bnepethomas/bne-arduino-flight-simulator-interfaces/ProSim_Pi_UDP_Receiver_Stickshaker/Read Me.txt

Copied from Huey Caution Panel  20170828 - full details on supporting infrastructure found there
