bnepethomas/bne-arduino-flight-simulator-interfaces/Hornet Altimeter/Hornet_Altimeter_With_OLED/readme.txt

This Arduino code is functional but not finished, found that under high update rates, the pi struggled
to keep up, so moved it to the Raspberry pi.
