bnepethomas/bne-arduino-flight-simulator-interfaces/Jet Ranger/Jet Ranger Arduino Sketches/JET_RANGER_RADIO_CONTROLLER/PROGRAM_SUMMARY.md

# JET_RANGER_RADIO_CONTROLLER — Program Summary

Arduino Mega 2560 + W5500 Ethernet shield. Drives the two COM/NAV OLED
frequency displays, reads 8 rotary encoders (COM1/COM2/NAV1/NAV2 major &
minor) and a 4x4 button matrix, and keeps the radio panel in sync with the
flight sim over Ethernet.

## Program flow

1. **Setup**
   - Resets the W5500 shield via `ES1_RESET_PIN` (53), then `Ethernet.begin(mac, ip)`.
   - Opens the four UDP sockets listed below, flashes the red status LED while
     it waits `delayBeforeSendingPacket` (3s) for the link to settle, then
     sends a debug "Ethernet Started" message.
   - Initialises the two character OLEDs (via the TCA9548 I2C mux) and the
     8 rotary encoders (acceleration enabled, start positions set).
   - Initialises the 4x4 keypad matrix scanner.
2. **Main loop** (`loop()`)
   - Toggles the green/red status LEDs every `FLASH_TIME` (200ms) as a
     heartbeat indicator.
   - Every 10s sends a `"COMM_NAV"` keepalive UDP packet to the reflector
     (health monitor).
   - Polls all 8 encoders; any change recalculates the relevant standby
     frequency, sends it to the reflector, and refreshes the OLEDs.
   - Scans the 4x4 matrix; key presses on row 0–3 col 0 trigger COM1/COM2
     swap, master battery on/off and alternator on/off commands sent to the
     reflector on port 27001. Other keys are only logged via `SendDebug`.
   - Reads any pending UDP packet on the MSFS port and passes it to
     `ProcessReceivedMSFSString()`, which parses a CSV-style payload
     (`D,C1A:119.500,C1S:120.000,...` for data, `C,B:5` for control/
     brightness) and updates the active/standby frequencies, main bus
     voltage and NAVCOM1 power state, then refreshes the OLEDs if anything
     changed.

## Swap switches, key matrix, start-up quiet period

The four frequency-swap switches are on the **Jet Ranger COM and NAV** PCB, in a
diode matrix that all shares column 0 (D26); rows 0-3 are D22-D25. Matrix
position -> action in `handleKeyPress()`:

| Switch (COM and NAV PCB) | Matrix (row, col) | Action |
|---|---|---|
| NAV1 FREQ SWITCH (`SW6`) | 0, 0 | **NAV1 swap**: swaps `Nav1ActiveFrequency`/`Nav1StandbyFrequency` on the NAV OLED immediately (the bridges send the NAV active frequencies back as `N1A` and `N2A`; the standby frequencies stay local to the Radio) and sends `NAV1_RADIO_SWAP` to 172.16.1.10:27001 |
| NAV2 FREQ SWITCH (`SW7`) | 1, 0 | **NAV2 swap**: same with NAV2, sends `NAV2_RADIO_SWAP` |
| COMM1 Freq Switch (`SW4`) | 2, 0 | COM1 swap: sends `COM1_RADIO_SWAP` (the display changes when the sim sends the swapped frequencies back) |
| COMM2 FREQ SWITCH (`SW5`) | 3, 0 | COM2 swap: sends `COM2_RADIO_SWAP`, then `AVIONICS_MASTER_SET` |

(The earlier mapping had battery on/off and alternator on/off on (0,0)/(1,0);
it was removed.) Both bridges (`FSUIPCWinformsAutoCS` and `MSFSWinformsAutoCS`)
handle `NAV1_RADIO_SWAP` and `NAV2_RADIO_SWAP`, and any command a bridge does not
recognise falls into its COM1 standby-frequency parser (resets COM1 standby to 121.50).

**Bench-verified 2026-10-15** (Mega on COM20, through the reflector's forwarded
copy): each of the four switches pressed twice logged `Key Pressed`, the matching
`COM1 Swap`/`COM2 Swap`/`NAV1 Swap`/`NAV2 Swap` line and `Key Released`.

- **Phantom key presses fixed:** a floating column used to read LOW as soon as
  scanning started, so every boot reported key presses and sent their commands
  to the PC. For `matrixQuietMs` (1500 ms) after `initMatrixScanner()` the scanner
  now only records the state and raises no press or release events
  (`matrixQuietUntil`).
- **Matrix diagnostic:** UDP control packet `C,MATRIX:1` sends the raw readings
  (`H`/`L` per column, bypassing debounce and the quiet period) as
  `Matrix raw idle ...` and `Matrix raw row N LOW ...` lines. It showed column 0
  stuck LOW on the original Mega even with the ribbon unplugged (a faulty or badly
  seated Mega/pin D26 - all four swap switches use column 0, so none could register);
  on the replacement Mega all four columns read `H`. A badly seated Mega also made
  the board drop off USB and the network after flashing.
- Encoder knobs now name their radio when they send a standby frequency to the PC
  (`sendStandbyToPC()`, port 27001): COM1 stays the bare number
  (`118.295`, which every bridge understands); COM2, NAV1 and NAV2 are sent as
  `COM2_STANDBY:118.295`, `NAV1_STANDBY:108.000`, `NAV2_STANDBY:108.000`, which
  `FSUIPCWinformsAutoCS` routes to the matching radio. Previously every knob sent a
  bare number, the PC took anything outside 118-136.975 as COM1 standby 121.50, so
  NAV and COM2 knobs retuned COM1. Nothing is sent during the start-up quiet period,
  so the encoders' power-up positions are no longer pushed to the simulator. Each send
  is logged as `To PC: ...`. Both bridges handle these labelled forms.
- Display column fix (2026-10-16): the bridges send COM frequencies with 2 decimals
  (`128.30`, `127.80`), and the display line joined COM1 and COM2 with two spaces, so a
  short COM1 pulled COM2 one column left and its hundreds digit went behind the
  faceplate. `padFrequency()` now pads every frequency to `xxx.xxx` (7 characters)
  before `updateCOMM()` / `updateNAV()` build their lines (7 + 2 + 7 = 16 columns).
  Confirmed by eye on the bench.
- Standard channel spacing (2026-10-16): the minor knobs used to step 5 kHz on all four
  radios and the COM major knob stopped at 135. Now COM runs 118.000-136.975 MHz in
  25 kHz channels (`COM_MINOR_STEP_KHZ`, major 118..136) and NAV runs 108.00-117.95 MHz
  in 50 kHz steps (`NAV_MINOR_STEP_KHZ`, major 108..117). `CommMinorEncoderMaxValue` and
  `NavMinorEncoderMaxValue` are derived from the step sizes, so changing a constant also
  moves the wrap-around limits. 8.33 kHz channels are not offered. Flight sims store COM
  frequencies in FSUIPC's 10 kHz BCD form, so a 25 kHz channel such as 118.025 may show as
  118.02 or 118.03 in the sim.
- Compiled at 25,774 bytes flash (10%) / 3,323 bytes RAM (40%), flashed on COM20.

## No-data timeout (30 s)

If no UDP packet - data `D,...` or control `C,...` - arrives on the MSFS port
(13136) for `noDataTimeoutMs` (30 s), the COM and NAV character OLEDs are
blanked once: the loop sets `powerAvailable = false` (the state the displays
already treat as "no power", where `updateCOMM()`/`updateNAV()` clear the
screen) and logs `no UDP data for 30s, displays blanked`. The timer starts at
the end of `setup()` (`lastMSFSDataMillis = millis()`). When a packet arrives
again the previous power state is restored, both displays are redrawn and
`UDP data resumed - displays restored` is logged. **Local input also counts:**
any encoder movement or key press calls `wakeDisplays()`, which restarts the 30 s
and, if the displays are blanked, restores them (`Local input - displays
restored`); they blank again (`no UDP data or local input for 30s, displays
blanked`) only after 30 s with neither UDP data nor local input. Bench-verified:
the first key press after a blank restored the displays. Control packets such as
`C,KEEPALIVE:1` also count as data. Bench-tested on the Radio (COM19) through
the UDP reflector's forwarded copy: blanked about 30 s after boot, restored on
the next `D,C1A:...` packet. Compiled at 24,440 bytes flash (9%) / 3,141 bytes
RAM (38%).

## I2C scan, DME display and matrix debounce

- **I2C scan:** `scanI2C()` runs at start-up (after `Wire.begin()`) and on `C,I2CSCAN:1`. It scans 0x08-0x77 on the main bus with every TCA9548A channel off, then each channel 0-7 (the mux itself is
  skipped) and sends the results to the debug stream (`I2C main bus: ...`, `I2C TCA port n: 0x3C (OLED)`, `I2C TCA ports with nothing connected: ...`, `I2C scan done, N device(s) answered`). It sets
  `Wire.setWireTimeout(5000, true)` so a stuck bus reports `bus timeout` instead of hanging. A scan takes a second or two.
- **DME display:** the Audio panel's OLED, mux channel 3 (`DME_OLED_Port`). `initCharOLED(DME_OLED_Port)` then `showDme()` with the no-data text (`DME --- NM` and `--- KT -- MIN`, build 13; it was `10M` and `0M` before) at start-up (each line padded to 16 characters).
- **Matrix debounce:** `scanMatrix()` samples each key once per millisecond with two readings 3 us apart (a disagreement skips the sample) and debounces by integration (`keyIntegrator[][]`, 0 = down to
  `MATRIX_INTEGRATOR_MAX` = 12 = up; a key changes state at either end), replacing the 50 ms timer that restarted on every differing reading and could hold a release back. Compiled at 34,518 bytes flash (13%) /
  4,979 bytes RAM (60%).

## Backlight (D5)

Mega pin D5 (`BACKLIGHT_PWM`, 330 ohm to an IRF540N with a 10 kohm gate pull-down) switches the Audio, Auto Pilot and COM and NAV panel backlights, with the same rules as the Servo, Stepper
and Dual Stepper boards. `applyBacklight()` writes PWM 0 unless `backlightPowered` (`BPWR:1`, main bus 20 V or more, assumed 1 until the first `BPWR`) is true and the displays are not blanked by
the no-data timeout (30 s with no UDP packet and no knob or key use; local input restores it); otherwise it writes the last `C,B:0-15` level mapped to PWM 0 to 255, or `BacklightDefaultPwm`
(65) until one has been received. `BPWR` is handled in `HandleOutputValuePair()` before the per-pair debug line, the radio packet from both bridges now carries it, and `C,B` also sets the
MAX7219 intensity. Compiled at 31,046 bytes flash (12%) / 4,851 bytes RAM (59%); not flashed or tested on the board yet.

## Auto Pilot and Audio panel switches and knobs

The matrix is now 4 rows (D22-D25) by 5 columns (D26, D27, D28, D29 and **D48**): `COL0` is the COM and NAV swap switches, `COL1`/`COL2` the Auto Pilot panel and
`COL3`/`COL4` the Audio panel (one switch per row on each column, diode to the column). The five Auto Pilot knobs are polling encoders on CRS D11/D12, ALT A4/A5, VS D46/D47,
IAS D7/D6 and HDG D8/D9, read like the ADF knobs (centred, recentred after each read, three counts per click, acceleration on). Every switch and click goes out twice:
a joystick button to the USB HID board (172.16.1.11:4210, `index,state`; Joystick 3 = indexes 64-81 for the Auto Pilot panel, Joystick 4 = 96-103 for the Audio panel; a knob
click is a 40 ms press released from `serviceHidPulses()`), and a simulator control name to the bridge on UDP 27001 (switch: on press; knob: one per click with a `:N` repeat
count). Nothing is sent during the 1.5 s quiet period. `panelSwitches[]` and `panelEncoders[]` hold the tables; each press is logged (`AP HDG pressed (joystick button index 65)`).
Compiled at 30,108 bytes flash (11%) / 4,823 bytes RAM (58%); not flashed or tested on the board yet.

| Switch / knob | Row, col or pins | Index | Command |
|---|---|---|---|
| AP ENGAGE, HDG, CRS, ALT | (0,1) (1,1) (2,1) (3,1) | 64 to 67 | `AP_MASTER`, `AP_HDG_HOLD`, `AP_NAV1_HOLD`, `AP_ALT_HOLD` |
| AP APPR, FD, BC, IAS | (0,2) (1,2) (2,2) (3,2) | 68 to 71 | `AP_APR_HOLD`, `TOGGLE_FLIGHT_DIRECTOR`, `AP_BC_HOLD`, `AP_PANEL_SPEED_HOLD` |
| CRS, ALT, VS, IAS, HDG knobs (cw, ccw) | D11/12, A4/A5, D46/47, D7/6, D8/9 | 72 to 81 | `VOR1_OBI_INC/DEC`, `AP_ALT_VAR_INC/DEC`, `AP_VS_VAR_INC/DEC`, `AP_SPD_VAR_INC/DEC`, `HEADING_BUG_INC/DEC` |
| Audio COM1, BOTH, NAV2, DME | (0,3) (1,3) (2,3) (3,3) | 96 to 99 | `COM1_TRANSMIT_SELECT`, `COM_RECEIVE_ALL_TOGGLE`, `RADIO_VOR2_IDENT_TOGGLE`, `RADIO_DME1_IDENT_TOGGLE` |
| Audio COM2, NAV1, MKR, ADF | (0,4) (1,4) (2,4) (3,4) | 100 to 103 | `COM2_TRANSMIT_SELECT`, `RADIO_VOR1_IDENT_TOGGLE`, `MARKER_SOUND_TOGGLE`, `RADIO_ADF_IDENT_TOGGLE` |

## Auto Pilot and Audio panel LEDs (MAX7219)

One MAX7219 on the Radio Auto Pilot PCB drives 39 LEDs (19 on the Auto Pilot and Audio panels, 20 on the Huey Warning Panel): DIN = A15, CLK = A14, LOAD = A13 (LedControl library, one device, scan limit 7 since the Huey panel was added (it was 3), intensity 8 until a `C,B`
arrives; with eight digits scanned each LED is lit half as long, so the Auto Pilot and Audio LEDs are dimmer than before). Segments A to G and DP are `ANNODE_00` to `ANNODE_07`, digits 0 to 7 are `CATHODE_00` to `CATHODE_07`; a panel LED sits between one segment and one
digit. LedControl `setLed(0, digit, column)` uses column 0 for DP and 1 to 7 for A to G.

| LED | Token | Digit | Segment | | LED | Token | Digit | Segment |
|---|---|---|---|---|---|---|---|---|
| CRS | `LED_CRS` | 0 | A | | COM1 | `LED_COM1` | 2 | A |
| HDG | `LED_HDG` | 0 | B | | BOTH | `LED_BOTH` | 2 | B |
| IAS | `LED_IAS` | 0 | C | | NAV2 | `LED_NAV2` | 2 | C |
| ALT | `LED_ALT` | 0 | D | | DME | `LED_DME` | 2 | D |
| APPR | `LED_APPR` | 1 | A | | OUTER | `LED_OUTER` | 2 | E |
| FD | `LED_FD` | 1 | B | | INNER | `LED_INNER` | 2 | F |
| BC | `LED_BC` | 1 | C | | COM2 | `LED_COM2` | 3 | A |
| AP ENGAGE | `LED_APENG` | 1 | D | | NAV1 | `LED_NAV1` | 3 | B |
| | | | | | MKR | `LED_MKR` | 3 | C |
| | | | | | ADF | `LED_ADF` | 3 | D |
| | | | | | MIDDLE | `LED_MID` | 3 | E |

The first two columns are the Auto Pilot panel (digits 0 and 1), the others the Audio panel (digits 2 and 3). The bridges send each LED as `LED_xxx:0/1` in the radio
data packet (see the FSUIPC and MSFS bridges). `HandleOutputValuePair()` handles them before its per-pair debug line. The LEDs are lit only while `powerAvailable`
is true (NAVCOM1:1 and not blanked by the no-data timeout), and `applyPanelLeds()` writes only the LEDs that changed. `C,LEDTEST:1` lights all 39, `C,LEDTEST:0`
returns them to the simulator state. **`C,B:0-15`** sets the MAX7219 intensity (0 shuts the display down, 1 to 15 set the intensity). Compiled at 27,610 bytes
flash (10%) / 3,724 bytes RAM (45%); not flashed or tested on the board yet.

## Huey Warning Panel switches and LEDs (31 October 2026)

The Huey Warning Panel is **hand wired** to the Radio controller at the moment (there is no PCB for it in the documentation). The sketch supports it:

- **LEDs:** 20 more rows in `panelLedTable[]` (`LED_H_xxx` tokens, `HUEY_LED_COUNT`, `hueyLedFirst`) on MAX7219 digits 4 to 7, handled exactly like the other panel LEDs. LedControl column 0 is DP and 1 to 7 are A to G.

| LED | Token | Digit | Segment | | LED | Token | Digit | Segment |
|---|---|---|---|---|---|---|---|---|
| ENG OIL | `LED_H_ENG_OIL` | 4 | A | | AUX FUEL LOW | `LED_H_AUX_FUEL_LOW` | 5 | A |
| ENG ICE | `LED_H_ENG_ICE` | 4 | B | | XMSN OIL PRESS | `LED_H_XMSN_OIL_PRESS` | 5 | B |
| ENG ICE DETECT | `LED_H_ENG_ICE_DETECT` | 4 | C | | XMSN OIL HOT | `LED_H_XMSN_OIL_HOT` | 5 | C |
| ENG CHIP | `LED_H_ENG_CHIP` | 4 | D | | HYD PRESS | `LED_H_HYD_PRESS` | 5 | D |
| LEFT FUEL BOOST | `LED_H_LEFT_FUEL_BOOST` | 4 | E | | ENG INLET AIR | `LED_H_ENG_INLET_AIR` | 5 | E |
| ENG FUEL PUMP | `LED_H_ENG_FUEL_PUMP` | 4 | F | | INST INVERTER | `LED_H_INST_INVERTER` | 5 | F |
| RIGHT FUEL BOOST | `LED_H_RIGHT_FUEL_BOOST` | 4 | G | | DC GENERATOR | `LED_H_DC_GENERATOR` | 5 | G |
| 20 MINUTE FUEL | `LED_H_20_MINUTE_FUEL` | 4 | DP | | EXT POWER | `LED_H_EXT_POWER` | 5 | DP |
| FUEL FILTER | `LED_H_FUEL_FILTER` | 6 | G | | CHIP DETECTOR | `LED_H_CHIP_DETECTOR` | 7 | G |
| GOV EMER | `LED_H_GOV_EMER` | 6 | DP | | IFF | `LED_H_IFF` | 7 | DP |

- **Switches:** `hueySwitches[]`: TEST on A9 (Joystick 4 button 20, index 115), RESET on A10 (116) and BRT / DIM on A8 (117), to ground when on, `INPUT_PULLUP`, 30 ms debounce, `initHueySwitches()` and `pollHueySwitches()` (called after `scanMatrix()` in the loop). TEST and RESET are the two positions of one switch. Each is a joystick button on the USB HID board, held while closed; nothing is sent during the quiet period and the buttons are resent when the HID board answers again (`resyncHidButtons()`).
- **Lamp test:** while TEST is closed (`hueyTestHeld`) all 20 Huey LEDs light, only while the radio has power (`applyPanelLeds()`).
- **Bridges:** neither bridge sends `LED_H_xxx` yet. The BenchTester has a toggle for each (and All ON/OFF, Chase, board test).
- Compiled at 40,552 bytes flash (16%) / 5,949 bytes RAM (72%). Flashed on COM20 on 31 October 2026; the switches and LEDs have not been checked on the panel yet.

## Remote reset over UDP

UDP control packet `C,RESET:1` (value ignored) to port 13136 reboots this
board with a **software reset**: `RebootBoard()` sends a debug line (`RESET
command received - rebooting`), waits 100ms, disables interrupts, switches off
the peripherals that would survive a jump (external/pin-change interrupts, all
timer interrupts, TWI, SPI, ADC, UARTs) and jumps to the reset vector
(`jmp 0`); `setup()` then runs again and resets the Ethernet module through
`ES1_RESET_PIN`. It does not use the AVR watchdog (used on the Servo, Stepper
and Dual Stepper boards) because that **hung the Radio Controller**: after a
watchdog reset the chip's watchdog restarts at its shortest timeout and the
board's bootloader does not switch it off, so it reset over and over and never
reached the sketch until it was reflashed. A `.init3` function
(`DisableWatchdogAtStartup()`) still clears `MCUSR`/the watchdog first thing
after every reset. Handled in `HandleControlString()` (the existing `C,...` control-packet handler, port 13136). **Bench-tested (2026-10-14, COM19):** acknowledgement, then "Ethernet Started" about 3.9s later and "Setup Complete" about 5s after the command, with no loop. Compiled at 23,944 bytes flash (9%) / 3,060 bytes RAM (37%).

## Pin usage

| Pin(s) | Function |
|---|---|
| 14 | Green status LED |
| 15 | Red status LED (flashes while Ethernet link comes up) |
| 53 | W5500 Ethernet shield manual reset (`ES1_RESET_PIN`) |
| 50–52 (+10) | SPI bus to W5500 shield (Mega ICSP header, reserved) |
| I2C (SDA/SCL) | TCA9548 I2C multiplexer (addr `0x70`), driving two OLEDs (addr `0x3C`) — mux port 0 = NAV OLED, port 1 = COMM OLED |
| 31, 30 | Comm1 Major rotary encoder (A, B) |
| 33, 32 | Comm1 Minor rotary encoder (A, B) |
| 34, 35 | Comm2 Major rotary encoder (A, B) |
| 37, 36 | Comm2 Minor rotary encoder (A, B) |
| 38, 39 | Nav1 Major rotary encoder (A, B) |
| 41, 40 | Nav1 Minor rotary encoder (A, B) |
| 42, 43 | Nav2 Major rotary encoder (A, B) |
| 45, 44 | Nav2 Minor rotary encoder (A, B) |
| 22–25 | 4x4 keypad matrix rows |
| 26–29 | 4x4 keypad matrix columns |

## Ethernet retransmission timeout

`Ethernet.setRetransmissionTimeout(10)` is called right after `Ethernet.begin()`
(same as the Stepper and Dual Stepper sketches). The W5500's default is 200ms x
8 retries - up to 1600ms blocked inside a UDP send that gets no ARP reply (for
example when the reflector PC is off) - so one dead destination could stall
the encoder and button-matrix scanning. With 10ms per retry the worst case is about 80ms. Compiled at 24,472 bytes flash (9%);
not yet flashed.

## Local network configuration

| Setting | Value |
|---|---|
| Static IP | `172.16.1.101` |
| MAC | `A8:61:0A:9E:83:01` |
| Subnet role | Fixed on the `172.16.1.0/24` avionics LAN |
| Local port `localport` | 7788 (bound, used as the source socket for outbound debug/command packets) |
| Local port `localdebugport` | 7789 (bound, currently unused for send/receive) |
| Local port `MSFSport` | 13136 (listens for sim data packets) |
| Local port `aliveport` | 13137 (bound, used to send keepalives) |

> **Fixed:** `JET_RANGER_UPPER_CONTROLLER` previously hard-coded this same
> IP (`172.16.1.101`) and MAC. It was renumbered to `172.16.1.103` /
> MAC `...83:03`, so this address is unique to the Radio Controller. (That
> sketch has since been merged into `JET_RANGER_ADF_CONTROLLER`, 172.16.1.107.)

## Remote endpoints this sketch talks to

| Target | Port | Purpose |
|---|---|---|
| `172.16.1.10` (reflector host) | 27000 | Debug/log messages (`SendDebug`) |
| `172.16.1.10` (reflector host) | 13137 | 10s keepalive `"COMM_NAV"` |
| `172.16.1.10` (reflector host) | 27001 | Standby-frequency updates and radio/battery/alternator control commands (`COM1_RADIO_SWAP`, `COM2_RADIO_SWAP`, `MASTER_BATTERY_ON/OFF`, `ALTERNATOR_ON/OFF`) |

## C# programs this sketch communicates with

- **FSUIPCWinformsAutoCS** / **MSFSWinformsAutoCS** — the bridge apps
  (one at a time), normally run on the PC at `172.16.1.10`. They listen on
  UDP **27001** for the control commands this sketch sends (radio swap,
  standby tuning, battery, alternator) and translate them into simulator
  events, and they send the `D,C1A:...` frequency/status packets this
  sketch listens for on port **13136**.
- **JetRangerHealthMonitor** — listens on UDP **13137** on the same PC and
  turns the "CommNav" indicator green when this sketch's keepalive arrives
  (red/orange if it's been 15–30s+ since the last one).
- No C# project in this repository currently listens on `172.16.1.10:27000`
  — the debug log stream (`SendDebug`) has no in-repo consumer; it would
  need to be watched with a generic UDP listener/packet capture.

## Auto Pilot display, USB HID board missing, heartbeat voltage (2026-10-25)

- **Auto Pilot display:** the Auto Pilot panel's OLED (TCA9548A channel 2, `AP_OLED_Port`) sits behind a mask, so `showAutoPilot(hdg, crs, ias, vs, alt)` puts HDG at the left end and VS at the right end of the top
  row, CRS at the left end, IAS centred (ending at column 8) and ALT at the right end of the bottom row (`placeLeft()` / `placeRight()`, 16 columns). Start-up values 090, 110, 80, 0 and 3200
  (`090            0` / `110    80   3200`). The bridges send `APHDG`, `APCRS`, `APIAS`, `APVS`, `APALT` (at most 5 characters) in the radio data packet; `setAutoPilotValueFromToken()` stores them,
  `updateAP()` redraws on a change and blanks the display with the radio power (`apDrawnPower`), like the COM and NAV displays.
- **USB HID board missing:** a failed `udp.endPacket()` to 172.16.1.11 pauses `sendButtonToHid()` for `HID_RETRY_MS` (30 s) and logs `USB HID board ... not answering (send gave up after N ms)`, so only one press or
  release in 30 s pays the ARP timeout (N shows whether the 10 ms retransmission timeout is effective: about 80, not 1600). When the board answers again `hidNeedsResync` sends the held switches again
  (`resyncHidButtons()`). `SendDebug()` pauses 10 s after a failed send in the same way (`DEBUG_RETRY_MS`).
- **Heartbeat voltage:** `COMM_NAV V5:5.02` (see the other boards' summaries). Compiled at 38,592 bytes flash (15%) / 5,222 bytes RAM (63%).

## DME display blanking and the ADF display message (2026-10-25)

- **DME display:** `updateDme()` (with `dmeTopText` / `dmeBottomText`, dashes until DME values arrive, and `dmeDrawnPower`) blanks the Audio panel's OLED while the radio has no power or the no-data timeout has fired and redraws it when they come back; it is called wherever `updateAP()` is.
- **ADF controller display:** `updateDme()` calls `sendAdfDisplay(on)`, which sends `C,DISPLAY:1` or `C,DISPLAY:0` to 172.16.1.107:13136 on every change and again every 10 s (`ADF_DISPLAY_RESEND_MS`) so the ADF controller blanks its OLED and landing gear lamps with the Radio's displays. A failed send pauses these sends for 30 s (`ADF_RETRY_MS`) and logs `ADF controller 172.16.1.107 not answering`, like the HID board.
- Compiled at 39,422 bytes flash (15%) / 5,395 bytes RAM (65%). Flashed to COM20; not bench-tested.

## Firmware version

`FIRMWARE_NAME`, `FIRMWARE_VERSION` and `FIRMWARE_BUILD` are defined above `SendDebug()`. The board reports them, with the compile date and time, on the debug stream straight after *Ethernet Started*,
and on `C,VERSION:1`. **Raise `FIRMWARE_BUILD` by one every time this sketch is changed** (and `FIRMWARE_VERSION` for a larger change). Version 1.0, build 1 was added on 1 November 2026; **build 2 (1 November 2026) added the version to the heartbeat**; **build 3 (6 November 2026) added the start-up backlight hold**. The heartbeat to the Health Monitor also carries it as ` FW:1.0.<build>` (for example `SERVO V5:5.02 FW:1.0.2`), which the Health Monitor shows in its voltage table.

## Start-up backlight (6 November 2026)

From reset the controller keeps its backlight **on** (at the commanded brightness, or the default level), ignoring the 30 second no-data watchdog and the bridge's `BPWR`, until the
**13 Stepper controller**, the last controller to finish its start-up, announces that start-up is complete. This controller listens on port 13138 for the announcement and ends its hold when it arrives (the Stepper controller repeats it every 10 seconds for three minutes, so a controller that was not listening yet, or was reset, still hears it). When the hold ends the backlight goes off and the controller treats the
main bus as down until the bridge's `BPWR:1` arrives, so from then on the bridge controls the backlight as before (with no bridge it stays off). If the announcement never comes (the Stepper
controller is off or missing) the hold ends by itself after `STARTUP_BACKLIGHT_MAX_MS` (180 seconds from reset). The announcement is the text `STARTUPDONE` on **UDP port 13138**, a port of its
own so that it never counts as data for the no-data watchdog. Code: `backlightStartupHold`, `endBacklightStartupHold()`, `serviceStartupSync()` (called at the top of `loop()`) and the
`startupSyncUdp` socket. Compiled but not yet flashed or tested on the bench: check the debug stream for `Start-up backlight off (...)` and watch the backlights stay on until the Stepper finishes.

### OLEDs and indicators during the start-up hold (6 November 2026)

While the start-up hold is on the **OLEDs stay on** (the COM, NAV, Auto Pilot and DME displays show their start-up or live content, and are not blanked by `NAVCOM1:0` or the 30 second no-data timeout) and **every panel LED is lit** (Auto Pilot, Audio and Huey: `applyPanelLeds()` treats the hold like `C,LEDTEST:1`, and `initPanelLeds()` now applies it at start-up). The ADF controller is told the displays are on (`C,DISPLAY:1`). All display and LED code reads `radioPowered()` (`backlightStartupHold || powerAvailable`) instead of `powerAvailable`. When the hold ends `refreshAfterStartupHold()` redraws the displays and the LEDs, which then follow the radio power and the data as before. Build 4. Compiled, not yet flashed.

**Build 5 (6 November 2026): the OLEDs now blank with the backlight when the hold ends and no bridge is feeding the board.** Each board's own 30 second no-data timeout counts from the end of *its* start-up, so a board that finished its start-up well before the Stepper controller still had part of that 30 seconds left when the announcement arrived, and its OLEDs lingered until it ran out (about 5 seconds on the Dual Stepper). `refreshAfterStartupHold()` now expires that timeout straight away when no data or input has arrived for more than 2 seconds (`lastMSFSDataMillis` / `lastLocalActivityMillis` / `lastActivityMillis` set to `millis() - timeout`), so the OLEDs blank on the next pass. With a bridge feeding the board nothing changes. The indicator lamps already went out at once (their wanted states are all off without data). Compiled, not yet flashed.

**Build 6 (7 November 2026): the DME display now stays on during the start-up hold.** `updateDme()` still tested `powerAvailable` instead of `radioPowered()`, so when this board's own 30 second no-data timeout ran out during the hold (the Stepper controller takes longer than that to finish its start-up) it set `powerAvailable` to false, and the DME display (the Audio panel OLED) was cleared while the COM, NAV and Auto Pilot displays, which already used `radioPowered()`, stayed lit. It now tests `radioPowered()` like the others, so the DME display blanks only when the hold ends (`refreshAfterStartupHold()` calls `updateDme()`).

## Panel LED brightness, C,LEDB (7 November 2026)

**`C,LEDB:0-15`** sets the MAX7219 brightness on its own (0 shuts the display down, 1 to 15 set the intensity, kept by the chip). The first `C,LEDB` after a reset takes the LEDs away from `C,B`: from then on `C,B` sets only the backlight PWM, and the LEDs keep the `C,LEDB` level until the board is reset (until then `C,B` still sets both, as before). The level at start-up is `MAX7219_INTENSITY` 15 (maximum; it was 8 until build 9). Debug line: `Panel LED brightness 5 (MAX7219 intensity, C,LEDB)`. The BenchTester's **Panel LEDs** group has a **Brightness (0-15)** slider for it. Build 7: compiled at 42,148 bytes flash (16%) and 6,077 bytes RAM (74%); not flashed or tested on the board yet.

## Start-up backlight level: 100 percent, then 70 percent (7 November 2026)

While the start-up hold is on the backlight is **100 percent** (`STARTUP_BACKLIGHT_PWM` 255), whatever brightness was commanded or is the default, and a `C,B` command received during the hold does not change it. When the hold ends (the Stepper controller's `STARTUPDONE`, or the 180 second failsafe) the commanded level becomes **70 percent** (`AFTER_STARTUP_BACKLIGHT_PWM` 179) and the backlight goes **off**; it comes back at 70 percent when the bridge sends `BPWR:1`, unless a `C,B` command has set another level. This replaces the earlier hold level (the commanded or default level) described above. Build 8: compiled at 42,164 bytes flash (16%), 6,077 bytes RAM (74%); not flashed or tested on the board yet.

**Build 9 (7 November 2026): the MAX7219 starts at maximum brightness.** `MAX7219_INTENSITY` is now 15 instead of 8, so the panel LEDs (Auto Pilot, Audio and Huey) are at full intensity from power-up, including during the start-up hold, until a `C,LEDB` or `C,B` command changes it. Compiled at 42,164 bytes flash (16%) and 6,077 bytes RAM (74%); not flashed yet.

**Build 10 (8 November 2026): no more "Handling ..." debug lines.** `HandleOutputValuePair()` used to send `Handling <token>:<value>` to the debug stream for every token it handled (`NAVCOM1:n` and the other values arrive in every radio packet, about ten a second); the line is commented out for all tokens. The other debug lines are unchanged. Compiled at 42,092 bytes flash (16%) and 6,067 bytes RAM (74%); not flashed yet.

**Build 11 (8 November 2026): no more "Received NAVCOM1" and "Received MAINBUS" debug lines.** `HandleOutputValuePair()` sent `Received NAVCOM1: <value>` for every radio packet (about ten a second); that line and the `Received MAINBUS` line next to it (its token name is `NOTMAINBUS`, so it never matched) are commented out. `NAVCOM1 Status Changed` is still sent, once, when the power flag changes, and `RESET command received - rebooting` is unchanged. Compiled at 41,930 bytes flash (16%) and 6,029 bytes RAM (73%); not flashed yet.

## DME display readout (8 November 2026, build 12)

The DME display (the Audio panel OLED) now shows a live readout once the bridge sends it (and the no-data dashes until then). Two new data tokens in the radio packet: **`DMEDIST`** (nautical miles to one decimal; -1 = no DME) and **`DMESPD`** (knots; -1 = none). `setDmeFromToken()` stores them (distance in tenths, so the display is only redrawn when the shown value changes), `buildDmeText()` builds the two 16 character lines and the loop redraws when `dmeValuesChanged` is set; the power and start-up hold rules are unchanged (it is lit during the hold, blank when the radio has no power).

- Top line: `DME 12.3 NM` (one decimal below 100 nm, none above; `DME --- NM` with no DME).
- Bottom line: `120 KT 6 MIN`, the speed and the time to the station (distance / speed x 60, at most 99; `-- MIN` when the speed is 0 or unknown; `--- KT` with no DME).

The MSFS bridge sends the tokens (see its summary) and the BenchTester has a DME display group. The FSUIPC, DCS and X-Plane bridges do not send them yet, so with those the display keeps the start-up text. Compiled at 44,204 bytes flash (17%) and 6,114 bytes RAM (74%); not flashed yet.

**Build 13 (8 November 2026): the DME display starts with dashes.** The start-up text of the DME OLED is now `DME --- NM` over `--- KT -- MIN`, the text for no DME data, instead of `10M` over `0M`. It stays until the first DME values arrive from the bridge (`DMEDIST` and `DMESPD`; the MSFS bridge sends them, the other bridges do not yet). Compiled at 44,204 bytes flash (17%) and 6,114 bytes RAM (74%); not flashed yet.

**Build 14 (8 November 2026): the DME station identifier.** A third DME token, **`DMEID`** (the station identifier, letters and digits, up to 4 characters; `-` = none), is stored by `setDmeFromToken()` (capitals only, anything else dropped) and shown on the top line of the DME display: `DME IBN 12.3NM` (the distance has no space before `NM` when an identifier is shown; with no identifier the line is `DME 12.3 NM` as before, and `DME --- NM` with no DME). Compiled at 44,450 bytes flash (17%) and 6,137 bytes RAM (74%); not flashed yet.

## Live NAV active frequencies (8 November 2026, build 15)

Two new data tokens, **`N1A`** (NAV1 active) and **`N2A`** (NAV2 active), set `Nav1ActiveFrequency` and `Nav2ActiveFrequency` and redraw the NAV display (`navFrequencyChanged`, handled in the loop next to the COM redraw). The standby frequencies stay local (the knobs and the swap switches); the live active values are not applied within 500 ms of a knob or switch (`lastEncoderUpdate`), the same rule as the COM2 values, and arrive again with the next packet. Until the first packet the NAV display shows the start-up values (109.000 and 110.000). The MSFS and FSUIPC bridges send the tokens. Compiled at 44,656 bytes flash (17%) and 6,146 bytes RAM (75%); not flashed yet.
