bnepethomas/bne-arduino-flight-simulator-interfaces/Jet Ranger/ C# Code/MSFSWinformsAutoCS/PROGRAM_SUMMARY.md

# MSFSWinformsAutoCS — Program Summary

WinForms bridge for **Microsoft Flight Simulator (2020 / 2024)**. It is the SimConnect
counterpart of `FSUIPCWinformsAutoCS`: same window, same timers, same UDP endpoints and the
same real-unit packet per board, with the data read through SimConnect instead of FSUIPC
offsets. Written 2026-10-17 and since run against MSFS 2024.

## Files

| File | Role |
|---|---|
| `Form1.cs` | SimConnect connection, 100 ms main timer, on-screen readout, lamp list, UDP listener and the command handler |
| `Payloads.cs` | `SimSnapshot` (one sample of real-unit values) and `Payloads` (builds the packet for each board, the lamp rules and the power thresholds). No SimConnect or UI dependency, so it can be tested on its own |
| `Form1.Designer.cs`, `Program.cs` | Window layout (identical to the FSUIPC bridge) and entry point |
| `lib\Microsoft.FlightSimulator.SimConnect.dll`, `lib\SimConnect.dll` | Managed wrapper and native library copied from the MSFS 2024 SDK (`SimConnect SDK\lib`) so the project builds without the SDK path; `SimConnect.dll` is copied next to the exe |
| `MSFSWinformsAutoCS.csproj`, `.slnx` | `net10.0-windows10.0.19041.0`, WinForms, nullable enabled |

## Program flow

1. **Constructor** connects five UDP clients (port 13136) to the boards, builds the lamp
   list, starts the 1 s `timerConnection` and the UDP listener on 27001.
2. **`timerConnection_Tick`** tries `new SimConnect("MSFS Winforms Bridge", Handle, WM_USER_SIMCONNECT, ...)`.
   While MSFS is not running this throws and the timer simply tries again. On success it
   registers the data definition (`PanelVars` + the `PanelData` struct), requests it every
   2nd sim frame, maps the client events, then starts `timerMain` and stops itself.
3. **`DefWndProc`** passes `WM_USER_SIMCONNECT` to `simconnect.ReceiveMessage()`; the data
   callback only stores the newest `PanelData` sample. If MSFS quits (`OnRecvQuit`) or the
   connection throws, the app closes SimConnect, stops `timerMain` and goes back to step 2.
4. **`timerMain_Tick`** (100 ms) converts the newest sample to a `SimSnapshot`, updates the
   readout, lamp list and Avionics Master box, then sends:
   - the **Radio** packet when a frequency, the main bus voltage or the radio power flag
     changed (at most every 200 ms), or every 500 ms regardless (twice a second; `RadioRefreshMs`);
   - one packet each to the **Servo, Stepper and Dual Stepper** boards about every
     100 ms (about 10 per second per board).
   If no new data has arrived for 3 s (simulator paused or loading) it stops sending, so
   the boards' 30 s no-data watchdogs return the gauges to zero; the status bar says so.
5. **`UpdateRadios`** (UDP 27001, from the Radio / Upper controller) is the same command set
   as the FSUIPC bridge, sent as SimConnect client events.

## Packets (`Payloads.cs`)

| Board | Packet |
|---|---|
| Servo `.102` | `PITCH` (degrees, one decimal, negated: the sim reports nose-down positive), `BANK`, and the 15 lamp codes as `:1`/`:0` (all `0` while the main bus is below 20 V) |
| Stepper `.105` | `IAS` (knots, one decimal), `VSI` (fpm), `AGL` (feet, `0` below 20 V), `FUEL` (US gal), `TQ` (%), `ITT` (deg C), `N1` (%) |
| Dual Stepper `.106` | `PWR` (`1`, or `0` while the main bus is below 24 V: blanks that board's four OLEDs), `ALT`, `RPMR`, `RPME`, `ZULU` (HHMM), `OILT`, `OILP`, `XMSNT`, `XMSNP`, `FUELLOAD` (fuel pressure, psi), `ELECTRICALLOAD` (percent: the magnitude of `ELECTRICAL TOTAL LOAD AMPS` / 300 A - the sign goes negative while the battery supplies the bus, e.g. with the engine stopped - `ElectricalLoadFullScaleAmps`; a guess from one reading, the FlyInside B206's 143 A with its cockpit LOAD gauge at about 50 %), `TEMP` (outside air, e.g. `21C`) |
| Radio `.101` | `C1A`, `C1S`, `C2A`, `C2S` (MHz, three decimals), `MAINBUS` (volts), `NAVCOM1` (`1` when the **avionics bus is 24 V or more**, else `0`: below that the Radio blanks its COM/NAV displays; if the aircraft reports the avionics bus as exactly 0, as the FlyInside B206 does, the **main bus** is used instead) |

## SimVars requested

`PLANE ALTITUDE`, `AIRSPEED INDICATED`, `VERTICAL SPEED`, `PLANE ALT ABOVE GROUND`,
`ATTITUDE INDICATOR PITCH/BANK DEGREES`, `ROTOR RPM PCT:1`, `GENERAL ENG PCT MAX RPM:1`,
`ENG TORQUE PERCENT:1`, `ELECTRICAL TOTAL LOAD AMPS`, `TURB ENG ITT:1`,
`ENG OIL TEMPERATURE:1`, `FUEL TOTAL QUANTITY`, `TURB ENG CORRECTED N1:1`,
`ENG OIL PRESSURE:1`, `ENG TRANSMISSION PRESSURE:1`, `ENG TRANSMISSION TEMPERATURE:1`,
`GENERAL ENG FUEL PRESSURE:1`, `ELECTRICAL MAIN BUS VOLTAGE`, `ELECTRICAL AVIONICS BUS VOLTAGE`,
`AVIONICS MASTER SWITCH`, `AMBIENT TEMPERATURE`, `KOHLSMAN SETTING MB`, `ZULU TIME`, and the
COM 1/2 and NAV 1/2 active and standby frequencies. `PanelVars` and the `PanelData` struct
must list them in the same order; `CheckDefinitionMatchesStruct()` checks the count at connect.

## Panel LEDs and panel controls

- **LEDs:** the 19 Auto Pilot and Audio panel LEDs are read through two extra SimConnect requests (`PanelAp`, `PanelAudio`, every 6th frame) so an unknown SimVar cannot take the gauge data down.
  `PanelAp`: `AUTOPILOT MASTER`, `NAV1 LOCK`, `HEADING LOCK`, `ALTITUDE LOCK`, `AIRSPEED HOLD`, `APPROACH HOLD`, `BACKCOURSE HOLD`, `FLIGHT DIRECTOR ACTIVE`. `PanelAudio`: `COM TRANSMIT:1/2`,
  `COM RECEIVE ALL`, `NAV SOUND:1/2`, `DME SOUND`, `ADF SOUND`, `MARKER SOUND`, `OUTER / MIDDLE / INNER MARKER`. They become the `LED_xxx` tokens of the radio packet (`Payloads.LedTokens()`, all 0 while
  the radio bus is below 24 V). `ADF SOUND` could not be confirmed to exist in MSFS (if it does not, only the audio LEDs stay off).
- **Backlight:** `Payloads.Radio()` also carries `BPWR` (1 while the main bus is 20 V or more) for the Radio controller's panel backlight, like the Servo, Stepper and Dual Stepper packets.
- **Controls:** `TryPanelCommand()` (first in `UpdateRadios()`) sends the control names from UDP 27001 as the SimConnect event of the same name, mapped once at connect time from `PanelEventNames`
  (event numbers from 1000): the same list as the FSUIPC bridge, with an optional `:N` repeat count. Built clean; not run against MSFS.

## Commands from the panel (UDP 27001)

`COM1_RADIO_SWAP`, `COM2_RADIO_SWAP`, `NAV1_RADIO_SWAP`, `NAV2_RADIO_SWAP`;
`COM2_STANDBY:`, `NAV1_STANDBY:`, `NAV2_STANDBY:` plus a frequency (range-checked, sent as
`COM2_STBY_RADIO_SET_HZ` / `NAV1_STBY_SET_HZ` / `NAV2_STBY_SET_HZ`); a bare number is the
COM1 standby frequency (`COM_STBY_RADIO_SET_HZ`; out-of-range or unreadable becomes 121.50);
`AVIONICS_MASTER_SET`, `MASTER_BATTERY_ON/OFF` (`MASTER_BATTERY_SET` 1/0) and
`ALTERNATOR_ON/OFF` (`ALTERNATOR_SET` 1/0). Unlike FSUIPC, SimConnect has direct set events
for battery and alternator, so there is no voltage guard or blind toggle.

## Aircraft-specific L:vars

The FlyInside B206 does not feed the standard rotor / engine speed SimVars (they read 0 and a
slowly decaying idle while the cockpit shows 100 %). Found with Developer Mode > Tools >
Behaviors > Variables (Global tab, filter `Aircraft.`), the cockpit uses
`L:Aircraft.Rotor.RPM.Percent` (rotor, percent) and `L:Aircraft.Engine.1.Turbine.N2.Smooth`
(turbine, percent). The aircraft is recognised by the turbine L:var being above zero, or by `FlyInside` in the aircraft title (so
it is still recognised with the engine stopped). The bridge reads both L:vars and uses them when they are above zero, otherwise
`ROTOR RPM PCT:1` and `GENERAL ENG PCT MAX RPM:1`, so other aircraft are unaffected. They feed
`RPMR` / `RPME` and the `RLOW` / `EOUT` lamps. No gas producer variable could be found
(the standard N1 reads about 52 % while the cockpit shows 92 %), so while the turbine L:var is
available `N1` is that value x 0.92 (`FlyInsideGasProducerScale`, from one reading: N2 100 gives
92; not checked at other powers). The turbine out temperature (`ITT`) is estimated too: the standard `TURB ENG ITT:1` reads about 540 C while
the cockpit dial shows 600 at idle, and the dial rises with power (about 650-660 at torque 74 %, about 700 at
115 %, read from screenshots). So `ITT` is turbine N2 x 6 plus 1.05 C per torque percent above the idle torque
of 21 (`FlyInsideTurbineOutTemp()`); three rough readings only.
Fuel load (`FUELLOAD`, sent as psi from the fuel pressure): the cockpit FUEL dial is a 0-3 scale marked x10 with
the needle at about 1.7-2 while `GENERAL ENG FUEL PRESSURE:1` reads 1.7, so the SimVar is in dial units and
`FUELLOAD` is 10 x it (`FlyInsideFuelPressureScale`; the Dual Stepper's table runs to 30 psi). One dial reading.

Transmission oil (`XMSNP`, `XMSNT`): no variable exists (the standard SimVars read 0; the XMSN OIL dial
showed about 35 psi and about 10-20 C), so both are estimates. Pressure is 35 psi x the rotor speed fraction
(`FlyInsideTransmissionPressure`). Temperature starts at the outside air temperature and moves slowly (5 min warming,
10 min cooling time constants) toward ambient + 0.8 C per torque percent while the rotor is above 50 % (about 33 C at
idle, 75 at 74 % torque; `UpdateTransmissionTemp`); it restarts from ambient when the bridge restarts. Neither is
read from the aircraft: replace them if an L:var is found (search the Behaviors Global tab for `xmsn`, `trans`, `gear`).

Torque (`TQ`): `ENG TORQUE PERCENT:1` reads 0. The cockpit dial follows the collective immediately, while
the sim's torque variables lag it by several seconds, and `COLLECTIVE POSITION` reads 0 too. With the
turbine L:var at 95 or more (rotor at normal speed) `TQ` is `21 + 0.72 x` `GENERAL ENG THROTTLE LEVER
POSITION:1` (on the test setup the collective axis arrives as that variable; dial about 21 % at 0 and about 74 %
steady at 73.6) up to lever 73.6, then a steeper line (about 1.74 per lever percent) to 120 % at lever 100
(`FlyInsideTorqueLeverKnee`; the dial read about 100 % at lever 89; clamped to 0-120, `FlyInsideTorqueMax`). Below that speed it is estimated from `TURB ENG MAX TORQUE PERCENT:1`
through two readings (raw 5 gives 20, raw 27.5 gives 70; `FlyInsideTorque()`). Full collective for more than
about 2 s over-torques and breaks the engine in this aircraft (the dial swung to about 115 %). The lever
mapping depends on the controller; only two steady readings back the 0.72 slope.
Transmission and the other lamp variables have not been found yet.

## CowaSim Jet Ranger estimates (2026-10-18)

The CowaSim Jet Ranger (aircraft title `206B3 ...`) reports the standard SimVars, but three of its cockpit dials
do not read them, so the bridge applies these estimates to it (`cowaSim` in `ToSnapshot`). They were fitted to dial
readings taken from screenshots during a fast collective sweep (the aircraft then crashed), so they are rough:

- **Torque (`TQ`):** the dial is a smoothed copy of `ENG TORQUE PERCENT:1`: about 0.42 x the SimVar (dial about 38 at the
  steady idle value of 83, about 120 at a peak of about 260; 0.48 from the sweep fit, lowered to 0.42 after a flight check
  read about 15 % high) with a smoothing time constant of about 2.5 s (`CowaSimTorqueScale`,
  `CowaSimTorqueSmoothSeconds`, `SmoothCowaSimTorque()`); RMS error about 18 points on a signal swinging between 0 and 120.
- **Turbine out temperature (`ITT`):** the dial follows `ENG EXHAUST GAS TEMPERATURE:1`, not ITT (which reads over 2,000):
  EGT - 200 C (`CowaSimTurbineOutTempOffset`), within about 30 C over nine readings.
- **Electrical load (`ELECTRICALLOAD`):** the LOAD dial sat at about 50 % while the total load was 69.5 A, so 139 A is
  100 % for this aircraft (`CowaSimElectricalLoadFullScaleAmps`; 300 A for others). One reading.
- **Transmission oil:** no variable; pressure is 48 psi x the rotor speed fraction (the dial read about 45-50 psi,
  `CowaSimTransmissionPressureNormal`) and the temperature is 0.92 x the engine oil temperature (`CowaSimTransmissionTempOfOilTemp`): the dial read about
  55 C with the engine oil at 60 C shortly after start and did not follow a slow warm-up. One reading.
- Gas producer, engine oil, fuel pressure, rotor and engine speed matched the dials without any change.

The warning lamp for transmission oil pressure uses the estimate for this aircraft as for the FlyInside.

## Warning lamps

Five are implemented. Three can be derived from standard SimVars, with these thresholds: `EOUT` (turbine speed below 60 %), `RLOW` (rotor at or below
95 %) and `LOWF` (fuel 17 US gal or less). `TOPW` (transmission oil pressure) comes on below 40 psi
(`TransmissionPressureWarningPsi`), only when a pressure is available: the FlyInside B206's estimate (35 psi at
normal rotor speed, so the lamp is on all the time with the current estimate, and when the rotor stops) or an
aircraft whose SimVar reads above 0 (most read 0, which would keep it on). `GENF` (generator fail) comes on when the
engine speed is below 10 % (`GeneratorFailEngineRpmPct`). The other ten are aircraft specific
(`DodoSim` supplies them through an FSUIPC offset, which MSFS aircraft do not have) and
stay off; add rules to `Payloads.LampState()` once the aircraft's variables are known.

## Known gaps / to check against MSFS

- Run against MSFS 2024 with the FlyInside B206 and the CowaSim Jet Ranger; the estimates
  above come from those sessions and have not been checked at other power settings.
- Several MSFS Jet Ranger add-ons do not report every SimVar (transmission pressure / temperature read 0 on
  two of them; one reports a fixed rotor speed). A missing `ELECTRICAL AVIONICS BUS VOLTAGE` (reads 0) falls back
  to the main bus for the Radio power rule.
- Pitch sign, and the 24 V thresholds are carried over from the FSUIPC
  bridge and are not verified for MSFS aircraft.
- No hysteresis on the 20 V / 24 V thresholds.
- The FSUIPC bridge also listens on 27001; run only one of the two bridges at a time.

## Aircraft information for the GPS interface (2026-10-18)

Every 500 ms the main timer sends `D,LAT:..,LON:..,ALT:..,IAS:..,HDG:..` (`Payloads.Gps()`) to **`LowranceAirMapGps`** (UDP
`127.0.0.1:27002`; change `GpsHost` / `GpsPort` in `Form1.cs` if it runs on another PC). Three SimVars were added to the data
definition and the `PanelData` struct (at the end, in the same order): `PLANE LATITUDE` and `PLANE LONGITUDE` (degrees) and
`PLANE HEADING DEGREES TRUE`; altitude (`PLANE ALTITUDE`, feet MSL) and airspeed (`AIRSPEED INDICATED`) were already read. The packet also carries `UTC:yyyyMMddHHmmss.fff`, the simulator's UTC date and time, built from the already-read `ZULU TIME`
(seconds since midnight) and three more SimVars, `ZULU YEAR`, `ZULU MONTH OF YEAR` and `ZULU DAY OF MONTH` (left out if the date is
invalid). The
readout shows the position and heading. Like the board packets, nothing is sent while the data is stale, so the GPS interface
falls back to Brisbane Airport after 30 seconds. Built clean and the packet builder checked with sample values (the GPS interface's
parser reads it back correctly); **not yet run against MSFS**.

## Backlight power (2026-10-18)

`Payloads.Servo()`, `Payloads.Stepper()` and `Payloads.DualStepper()` add `BPWR:1` / `BPWR:0` (1 while the main bus is 20 V or more, the same test as
`GaugesPowered()`): first in the Stepper packet and after `PWR` in the Dual Stepper packet. The boards switch their backlight off when
it is 0 (see their summaries).

## Auto Pilot display values and position commands (2026-10-25)

- **Auto Pilot display:** a third extra request (`PanelApValues`, every 6th frame) reads `AUTOPILOT HEADING LOCK DIR`, `NAV OBS:1`, `AUTOPILOT AIRSPEED HOLD VAR`, `AUTOPILOT VERTICAL HOLD VAR` and `AUTOPILOT ALTITUDE LOCK VAR`; they become
  `APHDG`, `APCRS` (three digits, north is 360), `APIAS`, `APVS` and `APALT` in the radio packet (`Payloads.ApValueTokens()`).
- **Toggle switch positions:** `TryPositionCommand()` sends `GEAR_SET:1/0`, `FLAPS_SET:1/0` and `SPOILERS_SET:1/0` from the ADF controller as the SimConnect events `GEAR_SET` (0 or 1), `FLAPS_SET` and `SPOILERS_SET`
  (0 or 16383), event numbers from 2000 (`PositionEventNames`). Built clean; not run against MSFS.

## Anti-ice position and ADF / Upper backlight power (2026-10-25)

- **`ANTI_ICE_SET:1/0`:** `PositionEventNames` / `PositionOnValues` gain `ANTI_ICE_SET` (value 1 or 0), mapped to the SimConnect event of the same name (event numbers from 2000).
- **ADF and Upper boards:** (the Upper board was merged into the ADF board on 31 October 2026, so `upperClient` now sends to a retired address and should be removed) new `adfClient` (172.16.1.107) and `upperClient` (172.16.1.103) are sent `Payloads.Adf()` (`D,BPWR:1/0`) with the other boards' packets every 90 ms. Built clean; not run against MSFS.

## Panel emulators (added 1 November 2026)

The window has two check boxes under the Avionics Master box, **Send to the boards** (on) and **Send to the emulators** (off). Ticked, every board packet is also sent to `JetRangerPanelEmulator`
(UDP 13136 on 127.0.0.<the board's last number>, for example 127.0.0.105 for the Stepper); with **Send to the boards** unticked the emulators get them alone and no packet goes to
a board. Command line: `--emulators` (emulators as well as the boards), `--emulators-only`, `--emulator-net <a.b.c>` (the first three numbers of the emulators' addresses, default
127.0.0). `BoardTargets.cs` holds a second UDP client for each board client and sends to the board and/or the emulator; the GPS interface is not a board and is unaffected.
The `SendPacket` helper sends the board clients' packets through `BoardTargets` (the retired Upper .103 is a board with no emulator). Built and the window checked; no simulator data has been sent through it to the emulators yet.

## Packet monitor (added 1 November 2026)

**Show packets...** (a button under the Avionics Master box, beside the two Send check boxes) opens a window that lists every payload as it is sent: one line per packet with the time, the target board (Radio .101, Servo .102, Stepper .105,
Dual Stepper .106, ADF and Upper .107, the retired Upper .103 (this bridge still sends it the backlight packet), and the GPS interface) and where it went (*board*, *emulator*, *board + emulator*, or *local* for the GPS interface), then
the payload text, for example `15:15:00.234  Stepper .105  board  D,BPWR:1,IAS:82,AGL:450,...`. The **Target board** box filters the list to one board (or *All boards*); **Pause** stops
adding lines (the packets in between are dropped), **Clear** empties the list, and the window counts the lines shown and the packets sent since it opened. Command line: `--show-packets` opens
the window at start and `--packet-board <radio, servo, stepper, dual, adf, gps, or a last number such as 105>` opens it filtered to that board. `BoardTargets` (in `BoardTargets.cs`) raises a
`PacketSent` event for every send (the board packets through `Send`, the GPS packets through `SendDirect`) and `PacketMonitorForm` (`PacketMonitor.cs`) queues them and shows them ten times a
second, keeping the last 6,000 for re-filtering, so a busy bridge is not slowed. Only packets that are really sent are shown: nothing appears while both the boards and the emulators boxes are
unticked, or (DCS and X-Plane bridges) while no data is arriving. Tested with the DCS bridge and its synthetic stream (all boards, the `--packet-board stepper` filter, and the filter box changed
while open); the MSFS and FSUIPC windows were checked (button, `--show-packets`) but no simulator data has gone through their monitor.

## DME readout (8 November 2026)

A fifth SimConnect request (`PanelDme`, about 5 times a second, in its own request like the autopilot and audio ones) reads NAV1's DME: `NAV HAS DME:1`, `NAV DME:1` (nautical miles) and `NAV DMESPEED:1` (knots). `Payloads.DmeTokens()` adds `,DMEDIST:12.3,DMESPD:120` to the Radio packet (distance to one decimal, speed in whole knots, a negative speed sent as 0); with no DME in range it sends `DMEDIST:-1,DMESPD:-1`. The values go out with the other radio data: on change (at most every 200 ms) or every 5 seconds. The Radio controller (build 12 or later) shows them on its DME display. The bridge builds clean; it has not been run against MSFS with a tuned DME station, so check that `NAV DME:1` and `NAV DMESPEED:1` read as expected for the aircraft you fly (some aircraft model DME on NAV2 only).

## About window, version and build number (8 November 2026)

The **About...** button (under Show packets...) opens it. The **data out** text box (the readout) now grows and shrinks with the window, the lamp list stays against the right edge, and a **Pause data out** check box freezes the text box while the data keeps going to the boards (the readout is only redrawn when the box is unticked). Checked by resizing the running window (the box went from 281 x 441 to 798 x 702 pixels at a 1300 x 900 window). **Raise `<BuildNumber>` in the project file by one every time this program is changed** (and `<Version>` for a larger change); the build date and time are stamped in automatically at every build, so they are always the time of the last build. `AboutForm.cs` reads them from the program (assembly metadata `BuildNumber` and `BuildDateTime`, and the assembly version) and shows the program name, version, build number and build date and time. The version is 1.0.0 and the build number started at 1 on 8 November 2026.

## DME on the data out box, and the station identifier (8 November 2026, build 2)

The data out text box now has a line `DME (NAV 1): IBN  1.0 NM  0 KT` (`none` with no DME), so the DME values being sent can be seen. The DME request also reads `NAV IDENT:1` (a string, so it is the last field of `PanelDmeData`), and `Payloads.DmeTokens()` adds `,DMEID:IBN` (capitals, letters and digits only, at most 4 characters; `-` when there is none) to the Radio packet. Checked against the running MSFS (the CowaSim 206B3 at Brisbane): the text box showed the identifier and distance. The Radio shows the identifier from build 14.

## Radio packet twice a second (8 November 2026, build 3)

The radio packet (frequencies, bus, power, LEDs, Auto Pilot values and DME) now goes out at least every 500 ms (`RadioRefreshMs`), instead of every 5 seconds when nothing changed; a change is still sent at once (at most every 200 ms). Checked with the bridge on `--emulators-only` and a UDP listener on 127.0.0.101: 18 packets in 14 seconds, 0.53 to 0.56 s apart (the 100 ms timer rounds the interval up to the next tick), each 353 bytes with the DME tokens.

## Scroll bar on the data out box (8 November 2026, build 4)

The data out text box has a vertical scroll bar. Because setting its text sends the view back to the top, the readout is now written through `ShowReadout()`, which only rewrites the box when the text changed and puts the scroll position back afterwards, so the box can be scrolled while the data keeps updating (Pause data out still freezes it completely). Checked on the running MSFS bridge: with 6 lines of scrolling requested the box stayed at the end of its range (line 4) over 3 seconds of updates.

## Autopilot and audio status on the data out box (8 November 2026, build 5)

The data out text box now shows what the simulator reports for the Radio panel's LEDs and Auto Pilot display, so a LED that does not light can be traced: `Auto Pilot LEDs lit: none` (or a list such as `AP ENGAGE, HDG, ALT`), `Auto Pilot display: HDG 360  CRS 196  IAS 0  VS 0  ALT 0` and `Audio LEDs lit: COM1, NAV2, DME, NAV1, MKR`. These are the states before the radio power rule (the Radio turns the LEDs off when the avionics bus is below 24 V). Checked against the running MSFS (the CowaSim 206B3): `Auto Pilot LEDs lit: none` and `Auto Pilot display: HDG 360  CRS 196  IAS 0  VS 0  ALT 0`, so the simulator reports no autopilot for that aircraft, while `Audio LEDs lit: COM1, NAV2, DME, NAV1, MKR` matched the Audio LED tokens in the radio packet.

## CowanSim HeloSAS autopilot on the Auto Pilot LEDs (8 November 2026, build 6)

The CowanSim 206B3's autopilot (HeloSAS) does not set the standard `AUTOPILOT …` SimVars, so the Auto Pilot LEDs stayed dark. Its annunciator lights are two bit-field local variables, found in the aircraft's model XML (`HeliSAS_Lights` in `206B3_INT.xml`): `L:CS_HeliSAS_Lights_Green` (engaged) and `L:CS_HeliSAS_Lights_White` (standby), with bits 1 SAS master, 2 HDG, 4 NAV, 8 SPD, 16 ALT and 32 VRT. They are read in the Auto Pilot request (other aircraft read 0) and OR-ed into the LED states: **AP ENGAGE** = SAS (1), **HDG** = HDG (2), **CRS** = NAV (4), **IAS** = SPD (8), **ALT** = ALT (16). VRT (32) has no LED on the panel, and the panel's APPR, FD and BC LEDs have no HeloSAS equivalent. The data out box shows `CowanSim HeloSAS lights: green 19  white 1` for the CowanSim. Checked against the running MSFS with the autopilot engaged in HDG and ALT: `Auto Pilot LEDs lit: AP ENGAGE, HDG, ALT`.

**The Auto Pilot OLED values are still the standard SimVars** (heading bug, NAV1 OBS, airspeed, vertical speed and altitude targets), which the HeloSAS does not use. The module (`Cowan_HeliSAS.wasm`) names `L:CS_AP_Alt_Hold_Target`, `L:CS_AP_IAS_Hold_Target`, `L:CS_AP_VS_Hold_Target`, `L:CS_AP_Alt_Hold`, `L:CS_AP_IAS_Hold`, `L:CS_AP_VS_Hold` and `L:CS_AP_HDG_Hold`, but all read 0 with HDG and ALT engaged, so the references appear to be kept internally; they were not added.

## HeloSAS references on the Auto Pilot display (8 November 2026, build 7)

The HeloSAS takes its altitude, airspeed and vertical speed references at the moment the mode is engaged and keeps them internally (the target variables read 0), so `ApplyHeloSasReferences()` does the same: when the ALT, SPD or VRT light (green bits 16, 8 and 32) comes on, the current altitude (to 10 feet), airspeed (to the knot) or vertical speed (to 10 feet per minute) is remembered and shown as ALT, IAS or VS on the Auto Pilot display until that mode is switched off. If the bridge starts with a mode already on, the values at that moment are used. With no mode on the display shows the standard SimVars as before. HDG shows the heading bug (a standard SimVar, which the HeloSAS does use). Checked against the running MSFS with ALT engaged at about 238 ft: the display showed `ALT 240` and held it while the altitude moved by a foot or two.

## Live NAV active frequencies (8 November 2026, build 8)

The radio packet now has `N1A` and `N2A`, the NAV1 and NAV2 active frequencies (`Nav1Active`, `Nav2Active`, in MHz to three decimals), so the Radio's NAV display follows the simulator. The standby frequencies are not sent (they stay local to the Radio). A change goes out like a COM frequency change (at most every 200 ms), and in any case twice a second. The Radio shows them from build 15. Builds clean; not run live (MSFS was not running).

## ADF frequency to the ADF controller (8 November 2026, build 9)

The packet to the ADF controller (.107) now carries the simulator's active ADF frequency as well as the backlight power: `D,BPWR:1,ADF:284` (`ADF ACTIVE FREQUENCY:1`, in kilohertz, rounded; left out when the simulator reports none or a value outside 190 to 1799). The ADF controller shows it from build 11. The SimVar travels in the DME request. Builds clean; not run against MSFS (it was not running).

## Bridge icon (8 November 2026, build 10)

The program icon is a suspension bridge (`bridge.ico` in the project folder: 256, 64, 48, 32, 24 and 16 pixel images, drawn with GDI+, orange cables and towers over blue water). It is set as the application icon in the project file (`<ApplicationIcon>bridge.ico</ApplicationIcon>`, so it is the icon of the exe) and, from the exe, as the icon of the main window and the About window (`Icon.ExtractAssociatedIcon`). The same icon is used by all four bridges.

## ADF knob frequency to the simulator (8 November 2026, build 11)

The bridge listens on UDP port 27003 (`StartAdfEventListener()`) for `ADF_FREQ:<kHz>`, which the ADF controller sends a moment after its knobs stop turning, and sets the simulator's ADF frequency with the SimConnect event `ADF_COMPLETE_SET` (190 to 1799 kHz; anything else is ignored). The event's parameter is BCD digits, but the unit is not documented clearly and differs between simulators (Prepar3D takes kHz x 10000), so `SetAdfFromController()` tries three encodings in turn (kHz x 10000, Hz, kHz), checks each against the ADF frequency MSFS reports about 1.2 seconds later (`ADF ACTIVE FREQUENCY:1`, already read for the ADF controller's display) and keeps the one that works. The data out box has a line `Last ADF knob frequency from the ADF controller: …` (`set (encoding 1)`, `NOT set (the simulator shows …)` and so on). **Not tested against MSFS** (it was not running): only that the bridge builds, starts and listens on 27003. Until the right encoding has been found, a first frequency may briefly show wrongly while the other encodings are tried; fly with it once and check the line.
