bnepethomas/bne-arduino-flight-simulator-interfaces/Jet Ranger/Jet Ranger Arduino Sketches/JET_RANGER_ADF_CONTROLLER/PROGRAM_SUMMARY.md

# JET_RANGER_ADF_CONTROLLER - Program Summary

Sketch for the **Jet Ranger Upper ADF Controller** PCB (rev 1.0, 26 October 2026, the combined ADF and Upper board and the reference PCB for this sketch): an Arduino Mega 2560 shield with a W5500 Ethernet module
(USR-ES1). Built from `JET_RANGER_RADIO_CONTROLLER` (same Ethernet start-up, debug stream, heartbeat, polling encoder
library, matrix scanner, character OLED start-up and remote reset). Address **172.16.1.107**, MAC `A8:61:0A:67:83:6B`.
On 31 October 2026 the former `JET_RANGER_UPPER_CONTROLLER` sketch (172.16.1.103) was **merged into this one**: the overhead switch matrix and the Upper numeric keypad are scanned here too (see "Upper panel" below), and the old Upper sketch is retired (its DCS-BIOS stubs, every case empty, were not carried over).
It compiles for `arduino:avr:mega` (29,296 bytes flash, 2,557 bytes RAM) and is flashed on COM26. Bench-checked: the 12 V reading (A8), the landing gear lamps (from the BenchTester) and the ADF keypad on the combined board. Not bench-tested on the combined board: the Upper matrix and keypad, the switches at their new pins (D31 to D37) and the blanking and backlight rules (below).

## What it does

| Function | Pins | Behaviour |
|---|---|---|
| ADF tuning | D6/D7 major, D8/D9 minor | Major knob 100 kHz per click, minor knob 1 kHz per click (accelerates when spun). Range 190 to 1799 kHz, starts at 340. The frequency is sent 250 ms after the knobs stop |
| Aircraft ID keypad | A7, A6, A5, A4 rows, A3, A2, A1 columns | 4 x 3 keypad (J41). The keypad lines arrive in reverse order on this PCB, so the rows are A7 to A4 and the columns A3 to A1 (the old ADF board used D22 to D25 and D26 to D28). Digits build an ID (up to 8), `#` sends it, `*` deletes a digit, `*` on an empty entry stops following. An unfinished entry is dropped after 20 s. `keyMap[][]` holds {6,4,5}, {9,7,8}, {#,*,0}, {3,1,2}: the labels moved to where each key was actually reported on the old board, and confirmed correct on the combined board (31 October 2026) |
| Upper switch matrix | D22 to D30 rows (`ROW0` to `ROW8`), D38 to D45 columns (`COL0` to `COL7`) | 9 x 8 diode-isolated matrix (J30, J31, 10 k column pull-ups). One row is scanned per pass of the main loop (80 us settle, 20 ms lockout after each change). A change is sent to the USB HID board as `index,state` with `index = row x 11 + column` (0 to 95: the old 11 column numbering is kept so the joystick buttons and bindings do not change). The Warning Mute (J17) and TOT Test (J18) switches are indexes 88 and 89. Switches closed at power-up are reported straight away |
| Upper keypad | A10, A12, A14, A15 rows, A9, A11, A13 columns | 4 x 3 keypad (J32), keys `2 1 3 / 0 * # / 8 7 9 / 5 4 6`. A press and release are sent to the HID board as `KEY,<key>,1` and `KEY,<key>,0` (non-blocking: the old sketch waited in a loop for the release) |
| Panel brightness | A0 pot, D5 backlight | **Switched off for the moment** (`USE_BRIGHTNESS_POT` 0): the pot is not read, no `C,B` is sent to the other panels and this board's backlight stays at level 4 (PWM 68) until a `C,B` command sets it. Set it to 1 and reflash to bring the pot back (level 0 to 15 from the smoothed pot, sent to the Radio .101, Servo .102, Stepper .105 and Dual Stepper .106) |
| 12 V monitor | A8 | 47k / 10k divider with 0.1 uF, so volts = pin volts x 5.7, scaled by the measured 5 V. On the combined board the divider is on **A8** (the old ADF board used A15, now an Upper keypad line: the sketch reported 5.33 V with 12.3 V on the board until it was changed; 2.12 V measured on A8 matched the divider) |
| 5 V monitor | AREF / AVcc | The ADC reference (AVcc, the 5 V rail the AREF pin follows) is measured against the internal 1.1 V band-gap. The sketch never calls `analogReference()` |
| Power status | | Every 30 s (and 5 s after start-up, or on `C,POWER:1`), see below |
| Display | I2C 0x3C | Character OLED, 2 lines of 16: `ADF  340 kHz` and `ID: 1234_` / `FOLLOW 1234` / `FOLLOW OFF`. Written directly on the Mega's I2C bus (no TCA9548A) |

The landing gear lamps (D2 to D4) are lit by data packets: `D,LDGN:1,LDGL:1,LDGR:0` (1 = lit); the BenchTester has a toggle for each. The landing gear, flaps, speed brake and brake switches
(D31 to D34, to ground when on, 30 ms debounce) are sent as joystick buttons to the USB HID board (172.16.1.11:4210, Joystick 4, indexes 104 to 107, `index,state`). The gear, flaps and speed brake are
**toggle switches, so their position is sent as a value** to the bridge on UDP 27001: `GEAR_SET:1` (down) / `GEAR_SET:0` (up), `FLAPS_SET:1/0` and `SPOILERS_SET:1/0` on every change and again every
5 s (`POSITION_RESEND_MS`), so the simulator follows the switches, including their position at power-up (the aircraft moves about 5 s after the panel is switched on). The brakes push button sends
`PARKING_BRAKES` when pressed. For 1.5 s after start-up the switches are only read. If a switch works the wrong way round, swap its 1 and 0. Each ADF knob click is also a 40 ms press of Joystick 4 buttons
(major clockwise / anticlockwise 108 / 109, minor 110 / 111). The heartbeat is `ADF_PANEL V5:5.03 V12:12.41` (5 V and 12 V rails) for the Health Monitor, followed by the same readings as `UPPER_INPUT V5:5.03 V12:12.41` (the old Upper board's name, so the monitor's Upper light stays green).

## Network

| Direction | Port | Contents |
|---|---|---|
| In, UDP 13136 | control and data | `C,RESET:1` reboot, `C,MATRIX:1` raw keypad dump to the debug stream, `C,POWER:1` send a power status now, `C,B:0-15` backlight brightness, `C,KEEPALIVE:1`, `C,DISPLAY:0/1` (from the Radio). Data packets: `LDGN`, `LDGL`, `LDGR` (lamps) and `BPWR` (backlight power) |
| Out to 172.16.1.10:27000 | debug | Text, prefixed `Jet Ranger ADF:` |
| Out to 172.16.1.10:13137 | heartbeat | `ADF_PANEL` and `UPPER_INPUT` every 10 s |
| Out to 172.16.1.11:4210 | USB HID board | ADF switches and knobs (indexes 104 to 114), the Upper matrix (`index,state`, 0 to 95) and the Upper keypad (`KEY,key,state`) |
| Out to 172.16.1.10:27003 | PC events | `ADF_FREQ:830`, `RADAR_FOLLOW_ID:4521` (`RADAR_FOLLOW_ID:0` = stop), `POWER,V12:12.41,V5:5.02,STATUS:OK` |

The events use port 27003, not 27001, because the FSUIPC and MSFS bridges treat any unrecognised string on 27001 as a COM1 standby
frequency. **The bridges do not read port 27003 yet**, so nothing reaches the simulator until they are extended.

`STATUS` is `OK`, or the rails out of range joined with `+` (`5V_LOW`, `5V_HIGH`, `12V_LOW`, `12V_HIGH`). Limits: 5 V 4.75 to 5.25, 12 V 10.8 to 15.0
(`V5_LOW`, `V5_HIGH`, `V12_LOW`, `V12_HIGH`). `V12_CAL` and `V5_CAL` trim the readings against a meter.

## Things to check on the bench

- **ADF keypad rows and columns.** Checked on the combined board: the keypad lines are reversed (rows A7 to A4, columns A3 to A1). `C,MATRIX:1` prints the raw readings if the keys ever need checking again.
- **Upper matrix and keypad.** Operate each switch and key and watch the debug stream for `Front Input - <index>:<state>` and `Upper key pressed: <key>`; indexes 66 to 95 share Joystick 3 with the Auto Pilot panel's buttons (64 to 81), so do not fit switches at 66 to 73 or 77 to 81.
- **Retired address.** Nothing answers at 172.16.1.103 any more; the bridges and the BenchTester still send to it (harmless, to be removed).
- **Encoder direction.** If a knob turns the frequency the wrong way, swap its A and B pins in the `RotaryEncoder` lines.
- **OLED type.** The display code is the Radio controller's character OLED (SSD/US2066 style, address 0x3C). If the ADF panel uses a graphics SSD1306 it needs different code.
- **Rail readings.** Compare the readings (the Health Monitor's voltage table, or the `POWER` line on port 27003) with a meter and trim `V12_CAL` and `V5_CAL`. The power status is **not** sent to the debug reflector (changed in firmware 1.0 build 2, 1 November 2026); it goes to the PC on port 27003 and, as `V5` and `V12`, in the heartbeat.

## New switches, blanking and backlight (2026-10-25, pins updated 2026-10-31)

- **New switches:** anti-ice (D36, connector J20, Joystick 4 button 17 / index 112), hyd boost (D35, J20, button 18 / 113) and caution dim (D37, J20, button 19 / 114) are in `adfSwitches[]`, to ground when on. Anti-ice also sends `ANTI_ICE_SET:1` / `ANTI_ICE_SET:0` to the bridge on UDP 27001 (on every change and every 5 s, like the other toggle switches); the other two are joystick buttons only. For the DodoSim 206 V2, bind the joystick buttons in FSUIPC to `ANTI_ICE_SWITCH_SET`, `HYDRAULICS_SWITCH_SET` and `CAUTION_LIGHT_SWITCH_SET` (1 on press, 0 on release) and use either that or the bridge's `ANTI_ICE_SET` for anti-ice, not both.
- **Keypad connector:** the ADF keypad lines are on pins 18 to 24 of the 26-pin ADF connector J5 and reach the Mega on A1 to A7 (J41); the ADF panel connectors J5 and J20 keep their pin-outs on the combined board.
- **Panel blanking:** `panelBlank()` is true while the Radio has told the board `C,DISPLAY:0` (`displayOn` false) or the no-data timeout has fired (`noDataBlanked`: 30 s, `NO_DATA_TIMEOUT_MS`, with no data packet, `C,B` or `C,KEEPALIVE` and no local input: a knob click, a key or a switch change, `noteActivity()`). It clears the OLED and puts the landing gear lamps out (`lampWanted[]` remembers what they should show).
- **Backlight:** `applyOwnBacklight()` is off while `BPWR:0` was received (`backlightPowered`) or the no-data timeout has fired; otherwise the level is `brightnessLevel` (level 4 by default, then `C,B:0-15` while `USE_BRIGHTNESS_POT` is 0). The bridges send `D,BPWR:x` to this board, and the BenchTester's brightness, backlight power and keep-alive include it.
- Compiled at 29,296 bytes flash (11%) / 2,557 bytes RAM (31%) with the Upper code merged in.

## Firmware version

`FIRMWARE_NAME`, `FIRMWARE_VERSION` and `FIRMWARE_BUILD` are defined above `SendDebug()`. The board reports them, with the compile date and time, on the debug stream straight after *Ethernet Started*,
and on `C,VERSION:1`. **Raise `FIRMWARE_BUILD` by one every time this sketch is changed** (and `FIRMWARE_VERSION` for a larger change). Version 1.0, build 1 was added on 1 November 2026; **build 2** (1 November 2026) stopped sending the power status to the debug reflector; **build 3** (1 November 2026) added the version to the heartbeat; **build 4 (6 November 2026) added the start-up backlight hold**. The heartbeat to the Health Monitor also carries it as ` FW:1.0.<build>` (for example `ADF_PANEL V5:5.03 V12:12.41 FW:1.0.3`, and the same on `UPPER_INPUT`), which the Health Monitor shows in its voltage table.

## Start-up backlight (6 November 2026)

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

### OLEDs and indicators during the start-up hold (6 November 2026)

While the start-up hold is on the **OLED stays on** and **all three landing gear lamps are lit**: `panelBlank()` returns false and `applyLandingGearLamps()` lights every lamp, whatever the Radio's `C,DISPLAY` message, the no-data timeout or the bridge say. When the hold ends `refreshAfterStartupHold()` redraws the OLED and puts the lamps back to what the bridge asked for. Build 5. Compiled, not yet flashed.

**Build 6 (6 November 2026): the OLEDs now blank with the backlight when the hold ends and no bridge is feeding the board.** Each board's own 30 second no-data timeout counts from the end of *its* start-up, so a board that finished its start-up well before the Stepper controller still had part of that 30 seconds left when the announcement arrived, and its OLEDs lingered until it ran out (about 5 seconds on the Dual Stepper). `refreshAfterStartupHold()` now expires that timeout straight away when no data or input has arrived for more than 2 seconds (`lastMSFSDataMillis` / `lastLocalActivityMillis` / `lastActivityMillis` set to `millis() - timeout`), so the OLEDs blank on the next pass. With a bridge feeding the board nothing changes. The indicator lamps already went out at once (their wanted states are all off without data). Compiled, not yet flashed.

## Landing gear lamp brightness, C,GEARB (7 November 2026)

**`C,GEARB:0-15`** sets the brightness of the three landing gear lamps (0 = never lit, 15 = full, the default and the level at start-up). The lamp pins D2, D3 and D4 are PWM pins, so `applyLandingGearLamps()` now uses `analogWrite(pin, map(gearLampLevel, 0, 15, 0, 255))` for a lit lamp (255 is a steady HIGH) and 0 for an unlit one; the start-up hold lights the lamps at the same level. It is separate from the backlight (`C,B`, from the pot or the BenchTester), which does not change the lamps. A `C,GEARB` also counts as activity for the no-data timeout. Debug line: `Landing gear lamp brightness 6`. The BenchTester's **ADF panel landing gear lamps** group has a **Brightness (0-15)** slider for it. Build 7: compiled at 30,842 bytes flash (12%) and 2,732 bytes RAM (33%); not flashed or tested on the board yet.

## Start-up backlight level: 100 percent, then 70 percent (7 November 2026)

While the start-up hold is on the backlight is **100 percent** (`STARTUP_BACKLIGHT_PWM` 255), whatever brightness was commanded or is the default, and a `C,B` command received during the hold does not change it. When the hold ends (the Stepper controller's `STARTUPDONE`, or the 180 second failsafe) the commanded level becomes **70 percent** (`AFTER_STARTUP_BACKLIGHT_PWM` 179) and the backlight goes **off**; it comes back at 70 percent when the bridge sends `BPWR:1`, unless a `C,B` command has set another level. This replaces the earlier hold level (the commanded or default level) described above. Here the 70 percent is `backlightPwmAfterStartup`, used by `applyOwnBacklight()` instead of the 0 to 15 level until the pot or a `C,B` command sets a level of its own (the level steps would give 67 or 73 percent). Build 8: compiled at 30,884 bytes flash (12%), 2,734 bytes RAM (33%); not flashed or tested on the board yet.

**Build 9 (7 November 2026): comments only.** The three source comments that named the SwingTester now say BenchTester (the bench tool was renamed on 7 November 2026). No behaviour change; compiled at 30,884 bytes flash (12%) and 2,734 bytes RAM (33%), the same as build 8.

## Upper keypad presses to the PC (8 November 2026, build 10)

Each press on the Upper numeric keypad (not the release) now also sends `UPPER_KEY:<key>` (for example `UPPER_KEY:*`) to the PC on UDP port 27003, the ADF events port, in addition to typing the key through the USB HID board as before (`sendToPc()` in `scanUpperKeypad()`). A bridge can act on it: the FSUIPC bridge toggles the ATC menu on `*`. Port 27003 is read by no other program yet, so nothing else changes. Compiled at 30,954 bytes flash (12%) and 2,746 bytes RAM (33%); not flashed yet.

## The simulator's ADF frequency on the display (8 November 2026, build 11)

The bridges now send the simulator's active ADF frequency to this board in the data packet, `D,BPWR:1,ADF:284` (kHz). `setAdfFromBridge()` puts it on the display (`adfKhz`, limited to 190 to 1799), so the display follows the simulator; before this the board's data packets from the bridges held only `BPWR`, and the display showed the frequency set with its own knobs, starting at 340 kHz. The knobs still tune the simulator through the joystick buttons (Joystick 4 buttons 13 to 16) and change the display at once; a frequency from the bridge is not applied for a second after a knob turn, or while the new knob frequency is still waiting to be sent to the PC (`ADF_FREQ` on port 27003), because the simulator has not caught up yet. Compiled at 31,096 bytes flash (12%) and 2,750 bytes RAM (33%); not flashed yet.

## Keys left to the bridge (8 November 2026, build 12)

A bridge can say which Upper keypad keys it handles itself: the data token **`BRIDGEKEYS`**, for example `D,BPWR:1,ADF:284,BRIDGEKEYS:*`. For 5 seconds after the last one (`BRIDGE_KEYS_HOLD_MS`; a bridge sends it with every packet) those keys are **not typed** through the USB HID board, neither the press nor the release (`upperKeyHandled[][]`), but they still go to the PC as `UPPER_KEY:<key>`. The FSUIPC bridge (Prepar3D / FSX) says `*`, because it toggles the ATC menu on `*`, so `*` no longer types an asterisk while that bridge runs. With no bridge running, or with the MSFS, DCS and X-Plane bridges (which do not send `BRIDGEKEYS`), every key is typed as before. The debug line for a key left to the bridge reads `Upper key pressed: * (left to the bridge, not typed)`. Compiled at 31,456 bytes flash (12%) and 2,818 bytes RAM (34%); not flashed yet.

## ADF keypad enters the squawk code (8 November 2026, build 13)

When the FSUIPC bridge says so (`D,ADFKEYPAD:SQUAWK` with every packet, held for 5 seconds, `squawkMode()`), the ADF keypad enters the **transponder (squawk) code** instead of the radar follow ID: four digits, 0 to 7 only (8 and 9 are ignored, as on a real transponder), `#` sends `SQUAWK_SET:<code>` to the PC on port 27003 (an incomplete entry is dropped with a debug line), `*` deletes the last digit (on an empty entry it just cancels). The radar follow ID is not touched in this mode. The second line of the display shows `SQUAWK: 12_` while typing and `SQUAWK 3374` otherwise, the code the bridge reports (`SQK:3374` in the data packet); a report is ignored for 1.5 seconds after a code is entered (the simulator has not caught up). Without the bridge, or with the other bridges, the keypad is the radar follow ID keypad as before (`ID: 12_`, `FOLLOW 12`). Compiled at 32,180 bytes flash (12%) and 2,929 bytes RAM (35%); not flashed yet.
