bnepethomas/bne-arduino-flight-simulator-interfaces/Jet Ranger/Jet Ranger Arduino Sketches/JET_RANGER_SERVO_CONTROLLER/PROGRAM_SUMMARY.md

# JET_RANGER_SERVO_CONTROLLER — Program Summary

Arduino Mega 2560 + W5500 Ethernet shield. Drives 15 warning lamps and 2
analogue-gauge servos (Attitude Indicator pitch/bank) from flight-sim data
received over Ethernet.

> **Out-of-band change (not made in this doc pass):** this sketch used to
> drive 15 servos - airspeed, VSI, engine torque, oil pressure/temp,
> transmission pressure/temp, EGT, rotor/engine RPM, N1, fuel, and
> fuel/electrical load, alongside pitch/bank. All 15 were removed from the
> `Servos` enum, the position arrays, `UpdateServoPos()`,
> `HandleOutputValuePair()`, `ResetGaugesToZero()`, `CheckServoIdleTime()`,
> and the setup-time self-test sweep - cleanly, with nothing left
> referencing a removed enum member. Only pitch/bank remain servo-driven on
> this board; those other gauges are now driven by
> [`JET_RANGER_STEPPER_CONTROLLER.ino`](../JET_RANGER_STEPPER_CONTROLLER/PROGRAM_SUMMARY.md)/
> [`JET_RANGER_OLED_DUAL_STEPPER_CONTROLLER.ino`](../JET_RANGER_OLED_DUAL_STEPPER_CONTROLLER/PROGRAM_SUMMARY.md)
> instead. Confirmed still compiling clean after the change (20,218 bytes,
> before this pass's Pitch calibration addition below).

## Program flow

1. **Setup**
   - Sets status LED pins, then calls `InitialiseWarningLights()` which sets
     all 15 warning-lamp pins to `OUTPUT` and turns them all on (lamp test).
   - Resets the W5500 shield, brings up Ethernet on the static IP, opens the
     UDP sockets below, and flashes the red LED for 3s while the link
     settles.
   - Runs a self-test/zero sequence: every servo is driven to its zero
     position, then swept from its minimum to maximum position and back
     (visible "wiggle test"). At the end both servos are parked fully at
     their calibrated zero: `aServoPosition[]` and `aTargetServoPosition[]`
     are set to `aServZeroPosition[]` (previously they were left at 0 and
     the placeholder `{444, 555}`, so `UpdateServoPos()` would have eased
     the servos towards those the moment `loop()` started), followed by a
     500ms settle delay. All 15 warning lamps are then switched off with
     `setWarningLightAll(false)` - the old hand-written list left the Rotor
     RPM Low lamp on after setup.
2. **Main loop** (`loop()`)
   - Toggles the status LEDs every 200ms (heartbeat).
   - Sends a `"SERVO"` keepalive to the reflector every 10s.
   - Every 5ms (`incomingcheckinterval`), checks for an incoming UDP packet
     on the MSFS port and, if present, passes it to
     `ProcessReceivedMSFSString()`, which parses the CSV payload
     (`D,TQ:120,IAS:80,...` / `C,B:5`) and updates:
     - 2 servo **target** positions (see `HandleOutputValuePair`) - `PITCH`
       and `BANK` (Attitude Indicator pitch/roll), the only two servos
       left on this board (see the out-of-band-change note above). Both
       are parsed as `float` (not `toInt()`), matching RPME/RPMR's own
       one-decimal wire format (e.g. `"82.4"`), and both now have real
       bench-measured calibration tables converting real attitude degrees
       into a servo position - reusing one shared `DegToServoPosEntry`
       struct + clamp + linear-interpolation pattern (same approach the
       stepper sketches use for their own calibration tables):
       - `PITCH_DEG_TABLE` (3 points: -30°→179, 0°→113, +30°→70) via
         `pitchDegToServoPos()`.
       - `BANK_DEG_TABLE` (3 points: -90°→5, 0°→93, +90°→179) via
         `bankDegToServoPos()` - endpoints match `aServMinPosition[]`/
         `aServMaxPosition[]` for this servo exactly. `aServZeroPosition[]`'s
         Bank entry was also updated (91 → 93) to match this table's
         bench-measured 0° point, so the setup-time self-test sweep and
         the no-data-watchdog's `ResetGaugesToZero()` both now return this
         servo to the same position `bankDegToServoPos(0)` does.
       Neither is a raw servo-position pass-through any more - the wire
       value for both codes is real attitude degrees now, not a
       pre-converted servo position the sender used to compute itself.
       `PITCHRAW`/`BANKRAW` were added alongside as the raw-position
       bypass siblings (bare `toInt()` straight into
       `aTargetServoPosition[]`, skipping the table) - same `"<CODE>RAW"`
       pattern the stepper sketches use for their own calibrated gauges.
     - 15 boolean warning-light states, each driving its lamp pin directly.
   - Every 5ms (`servoCheckInterval`), `UpdateServoPos()` nudges each servo
     one step at a time from its current position towards its target
     (smooth, non-blocking motion), attaching each servo on first use.
     `CheckServoIdleTime()` then detaches any servo that hasn't moved for
     1s (`ServoIdleTime`) to reduce jitter/power draw.
   - **No-data watchdog (new):** if no UDP packet is received for 30s
     (`noDataTimeoutMs`), `ResetGaugesToZero()` sets every servo's
     **target** position back to its calibrated zero
     (`aServZeroPosition[]`, the same array the setup-time self-test
     sweep and a real `"<CODE>:0"` packet's `map(0, ...)` both resolve
     to) and turns off all warning lights (`setWarningLightAll(false)`).
     It also resets the remembered per-lamp state strings to `"0"`:
     `HandleOutputValuePair()` only drives a lamp when the incoming value
     differs from them, so a stale `"1"` would have kept a lamp dark after
     a timeout when the sim next sent `"1"`.
     `UpdateServoPos()` then eases every servo there the normal way -
     this deliberately does **not** write the servos directly the way an
     earlier, incomplete draft of this feature (found commented out,
     using a 5s threshold) used to; that draft wrote the physical
     position immediately but never updated `aServoPosition[]`/
     `aTargetServoPosition[]`, so the next real UDP value would have made
     `UpdateServoPos()` ease from a stale remembered position instead of
     the just-zeroed one. `lastincomingpacketcheck` doubles as "last data
     received" here, armed at the **end of `setup()`**
     (`lastincomingpacketcheck = millis()`) so the self-test sweep can't use
     up the 30s (it's only advanced inside the packet-received
     branch, not on every poll tick) and the existing `servosZeroed` flag
     latches the reset so it only fires once per outage, clearing again
     the moment real data resumes.

## On-demand swing commands

The Pitch and Bank self-test sweeps are now functions, `swingPitch()` and
`swingBank()` (min → max → min, then parked at the calibrated zero with
`aServoPosition[]`/`aTargetServoPosition[]` synced to it). `setup()` calls
them as before; they are also run on demand by UDP **control** packets
`C,SWINGPITCH:1` and `C,SWINGBANK:1` (value ignored), handled in
`HandleControlString()`. Each sweep takes about 2s and blocks the loop; the
servo rests at zero until the next data packet. Compiled but not yet
bench-tested via UDP.

## Debounced inputs

Three front-panel push switches, each wired between its pin and GND on the
Jet Ranger Front Panel Servo PCB, are read with the internal pull-up (closed
= pin LOW) and debounced (a new reading must stay unchanged for
`InputDebounceMs` = 30ms) in `ServiceInputs()`, called every `loop()`:

| Pin | Switch | PCB net | Joystick 1 button (UDP_TO_HID) |
|---|---|---|---|
| D43 | TOT CLEAR (`SW1`) | `/SW_TOT_CLEAR` | 8 |
| D47 | WARNING MUTE (`SW3`) | `/SW_WARNING_MUTE` | 7 |
| D48 | FUEL VALVE (`SW2`) | `/SW_FUEL_VALVE` | 9 |

Every accepted transition (1) sends a debug message to the reflector
(`172.16.1.10:27000`): `<NAME> CLOSED -> HID button <n>` or
`<NAME> OPEN -> HID button <n>`, e.g.
`Jet Ranger Servo: WARNING MUTE CLOSED -> HID button 7`, and (2) is forwarded
to the **UDP_TO_HID** board (`172.16.1.11:4210`) by `SendButtonToHid()` as
`"<idx>,<state>"` - closed = `1` (pressed), open = `0` - the same format
`JET_RANGER_UPPER_CONTROLLER` uses. The HID board maps idx 0-31 to Joystick 1
buttons 0-31 (its log says `Joystick1 button N`), so the three inputs are
Joystick 1 buttons 7 (WARNING MUTE), 8 (TOT CLEAR / TOT light test) and 9
(FUEL VALVE) in that zero-based numbering; Windows' game-controller panel
numbers buttons from 1, so they appear there as buttons 8, 9 and 10. If 7/8/9
were meant as Windows numbers, change the three `HID_BUTTON_*` defines to
6/7/8. `setup()` also sends each input's
starting state to the HID board so its virtual joystick matches the switches
(matters for the FUEL VALVE toggle, which can rest closed); there is no
periodic refresh, so a HID board that boots after this one stays out of step
until the switch next changes. `InitialiseInputs()` takes the
power-up reading as the starting state (no spurious message at boot) and
`setup()` reports each input's starting state as `<NAME> initial CLOSED/OPEN`
just before "Setup Complete". Nothing is sent to the PC itself - adding more inputs is one more row in
`debouncedInputs[]`. Compiled; the HID forwarding is not yet flashed or
bench-tested for button presses (the debug-message part was bench-tested earlier); the boot-time starting states were confirmed on the HID board's own log on 2026-10-13 (`Joystick1 button 7 set to 0`, `button 8 set to 0`, `button 9 set to 1`).

## Remote reset over UDP

UDP control packet `C,RESET:1` (value ignored) to port 13136 reboots this
board: `RebootBoard()` sends a debug line (`RESET command received - rebooting
in 2s`), waits 100ms, arms the AVR watchdog for 2s (`wdt_enable(WDTO_2S)`) and
spins until it fires, which resets the whole chip. The 2s timeout is
deliberate: the Mega's bootloader may not switch the watchdog off, so a short
timeout could loop. A `.init3` function, `DisableWatchdogAtStartup()`, clears
`MCUSR` and disables the watchdog first thing after every reset (standard
avr-libc pattern), so the sketch never runs with it armed. **Bench-tested on
this board (2026-10-13):** after `C,RESET:1` the debug stream showed the acknowledgement, then "Ethernet Started" 6.9s later, the Pitch/Bank sweeps, the switch starting states and "Setup Complete" about 12.8s after the command, with no reboot loop. If a board ever reboot-loops after a reset
packet, power-cycle it (that clears the watchdog) and reflash.

## Build verification

Compiled with `arduino-cli` (target `arduino:avr:mega:cpu=atmega2560`),
**0 errors**: 23,312 bytes flash (9%), 2,377 bytes RAM (29%). (Dropped
from 27,646/2,925 after the out-of-band 15-servo removal - see the note
at the top of this file.)

## Pin usage

| Pin(s) | Function |
|---|---|
| 43 | TOT CLEAR switch input (`INPUT_PULLUP`, closed = LOW) |
| 47 | WARNING MUTE switch input (`INPUT_PULLUP`, closed = LOW) |
| 48 | FUEL VALVE switch input (`INPUT_PULLUP`, closed = LOW) |
| 14 | Green status LED |
| 15 | Red status LED (flashes while Ethernet link comes up) |
| 53 | W5500 Ethernet shield manual reset (`ES1_RESET_PIN`) |
| 26 | Attitude Pitch servo (`PITCH_PORT` - its `#define` comment still says "Using Gas Producer Port for the moment", a leftover from before that servo was removed) |
| 27 | Attitude Bank/Roll servo (`ROLL_PORT` - same leftover-comment situation, "Using Radar Alt Port for the moment") |
| A1 | Engine Out warning lamp |
| A2 | Rotor RPM Low warning lamp |
| A3 | Transmission Oil Pressure warning lamp |
| A4 | Transmission Oil Temp warning lamp |
| A5 | Battery Hot warning lamp |
| A6 | Battery Temp warning lamp |
| A7 | Engine Chip warning lamp |
| A8 | Tail Rotor Chip warning lamp |
| A9 | Transmission Chip warning lamp |
| A10 | Baggage Door warning lamp |
| A11 | Aft Fuel Filter warning lamp |
| A12 | Fuel Pump warning lamp |
| A13 | Generator Fail warning lamp |
| A14 | Low Fuel warning lamp |
| A15 | Standby Compass (SC) Fail warning lamp |

## Ethernet retransmission timeout

`Ethernet.setRetransmissionTimeout(10)` is called right after `Ethernet.begin()`
(same as the Stepper and Dual Stepper sketches). The W5500's default is 200ms x
8 retries - up to 1600ms blocked inside a UDP send that gets no ARP reply (for
example when the reflector PC or the HID board is off) - so one dead destination could stall
the servo easing in `loop()`. With 10ms per retry the worst case is about 80ms. Compiled at 23,344 bytes flash (9%);
not yet flashed.

## Local network configuration

| Setting | Value |
|---|---|
| Static IP | `172.16.1.102` |
| MAC | `A8:61:0A:9E:83:02` |
| Local port `localport` | 7788 (bound, source socket for outbound debug packets) |
| Local port `localdebugport` | 7795 (bound, currently unused for send/receive) |
| Local port `MSFSport` | 13136 (listens for sim data packets) |
| Local port `aliveport` | 13137 (bound, used to send keepalives) |

> **Fixed:** the `byte mac[]` array in this sketch previously read
> `{0xA8,0x61,0x0A,0x9E,0x83,0x01}` — byte-for-byte identical to
> `JET_RANGER_RADIO_CONTROLLER`'s MAC, even though the human-readable
> `sMac` string already said `...:02`. The byte array now matches the
> label, so all three network boards (Radio, Servo, Upper) have unique
> MACs.

## Remote endpoints this sketch talks to

| Target | Port | Purpose |
|---|---|---|
| `172.16.1.10` (reflector host) | 27000 | Debug/log messages (`SendDebug`) |
| `172.16.1.10` (reflector host) | 13137 | 10s keepalive `"SERVO"` |
| `172.16.1.11` (`UDP_TO_HID` board) | 4210 | Button events `"<idx>,<state>"` for the TOT CLEAR / WARNING MUTE / FUEL VALVE switches (Joystick 1 buttons 8 / 7 / 9) |

## C# programs this sketch communicates with

- **FSUIPCWinformsAutoCS** / **MSFSWinformsAutoCS** — the bridge apps. Each one
  connects a UDP client to `172.16.1.102:13136` (this board) and streams the
  `D,PITCH:...,BANK:...,<lamp>:1/0` packets this sketch parses.
- **StepperVSITester** (new) — primarily a stepper-board bench tool, but
  also connects a third UDP client (`servoClient`) to `172.16.1.102:13136`
  for two rows only: `PITCH`/`BANK`, sent one-decimal-place to match this
  sketch's new `toFloat()`/`round()` parsing.
- **JetRangerHealthMonitor** — listens on UDP **13137** and lights the
  "Servo" indicator green on receipt of this sketch's keepalive.
- No C# project in this repository listens on `172.16.1.10:27000`
  (the debug log stream has no in-repo consumer).

## Backlight: UDP brightness and main bus power (2026-10-18)

The backlight output on pin 5 (`BACK_LIGHTS`, the PCB's `BACKLIGHT_PWM`) is now driven, by `applyBacklight()`, exactly as on the
Stepper and Dual Stepper boards:

- **Main bus:** the bridge sends `BPWR:1` while the main bus is 20 V or more and `BPWR:0` below that (first in the Servo packet). `BPWR:0`
  turns the backlight off, `BPWR:1` turns it on. Until a `BPWR` packet arrives the backlight is on.
- **Brightness:** control packet `C,B:<0-15>` (0 off, 15 full, mapped to PWM 0-255, clamped) is remembered. With no brightness command
  received the backlight uses the default PWM 65 (`BacklightDefaultPwm`); once one has been received, every time power is applied the
  backlight returns to the **last commanded level**. A command received while the bus is down is applied when power returns.
- `setup()` sets pin 5 as an output and applies the default level. **No-data watchdog:** when no UDP packet (data or control) has arrived for 30 s - including after power-up with no PC feed - the watchdog turns the backlight off along with the lamps (`backlightNoData`); the next packet restores it to the commanded (or default) level, provided the main bus is up. Logged as `Backlight restored - UDP data resumed`. Each change is
  logged (`Brightness <n> -> PWM <pwm>`, `Backlight power on/off`).

Compiled at 24,468 bytes flash (9%) / 2,530 bytes RAM (30%); the watchdog change is **not yet flashed or bench-tested**. This replaces the earlier note that
`C,B:n` was accepted but did nothing.

## Heartbeat voltage (2026-10-25)

The heartbeat now carries the board's 5 V rail after its name, for example `SERVO V5:5.02`: `vccHeartbeatText()` measures the ADC reference (AVcc) against the chip's internal 1.1 V
band-gap (`ADMUX` selection `11110`, `MUX5` 0; `AVcc mV = 1125300 / reading`, about 2 ms every 10 s) and the JetRangerHealthMonitor shows the last reading from each board in its voltage table.
The monitor matches the first word of the heartbeat, so the indicator behaves as before.

## Fuel pump and aft fuel filter pins swapped (2026-10-25)

`D_Fuel_Pump` (lamp code `FPMP`) is now on A11 and `D_AFT_Fuel_Filter` (`FFLTR`) on A12 (they were A12 and A11). Compiled at 26,348 bytes flash (10%) / 2,536 bytes RAM (30%) and flashed to COM16; the two lamp outputs have not been checked on the bench since the swap.

## Firmware version

`FIRMWARE_NAME`, `FIRMWARE_VERSION` and `FIRMWARE_BUILD` are defined above `SendDebug()`. The board reports them, with the compile date and time, on the debug stream straight after *Ethernet Started*,
and on `C,VERSION:1`. **Raise `FIRMWARE_BUILD` by one every time this sketch is changed** (and `FIRMWARE_VERSION` for a larger change). Version 1.0, build 1 was added on 1 November 2026; **build 2 (1 November 2026) added the version to the heartbeat**; **build 3 (6 November 2026) added the start-up backlight hold**. The heartbeat to the Health Monitor also carries it as ` FW:1.0.<build>` (for example `SERVO V5:5.02 FW:1.0.2`), which the Health Monitor shows in its voltage table.

## Start-up backlight (6 November 2026)

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

### OLEDs and indicators during the start-up hold (6 November 2026)

While the start-up hold is on **all 15 warning lamps stay lit**: every lamp write goes through `lampWrite()`, which forces the lamp on during the hold (this includes the end of the start-up lamp test and the no-data timeout). The lamps' remembered states keep following the packets underneath, and when the hold ends `refreshAfterStartupHold()` puts each lamp back to its remembered state. Build 4. Compiled, not yet flashed.

## Start-up backlight level: 100 percent, then 70 percent (7 November 2026)

While the start-up hold is on the backlight is **100 percent** (`STARTUP_BACKLIGHT_PWM` 255), whatever brightness was commanded or is the default, and a `C,B` command received during the hold does not change it. When the hold ends (the Stepper controller's `STARTUPDONE`, or the 180 second failsafe) the commanded level becomes **70 percent** (`AFTER_STARTUP_BACKLIGHT_PWM` 179) and the backlight goes **off**; it comes back at 70 percent when the bridge sends `BPWR:1`, unless a `C,B` command has set another level. This replaces the earlier hold level (the commanded or default level) described above. Build 5: compiled at 27,886 bytes flash (10%), 2,673 bytes RAM (32%); not flashed or tested on the board yet.

**Build 6 (8 November 2026): no more "Received a MSFS Packet" debug line.** The board no longer sends `Received a MSFS Packet` to the debug stream for every UDP data packet (about ten a second); the line is commented out, as it already is on the Radio controller. Nothing else changes. Compiled at 27,834 bytes flash (10%) and 2,649 bytes RAM (32%); not flashed yet.
