bnepethomas/bne-arduino-flight-simulator-interfaces/Jet Ranger/Jet Ranger Arduino Sketches/JET_RANGER_OLED_DUAL_STEPPER_CONTROLLER/PROGRAM_SUMMARY.md

# JET_RANGER_OLED_DUAL_STEPPER_CONTROLLER — Program Summary

> **Origin:** this sketch started as a straight copy of
> [`JET_RANGER_STEPPER_CONTROLLER.ino`](../JET_RANGER_STEPPER_CONTROLLER/PROGRAM_SUMMARY.md)
> for a new PCB revision ("Jet Ranger OLED Dual Stepper" under `PCBs/`), and
> gained an OLED subsystem later. Despite the "Dual" name, no second/doubled
> *stepper* gauge exists - this is still a 13-gauge stepper roster, with two
> steppers (previously Radar Alt and Torque) repurposed for new gauges, its own
> separately hand-measured RPME/RPMR calibration, a revived Altimeter (reachable
> via DCS-BIOS, UDP, *and* driving a live OLED readout), and Gas Producer (N1)
> traded away to make room for it. The piece that earns the "OLED" in the name:
> I2C OLED displays (Baro, Altimeter, Clock, Temperature) switched through a
> TCA9548A multiplexer.

## What's different from `JET_RANGER_STEPPER_CONTROLLER.ino`

1. **Board identity and network address changed** so this board can
   coexist on the network alongside the original:
   - `BoardName`: `"Jet Ranger Steppers"` → `"Jet Ranger OLED Dual Steppers"`
   - Header comment: `JET_RANGER_STEPPERS` → `JET_RANGER_OLED_DUAL_STEPPERS`
   - MAC: `A8:61:0A:67:83:69` → `A8:61:0A:67:83:6A` (last byte only)
   - Static IP: `172.16.1.105` → `172.16.1.106`
2. **The stepper on pins 32-35 was Radar Alt; it's now Fuel Load.**
   `RadarAltStepper` → `FuelLoadStepper` throughout (declaration,
   `setMaxSpeed`/`setAcceleration`, startup swing, `.run()` call). The
   pins themselves are unchanged — a new `STEPPER_FL_COIL_A..D` define
   set was added pointing at the same 32/33/34/35 as the now-orphaned
   `RADAR_ALT_COIL_A..D` (left declared but unused).
   - `AGL_FT_TABLE`/`aglFtToSteps()`/`setAGL()` were removed entirely —
     that was a real, hand-measured radar-altitude calibration table,
     not something that could be relabeled for fuel load.
   - The `AGL`/`AGLRAW` UDP codes are gone. In their place: **`FUELLOAD`**
     — raw steps only, since no real fuel-load calibration table exists
     yet. Behaves the way `AGL` did before it had real calibration.
   - The startup swing block (still `if (false)`-disabled, matching the
     original's current state) was relabeled "Fuel Load" but is
     otherwise byte-for-byte the same X27-style wind/zero/swing-loop
     sequence.
3. **The stepper on pins 36-39 was Torque; it's now Electrical Load.**
   Same pattern as the Fuel Load conversion above: `ETstepper` →
   `ElectricalLoadStepper` throughout (declaration, `setMaxSpeed`/
   `setAcceleration`, `.run()` call). Pins unchanged — `EL_COIL_A..D`
   points at the same 36/37/38/39 the old `ET_COIL_A..D` used (that
   define name no longer exists, cleanly renamed rather than left
   orphaned this time).
   - The `TQ` UDP code is gone. In its place: **`ELECTRICALLOAD`** — raw
     steps only, since (like Fuel Load) no real calibration table exists
     yet for this gauge.
4. **`TS_PCT_TABLE`/`RS_PCT_TABLE` (RPME/RPMR) now use this board's own,
   separately hand-measured calibration** - no longer identical to
   `JET_RANGER_STEPPER_CONTROLLER.ino`'s tables. Only 4 points given
   (vs. the original's 13), and the 0-point is *assumed* here (not
   directly measured), same convention as `IAS_KT_TABLE`'s assumed 0kt
   row:

   | pct | step |
   |---|---|
   | 0 (assumed) | 0 |
   | 55 | 300 |
   | 100 | 535 |
   | 110 | 600 |

   Range is also now `0..110`, not `0..117` - values above 110% clamp to
   600 steps rather than extrapolating. `tsPctToSteps()`/`rsPctToSteps()`
   (the interpolation functions) now take a `float` `pct`, not `long` -
   `RPME`/`RPMR` are parsed with `ParameterValue.toFloat()` (was
   `.toInt()`) so the one-decimal-place precision
   `FSUIPCWinformsAutoCS` now sends (e.g. `"82.4"`, was truncated to
   `"82"`) actually reaches the interpolation instead of being rounded
   away first; `setTS()`/`setRS()` are `float`-parametered to match. The
   table data itself (0/55/100/110 → 0/300/535/600) is unchanged.
   **New: `TSoffset`/`RSoffset`** - fine-trim step offsets
   added in `setTS()`/`setRS()` to the table's computed target, so the
   real needles' true mechanical zero can be dialled in without touching
   the calibration tables themselves - same pattern as `VSIoffset` (used
   in VSI's startup-swing zero move). `TSoffset` has since been given a
   real value (`20`); `RSoffset` is still an unmeasured `0`. Both
   `#define`s live up near `VSIoffset` (not next to `setTS()`/`setRS()`
   where they're mainly used) since the Turbine/Rotor Speed startup
   swings' "return to zero" step (below) also needs them, and that runs
   inside `setup()`, earlier in the file than `setTS()`/`setRS()` -
   `#define`s have to appear before first use.
   - **Also new: the Turbine Speed and Rotor Speed startup swings are no
     longer gated by a bare `if (false)` - they're now behind a shared
     `SwingRPM` boolean define, currently `true`, so both swings run
     every boot** (alongside `SwingALT`, the only other active swing -
     `SwingVSI`/`SwingIAS` remain `false`). Each swing's per-loop
     "return to zero" (`TSstepper.runToNewPosition(...)`/
     `RSstepper.runToNewPosition(...)`, previously a literal `0`) now
     targets `TSoffset`/`RSoffset` instead - the calibrated 0% position
     (matching what `setTS(0)`/`setRS(0)` would target), not the
     stepper's raw internal 0. The swing's *initial* homing move (wind
     to `X27_FULLWIRE_HOMING_STEPS`, return to `0`, then
     `setCurrentPosition(0)`) is unchanged and still uses literal `0` -
     that step establishes the physical/internal zero reference itself,
     which is a different concept from the calibrated-zero position the
     swing loop returns to afterward.
5. **`ALTstepper` (Altimeter) has been revived, given its own startup
   swing, and is now the one gauge on this board driving a live OLED
   readout.** On the original sketch (and on this fork, until this
   change) `ALTstepper` was fully commented out. Here it's real again:
   - New pins: `STEPPER_ALT_A..D` = 40/41/42/43 (FULL4WIRE), plus
     `ALTzeroSensePin` = `A15`. **These reuse `GPstepper`'s old pins
     (40-43)** - see point 6 below, GP was fully disabled to make room.
   - New speed constants: `ALT_STEPPER_MAX_SPEED` (600),
     `ALT_STEPPER_ACCELERATION` (600) - both much slower than every
     other stepper's shared `STEPPER_MAX_SPEED`/`STEPPER_ACCELERATION`
     (9000/1000). A third, `ALT_STEPPER_ZERO_SEEK_SPEED` (100), is
     declared but never referenced anywhere - dead constant.
   - **The ad-hoc `if (false)` gates on VSI's and IAS's startup swings
     were replaced with named boolean defines**: `SwingVSI`, `SwingIAS`,
     `SwingALT` (new, ALT never had a swing gate before), plus a shared
     `SwingLoops` loop count replacing several previously-hardcoded
     literals (was `3` for VSI, and a short-lived `No_Of_Altimeter_Startup_Loops`
     = `10` for ALT that has since been consolidated into `SwingLoops`
     too). **Current values: `SwingLoops` = 1, `SwingVSI` = false,
     `SwingIAS` = false, `SwingALT` = true** - so ALT is now the *only*
     stepper on this board whose startup swing actually runs at boot
     (VSI and IAS remain disabled; Fuel Load/Turbine Speed/Rotor Speed
     are still gated by their own separate, unnamed `if (false)`s,
     untouched by this refactor).
   - With `SwingALT` = true, the ALT startup block runs: seeks
     `ALTzeroSensePin` LOW by moving `-STEPS * 2` (`STEPS` = `315 * 16` =
     5040, an old geared-DRIVER-era constant - `-STEPS*2` = **-10080
     steps**; not bench-confirmed as intentional - it's ~14x a single
     720-step revolution, see below). On finding zero it sets
     `setCurrentPosition(-25)` (not `0` - unexplained). It then does a
     round trip of `Z27_360_FULLWIRE_STEPS * SwingLoops` = `720 * 1` =
     **720 steps** and back - with `SwingLoops` now at 1 (down from the
     `10` it briefly was), this is a single clean full-revolution sweep,
     not the ~10-revolution version reviewed previously.
   - `ALTstepper` is driven by DCS-BIOS (`onAltMslFtChange()` /
     `DcsBios::IntegerBuffer altMslFtBuffer`, `CommonData_ALT_MSL_FT`).
     **Its conversion factor has also been changed: `feet * 5.76` →
     `feet * 0.72`** ("5760 Steps per 1000 feet" → "720 Steps per 1000
     feet") - matching `Z27_360_FULLWIRE_STEPS` (720): one full 1000ft
     dial sweep is one full stepper revolution.
     `JET_RANGER_STEPPER_CONTROLLER.ino`'s own (still fully
     commented-out) ALT handling remains at the old `5.76` factor - a
     genuine, deliberate divergence between the two sketches.
   - **`onAltMslFtChange()` now also calls `UpdateAltimeterDigits(newValue)`**
     - the Altimeter OLED display (see point 9 below) is live-wired to
       real DCS-BIOS altitude data, unlike the Baro display, which is
       still boot-splash-only. **Gated on change AND throttled**:
       `UpdateAltimeterDigits()` is only called if `newValue` differs
       from `iLastAltitudeValue` (a variable that existed but was never
       read/written before this) **and** at least `minAltOledUpdateIntervalMs`
       (300ms, new) has elapsed since the last OLED update
       (`lastAltOledUpdateMillis`, new). `ALTstepper.moveTo()` still runs
       unconditionally every callback - only the OLED update is
       skipped/throttled. A value change that arrives inside the 300ms
       window isn't lost: `iLastAltitudeValue` only advances when an
       update actually happens, so the next eligible callback still
       picks up the change rather than it being silently dropped. This
       is on top of (not instead of) the per-digit-group comparison
       already inside `UpdateAltimeterDigits()` itself (which still only
       redraws the specific digits/offsets that changed within a call) -
       the outer gate now also skips calling that function at all, and
       its digit-math work, both when nothing changed and when the last
       redraw was too recent.
   - Additionally, unlike the original sketch, this board's UDP
     `"ALT"`/`"ALTRAW"` cases have been enabled (still commented out on
     `JET_RANGER_STEPPER_CONTROLLER.ino`) - `ALT` calls
     `onAltMslFtChange()` directly with the UDP feet value (so it also
     updates the OLED), `ALTRAW` bypasses the conversion (and the OLED
     update) entirely. `StepperVSITester`'s ALT trackbar now broadcasts
     to both boards and can drive this one too.
6. **`GPstepper` (N1/Gas Producer) has been fully disabled** to free its
   pins (40-43) for `ALTstepper` above: `GP_COIL_A..D` defines,
   the `GPstepper` construct, its `setMaxSpeed`/`setAcceleration`/
   `.run()` calls, and `gpPctToSteps()`/`setGP()` are all now commented
   out. The `N1`/`N1RAW` UDP cases are gone entirely (not just
   commented - removed from the `HandleOutputValuePair()` chain), so
   sending either from `StepperVSITester` is now a silent no-op on this
   board, same as `FLAPS`/`AOA`/`GFORCE`/`SPDMAX` already are.
7. **`X27_FULLWIRE_STEPS` changed from 635 to 630**, now derived from a
   new `FULL4WIRE_STEPS` (315) base constant rather than a bare literal.
   `FULL4WIRE_HOMING_STEPS` is redefined too: was `315 + 5` (320), now
   `FULL4WIRE_STEPS + 1` (316). `X27_FULLWIRE_HOMING_STEPS`'s formula is
   unchanged (`X27_FULLWIRE_STEPS + 1`) but now evaluates to 631, not
   636, since its base moved. This shifts every X27-style stepper's
   full-scale/homing range slightly (VSI, IAS, Fuel Load, Turbine Speed,
   Rotor Speed all reference these constants).
8. **Turbine Speed's and Rotor Speed's startup swings have moved through
   several states across this review sequence** - briefly `if (false)`
   -disabled, then (see point 4) folded into the `SwingRPM` boolean
   define alongside `SwingVSI`/`SwingIAS`/`SwingALT`, currently `true` -
   so both are active again, running every boot alongside `SwingALT`.
   Both swings' internal sequence also changed along the way: the second
   `runToNewPosition()` call in the initial homing move is now `0`
   instead of `-X27_FULLWIRE_STEPS`, and the per-loop "return to zero"
   now targets `TSoffset`/`RSoffset` instead of a literal `0` (see point
   4). IAS's startup swing (still disabled, `SwingIAS` = false) got the
   same `0`-instead-of-`-X27_FULLWIRE_STEPS` homing-move change, but was
   not given an offset-aware zero return since it isn't gauge-calibrated
   the same way.
9. **A substantial new subsystem: two I2C OLED displays (Barometer +
   Altimeter digit readout), switched through a TCA9548A I2C
   multiplexer.** This is the first code on this board that actually
   touches the "Dual"/"OLED" in the PCB's and sketch's names ("Jet
   Ranger X Dual Stepper" has a TCA9548A footprint) - previously nothing
   in this sketch used I2C at all. New includes: `U8g2lib.h`, `Wire.h`,
   `utility/twi.h` (for I2C bus scanning). Added ~510 lines and ~12KB
   flash / ~1.2KB RAM in the pass that introduced it.
   - Hardware: two `U8G2_SSD1306_128X32_UNIVISION_F_HW_I2C` displays
     (`u8g2_BARO`, `u8g2_ALT`), both hardware-I2C (Mega's pins 20/21,
     SDA/SCL - no dedicated pin `#define`s needed), reached through a
     TCA9548A mux at I2C address `0x70` (`TCAADDR`) via `tcaselect(i)`.
     `BARO_OLED_Port` = channel 1, `ALT_OLED_Port` = channel 2.
   - `setup()` scans all 8 TCA9548A channels for I2C devices (logs each
     found address via `SendDebug()`), then initialises both displays,
     picks fonts (`u8g2_font_logisoso16_tf` for BARO,
     `u8g2_font_logisoso32_tn` for ALT), and renders one-time default
     values: `updateBARO("2992")` and `updateALT("0", "0")`.
   - `UpdateAltimeterDigits()` (a ~130-line function with bitmap glyph
     data, e.g. a `hash_bits[]` array - a digit-drum-style rolling
     altitude counter similar to `JET_RANGER_OLED_CONTROLLER`'s
     approach) sprinkles `updateSteppers()` calls between its drawing
     operations, presumably so the (potentially slow) I2C/OLED writes
     don't stall the other steppers' `AccelStepper` servicing. **It is
     now called live from `onAltMslFtChange()`** (see point 5) - the
     Altimeter OLED tracks real altitude. One simplification along the
     way: the line adding barometric offset to the displayed height
     (`height = height + iAltitudeDelta;`) has been commented out with
     a note "Currnetly [sic] ignoring Baro Offset" - the digit display
     currently shows raw MSL altitude, not baro-corrected altitude.
   - `updateBARO()`/`buildBAROString()` remain **uncalled past `setup()`'s
     one-time `"2992"` default** - the Baro display never updates after
     boot. `BaroUpdated`/`AltCounterUpdated`/`CurrentDisplay` are all set
     but never read anywhere - dead state flags.
10. **A third I2C OLED display added: a Clock, showing Zulu time as
    "HH:MM".** Same hardware class as `u8g2_BARO`/`u8g2_ALT` (a third
    `U8G2_SSD1306_128X32_UNIVISION_F_HW_I2C` object, `u8g2_CLOCK`) on its
    own TCA9548A mux channel (`CLOCK_OLED_Port` = channel 3, "SD3/SC3" on
    mux breakout boards that label each channel's I2C pair that way) -
    its own physical unit, not a second use of the Altimeter's display.
    - `updateClock(int hours, int minutes)` formats `"HH:MM"` (via
      `sprintf("%02d:%02d", ...)`) and redraws it with a single
      `drawStr()`/`sendBuffer()` pair - modeled on `updateBARO()`'s
      simple single-string redraw, not `UpdateAltimeterDigits()`'s
      digit-drum bitmap approach (a clock face doesn't need per-digit
      partial redraws). Font is `u8g2_font_logisoso32_tf` (double the
      original `logisoso16_tf`, and the same family/size as `u8g2_ALT`'s
      `u8g2_font_logisoso32_tn` - already proven to fit this exact
      128x32 hardware; `_tf`, not `_tn`, so the `:` glyph is available).
      **Not** the bundled 7-segment font (`u8g2_font_7Segments_26x42_mn`,
      the only one in this U8g2 install) - at 42px tall it doesn't fit a
      32px-tall display without clipping, so `logisoso32_tf` was used
      instead as the largest size that fits cleanly. `drawStr()`'s x
      position is computed at runtime via `getStrWidth()` to
      horizontally center the string rather than a fixed offset.
    - `onZuluTimeChange(int hhmm)` wraps it with the same gate-on-change
      + throttle pattern as `onAltMslFtChange()`/`UpdateAltimeterDigits()`
      (point 5 above): only redraws if `hhmm` differs from
      `iLastZuluTimeValue` (new) **and** at least
      `minClockOledUpdateIntervalMs` (300ms, new) has elapsed since
      `lastClockOledUpdateMillis` (new). `hhmm` is HH*100+MM (e.g. `1430`
      for 14:30).
    - New UDP code **`ZULU`** (HHMM-encoded int) calls
      `onZuluTimeChange()` directly - no DCS-BIOS callback exists for
      this one, `FSUIPCWinformsAutoCS` is the only data source (FSUIPC's
      own Zulu-time offsets, `0x0238`/`0x0239`, have no DCS-BIOS
      equivalent on this board).
    - `setup()`'s OLED-setup block now also initialises `u8g2_CLOCK`
      (`u8g2_font_logisoso32_tf`) and renders a `updateClock(0, 0)`
      default, alongside the existing BARO/ALT init calls.
11. **No-data watchdog: every gauge on this board is driven back to its
    calibrated zero, and all three OLEDs are blanked, if no UDP packet
    arrives on `MSFSudp` for 30 seconds** (`noDataTimeoutMs`).
    `lastMSFSDataMillis` is stamped on every packet actually received
    (separate from `lastincomingpacketcheck`, which just throttles how
    often the socket is polled, unchanged); a `gaugesResetForNoData`
    flag latches so the reset only fires once per outage rather than
    every `loop()` while still timed out, clearing again the moment real
    data resumes. This is deliberately scoped to `MSFSudp` traffic only
    - DCS-BIOS input (serial, a separate path) does not reset the timer.
    New `ResetGaugesToZero()` calls `setIAS(0)`/`setVSI(0)`/`setEGT(0)`/
    `setEOT(0)`/`setEOP(0)`/`setXOT(0)`/`setXOP(0)`/`setTS(0)`/
    `setRS(0)`/`setFA(0)` (each the same calibrated-zero target a real
    `"<CODE>:0"` packet would produce - offset-aware for `TS`/`RS`),
    plus a direct `ALTstepper.moveTo(0)` and
    `FuelLoadStepper.moveTo(0)`/`ElectricalLoadStepper.moveTo(0)` (no
    calibration table exists for either, so `0` raw steps is their only
    "zero"). New `BlankAllOleds()` clears and pushes an empty buffer to
    `u8g2_BARO`/`u8g2_ALT`/`u8g2_CLOCK` (selecting each mux channel
    first) so the panel doesn't keep showing a frozen Baro setting,
    altitude readout, or clock time once the feed behind it has gone
    quiet - deliberately used instead of `onAltMslFtChange(0)` (which
    would've redrawn the Altimeter OLED's digits to `"0"` rather than
    blanking it). `iLastAltitudeValue`/`iLastZuluTimeValue` are also
    reset to an impossible sentinel (`-1`) as part of the same call, so
    once real data resumes, the very next altitude/time update is
    guaranteed to redraw its OLED even if the resumed value happens to
    exactly match whatever was showing before the outage - otherwise
    `onAltMslFtChange()`'s/`onZuluTimeChange()`'s own change-gate would
    see "no change" and leave the display blank.

Everything else — the 8 remaining
gauges (`EOTstepper`/`XOTstepper`/`XOPstepper`/`EGTstepper`/`TSstepper`/
`RSstepper`/`FAstepper`/`EOPstepper`), SARI, and the health keepalive —
is currently identical to the original sketch. See that sketch's own
summary for the full program flow, roster, cautions, and pin/network
tables; only the deltas above and the roster/UDP table changes below are
called out here.

## Zero-offset trims

Beyond the original `TSoffset`/`RSoffset` (Turbine/Rotor Speed) and the
unrelated homing-scale `VSIoffset`, six more fine-trim step offsets were
added, same purpose/pattern as `TSoffset`/`RSoffset` and as the per-gauge
`<CODE>ZeroOffset` set in `JET_RANGER_STEPPER_CONTROLLER.ino`: dial in each
needle's true mechanical zero without touching its calibration table.

`EOTZeroOffset`, `EOPZeroOffset`, `XOTZeroOffset`, `XOPZeroOffset`,
`FuelLoadZeroOffset`, `ElectricalLoadZeroOffset` - all `#define`d near
`TSoffset`/`RSoffset` (before `setup()`, since the boot swings use them),
all default `0` (unmeasured, safe no-op). Each is added inside its gauge's
real-value setter (`setEOT()`/`setEOP()`/`setXOT()`/`setXOP()`/
`setFuelLoad()`/`setElectricalLoad()`), so `"<CODE>:0"` packets and the
no-data-watchdog reset (`ResetGaugesToZero()`, which routes through those
setters) pick them up automatically. The `*RAW` UDP codes deliberately
bypass them. Each gauge's boot swing "return to zero" step now targets its
offset too; `Electrical Load`'s swing targets
`electricalLoadPctToSteps(0) + ElectricalLoadZeroOffset` (its table's 0%
row is 22 steps, not raw 0 - previously the swing returned to raw 0, short
of the real zero). The other five tables' 0 rows are already 0 steps, so
their offset alone is the correct target. ALT has no offset (not part of
this change).

## Startup swing order

`setup()` runs the boot swings in this order (each only if its `SwingXXX`
gate is `true`): Engine Oil Pressure → Engine Oil Temp → Transmission Oil
Pressure → Transmission Oil Temp → Electrical Load → Fuel Load → Turbine
Speed → Rotor Speed → ALT. (ALT was previously after VSI and before IAS;
it was not named in the requested order, so it now runs last. The swing
logic itself is unchanged - only the block order moved.)

The three OLEDs (Baro, Altimeter, Clock) are now initialised **before**
these swings run - the I2C scan and `begin()`/default-text block was moved
from after the swings to just before `"STEPPER INITIALISATION STARTED"`, so
the displays are already up while the needles swing. It is now the function
`initOLEDs()`, which also fixes a hang found on the bench when the order was
first swapped: nothing called `Wire.begin()` before the first
`tcaselect()`, and the AVR TWI code has no timeout by default, so setup()
stalled for tens of seconds (or indefinitely) before the first swing.
`initOLEDs()` now calls `Wire.begin()`, sets a 25ms `Wire.setWireTimeout()`,
and probes the TCA9548A mux once; if it doesn't answer it logs
`TCA mux NOT found - OLED init skipped` and returns `false` so the swings
start immediately. `setup()` retries `initOLEDs()` once after the swings, so
OLEDs that power up late still come up. The root cause of the mux not answering was that nothing drove the TCA9548A's
active-low RESET pin (`TCA_RESET_PIN` = Arduino pin 16); `initOLEDs()` now
pulses it low (10ms) then high before `Wire.begin()`, after which the mux
answers and the Baro/Altimeter OLEDs initialise. Verified on the bench via
the UDP debug stream: OLEDs initialise at ~6s, then all swings run in order
and setup completes at ~65s. The 8-channel diagnostic I2C scan is back inside `initOLEDs()` (behind
`OLED_I2C_SCAN`, default `1`) and sends its results over the UDP debug
stream (reflector 172.16.1.10:27000) as one line per mux channel, e.g.
`I2C scan ch1: 0x3c` / `I2C scan ch3: none` / `bus timeout`, bracketed by
`I2C scan start`/`I2C scan complete`. A channel that times out 3 probes in a
row is abandoned, so the whole scan takes ~0.25s. Bench result: 0x3C on
channels 1 and 2 only, nothing on channel 3 where the Clock OLED is
configured (`CLOCK_OLED_Port`).

## VSI and IAS removed

All Vertical Speed (`VSIstepper`) and Indicated Airspeed (`IASstepper`) code
was removed from this sketch (those gauges live on
`JET_RANGER_STEPPER_CONTROLLER.ino`, 172.16.1.105): the steppers and their
coil pin defines (`COIL_VSI_*`, `STEPPER_SPD_*`), `VSIoffset`,
`SwingVSI`/`SwingIAS`, both boot swing blocks, the DCS-BIOS callbacks
(`onAirspeedNeedleChange`/`onVviChange`) and buffers, `IAS_KT_TABLE`/
`VSI_FPM_TABLE` with their structs and `setIAS()`/`setVSI()`/
`setCurrentAirspeed()`, the `IAS`/`IASRAW`/`VSI`/`VSIRAW` UDP cases, and the
`.run()`, speed/acceleration setup and `ResetGaugesToZero()` entries. Those
four UDP codes are now silently ignored on this board. Statements elsewhere
in this file that mention VSI/IAS describe earlier states of the sketch.

## No-data timeout start

The 30s no-data watchdog timer is armed at the **end of `setup()`**
(`lastMSFSDataMillis = millis()`; `gaugesResetForNoData = false`), not from
reset. It previously started at 0, so after the ~60s boot (OLED init plus
swings) the watchdog was already expired when `loop()` began and reset the
gauges (and blanked the OLEDs) within a fraction of a second - seen in the
bench debug log as "no UDP data for 30s" 0.3s after "Setup Complete".

## On-demand swing commands

Each gauge's boot swing is now its own function (`swingEOP()`, `swingEOT()`,
`swingXOP()`, `swingXOT()`, `swingElectricalLoad()`, `swingFuelLoad()`,
`swingTS()`, `swingRS()`, `swingALT()`), called from `setup()` when its
`SwingXXX` gate is true (boot behaviour and order unchanged) and, **ungated**,
by a UDP **control** packet `C,<COMMAND>:1` (the value is ignored; a
`Swing command: <name>` line goes to the debug stream):

| Command | Swing |
|---|---|
| `SWINGOILP` | Engine Oil Pressure |
| `SWINGOILT` | Engine Oil Temp |
| `SWINGXMSNP` | Transmission Oil Pressure |
| `SWINGXMSNT` | Transmission Oil Temp |
| `SWINGELECTRICALLOAD` | Electrical Load |
| `SWINGFUELLOAD` | Fuel Load |
| `SWINGRPME` | Turbine Speed |
| `SWINGRPMR` | Rotor Speed |
| `SWINGALT` | Altimeter (re-finds the zero sensor) |

The command runs the same code as boot, including the initial
wind-to-the-stop re-home (`setCurrentPosition(0)`), so the needle ends at its
calibrated zero and stays there until the next data packet. Each swing blocks
the main loop (about 5-7s), so other gauges don't move meanwhile. Compiled
but not yet bench-tested via UDP.

**OLED lamp test:** `C,OLEDTEST:1` fills the Baro, Altimeter and Clock OLEDs
solid white (`oledTest(true)`); `C,OLEDTEST:0` redraws their default boot
content (2992 / 0 / 00:00) and resets `iLastAltitudeValue`/
`iLastZuluTimeValue` so live data repaints them. Ignored (with a debug line)
if `oledsInitialised` is false, i.e. the TCA mux wasn't found. Used by the
`BenchTester` app during its Swing ALL sequence.

## Fuel Load / Electrical Load swing change

`swingFuelLoad()` and `swingElectricalLoad()` now use the same homing and
range as the engine / transmission oil swings: wind up to
`FULL4WIRE_HOMING_STEPS` (316), back to `-FULL4WIRE_STEPS` (315 steps past
zero, against the stop), `setCurrentPosition(0)`, then swing to
`FULL4WIRE_STEPS` (315) and return to the zero offset. Before, they used the
X27 range (631/630 steps) and wound up then to `0`. Electrical Load still
returns to `electricalLoadPctToSteps(0) + ElectricalLoadZeroOffset` (its
table's 0% row is 22 steps) rather than the bare offset. Because the range
is halved the two swings should be shorter than the earlier 6.4-6.5s; not yet
re-timed, flashed or bench-tested. Statements elsewhere in this file that
say the loads use the X27 constants describe the earlier behaviour.

## Temperature OLED (mux channel 4)

A fourth OLED, `u8g2_TEMP`, on TCA9548A channel 4 (`TEMP_OLED_Port`; the
breakout's SD4/SC4 pair), same display class and font as the Clock OLED
(`u8g2_font_logisoso32_tf`). `initOLEDs()` starts it and draws `21C`
(`TEMP_DEFAULT_TEXT`) centred. UDP code **`TEMP:<text>`** shows the value as a
string exactly as received (e.g. `TEMP:25C`), handled by `onTempChange()`
(ignored if empty or longer than 8 characters; redrawn only on change and
throttled to 300ms like the Clock) → `updateTemp()`. It is also covered by the
OLED lamp test (`OLEDTEST`), by `BlankAllOleds()` and by the no-data watchdog
(`sLastTempText` is cleared so the next `TEMP` repaints it; the watchdog
blanks it like the other OLEDs). The I2C scan already covers channel 4.
Compiled; not yet flashed or bench-tested. **RAM is now 75% (1,973 bytes
free) and the compiler warns "Low memory available"** - keep an eye on
stability, and avoid adding more `String`-heavy code or OLEDs here.

## Remote reset over UDP

UDP control packet `C,RESET:1` (value ignored) to port 13136 reboots this
board: `RebootBoard()` sends a debug line (`RESET command received - rebooting
in 2s`), waits 100ms, arms the AVR watchdog for 2s (`wdt_enable(WDTO_2S)`) and
spins until it fires, which resets the whole chip. The 2s timeout is
deliberate: the Mega's bootloader may not switch the watchdog off, so a short
timeout could loop. A `.init3` function, `DisableWatchdogAtStartup()`, clears
`MCUSR` and disables the watchdog first thing after every reset (standard
avr-libc pattern), so the sketch never runs with it armed. **Bench-tested on
this board (2026-10-13):** after `C,RESET:1` the debug stream showed the acknowledgement, then "Ethernet Started" 6.7s later and a normal full boot (OLED start-up, all swings, "Setup Complete. 56196mS since reset"), with no reboot loop. If a board ever reboot-loops after a reset
packet, power-cycle it (that clears the watchdog) and reflash.

## Build verification

Compiled with `arduino-cli` (target `arduino:avr:mega:cpu=atmega2560`),
**0 errors**:

| Sketch | Flash | RAM |
|---|---|---|
| `JET_RANGER_OLED_DUAL_STEPPER_CONTROLLER.ino` | 57,156 bytes (22%) | 6,265 bytes (76%) |

Flashed to a Mega on **COM4** (also previously flashed to COM13 - this
board has moved between physical Megas/ports across bench sessions;
confirm which one is actually wired to the panel before trusting either
port number).

## Current stepper roster (deltas only)

| Stepper | Interface/pins | Status |
|---|---|---|
| `FuelLoadStepper` (was `RadarAltStepper`) | FULL4WIRE, `STEPPER_FL_COIL_A..D` (32/33/34/35, wired C,D,A,B — same physical pins the original sketch used for Radar Alt) | Real PSI now via `setFuelLoad()`/`FUEL_LOAD_PSI_TABLE` (`FUELLOAD` code) — 2-point bench-measured table so far (0 PSI→0 steps, 30 PSI→160 steps), linear interpolation between them, clamped (not extrapolated) above 30 PSI until a higher point is measured. `FUELLOADRAW` added as the raw-step bypass, matching every other calibrated gauge. Boot startup swing active (`SwingFUELLOAD` = true) — still sweeps the full `X27_FULLWIRE_STEPS` range for a self-test, not clamped to the calibrated 0-160 range |
| `ElectricalLoadStepper` (was `ETstepper`) | FULL4WIRE, `EL_COIL_A..D` (36/37/38/39 — same physical pins the original sketch used for Torque) | Real percent now via `setElectricalLoad()`/`ELECTRICAL_LOAD_PCT_TABLE` (`ELECTRICALLOAD` code) — 2-point bench-measured table (0%→22 steps, 100%→200 steps; unlike every other table here, 0% is NOT the stepper's raw zero). `ELECTRICALLOADRAW` added as the raw-step bypass. Boot startup swing active, gated by `SwingELECTRICALLOAD` (`true`) — that define existed already but had no matching startup block until now; still sweeps the full `X27_FULLWIRE_STEPS` range for a self-test, not clamped to the calibrated 22-200 range |
| `TSstepper` (`RPME`, Turbine/Engine Speed) | Unchanged pins/interface | Real calibration, but via **this board's own** 4-point `TS_PCT_TABLE` (0/55/100/110% → 0/300/535/600 steps) plus `TSoffset` (20) - diverges from the original sketch's 13-point table (no offset). Startup swing **active** (`SwingRPM` = true) - returns to `TSoffset`, not raw 0, after each loop |
| `RSstepper` (`RPMR`, Rotor Speed) | Unchanged pins/interface | Same divergence - this board's own 4-point `RS_PCT_TABLE`, identical values to this board's `TS_PCT_TABLE`, plus `RSoffset` (0, unmeasured). Startup swing **active** (`SwingRPM` = true) - returns to `RSoffset` after each loop |
| `ALTstepper` (Altimeter) | FULL4WIRE, `STEPPER_ALT_A..D` (40/41/42/43) + `ALTzeroSensePin` (A15) - **revived**, was fully commented out on both this board and the original | Active - DCS-BIOS (`onAltMslFtChange()`, `feet * 0.72`, also drives the Altimeter OLED) AND UDP `ALT`/`ALTRAW` (enabled here only). Startup swing **active** (`SwingALT` = true, `SwingLoops` = 1 → 720-step round trip) - see zero-seek caution below |
| `GPstepper` (`N1`, Gas Producer) | — | **Disabled.** Fully commented out to free pins 40-43 for `ALTstepper` above. `N1`/`N1RAW` UDP cases removed - silent no-op if sent |
| `EOTstepper` (`OILT`, Engine Oil Temp) | Unchanged pins/interface | Real degrees C now via `setEOT()`/`EOT_C_TABLE` (4-point bench-measured table: 0C→0, 50C→79, 100C→156, 150C→231 steps; replaces the old placeholder linear scale it shared with EGT/XOT/XOP/N1/FUEL). Boot startup swing active (`SwingEOT` = true) - uses `FULL4WIRE_STEPS`/`FULL4WIRE_HOMING_STEPS` (315/316), not the X27 constants Fuel Load/Electrical Load/TS/RS use; overshoots the real 231-step calibrated max for a fuller self-test, same as Fuel Load's swing does. Returns to raw 0 (`EOT_C_TABLE`'s 0C row is already 0 steps, no fine-trim offset needed) |
| `EOPstepper` (`OILP`, Engine Oil Pressure) | Unchanged pins/interface | Real PSI now via `setEOP()`/`EOP_PSI_TABLE` (4-point bench-measured table: 0→0, 50→74, 100→148, 150→220 steps; replaces the old placeholder linear scale, reuses the `PsiToStepEntry` struct `FUEL_LOAD_PSI_TABLE` also uses). Boot startup swing active (`SwingEOP` = true) - same `FULL4WIRE_STEPS`/`FULL4WIRE_HOMING_STEPS` range as `EOTstepper` above, overshoots the real 220-step calibrated max for a fuller self-test. Returns to raw 0 |
| `XOTstepper` (`XMSNT`, Transmission Oil Temp) | Unchanged pins/interface | Real degrees C now via `setXOT()`/`XOT_C_TABLE` (4-point bench-measured table: 0C→0, 50C→75, 100C→150, 150C→225 steps; replaces the old placeholder linear scale, reuses the `CToStepEntry` struct `EOT_C_TABLE` also uses). Boot startup swing active (`SwingXOT` = true) - same `FULL4WIRE_STEPS`/`FULL4WIRE_HOMING_STEPS` range as `EOTstepper` above, overshoots the real 225-step calibrated max for a fuller self-test. Returns to raw 0 |
| `XOPstepper` (`XMSNP`, Transmission Oil Pressure) | Unchanged pins/interface | Real PSI now via `setXOP()`/`XOP_PSI_TABLE` (5-point bench-measured table: 0→0, 50→74, 70→104, 100→149, 150→220 steps - one more point than the other `PsiToStepEntry` tables; replaces the old placeholder linear scale, reuses the `PsiToStepEntry` struct `FUEL_LOAD_PSI_TABLE`/`EOP_PSI_TABLE` also use). Boot startup swing active (`SwingXOP` = true) - same `FULL4WIRE_STEPS`/`FULL4WIRE_HOMING_STEPS` range, overshoots the real 220-step calibrated max for a fuller self-test. Returns to raw 0 |

All other steppers (`EOTstepper`,
`XOTstepper`, `XOPstepper`, `EGTstepper`, `FAstepper`, `EOPstepper`,
`SARIstepperRoll`, `saiPitch`) are unchanged from the original sketch —
see its summary for their status.

## UDP codes (deltas only)

| Code | Real value | Board behaviour |
|---|---|---|
| `FUELLOAD` | raw steps | `FuelLoadStepper.moveTo()` directly — no calibration table |
| `ELECTRICALLOAD` | raw steps | `ElectricalLoadStepper.moveTo()` directly — no calibration table |
| `RPME` | %, 0-110 (was 0-117), one decimal place (e.g. `82.4`) | `setTS()` via this board's own `TS_PCT_TABLE` (4 points, not 13); parsed with `toFloat()`, not `toInt()` |
| `RPMR` | %, 0-110 (was 0-117), one decimal place (e.g. `82.4`) | `setRS()` via this board's own `RS_PCT_TABLE` (4 points, not 13); parsed with `toFloat()`, not `toInt()` |
| `ALT` | feet | `onAltMslFtChange()` via `feet * 0.72` (was `5.76`) - **enabled here**, unlike the original sketch (still `5.76`, still commented out). Also updates the Altimeter OLED |
| `ALTRAW` | raw steps | `ALTstepper.moveTo()` directly, bypassing the conversion (and the OLED update) - also enabled here only |
| `ZULU` | HHMM int (e.g. `1430`) | `onZuluTimeChange()` → gate-on-change + 300ms-throttled `updateClock()` on the Clock OLED. No stepper involved, no DCS-BIOS equivalent - FSUIPC-only |

`AGL`/`AGLRAW`, `TQ`, and now `N1`/`N1RAW` no longer exist on this board
(see above - `N1`/`N1RAW` were removed when `GPstepper` was disabled).
`VSI`/`VSIRAW` and `IAS`/`IASRAW` were removed (see above). Every other code (`OILT`/`OILP`/`XMSNT`/
`XMSNP`/`ITT`/`FUEL` and their `*RAW` siblings) is unchanged from the
original sketch. `RPMERAW`/`RPMRRAW` (raw-step bypass) also unchanged.

## Local network configuration

| Setting | Value |
|---|---|
| Static IP | `172.16.1.106` (was `.105` on the original sketch — deliberately different so both boards can be on the network at once) |
| MAC | `A8:61:0A:67:83:6A` (was `...69`) |
| Local port `localport`/`keyboardport` | 7788 |
| Local port `localdebugport` | 7795 (declared, not bound) |
| Local port `MSFSport` | 13136 |
| Local port `aliveport` | 13137 (health keepalive — see below) |

## Remote endpoints this sketch talks to

Same as the original sketch, including the health keepalive added there
this session:

| Target | Port | Purpose |
|---|---|---|
| `172.16.1.10` (reflector host) | 27000 | Debug/log messages via `SendDebug()`, including the boot-time TCA9548A I2C channel scan |
| `172.16.1.110` (`targetIP`) | 7788 / 7789 | `SendIPString()`/`SendLedString()` — declared, no callers |
| `172.16.1.10` (`MSFSIP`) | 7791 | `SendMSFSMessage()` — declared, no callers |
| `reflectorIP` (172.16.1.10, `JetRangerHealthMonitor`'s host) | 13137 | Health keepalive — bare `"DUAL_STEPPER"` string sent every 10s. Deliberately distinct from the original sketch's `"STEPPER"` prefix, so `JetRangerHealthMonitor` (which matches by message prefix only, not sender IP) can tell the two boards apart — see that app's own summary, which has a dedicated "Dual Stepper" indicator for this. |

## Outstanding / not yet done

- No real calibration table for `FUELLOAD` or `ELECTRICALLOAD` — both
  currently raw steps only.
- `RADAR_ALT_COIL_A..D` defines are still present but unused (dead code,
  left behind by the `FuelLoadStepper` pin-define rename). `ET_COIL_A..D`
  was cleanly renamed rather than left orphaned, so no equivalent dead
  code exists for the Electrical Load conversion.
- `TS_PCT_TABLE`/`RS_PCT_TABLE`'s 0-point is assumed, not directly
  measured - not yet confirmed on the bench that RPME/RPMR actually read
  0% at rest rather than clamping to the 55% row.
- `RSoffset` (new fine-trim step offset, see above) is still `0` -
  unmeasured, same as `VSIoffset`'s own unverified-estimate caveat.
  `TSoffset` has since been set to `20`, but it isn't documented
  anywhere whether that came from an actual bench measurement or is
  itself still a placeholder guess.
- `ALTstepper`'s zero-seek move still uses `-STEPS * 2` (-10080 steps,
  `STEPS` = the old `315 * 16` geared-driver constant) - not
  bench-confirmed as intentional, since it's ~14x a single 720-step
  revolution (`Z27_360_FULLWIRE_STEPS`, confirmed as "one full
  1000ft-dial rotation" via the `feet * 0.72` conversion factor). Now
  that `SwingALT` is active, this move runs every boot.
- `N1`/`N1RAW` (Gas Producer) no longer reach any stepper on this board -
  traded away for `ALTstepper`'s pins. `StepperVSITester`'s Raw Step Test
  dropdown still lists `N1RAW` and broadcasts it to both boards; it's now
  a silent no-op on `172.16.1.106`.
- No second/doubled *stepper* gauge added - the "Dual" PCB concept still
  isn't reflected in the stepper roster, only in the OLED subsystem.
- The Baro OLED display is initialised but never updated after boot -
  `buildBAROString()` is defined but never called past `setup()`'s
  one-time `"2992"` default, and `BaroUpdated`/`CurrentDisplay` are set
  but never read anywhere. Nothing (DCS-BIOS callback, UDP code, or
  `loop()` polling) currently feeds it real baro-setting data.
- The Altimeter digit display ignores barometric offset
  (`iAltitudeDelta`) - the line applying it was commented out with a
  "Currnetly ignoring Baro Offset" note, so the digits currently show
  raw MSL altitude rather than a baro-corrected reading.
- OLED I2C wiring hasn't been bench-verified in this repo - the boot-time
  8-channel TCA9548A scan logs found addresses via `SendDebug()`, but
  nothing in this codebase parses that debug output to confirm the mux
  and all three displays (now including the Clock) are actually detected
  and responding.
- Clock OLED (`u8g2_CLOCK`, `ZULU` code): confirmed working on the real
  display (user, 7 November 2026). Not separately checked that
  `FSUIPCWinformsAutoCS`'s `zuluHours`/`zuluMinutes` offsets
  (`0x0238`/`0x0239`) report the expected values in the sim.
- The no-data watchdog (30s, see above) is new and untested on real
  hardware - not yet bench-confirmed that pulling the network cable or
  killing the sim-bridge app actually drives every gauge back to zero
  and blanks all three OLEDs after 30s without side effects (e.g.
  fighting with a startup swing still in progress, or spamming
  `SendDebug()` if `gaugesResetForNoData` somehow fails to latch).

## OLED power (`PWR`, 2026-10-17)

UDP data code `PWR:1` / `PWR:0` (sent first in the bridge's packet) switches all four
OLEDs - Baro, Altimeter, Clock, Temperature - on and off. `PWR:0` calls
`setOledsPower(false)`, which blanks them with `BlankAllOleds()` and sets
`oledsPowered = false`; while it is false `onZuluTimeChange()`, `onTempChange()`,
`buildBAROString()` and the OLED part of `onAltMslFtChange()` draw nothing (the altimeter
stepper still follows `ALT`). `PWR:1` clears every last-drawn cache, including the
altimeter's per-digit ones, redraws the Baro setting and lets the next `ALT` / `ZULU` /
`TEMP` packet repaint the rest. `FSUIPCWinformsAutoCS` sends `PWR:0` while the main bus
voltage is below 24 V. Compiled at 57,540 bytes flash (22%) / 6,323 bytes RAM (77%);
not yet flashed.

## Backlight: UDP brightness and main bus power (2026-10-18)

The backlight on pin 5 (`BACK_LIGHTS`) is now controlled by `applyBacklight()`:

- **Main bus:** the bridge sends `BPWR:1` while the main bus is 20 V or more and `BPWR:0` below that. `BPWR:0` turns the backlight
  off; `BPWR:1` turns it on. Until a `BPWR` packet arrives the backlight is on (the board has no way to know the bus is down).
- **Brightness:** control packet `C,B:<0-15>` (0 off, 15 full, mapped to PWM 0-255, out-of-range values clamped) is remembered.
  If no brightness command has been received the backlight uses the default PWM 65 (`BacklightDefaultPwm`, the old post-setup
  level). Once one has been received, every time power is applied the backlight returns to the **last commanded level**, not the
  default. A command received while the main bus is down is remembered and applied when power returns.
- The backlight still starts at 128 during setup. **No-data watchdog:** when no UDP packet has arrived for 30 s - including after power-up with no PC feed - the watchdog turns the backlight off along with the gauges (`backlightNoData`); the next packet restores it to the commanded (or default) level, provided the main bus is up (`Backlight restored - UDP data resumed`). The DCS-BIOS brightness handlers
  still call `analogWrite()` directly but are never run (`DcsBios::loop()` is commented out).
- Each change is logged (`Brightness <n> -> PWM <pwm>`, `Backlight power on/off`). The bridges (FSUIPCWinformsAutoCS, MSFSWinformsAutoCS)
  send `BPWR` first in the Stepper packet and after `PWR` in the Dual Stepper packet.

Compiled at 58,312 bytes flash (22%) / 6,472 bytes RAM (79%, 1,720 bytes free, the compiler's low-memory warning still applies). The version flashed to COM5 earlier does not have the no-data backlight change; **not yet flashed or bench-tested**.

## Heartbeat voltage (2026-10-25)

The heartbeat now carries the board's 5 V rail after its name, for example `DUAL_STEPPER V5:5.02`: `vccHeartbeatText()` measures the ADC reference (AVcc) against the chip's internal 1.1 V
band-gap (`ADMUX` selection `11110`, `MUX5` 0; `AVcc mV = 1125300 / reading`, about 2 ms every 10 s) and the JetRangerHealthMonitor shows the last reading from each board in its voltage table.
The monitor matches the first word of the heartbeat, so the indicator behaves as before.

## Firmware version

`FIRMWARE_NAME`, `FIRMWARE_VERSION` and `FIRMWARE_BUILD` are defined above `SendDebug()`. The board reports them, with the compile date and time, on the debug stream straight after *Ethernet Started*,
and on `C,VERSION:1`. **Raise `FIRMWARE_BUILD` by one every time this sketch is changed** (and `FIRMWARE_VERSION` for a larger change). Version 1.0, build 1 was added on 1 November 2026; **build 2 (1 November 2026) added the version to the heartbeat**; **build 3 (6 November 2026) added the start-up backlight hold**. The heartbeat to the Health Monitor also carries it as ` FW:1.0.<build>` (for example `SERVO V5:5.02 FW:1.0.2`), which the Health Monitor shows in its voltage table.

## Start-up backlight (6 November 2026)

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

### OLEDs and indicators during the start-up hold (6 November 2026)

While the start-up hold is on the **four OLEDs stay on**: `PWR:0` is remembered (`oledsPowerWanted`) but not acted on, and the no-data timeout does not blank them. When the hold ends `refreshAfterStartupHold()` applies the remembered `PWR` and blanks them if the no-data timeout has fired. The board has no indicator lamps. Build 4 (RAM 80 percent, 1,577 bytes free). Compiled, not yet flashed.

**Build 5 (6 November 2026): the OLEDs now blank with the backlight when the hold ends and no bridge is feeding the board.** Each board's own 30 second no-data timeout counts from the end of *its* start-up, so a board that finished its start-up well before the Stepper controller still had part of that 30 seconds left when the announcement arrived, and its OLEDs lingered until it ran out (about 5 seconds on the Dual Stepper). `refreshAfterStartupHold()` now expires that timeout straight away when no data or input has arrived for more than 2 seconds (`lastMSFSDataMillis` / `lastLocalActivityMillis` / `lastActivityMillis` set to `millis() - timeout`), so the OLEDs blank on the next pass. With a bridge feeding the board nothing changes. The indicator lamps already went out at once (their wanted states are all off without data). Compiled, not yet flashed.

## SSD1306 OLED brightness, C,OLEDB (7 November 2026)

**`C,OLEDB:0-15`** sets the contrast of the four SSD1306 OLEDs (barometer, altitude, clock and temperature) with `u8g2.setContrast()`, mapped 0 to 15 onto 0 to 255 (0 = dimmest, not off; 15 = full contrast). It is separate from the backlight (`C,B`) and from `PWR`, which blanks the OLEDs. Until a command arrives the displays keep the library's default contrast (`oledContrastLevel` -1). `applyOledContrast()` switches the multiplexer to each OLED's channel in turn and is called when the command arrives and after the OLEDs are initialised (a level received before that is applied then). Debug line: `OLED brightness 7`. The BenchTester has an **OLED brightness (0-15)** slider for it. Build 6: compiled at 61,962 bytes flash (24%) and 6,621 bytes RAM (80%, 6 bytes more than build 5, which already gave the compiler's low-memory warning); not flashed or tested on the board yet.

## Start-up backlight level: 100 percent, then 70 percent (7 November 2026)

While the start-up hold is on the backlight is **100 percent** (`STARTUP_BACKLIGHT_PWM` 255), whatever brightness was commanded or is the default, and a `C,B` command received during the hold does not change it. When the hold ends (the Stepper controller's `STARTUPDONE`, or the 180 second failsafe) the commanded level becomes **70 percent** (`AFTER_STARTUP_BACKLIGHT_PWM` 179) and the backlight goes **off**; it comes back at 70 percent when the bridge sends `BPWR:1`, unless a `C,B` command has set another level. This replaces the earlier hold level (the commanded or default level) described above. The setup-time `BrightnessWhileRunningSetup` is now `STARTUP_BACKLIGHT_PWM` (it was 128), and the two DCS-BIOS A-10C lighting callbacks do not write the backlight while the hold is on. Build 7: compiled at 61,998 bytes flash (24%), 6,621 bytes RAM (80%); not flashed or tested on the board yet.
