bnepethomas/bne-arduino-flight-simulator-interfaces/Jet Ranger/Jet Ranger Arduino Sketches/JET_RANGER_UPPER_CONTROLLER/PROGRAM_SUMMARY.md

# JET_RANGER_UPPER_CONTROLLER - Program Summary

> **Retired (31 October 2026).** This sketch (172.16.1.103, the Jet Ranger Upper Controller PCB) was merged into `JET_RANGER_ADF_CONTROLLER`, which now runs on the combined Jet Ranger Upper ADF Controller PCB at 172.16.1.107 and scans the overhead switch matrix (now 9 rows by 8 columns, indexes 0 to 95) and the Upper keypad as well as the ADF panel. This summary describes the old board and is kept for reference; see `JET_RANGER_ADF_CONTROLLER/PROGRAM_SUMMARY.md`.

Arduino Mega 2560 + W5500 Ethernet shield. Scans the large overhead/upper
panel switch matrix (up to 256 inputs, 176 used) plus a small numeric
keypad, and fans the results out two ways: to DCS-BIOS (serial, for DCS
World) and, over UDP, to a separate USB-HID board (`UDP_TO_HID`) that
presents the buttons to Windows/MSFS as joystick buttons and keystrokes.

## Program flow

1. **Setup**
   - Sets status LED pins, resets the W5500 shield, brings up Ethernet on
     the static IP, opens the UDP sockets below, flashes the red LED for 3s
     while the link settles.
   - Configures digital pins 22–37 as outputs (matrix row drivers) and
     38–49 as inputs with pull-ups (matrix column readers).
   - Clears the button-state and debounce arrays, initialises the keypad.
2. **Main loop** (`loop()`)
   - Toggles the status LEDs every 200ms (heartbeat).
   - Sends a `"UPPER_INPUT"` keepalive to the reflector every 10s.
   - `ScanInputs()`: drives each of the 16 rows low in turn (direct
     `PORTA`/`PORTC` register writes) and reads the corresponding column
     inputs (direct `PIND`/`PING`/`PINL` register reads) to build a
     176-button state array, then calls `FindInputChanges()`.
   - `FindInputChanges()`: for each button whose state changed (and is past
     its debounce window), calls `CreateDcsBiosMessage(index, state)` (a
     per-button DCS-BIOS switch mapping — currently a stub with no bodies
     filled in) and `SendButtonToHid(index, state)`, which forwards the
     press/release over UDP to the `UDP_TO_HID` board.
   - `scanMatrix()`: separately scans the small 4x3 numeric keypad; on a
     key press it calls `SendKeyToHid(key, 1)` then, after the key is
     released, `SendKeyToHid(key, 0)` — forwarding to `UDP_TO_HID` as a
     keyboard press/release.

## Remote reset over UDP

UDP control packet `C,RESET:1` (value ignored) to port 13136 reboots this
board with a **software reset**: `RebootBoard()` sends a debug line (`RESET
command received - rebooting`), waits 100ms, disables interrupts, switches off
the peripherals that would survive a jump (external/pin-change interrupts, all
timer interrupts, TWI, SPI, ADC, UARTs) and jumps to the reset vector
(`jmp 0`); `setup()` then runs again and resets the Ethernet module through
`ES1_RESET_PIN`. It does not use the AVR watchdog (used on the Servo, Stepper
and Dual Stepper boards) because that **hung the Radio Controller**: after a
watchdog reset the chip's watchdog restarts at its shortest timeout and the
board's bootloader does not switch it off, so it reset over and over and never
reached the sketch until it was reflashed. A `.init3` function
(`DisableWatchdogAtStartup()`) still clears `MCUSR`/the watchdog first thing
after every reset. This board previously had no receiving socket at all; a new `controlUDP` socket on port 13136 is polled every 20ms by `ServiceControlPackets()` (so the extra W5500 access does not slow the matrix scan) and acts **only** on `C,RESET:1` - every other packet is ignored. Same software reset as the Radio Controller, chosen because the watchdog reset hung that board. Compiled at 16,482 bytes flash (6%) / 2,867 bytes RAM (34%); not yet flashed or bench-tested (the board was not connected).

## Pin usage

| Pin(s) | Function |
|---|---|
| 14 | Green status LED |
| 15 | Red status LED (flashes while Ethernet link comes up) |
| 53 | W5500 Ethernet shield manual reset (`ES1_RESET_PIN`) |
| 22–37 | 16 button-matrix row drivers (direct `PORTA`/`PORTC` writes; up to 176 of 256 possible positions wired) |
| 38–49 | 16 button-matrix column inputs (direct `PIND`/`PING`/`PINL` reads); pins 50–53 reserved for the Ethernet SPI bus so the last 4 "columns" are hard-wired to `1` (unused) |
| A10, A12, A14, A15 | 4x3 numeric keypad rows |
| A9, A11, A13 | 4x3 numeric keypad columns |
| Serial (USB) | DCS-BIOS `DCSBIOS_IRQ_SERIAL` link to the DCS World PC (separate from the Ethernet/UDP path below) |

## Ethernet retransmission timeout

`Ethernet.setRetransmissionTimeout(10)` is called right after `Ethernet.begin()`
(same as the Stepper and Dual Stepper sketches). The W5500's default is 200ms x
8 retries - up to 1600ms blocked inside a UDP send that gets no ARP reply (for
example when the reflector PC or the HID board is off) - so one dead destination could stall
the switch-matrix scan. With 10ms per retry the worst case is about 80ms. Compiled at 16,514 bytes flash (6%);
not yet flashed.

## Local network configuration

| Setting | Value |
|---|---|
| Static IP | `172.16.1.103` |
| MAC | `A8:61:0A:9E:83:03` |
| Local port `localport` | 7788 (bound, source socket for outbound debug packets) |
| Local port `aliveport` | 13137 (bound, used to send keepalives) |

> **Fixed:** this sketch previously hard-coded the same IP (`172.16.1.101`)
> and MAC as `JET_RANGER_RADIO_CONTROLLER`. It has been renumbered to
> `172.16.1.103` / MAC `...83:03`, which is safe because this board never
> listens for MSFS data on the `MSFSport` (unlike Radio/Servo) — nothing on
> the C# side targets its IP directly, so no other project needed updating.

## Remote endpoints this sketch talks to

| Target | Port | Purpose |
|---|---|---|
| `172.16.1.10` (reflector host) | 27000 | Debug/log messages (`SendDebug`) |
| `172.16.1.10` (reflector host) | 13137 | 10s keepalive `"UPPER_INPUT"` |
| `172.16.1.11` (`UDP_TO_HID` board, `hidIP`) | 4210 (`hidPort`) | Button events (`"<idx>,<state>"`) and key events (`"KEY,<key>,<state>"`) |

## C# programs this sketch communicates with

- None directly over IP for the main data path — this board's Ethernet
  traffic is only debug logging and health-monitor keepalives, both to
  `172.16.1.10`.
- **JetRangerHealthMonitor** — listens on UDP **13137** and lights the
  "Upper Input" indicator green on receipt of this sketch's keepalive.
- No C# project in this repository listens on `172.16.1.10:27000` (the
  debug log stream has no in-repo consumer).
- The DCS-BIOS serial link is consumed by whatever DCS-BIOS export/hub
  software runs on the DCS World PC — that bridge isn't a C# project in
  this repository.
- Its actual button/keyboard output is consumed by the **UDP_TO_HID**
  Arduino sketch (not a C# program), at `172.16.1.11:4210`.

## Heartbeat voltage (2026-10-25)

The heartbeat now carries the board's 5 V rail after its name, for example `UPPER_INPUT V5:5.02`: `vccHeartbeatText()` measures the ADC reference (AVcc) against the chip's internal 1.1 V
band-gap (`ADMUX` selection `11110`, `MUX5` 0; `AVcc mV = 1125300 / reading`, about 2 ms every 10 s) and the JetRangerHealthMonitor shows the last reading from each board in its voltage table.
The monitor matches the first word of the heartbeat, so the indicator behaves as before.

## Backlight and no-data timeout (2026-10-25)

The PCB's backlight MOSFET (D5, `BACKLIGHT_PWM`) is now driven (`BACKLIGHT_PIN`, `applyBacklight()`), with the same rules as the Servo, Stepper, Dual Stepper, Radio and ADF boards: `D,BPWR:1/0` from the bridge (assumed 1 until the first arrives), `C,B:0-15` brightness (default PWM 65 until one has been received, then the last commanded level), and a 30 s no-data timeout (`NO_DATA_TIMEOUT_MS`: no data packet, `C,B` or `C,KEEPALIVE`, and no switch or key change, `noteActivity()` called from `SendButtonToHid()` and `SendKeyToHid()`) that puts it out until something arrives. `ServiceControlPackets()` now tokenises the packet: `C,RESET:1` still reboots the board; `C,B`, `C,KEEPALIVE` and `D,BPWR` are new, and every data packet restarts the timeout. The bridges send `D,BPWR:x` to 172.16.1.103 and the BenchTester includes this board in its brightness, backlight power and keep-alive. The brightness pot (A0) is not read. Compiled at 20,696 bytes flash (8%) / 3,110 bytes RAM (37%); **not flashed** (the board was not connected) and not bench-tested. There is still no pause for a missing USB HID board, so each switch change can stall the matrix scan for up to about 80 ms with the HID board unplugged.
