bnepethomas/bne-arduino-flight-simulator-interfaces/Jet Ranger/Jet Ranger Arduino Sketches/UDP_TO_HID/PROGRAM_SUMMARY.md

# UDP_TO_HID — Program Summary

Arduino board with native USB HID support (e.g. Leonardo/Micro-class, using
`Joystick.h`/`Keyboard.h`) + W5500 Ethernet shield. Acts as a network-to-USB
bridge: it receives button/key commands over UDP from
`JET_RANGER_ADF_CONTROLLER` (the combined ADF and Upper board, which took over the old `JET_RANGER_UPPER_CONTROLLER`'s overhead switch matrix and keypad on 31 October 2026), the Servo and the Radio controllers and re-emits them to Windows as four virtual
32-button joysticks (128 buttons total) plus standard keyboard key
presses, so DCS-BIOS/MSFS/DCS World see ordinary USB game controllers and a
keyboard.

## Program flow

1. **Setup**
   - Starts all 4 virtual joysticks and the virtual keyboard (`Joystick.begin()`
     x4, `Keyboard.begin()`).
   - Brings up Ethernet on the static IP, opens the command-listener, log,
     and keepalive UDP sockets, and logs a boot message.
2. **Main loop** (`loop()`)
   - Sends a `"JOYSTICK"` keepalive every 10s.
   - Reads the single local physical button (pin 5) and reflects its state
     onto virtual Joystick 1, button 0.
   - Checks for an incoming UDP command packet; if present, logs the sender
     and payload, then calls `processCommand()`.
   - `processCommand()` recognises two payload formats:
     - `"<idx>,<state>"` — sets button `idx % 32` on virtual joystick
       `idx / 32` (0–31 → Joystick 1, 32–63 → Joystick 2, 64–95 → Joystick 3,
       96–127 → Joystick 4) to pressed/released.
     - `"KEY,<key>,<state>"` — presses/releases a keyboard key. A single
       character is sent as its ASCII value; longer names (e.g. `ENTER`,
       `F5`, `LCTRL`) are mapped to `Keyboard.h` key codes via
       `resolveKeyCode()`.

## Remote reset over UDP

A UDP packet `C,RESET:1` (or plain `RESET`) to port **4210** reboots this board
(`processCommand()` checks for it before the `idx,state` / `KEY,...` formats):
`RebootBoard()` logs `RESET command received - rebooting in 2s`, waits 100ms,
arms the AVR watchdog for 2s and spins until it fires. The Leonardo's Caterina
bootloader starts the sketch straight away after a watchdog reset, and a
`.init3` function (`DisableWatchdogAtStartup()`) clears `MCUSR` and disables the
watchdog first thing after every reset. The USB connection drops while the board
restarts, so Windows briefly loses the four joysticks and the keyboard and then
re-detects them. **Bench-tested (2026-10-13)** from the BenchTester app: the
log showed the acknowledgement, then "Joystick controller booted" about 4s
later, with no reboot loop. Compiled at 21,466 bytes flash (74%) / 1,674 bytes
RAM (65%) for `arduino:avr:leonardo`, flashed on COM8.

## Ethernet retransmission timeout

`Ethernet.setRetransmissionTimeout(10)` is called right after `Ethernet.begin()`
(same as the Stepper and Dual Stepper sketches). The W5500's default is 200ms x
8 retries - up to 1600ms blocked inside a UDP send that gets no ARP reply (for
example when the reflector PC is off) - so one dead destination could stall
button presses and releases. With 10ms per retry the worst case is about 80ms. Compiled at 21,498 bytes flash (74%, Leonardo);
not yet flashed.

## Pin usage

| Pin(s) | Function |
|---|---|
| 5 | Local physical pushbutton → Joystick 1, button 0 |

(This board has no other physical panel wiring of its own — its purpose is
purely to translate network commands into USB HID output.)

## Local network configuration

| Setting | Value |
|---|---|
| Static IP | `172.16.1.11` |
| MAC | `DE:AD:BE:EF:FE:ED` |
| Local port `localPort` | 4210 (listens for button/key commands) |

## Remote endpoints this sketch talks to

| Target | Port | Purpose |
|---|---|---|
| `172.16.1.10` (`logHost`) | 27000 (`logPort`) | Log messages (boot, button/key events, malformed-command warnings) |
| `172.16.1.10` (`logHost`) | 13137 (`aliveport`) | 10s keepalive `"JOYSTICK"` |

## C# programs this sketch communicates with

- None directly — its IP peers in the current fleet are the Arduino boards
  `JET_RANGER_ADF_CONTROLLER` (ADF and Upper panels: matrix indexes 0 to 95,
  ADF switches and knobs 104 to 114, Upper keypad keys), the Servo and the
  Radio controllers (Auto Pilot 64 to 81, Audio 96 to 103, Huey Warning Panel
  switches 115 to 117), which send it button/key commands on port 4210.
- **JetRangerHealthMonitor** — listens on UDP **13137** and lights the
  "JoyStick" indicator green on receipt of this sketch's keepalive.
- No C# project in this repository listens on `172.16.1.10:27000` (the log
  stream has no in-repo consumer).
- Once this board presents its virtual joysticks/keyboard to Windows, any
  DCS-BIOS/DCS World or MSFS control-binding software on that PC can pick
  up the button presses like any other USB game controller — that's an OS
  HID interaction, not an IP one.

## Heartbeat voltage (2026-10-25)

The heartbeat now carries the board's 5 V rail after its name, for example `JOYSTICK V5:5.02`: `vccHeartbeatText()` measures the ADC reference (AVcc) against the chip's internal 1.1 V
band-gap (`ADMUX` selection `11110`, `MUX5` 0; `AVcc mV = 1125300 / reading`, about 2 ms every 10 s) and the JetRangerHealthMonitor shows the last reading from each board in its voltage table.
The monitor matches the first word of the heartbeat, so the indicator behaves as before.

## Firmware version

`FIRMWARE_NAME`, `FIRMWARE_VERSION` and `FIRMWARE_BUILD` are defined above `logMsg()`. The board reports them, with the compile date and time, on the debug stream (its logging port) at the end of start-up,
and on `C,VERSION:1`. **Raise `FIRMWARE_BUILD` by one every time this sketch is changed** (and `FIRMWARE_VERSION` for a larger change). Version 1.0, build 1 was added on 1 November 2026; **build 2 (1 November 2026) added the version to the heartbeat**. The heartbeat to the Health Monitor also carries it as ` FW:1.0.<build>` (for example `JOYSTICK V5:5.02 FW:1.0.2`), which the Health Monitor shows in its voltage table.
