bnepethomas/bne-arduino-flight-simulator-interfaces/Jet Ranger/ C# Code/StepperVSITester/PROGRAM_SUMMARY.md

# StepperVSITester — Program Summary

Standalone WinForms tool that lets an operator scrub or type real-unit values (VSI fpm,
ALT feet, Radar ALT feet, IAS knots, EGT/ITT degrees, RPME/RPMR percent, and 6 more via
compact rows) or raw step counts, jog the Altimeter by a raw step count at a fixed
interval, and send it all straight to the Stepper Controller's UDP handlers
(`172.16.1.105:13136`, running `JET_RANGER_STEPPER_CONTROLLER.ino`) without needing FSUIPC
or a flight sim running. It also reaches the Dual Stepper (`.106`) and the Servo
Controller (`.102`). (The name predates the ALT / Radar ALT / jog / Raw Step Test sections
being added; kept as-is rather than renaming mid-project.)

Built because `FSUIPCWinformsAutoCS` sends the Stepper Controller raw fpm for `VSI` and raw
feet for `ALT` - this tool sends exactly what that board's stepper-specific payload sends
for both fields, so VSI/ALT stepper behaviour can be exercised and tuned in isolation. The
Radar ALT, jog, EGT/IAS/RPME/RPMR/real-value-row, and Raw Step Test sections were added
later for bench-testing features that did not have a real flight-sim data source yet or
had not been calibrated at the time.

> **`AGL` (Radar Alt)** is calibrated feet on `JET_RANGER_STEPPER_CONTROLLER.ino`
> (`AGL_FT_TABLE`, 0-2500 ft); the Radar ALT slider is unit-labelled "ft".
>
> **`FLAPS`/`AOA`/`GFORCE`/`SPDMAX` (still in the Raw Step Test dropdown)** are no-ops on
> the current Stepper board: the steppers those codes used to reach have been removed
> from that sketch entirely.

## Program flow

The VSI/ALT/Radar ALT sections work identically, just with different
ranges/units/UDP codes; `Send()`/`SendManualValue()`/`UpdateValueLabel()`
are shared helpers parameterised by which trackbar/textbox/label/code/
unit to use.

1. **Constructor**: connects `stepperClient` to the Stepper Controller,
   sets all three trackbars/labels/textboxes to `0`.
2. **VSI trackbar (`trkVsi_Scroll`)**: range `-1750..1750` fpm, sends
   `"D,VSI:<value>"` immediately on every scroll, and mirrors the value
   into `txtRawInput`.
3. **VSI "Send" (`butSendRaw_Click`)/Enter key in `txtRawInput`**: parses
   the textbox, checks it's within `trkVsi`'s `Minimum`/`Maximum`
   (`-1750..1750`, read from the control rather than hard-coded), updates
   the trackbar to match, and sends the same way as the trackbar.
4. **VSI "Zero" (`butZero_Click`)**: resets `trkVsi`/`txtRawInput` to `0`
   and sends it — quick way back to level flight without dragging.
5. **ALT trackbar (`trkAlt_Scroll`)**: range `0..20000` ft (no firmware-side
   clamp exists for ALT to match against — `onAltMslFtChange()`'s
   `feet * 5.76` conversion accepts anything — so this is just a
   generously-sized test range, not a hard limit from the hardware),
   sends `"D,ALT:<value>"` to **both** `stepperClient` (`172.16.1.105`)
   and `dualStepperClient` (`172.16.1.106`) immediately on every scroll,
   mirrors into `txtAltInput`. Broadcasts because
   `JET_RANGER_OLED_DUAL_STEPPER_CONTROLLER.ino`'s `ALTstepper` was revived
   and its `"ALT"`/`"ALTRAW"` UDP cases enabled specifically so this
   board could be driven the same way as the single-board sketch
   (previously it was DCS-BIOS-only, unreachable over UDP at all).
6. **ALT "Send" (`butSendAlt_Click`)/Enter key in `txtAltInput`**: same
   pattern as VSI's, validated against `trkAlt`'s `Minimum`/`Maximum`,
   via `SendManualValueBroadcast()` (also broadcast).
7. **ALT "Zero" (`butAltZero_Click`)**: resets `trkAlt`/`txtAltInput` to
   `0` and sends it (also broadcast).
8. **Radar ALT trackbar (`trkRadarAlt_Scroll`)**: range `0..2500` ft,
   matching the board's `RADAR_ALT_FT_TABLE` calibration range exactly
   (values outside it clamp on the board side rather than erroring
   here). Sends `"D,AGL:<value>"` (renamed from `RALT` — see the caution
   above), mirrors into `txtRadarAltInput`.
9. **Radar ALT "Send" (`butSendRadarAlt_Click`)/Enter key/"Zero"
   (`butRadarAltZero_Click`)**: same pattern as ALT's.
10. **ALT Direct Step Jog (`butJogSend_Click`)**: reads a signed
    step count from `txtJogSteps` and a positive interval (ms) from
    `txtJogInterval`, validates both, and calls `SendAltJog()`, which
    packs them as `"D,ASTEP:<steps>/<intervalMs>"` — a single UDP code
    carrying two numbers, since the board's `"D,CODE:value"` packet
    parser only reads one value per code. Enter in either textbox
    triggers the same send. This drives `jogAltimeterSteps()` on the
    board, which bit-bangs the ALT step/dir pins directly at a literal
    fixed interval, bypassing `AccelStepper`'s acceleration ramp — for
    finding exact step timing, not normal use.
11. **EGT/ITT trackbar (`trkEgt_Scroll`) + Send/Zero**: range `0..900` °C,
    sends `"D,ITT:<value>"` (wire code is `ITT`, matching
    `JET_RANGER_SERVO_CONTROLLER.ino`; control/field names in code are
    still `Egt*` — the first gauge in this tool to graduate from the Raw
    Step Test dropdown to a dedicated real-unit control once its
    calibration became known).
12. **IAS trackbar (`trkIas_Scroll`) + Send/Zero**: range `0..140` kt,
    sends `"D,IAS:<value>"`. On the board this goes through a real
    hand-measured `IAS_KT_TABLE` (9 points), not a placeholder scale.
13. **RPME trackbar (`trkRpme_Scroll`) + Send/Zero**: range `0..117` %,
    sends `"D,RPME:<value>.0"` (Turbine/Engine Speed) to **both**
    `stepperClient` (`172.16.1.105`) and `dualStepperClient`
    (`172.16.1.106`) via `SendPercentManualValueBroadcast()` (Send
    button/Enter) or the double-typed `Send()`/`SendDual()` overloads
    directly (trackbar scroll/Zero) - `JET_RANGER_STEPPER_CONTROLLER.ino`
    and `JET_RANGER_OLED_DUAL_STEPPER_CONTROLLER.ino` both drive this gauge
    identically (same `TS_PCT_TABLE`, since Turbine Speed wasn't one of
    the Dual Stepper board's repurposed gauges), so one trackbar drives
    both boards' Turbine Speed steppers together. Graduated here from a
    compact value-box row (see #15 below) once the calibration table
    existed, same as EGT/IAS did earlier. **RPME/RPMR are the only two
    codes in this tool sent with one decimal place** (e.g. `"82.0"`,
    matching `FSUIPCWinformsAutoCS`'s own one-decimal RPMR/RPME wire
    format) - the trackbar itself still only offers whole-percent
    granularity (`TrackBar` has no fractional steps), so this only
    changes what's put on the wire, not what the operator can dial in
    here. Every other code in this tool remains a bare integer via the
    original `long`-typed `Send()`/`SendDual()`/`SendManualValue()`/
    `SendManualValueBroadcast()` (still used unchanged by ALT and
    everything else).
14. **RPMR trackbar (`trkRpmr_Scroll`) + Send/Zero**: range `0..117` %,
    sends `"D,RPMR:<value>.0"` (Rotor Speed) to **both** boards, same
    broadcast pattern and one-decimal wire format as RPME above
    (`RS_PCT_TABLE`, same values as `TS_PCT_TABLE`, unchanged on the
    Dual Stepper board too).
15. **Real-Value Gauges compact rows** (`butSendEot`/`butSendEop`/
    `butSendXot`/`butSendXop`/`butSendGp`/`butSendFa`, each with a matching
    `txt*`/Enter handler): six more gauges with known real-world units but
    no dedicated trackbar (would have made the form impractically tall) —
    `OILT` (°C), `OILP` (PSI), `XMSNT` (°C), `XMSNP` (PSI), `N1` (%), `FUEL`
    (US gal). `N1`/`FUEL` are still on the "uncalibrated linear scale"
    placeholder. `OILT`/`OILP`/`XMSNT`/`XMSNP` all graduated to real
    calibration once `JET_RANGER_OLED_DUAL_STEPPER_CONTROLLER.ino`'s
    `EOT_C_TABLE`/`EOP_PSI_TABLE`/`XOT_C_TABLE`/`XOP_PSI_TABLE` existed,
    and are the only four of these six sent via `SendRealValueBroadcast()`
    (both `stepperClient`/`172.16.1.105` and `dualStepperClient`/
    `172.16.1.106`) rather than `SendRealValue()` (`172.16.1.105` only) —
    `N1`/`FUEL` have no calibration on `172.16.1.106` worth reaching, so
    stay single-board. Each control's C# name is the pre-rename short code
    (`Eot`/`Eop`/etc.) but sends the servo-controller-aligned wire code
    (`OILT`/`OILP`/etc.) — same "control name unchanged, wire code
    renamed" pattern as EGT/IAS/AGL above. (`TS`/`RS` used to be here too,
    as `RPME`/`RPMR` — see #13/#14 above.)
16. **Raw Step Test panel** (`cboNewGauge` dropdown + `txtNewGaugeSteps` +
    `butNewGaugeSend`/`butNewGaugeZero`, renamed from "New Gauges"): one
    shared raw-step control covering two groups of codes - `FLAPS`/`AOA`/
    `GFORCE`/`SPDMAX` (no real calibration at all, and no longer exist on
    the board either - see the caution above), and the distinct `*RAW`
    siblings of every calibrated gauge (`IASRAW`/`ALTRAW`/`VSIRAW`/
    `OILTRAW`/`OILPRAW`/`XMSNTRAW`/`XMSNPRAW`/`ITTRAW`/`RPMERAW`/
    `RPMRRAW`/`N1RAW`/`FUELRAW`/`TQRAW`/`FUELLOADRAW`/
    `ELECTRICALLOADRAW`), letting the operator bypass a gauge's unit
    conversion for bench testing without losing its real-value control.
    `TQRAW` was added once `TQ` (Torque) graduated to real percent (see
    #20 below); `FUELLOADRAW`/`ELECTRICALLOADRAW` were added once #18
    below graduated those two codes to real units. Every send from this
    panel goes to **both** `stepperClient` (`172.16.1.105`) and
    `dualStepperClient` (`172.16.1.106`) -
    `JET_RANGER_OLED_DUAL_STEPPER_CONTROLLER.ino` accepts all of these
    except `AGLRAW`/`TQRAW` (that board's Radar Alt/Torque steppers were
    repurposed - see #18 below), which are silent no-ops on it, same as
    `FLAPS`/`AOA`/`GFORCE`/`SPDMAX` already are on both boards.
    `FUELLOADRAW`/`ELECTRICALLOADRAW` are the mirror image - they only
    exist on `172.16.1.106` (`FuelLoadStepper`/`ElectricalLoadStepper`
    aren't declared on the single-board sketch), so they're silent no-ops
    on `172.16.1.105`. `SelectedNewGaugeCode()` centralises the
    dropdown-selection fallback - now correctly `"AGLRAW"`, matching the
    dropdown's actual first item (it was stale `"TQ"` before, which is
    unreachable in practice since the constructor always sets
    `cboNewGauge.SelectedIndex = 0`, but became a real latent bug once
    `TQ` stopped meaning raw steps).
17. **-1 Step / +1 Step buttons** (`butNewGaugeStepBack_Click`/
    `butNewGaugeStepFwd_Click`): nudge `txtNewGaugeSteps`'s value by ±1
    and resend via the same `SelectedNewGaugeCode()` (also broadcast to
    both boards) - since every code in this panel is an absolute
    `.moveTo()` target on the board (not a relative move), "one step"
    only means one physical step if the stepper actually reached the
    previous target before the next click (`AccelStepper`'s acceleration
    ramp takes a moment).
18. **Dual Stepper Test rows** (`butSendFuelLoad`/`butSendElectricalLoad`,
    each with a matching `txt*`/Enter handler): sends `FUELLOAD` (PSI) and
    `ELECTRICALLOAD` (%) real values **exclusively** to `dualStepperClient`
    (`172.16.1.106:13136`) via `SendDual()`/`SendDualValue()` (renamed from
    `SendDualRawValue()` - the method itself never did any unit conversion,
    only the meaning of the value on the board side changed) - unlike
    #16/#17 and RPME/RPMR above, these two are never sent to
    `172.16.1.105`, since they have no equivalent there. These two codes
    only exist on
    [`JET_RANGER_OLED_DUAL_STEPPER_CONTROLLER.ino`](../../Jet%20Ranger%20Arduino%20Sketches/JET_RANGER_OLED_DUAL_STEPPER_CONTROLLER/PROGRAM_SUMMARY.md)
    (a fork of the production sketch, its own board, its own IP) - that
    sketch repurposed its Radar Alt and Torque steppers as Fuel Load and
    Electrical Load respectively. Both now have a real bench-measured
    calibration table (`FUEL_LOAD_PSI_TABLE`: 0 PSI→0 steps, 30 PSI→160
    steps; `ELECTRICAL_LOAD_PCT_TABLE`: 0%→22 steps, 100%→200 steps) - raw
    steps are still reachable via the `FUELLOADRAW`/`ELECTRICALLOADRAW`
    entries in the Raw Step Test dropdown (#16 above).
19. **Clock row** (`txtClockHour`/`txtClockMinute` + `butSendClock`, each
    with a matching Enter handler on both textboxes): two small textboxes
    (hour 0-23, minute 0-59, each validated separately) combined into the
    HHMM-encoded `ZULU` wire value (e.g. `1430` for 14:30) and sent
    **exclusively** to `dualStepperClient` (`172.16.1.106:13136`) via
    `SendClockValue()`/`SendDual()` - same "exclusive to this board"
    pattern as the Dual Stepper Test rows above (#18), since `ZULU`
    only exists on
    [`JET_RANGER_OLED_DUAL_STEPPER_CONTROLLER.ino`](../../Jet%20Ranger%20Arduino%20Sketches/JET_RANGER_OLED_DUAL_STEPPER_CONTROLLER/PROGRAM_SUMMARY.md)
    (drives its Clock OLED, `u8g2_CLOCK`) - there's no equivalent gauge or
    code on `172.16.1.105`.
20. **Single Stepper (172.16.1.105 only) Test section - TQ row**
    (`butSendTq`/`txtTq`, matching Enter handler): sends `TQ` (Torque, %,
    0-120) via `SendRealValue()` **exclusively** to `stepperClient`
    (`172.16.1.105:13136`) - not broadcast, since `TQ` has no equivalent
    on `172.16.1.106` (that board's Torque stepper was repurposed as
    Electrical Load, see #18 above, and has no `TQ` UDP case at all).
    Graduated from the Raw Step Test panel's raw-only `TQ` entry (#16
    above) once `JET_RANGER_STEPPER_CONTROLLER.ino`'s `TQ_PCT_TABLE`
    existed (`TQRAW` now covers the raw-step case instead). Placed in its
    own new header/row at the bottom of the form (below the Clock row)
    rather than inserted into the compact-rows group near FA/GP (#15
    above), purely to avoid re-numbering every control's Y coordinate
    below it in the Designer file.
21. **Servo Controller (172.16.1.102) Test section - PITCH/BANK rows**
    (`butSendPitch`/`txtPitch`, `butSendBank`/`txtBank`, each with a
    matching Enter handler): the only rows in this tool that talk to a
    third board, `servoClient` (`172.16.1.102`,
    [`JET_RANGER_SERVO_CONTROLLER.ino`](../../Jet%20Ranger%20Arduino%20Sketches/JET_RANGER_SERVO_CONTROLLER/PROGRAM_SUMMARY.md))
    - every other control in this tool targets `stepperClient`/
    `dualStepperClient` only. Sent one-decimal-place via
    `SendServoValue()`/`SendServo()` (parses `double`, formats `"F1"`),
    matching RPME/RPMR's own one-decimal wire format. Real attitude
    degrees now (`PITCH`: -30..30, `BANK`: -90..90), not a raw servo
    position - `JET_RANGER_SERVO_CONTROLLER.ino`'s `"PITCH"`/`"BANK"` UDP
    handlers convert them through its own bench-measured
    `PITCH_DEG_TABLE`/`BANK_DEG_TABLE` (interpolated, then rounded to a
    servo position). This tool still does no conversion of its own - it
    forwards whatever degrees the operator types. `PITCHRAW`/`BANKRAW`
    (`butSendPitchRaw`/`txtPitchRaw`, `butSendBankRaw`/`txtBankRaw`, new)
    are the raw-position bypass siblings, via new
    `SendServoRawValue()`/`SendServoRaw()` (parses `long`, bare integer -
    same `"<CODE>RAW"` pattern every other calibrated gauge in this tool
    has). Placed in their own new header/rows below the `TQ` row (#20
    above), same "append at the bottom" reasoning.
22. **Temperature OLED row** (`lblTemp`/`txtTemp`/`butTempSend`, Enter
    handler `txtTemp_KeyDown`), at the very bottom of the window: sends
    `D,TEMP:<text>` (a string, default `21C`, 1-8 characters) to
    `dualStepperClient` (`172.16.1.106`) only. Shown as-is on the Dual
    Stepper's new Temperature OLED (mux channel 4); no number parsing or
    conversion happens here.

No unit conversion happens in this tool for VSI/ALT/Radar ALT/EGT/IAS/
RPME/RPMR/FUELLOAD/ELECTRICALLOAD — whatever value is shown is sent as-is
(RPME/RPMR get a trailing `.0` appended per the one-decimal wire format
above; every other code here is a bare integer). On the Arduino side
(`JET_RANGER_OLED_DUAL_STEPPER_CONTROLLER.ino`), `VSI`, `AGL` (bench-test
sketch only), `IAS`, `RPME`, `RPMR`, `FUELLOAD`, and `ELECTRICALLOAD` each
go through their own real calibration (`VSI_FPM_TABLE`/`vsiFpmToSteps()`,
`RADAR_ALT_FT_TABLE`/`radarAltFtToSteps()` on the bench-test sketch,
`IAS_KT_TABLE`/`iasKtToSteps()`, `TS_PCT_TABLE`/`tsPctToSteps()`,
`RS_PCT_TABLE`/`rsPctToSteps()`, `FUEL_LOAD_PSI_TABLE`/
`fuelLoadPsiToSteps()`, `ELECTRICAL_LOAD_PCT_TABLE`/
`electricalLoadPctToSteps()`), and a placeholder linear scale for
`ITT`/the 6 remaining compact-row gauges pending real calibration, while
`ALT` needs no such table — `onAltMslFtChange()`'s simple linear
`feet * 5.76` conversion already produces a correct step count directly
from raw feet.

## Local network configuration / IP addresses

None locally bound — this tool only sends, it doesn't listen for anything.

## Remote endpoints this app talks to

| Target | Port | Purpose |
|---|---|---|
| `172.16.1.105` (Stepper Controller, via `stepperClient`) | 13136 | `"D,VSI:<fpm>"`, `"D,ALT:<feet>"`, `"D,AGL:<feet or steps>"`, `"D,ITT:<C>"`, `"D,IAS:<kt>"`, `"D,RPME:<pct>.0"`, `"D,RPMR:<pct>.0"`, `"D,ASTEP:<steps>/<intervalMs>"`, `"D,<OILT\|OILP\|XMSNT\|XMSNP\|N1\|FUEL>:<value>"` (`OILT`/`OILP`/`XMSNT`/`XMSNP` also broadcast to `172.16.1.106`, see below), `"D,TQ:<pct>"` (Torque, exclusive to this board - no `172.16.1.106` equivalent), and `"D,<FLAPS\|AOA\|GFORCE\|SPDMAX\|IASRAW\|ALTRAW\|VSIRAW\|OILTRAW\|OILPRAW\|XMSNTRAW\|XMSNPRAW\|ITTRAW\|RPMERAW\|RPMRRAW\|N1RAW\|FUELRAW\|TQRAW\|FUELLOADRAW\|ELECTRICALLOADRAW>:<steps>"` test packets (`FUELLOADRAW`/`ELECTRICALLOADRAW` are silent no-ops here - see #16 above) |
| `172.16.1.106` (Dual Stepper Controller, via `dualStepperClient`) | 13136 | `"D,FUELLOAD:<psi>"`, `"D,ELECTRICALLOAD:<pct>"`, `"D,ZULU:<HHMM>"` (all exclusive to this board); `"D,ALT:<feet>"`/`"D,RPME:<pct>.0"`/`"D,RPMR:<pct>.0"`/`"D,OILT:<C>"`/`"D,OILP:<psi>"`/`"D,XMSNT:<C>"`/`"D,XMSNP:<psi>"` (broadcast alongside `172.16.1.105` - `RPME`/`RPMR` via `SendPercentManualValueBroadcast()`/the double `Send()`/`SendDual()` overloads, `ALT` via the original `long`-typed `SendManualValueBroadcast()`, `OILT`/`OILP`/`XMSNT`/`XMSNP` via `SendRealValueBroadcast()` now that this board's `EOT_C_TABLE`/`EOP_PSI_TABLE`/`XOT_C_TABLE`/`XOP_PSI_TABLE` give them real calibration; `ALT` works here since this board's `ALTstepper`/`ALT` UDP case were re-enabled specifically for it); and every Raw Step Test panel code (`"D,<FLAPS\|AOA\|GFORCE\|SPDMAX\|IASRAW\|ALTRAW\|VSIRAW\|OILTRAW\|OILPRAW\|XMSNTRAW\|XMSNPRAW\|ITTRAW\|RPMERAW\|RPMRRAW\|N1RAW\|FUELRAW\|TQRAW\|FUELLOADRAW\|ELECTRICALLOADRAW>:<steps>"`, also broadcast alongside `172.16.1.105` - `AGLRAW`/`TQRAW` are no-ops on this board, `ALTRAW` now works, `FUELLOADRAW`/`ELECTRICALLOADRAW` are new and only work here) |
| `172.16.1.102` (Servo Controller, via `servoClient`) | 13136 | `"D,PITCH:<deg>.0"`, `"D,BANK:<deg>.0"` (one-decimal-place real degrees), `"D,PITCHRAW:<pos>"`, `"D,BANKRAW:<pos>"` (bare-integer raw servo position bypass) - exclusive to this board, no other code from this tool reaches `172.16.1.102` |

## Programs this communicates with

- **[JET_RANGER_STEPPER_CONTROLLER](../../Jet%20Ranger%20Arduino%20Sketches/JET_RANGER_STEPPER_CONTROLLER/PROGRAM_SUMMARY.md)**
  (`172.16.1.105:13136`) - the main target. Run this tool *instead of* a bridge
  while testing or tuning, since both would otherwise fight over what drives the steppers.
- **[JET_RANGER_OLED_DUAL_STEPPER_CONTROLLER](../../Jet%20Ranger%20Arduino%20Sketches/JET_RANGER_OLED_DUAL_STEPPER_CONTROLLER/PROGRAM_SUMMARY.md)**
  (`172.16.1.106:13136` — a distinct board/address, not mutually exclusive
  with the two above) — the Dual Stepper Raw Test rows (`FUELLOAD`/
  `ELECTRICALLOAD`) and the Clock row (`ZULU`) talk to this board
  exclusively; the ALT and RPME/RPMR trackbars and the entire Raw Step
  Test panel broadcast to it alongside `172.16.1.105` (this sketch's
  `ALTstepper` was revived and its `ALT`/`ALTRAW` UDP cases enabled
  specifically to receive the ALT trackbar's broadcasts). Only the
  VSI/Radar ALT/EGT/IAS trackbars, the six remaining real-value compact
  rows (`OILT`/`OILP`/`XMSNT`/`XMSNP`/`N1`/`FUEL`), and the ALT jog still
  target `172.16.1.105` only.
- **[JET_RANGER_SERVO_CONTROLLER](../../Jet%20Ranger%20Arduino%20Sketches/JET_RANGER_SERVO_CONTROLLER/PROGRAM_SUMMARY.md)**
  (`172.16.1.102:13136` — a third, distinct board, new) — the PITCH/BANK
  rows talk to this board exclusively; no other control in this tool
  reaches it.
