bnepethomas/bne-arduino-flight-simulator-interfaces/Jet Ranger/Jet Ranger Dodo/dodo_hardware_switch.docx

1) Create a text file in notepad within the 'Flight Simulator X/Modules/' folder alongside the FSUIPC4.dll called 'DodoSim206FSX.evt'

2) Put the following text within the file:

Code Sample

[Events]
1=DODOSIM206FSX.ELECT_FUEL_PUMP1_SET
2=DODOSIM206FSX.ELECT_FUEL_PUMP2_SET
3=DODOSIM206FSX.WARNING_HORN_CB_SET
4=DODOSIM206FSX.NAV_LIGHTS_SET
5=DODOSIM206FSX.DIFFICULTY_LEVEL_SET
6=DODOSIM206FSX.DIFFICULTY_LEVEL_INC
7=DODOSIM206FSX.DIFFICULTY_LEVEL_DEC
8=DODOSIM206FSX.HEAT_VENT_SET
9=DODOSIM206FSX.GENERATOR_FIELD_CB_SET
10=DODOSIM206FSX.GENERATOR_RESET_CB_SET
11=DODOSIM206FSX.DIR_GYRO_SET
12=DODOSIM206FSX.MASTER_BATTERY_SET
13=DODOSIM206FSX.GENERATOR_SWITCH_SET
14=DODOSIM206FSX.ANNUNCIATOR_TEST_SET
15=DODOSIM206FSX.WARNING_MUTE_SET
16=DODOSIM206FSX.TURBINE_OVER_TEMP_TEST_SET
17=DODOSIM206FSX.GPS_DRIVES_NAV1_SET
18=DODOSIM206FSX.FUEL_VALVE_SET
19=DODOSIM206FSX.CAUTION_LIGHT_SWITCH_SET
20=DODOSIM206FSX.ANTI_ICE_SWITCH_SET
21=DODOSIM206FSX.HYDRAULICS_SWITCH_SET
22=DODOSIM206FSX.IDLE_RELEASE_SET
23=DODOSIM206FSX.TAXI_LIGHT_SWITCH_SET
24=DODOSIM206FSX.TAXI_LIGHT_SWITCH_OFF
25=DODOSIM206FSX.TAXI_LIGHT_SWITCH_ON

3) Open the FSUIPC.ini configuration file and look for a section called [Events]. If it isn't there, create one and enter the following data:

Code Sample

[EventFiles]
0=DodoSim206FSX

4) Restart FSX and open the FSUIPC dialog. Press a button to set an event assignment as normal, and look at the event selection list. You'll notice a new set of bindings at the top, preceded by a : character, i.e.:

Code Sample

:DODOSIM206FSX.ELECT_FUEL_PUMP1_SET
:DODOSIM206FSX.ELECT_FUEL_PUMP2_SET
:DODOSIM206FSX.WARNING_HORN_CB_SET
:DODOSIM206FSX.NAV_LIGHTS_SET
..etc..

5) When mapping a button to these functions, they require a parameter value. As a rule, to set a switch off, use parameter 0, to set it on use 1. Multi-position switches, such as the five position difficulty switch use parameters in the range 0-4, etc.

It is probably advisable to use these settings where provided rather than default FS events because they will get trapped first by the Dodo and ensure correct behaviour.
