bnepethomas/bne-arduino-flight-simulator-interfaces/737/737 Startup.odt

737 Startup

Power on Instructor monitor by window

Check Fuel cutoff switches are not turned off

Power on cabin

- Check Breaker ok
- Turn on power switch for displays PC
- Turn on Front and Rear PSUs
- Turn on Dome Light

Power on Projectors – start projectors with remote. Ensure all projectors have started

Power on CDU PC

Power on Primary PC – SIM16 – Windows startup sound should play

Check iPhone able to play through speakers

Start Trueview

- Enable Desktop warping
- Start P3D
- If no sound once started – resolve

Pause until P3D is fully loaded, Mouse to Center of Sim16 view

On CDU PC – bring CDU displays to front using mouse if needed

Start Sim5 Displays and Sim15.

Swap inputs Sim16 to Sim15 using input on monitor. On Sim 15

- Wide Client – connected
- Start SOIC – there should be two entries – stop if not present and resolve
- Start Prosim – usually will have error for upper devices, use step ladder, unplug USB and Power for the USB Hub. Connect power, and then USB, should have passenger chime fire
- start Prosim MCP – MCP should update
- Prosim Splitter – check landing gear green and flaps gauge 0
- TQ – connected

Check controls movement reflect in MCP system and Flaps respond

Fault Finding

No Sound – often after 8 minutes

- Full power down
- Windows Control Panel
- Manage Audio Devices
- Speakers Realtek High Def Audio
- Configure – click on Speakers to test
- Restart Prosim as well as loss of flaps control likely

Single or No devices in SOIC

- Leave SOIC running
- Unplug and plug USB to Gauges on FO side. Do not confuse with Leo Bodnar input card
- Once both devices have appeared shutdown SOIC
- Shutdown wide client
- Restart wide client
- Restart SOIC

Displays missing from MIP

- Unplug individual monitors on Display PC
