bnepethomas/bne-arduino-flight-simulator-interfaces/F16/Petes F16 Pit 2023.odt

Pete’s F16 Pit

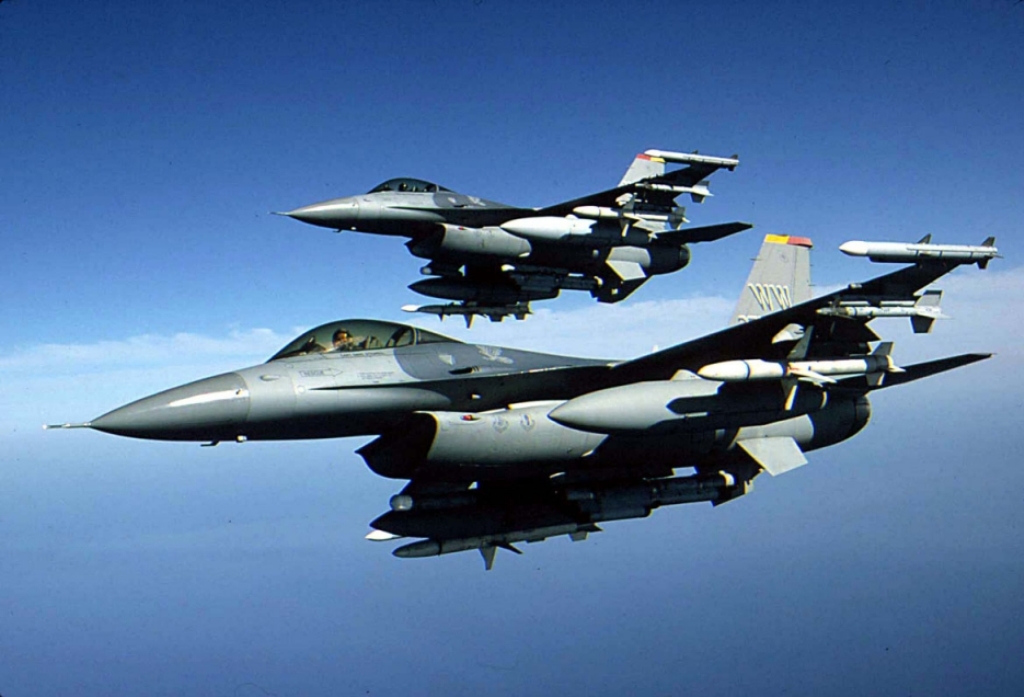
[picture p2: figure]
peter

## Test

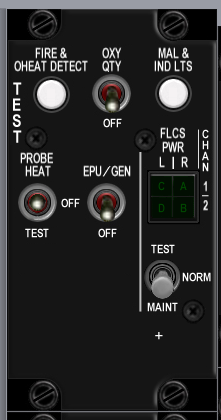
[picture p3: figure]

Build Status
Panel Purchased
Back Panel Purchased
Mounted in Pit
Backlighting | Ordered
Wired
Knobs mounted
Inputs Tested
Outputs Tested
Protective Coat Applied

| Poles | Switch type | Positions
EPU GEN | 2 | toggle | off-on
PROBE HEAT | 3 | toggle | on-off-on
FIRE & OHEAT DETECT | 2 | push | off-(on)
OXY | 2 | toggle | off-on
MAL & IND LTS | 2
A B C D | 0 | indicator light | none
TEST MAINT | 3 | locking toggle | on-off-on

Notes:

Consider hard wiring indicators to on when power is available.

## Anti-G

Build Status
Panel Purchased
Back Panel Purchased
Mounted in Pit
Wired
Knobs mounted
Inputs Tested
Outputs Tested

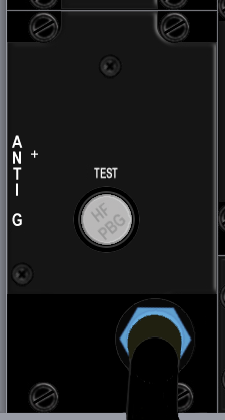
[picture p4: figure]

Switch Name | Poles | Switch type | Positions | Postion names | Notes | Callback
test | 2 | push | off-(on) | Test

## Flt control

Build Status
Panel Purchased
Back Panel Purchased
Mounted in Pit
Wired
Knobs mounted
Inputs Tested
Outputs Tested

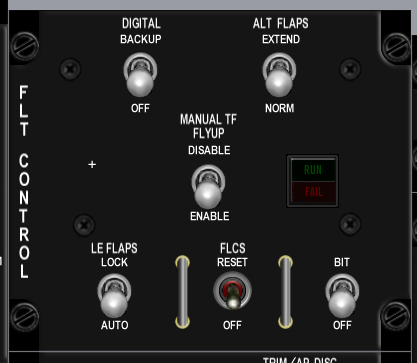
[picture p5: figure]

Switch Name | Poles | Switch type | Positions
DIGITAL | 2 | locking toggle | [off]-[on]
ALT FALPS | 2 | locking toggle | [off]-[on]
MANUAL TF FLYUP | 2 | locking toggle | [off]-[on]
LE FLAPS | 2 | locking toggle | [off]-[on]
FLCS | 2 | momentary toggle | (on)-off
BIT / OFF | 2 | locking toggle | [off]-[on]
RUN FAIL | 0 | indicator light | none

| J4
1 | BKLGT-V
2 | BKLGT+V
3 | +12V LEFT
4 | +28V LEFT
5 | GND LEFT
6 | L_FLT
7 | FLP_EXT
8 | LEF_LCK
9 | 9 OPEN
10 | 10 OPEN

## Manual Trim

Build Status
Panel Purchased
Back Panel Purchased
Mounted in Pit
Wired
Knobs mounted
Inputs Tested
Outputs Tested

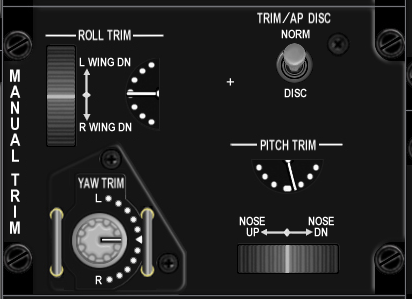
[picture p6: figure]

Switch Name | Poles | Call Back | Pole Totals | Switch type | Positions | Position names | Notes | Callback
| | | 1
Pitch Trim | 1 | 0 | 0 | encoder with center detent | thumbwheel | | light stripe showing position | BMS analog axis or SimTrimNoseUp, SimTrimNoseDown
Roll Trim | 1 | 0 | 0 | encoder with center detent | thumbwheel | | light stripe showing position | BMS analog axis or SimTrimRollLeft, SimTrimRollRight
Yaw Trim | 1 | 0 | 0 | encoder with center detent | thumbwheel | | light stripe showing position | BMS analog axis or SimTrimYawLeft, SimTrimYawRight
Trim /AP DISC | 2 | 1 | 1 | locking toggle | [off]-[on] | norm, disc | | SimTrimAPNORM, SimTrimAPDISC

| J30
1 | BKLGT-V
2 | BKLGT+V
3 | +12V LEFT
4 | +28V LEFT
5 | GND LEFT
6 | ROLL
7 | PITCH
8 | 8 OPEN,
9 | ANA_PWR
10 | ANA_GND
11 | APITCH
12 | AROLL
13 | AYAW
14 | YLEFT
15 | YRGHT
16 | RLEFT
17 | RRIGHT
18 | NSEUP
19 | NSEDWN
20 | AP_DISC

## Fuel

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

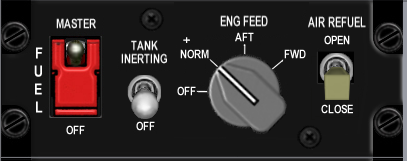
[picture p7: figure]

Switch Name | Poles | Switch type | Positions | Position names | Notes | Callback
MASTER | 2 | guarded toggle | off-on | OFF, MASTER | Guarded in MASTER | SimMasterFuelOff, SimMasterFuelOn
TANK INERTING | 2 | toggle | off-on | OFF-TANK INERTING ??????
ENG FEED | 4 | rotary knob | on-on-on-on | OFF, NORM, AFT, FWD | (4x45 deg) | SimFuelPumpOff, SimFuelPumpNorm, SimFuelPumpAft, SimFuelPumpFwd
AIR REFUEL | 2 | toggle | off-on | CLOSE, OPEN | | SimFuelDoorOpen, SimFuelDoorClose?

| J6
1 | BKLGT-V
2 | BKLGT+V
3 | +12V LEFT
4 | +28V LEFT
5 | GND LEFT
6 | FUEL_ON
7 | PMP_OFF
8 | PMP_NRM
9 | PMP_AFT
10 | PMP_FWD
11 | FUL_DOR
12 | 12 OPEN,
13 | 13 OPEN,
14 | 14 OPEN,
15 | 15 OPEN,
16 | 16 OPEN

## Aux Comm

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

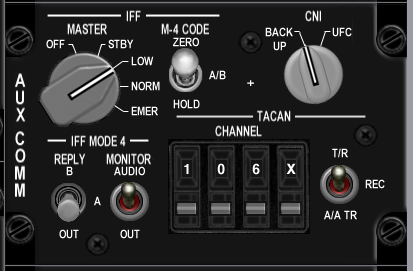
[picture p8: figure]

Switch Name | Poles | Switch type | Positions | Position names | Notes | Callback
MASTER | 5 | Rotary knob | on-on-on-on-on | off, STBY, LOW, NORM, EMER | (5x36 deg) | SimToggleAuxComMaster
M-4 CODE | 3 | locking toggle | [on]-[off]-[on] | hold, a/b, zero
CNI | 2 | Rotary knob | on-off | BACK UP, UFC | (2x36 deg) | SimAuxComBackup, SimAuxComUFC
REPLY | 3 | locking toggle | [off]-[on]-[on] | OUT, A, B
MONITOR | 2 | toggle | off-on | OUT, AUDIO
TACAN | 3 | toggle | on-off-on | A/A TR-REC-T/R | | SimTACANAATR, SimTACANTR
CHANNEL 100's | 10 | encoder | cw/ccw | 0-9 inclusive | | SimCycleLeftAuxComDigit, SimDecLeftAuxComDigit
CHANNEL 10's | 10 | encoder | cw/ccw | 0-9 inclusive | | SimCycleCenterAuxComDigit, SimDecCenterAuxComDigit
CHANNEL 1's | 10 | encoder | cw/ccw | 0-9 inclusive | | SimCycleRightAuxComDigit, SimDecRightAuxComDigit
channel x/y | 2 | encoder | cw/ccw | x, y | | SimCycleBandAuxComDigit

| J7
1 | BKLGT-V
2 | BKLGT+V
3 | +12V LEFT
4 | +28V LEFT
5 | GND LEFT
6 | COM_OFF
7 | COM_STB
8 | COM_LOW
9 | COM_NO
10 | COM_BCK
11 | COM_UFC
12 | TCN_ATR
13 | TCN_NTR
14 | 14 OPEN,
15 | 15 OPEN,
16 | 16 OPEN

| J8
1 | BKLGT-V
2 | BKLGT+V
3 | +12V LEFT
4 | +28V LEFT
5 | GND LEFT
6 | R_GND
7 | INC_LFT
8 | DEC_LFT
9 | INC_CEN
10 | DEC_CEN
11 | INC_RGHT
12 | DEC_RGHT
13 | INC_BND
14 | DEC_BND
15 | 15 OPEN,
16 | 16 OPEN

## Ext Lighting

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

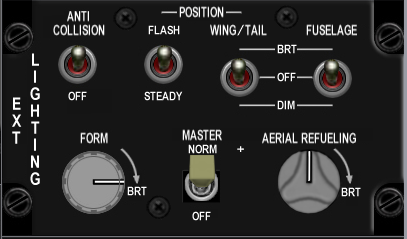
[picture p9: figure]

Switch Name | Poles | Switch type | Positions | Position names | Notes
Form | 0 | potentiometer | increase clockwise
Master | 2 | toggle | [off]-[on] | off, norm | SimExtlMasterOff, SimExtlMasterNorm
Aerial Refueling | 0 | potentiometer | increase clockwise
Anti Collision | 2 | toggle | off-on | off, anti collision | SimAntiCollOff, SimAntiCollOn
Flash Steady | 2 | toggle | on-off | flash, steady | SimLightsFlash, SimLightsSteady
Wing Trail | 3 | toggle | on-off-on | dim, off, brt | SimWingLightOff, SimWingLightBrt
Fuselage | 3 | toggle | on-off-on | dim, off, brt

| J9
1 | BKLGT-V
2 | BKLGT+V
3 | +12V LEFT
4 | +28V LEFT
5 | GND LEFT
6 | EXTM_ON
7 | ACOL_ON
8 | FLSH_ON
9 | WNG_DM
10 | WNG_BRT
11 | P_MSTR
12 | P_DIM
13 | P_CMN
14 | 14 OPEN,
15 | 15 OPEN,
16 | 16 OPEN

## EPU

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

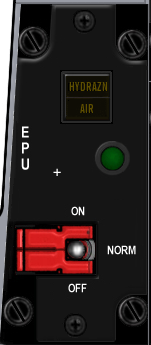
[picture p10: figure]

Switch Name | Poles | Switch type | Positions | Position names | Notes | Callback | Lightbits1 | Lightbits2
EPU | 3 | guarded toggle | off-on-on | OFF-NORMAL-ON | Center guard on NORMAL | SimEpuOff,SimEpuAuto,SimEpuOn
RUN light | 0 | indicator light | none | green light | | | | EPUOn = $100000
HYDRAZN-AIR | 0 | indicator light | none | HYDRAZN-AIR | | | | Hydrazine = $100,Air = $200

| J10
1 | BKLGT-V
2 | BKLGT+V
3 | +12V LEFT
4 | +28V LEFT
5 | GND LEFT
6 | EPU_ON
7 | HYDRA
8 | AIR
9 | EPU_OF
10 | EPU_ON

## Elect

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

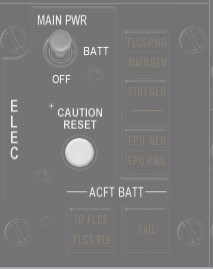
[picture p11: figure]

Switch Name | Poles | Switch type | Positions | Position names | Notes | Callback | Lightbits1 | Lightbits2
MAIN PWR | 3 | Locking toggle | [off]-[on]-[on] | OFF, BAT, MAIN PWR | | SimMainPowerOff,SimMainPowerBatt,SimMainPowerMain
CAUTION RESET | 2 | push | off-(on) | | | SimWarnReset?
FLCS PMG-MAIN GEN | 0 | indicator light | none | FLCS PMG-MAIN GEN | | | | FlcsPmg = $1,MainGen = $2
STBY GEN | 0 | indicator light | none | STBY GEN | | | | StbyGen = $4
EPU GEN-EPU / PMG | 0 | indicator light | none | EPU GEN-EPU / PMG | | | | EpuGen = $8,EpuPmg = $10
FAIL | 0 | indicator light | none | FAIL | | | | BatFail = $80
TO FLCS-FLCS RLY | 0 | indicator light | none | TO FLCS-FLCS RLY | | | | ToFlcs = $20,FlcsRly = $40

| J17
1 | BKLGT-V
2 | BKLGT+V
3 | +12V LEFT
4 | +28V LEFT
5 | GND LEFT
6 | FLCSPMG
7 | MAINGEN
8 | STBYGEN
9 | EPUGEN
10 | EPUPMG
11 | BATFAIL
12 | TOFLCS
13 | FLCSRLY
14 | PWR_OFF
15 | PWRMAIN
16 | WRN_RST

## AVTR

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

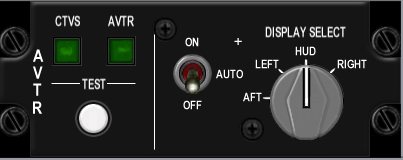
[picture p12: figure]

Switch Name | Poles | Switch type | Positions | Position names | Notes | Callback | Lightbits1 | Lightbits2 | Lightbits3 | HSIbits
AVTR | 3 | toggle | on-off-on | on, auto, off | | SimAVTRSwitchOff, SimAVTRSwitchAuto, SimAVTRSwitchOn
| | | | | (4x45 deg) | | | | | AVTR = $2000

| J16
1 | BKLGT-V
2 | BKLGT+V
3 | +12V LEFT
4 | +28V LEFT
5 | GND LEFT
6 | AVTR
7 | AVT_OFF
8 | AVT_ON
9 | 9 OPEN
10 | 10 OPEN

## ECM

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

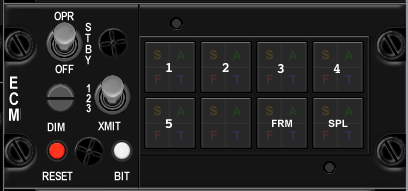
[picture p13: figure]

Switch Name | Poles | Switch type | Positions | Position names
OPR | 3 | toggle | off-on-on | OFF-STBY-OPR
DIM | 3 | rotary | on-on-on | 1, 2, 3
XMIT | 2 | locking toggle | [on]-[off] | xmit, blank
RESET | 2 | toggle | (on)-off | reset, blank
BIT | 2 | toggle | (on)-off | bit, blank
1 | 0 | indicator light | none | S, A, F, T light in corners
2 | 0 | indicator light | none | S, A, F, T light in corners
3 | 0 | indicator light | none | S, A, F, T light in corners
4 | 0 | indicator light | none | S, A, F, T light in corners
5 | 0 | indicator light | none | S, A, F, T light in corners
ALT | 0 | indicator light | none | S, A, F, T light in corners
FRM | 0 | indicator light | none | S, A, F, T light in corners
SPL | 0 | indicator light | none | S, A, F, T light in corners

## Jet Start

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

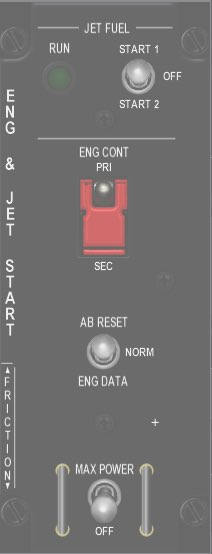
[picture p14: figure]

Switch Name | Poles | Switch type | Positions | Position names | Callback | Notes | Lightbits2
JET FUEL | 3 | locking toggle | [on]-[off]-[on] | START2-OFF-START1 | SimJFSStart | solenoid pulls to center after start ??
ENG CONT | 2 | guarded toggle | off-on | SEC-PRI | | guarded up to PRI
AB RESET | 3 | toggle | (on)-off-(on) | ENG DATA-NORM-AB DATA
MAX POWER | 2 | locking toggle | [off]-(on) | OFF-MAX POWER
RUN | 0 | indicator light | none | green light | | | JFSOn = $200000

| J13
1 | BKLGT-V
2 | BKLGT+V
3 | +12V LEFT
4 | +28V LEFT
5 | GND LEFT
6 | JFS_ON_LGHT
7 | JFS_ON_SOL
8 | JFS_ST
9 | 9 OPEN,
10 | 10 OPEN

## Audio2

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

Switch Name | Poles | Switch type | Positions | Position names | Notes
INTERCOM | 0 | potentiometer | increase clockwise
TACAN | 2 | potentiometer 10k log | [off]-increase clockwise | | rotary pot with off switch
ILS | 2 | potentiometer 10k log | [off]-increase clockwise | | rotary pot with off switch
HOT MIC | 3 | toggle | on-off-on | CIPHER, OFF, HOT MIC

## Audio

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

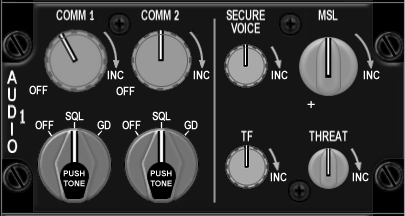
[picture p15: figure]

Switch Name | Poles | Switch type | Positions | Position names | Notes | Callback
COMM 1 volume | 2 | potetiometer | off-increase clockwise | | rotary pot with off switch | BMS analog axis or SimStepComm1VolumeDown, SimStepComm1VolumeUp
COMM 1 selector | 3 | rotary knob | on-on-on | OFF-SQL-GD | PUSH FOR TONE,(3x45 deg)
COMM 2 volume | 2 | potetiometer | off-increase clockwise | | rotary pot with off switch | BMS analog axis or SimStepComm2VolumeDown, SimStepComm2VolumeUp
COMM 2 selector | 3 | rotary knob | on-on-on | OFF-SQL-GD | PUSH FOR TONE,(3x45 deg)
SECURE VOICE | 0 | potetiometer | increase clockwise
TF | 0 | potetiometer | increase clockwise
MSL | 0 | potetiometer | increase clockwise | | | BMS analog axis or SimStepMissileVolumeDown, SimStepMissileVolumeUp
THREAT | 0 | potetiometer | increase clockwise | | | BMS analog axis or SimStepThreatVolumeDown, SimStepThreatVolumeUp

| J31
1 | BKLGT-V
2 | BKLGT+V
3 | +12V LEFT
4 | +28V LEFT
5 | GND LEFT
6 | ANA_PWR
7 | ANA_GND
8 | ACM1_V
9 | ACM2_V
0 | AMSL_V
1 | ATHRT_V
2 | CM1_UP
3 | CM1_DWN
4 | CM2_UP
5 | CM2_DWN
6 | MSL_UP
7 | MSL_DWN
8 | THRT_UP
9 | THRT_DWN
20 | R_GND

## UHF

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

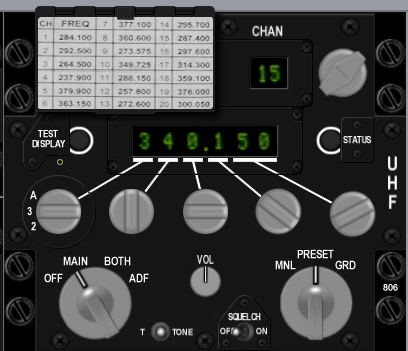
[picture p16: figure]

Switch Name | Poles | Switch type | Positions | Position names | Notes | Callback
UHF | 4 | rotary | on-on-on-on | OFF-MAIN-BOTH-ADF
TONE | 2 | push | off-(on) | tone
VOL | 0 | potentiometer | clockwise to increase
SQUELCH | 2 | toggle | off-on | OFF-ON
MANUAL | 3 | rotary | on-on-on | MANUAL-PRESET-GUARD
Freq 100's | 4 | encoder | cw-ccw | A, 3, 2, T
Freq 10's | 10 | encoder | cw-ccw | 0-9 inclusive
Freq 1's | 10 | encoder | cw-ccw | 0-9 inclusive
Freq 1/10's | 10 | encoder | cw-ccw | 0-9 inclusive
Freq 1/1000's | 4 | encoder | cw-ccw | 00, 25, 50, 75
CHAN | 20 | encoder | cw-ccw | 1-19 inclusive | | SimCycleRadioChannel, SimDecRadioChannel
EMB | 2 | push | off-(on) | ??

## Manual Pitch

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

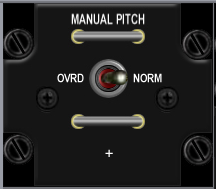
[picture p17: figure]

Switch Name | Poles | Switch type | Positions | Position names | Notes | Callback
MANUAL PITCH | 2 | toggle | off-on | OVRD-NORM | Horizontal wire guard loops above and below toggle | SimMPO

| J3
1 | BKLGT-V
2 | BKLGT+V
3 | +12V LEFT
4 | +28V LEFT,
5 | GND LEFT
6 | MPTCHO NET49_1,
7 | 7 OPEN,
8 | 8 OPEN,
9 | 9 OPEN,
10 | 10 OPEN

## Threat Warn Aux

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

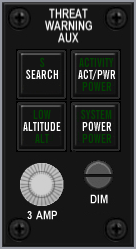
[picture p18: figure]

Switch Name | Poles | Switch type | Positions | Position names | Notes | Callback | Lightbits1 | Lightbits2
Search | 2 | on/off lighted push | off-on | search | | SimRWRSetSearch | | AuxSrch = $1000
activity power | 2 | on/off lighted push | off-on | activity power | | | | AuxAct = $2000
Low priority | 2 | on/off lighted push | off-on | low | | SimRWRSetGroundPriority? | | AuxLow = $4000
system power | 2 | on/off lighted push | off-on | power | | SimRwrPower | | AuxPwr = $8000
fuse | 0 | fuse holder | none | n/a
Dimmer | 0 | potentiometer | rotary | n/a | no EPIC connection

| J22
1 | BKLGT-V
2 | BKLGT+V
3 | +12V LEFT
4 | +28V LEFT
5 | GND LEFT
6 | AXSCH
7 | AXACT
8 | AXLOW
9 | AXPWR
10 | R_SRCH
11 | R_GND
12 | R_PWR
13 | 13 OPEN,
14 | 14 OPEN,
15 | 15 OPEN,
16 | 16 OPEN

## CMDS

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

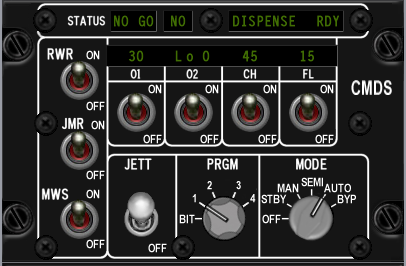
[picture p19: figure]

Switch Name | Poles | Switch type | Positions | Position names | Notes | Callback
RWR | 2 | toggle | off-on | off, on | | SimEWSRWROn, SimEWSRWROff
JMR | 2 | toggle | off-on | off, on | | SimEWSJammerOn, SimEWSJammerOff
MWS | 2 | toggle | off-on | off, on
01 | 2 | toggle | off-on | off, on
02 | 2 | toggle | off-on | off, on
CH | 2 | toggle | off-on | off, on | | SimEWSChaffOff, SimEWSChaffOn
FL | 2 | toggle | off-on | off, on | | SimEWSFlareOff, SimEWSFlareOn
JETT | 2 | locking toggle | off-on | off, JETT
PRGM | 5 | rotary | on-on-on-on-on | bit, 1, 2, 3, 4, 5 | (5x36 deg) | SimEWSProgOne, SimEWSProgTwo, SimEWSProgThree, SimEWSProgFour
MODE | 6 | rotary | on-on-on-on-on-on | off, stby, man, semi, auto, byp | (6x30 deg) | SimEWSModeOff, SimEWSModeStby, SimEWSModeMan, SimEWSModeSemi, SimEWSModeAuto,
STATUS NO GO | 0 | green indicator light | n/a | NO GO (green lit legend)
STATUS GO | 0 | green indicator light | n/a | GO (green lit legend)
STATUS READY | 0 | green indicator light | n/a | READY TO DISPENSE (green lit legend)

| J21
1 | BKLGT-V
2 | BKLGT+V
3 | +12V LEFT
4 | +28V LEFT
5 | GND LEFT
6 | GO NET5_2,
7 | NO_GO
8 | RDY_DISP
9 | CHAFF_LO
10 | FLARE_LO

| J23
1 | BKLGT-V
2 | BKLGT+V
3 | +12V LEFT
4 | +28V LEFT
5 | GND LEFT
6 | RWR_ON
7 | JMR_ON
8 | CHF_ON
9 | FLR_ON
10 | PRG_BIT
11 | PRG_1
12 | PRG_2
13 | PRG_3
14 | PRG_4
15 | MDEOFF
16 | MDESTBY
17 | MDEMAN
18 | MDESEMI
19 | MDEAUTO
20 | MDEBYP

## Gear Panel

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

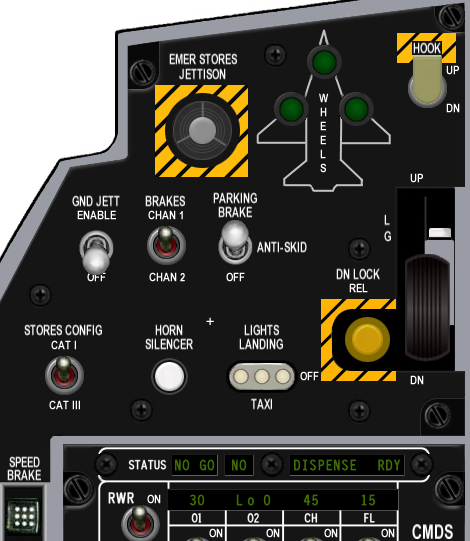
[picture p20: figure]

Switch Name | Poles | Switch type | Positions | Position names | Notes | Callback | Lightbits1 | Lightbits2 | Lightbits3
Emergency jettison | 2 | guarded push | off-(on) | n/a | breakable cover over | SimEmergencyJettison
wheel lights | 0 | 3 x green lights | none | n/a | | | | | NoseGearDown = $10000,LeftGearDown = $20000,RightGearDown = $40000
Hook | 2 | lever locking toggle | [off]-[on] | dn, up | | SimHookUp,SimHookDown
Ground jettison | 2 | locking toggle | [off]-[on] | off, enable | | SimGndJettOn, SimGndJettOff
Brakes | 2 | toggle | off-on | chan 2, chan 1
Parking brake | 3 | locking toggle | [off]-[on]-[on] | off, anti skid, brake | | SimParkingBrakeOff, ,SimParkingBrakeOn
Stores | 2 | toggle | off-on | cat III, cat I | | SimCATIII,SimCATI
Horn silencer | 2 | push | off-(on) | n/a | | SimSilenceHorn
Landing lights | 3 | locking t handle toggle | [on]-[off]-[on] | taxi, off, landing | | SimLandingLightOn, SimLandingLightOff
Down lock release | 2 | push | off-(on) | n/a
Gear down enable | 2 | push | off-(on) | n/a | mounted on the arm of the gear handle
Gear handle | 2 | lollipop lever | off-on | (down and up) | | AFGeapUp, AFGearDown
Gear warning light | 0 | yellow light | none | n/a | mounted in lollipop end of the gear handle | | | GEARHANDLE = $40000000

| J29
1 | BKLGT-V
2 | BKLGT+V
3 | +12V LEFT
4 | +28V LEFT
5 | GND LEFT
6 | N_GEAR
7 | L_GEAR
8 | R_GEAR
9 | G_HNDLE
10 | PK_SOLND
11 | HOOK
12 | GNDJETT
13 | PARKBRK
14 | EMG_JET
15 | CAT_III
16 | L_TAXI
17 | L_LAND
18 | L_GEAR
19 | HRN_SIL
20 | 20 OPEN

## MISC

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

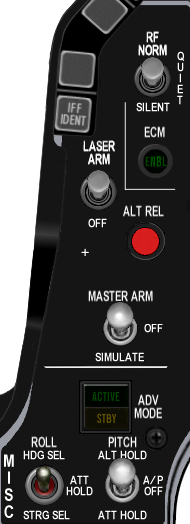
[picture p21: figure]

Switch Name | Poles | Switch type | Positions | Position names | Notes | Callback | Lightbits1 | Lightbits2
RF quiet | 3 | locking toggle | [on[-[off]-[on] | silent, rf norm | | SimRFNorm, SimRFQuiet, SimRFSilent
ECM light | 0 | green light | none | n/a | | | | EcmPwr = $10000?
Laser arm | 2 | locking toggle | [off]-[on] | off, arm | | SimLaserArmOn, SimLaserArmOff
Alternate release | 2 | push | off-(on) | n/a | | SimPickle
Master arm | 3 | locking toggle | [on]-[off]-[on] | simulate, off, arm | | SimSimMasterArm, SimSafeMasterArm, SimArmMasterArm
ADV mode | 0 | indicator light tile | none | active/standby
Autopilot pitch | 3 | locking toggle | [on]-[off]-[on] | att hold, a-p off, alt hold | | SimRightAPDown, SimRightAPMid, SimRightAPUp
Autopilot roll | 3 | toggle | on-off-on | strg sel, att hold, hdg sel | | SimLeftAPDown, SimLeftAPMid, SimLeftAPUp

| J17
1 | BKLGT-V
2 | BKLGT+V
3 | +12V
4 | +28V
5 | GND ,
6 | ECM_PWR
7 | AP_ON
8 | TFR_STDBY
9 | ECM_PWR
0 | TFR_ENGAGED
1 | RF_NRM
2 | RF_SILNT
3 | LSR_ON
4 | S_PICKLE
5 | MST_ARM
6 | MST_SIM
7 | RAP_DWN
8 | RAP_UP
9 | LAP_DWN
10 | LAP_UP

## Threat Warn Prim

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

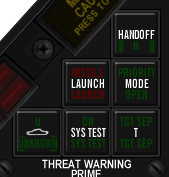
[picture p22: figure]

Switch Name | Poles | Switch type | Positions | Notes | Callback | Lightbits1 | Lightbits2
Handoff | 2 | push | off-(on) | Green illumination on push to select handoff mode | SimRWRHandoff | | HandOff = $1
Priority | 2 | push | off-(on) | Green illumination on push to select priority threat mode | SimRWRSetPriority | | PriMode = $4
Target separate | 2 | push | off-(on) | Green illumination on push to separate target symbols | SimRWRSetTargetSep | | TgtSep = $20
Missile Launch | 0 | indicator light tile | none | Red light | | | Launch = $2
system test | 2 | push | off-(on) | Green light on push
Unknown/naval | 2 | push | off-(on) | Green light on push | SimRWRSetNaval, SimRWRSetUnknowns | | Naval = $8,Unk = $10

| 19
1 | BKLGT-V
2 | BKLGT+V
3 | +12V
4 | +28V
5 | GND ,
6 | HANDOFF
7 | PRIMODE
8 | TGTSEP
9 | LAUNCH
10 | NAVAL
11 | UKNOWN
12 | RHANDOFF
13 | RSETPRI
14 | RSETTGT
15 | RSETNVL
16 | RSETUN

## Eyebrow Lights L

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

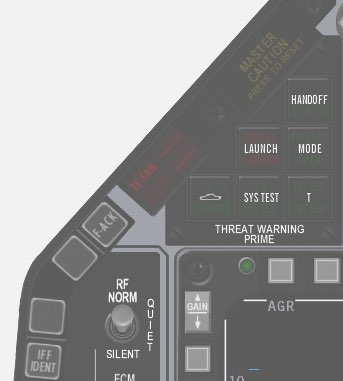
[picture p23: figure]

Switch Name | Poles | Switch type | Positions | Position names | Notes | Callback | Lightbits1
Left
IFF | 2 | push | off-(on) | IFF IDENT
Blank 1 | 2 | push | off-(on) | (directly above IFF button)
Blank 2 | 2 | push | off-(on) | (directly below TF-FAIL button)
TF fail | 0 | red indicator light | none | TF-FAIL | Red illumination, normally off | | TF = $2
F-ACK | 2 | push | off-(on) | F-ACK | | SimICPFAck
Master Caution | 2 | push | off-(on) | Master Caution push to reset | | ExtinguishMasterCaution | MasterCaution = $1

| J16
1 | BKLGT-V
2 | BKLGT+V
3 | +12V
4 | +28V
5 | GND ,
6 | TFF
7 | M_CAUT
8 | F_ACK
9 | EXT_CTN
10 | 10 OPEN
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
