bnepethomas/bne-arduino-flight-simulator-interfaces/Jet Ranger/Jet Ranger Diagramsv1c.pptx

Dodosim
fsxexportipc

SOIC-SERVER

SOIC-CONV

TCP

fFSX

UDP

FSX Extractor

UDP

Arduino-cli-sender

COM4

ardunio

## Slide 2

Spot/Flood Light

Intercom

Back white light

28V inverter

Light
Select

AUD Switch

Dimmer

Mid white light

7805

Mid Red light

12V Power Supply

Center 12V
Dist

GPS

Cockpit Light Switch

Headset Lights

Center Back-Light
Dist

OC USB
Outputs

Front Panel

Panel Lights

## Slide 3

Flight
Controls

Cambridge Speakers

PC

SB USB

Bodnar
Joystick

Output
Select

Top Back Speakers

USB HUB

ArduinoJoystick

USB Serial

Arduino
I2c

GPS

OC USB
Outputs

Intercom

## Slide 4

Jaycar Keypad
3+2 | 1+2 | 5+2
1 | 2 | 3
3+7 | 1+7 | 5+7
4 | 5 | 6
3+6 | 1+6 | 5+6
7 | 8 | 9
3+4 | 1+4 | 5+4
* | 0 | #

## Slide 5

OLED ARDUINO LAYOUT

OLED PORTS
1 | COM 1&2
2 | NAV 1&2
3 | DME
4 | AUTOPILOT
5 | IDENT

6

4

5

3

2

1
