bnepethomas/bne-arduino-flight-simulator-interfaces/Jet Ranger/Petes Platform 003b.docx

# Input Electronics

Gammatron with 64 expansion port.

Due to the large number of inputs (150+) that the Gammatron provides PPJoy is needed to virtualise the Gammatron. If this is not done then FSUIPC and other DX games won’t recognise the higher numbered inputs.

Need both ppjoy and joymapper.

PPJoy from Deon van der Westhuysen

Currently have the 64bit enabled version 8.4.5

http://rs118cg.rapidshare.com/files/303690305/164291/PPJoySetup-0.8.4.5-early-release.exe

JoyMapper from lightning JoyMapper_v0_4_1_0__x86_Setup.zip

https://brightshadow.assembla.com/wiki/show/lightningstools

# Integrating Dodo in to the pit

Struggled with getting Dodo to match up with FSUIPC command options available. The commands match up well with Key Commands available, but what this does me, that if the PC is rebuilt the commands will have to be manually re-entered as opposed to simply copying a FSUIPC file.

Current thought is assign unused stroked to the commands and then have FSUIPC match Joystick inputs and send keystrokes as required. Unfortunately it looks like a number of the actions are toggle only, so switches will need to be correctly positioned before launching Dodo. Because of this it is best to make the commands aircraft specific, and probably unique to the platform.

Function FSX Key Binding

Switch | Start-up Position | Recommended Function | Used Function (1st parameter to top
Engine Starter | | Button Starter 1 (on/off) | Toggle starter 1 (repeat)
Idle Release Latch | | Smoke system (on/off) | Toggle smoke system
Aft Fuel Pump Circuit Breaker | Out | Concorde nose visor (increase angle) | Increase concorde node visor
Fore fuel Pump Circuit Breaker | Out | Concorde nose visor (decrease angle) | Decrease concorde nose visor
Master Battery | Off | Master battery (on/off) | Offset Byte x281C 0/1
Generator Switch | Off | Generator/Alternator (on/off) | Toggle Master Alternator
Generator Field Circuit Breaker | In | APU/Generator (toggle) | APU generator switch toggle
Generator Reset Circuit Breaker | In | APU (off)
Avionics Switch | Off | Avionics (on/off) | Offset setbyte x2E80 1/0
Anti-Collision Lights | Off | Switch Strobe Lights (on/off) | Strobes On/Off
Position Lights Switch | Off | APU Start | Offset setbit x0D0C 1, clearbit 1
Instrument Lights Switch | N/A | Panel lights (on/off)
Pitot Heat Switch | Off | Pitot heat (on/off) | Offset setbyte x029C 1/0
Fuel Valve | Up | Engine 1 fuel valves (open/close) | Offset setbyte x3590 1/0
Hydraulics Switch | Down | Concorde nose & visor (retract) | Decrease concorde nose visor fully
Caution Lights Bright/Dim | | Concorde nose & visor (extend)
Anti-Ice Switch | Off | Carb heat/eng anti-ice (on/off) | Offset setbyte x08B2 1/0
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
