bnepethomas/bne-arduino-flight-simulator-interfaces/Jet Ranger/Jet Ranger Documentation/DocBuild/diagrams/png/system_overview.png

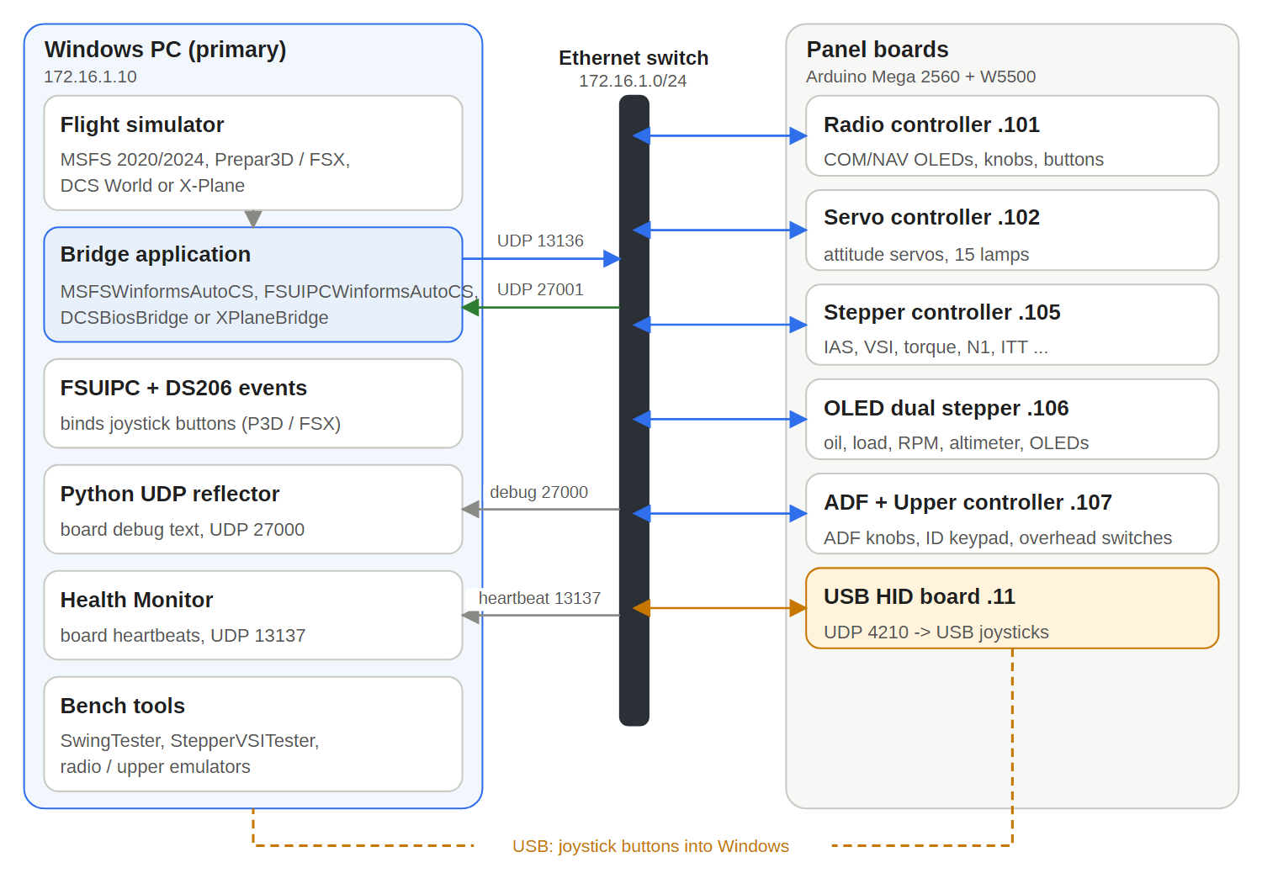
Jet Ranger/Jet Ranger Documentation/DocBuild/diagrams/png/system_overview.png
