bnepethomas/bne-arduino-flight-simulator-interfaces/Jet Ranger/PCBs/Hornet_Dual_Gauge/JLCPCB/production_files/BOM_TOP-GAUGE_Dual Needle Instruments.csv

Comment | Designator | Footprint | LCSC
WS2812B-2020 | D1,D10,D11,D12,D13,D14,D15,D16,D17,D18,D19,D2,D20,D21,D22,D23,D24,D25,D26,D27,D28,D29,D3,D30,D31,D32,D33,D34,D35,D36,D37,D38,D39,D4,D40,D41,D42,D5,D6,D7,D8,D9 | WS2812-2020 | C965555
X40_8798 | M1 | x40_8798
