bnepethomas/bne-arduino-flight-simulator-interfaces/Hornet/Hornet PCBs/Active/OZ-WING_FOLD/production/bom.csv

Designator | Footprint | Quantity | Value | LCSC Part #
D1, D2, D4, D5, D7, D8 | LED_D3.0mm_FlatTop | 6 | LED
D10, D3, D6, D9 | 0805 | 4 | D
D12 | JST_XH_B2B-XH-A_1x02_P2.50mm_Vertical | 1 | HOOK LED 1
J2 | IDC-Header_2x05_P2.54mm_Vertical | 1 | Conn_02x05_Top_Bottom
R1, R2, R3 | 0805 | 3 | R
SW1 | JST_XH_B2B-XH-A_1x02_P2.50mm_Vertical | 1 | HOOK
SW2 | JST_XH_B2B-XH-A_1x02_P2.50mm_Vertical | 1 | WF FOLD
SW3 | JST_XH_B2B-XH-A_1x02_P2.50mm_Vertical | 1 | WF PULL
SW4 | JST_XH_B2B-XH-A_1x02_P2.50mm_Vertical | 1 | WF UNFOLD
