bnepethomas/bne-arduino-flight-simulator-interfaces/Hornet/Hornet PCBs/Active/AV COOL PANEL/Power DB/production/bom.csv

Designator | Footprint | Quantity | Value | LCSC Part #
D1, D2 | 0805 | 2 | LED
J1, J10 | Molex_Mini-Fit_Jr_5566-04A_2x02_P4.20mm_Vertical | 2 | Mini-Fit Jr. 2x02 | C293502
J11, J12, J13, J14, J2, J3, J4, J5, J6, J7, J8, J9 | BarrelJack_Horizontal | 12 | Conn_01x02_Socket
R1, R2 | 0805 | 2 | R
