bnepethomas/bne-arduino-flight-simulator-interfaces/Hornet/Hornet PCBs/Active/Left Console/ANT SEL/production/bom.csv

Designator | Footprint | Quantity | Value | LCSC Part #
D10, D3, D4, D6, D7, D9 | LED_D3.0mm_FlatTop | 6 | LED
D5, D8 | D_DO-35_SOD27_P7.62mm_Horizontal | 2 | D
J1 | IDC-Header_2x05_P2.54mm_Vertical | 1 | Conn_02x05_Top_Bottom
R2, R3 | R_Axial_DIN0204_L3.6mm_D1.6mm_P7.62mm_Horizontal | 2 | R
SW3 | Molex_KK-254_AE-6410-03A_1x03_P2.54mm_Vertical | 1 | COMM 1
SW4 | Molex_KK-254_AE-6410-03A_1x03_P2.54mm_Vertical | 1 | IFF
