bnepethomas/bne-arduino-flight-simulator-interfaces/Hornet/Hornet PCBs/Active/Left Console/OBOGS/production/bom.csv

Designator | Footprint | Quantity | Value | LCSC Part #
D10, D9 | D_A-405_P7.62mm_Horizontal-SIGNAL | 2 | D
D3, D4, D5, D6, D7, D8 | LED_D3.0mm_FlatTop | 6 | LED
J1 | JST_XH_B3B-XH-A_1x03_P2.50mm_Vertical | 1 | OBOGS OXY FLOW
J2 | IDC-Header_2x05_P2.54mm_Vertical | 1 | Conn_02x05_Top_Bottom
R1, R2 | R_Axial_DIN0204_L3.6mm_D1.6mm_P7.62mm_Horizontal | 2 | R
SW3 | JST_XH_B2B-XH-A_1x02_P2.50mm_Vertical | 1 | OBOGS_SW
SW4 | JST_XH_B2B-XH-A_1x02_P2.50mm_Vertical | 1 | OBOGS_FLOW
