bnepethomas/bne-arduino-flight-simulator-interfaces/Hornet/Hornet PCBs/Active/Left Console/COMPASS/compass-STEPPER/production/bom.csv

Designator | Footprint | Quantity | Value | LCSC Part #
J2 | PinHeader_2x02_P2.54mm_Vertical | 1 | Conn_02x02_Odd_Even
M1 | X27-168 | 1 | X27 168
