bnepethomas/bne-arduino-flight-simulator-interfaces/Hornet/Hornet PCBs/Active/Left Console/FIRE/JLCPCB/production_files/BOM-HYD ISO PANEL.csv

Comment | Designator | Footprint | LCSC
0.1uF | C10,C11,C12,C13,C14,C2,C3,C4,C5,C6,C7,C8,C9 | C_0603_1608Metric | C14663
470 | R1 | R_0603_1608Metric | C23179
WS2812B | D10,D11,D12,D13,D14,D15,D16,D17,D18,D19,D2,D20,D21,D22,D23,D24,D25,D3,D4,D5,D6,D7,D8,D9 | LED_WS2812B_PLCC4_5.0x5.0mm_P3.2mm | C2761795
Mini-Fit Jr. 2x02 | J1,J2 | Molex_Mini-Fit_Jr_5566-04A_2x02_P4.20mm_Vertical | C293502
1000uF | C1 | CP_Elec_8x10 | C445083
Green | D1 | LED_D3.0mm
