bnepethomas/bne-arduino-flight-simulator-interfaces/F16 Documentation/F16_Switch_Led_Mappings.ods

Sheet: test front
 | 0 | 1 | 2 | 3 | 4 | 5 | 6 | 7 | 8 | 9 | 10 | Analog Inputs
0 | 0 | 1 | 2 | 3 | 4 | 5 | 6 | 7 | 8 | 9 | 10
1 | 11 | 12 | 13 | 14 | 15 | 16 | 17 | 18 | 19 | 20 | 21 | UFC Connected to A7-11
2 | 22 | 23 | 24 | 25 | 26 | 27 | 28 | 29 | 30 | 31 | 32 | 7
3 | 33 | 34 | 35 | 36 | 37 | 38 | 39 | 40 | 41 | 42 | 43 | 8 | Com1 Vol
4 | 44 | 45 | 46 | 47 | 48 | 49 | 50 | 51 | 52 | 53 | 54 | 9 | Com2 Vol (J9)
5 | 55 | 56 | 57 | 58 | 59 | 60 | 61 | 62 | 63 | 64 | 65 | 10 | Brightness (J10)
6 | 66 | 67 | 68 | 69 | 70 | 71 | 72 | 73 | 74 | 75 | 76 | 11
7 | 77 | 78 | 79 | 80 | 81 | 82 | 83 | 84 | 85 | 86 | 87
8 | 88 | 89 | 90 | 91 | 92 | 93 | 94 | 95 | 96 | 97 | 98 | Left DDI * 2
9 | 99 | 100 | 101 | 102 | 103 | 104 | 105 | 106 | 107 | 108 | 109 | Right DDI * 2
10 | 110 | 111 | 112 | 113 | 114 | 115 | 116 | 117 | 118 | 119 | 120 | Spin * 1
11 | 121 | 122 | 123 | 124 | 125 | 126 | 127 | 128 | 129 | 130 | 131 | Hud Control * 4
12 | 132 | 133 | 134 | 135 | 136 | 137 | 138 | 139 | 140 | 141 | 142 | Standby Instruments * 1
13 | 143 | 144 | 145 | 146 | 147 | 148 | 149 | 150 | 151 | 152 | 153 | RWR * 2
14 | 154 | 155 | 156 | 157 | 158 | 159 | 160 | 161 | 162 | 163 | 164 | IFEI - * 1 which goes direct to Nextron – how is it cabled?
15 | 165 | 166 | 167 | 168 | 169 | 170 | 171 | 172 | 173 | 174 | 175
 |  |  |  |  |  |  |  |  |  |  |  | Encoders
 |  |  |  |  |  |  |  |  |  |  |  | UFC * 2
 | 0 | 1 | 2 | 3 | 4 | 5 | 6 | 7 | 8 | 9 | 10 | Standby Instruments * 2
0 |  |  |  |  |  |  |  |  |  |  | AMPCD-HDG
1 | LEFT DDI |  |  |  |  | RIGHT DDI
2 |  |  |  |  |  |  |  |  |  |  | AP |  | Columns | Rows
3 |  |  |  |  | LEFT UFC ENC |  |  |  |  | LEFT EWI |  | Inputs
4 |  |  |  |  | RIGHT UFC ENC |  |  |  |  | RIGHT EWI | 11 | Left EWI | 2 | 1 | 2 * 2 way connectors
5 |  |  |  |  |  |  |  |  | AP | 64 | 65 | Right EWI | 2 | 1 | 2 * 2 way connectors
6 |  |  |  |  |  |  |  |  | 74 | 75 | 76 | Master Arm |  |  | Single Connector 6 Way Col First
7 |  |  |  |  | UFC |  |  |  |  |  |  | Bit Test | 1 | 1 | TBA possible diode in hud
8 | AMPCD |  |  |  |  |  |  |  |  |  |  | Spin | 2 | 2 | Single Connector 4 Way Col First
9 |  |  |  |  |  |  |  |  | ECM |  | 109 | RWR (V1 NOT V2) | 2 | 5 | Single Connector 8 Way Col First
10 |  |  |  |  |  | BIT TEST |  |  |  |  | 120 | Jet Station Select | 3 | 2
11 |  |  |  |  |  |  | MASTER ARM |  |  |  | 131 | Hud Control | 3 | 3 | Single Connector 6 Way Col First
12 |  |  |  |  | RWR |  |  |  |  |  |  | IFEI AND VID RECORD | 4 | 3 | Single Connector 8 Way Col First
13 |  |  |  |  |  |  | SPIN |  | HUD |  |  | ECM | 2 | 5 | Single Connector 8 Way Col First
14 | IFEI |  |  |  |  |  |  |  |  |  |  | Standby Instruments via ECM
15 |  |  | AMPCD-CRS |  |  |  | JET STATION SELECT |  |  |  |  | ECM Jet PCB has pass through from push button
 | 0 | 1 | 2 | 3 | 4 | 5 | 6 | 7 | 8 | 9 | 10
0 | 0 | 1 | 2 | 3 | 4 | 5 | 6 | 7 | 8 | 9 | 10
1 | 11 | 12 | 13 | 14 | 15 | 16 | 17 | 18 | 19 | 20 | 21
2 | 22 | 23 | 24 | 25 | 26 | 27 | 28 | 29 | 30 | 31 | 32
3 | 33 | 34 | 35 | 36 | 37 | 38 | 39 | 40 | 41 | 42 | 43
4 | 44 | 45 | 46 | 47 | 48 | 49 | 50 | 51 | 52 | 53 | 54
5 | 55 | 56 | 57 | 58 | 59 | 60 | 61 | 62 | 63 | 64 | 65
6 | 66 | 67 | 68 | 69 | 70 | 71 | 72 | 73 | 74 | 75 | 76
7 | 77 | 78 | 79 | 80 | 81 | 82 | 83 | 84 | 85 | 86 | 87
8 | 88 | 89 | 90 | 91 | 92 | 93 | 94 | 95 | 96 | 97 | 98
9 | 99 | 100 | 101 | 102 | 103 | 104 | 105 | 106 | 107 | 108 | 109
10 | 110 | 111 | 112 | 113 | 114 | 115 | 116 | 117 | 118 | 119 | 120
11 | 121 | 122 | 123 | 124 | 125 | 126 | 127 | 128 | 129 | 130 | 131
12 | 132 | 133 | 134 | 135 | 136 | 137 | 138 | 139 | 140 | 141 | 142
13 | 143 | 144 | 145 | 146 | 147 | 148 | 149 | 150 | 151 | 152 | 153
14 | 154 | 155 | 156 | 157 | 158 | 159 | 160 | 161 | 162 | 163 | 164
15 | 165 | 166 | 167 | 168 | 169 | 170 | 171 | 172 | 173 | 174 | 175
Analog Inputs
0 | HUD VID SIM BALANCE
1 | HUD AOA BRIGHT
2 | HUB BLACKLEVEL
3 | HUD BRIGHTNESS
4 | RWR AUDIO
5 | RWR DIMMER
6 | UNUSED
7 | UNUSED
8 | HMD BRIGHTNESS (SPIN PANEL)
9 | IFEI BRIGHTNESS
10 | STANDBY ANALOG
11 | LEFT DDI CONTRAST
12 | LEFT DDI BRIGHT
13 | RIGHT DDI CONTRAST
14 | RIGHT DDI BRIGHT
15 | AMPCD BRIGHT
Encoders | Int
14
15
16
17
18 | 5
19 | 4
20 | 3
21 | 2
Front Test Results
 | 0 | 1 | 2 | 3 | 4 | 5 | 6 | 7 | 8 | 9 | 10
0 | 0 | 1 | 2 | 3 | 4 | 5 | 6 | 7 | 8 | 9 | 10
1 | 11 | 12 | 13 | 14 | 15 | 16 | 17 | 18 | 19 | 20 | 21
2 | 22 | 23 | 24 | 25 | 26 | 27 | 28 | 29 | 30 | 31 | 32
3 | 33 | 34 | 35 | 36 | 37 | 38 | 39 | 40 | 41 | 42 | 43
4 | 44 | 45 | 46 | 47 | 48 | 49 | 50 | 51 | 52 | 53 | 54
5 | 55 | 56 | 57 | 58 | 59 | 60 | 61 | 62 | 63 | 64 | 65
6 | 66 | 67 | 68 | 69 | 70 | 71 | 72 | 73 | 74 | 75 | 76
7 | 77 | 78 | 79 | 80 | 81 | 82 | 83 | 84 | 85 | 86 | 87
8 | 88 | 89 | 90 | 91 | 92 | 93 | 94 | 95 | 96 | 97 | 98
9 | 99 | 100 | 101 | 102 | 103 | 104 | 105 | 106 | 107 | 108 | 109
10 | 110 | 111 | 112 | 113 | 114 | 115 | 116 | 117 | 118 | 119 | 120
11 | 121 | 122 | 123 | 124 | 125 | 126 | 127 | 128 | 129 | 130 | 131
12 | 132 | 133 | 134 | 135 | 136 | 137 | 138 | 139 | 140 | 141 | 142
13 | 143 | 144 | 145 | 146 | 147 | 148 | 149 | 150 | 151 | 152 | 153
14 | 154 | 155 | 156 | 157 | 158 | 159 | 160 | 161 | 162 | 163 | 164
15 | 165 | 166 | 167 | 168 | 169 | 170 | 171 | 172 | 173 | 174 | 175

Sheet: test Front Inputs_2
 | 0 | 1 | 2 | 3 | 4 | 5 | 6 | 7 | 8 | 9 | 10 | Analog Inputs
0 | 0 | 1 | 2 | 3 | 4 | 5 | 6 | 7 | 8 | 9 | 10
1 | 11 | 12 | 13 | 14 | 15 | 16 | 17 | 18 | 19 | 20 | 21 | UFC Connected to A7-11
2 | 22 | 23 | 24 | 25 | 26 | 27 | 28 | 29 | 30 | 31 | 32 | 7
3 | 33 | 34 | 35 | 36 | 37 | 38 | 39 | 40 | 41 | 42 | 43 | 8 | Com1 Vol
4 | 44 | 45 | 46 | 47 | 48 | 49 | 50 | 51 | 52 | 53 | 54 | 9 | Com2 Vol (J9)
5 | 55 | 56 | 57 | 58 | 59 | 60 | 61 | 62 | 63 | 64 | 65 | 10 | Brightness (J10)
6 | 66 | 67 | 68 | 69 | 70 | 71 | 72 | 73 | 74 | 75 | 76 | 11
7 | 77 | 78 | 79 | 80 | 81 | 82 | 83 | 84 | 85 | 86 | 87
8 | 88 | 89 | 90 | 91 | 92 | 93 | 94 | 95 | 96 | 97 | 98 | Left DDI * 2
9 | 99 | 100 | 101 | 102 | 103 | 104 | 105 | 106 | 107 | 108 | 109 | Right DDI * 2
10 | 110 | 111 | 112 | 113 | 114 | 115 | 116 | 117 | 118 | 119 | 120 | Spin * 1
11 | 121 | 122 | 123 | 124 | 125 | 126 | 127 | 128 | 129 | 130 | 131 | Hud Control * 4
12 | 132 | 133 | 134 | 135 | 136 | 137 | 138 | 139 | 140 | 141 | 142 | Standby Instruments * 1
13 | 143 | 144 | 145 | 146 | 147 | 148 | 149 | 150 | 151 | 152 | 153 | RWR * 2
14 | 154 | 155 | 156 | 157 | 158 | 159 | 160 | 161 | 162 | 163 | 164 | IFEI - * 1 which goes direct to Nextron – how is it cabled?
15 | 165 | 166 | 167 | 168 | 169 | 170 | 171 | 172 | 173 | 174 | 175
 |  |  |  |  |  |  |  |  |  |  |  | Encoders
 |  |  |  |  |  |  |  |  |  |  |  | UFC * 2
 | 0 | 1 | 2 | 3 | 4 | 5 | 6 | 7 | 8 | 9 | 10 | Standby Instruments * 2
0 |  |  |  |  |  |  |  |  |  |  | AMPCD-HDG
1 | LEFT DDI |  |  |  |  | RIGHT DDI
2 |  |  |  |  |  |  |  |  |  |  | 32 |  | Columns | Rows
3 |  |  |  |  | LEFT UFC ENC |  |  |  |  | LEFT EWI |  | Inputs
4 |  |  |  |  | RIGHT UFC ENC |  |  |  |  | RIGHT EWI | 11 | Left EWI | 2 | 1 | 2 * 2 way connectors
5 |  |  |  |  |  |  |  |  | JET STATION SELECT |  |  | Right EWI | 2 | 1 | 2 * 2 way connectors
6 |  |  |  |  |  |  |  |  |  |  |  | Master Arm |  |  | Single Connector 6 Way Col First
7 |  |  |  |  | UFC |  |  |  |  |  | AMPCD-CRS | Bit Test | 1 | 1 | TBA possible diode in hud
8 | AMPCD |  |  |  |  |  |  |  |  |  |  | Spin | 2 | 2 | Single Connector 4 Way Col First
9 |  |  |  |  |  |  |  |  | ECM |  | 109 | RWR (V1 NOT V2) | 2 | 5 | Single Connector 8 Way Col First
10 |  |  |  |  |  | BIT TEST |  |  |  |  | 120 | Jet Station Select | 3 | 2
11 |  |  |  |  |  |  | MASTER ARM |  |  |  | 131 | Hud Control | 3 | 3 | Single Connector 6 Way Col First
12 |  |  |  |  | RWR |  |  |  |  |  |  | IFEI AND VID RECORD | 4 | 3 | Single Connector 8 Way Col First
13 |  |  |  |  |  |  | SPIN |  | HUD |  |  | ECM | 2 | 5 | Single Connector 8 Way Col First
14 | IFEI |  |  |  |  |  |  |  |  |  |  | Standby Instruments via ECM
15 |  |  |  |  |  |  | JET STATION SELECT |  |  |  |  | ECM Jet PCB has pass through from push button
 | 0 | 1 | 2 | 3 | 4 | 5 | 6 | 7 | 8 | 9 | 10
0 | 0 | 1 | 2 | 3 | 4 | 5 | 6 | 7 | 8 | 9 | 10
1 | 11 | 12 | 13 | 14 | 15 | 16 | 17 | 18 | 19 | 20 | 21
2 | 22 | 23 | 24 | 25 | 26 | 27 | 28 | 29 | 30 | 31 | 32
3 | 33 | 34 | 35 | 36 | 37 | 38 | 39 | 40 | 41 | 42 | 43
4 | 44 | 45 | 46 | 47 | 48 | 49 | 50 | 51 | 52 | 53 | 54
5 | 55 | 56 | 57 | 58 | 59 | 60 | 61 | 62 | 63 | 64 | 65
6 | 66 | 67 | 68 | 69 | 70 | 71 | 72 | 73 | 74 | 75 | 76
7 | 77 | 78 | 79 | 80 | 81 | 82 | 83 | 84 | 85 | 86 | 87
8 | 88 | 89 | 90 | 91 | 92 | 93 | 94 | 95 | 96 | 97 | 98
9 | 99 | 100 | 101 | 102 | 103 | 104 | 105 | 106 | 107 | 108 | 109
10 | 110 | 111 | 112 | 113 | 114 | 115 | 116 | 117 | 118 | 119 | 120
11 | 121 | 122 | 123 | 124 | 125 | 126 | 127 | 128 | 129 | 130 | 131
12 | 132 | 133 | 134 | 135 | 136 | 137 | 138 | 139 | 140 | 141 | 142
13 | 143 | 144 | 145 | 146 | 147 | 148 | 149 | 150 | 151 | 152 | 153
14 | 154 | 155 | 156 | 157 | 158 | 159 | 160 | 161 | 162 | 163 | 164
15 | 165 | 166 | 167 | 168 | 169 | 170 | 171 | 172 | 173 | 174 | 175
 |  |  |  | if moving ampcb crs – and changing from vertical to horizontal – invert diode

Sheet: Instructions
NOTE ALL ROWS AND COLUMNS START AT 0
Leds
Copy the an 8*8 template cell block from the Led Template to Columns A-I on the appropriate sheet. Update the panel name.
Start with panel pcb by itself. Connect it starting at Col 0 and Row 0. Using the Max7219_Test_Harness sketch step through the 64 positions filling in the colours on the standalone block. If the bezel name is known, assign it to the cell.
The order displayed by the Max7219_Test_Harness makes it easier to copy and the references into the led driver for DCSBIOS code (eg DCSBIOS_Max7219)
Once all of the individual led pcbs have been mapped out, merge them into a block in columns K-S, assign a name for each block. Draw a border around each pcb
Place pcb connectors in final position and validate row column outputs are as expected.
Inputs
Connect the pcb to expected row column location using the non-polarised headers on the input pcb. Remembering some of the pcbs use only 5 of the 6, or 7 of the 8, connectors
Colour a block of the expected inputs used, remembering there are 11 inputs per row.
As each button is pressed, change the text colour of the number in the upper block from Black to Red
There are likely to be gaps in inputs used, when completed, remove the fill from unused cells are the can be used for smaller panels.

Sheet: Outputs
Steppers |  | Servos | Stepper | Standard | Max 7219 | RS232 Nextron
Servos |  | 6 | 3 | 10 | 1
Led
Left Distribution
Servos | Trim | 1
Steppers | Brake Pressure |  | 1
Standard | LG |  |  | 1
 | LB |  |  | 1
 | Hook |  |  | 1
 | FD |  |  | 1
 | APU |  |  | 1
 | ENG |  |  | 1
Right Distribution
Servos | Radar Alt Flag | 1
 | Batt E | 1
 | Batt L | 1
 | PRS1 | 1
 | PRS2 | 1
Steppers | Radar Alt |  | 1
Standard | Bleed Air |  |  | 1
 | Pitot |  |  | 1
 | Laser |  |  | 1
 | Canopy |  |  | 1
LIP
Steppers | Cabin Altitude |  | 1
IFEI (need analog input as well) |  |  |  |  |  | 1

Sheet: Leds
Mapping of Led Outs for individual PCBS |  |  |  |  |  |  |  |  | Marker Beacon |  | Fire Handle Left (relay) |  | APU FIRE (relay) |  | Ready | AOA High | TACAN TEST
Connect PCB under test starting at Row 0 and Col 0 |  |  |  |  |  |  |  |  | Canopy Unlocked |  | Fire Handle Right (relay) |  |  |  | Latched | AOA On
Then Combined Results – for initial sweep just colour Cell |  |  |  |  |  |  |  |  |  |  |  |  |  |  | Disconnect | AOA Low
ROWS ARE ANODES
Look at separate Boards for LIP and UIP – side consoles can come to LIP
Left Eyebrow (UIP) |  |  |  |  |  |  |  |  |  | Left Eyebrow
 | Col |  |  |  |  |  |  |  |  |  | Col
Row | 0 | 1 | 2 | 3 | 4 | 5 | 6 | 7 |  | Row | 0 | 1 | 2 | 3 | 4 | 5 | 6 | 7
0 | NO GO | R BLEED | STBY | REC | XMIT | ASPJ OH |  |  |  | 0 | NO GO | R BLEED | STBY | REC | XMIT | ASPJ OH
1 | NO GO | R BLEED | STBY | REC | XMIT | ASPJ OH |  |  |  | 1 | NO GO | R BLEED | STBY | REC | XMIT | ASPJ OH
2 | GO | L BLEED | SPD BRK | L BAR | L BAR |  |  |  |  | 2 | GO | L BLEED | SPD BRK | L BAR | L BAR | APU
3 | GO | L BLEED | SPD BRK | L BAR | L BAR |  |  |  |  | 3 | GO | L BLEED | SPD BRK | L BAR | L BAR | Landing Gear
4 |  | MSTR CAUT | MSTR CAUT |  |  |  |  |  |  | 4 |  | MSTR CAUT | MSTR CAUT | OPT 1 | OPT 1 | OPT 5
5 |  | MSTR CAUT | MSTR CAUT |  |  |  |  |  |  | 5 |  | MSTR CAUT | MSTR CAUT | OPT 2 | OPT 2 | BIT GREEN | BIT WHITE
6 |  | LEFT FIRE | LEFT FIRE |  |  |  |  |  |  | 6 |  | LEFT FIRE | LEFT FIRE | OPT 3 | OPT 3
7 |  | LEFT FIRE | LEFT FIRE |  |  |  |  |  |  | 7 |  | LEFT FIRE | LEFT FIRE | OPT 4 | OPT 4
Right Eyebrow (UIP) |  |  |  |  |  |  |  |  |  | Right Eyebrow
 | Col |  |  |  |  |  |  |  |  |  | Col
Row | 0 | 1 | 2 | 3 | 4 | 5 | 6 | 7 |  | Row | 0 | 1 | 2 | 3 | 4 | 5 | 6 | 7
0 | RCDR ON | Spare 1 | Spare 3 | Spare 5 | AI | CW |  |  |  | 0 | RCDR ON | Spare 1 | Spare 3 | Spare 5 | AI | CW
1 | RCDR ON | Spare 1 | Spare 3 | Spare 5 | AI | CW |  |  |  | 1 | RCDR ON | Spare 1 | Spare 3 | Spare 5 | AI | CW
2 | DISP | Spare 2 | Spare 4 | SAM | AAA |  |  |  |  | 2 | DISP | Spare 2 | Spare 4 | SAM | AAA
3 | DISP | Spare 2 | Spare 4 | SAM | AAA |  |  |  |  | 3 | DISP | Spare 2 | Spare 4 | SAM | AAA
4 |  | APU FIRE | APU FIRE |  |  |  |  |  |  | 4 |  | APU FIRE | APU FIRE
5 |  | APU FIRE | APU FIRE |  |  |  |  |  |  | 5 |  | APU FIRE | APU FIRE
6 |  | RGHT FIRE | RGHT FIRE |  |  |  |  |  |  | 6 |  | RGHT FIRE | RGHT FIRE
7 |  | RGHT FIRE | RGHT FIRE |  |  |  |  |  |  | 7 |  | RGHT FIRE | RGHT FIRE
Caution (LIP) |  |  |  |  |  |  |  |  |  | Caution
 | Col |  |  |  |  |  |  |  |  |  | Col
Row | 0 | 1 | 2 | 3 | 4 | 5 | 6 | 7 |  | Row | 0 | 1 | 2 | 3 | 4 | 5 | 6 | 7
0 | CHK SEAT | FCS HOT | FUEL LO | L GEN |  |  |  |  |  | 0 | CHK SEAT | FCS HOT | FUEL LO | L GEN |  | R_ALT(R) | R_ALT(G)
1 | CHK SEAT | FCS HOT | FUEL LO | L GEN |  |  |  |  |  | 1 | CHK SEAT | FCS HOT | FUEL LO | L GEN |  | HOOK1 | HOOK2
2 | APU ACC | GEN TIE | FCES | R GEN |  |  |  |  |  | 2 | APU ACC | GEN TIE | FCES | R GEN |  | LOCK | LOCK
3 | APU ACC | GEN TIE | FCES | R GEN |  |  |  |  |  | 3 | APU ACC | GEN TIE | FCES | R GEN |  | SHOOT | SHOOT
4 | BATT SW | Spare 1 | Spare 2 | Spare 3 |  |  |  |  |  | 4 | BATT SW | Spare 1 | Spare 2 | Spare 3 |  | SHOOOT | SHOOOT
5 | BATT SW | Spare 1 | Spare 2 | Spare 3 |  |  |  |  |  | 5 | BATT SW | Spare 1 | Spare 2 | Spare 3
6 |  |  |  |  |  |  |  |  |  | 6
7 |  |  |  |  |  |  |  |  |  | 7
UFC (UIP)
 | Col
Row | 0 | 1 | 2 | 3 | 4 | 5 | 6 | 7 |  | Flaps Gear
0 | OPT 1 | OPT 1 | OPT 5 |  |  |  |  |  |  |  | Col
1 | OPT 2 | OPT 2 |  |  |  |  |  |  |  | Row | 0 | 1 | 2 | 3 | 4 | 5 | 6 | 7
2 | OPT 3 | OPT 3 |  |  |  |  |  |  |  | 0 | Centre | Left Inner | Left Outer | Nose Gear | Left Gear | Flaps Half
3 | OPT 4 | OPT 4 |  |  |  |  |  |  |  | 1 | Right Inner | Right Outer | Right Gear | Nose Gear | Left Gear | Flaps Half
4 |  |  |  |  |  |  |  |  |  | 2 | Flaps Full | Right Gear | Flaps Full | Flaps Amber | Flaps Amber
5 |  |  |  |  |  |  |  |  |  | 3 | ON | ABOVE
6 |  |  |  |  |  |  |  |  |  | 4 | BELOW
7 |  |  |  |  |  |  |  |  |  | 5 | MASTER ARM
 |  |  |  |  |  |  |  |  |  | 6
Flaps Gear (LIP) |  |  |  |  |  |  |  |  |  | 7
 | Col
Row | 0 | 1 | 2 | 3 | 4 | 5 | 6 | 7
0 | Centre | Left Inner | Left Outer | Nose Gear | Left Gear | Flaps Half |  |  |  | RWR | Separate Dimming
1 | Right Inner | Right Outer | Right Gear | Nose Gear | Left Gear | Flaps Half |  |  |  |  | Col
2 | Flaps Full | Right Gear | Flaps Full | Flaps Amber | Flaps Amber |  |  |  |  | Row | 0 | 1
3 |  |  |  |  |  |  |  |  |  | 0
4 |  |  |  |  |  |  |  |  |  | 1
5 |  |  |  |  |  |  |  |  |  | 2
6 |  |  |  |  |  |  |  |  |  | 4
7
Right Distribution
 | Col
Row | 0 | 1 | 2 | 3 | 4 | 5 | 6 | 7
0 | R_ALT(R) | R_ALT(G)
1 | HOOK1 | HOOK2
2
3
4
5
6
7
LEFT DISTRIBUTION
 | Col
Row | 0 | 1 | 2 | 3 | 4 | 5 | 6 | 7
0 | APU
1 | Landing Gear
2
3
4
5
6
7
Lock Shoot (LIP) (as it connected to the canopy bow)
 | 0 | 1
0 | LOCK | LOCK
1 | SHOOT | SHOOT
2 | SHOOOT | SHOOOT
AOA (UIP) | BRIGHTNESS COULD BE SET BY HUD CONTROL
 | 0 | 1
0 | ON | ABOVE
1 | BELOW
MASTER ARM
 | AA
 | AG
 | FIRE EXT
BIT (UIP)
 | Col
Row | 0 | 1
0 | BIT GREEN | BIT WHITE
RWR
 | Col
Row | 0 | 1
0
1
2
4

Sheet: Led Template
Panel Name
 | Col
Row | 0 | 1 | 2 | 3 | 4 | 5 | 6 | 7
0
1
2
3
4
5
6
7

Sheet: Left Inputs
 | 0 | 1 | 2 | 3 | 4 | 5 | 6 | 7 | 8 | 9 | 10
0 | TEST |  | FLIGHT CONTROL |  |  | 5 | 6 | 7 | 8 | 9 | 10
1 |  |  |  |  |  | 16 | 17 | 18 | 19 | 20 | 21
2 |  |  | 24 | 25 | 26 | 27 | 28 | 29 | 30 | 31 | 32
3 |  |  | 35 | 36 | 37 | 38 | 39 | 40 | 41 | 42 | 43
4 | 44 | 45 | 46 | 47 | 48 | 49 | 50 | 51 | 52 | 53 | 54
5 | 55 | 56 | 57 | 58 | 59 | 60 | 61 | 62 | 63 | 64 | 65
6 | 66 | 67 | 68 | 69 | 70 | 71 | 72 | 73 | 74 | 75 | 76
7 | 77 | 78 | 79 | 80 | 81 | 82 | 83 | 84 | 85 | 86 | 87
8 | 88 | 89 | 90 | 91 | 92 | 93 | 94 | 95 | 96 | 97 | 98
9 | 99 | 100 | 101 | 102 | 103 | 104 | 105 | 106 | 107 | 108 | 109
10 | 110 | 111 | 112 | 113 | 114 | 115 | 116 | 117 | 118 | 119 | 120
11 | 121 | 122 | 123 | 124 | 125 | 126 | 127 | 128 | 129 | 130 | 131
12 | 132 | 133 | 134 | 135 | 136 | 137 | 138 | 139 | 140 | 141 | 142
13 | 143 | 144 | 145 | 146 | 147 | 148 | 149 | 150 | 151 | 152 | 153
14 | 154 | 155 | 156 | 157 | 158 | 159 | 160 | 161 | 162 | 163 | 164
15 | 165 | 166 | 167 | 168 | 169 | 170 | 171 | 172 | 173 | 174 | 175
Press | 0 | 1 | 2 | 3 | 4 | 5 | 6 | 7 | 8 | 9 | 10
0 | 0 | 1 | 2 | 3 | 4 | 5 | 6 | 7 | 8 | 9 | 10 |  | 0 | 1 | 2 | 3 | 4 | 5 | 6 | 7 | 8 | 9 | 10
1 | 11 | 12 | 13 | 14 | 15 | 16 | 17 | 18 | 19 | 20 | 21 | 0 | 0 | 1 | 2 | 3 | 4 | 5 | 6 | 7 | 8 | 9 | 10
2 | 22 | 23 | 24 | 25 | 26 | 27 | 28 | 29 | 30 | 31 | 32 | 1 | 11 | 12 | 13 | 14 | 15 | 16 | 17 | 18 | 19 | 20 | 21
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
5
6
7
8
9
10
11
12
13
14
15
 |  | COL | ROW | ANALOG
 | ELEC | 2 | 2 | 0
 | ECS | 4 | 4 | 2
 | INTR LT | 3 | 2 | 6
 | SNSR | 3 | 8 | 0
 | SIM CNTL | 4 | 8 | 0
 | KY58 | 2 | 8 | 1
 | RIGHT ESS BREAKERS | 3 | 3 | 0 | May need to add an intermediary board for Mag Switch
 | RIGHT FWD AUX | 2 | 3 | 0

Sheet: Right Inputs
 | 0 | 1 | 2 | 3 | 4 | 5 | 6 | 7 | 8 | 9 | 10
0 | AIR COND | ANTIICE |  |  | 4 | 5 | 6 | 7 | 8 | 9 | 10
1 |  |  |  |  | 15 | 16 | 17 | 18 | 19 | 20 | 21
2 |  | SENSOR POWER |  | AVIONICS POWER |  | 27 | 28 | 29 | 30 | 31 | 32
3 |  |  |  |  |  | 38 | 39 | 40 | 41 | 42 | 43
4 | ZEROIZE |  |  |  |  | 49 | 50 | 51 | 52 | 53 | 54
5 |  | LIGHTING | NUCLEAR |  |  | 60 | 61 | 62 | 63 | 64 | 65
6 |  | 67 |  |  |  | 71 | 72 | 73 | 74 | 75 | 76
7 | 77 | 78 |  |  |  | 82 | 83 | 84 | 85 | 86 | 87
8 | HUD |  |  | 91 | 92 | 93 | 94 | 95 | 96 | 97 | 98
9 |  |  |  | 102 | 103 | 104 | 105 | 106 | 107 | 108 | 109
10 |  |  |  | 113 | 114 | 115 | 116 | 117 | 118 | 119 | 120
11 |  |  |  | 124 | 125 | 126 | 127 | 128 | 129 | 130 | 131
12 |  |  |  | 135 | 136 | 137 | 138 | 139 | 140 | 141 | 142
13 |  |  |  | 146 | 147 | 148 | 149 | 150 | 151 | 152 | 153
14 | 154 | 155 | 156 | 157 | 158 | 159 | 160 | 161 | 162 | 163 | 164
15 | 165 | 166 | 167 | 168 | 169 | 170 | 171 | 172 | 173 | 174 | 175
 | 0 | 1 | 2 | 3 | 4 | 5 | 6 | 7 | 8 | 9 | 10
0 | 0 | 1 | 2 | 3 | 4 | 5 | 6 | 7 | 8 | 9 | 10
1 | 11 | 12 | 13 | 14 | 15 | 16 | 17 | 18 | 19 | 20 | 21
2 | 22 | 23 | 24 | 25 | 26 | 27 | 28 | 29 | 30 | 31 | 32
3 | 33 | 34 | 35 | 36 | 37 | 38 | 39 | 40 | 41 | 42 | 43
4 | 44 | 45 | 46 | 47 | 48 | 49 | 50 | 51 | 52 | 53 | 54
5 | 55 | 56 | 57 | 58 | 59 | 60 | 61 | 62 | 63 | 64 | 65
6 | 66 | 67 | 68 | 69 | 70 | 71 | 72 | 73 | 74 | 75 | 76
7 | 77 | 78 | 79 | 80 | 81 | 82 | 83 | 84 | 85 | 86 | 87
8 | 88 | 89 | 90 | 91 | 92 | 93 | 94 | 95 | 96 | 97 | 98
9 | 99 | 100 | 101 | 102 | 103 | 104 | 105 | 106 | 107 | 108 | 109
10 | 110 | 111 | 112 | 113 | 114 | 115 | 116 | 117 | 118 | 119 | 120
11 | 121 | 122 | 123 | 124 | 125 | 126 | 127 | 128 | 129 | 130 | 131
12 | 132 | 133 | 134 | 135 | 136 | 137 | 138 | 139 | 140 | 141 | 142
13 | 143 | 144 | 145 | 146 | 147 | 148 | 149 | 150 | 151 | 152 | 153
14 | 154 | 155 | 156 | 157 | 158 | 159 | 160 | 161 | 162 | 163 | 164
15 | 165 | 166 | 167 | 168 | 169 | 170 | 171 | 172 | 173 | 174 | 175
 |  |  | Have a duplicate on ILS 1 and 11 both reporting a position of 1 – there is a spare slot for 100 which is 21 existed
Press
 | 0 | 1 | 2 | 3 | 4 | 5 | 6 | 7 | 8 | 9 | 10
0 | 0 | 1 - ILS Pos 11 | 2 – RLY Plain | 3 | 4 | 5 | 6 | 7 | 8 | 9 – Ext Lights – Strobe Brt | 10 – Ext Lights – Intr Wing – Norm
1 | 11 – ILS Pos 11 | 12 - ILS Pos 13 | 13 – RLY Cipher | 14 | 15 | 16 | 17 | 18 | 19 | 20 – Ext Lights – Strobe Dim | 21 – Ext Lights – Gen Tie Reset
2 | 22 - ILS Pos 14 | 23 - ILS Pos 3 | 24 – IFF Crypto Zero | 25 Jett Button Push | 26 – Land/Taxi Light Off | 27 | 28 – Dispensor – Press | 29 – Ess Breaker – FCS Chan 2 Press | 30 – Ess Breaker – L Bar Press | 31- FCS Reset | 32
3 | 33 - ILS Pos 4 | 34 - ILS Pos 15 | 35 – IFF Crypto Hold | 36 – Launch Bar Extend | 37 Emergency Park Pull | 38 – RACK LCHR | 39 – Ess Breaker – CB FCS Chan 1 Press | 40 – Ess Breaker Spd Brk – Press | 41 | 42 – FCS – Gain Overide | 43
4 | 44 - ILS Pos 16 | 45 - ILS Pos 5 | 46 – G XMT COMM 1 | 47 – Park Pull | 48 – Hook Bypass Field | 49 – R Fus Msl | 50 - APU – ENG CRANK Left | 51 – APU – APU On | 52 – MC 1 Off | 53 – Nuclear On | 54 – LOX – OXY Flow ON
5 | 55 - ILS Pos 6 | 56 - ILS Pos 17 | 57 -G XMT COM 2 | 58 – Sel Jet – Flaps – Auto | 59 Emergency Rotate | 60 – Lfus Msl | 61 - APU – ENG Crank Right | 62 | 63 – MC 2 Off | 64 – HYD ISO ORIDE | 65 – LOX – OBOGS ON
6 | 66 - ILS Pos 18 | 67 - ILS Pos 7 | 68 – IFF Master Norm | 69 – Sel Jet – Flaps Full | 70 Antiskid on | 71 – Safe | 72 | 73 | 74 | 75 | 76
7 | 77 - ILS Pos 8 | 78 - ILS Pos 19 | 79 – IFF Mode 4 Dis/AUD | 80 | 81 | 82 – FireTest A | 83 | 84 | 85 | 86 | 87
8 | 88 - ILS Pos 20 | 89 - ILS Pos 9 | 90 – ILS UFC | 91 | 92 | 93 – FireTest B | 94 | 95 | 96 | 97 | 98
9 | 99 - ILS Pos 10 | 100 - ILS Pos XX | 101 – IFF Mode 4 Dis | 102 | 103 | 104 | 105 | 106 | 107 | 108 | 109
10 | 110 – Fuel – Probe Extend | 111 - Fuel – Wing Oride | 112 – Fuel – CTR Oride | 113 – Fuel – Dump On | 114- Landing Gear Down | 125 – Emergency Gear Down Pull | 116 | 117 | 118 | 119 | 120
11 | 121 – Fuel – Probe Emer Ext | 122 - Fuel – Wing Stop | 123 - Fuel – CTR Stop | 124 | 115 – Warn Tone Sil | 126 – Down Lock Overide | 127 | 128 | 129 | 130 | 131
12 | 132 - Ant Sel Comm 1 Upper | 133 – Ant Sel IFF Upper | 134 | 135 | 136 | 137 | 138 | 139 | 140 | 141 | 142
13 | 143 – Ant Sel Comm 1 Lower | 144 – Ant Sel IFF Lower | 145 | 146 | 147 | 148 | 149 | 150 | 151 | 152 | 153
14 | 154 | 155 | 156 | 157 | 158 | 159 | 160 | 161 | 162 | 163 | 164
15 | 165 | 166 | 167 | 168 | 169 | 170 | 171 | 172 | 173 | 174 | 175
Release
 | 0 | 1 | 2 | 3 | 4 | 5 | 6 | 7 | 8 | 9 | 10
0 | 0 | 1 | 2 – RLY Off | 3 | 4 | 5 | 6 | 7 | 8 | 9 – Ext Lights – Strobe Norm | 10 – Ext Lights – Intr Wing – Inhibit
1 | 11 | 12 | 13 - RLY Off | 14 | 15 | 16 | 17 | 18 | 19 | 20 – Ext Lights – Strobe Norm | 21 – Ext Lights – Gen Tie Norm
2 | 22 | 23 | 24 – IFF Crypto Norm | 25 – Sel Jet – Landing Light On | 26 – Land/Taxi Light On | 27 | 28 – Dispensor – Release | 29 – Ess Breaker – FCS Chan 2 Release | 30 – Ess Breaker – L Bar Release | 31 – FCS – Reset | 32
3 | 33 | 34 | 35 – IFF Crypto Norm | 36 – Launch Bar Retract | 37 – Sel Jet – Anti skid on | 38 | 39 – Ess Breaker – CB FCS Chan 1 release | 40 – Ess Breaker Spd Brk – Release | 41 | 42 – FCS Gain Norm | 43
4 | 44 | 45 | 46 – G XMT – Off |  | 48 – Hook Bypass Carrier | 49 | 50 – APU - Eng Crank Off | 51 – APU – APU Off | 52 – MC Norm | 53 – Nuclear Off | 54 – LOX – OXY Flow Off
5 | 55 | 56 | 57 – G XMT – Off | 58 – Sel Jet Flaps Half |  | 60 | 61 – APU - Eng Crank Off | 62 | 63 – MC Norm | 64 – HYD ISO L NORM | 65 – LOX – OBOGS Off
6 | 66 | 67 | 68 – IFF Master Emerg | 69 – Sel Jet – Flaps Half | 70 – Sel Jet – Antiskid off | 71 | 72 | 73 | 74 | 75 | 76
7 | 77 | 78 | 79 – IFF Mode 4 Off | 80 | 81 | 82 – Fire Test A | 83 | 84 | 85 | 86 | 87
8 | 88 | 89 | 90 – ILS MAN | 91 | 92 | 93 – Fire test B | 94 | 95 | 96 | 97 | 98
9 | 99 | 100 | 101 – IFF Mode 4 Dis | 102 | 103 | 104 | 105 | 106 | 107 | 108 | 109
10 | 110 - Fuel – Probe Retract | 111 – Fuel – Wing Norm | 112 – Fuel – CTR Norm | 113 – Fuel – Dump Off | 114- Landing Gear Up Push | 125 – Emergency Gear Down Push | 116 | 117 | 118 | 119 | 120
11 | 121 – Fuel – Probe Retract | 122 – Fuel – Wing Norm | 123 – Fuel – CTR Norm | 124 | 115 – Warn Tone Sil Release | 126 – Down Lock Overide | 127 | 128 | 129 | 130 | 131
12 | 132 – Ant Sel Comm 1 Auto | 133 – Ant Sel IFF Auto | 134 | 135 | 136 | 137 | 138 | 139 | 140 | 141 | 142
13 | 143 – Ant Sel Comm 1 Auto | 144 – Ant Sel IFF Auto | 145 | 146 | 147 | 148 | 149 | 150 | 151 | 152 | 153
14 | 154 | 155 | 156 | 157 | 158 | 159 | 160 | 161 | 162 | 163 | 164
15 | 165 | 166 | 167 | 168 | 169 | 170 | 171 | 172 | 173 | 174 | 175
Analog Inputs
0 | CONSOLES_BRT
1 | INST_PNL_BRT
2 | NAV_FREQ_BRT
3 | CONSOLE_FLOOD
4 | INST_FLOOD
5
6
7
8
9
10
11
12
13
14
15

Sheet: Front Inputs
 | 0 | 1 | 2 | 3 | 4 | 5 | 6 | 7 | 8 | 9 | 10
0 | 0 | 1 | 2 | 3 | 4 | 5 | 6 | 7 | 8 | 9 | 10
1 | 11 | 12 | 13 | 14 | 15 | 16 | 17 | 18 | 19 | 20 | 21
2 | 22 | 23 | 24 | 25 | 26 | 27 | 28 | 29 | 30 | 31 | 32
3 | 33 | 34 | 35 | 36 | 37 | 38 | 39 | 40 | 41 | 42 | 43
4 | 44 | 45 | 46 | 47 | 48 | 49 | 50 | 51 | 52 | 53 | 54
5 | 55 | 56 | 57 | 58 | 59 | 60 | 61 | 62 | 63 | 64 | 65
6 | 66 | 67 | 68 | 69 | 70 | 71 | 72 | 73 | 74 | 75 | 76
7 | 77 | 78 | 79 | 80 | 81 | 82 | 83 | 84 | 85 | 86 | 87
8 | 88 | 89 | 90 | 91 | 92 | 93 | 94 | 95 | 96 | 97 | 98
9 | 99 | 100 | 101 | 102 | 103 | 104 | 105 | 106 | 107 | 108 | 109
10 | 110 | 111 | 112 | 113 | 114 | 115 | 116 | 117 | 118 | 119 | 120
11 | 121 | 122 | 123 | 124 | 125 | 126 | 127 | 128 | 129 | 130 | 131
12 | 132 | 133 | 134 | 135 | 136 | 137 | 138 | 139 | 140 | 141 | 142
13 | 143 | 144 | 145 | 146 | 147 | 148 | 149 | 150 | 151 | 152 | 153
14 | 154 | 155 | 156 | 157 | 158 | 159 | 160 | 161 | 162 | 163 | 164
15 | 165 | 166 | 167 | 168 | 169 | 170 | 171 | 172 | 173 | 174 | 175
 | 0 | 1 | 2 | 3 | 4 | 5 | 6 | 7 | 8 | 9 | 10
0 | 0 | 1 | 2 | 3 | 4 | 5 | 6 | 7 | 8 | 9 | 10
1 | 11 | 12 | 13 | 14 | 15 | 16 | 17 | 18 | 19 | 20 | 21
2 | 22 | 23 | 24 | 25 | 26 | 27 | 28 | 29 | 30 | 31 | 32
3 | 33 | 34 | 35 | 36 | 37 | 38 | 39 | 40 | 41 | 42 | 43
4 | 44 | 45 | 46 | 47 | 48 | 49 | 50 | 51 | 52 | 53 | 54
5 | 55 | 56 | 57 | 58 | 59 | 60 | 61 | 62 | 63 | 64 | 65
6 | 66 | 67 | 68 | 69 | 70 | 71 | 72 | 73 | 74 | 75 | 76
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
12 | 132 | 133 | 134 | 135 | 136 | 137 | 138 | 139 | 140 | 141 | 142
13 | 143 | 144 | 145 | 146 | 147 | 148 | 149 | 150 | 151 | 152 | 153
14 | 154 | 155 | 156 | 157 | 158 | 159 | 160 | 161 | 162 | 163 | 164
15 | 165 | 166 | 167 | 168 | 169 | 170 | 171 | 172 | 173 | 174 | 175

Sheet: PCB Check before ordering
PCB Check before ordering
Left Console | Check ECAD Block Diagram | Electrical Check | PCB Bug Check | Mounting Holes | PCB and Component Labels on Silkscreen | Col Row Connector Check | Col/Rows in Spreadsheet | View in 3d viewer, Export JPG | Print PCB and Schematic | Combined Col/Rows in Distribution | Analog inputs in Distribution | Mag Coils | DXF | Laser Board for Mount testing | Exported | Ordered | Quantity
Antenna Select |  |  |  |  |  |  |  |  |  |  |  |  |  |  |  |  | 1
Oxygen |  |  |  |  |  |  |  |  |  |  |  |  |  |  |  |  | 1
Mission Computer |  |  |  |  |  |  | 8-9,4-5 |  |  |  |  |  |  |  |  |  | 1
Comm |  |  |  |  |  |  | 0-2,0-9 |  |  |  |  |  |  |  |  |  | 1
Left Circuit Breakers |  |  |  |  |  |  | 6-8,2-3 |  |  |  |  |  |  |  |  |  | 1
APU |  |  |  |  |  |  | 6-8,3-4 |  |  |  |  |  |  |  |  |  | 1
FCS |  |  |  |  |  |  | 9-10,2-3 |  |  |  |  |  |  |  |  |  | 1
Fuel |  |  |  |  |  |  | 0-3,10-11 |  |  |  |  |  |  |  |  |  | 1
Formation Lights |  |  |  |  |  |  | 9-10,0-1 |  |  |  |  |  |  |  |  |  | 1
Fire Test |  |  |  |  |  |  | 5,7-8 |  |  |  |  |  |  |  |  |  | 1
Select Jet |  |  |  |  |  |  | 3-5,2-6 |  |  |  |  |  |  |  |  |  | 1
Landing Gear |  |  |  |  |  |  | 4-5,10-11 |  |  |  |  |  |  |  |  |  | 1
Ejection Seat
Distribution PCB |  |  |  |  |  |  |  |  |  |  |  |  |  |  |  |  | 1
Flood Lights |  |  |  |  |  |  |  |  |  |  |  |  |  |  |  |  | 13
OH General Purpose Smal
Right Console | Check ECAD Block Diagram Visual MCAD | Electrical Check | Export DXF for backlight and flip | PCB Bug Check | Mounting Holes | PCB and Component Labels on Silkscreen | Col Row Connector Check | Col/Rows in Spreadsheet | View in 3d viewer, Export JPG | Print PCB and Schematic | Combined Col/Rows in Distribution | Analog inputs in Distribution | Mag Coils | DXF | Laser Board for Mount testing | Exported | Ordered | Quantity
Electrical |  |  |  |  |  |  | 9-10, 3-4 |  |  |  |  |  |  |  |  |  |  | 5
Environmental Control |  |  |  |  |  |  | 3-6, 8-11 |  |  |  |  |  |  |  |  |  |  | 5
Internal Lights and Defog |  |  |  |  |  |  | 0-2, 8-9 |  |  |  |  |  |  |  | N/A |  |  | 5
Sensor |  |  |  |  |  |  | 0-2, 0-7 |  |  |  |  |  |  |  |  |  |  | 5
Right Essential Breakers |  |  |  |  |  |  | 0-2, 10-12 |  |  |  |  |  |  |  |  |  |  | 5
Sim Control |  |  |  |  |  |  | 3-6, 0-7 |  |  |  |  |  |  |  |  |  |  | 5
KY 58 |  |  |  |  |  |  | 7-8, 0-7 |  |  |  |  |  |  |  |  |  |  | 5
Right Fwd Aux |  |  |  |  |  |  | 9-10, 0-2 |  |  |  |  |  |  |  |  |  |  | 5
Radar Alt |  |  |  |  |  |  | 7,8
LEFT COM PANEL |  |  |  |  |  |  |  |  |  |  |  |  |  |  |  |  |  | 5
LEFT DIST PANEL |  |  |  |  |  |  |  |  |  |  |  |  |  |  |  |  |  | 5
LEFT FCS PANEL |  |  |  |  |  |  |  |  |  |  |  |  |  |  |  |  |  | 5
Misc Lights |  |  |  |  |  |  |  |  |  |  |  |  |  |  |  |  |  | 10
Left Output Distribution |  |  |  |  |  |  |  |  |  |  |  |  |  |  |  |  |  | 5
Right Output Distribution |  |  |  |  |  |  |  |  |  |  |  |  |  |  |  |  |  | 5
Right Input Distribution |  |  |  |  |  |  |  |  |  |  |  |  |  |  |  |  |  | 5
Front Console
New Selective Jet
New Left Input distribution to support additional row on Select Jet
New Right Dist board to support 10 pins with Sim Control
ELEC incorrect switch wiring
New PCB for backlight light distribution and breakout on each panel with resistor
October 2021 Order
Select Jet |  |  |  |  |  |  |  |  |  |  |  |  |  |  |  |  |  | 5
HUD BIT |  |  |  |  |  |  |  |  |  |  |  |  |  |  |  |  |  | 5
IFEI |  |  |  |  |  |  |  |  |  |  |  |  |  |  |  |  |  | 5
Master ARM/Extinguish |  |  |  |  |  |  |  |  |  |  |  |  |  |  |  |  |  | 5
ECM |  |  |  |  |  |  |  |  |  |  |  |  |  |  |  |  |  | 5
LUKES RWR |  |  |  |  |  |  |  |  |  |  |  |  |  |  |  |  |  | 5
LUKES POWER DIST |  |  |  |  |  |  |  |  |  |  |  |  |  |  |  |  |  | 5
Left Distribution with correct LEDs |  |  |  |  |  |  |  |  |  |  |  |  |  |  |  |  |  | 5
Right Distribution with correct leds |  |  |  |  |  |  |  |  |  |  |  |  |  |  |  |  |  | 5
UIP Led distribution | LEDs |  |  |  |  |  |  |  |  |  |  |  |  |  |  |  |  | 5
COMBINED OUTPUT |  |  |  |  |  |  |  |  |  |  |  |  |  |  |  |  |  | 5
INPUT SHIELD |  |  |  |  |  |  |  |  |  |  |  |  |  |  |  |  |  | 10
OUTPUT SHIELD |  |  |  |  |  |  |  |  |  |  |  |  |  |  |  |  |  | 10
BACKLIGHT AND POWER DIST |  |  |  |  |  |  |  |  |  |  |  |  |  |  |  |  |  | 10
PEDAL ADJUST |  |  |  |  |  |  |  |  |  |  |  |  |  |  |  |  |  | 5
SPIN |  |  |  |  |  |  |  |  |  |  |  |  |  |  |  |  |  | 5
FWD INPUT DISTRIBUTION |  |  |  |  |  |  |  |  |  |  |  |  |  |  |  |  |  | 5
BATTERY PANEL |  |  |  |  |  |  |  |  |  |  |  |  |  |  |  |  |  | 5
EJECTION SEAT |  |  |  |  |  |  |  |  |  |  |  |  |  |  |  |  |  | 5
HUD CONTROL |  |  |  |  |  |  |  |  |  |  |  |  |  |  |  |  |  | 5
01/11/21
Auto Pilot V2 |  |  |  |  |  |  |  |  |  |  |  |  |  |  |  |  |  | 5
Right Output distribution v3 |  |  |  |  |  |  |  |  |  |  |  |  |  |  |  |  |  | 5
Left Output distribution v3 | Order |  |  |  |  |  |  |  |  |  |  |  |  |  |  |  |  | 5
Input Shields – with pieces removed for NW sheild |  |  |  |  |  |  |  |  |  |  |  |  |  |  |  |  |  | 20 | Could add another 10 as 15 jumps the price
Output Shields with pieces removed for NW shield |  |  |  |  |  |  |  |  |  |  |  |  |  |  |  |  |  | 20 | Could add another 10 as 15 jumps the price
Updated DDIs |  |  |  |  |  |  |  |  |  |  |  |  |  |  |  |  |  | 10
Forward input distribution |  |  |  |  |  |  |  |  |  |  |  |  |  |  |  |  |  | 5
Jet Station Select |  |  |  |  |  |  |  |  |  |  |  |  |  |  |  |  |  | 5
UFC Connection |  |  |  |  |  |  |  |  |  |  |  |  |  |  |  |  |  | 10
Upper Mixed PCBs |  |  |  |  |  |  |  |  |  |  |  |  |  |  |  |  |  | 5
UIP Connection PCB |  |  |  |  |  |  |  |  |  |  |  |  |  |  |  |  |  | 5
 | 16 Way IC Sockets
 | 2003
 | 2 way pcb headers
 | 3 way pcb headers

Sheet: PCB Version Numbers
FORWARD |  | Final DCS BIOS Check
AMPCD | 001
AMPCD DDI CONNECTION | 001
AP | 002
DDI | 003
FORWARD INPUT DISTRIBUTION | 002
HORNET FORWARD OUTPUT | 002
HORNET FORWARD INPUT | 002
IFEI VIDEO RECORD | 001
RWR (LUKE) | 2.0
UFC | 002
UIP LED DISTRIBUTION | 001
LEFT
ANTENNA SEL | 001
APU | ???
COMM | 002
EXTERIOR LIGHTS | 001
FCS | 002
FUEL PANEL | 001
HYD ISO | 001
LEFT EYEBROW | 001
LEFT INPUT DIST | 002
LEFT OUTPUT DIST | 003
JET STATION SELECT | 002
KY58 | 001
LEFT CIRCUIT BREAKER | ???
LOX | 001
LANDING GEAR | 001
RIGHT EYEBROW | 001
SIM CONTROL | 001
RIGHT
CAUTION | 1
ELEC | 003
R ESS BRKRS | ???
ECS | 001
INT LIGHTS | 001
RISHGT DIST | 001
RIGHT FWD AUX | 001
RIGHT OUTPUT DIST | 003
SNSR | 001
KY58 | 001 |  | Right hand rotary intermittent and not all rows firing TD reversed
MISC
ETHERNET SHIELD I2C (UFC) | 002
GENERAL PURPOSE | 002
MISC LIGHTS | 001
PC POWER DIST (LUKE) | 002
POWER DISTRIBUTION | 002
UFC CONNECTION / PIXEL LED | 001
LEFT
Landing Gear | 001
Sel Jett | 003
 | land

Sheet: Offsets for Lukes Boards
Remember Led Array starts at 0
Name | Version | Total Leds | Non Backlighting Positions
Jett Station Select | 2 | 8
Master Arm | TBA | 29
 |  |  | 0 | READY – LEFT
 |  |  | 1 | DISCH – LEFT
 |  |  | 2 | READY – RIGHT
 |  |  | 3 | DISCH – RIGHT
 |  |  | 25 | A/A – LEFT
 |  |  | 26 | A/A – RIGHT
 |  |  | 27 | A/G – LEFT
 |  |  | 28 | A/G – RIGHT
ECM Jett | TBA | 78
 |  |  | 74 | JETT
 |  |  | 75 | READY – RIGHT
 |  |  | 76 | READY – CENTER
 |  |  | 77 | READY – LEFT
SPIN | TBA
 | NOTE THE DATA LINE |  | 29 | SPIN – UPPER
 | DOES NOT PASS THRU |  | 36 | SPIN – LOWER
 | MUST BE END OF LINE
AV COOL | 2 | 13
HUD CONTROL | TBA | 56
 | DIDN’T TEST PASS THRU
LDG WING FOLD | NONE | 24
VID RECORD | 2 | 16
KY58 | 2 | 79
SIM CTL | 2 | 61
SNSR | 2 | 58
INTR LT | 2 | 65
ECS | 2 | 63
ELEC | TBA | 63
SELECT JET | TBA | 81
LANDING GEAR | TBA | 21
UIP LED DISTRIBUTION | 1

Sheet: Input Template
 | 0 | 1 | 2 | 3 | 4 | 5 | 6 | 7 | 8 | 9 | 10 | 16
0 | 0 | 1 | 2 | 3 | 4 | 5 | 6 | 7 | 8 | 9 | 10 | 15
1 | 11 | 12 | 13 | 14 | 15 | 16 | 17 | 18 | 19 | 20 | 21 | 31
2 | 22 | 23 | 24 | 25 | 26 | 27 | 28 | 29 | 30 | 31 | 32 | 47
3 | 33 | 34 | 35 | 36 | 37 | 38 | 39 | 40 | 41 | 42 | 43 | 63
4 | 44 | 45 | 46 | 47 | 48 | 49 | 50 | 51 | 52 | 53 | 54 | 79
5 | 55 | 56 | 57 | 58 | 59 | 60 | 61 | 62 | 63 | 64 | 65 | 95
6 | 66 | 67 | 68 | 69 | 70 | 71 | 72 | 73 | 74 | 75 | 76 | 111
7 | 77 | 78 | 79 | 80 | 81 | 82 | 83 | 84 | 85 | 86 | 87 | 127
8 | 88 | 89 | 90 | 91 | 92 | 93 | 94 | 95 | 96 | 97 | 98 | 143
9 | 99 | 100 | 101 | 102 | 103 | 104 | 105 | 106 | 107 | 108 | 109 | 159
10 | 110 | 111 | 112 | 113 | 114 | 115 | 116 | 117 | 118 | 119 | 120 | 175
11 | 121 | 122 | 123 | 124 | 125 | 126 | 127 | 128 | 129 | 130 | 131
12 | 132 | 133 | 134 | 135 | 136 | 137 | 138 | 139 | 140 | 141 | 142
13 | 143 | 144 | 145 | 146 | 147 | 148 | 149 | 150 | 151 | 152 | 153
14 | 154 | 155 | 156 | 157 | 158 | 159 | 160 | 161 | 162 | 163 | 164
15 | 165 | 166 | 167 | 168 | 169 | 170 | 171 | 172 | 173 | 174 | 175
 | 0 | 1 | 2 | 3 | 4 | 5 | 6 | 7 | 8 | 9 | 10
0 | 0 | 1 | 2 | 3 | 4 | 5 | 6 | 7 | 8 | 9 | 10
1 | 11 | 12 | 13 | 14 | 15 | 16 | 17 | 18 | 19 | 20 | 21
2 | 22 | 23 | 24 | 25 | 26 | 27 | 28 | 29 | 30 | 31 | 32
3 | 33 | 34 | 35 | 36 | 37 | 38 | 39 | 40 | 41 | 42 | 43
4 | 44 | 45 | 46 | 47 | 48 | 49 | 50 | 51 | 52 | 53 | 54
5 | 55 | 56 | 57 | 58 | 59 | 60 | 61 | 62 | 63 | 64 | 65
6 | 66 | 67 | 68 | 69 | 70 | 71 | 72 | 73 | 74 | 75 | 76
7 | 77 | 78 | 79 | 80 | 81 | 82 | 83 | 84 | 85 | 86 | 87
8 | 88 | 89 | 90 | 91 | 92 | 93 | 94 | 95 | 96 | 97 | 98
9 | 99 | 100 | 101 | 102 | 103 | 104 | 105 | 106 | 107 | 108 | 109
10 | 110 | 111 | 112 | 113 | 114 | 115 | 116 | 117 | 118 | 119 | 120
11 | 121 | 122 | 123 | 124 | 125 | 126 | 127 | 128 | 129 | 130 | 131
12 | 132 | 133 | 134 | 135 | 136 | 137 | 138 | 139 | 140 | 141 | 142
13 | 143 | 144 | 145 | 146 | 147 | 148 | 149 | 150 | 151 | 152 | 153
14 | 154 | 155 | 156 | 157 | 158 | 159 | 160 | 161 | 162 | 163 | 164
15 | 165 | 166 | 167 | 168 | 169 | 170 | 171 | 172 | 173 | 174 | 175
 | 0 | 1 | 2 | 3 | 4 | 5 | 6 | 7 | 8 | 9 | 10
0 | 0 | 1 | 2 | 3 | 4 | 5 | 6 | 7 | 8 | 9 | 10
1 | 11 | 12 | 13 | 14 | 15 | 16 | 17 | 18 | 19 | 20 | 21
2 | 22 | 23 | 24 | 25 | 26 | 27 | 28 | 29 | 30 | 31 | 32
3 | 33 | 34 | 35 | 36 | 37 | 38 | 39 | 40 | 41 | 42 | 43
4 | 44 | 45 | 46 | 47 | 48 | 49 | 50 | 51 | 52 | 53 | 54
5 | 55 | 56 | 57 | 58 | 59 | 60 | 61 | 62 | 63 | 64 | 65
6 | 66 | 67 | 68 | 69 | 70 | 71 | 72 | 73 | 74 | 75 | 76
7 | 77 | 78 | 79 | 80 | 81 | 82 | 83 | 84 | 85 | 86 | 87
8 | 88 | 89 | 90 | 91 | 92 | 93 | 94 | 95 | 96 | 97 | 98
9 | 99 | 100 | 101 | 102 | 103 | 104 | 105 | 106 | 107 | 108 | 109
10 | 110 | 111 | 112 | 113 | 114 | 115 | 116 | 117 | 118 | 119 | 120
11 | 121 | 122 | 123 | 124 | 125 | 126 | 127 | 128 | 129 | 130 | 131
12 | 132 | 133 | 134 | 135 | 136 | 137 | 138 | 139 | 140 | 141 | 142
13 | 143 | 144 | 145 | 146 | 147 | 148 | 149 | 150 | 151 | 152 | 153
14 | 154 | 155 | 156 | 157 | 158 | 159 | 160 | 161 | 162 | 163 | 164
15 | 165 | 166 | 167 | 168 | 169 | 170 | 171 | 172 | 173 | 174 | 175
