bnepethomas/bne-arduino-flight-simulator-interfaces/F16/PTs_F_16SwitchMappings_Callbacks.xls

Sheet: Notes & Legend
F-16 Cockpit Panel Switch Mappings
This spreadsheet contains switch and indicator information presented by individual panel for the F-16 block 50. The particular configuration
of panels is intended to match that being implemented by the USAF under the Common Configutation Implementation Program (see
further information on CCIP at: http://www.lmtas.com/news/press/f16/f16pr990908.html)
The information presented here is gathered from public sources.
Those sources include publicly available documentation, commercial and game software, information provided without non-disclosure
requirements, public bulletin boards and some guesswork based on line art and photographic dipictions of the F-16 cockpit.
Information on switches and buttons is presented on a single tab per physical separate panel
Panels are listed roughly in left to right order starting at the aft end of the left rear console and working forward and around to the right rear console
Legend and key
Switch name | Describes the intended purpose for the switch
Number of poitions | Number of distinct physical switch positions that are required
Switch type | Push button, toggle, guarded toggle, locking toggle, lighted button, potentiometer, etc. (toggles are "bats" unless noted)
Switch Positions | describes on and off states that the switch can support, listed bottom to top relative to engraved legend orientation
(on) | parenthesis denote a switch Positions position that is momentary
[off] | Brackets denote a switch Positions position that locks mechanically in place
{on} | Curly brackets denote a switch Positions position that is mechanically actuated or solenoid actuated
Position names | Legends engraved on the panel surface
Notes | additional explanatory information
NB: Potentiometers are 10k linear unless otherwise noted.
NB: copy the sheet labeled "Panel template" to start a new panel description
NB: in many cases it is assumed that a two position switch can be mechanized and wired as an on (connected) and off (no connect)
this presumes the use of EPIC (or similar device) to connect the switch wires to that does not require both switch positions to each generate a
connected signal. Avoiding the need for two pole, on-on switches will reduce BoM cost for the switch package.
Similar logic is applied to three position switches.
Questions, corrections, additions or comments welcome! Please send those to: Mark Doran, boxer@simhq.com
Special thanks to Ido Dekkers for help filling in the left aux panels
Aditions by Nikolas Anastassopoulos: Added MFD's, ACES II, Caution Panel. Added callbacks and Lightbit values.

Sheet: Summary
Panel Name | No Of Leds | Switch Poles | Lights | Guage | LightsPoles |  |  |  | Backlit |  | Backlit Totals
 | 539 | 195 | 43 |  | inc 2 for Leds
Test | 26 | 0 |  |  | 5 | 10 |  |  | 1
Anti-G | 3 | 0 |  |  | 5 | 10 |  |  | 1
Flt control | 17 | 2 | 2 |  | 9 | 10 |  |  | 1
Manual Trim | 20 | 1 |  | 2 | 6 | 10 |  |  | 1
Fuel |  | 6 |  |  | 11 | 16 |  |  | 1
Aux Comm | 18 | 7 |  |  | 12 | 16 |  |  | 1
Ext Lighting | 31 | 5 |  |  | 10 | 10 |  |  | 1
EPU | 11 | 2 | 3 |  | 10 | 10 |  |  | 1
Elect | 9 | 3 | 8 |  | 16 | 16 |  |  | 1
AVTR | 22 | 2 | 1 |  | 8 | 10 |  |  | 1
ECM | 8 | 0 |  |  | 5 | 10 |  |  | 1
Jet Start |  | 2 | 1 |  | 8 | 10 |  |  | 1
Audio2 | 13 | 0 |  |  | 5 | 10 |  |  | 1
Audio | 35 | 0 |  |  | 5 | 10 |  |  | 1
UHF | 48 | 0 |  |  | 5 | 10 |  |  | 1
Manual Pitch |  | 1 |  |  | 6 | 10 |  |  | 1
Threat Warn Aux |  | 3 | 4 |  | 12 | 16 |  |  | 1
CMDS | 47 | 15 |  |  | 20 | 20 |  |  | 1
Gear Panel | 15 | 10 | 4 |  | 19 | 20 |  |  | 1
MISC | 28 | 10 | 1 |  | 16 | 16 | 69 | 24 | 1 |  | 20
Threat Warn Prim |  | 5 | 6 |  | 16 | 16 |  |  | 0 | 5.28
Eyebrow Lights L |  | 2 | 2 |  | 9 | 10 |  |  | 0
Eyebrow Lights R |  | 0 | 5 |  | 10 | 10 |  |  | 0 | 7.48
Indexer L |  | 0 | 3 |  | 8 | 10 |  |  | 0
Indexer R |  | 0 | 3 |  | 8 | 10 |  |  | 0
ICP |  | 25 |  |  | 30 | 28 |  |  | 0 | 39.4944
INSTR | 13 | 4 |  |  | 9 | 10 | 43 | 19 | 0
HIS |  | 0 |  |  | 5 | 10 |  |  | 0
Fuel Qty Select | 7 | 7 |  |  | 12 | 16 |  |  | 0
Caution Panel |  |  |  |  |  |  |  |  | 0
Sensor Power | 14 | 5 |  |  | 10 | 10 | 83 | 0 | 1 |  | 11
HUD Control | 18 | 14 |  |  | 19 | 20 |  |  | 1
Nuclear consent |  | 0 |  |  | 5 | 10 |  |  | 1
Lighting | 23 | 0 |  |  | 5 | 10 |  |  | 1
Master Zeroize |  | 1 |  |  | 6 | 10 |  |  | 1
Air Cond | 20 | 4 |  |  | 9 | 10 |  |  | 1
Oxy Reg | 18 | 0 |  |  | 5 | 10 |  |  | 1
KY-58 | 27 | 0 |  |  | 5 | 10 |  |  | 1
Avionics Power | 32 | 13 |  |  | 18 | 20 |  |  | 1
Anti-Ice | 16 | 0 |  |  | 5 | 10 |  |  | 1
DTU |  | 0 |  |  | 5 | 10 |  |  | 1
OBOGS Monitor |  | 0 |  |  | 5 | 10 |  |  | 0
Left MFd |  | 22 |  |  | 27 | 28 |  |  | 0
Right MFD |  | 22 |  |  | 27 | 28 |  |  | 0
Other |  | 2 |  |  | 7 | 10 |  |  | 0
ACES-II
Additional Pins needed per panel
Backlighting Gnd
Backlighting +Vcc
Switch Common
Indicaticator +28V
Indicator +12V
Ground
32 Inputs per Input, 1 is ground, 34 +Vcc

Sheet: Panel Template
Switch Name | # of poles | Switch type | Positions | Postion names | Notes | Callback | Lightbits1 | Lightbits2 | Lightbits3 | HSIbits
<<< Use edit->move or copy sheet… to make a new panel template >>>

Sheet: Test
Switch Name | # of poles | Call Back | Pole Totals | Switch type | Positions | Postion names | Notes | Callback | Lightbits1 | Lightbits2 | Lightbits3 | HSIbits
 |  |  | 0
EPU gen | 2 | 0 | 0 | toggle | off-on | off-epu gen
PROBE HEAT | 3 | 0 | 0 | toggle | on-off-on | test-off-probe heat
FIRE & OHEAT DETECT | 2 | 0 | 0 | push | off-(on) | n/a
OXY | 2 | 0 | 0 | toggle | off-on | off-QTY
MAL & IND LTS | 2 | 0 | 0 |  |  | n/a
A B C D | 0 | 0 | 0 | indicator light | none | C A D B quartered markings on legend tile
test maint | 3 | 0 | 0 | locking toggle | on-off-on | Maint, norm, test
16
25
Have 20 Switches

Sheet: Anti-G
Switch Name | # of poles | Call Back | Pole Totals | Switch type | Positions | Postion names | Notes | Callback | Lightbits1 | Lightbits2 | Lightbits3 | HSIbits
 |  |  | 0
test | 2 | 0 | 0 | push | off-(on) | Test
4
9

Sheet: Flt Control
Switch Name | # of poles | Call Back | Pole Totals | Switch type | Positions | Postion names | Notes | Callback | Lightbits1 | Lightbits2 | Lightbits3 | HSIbits
 |  |  | 2
DIGITAL | 2 | 0 | 0 | locking toggle | [off]-[on] | off-backup
ALT FALPS | 2 | 0 | 1 | locking toggle | [off]-[on] | norm-extend |  | SimAltFlapsNorm,SimAltFlapsExtend
MANUAL TF FLYUP | 2 | 0 | 0 | locking toggle | [off]-[on] | disable-enable
LE FLAPS | 2 | 0 | 1 | locking toggle | [off]-[on] | auto-lock |  | SimLEFAuto?,SimLEFLock
FLCS | 2 | 0 | 0 | momentary toggle | (on)-off | reset-off
BIT / OFF | 2 | 0 | 0 | locking toggle | [off]-[on] | OFF, BIT
RUN FAIL | 0 | 0 | 0 | indicator light | none | n/a, RUN FAIL legend lights when pressed |  |  |  |  | Lef_Fault = $800
11
15

Sheet: Manual Trim
Switch Name | # of poles | Call Back | Pole Totals | Switch type | Positions | Postion names | Notes | Callback | Lightbits1 | Lightbits2 | Lightbits3 | HSIbits
 |  |  | 1
Pitch Trim | 1 | 0 | 0 | encoder with center detent | thumbwheel |  | light stripe showing position | BMS analog axis or SimTrimNoseUp,SimTrimNoseDown
Roll Trim | 1 | 0 | 0 | encoder with center detent | thumbwheel |  | light stripe showing position | BMS analog axis or SimTrimRollLeft,SimTrimRollRight
Yaw Trim | 1 | 0 | 0 | encoder with center detent | thumbwheel |  | light stripe showing position | BMS analog axis or SimTrimYawLeft,SimTrimYawRight
Trim /AP DISC | 2 | 1 | 1 | locking toggle | [off]-[on] | norm, disc |  | SimTrimAPNORM,SimTrimAPDISC
13
15

Sheet: Fuel
Switch Name | # of poles | Call Back | Pole Totals | Switch type | Positions | Postion names | Notes | Callback | Lightbits1 | Lightbits2 | Lightbits3 | HSIbits
 |  |  | 6
MASTER | 2 | 1 | 1 | guarded toggle | off-on | OFF, MASTER | Guarded in MASTER | SimMasterFuelOff,SimMasterFuelOn |  |  |  |  | KEY_FUEL_SELECTOR_OFF
TANK INERTING | 2 | 0 | 0 | toggle | off-on | OFF-TANK INERTING ??????
ENG FEED | 4 | 1 | 4 | rotary knob | on-on-on-on | OFF, NORM, AFT, FWD | (4x45 deg) | SimFuelPumpOff,SimFuelPumpNorm,SimFuelPumpAft,SimFuelPumpFwd
AIR REFUEL | 2 | 1 | 1 | toggle | off-on | CLOSE, OPEN |  | SimFuelDoorOpen,SimFuelDoorClose?
9
15

Sheet: Aux Comm
Switch Name | # of poles | Call Back | Pole Totals | Switch type | Positions | Postion names | Notes | Callback | Lightbits1 | Lightbits2 | Lightbits3 | HSIbits
 |  |  | 7
MASTER | 5 | 1 | 4 | Rotary knob | on-on-on-on-on | off, STBY, LOW, NORM, EMER | (5x36 deg) | SimToggleAuxComMaster
M-4 CODE | 3 | 0 | 0 | locking toggle | [on]-[off]-[on] | hold, a/b, zero
CNI | 2 | 1 | 1 | Rotary knob | on-off | BACK UP, UFC | (2x36 deg) | SimAuxComBackup,SimAuxComUFC
REPLY | 3 | 0 | 0 | locking toggle | [off]-[on]-[on] | OUT, A, B
MONITOR | 2 | 0 | 0 | toggle | off-on | OUT, AUDIO
TACAN | 3 | 1 | 2 | toggle | on-off-on | A/A TR-REC-T/R |  | SimTACANAATR,,SimTACANTR
CHANNEL 100's | 10 | 0 | 0 | encoder | cw/ccw | 0-9 inclusive |  | SimCycleLeftAuxComDigit,SimDecLeftAuxComDigit
CHANNEL 10's | 10 | 0 | 0 | encoder | cw/ccw | 0-9 inclusive |  | SimCycleCenterAuxComDigit,SimDecCenterAuxComDigit
CHANNEL 1's | 10 | 0 | 0 | encoder | cw/ccw | 0-9 inclusive |  | SimCycleRightAuxComDigit,SimDecRightAuxComDigit
channel x/y | 2 | 0 | 0 | encoder | cw/ccw | x, y |  | SimCycleBandAuxComDigit
27
37

Sheet: Ext Lighting
Switch Name | # of poles | Call Back | Pole Totals | Switch type | Positions | Postion names | Notes | Callback | Lightbits1 | Lightbits2 | Lightbits3 | HSIbits
 |  |  | 5
Form | 0 | 0 | 0 | potentiometer | increase clockwise
Master | 2 | 1 | 1 | toggle | [off]-[on] | off, norm | SimExtlMasterOff, SimExtlMasterNorm |  |  |  |  |  | KEY_ALL_LIGHTS_TOGGLE
Aerial Refuling | 0 | 0 | 0 | potentiometer | increase clockwise
Anti Collision | 2 | 1 | 1 | toggle | off-on | off, anti collision | SimAntiCollOff, SimAntiCollOn |  |  |  |  |  | KEY_STROBES_ON,KEY_STROBES_OFF
Flash Steady | 2 | 1 | 1 | toggle | on-off | flash, steady | SimLightsFlash, SimLightsSteady |  |  |  |  |  | KEY_TOGGLE_WING_LIGHTS
Wing Trail | 3 | 1 | 2 | toggle | on-off-on | dim, off, brt | ,SimWingLightOff,SimWingLightBrt |  |  |  |  |  | KEY_TOGGLE_NAV_LIGHTS
Fuselage | 3 | 0 | 0 | toggle | on-off-on | dim, off, brt
16
25

Sheet: EPU
Switch Name | # of poles | Call Back | Pole Totals | Switch type | Positions | Postion names | Notes | Callback | Lightbits1 | Lightbits2 | Lightbits3 | HSIbits
 |  |  | 2
EPU | 3 | 1 | 2 | guarded toggle | off-on-on | OFF-NORMAL-ON | Center guard on NORMAL | SimEpuOff,SimEpuAuto,SimEpuOn
RUN light | 0 | 0 | 0 | indicator light | none | green light |  |  |  | EPUOn = $100000
HYDRAZN-AIR | 0 | 0 | 0 | indicator light | none | HYDRAZN-AIR |  |  |  | Hydrazine = $100,Air = $200
8
9

Sheet: ELEC
Switch Name | # of poles | Call Back | Pole Totals | Switch type | Positions | Postion names | Notes | Callback | Lightbits1 | Lightbits2 | Lightbits3 | HSIbits
 |  |  | 3
MAIN PWR | 3 | 1 | 2 | Locking toggle | [off]-[on]-[on] | OFF, BAT, MAIN PWR |  | SimMainPowerOff,SimMainPowerBatt,SimMainPowerMain
CAUTION RESET | 2 | 1 | 1 | push | off-(on) |  |  | SimWarnReset?
FLCS PMG-MAIN GEN | 0 | 0 | 0 | indicator light | none | FLCS PMG-MAIN GEN |  |  |  | FlcsPmg = $1,MainGen = $2
STBY GEN | 0 | 0 | 0 | indicator light | none | STBY GEN |  |  |  | StbyGen = $4
EPU GEN-EPU / PMG | 0 | 0 | 0 | indicator light | none | EPU GEN-EPU / PMG |  |  |  | EpuGen = $8,EpuPmg = $10
FAIL | 0 | 0 | 0 | indicator light | none | FAIL |  |  |  | BatFail = $80
TO FLCS-FLCS RLY | 0 | 0 | 0 | indicator light | none | TO FLCS-FLCS RLY |  |  |  | ToFlcs = $20,FlcsRly = $40
12
15

Sheet: AVTR
Switch Name | # of poles | Call Back | Pole Totals | Switch type | Positions | Postion names | Notes | Callback | Lightbits1 | Lightbits2 | Lightbits3 | HSIbits
 |  |  | 2
AVTR | 3 | 1 | 2 | toggle | on-off-on | on, auto, off |  | SimAVTRSwitchOff,SimAVTRSwitchAuto,SimAVTRSwitchOn
 |  |  |  |  |  |  | (4x45 deg) |  |  |  |  | AVTR = $2000
5
9

Sheet: ECM
Switch Name | # of poles | Call Back | Pole Totals | Switch type | Positions | Postion names | Notes | Callback | Lightbits1 | Lightbits2 | Lightbits3 | HSIbits
 |  |  | 0
OPR | 3 | 0 | 0 | toggle | off-on-on | OFF-STBY-OPR
DIM | 3 | 0 | 0 | rotary | on-on-on | 1, 2, 3
XMIT | 2 | 0 | 0 | locking toggle | [on]-[off] | xmit, blank
RESET | 2 | 0 | 0 | toggle | (on)-off | reset, blank
BIT | 2 | 0 | 0 | toggle | (on)-off | bit, blank
1 | 0 | 0 | 0 | indicator light | none | S, A, F, T light in corners
2 | 0 | 0 | 0 | indicator light | none | S, A, F, T light in corners
3 | 0 | 0 | 0 | indicator light | none | S, A, F, T light in corners
4 | 0 | 0 | 0 | indicator light | none | S, A, F, T light in corners
5 | 0 | 0 | 0 | indicator light | none | S, A, F, T light in corners
ALT | 0 | 0 | 0 | indicator light | none | S, A, F, T light in corners
FRM | 0 | 0 | 0 | indicator light | none | S, A, F, T light in corners
SPL | 0 | 0 | 0 | indicator light | none | S, A, F, T light in corners
19
25

Sheet: JET START
Switch Name | # of poles | Call Back | Pole Totals | Switch type | Positions | Postion names | Notes | Callback | Lightbits1 | Lightbits2 | Lightbits3 | HSIbits
 |  |  | 2
JET FUEL | 3 | 1 | 2 | locking toggle | [on]-[off]-[on] | START2-OFF-START1 | solenoid pulls to center after start ?? | SimJfsStart |  |  |  |  | KEY_TOGGLE_STARTER1,KEY_TOGGLE_MASTER_IGNITION_SWITCH
ENG CONT | 2 | 0 | 0 | guarded toggle | off-on | SEC-PRI | guarded up to PRI
AB RESET | 3 | 0 | 0 | toggle | (on)-off-(on) | ENG DATA-NORM-AB DATA
MAX POWER | 2 | 0 | 0 | locking toggle | [off]-(on) | OFF-MAX POWER | wire loop guards to left and right
RUN | 0 | 0 | 0 | indicator light | none | green light |  |  |  | JFSOn = $200000
 |  |  |  | 11
 |  |  |  | 15

Sheet: AUDIO2
Switch Name | # of poles | Call Back | Pole Totals | Switch type | Positions | Postion names | Notes | Callback | Lightbits1 | Lightbits2 | Lightbits3 | HSIbits
 |  |  | 0
INTERCOM | 0 | 0 | 0 | potentiometer | increase clockwise
TACAN | 2 | 0 | 0 | potentiometer 10k log | [off]-increase clockwise |  | rotary pot with off switch
ILS | 2 | 0 | 0 | potentiometer 10k log | [off]-increase clockwise |  | rotary pot with off switch
HOT MIC | 3 | 0 | 0 | toggle | on-off-on | CIPHER, OFF, HOT MIC
14
15

Sheet: AUDIO
Switch Name | # of poles | Call Back | Pole Totals | Switch type | Positions | Postion names | Notes | Callback | Lightbits1 | Lightbits2 | Lightbits3 | HSIbits
 |  |  | 0
COMM 1 volume | 2 | 0 | 0 | potetiometer | off-increase clockwise |  | rotary pot with off switch | BMS analog axis or SimStepComm1VolumeDown,SimStepComm1VolumeUp
COMM 1 selector | 3 | 0 | 0 | rotary knob | on-on-on | OFF-SQL-GD | PUSH FOR TONE,(3x45 deg)
COMM 2 volume | 2 | 0 | 0 | potetiometer | off-increase clockwise |  | rotary pot with off switch | BMS analog axis or SimStepComm2VolumeDown,SimStepComm2VolumeUp
COMM 2 selector | 3 | 0 | 0 | rotary knob | on-on-on | OFF-SQL-GD | PUSH FOR TONE,(3x45 deg)
SECURE VOICE | 0 | 0 | 0 | potetiometer | increase clockwise
TF | 0 | 0 | 0 | potetiometer | increase clockwise
MSL | 0 | 0 | 0 | potetiometer | increase clockwise |  |  | BMS analog axis or SimStepMissileVolumeDown,SimStepMissileVolumeUp
THREAT | 0 | 0 | 0 | potetiometer | increase clockwise |  |  | BMS analog axis or SimStepThreatVolumeDown,SimStepThreatVolumeUp
26
37

Sheet: UHF
Switch Name | # of poles | Call Back | Pole Totals | Switch type | Positions | Postion names | Notes | Callback | Lightbits1 | Lightbits2 | Lightbits3 | HSIbits
 |  |  | 0
UHF | 4 | 0 | 0 | rotary | on-on-on-on | OFF-MAIN-BOTH-ADF
TONE | 2 | 0 | 0 | push | off-(on) | tone
VOL | 0 | 0 | 0 | potentiometer | clockwise to increase
SQUELCH | 2 | 0 | 0 | toggle | off-on | OFF-ON
MANUAL | 3 | 0 | 0 | rotary | on-on-on | MANUAL-PRESET-GUARD
Freq 100's | 4 | 0 | 0 | encoder | cw-ccw | A, 3, 2, T
Freq 10's | 10 | 0 | 0 | encoder | cw-ccw | 0-9 inclusive
Freq 1's | 10 | 0 | 0 | encoder | cw-ccw | 0-9 inclusive
Freq 1/10's | 10 | 0 | 0 | encoder | cw-ccw | 0-9 inclusive
Freq 1/1000's | 4 | 0 | 0 | encoder | cw-ccw | 00, 25, 50, 75
CHAN | 20 | 0 | 0 | encoder | cw-ccw | 1-19 inclusive |  | SimCycleRadioChannel,SimDecRadioChannel
EMB | 2 | 0 | 0 | push | off-(on) | ??

Sheet: MANUAL PITCH
Switch Name | # of poles | Call Back | Pole Totals | Switch type | Positions | Postion names | Notes | Callback | Lightbits1 | Lightbits2 | Lightbits3 | HSIbits
 |  |  | 1
MANUAL PITCH | 2 | 1 | 1 | toggle | off-on | OVRD-NORM | Horizontal wire guard loops above and below toggle | SimMPO
4
9

Sheet: Threat warn aux
Switch Name | # of poles | Call Back | Pole Totals | Switch type | Positions | Postion names | Notes | Callback | Lightbits1 | Lightbits2 | Lightbits3 | HSIbits
 |  |  | 3
Search | 2 | 1 | 1 | on/off lighted push | off-on | search |  | SimRWRSetSearch |  | AuxSrch = $1000
activity power | 2 | 0 | 0 | on/off lighted push | off-on | activity power |  |  |  | AuxAct = $2000
Low priority | 2 | 1 | 1 | on/off lighted push | off-on | low |  | SimRWRSetGroundPriority? |  | AuxLow = $4000
system power | 2 | 1 | 1 | on/off lighted push | off-on | power |  | SimRwrPower |  | AuxPwr = $8000
fuse | 0 | 0 | 0 | fuse holder | none | n/a
Dimmer | 0 | 0 | 0 | potentiometer | rotary | n/a | no EPIC connection
15
25

Sheet: CMDS
Switch Name | # of poles | Call Back | Pole Totals | Switch type | Positions | Postion names | Notes | Callback | Lightbits1 | Lightbits2 | Lightbits3 | HSIbits
 |  |  | 15
RWR | 2 | 1 | 1 | toggle | off-on | off, on |  | SimEWSRWROn ,SimEWSRWROff
JMR | 2 | 1 | 1 | toggle | off-on | off, on |  | SimEWSJammerOn ,SimEWSJammerOff
MWS | 2 | 0 | 0 | toggle | off-on | off, on
01 | 2 | 0 | 0 | toggle | off-on | off, on
02 | 2 | 0 | 0 | toggle | off-on | off, on
CH | 2 | 1 | 1 | toggle | off-on | off, on |  | SimEWSChaffOff,SimEWSChaffOn
FL | 2 | 1 | 1 | toggle | off-on | off, on |  | SimEWSFlareOff,SimEWSFlareOn
JETT | 2 | 0 | 0 | locking toggle | off-on | off, JETT
PRGM | 5 | 1 | 5 | rotary | on-on-on-on-on | bit, 1, 2, 3, 4, 5 | (5x36 deg) | SimEWSProgOne,SimEWSProgTwo,SimEWSProgThree,SimEWSProgFour
MODE | 6 | 1 | 6 | rotary | on-on-on-on-on-on | off, stby, man, semi, auto, byp | (6x30 deg) | SimEWSModeOff,SimEWSModeStby,SimEWSModeMan,SimEWSModeSemi,SimEWSModeAuto,
STATUS NO GO | 0 | 0 | 0 | green indicator light | n/a | NO GO (green lit legend)
STATUS GO | 0 | 0 | 0 | green indicator light | n/a | GO (green lit legend)
STATUS READY | 0 | 0 | 0 | green indicator light | n/a | READY TO DISPENSE (green lit legend)
NB: This panel replaces the CHAFF/FLARE panel that was fitted in the earlier block 50/52's
See: http://www.189th-vfs.com/XIS/Blk50ColorMFDv3.jpg &
http://www.189th-vfs.com/Sixshooters/Images/BLK60ckpit.jpg
NB: Panel also includes a 1 line alphanumeric display for counts of consumables (appears below the no-go/go/ready lights)
This panel may be best implemented with 4 sets of three figure seven segment displays. Need more info on mechanization
of messages that appear in the windows to be sure on the approach here.

Sheet: Gear panel
Switch Name | # of poles | Call Back | Pole Totals | Switch type | Positions | Postion names | Notes | Callback | Lightbits1 | Lightbits2 | Lightbits3 | HSIbits
 |  |  | 10
Emergency jettison | 2 | 1 | 1 | guarded push | off-(on) | n/a | breakable cover over recessed pushbutton | SimEmergencyJettison
wheel lights | 0 | 0 | 0 | 3 x green lights | none | n/a |  |  |  |  | NoseGearDown = $10000,LeftGearDown = $20000,RightGearDown = $40000
Hook | 2 | 1 | 1 | lever locking toggle | [off]-[on] | dn, up |  | SimHookUp,SimHookDown |  |  |  |  | KEY_TOGGLE_TAIL_HOOK_HANDLE
Ground jettison | 2 | 1 | 1 | locking toggle | [off]-[on] | off, enable |  | SimGndJettOn, SimGndJettOff
Brakes | 2 | 0 | 0 | toggle | off-on | chan 2, chan 1
Parking brake | 3 | 1 | 2 | locking toggle | [off]-[on]-[on] | off, anti skid, brake |  | SimParkingBrakeOff, ,SimParkingBrakeOn |  |  |  |  | KEY_PARKING_BRAKES
Stores | 2 | 1 | 1 | toggle | off-on | cat III, cat I |  | SimCATIII,SimCATI
Horn silencer | 2 | 1 | 1 | push | off-(on) | n/a |  | SimSilenceHorn
Landing lights | 3 | 1 | 2 | locking t handle toggle | [on]-[off]-[on] | taxi, off, landing |  | ,SimLandingLightOn, SimLandingLightOff |  |  |  |  | KEY_TOGGLE_TAXI_LIGHTS,KEY_LANDING_LIGHTS_ON
Down lock release | 2 | 0 | 0 | push | off-(on) | n/a
Gear down enable | 2 | 0 | 0 | push | off-(on) | n/a | mounted on the arm of the gear handle
Gear handle | 2 | 1 | 1 | lollipop lever | off-on | (down and up) |  | AFGeapUp,AFGearDown |  |  |  |  | KEY_GEAR_UP,KEY_GEAR_DOWN
Gear warning light | 0 | 0 | 0 | yellow light | none | n/a | mounted in lollipop end of the gear handle |  |  | GEARHANDLE = $40000000
21
25

Sheet: MISC
Switch Name | # of poles | Call Back | Pole Totals | Switch type | Positions | Postion names | Notes | Callback | Lightbits1 | Lightbits2 | Lightbits3 | HSIbits
 |  |  | 10
RF quiet | 2 | 1 | 2 | locking toggle | [off]-[on] | silent, rf norm |  | SimRFNorm,SimRFQuiet,SimRFSilent
ECM light | 0 | 0 | 0 | green light | none | n/a |  |  |  | EcmPwr = $10000?
Laser arm | 2 | 1 | 1 | locking toggle | [off]-[on] | off, arm |  | SimLaserArmOn, SimLaserArmOff
Alternate release | 2 | 1 | 1 | push | off-(on) | n/a |  | SimPickle
Master arm | 3 | 1 | 2 | locking toggle | [on]-[off]-[on] | simulate, off, arm |  | SimSimMasterArm,SimSafeMasterArm,SimArmMasterArm
ADV mode | 0 | 0 | 0 | indicator light tile | none | active/standby
Autopilot pitch | 3 | 1 | 2 | locking toggle | [on]-[off]-[on] | att hold, a-p off, alt hold |  | SimRightAPDown,SimRightAPMid,SimRightAPUp |  |  |  |  | KEY_AP_ATT_HOLD_ON, ,KEY_AP_ALT_HOLD_ON
Autopilot roll | 3 | 1 | 2 | toggle | on-off-on | strg sel, att hold, hdg sel |  | SimLeftAPDown,SimLeftAPMid,SimLeftAPUp |  |  |  |  | KEY_AP_HDG_HOLD_ON
 |  |  |  | 15
 |  |  |  | 25

Sheet: Threat warn prime
Switch Name | # of poles | Call Back | Pole Totals | Switch type | Positions | Postion names | Notes | Callback | Lightbits1 | Lightbits2 | Lightbits3 | HSIbits
 |  |  | 5
Handoff | 2 | 1 | 1 | push | off-(on) | n/a | Green illumination on push to select handoff mode | SimRWRHandoff |  | HandOff = $1
Priority | 2 | 1 | 1 | push | off-(on) | n/a | Green illumination on push to select priority threat mode | SimRWRSetPriority |  | PriMode = $4
Target separate | 2 | 1 | 1 | push | off-(on) | n/a | Green illuminaiton on push to separate target symbols | SimRWRSetTargetSep |  | TgtSep = $20
Missile Launch | 0 | 0 | 0 | indicator light tile | none | n/a | Red light |  |  | Launch = $2
system test | 2 | 0 | 0 | push | off-(on) | n/a | Green light on push
Unknown/naval | 2 | 1 | 2 | push | off-(on) | n/a | Green light on push | SimRWRSetNaval,SimRWRSetUnknowns |  | Naval = $8,Unk = $10
15
25
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
