bnepethomas/bne-arduino-flight-simulator-interfaces/A10/A10 Documentation/A10_Switch_Led_Mappings.ods

Sheet: Instructions
NOTE ALL ROWS AND COLUMNS START AT 0
Leds
Copy the an 8*8 template cell block from the Led Template to Columns A-I on the appropriate sheet. Update the panel name.
Start with panel pcb by itself. Connect it starting at Col 0 and Row 0. Using the Max7219_Test_Harness sketch step through the 64 positions filling in the colours on the standalone block. If the bezel name is known, assign it to the cell.
The order displayed by the Max7219_Test_Harness makes it easier to copy and the references into the led driver for DCSBIOS code (eg DCSBIOS_Max7219)
Once all of the individual led pcbs have been mapped out, merge them into a block in columns K-S, assign a name for each block. Draw a border around each pcb
Place pcb connectors in final position and validate row column outputs are as expected.
Inputs
Connect the pcb to expected row column location using the non-polarised headers on the input pcb. Remembering some of the pcbs use only 5 of the 6, or 7 of the 8, connectors
Colour a block of the expected inputs used, remembering there are 11 inputs per row.
As each button is pressed, change the text colour of the number in the upper block from Black to Red
There are likely to be gaps in inputs used, when completed, remove the fill from unused cells are the can be used for smaller panels.

Sheet: Outputs
 |  | OLEDS | Stepper | Zero Sense | Standard | Max 7219 | Servos
 |  | 8 | 13 |  | 0 | 0 | 1
Forward Console
Altimeter |  | 2 | 1 | 1
Clock |  | 1 | 1
CMSP |  | 1
ILS |  | 1
MWS |  | 1
TACAN |  | 1
SARI |  |  | 1 | 1 |  |  | 1
VSI |  |  | 1
AOA |  |  | 1
Speed Current |  |  | 1
Speed Max |  |  | 1
G-Force |  |  | 1
Flaps
Right Distribution
Fuel Panel |  | 1 | 4
Compass |  |  | 1 | 1
Standard
Left Distribution
Servos | Radar Alt Flag
 | Batt E
 | Batt L
 | PRS1
 | PRS2
Steppers | Radar Alt
Standard | Bleed Air
 | Pitot
 | Laser
 | Canopy
LIP
Steppers | Cabin Altitude
IFEI (need analog input as well)

Sheet: Leds
Mapping of Led Outs for individual PCBS
Connect PCB under test starting at Row 0 and Col 0
Then Combined Results – for initial sweep just colour Cell
ROWS ARE ANODES
Look at separate Boards for LIP and UIP – side consoles can come to LIP
Left Console
 | Col
Row | 0 | 1 | 2 | 3 | 4 | 5 | 6 | 7
0 | NO GO | R BLEED | STBY | REC | XMIT | ASPJ OH
1 | NO GO | R BLEED | STBY | REC | XMIT | ASPJ OH
2 | GO | L BLEED | SPD BRK | L BAR | L BAR
3 | GO | L BLEED | SPD BRK | L BAR | L BAR
4 |  | MSTR CAUT | MSTR CAUT
5 |  | MSTR CAUT | MSTR CAUT
6 |  | LEFT FIRE | LEFT FIRE
7 |  | LEFT FIRE | LEFT FIRE
Fwd Combined IO | D4 | Ready |  | A_10C:defineIndicatorLight("AIR_REFUEL_READY", 730, "HUD", "Air Refuel READY Light (green)")
Fwd Combined IO | D5 | Latched |  | A_10C:defineIndicatorLight("AIR_REFUEL_LATCHED", 731, "HUD", "Air Refuel LATCHED Light (green)")
Fwd Combined IO | D6 | Disconnect |  | A_10C:defineIndicatorLight("AIR_REFUEL_DISCONNECT", 732, "HUD", "Air Refuel DISCONNECT Light (green)")
Fwd Combined IO | D7 | Steer |  | A_10C:defineIndicatorLight("NOSEWHEEL_STEERING", 663, "Front Dash", "Nosewheel Steering Indicator (green)")
Fwd Combined IO | D8 | Gun Ready |  | A_10C:defineIndicatorLight("GUN_READY", 662, "Front Dash", "GUN READY Indicator (green)")
Fwd Combined IO | D9 | Marker Beacon |  | A_10C:defineIndicatorLight("MARKER_BEACON", 664, "Front Dash", "MARKER BEACON Indicator (green)")
Fwd Combined IO | D11 | Canopy Unlocked |  | A_10C:defineIndicatorLight("CANOPY_UNLOCKED", 665, "Front Dash", "CANOPY UNLOCKED Indicator (green)")
Fwd Combined IO | D54 | Fire Handle Left |  | A_10C:defineIndicatorLight("L_ENG_FIRE", 215, "Glare Shield", "Left Engine Fire Indicator (yellow)")
Fwd Combined IO | D55 | Fire Handle Right |  | A_10C:defineIndicatorLight("R_ENG_FIRE", 217, "Glare Shield", "Right Engine Fire Indicator (yellow)")
Fwd Combined IO | D56 | APU Fire |  | A_10C:defineIndicatorLight("APU_FIRE", 216, "Glare Shield", "APU Fire Indicator (yellow)")
Fwd Combined IO | D57 | Gear Handle |  | A_10C:defineIndicatorLight("HANDLE_GEAR_WARNING", 737, "Landing Gear and Flap Control Panel", "Handle Gear Warning Light (red)")
Fwd Combined IO | D58 | Caution Lamp |  | A_10C:defineIndicatorLight("MASTER_CAUTION", 404, "UFC", "Master Caution Light (yellow)")
Fwd Combined IO | D59 | PRI Lamp |  | A_10C:defineIndicatorLight("CMSC_PRIO", 373, "CMSC", "Priority Status Indicator (green)")
Fwd Combined IO | D60 | SEP Lamp |  | A_10C:defineIndicatorLight("CMSC_UNKN", 374, "CMSC", "Unknown Status Indicator (green)")
Fwd Combined IO | D61 | Missile Lamp |  | A_10C:defineIndicatorLight("CMSC_LAUNCH", 372, "CMSC", "Missile Launch Indicator (red)")
Fwd Combined IO | D62 | HARS Lamp |  | A_10C:defineIndicatorLight("NMSP_HARS_LED", 606, "NMSP", "HARS Button LED (green)")
Fwd Combined IO | D63 | EGI Lamp |  | A_10C:defineIndicatorLight("NMSP_EGI_LED", 608, "NMSP", "EGI Button LED (green)")
Fwd Combined IO | D64 | TISL Lamp |  | A_10C:defineIndicatorLight("NMSP_TISL_LED", 610, "NMSP", "TISL Button LED (green)")
Fwd Combined IO | D65 | STR PT Lamp |  | A_10C:definePushButton("NMSP_STEERPT_BTN", 46, 3004, 611, "NMSP", "STEERPT Button")
Fwd Combined IO | D66 | ANCHR Lamp |  | A_10C:defineIndicatorLight("NMSP_ANCHR_LED", 614, "NMSP", "ANCHR Button LED (green)")
Fwd Combined IO | D67 | TCN Lamp |  | A_10C:defineIndicatorLight("NMSP_TCN_LED", 616, "NMSP", "TCN Button LED (green)")
Fwd Combined IO | D68 | ILS Lamp |  | A_10C:defineIndicatorLight("NMSP_ILS_LED", 618, "NMSP", "ILS Button LED (green)")
Fwd Combined IO | D69 | Anti Skid Coil |  | A_10C:defineElectricallyHeldSwitch("ANTI_SKID_SWITCH", 38, 3028, 3029, 654, "Landing Gear and Flap Control Panel", "Anti-Skid Switch")
NEED TO EITHER |  | AOA High |  | A_10C:defineIndicatorLight("AOA_INDEXER_HIGH", 540, "HUD", "AOA Indexer High (green)")
PATCH OR ADD TO |  | AOA On |  | A_10C:defineIndicatorLight("AOA_INDEXER_NORMAL", 541, "HUD", "AOA Indexer Normal (green)")
RIGHT CONSOLE |  | AOA Low |  | A_10C:defineIndicatorLight("AOA_INDEXER_LOW", 542, "HUD", "AOA Indexer Low (green)")
Right Console |  | TACAN TEST |  | A_10C:defineIndicatorLight("TACAN_TEST", 260, "TACAN Panel", "TACAN Test Indicator Light (green)")
Fwd OLED | D4 | GEAR – NOSE |  | A_10C:defineIndicatorLight("GEAR_N_SAFE", 659, "Landing Gear and Flap Control Panel", "Nose Gear Safe (green)")
Fwd OLED | D3 | GEAR – LEFT |  | A_10C:defineIndicatorLight("GEAR_L_SAFE", 660, "Landing Gear and Flap Control Panel", "Left Gear Safe (green)")
Fwd OLED | D2 | GEAR – RIGHT |  | A_10C:defineIndicatorLight("GEAR_R_SAFE", 661, "Landing Gear and Flap Control Panel", "Right Gear Safe (green)")
Left Console I/O Rotary | D5 | YAW LEFT |  | A_10C:defineElectricallyHeldSwitch("SASP_YAW_SAS_L", 38, 3003, 3004, 185, "SAS Panel", "Yaw SAS Left OFF - ENGAGE")
Left Console I/O Rotary | D4 | YAW RIGHT |  | A_10C:defineElectricallyHeldSwitch("SASP_YAW_SAS_R", 38, 3005, 3006, 186, "SAS Panel", "Yaw SAS Right OFF - ENGAGE")
Left Console I/O Rotary | D3 | PITCH LEFT |  | A_10C:defineElectricallyHeldSwitch("SASP_PITCH_SAS_L", 38, 3007, 3008, 187, "SAS Panel", "Pitch SAS Left OFF - ENGAGE")
Left Console I/O Rotary | D2 | PITCH RIGHT |  | A_10C:defineElectricallyHeldSwitch("SASP_PITCH_SAS_R", 38, 3009, 3010, 188, "SAS Panel", "Pitch SAS Right OFF - ENGAGE")
Left Console I/O Rotary | D0 D1 | T/O Trim |  | A_10C:defineIndicatorLight("TAKE_OFF_TRIM", 191, "SAS Panel", "TAKEOFF TRIM Indicator Light (green)")
Right Console |  | OXY Flow |  | A_10C:defineIndicatorLight("OXY_FLOW", 600, "Oxygen Regulator Panel", "Flow Indicator (on/off) (white)")
MISSING FORMATION |  |  |  | A_10C:defineFloatFromDrawArgument("EXT_FORMATION_LIGHTS", 200, "External Aircraft Model", "Formation Lights (light green)")
Left Console I/O Rotary | D7 |  |  | A_10C:defineBitFromDrawArgument("EXT_POSITION_LIGHT_LEFT", 190, "External Aircraft Model", "Left Position Light (red)")
 |  |  |  | A_10C:defineBitFromDrawArgument("EXT_POSITION_LIGHT_RIGHT", 191, "External Aircraft Model", "Right Position Light (green)")
 |  |  |  | A_10C:defineBitFromDrawArgument("EXT_STROBE_TAIL", 192, "External Aircraft Model", "Tail Strobe Light (white)")
Left Console I/O Rotary | D8 |  |  | A_10C:defineBitFromDrawArgument("EXT_STROBE_LEFT", 195, "External Aircraft Model", "Left Strobe Light (white)")
 |  |  |  | A_10C:defineBitFromDrawArgument("EXT_STROBE_RIGHT", 196, "External Aircraft Model", "Right Strobe Light (white)")
Left Console I/O Rotary | D9 |  |  | A_10C:defineFloat("INT_FLOOD_L_BRIGHT", 806, { 0, 1 }, "Light System Control Panel", "Flood Light Brightness")
Left Console I/O Rotary | D11 |  |  | A_10C:defineFloat("INT_CONSOLE_L_BRIGHT", 800, { 0, 1 }, "Light System Control Panel", "Console Light Brightness")
 |  |  |  | A_10C:defineIndicatorLight("CL_A1", 480, "Caution Lights Panel", "ENG START CYCLE Light (green)")
 |  |  |  | A_10C:defineIndicatorLight("CL_A2", 481, "Caution Lights Panel", "L-HYD PRESS Light (green)")
 |  |  |  | A_10C:defineIndicatorLight("CL_A3", 482, "Caution Lights Panel", "R-HYD PRESS Light (green)")
 |  |  |  | A_10C:defineIndicatorLight("CL_A4", 483, "Caution Lights Panel", "GUN UNSAFE Light (green)")
 |  |  |  | A_10C:defineIndicatorLight("CL_B1", 484, "Caution Lights Panel", "ANTI-SKID Light (green)")
 |  |  |  | A_10C:defineIndicatorLight("CL_B2", 485, "Caution Lights Panel", "L-HYD RES Light (green)")
 |  |  |  | A_10C:defineIndicatorLight("CL_B3", 486, "Caution Lights Panel", "R-HYD RES Light (green)")
 |  |  |  | A_10C:defineIndicatorLight("CL_B4", 487, "Caution Lights Panel", "OXY LOW Light (green)")
 |  |  |  | A_10C:defineIndicatorLight("CL_C1", 488, "Caution Lights Panel", "ELEV DISENG Light (green)")
 |  |  |  | A_10C:defineIndicatorLight("CL_C2", 489, "Caution Lights Panel", "VOID1 Light (green)")
 |  |  |  | A_10C:defineIndicatorLight("CL_C3", 490, "Caution Lights Panel", "SEAT NOT ARMED Light (green)")
 |  |  |  | A_10C:defineIndicatorLight("CL_C4", 491, "Caution Lights Panel", "BLEED AIR LEAK Light (green)")
 |  |  |  | A_10C:defineIndicatorLight("CL_D1", 492, "Caution Lights Panel", "AIL DISENG Light (green)")
 |  |  |  | A_10C:defineIndicatorLight("CL_D2", 493, "Caution Lights Panel", "L-AIL TAB Light (green)")
 |  |  |  | A_10C:defineIndicatorLight("CL_D3", 494, "Caution Lights Panel", "R-AIL TAB Light (green)")
 |  |  |  | A_10C:defineIndicatorLight("CL_D4", 495, "Caution Lights Panel", "SERVICE AIR HOT Light (green)")
 |  |  |  | A_10C:defineIndicatorLight("CL_E1", 496, "Caution Lights Panel", "PITCH SAS Light (green)")
 |  |  |  | A_10C:defineIndicatorLight("CL_E2", 497, "Caution Lights Panel", "L-ENG HOT Light (green)")
 |  |  |  | A_10C:defineIndicatorLight("CL_E3", 498, "Caution Lights Panel", "R-ENG HOT Light (green)")
 |  |  |  | A_10C:defineIndicatorLight("CL_E4", 499, "Caution Lights Panel", "WINDSHIELD HOT Light (green)")
 |  |  |  | A_10C:defineIndicatorLight("CL_F1", 500, "Caution Lights Panel", "YAW SAS Light (green)")
 |  |  |  | A_10C:defineIndicatorLight("CL_F2", 501, "Caution Lights Panel", "L-ENG OIL PRESS Light (green)")
 |  |  |  | A_10C:defineIndicatorLight("CL_F3", 502, "Caution Lights Panel", "R-ENG OIL PRESS Light (green)")
 |  |  |  | A_10C:defineIndicatorLight("CL_F4", 503, "Caution Lights Panel", "CICU Light (green)")
 |  |  |  | A_10C:defineIndicatorLight("CL_G1", 504, "Caution Lights Panel", "GCAS Light (green)")
 |  |  |  | A_10C:defineIndicatorLight("CL_G2", 505, "Caution Lights Panel", "L-MAIN PUMP Light (green)")
 |  |  |  | A_10C:defineIndicatorLight("CL_G3", 506, "Caution Lights Panel", "R-MAIN PUMP Light (green)")
 |  |  |  | A_10C:defineIndicatorLight("CL_G4", 507, "Caution Lights Panel", "VOID2 Light (green)")
 |  |  |  | A_10C:defineIndicatorLight("CL_H1", 508, "Caution Lights Panel", "LASTE Light (green)")
 |  |  |  | A_10C:defineIndicatorLight("CL_H2", 509, "Caution Lights Panel", "L-WING PUMP Light (green)")
 |  |  |  | A_10C:defineIndicatorLight("CL_H3", 510, "Caution Lights Panel", "R-WING PUMP Light (green)")
 |  |  |  | A_10C:defineIndicatorLight("CL_H4", 511, "Caution Lights Panel", "HARS Light (green)")
 |  |  |  | A_10C:defineIndicatorLight("CL_I1", 512, "Caution Lights Panel", "IFF MODE-4 Light (green)")
 |  |  |  | A_10C:defineIndicatorLight("CL_I2", 513, "Caution Lights Panel", "L-MAIN FUEL LOW Light (green)")
 |  |  |  | A_10C:defineIndicatorLight("CL_I3", 514, "Caution Lights Panel", "R-MAIN FUEL LOW Light (green)")
 |  |  |  | A_10C:defineIndicatorLight("CL_I4", 515, "Caution Lights Panel", "L-R TKS UNEQUAL Light (green)")
 |  |  |  | A_10C:defineIndicatorLight("CL_J1", 516, "Caution Lights Panel", "EAC Light (green)")
 |  |  |  | A_10C:defineIndicatorLight("CL_J2", 517, "Caution Lights Panel", "L-FUEL PRESS Light (green)")
 |  |  |  | A_10C:defineIndicatorLight("CL_J3", 518, "Caution Lights Panel", "R-FUEL PRESS Light (green)")
 |  |  |  | A_10C:defineIndicatorLight("CL_J4", 519, "Caution Lights Panel", "NAV Light (green)")
 |  |  |  | A_10C:defineIndicatorLight("CL_K1", 520, "Caution Lights Panel", "STALL SYS Light (green)")
 |  |  |  | A_10C:defineIndicatorLight("CL_K2", 521, "Caution Lights Panel", "L-CONV Light (green)")
 |  |  |  | A_10C:defineIndicatorLight("CL_K3", 522, "Caution Lights Panel", "R-CONV Light (green)")
 |  |  |  | A_10C:defineIndicatorLight("CL_K4", 523, "Caution Lights Panel", "CADC Light (green)")
 |  |  |  | A_10C:defineIndicatorLight("CL_L1", 524, "Caution Lights Panel", "APU GEN Light (green)")
 |  |  |  | A_10C:defineIndicatorLight("CL_L2", 525, "Caution Lights Panel", "L-GEN Light (green)")
 |  |  |  | A_10C:defineIndicatorLight("CL_L3", 526, "Caution Lights Panel", "R-GEN Light (green)")
 |  |  |  | A_10C:defineIndicatorLight("CL_L4", 527, "Caution Lights Panel", "INST INV Light (green)")

Sheet: PCB Version Numbers
FORWARD |  | Ordered | Final DCS BIOS Check
Forward 7 Stepper Driver | 1.2
Forward Console Combined Input and Output | 1.0
Forward Console OLED | 1.0
LEFT
Left Console Combined I/O | 0.9
RIGHT
CAUTION | 1
MISC
A10 Power Distro PCB v1 | 001

Sheet: Led Template
Panel Name
 | Col
Row | 0 | 1 | 2 | 3 | 4 | 5 | 6 | 7
0
1
2
3
4
5
6
7

Sheet: Left Inputs
 | 0 | 1 | 2 | 3 | 4 | 5 | 6 | 7 | 8 | 9 | 10
0 | AUDIO CONTROL |  |  |  | VHF AM |  | VHF FM |  | EAC | SAS
1
2
3 |  |  |  |  |  |  |  |  | 41
4 | 44 | 45 | 46 | 47 |  |  |  |  | AUX LIGHT
5 | FUEL
6 |  |  |  |  |  |  |  |  | 74 | 75 | 76
7 | INTERCOMM |  |  |  | 81 | 82 | 83 | 84 | 85 | 86 | 87
8 |  |  |  |  | 92 | 93 | 94 | 95 | 96 | 97 | 98
9 |  |  |  |  | 103 | 104 | 105 | 106 | 107 | 108 | 109
10 |  |  |  |  | 114 | 115 | 116 | 117 | 118 | 119 | 120
11 | 121 | 122 | 123 | 124 | 125 | 126 | 127 | 128 | 129 | 130 | 131
12 | 132 | 133 | 134 | 135 | 136 | 137 | 138 | 139 | 140 | 141 | 142
13 | 143 | 144 | 145 | 146 | 147 | 148 | 149 | 150 | 151 | 152 | 153
14 | 154 | 155 | 156 | 157 | 158 | 159 | 160 | 161 | 162 | 163 | 164
15 | 165 | 166 | 167 | 168 | 169 | 170 | 171 | 172 | 173 | 174 | 175
 | 0 | 1 | 2 | 3 | 4 | 5 | 6 | 7 | 8 | 9 | 10
0 | 0 | 1 | 2 | 3 | 4 | 5 | 6 | 7 | 8 | 9 | 10
1 | 11 | 12 | 13 | 14 | 15 | 16 | 17 | 18 | 19 | 20 | 21
2 | 22 | 23 | 24 | 25 | 26 | 27 | 28 | 29 | 30 | 31 | 32
3 | 33 | 34 | 35 | 36 | 37 | 38 | 39 | 40 | 41 | 42 | 43
4 | 44 | 45 | 46 | 47 | 48 | 49 | 50 | 51 | 52 | 53 | 54
5 | 55 | 56 | 57 | 58 | 59 | 60 | 61 | 62 | 63 | 64 | 65
6 | 66 | 67 | 68 | 69 | 70 | 71 | 72 | 73 | 74 | 75 | 76
7 | 77 | 78 | 79 | 80 | 81 | 82 | 83 | 84 | 85 | 86 | 87
8 | 88 | 89 | 90 | 91 | 92 | 93 | 94 | 95 | 96 | 97 | 98
9 | 99 | 100 | 101 | 102 | 103 | 104 | 105 | 106 | 107 | 108 | 109
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
15 | 165 | 166 | 167 | 168 | 169 | 170 | 171 | 172 | 173 | 174 | 175
Analog Inputs
0 | Comm – Vox
1 | Comm – ICS
2 | Comm – RWR
3 | Comm – MIDS A
4 | Comm – MIDS B
5 | Comm – TCN
6
7
8 | Ext Lights – Formation
9
10
11
12 | Comm – Aux
13 | Comm – WPN
14
15 | Ext Lights - Position

Sheet: Left Composite Input
 | 0 | 1 | 2 | 3 | 4 | 5 | 6 | 7 | 8 | 9 | 10 | 11 | 16
0 | VHF AM |  |  |  | VHF FM |  |  | UHF |  |  |  | VHF AM | 15
1 |  |  |  |  |  |  |  |  |  |  |  |  | 31
2 |  |  |  |  |  |  |  |  |  |  |  |  | 47
3 |  |  |  |  |  |  |  |  |  |  |  |  | 63
4 |  |  |  |  |  |  |  |  |  |  |  |  | 79
5 |  |  |  |  |  |  |  |  |  |  |  |  | 95
6 |  |  |  |  |  |  |  |  |  |  |  | 83 | 111
7 |  |  |  |  |  |  |  |  |  |  |  | 95 | 127
8 |  |  |  |  |  |  |  |  |  |  |  | 107 | 143
9 |  |  |  |  |  |  |  |  |  |  |  | 119 | 159
10 |  |  |  |  |  |  |  |  |  |  |  | 131 | 175
11 |  |  |  |  |  |  |  |  |  |  |  | 143
12 |  |  |  |  |  |  |  |  |  |  |  | 155
13 |  |  |  |  |  |  |  |  |  |  |  | 167
14 |  |  |  |  |  |  |  |  |  |  |  | 179
15 |  |  |  |  |  |  |  |  |  |  |  | 191
 | 0 | 1 | 2 | 3 | 4 | 5 | 6 | 7 | 8 | 9 | 10 | 11
0 | 0 | 1 | 2 | 3 | 4 | 5 | 6 | 7 | 8 | 9 | 10 | 11
1 | 12 | 13 | 14 | 15 | 16 | 17 | 18 | 19 | 20 | 21 | 22 | 23
2 | 24 | 25 | 26 | 27 | 28 | 29 | 30 | 31 | 32 | 33 | 34 | 35
3 | 36 | 37 | 38 | 39 | 40 | 41 | 42 | 43 | 44 | 45 | 46 | 47
4 | 48 | 49 | 50 | 51 | 52 | 53 | 54 | 55 | 56 | 57 | 58 | 59
5 | 60 | 61 | 62 | 63 | 64 | 65 | 66 | 67 | 68 | 69 | 70 | 71
6 | 72 | 73 | 74 | 75 | 76 | 77 | 78 | 79 | 80 | 81 | 82 | 83
7 | 84 | 85 | 86 | 87 | 88 | 89 | 90 | 91 | 92 | 93 | 94 | 95
8 | 96 | 97 | 98 | 99 | 100 | 101 | 102 | 103 | 104 | 105 | 106 | 107
9 | 108 | 109 | 110 | 111 | 112 | 113 | 114 | 115 | 116 | 117 | 118 | 119
10 | 120 | 121 | 122 | 123 | 124 | 125 | 126 | 127 | 128 | 129 | 130 | 131
11 | 132 | 133 | 134 | 135 | 136 | 137 | 138 | 139 | 140 | 141 | 142 | 143
12 | 144 | 145 | 146 | 147 | 148 | 149 | 150 | 151 | 152 | 153 | 154 | 155
13 | 156 | 157 | 158 | 159 | 160 | 161 | 162 | 163 | 164 | 165 | 166 | 167
14 | 168 | 169 | 170 | 171 | 172 | 173 | 174 | 175 | 176 | 177 | 178 | 179
15 | 180 | 181 | 182 | 183 | 184 | 185 | 186 | 187 | 188 | 189 | 190 | 191
 | 0 | 1 | 2 | 3 | 4 | 5 | 6 | 7 | 8 | 9 | 10
0 | 0 | 1 | 2 | 3 | 4 | 5 | 6 | 7 | 8 | 9 | 10 | 11
1 | 12 | 13 | 14 | 15 | 16 | 17 | 18 | 19 | 20 | 21 | 22 | 23
2 | 24 | 25 | 26 | 27 | 28 | 29 | 30 | 31 | 32 | 33 | 34 | 35
3 | 36 | 37 | 38 | 39 | 40 | 41 | 42 | 43 | 44 | 45 | 46 | 47
4 | 48 | 49 | 50 | 51 | 52 | 53 | 54 | 55 | 56 | 57 | 58 | 59
5 | 60 | 61 | 62 | 63 | 64 | 65 | 66 | 67 | 68 | 69 | 70 | 71
6 | 72 | 73 | 74 | 75 | 76 | 77 | 78 | 79 | 80 | 81 | 82 | 83
7 | 84 | 85 | 86 | 87 | 88 | 89 | 90 | 91 | 92 | 93 | 94 | 95
8 | 96 | 97 | 98 | 99 | 100 | 101 | 102 | 103 | 104 | 105 | 106 | 107
9 | 108 | 109 | 110 | 111 | 112 | 113 | 114 | 115 | 116 | 117 | 118 | 119
10 | 120 | 121 | 122 | 123 | 124 | 125 | 126 | 127 | 128 | 129 | 130 | 131
11 | 132 | 133 | 134 | 135 | 136 | 137 | 138 | 139 | 140 | 141 | 142 | 143
12 | 144 | 145 | 146 | 147 | 148 | 149 | 150 | 151 | 152 | 153 | 154 | 155
13 | 156 | 157 | 158 | 159 | 160 | 161 | 162 | 163 | 164 | 165 | 166 | 167
14 | 168 | 169 | 170 | 171 | 172 | 173 | 174 | 175 | 176 | 177 | 178 | 179
15 | 180 | 181 | 182 | 183 | 184 | 185 | 186 | 187 | 188 | 189 | 190 | 191

Sheet: Right Inputs
 | 0 | 1 | 2 | 3 | 4 | 5 | 6 | 7 | 8 | 9 | 10
0 | TACAN |  | ENVIRONMENT |  | FUEL | EW |  |  | ELECTRICAL |  | 10
1 |  |  |  |  |  |  |  |  |  |  | 21
2 |  |  |  |  |  |  |  |  |  |  | 32
3 |  |  |  |  |  |  |  |  |  |  | 43
4 |  |  |  |  |  |  |  |  | CDU BRIGHT |  | 54
5 | ILS | 56 | 57 | 58 |  |  |  |  | 63 | 64 | 65
6 | AAP |  | 68 | CANOPY |  |  |  |  | 74 | 75 | 76
7 |  |  | 79 |  |  |  |  |  | 85 | 86 | 87
8 |  |  | CDU
9
10
11
12 | LIGHTS
13
14
15
Press | 0 | 1 | 2 | 3 | 4 | 5 | 6 | 7 | 8 | 9 | 10
0 | 0 | 1 | 2 | 3 | 4 | 5 | 6 | 7 | 8 | 9 | 10 |  | 0 | 1 | 2 | 3 | 4 | 5 | 6 | 7 | 8 | 9 | 10
1 | 11 | 12 | 13 | 14 | 15 | 16 | 17 | 18 | 19 | 20 | 21 | 0 | 0 | 1 | 2 | 3 | 4 | 5 | 6 | 7 | 8 | 9 | 10
2 | 22 | 23 | 24 | 25 | 26 | 27 | 28 | 29 | 30 | 31 | 32 | 1 | 11 | 12 | 13 | 14 | 15 | 16 | 17 | 18 | 19 | 20 | 21
3 | 33 | 34 | 35 | 36 | 37 | 38 | 39 | 40 | 41 | 42 | 43 | 2 | 22 | 23 | 24 | 25 | 26 | 27 | 28 | 29 | 30 | 31 | 32
4 | 44 | 45 | 46 | 47 | 48 | 49 | 50 | 51 | 52 | 53 | 54 | 3 | 33 | 34 | 35 | 36 | 37 | 38 | 39 | 40 | 41 | 42 | 43
5 | 55 | 56 | 57 | 58 | 59 | 60 | 61 | 62 | 63 | 64 | 65 | 4 | 44 | 45 | 46 | 47 | 48 | 49 | 50 | 51 | 52 | 53 | 54
6 | 66 | 67 | 68 | 69 | 70 | 71 | 72 | 73 | 74 | 75 | 76 | 5 | 55 | 56 | 57 | 58 | 59 | 60 | 61 | 62 | 63 | 64 | 65
7 | 77 | 78 | 79 | 80 | 81 | 82 | 83 | 84 | 85 | 86 | 87 | 6 | 66 | 67 | 68 | 69 | 70 | 71 | 72 | 73 | 74 | 75 | 76
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
5
6
7
8
9
10
11
12
13
14
15
 |  | COL | ROW | ANALOG
 | ELEC | 2 | 2 | 0
 | ECS | 4 | 4 | 2
 | INTR LT | 3 | 2 | 6
 | SNSR | 3 | 8 | 0
 | SIM CNTL | 4 | 8 | 0
 | KY58 | 2 | 8 | 1
 | RIGHT ESS BREAKERS | 3 | 3 | 0 | May need to add an intermediary board for Mag Switch
 | RIGHT FWD AUX | 2 | 3 | 0

Sheet: Front Inputs
 | 0 | 1 | 2 | 3 | 4 | 5 | 6 | 7 | 8 | 9 | 10 | 11
0 | UFC |  |  |  |  |  | 6 | 7 | 8 | 9 | 10 | 11
1 |  |  |  |  |  |  | 18 | 19 | 20 | 21 | 22 | 23
2 |  |  |  |  |  |  | 30 | 31 | 32 | 33 | 34 | 35
3 |  |  |  |  |  |  | 42 | 43 | 44 | 45 | 46 | 47
4 |  |  |  |  |  |  | 54 | 55 | 56 | 57 | 58 | 59
5 |  |  |  |  |  |  | 66 | 67 | 68 | 69 | 70 | 71
6 | MASTER ARM |  |  |  | NMSP CMSP |  | 78 | 79 | 80 | 81 | 82 | 83
7 |  |  |  |  |  |  | 90 | 91 | 92 | 93 | 94 | 95
8 |  |  |  |  |  |  | 102 | 103 | 104 | 105 | 106 | 107
9 |  |  |  |  |  |  | 114 | 115 | 116 | 117 | 118 | 119
10 | LANDING GEAR |  | FIRE HANDLES | EXTNG |  |  | 126 | 127 | 128 | 129 | 130 | 131
11 |  |  |  |  |  |  | 138 | 139 | 140 | 141 | 142 | 143
12 |  |  |  | SARI | 148 | 149 | 150 | 151 | 152 | 153 | 154 | 155
13 |  |  | JETTISON | ALT | 160 | 161 | 162 | 163 | 164 | 165 | 166 | 167
14 |  |  | JAMMER | 171 | 172 | 173 | 174 | 175 | 176 | 177 | 178 | 179
15 |  |  |  | 182 | 184 | 185 | 186 | 187 | 188 | 189 | 190 | 191
 | 0 | 1 | 2 | 3 | 4 | 5 | 6 | 7 | 8 | 9 | 10 | 11
0 | 0 | 1 | 2 | 3 | 4 | 5 | 6 | 7 | 8 | 9 | 10 | 11
1 | 12 | 13 | 14 | 15 | 16 | 17 | 18 | 19 | 20 | 21 | 22 | 23
2 | 24 | 25 | 26 | 27 | 28 | 29 | 30 | 31 | 32 | 33 | 34 | 35
3 | 36 | 37 | 38 | 39 | 40 | 41 | 42 | 43 | 44 | 45 | 46 | 47
4 | 48 | 49 | 50 | 51 | 52 | 53 | 54 | 55 | 56 | 57 | 58 | 59
5 | 60 | 61 | 62 | 63 | 64 | 65 | 66 | 67 | 68 | 69 | 70 | 71
6 | 72 | 73 | 74 | 75 | 76 | 77 | 78 | 79 | 80 | 81 | 82 | 83
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
12 | 132 | 133 | 134 | 135 | 136 | 137 | 138 | 139 | 140 | 141 | 142
13 | 143 | 144 | 145 | 146 | 147 | 148 | 149 | 150 | 151 | 152 | 153
14 | 154 | 155 | 156 | 157 | 158 | 159 | 160 | 161 | 162 | 163 | 164
15 | 165 | 166 | 167 | 168 | 169 | 170 | 171 | 172 | 173 | 174 | 175

Sheet: PCB Check before ordering
PCB Check before ordering
Left Console | Check ECAD Block Diagram | Electrical Check | PCB Bug Check | Mounting Holes | PCB and Component Labels on Silkscreen | Col Row Connector Check | Col/Rows in Spreadsheet | View in 3d viewer, Export JPG | Print PCB and Schematic | Combined Col/Rows in Distribution | Analog inputs in Distribution | Mag Coils | DXF | Laser Board for Mount testing | Exported | Ordered | Quantity
Antenna Select |  |  |  |  |  |  |  |  |  |  |  |  |  |  |  |  | 1
Right Console | Check ECAD Block Diagram Visual MCAD | Electrical Check | Export DXF for backlight and flip | PCB Bug Check | Mounting Holes | PCB and Component Labels on Silkscreen | Col Row Connector Check | Col/Rows in Spreadsheet | View in 3d viewer, Export JPG | Print PCB and Schematic | Combined Col/Rows in Distribution | Analog inputs in Distribution | Mag Coils | DXF | Laser Board for Mount testing | Exported | Ordered | Quantity
Electrical |  |  |  |  |  |  | 9-10, 3-4 |  |  |  |  |  |  |  |  |  |  | 5

Sheet: Input Template
 | 0 | 1 | 2 | 3 | 4 | 5 | 6 | 7 | 8 | 9 | 10 | 11
0 | 0 | 1 | 2 | 3 | 4 | 5 | 6 | 7 | 8 | 9 | 10 | 11
1 | 12 | 13 | 14 | 15 | 16 | 17 | 18 | 19 | 20 | 21 | 22 | 23
2 | 24 | 25 | 26 | 27 | 28 | 29 | 30 | 31 | 32 | 33 | 34 | 35
3 | 36 | 37 | 38 | 39 | 40 | 41 | 42 | 43 | 44 | 45 | 46 | 47
4 | 48 | 49 | 50 | 51 | 52 | 53 | 54 | 55 | 56 | 57 | 58 | 59
5 | 60 | 61 | 62 | 63 | 64 | 65 | 66 | 67 | 68 | 69 | 70 | 71
6 | 72 | 73 | 74 | 75 | 76 | 77 | 78 | 79 | 80 | 81 | 82 | 83
7 | 84 | 85 | 86 | 87 | 88 | 89 | 90 | 91 | 92 | 93 | 94 | 95
8 | 96 | 97 | 98 | 99 | 100 | 101 | 102 | 103 | 104 | 105 | 106 | 107
9 | 108 | 109 | 110 | 111 | 112 | 113 | 114 | 115 | 116 | 117 | 118 | 119
10 | 120 | 121 | 122 | 123 | 124 | 125 | 126 | 127 | 128 | 129 | 130 | 131
11 | 132 | 133 | 134 | 135 | 136 | 137 | 138 | 139 | 140 | 141 | 142 | 143
12 | 144 | 145 | 146 | 147 | 148 | 149 | 150 | 151 | 152 | 153 | 154 | 155
13 | 156 | 157 | 158 | 159 | 160 | 161 | 162 | 163 | 164 | 165 | 166 | 167
14 | 168 | 169 | 170 | 171 | 172 | 173 | 174 | 175 | 176 | 177 | 178 | 179
15 | 180 | 181 | 182 | 183 | 184 | 185 | 186 | 187 | 188 | 189 | 190 | 191
 | 0 | 1 | 2 | 3 | 4 | 5 | 6 | 7 | 8 | 9 | 10
0 | 0 | 1 | 2 | 3 | 4 | 5 | 6 | 7 | 8 | 9 | 10 | 11
1 | 12 | 13 | 14 | 15 | 16 | 17 | 18 | 19 | 20 | 21 | 22 | 23
2 | 24 | 25 | 26 | 27 | 28 | 29 | 30 | 31 | 32 | 33 | 34 | 35
3 | 36 | 37 | 38 | 39 | 40 | 41 | 42 | 43 | 44 | 45 | 46 | 47
4 | 48 | 49 | 50 | 51 | 52 | 53 | 54 | 55 | 56 | 57 | 58 | 59
5 | 60 | 61 | 62 | 63 | 64 | 65 | 66 | 67 | 68 | 69 | 70 | 71
6 | 72 | 73 | 74 | 75 | 76 | 77 | 78 | 79 | 80 | 81 | 82 | 83
7 | 84 | 85 | 86 | 87 | 88 | 89 | 90 | 91 | 92 | 93 | 94 | 95
8 | 96 | 97 | 98 | 99 | 100 | 101 | 102 | 103 | 104 | 105 | 106 | 107
9 | 108 | 109 | 110 | 111 | 112 | 113 | 114 | 115 | 116 | 117 | 118 | 119
10 | 120 | 121 | 122 | 123 | 124 | 125 | 126 | 127 | 128 | 129 | 130 | 131
11 | 132 | 133 | 134 | 135 | 136 | 137 | 138 | 139 | 140 | 141 | 142 | 143
12 | 144 | 145 | 146 | 147 | 148 | 149 | 150 | 151 | 152 | 153 | 154 | 155
13 | 156 | 157 | 158 | 159 | 160 | 161 | 162 | 163 | 164 | 165 | 166 | 167
14 | 168 | 169 | 170 | 171 | 172 | 173 | 174 | 175 | 176 | 177 | 178 | 179
15 | 180 | 181 | 182 | 183 | 184 | 185 | 186 | 187 | 188 | 189 | 190 | 191
 | 0 | 1 | 2 | 3 | 4 | 5 | 6 | 7 | 8 | 9 | 10
0 | 0 | 1 | 2 | 3 | 4 | 5 | 6 | 7 | 8 | 9 | 10
1 | 11 | 12 | 13 | 14 | 15 | 16 | 17 | 18 | 19 | 20 | 21
2 | 22 | 23 | 24 | 25 | 26 | 27 | 28 | 29 | 30 | 31 | 32
3 | 33 | 34 | 35 | 36 | 37 | 38 | 39 | 40 | 41 | 42 | 43
4 | 44 | 45 | 46 | 47 | 48 | 49 | 50 | 51 | 52 | 53 | 54
5 | 55 | 56 | 57 | 58 | 59 | 60 | 61 | 62 | 63 | 64 | 65
6 | 66 | 67 | 68 | 69 | 70 | 71 | 72 | 73 | 74 | 75 | 76
7 | 77 | 78 | 79 | 80 | 81 | 82 | 83 | 84 | 85 | 86 | 87
8 | 88 | 89 | 90 | 91 | 92 | 93 | 94 | 95 | 96 | 97 | 98
9 | 99 | 100 | 101 | 102 | 103 | 104 | 105 | 106 | 107 | 108 | 109
10 | 110 | 111 | 112 | 113 | 114 | 115 | 116 | 117 | 118 | 119 | 120
11 | 121 | 122 | 123 | 124 | 125 | 126 | 127 | 128 | 129 | 130 | 131
12 | 132 | 133 | 134 | 135 | 136 | 137 | 138 | 139 | 140 | 141 | 142
13 | 143 | 144 | 145 | 146 | 147 | 148 | 149 | 150 | 151 | 152 | 153
14 | 154 | 155 | 156 | 157 | 158 | 159 | 160 | 161 | 162 | 163 | 164
15 | 165 | 166 | 167 | 168 | 169 | 170 | 171 | 172 | 173 | 174 | 175
