bnepethomas/bne-arduino-flight-simulator-interfaces/A10/A10 Documentation/Diptrace/pcb_order_3.jpg

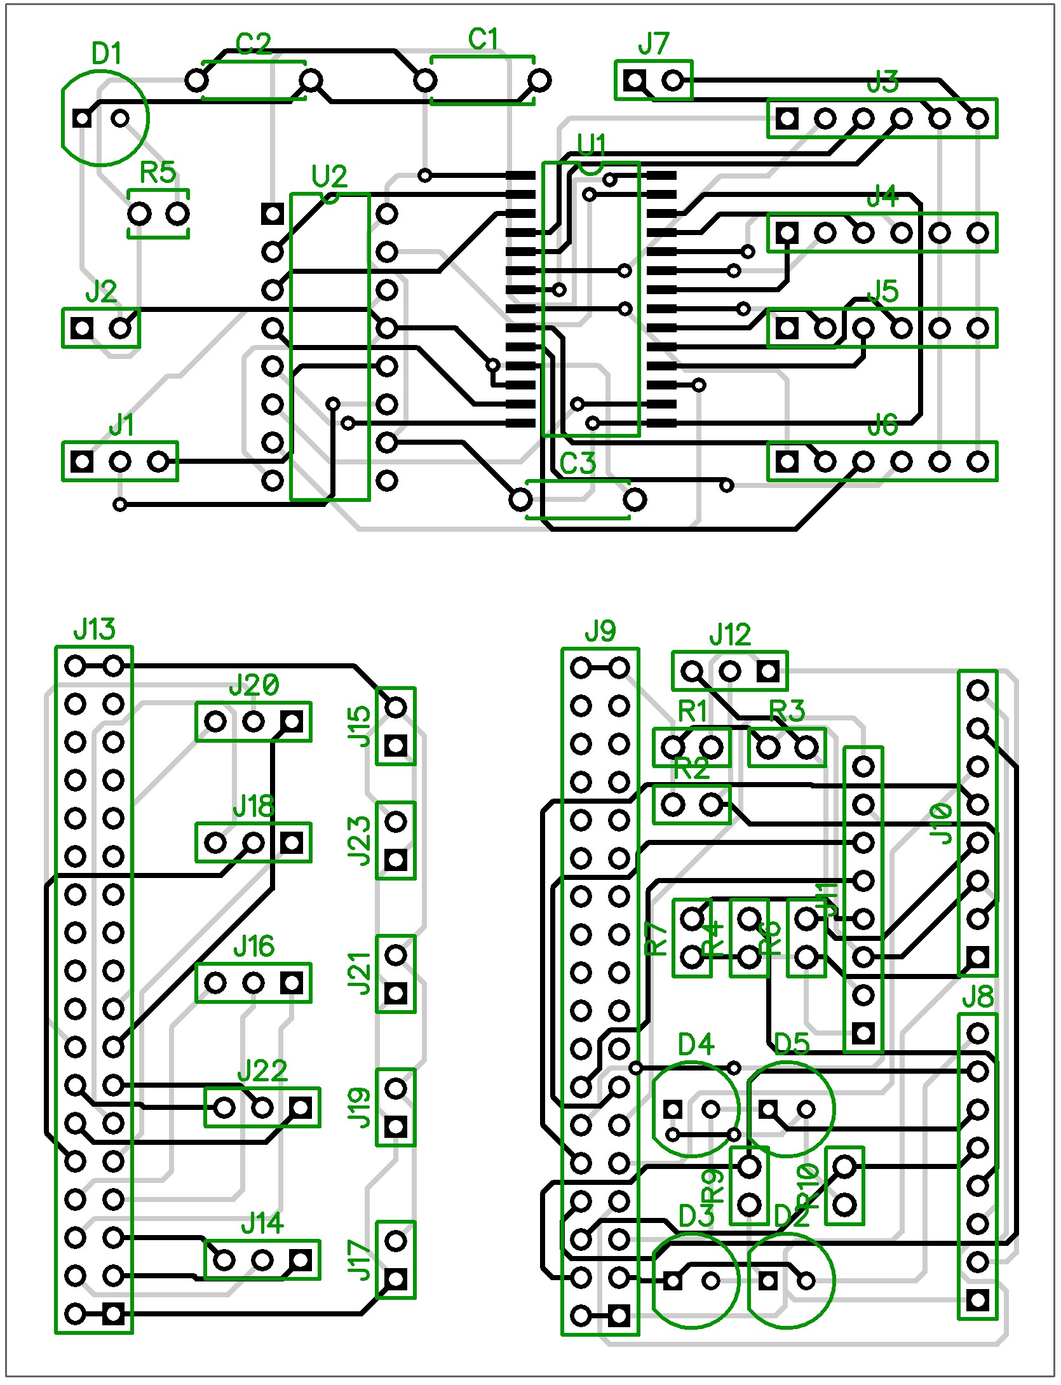
A10/A10 Documentation/Diptrace/pcb_order_3.jpg
