bnepethomas/bne-arduino-flight-simulator-interfaces/Hornet/Hornet OH 3d Mods/Flood Lights/Right Circuit Breaker/Right Circuit Braker Rear Assembly.stl

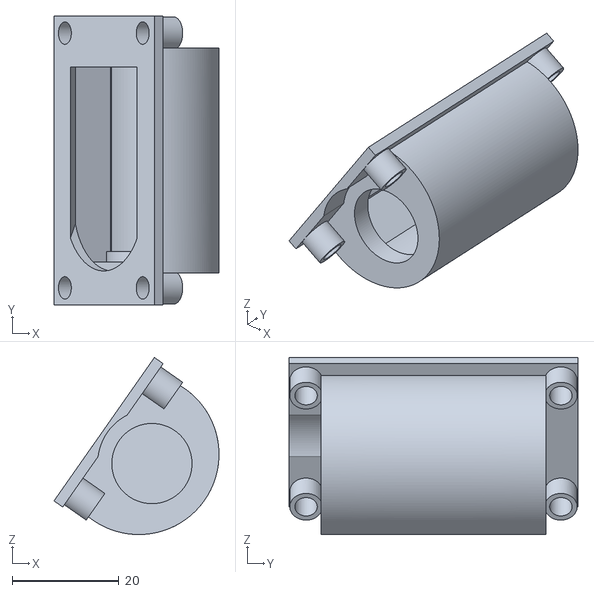
[picture p27: CAD file, 2025-11-29]
Hornet/Hornet OH 3d Mods/Flood Lights/Right Circuit Breaker/Right Circuit Braker Rear Assembly.stl
30.9 x 54.0 x 33.1
