bnepethomas/bne-arduino-flight-simulator-interfaces/Hornet/Hornet PCBs/Active/Left Console/COMPASS/COMPASS-CONTROL/compas-stepper-full.dxf

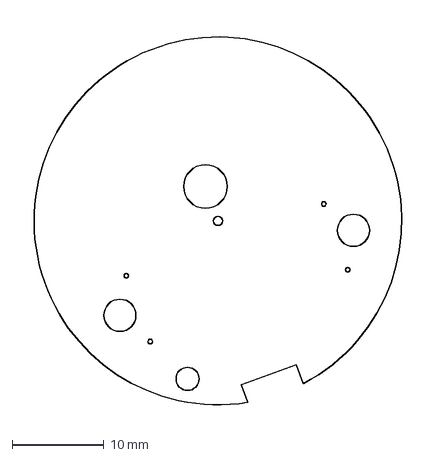
[picture p28: CAD file, 2025-11-29]
Hornet/Hornet PCBs/Active/Left Console/COMPASS/COMPASS-CONTROL/compas-stepper-full.dxf
44.4 x 43.7 mm
