bnepethomas/bne-arduino-flight-simulator-interfaces/A10/A10 Hardware Models/Compass/Standby Compass- IR Mount.stl

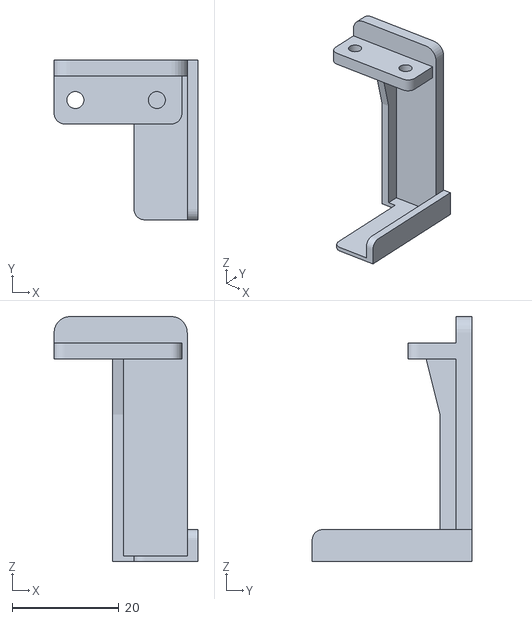
[picture p29: CAD file, 2025-11-29]
A10/A10 Hardware Models/Compass/Standby Compass- IR Mount.stl
27.0 x 30.0 x 46.0
