bnepethomas/bne-arduino-flight-simulator-interfaces/A10/A10 PCBs/A10 Power Distro PCB v1/a10 Power Distro PCB v1.step

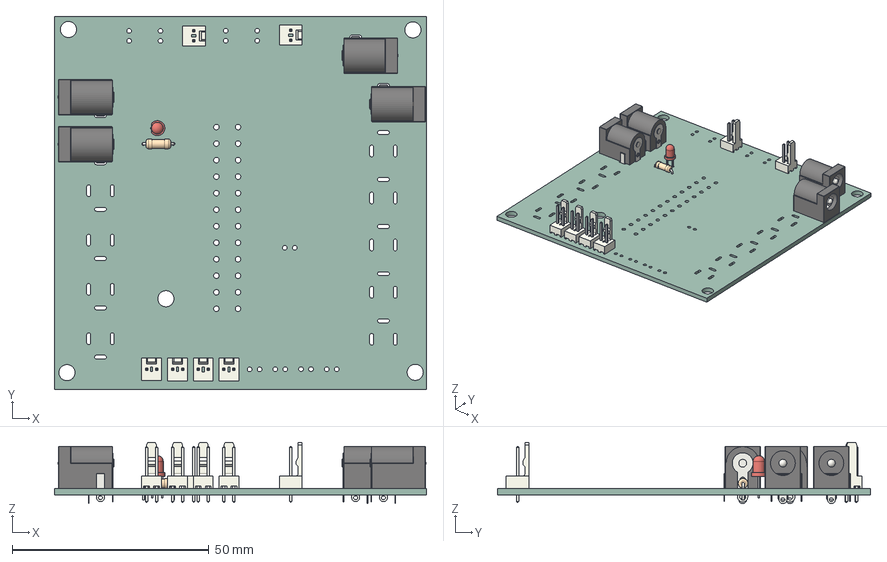
[picture p30: CAD file, 2025-11-29]
A10/A10 PCBs/A10 Power Distro PCB v1/a10 Power Distro PCB v1.step
94.7 x 94.9 x 15.6 mm
LED_D3.0mm
R_Axial_DIN0207_L63mm_D25mm_P762mm_Horizontal
Molex_AE_6410_02A x 6
BarrelJack_Horizontal x 4
a10 Power Distro PCB v1_PCB
