bnepethomas/bne-arduino-flight-simulator-interfaces/A10/A10 PCBs/A10 Power Distro PCB v1/Manufacturing/a10 Power Distro PCB v1-NPTH-drl_map.dxf

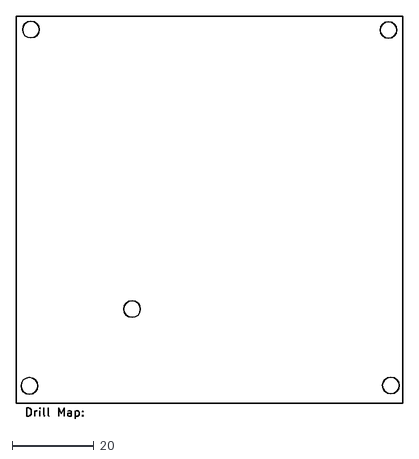
[picture p31: CAD file, 2025-11-29]
A10/A10 PCBs/A10 Power Distro PCB v1/Manufacturing/a10 Power Distro PCB v1-NPTH-drl_map.dxf
94.7 x 98.7
