bnepethomas/bne-arduino-flight-simulator-interfaces/A10/A10 PCBs/Cable Tester/Manufacturing/Cable Tester-NPTH-drl_map.dxf

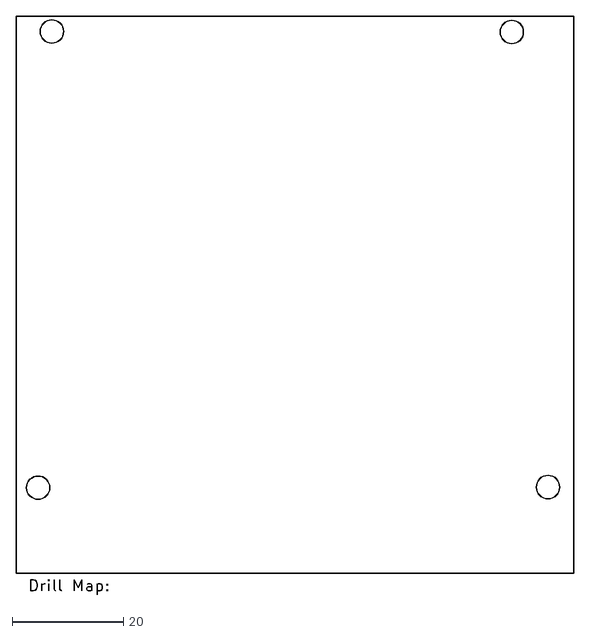
[picture p32: CAD file, 2025-11-29]
A10/A10 PCBs/Cable Tester/Manufacturing/Cable Tester-NPTH-drl_map.dxf
100.0 x 103.8
