bnepethomas/bne-arduino-flight-simulator-interfaces/A10/A10 PCBs/Forward Console 7 Stepper Driver/MANUFACTURING/FORWARD 7 STEPPER DRIVER-NPTH-drl_map.dxf

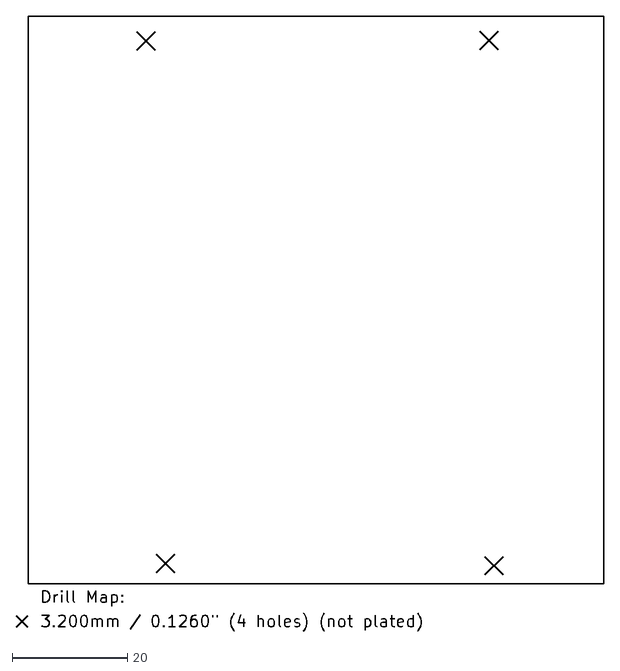
[picture p33: CAD file, 2025-11-29]
A10/A10 PCBs/Forward Console 7 Stepper Driver/MANUFACTURING/FORWARD 7 STEPPER DRIVER-NPTH-drl_map.dxf
101.8 x 106.6
