bnepethomas/bne-arduino-flight-simulator-interfaces/A10/A10 PCBs/Forward Console Combined Input and Output/MANFACTURING/Forward Console Combined Input and Output-NPTH-drl_map.dxf

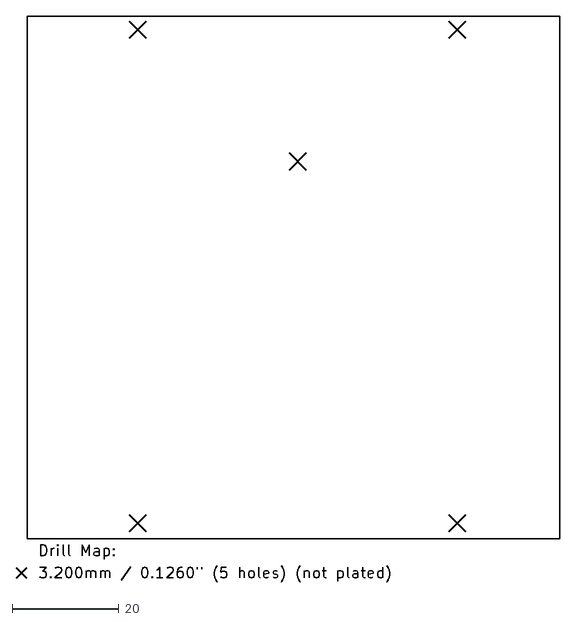
[picture p34: CAD file, 2025-11-29]
A10/A10 PCBs/Forward Console Combined Input and Output/MANFACTURING/Forward Console Combined Input and Output-NPTH-drl_map.dxf
102.1 x 106.3
