bnepethomas/bne-arduino-flight-simulator-interfaces/A10/A10 PCBs/Forward Console Inidividual PCBS/CMSP NMSP/MANUFACTURING/CMSP NMSP-NPTH-drl_map.dxf

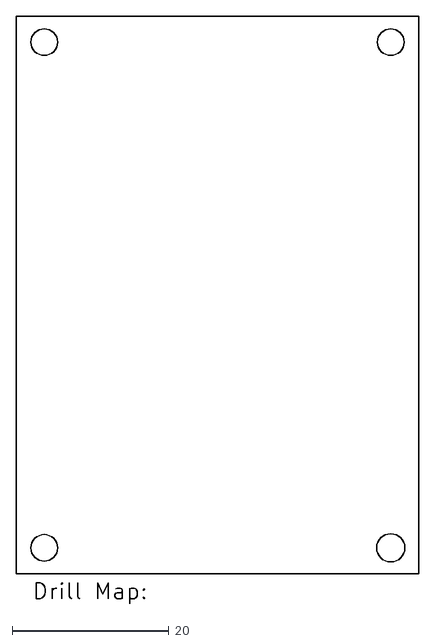
[picture p35: CAD file, 2025-11-29]
A10/A10 PCBs/Forward Console Inidividual PCBS/CMSP NMSP/MANUFACTURING/CMSP NMSP-NPTH-drl_map.dxf
51.3 x 75.0
