bnepethomas/bne-arduino-flight-simulator-interfaces/A10/A10 PCBs/Forward Console Inidividual PCBS/FORWARD LED DISTRIBUTION/MANUFACTURING/CMSP NMSP-PTH-drl_map.dxf

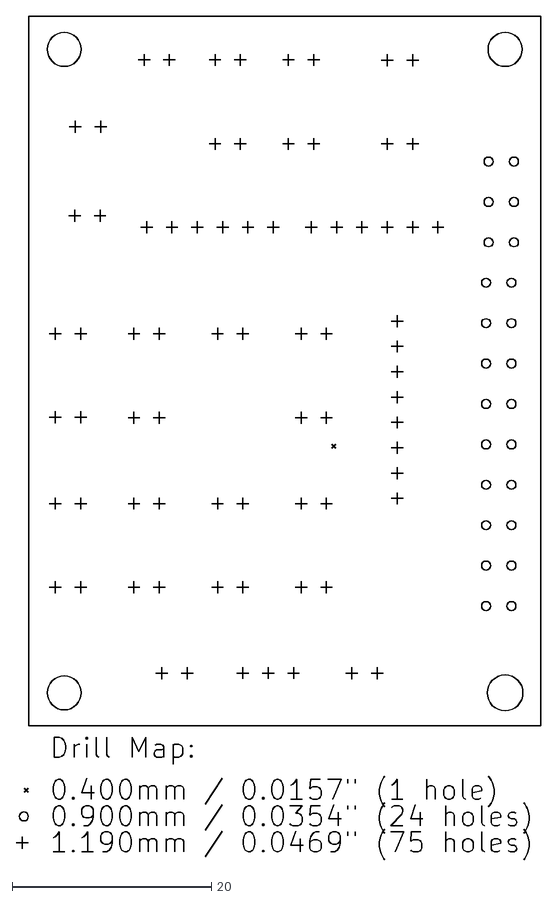
[picture p36: CAD file, 2025-11-29]
A10/A10 PCBs/Forward Console Inidividual PCBS/FORWARD LED DISTRIBUTION/MANUFACTURING/CMSP NMSP-PTH-drl_map.dxf
52.5 x 84.5
