bnepethomas/bne-arduino-flight-simulator-interfaces/A10/A10 PCBs/Forward Console Inidividual PCBS/LANDING GEAR/MANUFACTURING/LANDING GEAR-NPTH-drl_map.dxf

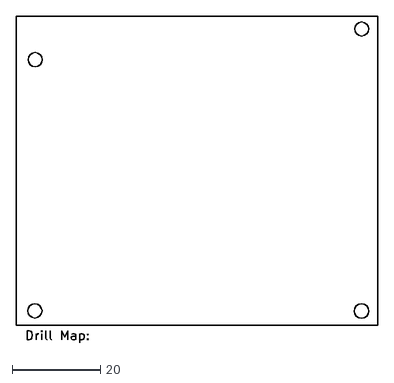
[picture p37: CAD file, 2025-11-29]
A10/A10 PCBs/Forward Console Inidividual PCBS/LANDING GEAR/MANUFACTURING/LANDING GEAR-NPTH-drl_map.dxf
82.0 x 74.0
