bnepethomas/bne-arduino-flight-simulator-interfaces/A10/A10 PCBs/Forward Console Inidividual PCBS/UFC/MANUFACTURING/UFC-Edge_Cuts.dxf

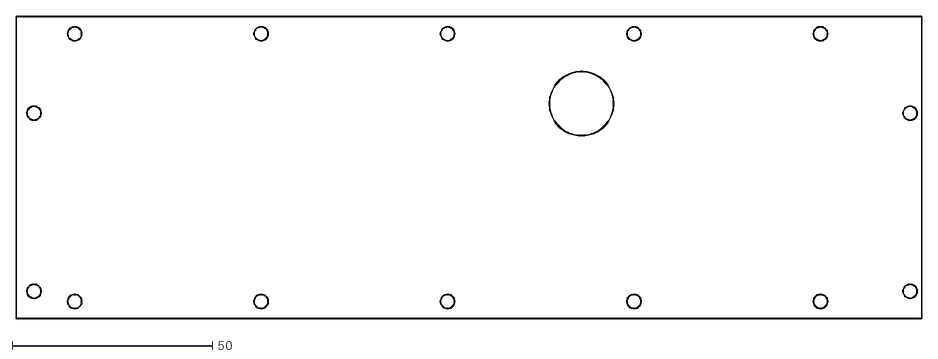
[picture p38: CAD file, 2025-11-29]
A10/A10 PCBs/Forward Console Inidividual PCBS/UFC/MANUFACTURING/UFC-Edge_Cuts.dxf
226.2 x 75.6
