bnepethomas/bne-arduino-flight-simulator-interfaces/A10/A10 PCBs/General Use/Gauges/Analog Instruments Small Engine/MANUFACTURING/GAUGE_Analog Instruments-PTH-drl_map.dxf

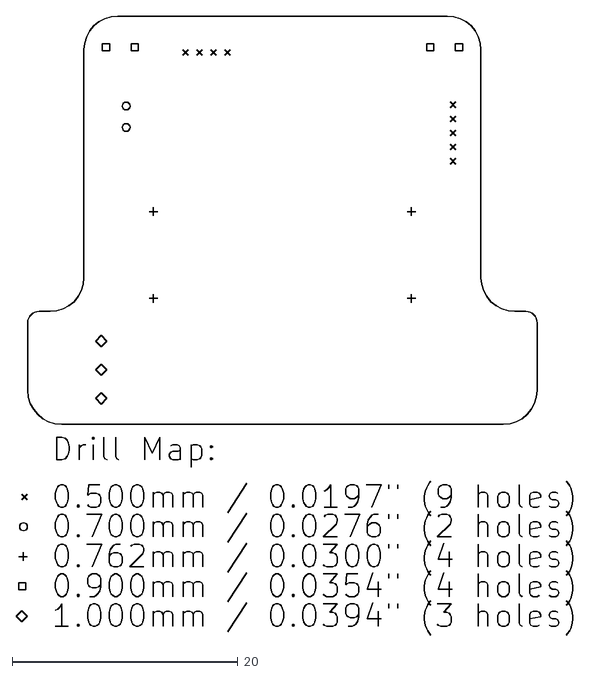
[picture p40: CAD file, 2025-11-29]
A10/A10 PCBs/General Use/Gauges/Analog Instruments Small Engine/MANUFACTURING/GAUGE_Analog Instruments-PTH-drl_map.dxf
49.3 x 54.8
