bnepethomas/bne-arduino-flight-simulator-interfaces/A10/A10 PCBs/General Use/Gauges/GAUGE_Analog Instruments/MANUFACTURING/GAUGE_Analog Instruments-NPTH-drl_map.dxf

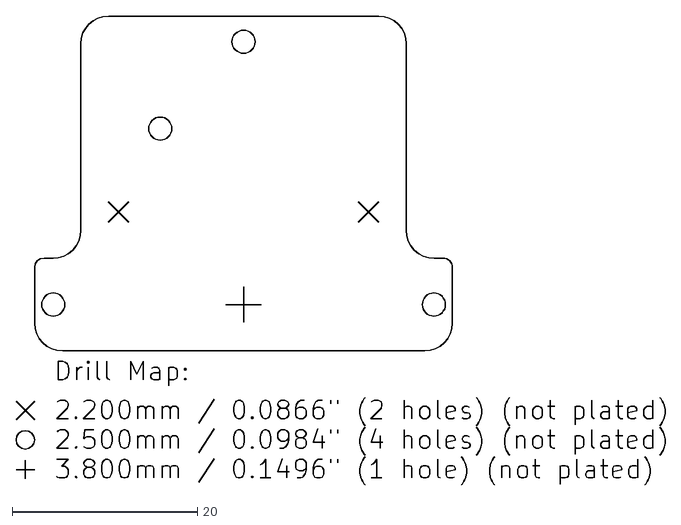
[picture p41: CAD file, 2025-11-29]
A10/A10 PCBs/General Use/Gauges/GAUGE_Analog Instruments/MANUFACTURING/GAUGE_Analog Instruments-NPTH-drl_map.dxf
70.1 x 50.7
