bnepethomas/bne-arduino-flight-simulator-interfaces/A10/A10 PCBs/General Use/Gauges/Simmeters Small Engine Replacement/MANUFACTURING/Simmeters Small Engine Replacement-NPTH-drl_map.dxf

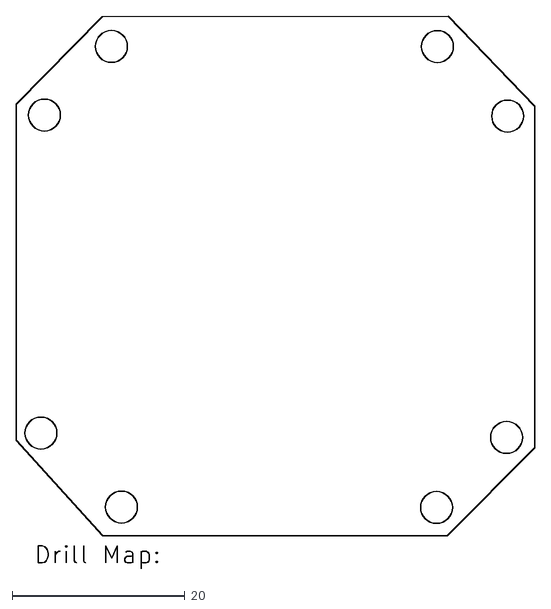
[picture p42: CAD file, 2025-11-29]
A10/A10 PCBs/General Use/Gauges/Simmeters Small Engine Replacement/MANUFACTURING/Simmeters Small Engine Replacement-NPTH-drl_map.dxf
60.0 x 63.9
