bnepethomas/bne-arduino-flight-simulator-interfaces/A10/A10 PCBs/General Use/Potentiometer Mount/MANUFACTURING/Potentiometer Mount-PTH-drl_map.dxf

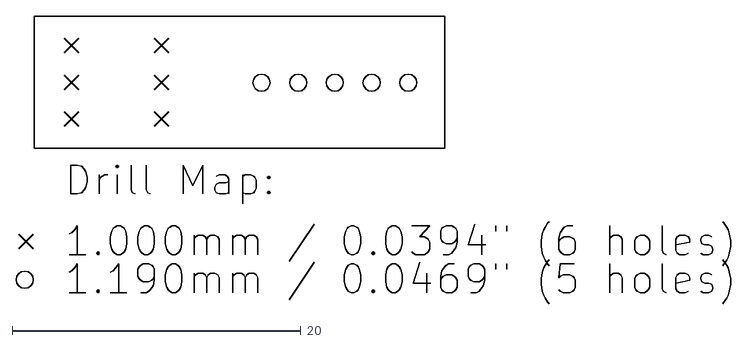
[picture p43: CAD file, 2025-11-29]
A10/A10 PCBs/General Use/Potentiometer Mount/MANUFACTURING/Potentiometer Mount-PTH-drl_map.dxf
49.5 x 19.9
