bnepethomas/bne-arduino-flight-simulator-interfaces/A10/A10 PCBs/Left Console Individual PCBs/AUDIO-KEYPAD/MANUFACTURING/AUDIO-KEYPAD-PTH-drl_map.dxf

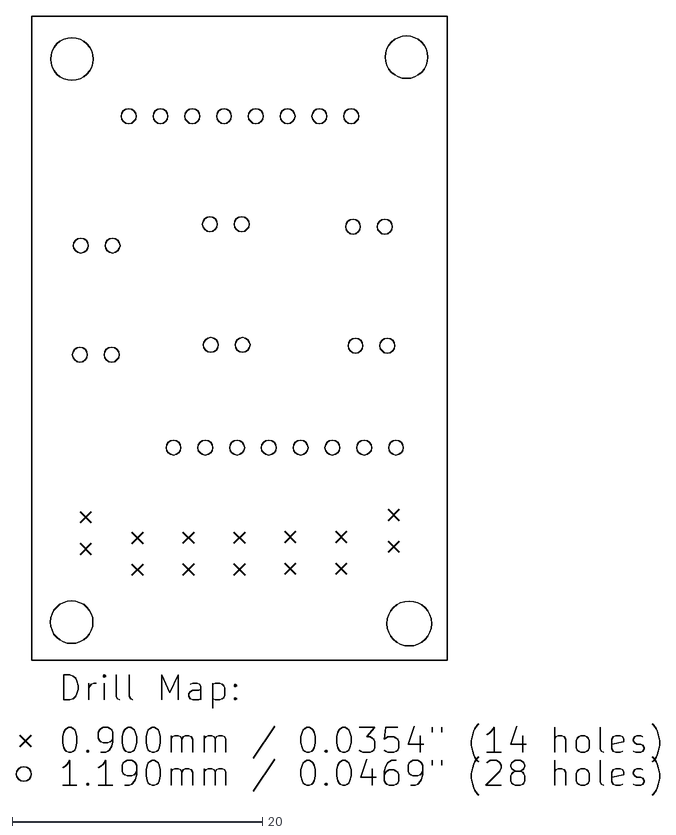
[picture p44: CAD file, 2025-11-29]
A10/A10 PCBs/Left Console Individual PCBs/AUDIO-KEYPAD/MANUFACTURING/AUDIO-KEYPAD-PTH-drl_map.dxf
51.4 x 62.3
