bnepethomas/bne-arduino-flight-simulator-interfaces/A10/A10 PCBs/Left Console Individual PCBs/INTERCOMM BACKLIGHT VALIDATION/MANUFACTURING/INTERCOMM BACKLIGHT VALIDATION-NPTH-drl_map.dxf

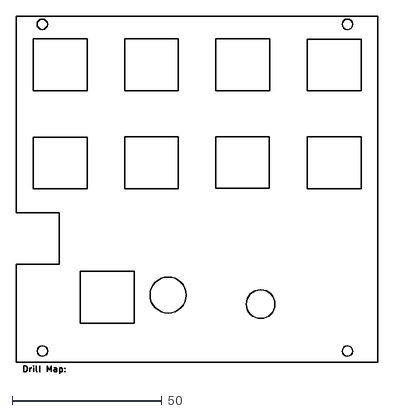
[picture p45: CAD file, 2025-11-29]
A10/A10 PCBs/Left Console Individual PCBs/INTERCOMM BACKLIGHT VALIDATION/MANUFACTURING/INTERCOMM BACKLIGHT VALIDATION-NPTH-drl_map.dxf
120.8 x 119.5
