bnepethomas/bne-arduino-flight-simulator-interfaces/A10/A10 PCBs/Left Console Individual PCBs/INTERCOMM/MANUFACTURING/INTERCOMM-PTH-drl_map.dxf

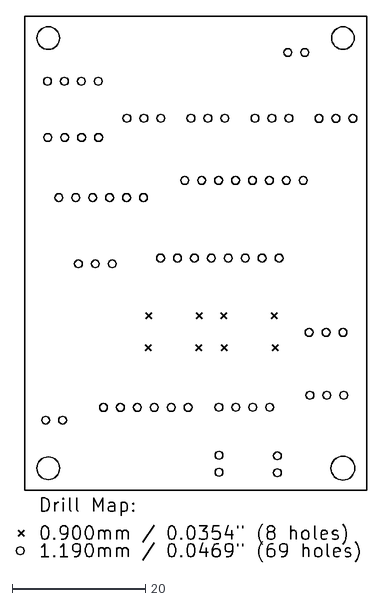
[picture p46: CAD file, 2025-11-29]
A10/A10 PCBs/Left Console Individual PCBs/INTERCOMM/MANUFACTURING/INTERCOMM-PTH-drl_map.dxf
52.5 x 81.9
