bnepethomas/bne-arduino-flight-simulator-interfaces/A10/A10 PCBs/Left Console Individual PCBs/UHF-ROTARIES/MANUFACTURING/UHF-ROTARIES-NPTH-drl_map.dxf

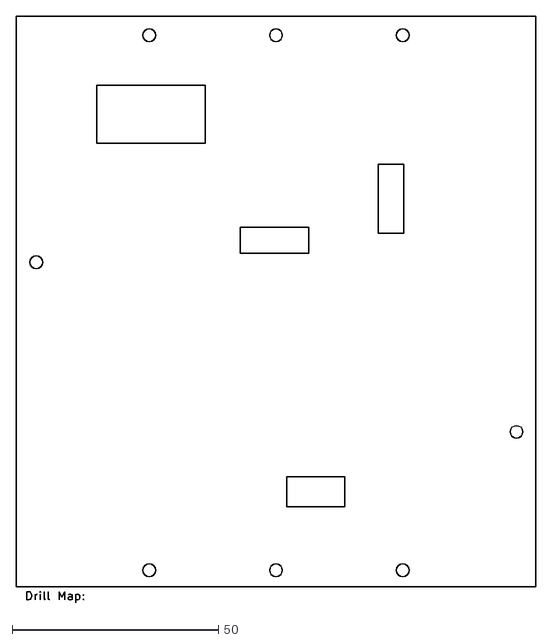
[picture p47: CAD file, 2025-11-29]
A10/A10 PCBs/Left Console Individual PCBs/UHF-ROTARIES/MANUFACTURING/UHF-ROTARIES-NPTH-drl_map.dxf
126.0 x 142.2
