bnepethomas/bne-arduino-flight-simulator-interfaces/A10/A10 PCBs/Left Console Individual PCBs/VHF-AM-ROTARIES/MANUFACTURING/VHF-AM-ROTARIES-PTH-drl_map.dxf

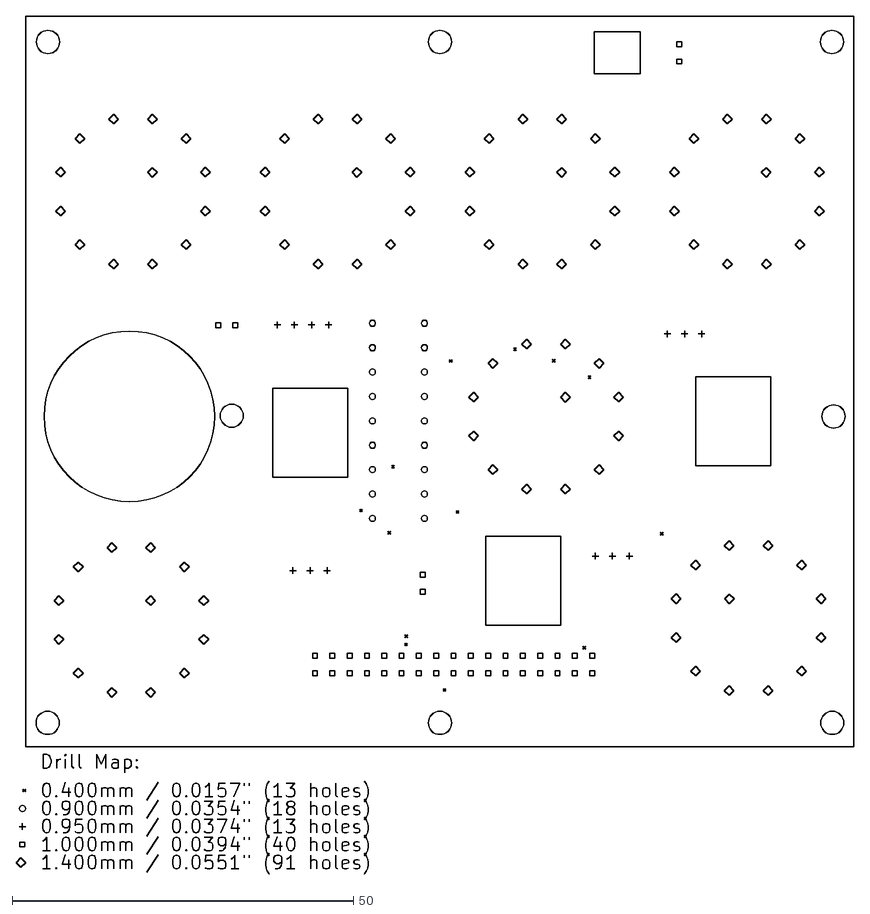
[picture p48: CAD file, 2025-11-29]
A10/A10 PCBs/Left Console Individual PCBs/VHF-AM-ROTARIES/MANUFACTURING/VHF-AM-ROTARIES-PTH-drl_map.dxf
122.8 x 125.8
