bnepethomas/bne-arduino-flight-simulator-interfaces/A10/A10 PCBs/Left Console Individual PCBs/VHF-AM-ROTARIES/VHF-AM-ROTARIES.step

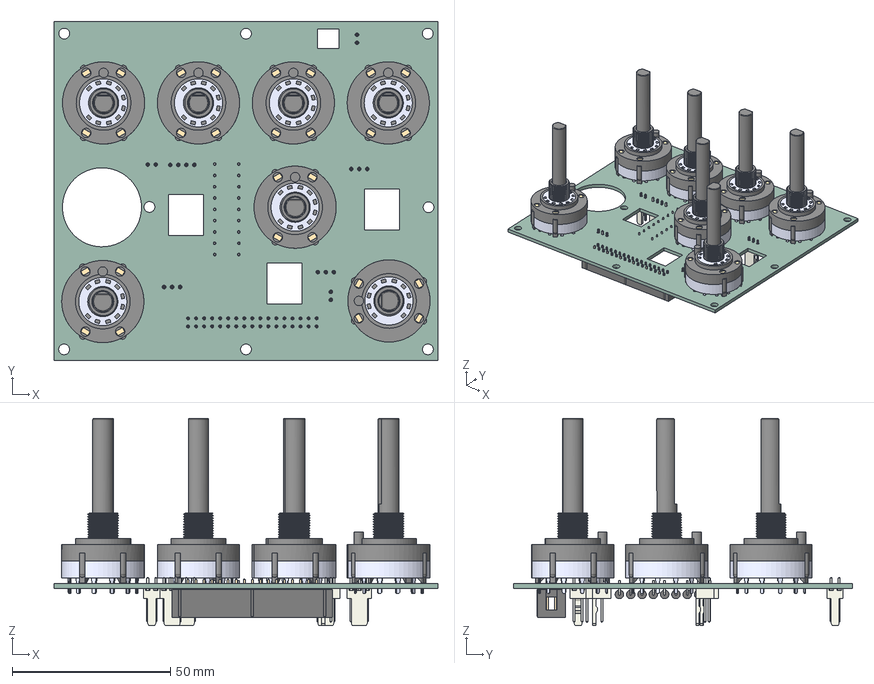
[picture p49: CAD file, 2025-11-29]
A10/A10 PCBs/Left Console Individual PCBs/VHF-AM-ROTARIES/VHF-AM-ROTARIES.step
121.4 x 107.1 x 65.5 mm
SR2612F-0112-21R0B-D8-N v2 x 7
D_A-405_P7.62mm_Horizontal x 9
Molex_AE_6410_02A x 3
Molex_AE_6410_03A x 3
Molex_AE_6410_04A
IDC_Header_2x17_P254mm_Vertical
VHF-AM-ROTARIES_PCB
