bnepethomas/bne-arduino-flight-simulator-interfaces/A10/A10 PCBs/Left Console Individual PCBs/VHF-FM-Lightbar/Manufacturing/VHF-FM-Lightbar-NPTH-drl_map.dxf

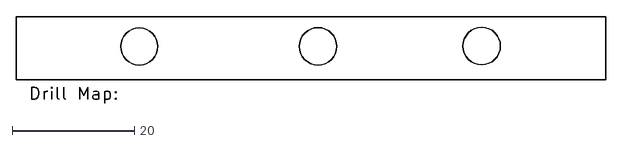
[picture p50: CAD file, 2025-11-29]
A10/A10 PCBs/Left Console Individual PCBs/VHF-FM-Lightbar/Manufacturing/VHF-FM-Lightbar-NPTH-drl_map.dxf
96.6 x 14.2
