bnepethomas/bne-arduino-flight-simulator-interfaces/A10/A10 PCBs/Left Console Individual PCBs/VHF-FM-Lightbar/VHF-FM-Lightbar.step

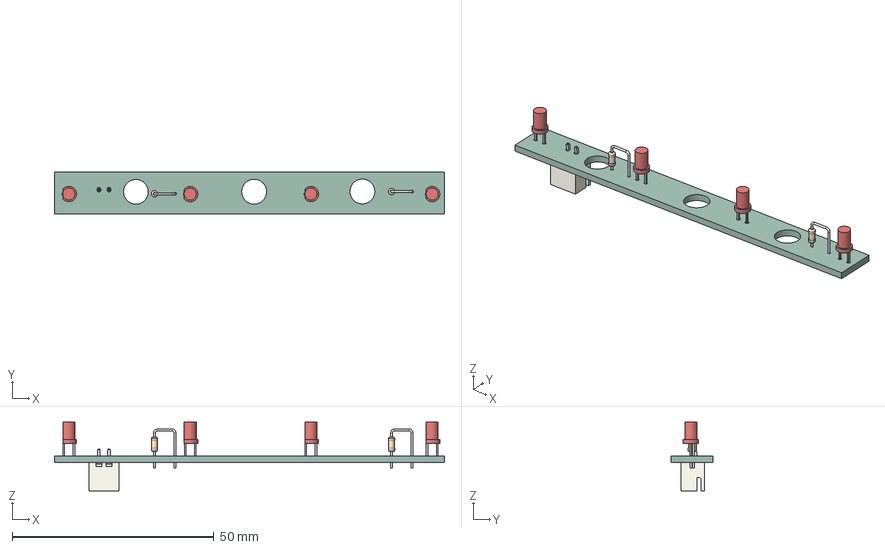
[picture p51: CAD file, 2025-11-29]
A10/A10 PCBs/Left Console Individual PCBs/VHF-FM-Lightbar/VHF-FM-Lightbar.step
96.5 x 10.3 x 17.0 mm
R_Axial_DIN0204_L36mm_D16mm_P508mm_Vertical x 2
LED_D3.0mm_FlatTop x 4
JST_B2B_XH_A
_autosave-VHF-FM-Lightbar_PCB
