bnepethomas/bne-arduino-flight-simulator-interfaces/A10/A10 PCBs/Left Console Input and Output with Rotary/MANUFACTURING/Left Console Input and Output with Rotary-NPTH-drl_map.dxf

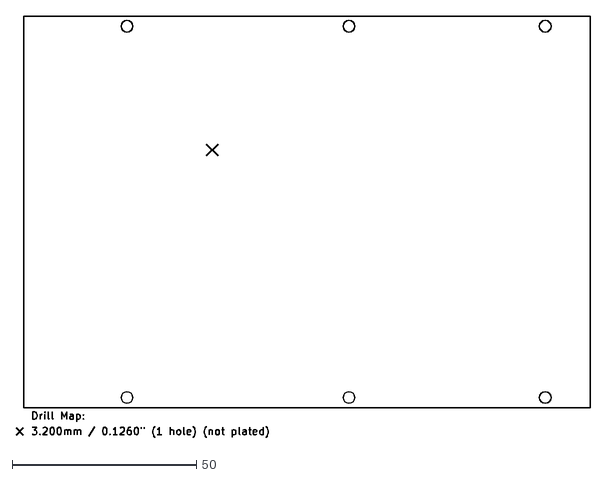
[picture p53: CAD file, 2025-11-29]
A10/A10 PCBs/Left Console Input and Output with Rotary/MANUFACTURING/Left Console Input and Output with Rotary-NPTH-drl_map.dxf
156.0 x 114.4
