bnepethomas/bne-arduino-flight-simulator-interfaces/A10/A10 PCBs/Left Console Input/MANUFACTURING/Left Console Input-NPTH-drl_map.dxf

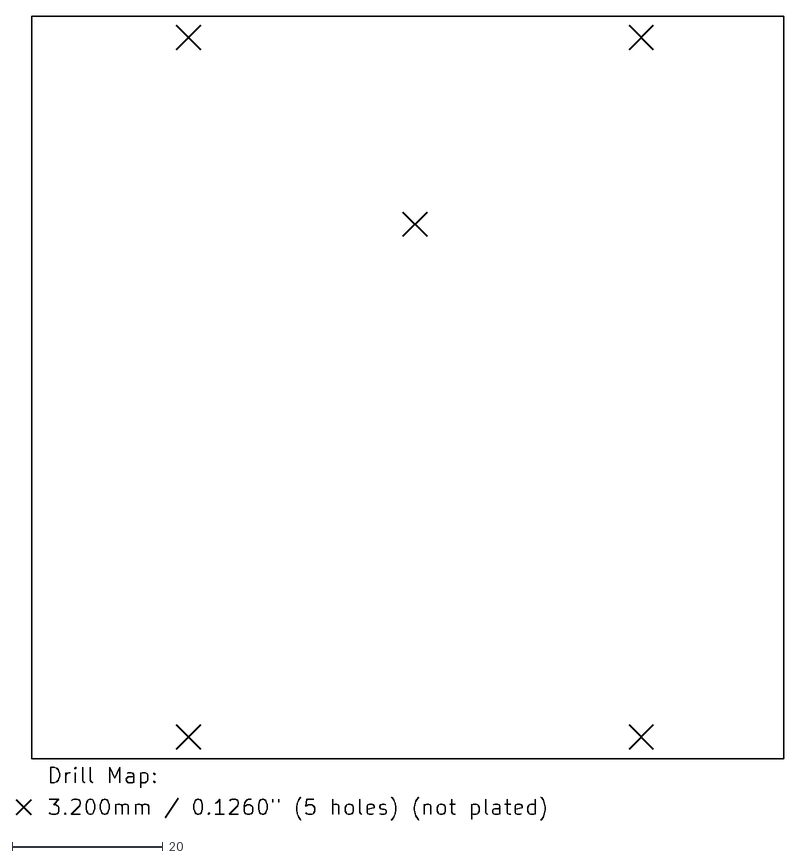
[picture p54: CAD file, 2025-11-29]
A10/A10 PCBs/Left Console Input/MANUFACTURING/Left Console Input-NPTH-drl_map.dxf
101.8 x 106.6
