bnepethomas/bne-arduino-flight-simulator-interfaces/A10/A10 PCBs/Right Console Individual PCBs/Caution Panel/MANUFACTURING/Caution Panel-PTH-drl_map.dxf

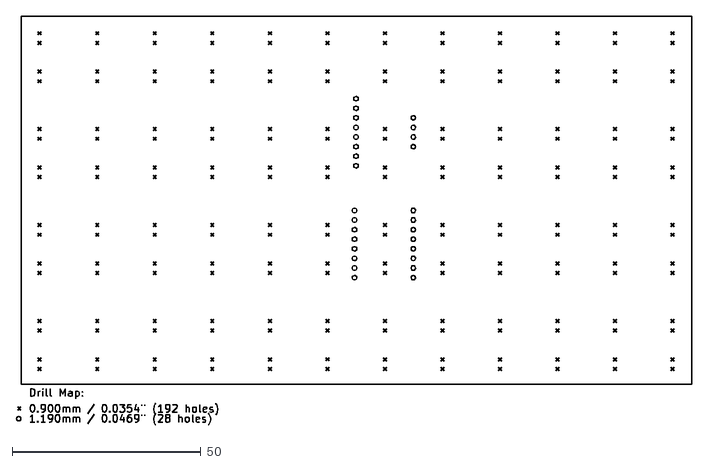
[picture p55: CAD file, 2025-11-29]
A10/A10 PCBs/Right Console Individual PCBs/Caution Panel/MANUFACTURING/Caution Panel-PTH-drl_map.dxf
178.7 x 108.3
