bnepethomas/bne-arduino-flight-simulator-interfaces/A10/A10 PCBs/Right Console Individual PCBs/EWS/MANUFACTURING/EWS-PTH-drl_map.dxf

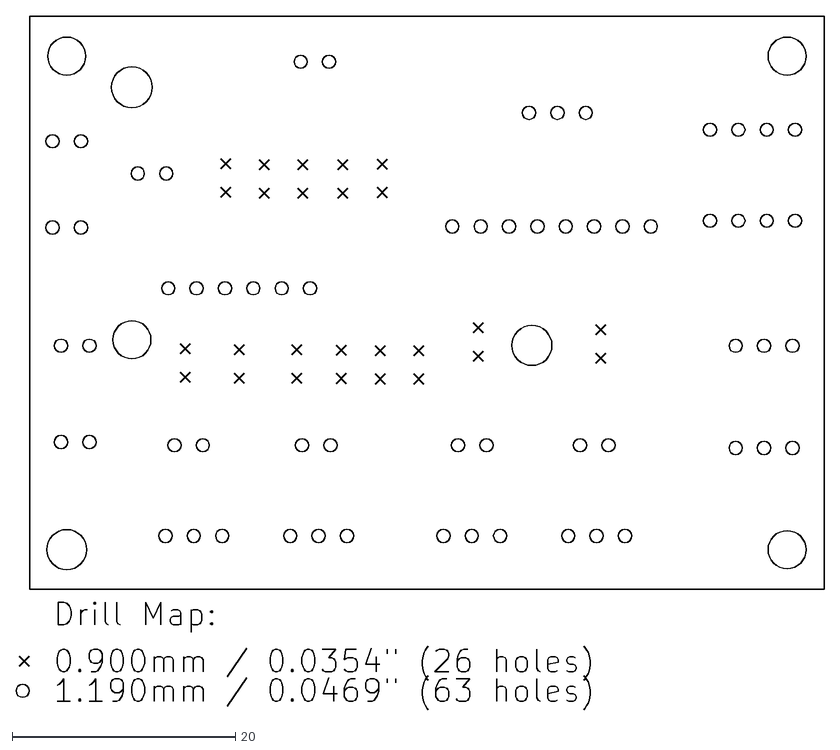
[picture p56: CAD file, 2025-11-29]
A10/A10 PCBs/Right Console Individual PCBs/EWS/MANUFACTURING/EWS-PTH-drl_map.dxf
72.4 x 62.1
