bnepethomas/bne-arduino-flight-simulator-interfaces/A10/A10 PCBs/Right Console Input/MANUFACTURING/Right Console Input-PTH-drl_map.dxf

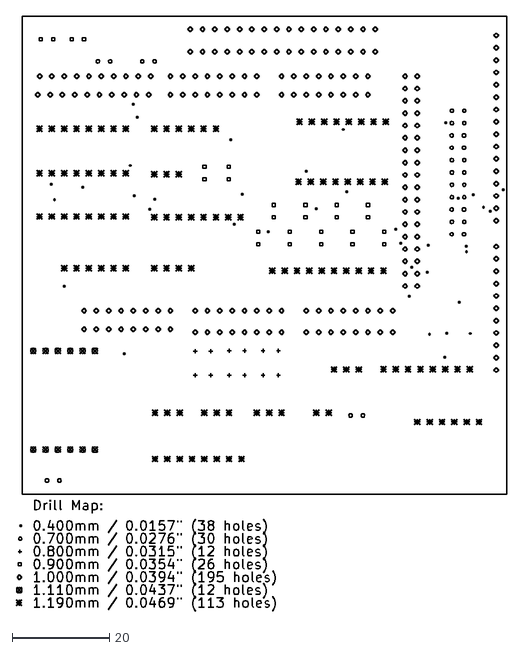
[picture p57: CAD file, 2025-11-29]
A10/A10 PCBs/Right Console Input/MANUFACTURING/Right Console Input-PTH-drl_map.dxf
101.0 x 122.4
