bnepethomas/bne-arduino-flight-simulator-interfaces/Hornet/Hornet Documentation/Power Support Drawing v4 Sheet1.dxf

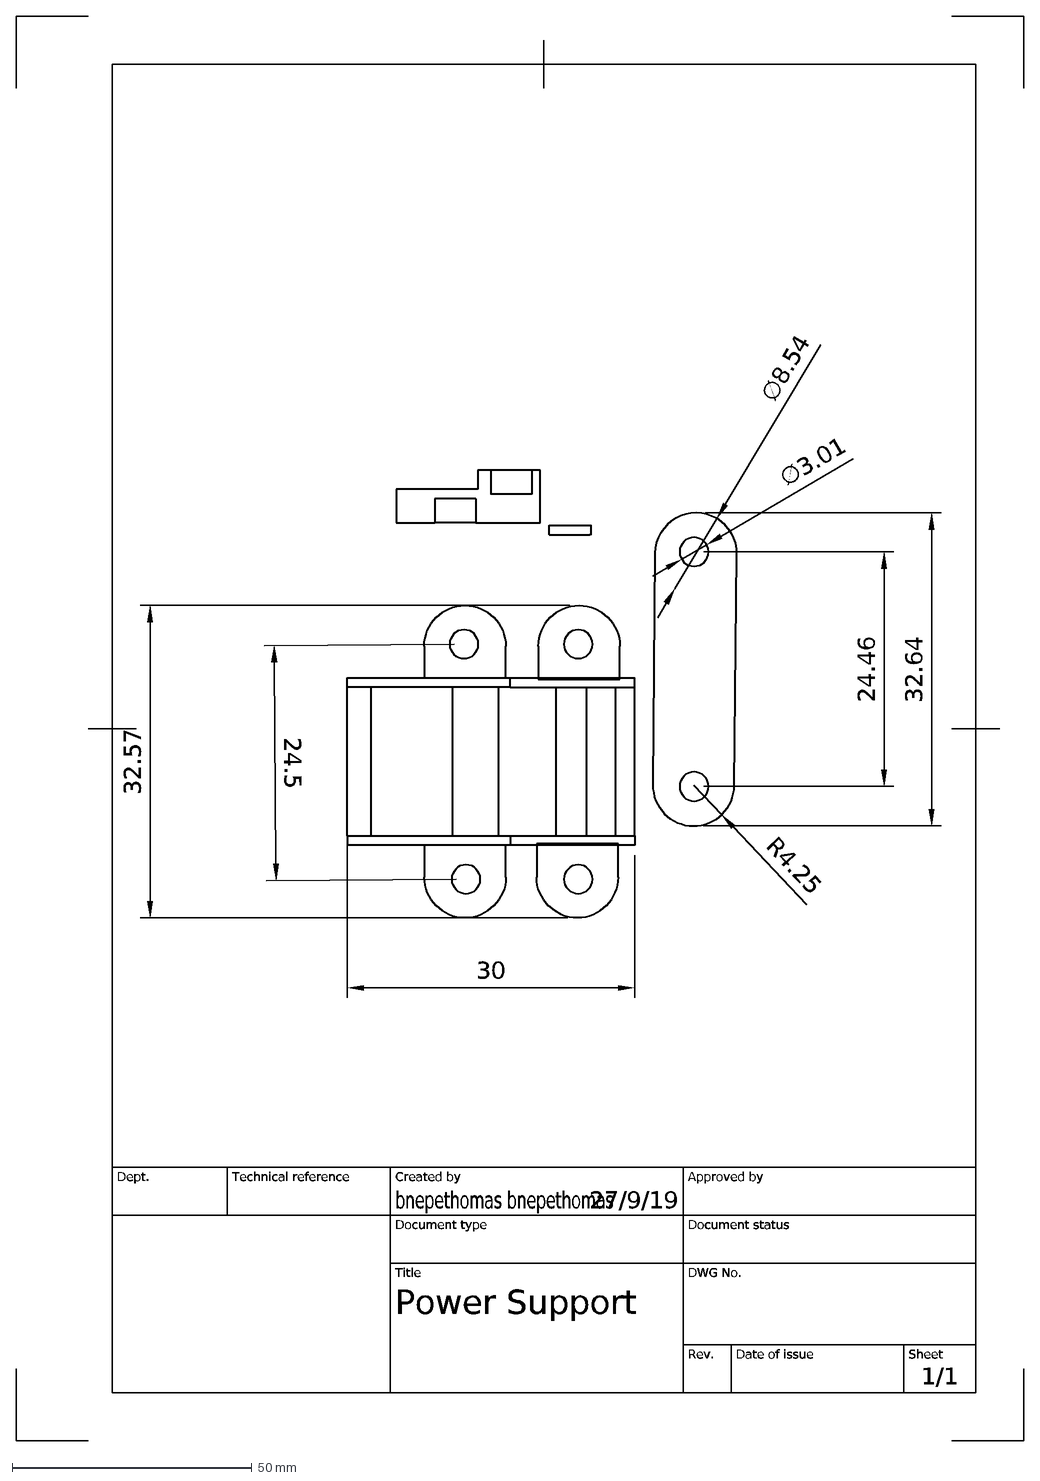
[picture p58: CAD file, 2025-11-29]
Hornet/Hornet Documentation/Power Support Drawing v4 Sheet1.dxf
27/9/19
1/1
Power Support
bnepethomas bnepethomas
Dept.
Technical reference
Created by
Approved by
Document type
Document status
Title
DWG No.
Rev.
Date of issue
Sheet
24.46
∅8.54
R4.25
∅3.01
24.5
30
32.64
32.57
