bnepethomas/bne-arduino-flight-simulator-interfaces/Hornet/Hornet OH 3d Mods/AOA/Combined AOA 5mm LED v13.step

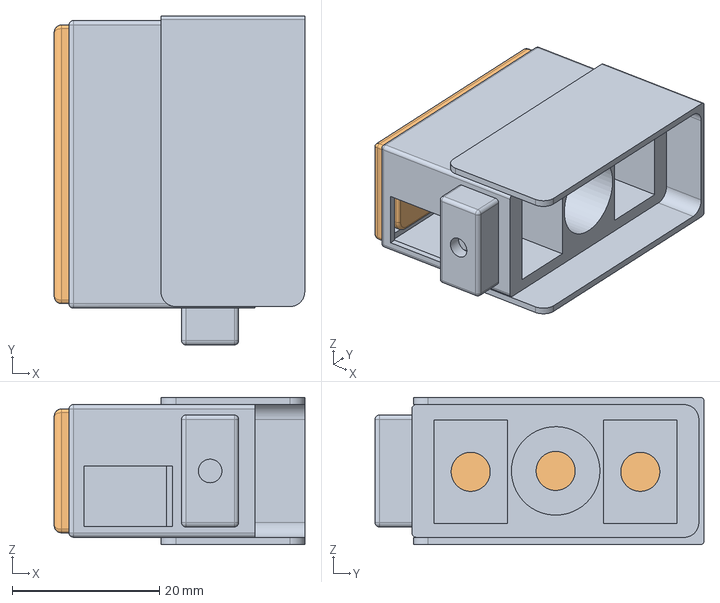
[picture p59: CAD file, 2025-11-29]
Hornet/Hornet OH 3d Mods/AOA/Combined AOA 5mm LED v13.step
34.0 x 44.6 x 20.0 mm
AOA Front Assembly
Rear Cover
