bnepethomas/bne-arduino-flight-simulator-interfaces/Hornet/Hornet OH 3d Mods/ATX Power Supply Mount/ATX Power Supply Mount v5.step

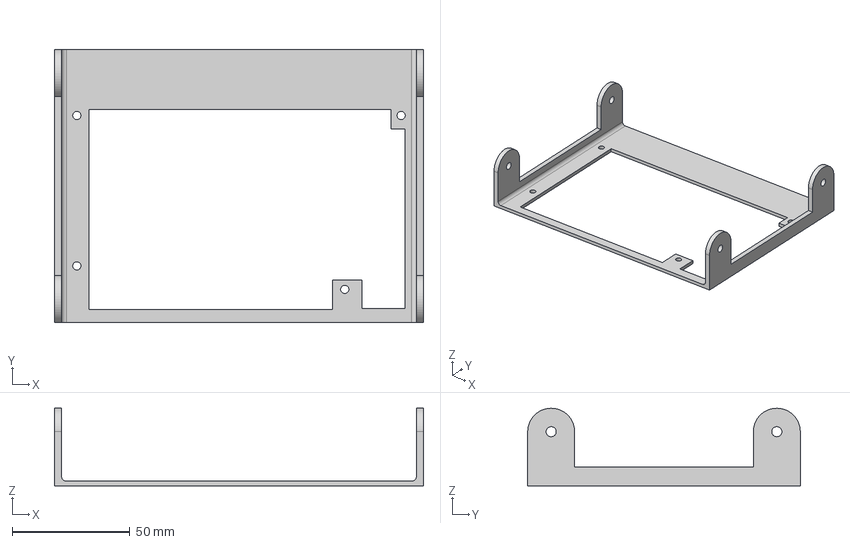
[picture p60: CAD file, 2025-11-29]
Hornet/Hornet OH 3d Mods/ATX Power Supply Mount/ATX Power Supply Mount v5.step
157.0 x 116.0 x 33.0 mm
