bnepethomas/bne-arduino-flight-simulator-interfaces/Hornet/Hornet OH 3d Mods/Canopy Bow Mounts/Canopy Bow Mount v4.step

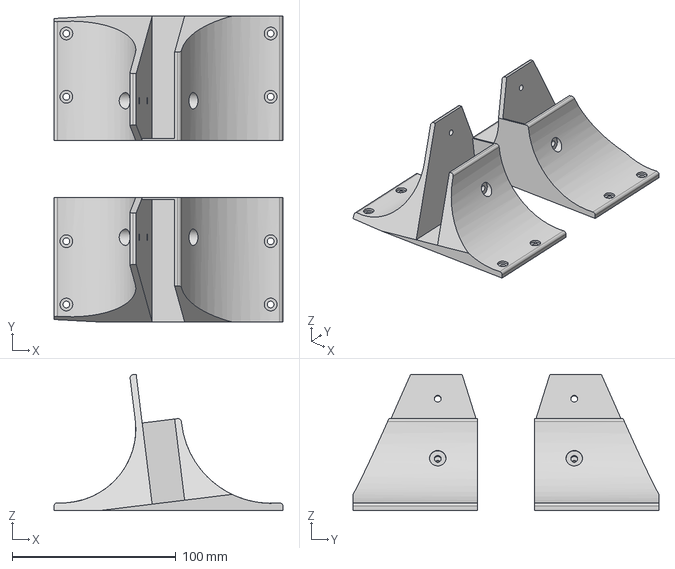
[picture p61: CAD file, 2025-11-29]
Hornet/Hornet OH 3d Mods/Canopy Bow Mounts/Canopy Bow Mount v4.step
140.0 x 187.0 x 83.4 mm
