bnepethomas/bne-arduino-flight-simulator-interfaces/Hornet/Hornet OH 3d Mods/Chart Light/Hornet Chart Light v3.step

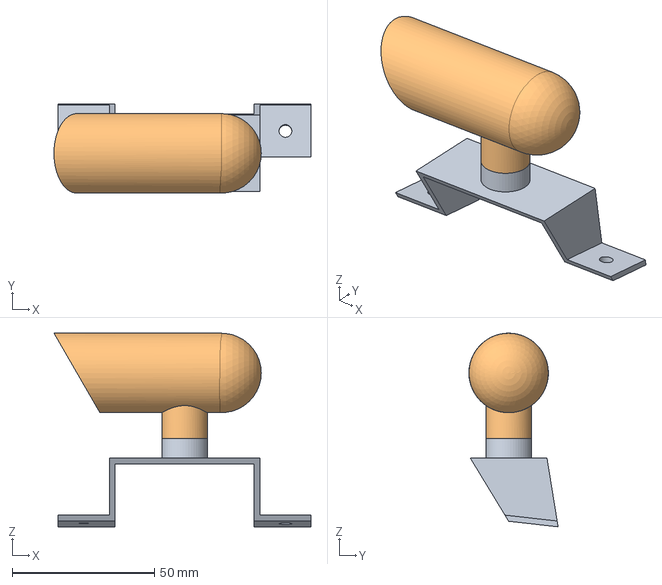
[picture p62: CAD file, 2025-11-29]
Hornet/Hornet OH 3d Mods/Chart Light/Hornet Chart Light v3.step
90.5 x 31.4 x 68.2 mm
Mount Base
Lamp
