bnepethomas/bne-arduino-flight-simulator-interfaces/Hornet/Hornet OH 3d Mods/Cockpit HandHeld Light Bracket/COCKPIT HANDHELD LIGHT BRACKET v3.step

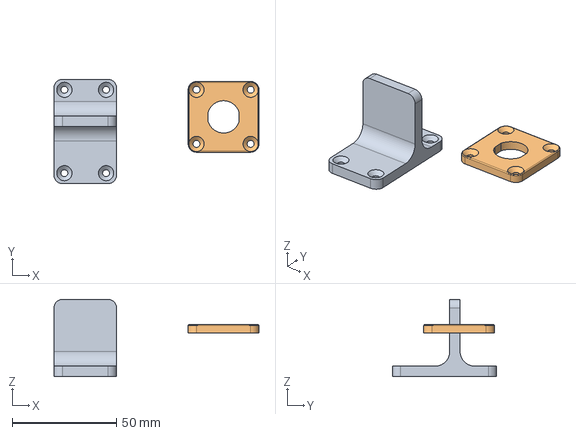
[picture p63: CAD file, 2025-11-29]
Hornet/Hornet OH 3d Mods/Cockpit HandHeld Light Bracket/COCKPIT HANDHELD LIGHT BRACKET v3.step
98.4 x 50.0 x 37.0 mm
