bnepethomas/bne-arduino-flight-simulator-interfaces/Hornet/Hornet OH 3d Mods/DDI/ufc comknob v1.stl

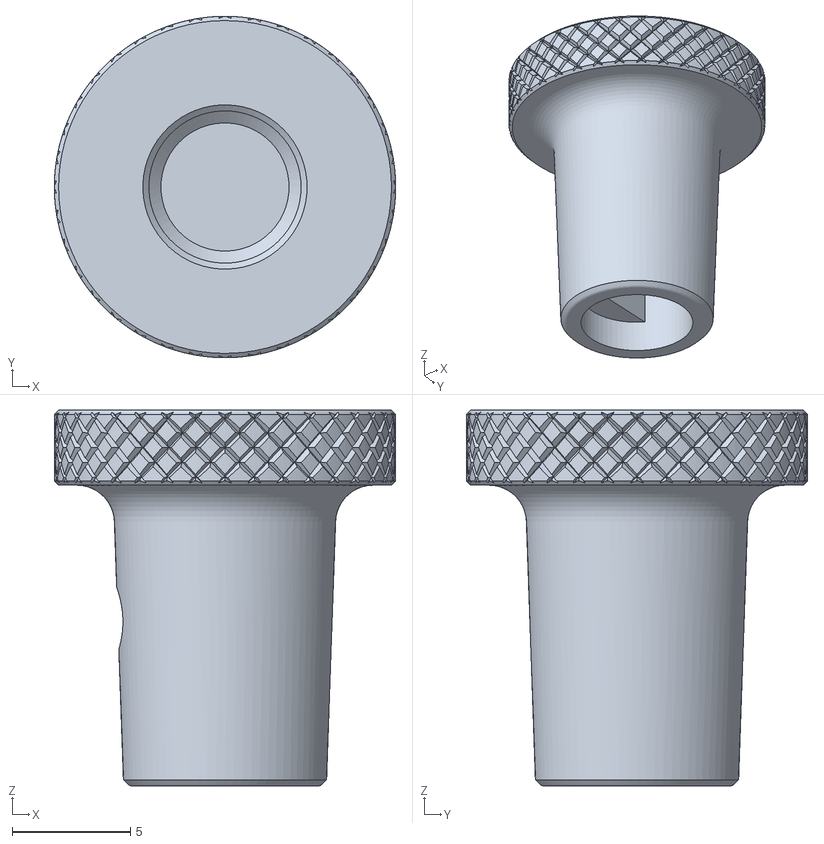
[picture p64: CAD file, 2025-11-29]
Hornet/Hornet OH 3d Mods/DDI/ufc comknob v1.stl
14.4 x 14.4 x 15.9
