bnepethomas/bne-arduino-flight-simulator-interfaces/Hornet/Hornet OH 3d Mods/ECM Button/ECM Button Angle Supports v4.step

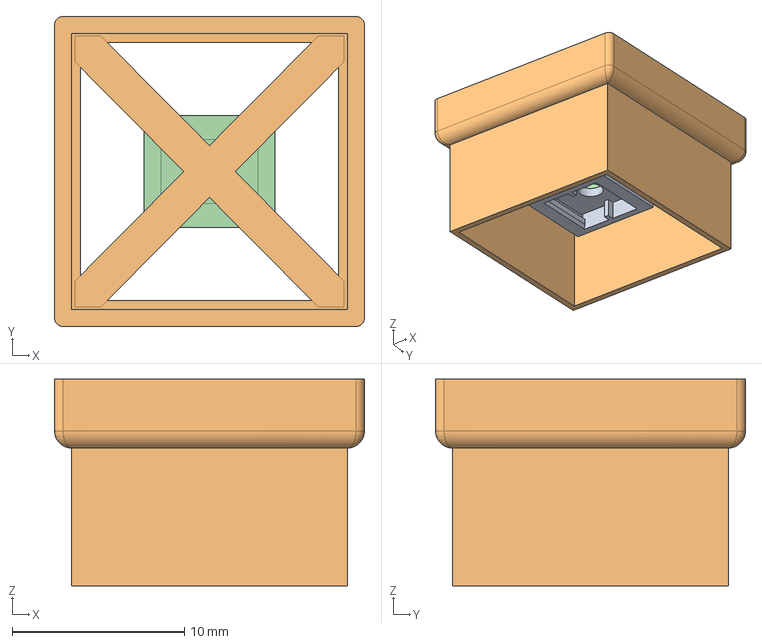
[picture p65: CAD file, 2025-11-29]
Hornet/Hornet OH 3d Mods/ECM Button/ECM Button Angle Supports v4.step
18.0 x 18.0 x 12.0 mm
