bnepethomas/bne-arduino-flight-simulator-interfaces/Hornet/Hornet OH 3d Mods/ECS Bleed Air/Bleed Air Mount v5.step

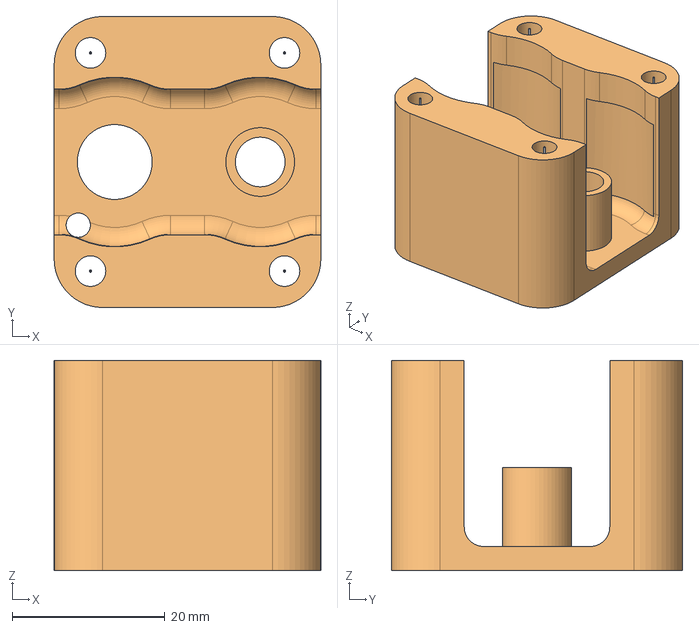
[picture p66: CAD file, 2025-11-29]
Hornet/Hornet OH 3d Mods/ECS Bleed Air/Bleed Air Mount v5.step
34.9 x 38.1 x 27.5 mm
