bnepethomas/bne-arduino-flight-simulator-interfaces/Hornet/Hornet OH 3d Mods/EWI/EWI_Warning_Cover_v1.stl

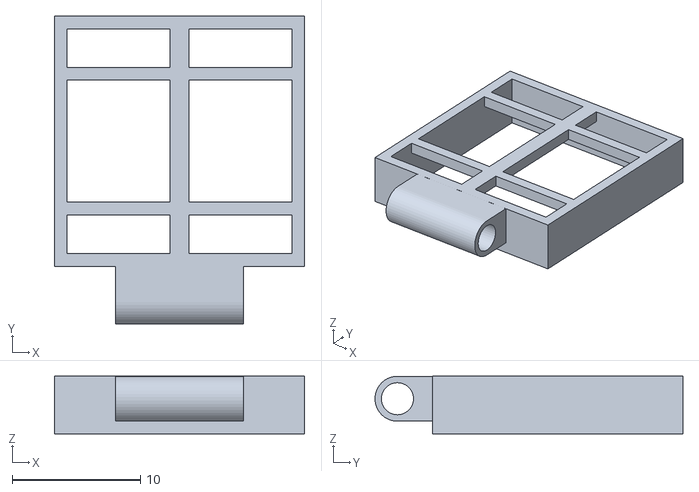
[picture p67: CAD file, 2025-11-29]
Hornet/Hornet OH 3d Mods/EWI/EWI_Warning_Cover_v1.stl
19.5 x 24.0 x 4.50
