bnepethomas/bne-arduino-flight-simulator-interfaces/Hornet/Hornet OH 3d Mods/Flood Lights/Forward Flood Lights/Rear Mount.stl

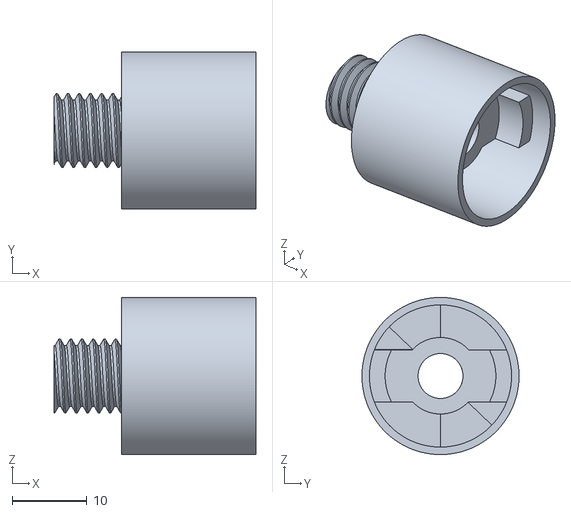
[picture p68: CAD file, 2025-11-29]
Hornet/Hornet OH 3d Mods/Flood Lights/Forward Flood Lights/Rear Mount.stl
27.0 x 21.0 x 21.0
