bnepethomas/bne-arduino-flight-simulator-interfaces/Hornet/Hornet OH 3d Mods/Flood Lights/Left Circuit Breaker/Bulb Support Rear Mount.stl

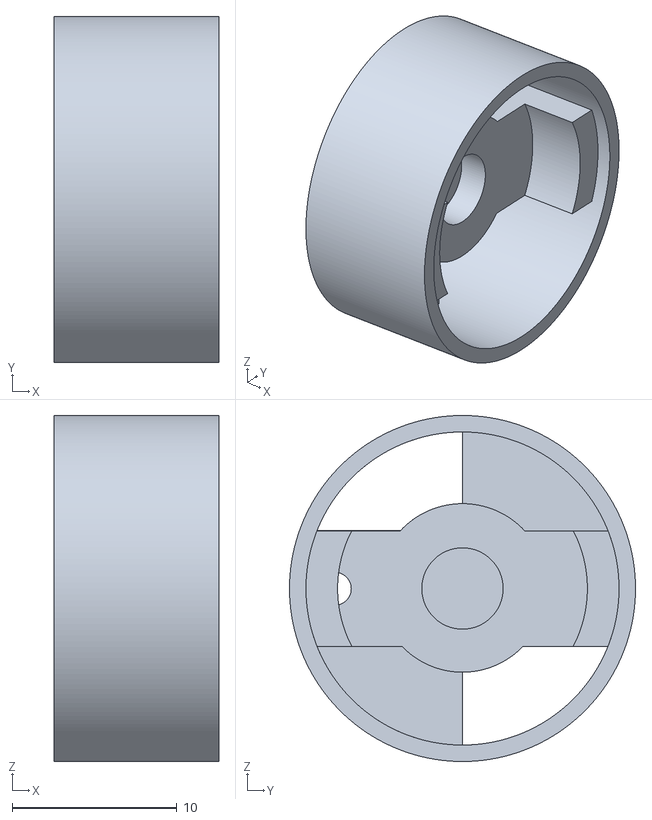
[picture p69: CAD file, 2025-11-29]
Hornet/Hornet OH 3d Mods/Flood Lights/Left Circuit Breaker/Bulb Support Rear Mount.stl
10.0 x 21.0 x 21.0
