bnepethomas/bne-arduino-flight-simulator-interfaces/Hornet/Hornet OH 3d Mods/Flood Lights/Mid Flood Lights/Flood Light Bracket Right v3.step

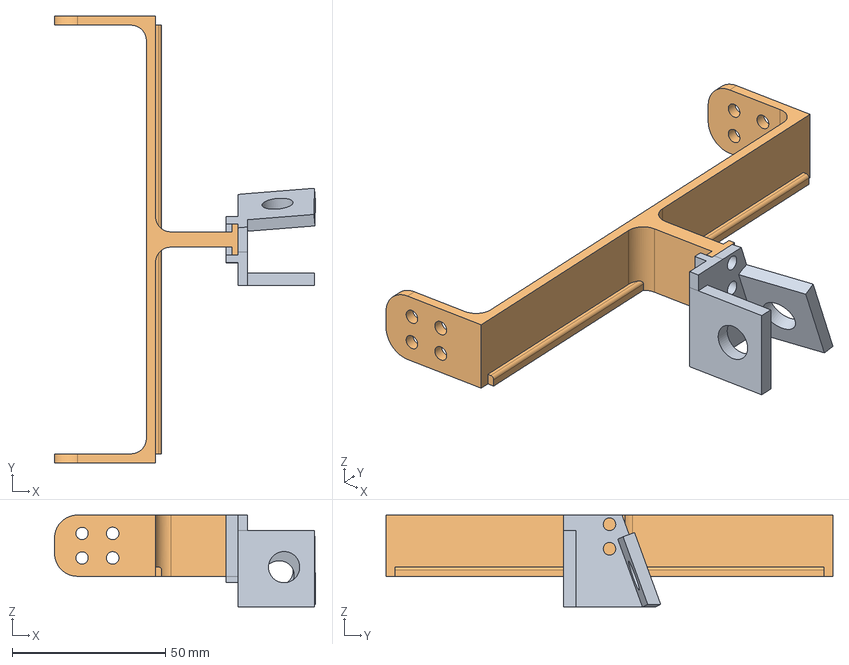
[picture p70: CAD file, 2025-11-29]
Hornet/Hornet OH 3d Mods/Flood Lights/Mid Flood Lights/Flood Light Bracket Right v3.step
85.3 x 146.0 x 30.0 mm
Primary Mount
