bnepethomas/bne-arduino-flight-simulator-interfaces/Hornet/Hornet OH 3d Mods/Flood Lights/Right Circuit Breaker/Right Circuit Breaker Front Plate.3mf

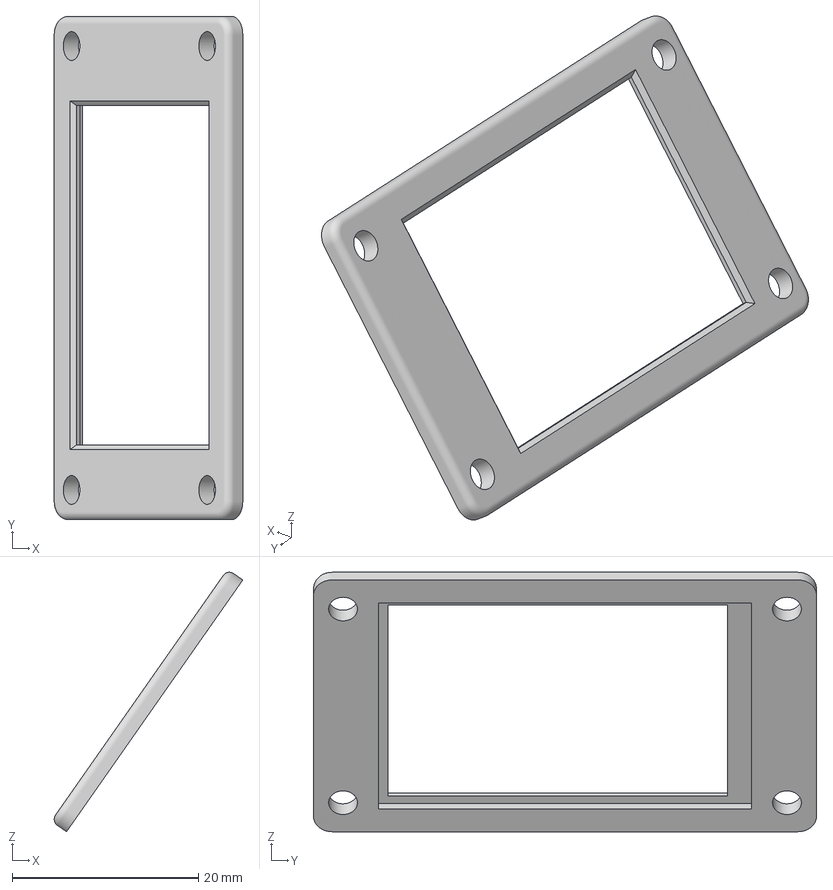
[picture p71: CAD file, 2025-11-29]
Hornet/Hornet OH 3d Mods/Flood Lights/Right Circuit Breaker/Right Circuit Breaker Front Plate.3mf
20.2 x 54.0 x 27.9 mm
