bnepethomas/bne-arduino-flight-simulator-interfaces/Hornet/Hornet OH 3d Mods/G- H Outboard Spacer with Cable Hole/G-H Outboard Spacer with Cable Hole.stl

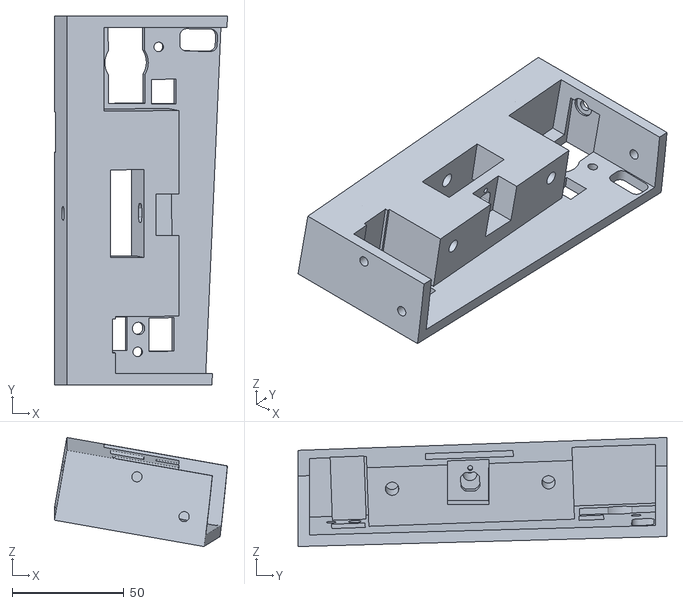
[picture p72: CAD file, 2025-11-29]
Hornet/Hornet OH 3d Mods/G- H Outboard Spacer with Cable Hole/G-H Outboard Spacer with Cable Hole.stl
77.4 x 165.1 x 48.8
