bnepethomas/bne-arduino-flight-simulator-interfaces/Hornet/Hornet OH 3d Mods/Jet Select/Selective Jet Bezels.stl

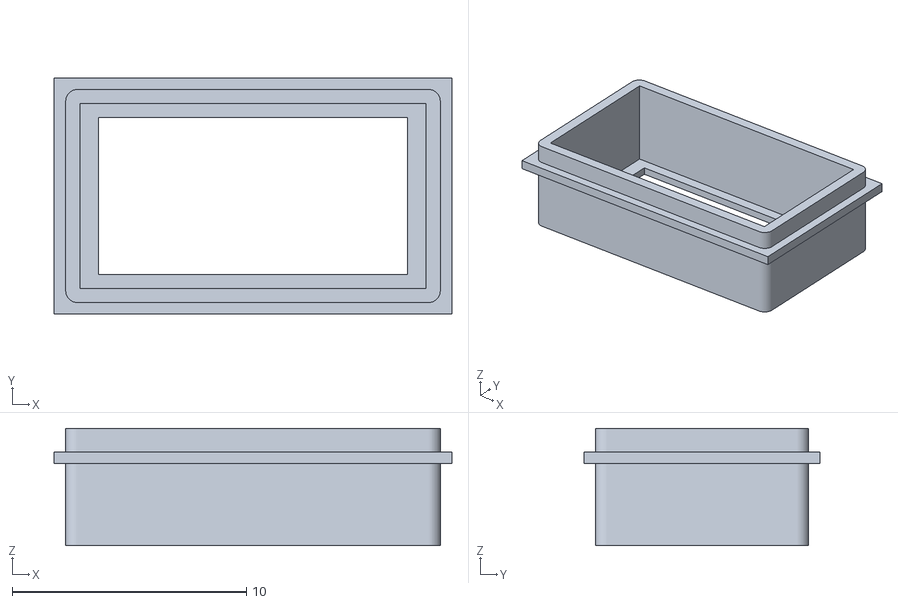
[picture p73: CAD file, 2025-11-29]
Hornet/Hornet OH 3d Mods/Jet Select/Selective Jet Bezels.stl
17.0 x 10.1 x 5.00
