bnepethomas/bne-arduino-flight-simulator-interfaces/Hornet/Hornet OH 3d Mods/Lock Shoot/Lock Shoot v26.step

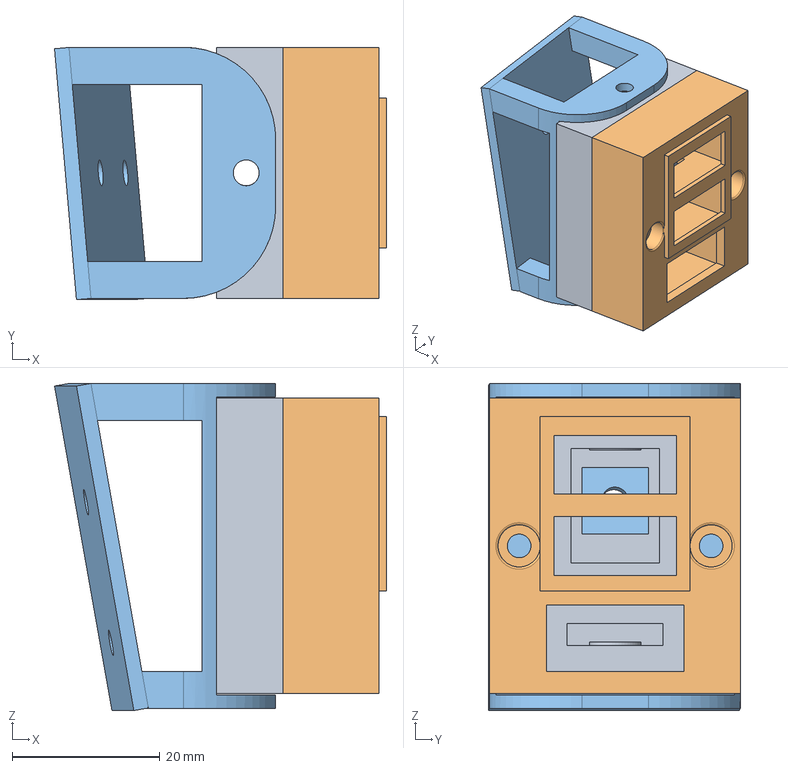
[picture p74: CAD file, 2025-11-29]
Hornet/Hornet OH 3d Mods/Lock Shoot/Lock Shoot v26.step
45.0 x 34.2 x 44.3 mm
Rear
Front
Mount
