bnepethomas/bne-arduino-flight-simulator-interfaces/Hornet/Hornet OH 3d Mods/Master Arm/AG AA Recess v9.stl

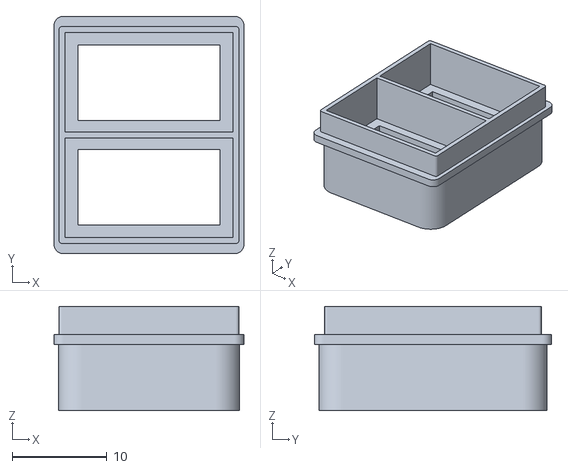
[picture p75: CAD file, 2025-11-29]
Hornet/Hornet OH 3d Mods/Master Arm/AG AA Recess v9.stl
20.0 x 25.0 x 11.0
