bnepethomas/bne-arduino-flight-simulator-interfaces/Hornet/Hornet OH 3d Mods/Mirror Mounts for Canopy Bow/Mirror LCD v9.step

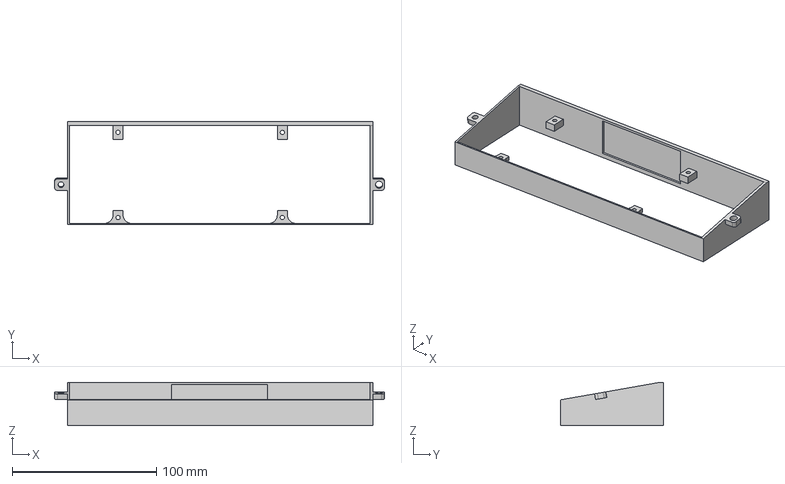
[picture p76: CAD file, 2025-11-29]
Hornet/Hornet OH 3d Mods/Mirror Mounts for Canopy Bow/Mirror LCD v9.step
229.0 x 71.8 x 30.0 mm
