bnepethomas/bne-arduino-flight-simulator-interfaces/Hornet/Hornet OH 3d Mods/Motorised Pedals/Motor Adapter.stl

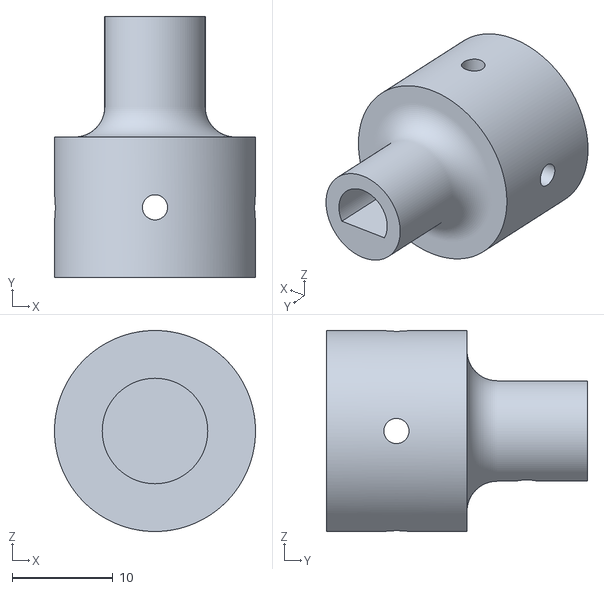
[picture p77: CAD file, 2025-11-29]
Hornet/Hornet OH 3d Mods/Motorised Pedals/Motor Adapter.stl
20.0 x 26.0 x 20.0
