bnepethomas/bne-arduino-flight-simulator-interfaces/Hornet/Hornet OH 3d Mods/PCB Mounting Brackets/MOUNT 1.stl

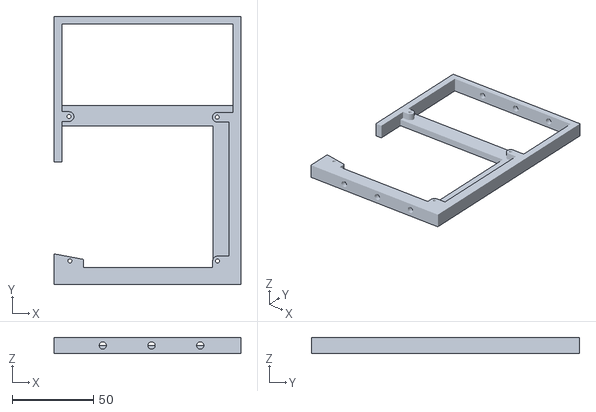
[picture p78: CAD file, 2025-11-29]
Hornet/Hornet OH 3d Mods/PCB Mounting Brackets/MOUNT 1.stl
115.0 x 165.0 x 10.0
