bnepethomas/bne-arduino-flight-simulator-interfaces/Hornet/Hornet OH 3d Mods/Right Aux Panel/Right Aux Panel.dxf

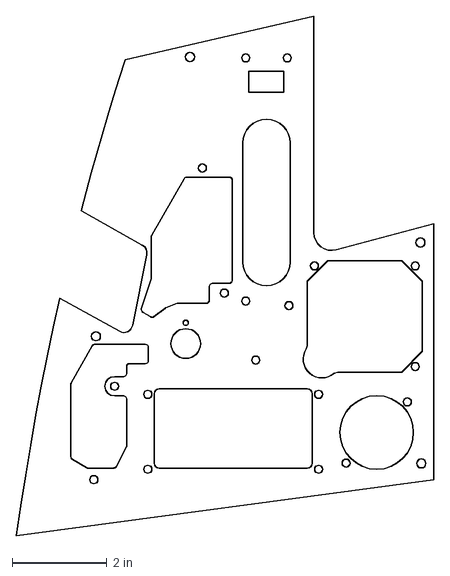
[picture p79: CAD file, 2025-11-29]
Hornet/Hornet OH 3d Mods/Right Aux Panel/Right Aux Panel.dxf
8.80 x 11.0 in
