bnepethomas/bne-arduino-flight-simulator-interfaces/Hornet/Hornet OH 3d Mods/Right Aux Support Bracket Lower Right/Right_AUX_Support_Bracket_Lower_Outboard_v2 v5.step

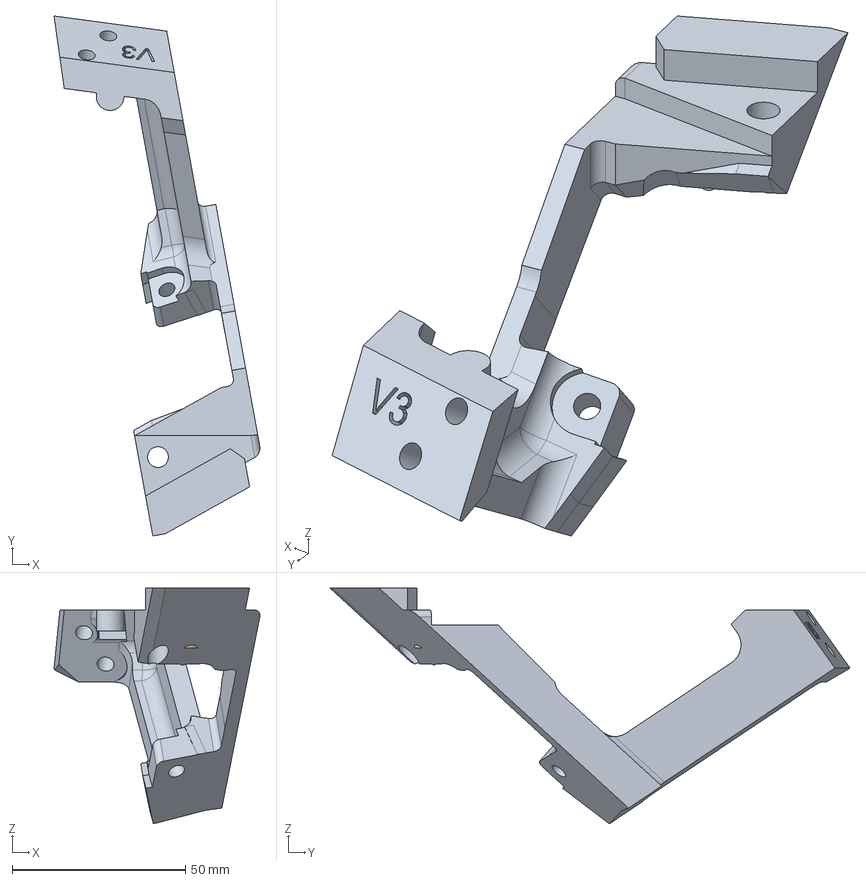
[picture p80: CAD file, 2025-11-29]
Hornet/Hornet OH 3d Mods/Right Aux Support Bracket Lower Right/Right_AUX_Support_Bracket_Lower_Outboard_v2 v5.step
59.5 x 150.2 x 68.1 mm
