bnepethomas/bne-arduino-flight-simulator-interfaces/Hornet/Hornet OH 3d Mods/Standby Offset Shim/Standby Instrument Lower Support v1.stl

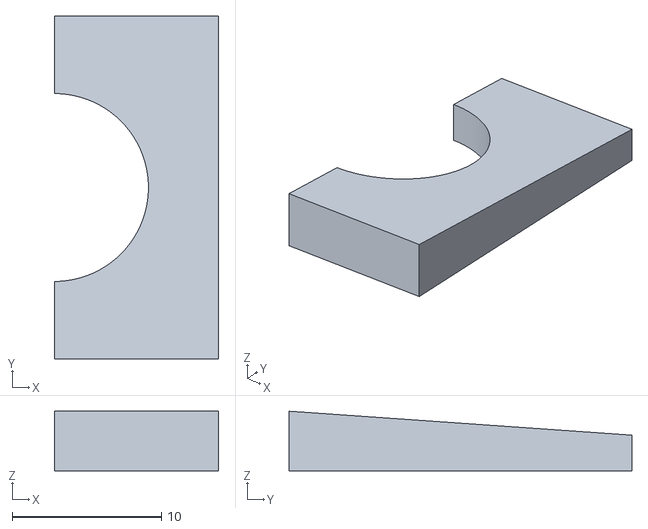
[picture p81: CAD file, 2025-11-29]
Hornet/Hornet OH 3d Mods/Standby Offset Shim/Standby Instrument Lower Support v1.stl
11.0 x 23.0 x 4.00
