bnepethomas/bne-arduino-flight-simulator-interfaces/Hornet/Hornet PCBs/Active/55_SQ_Indicator/docs/.55_SQ_Indicator_PCB.DXF

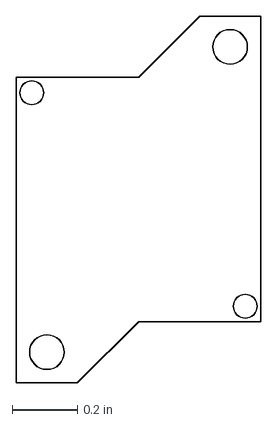
[picture p82: CAD file, 2025-11-29]
Hornet/Hornet PCBs/Active/55_SQ_Indicator/docs/.55_SQ_Indicator_PCB.DXF
0.75 x 1.12 in
