bnepethomas/bne-arduino-flight-simulator-interfaces/Hornet/Hornet PCBs/Active/55_SQ_Indicator/sq_indicator.step

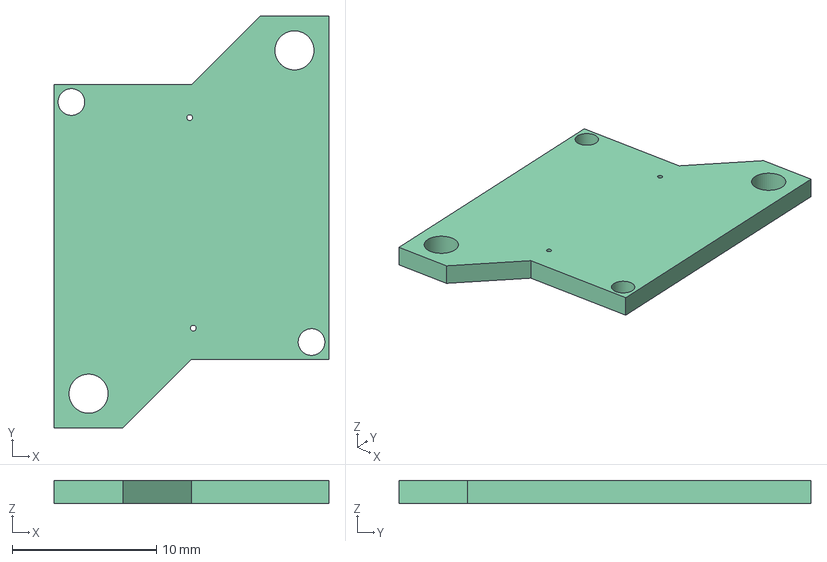
[picture p83: CAD file, 2025-11-29]
Hornet/Hornet PCBs/Active/55_SQ_Indicator/sq_indicator.step
19.1 x 28.6 x 1.60 mm
Local_CS
Step_Models
