bnepethomas/bne-arduino-flight-simulator-interfaces/Hornet/Hornet PCBs/Active/AMPCD_button_board/Buttons_AMPCD.step

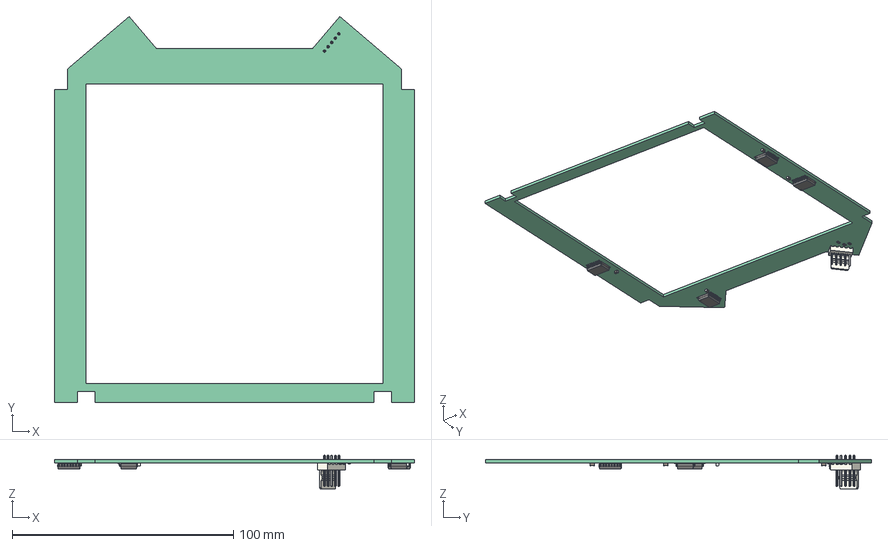
[picture p84: CAD file, 2025-11-29]
Hornet/Hornet PCBs/Active/AMPCD_button_board/Buttons_AMPCD.step
162.8 x 174.4 x 15.3 mm
Local_CS
Pcb
J1_Molex_AE_6410_05A_5BFE15CE
R1_R_0805_2012Metric_5BFE15DF
R2_R_0805_2012Metric_5BFE15F0
U1_SOIC_16W_75x103mm_P127mm_5BFE1615
U2_SOIC_16W_75x103mm_P127mm_5BFE163A
U3_SOIC_16W_75x103mm_P127mm_5BFE165F
U4_SOIC_16W_75x103mm_P127mm_5BFE1684
R3_R_0805_2012Metric_5DB178B5
C1_C_0805_2012Metric_5DB179A6
C2_C_0805_2012Metric_5DB17F12
C3_C_0805_2012Metric_5DB179C8
C4_C_0805_2012Metric_5DB179D9
