bnepethomas/bne-arduino-flight-simulator-interfaces/Hornet/Hornet PCBs/Active/AMPCD_button_board/docs/AMPCD_PCB.DXF

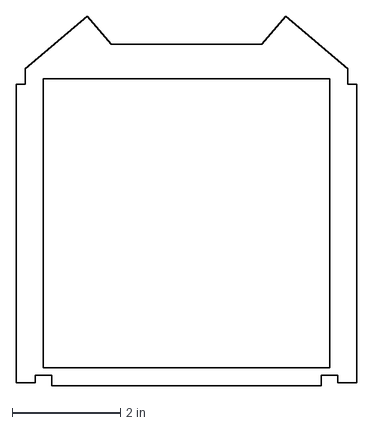
[picture p85: CAD file, 2025-11-29]
Hornet/Hornet PCBs/Active/AMPCD_button_board/docs/AMPCD_PCB.DXF
6.29 x 6.82 in
