bnepethomas/bne-arduino-flight-simulator-interfaces/Hornet/Hornet PCBs/Active/AMPCD_button_board/manufacturing/Buttons_AMPCD-NPTH-drl_map.dxf

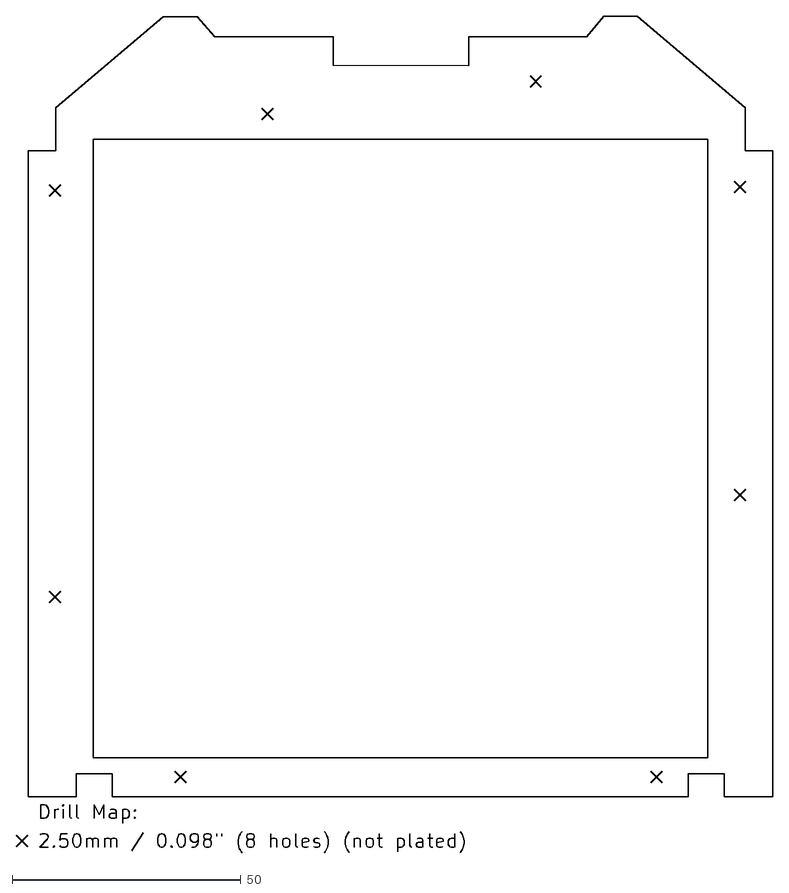
[picture p86: CAD file, 2025-11-29]
Hornet/Hornet PCBs/Active/AMPCD_button_board/manufacturing/Buttons_AMPCD-NPTH-drl_map.dxf
165.4 x 182.9
