bnepethomas/bne-arduino-flight-simulator-interfaces/Hornet/Hornet PCBs/Active/AP/AP.step

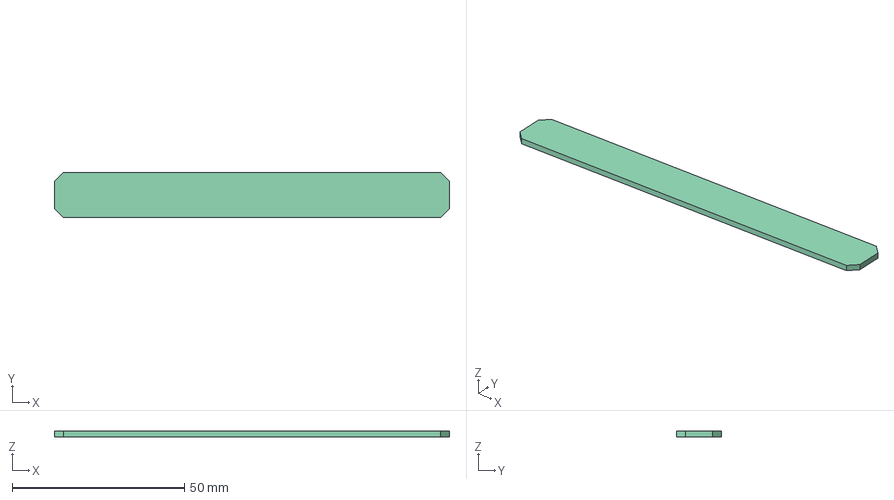
[picture p87: CAD file, 2025-11-29]
Hornet/Hornet PCBs/Active/AP/AP.step
114.6 x 13.0 x 1.60 mm
Local_CS
Pcb
Step_Models
