bnepethomas/bne-arduino-flight-simulator-interfaces/Hornet/Hornet PCBs/Active/AP/docs/AP_PCB.DXF

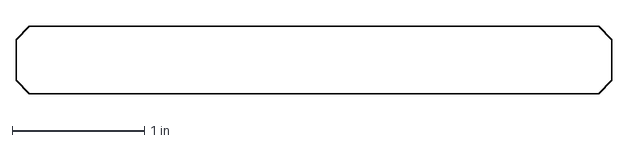
[picture p88: CAD file, 2025-11-29]
Hornet/Hornet PCBs/Active/AP/docs/AP_PCB.DXF
4.51 x 0.51 in
