bnepethomas/bne-arduino-flight-simulator-interfaces/Hornet/Hornet PCBs/Active/AP/manufacturing/AP-PTH-drl_map.dxf

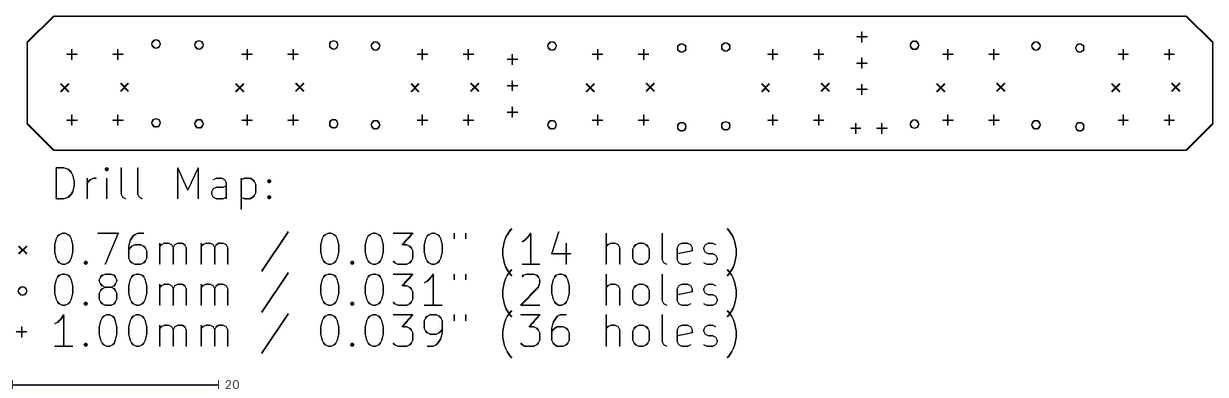
[picture p89: CAD file, 2025-11-29]
Hornet/Hornet PCBs/Active/AP/manufacturing/AP-PTH-drl_map.dxf
115.6 x 33.0
