bnepethomas/bne-arduino-flight-simulator-interfaces/Hornet/Hornet PCBs/Active/Arduino to Dual Serial/MANUFACTURING/Arduino to Dual Serial-PTH-drl_map.dxf

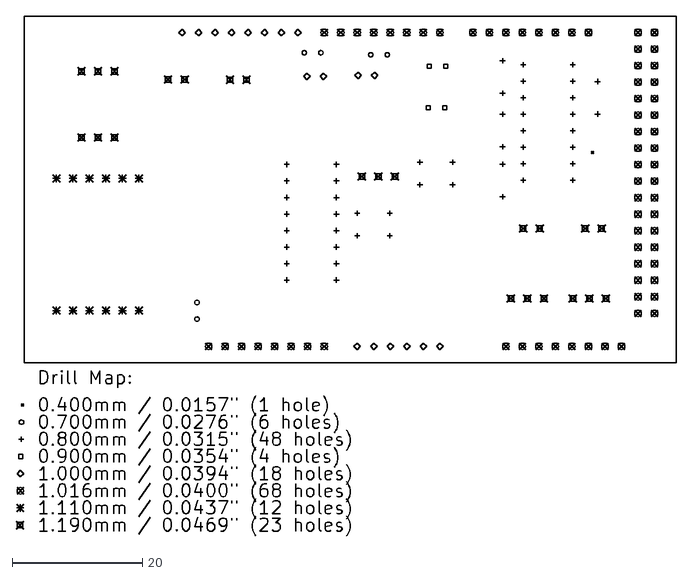
[picture p90: CAD file, 2025-11-29]
Hornet/Hornet PCBs/Active/Arduino to Dual Serial/MANUFACTURING/Arduino to Dual Serial-PTH-drl_map.dxf
101.5 x 80.0
