bnepethomas/bne-arduino-flight-simulator-interfaces/Hornet/Hornet PCBs/Active/AV COOL PANEL/MCAD/AV COOL PANEL.step

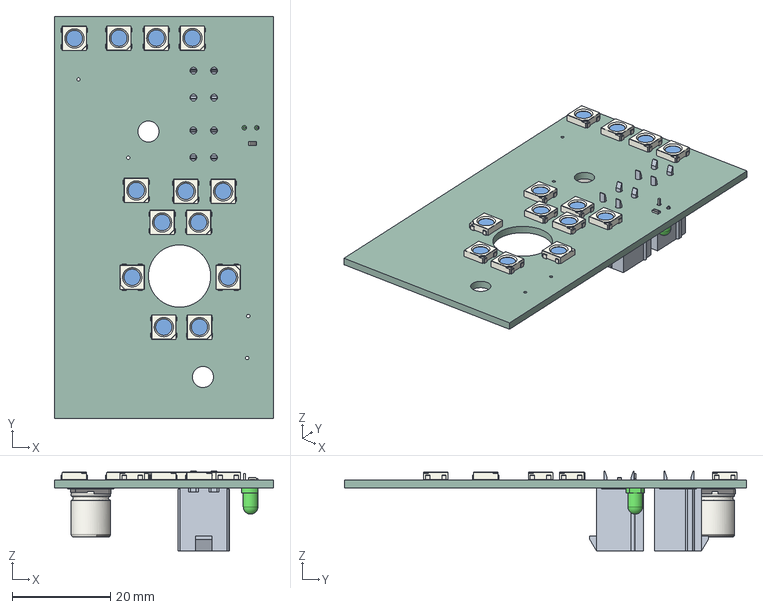
[picture p91: CAD file, 2025-11-29]
Hornet/Hornet PCBs/Active/AV COOL PANEL/MCAD/AV COOL PANEL.step
44.7 x 82.0 x 16.3 mm
AV COOL PANEL PCB
