bnepethomas/bne-arduino-flight-simulator-interfaces/Hornet/Hornet PCBs/Active/Backlighting V2/HYD_ISO_Panel_PCB_V2/MANUFACTURING/HYD ISO Panel PCB V2-NPTH-drl_map.dxf

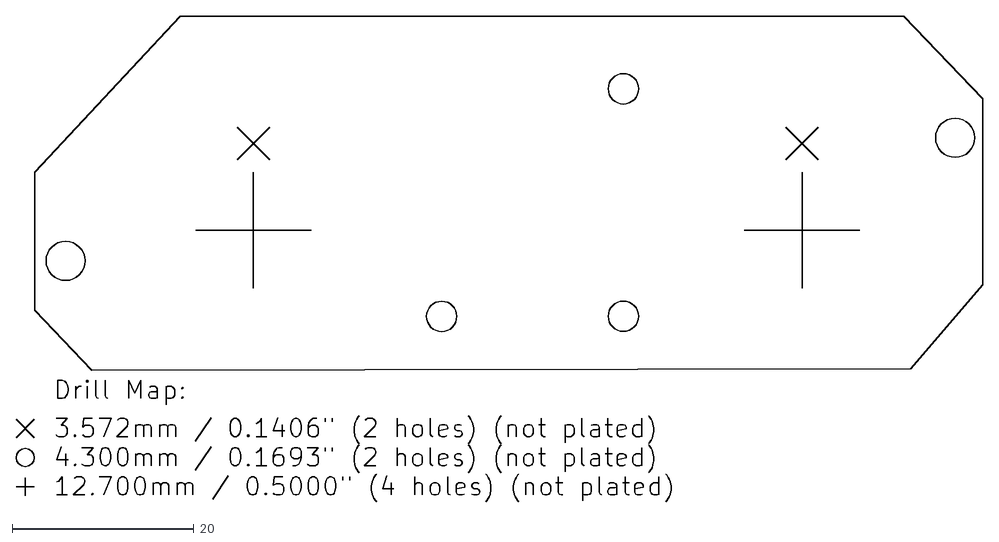
[picture p92: CAD file, 2025-11-29]
Hornet/Hornet PCBs/Active/Backlighting V2/HYD_ISO_Panel_PCB_V2/MANUFACTURING/HYD ISO Panel PCB V2-NPTH-drl_map.dxf
106.3 x 53.4
