bnepethomas/bne-arduino-flight-simulator-interfaces/Hornet/Hornet PCBs/Active/Backlighting V2/HYD_ISO_Panel_PCB_V2/MC HYD ISOL Backplate.DXF

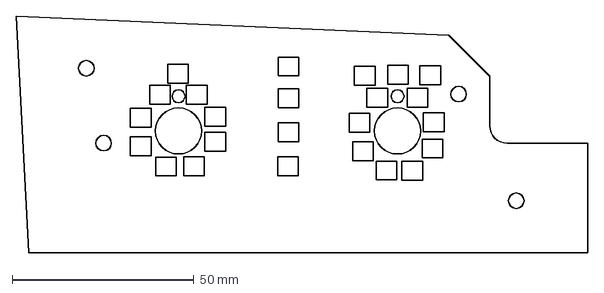
[picture p93: CAD file, 2025-11-29]
Hornet/Hornet PCBs/Active/Backlighting V2/HYD_ISO_Panel_PCB_V2/MC HYD ISOL Backplate.DXF
157.4 x 65.1 mm
