bnepethomas/bne-arduino-flight-simulator-interfaces/Hornet/Hornet PCBs/Active/Backlighting V2/INT-LT-F18/Manufacturing/INT-LT-F18-NPTH-drl_map.dxf

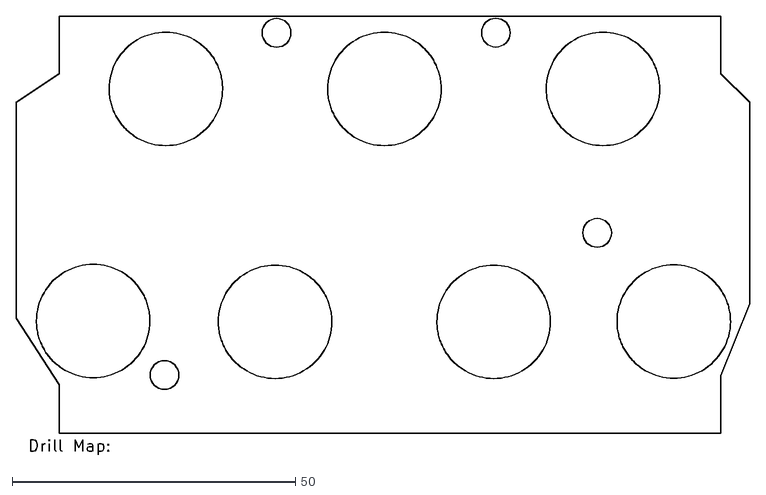
[picture p94: CAD file, 2025-11-29]
Hornet/Hornet PCBs/Active/Backlighting V2/INT-LT-F18/Manufacturing/INT-LT-F18-NPTH-drl_map.dxf
129.5 x 77.5
