bnepethomas/bne-arduino-flight-simulator-interfaces/Hornet/Hornet PCBs/Active/Backlighting V2/Landing_Gear_Panel_PCB_LED-V1.0/Landing Gear Panel Backplate.DXF

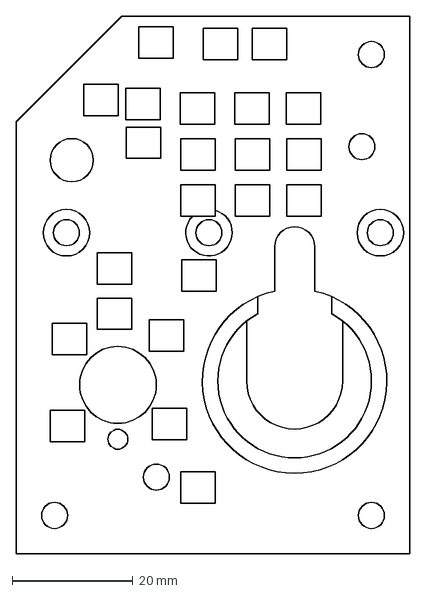
[picture p95: CAD file, 2025-11-29]
Hornet/Hornet PCBs/Active/Backlighting V2/Landing_Gear_Panel_PCB_LED-V1.0/Landing Gear Panel Backplate.DXF
65.1 x 88.9 mm
