bnepethomas/bne-arduino-flight-simulator-interfaces/Hornet/Hornet PCBs/Active/Backlighting V2/Landing_Gear_Panel_PCB_LED-V1.0/Manufacturing/Landing Gear Panel PCB V2-PTH-drl_map.dxf

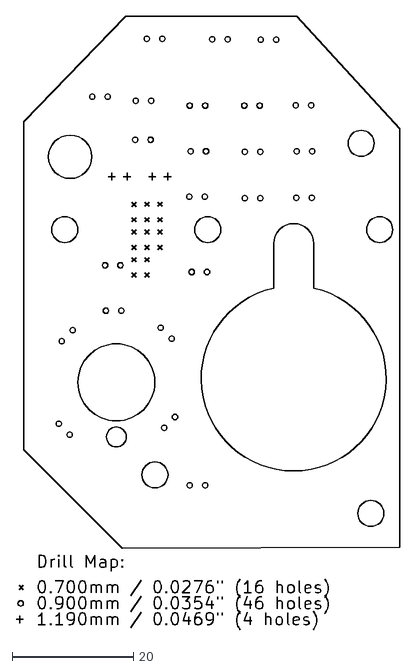
[picture p96: CAD file, 2025-11-29]
Hornet/Hornet PCBs/Active/Backlighting V2/Landing_Gear_Panel_PCB_LED-V1.0/Manufacturing/Landing Gear Panel PCB V2-PTH-drl_map.dxf
63.2 x 101.0
