bnepethomas/bne-arduino-flight-simulator-interfaces/Hornet/Hornet PCBs/Active/BRAKE-PRES-V01/BRAKE-PRES-V01.step

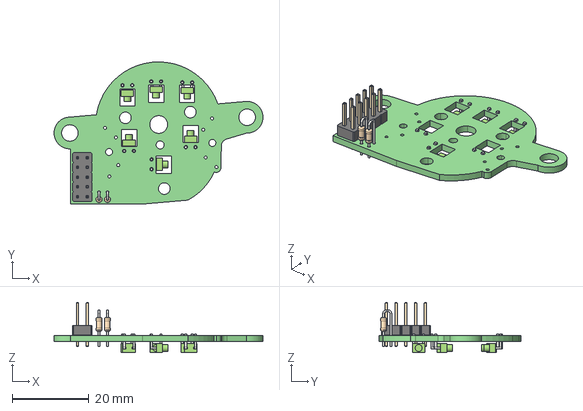
[picture p97: CAD file, 2025-11-29]
Hornet/Hornet PCBs/Active/BRAKE-PRES-V01/BRAKE-PRES-V01.step
54.4 x 37.0 x 13.1 mm
_autosave-BATT-PCB PCB
