bnepethomas/bne-arduino-flight-simulator-interfaces/Hornet/Hornet PCBs/Active/BRAKE-PRES-V01/MANUFACTURING/BRAKE-PRES-V01-PTH-drl_map.dxf

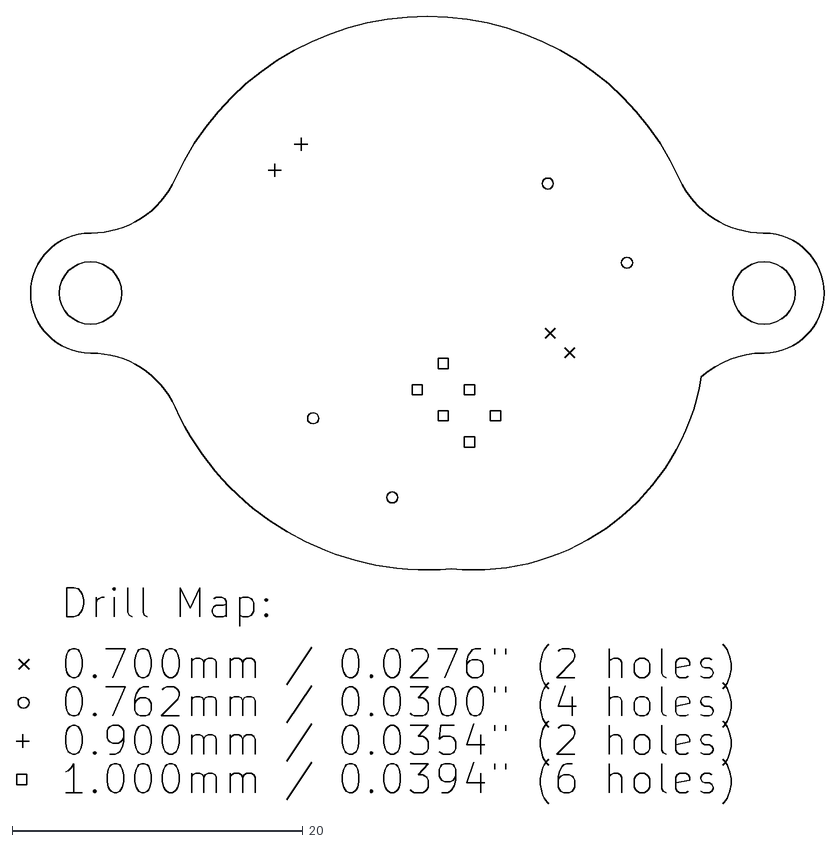
[picture p98: CAD file, 2025-11-29]
Hornet/Hornet PCBs/Active/BRAKE-PRES-V01/MANUFACTURING/BRAKE-PRES-V01-PTH-drl_map.dxf
55.6 x 54.2
