bnepethomas/bne-arduino-flight-simulator-interfaces/Hornet/Hornet PCBs/Active/Caution_lights_panel/Caution_Light_Panel.step

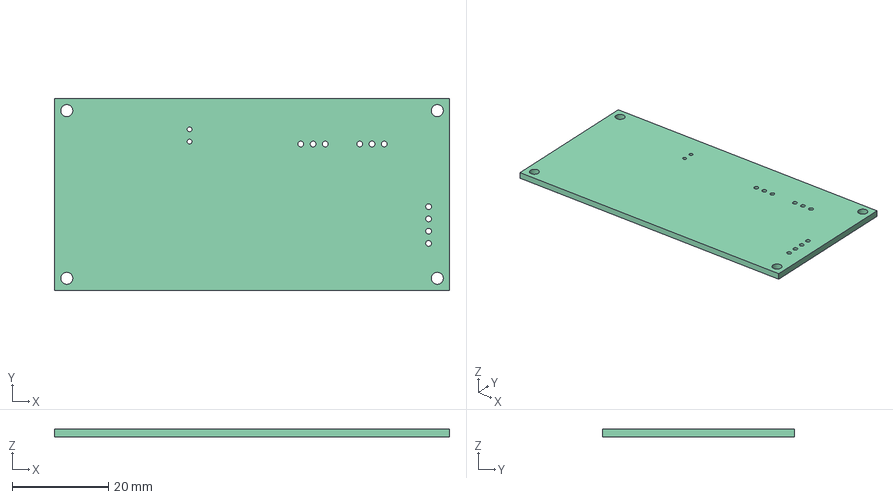
[picture p99: CAD file, 2025-11-29]
Hornet/Hornet PCBs/Active/Caution_lights_panel/Caution_Light_Panel.step
81.9 x 39.8 x 1.60 mm
Local_CS
Step_Models
