bnepethomas/bne-arduino-flight-simulator-interfaces/Hornet/Hornet PCBs/Active/Caution_lights_panel/docs/Caution_Lights_Panel_PCB.DXF

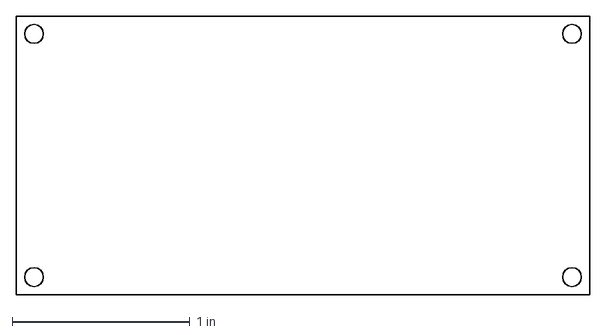
[picture p100: CAD file, 2025-11-29]
Hornet/Hornet PCBs/Active/Caution_lights_panel/docs/Caution_Lights_Panel_PCB.DXF
3.22 x 1.57 in
