bnepethomas/bne-arduino-flight-simulator-interfaces/Hornet/Hornet PCBs/Active/CONTROLLER_Radar Altimeter-V02/MANUFACTURING/CONTROLLER_Radar Altimeter-V02-NPTH-drl_map.dxf

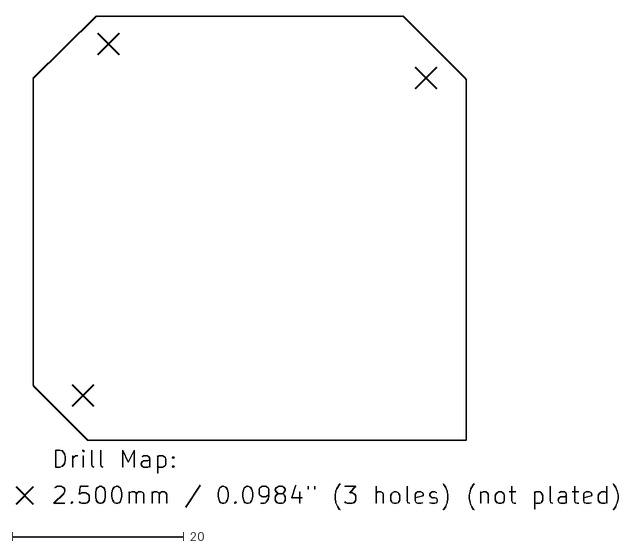
[picture p101: CAD file, 2025-11-29]
Hornet/Hornet PCBs/Active/CONTROLLER_Radar Altimeter-V02/MANUFACTURING/CONTROLLER_Radar Altimeter-V02-NPTH-drl_map.dxf
70.1 x 57.5
