bnepethomas/bne-arduino-flight-simulator-interfaces/Hornet/Hornet PCBs/Active/CONTROLLER_Radar Altimeter-V02/MCAD/CONTROLLER_Radar Altimeter-V02.step

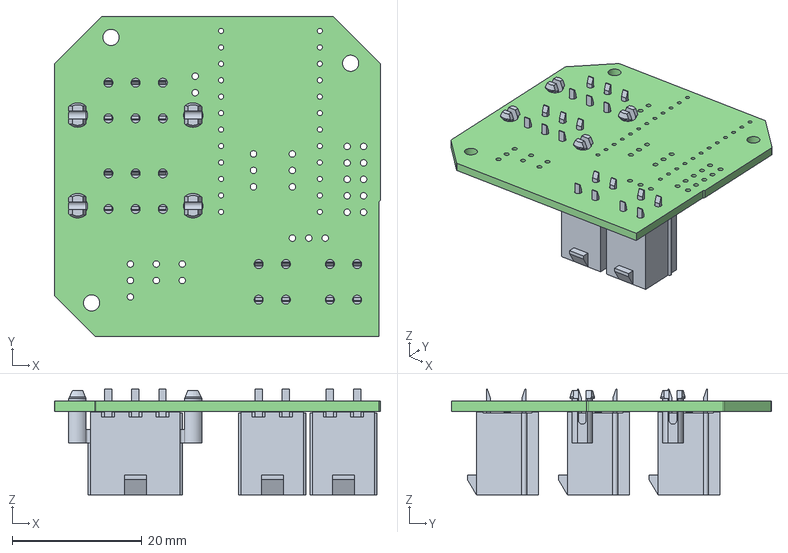
[picture p102: CAD file, 2025-11-29]
Hornet/Hornet PCBs/Active/CONTROLLER_Radar Altimeter-V02/MCAD/CONTROLLER_Radar Altimeter-V02.step
50.4 x 49.4 x 16.3 mm
CONTROLLER_Radar Altimeter PCB
