bnepethomas/bne-arduino-flight-simulator-interfaces/Hornet/Hornet PCBs/Active/ddi_button_board/Buttons_DDI.step

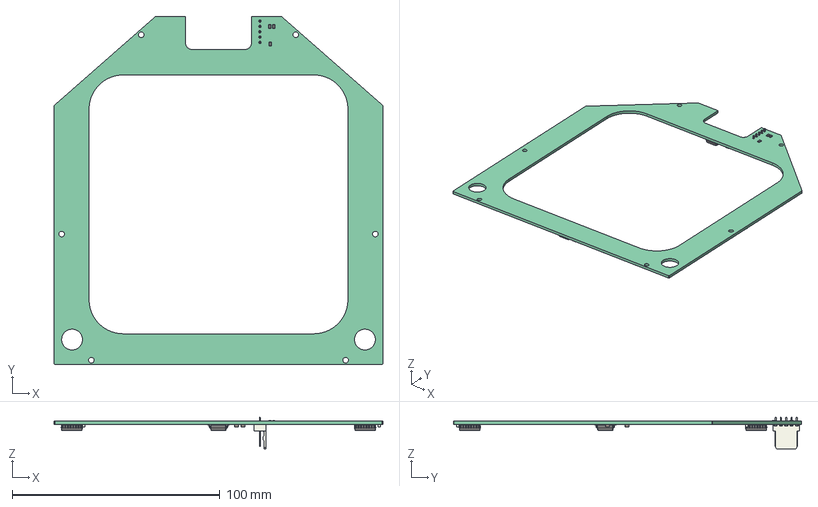
[picture p103: CAD file, 2025-11-29]
Hornet/Hornet PCBs/Active/ddi_button_board/Buttons_DDI.step
158.2 x 167.4 x 15.3 mm
Local_CS
Pcb
R1_R_0805_2012Metric_5BF1EFD9
R2_R_0805_2012Metric_5BF1F12B
R3_R_0805_2012Metric_5DB19099
J1_Molex_AE_6410_05A_5BE28C23
U2_SOIC_16W_75x103mm_P127mm_5BE28CE8
U3_SOIC_16W_75x103mm_P127mm_5BE28D0D
U4_SOIC_16W_75x103mm_P127mm_5BE28D32
U5_SOIC_16W_75x103mm_P127mm_5BE29E62
C1_C_0805_2012Metric_5DB19055
C2_C_0805_2012Metric_5DB19066
C3_C_0805_2012Metric_5DB19077
C4_C_0805_2012Metric_5DB19088
