bnepethomas/bne-arduino-flight-simulator-interfaces/Hornet/Hornet PCBs/Active/ddi_button_board/docs/DDI_PCB.DXF

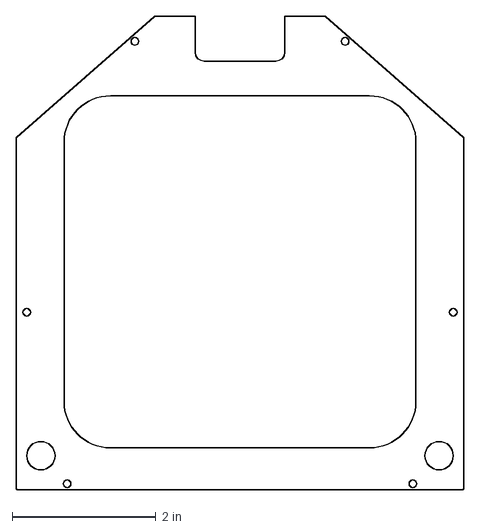
[picture p104: CAD file, 2025-11-29]
Hornet/Hornet PCBs/Active/ddi_button_board/docs/DDI_PCB.DXF
6.23 x 6.59 in
