bnepethomas/bne-arduino-flight-simulator-interfaces/Hornet/Hornet PCBs/Active/ddi_button_board/manufacturing/Buttons_DDI-PTH-drl_map.dxf

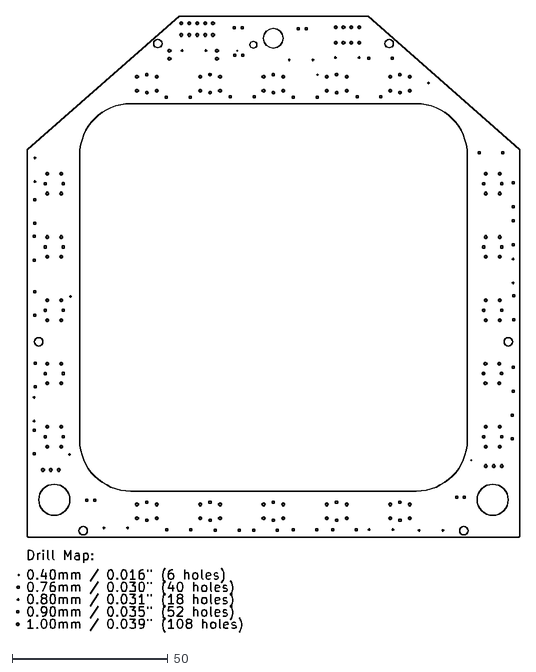
[picture p105: CAD file, 2025-11-29]
Hornet/Hornet PCBs/Active/ddi_button_board/manufacturing/Buttons_DDI-PTH-drl_map.dxf
161.7 x 197.8
