bnepethomas/bne-arduino-flight-simulator-interfaces/Hornet/Hornet PCBs/Active/DUAL NEEDLE-V03/MANUFACTURING/DUAL NEEDLE-V03-PTH-drl_map.dxf

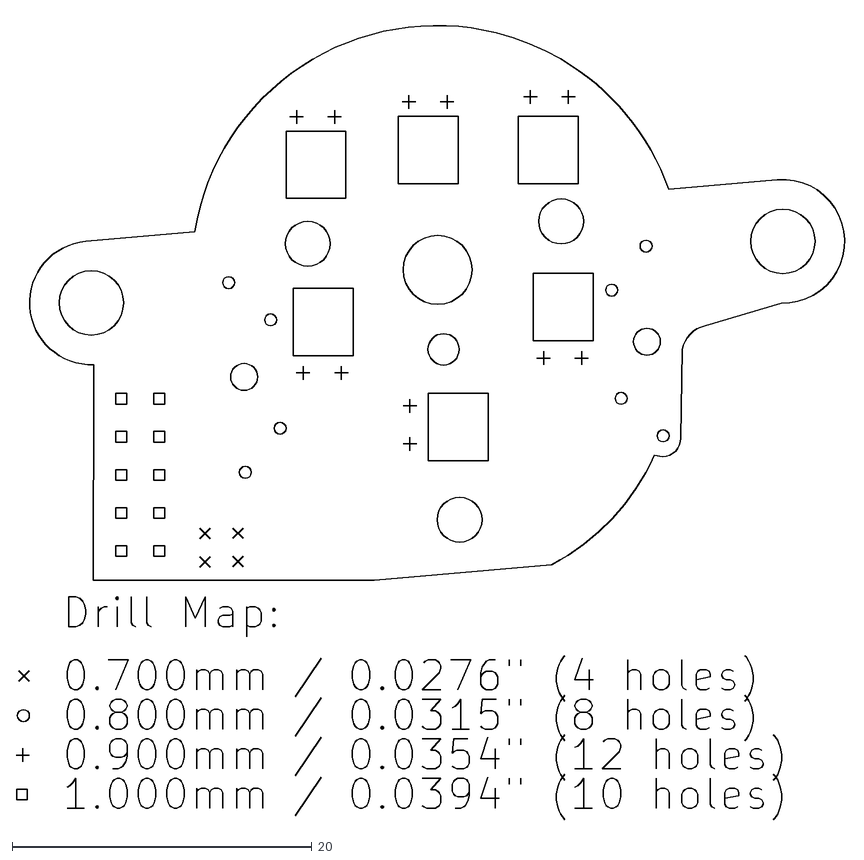
[picture p106: CAD file, 2025-11-29]
Hornet/Hornet PCBs/Active/DUAL NEEDLE-V03/MANUFACTURING/DUAL NEEDLE-V03-PTH-drl_map.dxf
55.5 x 53.7
