bnepethomas/bne-arduino-flight-simulator-interfaces/Hornet/Hornet PCBs/Active/DUAL NEEDLE-V03/PCB.dxf

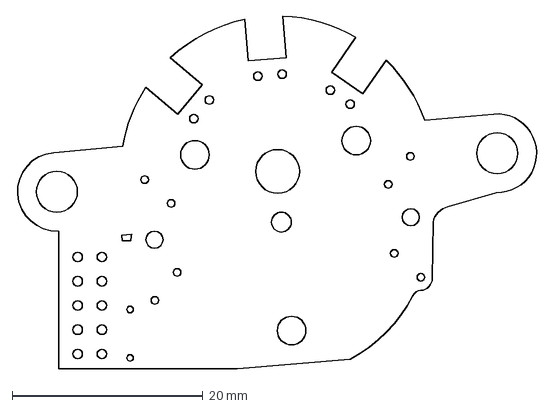
[picture p107: CAD file, 2025-11-29]
Hornet/Hornet PCBs/Active/DUAL NEEDLE-V03/PCB.dxf
54.8 x 37.0 mm
