bnepethomas/bne-arduino-flight-simulator-interfaces/Hornet/Hornet PCBs/Active/Eyebrow_warning_indicators/docs/EWI_PCB_-_Right.DXF

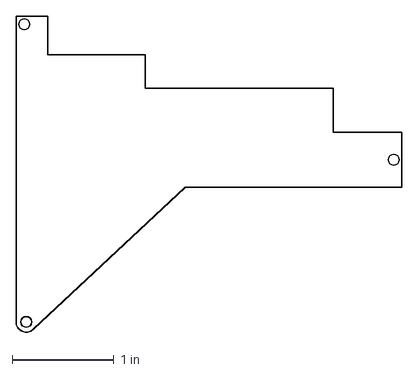
[picture p108: CAD file, 2025-11-29]
Hornet/Hornet PCBs/Active/Eyebrow_warning_indicators/docs/EWI_PCB_-_Right.DXF
3.79 x 3.11 in
