bnepethomas/bne-arduino-flight-simulator-interfaces/Hornet/Hornet PCBs/Active/Eyebrow_warning_indicators/Left/EWI_Left.step

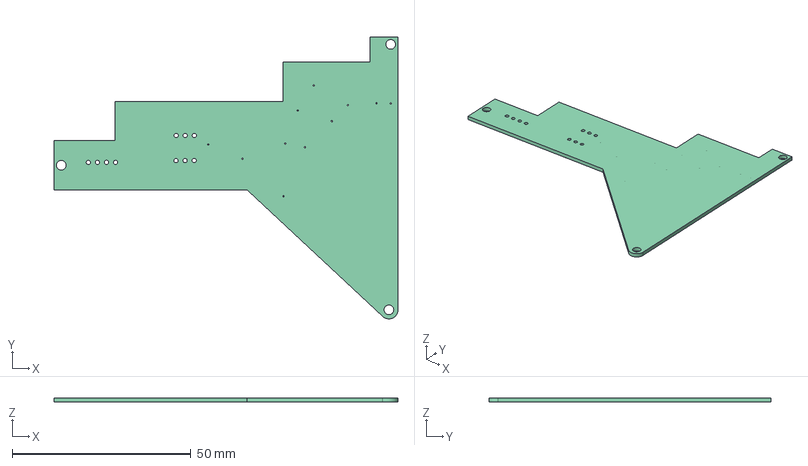
[picture p109: CAD file, 2025-11-29]
Hornet/Hornet PCBs/Active/Eyebrow_warning_indicators/Left/EWI_Left.step
96.1 x 78.8 x 1.20 mm
Local_CS
Step_Models
