bnepethomas/bne-arduino-flight-simulator-interfaces/Hornet/Hornet PCBs/Active/GAUGE_Analog Instruments/MANUFACTURING/GAUGE_Analog Instruments-12v-NPTH-drl_map.dxf

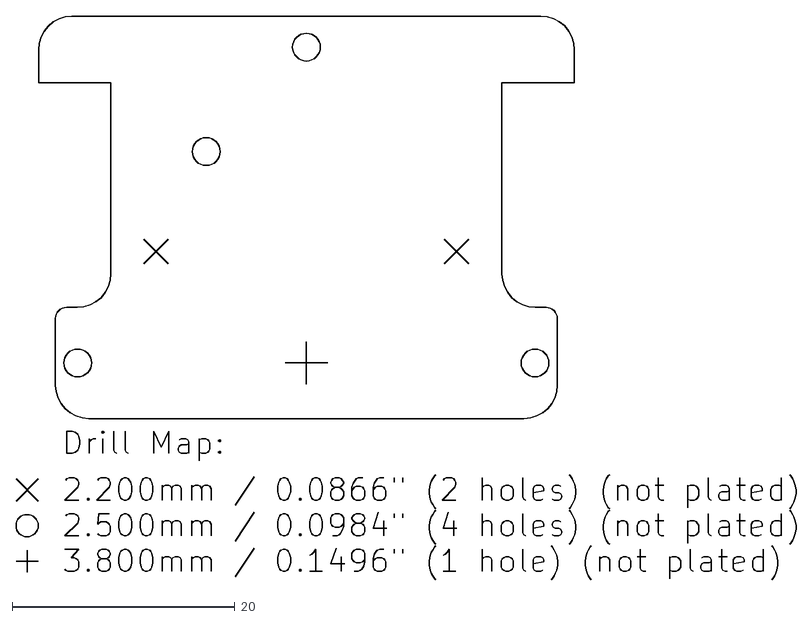
[picture p110: CAD file, 2025-11-29]
Hornet/Hornet PCBs/Active/GAUGE_Analog Instruments/MANUFACTURING/GAUGE_Analog Instruments-12v-NPTH-drl_map.dxf
70.1 x 50.7
