bnepethomas/bne-arduino-flight-simulator-interfaces/Hornet/Hornet PCBs/Active/IFEI/docs/IFEI_PCB.DXF

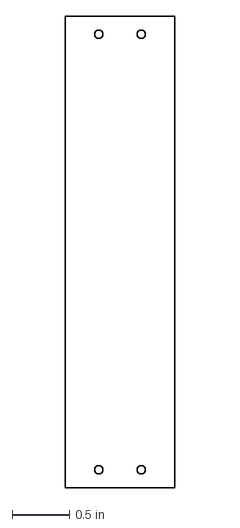
[picture p111: CAD file, 2025-11-29]
Hornet/Hornet PCBs/Active/IFEI/docs/IFEI_PCB.DXF
0.957 x 4.11 in
