bnepethomas/bne-arduino-flight-simulator-interfaces/Hornet/Hornet PCBs/Active/IFEI/IFEI.step

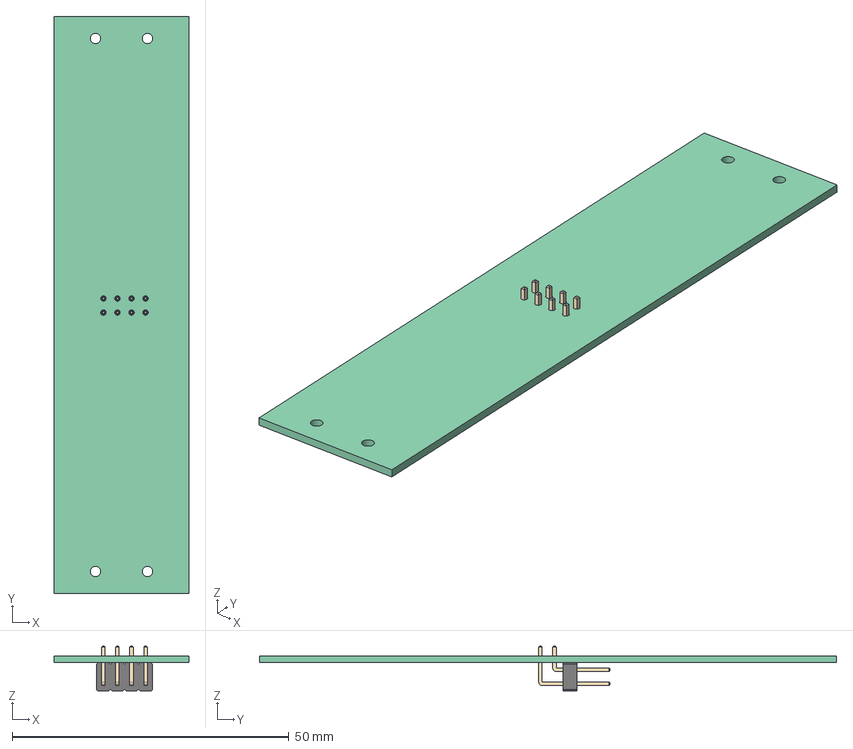
[picture p112: CAD file, 2025-11-29]
Hornet/Hornet PCBs/Active/IFEI/IFEI.step
24.3 x 104.3 x 8.08 mm
Local_CS
J1_PinHeader_2x04_P254mm_Horizontal_5DBCFCC3
