bnepethomas/bne-arduino-flight-simulator-interfaces/Hornet/Hornet PCBs/Active/JETT_SELECT_Panel/docs/JETT_Select_PCB.DXF

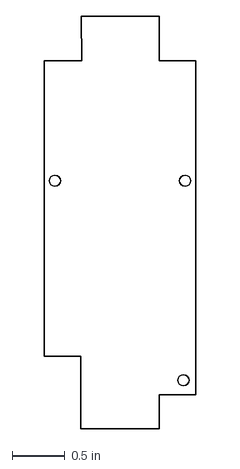
[picture p113: CAD file, 2025-11-29]
Hornet/Hornet PCBs/Active/JETT_SELECT_Panel/docs/JETT_Select_PCB.DXF
1.43 x 3.90 in
