bnepethomas/bne-arduino-flight-simulator-interfaces/Hornet/Hornet PCBs/Active/JETT_SELECT_Panel/manufacturing/JETT_SELECT_Panel-NPTH-drl_map.dxf

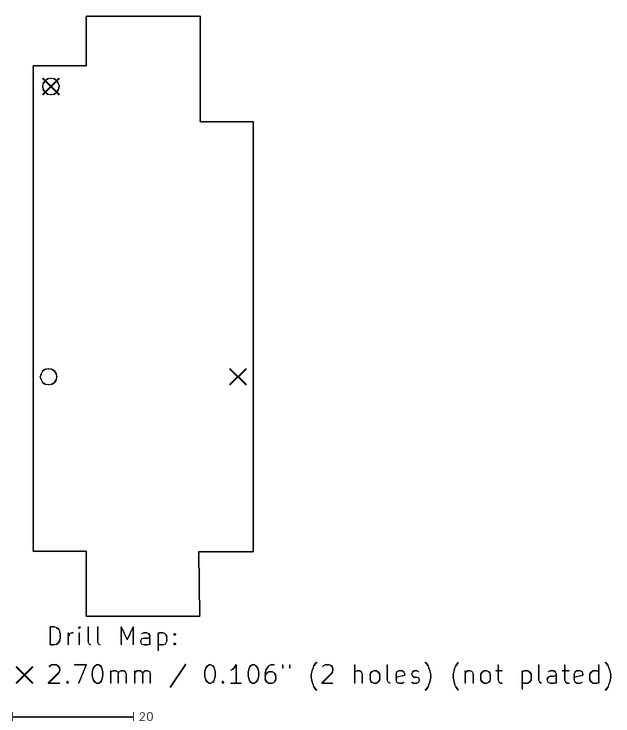
[picture p114: CAD file, 2025-11-29]
Hornet/Hornet PCBs/Active/JETT_SELECT_Panel/manufacturing/JETT_SELECT_Panel-NPTH-drl_map.dxf
98.1 x 111.3
