bnepethomas/bne-arduino-flight-simulator-interfaces/Hornet/Hornet PCBs/Active/Left Console/ANT SEL/ANT SEL.step

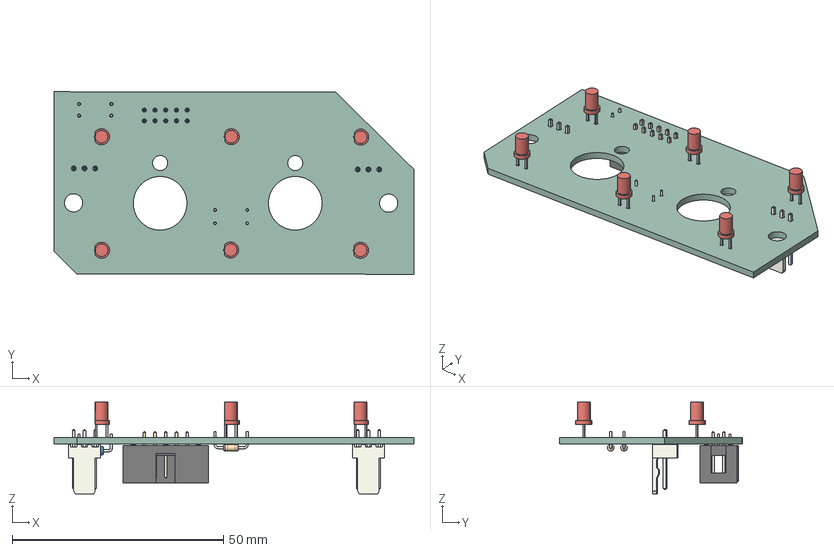
[picture p115: CAD file, 2025-11-29]
Hornet/Hornet PCBs/Active/Left Console/ANT SEL/ANT SEL.step
85.3 x 43.2 x 21.7 mm
LED_D3.0mm_FlatTop x 6
R_Axial_DIN0204_L36mm_D16mm_P762mm_Horizontal x 2
Molex_AE_6410_03A x 2
D_DO-35_SOD27_P7.62mm_Horizontal x 2
IDC_Header_2x05_P254mm_Vertical
ANT SEL_PCB
