bnepethomas/bne-arduino-flight-simulator-interfaces/Hornet/Hornet PCBs/Active/Left Console/ANT SEL/Working/ANT-SEL.dxf

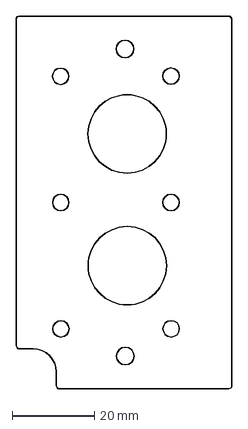
[picture p116: CAD file, 2025-11-29]
Hornet/Hornet PCBs/Active/Left Console/ANT SEL/Working/ANT-SEL.dxf
52.5 x 90.5 mm
