bnepethomas/bne-arduino-flight-simulator-interfaces/Hornet/Hornet PCBs/Active/Left Console/APU/apu-v3-backplate.dxf

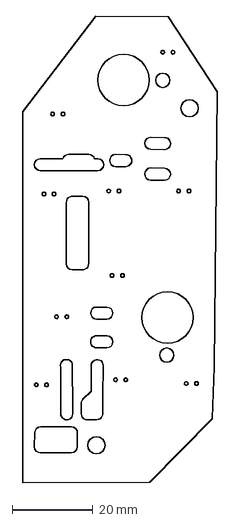
[picture p117: CAD file, 2025-11-29]
Hornet/Hornet PCBs/Active/Left Console/APU/apu-v3-backplate.dxf
48.1 x 115.6 mm
