bnepethomas/bne-arduino-flight-simulator-interfaces/Hornet/Hornet PCBs/Active/Left Console/COMMS/fcs.stl

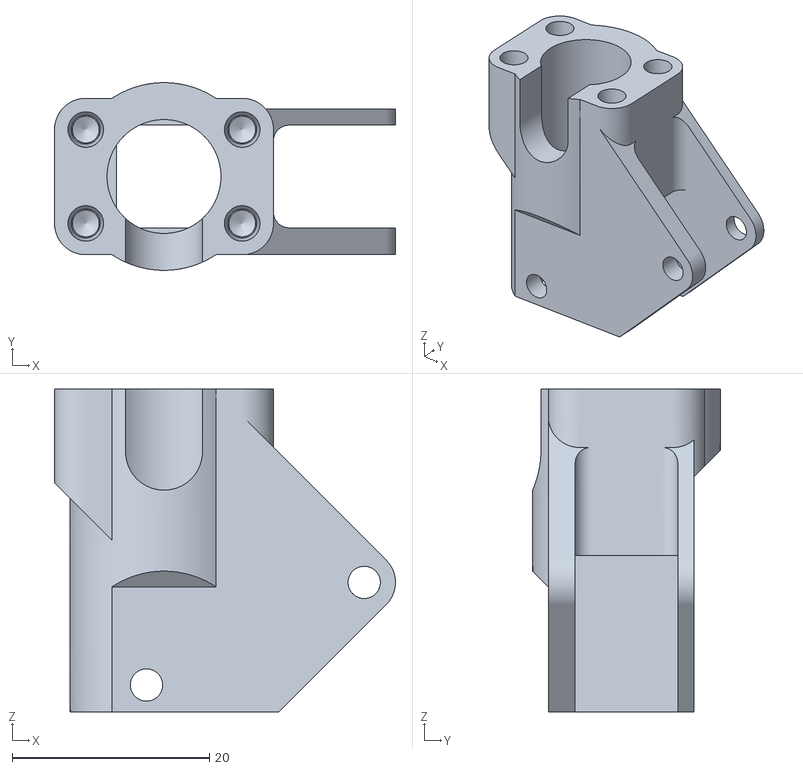
[picture p118: CAD file, 2025-11-29]
Hornet/Hornet PCBs/Active/Left Console/COMMS/fcs.stl
34.6 x 19.0 x 32.8
