bnepethomas/bne-arduino-flight-simulator-interfaces/Hornet/Hornet PCBs/Active/Left Console/COMPASS/COMPASS-CONTROL/COMPASS-CONTROL.step

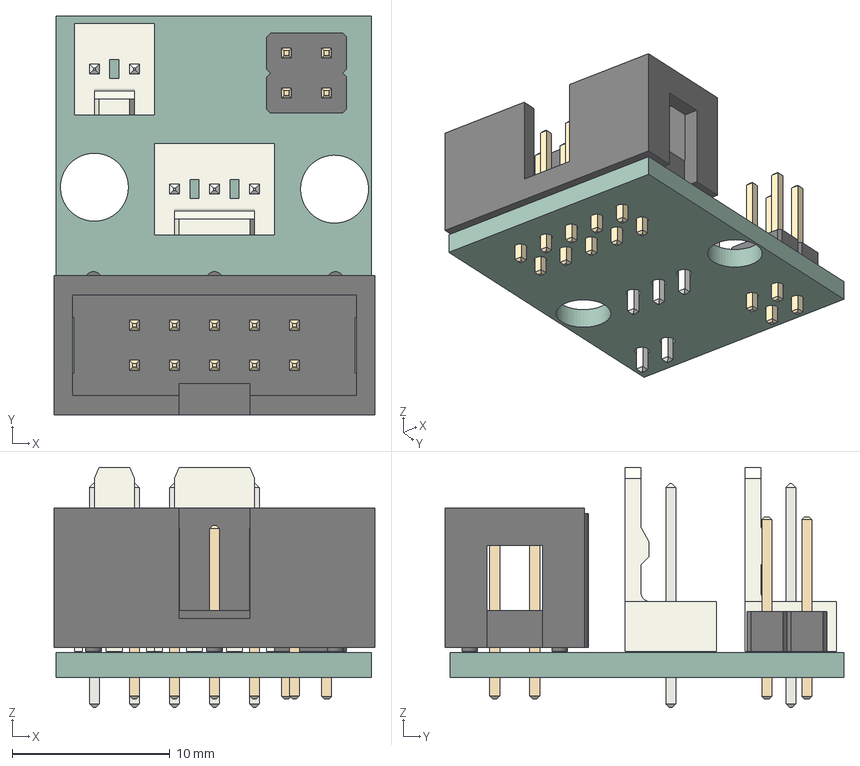
[picture p119: CAD file, 2025-11-29]
Hornet/Hornet PCBs/Active/Left Console/COMPASS/COMPASS-CONTROL/COMPASS-CONTROL.step
20.4 x 25.3 x 15.3 mm
Molex_AE_6410_03A
PinHeader_2x02_P254mm_Vertical
IDC_Header_2x05_P254mm_Vertical
Molex_AE_6410_02A
COMPASS-CONTROL_PCB
