bnepethomas/bne-arduino-flight-simulator-interfaces/Hornet/Hornet PCBs/Active/Left Console/COMPASS/compass.step

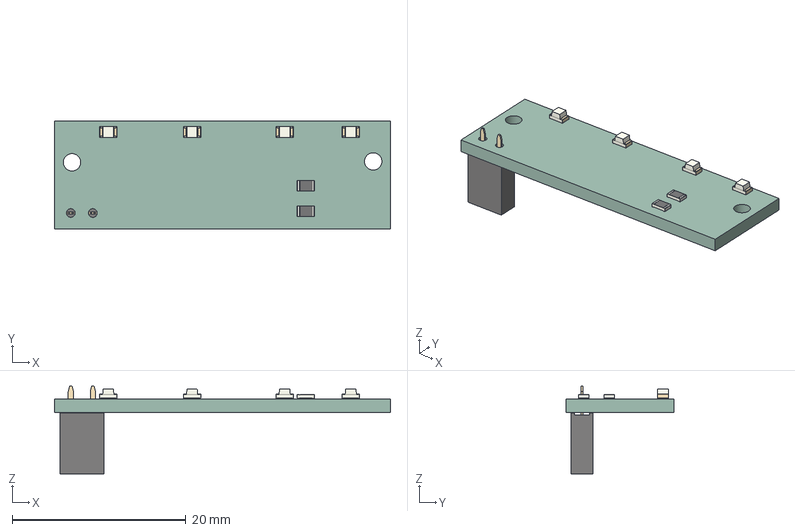
[picture p120: CAD file, 2025-11-29]
Hornet/Hornet PCBs/Active/Left Console/COMPASS/compass.step
38.7 x 12.4 x 10.1 mm
LED_0805_2012Metric x 4
R_0805_2012Metric x 2
PinSocket_1x02_P254mm_Vertical
compass_PCB
