bnepethomas/bne-arduino-flight-simulator-interfaces/Hornet/Hornet PCBs/Active/Left Console/EXT LTS/EXT_LTS_V001.step

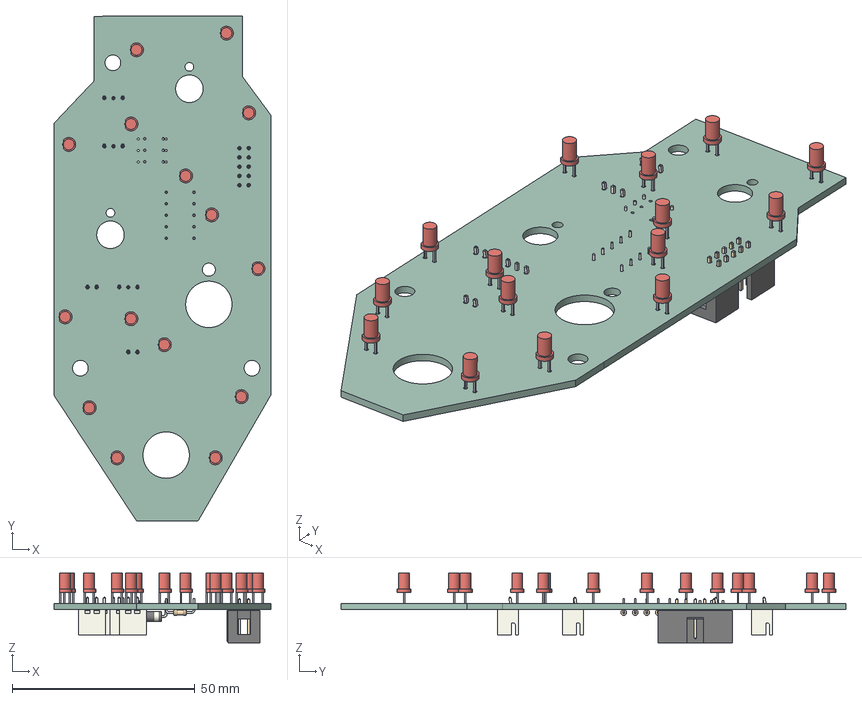
[picture p121: CAD file, 2025-11-29]
Hornet/Hornet PCBs/Active/Left Console/EXT LTS/EXT_LTS_V001.step
59.4 x 138.3 x 19.1 mm
LED_D3.0mm_FlatTop x 15
JST_B2B_XH_A x 2
R_Axial_DIN0204_L36mm_D16mm_P762mm_Horizontal x 5
JST_B3B_XH_A x 3
D_A-405_P7.62mm_Horizontal x 3
IDC_Header_2x05_P254mm_Vertical
EXT_LTS_V001_PCB
