bnepethomas/bne-arduino-flight-simulator-interfaces/Hornet/Hornet PCBs/Active/Left Console/FCS/fcs-backplate.dxf

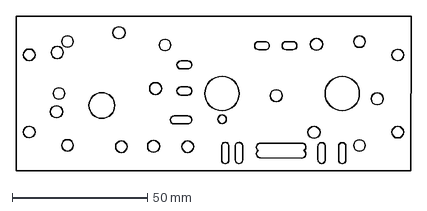
[picture p122: CAD file, 2025-11-29]
Hornet/Hornet PCBs/Active/Left Console/FCS/fcs-backplate.dxf
146.1 x 57.2 mm
