bnepethomas/bne-arduino-flight-simulator-interfaces/Hornet/Hornet PCBs/Active/Left Console/FIRE/fireback.dxf

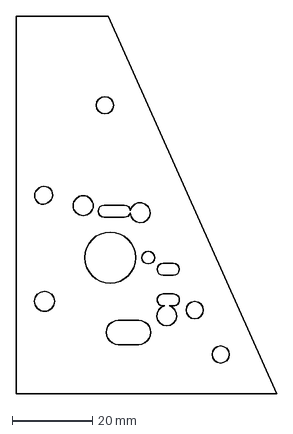
[picture p123: CAD file, 2025-11-29]
Hornet/Hornet PCBs/Active/Left Console/FIRE/fireback.dxf
65.0 x 94.1 mm
