bnepethomas/bne-arduino-flight-simulator-interfaces/Hornet/Hornet PCBs/Active/Left Console/FIRE/MCAD/fire.step

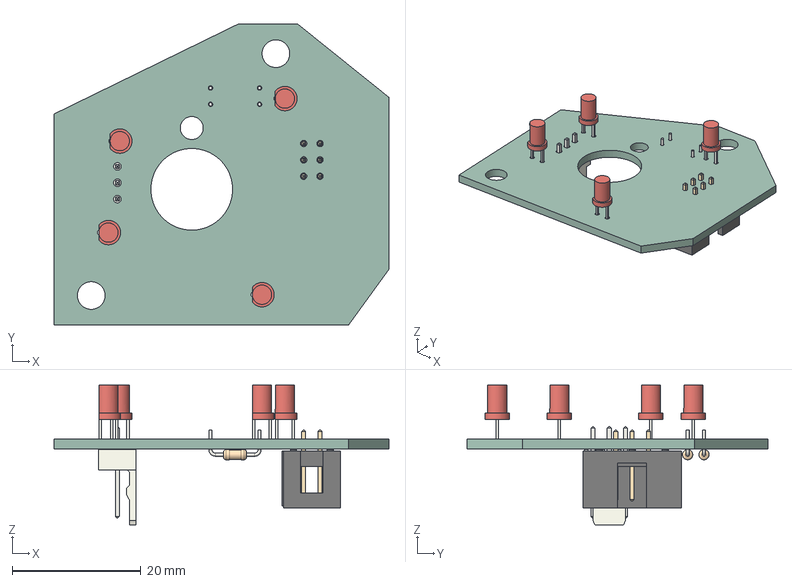
[picture p124: CAD file, 2025-11-29]
Hornet/Hornet PCBs/Active/Left Console/FIRE/MCAD/fire.step
52.1 x 46.8 x 21.7 mm
LED_D3.0mm_FlatTop x 4
R_Axial_DIN0204_L36mm_D16mm_P762mm_Horizontal x 2
IDC_Header_2x03_P254mm_Vertical
Molex_AE_6410_03A
FIRE-V002_PCB
