bnepethomas/bne-arduino-flight-simulator-interfaces/Hornet/Hornet PCBs/Active/Left Console/FUEL/FUEL-V001.step

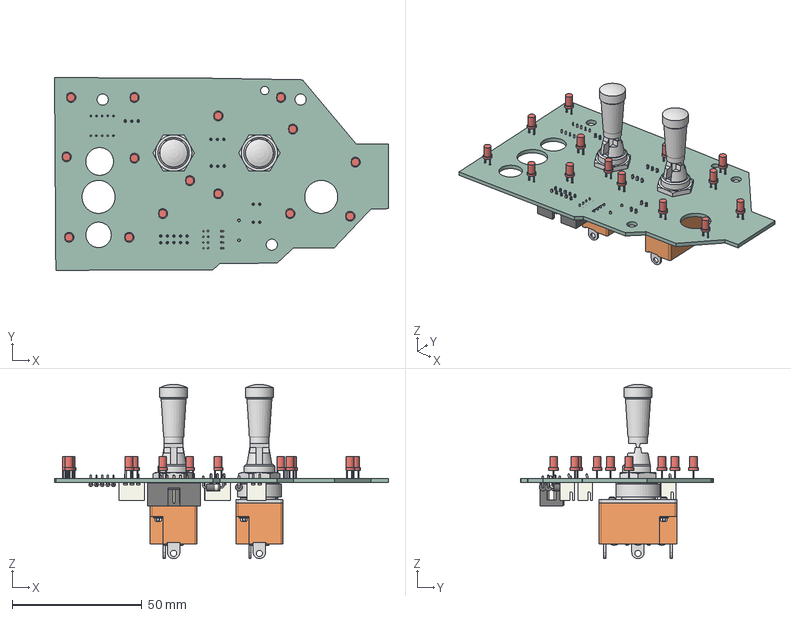
[picture p125: CAD file, 2025-11-29]
Hornet/Hornet PCBs/Active/Left Console/FUEL/FUEL-V001.step
128.6 x 74.2 x 67.1 mm
S2AL x 2
LED_D3.0mm_FlatTop x 15
R_Axial_DIN0204_L36mm_D16mm_P762mm_Horizontal x 5
IDC_Header_2x05_P254mm_Vertical
D_A-405_P7.62mm_Horizontal x 4
D_DO-41_SOD81_P7.62mm_Horizontal
JST_B3B_XH_A x 3
JST_B2B_XH_A x 2
FUEL-V001_PCB
