bnepethomas/bne-arduino-flight-simulator-interfaces/Hornet/Hornet PCBs/Active/Left Console/GEN-TIE/GEN-TIE-2.dxf

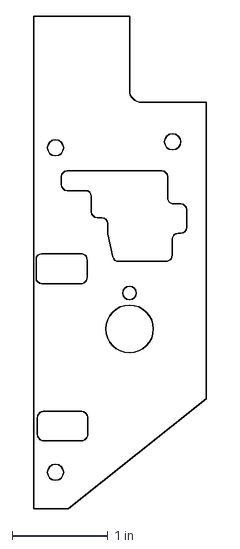
[picture p126: CAD file, 2025-11-29]
Hornet/Hornet PCBs/Active/Left Console/GEN-TIE/GEN-TIE-2.dxf
1.80 x 5.15 in
