bnepethomas/bne-arduino-flight-simulator-interfaces/Hornet/Hornet PCBs/Active/Left Console/HYD ISO/HYD_ISO - v002/MCAD/HYD ISO PANEL.step

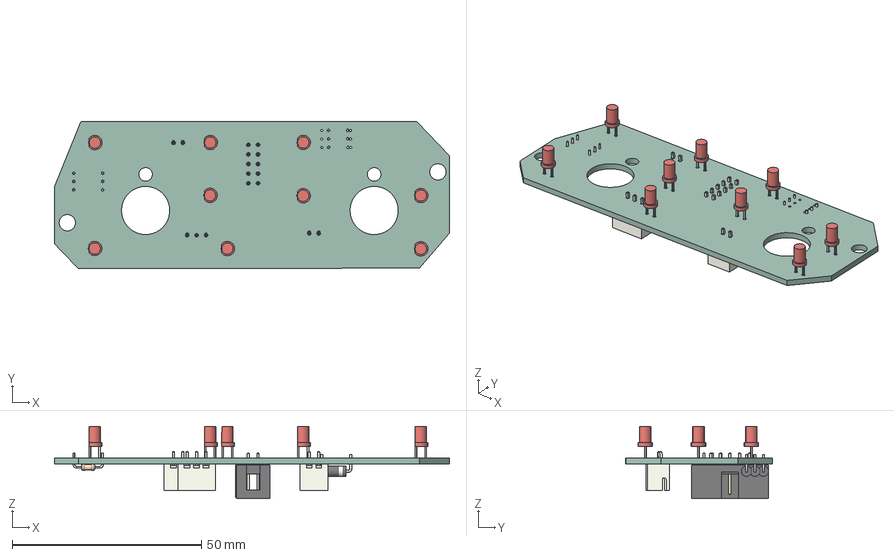
[picture p127: CAD file, 2025-11-29]
Hornet/Hornet PCBs/Active/Left Console/HYD ISO/HYD_ISO - v002/MCAD/HYD ISO PANEL.step
104.3 x 38.9 x 19.1 mm
LED_D3.0mm_FlatTop x 9
R_Axial_DIN0204_L36mm_D16mm_P762mm_Horizontal x 3
D_A-405_P7.62mm_Horizontal x 3
IDC_Header_2x05_P254mm_Vertical
JST_B3B_XH_A
JST_B2B_XH_A x 2
HYD_ISO_PCB
