bnepethomas/bne-arduino-flight-simulator-interfaces/Hornet/Hornet PCBs/Active/Left Console/LANDING/LANDING-V002.step

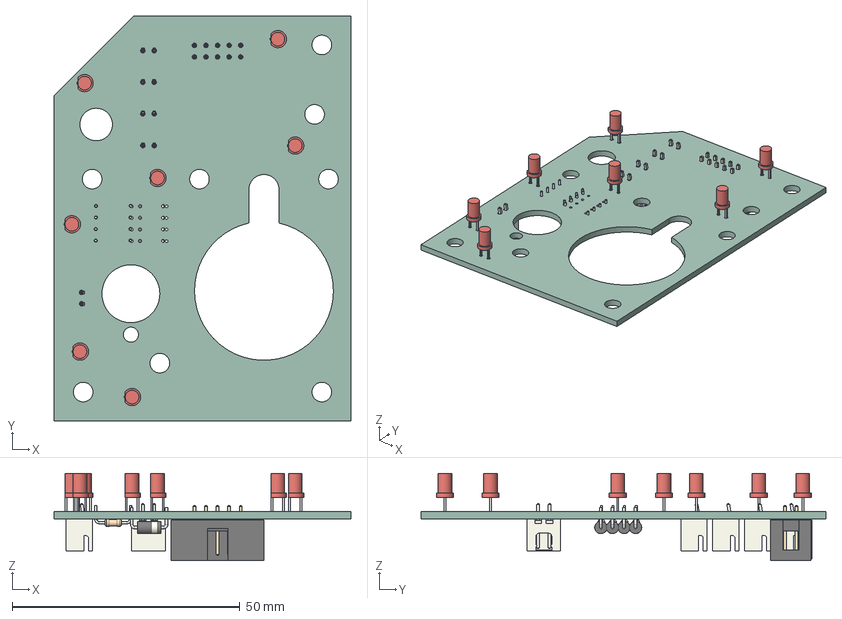
[picture p128: CAD file, 2025-11-29]
Hornet/Hornet PCBs/Active/Left Console/LANDING/LANDING-V002.step
65.1 x 88.9 x 19.1 mm
LED_D3.0mm_FlatTop x 7
D_A-405_P7.62mm_Horizontal x 4
R_Axial_DIN0204_L36mm_D16mm_P762mm_Horizontal x 4
IDC_Header_2x05_P254mm_Vertical
JST_B2B_XH_A x 5
_autosave-LANDING-V001_PCB
