bnepethomas/bne-arduino-flight-simulator-interfaces/Hornet/Hornet PCBs/Active/Left Console/LEFT_CONTROLLER-v005 June 2025/controller mount.stl

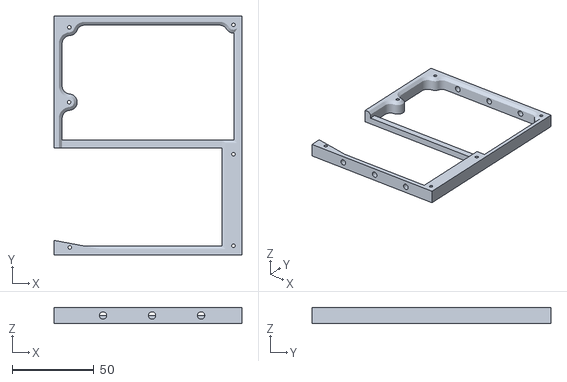
[picture p129: CAD file, 2025-11-29]
Hornet/Hornet PCBs/Active/Left Console/LEFT_CONTROLLER-v005 June 2025/controller mount.stl
115.0 x 146.0 x 10.0
