bnepethomas/bne-arduino-flight-simulator-interfaces/Hornet/Hornet PCBs/Active/Left Console/LEFT_CONTROLLER-v005 June 2025/manufacturing/OH - Left Console - Input Distribution-NPTH-drl_map.dxf

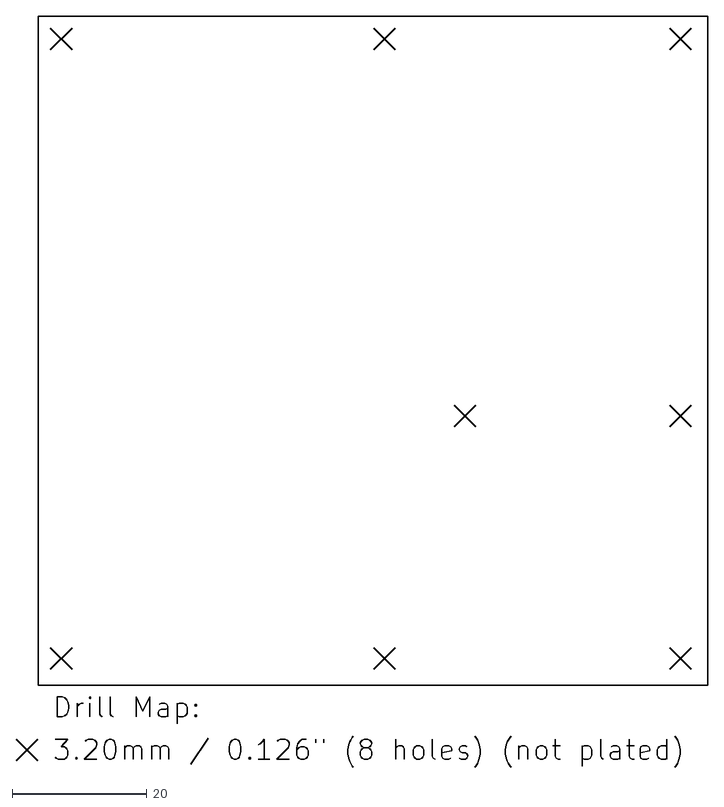
[picture p130: CAD file, 2025-11-29]
Hornet/Hornet PCBs/Active/Left Console/LEFT_CONTROLLER-v005 June 2025/manufacturing/OH - Left Console - Input Distribution-NPTH-drl_map.dxf
102.7 x 111.6
