bnepethomas/bne-arduino-flight-simulator-interfaces/Hornet/Hornet PCBs/Active/Left Console/OBOGS/OBOGS-BACKPLAEV2.dxf

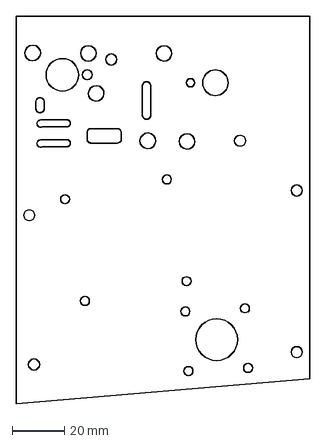
[picture p131: CAD file, 2025-11-29]
Hornet/Hornet PCBs/Active/Left Console/OBOGS/OBOGS-BACKPLAEV2.dxf
112.3 x 148.3 mm
