bnepethomas/bne-arduino-flight-simulator-interfaces/Hornet/Hornet PCBs/Active/Left Console/SELECT JETT/SELECT JETT-V002.step

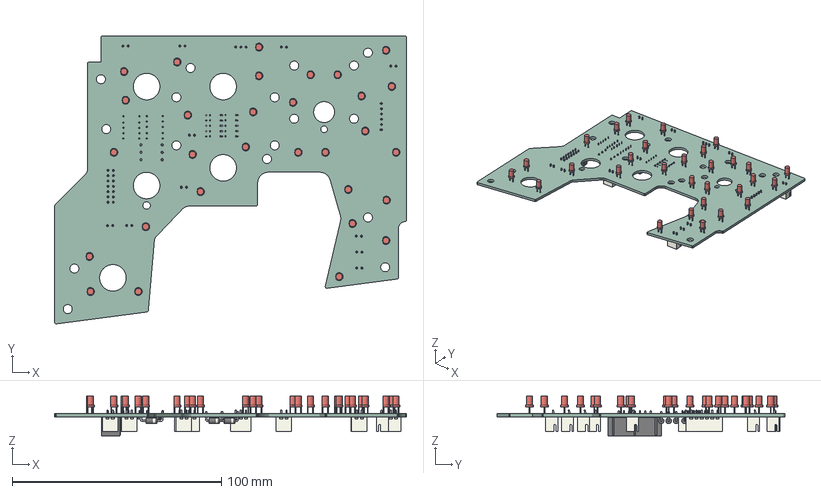
[picture p132: CAD file, 2025-11-29]
Hornet/Hornet PCBs/Active/Left Console/SELECT JETT/SELECT JETT-V002.step
168.3 x 137.6 x 19.1 mm
LED_D3.0mm_FlatTop x 30
JST_B2B_XH_A x 11
D_A-405_P7.62mm_Horizontal x 10
R_Axial_DIN0204_L36mm_D16mm_P762mm_Horizontal x 10
D_DO-41_SOD81_P10.16mm_Horizontal x 3
IDC_Header_2x07_P254mm_Vertical
JST_B3B_XH_A
JST_B6B_XH_A
SELECT JETT-V002_PCB
