bnepethomas/bne-arduino-flight-simulator-interfaces/Hornet/Hornet PCBs/Active/LIP CONTROLLER V004/Body1.stl

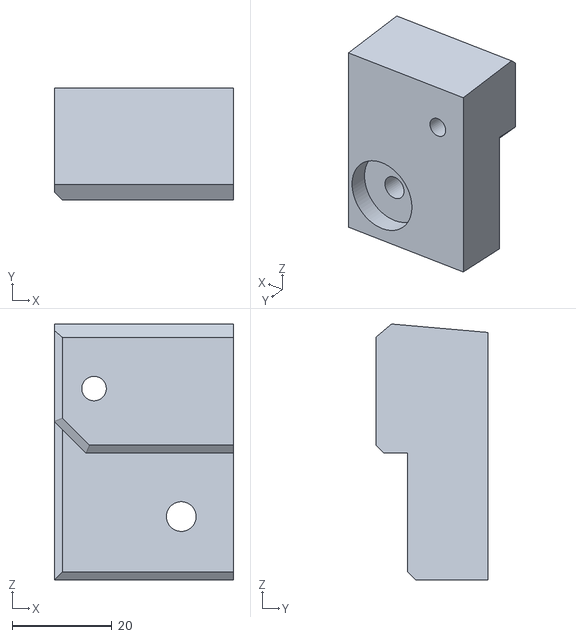
[picture p133: CAD file, 2025-11-29]
Hornet/Hornet PCBs/Active/LIP CONTROLLER V004/Body1.stl
35.9 x 22.5 x 51.3
