bnepethomas/bne-arduino-flight-simulator-interfaces/Hornet/Hornet PCBs/Active/Master_Mode_Pushbutton/docs/Master_Mode_Pushbutton_PCB.DXF

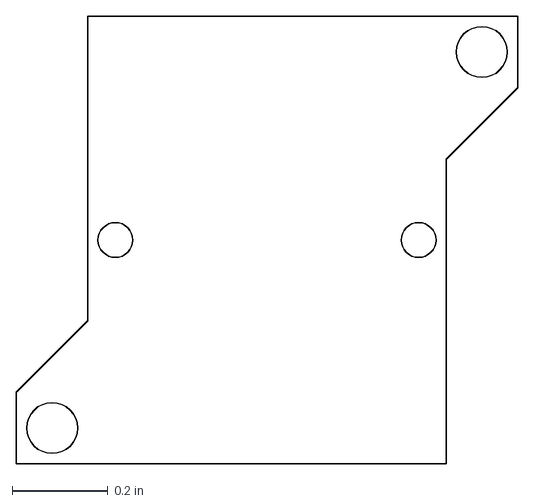
[picture p134: CAD file, 2025-11-29]
Hornet/Hornet PCBs/Active/Master_Mode_Pushbutton/docs/Master_Mode_Pushbutton_PCB.DXF
1.05 x 0.938 in
