bnepethomas/bne-arduino-flight-simulator-interfaces/Hornet/Hornet PCBs/Active/Master_Mode_Pushbutton/MasterModePushbutton.step

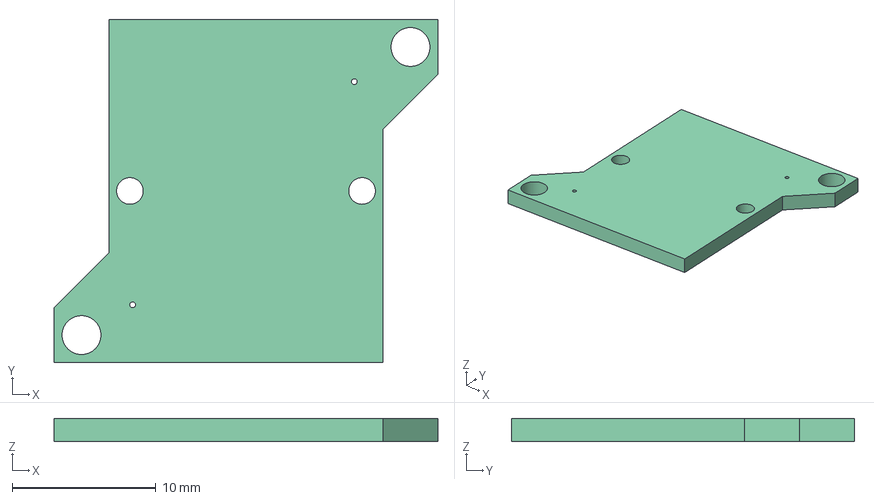
[picture p135: CAD file, 2025-11-29]
Hornet/Hornet PCBs/Active/Master_Mode_Pushbutton/MasterModePushbutton.step
26.7 x 23.8 x 1.60 mm
Local_CS
Step_Models
