bnepethomas/bne-arduino-flight-simulator-interfaces/Hornet/Hornet PCBs/Active/Max7219/Max7219-Edge_Cuts.dxf

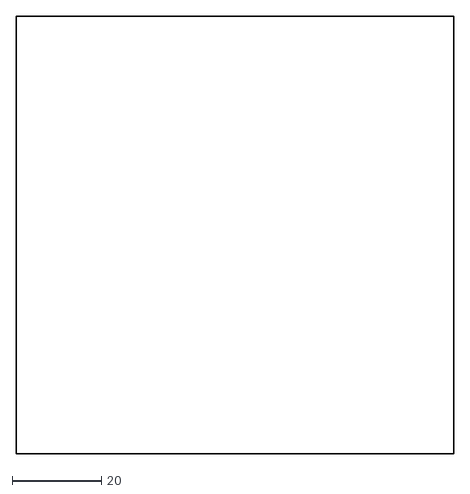
[picture p136: CAD file, 2025-11-29]
Hornet/Hornet PCBs/Active/Max7219/Max7219-Edge_Cuts.dxf
97.8 x 97.8
