bnepethomas/bne-arduino-flight-simulator-interfaces/Hornet/Hornet PCBs/Active/OH - General Purpose Small PCB/manufacturing/OH - General Purpose Small PCB-NPTH-drl_map.dxf

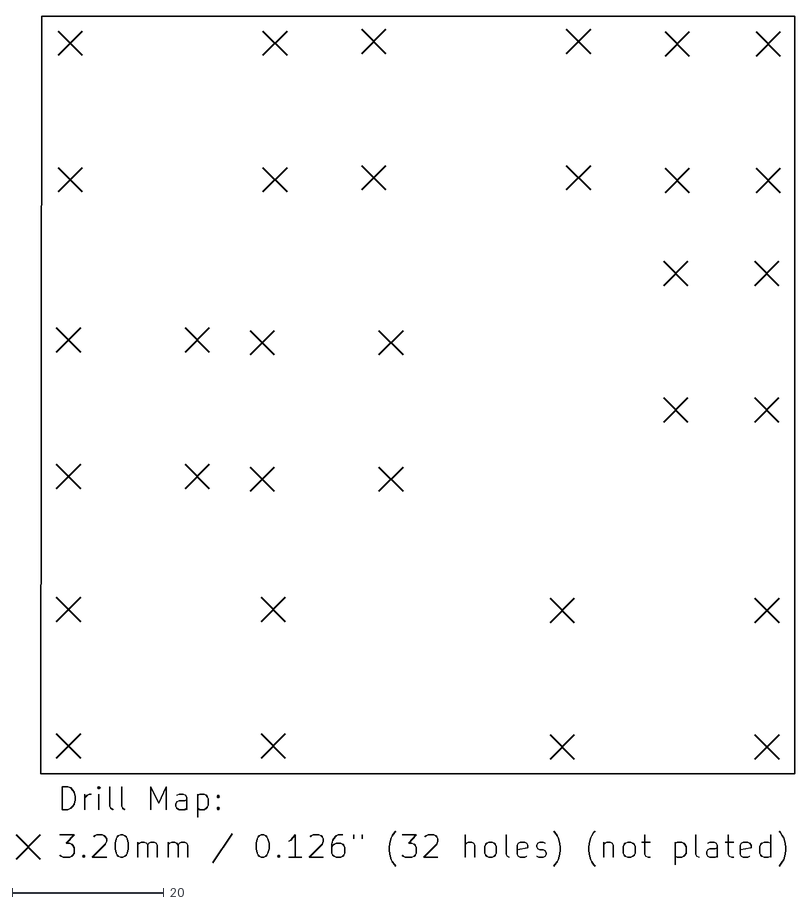
[picture p137: CAD file, 2025-11-29]
Hornet/Hornet PCBs/Active/OH - General Purpose Small PCB/manufacturing/OH - General Purpose Small PCB-NPTH-drl_map.dxf
102.7 x 112.1
