bnepethomas/bne-arduino-flight-simulator-interfaces/Hornet/Hornet PCBs/Active/OH - Hornet Forward Input Shield/MANUFACTURING/Hornet Forward Input Shield-NPTH-drl_map.dxf

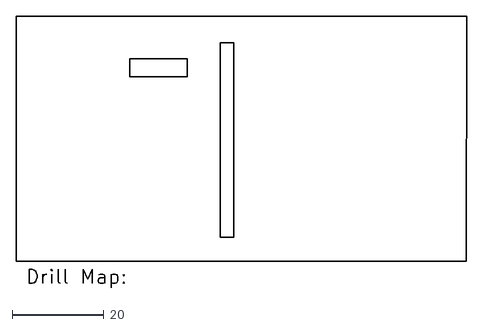
[picture p138: CAD file, 2025-11-29]
Hornet/Hornet PCBs/Active/OH - Hornet Forward Input Shield/MANUFACTURING/Hornet Forward Input Shield-NPTH-drl_map.dxf
97.9 x 59.1
