bnepethomas/bne-arduino-flight-simulator-interfaces/Hornet/Hornet PCBs/Active/OH - Hornet Forward Output Shield/MANUFACTURING/Hornet Forward Output Shield-NPTH-drl_map.dxf

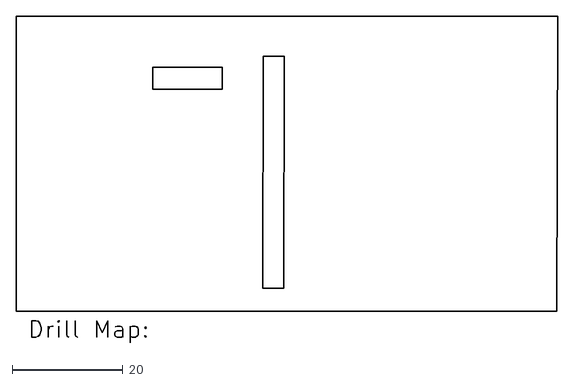
[picture p139: CAD file, 2025-11-29]
Hornet/Hornet PCBs/Active/OH - Hornet Forward Output Shield/MANUFACTURING/Hornet Forward Output Shield-NPTH-drl_map.dxf
97.9 x 59.1
