bnepethomas/bne-arduino-flight-simulator-interfaces/Hornet/Hornet PCBs/Active/OH - Hornet Forward Upper Output Shield/MANUFACTURING/Hornet Forward Output Upper Shield-NPTH-drl_map.dxf

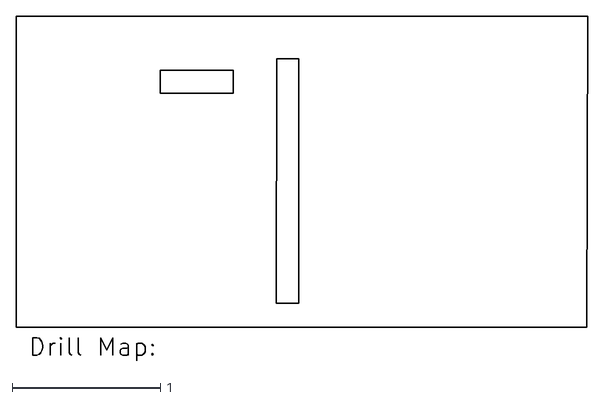
[picture p140: CAD file, 2025-11-29]
Hornet/Hornet PCBs/Active/OH - Hornet Forward Upper Output Shield/MANUFACTURING/Hornet Forward Output Upper Shield-NPTH-drl_map.dxf
3.85 x 2.33
