bnepethomas/bne-arduino-flight-simulator-interfaces/Hornet/Hornet PCBs/Active/OH - Left Console - 12 - Mission Compand Hydraulic Iso/manufacturing/OH - Left Console - 12 - Mission Computer and Hydraulic Isolate Panel-PTH-drl_map.dxf

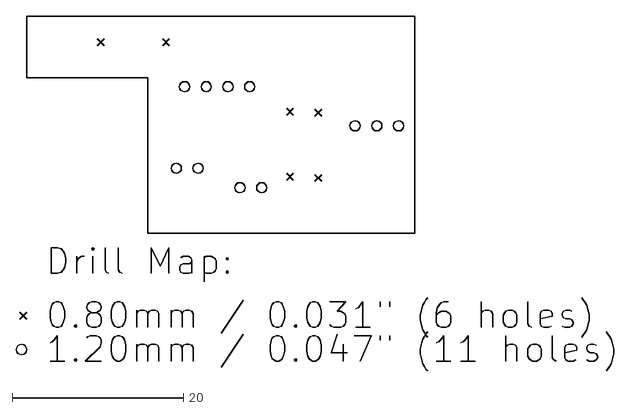
[picture p141: CAD file, 2025-11-29]
Hornet/Hornet PCBs/Active/OH - Left Console - 12 - Mission Compand Hydraulic Iso/manufacturing/OH - Left Console - 12 - Mission Computer and Hydraulic Isolate Panel-PTH-drl_map.dxf
69.8 x 41.5
