bnepethomas/bne-arduino-flight-simulator-interfaces/Hornet/Hornet PCBs/Active/OH - Left Console - 13 Antenna Select Panel/manufacturing/OH - Left Console - 13 Antenna Select Panel-PTH-drl_map.dxf

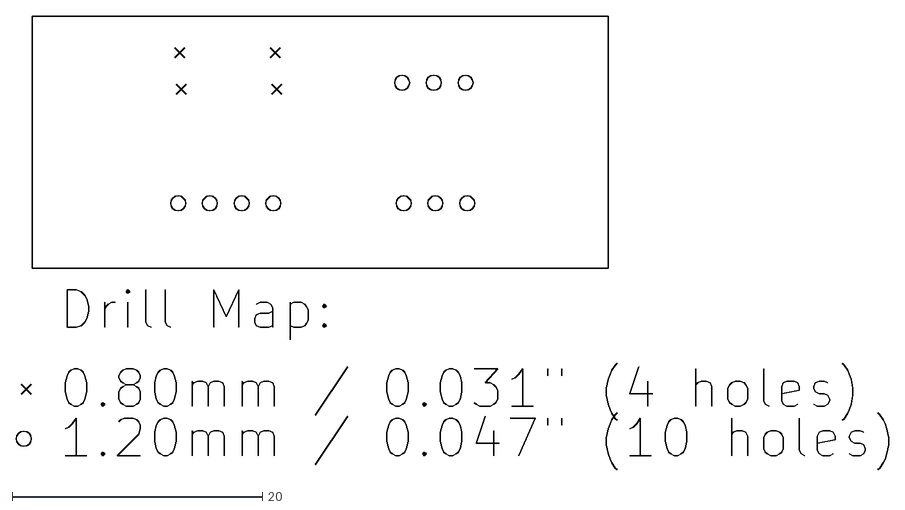
[picture p142: CAD file, 2025-11-29]
Hornet/Hornet PCBs/Active/OH - Left Console - 13 Antenna Select Panel/manufacturing/OH - Left Console - 13 Antenna Select Panel-PTH-drl_map.dxf
69.8 x 36.3
