bnepethomas/bne-arduino-flight-simulator-interfaces/Hornet/Hornet PCBs/Active/OH - Left Console - 13 Antenna Select Panel/OH - Left Console - 13 Antenna Select Panel-NPTH-drl_map.dxf

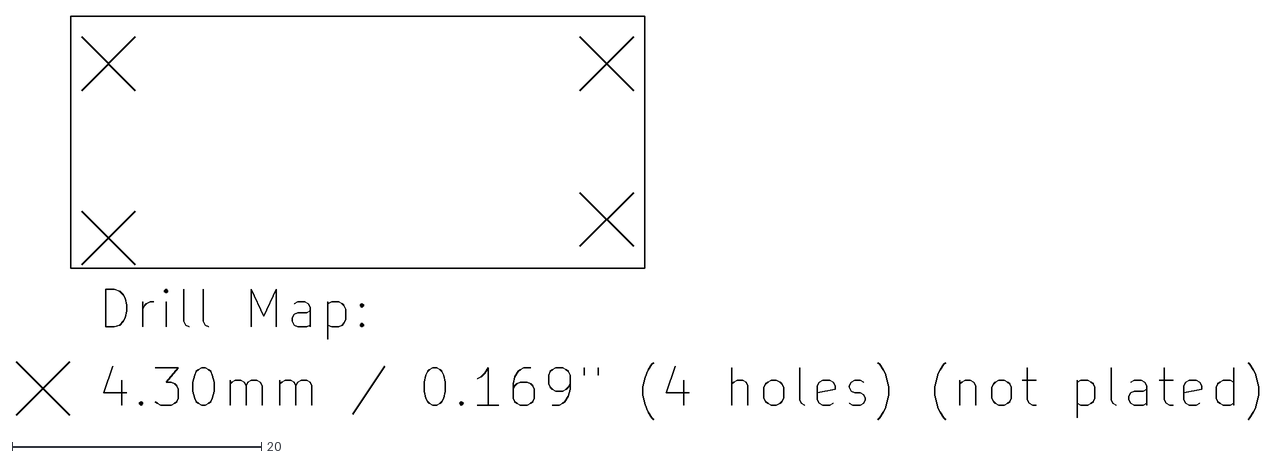
[picture p143: CAD file, 2025-11-29]
Hornet/Hornet PCBs/Active/OH - Left Console - 13 Antenna Select Panel/OH - Left Console - 13 Antenna Select Panel-NPTH-drl_map.dxf
99.7 x 32.4
