bnepethomas/bne-arduino-flight-simulator-interfaces/Hornet/Hornet PCBs/Active/OH - Left Console - 14 - Auxiliary Power Unit Panel/manufacturing/OH - Left Console - 14 - Auxiliary Power Unit Panel-PTH-drl_map.dxf

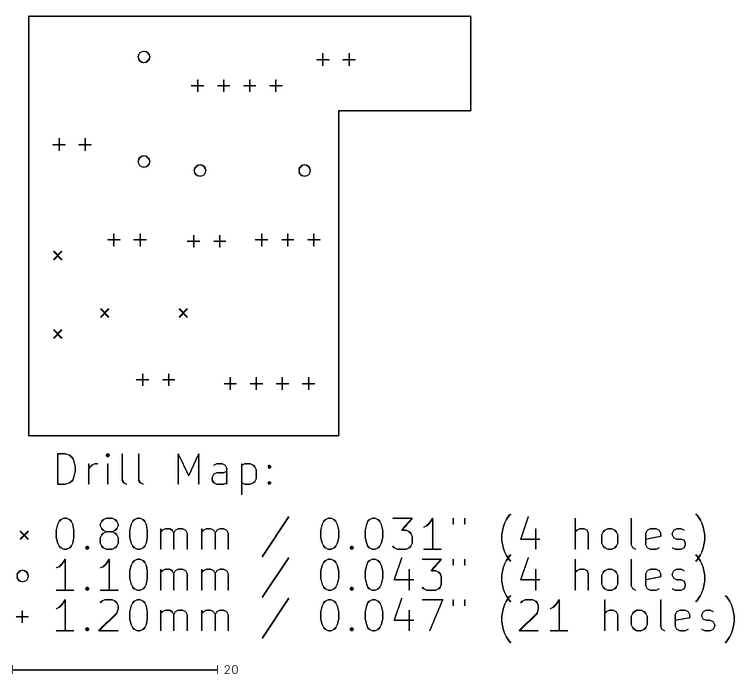
[picture p144: CAD file, 2025-11-29]
Hornet/Hornet PCBs/Active/OH - Left Console - 14 - Auxiliary Power Unit Panel/manufacturing/OH - Left Console - 14 - Auxiliary Power Unit Panel-PTH-drl_map.dxf
69.8 x 60.8
