bnepethomas/bne-arduino-flight-simulator-interfaces/Hornet/Hornet PCBs/Active/OH - Left Console - 14 - Auxiliary Power Unit Panel/OH - Left Console - 14 - Auxiliary Power Unit Panel-NPTH-drl_map.dxf

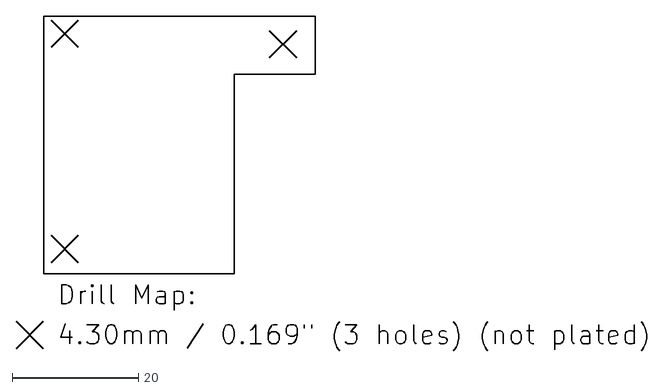
[picture p145: CAD file, 2025-11-29]
Hornet/Hornet PCBs/Active/OH - Left Console - 14 - Auxiliary Power Unit Panel/OH - Left Console - 14 - Auxiliary Power Unit Panel-NPTH-drl_map.dxf
99.7 x 52.9
