bnepethomas/bne-arduino-flight-simulator-interfaces/Hornet/Hornet PCBs/Active/OH - Left Console - 18 - Left Essential Circuit Breakers/manufacturing/OH - Left Console - 18 - Left Essential Circuit Breakers-PTH-drl_map.dxf

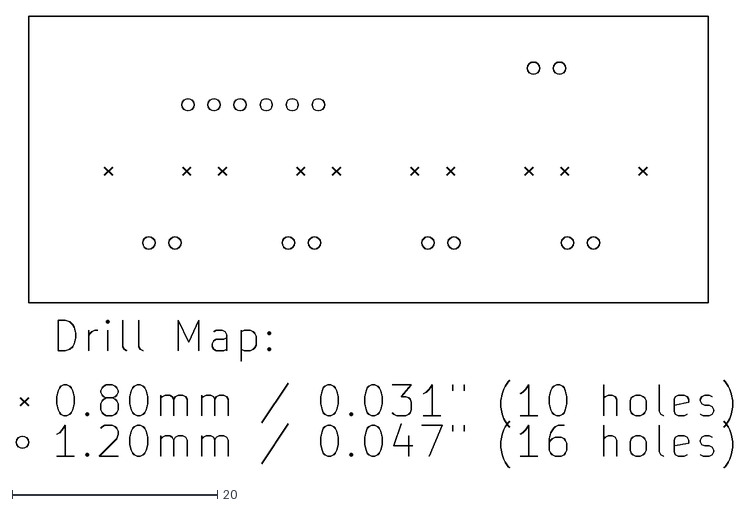
[picture p146: CAD file, 2025-11-29]
Hornet/Hornet PCBs/Active/OH - Left Console - 18 - Left Essential Circuit Breakers/manufacturing/OH - Left Console - 18 - Left Essential Circuit Breakers-PTH-drl_map.dxf
69.8 x 44.0
