bnepethomas/bne-arduino-flight-simulator-interfaces/Hornet/Hornet PCBs/Active/OH - Left Console - 31 - Landing Gear/manufacturing/OH - Left Console - 31 - Landing Gear-PTH-drl_map.dxf

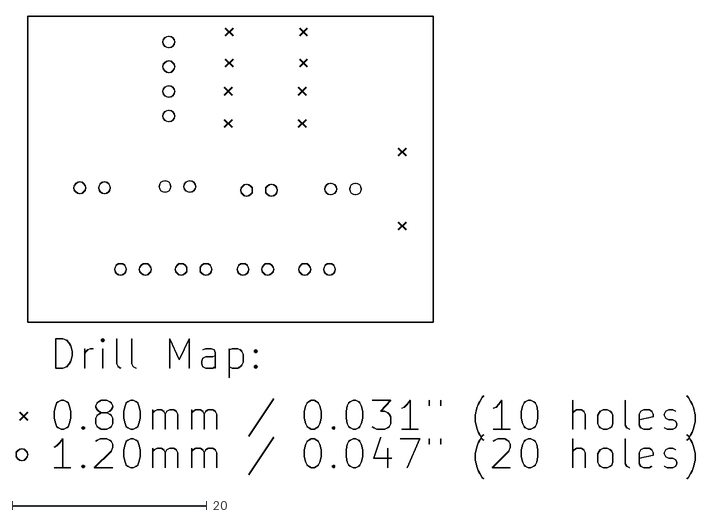
[picture p147: CAD file, 2025-11-29]
Hornet/Hornet PCBs/Active/OH - Left Console - 31 - Landing Gear/manufacturing/OH - Left Console - 31 - Landing Gear-PTH-drl_map.dxf
69.8 x 47.6
