bnepethomas/bne-arduino-flight-simulator-interfaces/Hornet/Hornet PCBs/Active/OH - Left Console - 32 - Selective Jettison/manufacturing/OH - Left Console - 32 - Selective Jettison-NPTH-drl_map.dxf

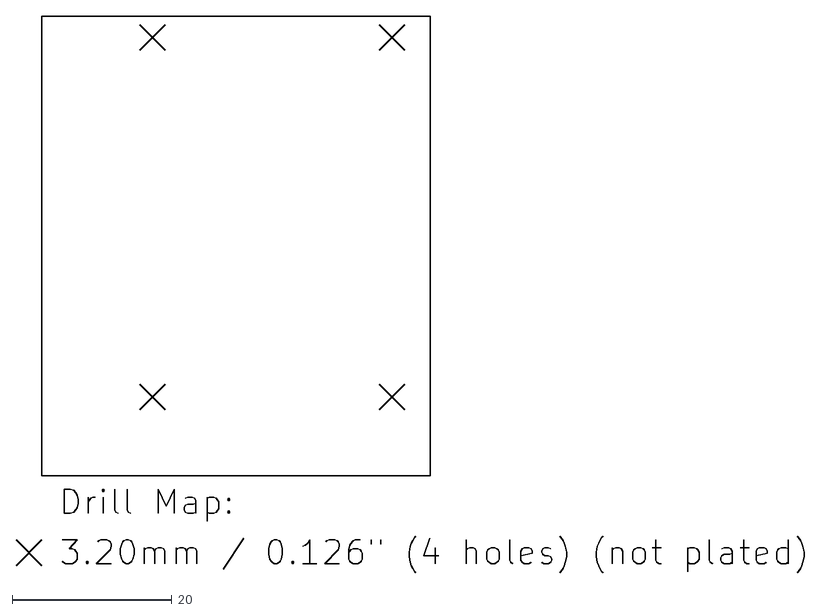
[picture p148: CAD file, 2025-11-29]
Hornet/Hornet PCBs/Active/OH - Left Console - 32 - Selective Jettison/manufacturing/OH - Left Console - 32 - Selective Jettison-NPTH-drl_map.dxf
98.6 x 69.7
