bnepethomas/bne-arduino-flight-simulator-interfaces/Hornet/Hornet PCBs/Active/OH - Left Console - 4 - Exterior Lights Panel/manufacturing/OH - Left Console - 4 - Exterior Lights Panel-NPTH-drl_map.dxf

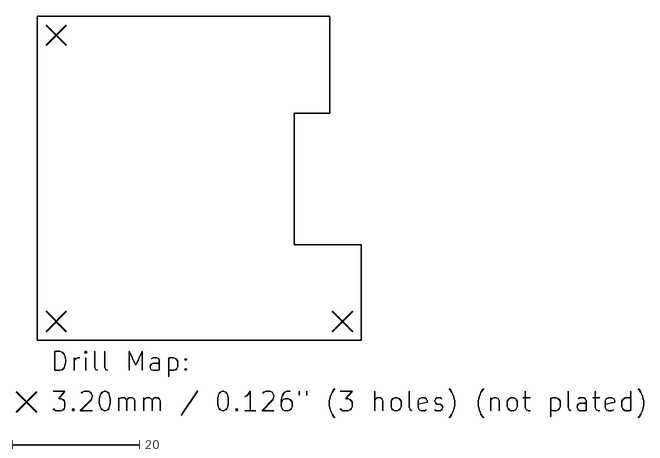
[picture p149: CAD file, 2025-11-29]
Hornet/Hornet PCBs/Active/OH - Left Console - 4 - Exterior Lights Panel/manufacturing/OH - Left Console - 4 - Exterior Lights Panel-NPTH-drl_map.dxf
98.6 x 63.2
