bnepethomas/bne-arduino-flight-simulator-interfaces/Hornet/Hornet PCBs/Active/OH - Left Console - 5 - Fuel Panel/manufacturing/OH - Left Console 5 - Fuel Panel-PTH-drl_map.dxf

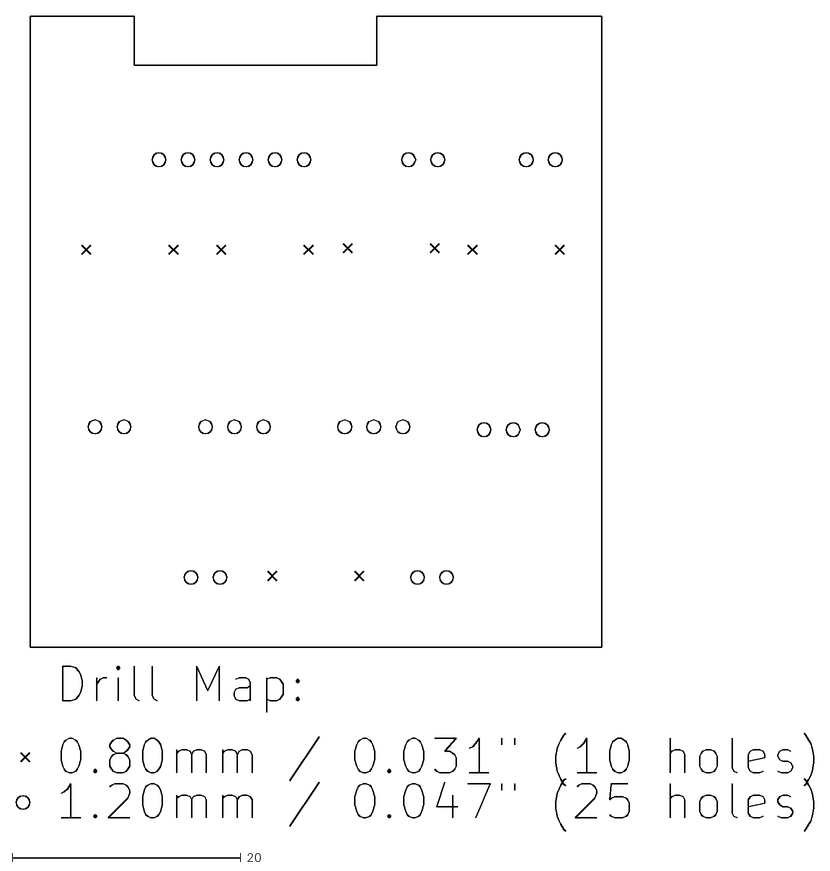
[picture p150: CAD file, 2025-11-29]
Hornet/Hornet PCBs/Active/OH - Left Console - 5 - Fuel Panel/manufacturing/OH - Left Console 5 - Fuel Panel-PTH-drl_map.dxf
69.8 x 71.3
