bnepethomas/bne-arduino-flight-simulator-interfaces/Hornet/Hornet PCBs/Active/OH - Left Console - 6 - Flight Control Systems Panel/manufacturing/OH - Left Console - 6 - Flight Control Systems Panel -NPTH-drl_map.dxf

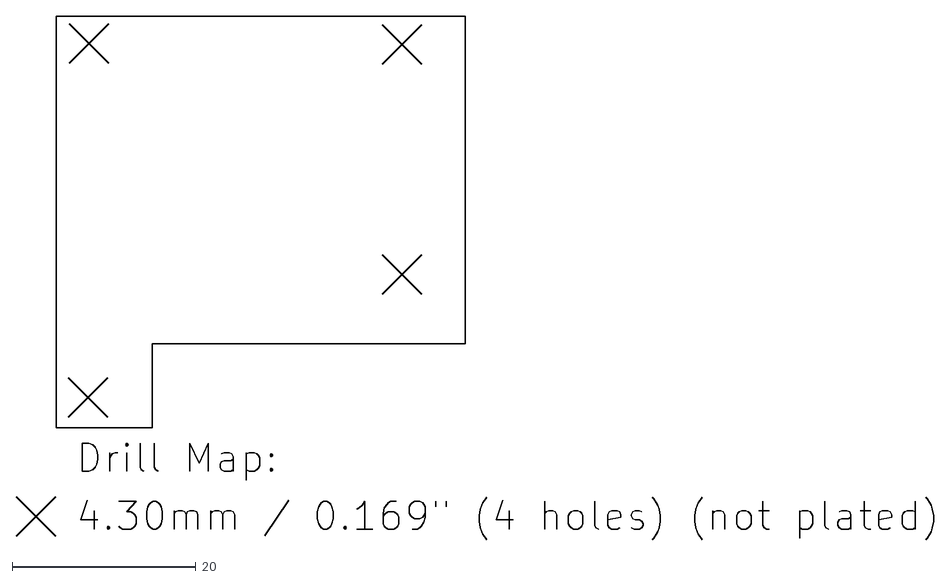
[picture p151: CAD file, 2025-11-29]
Hornet/Hornet PCBs/Active/OH - Left Console - 6 - Flight Control Systems Panel/manufacturing/OH - Left Console - 6 - Flight Control Systems Panel -NPTH-drl_map.dxf
99.7 x 56.9
