bnepethomas/bne-arduino-flight-simulator-interfaces/Hornet/Hornet PCBs/Active/OH - Left Console - 7 - Communication Panel/manufacturing/OH - Left Console - 7 - Communication Panel-NPTH-drl_map.dxf

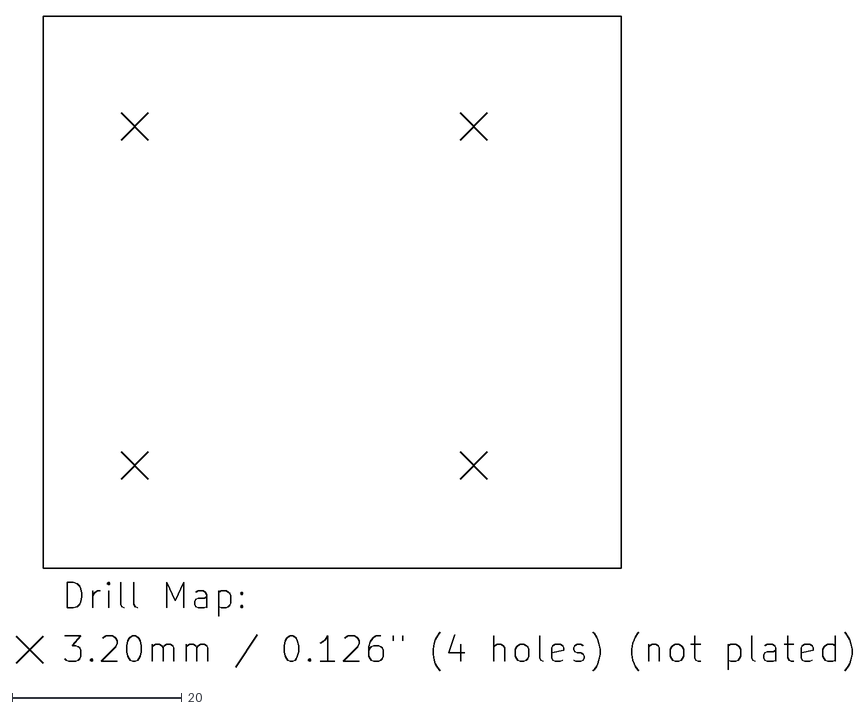
[picture p152: CAD file, 2025-11-29]
Hornet/Hornet PCBs/Active/OH - Left Console - 7 - Communication Panel/manufacturing/OH - Left Console - 7 - Communication Panel-NPTH-drl_map.dxf
98.6 x 77.3
