bnepethomas/bne-arduino-flight-simulator-interfaces/Hornet/Hornet PCBs/Active/OH - Left Console - 8 - LOX Indicator/manufacturing/OH - Left Console - 8 - LOX Indicator-NPTH-drl_map.dxf

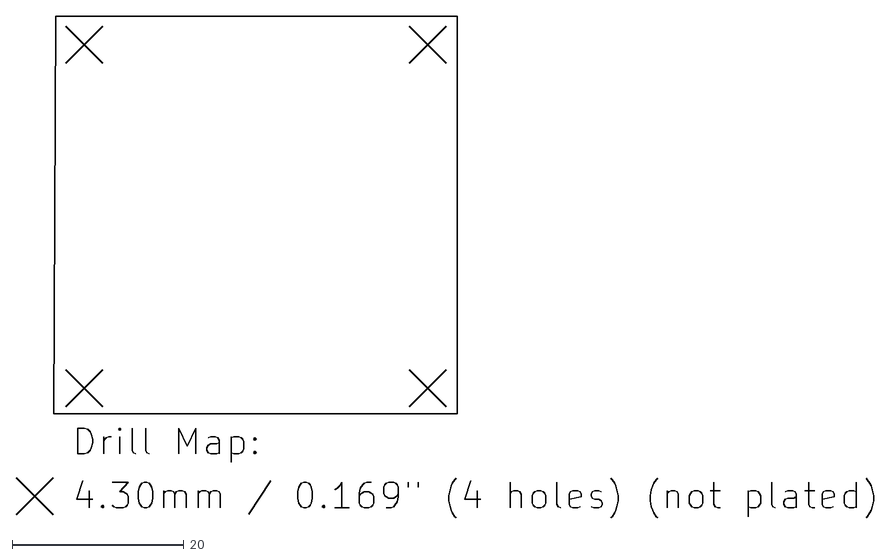
[picture p153: CAD file, 2025-11-29]
Hornet/Hornet PCBs/Active/OH - Left Console - 8 - LOX Indicator/manufacturing/OH - Left Console - 8 - LOX Indicator-NPTH-drl_map.dxf
99.7 x 58.4
