bnepethomas/bne-arduino-flight-simulator-interfaces/Hornet/Hornet PCBs/Active/OH - Left Console - Ejection Seat/MANUFACTURING/OH - Left Console - Ejection Seat-PTH-drl_map.dxf

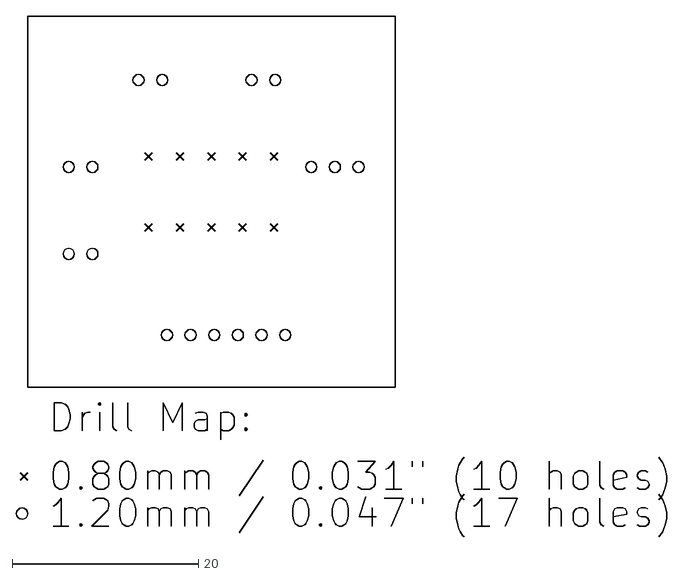
[picture p154: CAD file, 2025-11-29]
Hornet/Hornet PCBs/Active/OH - Left Console - Ejection Seat/MANUFACTURING/OH - Left Console - Ejection Seat-PTH-drl_map.dxf
69.8 x 55.9
