bnepethomas/bne-arduino-flight-simulator-interfaces/Hornet/Hornet PCBs/Active/OH - LEFT CONSOLE - OUTPUT DISTRIBUTION/Manufacturing/OH - Left Console - Output Distribution-PTH-drl_map.dxf

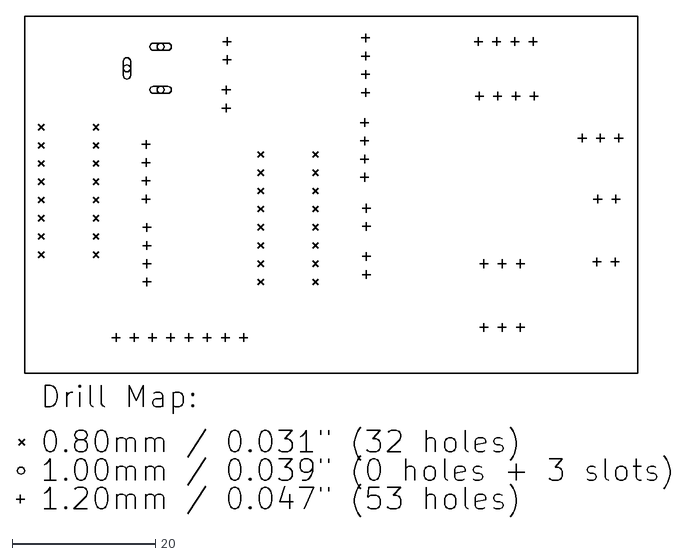
[picture p155: CAD file, 2025-11-29]
Hornet/Hornet PCBs/Active/OH - LEFT CONSOLE - OUTPUT DISTRIBUTION/Manufacturing/OH - Left Console - Output Distribution-PTH-drl_map.dxf
91.2 x 69.9
