bnepethomas/bne-arduino-flight-simulator-interfaces/Hornet/Hornet PCBs/Active/OH - Misc Lights/OH -  Lock Shoot.dxf

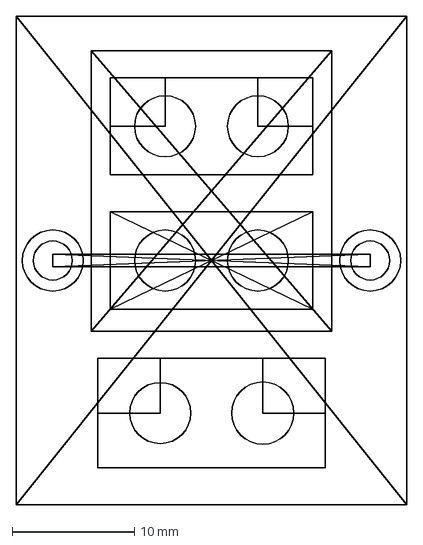
[picture p156: CAD file, 2025-11-29]
Hornet/Hornet PCBs/Active/OH - Misc Lights/OH - Lock Shoot.dxf
32.0 x 40.0 mm
