bnepethomas/bne-arduino-flight-simulator-interfaces/Hornet/Hornet PCBs/Active/OH - Power_Distro_PCB_V2/Manufacturing/Power Distro PCB V2-PTH-drl_map.dxf

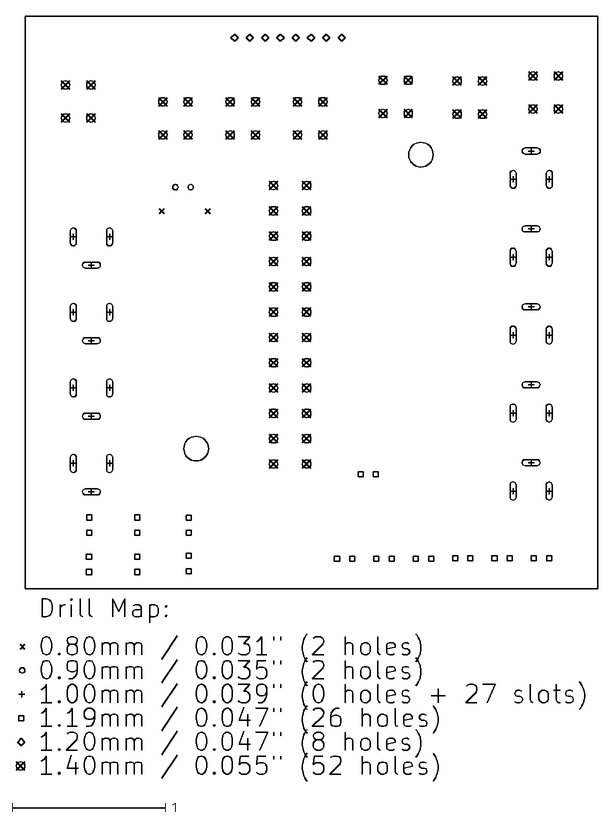
[picture p157: CAD file, 2025-11-29]
Hornet/Hornet PCBs/Active/OH - Power_Distro_PCB_V2/Manufacturing/Power Distro PCB V2-PTH-drl_map.dxf
3.80 x 5.00
