bnepethomas/bne-arduino-flight-simulator-interfaces/Hornet/Hornet PCBs/Active/OH - PowerDistribution/MANUFACTURING/PowerDistribution-PTH-drl_map.dxf

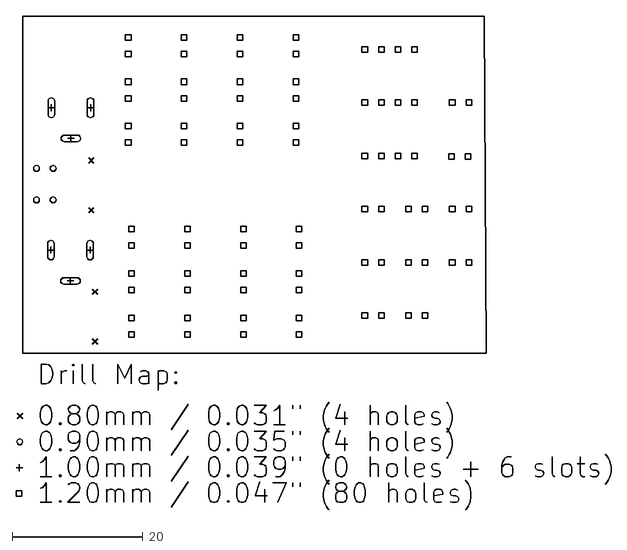
[picture p158: CAD file, 2025-11-29]
Hornet/Hornet PCBs/Active/OH - PowerDistribution/MANUFACTURING/PowerDistribution-PTH-drl_map.dxf
91.0 x 75.6
