bnepethomas/bne-arduino-flight-simulator-interfaces/Hornet/Hornet PCBs/Active/OH - Relay and Backlight Distribution/MANUFACTURING/OH - Relay and Backlight Distribution-PTH-drl_map.dxf

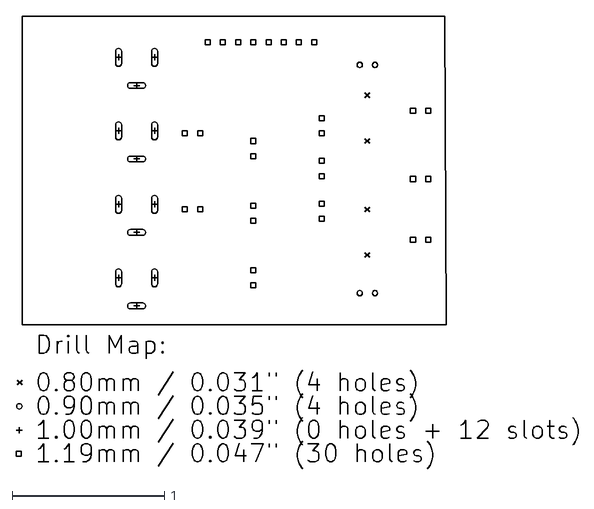
[picture p159: CAD file, 2025-11-29]
Hornet/Hornet PCBs/Active/OH - Relay and Backlight Distribution/MANUFACTURING/OH - Relay and Backlight Distribution-PTH-drl_map.dxf
3.70 x 2.98
