bnepethomas/bne-arduino-flight-simulator-interfaces/(list of files, cad)

Other CAD files:
Hornet/Hornet OH 3d Mods/Flood Lights/Right Circuit Breaker/Right Circuit Breaker Rear Assembly.3mf
737/737_Drawings_045.dwg
Hornet/Hornet OH 3d Mods/Defog/fog handle supportv2.dwg
Hornet/Hornet OH 3d Mods/Head Rest Side Panel/Head Rest Side Panel.dwg
Hornet/Hornet OH 3d Mods/Hornet_v049.dwg
Hornet/Hornet OH 3d Mods/UFC/Hornet_v049.dwg
Hornet/Hornet PCBs/Active/Eyebrow_warning_indicators/Right/EWI-Right.step
737/737_Stick_shaker.dwg
737/737_Stick_shaker.dxf
A10/A10 Hardware Models/Compass/Compass Front Panel.dxf
A10/A10 Hardware Models/Compass/FrontV2.stl
A10/A10 Hardware Models/Compass/Standby Compass- Body.stl
A10/A10 Hardware Models/Compass/Standby Compass- LED Mount.stl
A10/A10 Hardware Models/Compass/Standby Compass- Motor Base.stl
A10/A10 Hardware Models/Compass/Standby Compass- Rear.stl
A10/A10 Hardware Models/Compass/Standby Compass- Wheelv2 top.stl
A10/A10 Hardware Models/Compass/Standby Compass- Wheelv2.f3d
A10/A10 Hardware Models/Compass/Standby Compass- Wheelv2.stl
A10/A10 Hardware Models/Compass/Standby Compass- Wheelv3.stl
A10/A10 Hardware Models/Compass/Standby Compass- Wheelv4.stl
A10/A10 Hardware Models/Compass/bow mount.stl
A10/A10 Hardware Models/UHF Radio/UHF-ROTARIES.f3z
A10/A10 PCBs/A10 Power Distro PCB v1/Manufacturing/a10 Power Distro PCB v1-PTH-drl_map.dxf
A10/A10 PCBs/Cable Tester/Manufacturing/Cable Tester-PTH-drl_map.dxf
A10/A10 PCBs/Forward Console 7 Stepper Driver/MANUFACTURING/FORWARD 7 STEPPER DRIVER-PTH-drl_map.dxf
A10/A10 PCBs/Forward Console Combined Input and Output/MANFACTURING/Forward Console Combined Input and Output-PTH-drl_map.dxf
A10/A10 PCBs/Forward Console Inidividual PCBS/LANDING GEAR/MANUFACTURING/LANDING GEAR-PTH-drl_map.dxf
A10/A10 PCBs/Forward Console Inidividual PCBS/MASTER ARM/MANUFACTURING/MASTER ARM-PTH-drl_map.dxf
A10/A10 PCBs/Forward Console Inidividual PCBS/UFC/MANUFACTURING/UFC-F_Silkscreen.dxf
A10/A10 PCBs/Forward Console OLED/MANFACTURING/Forward OLED-PTH-drl_map.dxf
A10/A10 PCBs/General Use/Gauges/Simmeters Small Engine Replacement/MANUFACTURING/Simmeters Small Engine Replacement-PTH-drl_map.dxf
A10/A10 PCBs/General Use/Potentiometer Mount/MANUFACTURING/Potentiometer Mount-NPTH-drl_map.dxf
A10/A10 PCBs/Left Console Individual PCBs/AUDIO-KEYPAD/MANUFACTURING/AUDIO-KEYPAD-NPTH-drl_map.dxf
A10/A10 PCBs/Left Console Individual PCBs/FUEL/MANUFACTURING/FUEL-PTH-drl_map.dxf
A10/A10 PCBs/Left Console Individual PCBs/INTERCOMM BACKLIGHT VALIDATION/MANUFACTURING/INTERCOMM BACKLIGHT VALIDATION-PTH-drl_map.dxf
A10/A10 PCBs/Left Console Individual PCBs/SAS/MANUFACTURING/SAS-PTH-drl_map.dxf
A10/A10 PCBs/Left Console Individual PCBs/UHF-ROTARIES/MANUFACTURING/UHF-ROTARIES-PTH-drl_map.dxf
A10/A10 PCBs/Left Console Individual PCBs/VHF-AM-ROTARIES/MANUFACTURING/VHF-AM-ROTARIES-NPTH-drl_map.dxf
A10/A10 PCBs/Left Console Individual PCBs/VHF-FM-Lightbar/Manufacturing/VHF-FM-Lightbar-PTH-drl_map.dxf
A10/A10 PCBs/Left Console Input and Output with Rotary/MANUFACTURING/Left Console Input and Output with Rotary-PTH-drl_map.dxf
A10/A10 PCBs/Left Console Input/MANUFACTURING/Left Console Input-PTH-drl_map.dxf
A10/A10 PCBs/Right Console Individual PCBs/Caution Panel/MANUFACTURING/Caution Panel-NPTH-drl_map.dxf
A10/A10 PCBs/Right Console Individual PCBs/EWS/MANUFACTURING/EWS-NPTH-drl_map.dxf
A10/A10 PCBs/Z- A10 Retired PCBs/Forward Console Input/MANUFACTURING/Forward Console Input-PTH-drl_map.dxf
Hornet/Hornet OH 3d Mods/AMPCD/AMPCD Bezel v15.f3z
Hornet/Hornet OH 3d Mods/AMPCD/HDG-CRS Set Spacer v9.f3z
Hornet/Hornet OH 3d Mods/AOA/AOA Front.stl
Hornet/Hornet OH 3d Mods/AOA/AOA Rear Cover.stl
Hornet/Hornet OH 3d Mods/AOA/Combined AOA 5mm LED v12.f3d
Hornet/Hornet OH 3d Mods/AOA/Combined AOA 5mm LED v13.f3d
Hornet/Hornet OH 3d Mods/AP/AP Module Mounting Plate v7.f3z
Hornet/Hornet OH 3d Mods/ATX Power Supply Mount/ATX Power Supply Mount v5.f3d
Hornet/Hornet OH 3d Mods/ATX Power Supply Mount/ATX Power Supply Mount v5.stl
Hornet/Hornet OH 3d Mods/Canopy Bow Mounts/Canopy Bow Mount v4.f3d
Hornet/Hornet OH 3d Mods/Cap Head Bolts/Cap Head Bolt 4mm v1.f3d
Hornet/Hornet OH 3d Mods/Cap Head Bolts/Cap Head Bolt 4mm v1.step
Hornet/Hornet OH 3d Mods/Cap Head Bolts/Cap Head Bolt 4mm v1.stl
Hornet/Hornet OH 3d Mods/Cap Head Bolts/Cap Heat Bolt 6mm v2.f3d
Hornet/Hornet OH 3d Mods/Cap Head Bolts/Cap Heat Bolt 6mm v2.step
Hornet/Hornet OH 3d Mods/Cap Head Bolts/Cap Heat Bolt 6mm v2.stl
Hornet/Hornet OH 3d Mods/Caution Panel/Caution Lights Panel Chassis-bottom v1 v2.f3d
Hornet/Hornet OH 3d Mods/Caution Panel/Caution Lights Panel Chassis-mid v1 v1.f3d
Hornet/Hornet OH 3d Mods/Caution Panel/Caution Lights Panel Chassis-top v2 v2.f3d
Hornet/Hornet OH 3d Mods/Caution Panel/Caution Lights Panel Top Light Channel v2.f3d
Hornet/Hornet OH 3d Mods/Chart Light/Hornet Chart Light v3.f3d
Hornet/Hornet OH 3d Mods/Cockpit HandHeld Light Bracket/COCKPIT HANDHELD LIGHT BRACKET v3.f3d
Hornet/Hornet OH 3d Mods/DDI/DDI_Mounting_Spacer_v5_v2.f3d
Hornet/Hornet OH 3d Mods/DDI/DDI_Mounting_Spacer_v5_v2.stl
Hornet/Hornet OH 3d Mods/DDI/ddi ms21382-oxbx v1.stl
Hornet/Hornet OH 3d Mods/DDI/ufc comknob v1.f3z
Hornet/Hornet OH 3d Mods/Defog/Defog Lever v6.f3z
Hornet/Hornet OH 3d Mods/Defog/Defog Lever v6.stl
Hornet/Hornet OH 3d Mods/Defog/G-H Outboard v2.f3z
Hornet/Hornet OH 3d Mods/Defog/G-H Outboard v2.stl
Hornet/Hornet OH 3d Mods/ECM Button/ECM Button Angle Supports v4.f3z
Hornet/Hornet OH 3d Mods/ECM Button/ECM Button Angle Supports v4.stl
Hornet/Hornet OH 3d Mods/ECM Button/ECM Button Outer v2.f3d
Hornet/Hornet OH 3d Mods/ECM Button/ECM Button Outer v2.step
Hornet/Hornet OH 3d Mods/ECM Button/ECM Button Outer v2.stl
Hornet/Hornet OH 3d Mods/ECS Bleed Air/Bleed Air Mount v5.f3z
Hornet/Hornet OH 3d Mods/ECS Bleed Air/Bleed Air Mount v5.stl
Hornet/Hornet OH 3d Mods/ECS Bleed Air/ECS Bleed Air Shaft Spacer v2.f3d
Hornet/Hornet OH 3d Mods/ECS Bleed Air/ECS Bleed Air Shaft Spacer v2.step
Hornet/Hornet OH 3d Mods/ECS Bleed Air/ECS Bleed Air Shaft Spacer v2.stl
Hornet/Hornet OH 3d Mods/EWI/EWI Left Light Channel v2.f3z
Hornet/Hornet OH 3d Mods/EWI/EWI Right Light Channel v2.f3z
Hornet/Hornet OH 3d Mods/EWI/EWI_Chassis_-_Left_v2.f3d
Hornet/Hornet OH 3d Mods/EWI/EWI_Chassis_-_Right_v2.f3d
Hornet/Hornet OH 3d Mods/EWI/EWI_HANDLE_v1.stl
Hornet/Hornet OH 3d Mods/EWI/Eyebrow Warning Buttons v9.f3d
Hornet/Hornet OH 3d Mods/EWI/Left EWI with Bumps v5.f3z
Hornet/Hornet OH 3d Mods/EWI/Right EWI with Bumps v6.f3z
Hornet/Hornet OH 3d Mods/Flood Lights/Flood Light Bracket Left v7.f3d
Hornet/Hornet OH 3d Mods/Flood Lights/Flood Light Bracket Right v3.f3d
Hornet/Hornet OH 3d Mods/Flood Lights/Forward Flood Lights/Cable Clamp.stl
Hornet/Hornet OH 3d Mods/Flood Lights/Forward Flood Lights/Component6.stl
Hornet/Hornet OH 3d Mods/Flood Lights/Forward Flood Lights/Forward Flood Light Bracket v3.f3d
Hornet/Hornet OH 3d Mods/Flood Lights/Forward Flood Lights/Forward Flood Light Bracket v3.step
Hornet/Hornet OH 3d Mods/Flood Lights/Forward Flood Lights/Forward Flood Light Primary Mount.stl
Hornet/Hornet OH 3d Mods/Flood Lights/Forward Flood Lights/Nut.stl
Hornet/Hornet OH 3d Mods/Flood Lights/Forward Flood Lights/Petes Forward LIght v28.f3d
Hornet/Hornet OH 3d Mods/Flood Lights/Forward Flood Lights/Petes Forward LIght v28.step
Hornet/Hornet OH 3d Mods/Flood Lights/Left Circuit Breaker/Bulb Support - Cable Clamp.stl
Hornet/Hornet OH 3d Mods/Flood Lights/Left Circuit Breaker/Bulb Support for Circuit Breaker Light v9.f3d
Hornet/Hornet OH 3d Mods/Flood Lights/Left Circuit Breaker/Bulb Support for Circuit Breaker Light v9.step
Hornet/Hornet OH 3d Mods/Flood Lights/Left Circuit Breaker/Left Circit Breaker Front Plate.stl
Hornet/Hornet OH 3d Mods/Flood Lights/Left Circuit Breaker/Left Circuit Breaker Bracket with Light v8.f3z
Hornet/Hornet OH 3d Mods/Flood Lights/Left Circuit Breaker/Left Circuit Breaker Bracket with Light v8.step
Hornet/Hornet OH 3d Mods/Flood Lights/Mid Flood Lights/Flood Light Bracket Left v7.f3d
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
