bnepethomas/bne-arduino-flight-simulator-interfaces/Jet Ranger/Jet Ranger Documentation/DocBuild/src/guide/01c_programs.md

# Program windows

This chapter shows every window of the Windows programs in `Jet Ranger/ C# Code/`. The screenshots were taken from the current builds. The two bridges were captured with no simulator running, so they show their disconnected state; with a simulator connected the left box fills with the values being sent and the list shows the lamps lighting.

| Program | Used for | Section |
|---|---|---|
| FSUIPCWinformsAutoCS | Bridge for Prepar3D and FSX | Bridges |
| MSFSWinformsAutoCS | Bridge for MSFS 2020 and 2024 | Bridges |
| DCSBiosBridge | Bridge for DCS World (through DCS-BIOS) | Bridges |
| XPlaneBridge | Bridge for X-Plane (through UDP datarefs) | Bridges |
| JetRangerHealthMonitor | Shows which boards are alive and the last voltage reading from each | Health Monitor |
| BenchTester | Swings every gauge, lamps, OLEDs, tests the Auto Pilot, Audio and Huey panel LEDs, resets boards, sets brightness | BenchTester |
| StepperVSITester | Sends real and raw values to the stepper boards and the servo | StepperVSITester |
| JetRangerRadioControllerEmulator, JetRangerUpperControllerEmulator | Stand in for the radio and upper boards' knobs and keys | Emulators |
| JetRangerPanelEmulator | Shows what each controller board would show: gauges, lamps, LEDs and OLEDs | Panel emulators |
| LowranceAirMapGps | Feeds the Lowrance AirMap 2000C | GPS interface |
| LowranceAirMapGpsBenchTester | Sends aircraft data to the GPS interface for testing | GPS bench tester |

> **Careful:** the BenchTester, StepperVSITester and the two emulators send packets to the real boards (the addresses are in the boxes) as soon as you use their controls. Close them, or point them at the right addresses, before you press anything while the cockpit is powered.

## Bridges

FSUIPCWinformsAutoCS (Prepar3D and FSX)

MSFSWinformsAutoCS (MSFS 2020 and 2024)

Both bridges have one window with the same layout.

- **Show packets...** button (under the Avionics Master box): opens the packet monitor (see Packet monitor below).
- **Send to the boards** and **Send to the emulators** check boxes (under the Avionics Master box): the bridge sends to the real boards, to the panel emulators (see Panel emulators), or to both. The boards box is on and the emulators box off unless you start the bridge with `--emulators` or `--emulators-only`.
- **Avionics Master** check box: follows the simulator's avionics master switch and can also be used to switch it.
- **Readout box** (left): the values being sent to the boards, one per line (airspeed, altitude, bus voltages, engine and transmission values, radio frequencies and, in the MSFS bridge, the GPS position and heading). It is empty until the simulator is connected.
- **Annunciator list** (right): every warning lamp with its state, ON or OFF. The FSUIPC bridge lists the 21 lamp bits of the DodoSim aircraft; the MSFS bridge lists the 15 lamps of the panel.
- **Status bar** (bottom): *Disconnected. Looking for Flight Simulator...* in red until the simulator is found, then the connection and (MSFS) the aircraft name in green, or orange when the simulator is paused or loading and no data arrives.
- **Pause data out** check box and **About...** button (under the Show packets button, in the MSFS and FSUIPC bridges): *Pause data out* freezes the readout box while the data keeps going to the boards; *About...* shows the version, build number and build date and time. The readout box grows with the window and has a scroll bar. Besides the values it shows the DME (`DME (NAV 1): IBN  12.3 NM  120 KT`), the Auto Pilot and Audio LEDs the simulator reports and the last keypad and ADF knob events, which is the place to look when a panel LED or display does not follow the simulator.

Run only one bridge at a time. All four bridges have an **About...** button (the DCS and X-Plane bridges on their toolbar) that shows the program's version, **build number** and the **date and time it was built**, and a bridge icon.

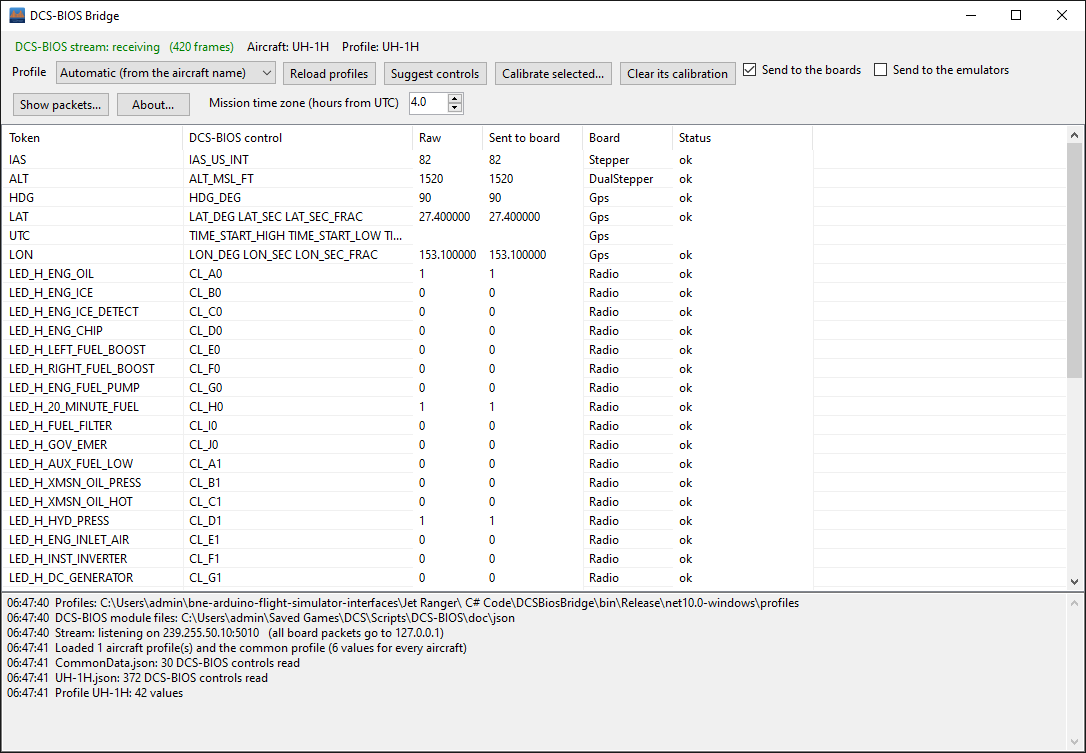
[picture p160: Jet Ranger/Jet Ranger Documentation/DocBuild/screenshots/dcs_bridge.png]
DCSBiosBridge (DCS World) with a synthetic UH-1H stream: three caution lights on, the common values, the mission clock with its time zone box and the Huey LED rows (scroll for the gauges)


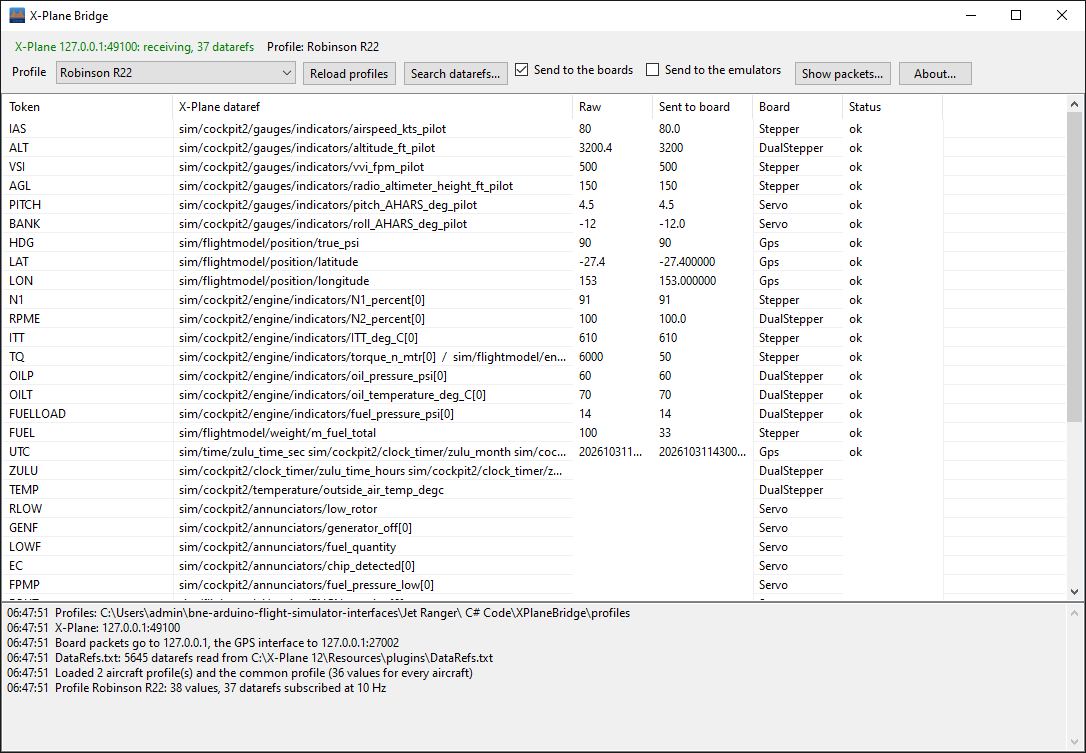
[picture p161: Jet Ranger/Jet Ranger Documentation/DocBuild/screenshots/xplane_bridge.png]
XPlaneBridge (X-Plane) against a fake X-Plane with the Robinson R22 profile (scroll for the Huey LEDs, rotor speed and bus voltage)


**DCSBiosBridge** and **XPlaneBridge** have a different window (with the same **Send to the boards** and **Send to the emulators** check boxes and a **Show packets...** button): a status line (the DCS-BIOS stream and aircraft, or the X-Plane address and whether data is arriving), a **Profile** box (Automatic, or an aircraft chosen by hand), **Reload profiles**, a **Send to the boards** check box, a table of every token with its source control or dataref, the raw value, the value sent and the board, and a log at the bottom. The DCS bridge also has **Suggest controls** (finds controls for a new profile), **Calibrate selected...** and **Clear its calibration** for the Huey needle gauges; the X-Plane bridge has **Search datarefs...**. See Running the DCS bridge and Running the X-Plane bridge.

## Packet monitor

Every bridge can show the packets it sends. Press **Show packets...** (or start the bridge with `--show-packets`) to open the **Packets sent to the boards** window:

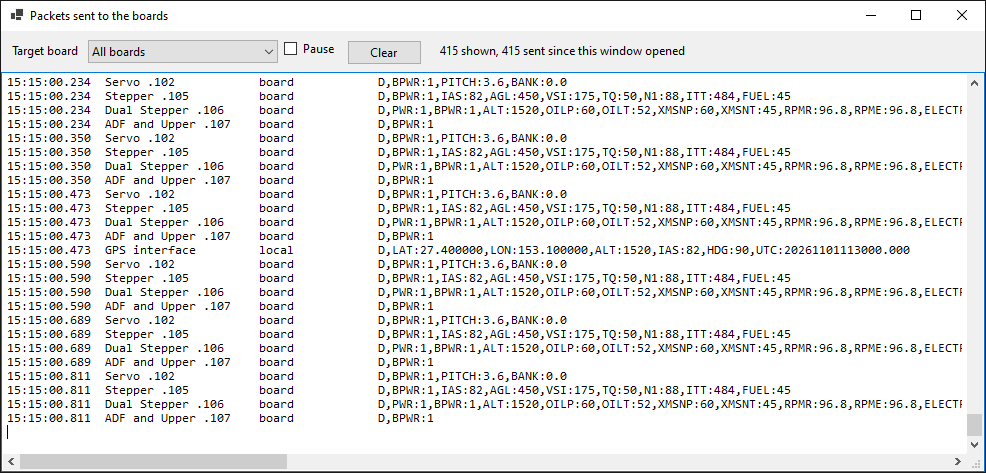
[picture p162: Jet Ranger/Jet Ranger Documentation/DocBuild/screenshots/packet_monitor.png]
Packet monitor


Each line is one packet: the time, the **target board** (Radio .101, Servo .102, Stepper .105, Dual Stepper .106, ADF and Upper .107, the retired Upper .103 in the FSUIPC and MSFS bridges, or the GPS interface), where it went (*board*, *emulator*, *board + emulator* or *local* for the GPS interface) and the payload text the board receives. The Radio's packet goes out only when something changes and at least every 5 seconds, the other boards' about ten times a second.

The **Target board** box filters the list to one board. Start with `--packet-board <radio, servo, stepper, dual, adf, gps or a number such as 105>` to open the window already filtered.

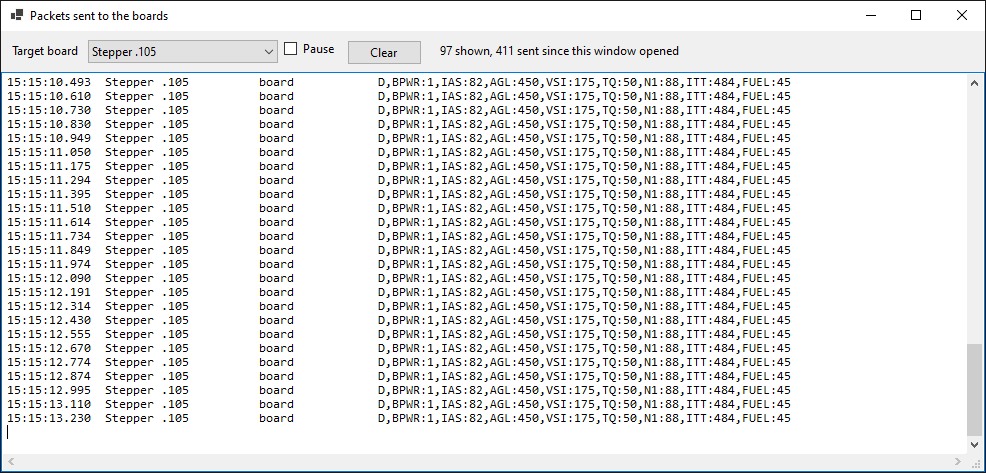
[picture p163: Jet Ranger/Jet Ranger Documentation/DocBuild/screenshots/packet_monitor_filtered.png]
Packet monitor filtered to the Stepper controller


**Pause** stops adding lines (the packets sent while paused are not kept) and **Clear** empties the list. Only packets that are really sent are shown: with both **Send** boxes unticked, or (DCS and X-Plane bridges) while no data is arriving from the simulator, the list stays empty. The window keeps the most recent lines and the last 6,000 packets for re-filtering.

## Health Monitor

JetRangerHealthMonitor: all seven boards heard

One coloured label per board: Comm Nav, Servo, Joystick, Upper Input, Stepper, Dual Stepper and ADF (the combined ADF and Upper board lights both the Upper Input and ADF labels). Each turns green when that board's 10 second heartbeat arrives on UDP 13137. The **Hide Logs** button hides the list of received heartbeats (the sender address and time of each one) and shrinks the window; it then reads **Show Logs**.

The **Show Voltages** button opens a table with one row per board:

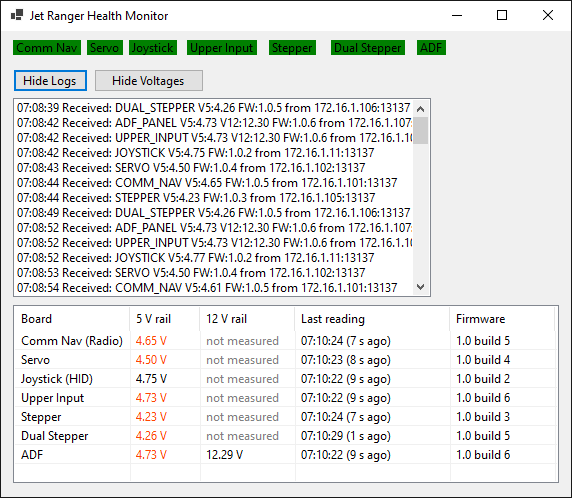
[picture p164: Jet Ranger/Jet Ranger Documentation/DocBuild/screenshots/health_monitor_voltages.png]
Voltage table


Each board adds its 5 V rail and its firmware version to its heartbeat, and the ADF also adds its 12 V rail, so the table shows the last 5 V reading from every board, the **12 V** reading for the ADF only (the other rows say "not measured"), when the reading arrived and the **Firmware** version and build the board is running (for example *1.0 build 5*). A board with older firmware shows *not reported*. A reading outside its limits (5 V outside 4.75 to 5.25, 12 V outside 10.8 to 15.0) is orange, and a reading that is more than 35 seconds old, or that has not arrived yet, is grey. A board that has not been reflashed since the voltages were added shows "no reading" but still lights green. *Hide Voltages* closes the table.

Logs hidden

A board that goes quiet turns orange after 15 seconds and red after 30 seconds.

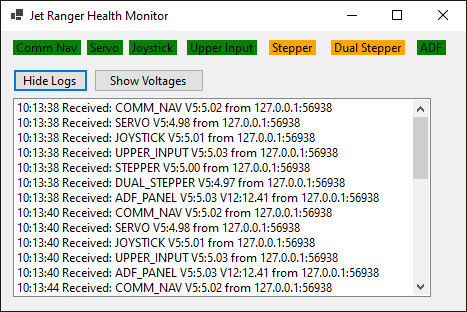
[picture p165: Jet Ranger/Jet Ranger Documentation/DocBuild/screenshots/health_monitor_warning.png]
Stepper and Dual Stepper quiet for 15 seconds: orange


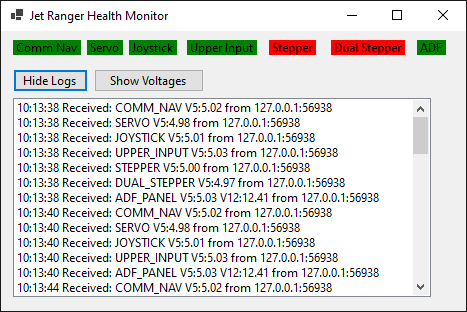
[picture p166: Jet Ranger/Jet Ranger Documentation/DocBuild/screenshots/health_monitor_lost.png]
Stepper and Dual Stepper quiet for 30 seconds: red


## BenchTester

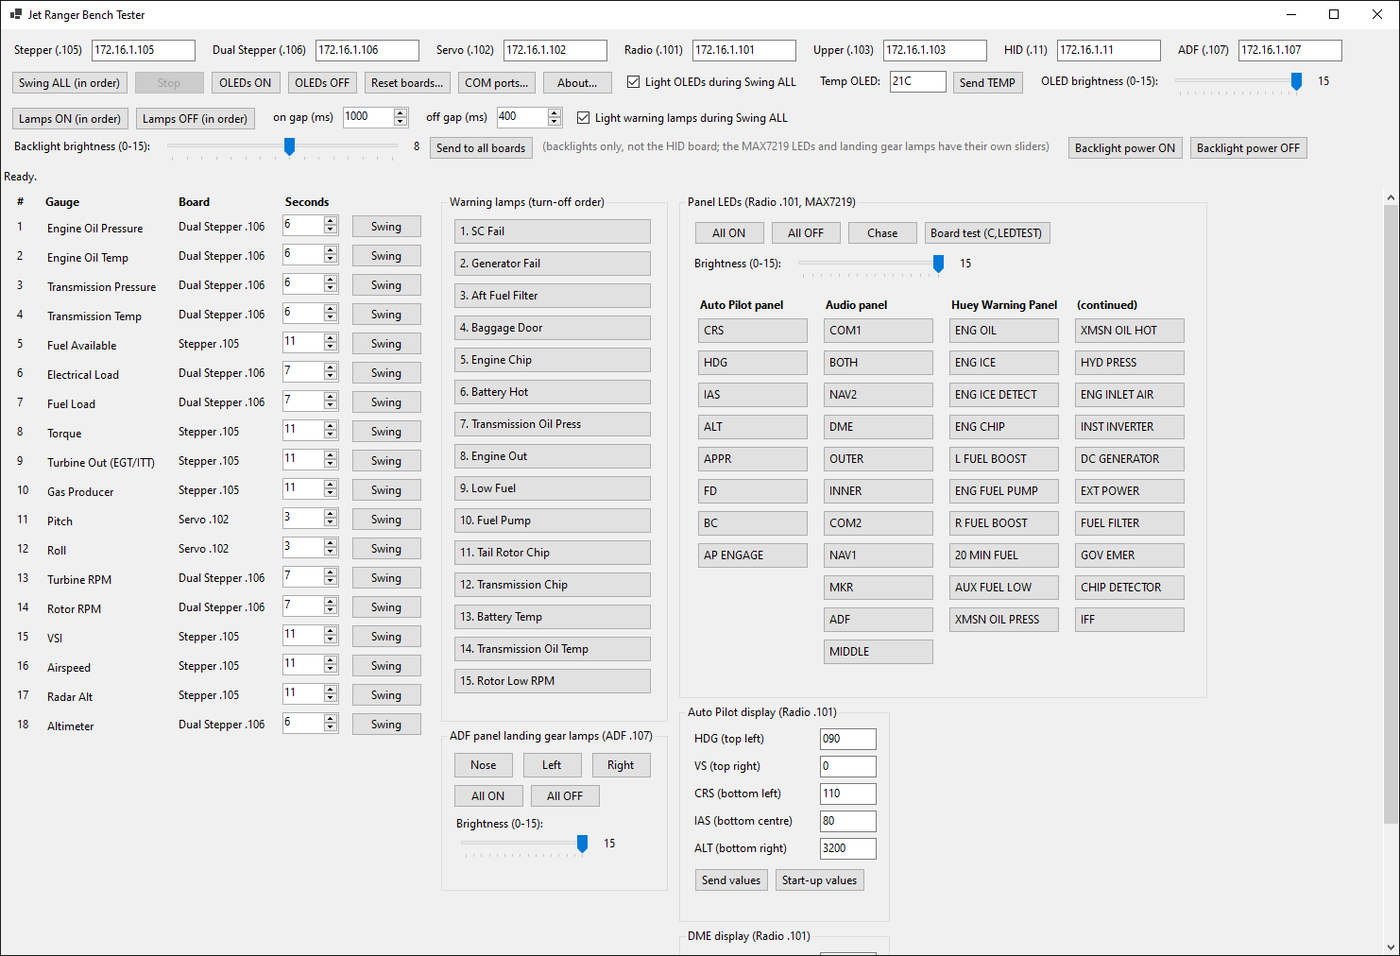
[picture p167: Jet Ranger/Jet Ranger Documentation/DocBuild/screenshots/swing_tester.png]
BenchTester main window


The BenchTester was called SwingTester until 7 November 2026; it was renamed because it does more than swing the gauges.

- **Top row:** the IP addresses of the boards (Stepper, Dual Stepper, Servo, Radio, Upper, ADF and HID; the Upper address .103 is the retired board, the ADF and Upper board is .107).
- **Swing ALL (in order)** runs the 18 gauge swings in the fixed order, **Stop** cancels the remaining waits, **OLEDs ON / OFF** fill or restore the Dual Stepper's four OLEDs, **Reset boards...** opens the reset dialog, and **Light OLEDs during Swing ALL** controls the OLEDs. **Temp OLED** with **Send TEMP** sends text to the Dual Stepper's temperature display.
- **Lamps ON (in order)** and **Lamps OFF (in order)** with the **on gap** and **off gap** times, and **Light warning lamps during Swing ALL**.
- **Backlight brightness (0-15)** slider with **Send to all boards** sends the backlight brightness to every board except the USB HID board (the Radio, Servo, Stepper, Dual Stepper and ADF and Upper, and the retired Upper address); **Backlight power ON / OFF** send `BPWR` to those boards to test the main bus rule. The slider changes the backlights only. Three more sliders have levels of their own: **OLED brightness (0-15)** (top button row, the Dual Stepper's four SSD1306 OLEDs), **Brightness (0-15)** in the Panel LEDs group (the Radio's MAX7219 LEDs, starting at 15) and **Brightness (0-15)** in the ADF panel landing gear lamps group (the lamps, starting at 15).
- **Status line:** what was last sent and to which boards.
- **Panel LEDs group** (far right): one toggle for each of the 39 Auto Pilot, Audio and Huey Warning Panel LEDs (gold when on; the Huey LEDs are in two columns, *Huey Warning Panel* and *(continued)*), which lights that LED on its own through the Radio controller (`D,NAVCOM1:1,LED_xxx:1/0` or `LED_H_xxx`). **All ON** and **All OFF** do all 39, **Chase** lights them one at a time for the *on gap* time (click again to stop; a full chase of 39 takes about 39 seconds at the default), and **Board test (C,LEDTEST)** lights all 39 with the Radio's own test. The Radio on COM20 was flashed with the Huey build on 31 October 2026; the LEDs have not been checked on the panel yet.
- **Auto Pilot display group** (far right, below the panel LEDs): five boxes for HDG, VS, CRS, IAS and ALT (start-up values 090, 0, 110, 80 and 3200). **Send values** sends them to the Radio for the Auto Pilot panel's OLED and **Start-up values** puts the start-up values back.
- **ADF panel landing gear lamps** (under the warning lamps): **Nose**, **Left** and **Right** toggles (gold when on) light the three lamps on the ADF panel through the ADF controller (172.16.1.107, set in the `ADF (.107)` box at the top), with **All ON** and **All OFF**.
- **DME display** group (under the Auto Pilot display): **Distance (nm)**, **Speed (knots)** and **Station ident** boxes with **Send DME** and **No DME**, to try the Radio's DME display without a simulator. **About...** shows the BenchTester's version, build number and build date and time.
- **COM ports...** opens a window that lists the PC's COM ports with the board type, the USB serial number and whether another program has the port open, and can restart a USB device (see COM ports window below).
- **Gauge rows** (left): the 18 gauges with the board each is on, the wait in seconds and a **Swing** button for each. The row being swung is highlighted gold.
- **Warning lamps** (right): one button for each of the 15 lamps, in turn-off order. A lamp that is on is gold.

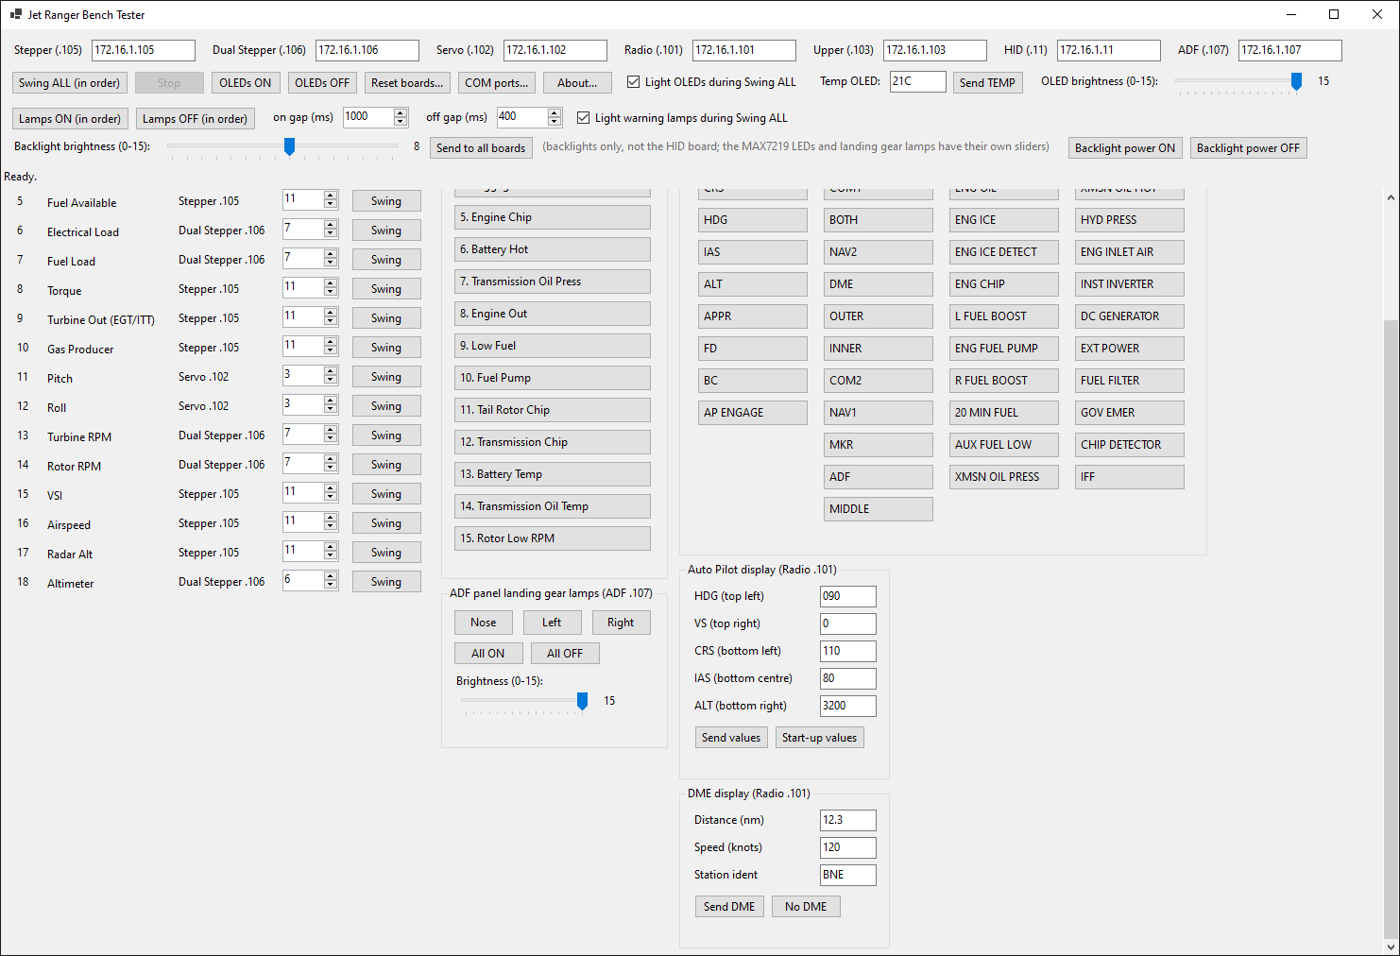
[picture p168: Jet Ranger/Jet Ranger Documentation/DocBuild/screenshots/swing_tester_bottom.png]
BenchTester scrolled to the end of the form: the Auto Pilot display and DME display groups


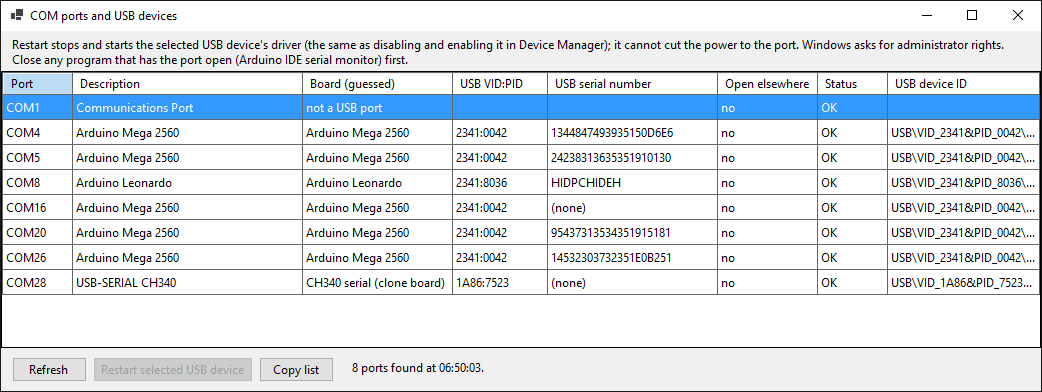
[picture p169: Jet Ranger/Jet Ranger Documentation/DocBuild/screenshots/swing_tester_ports.png]
The COM ports window


**COM ports...** lists every COM port Windows knows: the port, Windows' description, the board type (guessed from the USB vendor and product ids), the USB serial number (genuine Arduino boards have one; most clones do not), whether another program has the port open (for example the Arduino IDE serial monitor, which blocks flashing), the status and the USB device id. It refreshes by itself when a device is plugged in or removed. **Copy list** puts the table on the clipboard. **Restart selected USB device** stops and starts the selected board's USB device with `pnputil` (the same as disabling and enabling it in Device Manager, so the port reappears; it cannot cut the power): Windows asks for administrator rights, and the port must not be open in another program.

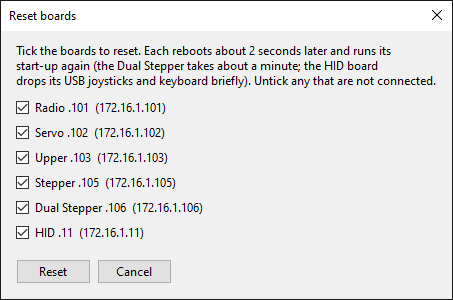
[picture p170: Jet Ranger/Jet Ranger Documentation/DocBuild/screenshots/swing_tester_reset.png]
The Reset boards dialog


The **Reset boards...** dialog has a tick box for each board (all ticked; untick any that are not connected). **Reset** sends `C,RESET:1` to each ticked board and **Cancel** closes the dialog without sending anything.

## StepperVSITester

The window scrolls; both halves are shown.

StepperVSITester, top half

StepperVSITester, bottom half

The target is shown at the top (the Stepper board, 172.16.1.105 port 13136). Each gauge has a slider, a text box, **Send** and **Zero**:

- **VSI (fpm)**, **ALT (ft)**, **Radar ALT (ft)**: real values for the vertical speed, altimeter and radar altimeter.
- **ALT Direct Step Jog** sends a signed step count at a fixed interval, bypassing the acceleration ramp.
- **Raw Step Test** sends raw steps to the chosen gauge code (with **-1 Step** and **+1 Step** nudge buttons).
- **Temperature OLED** sends text to the Dual Stepper's temperature display, and the **ITT / EGT** slider below it sends turbine out temperature.
- **Real-Value Gauges** rows for engine oil temperature and pressure, transmission oil temperature and pressure, gas producer and fuel.
- **IAS**, **RPME** and **RPMR** sliders for airspeed, engine speed and rotor speed.
- **Dual Stepper test** rows (fuel load, electrical load, the clock), **Single Stepper test** (torque) and **Servo Controller test** (pitch and bank, in degrees or as raw servo positions).

## Emulators

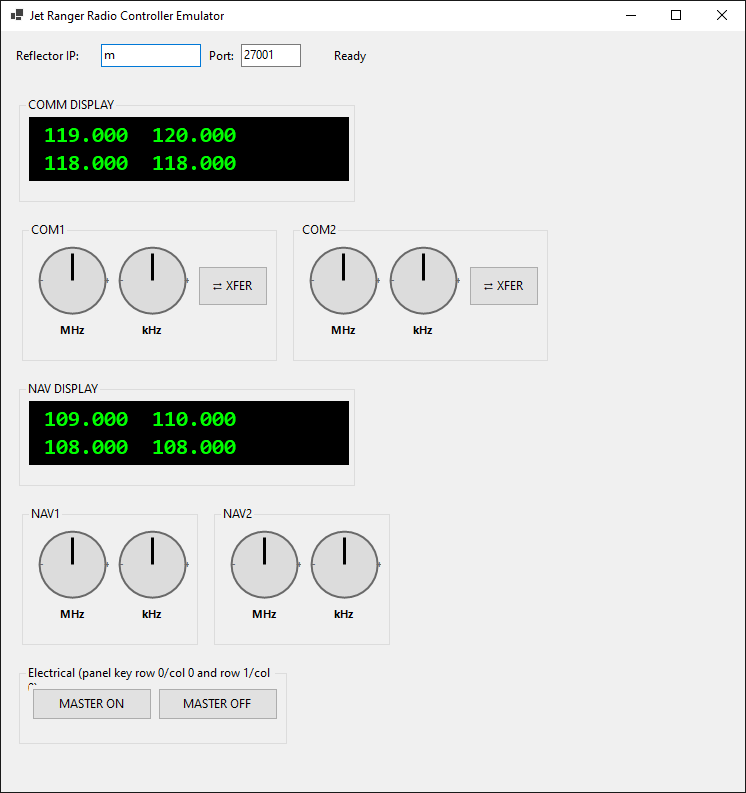
[picture p171: Jet Ranger/Jet Ranger Documentation/DocBuild/screenshots/radio_emulator.png]
JetRangerRadioControllerEmulator


The **Radio controller emulator** stands in for the radio board. Set the reflector (bridge) address and port at the top. The COMM and NAV displays show the active and standby frequencies; each radio has a **MHz** and a **kHz** knob (click the right half to turn it up one detent, the left half to turn it down) and the COM radios have an **XFER** swap button. **MASTER ON** and **MASTER OFF** send the battery and alternator commands. Every control sends its packet to the bridge on UDP 27001 at once.

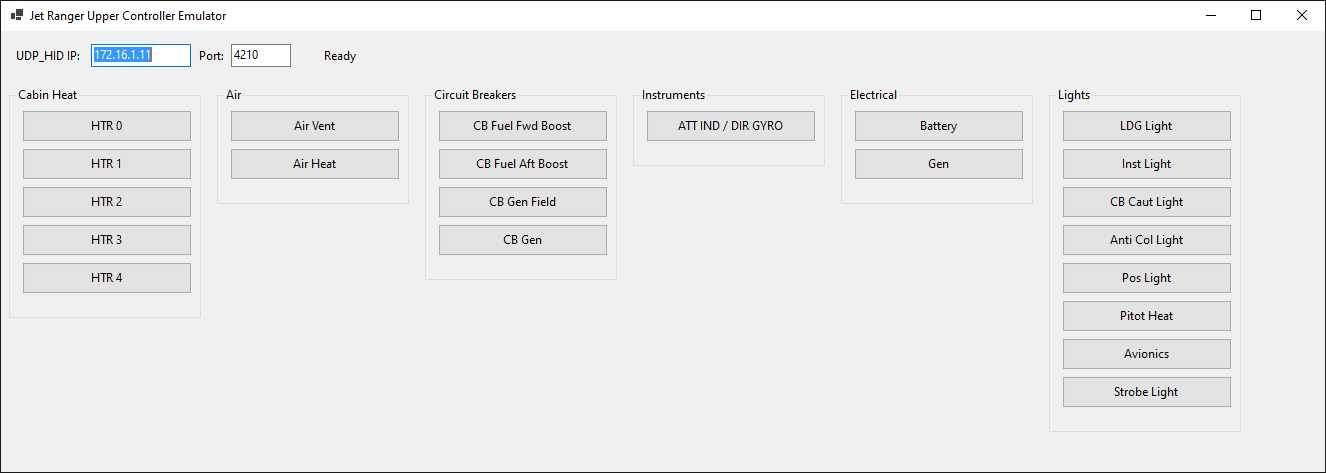
[picture p172: Jet Ranger/Jet Ranger Documentation/DocBuild/screenshots/upper_emulator.png]
JetRangerUpperControllerEmulator


The **Upper controller emulator** stands in for the upper panel (now on the combined ADF and Upper board; the switch numbers are unchanged). Set the USB HID board's address and port at the top (172.16.1.11, 4210). There is one toggle button per switch the firmware uses, in groups: Cabin Heat, Air, Circuit Breakers, Instruments, Electrical and Lights. A button turns green when its switch is on, and each press sends the switch change to the USB HID board.

## Panel emulators

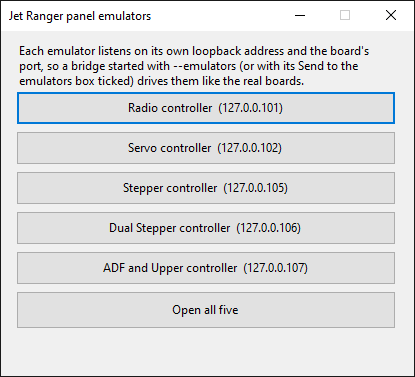
[picture p173: Jet Ranger/Jet Ranger Documentation/DocBuild/screenshots/emulator_launcher.png]
The launcher


`JetRangerPanelEmulator` shows what each controller board would show, so you can try a bridge with no cockpit connected. Start it (or run the start-up script with `-Emulators`), press **Open all five** (or one button) and start a bridge with **Send to the emulators** ticked, or with `--emulators` or `--emulators-only`. The emulators listen on the same port as the boards, at 127.0.0.101 (Radio), .102 (Servo), .105 (Stepper), .106 (Dual Stepper) and .107 (ADF and Upper), on the PC the bridge runs on. Nothing is sent to them by anything else.

Every emulator window has a status bar with its address, the number of packets received and the last packet, and *live* or *no data for n s - blank*. The backlight goes dark with `BPWR:0` and after 30 seconds with no data, as on the real boards; after 30 seconds without data the needles also return to zero.

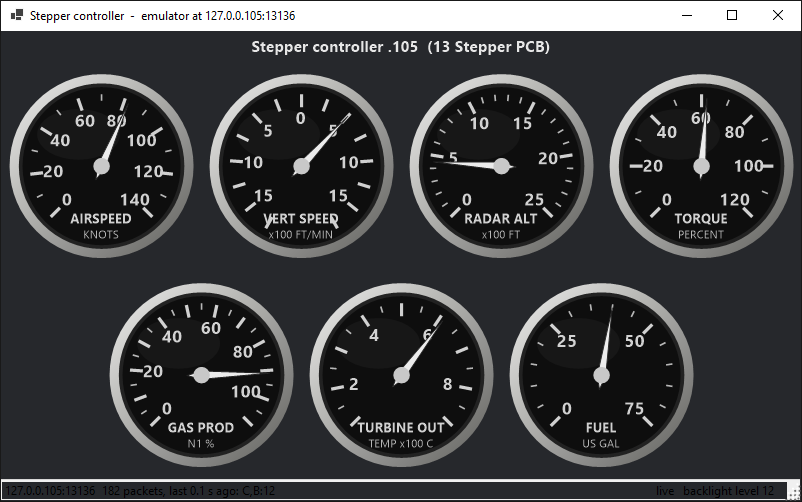
[picture p174: Jet Ranger/Jet Ranger Documentation/DocBuild/screenshots/emulator_stepper.png]
Stepper controller emulator


**Stepper controller:** airspeed, vertical speed, radar altitude, torque, gas producer, turbine out temperature and fuel quantity.

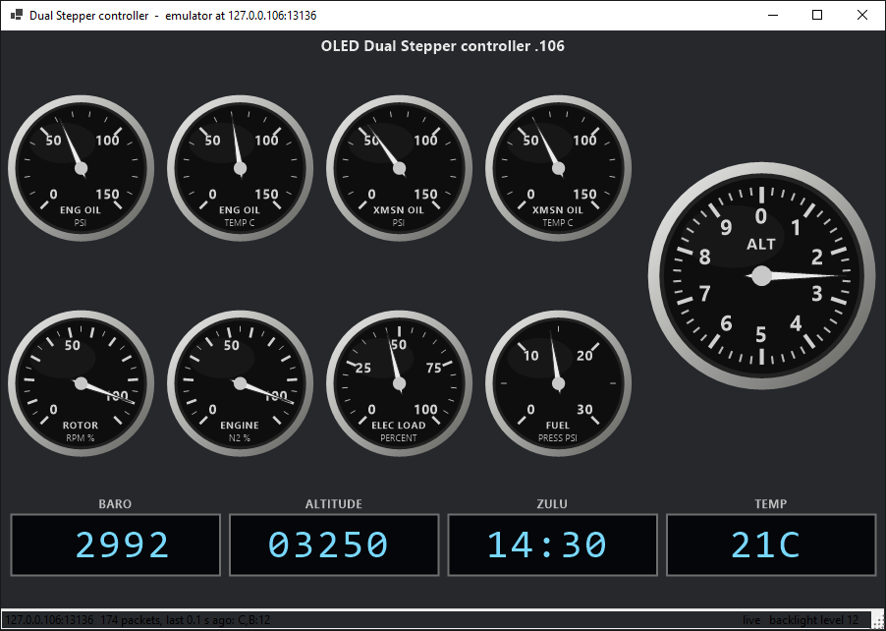
[picture p175: Jet Ranger/Jet Ranger Documentation/DocBuild/screenshots/emulator_dual_stepper.png]
Dual Stepper controller emulator


**Dual Stepper controller:** the oil, transmission, rotor, engine, electrical load and fuel pressure gauges, the altimeter and the four OLEDs (barometer, altitude, zulu clock, temperature).

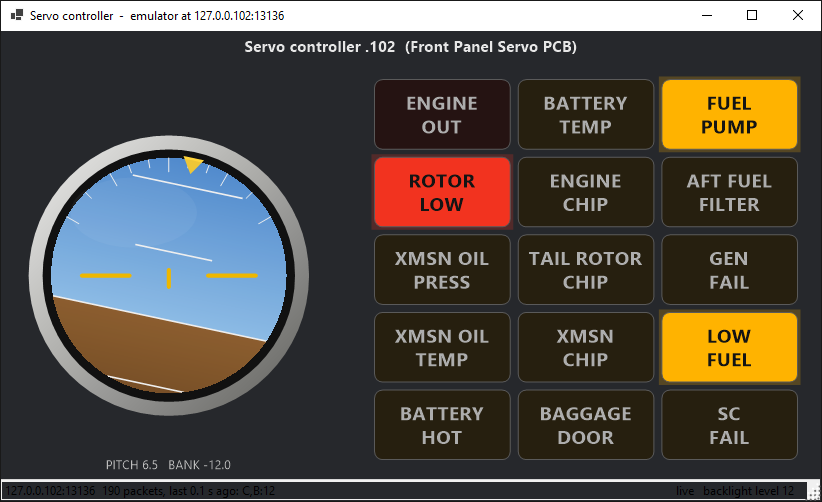
[picture p176: Jet Ranger/Jet Ranger Documentation/DocBuild/screenshots/emulator_servo.png]
Servo controller emulator


**Servo controller:** the attitude indicator and the 15 warning lamps.

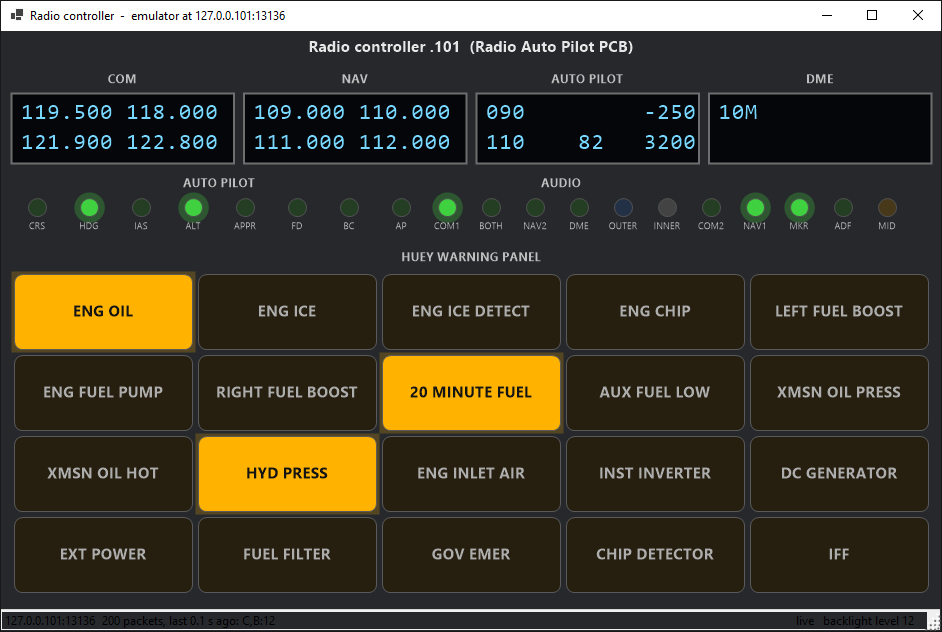
[picture p177: Jet Ranger/Jet Ranger Documentation/DocBuild/screenshots/emulator_radio.png]
Radio controller emulator


**Radio controller:** the COM, NAV, Auto Pilot and DME displays, the 19 panel LEDs and the 20 Huey Warning Panel lamps. The NAV displays keep the sketch's start-up values (NAV1 109.000 and 111.000, NAV2 110.000 and 112.000), because the PC sends only the COM frequencies.

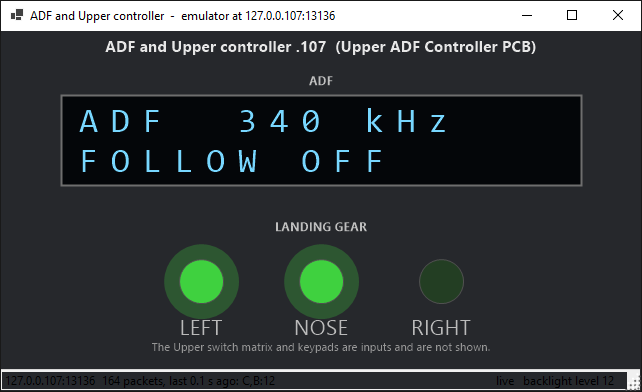
[picture p178: Jet Ranger/Jet Ranger Documentation/DocBuild/screenshots/emulator_adf.png]
ADF and Upper controller emulator


**ADF and Upper controller:** the landing gear lamps and the ADF display. The Upper switches and keypads are inputs and are not shown; use the Radio and Upper controller emulators above for knobs and keys. The panel emulators do not appear in the Health Monitor.

## GPS interface

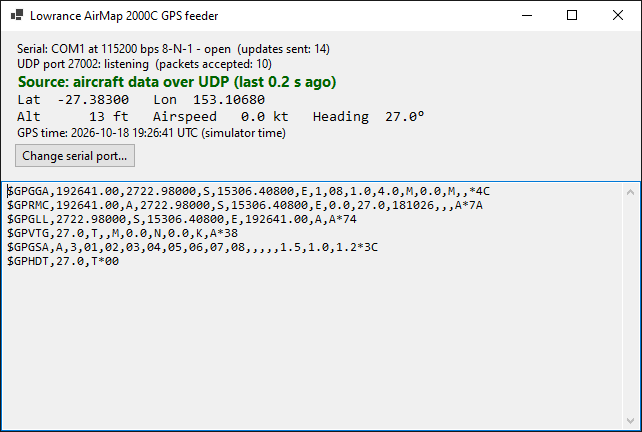
[picture p179: Jet Ranger/Jet Ranger Documentation/DocBuild/screenshots/gps_interface.png]
LowranceAirMapGps


The window shows, from the top: the serial port, its speed and state and how many updates have been sent; the UDP port and the number of packets accepted; the **source** of the position (green *aircraft data over UDP*, orange *default - Brisbane Airport*); the latitude, longitude, altitude, airspeed and heading being sent; the **GPS time** and whether it comes from the simulator or the PC clock; the **Change serial port...** button; and the sentences being sent to the GPS.

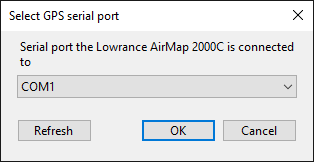
[picture p180: Jet Ranger/Jet Ranger Documentation/DocBuild/screenshots/gps_serial_dialog.png]
The serial port dialog


The first time the program runs, or when the saved port is no longer present, this dialog asks which port the GPS is connected to. **Refresh** rereads the list of ports, **OK** saves the choice and **Cancel** leaves the port unselected (the program still runs, without sending to a GPS). **Change serial port...** opens the same dialog later.

## GPS bench tester

LowranceAirMapGpsBenchTester

- **Send to UDP:** the address and port of the GPS interface (the same PC and port 27002 by default) and a check box to turn the sending on and off.
- **Country, City and Airport:** choose an airport to put the aircraft on the ground there.
- **Latitude, Longitude, Altitude, Speed and Heading:** type a value and press Enter (a value that cannot be read turns the box pink).
- **Date / time (UTC):** the date and time the GPS should show, **PC clock** to use the PC's, and **Send date/time** to include it.
- **Back to the selected airport** returns to the airport chosen above.
- **Eight-way cursor** (right): moves the position by the **Cursor step** in metres; the arrow keys work too. **Point heading in direction of travel** sets the heading to the direction moved.
- **Fly** moves the aircraft along its heading at its speed; **Time x** speeds it up.
- **Bottom:** the number of packets sent and the packet being sent.
