bnepethomas/bne-arduino-flight-simulator-interfaces/Jet Ranger/Jet Ranger Documentation/DocBuild/src/guide/02_network_boards.md

# Network

All devices sit on one wired `172.16.1.x` subnet with fixed addresses; there is no DHCP on the boards.

Who talks to whom

| Device | IP address | MAC | Keep-alive text |
|---|---|---|---|
| Primary PC (simulator, bridge, debug listener, Health Monitor) | 172.16.1.10 | | |
| USB HID board | 172.16.1.11 | DE:AD:BE:EF:FE:ED | `JOYSTICK` |
| Radio controller | 172.16.1.101 | A8:61:0A:9E:83:01 | `COMM_NAV` |
| Servo board | 172.16.1.102 | A8:61:0A:9E:83:02 | `SERVO` |
| Stepper board | 172.16.1.105 | A8:61:0A:67:83:69 | `STEPPER` |
| Dual stepper board | 172.16.1.106 | A8:61:0A:67:83:6A | `DUAL_STEPPER` |
| ADF and Upper controller | 172.16.1.107 | A8:61:0A:67:83:6B | `ADF_PANEL` and `UPPER_INPUT` |

Every live board has its own IP and MAC address. The old Upper controller (172.16.1.103) was merged into the ADF controller on 31 October 2026 and no longer exists; the merged board sends both heartbeat names so the Health Monitor still shows an Upper light. The bridges and the BenchTester still send some packets to .103, which go nowhere. The firmware sends its debug and keep-alive traffic to `172.16.1.10` (`reflectorIP`), so the primary PC must hold that address, or `reflectorIP` must be changed and the sketch uploaded again.

| UDP port | Direction | Purpose |
|---|---|---|
| 13136 | PC to boards | Gauge, lamp and radio data (`D,`) and control (`C,`) packets |
| 27001 | Radio and ADF controllers to PC bridge (FSUIPC and MSFS bridges only) | Standby frequencies, radio swaps, and the Auto Pilot, Audio and ADF panel controls (for example `AP_MASTER`, `GEAR_DOWN`) |
| 27002 | Bridge to the GPS interface (same PC) | Aircraft position, altitude, airspeed, heading and simulator time, every 500 ms |
| 27003 | ADF controller to the PC | ADF knob frequency, radar follow ID, power status, each Upper keypad press and each squawk entered on the ADF keypad (the FSUIPC bridge reads them all, the MSFS bridge reads the ADF frequency) |
| 5010 | DCS to the DCS bridge | The DCS-BIOS export stream (multicast 239.255.50.10, on the PC) |
| 49000 | X-Plane and the X-Plane bridge | Dataref requests to X-Plane and its answers (X-Plane's beacon is multicast 239.255.1.1 port 49707) |
| 4210 | Servo, Radio and ADF and Upper controllers to USB HID board | Switch changes (`index,state`) and keypad keys (`KEY,key,state`) |
| 13137 | Boards to Health Monitor | Keep-alive text every 10 seconds |
| 13138 | Stepper controller to the other controllers | `STARTUPDONE`: tells the Radio, Servo, Dual Stepper and ADF and Upper controllers that start-up is complete, so they end their start-up hold (sent twice, 2 seconds apart) |
| 27000 | Boards to debug listener | Debug messages, each prefixed with the board name |

## Packet format

Data and control packets

A packet can carry any number of pairs, in any order, up to 1000 bytes. Unknown tokens are ignored, so the PC can send only the values that changed. For example `D,PITCH:5,BANK:-10,LOWF:0` sent to the servo board sets 5 degrees pitch, minus 10 degrees bank and turns off Low Fuel.

To test without the simulator, send a packet from a PC on the subnet, for example with PowerShell:

```
$u = New-Object System.Net.Sockets.UdpClient
$b = [Text.Encoding]::ASCII.GetBytes('D,PITCH:5,RLOW:1')
$u.Send($b, $b.Length, '172.16.1.102', 13136)
```

## What a board does

Board life cycle

After start-up and its self-test a gauge board checks UDP 13136 every 5 ms and moves each needle smoothly towards its target. It sends its keep-alive every 10 seconds, with its 5 V rail after the board name (and the ADF controller its 12 V rail as well) for the Health Monitor. If no packet arrives for **30 seconds** every needle returns to zero (the Servo board also switches its lamps off, the Dual Stepper blanks its OLEDs and the Radio blanks its displays); the next packet brings everything back.

Remote reset

The control packet `C,RESET:1` reboots a board about 2 seconds later. The BenchTester's *Reset boards...* button sends it to the boards you tick.

## Unreachable hosts and the fast Ethernet timeout

Every sketch (Radio, Servo, Stepper, Dual Stepper, ADF and Upper and the USB HID board) sends UDP packets to other devices: debug text and keep-alives to the PC, commands from the Radio to the bridge, switch changes from the ADF and Upper controller to the USB HID board, and brightness from the ADF controller to the other panels. Before the Ethernet module can send to an address on the network it has to learn that address's MAC address by an ARP request. If the destination is switched off, unplugged or not yet running (the PC, or another board that is still starting), nobody answers.

The W5500 Ethernet chip then waits and asks again. Its default is a 200 ms timeout with 8 attempts, so one send to a missing device can hold the sketch up for about **1.6 seconds**. The sketch cannot do anything else while it waits: encoders and switches are not scanned, needles do not move, and every debug line sent to a PC that is off would cost another 1.6 seconds.

To stop that, each sketch calls `Ethernet.setRetransmissionTimeout(10)` straight after `Ethernet.begin()`. The timeout becomes **10 ms** and the number of attempts stays at 8, so the worst case for one send to a missing device is about **80 ms**. The panel keeps responding when the PC is off, a bridge is not running, or a board is unplugged, and the boards that are present are not slowed in any way you would notice.

- A missing device is not free: each send to it still costs up to 80 ms, so a sketch that sends many packets to a dead address (for example heavy debug traffic with the PC off) will run a little slower than normal. Switch the PC on, or turn debug traffic down, if a board feels sluggish with no PC.
- 10 ms is far longer than a real device on the cockpit network needs to answer an ARP request, so working devices are not affected. If you ever add a device on a slow or long network link, and packets to it are lost at first, raise the value in that sketch.
- The ADF controller sends its brightness to one board per pass through its loop for the same reason: a switched-off board never holds up the knobs and keypad for more than that one send.

## When the panel loses power

Bus voltage rules

The bridge turns parts of the panel off when the simulated electrics drop: lamps, radar altitude and the backlights below 20 V on the main bus, the Dual Stepper's four OLEDs below 24 V on the main bus, and the Radio's COM and NAV displays below 24 V on the avionics bus (the main bus is used if the aircraft reports the avionics bus as 0).

## Backlight

How the backlight level is decided

The Radio, Servo, Stepper, Dual Stepper and ADF and Upper boards drive their panel backlights from Mega pin D5 through a MOSFET on the PCB (on the Radio these are the Audio, Auto Pilot and COM and NAV panels; its "no data" rule is the same 30 seconds that blanks its displays, restarted by any knob or key; on the ADF and Upper board a switch, key or knob restarts it). Three things decide the level:

- **Main bus power (`BPWR`).** The bridge sends `BPWR:1` while the main bus is 20 V or more and `BPWR:0` below that, which switches the backlight off. Until the first `BPWR` arrives the board leaves the backlight on.
- **Brightness (`C,B:0` to `C,B:15`).** 0 is off and 15 is full. The board remembers the last level. If no brightness command has been sent the backlight uses a default level (PWM 65); once one has been sent, every time power returns the backlight comes back at the **last level you set**, not the default. A level sent while the bus is down is applied when power returns. The start-up hold overrides it: full brightness while the hold lasts, 70 percent when it ends.
- **No data.** After 30 seconds with no UDP packet, including after the board is powered up with no PC sending, the backlight goes off along with the gauges. The next packet turns it back on.

The **BenchTester** has a brightness slider that sends the level to every board except the USB HID board, and *Backlight power ON / OFF* buttons for testing the main bus rule (including the ADF and Upper board). The **ADF controller** can send the level from its brightness pot to the other boards, but the pot is switched off for the moment. The Radio also uses the level for its panel LEDs until it receives a `C,LEDB`, which sets them on their own. The ADF controller also blanks its display and lamps with the Radio's displays.

### Start-up hold

From power-up every controller keeps its backlight **on at full brightness (100 percent)**, and also its displays (OLEDs) and indicator lamps (all lit), until the **13 Stepper controller**, which is the last to finish starting up, tells the others it is done. The Stepper controller sends `STARTUPDONE` to UDP port 13138 of the Radio, Servo, Dual Stepper and ADF and Upper controllers, and sends it a second time 2 seconds later. The hold then ends: the backlights drop to **70 percent and go off**, the displays and lamps follow the normal rules, and the backlight comes back at 70 percent when the bridge reports the main bus is up (`BPWR:1`). If a board misses both announcements (the Stepper controller is off, or the board was reset or powered up later), it ends the hold by itself 180 seconds after its reset. So after power-up the whole cockpit stays lit at full brightness for a short time, and then goes dark until a bridge is running.

# Arduino servo controller

The servo board is an Arduino Mega 2560 with an Ethernet module, on the Jet Ranger Front Panel Servo PCB at 172.16.1.102. It drives the attitude indicator's two servos, switches the 15 caution and warning lamps and reads three front-panel switches. It runs `JET_RANGER_SERVO_CONTROLLER.ino`. The other gauges that were once servo-driven now run on the two stepper boards.

Servo board

## Physical connections

The Servo controller drives the attitude indicator servos, the annunciator lamps and the panel backlights, and reads three front panel switches. Only two of the board's servo headers are used.

Servo controller connections

## Uploading the firmware

1. Open the sketch in the Arduino IDE and select *Board: Arduino Mega or Mega 2560* (or use `arduino-cli`, see Flashing a board).
2. Install the libraries it uses: Ethernet (with SPI), Servo, Ewma (jonnieZG) and DCS-BIOS.
3. Upload, then watch the start-up self-test: both servos sweep and all 15 lamps light.

## Servos

| Instrument | Mega pin | UDP token | Range |
|---|---|---|---|
| Attitude bank (roll) | 27 | `BANK` | -90 to +90 degrees |
| Attitude pitch | 26 | `PITCH` | -30 to +30 degrees |

Both tokens take attitude in degrees, with one decimal place allowed (`D,PITCH:4.5,BANK:-12`). The board turns degrees into a servo position with the tables in Calibration. `BANKRAW` and `PITCHRAW` take a raw servo position (0 to 180) and skip the tables. The PCB still has 16 servo headers from the earlier design; only pins 26 and 27 are used.

## Other pins

| Function | Pin | Behaviour |
|---|---|---|
| Green status LED | 14 | Flashes alternately with red every 200 ms while running |
| Red status LED | 15 | Fast flash during the 3 second Ethernet start-up, then alternates with green |
| Ethernet module reset | 53 | Pulsed low for 2 ms at power-up |
| Backlight | 5 | PWM to the backlight MOSFET (`BACKLIGHT_PWM`); see Backlight |
| Lamps | A1 to A15 | Digital outputs, HIGH = lit (see Reference) |
| TOT clear switch | 43 | Switch to GND, debounced 30 ms; each change goes to the USB HID board as Joystick 1 button 9 (index 8) |
| Warning mute switch | 47 | The same, Joystick 1 button 8 (index 7) |
| Fuel valve switch | 48 | The same, Joystick 1 button 10 (index 9) |

The 15 lamps and their pins

## What happens at power-up

1. All 15 lamps switch on as a lamp test.
2. The Ethernet module is reset and starts at 172.16.1.102; the red LED flashes for 3 seconds.
3. *Ethernet Started* goes to the debug listener.
4. Pitch, then bank, sweeps from minimum to maximum and back (about 2 seconds each) and parks at its calibrated level position.
5. All lamps switch off.
6. The starting state of the three switches is sent to the USB HID board, *Setup Complete* is logged and the 30 second watchdog starts.

## Normal running

- Every 5 ms the board checks UDP 13136 and stores each value as a new target; each servo steps one position towards its target, so the attitude indicator moves smoothly.
- A servo that has not moved for 1 second is detached to stop buzz; the next movement re-attaches it.
- Lamps change as soon as a 0 or 1 arrives.
- `C,SWINGPITCH:1` or `C,SWINGBANK:1` re-runs one sweep on demand (the board pauses for about 2 seconds).

# Stepper controller (13 Stepper board)

A second Arduino Mega 2560, on the Jet Ranger 13 Stepper PCB at 172.16.1.105, drives X27-style stepper gauges directly from its pins. Unlike the servo board it takes real units and converts them to needle steps with calibration tables in `JET_RANGER_STEPPER_CONTROLLER.ino`.

Stepper board

| Gauge | Token | Mega pins | Units | Calibration |
|---|---|---|---|---|
| Airspeed | `IAS` | 12, 13, 22, 23 | knots 0 to 140 | 10-point table |
| Vertical speed | `VSI` | 7, 8, 9, 11 | ft/min, plus and minus 1750 | 11-point table |
| Radar altitude | `AGL` | 32 to 35 | feet 0 to 2500 | 11-point table |
| Torque | `TQ` | 36 to 39 | percent 0 to 120 | 2-point table |
| Gas producer | `N1` | 40 to 43 | percent 0 to 103 | 3-point table |
| Turbine out temperature | `ITT` | A11 to A14 | degrees C 100 to 900 | 7-point table |
| Fuel quantity | `FUEL` | 2, 3, 4, 6 | US gallons 0 to 75 | 2-point table |

Every token has a raw twin with `RAW` on the end (for example `IASRAW:300`). It moves the needle by raw steps and skips the table, which is how new calibration points are measured on the bench. The board also has four oil and transmission steppers with placeholder scales; those gauges are driven from the Dual Stepper, so wire each physical gauge to one board only. Pins 24 to 31 are free.

## Physical connections

Each gauge has its own six-pin cable from the Stepper board to the gauge's X27 stepper. The coil pins are the Mega pins the sketch drives.

Stepper controller connections

## Behaviour

- **Power-up:** status LEDs flash, Ethernet starts, backlighting ramps up, then each gauge does a self-test sweep in turn: fuel, torque, turbine out, gas producer, VSI, airspeed, radar altitude. Each sweep has its own on/off switch (`SwingFA`, `SwingTQ` and so on) near the top of the sketch.
- **Running:** every 5 ms the board checks UDP 13136 and moves each needle towards its target with smooth acceleration.
- **No-data watchdog:** after 30 seconds without a packet every needle returns to its zero.
- **Zero trims:** each gauge has a `...ZeroOffset` value to nudge its true zero without touching the table.
- **Keep-alive:** `STEPPER` to the Health Monitor every 10 seconds; debug text goes to UDP 27000.

## Testing a gauge on demand

Send a control packet to re-run one gauge's sweep without rebooting, for example `C,SWINGTQ:1`.

| Command | Gauge |
|---|---|
| `SWINGFUEL` | Fuel quantity |
| `SWINGTQ` | Torque |
| `SWINGITT` | Turbine out temperature |
| `SWINGN1` | Gas producer |
| `SWINGVSI` | Vertical speed |
| `SWINGIAS` | Airspeed |
| `SWINGAGL` | Radar altitude |

The **StepperVSITester** app can send every token and raw token to this board without the simulator. The **BenchTester** app sends these commands, and the Dual Stepper and servo sweeps, one at a time or all in a fixed order:

Swing ALL sequence

It lights the OLEDs and the lamps during the run and sends a keep-alive so the boards' 30 second watchdogs do not fire. *Reset boards...* reboots the boards you tick (Radio, Servo, Upper (the retired .103 address), Stepper, Dual Stepper, USB HID) by sending each one `C,RESET:1` (the ADF and Upper board .107 is not in the list yet); each restarts about 2 seconds later and repeats its power-up test.

## Known issues

- The backlight PWM was once on pin 8, which the PCB routes to VSI coil B. It is now pin 5, matching the PCB's `BACKLIGHT_PWM` net, in both stepper sketches, and it follows `BPWR`, `C,B:n` and the 30 second no-data watchdog (see Backlight).
- Pin 32 is also claimed by an unused roll stepper in the code.
- The oil, transmission and placeholder gauges use a shared linear scale, not bench-measured tables.

# OLED dual stepper controller

A third Mega, on the Jet Ranger OLED Dual Stepper PCB at 172.16.1.106, drives stepper gauges plus four small OLED displays. It runs `JET_RANGER_OLED_DUAL_STEPPER_CONTROLLER.ino` and, like the 13 Stepper board, takes real units.

Dual stepper board

| Gauge | Token | Mega pins | Units | Calibration |
|---|---|---|---|---|
| Engine speed (N2) | `RPME` | 24 to 27 | percent, one decimal | 4-point table |
| Rotor speed | `RPMR` | 28 to 31 | percent, one decimal | 4-point table |
| Altimeter | `ALT` | 40 to 43, zero sensor A15 | feet | 720 steps per 1000 ft |
| Fuel load | `FUELLOAD` | 32 to 35 | psi | 2-point table (0 to 30 psi) |
| Electrical load | `ELECTRICALLOAD` | 36 to 39 | percent | 2-point table |
| Engine oil temperature | `OILT` | 48, A0 to A2 | degrees C | 4-point table |
| Engine oil pressure | `OILP` | 44 to 47 | psi | 4-point table |
| Transmission oil temperature | `XMSNT` | A3 to A6 | degrees C | 4-point table |
| Transmission oil pressure | `XMSNP` | A7 to A10 | psi | 5-point table |

Turbine out temperature (`ITT`) and fuel quantity (`FUEL`) are also accepted, as on the 13 Stepper board. Wire each physical gauge to one board only; the matching channel on the other board then simply has nothing connected. Each token also has a `RAW` twin for bench work. `IAS` is not handled here; the FSUIPC and MSFS bridges send airspeed to the 13 Stepper board with one decimal place so the needle moves smoothly.

## Physical connections

The Dual Stepper board drives four dual instruments and the altimeter, and four OLEDs on its I2C multiplexer. Which dual instrument uses which socket follows the names printed on the PCB.

Dual Stepper controller connections

## OLED displays

The four 128 by 32 SSD1306 OLEDs share the Mega's I2C pins (20 SDA, 21 SCL) through a TCA9548A multiplexer at address 0x70. The firmware pulses the mux reset on pin 16 at start-up.

| Display | Mux channel | UDP token | Shows |
|---|---|---|---|
| Barometric setting | 1 | none yet | `2992` at boot; not updated |
| Altimeter digits | 2 | `ALT` | Rolling-drum altitude, raw MSL (barometric correction off) |
| Clock | 3 | `ZULU` | Zulu time from HHMM, for example `ZULU:1430` |
| Temperature | 4 | `TEMP` | Text as sent, for example `TEMP:25C` |

Send `C,OLEDTEST:1` to light all four displays solid and `C,OLEDTEST:0` to restore them. When the main bus is below 24 V the bridge sends `PWR:0` and all four displays go blank; `PWR:1` turns them back on and they repaint within about a second. The altimeter needle keeps following altitude. The lamp test still lights all four displays whatever `PWR` says. `C,OLEDB:0` to `C,OLEDB:15` sets the brightness of the four displays on their own (0 dimmest, 15 full), without changing the backlight; the BenchTester has an *OLED brightness* slider for it.

## Behaviour

- **Power-up:** OLEDs start first, then each gauge sweeps in turn: engine oil pressure, engine oil temperature, transmission pressure, transmission temperature, electrical load, fuel load, engine RPM, rotor RPM, altimeter. The altimeter seeks its zero sensor before sweeping. Start-up takes about 65 seconds.
- **No-data watchdog:** after 30 seconds without a packet the needles return to zero and all OLEDs blank.
- **On-demand sweeps:** `C,SWINGOILP:1`, `SWINGOILT`, `SWINGXMSNP`, `SWINGXMSNT`, `SWINGELECTRICALLOAD`, `SWINGFUELLOAD`, `SWINGRPME`, `SWINGRPMR`, `SWINGALT`. Each blocks the board for 5 to 7 seconds.
- **Keep-alive:** `DUAL_STEPPER` to the Health Monitor every 10 seconds, so it shows separately from the 13 Stepper board.

## Known issues

- RAM use is 75 percent or more; avoid adding more OLEDs or string-heavy code.
- Engine and rotor RPM tables assume 0 percent is 0 steps; `RSoffset` is not yet measured.
- The altimeter zero seek travels up to 10,080 steps (about 14 turns) before giving up.
