bnepethomas/bne-arduino-flight-simulator-interfaces/Jet Ranger/Jet Ranger Documentation/DocBuild/src/guide/03b_adf.md

# ADF and Upper controller

The ADF panel is another Mega, at 172.16.1.107, running `JET_RANGER_ADF_CONTROLLER.ino` on the Jet Ranger Upper ADF Controller PCB (revision 1.0), the combined ADF and Upper board. Since 31 October 2026 it also does the job of the old Upper controller (172.16.1.103): it scans the **overhead switch matrix** and the **Upper keypad** and sends them to the USB HID board (see Upper panel switches and keypad below), so there is no separate Upper board any more. It tunes the ADF with two knobs, takes the ID of an aircraft to follow on the radar from a keypad, sends its landing gear, flaps, speed brakes, brakes, anti-ice, hyd boost and caution dim switches to the simulator, lights the three landing gear lamps, blanks its display, lamps and backlight with the other panels, and watches the 12 V and 5 V supplies. The PCB has a brightness pot, but it is **switched off for the moment**. The sketch is flashed (COM26); the 12 V reading, the landing gear lamps and the ADF keypad have been checked on the bench, but the Upper matrix and keypad, the switches at their new pins and the blanking and backlight rules have not.

ADF panel

## Physical connections

The combined board connects to the ADF panel, the lower panel switches, the Upper panel (matrix rows, matrix columns, keypad and brightness pot) and the two front switches.

ADF and Upper controller connections

## Using the panel

| Control | What it does |
|---|---|
| Major knob | Changes the ADF frequency by 100 kHz per click |
| Minor knob | Changes it by 1 kHz per click (faster when you turn it quickly). The range is 190 to 1799 kHz |
| Keypad 0 to 9 | Types the ID of the aircraft to follow (up to 8 digits) |
| Keypad `#` | Sends the ID |
| Keypad `*` | Deletes the last digit; on an empty entry it stops following |
| Landing gear, flaps and speed brakes switches | Set the simulator to match the switch position (see Panel switches) |
| Brakes button | Toggles the parking brake |
| Anti-ice, hyd boost and caution dim switches | Joystick 4 buttons 17 to 19; anti-ice also sets the simulator's anti-ice (see Panel switches) |
| Brightness pot | Not used for the moment: the panel backlight stays at its default and no brightness is sent to the other panels |

The OLED shows the frequency on the first line (`ADF  340 kHz`) and the ID on the second: `ID: 1234_` while you type, `FOLLOW 1234` once it is sent, or `FOLLOW OFF`. An entry you leave unfinished for 20 seconds is dropped.

**Brightness pot.** The pot on the PCB (A0) can set the backlight of this panel and of the Radio, Servo, Stepper and Dual Stepper panels, but `USE_BRIGHTNESS_POT` in the sketch is 0, so it does nothing: this panel's backlight stays at its default (level 4) until a `C,B` command sets it, and the other panels follow the BenchTester slider or their own defaults. Set it to 1 and reflash to bring the pot back.

## Inputs and outputs

| Function | Mega pins | Notes |
|---|---|---|
| ADF major knob | D6, D7 | Encoder A, B |
| ADF minor knob | D8, D9 | Encoder A, B |
| ADF keypad | scan rows A7, A6, A5, A4, scan columns A3, A2, A1 | 4 by 3; the lines arrive in reverse order on this PCB; see the key table below |
| Upper switch matrix | rows D22 to D30, columns D38 to D45 | 9 by 8, 72 switches (see Upper panel switches and keypad) |
| Upper keypad | rows A10, A12, A14, A15, columns A9, A11, A13 | 4 by 3 |
| Panel brightness pot | A0 | Wiper, 5 V to ground; not read while the pot is switched off |
| 12 V monitor | A8 | 47 k and 10 k divider with 0.1 uF |
| 5 V monitor | AREF / AVcc | Measured against the internal 1.1 V reference; the AREF pin is left at its default |
| Backlight | D5 | IRF540N MOSFET: full brightness during the start-up hold, then 70 percent, then `C,B`; off with `BPWR:0`, the no-data timeout or no data (see Panel blanking and backlight) |
| OLED | I2C D20, D21 (0x3C) | 2 lines of 16 characters |
| Status LEDs | D14 green, D15 red | Red flashes while Ethernet starts |
| Landing gear lamps | D2, D3, D4 | Nose, left, right: lit by data packets (see below) |
| Landing gear, flaps, speed brakes and brakes switches | D31 to D34 | Switches to ground; see Panel switches |
| Hyd boost, anti-ice and caution dim switches | D35, D36, D37 | Switches to ground (connector J20); see Panel switches |
| Ethernet module | SPI 50 to 52, reset 53 | |

**Keypad keys.** The ADF keypad's seven lines come out of pins 18 to 24 of the ADF panel connector (J5) to A1 to A7 (connector J41). On this PCB they arrive in reverse order, so the sketch scans A7, A6, A5 and A4 as the rows and A3, A2 and A1 as the columns (the old ADF board used D22 to D28). With the first guess at the pins keys 1, 2 and 3 did nothing and most others reported as the wrong key; after the swap every key reports correctly. The key labels in the sketch were set by pressing every key and moving each label to where it was reported:

| Scan row | Column 0 (A3) | Column 1 (A2) | Column 2 (A1) |
|---|---|---|---|
| 0 (A7) | 6 | 4 | 5 |
| 1 (A6) | 9 | 7 | 8 |
| 2 (A5) | # | * | 0 |
| 3 (A4) | 3 | 1 | 2 |

If the keys ever need checking again, send `C,MATRIX:1` while holding a key: the debug listener shows which row and column changes.

## Panel switches and joystick buttons

The seven switches are read when they change (30 ms debounce, to ground when on). Each change is sent two ways, like the Auto Pilot and Audio panels:

| Switch | Joystick button (index) | What goes to the bridge (UDP 27001) |
|---|---|---|
| Landing gear (toggle) | Joystick 4, button 9 (104) | The position: `GEAR_SET:1` when closed (gear down), `GEAR_SET:0` when open |
| Flaps (toggle) | Joystick 4, button 10 (105) | `FLAPS_SET:1` (flaps fully down) or `FLAPS_SET:0` |
| Speed brakes (toggle) | Joystick 4, button 11 (106) | `SPOILERS_SET:1` (fully out) or `SPOILERS_SET:0` |
| Brakes (push button) | Joystick 4, button 12 (107) | `PARKING_BRAKES` when pressed |
| Anti-ice (toggle) | Joystick 4, button 17 (112) | `ANTI_ICE_SET:1` or `ANTI_ICE_SET:0` |
| Hyd boost (toggle) | Joystick 4, button 18 (113) | none |
| Caution dim (toggle) | Joystick 4, button 19 (114) | none |
| ADF major knob (clockwise, anticlockwise) | Joystick 4, buttons 13, 14 (108, 109) | none: the knob tunes the ADF frequency |
| ADF minor knob (clockwise, anticlockwise) | Joystick 4, buttons 15, 16 (110, 111) | none |

The gear, flaps, speed brakes and anti-ice toggle switches send their **position as a value** (not an event the simulator could toggle), every time they change and again **every 5 seconds**, so the simulator always follows the switches. That includes the position they were in at power-up: about 5 seconds after the panel is switched on, the aircraft's gear, flaps and speed brakes move to match the switches. For 1.5 seconds after power-up the switches are only read. If a switch works the wrong way round in the simulator, swap its 1 and 0 in the sketch (`adfSwitches[]`). A knob click is a short joystick press.

**Anti-ice, hyd boost and caution dim on the Dodo.** The Dodo Jet Ranger has its own events for these switches: `ANTI_ICE_SWITCH_SET`, `HYDRAULICS_SWITCH_SET` (hyd boost) and `CAUTION_LIGHT_SWITCH_SET` (caution lights bright or dim), each taking 1 or 0. In FSUIPC's Buttons + Switches page, bind Joystick 4 buttons 17, 18 and 19 to them (the switch pins are D36 anti-ice, D35 hyd boost and D37 caution dim), with 1 on press and 0 on release (and turn on the Dodo's "Sync controls on load" option). The simulator's own controls for these are toggles, so the bridges have no reliable command for hyd boost and caution dim, and the Dodo may ignore the bridge's `ANTI_ICE_SET`: use the FSUIPC binding **or** the bridge command for anti-ice, not both.

## Upper panel switches and keypad

The overhead switch matrix and the numeric keypad of the old Upper controller are scanned by this board. Each of the 72 matrix switches (9 rows by 8 columns) is sent to the USB HID board as a joystick button, numbered `row x 11 + column` (0 to 95) as before, so the FSUIPC and MSFS button assignments and the switch table in the Joystick section do not change. The matrix is smaller than the old board's 16 by 11 (176 positions). The Upper keypad types keys 0 to 9, `*` and `#` on the HID board's keyboard. The Warning Mute and TOT Test connectors on the PCB are part of the matrix (indexes 88 and 89), nothing is assigned to them yet. A switch that is closed when the board starts is reported straight away. Everything on the panel counts as input for the 30 second no-data timeout. The old Upper board's backlight is this board's backlight.

## Landing gear lamps

The three lamps on the ADF panel (nose, left and right) are lit by a data packet to the ADF controller on UDP 13136: `D,LDGN:1,LDGL:1,LDGR:0` (1 = lit, 0 = off). The **BenchTester** has a toggle for each lamp and *All ON* and *All OFF* buttons (see Program windows). The simulator bridges do not send them yet, so for now they are a bench test. They go out with the rest of the panel and come back as last set. Their brightness is set by `C,GEARB:0` to `C,GEARB:15` (0 never lit, 15 full, the default), separate from the backlight; the BenchTester's landing gear group has a slider for it.

## Power status

Five seconds after start-up, and then every **30 seconds**, the board sends the two rail voltages to the PC (UDP 27003). They are not sent to the debug listener (UDP 27000):

`POWER,V12:12.41,V5:5.02,STATUS:OK`

`STATUS` is `OK`, or the rails that are out of range: `5V_LOW` (below 4.75 V), `5V_HIGH` (above 5.25 V), `12V_LOW` (below 10.8 V) or `12V_HIGH` (above 15.0 V). Send `C,POWER:1` to get a reading at once. The first time you run the board, compare the readings with a meter and trim `V12_CAL` and `V5_CAL` at the top of the sketch. The same two readings are in the heartbeat the board sends every 10 seconds (`ADF_PANEL V5:5.03 V12:12.41 FW:1.0.3`, and again as `UPPER_INPUT` so the Health Monitor's Upper light stays green), and the **Health Monitor** shows them in its voltage table: this board is the only one with a 12 V reading. The 12 V divider is on A8 on this PCB (it was on A15 on the old ADF board, and a sketch reading A15 reported 5.33 V with 12.3 V on the board).

## Messages to the PC (UDP 27003)

| Message | Meaning |
|---|---|
| `ADF_FREQ:830` | The ADF frequency in kHz, sent 250 ms after the knobs stop |
| `RADAR_FOLLOW_ID:4521` | The aircraft ID typed on the keypad; `RADAR_FOLLOW_ID:0` means stop following |
| `POWER,V12:12.41,V5:5.02,STATUS:OK` | Power status, every 30 seconds |

These use port 27003, not 27001, because the FSUIPC and MSFS bridges treat anything they do not recognise on 27001 as a COM1 standby frequency. (The panel switch commands above do go to 27001: the bridges recognise those names.) The FSUIPC bridge reads port 27003 (the knob frequency, the Upper keypad and the squawk) and the MSFS bridge reads the knob frequency (see With the bridges); no bridge uses the radar follow ID yet.

## Control packets

The board acts on control packets on UDP 13136: `C,RESET:1` reboots it, `C,MATRIX:1` prints the raw ADF keypad readings to the debug listener, `C,POWER:1` sends a power status, `C,B:0` to `C,B:15` sets the backlight brightness (while the pot is switched off), `C,KEEPALIVE:1` counts as data and `C,DISPLAY:0` / `C,DISPLAY:1` (sent by the Radio controller) blank and restore the panel. Of the data packets it uses the three landing gear lamp tokens and `BPWR`.

## With the bridges

When the **FSUIPC bridge** (Prepar3D and FSX) or the **MSFS bridge** is running:

- **The ADF frequency follows the simulator.** The display shows the simulator's ADF frequency. Turning the knobs changes the display at once, and a moment after you stop the bridge sets that frequency in the simulator. (The MSFS bridge's version of this has not been tested yet: check the line *Last ADF knob frequency* in its window.)
- **The Upper keypad.** In Prepar3D, **`*` toggles the ATC menu** (and no longer types an asterisk). Every other key is typed as before.
- **The ADF keypad sets the squawk** (Prepar3D and FSX, with the FSUIPC bridge): type four digits from 0 to 7 and press `#`; `*` deletes a digit. The display's second line shows `SQUAWK: 12_` while you type and then `SQUAWK 3374`. The radar follow ID is not used then.

Without a bridge the ADF keypad is the radar follow ID keypad and the Upper keypad types its keys, as described above.

## Start-up hold

From power-up the backlight (full brightness), the OLED and the three landing gear lamps stay on until the Stepper controller announces that start-up is complete (see the Start-up hold in the Network chapter), or 180 seconds after reset. Then the backlight drops to 70 percent and goes off, and the rest follow the normal rules below.

## Panel blanking and backlight

The panel follows the other boards' rules:

- **With the Radio.** When the Radio controller blanks its displays (no avionics power, or no data or input for 30 seconds) it tells the ADF controller, which clears its OLED and puts the landing gear lamps out. They come back when the Radio's displays do.
- **Main bus.** The bridges send `BPWR` to the ADF controller like the other boards; `BPWR:0` switches the backlight off and `BPWR:1` brings it back.
- **Brightness.** `C,B:0` to `C,B:15` sets the backlight (the BenchTester's backlight slider sends it); after the start-up hold the level is 70 percent until a `C,B` sets another.
- **No data.** 30 seconds with no data packet from the bridge and no knob, key or switch use blanks the OLED, the lamps and the backlight until something arrives, so the panel goes dark if the PC is not feeding it.

## Checking the panel for the first time

1. Flash the board (see COM ports and flashing), then watch the debug listener for `Jet Ranger ADF: Setup Complete`.
2. Press each ADF keypad key and check the OLED shows the key you pressed (`C,MATRIX:1` shows the raw readings if not). Operate a few Upper switches and keys and watch the debug listener for `Front Input - <index>:<state>` and `Upper key pressed: <key>`.
3. Turn each knob. If it tunes the wrong way, swap its two pins in the `RotaryEncoder` lines.
4. Light the three landing gear lamps from the BenchTester.
5. Check the OLED. The sketch drives the same kind of character OLED as the Radio controller; a graphics SSD1306 needs different code.
6. Compare the readings with a meter (the Health Monitor's voltage table shows them, or watch port 27003) and trim `V12_CAL` and `V5_CAL`.
