bnepethomas/bne-arduino-flight-simulator-interfaces/Jet Ranger/Jet Ranger Documentation/DocBuild/src/master/03_radio.md

# Radio controller (172.16.1.101)

`JET_RANGER_RADIO_CONTROLLER` runs on an Arduino Mega 2560 with a W5500 Ethernet module. It shows the COM and NAV frequencies on two character OLEDs, reads eight rotary encoders (COM1, COM2, NAV1 and NAV2, each with a major and a minor knob) and a 4 by 5 button matrix, and keeps the radio panel in step with the simulator. It also serves the **Auto Pilot and Audio panels**: it reads their switches and the Auto Pilot's five knobs (sent as joystick buttons and as simulator controls) and drives their 19 LEDs through a MAX7219. The same MAX7219 also drives the 20 caution LEDs of the **Huey Warning Panel**, whose three switches the sketch reads too (that panel is wired by hand at the moment; see Huey Warning Panel switches and LEDs).

Radio controller blocks

## Physical connections

The Radio controller board connects to its panels through four panel cables, and to the network, the USB hub and the power supplies. Each connector reference is the one printed on the Jet Ranger Radio Auto Pilot PCB.

Radio controller connections

## Program flow

1. **Setup:** reset the W5500 through pin 53, bring up Ethernet and open the UDP sockets, flash the red LED for 3 seconds while the link settles, send an "Ethernet Started" debug line, scan the I2C bus (results to the debug monitor, see Diagnostics), start the COM and NAV OLEDs through the TCA9548A I2C multiplexer, start the DME display (the Audio panel's OLED) with the no-data text `DME --- NM` and `--- KT -- MIN`, start the eight COM and NAV encoders (with acceleration), the five Auto Pilot knobs and the matrix scanner.
2. **Main loop:**
   - toggle the green and red status LEDs every 200 ms;
   - every 10 seconds send the `COMM_NAV` heartbeat;
   - poll the eight encoders; a change recalculates the standby frequency, sends it to the PC and redraws the OLEDs;
   - scan the matrix and act on key presses (below);
   - read any packet on port 13136 and update the active and standby frequencies, the main bus voltage and the power state.

Where each input and output goes

## Pin usage

| Pin | Function |
|---|---|
| 5 | `BACKLIGHT_PWM`: the AUDIO, AUTOPILOT and COMM_NAV panel backlights (IRF540N MOSFET) |
| 14 | Green status LED |
| 15 | Red status LED (flashes while the Ethernet link comes up) |
| 53 | W5500 manual reset |
| 50 to 52 (and 10) | SPI to the W5500 |
| SDA, SCL | TCA9548A mux (0x70): port 0 NAV OLED, port 1 COM OLED, both at 0x3C |
| 31, 30 | COM1 major encoder (A, B) |
| 33, 32 | COM1 minor encoder |
| 34, 35 | COM2 major encoder |
| 37, 36 | COM2 minor encoder |
| 38, 39 | NAV1 major encoder |
| 41, 40 | NAV1 minor encoder |
| 42, 43 | NAV2 major encoder |
| 45, 44 | NAV2 minor encoder |
| 22 to 25 | Matrix rows (`ROW0` to `ROW3`) |
| 26, 27, 28, 29, 48 | Matrix columns (`COL0` COM and NAV panel, `COL1` and `COL2` Auto Pilot panel, `COL3` and `COL4` Audio panel) |
| 11, 12 | Auto Pilot CRS knob (`CRS_A`, `CRS_B`) |
| A4, A5 | Auto Pilot ALT knob (`ALT_A`, `ALT_B`) |
| 46, 47 | Auto Pilot VS knob (`VS_A`, `VS_B`) |
| 7, 6 | Auto Pilot IAS knob (`IAS_A`, `IAS_B`) |
| 8, 9 | Auto Pilot HDG knob (`HDG_A`, `HDG_B`) |
| A15, A14, A13 | MAX7219 `DIN`, `CLK` and `LOAD` (the panel LEDs) |
| A8, A9, A10 | Huey Warning Panel switches: brightness / dim, test and reset (to ground when on) |

## Data from the PC (UDP 13136)

| Token | Meaning | Example |
|---|---|---|
| `C1A`, `C1S` | COM1 active and standby frequency | `C1A:119.500` |
| `C2A`, `C2S` | COM2 active and standby frequency | `C2S:121.900` |
| `MAINBUS` | Main bus voltage | `MAINBUS:27.8` |
| `NAVCOM1` | Radio power: 1 = on, 0 = COM and NAV displays blank and the panel LEDs off | `NAVCOM1:1` |
| `BPWR` | Backlight power: 1 = main bus 20 V or more, 0 = backlight off (the radio assumes 1 until the first one arrives) | `BPWR:1` |
| `LED_xxx` | One of the 19 Auto Pilot and Audio panel LEDs (see below): 1 = on, 0 = off | `LED_HDG:1` |
| `LED_H_xxx` | One of the 20 Huey Warning Panel LEDs (see below): 1 = on, 0 = off. Sent by the DCS and X-Plane bridges, not by the FSUIPC and MSFS bridges | `LED_H_ENG_OIL:1` |
| `APHDG`, `APCRS`, `APIAS`, `APVS`, `APALT` | The five values on the Auto Pilot display (see below), up to 5 characters each | `APHDG:090` |
| `N1A`, `N2A` | The NAV1 and NAV2 **active** frequencies, MHz (the standby frequencies stay local to the radio); not applied for 500 ms after a knob or switch | `N1A:113.70` |
| `DMEDIST`, `DMESPD`, `DMEID` | The DME readout (NAV1) for the DME display: distance in nautical miles (-1 = no DME), speed in knots (-1 = none) and the station identifier (up to 4 letters or digits, `-` = none) | `DMEDIST:12.3` |
| `C,B:n` | Brightness 0 to 15 (control packet): the panel backlight level (0 off, 15 full) and the MAX7219 intensity of the panel LEDs | `C,B:5` |
| `C,LEDTEST:n` | Control packet: 1 lights all 39 panel LEDs (Auto Pilot, Audio and Huey), 0 returns them to the simulator's state | `C,LEDTEST:1` |
| `C,LEDB:n` | Control packet: the MAX7219 brightness (the Auto Pilot, Audio and Huey LEDs) on its own, 0 off, 1 to 15; after the first one `C,B` sets only the backlight until the board is reset | `C,LEDB:8` |

The bridges send COM frequencies with two decimals; the radio pads every frequency to `xxx.xxx` (7 characters) so that the 16-column line (7 + 2 + 7) never slides COM2 or NAV2 behind the faceplate. The PC does not send NAV frequencies back.

## Commands to the PC (UDP 27001)

Turning a knob changes the standby frequency on the OLED and sends it to the PC. COM1 is sent as the bare number (for example `118.295`); the others carry the radio's name: `COM2_STANDBY:118.295`, `NAV1_STANDBY:108.000`, `NAV2_STANDBY:108.000`. Nothing is sent during the first 1.5 seconds after power-up, so the knobs' start positions do not change the simulator.

The four frequency-swap switches are on the Jet Ranger COM and NAV PCB in a diode matrix that shares column 0 (D26); the rows are D22 to D25.

| Switch | Matrix (row, col) | Action |
|---|---|---|
| NAV1 FREQ (SW6) | 0, 0 | Swaps NAV1 active and standby on the NAV OLED at once (the PC sends no NAV frequencies back) and sends `NAV1_RADIO_SWAP` |
| NAV2 FREQ (SW7) | 1, 0 | The same for NAV2, sends `NAV2_RADIO_SWAP` |
| COMM1 (SW4) | 2, 0 | Sends `COM1_RADIO_SWAP`; the display changes when the simulator returns the swapped frequencies |
| COMM2 (SW5) | 3, 0 | Sends `COM2_RADIO_SWAP`, then `AVIONICS_MASTER_SET` |

Keys in columns 1 to 4 are the Auto Pilot and Audio panel switches (next section); any other key is only logged to the debug listener.

## Auto Pilot and Audio panel switches and knobs

The Jet Ranger Auto Pilot Panel and Audio Panel PCBs plug into the Radio Auto Pilot controller. Each has eight switches in a diode matrix (row to the switch, diode to the column), and the Auto Pilot panel also has five rotary encoders wired straight to the Mega. Every switch and knob is sent **two ways**:

1. as a **joystick button** on the USB HID board (UDP `172.16.1.11:4210`, `index,state`), in the buttons nothing else uses: **Joystick 3** (indexes 64 to 95) for the Auto Pilot panel and **Joystick 4** (96 to 127) for the Audio and ADF panels. A switch holds its button down while it is pressed. A knob click is sent as a 40 ms press (the `HID_PULSE_MS` release goes out from the main loop), clockwise on one button and anticlockwise on the next;
2. as a **command to the PC bridge** (UDP 27001), the name of the simulator control, which the FSUIPC and MSFS bridges recognise (see their chapters). A switch sends its command when pressed; a knob sends one command for each click, with a `:N` repeat count when it is turned quickly (`HEADING_BUG_INC:5`).

Nothing is sent during the first 1.5 seconds after power-up (the quiet period). Windows numbers joystick buttons from 1, so index 64 is Joystick 3 button 1. These indexes correspond to Upper matrix positions (now on the ADF and Upper controller) that are wired but have no switch on them (the Upper's assigned switches are all below index 40).

| Panel | Control | Matrix or pin | Joystick button (index) | Command to the bridge (UDP 27001) |
|---|---|---|---|---|
| Auto Pilot | AP ENGAGE | row 0, col 1 | Joystick 3, button 1 (64) | `AP_MASTER` |
| Auto Pilot | HDG | row 1, col 1 | Joystick 3, button 2 (65) | `AP_HDG_HOLD` |
| Auto Pilot | CRS | row 2, col 1 | Joystick 3, button 3 (66) | `AP_NAV1_HOLD` |
| Auto Pilot | ALT | row 3, col 1 | Joystick 3, button 4 (67) | `AP_ALT_HOLD` |
| Auto Pilot | APPR | row 0, col 2 | Joystick 3, button 5 (68) | `AP_APR_HOLD` |
| Auto Pilot | FD | row 1, col 2 | Joystick 3, button 6 (69) | `TOGGLE_FLIGHT_DIRECTOR` |
| Auto Pilot | BC | row 2, col 2 | Joystick 3, button 7 (70) | `AP_BC_HOLD` |
| Auto Pilot | IAS | row 3, col 2 | Joystick 3, button 8 (71) | `AP_PANEL_SPEED_HOLD` |
| Auto Pilot | CRS knob clockwise, anticlockwise | D11, D12 | Joystick 3, buttons 9, 10 (72, 73) | `VOR1_OBI_INC`, `VOR1_OBI_DEC` |
| Auto Pilot | ALT knob | A4, A5 | Joystick 3, buttons 11, 12 (74, 75) | `AP_ALT_VAR_INC`, `AP_ALT_VAR_DEC` |
| Auto Pilot | VS knob | D46, D47 | Joystick 3, buttons 13, 14 (76, 77) | `AP_VS_VAR_INC`, `AP_VS_VAR_DEC` |
| Auto Pilot | IAS knob | D7, D6 | Joystick 3, buttons 15, 16 (78, 79) | `AP_SPD_VAR_INC`, `AP_SPD_VAR_DEC` |
| Auto Pilot | HDG knob | D8, D9 | Joystick 3, buttons 17, 18 (80, 81) | `HEADING_BUG_INC`, `HEADING_BUG_DEC` |
| Audio | COM1 | row 0, col 3 | Joystick 4, button 1 (96) | `COM1_TRANSMIT_SELECT` |
| Audio | BOTH | row 1, col 3 | Joystick 4, button 2 (97) | `COM_RECEIVE_ALL_TOGGLE` |
| Audio | NAV2 | row 2, col 3 | Joystick 4, button 3 (98) | `RADIO_VOR2_IDENT_TOGGLE` |
| Audio | DME | row 3, col 3 | Joystick 4, button 4 (99) | `RADIO_DME1_IDENT_TOGGLE` |
| Audio | COM2 | row 0, col 4 | Joystick 4, button 5 (100) | `COM2_TRANSMIT_SELECT` |
| Audio | NAV1 | row 1, col 4 | Joystick 4, button 6 (101) | `RADIO_VOR1_IDENT_TOGGLE` |
| Audio | MKR | row 2, col 4 | Joystick 4, button 7 (102) | `MARKER_SOUND_TOGGLE` |
| Audio | ADF | row 3, col 4 | Joystick 4, button 8 (103) | `RADIO_ADF_IDENT_TOGGLE` |
| ADF | Landing gear switch | ADF controller D31 | Joystick 4, button 9 (104) | `GEAR_SET:1` when closed, `GEAR_SET:0` when open |
| ADF | Flaps switch | ADF controller D32 | Joystick 4, button 10 (105) | `FLAPS_SET:1` when closed, `FLAPS_SET:0` when open |
| ADF | Speed brakes switch | ADF controller D33 | Joystick 4, button 11 (106) | `SPOILERS_SET:1` when closed, `SPOILERS_SET:0` when open |
| ADF | Brakes button | ADF controller D34 | Joystick 4, button 12 (107) | `PARKING_BRAKES` when pressed |
| ADF | ADF major knob clockwise, anticlockwise | ADF controller D6, D7 | Joystick 4, buttons 13, 14 (108, 109) | none (the knob tunes the ADF frequency, `ADF_FREQ`) |
| ADF | ADF minor knob clockwise, anticlockwise | ADF controller D8, D9 | Joystick 4, buttons 15, 16 (110, 111) | none |
| ADF | Anti-ice switch | ADF controller D36 | Joystick 4, button 17 (112) | `ANTI_ICE_SET:1` when closed, `ANTI_ICE_SET:0` when open |
| ADF | Hyd boost switch | ADF controller D35 | Joystick 4, button 18 (113) | none (bind the joystick button in FSUIPC for the Dodo) |
| ADF | Caution dim switch | ADF controller D37 | Joystick 4, button 19 (114) | none (bind the joystick button in FSUIPC for the Dodo) |
| Huey | TEST switch | A9 | Joystick 4, button 20 (115) | none (bind the joystick button in the simulator) |
| Huey | RESET switch | A10 | Joystick 4, button 21 (116) | none |
| Huey | BRT / DIM switch | A8 | Joystick 4, button 22 (117) | none |

The Radio controller sends the first 18 Auto Pilot rows, the 8 Audio rows and the 3 Huey rows; the ADF rows come from the ADF and Upper controller (see its chapter). If a knob turns the wrong way, swap its A and B pins in the `RotaryEncoder` lines for the five Auto Pilot knobs. Which row and column each switch is on comes from the panel schematics: the matrix columns are the Radio Auto Pilot PCB nets `COL1` to `COL4`, and `COL0` is the COM and NAV panel's four swap switches. Each key is sampled once per millisecond and debounced by integration: a counter steps towards down or up with every sample and the key changes state only when it reaches an end (about 12 ms), and each sample takes two readings a few microseconds apart so a noise spike is skipped. This replaced a 50 ms timer that restarted on every reading that differed from the last, which let noise on a column line hold a release back (the MAX7219 LED digit lines run beside the column lines in the panel cables). The knobs use the same polling encoder library, with acceleration, as the COM and NAV knobs.

## Auto Pilot and Audio panel LEDs (MAX7219)

One MAX7219 on the Radio Auto Pilot PCB (U2, `DOUT` unconnected, ISET resistor 10 kohm) drives 39 LEDs: DIN on A15, CLK on A14, LOAD on A13 (LedControl library, scan limit 7 since the Huey panel was added, intensity 15 (maximum) from power-up until a `C,LEDB` or `C,B` arrives; the scan limit was 3 before, and with all eight digits scanned each LED is lit for half as long, so the Auto Pilot and Audio LEDs are dimmer than they were). Its segment pins A to G and DP are the PCB nets `ANNODE_00` to `ANNODE_07` and its digit pins 0 to 7 are `CATHODE_00` to `CATHODE_07`; each panel LED sits between one segment (anode) and one digit (cathode). The Auto Pilot panel uses digits 0 and 1 (connector `AUTOPILOT`) and the Audio panel digits 2 and 3 (connector `AUDIO`). LedControl's `setLed(0, digit, column)` uses column 0 for DP and 1 to 7 for A to G; in the chip's own digit registers (address = digit + 1) bit 7 is DP, bit 6 is A and bit 0 is G.

| LED | Token | MAX7219 digit | Segment | | LED | Token | MAX7219 digit | Segment |
|---|---|---|---|---|---|---|---|---|
| CRS | `LED_CRS` | 0 | A | | COM1 | `LED_COM1` | 2 | A |
| HDG | `LED_HDG` | 0 | B | | BOTH | `LED_BOTH` | 2 | B |
| IAS | `LED_IAS` | 0 | C | | NAV2 | `LED_NAV2` | 2 | C |
| ALT | `LED_ALT` | 0 | D | | DME | `LED_DME` | 2 | D |
| APPR | `LED_APPR` | 1 | A | | OUTER | `LED_OUTER` | 2 | E |
| FD | `LED_FD` | 1 | B | | INNER | `LED_INNER` | 2 | F |
| BC | `LED_BC` | 1 | C | | COM2 | `LED_COM2` | 3 | A |
| AP ENGAGE | `LED_APENG` | 1 | D | | NAV1 | `LED_NAV1` | 3 | B |
| | | | | | MKR | `LED_MKR` | 3 | C |
| | | | | | ADF | `LED_ADF` | 3 | D |
| | | | | | MIDDLE | `LED_MID` | 3 | E |

The first two columns are the Auto Pilot panel and the others the Audio panel. The bridges send each LED as a `LED_xxx:0/1` token in the radio data packet. `HandleOutputValuePair()` handles these before its per-pair debug line (19 extra debug packets per radio packet would flood the debug stream), `applyPanelLeds()` writes only the LEDs that changed, and the LEDs follow the radio power: they are lit only while `NAVCOM1` is 1 and the no-data timeout has not blanked the displays. `C,LEDTEST:1` lights all 39 for checking the wiring, and `C,B:0-15` (for example from the ADF controller's pot or the BenchTester slider) sets the intensity: 0 shuts the MAX7219 down, 1 to 15 set the intensity. The BenchTester has a toggle for each LED, an All ON / OFF, a chase and the board test.

**Autopilot LEDs by simulator.** The bridges light the Auto Pilot LEDs from the simulator's standard autopilot variables (SimVars, FSUIPC offsets). Aircraft with an autopilot of their own need their own mapping. The MSFS bridge maps the CowanSim 206B3's HeloSAS: its annunciator lights are the local variable `L:CS_HeliSAS_Lights_Green` (bit 1 SAS, 2 HDG, 4 NAV, 8 SPD, 16 ALT, 32 VRT), which light AP ENGAGE, HDG, CRS, IAS and ALT, and the altitude, airspeed and vertical speed the HeloSAS captured when the mode was engaged are shown on the Auto Pilot display. The FSUIPC bridge maps the DodoSim 206's SAS: its annunciator variables `DodoSim_SasSasLed`, `DodoSim_SasHdgLed`, `DodoSim_SasNavLed`, `DodoSim_SasSpdLed` and `DodoSim_SasAltLed` (bit 1 = yellow, standby; bit 2 = green, engaged) light the same five LEDs. The panel's APPR, FD and BC LEDs have no equivalent in either autopilot, and the SAS's VRT mode has no LED on the panel.

## Huey Warning Panel switches and LEDs

The Huey Warning Panel (20 caution LEDs, three switches) connects to the Radio controller through four connectors added in PCB revision 1.4 (31 October 2026): **J20** the three switches (A8 to A10), **J21** the panel backlight, **J22** the LED anodes (`HUEY_ANODES`) and **J23** the LED cathodes (`HUEY_CATHODES`). The panel itself is hand wired and its PCB is not part of this documentation. The sketch supports it as follows (the Radio on COM20 was flashed with this build on 31 October 2026, 40,552 bytes of flash and 5,949 bytes of RAM, 72 percent; it has not been checked on the panel yet):

- **LEDs:** the 20 LEDs are on the same MAX7219 as the other panels, on its digits 4 to 7 and the same segment lines. They are the tokens `LED_H_xxx` in `panelLedTable[]`, handled exactly like the Auto Pilot and Audio LEDs (`applyPanelLeds()`, the radio-power rule, the `C,B` intensity and `C,LEDTEST`).
- **Switches:** TEST (A9), RESET (A10) and BRT / DIM (A8) are read with the internal pull-ups (a closed switch is on) and a 30 ms debounce. TEST and RESET are the two positions of one switch, so one of them is always closed. Each is a joystick button on the USB HID board, held while closed: Joystick 4 buttons 20 to 22 (indexes 115 to 117). Nothing is sent during the start-up quiet period, and afterwards the buttons are brought into line with the switches. They are resent when the HID board comes back.
- **Lamp test:** while TEST is closed all 20 Huey LEDs are lit (only while the radio has power), without any command from the PC.
- **Bridges:** the FSUIPC and MSFS bridges do not send `LED_H_xxx`; the DCS bridge sends all 20 from the UH-1H caution panel (tested live) and the X-Plane bridge sends ten approximations from generic annunciators, otherwise the LEDs only light from the BenchTester, the lamp test or a test packet. For the FSUIPC and MSFS bridges, which simulator state drives each lamp is not decided.

| LED | Token | MAX7219 digit | Segment | | LED | Token | MAX7219 digit | Segment |
|---|---|---|---|---|---|---|---|---|
| ENG OIL | `LED_H_ENG_OIL` | 4 | A | | AUX FUEL LOW | `LED_H_AUX_FUEL_LOW` | 5 | A |
| ENG ICE | `LED_H_ENG_ICE` | 4 | B | | XMSN OIL PRESS | `LED_H_XMSN_OIL_PRESS` | 5 | B |
| ENG ICE DETECT | `LED_H_ENG_ICE_DETECT` | 4 | C | | XMSN OIL HOT | `LED_H_XMSN_OIL_HOT` | 5 | C |
| ENG CHIP | `LED_H_ENG_CHIP` | 4 | D | | HYD PRESS | `LED_H_HYD_PRESS` | 5 | D |
| LEFT FUEL BOOST | `LED_H_LEFT_FUEL_BOOST` | 4 | E | | ENG INLET AIR | `LED_H_ENG_INLET_AIR` | 5 | E |
| ENG FUEL PUMP | `LED_H_ENG_FUEL_PUMP` | 4 | F | | INST INVERTER | `LED_H_INST_INVERTER` | 5 | F |
| RIGHT FUEL BOOST | `LED_H_RIGHT_FUEL_BOOST` | 4 | G | | DC GENERATOR | `LED_H_DC_GENERATOR` | 5 | G |
| 20 MINUTE FUEL | `LED_H_20_MINUTE_FUEL` | 4 | DP | | EXT POWER | `LED_H_EXT_POWER` | 5 | DP |
| FUEL FILTER | `LED_H_FUEL_FILTER` | 6 | G | | CHIP DETECTOR | `LED_H_CHIP_DETECTOR` | 7 | G |
| GOV EMER | `LED_H_GOV_EMER` | 6 | DP | | IFF | `LED_H_IFF` | 7 | DP |

## Auto Pilot display

The Auto Pilot panel's character OLED (the PCB net `AP_OLED`, TCA9548A channel 2; `AP_OLED_Port`) sits behind a mask, so each of the five autopilot values has its own window on the 16-column, two-row display:

| | Left hand end | Centre | Right hand end |
|---|---|---|---|
| Top row | HDG | | VS |
| Bottom row | CRS | IAS | ALT |

HDG and CRS start at column 0, IAS ends at column 8 so it is centred, and VS and ALT end at column 15. At start-up the display shows heading `090`, course `110`, airspeed `80`, vertical speed `0` and altitude `3200`:

```
090            0
110    80   3200
```

(`showAutoPilot()` builds the two lines and `placeLeft()` and `placeRight()` position each value.) The bridges then send the real values as the tokens `APHDG`, `APCRS`, `APIAS`, `APVS` and `APALT` in the radio data packet: heading and course as three digits (north is 360), airspeed in knots, vertical speed in feet per minute (signed) and altitude in feet, each at most 5 characters. `setAutoPilotValueFromToken()` stores them (handled before the per-pair debug line, like the LED tokens) and `updateAP()` redraws the display when one changes; like the COM and NAV displays it goes blank while the radio has no power (`NAVCOM1:0`, or the no-data timeout) and returns with it. The FSUIPC bridge reads the autopilot heading (`0x07CC`), altitude (`0x07D4`), airspeed (`0x07E2`) and vertical speed (`0x07F2`) values and the NAV1 OBS (`0x0C4E`) for the course; the MSFS bridge reads `AUTOPILOT HEADING LOCK DIR`, `NAV OBS:1`, `AUTOPILOT AIRSPEED HOLD VAR`, `AUTOPILOT VERTICAL HOLD VAR` and `AUTOPILOT ALTITUDE LOCK VAR`. The BenchTester's **Auto Pilot display** group sends test values.

## When the USB HID board is missing

Every Audio and Auto Pilot switch and knob click is sent to the USB HID board (172.16.1.11). If the board is switched off or unplugged, the send fails after the W5500's ARP timeout (about 80 ms with the fast retransmission timeout, 1.6 seconds with the chip's default), and that wait used to be paid on every press and release, so the panel felt slow. Now a failed send to the HID board pauses joystick-button sends for **30 seconds** (`HID_RETRY_MS`), so only one press or release in that time pays the wait. The monitor shows `USB HID board 172.16.1.11 not answering (send gave up after N ms)` with the real wait, which also shows whether the fast timeout is working (N should be about 80), and `USB HID board is answering again` on recovery, when the switches that are held down are sent again. Debug sends to a host that does not answer are paused for 10 seconds in the same way (`DEBUG_RETRY_MS`).

## DME display

The Audio panel's character OLED (the PCB net `AUDIO_OLED`, TCA9548A channel 3; the Auto Pilot panel's OLED is channel 2) is the DME display. `DME_OLED_Port` selects the channel. At start-up the sketch starts it with the same OLED sequence as the COM and NAV displays and writes the no-data text, `DME --- NM` on the top line and `--- KT -- MIN` on the bottom line (`showDme()` pads each line to 16 characters; it was `10M` and `0M` before build 13). From build 12 the bridges send the DME readout as three tokens, `DMEDIST`, `DMESPD` and `DMEID`; `setDmeFromToken()` stores them (capitals only, letters and digits, 4 characters) and the loop redraws the display when one changed (`dmeValuesChanged`, `buildDmeText()`). The top line is `DME IBN 12.3NM`: the station identifier (build 14) and the distance, with one decimal below 100 nm (`DME 12.3 NM` with no identifier, `DME --- NM` with no DME). The bottom line is `120 KT 6 MIN`: the speed and the time to the station (distance / speed x 60, at most 99; `-- MIN` when the speed is 0). It blanks and returns with the COM, NAV and Auto Pilot displays: `updateDme()` clears it while the radio has no power (the avionics bus is below 24 V) or the no-data timeout has fired, and redraws the text when they come back; it stays lit during the start-up hold.

## ADF controller display

The radio also tells the ADF controller (172.16.1.107, port 13136) when its displays blank, so the ADF panel's OLED and landing gear lamps go dark and come back with them. `updateDme()` calls `sendAdfDisplay()`, which sends `C,DISPLAY:0` or `C,DISPLAY:1` on every change and again every 10 seconds (`ADF_DISPLAY_RESEND_MS`, so a restarted ADF controller catches up). The ADF controller may be missing: a failed send pauses these sends for 30 seconds (`ADF_RETRY_MS`) and the monitor shows `ADF controller 172.16.1.107 not answering (send gave up after N ms)` and `ADF controller is answering again`, the same way as the USB HID board, so at most one send in 30 seconds pays the ARP wait.

## Backlight

Mega pin D5 (`BACKLIGHT_PWM`) drives an IRF540N through 330 ohm (10 kohm gate pull-down), which switches the backlights of the **AUDIO, AUTOPILOT and COMM_NAV** panels, using the same rules as the Servo, Stepper and Dual Stepper boards (see the network chapter): the backlight is on only while `BPWR` is 1 (main bus 20 V or more; the radio assumes 1 until the first `BPWR` arrives), at the last brightness commanded with `C,B:0-15` (0 off, 15 full, mapped to PWM 0 to 255) or the default PWM 65 until one has been received. `applyBacklight()` also keeps it off while the displays are blanked by the no-data timeout, which is the same 30 seconds with no UDP packet **and no knob or key use** (a knob or key restarts it, so the radio can be used with no PC), and brings it back at the same level when data or local input resumes. The same `C,B` also sets the panel LEDs' intensity until a `C,LEDB` arrives (the LEDs start at full intensity). The bridges send `BPWR` in the radio packet, and the BenchTester's *Backlight power* buttons and brightness slider test it from the bench. The ADF controller's pot sends `C,B` to the radio like any other board. **`C,LEDB:0-15`** sets the MAX7219 brightness of the panel LEDs on its own (0 shuts the display down); the first `C,LEDB` after a reset takes the LEDs away from `C,B`, which then sets only the backlight.

## Start-up hold

From reset the Radio keeps the backlight (at 100 percent), the four OLED displays and every panel LED **on** until the 13 Stepper controller announces that start-up is complete on UDP port 13138 (or 180 seconds after reset); see the network chapter. `radioPowered()` returns true while the hold is on, so the displays and `applyPanelLeds()` treat the radio as powered. When the hold ends `refreshAfterStartupHold()` redraws the displays and the LEDs to their normal state, and the backlight goes off until `BPWR:1`, then coming on at 70 percent. The DME display (the Audio panel OLED) is part of the hold: `updateDme()` uses `radioPowered()` like the other displays, so it no longer blanks when the Radio's own 30 second no-data timer runs out during a long start-up (build 6).

## Tuning steps

The knobs follow standard channel spacing. COM runs 118.000 to 136.975 MHz in 25 kHz channels (major knob 118 to 136; minor knob 000, 025, 050, 075). NAV runs 108.00 to 117.95 MHz in 50 kHz steps (major 108 to 117). Each minor knob wraps round at its ends. The constants `COM_MINOR_STEP_KHZ` and `NAV_MINOR_STEP_KHZ` set the steps, and the wrap-around limits follow from them. 8.33 kHz channels are not offered. FSUIPC holds COM frequencies to 10 kHz, so in the simulator a channel such as 118.025 may appear as 118.02 or 118.03.

## Power and blanking

- **Avionics power:** when the avionics bus is below 24 V the bridge sends `NAVCOM1:0` and the COM and NAV displays blank together; they light together again when the bus rises.
- **No data for 30 seconds:** if no packet arrives and no knob or key is used, the COM, NAV, Auto Pilot and DME displays blank once, and the ADF controller is told to blank too. A packet, a knob movement or a key press restores them, and they blank again after another 30 seconds of silence.
- **Quiet period:** for 1.5 seconds (`matrixQuietMs`) after the matrix scanner starts it records state but raises no events, so a floating input cannot send false button presses at boot.

## Diagnostics

- **I2C scan:** at start-up, and whenever the control packet `C,I2CSCAN:1` arrives, the radio scans the Mega's own I2C bus and then each of the eight TCA9548A channels and sends every address that answers to the debug stream: `I2C main bus: 0x70 (TCA9548A)`, `I2C TCA port 0: 0x3C (OLED)`, one line for each channel with a device, `I2C TCA ports with nothing connected: ...` and `I2C scan done, N device(s) answered`. The scan uses a 5 ms I2C timeout so a stuck bus (SDA or SCL held low) is reported as `bus timeout` instead of hanging the board, and it takes a second or two, during which the knobs and keys are not read. It shows at once whether an OLED is missing or wired to the wrong mux channel.
- The control packet `C,MATRIX:1` prints the raw matrix (H or L for each of the five columns, with all rows high and then each row driven low) to the debug stream, bypassing debounce and the quiet period. A column that reads L with nothing pressed is a hardware fault on that Mega pin or board. A faulty or badly seated Mega did exactly this on the bench: all four swap switches share column 0, so none could register, and the board also dropped off USB and the network after flashing.
- Remote reset is a software reset (see the network chapter). Bench-tested: "Ethernet Started" about 4 seconds after the command and "Setup Complete" about 5 seconds.

## PCB features the sketch does not use yet

The Jet Ranger Radio Auto Pilot PCB (v1.4) carries more than the sketch handles. What is still unused:

| Mega pins | PCB net | Status in the sketch |
|---|---|---|
| A0 to A3 | `COMM1_VOL`, `COMM2_VOL`, `NAV1_VOL`, `NAV2_VOL` (volume pots) | Not read |
| D2 to D4 | `I2C_SEL_A2`, `A1`, `A0` (mux address) | Not driven |

On the same PCB the COM1 major, COM1 minor, COM2 minor and NAV1 minor encoders have their A and B pins the other way round from the sketch (the sketch uses 31, 30 and 33, 32 for COM1, 37, 36 for COM2 minor and 41, 40 for NAV1 minor, where the PCB labels A as 30, 32, 36 and 40). It only matters if one of those knobs tunes backwards.

## Known issues

- The Radio controller emulator sends a bare frequency for every radio (see the emulator chapter).
- The mux address pins (D2 to D4) are not driven by the sketch; the mux module's own pull-downs set address 0x70.
