bnepethomas/bne-arduino-flight-simulator-interfaces/Jet Ranger/Jet Ranger Documentation/DocBuild/src/guide/05_trouble_ref.md

# Troubleshooting

Debug and test tools

| Symptom | Likely cause | What to check |
|---|---|---|
| Red LED keeps fast-flashing, no gauge sweep | Board stuck in Ethernet start-up | Ethernet module seated; reset line on pin 53; module powered |
| Sweep runs but gauges never move in flight | Packets not reaching UDP 13136 | PC on 172.16.1.x; Windows firewall allows outbound UDP; the bridge sends to the right boards (servo .102, steppers .105 and .106); only one bridge running |
| No debug messages, or the Health Monitor shows a board as down | Listener or Health Monitor not running, or PC address wrong | PC at 172.16.1.10; listener bound to UDP 27000, Health Monitor to UDP 13137; firewall allows inbound UDP on both |
| One gauge pinned at an end stop | Value outside the calibration table, or table points wrong | Send the `RAW` token to find the true limits, then re-measure the table (see Calibration) |
| The DCS bridge says no stream | DCS not running, or DCS-BIOS not installed or its `Export.lua` line missing | Start DCS with an aircraft loaded; check `Saved Games\DCS\Scripts\Export.lua` has the DCS-BIOS line; no other program should block multicast 239.255.50.10 port 5010 |
| A Huey gauge reads wrong or sits against a stop | The needle-position scale is a first guess (*uncalibrated*) | Calibrate it in the DCS bridge (select the row, Calibrate selected...) at two or more readings |
| The X-Plane bridge says no data yet | X-Plane not running, UDP receive off, or the wrong host or port | Allow incoming UDP in X-Plane's network settings; use `--xplane-host` and `--xplane-port`; check the Windows firewall |
| One gauge stays at zero with the X-Plane bridge | The aircraft does not fill in that dataref | Use Search datarefs... and add the right one to a profile file |
| An emulator window stays blank or says *waiting for packets* | The bridge's **Send to the emulators** box is not ticked (start it with `--emulators` or `--emulators-only`), the emulator is not open for that board, or another program holds that emulator address |
| An emulator says *cannot listen on 127.0.0.nnn* | The same emulator is already open (one program can listen on an address at a time): close the other copy |
| You want to see what the bridge is sending to a board | Press **Show packets...** in the bridge and choose the board in **Target board** (see Packet monitor). If the board's lines are missing, the bridge is not sending (check the **Send** boxes and that the simulator data is arriving) |
| All gauges drop to zero after 30 seconds | No packets arriving (watchdog) | Bridge running and connected; simulator not paused; network link |
| A board feels slower, or its knobs and needles stutter, while the PC (or another board) is off | Each packet sent to a missing device waits up to 80 ms for an ARP answer (the fast Ethernet timeout) | Switch the missing device on, or reduce debug traffic; see *Unreachable hosts and the fast Ethernet timeout* in the Network chapter |
| Attitude indicator lags fast changes | 1 degree per 5 ms step limit | Expected; reduce `servoCheckInterval` to speed up |
| Pressing an Audio or Auto Pilot switch is slow, or a joystick button seems delayed | The USB HID board is switched off or unplugged: each send to it waits for an answer that never comes | The radio now pauses joystick sends for 30 seconds after one fails and says so in the monitor (`USB HID board ... not answering`); connect the HID board and the buttons return |
| Servo buzzes or jitters | Weak servo supply | Separate 5 to 6 V supply for servos, common ground with the Mega |
| A backlight is off | Main bus below 20 V (`BPWR:0`), no packets for 30 seconds, or brightness set to 0 | Check the main bus voltage in the bridge window; check the bridge is running; send a brightness with the BenchTester slider |
| A backlight stays on at power-up with no PC | The start-up hold: every board keeps its backlight at full brightness, and its OLEDs and lamps on, until the Stepper controller announces start-up is complete, or for 180 seconds after reset. Otherwise an old firmware without the no-data rule | Wait for the hold to end (the Stepper controller finishes starting up, or 3 minutes). It then drops to 70 percent and goes off. If it stays on longer, flash the current sketches |
| The backlight is always on or flickers | MOSFET pinned wrongly on a board from an earlier revision (source and drain swapped) | Check the transistor against the revision notes (PCBs and wiring) |
| The GPS shows Brisbane Airport | No aircraft data for 30 seconds | Check a bridge or the bench tester is running on the same PC and sending to UDP 27002; check no other program owns the port |
| The GPS time is hours out with DCS | The DCS mission clock is the theatre's local time and the bridge's **Mission time zone** box is still 0 | Set the box to the theatre's hours from UTC (for example 4 for the Caucasus); the GPS date is the PC's |
| The GPS shows the PC time, not the simulator time | The packets carry no `UTC:` (for example the FSUIPC time read failed) | The window says *PC clock*; check the bridge version |
| The GPS interface cannot open its port | Wrong COM port, or another program holds it | Use *Change serial port...*; close other serial programs |
| A lamp never lights | Wiring or the lamp's driver | It should light at the power-up lamp test; if not, check the A pin and its driver |
| A radio knob tunes the wrong radio | Bare frequency sent instead of a labelled one | Use the real board (it labels COM2, NAV1 and NAV2); the Radio emulator sends bare numbers, so only COM1 tunes |
| COM and NAV displays blank | Avionics bus below 24 V, or no data and no knob use for 30 seconds | Switch avionics on; turn a knob to wake them |
| Dual stepper OLEDs blank | Main bus below 24 V (`PWR:0`) | Switch the battery on; check the main bus voltage in the bridge window |
| Radio swap switches do nothing | Column 0 of the matrix stuck | Send `C,MATRIX:1` and read the debug listener (see Radio controller) |
| FSUIPC binding fires the wrong event | EVT re-indexed after an update | Re-map the binding in FSUIPC |
| Joystick buttons vanish after a reset | USB HID board rebooted | Windows re-detects them within seconds; re-check games that had them open |
| Upload fails with *Access is denied* | Another program holds the COM port | Close the serial monitor and the Arduino IDE port; check the port with `arduino-cli board list` |
| Upload goes to the wrong board | COM port moved | Re-check Device Manager; see COM ports and flashing |
| Data reaches the boards only in bursts, with gaps of several seconds | The PC's Ethernet link to the board switch is dropping in and out | In Windows, check the network adapter stays connected; check the 5 V supply of the network switch stays above 4.75 V (it once dipped below and the switch dropped its ports), then the cable and switch port |

## Known issues in the code

**Servo firmware (`JET_RANGER_SERVO_CONTROLLER.ino`)**

- `powerAvailable` is set from `NAVCOM1` but nothing uses it, so the attitude indicator stays live when the simulator's power is off (the bridge sends all lamps off below 20 V).
- Several lamps log *Transmission Temperature changed* to the debug listener, whichever lamp changed.
- The PCB labels 10 of the 15 lamp outputs on different pins from the sketch (A1/A2, A5/A6, A7 to A10, A11/A12). Test each lamp on its own, for example `D,RLOW:1`, and correct whichever side is wrong.

**FSUIPC event file (`DODSIM206V2.EVT`)**

- The line before event 133 is missing its `//`, so FSUIPC may reject or mis-read it.
- Events 189 and 190 are named the wrong way round: 189 is called `_SET` but toggles, 190 is called `_TOGGLE` but takes 1 or 2.
- Events 69 to 71 mix up the instrument and cockpit light breakers: 69 is named `COCKPIT_LT_CB_TOGGLE`, and `INST_LT_CB_SET` appears twice.

## Open questions

- Power supply rating for the servo rail and the 12 V lamp supply.
- Whether the estimates for the FlyInside and CowaSim aircraft hold at other power settings.

# Reference: UDP tokens

From the current sketches. Gauge tokens take real units; lamp tokens take 0 (off) or 1 (on). `UDP_Interface_Values.xlsx` still lists the old 16-servo pin plan, so use these tables instead.

## Gauge tokens

| Token | Gauge | Board | Units |
|---|---|---|---|
| `BANK` | Attitude bank | Servo (.102) | degrees, plus and minus 90 |
| `PITCH` | Attitude pitch | Servo (.102) | degrees, plus and minus 30 |
| `IAS` | Airspeed | Stepper (.105) | knots, one decimal allowed |
| `VSI` | Vertical speed | Stepper (.105) | ft/min |
| `AGL` | Radar altitude | Stepper (.105) | feet |
| `TQ` | Engine torque | Stepper (.105) | % |
| `N1` | Gas producer | Stepper (.105) | % |
| `ITT` | Turbine out temperature | Stepper (.105) or Dual (.106) | degrees C |
| `FUEL` | Fuel quantity | Stepper (.105) or Dual (.106) | US gal |
| `OILT` | Engine oil temperature | Dual (.106) or Stepper | degrees C |
| `OILP` | Engine oil pressure | Dual (.106) or Stepper | psi |
| `XMSNT` | Transmission oil temperature | Dual (.106) or Stepper | degrees C |
| `XMSNP` | Transmission oil pressure | Dual (.106) or Stepper | psi |
| `RPME` | Engine RPM (N2) | Dual (.106) | %, one decimal |
| `RPMR` | Rotor RPM | Dual (.106) | %, one decimal |
| `ALT` | Altimeter | Dual (.106) | feet |
| `FUELLOAD` | Fuel load | Dual (.106) | psi |
| `ELECTRICALLOAD` | Electrical load | Dual (.106) | % |

Every gauge token also has a `RAW` twin (for example `PITCHRAW`, `IASRAW`) that takes a raw servo position or stepper step count and skips the calibration table.

## Lamp tokens (servo board)

| Token | Lamp | Pin |
|---|---|---|
| `EOUT` | Engine out | A1 |
| `RLOW` | Rotor RPM low | A2 |
| `TOPW` | Transmission oil pressure | A3 |
| `TOTW` | Transmission oil temperature | A4 |
| `BHOT` | Battery hot | A5 |
| `BTMP` | Battery temperature | A6 |
| `EC` | Engine chip | A7 |
| `TRC` | Tail rotor chip | A8 |
| `TC` | Transmission chip | A9 |
| `BD` | Baggage door | A10 |
| `FFLTR` | Aft fuel filter | A12 |
| `FPMP` | Fuel pump | A11 |
| `GENF` | Generator fail | A13 |
| `LOWF` | Low fuel | A14 |
| `SCF` | SC fail (standby compass) | A15 |

## Aircraft information to the GPS interface (UDP 27002)

`D,LAT:<deg>,LON:<deg>,ALT:<feet>,IAS:<knots>,HDG:<degrees true>,UTC:<yyyyMMddHHmmss[.fff]>`, sent every 500 ms by a bridge or the bench tester. Any subset of keys works, and the CSV form `lat,lon,altitude_ft,airspeed_kt,heading_deg[,utc]` is accepted too. South and west are negative.

## Status and control tokens

| Token | Packet | Meaning |
|---|---|---|
| `NAVCOM1` | D | 0 = avionics bus below 24 V (radio COM and NAV displays blank, panel LEDs off), 1 = on |
| `LED_CRS`, `LED_HDG`, `LED_IAS`, `LED_ALT`, `LED_APPR`, `LED_FD`, `LED_BC`, `LED_APENG` | D | Auto Pilot panel LEDs on the radio controller (1 = on) |
| `LED_COM1`, `LED_BOTH`, `LED_NAV2`, `LED_DME`, `LED_OUTER`, `LED_INNER`, `LED_COM2`, `LED_NAV1`, `LED_MKR`, `LED_ADF`, `LED_MID` | D | Audio panel LEDs on the radio controller (1 = on) |
| `APHDG`, `APCRS`, `APIAS`, `APVS`, `APALT` | D | The values on the Auto Pilot panel's OLED (radio controller): heading and course as three digits (north is 360), airspeed in knots, vertical speed in feet per minute and altitude in feet |
| `N1A`, `N2A` | D | NAV1 and NAV2 active frequency in MHz, for the radio controller's NAV display (the standby frequencies are local) |
| `DMEDIST`, `DMESPD`, `DMEID` | D | The radio controller's DME display: distance in nautical miles (-1 = no DME), speed in knots (-1 = none), station identifier (`-` = none) |
| `ADF`, `SQK` | D | To the ADF and Upper controller: the simulator's ADF frequency in kHz and transponder code, for its display |
| `BRIDGEKEYS`, `ADFKEYPAD` | D | To the ADF and Upper controller: `BRIDGEKEYS:*` = the bridge handles `*` on the Upper keypad (not typed); `ADFKEYPAD:SQUAWK` = the ADF keypad enters the squawk code |
| `LDGN`, `LDGL`, `LDGR` | D | The landing gear lamps on the ADF panel (nose, left, right): 1 = lit |
| `BPWR` | D | Backlight power for the Radio, Servo, Stepper, Dual Stepper and ADF and Upper controllers: 1 = main bus 20 V or more, 0 = backlight off. Sent first in the Servo and Stepper packets, after `PWR` in the Dual Stepper packet, after `NAVCOM1` in the Radio packet and on its own to the ADF and Upper board |
| `PWR` | D | Dual stepper board: 1 = all four OLEDs on, 0 = blank them (main bus below 24 V). Sent first in the packet |
| `ZULU` | D | Zulu time as HHMM, for example 1430 (dual stepper clock OLED) |
| `TEMP` | D | Temperature text for the dual stepper's temperature OLED, for example 25C |
| `B` | C | Backlight brightness 0 to 15 (0 off, 15 full). Radio, Servo, Stepper, Dual Stepper and ADF and Upper (the Radio also sets the brightness of its Auto Pilot, Audio and Huey panel LEDs from it). The ADF controller can send it from its brightness pot, which is switched off for the moment |
| `SWING<CODE>` | C | Runs one gauge's start-up sweep on demand, for example `C,SWINGTQ:1` (stepper boards) or `C,SWINGPITCH:1` (servo board); the value is ignored |
| `OLEDTEST` | C | 1 fills the four OLEDs solid white, 0 restores them (dual stepper board) |
| `KEEPALIVE` | C | Ignored command that still counts as received data and restarts the 30 second no-data timer (BenchTester sends it during a run) |
| `RESET` | C | Reboots the board about 2 seconds later (servo, stepper, dual stepper, radio and ADF and Upper controllers on port 13136; USB HID board on port 4210). The radio and ADF and Upper controllers use a software reset because a watchdog reset hung the radio's bootloader; the upper controller's reset has not been bench-tested |
| `MATRIX` | C | Radio and ADF controllers: print the raw button matrix to the debug listener |
| `POWER` | C | ADF controller: send a power status (12 V and 5 V rails) now |
| `LEDTEST` | C | Radio controller: 1 lights all 19 Auto Pilot and Audio panel LEDs, 0 returns them to the simulator's state |
| `LEDB` | C | Radio controller: MAX7219 panel LED brightness 0 to 15 (0 off), on its own; after the first one `C,B` sets only the backlight |
| `GEARB` | C | ADF and Upper controller: landing gear lamp brightness 0 to 15 (0 never lit, 15 full) |
| `OLEDB` | C | Dual Stepper controller: SSD1306 OLED brightness 0 to 15 |
