bnepethomas/bne-arduino-flight-simulator-interfaces/Jet Ranger/Jet Ranger Documentation/DocBuild/src/master/02_network.md

# Network and communication

## Devices and addresses

All devices sit on one wired `172.16.1.0/24` network with fixed addresses; there is no DHCP. The firmware sends its debug and heartbeat traffic to `172.16.1.10`, so the primary PC must hold that address (or `reflectorIP` must be changed in each sketch and the sketch uploaded again).

Who talks to whom

| Device | IP | MAC | Heartbeat text |
|---|---|---|---|
| Primary PC (simulator, bridge, listeners) | 172.16.1.10 | | |
| USB HID board | 172.16.1.11 | DE:AD:BE:EF:FE:ED | `JOYSTICK` |
| Radio controller | 172.16.1.101 | A8:61:0A:9E:83:01 | `COMM_NAV` |
| Servo controller | 172.16.1.102 | A8:61:0A:9E:83:02 | `SERVO` |
| Stepper controller | 172.16.1.105 | A8:61:0A:67:83:69 | `STEPPER` |
| Dual stepper controller | 172.16.1.106 | A8:61:0A:67:83:6A | `DUAL_STEPPER` |
| ADF and Upper controller | 172.16.1.107 | A8:61:0A:67:83:6B | `ADF_PANEL` and `UPPER_INPUT` |

Every live board has its own IP and MAC address. The old Upper controller (172.16.1.103, MAC A8:61:0A:9E:83:03) was merged into the ADF controller on 31 October 2026 and no longer exists; the merged board sends both heartbeat names so the Health Monitor still shows an Upper light. The bridges and the BenchTester still send some packets to .103, which go nowhere.

## UDP ports

| Port | Direction | Purpose |
|---|---|---|
| 13136 | PC to boards | Data (`D,`) and control (`C,`) packets |
| 27001 | Radio and ADF controllers to PC bridge (FSUIPC and MSFS bridges only) | Standby frequencies, radio swaps, and the Auto Pilot, Audio and ADF panel controls (`AP_MASTER`, `HEADING_BUG_INC:5`, `GEAR_DOWN`, ...) |
| 27002 | Bridge (or bench tester) to the GPS interface | Aircraft position, altitude, airspeed, heading and simulator UTC time, every 500 ms (both on the PC) |
| 27003 | ADF controller to the PC | ADF knob frequency (`ADF_FREQ`), radar follow ID and power status every 30 seconds, each Upper keypad press (`UPPER_KEY:<key>`) and each squawk entered on the ADF keypad (`SQUAWK_SET:<code>`). The FSUIPC bridge reads all of them (the MSFS bridge reads `ADF_FREQ`; the DCS and X-Plane bridges do not read this port). Not 27001, where an unknown string is taken as a COM1 standby frequency |
| 4210 | Servo, Radio and ADF and Upper controllers to USB HID board | Button changes (`index,state`), keys (`KEY,key,state`), reset |
| 5010 | DCS (DCS-BIOS) to the DCS bridge | The DCS-BIOS export stream, multicast 239.255.50.10, on the PC |
| 49000 | X-Plane and the X-Plane bridge | The bridge sends dataref requests to X-Plane's receive port and X-Plane answers to the bridge's own port; X-Plane's beacon is multicast 239.255.1.1 port 49707 |
| 13136 on 127.0.0.101 to .107 | Bridge to the panel emulators | The same board packets, to the emulators on the PC (see the Panel emulators chapter) |
| 13137 | Boards to Health Monitor | Heartbeat text every 10 seconds |
| 13138 | Stepper controller to the other controllers | The text `STARTUPDONE`, sent to the Radio, Servo, Dual Stepper and ADF and Upper controllers when the Stepper controller has finished starting up (sent twice, 2 seconds apart); ends their start-up hold |
| 27000 | Boards to debug listener | Debug text, each line prefixed with the board name |
| 7788 | Local on the boards | Source port opened at start-up for outgoing packets |

## Packet format

Data and control packets

A packet is plain ASCII text, up to 1000 bytes.

- `D,CODE:value,CODE:value,...` is a **data** packet. It can carry any number of pairs, in any order. Unknown codes are ignored, so the PC can send only the values that changed.
- `C,COMMAND:value` is a **control** packet (swing tests, lamp test, keep-alive, reset). The value is usually ignored.
- Gauge codes take **real units**: degrees, knots, feet per minute, psi, percent, degrees C, US gallons. The board converts them with its own calibration table.
- A calibrated code usually has a raw twin with `RAW` on the end (for example `IASRAW:300`). It moves the needle to a raw step or servo position and skips the table, which is how new calibration points are measured.
- Lamp codes take `0` (off) or `1` (on).

Example sent to the servo board: `D,PITCH:5,BANK:-10,LOWF:0` sets 5 degrees pitch, minus 10 degrees bank and switches the Low Fuel lamp off.

To test without the simulator, send a packet from any PC on the subnet:

```
$u = New-Object System.Net.Sockets.UdpClient
$b = [Text.Encoding]::ASCII.GetBytes('D,PITCH:5,RLOW:1')
$u.Send($b, $b.Length, '172.16.1.102', 13136)
```

## Board life cycle

What every gauge board does from power-up to shutdown

1. **Start-up:** status LEDs flash, the Ethernet module is reset, the board gets its static address and opens its sockets; the red LED flashes for a few seconds while the link settles.
2. **Self-test:** the gauge boards sweep each gauge (the Servo board also lights all lamps) and park at the calibrated zero.
3. **Running:** every 5 ms the board checks UDP 13136, stores each value as a new target and moves the needle towards it with smooth acceleration.
4. **Heartbeat:** every 10 seconds the board sends its heartbeat text to the Health Monitor, followed by its 5 V rail and its firmware version (`SERVO V5:5.02 FW:1.0.2`, where `FW:1.0.2` is version 1.0, build 2; the ADF controller also adds its 12 V rail, `ADF_PANEL V5:5.03 V12:12.41 FW:1.0.3`). The Health Monitor matches the first word and shows the voltages and the firmware version in its voltage table. The 5 V rail is the ADC reference (AVcc) measured against the chip's 1.1 V band-gap.
5. **No-data watchdog:** if no packet (data or control) arrives for 30 seconds, every gauge returns to its calibrated zero. The Servo board also switches its lamps off, the Dual Stepper blanks its OLEDs and the Radio blanks its displays. The timer starts at the end of `setup()` so that a long self-test cannot use it up. Normal operation resumes with the next packet.

All sketches call `Ethernet.setRetransmissionTimeout(10)` after `Ethernet.begin()`. The W5500 default of 200 ms times 8 retries can block a UDP send for 1.6 seconds if the destination does not answer ARP (for example the PC is off); with 10 ms the worst case is about 80 ms, so one dead destination cannot stall gauge movement or button scanning.

## Power rules in the bridges

How bus voltages switch the panel

- **Main bus below 20 V:** the Servo board's lamps are sent as off, the Stepper's radar altitude (`AGL`) is sent as zero and `BPWR:0` switches the Radio, Servo, Stepper, Dual Stepper and ADF and Upper backlights off.
- **Main bus below 24 V:** the bridge sends `PWR:0` to the Dual Stepper, which blanks its four OLEDs; `PWR:1` turns them back on.
- **Avionics bus below 24 V:** the bridge sends `NAVCOM1:0` to the Radio, which blanks its COM and NAV displays together. If the aircraft reports the avionics bus as exactly 0 (the FlyInside B206 does) the main bus is used instead.

There is no hysteresis on these thresholds. The 24 V figure is carried over from the FSUIPC bridge and has not been verified for every MSFS aircraft.

## Backlight

How the backlight level is decided

The Radio, Servo, Stepper, Dual Stepper and ADF and Upper boards drive their panel backlights from Mega pin D5 (PWM). On the Radio the no-data rule is the same 30 second timeout that blanks its displays, which a knob or key press also restarts; on the ADF and Upper board a switch, key or knob also restarts it (the Upper panel's switch matrix and keypad count too). Three things decide the level:

- **`BPWR`** (from the bridges, first in the Servo and Stepper packets, after `PWR` in the Dual Stepper packet, and on its own to the ADF and Upper board): 1 while the main bus is 20 V or more, 0 below that. At 0 the backlight is off. Until the first `BPWR` arrives the board assumes 1.
- **`C,B:<0-15>`** sets the brightness (0 off, 15 full, mapped to PWM 0 to 255; larger values are clamped). It is remembered. With no brightness command received the default level, PWM 65, is used; once one has been received every return of power restores the **last commanded level**. A command sent while the bus is down is applied when power returns. The start-up hold overrides it: the backlight is 100 percent while the hold lasts and the commanded level is 70 percent (PWM 179) when it ends, so the PWM 65 default is only a fallback in the code.
- **The no-data watchdog:** after 30 seconds with no UDP packet, including after power-up with no PC feed, the backlight goes off along with the gauges. The next packet turns it back on at the commanded (or default) level, provided the main bus is up.

The BenchTester's brightness slider sends `C,B` to every board except the USB HID board, and its *Backlight power* buttons send `BPWR` to the Radio, Servo, Stepper, Dual Stepper and ADF controllers (and still to the retired Upper address .103). The ADF controller can send `C,B` from its brightness pot to the other boards, but the pot is switched off for the moment (see the ADF controller chapter). The Radio also uses `C,B` for the intensity of its panel LEDs until it receives a `C,LEDB`, which sets them on their own. The ADF controller also blanks its OLED and lamps together with the Radio's displays (the Radio sends it `C,DISPLAY:0/1`), see the ADF controller chapter.

### Start-up hold

**Start-up hold.** From reset every controller keeps its backlight **on at 100 percent** (PWM 255, whatever level was commanded), and keeps its OLEDs and indicator lamps on, whatever the no-data watchdog or `BPWR` says. A `C,B` command received during the hold does not change the level. The hold ends when the 13 Stepper controller, which is the last to finish its start-up, announces that start-up is complete: it sends the text `STARTUPDONE` to UDP port 13138 of the Radio, Servo, Dual Stepper and ADF and Upper controllers, and sends it a second time 2 seconds later. When the hold ends the commanded backlight level becomes **70 percent** (PWM 179) and the backlight goes **off**; it comes on at 70 percent when the bridge reports the main bus is up (`BPWR:1`), unless a `C,B` command has set another level. If the announcement never reaches a board (the Stepper controller is off, or the board was reset or powered up more than 2 seconds after the second send) the board ends the hold by itself 180 seconds after its reset. Port 13138 is separate from the data port, so the announcement never counts as data for the 30 second watchdog.

What stays on during the hold:

| Controller | Stays on until the hold ends |
|---|---|
| Radio | Backlight (100 percent), the four OLED displays (COM, NAV, Auto Pilot, DME) and all panel LEDs (lit) |
| Servo | Backlight (100 percent) and all 15 caution and warning lamps (lit) |
| Stepper | Backlight (100 percent) only (it ends its own hold at the end of its start-up and sends the announcement) |
| Dual Stepper | Backlight (100 percent) and the four OLEDs |
| ADF and Upper | Backlight (100 percent), the OLED and the three landing gear lamps (lit) |

When the hold ends the OLEDs and lamps go back to their normal rules (PWR, `NAVCOM1`, `C,DISPLAY` and the data). A board that has had no data or input for more than 2 seconds then also expires its own 30 second no-data timer, so its OLEDs go out together with the backlight instead of lingering. The USB HID board has no backlight and is not part of this.

## Remote reset

C,RESET:1 on each board

The control packet `C,RESET:1` reboots a board about two seconds later.

- **Servo, Stepper, Dual Stepper and USB HID boards** arm the AVR watchdog for two seconds and spin until it fires. A short `.init3` function clears the watchdog first thing after every reset. The HID board listens on port 4210 (it also accepts the plain text `RESET`); its USB connection drops while it restarts, so Windows briefly loses the four joysticks and the keyboard.
- **Radio and ADF and Upper controllers** use a software reset (a jump to the reset vector after switching off interrupts and peripherals). A watchdog reset hung the Radio's bootloader, which restarts the watchdog at its shortest timeout and never reaches the sketch until it is reflashed.

If a board ever reboot-loops after a reset packet, power-cycle it and reflash. The BenchTester's *Reset boards...* button sends the command to the boards you tick.

> **Network note:** data that arrives in bursts with gaps of several seconds meant the PC's link to the board switch was dropping in and out. The cause on this cockpit was the 5 V rail feeding the network switch dipping below 4.75 V; the switch then dropped its ports. Check that supply first, then the cable and the switch port.

## Debug and monitoring

Debug and test tools

Boards send debug text to `172.16.1.10:27000`. Only one program can own a UDP port, so if the reflector is running do not start a second listener on 27000; use the reflector's forwarding instead. The Health Monitor owns 13137 and each bridge owns 27001.
