bnepethomas/bne-arduino-flight-simulator-interfaces/Jet Ranger/Jet Ranger Documentation/DocBuild/src/master/13_appendices.md

# Appendix A: UDP token reference {-}

From the current sketches. Gauge tokens take real units; lamp tokens take 0 (off) or 1 (on). `UDP_Interface_Values.xlsx` still lists the old 16-servo plan, so use these tables instead. Every gauge token also has a `RAW` twin (`PITCHRAW`, `IASRAW`) that takes a raw servo position or step count and skips the calibration table.

## Gauge tokens

| Token | Gauge | Board | Unit |
|---|---|---|---|
| `PITCH` | Attitude pitch | Servo .102 | degrees, -30 to +30 |
| `BANK` | Attitude bank | Servo .102 | degrees, -90 to +90 |
| `IAS` | Airspeed | Stepper .105 | knots, one decimal allowed |
| `VSI` | Vertical speed | Stepper .105 | ft/min |
| `AGL` | Radar altitude | Stepper .105 | feet, 0 to 2500 |
| `TQ` | Engine torque | Stepper .105 | percent, 0 to 120 |
| `N1` | Gas producer | Stepper .105 | percent, 0 to 103 |
| `ITT` | Turbine out temperature | Stepper .105 or Dual .106 | degrees C |
| `FUEL` | Fuel quantity | Stepper .105 or Dual .106 | US gallons |
| `OILT` | Engine oil temperature | Dual .106 (or Stepper) | degrees C |
| `OILP` | Engine oil pressure | Dual .106 (or Stepper) | psi |
| `XMSNT` | Transmission oil temperature | Dual .106 (or Stepper) | degrees C |
| `XMSNP` | Transmission oil pressure | Dual .106 (or Stepper) | psi |
| `RPME` | Engine speed (N2) | Dual .106 | percent, one decimal |
| `RPMR` | Rotor speed | Dual .106 | percent, one decimal |
| `ALT` | Altimeter | Dual .106 | feet |
| `FUELLOAD` | Fuel load | Dual .106 | psi |
| `ELECTRICALLOAD` | Electrical load | Dual .106 | percent |

## Display and status tokens

| Token | Board | Meaning |
|---|---|---|
| `ZULU` | Dual .106 | Zulu time as HHMM, for example `1430` |
| `TEMP` | Dual .106 | Temperature text up to 8 characters, for example `25C` |
| `PWR` | Dual .106 | 1 = all four OLEDs on, 0 = blank (main bus below 24 V). Sent first in the packet |
| `APHDG`, `APCRS`, `APIAS`, `APVS`, `APALT` | Radio .101 | The values on the Auto Pilot panel's OLED: heading and course (three digits, north is 360), airspeed (knots), vertical speed (feet per minute, signed) and altitude (feet), up to 5 characters each |
| `LDGN`, `LDGL`, `LDGR` | ADF and Upper .107 | The landing gear lamps (nose, left, right): 1 = lit |
| `C1A`, `C1S`, `C2A`, `C2S` | Radio .101 | COM1 and COM2 active and standby frequency, MHz |
| `N1A`, `N2A` | Radio .101 | NAV1 and NAV2 **active** frequency, MHz (the standby frequencies are local) |
| `DMEDIST`, `DMESPD`, `DMEID` | Radio .101 | The DME display: distance in nautical miles (-1 = no DME), speed in knots (-1 = none), station identifier (up to 4 characters, `-` = none) |
| `ADF`, `SQK` | ADF and Upper .107 | The simulator's ADF frequency in kHz (190 to 1799) and transponder code (four digits), for the ADF controller's display |
| `BRIDGEKEYS`, `ADFKEYPAD` | ADF and Upper .107 | `BRIDGEKEYS:*`: the bridge handles `*` on the Upper keypad itself, so the board does not type it (held 5 seconds). `ADFKEYPAD:SQUAWK`: the ADF keypad enters the squawk code (held 5 seconds) |
| `MAINBUS` | Radio .101 | Main bus voltage |
| `NAVCOM1` | Radio .101 | 0 = avionics bus below 24 V (COM and NAV displays blank, panel LEDs off), 1 = on |
| `LED_CRS`, `LED_HDG`, `LED_IAS`, `LED_ALT`, `LED_APPR`, `LED_FD`, `LED_BC`, `LED_APENG` | Radio .101 | Auto Pilot panel LEDs (CRS, HDG, IAS, ALT, APPR, FD, BC, AP ENGAGE): 1 = on |
| `LED_COM1`, `LED_BOTH`, `LED_NAV2`, `LED_DME`, `LED_OUTER`, `LED_INNER`, `LED_COM2`, `LED_NAV1`, `LED_MKR`, `LED_ADF`, `LED_MID` | Radio .101 | Audio panel LEDs: 1 = on |
| `LED_H_ENG_OIL`, `LED_H_ENG_ICE`, `LED_H_ENG_ICE_DETECT`, `LED_H_ENG_CHIP`, `LED_H_LEFT_FUEL_BOOST`, `LED_H_ENG_FUEL_PUMP`, `LED_H_RIGHT_FUEL_BOOST`, `LED_H_20_MINUTE_FUEL`, `LED_H_AUX_FUEL_LOW`, `LED_H_XMSN_OIL_PRESS`, `LED_H_XMSN_OIL_HOT`, `LED_H_HYD_PRESS`, `LED_H_ENG_INLET_AIR`, `LED_H_INST_INVERTER`, `LED_H_DC_GENERATOR`, `LED_H_EXT_POWER`, `LED_H_FUEL_FILTER`, `LED_H_GOV_EMER`, `LED_H_CHIP_DETECTOR`, `LED_H_IFF` | Radio .101 | Huey Warning Panel LEDs: 1 = on (sent by the DCS bridge from the UH-1H caution panel, and ten of them approximately by the X-Plane bridge; not by the FSUIPC and MSFS bridges) |
| `BPWR` | Radio .101, Servo .102, Stepper .105, Dual .106, ADF and Upper .107 (the bridges still also send it to the retired Upper .103) | Backlight power: 1 = main bus 20 V or more, 0 = backlight off |

## Lamp tokens (Servo .102)

`EOUT`, `RLOW`, `TOPW`, `TOTW`, `BHOT`, `BTMP`, `EC`, `TRC`, `TC`, `BD`, `FPMP`, `FFLTR`, `GENF`, `LOWF`, `SCF` on pins A1 to A15 in that order (the fuel pump and aft fuel filter pins were swapped on 25 October 2026: `FPMP` is A11 and `FFLTR` is A12) (see the Servo controller chapter).

## Control tokens (`C,<COMMAND>:<value>`)

| Command | Meaning |
|---|---|
| `SWING<CODE>` | Run one gauge's start-up swing on demand, for example `C,SWINGTQ:1`; the value is ignored |
| `OLEDTEST` | 1 fills the four Dual Stepper OLEDs solid white, 0 restores them |
| `KEEPALIVE` | Ignored command that still counts as received data and restarts the 30 second no-data timer |
| `VERSION` | Send the firmware version, build number and compile date and time to the debug stream now (see Firmware versions in Appendix B; the USB HID board answers on its logging port) |
| `RESET` | Reboot the board about 2 seconds later (port 13136; USB HID board on 4210) |
| `MATRIX` | Radio and ADF controllers: print the raw matrix or ADF keypad readings to the debug stream |
| `LEDTEST` | Radio controller: 1 lights all 39 Auto Pilot, Audio and Huey panel LEDs, 0 returns them to the simulator's state |
| `LEDB` | Radio controller: MAX7219 brightness 0 to 15 (0 off), on its own; after the first one `C,B` sets only the backlight |
| `GEARB` | ADF and Upper controller: landing gear lamp brightness 0 to 15 (0 never lit, 15 full) |
| `OLEDB` | Dual Stepper controller: SSD1306 OLED brightness (contrast) 0 to 15 |
| `POWER` | ADF controller: send a power status (12 V and 5 V rails) now |
| `DISPLAY` | ADF and Upper controller: 0 blanks its OLED and landing gear lamps, 1 restores them (sent by the Radio controller with its own displays) |
| `B` | Backlight brightness 0 to 15 (0 off, 15 full): Radio, Servo, Stepper, Dual Stepper and ADF and Upper; the Radio also sets the intensity of its Auto Pilot and Audio panel LEDs from it (0 = LEDs off). The ADF controller can send it from its brightness pot, which is switched off for the moment |

## Messages from the ADF controller to the PC (UDP 27003)

`ADF_FREQ:<kHz>` (190 to 1799, sent 250 ms after the knobs stop), `RADAR_FOLLOW_ID:<digits>` (`RADAR_FOLLOW_ID:0` = stop following) and `POWER,V12:<volts>,V5:<volts>,STATUS:<OK, or 5V_LOW, 5V_HIGH, 12V_LOW, 12V_HIGH joined with +>` every 30 seconds. Also `UPPER_KEY:<key>` for each press on the Upper keypad and `SQUAWK_SET:<4 digits>` when a squawk is entered on the ADF keypad. The FSUIPC bridge reads all of them (`ADF_FREQ` sets the ADF, `UPPER_KEY:*` toggles the ATC menu, `SQUAWK_SET` sets the transponder); the MSFS bridge reads `ADF_FREQ`; the DCS and X-Plane bridges do not read the port.

## Aircraft information to the GPS interface (UDP 27002)

`D,LAT:<deg>,LON:<deg>,ALT:<feet>,IAS:<knots>,HDG:<degrees true>,UTC:<yyyyMMddHHmmss[.fff]>`, every 500 ms from a bridge or the bench tester. Any subset of keys is accepted; a CSV form `lat,lon,altitude_ft,airspeed_kt,heading_deg[,utc]` also works. South and west are negative.

## Messages from the Radio controller to the bridge (UDP 27001)

`COM1_RADIO_SWAP`, `COM2_RADIO_SWAP`, `NAV1_RADIO_SWAP`, `NAV2_RADIO_SWAP`, `AVIONICS_MASTER_SET`, `MASTER_BATTERY_ON`, `MASTER_BATTERY_OFF`, `ALTERNATOR_ON`, `ALTERNATOR_OFF`, `COM2_STANDBY:<MHz>`, `NAV1_STANDBY:<MHz>`, `NAV2_STANDBY:<MHz>` and a bare number for the COM1 standby frequency. The ADF controller also sends the positions of its toggle switches as values: `GEAR_SET:1/0` (gear down / up), `FLAPS_SET:1/0` (flaps fully down / up) and `SPOILERS_SET:1/0` (speed brakes fully out / in), on every change and every 5 seconds. The Radio controller also sends the Auto Pilot and Audio panel controls and the ADF controller the gear, flaps, speed brake and brake controls, each as the name of the simulator control with an optional `:N` repeat count: `AP_MASTER`, `AP_HDG_HOLD`, `AP_NAV1_HOLD`, `AP_ALT_HOLD`, `AP_APR_HOLD`, `TOGGLE_FLIGHT_DIRECTOR`, `AP_BC_HOLD`, `AP_PANEL_SPEED_HOLD`, `VOR1_OBI_INC`, `VOR1_OBI_DEC`, `AP_ALT_VAR_INC`, `AP_ALT_VAR_DEC`, `AP_VS_VAR_INC`, `AP_VS_VAR_DEC`, `AP_SPD_VAR_INC`, `AP_SPD_VAR_DEC`, `HEADING_BUG_INC`, `HEADING_BUG_DEC`, `COM1_TRANSMIT_SELECT`, `COM2_TRANSMIT_SELECT`, `COM_RECEIVE_ALL_TOGGLE`, `RADIO_VOR1_IDENT_TOGGLE`, `RADIO_VOR2_IDENT_TOGGLE`, `RADIO_DME1_IDENT_TOGGLE`, `RADIO_ADF_IDENT_TOGGLE`, `MARKER_SOUND_TOGGLE`, `GEAR_UP`, `GEAR_DOWN`, `FLAPS_UP`, `FLAPS_DOWN`, `SPOILERS_ON`, `SPOILERS_OFF` and `PARKING_BRAKES`.

# Appendix B: Building and flashing {-}

## Libraries

Ethernet 2.0.2 with SPI, AccelStepper 1.64.0 (steppers), Servo and Ewma (Servo controller), U8g2 and Wire (OLEDs), DCS-BIOS 0.3.13 (sketches that still carry DCS-BIOS code), and the Joystick and Keyboard libraries for the HID board. Install them from the Arduino Library Manager.

## Compile and upload

Flashing a board

```
arduino-cli compile --fqbn arduino:avr:mega "Jet Ranger Arduino Sketches\JET_RANGER_STEPPER_CONTROLLER"
arduino-cli upload -p COM4 --fqbn arduino:avr:mega "Jet Ranger Arduino Sketches\JET_RANGER_STEPPER_CONTROLLER"
```

Use `--fqbn arduino:avr:leonardo` for the USB HID board. Close the Arduino IDE serial monitor first: it holds the port ("Access is denied"). Check the port with Device Manager or `arduino-cli board list`.

## Firmware versions

Every controller sketch has a firmware version, a build number and the compile date and time. The three constants are at the top of the sketch, next to its debug function:

```
#define FIRMWARE_NAME "Radio Controller"
#define FIRMWARE_VERSION "1.0"
#define FIRMWARE_BUILD 2
```

**The rule: raise `FIRMWARE_BUILD` by one every time a sketch is changed** (and `FIRMWARE_VERSION` for a larger change), before it is compiled and flashed. The compile date and time (`__DATE__` and `__TIME__`) change on every compile by themselves, so a board that reports an older date than the compile you just made has old code on it.

The board sends one line to the debug stream (UDP 27000) straight after *Ethernet Started* in its start-up sequence, and again whenever it receives the control packet `C,VERSION:1`, so the version can be checked without resetting it (the USB HID board sends it to its logging port):

```
Radio Controller firmware 1.0 build 15 compiled Nov  8 2026 09:50:00
```

(each board's debug function puts its own name in front of the line). The start-up line is only seen if the debug listener is already running when the board starts; otherwise send `C,VERSION:1` to the board. The version is also in every heartbeat to the Health Monitor, as ` FW:1.0.2` (version 1.0, build 2), and the Health Monitor shows it in the **Firmware** column of its voltage table, so the code on every board can be checked at a glance.

| Controller | Sketch | `FIRMWARE_NAME` | Version and build now (all but the USB HID board flashed 7 and 8 November 2026) |
|---|---|---|---|
| Radio controller .101 | `JET_RANGER_RADIO_CONTROLLER` | Radio Controller | 1.0 build 15 |
| Servo controller .102 | `JET_RANGER_SERVO_CONTROLLER` | Servo Controller | 1.0 build 6 |
| Stepper controller .105 | `JET_RANGER_STEPPER_CONTROLLER` | Stepper Controller | 1.0 build 5 |
| Dual Stepper controller .106 | `JET_RANGER_OLED_DUAL_STEPPER_CONTROLLER` | OLED Dual Stepper Controller | 1.0 build 7 |
| ADF and Upper controller .107 | `JET_RANGER_ADF_CONTROLLER` | ADF and Upper Controller | 1.0 build 13 |
| USB HID board .11 | `UDP_TO_HID` | USB HID Board | 1.0 build 2 |

## COM port to board mapping

Which board is on which COM port

| Board | IP | Hardware | COM port |
|---|---|---|---|
| Radio controller | .101 | Mega 2560 (replacement board) | COM20 |
| Servo controller | .102 | Mega 2560 clone | COM16 |
| Stepper controller | .105 | Mega 2560 | COM4 |
| Dual stepper controller | .106 | Mega 2560 | COM5 |
| ADF and Upper controller (combined) | .107 | Mega 2560 | COM26 |
| USB HID board | .11 | Arduino Leonardo | COM8 |

The Lowrance GPS cable is not one of these boards: the GPS interface asks for its serial port the first time it runs and remembers it. These are the ports used at the last flash of each board. They follow the USB socket and the board: the Servo clone has no USB serial number, so its COM number is tied to the socket it is plugged into, and a replaced Mega gets a new number. Check before every upload.

## Sketch settings to know about

- Per-gauge `SwingXXX` gates and `SwingLoops` near the top of the Stepper and Dual Stepper sketches control which swings run at boot.
- Zero trims (`<CODE>ZeroOffset`, `TSoffset`, `RSoffset`) are set near the top of the same sketches.
- Every sketch has `reflectorIP` (172.16.1.10) for debug and heartbeat traffic.

# Appendix C: Calibration {-}

The calibration loop

Between table points the boards interpolate in a straight line and hold the end value beyond the ends.

1. Send a **raw** value (`D,TQRAW:300`) to move the needle to a raw step or servo position.
2. Read the dial against its printed scale.
3. Repeat at three or more points (zero, mid scale, full scale).
4. Edit the calibration table in the sketch.
5. Compile and upload.
6. Send **real** values (`D,TQ:60`) and confirm the dial.

The StepperVSITester sends every raw and real token without a simulator. Do not drive a gauge hard against its stop: a stalled stepper or servo draws high current and gets hot. After any mechanical change to a gauge, recheck its table and zero trim.

# Appendix D: How this document is built {-}

This document and the User Guide are generated, not typeset by hand. The sources are Markdown files and vector diagrams in `Jet Ranger Documentation/DocBuild`:

| Item | Purpose |
|---|---|
| `src/master/*.md`, `src/guide/*.md` | Text of this document and the User Guide |
| `diagrams_a.py` to `diagrams_e.py`, `svgdraw.py`, `make_diagrams.py` | The 35 diagrams, written as Python functions that draw SVG; `python make_diagrams.py` regenerates them |
| `build_docs.py`, `run_lo.ps1` | Builds the `.odt` and `.pdf` through LibreOffice's Python interface (`run_lo.ps1 build_docs.py master`) |
| `export_pcb_images.py`, `pcb_to_jpg.ps1` | The schematic and layout pictures of Appendix E, drawn from the KiCad files |
| `export_install_views.py`, `trim_to_jpg.ps1` | The installation views of Appendix F (top side, external connectors labelled) and the text of that appendix, drawn from the KiCad layout files |
| `make_instrument_map.py` | The instrument map of Appendix G (the A3 drawing as SVG, PDF and PNG, the readable crops used in the document, and the text of the appendix) |
| `pdf2png.ps1`, `montage.ps1`, `svg2png.py` | Helpers for checking pages and diagrams visually |

To change a diagram edit its function and rebuild; to change text edit the Markdown and rebuild. Keep `PROGRAM_SUMMARY.md` files and these sources in step after a code change.
