bnepethomas/bne-arduino-flight-simulator-interfaces/Jet Ranger/Jet Ranger Documentation/DocBuild/src/guide/06_pcb_drawings.md

# PCB schematics and layouts

The schematic (the top sheet of each project) and the board layout of every PCB project in `Jet Ranger/PCBs/`, exported from KiCad 9. The layout shows the front and back copper (red and blue), the silkscreen (yellow) and the board outline, viewed from the front. The images are bitmaps: zoom in on the PDF or the document to read the labels, or open the KiCad project for the full detail. The schematic and layout images are regenerated from the KiCad files, so they show the boards as they were on the day the document was built, including any changes not yet committed.

<!-- pagebreak -->

## Jet Ranger Radio Auto Pilot

Revision 1.4 (31 October 2026; the title block shows 1.4, 2026-10-31). Mega shield for the Radio controller (172.16.1.101). Revision 1.4 added the Huey Warning Panel connectors J20 (switches), J21 (backlight), J22 (LED anodes) and J23 (LED cathodes). Carries the USR-ES1 Ethernet module, the TCA9548A I2C multiplexer for the OLEDs, the MAX7219 that lights the 19 Auto Pilot and Audio panel LEDs, the backlight MOSFET (D5), the COM and NAV panel connector (`COMM_NAV`), the `AUTOPILOT` and `AUDIO` panel connectors, five matrix columns and the Auto Pilot knob inputs.

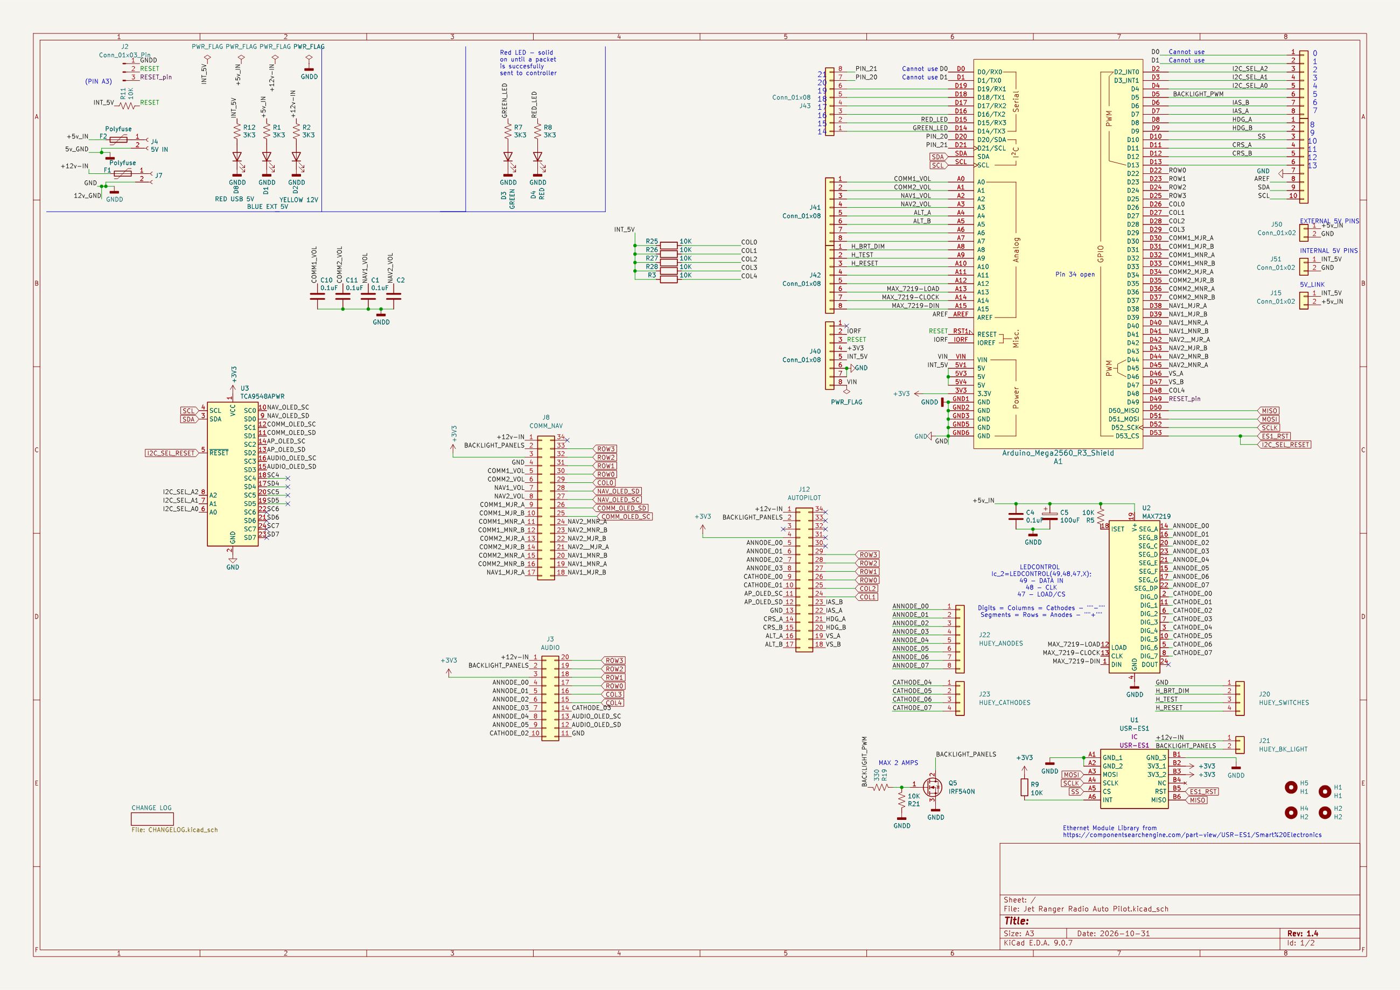
[picture p188: Jet Ranger/Jet Ranger Documentation/DocBuild/pcb/radio_auto_pilot_sch.jpg]
Jet Ranger Radio Auto Pilot schematic


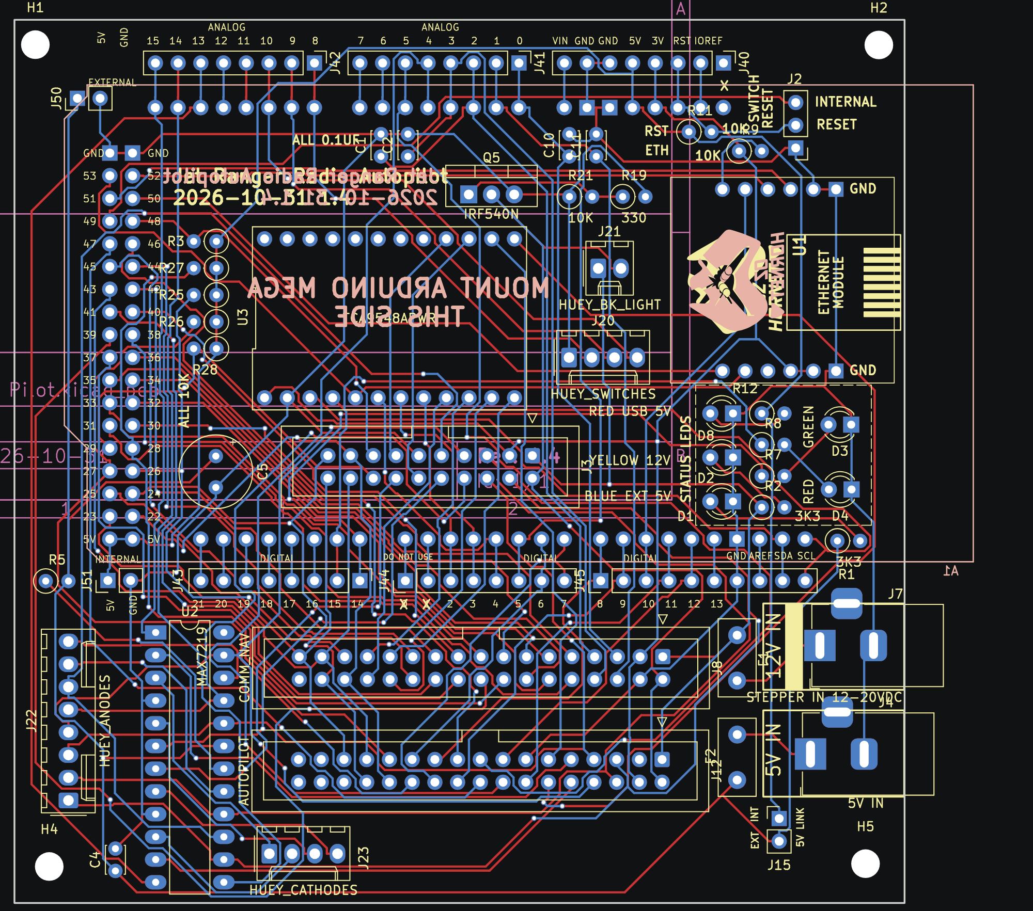
[picture p189: Jet Ranger/Jet Ranger Documentation/DocBuild/pcb/radio_auto_pilot_pcb.jpg]
Jet Ranger Radio Auto Pilot board layout


<!-- pagebreak -->

## Jet Ranger COM and NAV

No revision set (title block dated 2024-08-10). Radio panel board behind the COM and NAV faceplate. Eight rotary encoders (a major and a minor knob for COM1, COM2, NAV1 and NAV2), the four frequency-swap switches in a diode matrix on column 0, four volume pots, and sockets for the two character OLEDs.

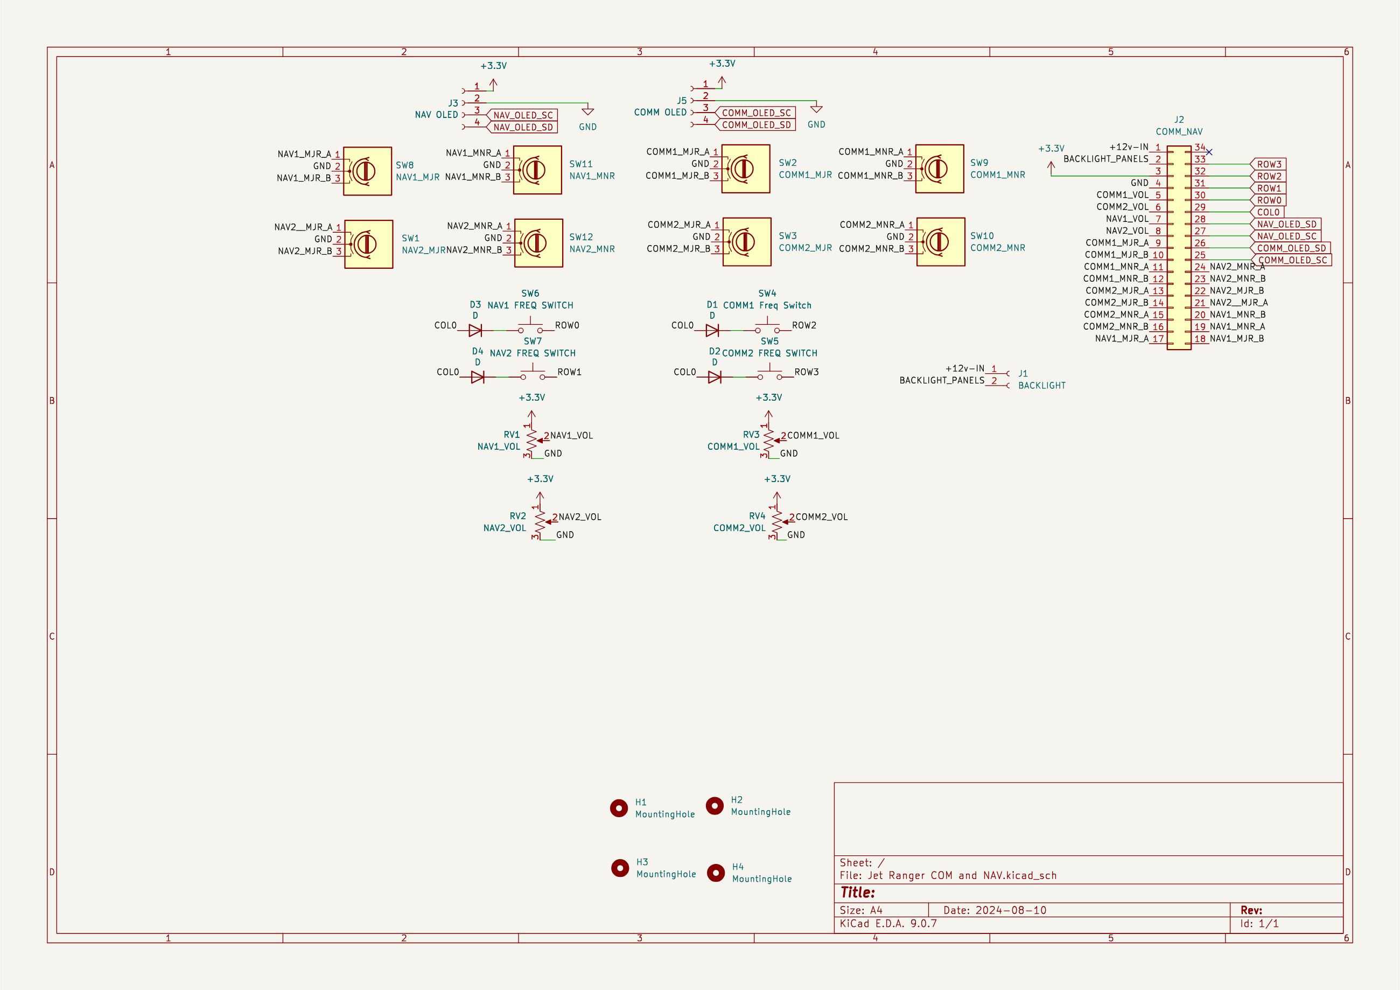
[picture p190: Jet Ranger/Jet Ranger Documentation/DocBuild/pcb/com_and_nav_sch.jpg]
Jet Ranger COM and NAV schematic


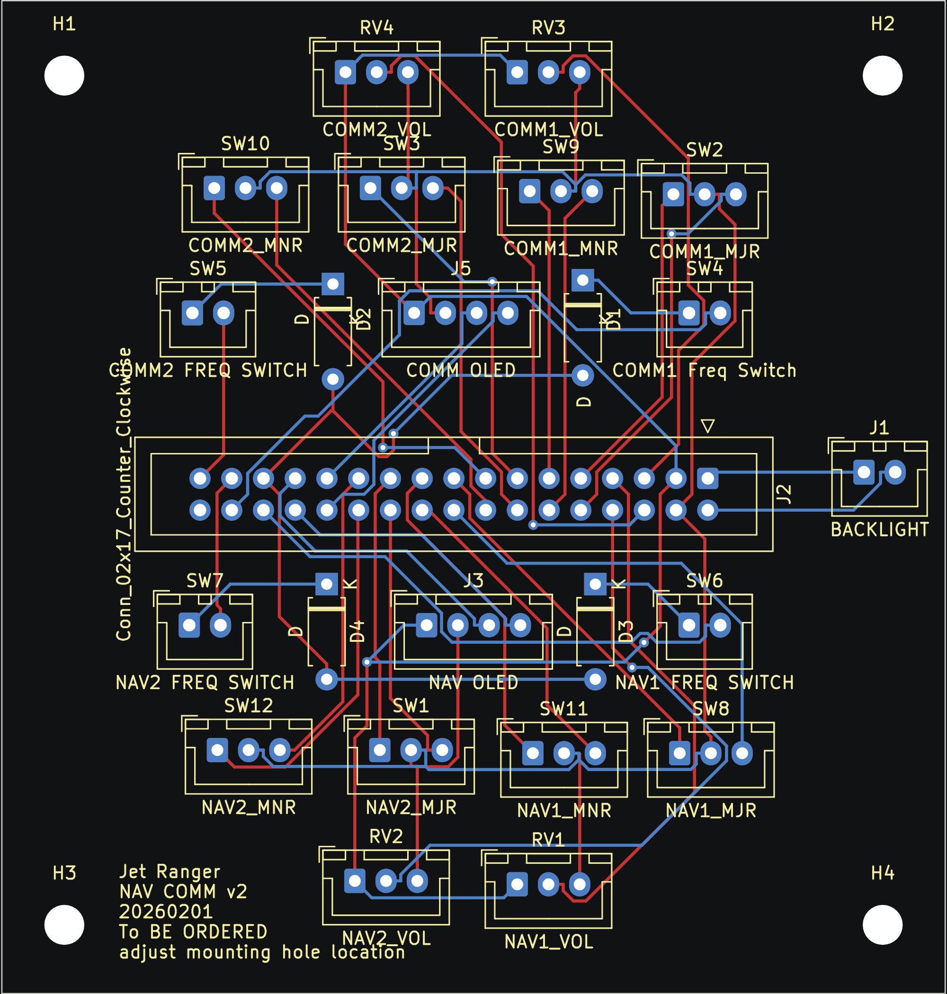
[picture p191: Jet Ranger/Jet Ranger Documentation/DocBuild/pcb/com_and_nav_pcb.jpg]
Jet Ranger COM and NAV board layout


<!-- pagebreak -->

## Jet Ranger Front Panel Servo

Revision 1.4 (2026-10-18). Mega shield for the Servo controller (172.16.1.102). ULN2803A lamp drivers for the 15 warning lamps, headers for the pitch and bank servos, three front-panel switch inputs, the USR-ES1 Ethernet module and the backlight MOSFET. Version 1.4 corrected the MOSFET pin-out.

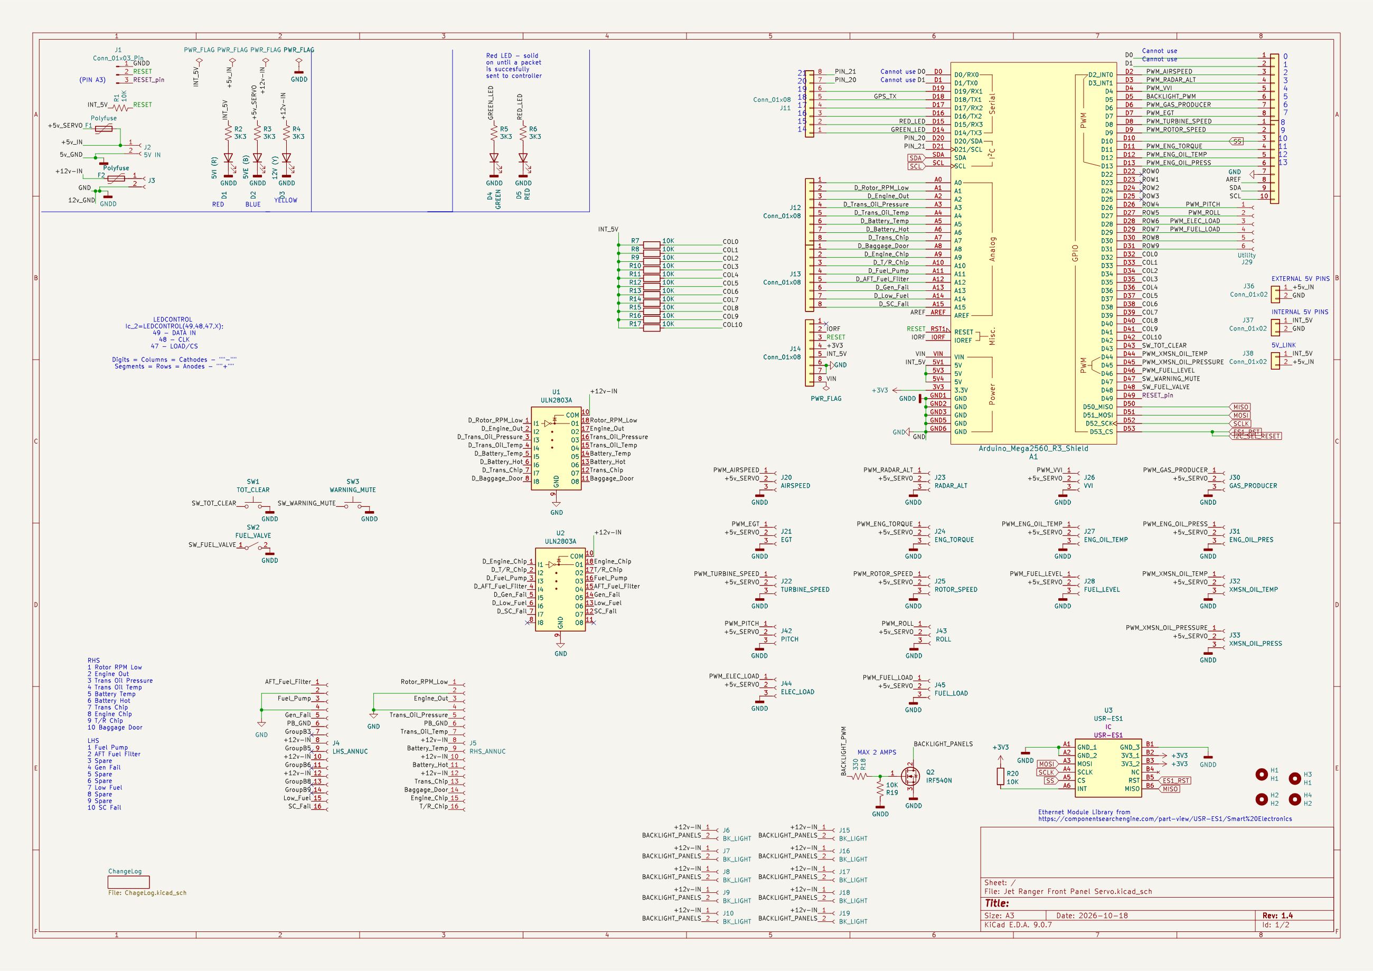
[picture p192: Jet Ranger/Jet Ranger Documentation/DocBuild/pcb/front_panel_servo_sch.jpg]
Jet Ranger Front Panel Servo schematic


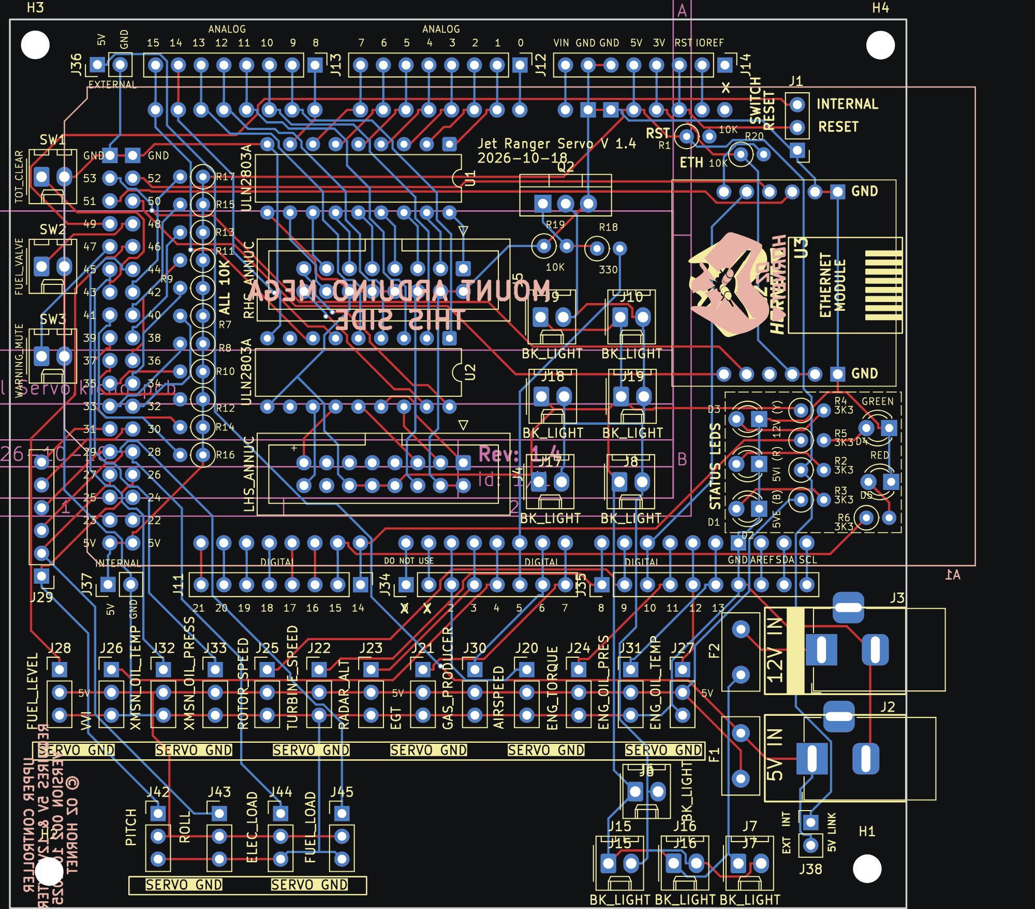
[picture p193: Jet Ranger/Jet Ranger Documentation/DocBuild/pcb/front_panel_servo_pcb.jpg]
Jet Ranger Front Panel Servo board layout


<!-- pagebreak -->

## Jet Ranger 13 Stepper

Title block revision 1.6 (2026-10-18); the change log lists changes up to 1.5. Mega shield for the Stepper controller (172.16.1.105). Fourteen six-pin gauge sockets for the X27 steppers, a 12 V lamp supply with polyfuses, the USR-ES1 Ethernet module and the backlight MOSFET. 1.4 moved the LEDs away from the USB connectors and 1.5 selected the IRF540N.

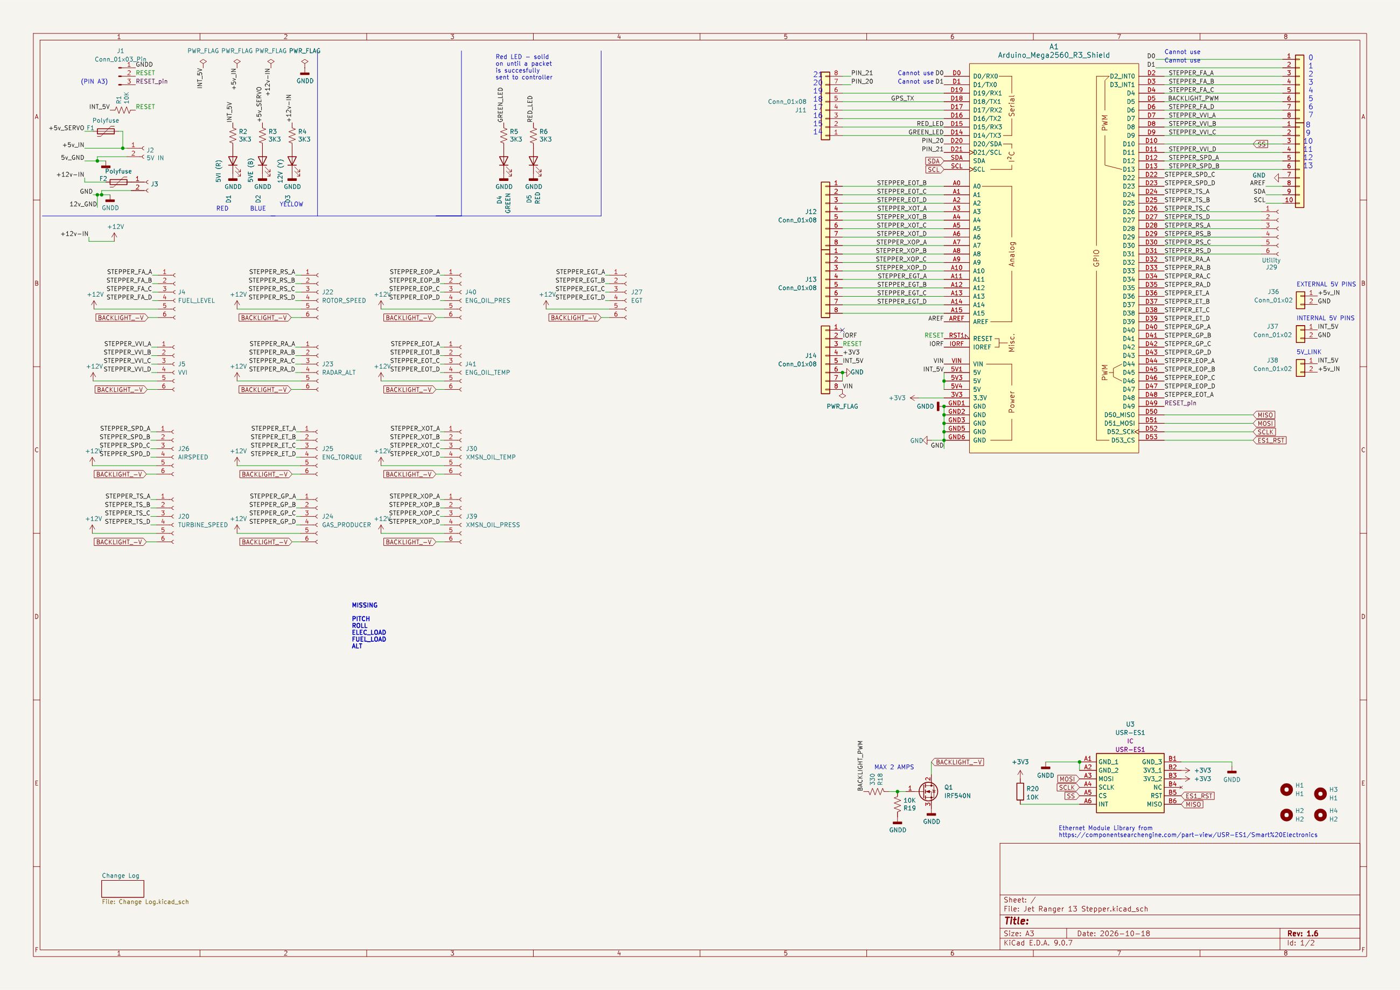
[picture p194: Jet Ranger/Jet Ranger Documentation/DocBuild/pcb/stepper_13_sch.jpg]
Jet Ranger 13 Stepper schematic


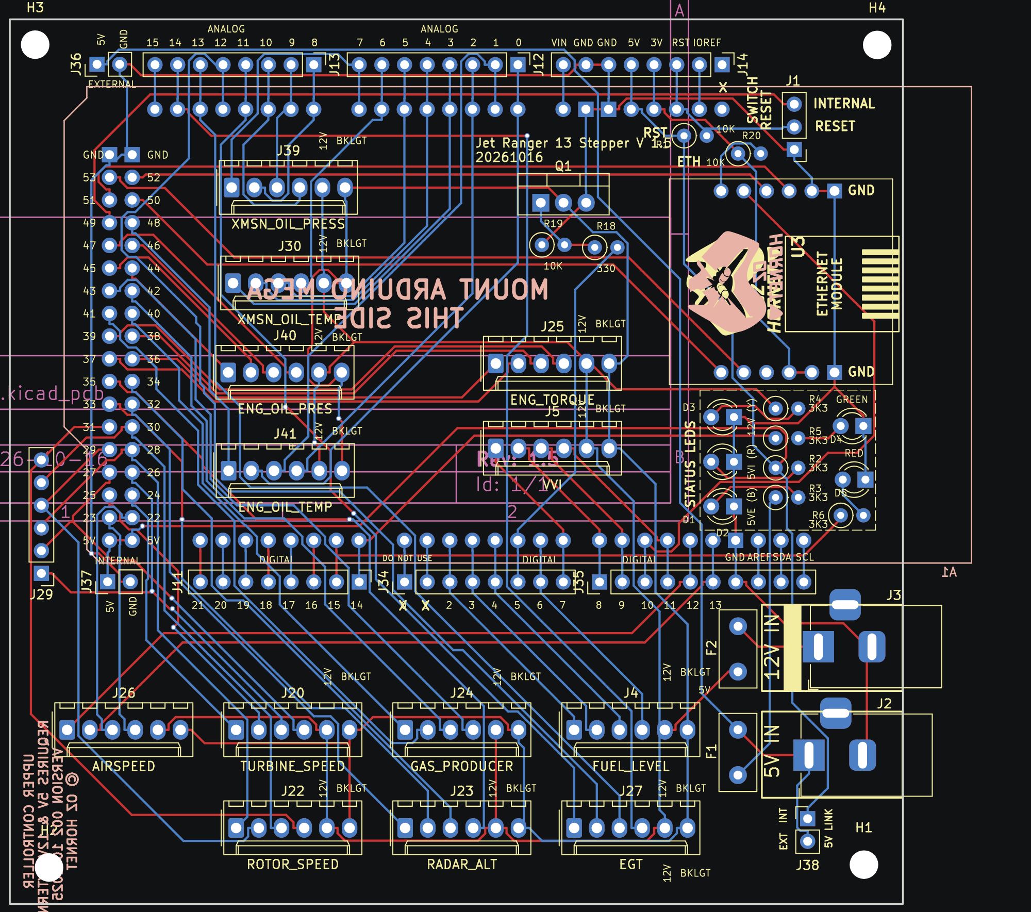
[picture p195: Jet Ranger/Jet Ranger Documentation/DocBuild/pcb/stepper_13_pcb.jpg]
Jet Ranger 13 Stepper board layout


<!-- pagebreak -->

## Jet Ranger OLED Dual Stepper

Revision 1.5 (2026-10-18). Mega shield for the Dual Stepper controller (172.16.1.106). Six-pin gauge sockets for the oil, load, RPM and altimeter gauges, TCA9548A sockets for the four OLEDs (barometer, altimeter, clock, temperature), the USR-ES1 Ethernet module and the backlight MOSFET. 1.3 swapped power and ground on the four-pin OLED connections, 1.4 removed the short between Mega pins 2 and 32 and 1.5 corrected the MOSFET.

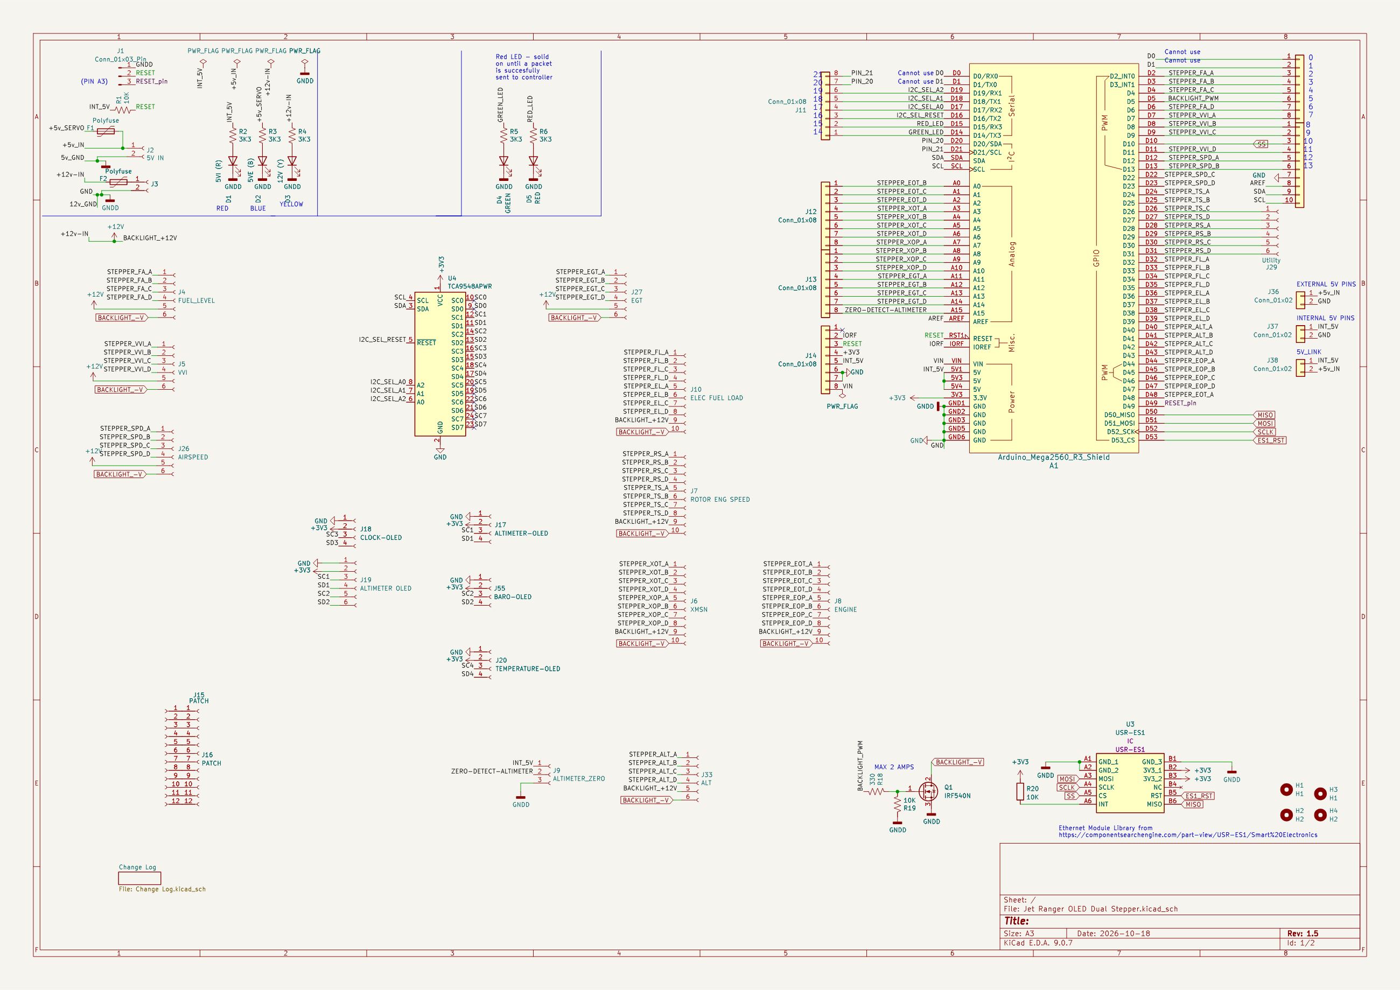
[picture p196: Jet Ranger/Jet Ranger Documentation/DocBuild/pcb/oled_dual_stepper_sch.jpg]
Jet Ranger OLED Dual Stepper schematic


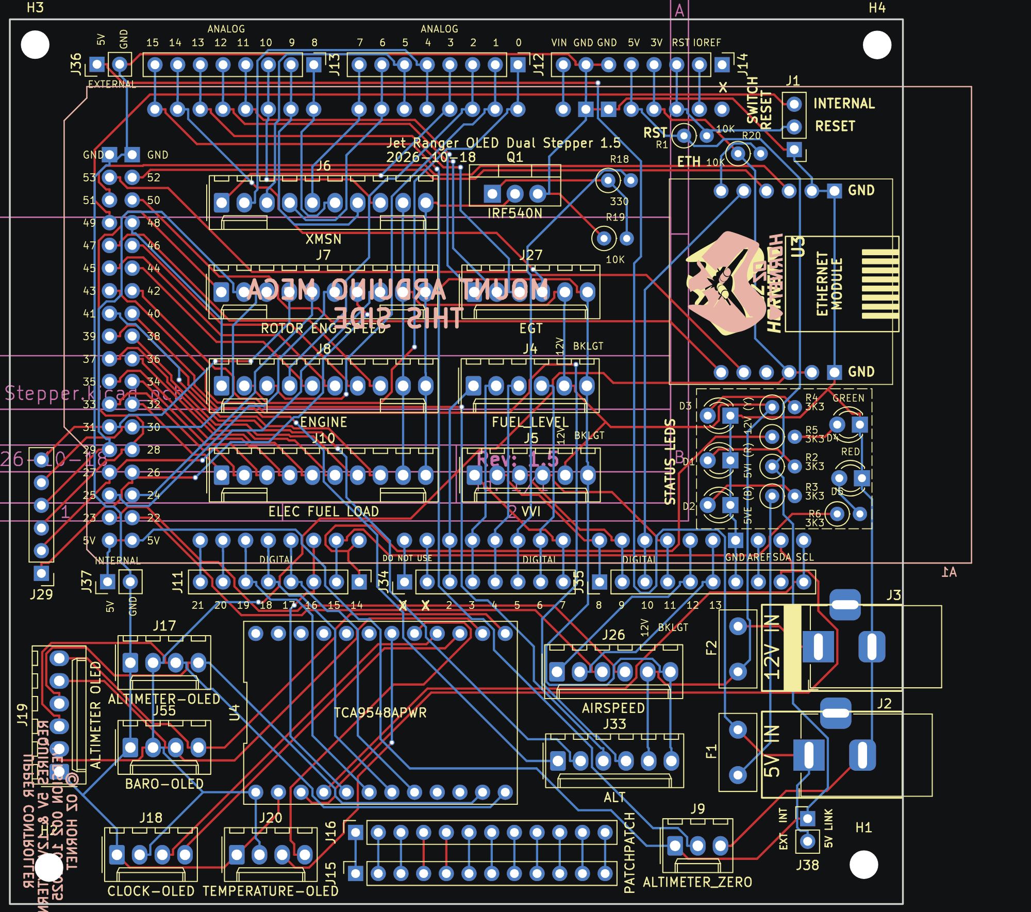
[picture p197: Jet Ranger/Jet Ranger Documentation/DocBuild/pcb/oled_dual_stepper_pcb.jpg]
Jet Ranger OLED Dual Stepper board layout


<!-- pagebreak -->

## Jet Ranger X27 Small Stepper

Title block revision 2 (2022-08-04). One board for each stepper gauge. One X27 or VID29 stepper motor, two backlight LEDs with a 470 ohm resistor (the schematic value, see the backlight resistor table) and the six-pin connector to the controller.

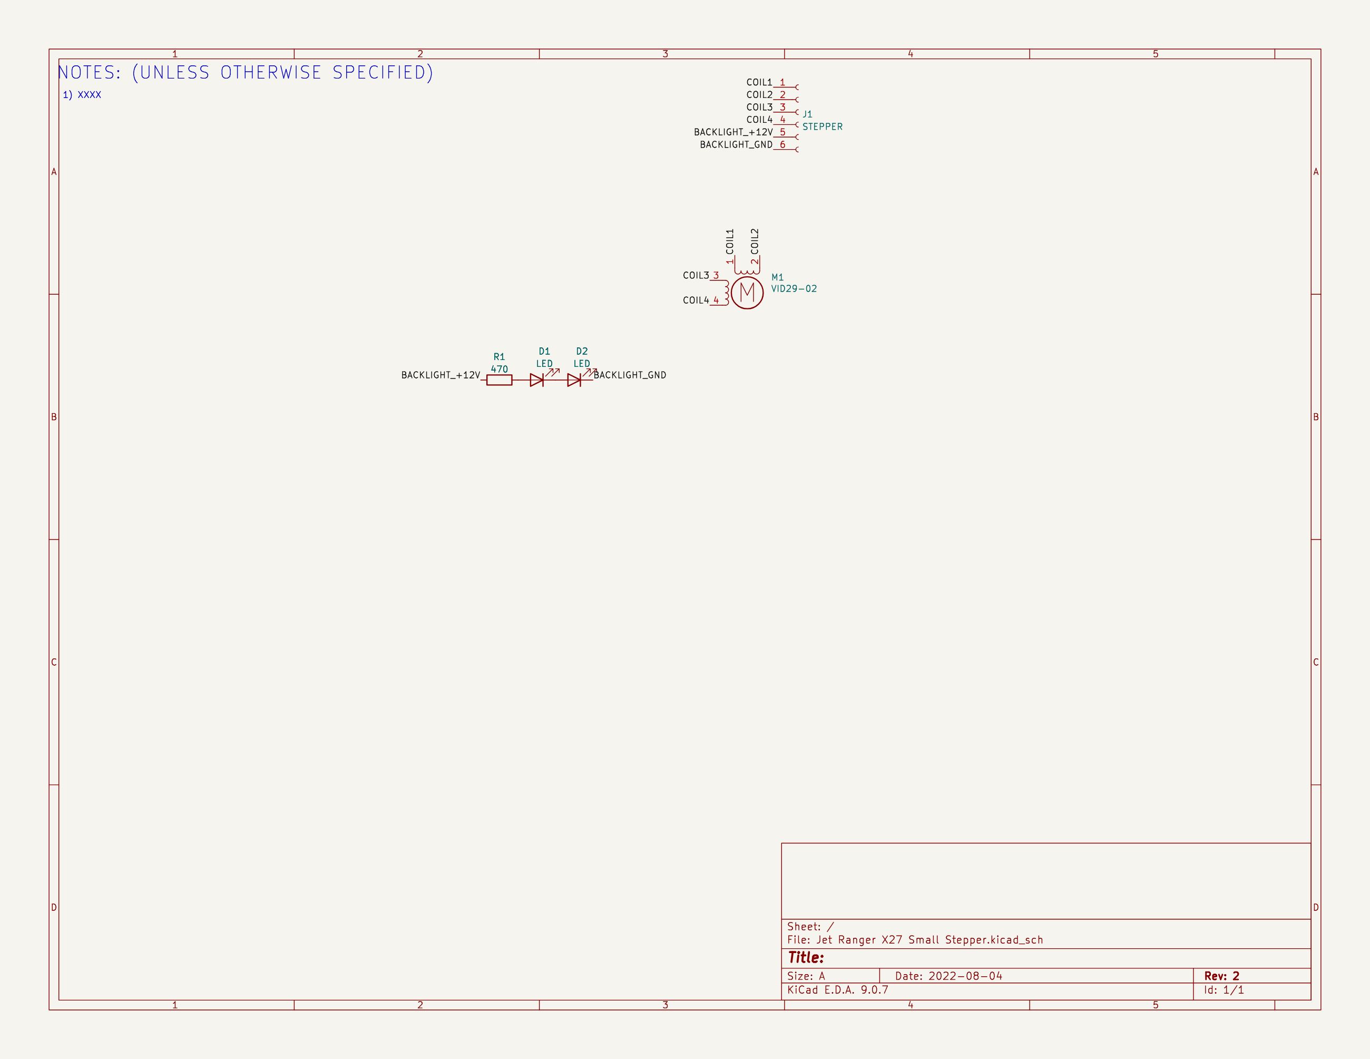
[picture p198: Jet Ranger/Jet Ranger Documentation/DocBuild/pcb/x27_small_stepper_sch.jpg]
Jet Ranger X27 Small Stepper schematic


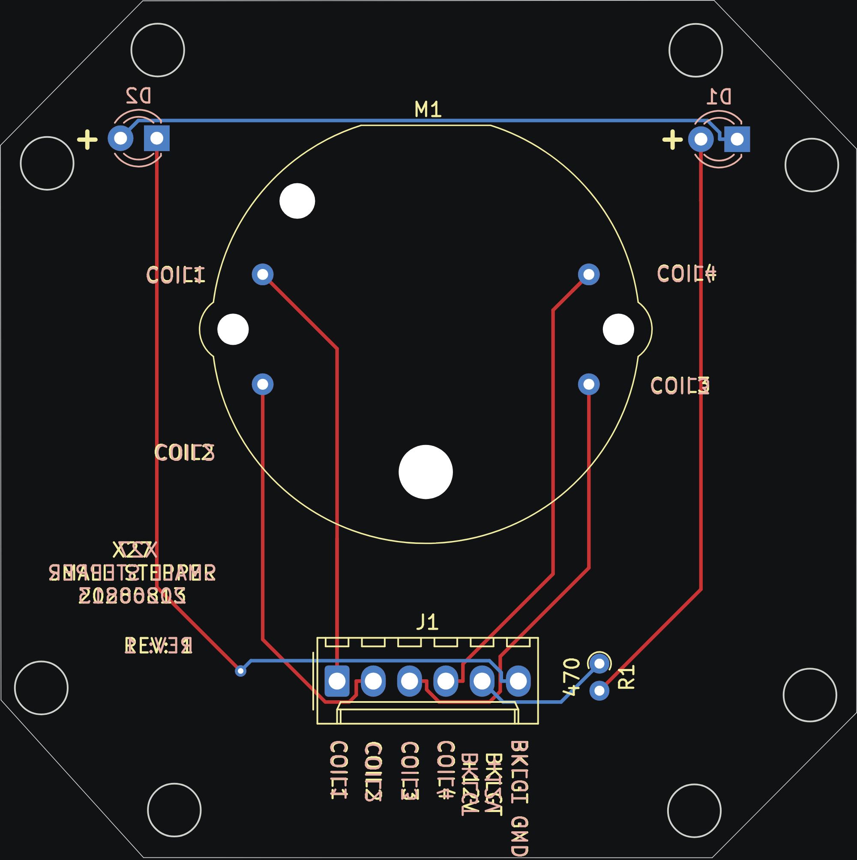
[picture p199: Jet Ranger/Jet Ranger Documentation/DocBuild/pcb/x27_small_stepper_pcb.jpg]
Jet Ranger X27 Small Stepper board layout


<!-- pagebreak -->

## Jet Ranger Upper ADF Controller

Revision 1.0 (2026-10-26). The combined ADF and Upper controller (172.16.1.107), the reference PCB for the ADF controller. It merges the Jet Ranger Upper Controller (1.4) and the Jet Ranger ADF Controller (1.6) onto one Mega, started from the ADF Controller. The ADF major and minor knobs (D6 to D9), the ADF keypad (A1 to A7, connector J41), the landing gear, flaps, speed brake and brake inputs (D31 to D34), the hyd boost, anti-ice and caution dim inputs (D35 to D37, J20), three landing gear lamps (D2 to D4), the I2C OLED, the Upper switch matrix (rows D22 to D30 on J30, columns D38 to D45 on J31 with 10 k pull-ups), the Upper keypad (A9 to A15, J32), the Warning Mute (J17) and TOT Test (J18) switches, the backlight MOSFET (D5, panel backlight on J33), a panel brightness pot on A0 and a 12 V monitor on A8 (47 k and 10 k divider). The 1x16 breakout headers J9 to J14 were removed to make room. The layout is routed (no unconnected items in KiCad's design rule check).

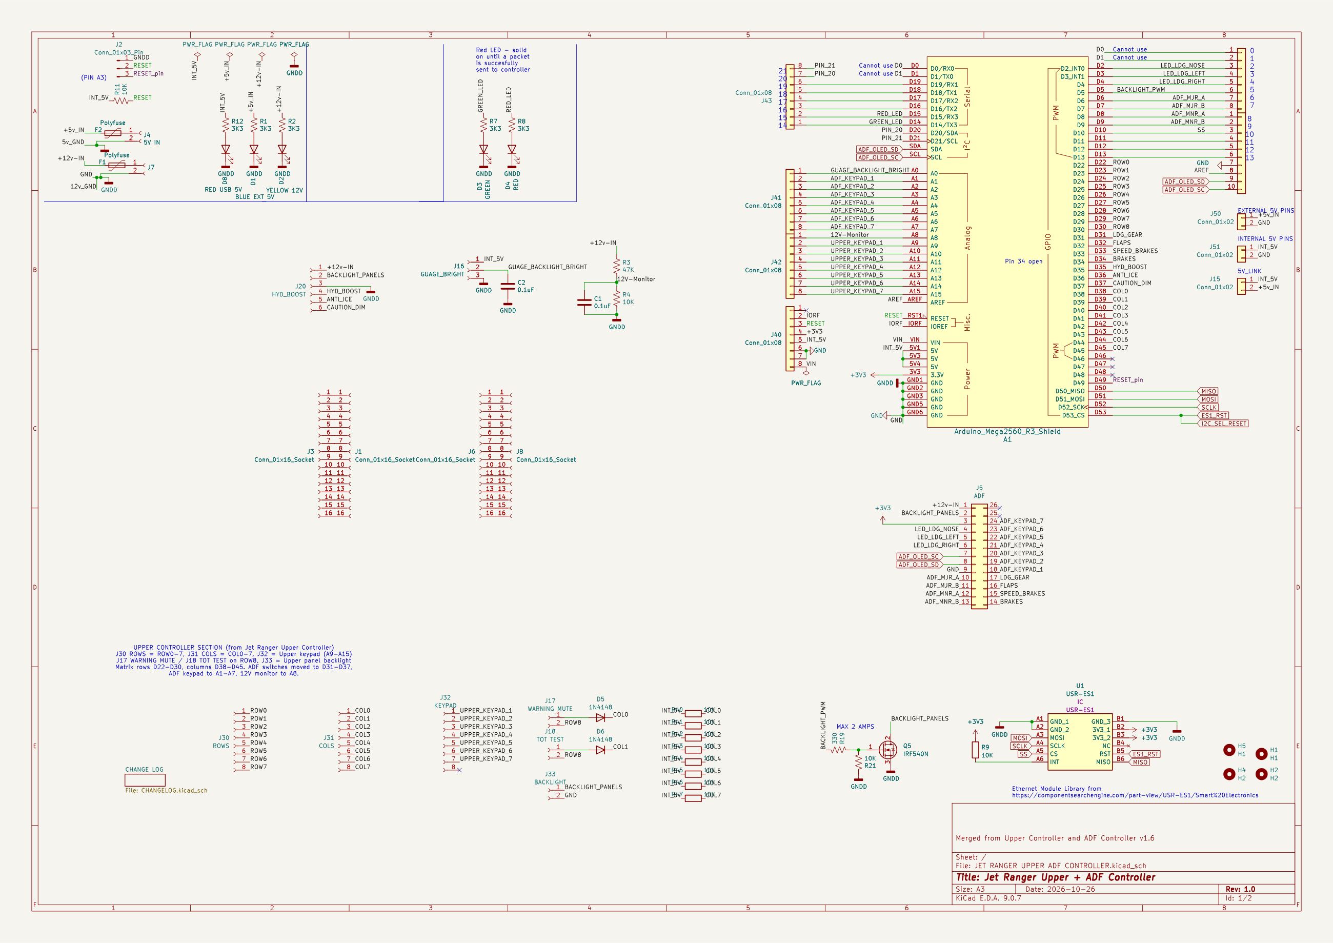
[picture p200: Jet Ranger/Jet Ranger Documentation/DocBuild/pcb/upper_adf_controller_sch.jpg]
Jet Ranger Upper ADF Controller schematic


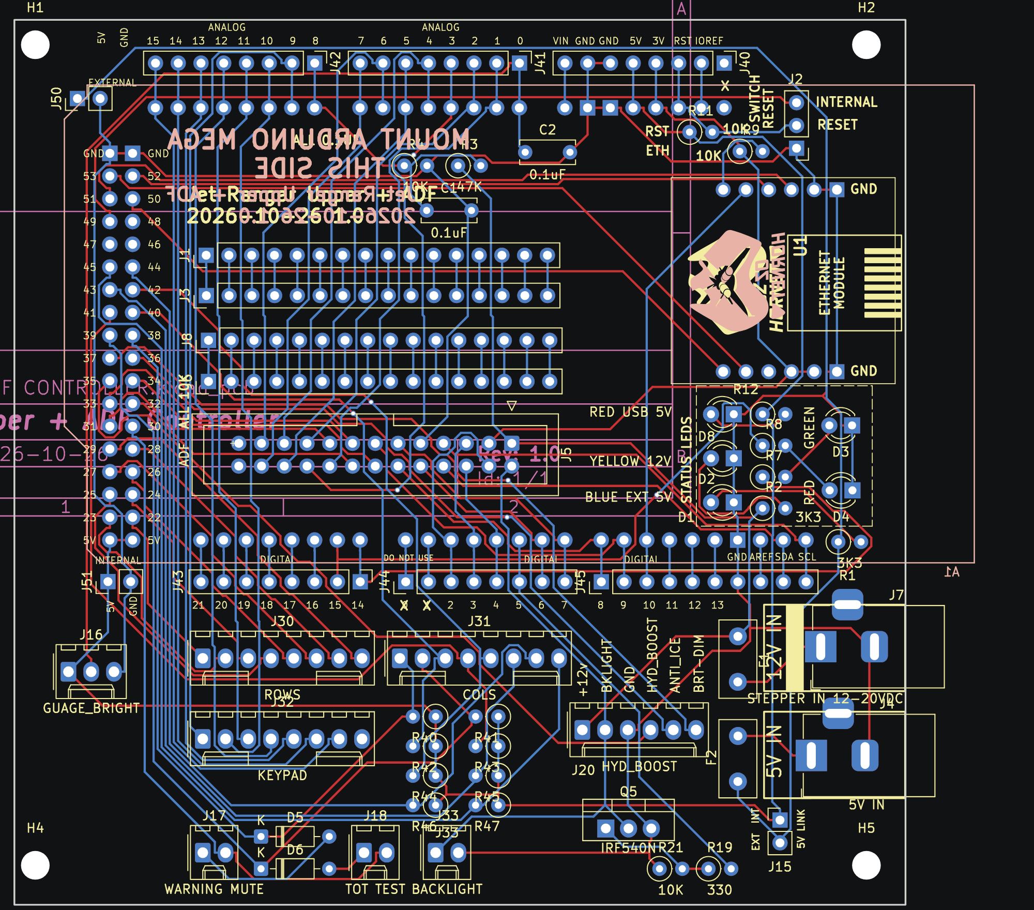
[picture p201: Jet Ranger/Jet Ranger Documentation/DocBuild/pcb/upper_adf_controller_pcb.jpg]
Jet Ranger Upper ADF Controller board layout


<!-- pagebreak -->

## Jet Ranger Audio Panel

Revision 1.1 (2026-10-17). Switch panel for the Radio Auto Pilot controller's `AUDIO` connector. Eight switches in a diode matrix on columns 3 and 4 (COM1, BOTH, NAV2, DME, COM2, NAV1, MKR, ADF), eleven LEDs on the MAX7219 digits 2 and 3, a connector for the Audio panel OLED and the backlight connector.

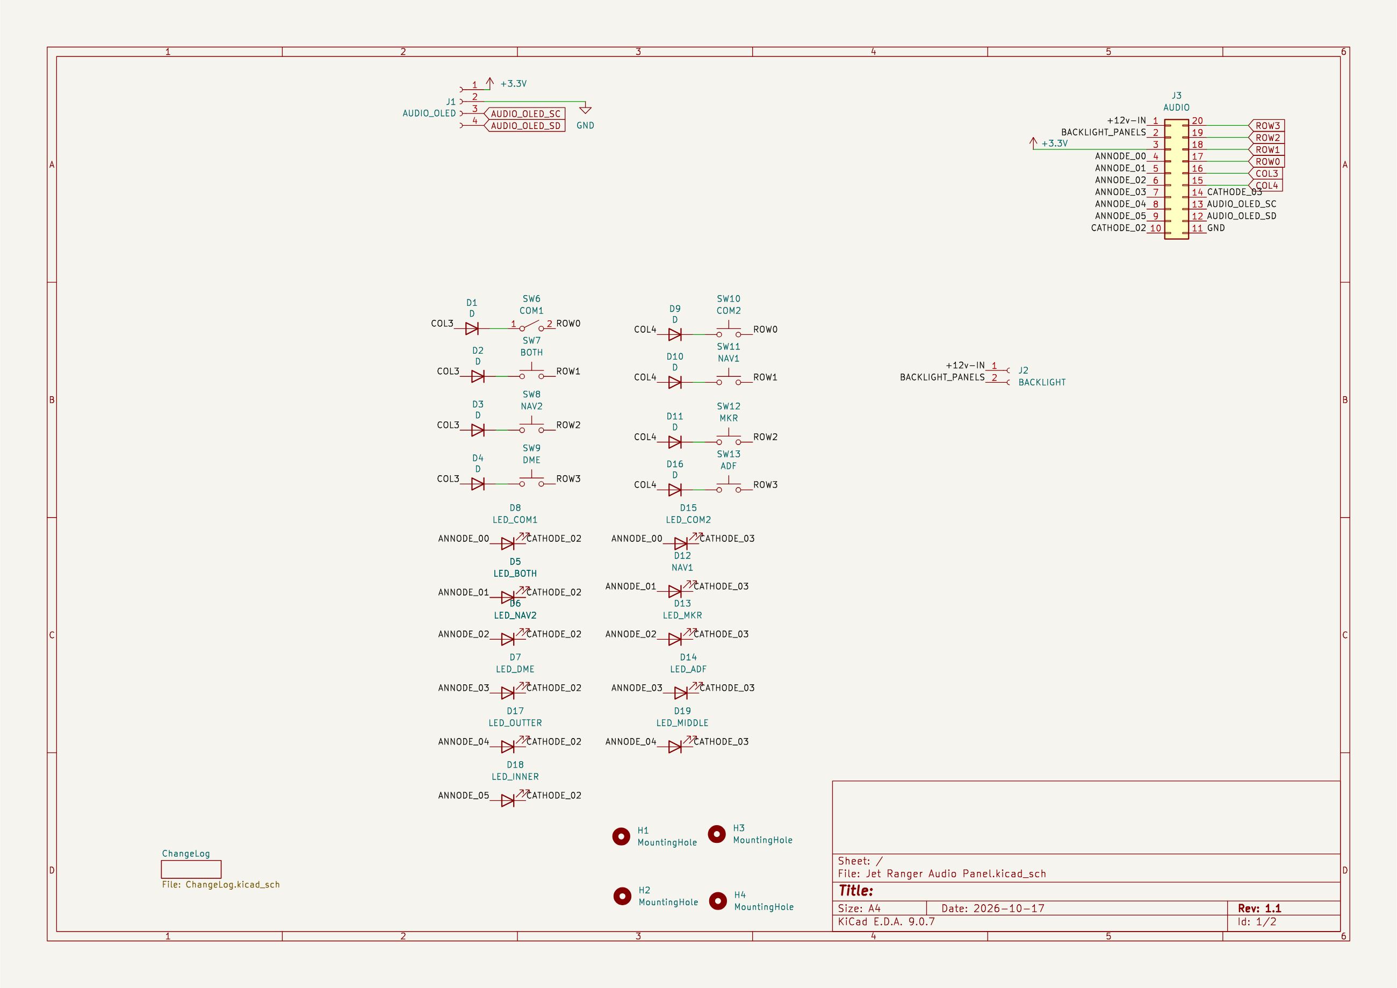
[picture p202: Jet Ranger/Jet Ranger Documentation/DocBuild/pcb/audio_panel_sch.jpg]
Jet Ranger Audio Panel schematic


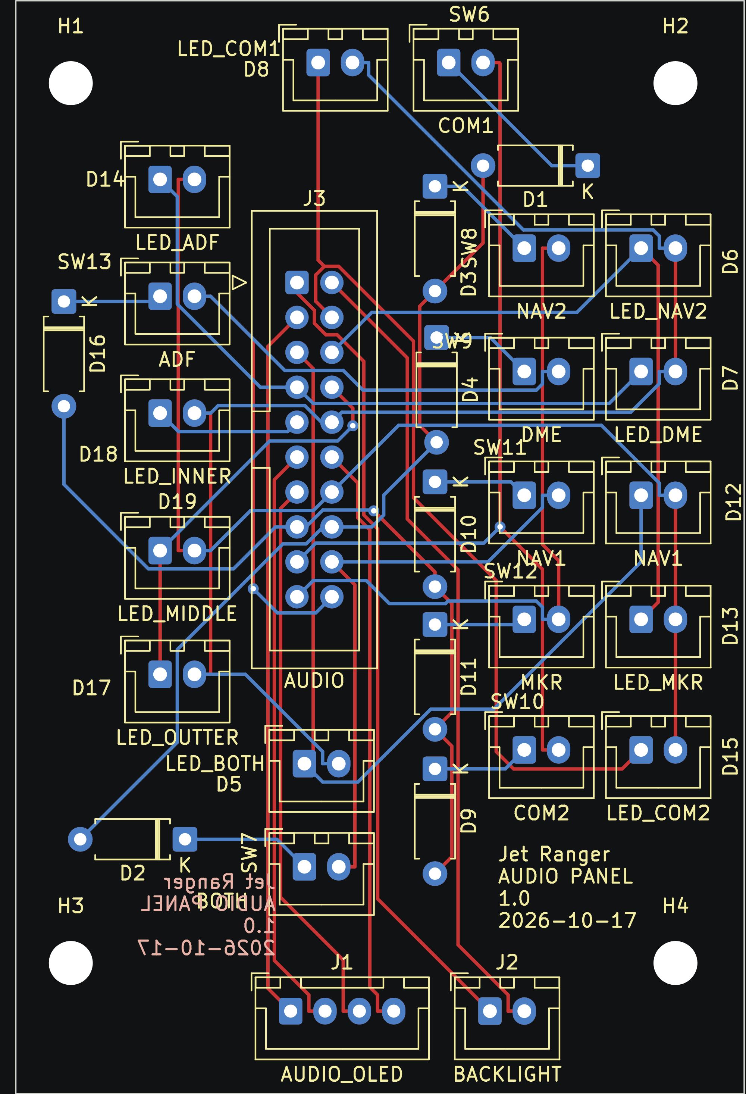
[picture p203: Jet Ranger/Jet Ranger Documentation/DocBuild/pcb/audio_panel_pcb.jpg]
Jet Ranger Audio Panel board layout


<!-- pagebreak -->

## Jet Ranger Auto Pilot Panel

Revision 1.1 (2026-10-17). Switch panel for the Radio Auto Pilot controller's `AUTOPILOT` connector. Eight switches in a diode matrix on columns 1 and 2 (AP ENGAGE, HDG, CRS, ALT, APPR, FD, BC, IAS), five rotary encoders (CRS, ALT, VS, IAS, HDG), eight LEDs on the MAX7219 digits 0 and 1, the AP OLED connector, the autopilot magnet coil connection and the backlight connector.

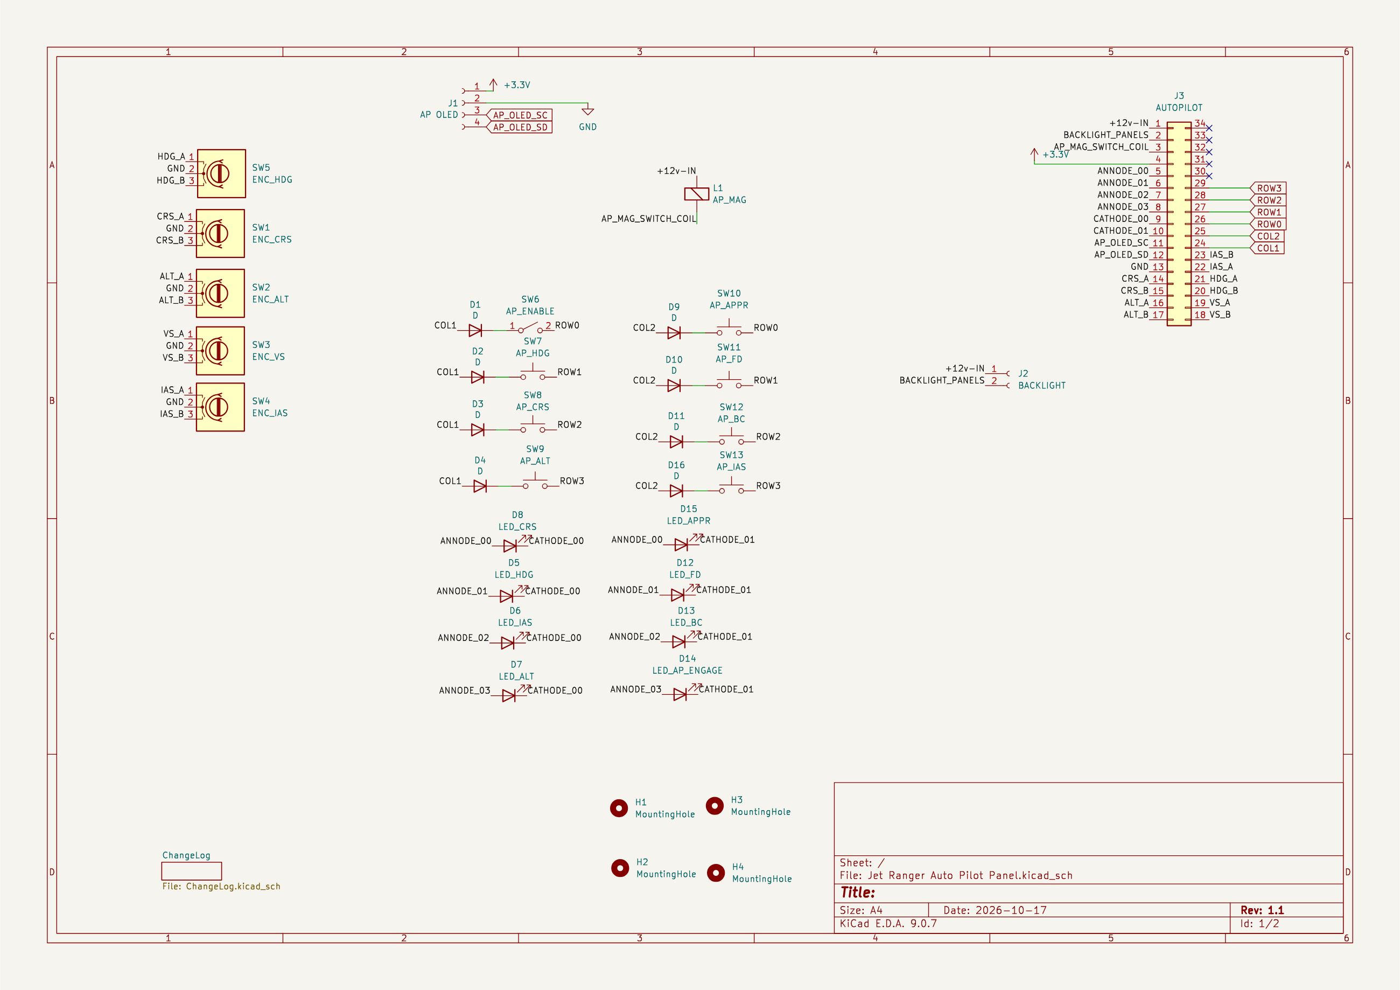
[picture p204: Jet Ranger/Jet Ranger Documentation/DocBuild/pcb/auto_pilot_panel_sch.jpg]
Jet Ranger Auto Pilot Panel schematic


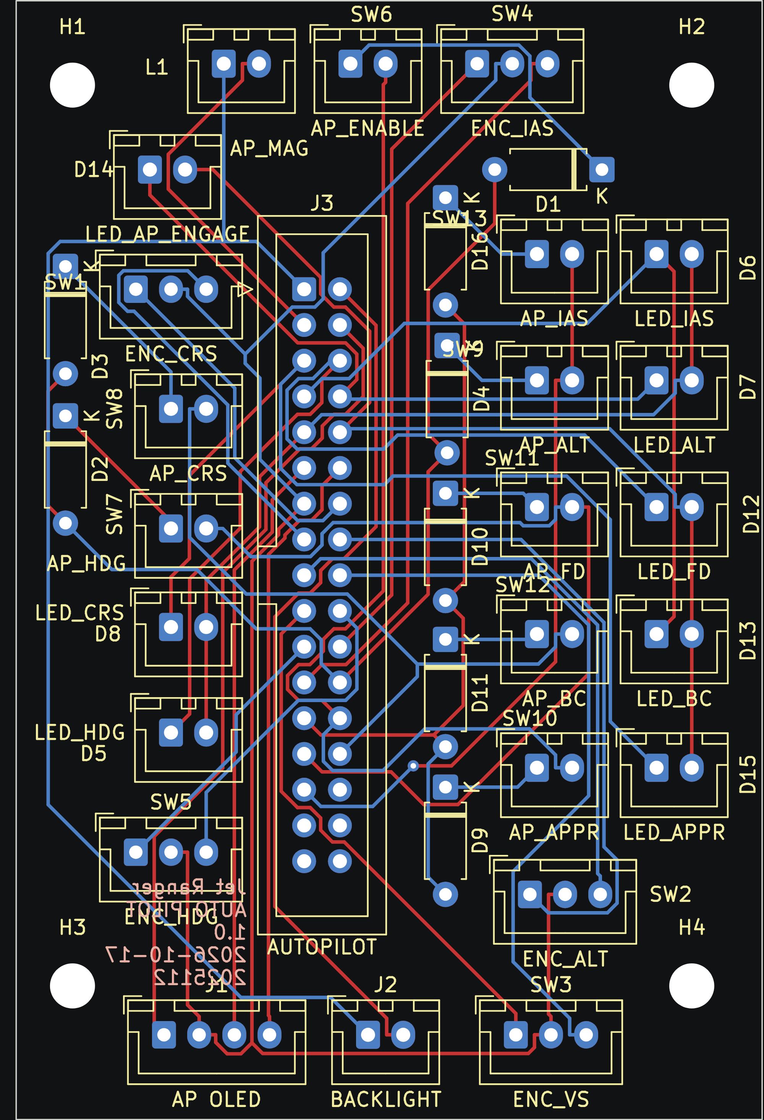
[picture p205: Jet Ranger/Jet Ranger Documentation/DocBuild/pcb/auto_pilot_panel_pcb.jpg]
Jet Ranger Auto Pilot Panel board layout


<!-- pagebreak -->

## Jet Ranger ADF Panel

Revision 1.1 (2026-10-17). Panel for the ADF controller's `ADF` connector. The ADF major and minor encoders, the landing gear, flaps, speed brake and brakes switches, three landing gear lamps with 330 ohm resistors, the keypad connector, the ADF OLED connector and the backlight connector.

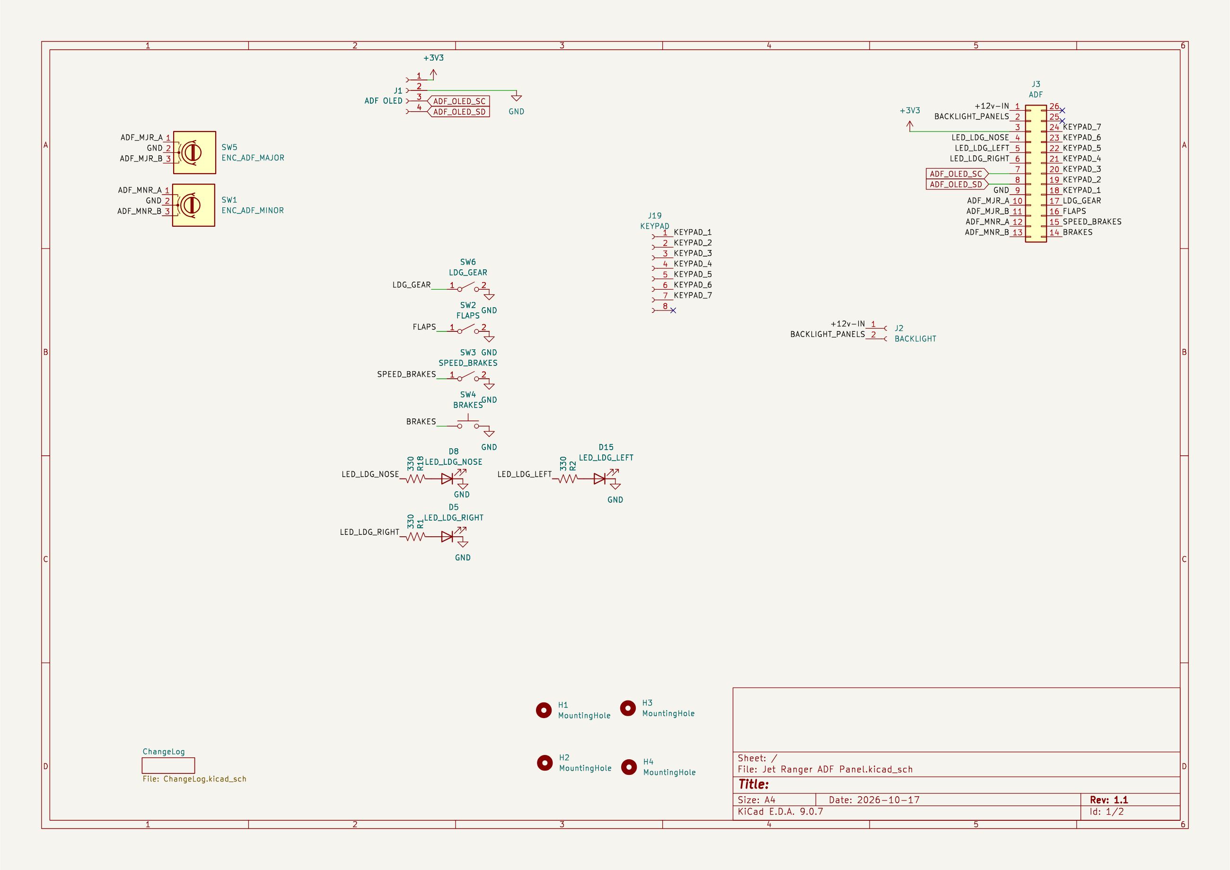
[picture p206: Jet Ranger/Jet Ranger Documentation/DocBuild/pcb/adf_panel_sch.jpg]
Jet Ranger ADF Panel schematic


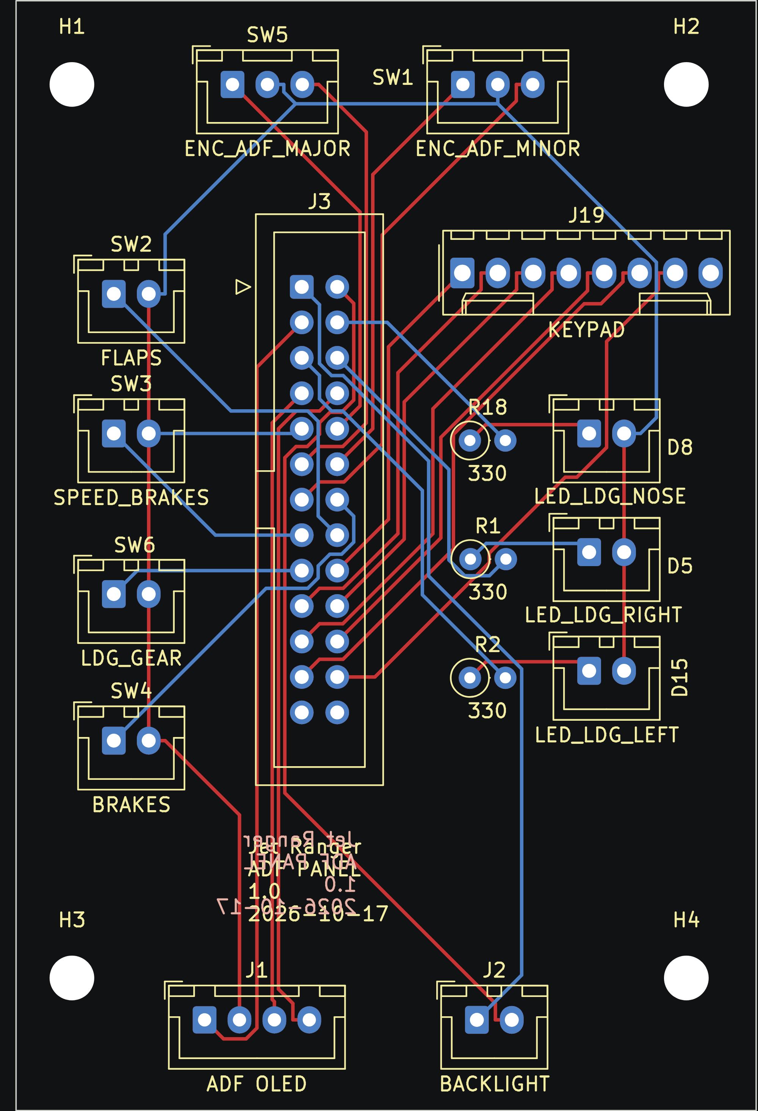
[picture p207: Jet Ranger/Jet Ranger Documentation/DocBuild/pcb/adf_panel_pcb.jpg]
Jet Ranger ADF Panel board layout


<!-- pagebreak -->

## Annunciator

Schematic sheet only: the project has no board layout. The same sheet is used inside the Servo, 13 Stepper and Dual Stepper schematics. Warning lamp annunciator circuit.

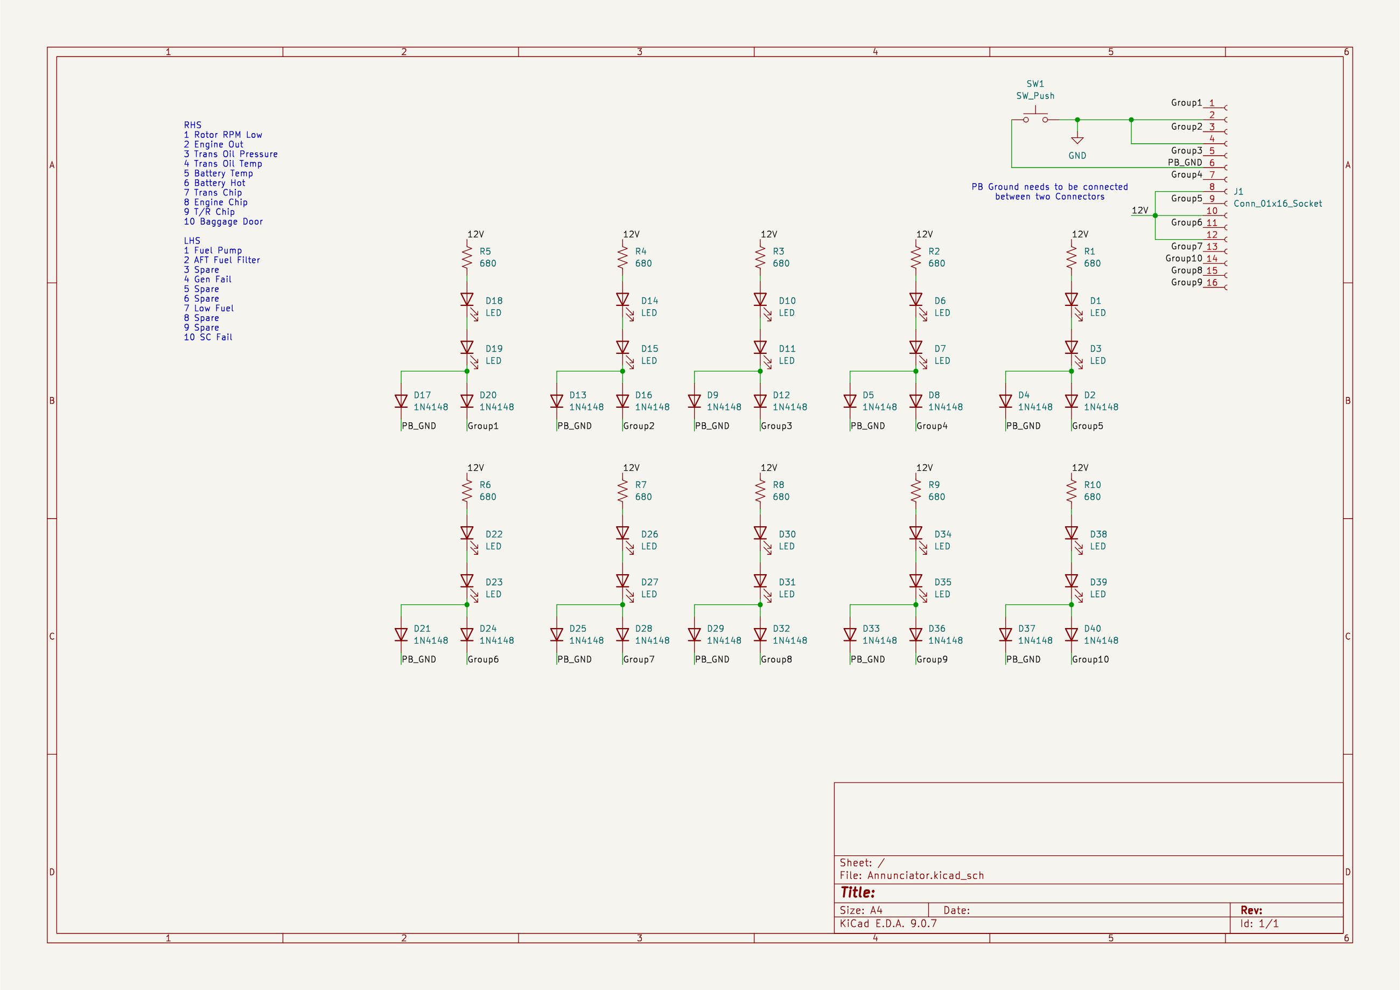
[picture p208: Jet Ranger/Jet Ranger Documentation/DocBuild/pcb/annunciator_sch.jpg]
Annunciator schematic


<!-- pagebreak -->

## Jet Ranger Altimeter

Title block revision 2 (2022-08-04). Not covered by the sketches. Altimeter gauge board.

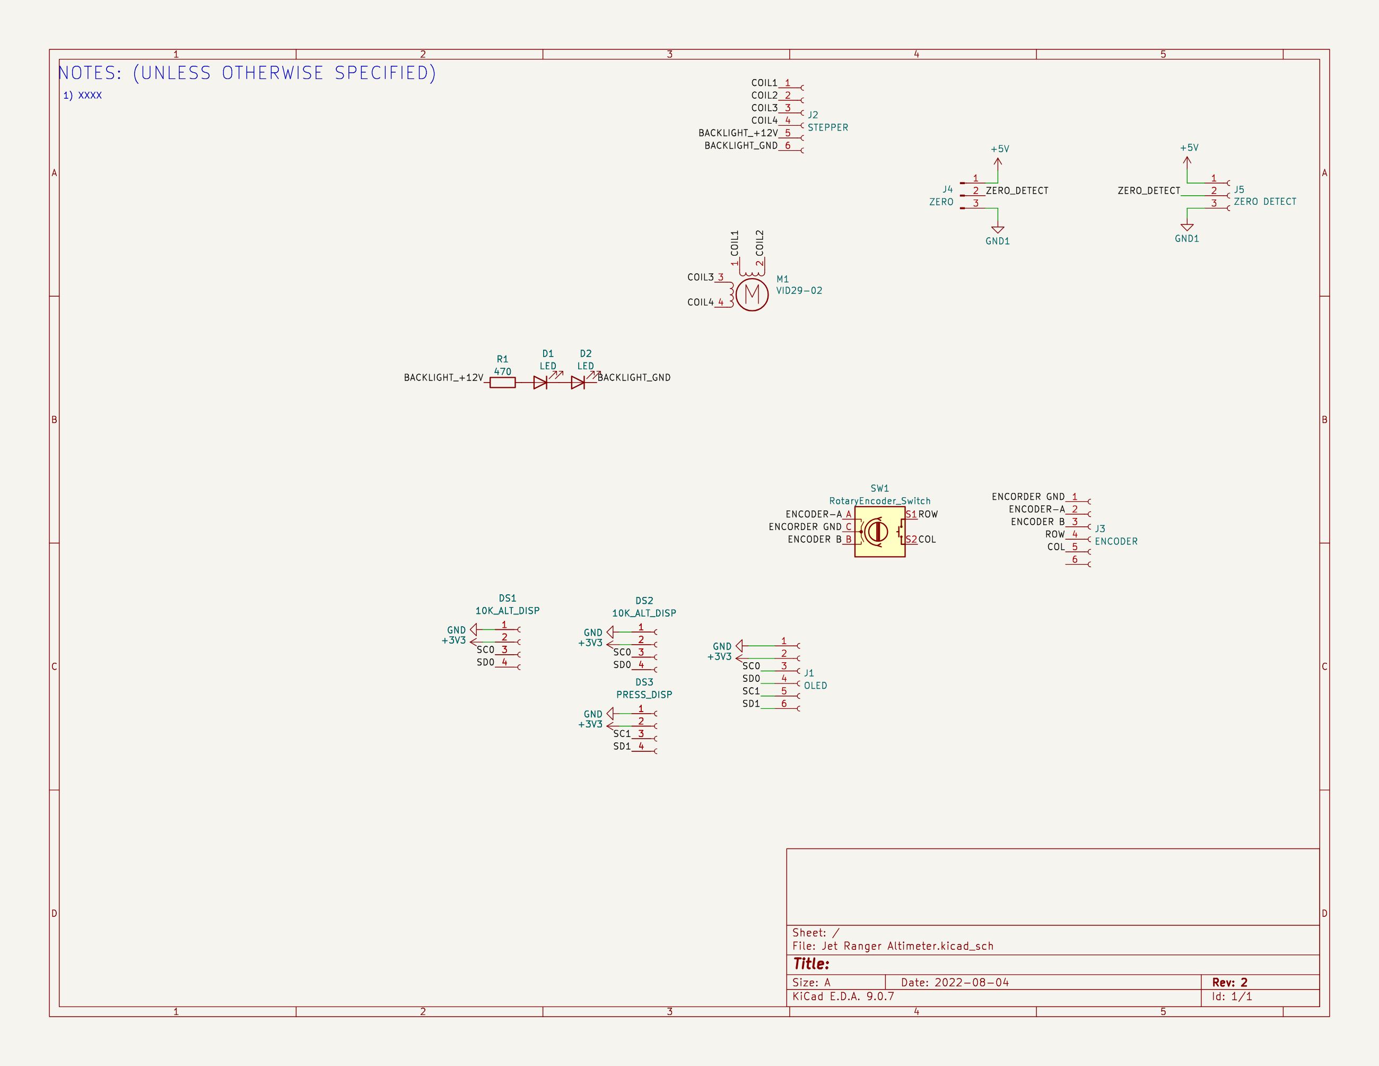
[picture p209: Jet Ranger/Jet Ranger Documentation/DocBuild/pcb/altimeter_sch.jpg]
Jet Ranger Altimeter schematic


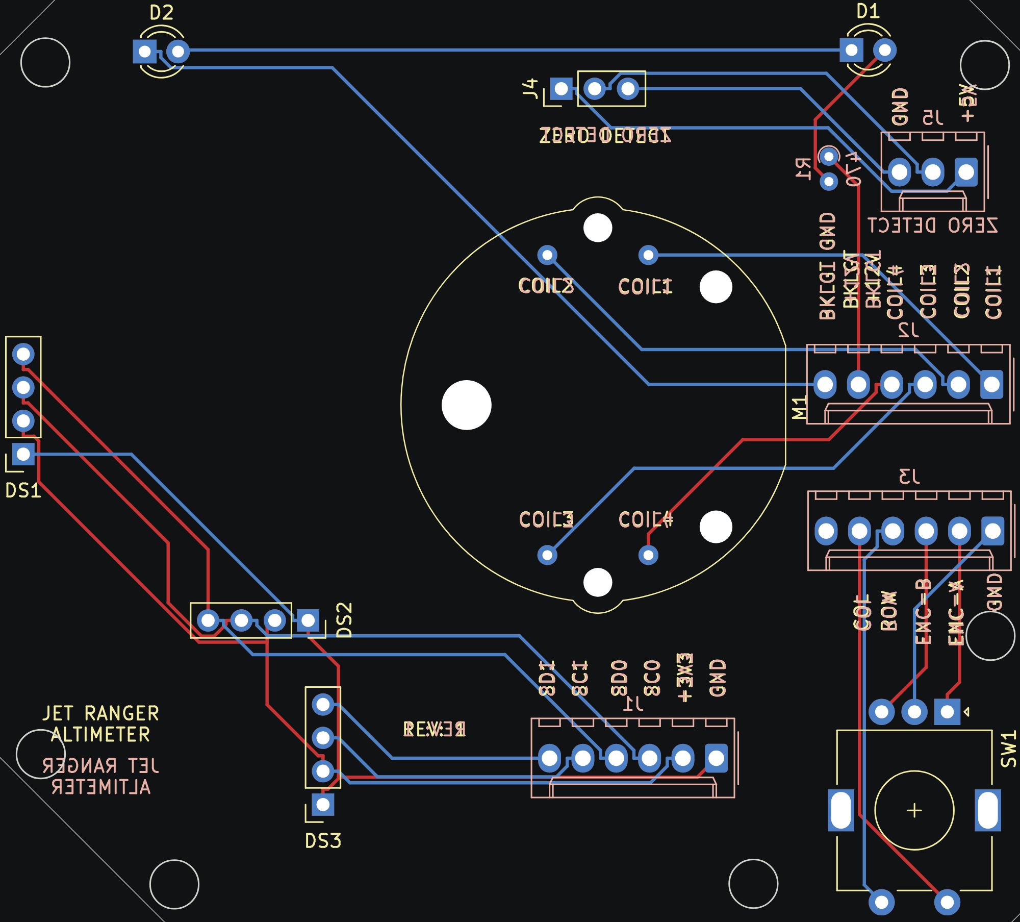
[picture p210: Jet Ranger/Jet Ranger Documentation/DocBuild/pcb/altimeter_pcb.jpg]
Jet Ranger Altimeter board layout


<!-- pagebreak -->

## Large Guage (Simmeters Large Guage Replacement)

Title block revision 2 (2022-08-04). Not covered by the sketches. Replacement board for a large Simmeters gauge.

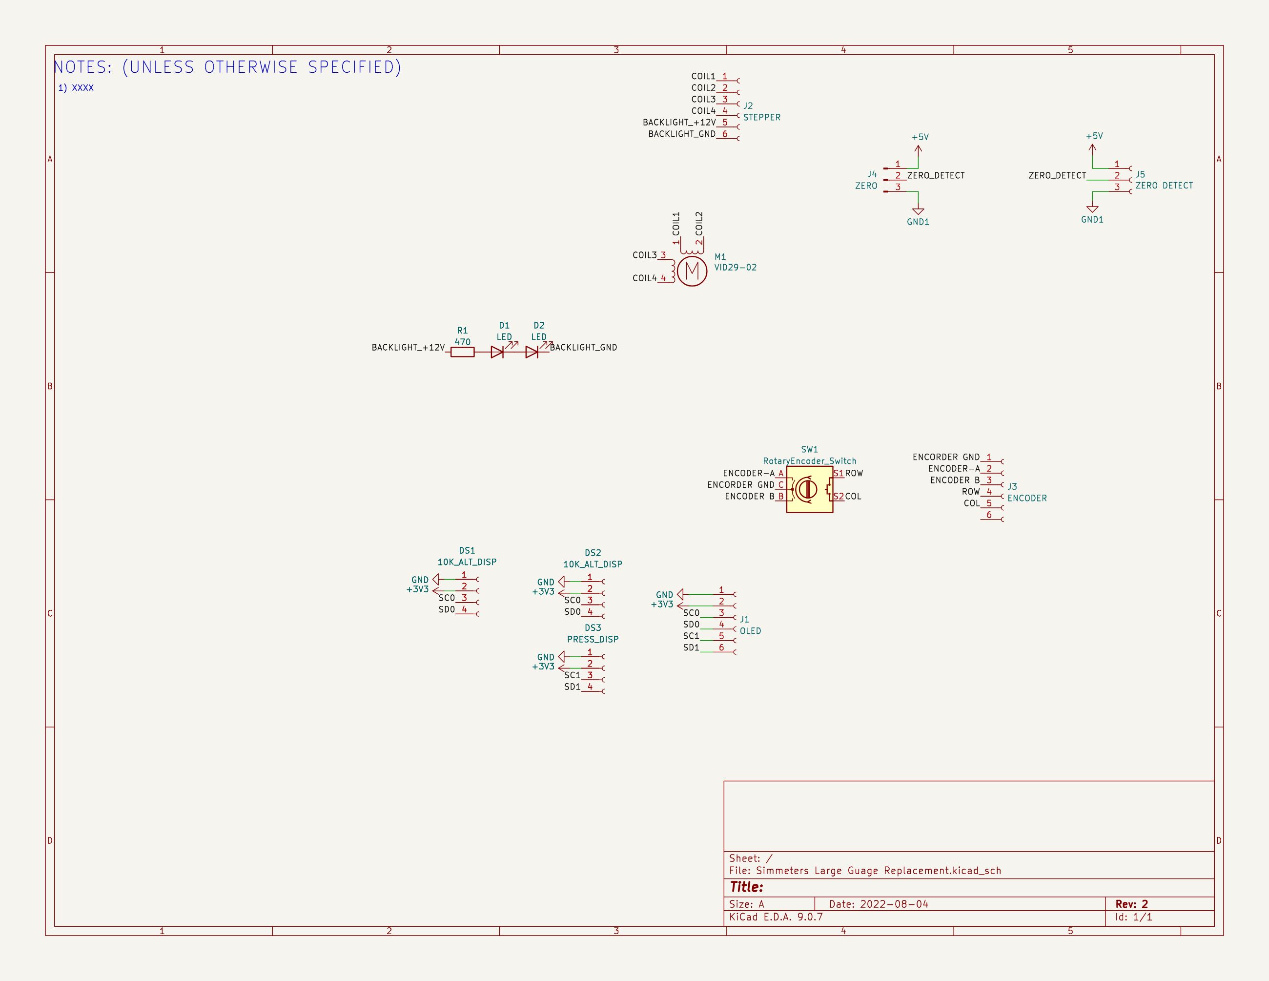
[picture p211: Jet Ranger/Jet Ranger Documentation/DocBuild/pcb/large_gauge_sch.jpg]
Large Guage (Simmeters Large Guage Replacement) schematic


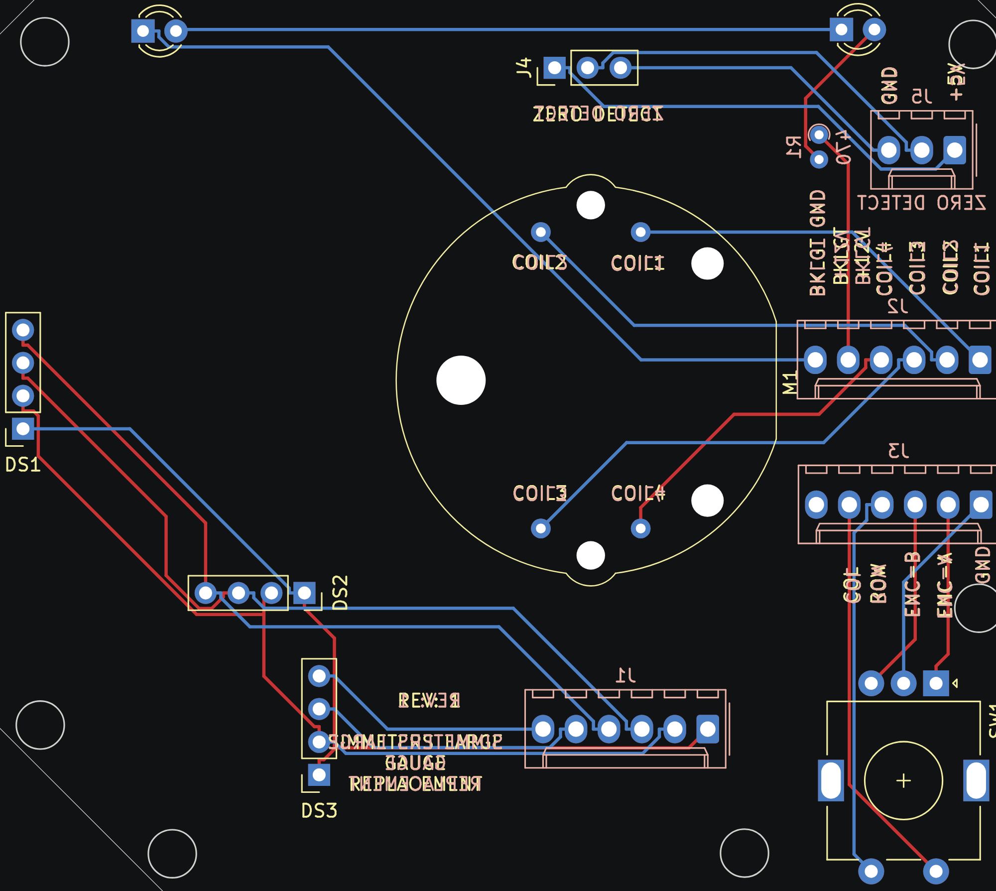
[picture p212: Jet Ranger/Jet Ranger Documentation/DocBuild/pcb/large_gauge_pcb.jpg]
Large Guage (Simmeters Large Guage Replacement) board layout


<!-- pagebreak -->

## Simkits Large Dual Gauge

Title block revision 2 (2022-08-04). Not covered by the sketches. Replacement board for a large dual Simkits gauge.

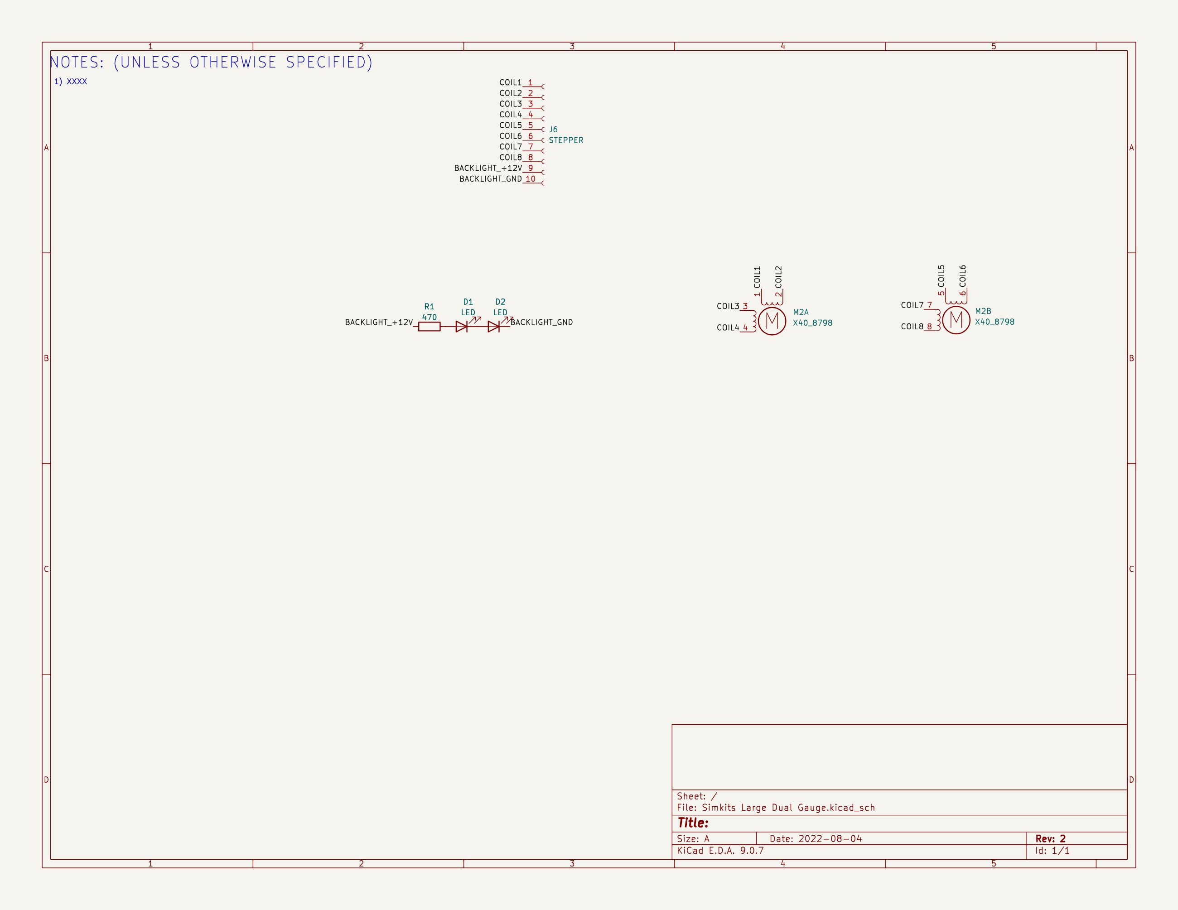
[picture p213: Jet Ranger/Jet Ranger Documentation/DocBuild/pcb/simkits_large_dual_sch.jpg]
Simkits Large Dual Gauge schematic


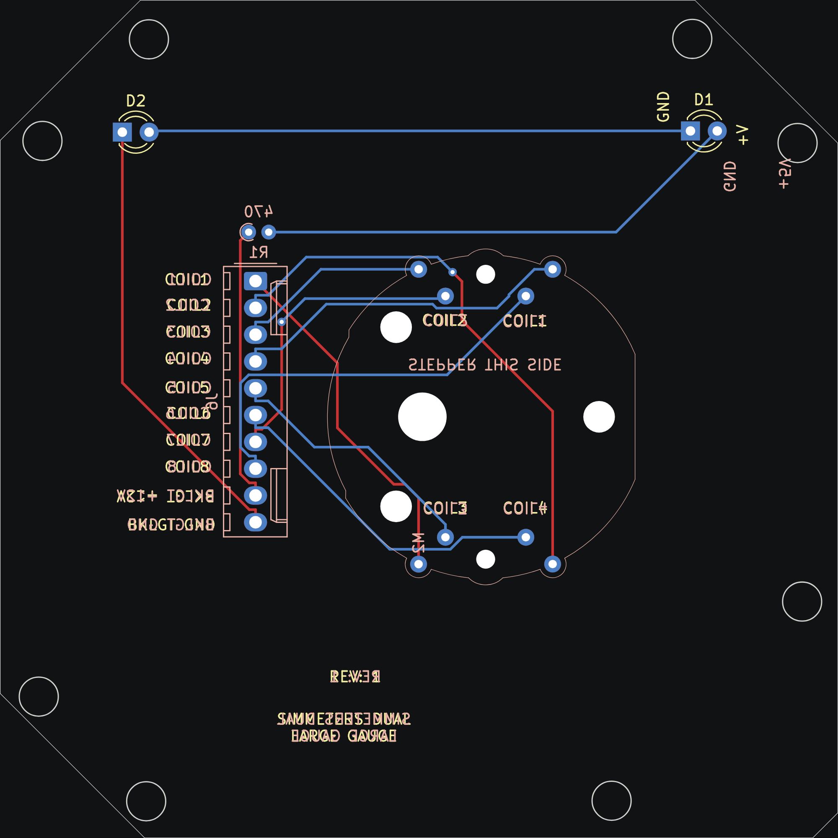
[picture p214: Jet Ranger/Jet Ranger Documentation/DocBuild/pcb/simkits_large_dual_pcb.jpg]
Simkits Large Dual Gauge board layout


<!-- pagebreak -->

## Simkits Large Guage

Title block revision 2 (2022-08-04). Not covered by the sketches. Replacement board for a large Simkits gauge.

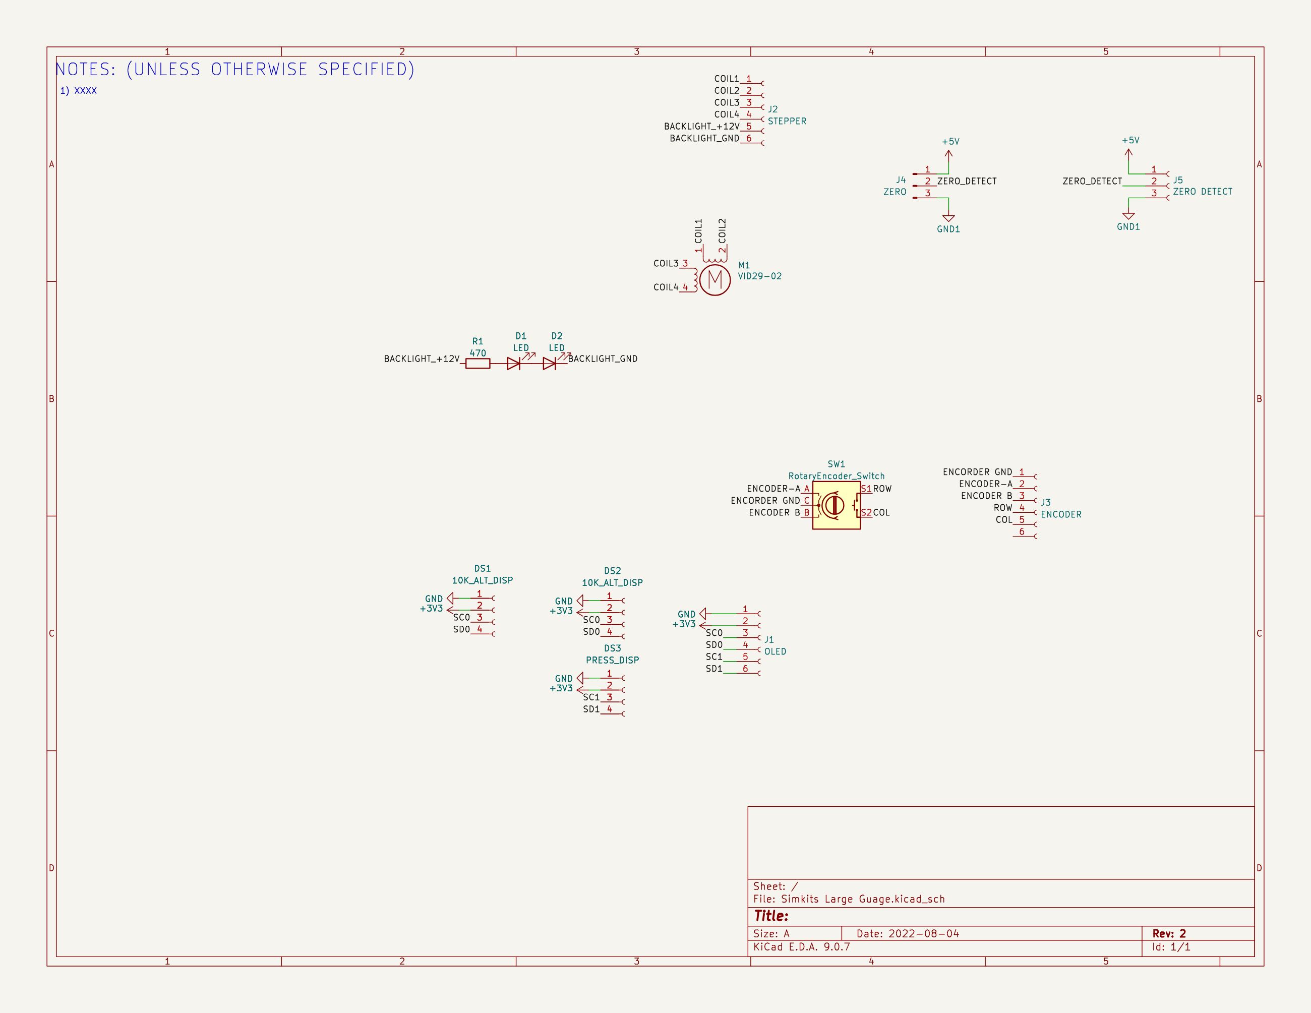
[picture p215: Jet Ranger/Jet Ranger Documentation/DocBuild/pcb/simkits_large_sch.jpg]
Simkits Large Guage schematic


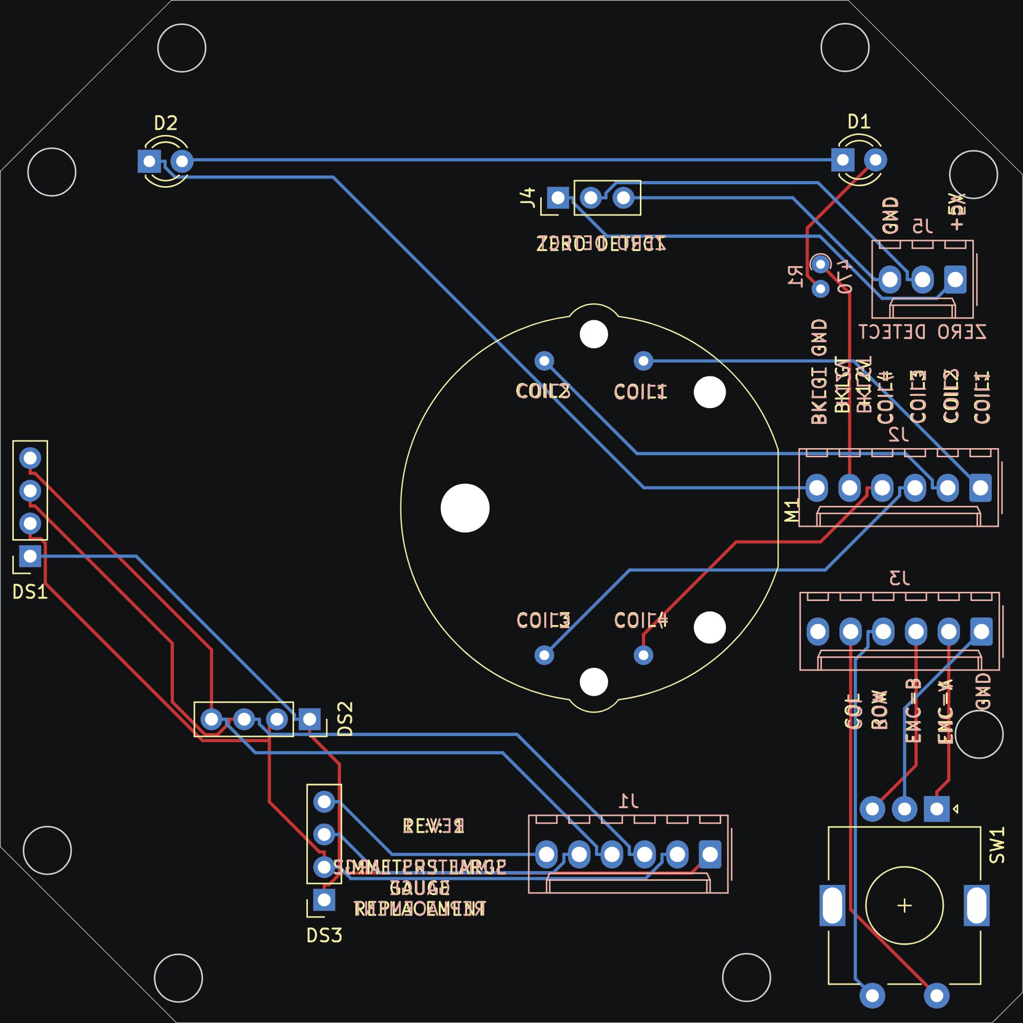
[picture p216: Jet Ranger/Jet Ranger Documentation/DocBuild/pcb/simkits_large_pcb.jpg]
Simkits Large Guage board layout


<!-- pagebreak -->

## Simkits Small Dual Gauge

Title block revision 2 (2022-08-04). Not covered by the sketches. Replacement board for a small dual Simkits gauge.

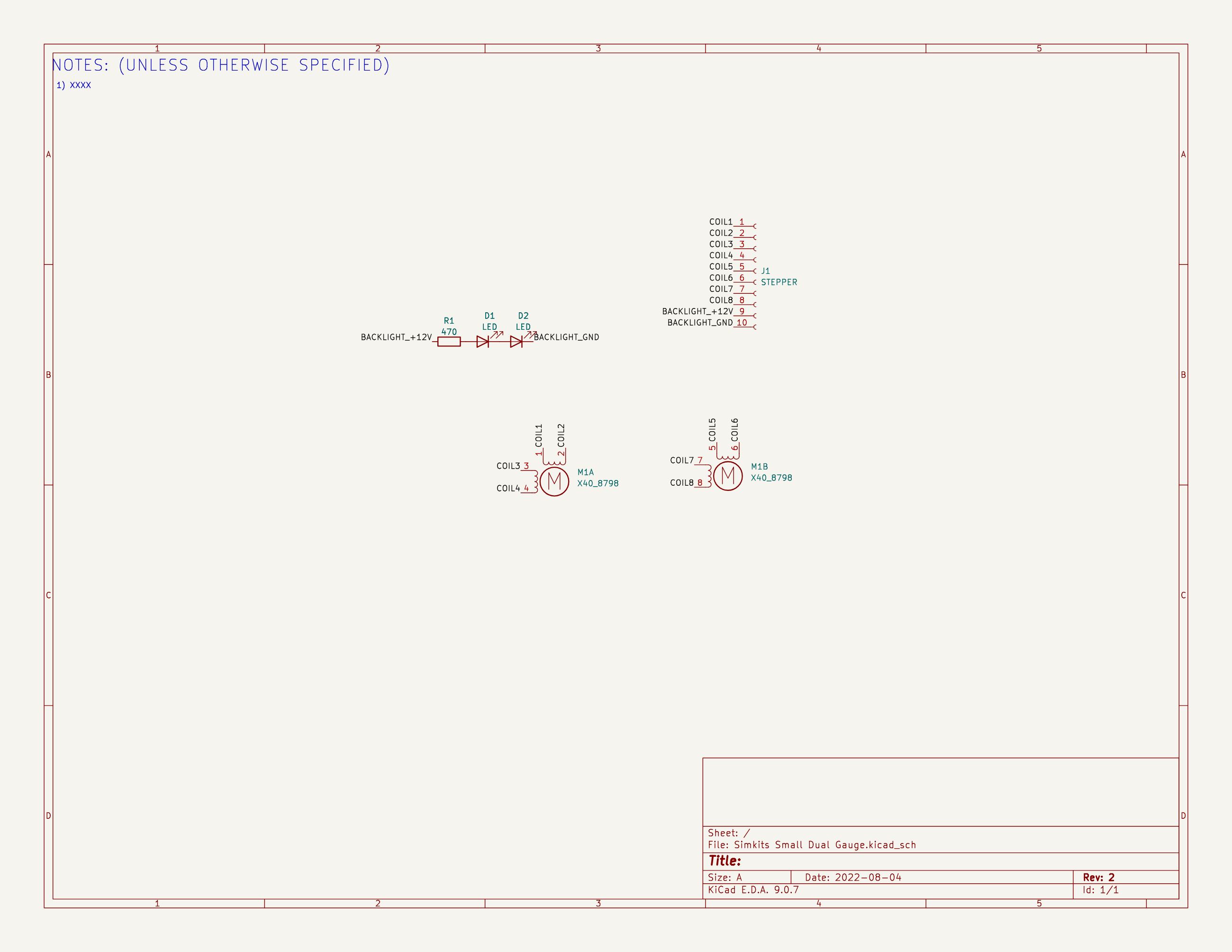
[picture p217: Jet Ranger/Jet Ranger Documentation/DocBuild/pcb/simkits_small_dual_sch.jpg]
Simkits Small Dual Gauge schematic


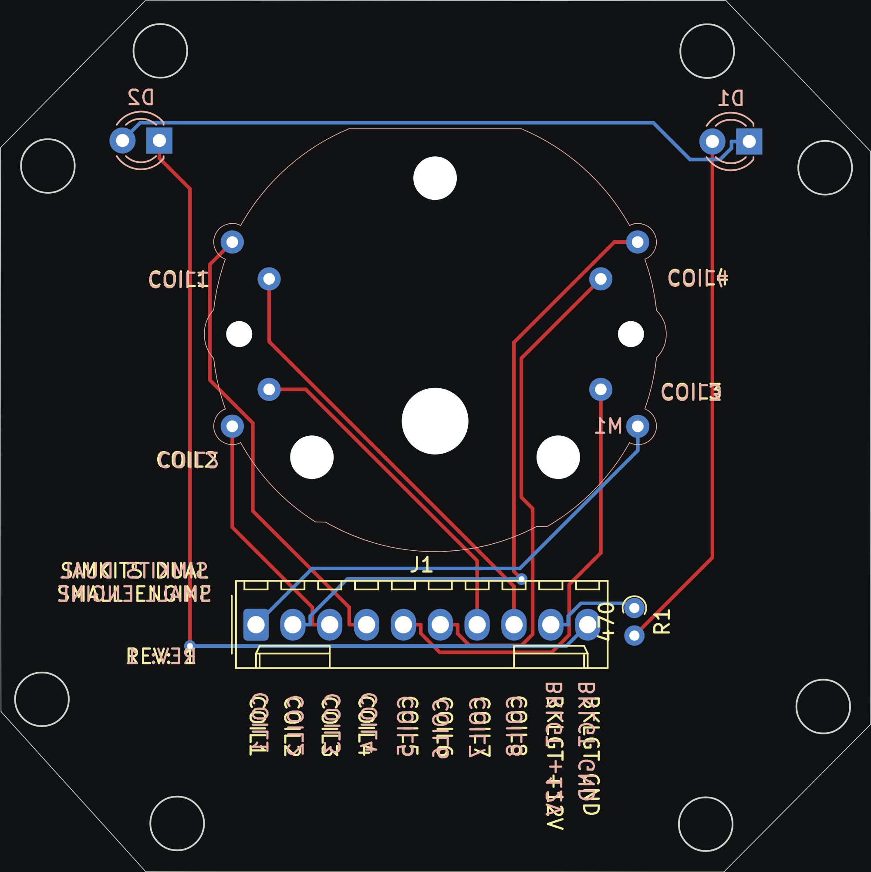
[picture p218: Jet Ranger/Jet Ranger Documentation/DocBuild/pcb/simkits_small_dual_pcb.jpg]
Simkits Small Dual Gauge board layout


<!-- pagebreak -->

## Simkits Small Guage

Title block revision 2 (2022-08-04). Not covered by the sketches. Replacement board for a small Simkits gauge.

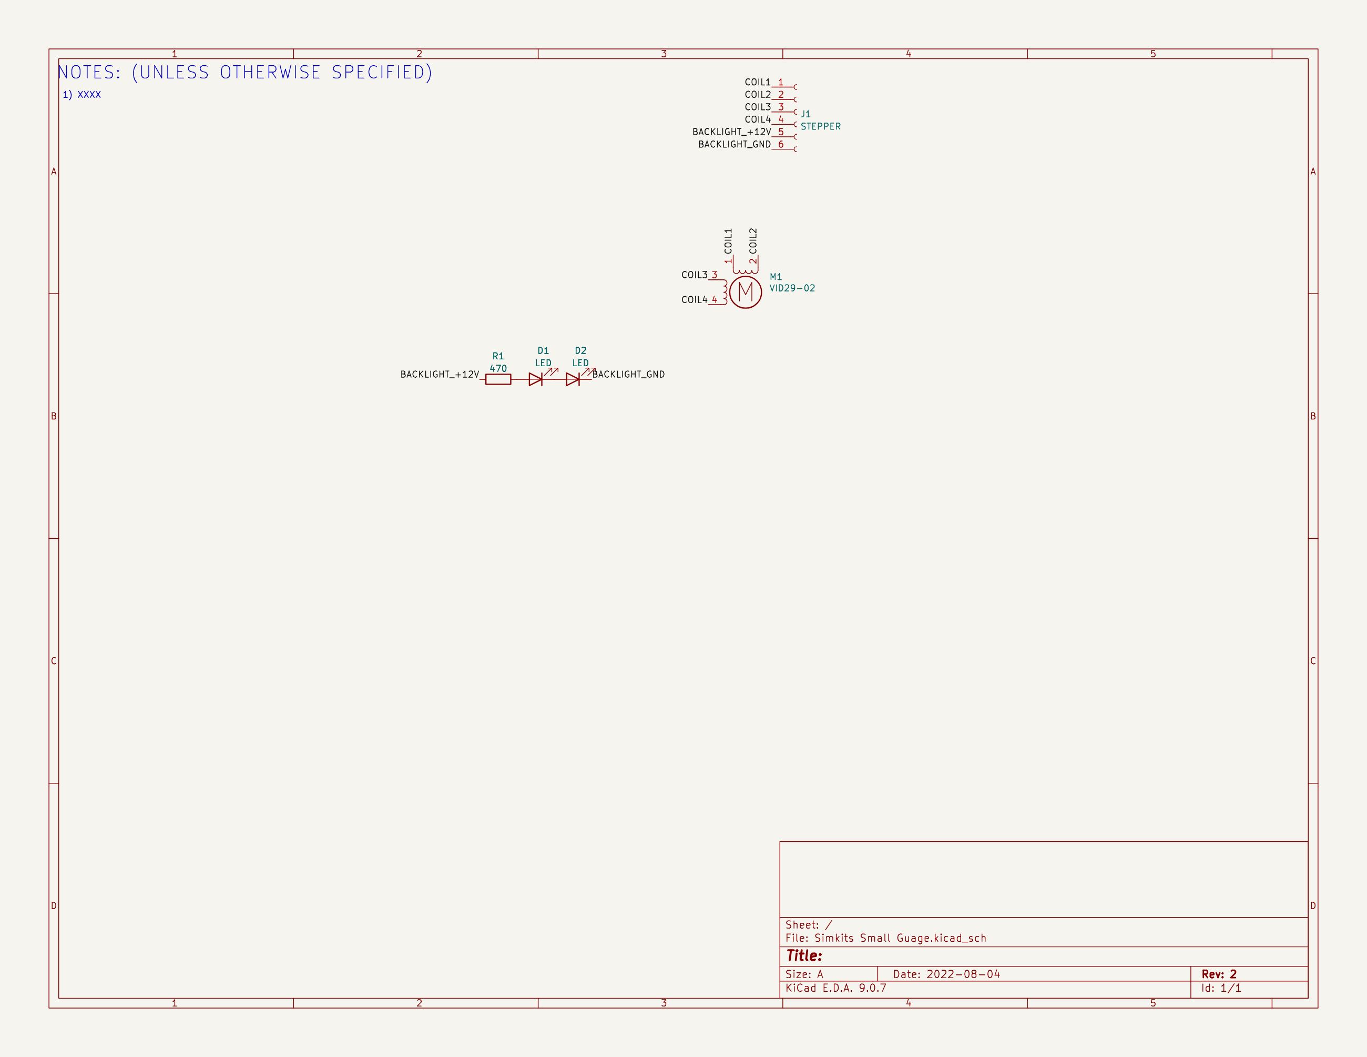
[picture p219: Jet Ranger/Jet Ranger Documentation/DocBuild/pcb/simkits_small_sch.jpg]
Simkits Small Guage schematic


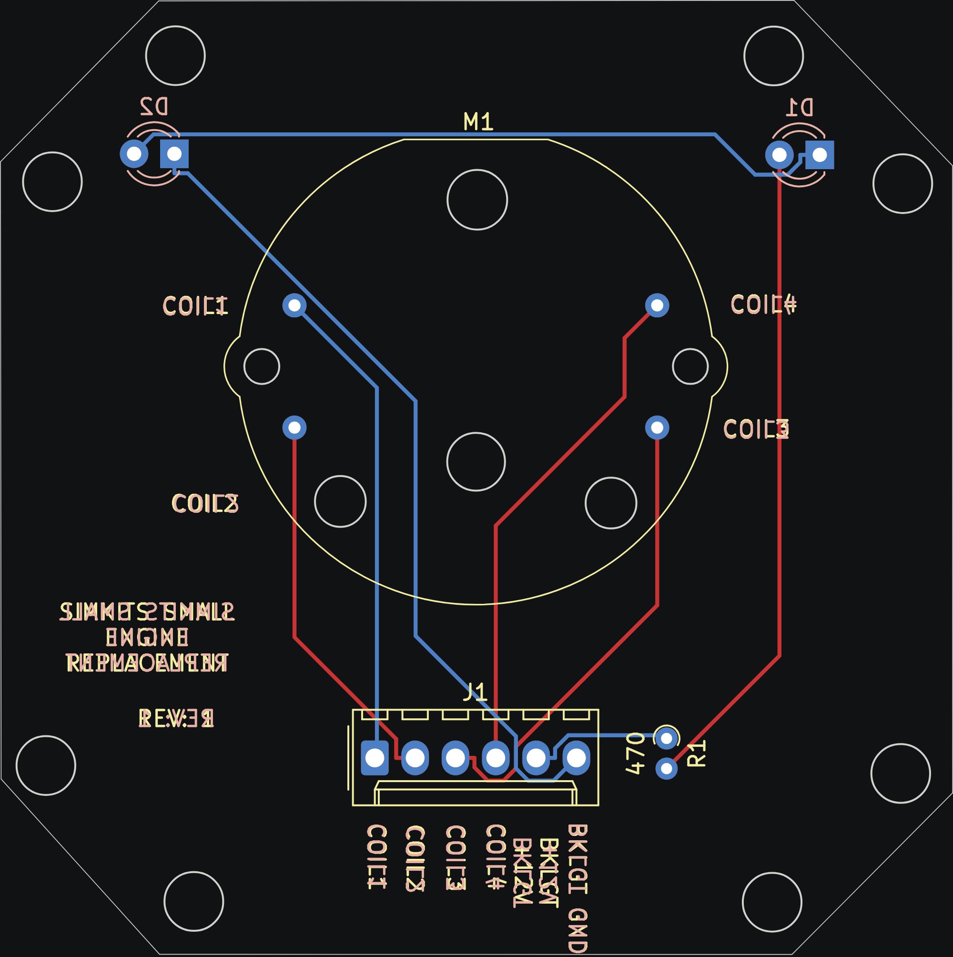
[picture p220: Jet Ranger/Jet Ranger Documentation/DocBuild/pcb/simkits_small_pcb.jpg]
Simkits Small Guage board layout
