bnepethomas/bne-arduino-flight-simulator-interfaces/737/737-Overhead-wiring-011.docx

B737NG SYS BOARD OVERHEAD WIRING CHART

SWITCH INPUTS

| BAT TEST
| STANDBY POWER
| DISCONNECT 1
| DISCONNECT 2
25 | GRD PWR
| BUS TRANSFER
18 | EMER EXIT LIGHTS
29 | ALT HORN CUTOUT
63 | AFT 1
64 | FWD 1
58 | FWD 2
62 | AFT 2
61 | FUEL CENTER L
59 | FUEL CENTER R
17 | NO SMOKING ON
23 | NO SMOKING OFF
21 | SEATBELT ON
24 | SEATBELT OFF
35 | APU GEN 2 ON
34 | APU GEN 2 OFF
40 | APU GEN 1 ON
36 | APU GEN 1 OFF
26 | GEN BUS AUTO
33 | GEN 2 ON
37 | GEN 2 OFF
39 | GEN 1 ON
38 | GEN 1 OFF
49 | APU START
56 | APU OFF
102 | WING ANTI-ICE
97 | ENG ANTI-ICE 1
103 | ENG ANTI-ICE 2
99 | HYD PUMPS B ENG 2
98 | HYD PUMPS B ELEC 1
101 | HYD PUMPS A ELEC 2
104 | HYD PUMPS A ENG 1
27 | ATTEND
28 | GROUND CALL
67 | WINDOW HEAT L SIDE
66 | WINDOW HEAT L FWD
71 | WINDOW HEAT OVHT
65 | WINDOW HEAT POWER TEST
68 | WINDOW HEAT R FWD
72 | WINDOW HEAT R SIDE
69 | PROBE B
70 | PROBE A
| L RECIRC FAN – NOT INSTALLED
100 | R RECIRC FAN AUTO
42 | PACK 2 OFF
45 | PACK 2 HIGH
48 | PNEUMATIC ISOLATION VALVE CLOSE
41 | PNEUMATIC ISOLATION VALVE OPEN
43 | PACK 1 OFF
44 | PACK 1 HIGH
112 | BLEED 1 ON
109 | BLEED APU
105 | BLEED 2
| MANUAL VALVE
46 | OVHT TEST
32 | CVR TEST
110 | WHEEL WELL | LIGHTS
125 | WING | LIGHTS
124 | ANTI COLLISION | LIGHTS
126 | POSITION STROBE AND STEADY | LIGHTS
127 | POSITION STEADY | LIGHTS
128 | LOGO | LIGHTS
121 | ENGINE START L | LIGHTS
122 | ENGINE START R | LIGHTS
| SOCKET
50 | RETRACTABLE L | LIGHTS
52 | RETRACTABLE R | LIGHTS
53 | FIXED L | LIGHTS
55 | FIXED R | LIGHTS
51 | RUNWAY TURNOFF L | LIGHTS
54 | RUNWAY TURNOFF R | LIGHTS
123 | TAXI | LIGHTS
115 | ENGINE START GRD (1) | LIGHTS
114 | ENGINE START OFF (1) | LIGHTS
116 | ENGINE START CONT (1) | LIGHTS
119 | ENGINE START FLT (1) | LIGHTS
118 | ENGINE START GRD (2) | LIGHTS
120 | ENGINE START OFF (2) | LIGHTS
113 | ENGINE START CONT (2) | LIGHTS
117 | ENGINE START FLT (2) | LIGHTS
60 | CROSS FEED ON
111 | PRESSURIZATION AUTO
107 | PRESSURIZATION ALTN
106 | PRESSURIZATION MAN
6 | ELEC PANEL DC STBY PWR
7 | ELEC PANEL DC BAT BUS
8 | ELEC PANEL DC BAT
4 | ELEC PANEL DC TR1
1 | ELEC PANEL DC TR2
5 | ELEC PANEL DC TR3
2 | ELEC PANEL DC TEST
95 | BAT (Master)
91 | DISCONNECT 1 NORMAL
89 | DISCONNECT 2 NORMAL
96 | ELECT MAINT
82 | ELEC PANEL AC STBY PWR
84 | ELEC PANEL AC GRD PWR
81 | ELEC PANEL AC GEN 1
86 | ELEC PANEL AC APU GEN
88 | ELEC PANEL AC GEN 2
85 | ELEC PANEL AC INV
87 | ELEC PANEL AC TEST
94 | GALLEY
| Flight Control Switches
77 | Stby Rud A | Flight Control Switches
76 | Stby Rud B | Flight Control Switches
75 | Alt Flaps ARM (covered) | Flight Control Switches
| Alt Flaps Up NOT CONNECTED | Flight Control Switches
75 | Alt Flaps Down | Flight Control Switches
79 | Spoiler A | Flight Control Switches
80 | Spoiler B | Flight Control Switches
9 | Yaw Damper | Flight Control Switches
| Navigation
74 | VHF Nav Both on 1 | Navigation
73 | VHF Nav Both on 2 | Navigation
14 | IRIS L | Navigation
16 | IRIS R | Navigation
15 | FMC L | Navigation
11 | FMC R | Navigation
22 | CONTROL BOTH 1 | Navigation
21 | CONTROL BOTH 2 | Navigation
10 | SOURCE ALL ON 2 | Navigation
12 | SOURCE ALL ON 1 | Navigation
13 | SOURCE AUTO | Navigation

B737NG SYS BOARD OVERHEAD WIRING CHART

LED OUTPUTS

The LED placement is designed for maximum brightness and allows you to isolate different LED types to their own pin numbers.

| | Legend Text | Led Colour | Bright
53 | APU FAULT | FAULT | Orange
23 | APU GEN OFF BUS (Left) | APU GEN OFF BUS | Blue
19 | APU GEN OFF BUS (Right/Bright) | APU GEN OFF BUS | Blue
49 | APU LOW OIL PRESSURE | | Orange
50 | APU MAINT | MAINT | Blue
51 | APU OVER SPEED | OVERSPEED | Orange
10 | AUTO SLAT FAIL | | Orange
194 | AUX PITOT | | Orange
12 | BAT DISCHARGE | | Orange
209 | BLEED TRIP OFF 1 | | Orange
212 | BLEED TRIP OFF 2 | | Orange
22 | CALL | CALL | Blue
193 | CAPT PITOT | | Orange
9 | COWL ANTI-ICE (ENG 1) | | Orange
16 | COWL ANTI-ICE (ENG 2) | | Orange
133 | COWL VALVE OPEN (ENG 1) ANTI –ICE (LEFT) | COWL VALVE OPEN | Blue
136 | COWL VALVE OPEN (ENG 1) ANTI –ICE (RIGHT/BRIGHT) | COWL VALVE OPEN | Blue
135 | COWL VALVE OPEN (ENG 2) | COWL VALVE OPEN | Blue
129 | COWL VALVE OPEN (ENG 2) (RIGHT/BRIGHT) | COWL VALVE OPEN | Blue
158 | DOOR FWD SERVICE | | Orange
157 | DOOR AFT CARGO | AFT CARGO | Orange
153 | DOOR AFT ENTRY | AFT ENTRY | Orange
154 | DOOR AFT SERVICE | AFT SERVICE | Orange
159 | DOOR EQUIP | EQUIP | Orange
160 | DOOR FWD CARGO | | Orange
222 | DOOR FWD ENTRY | | Orange
218 | DOOR LEFT FWD OVERWING | | Orange
156 | DOOR RIGHT AFT OVERWING | | Orange
72 | DRIVE (1) | | Orange
67 | DRIVE (2) | | Orange
138 | DUAL BLEED | | Orange
13 | ELEC | | Orange
200 | ELEV PITOT HEAT LEFT PITOT | L ELEV PITOT | Orange
198 | ELEV PITOT HEAT R | R ELEV PITOT | Orange
68 | EMERGENCY LIGHTS NOT ARMED | NOT ARMED
30 | ENG VALVE CLOSED 1(RIGHT/BRIGHT) | ENG VALVE CLOSED | Blue
27 | ENG VALVE CLOSED 2 (LEFT) | ENG VALVE CLOSED | Blue | Yes
29 | ENG VALVE CLOSED 1 (LEFT) | ENG VALVE CLOSED | Blue | Yes
28 | ENG VALVE CLOSED 2 (RIGHT/BRIGHT) | ENG VALVE CLOSED | Blue
65 | EQUIP COOLING EXHAUST | | Orange
69 | EQUIP COOLING SUPPLY | | Orange
196 | F/O PITOT | | Orange
5 | FEEL DIFF PRESS | | Orange
33 | FILTER BY PASS (L) | | Orange
36 | FILTER BY PASS (R) | | Orange
15 | FLIGHT RECORDER OFF (CVR STATUS) UNSUURE | | Red
56 | FUEL CENTER LOW PRESSURE (L) 1 | | Orange
54 | FUEL CENTRE LOW PRESSURE (R) 2 | | Orange
40 | FUEL LOW PRESSURE (L AFT) FUEL | | Orange
39 | FUEL LOW PRESSURE (L FWD) FUEL | | Orange
37 | FUEL LOW PRESSURE (R AFT) FUEL | | Orange
38 | FUEL LOW PRESSURE (R FWD) | | Orange
55 | GEN OFF BUS (GEN 1) (LEFT) | GEN OFF BUS | Blue
52 | GEN OFF BUS (GEN 1) (RIGHT/BRIGHT) | GEN OFF BUS | Blue
24 | GEN OFF BUS (GEN 2) (Left) | GEN OFF BUS | Blue
20 | GEN OFF BUS (GEN 2) (Right/Bright) | GEN OFF BUS | Blue
71 | GRD POWER AVAILABLE | | Blue
221 | HYD ELEC 1 LOW PRESSURE (ELEC 1) HYD | | Orange
219 | HYD ELEC 2 LOW PRESSURE (ELEC 2) HYD | | Orange
224 | HYD ENG 1 LOW PRESSURE (ENG 1) HYD | | Orange
217 | HYD ENG 2 LOW PRESSURE (ENG 2) HYD | | Orange
7 | HYD STDBY LOW PRESSURE (HYD) | | Orange
8 | HYD STDBY LOW QUANTITY (HYD) | | Orange
197 | L ALPHA VANE | | Orange
| LEFT AFT OVERWING (NOT ON PANEL) | | Orange
2 | LOW OIL PRESSURE A FLT CONTROL | | Orange
1 | LOW OIL PRESSURE B FLT CONTROL | NOT LIGHTING | Orange
3 | MACH TRIM FAIL | | Orange
69 | OFF (L) EQUIP SUPPLY
210 | OFF SCHED DESCENT | | Orange
207 | WINDOW HEAT FWD L- (ON) | | GREEN
208 | WINDOW HEAT L SIDE ON () | | GREEN
206 | WINDOW HEAT FWD R ON | | GREEN
203 | WINDOW HEAT L SIDE ON | | GREEN
223 | OVERHEAT (ELEC 1) HYD | | Orange
220 | OVERHEAT (ELEC 2) HYD | | Orange
205 | WINDOW HEAT FWD (L)- OVERHEAT | | Orange
204 | WINDOW HEAT L SIDE OVERHEAT | | Orange
201 | WINDOW HEAT FWD R OVERHEAT | | Orange
202 | WINDOW HEAT L SIDE OVERHEAT | | Orange
| PA IN USE (NOT ON PANEL) | | Blue
215 | PACK 1 | | Orange
211 | PACK 2 | | Orange
137 | PRESSURESATION MANUAL | | GREEN
142 | PRESSURESATION ALTN | | GREEN
216 | PRESSURESATION AUTO FAIL | | Orange
195 | R ALPHA VANE | | Orange
141 | RAM DOOR FULL OPEN (L) | RAM DOOR FULL OPEN | Blue
144 | RAM DOOR FULL OPEN (R) | RAM DOOR FULL OPEN | Blue
155 | RIGHT FWD OVERWING | | Orange
21 | SOURCE OFF (GEN 1) | | Orange
18 | SOURCE OFF (GEN 2) | | Orange
32 | SPAR VALVE CLOSED 1 (RIGHT/BRIGHT) | SPAR VALVE CLOSED | Blue
31 | SPAR VALVE CLOSED 1 (LEFT) | SPAR VALVE CLOSED | Blue | Yes
25 | SPAR VALVE CLOSED 2 (LEFT) | SPAR VALVE CLOSED | Blue | Yes
26 | SPAR VALVE CLOSED 2 (RIGHT/BRIGHT) | SPAR VALVE CLOSED | Blue
4 | SPEED TRIM FAIL | | Orange
70 | STANDBY PWR OFF | | Orange
6 | STBY RUD ON | | Orange
199 | TEMP PROBE | | Orange
14 | TR UNIT | | Orange
66 | TRANSFER BUS OFF (GEN 1) | | Orange
17 | TRANSFER BUS OFF (GEN 2) | | Orange
34 | CROSSFEED VALVE OPEN (LEFT) | VALVE OPEN | Blue | Yes
35 | CROSSFEED VALVE OPEN (RIGHT/BRIGHT) | VALVE OPEN | Blue
134 | WING ANTI ICE L VALVE OPEN (LEFT) | L VALVE OPEN | Blue
132 | WING ANTI ICE L VALVE OPEN (RIGHT/BRIGHT) ANTI-ICE | L VALVE OPEN | Blue
131 | WING ANTI ICE R VALVE OPEN | R VALVE OPEN | Blue
130 | WING ANTI ICE R VALVE OPEN (RIGHT/BRIGHT) ANTI ICE | R VALVE OPEN | Blue
214 | WING-BODY OVERHEAT 1 | | Orange
213 | WING-BODY OVERHEAT 2 | | Orange
11 | YAW DAMPER | | Orange
140 | ZONE TEMP (C) FWD | | Orange
143 | ZONE TEMP (L) CONT | | Orange
139 | ZONE TEMP (R) AFT | | Orange
