bnepethomas/bne-arduino-flight-simulator-interfaces/Python HW Link/CKAS Motion platform operation.odt

CKAS Motion Platform

The Jet Ranger is a Generation 2 platform which uses a different set of drivers to the King Air platform which is a Gen3 6Dof.

As of Sept 2025 the Gen 2 installer is Generic.zip and the Gen 3 is SimCorDX

The Gen 3 install is an all in one – with support for both DCS and MSFS2024.

The Gen 2 installer two part, SimCor which is the lower level interface to the platform and then a different SimCoreDX that provides the interface to DCS and MSFS. Currently the SomCor executable crashes when MSFS2024 is started.

The order of startup of the Gen 2 is important otherwise an error about a port already in use occurs.

SimCorDX does you request to select the platform before it becomes active. The input is select to external and need to also press the stop button.

The input text box will update when data is being sent, the DCS driver will send park within a second of data not being sent.

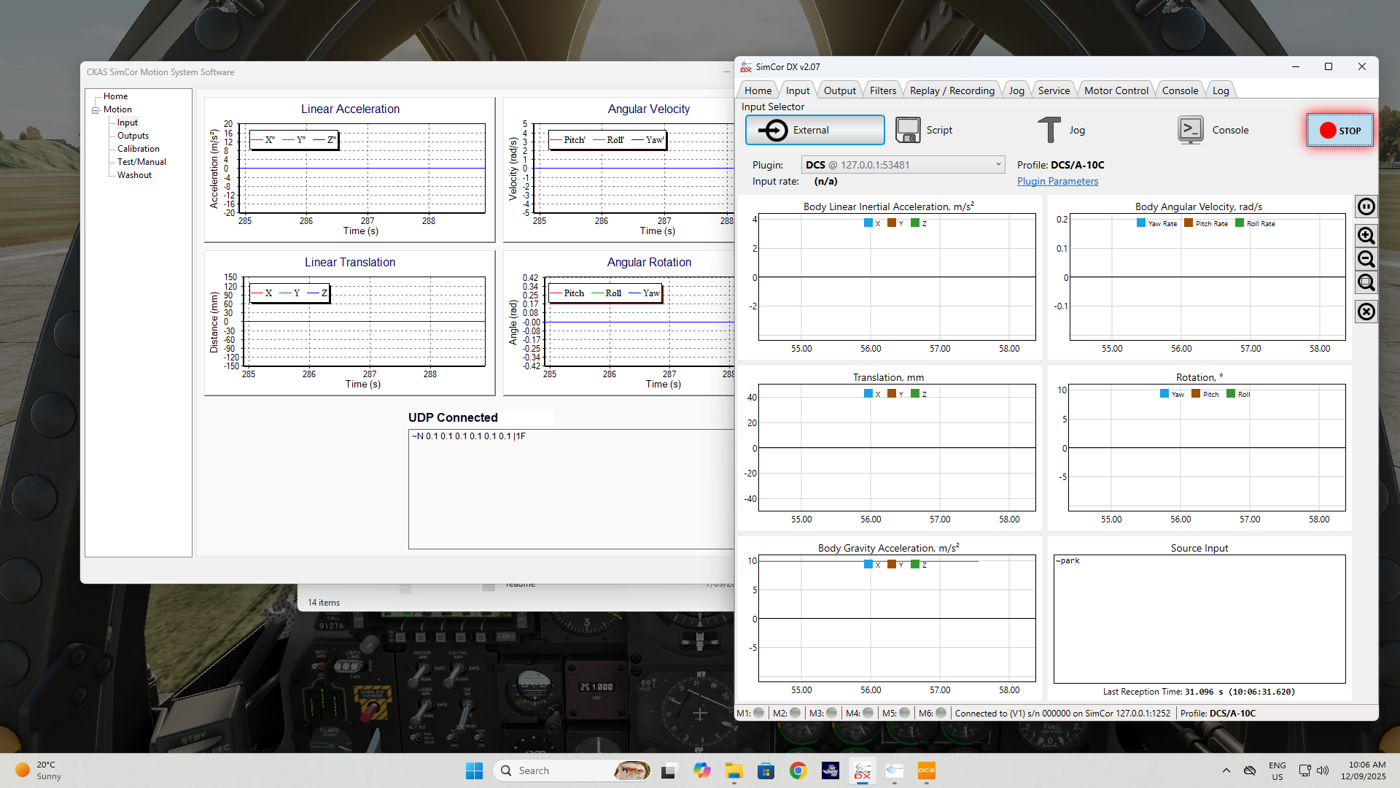
[picture p232: figure]
