bnepethomas/bne-arduino-flight-simulator-interfaces/Jet Ranger/Jet Ranger Documentation/Jet Ranger Physical Assembly and Disassembly.odt

The Jet Ranger Build

# Overview

This document describes how to take the Jet Ranger cockpit apart and put it back together. Disassembly comes first, in the order the work is done; each section starts with a Needs first line linking the jobs that must be finished before it. Reassembly follows as the exact inverse, then the checks to make afterwards.

Read the removal order before starting. The main dependencies are: the centre pedestal comes out before anything else. After that there are three independent tracks: the co-pilot seat, the cyclic controls (before the pilot seat), the pilot seat, the collective control and then the seat base (the bench); the pedals, then the chin screen, then the front screen; and the front panels and then the roof.

Abbreviations: SB is the USB Sound Blaster. All bolts quoted in inches are 1/4 inch.

# Disassembly

## Overall removal order

1. Centre pedestal: first, before anything else.
2. Co-pilot seat.
3. Cyclic controls: the cyclic weight first, then the cyclic.
4. Pilot seat.
5. Collective control.
6. Seat base: the stop panel, the cables, the Sound Blaster, the Cambridge amplifier and the PC, then the base itself.
7. Pedals.
8. Chin screen.
9. Front screen.
10. Front panels.
11. Roof and top maintenance.

After the Centre pedestal the work splits into three tracks that do not depend on each other, so they can be done in any order or in parallel: (1) Co-pilot seat, Cyclic controls, Pilot seat, Collective control, then Seat base; (2) Pedals, then Chin screen, then Front screen; (3) Front panels, then Roof and top maintenance. The front screen needs the chin screen out first, and the chin screen needs the pedals out first.

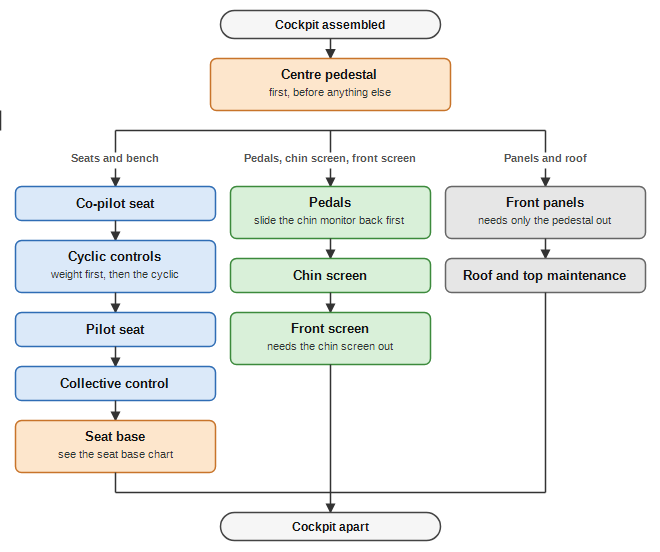
[picture p233: figure]

Figure 1: Disassembly order.

## Centre pedestal

Needs first: nothing. The centre pedestal comes out before anything else.

The centre pedestal must be removed with great care so that the front screen is not damaged. It is the first job, so remove it before anything else, including the seats. It must be out before anything is attempted on the Front screen or the Pedals.

1. Disconnect the cables.
2. Roll the pedestal towards the rear of the cabin.

[Photo: centre pedestal removed]

## Co-pilot seat

Needs first: the Centre pedestal removed.

1. Take care not to touch the grease on the rails.
2. Remove the 5 screws holding the black blanking flute.
3. Keep the position of the rails synchronised during the process.
4. Slide the seat forward and remove the rear bolts. The two rear bolts should stay attached to the rail. The bolts remain 1/4 inch.
5. Slide the seat to the rear and remove the front bolts.
6. Lift the seat lever on the upper side of the seat to collapse the seat.
7. Lift and roll the seat towards the centre of the cabin to give clearance while the seat is lifted out of the cabin.

[Photo: co-pilot seat rails and bolts]

## Cyclic controls

Needs first: the Co-pilot seat removed. The Cyclic controls come out after the Co-pilot seat and before the Pilot seat, and must be out before the Seat base (the bench).

1. Remove the cyclic weight first, then the cyclic. The clearance is tight for the console.
2. The pilot forward bolt is inserted from the top. The rear bolt is permanently installed because it conflicts with the platform collar. These bolts remain 1/4 inch.
3. The co-pilot bolts also remain 1/4 inch and are inserted from underneath.
4. Remove the Leo Bodnar controller at the same time, as the cables are currently not clearly labelled (see Leo Bodnar controllers).

## Pilot seat

Needs first: the Cyclic controls removed (which needs the Co-pilot seat removed).

1. Take care not to touch the grease on the rails.
2. Remove the screws holding the black blanking flute.
3. It is easiest to use a spanner to undo the nuts.
4. The bolts remain 1/4 inch.
5. Roll the seat towards the centre of the cabin to remove it.

## Collective control

Needs first: both the Pilot seat and the Co-pilot seat removed.

1. Disconnect the electronics from the Leo Bodnar board: collective digital, analog throttle and analog collective (see Leo Bodnar controllers).
2. Remove the collective assembly as a whole. There are two bolts on the co-pilot side and 4 in the centre (the top one is painted black). The long bolts are forward.

## Seat base

Needs first: the Co-pilot seat, Pilot seat, Collective control and Cyclic controls removed.

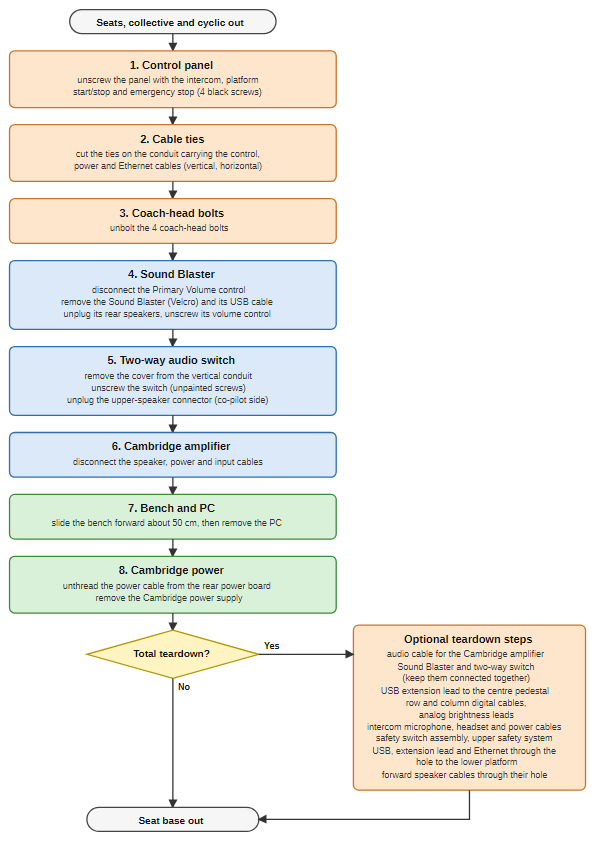
[picture p234: figure]

Figure 2: Seat base disassembly.

### Main steps

1. Unscrew the panel holding the intercom, the platform start/stop and the emergency stop controls. There are 4 black head screws.
2. Cut the cable ties holding the conduit that carries the control, power and Ethernet cables coming up from underneath. There is a vertical and a horizontal cable.
3. Unbolt the 4 coach-head bolts.
4. Disconnect the Primary Volume control from the bench-measured [text incomplete in the notes].
5. Remove the USB Sound Blaster. It is held in place with Velcro and must be gently shuffled straight out. Remove its USB cable from the cable holder.
6. Unplug the Sound Blaster rear speakers and unscrew the Sound Blaster volume control.
7. Remove the cover from the vertical conduit going to the two-way audio switch.
8. Unscrew the two-way audio switch. These screws are unpainted.
9. Unplug the connector on the co-pilot side that goes to the upper speakers.
10. Disconnect the speaker, power and input cables from the Cambridge amplifier.
11. Slide the bench forward approximately 50 cm.
12. Remove the PC.
13. Unthread the Cambridge power cable from the power board at the rear of the platform. It is threaded from the right to the back of the bench.
14. Remove the Cambridge power supply.

### Optional steps for a total teardown

1. Remove the audio cable for the Cambridge amplifier.
2. Remove the USB Sound Blaster and the two-way audio switch (keep them connected together).
3. Remove the USB extension lead to the Centre pedestal (centre console).
4. Remove the row and column digital cables and the analog brightness leads.
5. Remove the microphone and headset cables for the intercom.
6. Remove the power cable for the intercom.
7. Remove the safety switch assembly from the board holding the safety switch and intercom.
8. Disconnect the upper safety system at the emergency stop switch-off.
9. Slide the USB from the platform, the extension lead and the Ethernet cable through the hole to the lower platform. Leave the safety switch assembly in the cabin.
10. Slide the forward speaker cables through their through hole.

## Pedals

Needs first: the Centre pedestal removed.

1. Slide the chin monitor back to prevent a swinging pedal hitting it (see Chin screen).
2. Unplug the pedal from its USB controller (see Leo Bodnar controllers).
3. Each pedal is attached using 4 screws. Remove them.

## Chin screen

Needs first: the Pedals removed.

The chin monitor is a 24 inch Acer mounted on a VESA mount from Officeworks.

1. Pull the monitor forward on the VESA mount.
2. Unplug the 240 V and HDMI cables.
3. Remove the 4 bolts holding the monitor to the mount.
4. Remove the two bolts holding the mount.

[Photo: chin screen VESA mount]

## Front screen

Needs first: the Chin screen removed (which needs the Pedals removed). Removing the Cyclic controls first makes the screen considerably easier to work with.

The front screen is a Hisense screen. It is heavy and is mounted with two bolts at the top on a support rail. The legs that extend the past the base of the supporting frame assist in providing clearance to move the screen about the floor rails.

1. It is easier to move around the pit if the forward upper cover is removed
2. The power cable is at the lower centre of the screen. The HDMI lead is at mid left-hand side.
3. Support the screen, then remove the two bolts at the top.
4. Bring the screen to the it floor
5. Slide towards the pilot’s door and then allow screen to lean against the front while you exit the pit.
6. If the screen it to removed from its supporting rail lean the screen again a way.
7. While supporting the left hand base remove the left bolts top first. Then remove the lower right bolt.
8. The screen will then drop to the left hand side.
9. While supporting the right hand base remove the upper right bolt.

[Photo: front screen mounting rail]

## Front panels

Needs first: the Centre pedestal removed.

- Remove the GPS support.
- Remove the radio panels.
- The covers on the front panels are held by screws at the base and bolts at the top.

If removing the front facia:

1. Remove the bolt at the bottom right.
2. Remove the six bolts at the top.

## Roof and top maintenance

- Slide the left and right panels straight back and up to extract them. They catch on the bolt at the front otherwise.
- The side ceilings can be removed independently.

Installing the roof switch panel:

1. The starboard side is accessed with the port side.
2. Slide the port panel in from the inside, up, back and forward.
3. Position the port panel with its bolt.
4. Use a mirror to locate the screw hole.

[Photo: roof panels]

# Reference

## Leo Bodnar controllers

Used by the Collective control, Cyclic controls and Pedals. The analog inputs, from the centre working out, are:

1. Rudder
2. Throttle
3. Collective
4. Elevator
5. Aileron

# Reassembly

Reassembly is the exact inverse of the disassembly: the last thing removed goes back first, and each step inside a section is the disassembly step undone, in reverse order. Each section names the section to finish before it and links to the matching disassembly section for the detail.

## Overall refit order

1. Refit roof and top panels.
2. Refit front panels.
3. Refit front screen.
4. Refit chin screen.
5. Refit pedals.
6. Refit seat base.
7. Refit collective control.
8. Refit pilot seat.
9. Refit cyclic controls.
10. Refit co-pilot seat.
11. Refit centre pedestal: last, once the seats are back.
12. Carry out the Post reassembly checks.

As in the disassembly, the work is three independent tracks: (1) Refit seat base, Refit collective control, Refit pilot seat, Refit cyclic controls, Refit co-pilot seat; (2) Refit front screen, then Refit chin screen, then Refit pedals; (3) Refit roof and top panels, then Refit front panels. Finish all three, then refit the Refit centre pedestal. The pedals go in before the pedestal because they provide the centring information for it, and the front screen and front panels go in before it because the pedestal has to be out of the way while they are fitted.

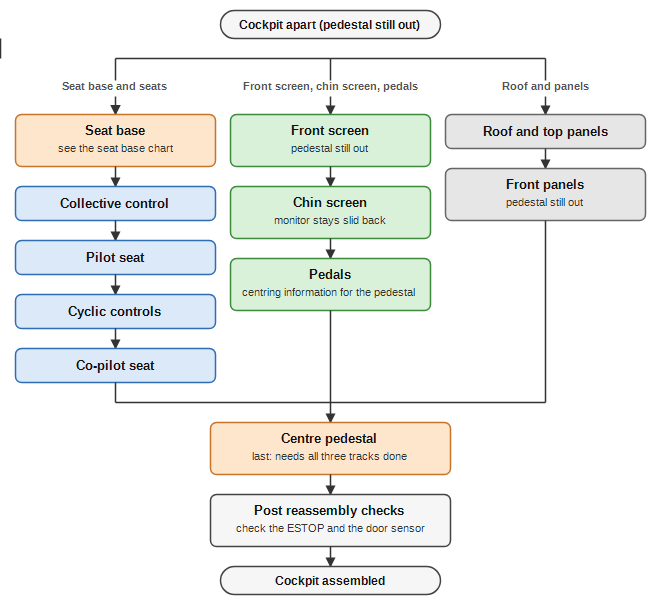
[picture p235: figure]

Figure 3: Reassembly order.

## Refit roof and top panels

Inverse of Roof and top maintenance.

1. Fit the roof switch panel: use a mirror to locate the screw hole, position the port panel with its bolt, then slide the port panel in from the inside, up, back and forward. The starboard side is accessed with the port side.
2. Refit the side ceilings (they can be done independently).
3. Slide the left and right panels forward and down into place. They catch on the bolt at the front, so keep them straight.

## Refit front panels

Needs first: Refit roof and top panels done. Inverse of Front panels.

1. If the front facia was removed: refit the six bolts at the top, then the bolt at the bottom right.
2. Refit the covers on the front panels with the screws at the base and the bolts at the top.
3. Refit the radio panels.
4. Refit the GPS support.

## Refit front screen

Needs first: nothing, the Centre pedestal is still out. Inverse of Front screen.

1. Connect the HDMI cable before mounting the screen. HDMI-1 is the upper HDMI connector on the left hand side (mid left-hand side of the screen).
2. Connect the power cable at the lower centre of the screen.
3. Route both the power and HDMI cables under the pedal, which makes installing and removing the centre pedestal much easier.
4. Lift the screen onto the support rail (it is heavy, so support it) and fit the two bolts at the top.
5. The screen defaulted to a scale of 150% and had to be set manually to 100%. Check the scale.

## Refit chin screen

Needs first: Refit front screen done. Inverse of Chin screen.

1. Fit the two bolts holding the VESA mount.
2. Fit the 4 bolts holding the monitor to the mount.
3. Plug in the 240 V and HDMI cables.
4. Push the monitor back on the VESA mount. Keep it back until the pedals are in.

## Refit pedals

Needs first: Refit chin screen done (with the chin monitor slid back). Inverse of Pedals.

1. Fit each pedal with its 4 screws. The pedals provide the centring information for the pedestal, so fit them first.
2. Plug each pedal into its USB controller (see Leo Bodnar controllers).
3. Slide the chin monitor back into its normal position.

## Refit seat base

Needs first: nothing, the Centre pedestal is still out. Inverse of Seat base.

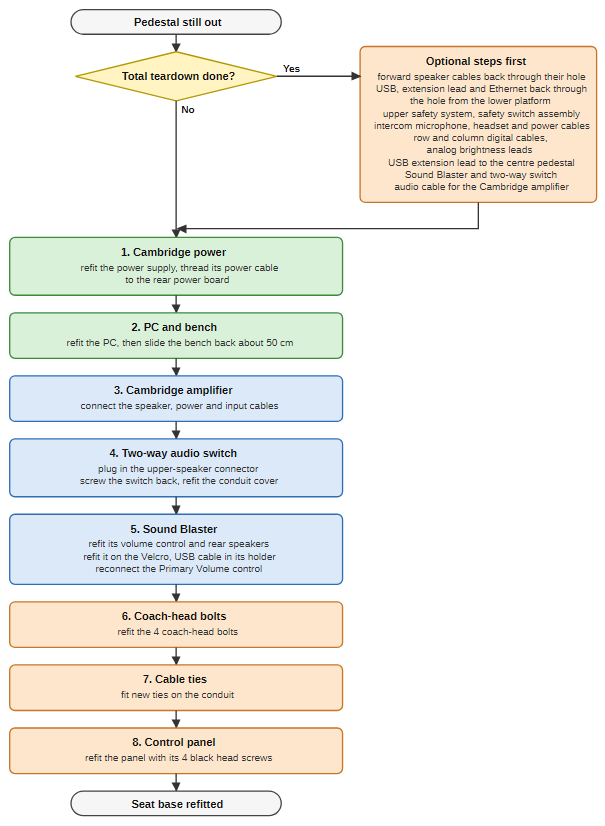
[picture p236: figure]

Figure 4: Seat base reassembly.

### Optional steps, only if a total teardown was done

1. Slide the forward speaker cables back through their through hole.
2. Slide the USB from the platform, the extension lead and the Ethernet cable back through the hole from the lower platform. Leave the safety switch assembly in the cabin.
3. Reconnect the upper safety system at the emergency stop switch-off.
4. Refit the safety switch assembly on the board holding the safety switch and intercom.
5. Refit the power cable for the intercom.
6. Refit the microphone and headset cables for the intercom.
7. Refit the row and column digital cables and the analog brightness leads.
8. Refit the USB extension lead to the centre console.
9. Refit the USB Sound Blaster and the two-way audio switch (kept connected together).
10. Refit the audio cable for the Cambridge amplifier.

### Main steps

1. Refit the Cambridge power supply.
2. Thread the Cambridge power cable to the power board at the rear of the platform, from the back of the bench to the right.
3. Refit the PC.
4. Slide the bench back approximately 50 cm into place.
5. Connect the speaker, power and input cables to the Cambridge amplifier.
6. Plug in the connector on the co-pilot side that goes to the upper speakers.
7. Screw the two-way audio switch back (these screws are unpainted) and refit the cover on the vertical conduit.
8. Refit the Sound Blaster volume control and plug in its rear speakers.
9. Refit the USB Sound Blaster on its Velcro, and put its USB cable back in the cable holder.
10. Reconnect the Primary Volume control to the bench-measured [text incomplete in the notes].
11. Refit the 4 coach-head bolts.
12. Fit new cable ties on the conduit carrying the control, power and Ethernet cables (a vertical and a horizontal cable).
13. Refit the panel holding the intercom, the platform start/stop and the emergency stop controls with its 4 black head screws.

## Refit collective control

Needs first: Refit seat base done. Inverse of Collective control.

1. Refit the collective assembly as a whole: two bolts on the co-pilot side and 4 in the centre (the top one painted black). The long bolts are forward.
2. Reconnect the electronics to the Leo Bodnar board: collective digital, analog throttle and analog collective (see Leo Bodnar controllers).

## Refit pilot seat

Needs first: Refit collective control done. Inverse of Pilot seat.

1. Roll the seat in from the centre of the cabin.
2. Fit the bolts and tighten the nuts (easiest with a spanner). The bolts are 1/4 inch.
3. Refit the screws holding the black blanking flute.
4. Take care not to touch the grease on the rails.

## Refit cyclic controls

Needs first: Refit pilot seat done. Inverse of Cyclic controls.

1. Refit the Leo Bodnar controller with the cyclic (see Leo Bodnar controllers).
2. Co-pilot bolts: insert them from underneath (1/4 inch).
3. Pilot bolts: the forward bolt is inserted from the top; the rear bolt stays permanently installed (1/4 inch).
4. Refit the cyclic, then the cyclic weight. The clearance is tight for the console.

## Refit co-pilot seat

Needs first: Refit cyclic controls done. Inverse of Co-pilot seat.

1. Lift the seat into the cabin and roll it from the centre of the cabin into position, keeping the rails synchronised.
2. Use the seat lever on the upper side to raise the seat from its collapsed position.
3. Slide the seat to the rear and fit the front bolts.
4. Slide the seat forward and fit the rear bolts (1/4 inch; the two rear bolts stay attached to the rail).
5. Refit the 5 screws holding the black blanking flute.
6. Take care not to touch the grease on the rails.

## Refit centre pedestal

Needs first: Refit co-pilot seat, Refit pedals and Refit front panels all done (the front screen and chin screen are done by then). Inverse of Centre pedestal.

1. Roll the pedestal forward from the rear of the cabin, with great care so that the front screen is not damaged.
2. Reconnect the cables.
3. If the centre console was drilled out: the heads of the bolts attaching it to the floor must be below the top face so that the electronics will fit.

# Post reassembly checks

1. Check the ESTOP.
2. Check the door sensor.
