bnepethomas/bne-arduino-flight-simulator-interfaces/Jet Ranger/Jet Ranger Documentation/206 Build 2025.odt

The Jet Ranger Build

# 2026 Rebuild Notes

Dev Machine installed COWAN and Flyinside for MSFS2024 and Dodo for P3dv6

Now using MSFS2024 with Air Manager v5 to display 2d panels.

With the FlyInside 206 whilst chunks of the default 206 instruments work on the Air Manager 206 panel, the following gauges are not displaying correctly

- Engine Rotor RPM
- Engine Torque

Testing Cowan Sim 206

Installing COWAN Simulator

To install the CowanSim 206 for Microsoft Flight Simulator, first, ensure you can see hidden files on your computer by selecting "Hidden items" in the File Explorer's "View" tab. Then, extract the downloaded aircraft files and move them directly into the "Community" folder of your MSFS 2020 installation.

C:\Users\beeper\AppData\Local\Packages\Microsoft.Limitless_8wekyb3d8bbwe\LocalCache\Packages\Community

for msfs20204

C:\Users\beeper\AppData\Local\Packages\Microsoft.Limitless_8wekyb3d8bbwe\LocalCache\Packages\Community2024

Cowan Sim panels not displaying correctly

- VSI
- Torque measures too higher-level
  - 72 →32
  - 90 → 42
  - 100 → 44
- No Transmission Oil Temperature and Pressure
- No Turbine Out Temperature

Gauges that are ok

- Eng Oil
- Fuel
- Load
- Gas Producer
- Airspeed
- Rotor and Turbine
- Radar Altimeter
- Attitude Indicators
- Altimeter
- Slip

msfs_variable_subscribe("ELECTRICAL MAIN BUS VOLTAGE", "Volts",

"CIRCUIT PITOT HEAT ON", "Pitot", -- Pitot

"FUEL TOTAL QUANTITY", "Gallons", -- Fuel < 17?

"FUELSYSTEM ENGINE PRESSURE:1", "PSI", -- Fuel pressure

"ROTOR CHIP DETECTED:1", "Bool", -- Main chip

"ROTOR CHIP DETECTED:2", "Bool", -- Tail chip

"A:ENG OIL PRESSURE:1", "PSI", -- XMSN press < 15?

"ENG OIL TEMPERATURE:1", "Celsius", -- XMSN temp > 115?

"ELECTRICAL BATTERY LOAD:1", "Amperes", -- Battery temp > 87 -- Battery hot > 130

"ENG N1 RPM:1", "Percent", -- N1 < 55

"ENG COMBUSTION:1", "Bool", -- False

"GENERAL ENG MASTER ALTERNATOR:1", "Bool", -- False

"FUELSYSTEM PUMP ACTIVE:1", "Bool", -- Fuel pump

"FUELSYSTEM PUMP ACTIVE:2", "Bool", -- Fuel pump

"ROTOR RPM PCT:1", "Percent", -- <= 95

"L:buttonAnnTest", "Double", new_warnings_fs)

function new_warnings_fs(volts, pitot, fuelq, fuelp, xmsn_chip, tr_chip, xmsn_press, xmsn_temp, bat_load, n1, combustion, alternator, pump_1, pump_2, rotor_rpm, test)

power = volts > 10

-- No function

visible(img_mask[1], false)

-- No function

visible(img_mask[2], false)

-- Pitot heat

visible(img_mask[3], pitot and power)

-- Fuel low

visible(img_mask[4], fuelq <= 17 and power)

-- AF fuel filter

visible(img_mask[5], fuelp == 0 and power)

-- Fuel filter

visible(img_mask[6], false)

-- Engine chip

visible(img_mask[7], false)

-- Battery hot

visible(img_mask[8], bat_load >= 130 and power)

-- Trans oil press

visible(img_mask[9], xmsn_press <= 15 and power)

-- Engine out

visible(img_mask[10], (n1 <= 55 or not combustion) and power)

-- No function

visible(img_mask[11], false)

-- No function

visible(img_mask[12], false)

-- No function

visible(img_mask[13], false)

-- No function

visible(img_mask[14], false)

-- No function

visible(img_mask[15], false)

-- Gen fail

visible(img_mask[16], not alternator and power)

-- Fuel pump

visible(img_mask[17], (not pump_1 or not pump_2) and power)

-- T/R chip

visible(img_mask[18], tr_chip and power)

-- Trans chip

visible(img_mask[19], xmsn_chip and power)

-- Battery temp

visible(img_mask[20], bat_load >= 87 and bat_load < 130 and power)

-- Trans oil temp

visible(img_mask[21], xmsn_temp >= 115 and power)

-- Low rotor RPM

visible(img_mask[22], rotor_rpm <= 95 and power)

-- Annunciator test

visible(testfg, test == 1 and power)

end

# Todo’s

- Add 8*8 input for upper panel – Mega
- Validate python to SimCOnnect and FSUIPC offsets for Dodo.
- Routed power and HMDI leads from front screen underneath the platform.
- Add USB hub powered by External PC PSU. Look at using existing power distribution panels.
  - Connect Sound Blaster external Sound Card.
- ADF needs a 3rd rotary, in the mean time map the RH rotary, clockwise to increment 0.1’s, counter clockwise to increment 1s. LH rotary, clockwise to increment 10s, counter clockwise to increment 100s.
- Valid VOR tones are coming through headsets.
- Draw out audio system structure
- Remove hum from overhead speakers, suggest grounding both (Left and right) inputs to amp to ground. Should be able to do this as rotary switch has 4 poles.

# Simulator Startup

- Ensure Access Point is Active
- Power on Left and Right Projectors using remote. Powering up all screens is important to ensure screen layout is unchanged.
- Power on Front Screen using remote
- Turn on External PC Power Supply
- Power on PC using PC power button

# Simulator Shutdown

- Shutdown PC
- Shutdown Projectors using remote
- Shutdown Front Screen using remote

# Troubleshooting

## Inoperative modules of launch of P3D

As its takes some times for P3D to start, some of the auto-launched applications may timeout after starting, most notably the C# code. Alt-Tab, clear the dialog warning box, and click connect.

## Sound

In additional to P3D as a sound source, Dodo Sim also generates cockpit clicks, Engine Out and Low Rotor RPM sounds. As Dodo Sim does have the option to select the output device, ensure the RealTek onboard Audio Card is selected as the default Audio Device. This issue is typically encountered if a new HDMI device is added which Windows then assumes is the default audio device.

## Misaligned Views

If views are misaligned first attempt to shutdown the computer and then repower up. Do not simply restart the computer. If the views are permanently misaligned then prepare for pain. P3D tends to explode when shifting views around. So it is worth doing one step at a time and then exit P3D to allow the settings to persist.

First turn on the menu bar, and exit full screen mode. One this is done exit. Then relaunch P3D and move windows to correct position, the main screen will be put back into full screen mode go get it in place, exit, relaunch and the reposition instrument panel and knee monitor. Generally it seems more reliable to do this as P3D is loading the scenario.

# The Build Process

FSX installed

Dodo, ran up no gauges displayed

Installed FSX Acceleration, Dodo gauges now displaying correctly

Installed DoDo SP2

Re-asked about trusting the Dodo plugin

Installed FSUIPV

Pasted panel.cfg into the low skid

Panel undocked

On the Russ Cool Panel, the difficulty setting knob is located underneath the Temperate Display.

# CKAS Platform

As September 2025 two drivers are needed to interface the CKAS v4 6dof to MSFS2024. The drivers are bundled in GENERIC.ZIP found at:

https://www.dropbox.com/scl/fo/8yi65aqoaf3mk41u2tdv7/ABmutMLNO-6xkF-Fy05Db7w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

Install SimCor (Setup CKAS SimCor.exe) and then SimDX (SimCorDX_207_Setup.exe).

Once installed rename simConnectShim.dll to not_used_simConnectShim.dll, this is needed to be done otherwise SimCor exits when MSFS2024 starts.

The COM port of the platform should be set to COM19.

To start the platform:

- Apply power to the Platform
- Apply power and turn on the external 12V PSU. This is needed to arm the safety interlocks.
- Start SimCor – if the platform is correctly armed (including the safety switch inside the cabin), the platform will rise to a mid position. If the external 12V PSU is powered off the platform will return a the low park position.

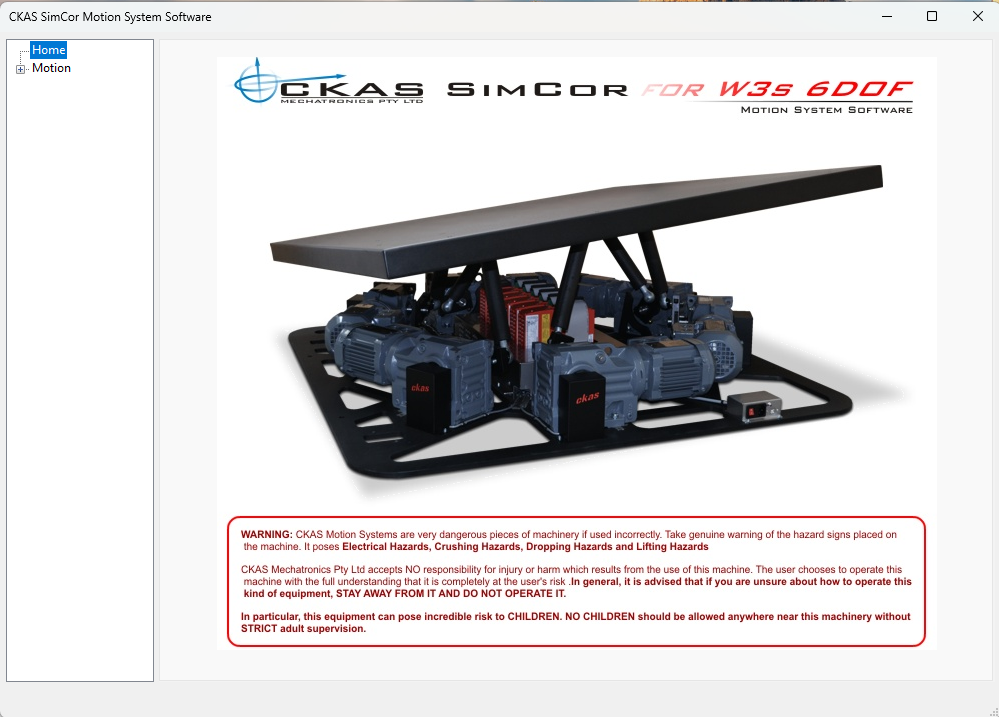
[picture p285: figure]

- If so desired platform movement can be tested using the jog function. Note the vertical action appears inversed, i.e. if Z is dragged to the lower position, the platform rises. If you have tested the jog function – remember to return the input back to model

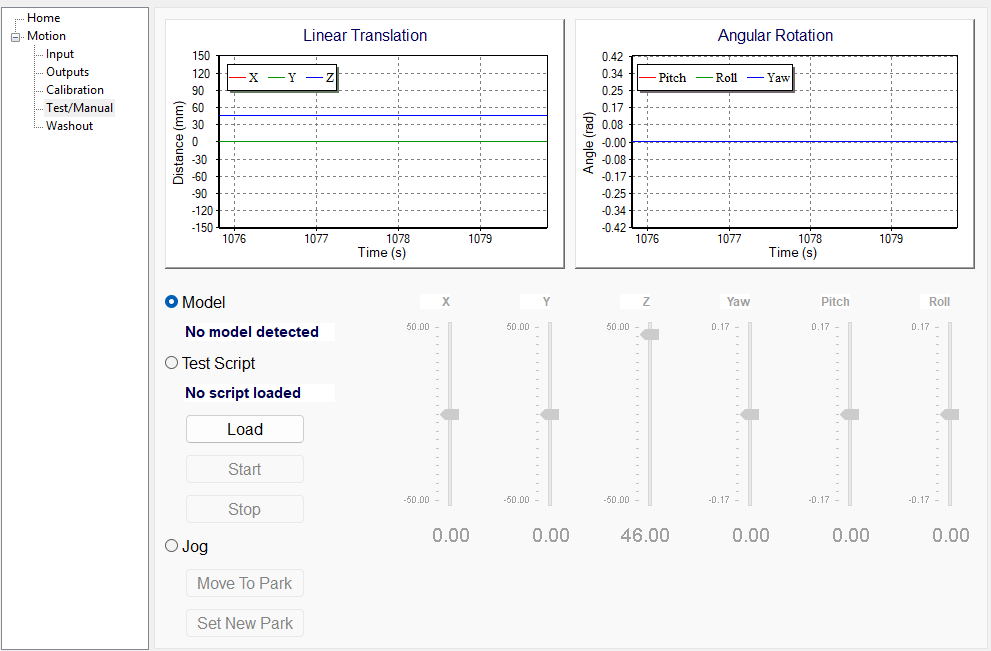
[picture p286: figure]

- Start SimCor DX, you may get a warning re the platform not responding if you have not returned the input on SimCor from Jog to Model , check the lower panels for status.

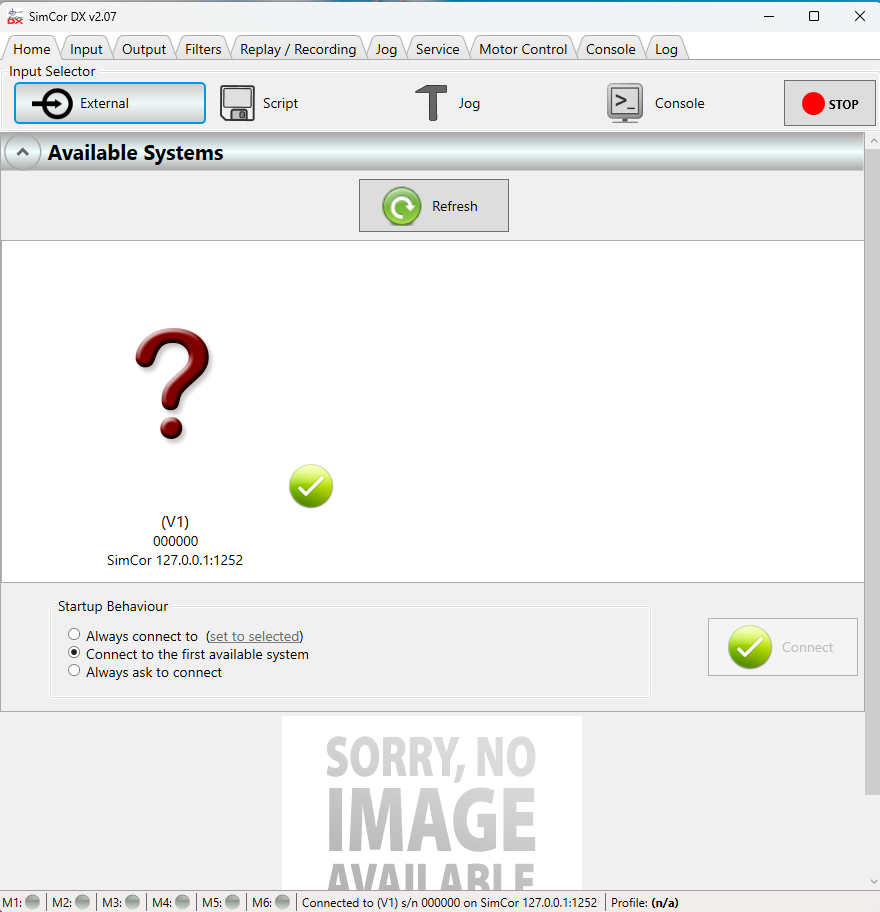
[picture p287: figure]
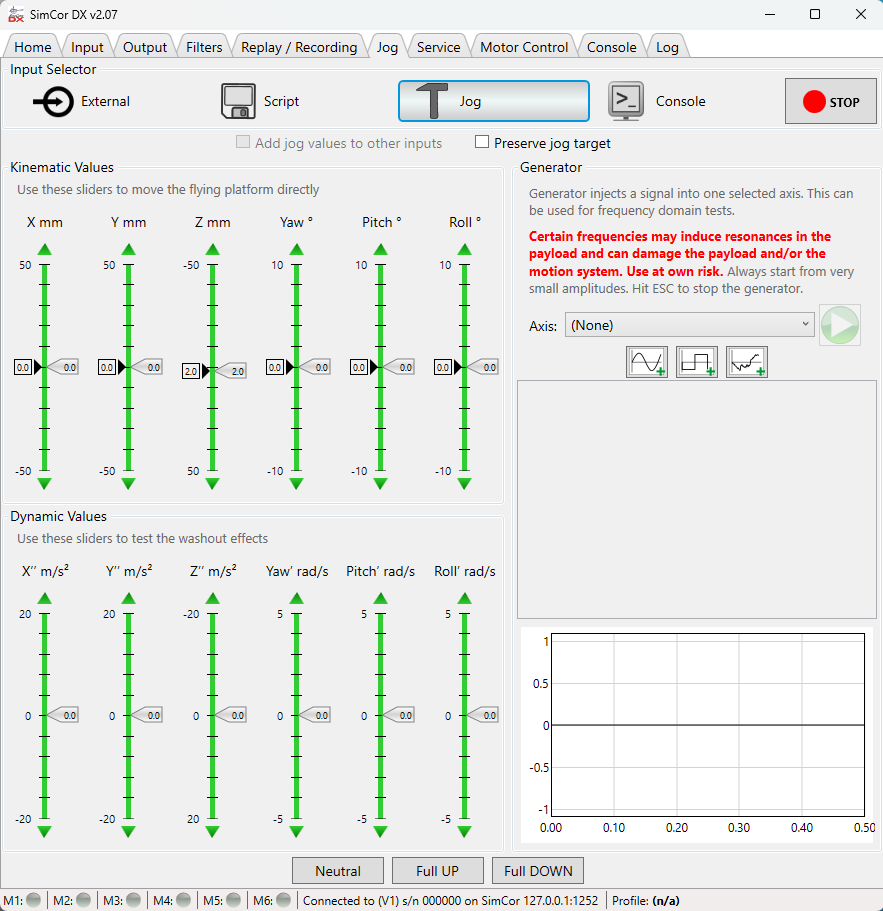
[picture p288: figure]

## CKAS Failure mode

In very rare occasions the platform has had a motor move out of step – in Sept Motor 4 moved to incorrect position. Cycling the power for the platform may help, but ultimately identified the positioning sensing belt must have slipped as the indexing marks were no longer aligned. Held the belt against the pot and adjust the belt and potentiometer to align. As part of troubleshooting noted the led at the top of the 4th motor controller was flashing red which suggests some form of over current protection was being applied. The motor controller leds all started green, and then once motors tried to move the motor controller led changed from green to red.

## Platform Safety Features

The platform uses a combination of an in-cabin center mounted Safety Push button (twist to release), and a magnetic reed switch on both doors. Both doors have to be closed and the safety switch released before the platform will move.

If a safety event is triggered the platform will return to a rest position. The status of the door sensors is reflected at the top rear of the cabin.

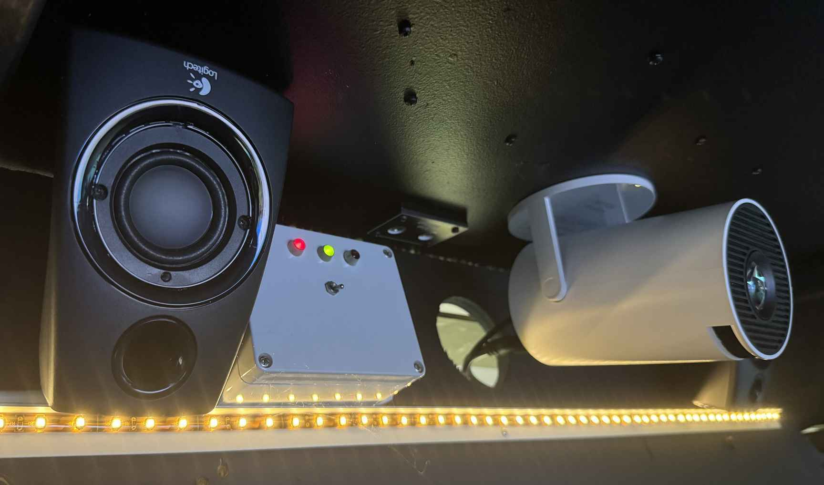
[picture p289: figure]

Figure 1: Safety Sensor Monitor

Chris’s Notes

Please make sure to read how to do this correctly in the Legacy Mode section of the SimCorDX manual – you must ALWAYS run SimCor first! Then run SimCorDX afterwards.

Initially had an older CKAS driver, which exploded when running P3D.

The Drivers can be found at www.ckas.com.au/downloads/Setup%20CKAS%20SimCor.exe (https://mail.cisco.com/owa/redir.aspx)

As of Oct 2014 the file version is 1.0.0.21

# Building the Computer

### Install Operating System

- Turn on visibility of hidden files and file extensions in explorer
- If using Samsung SSDs optionally install the Samsung Drive Monitoring Software
  - http://samsung.com/magician

#### Assign Static IP Address to Ethernet Connecting to Pit

Control Panel → Network and Internet → Network Connections. As the simple interface demands a default gateway and DNS be set, which is not used for this interface.

A static address (172.16.1.10/24) is used to receive switch events for MSFS 20202 as well as monitoring updates from the Arduino environment. If this address is not defined DCS interfaces will operate but updates may be slow due to the Arduino waiting for a timeout in resolving the ARP for the reflector. If it is not planned to use this link then is it recommended the following values be set to 0 in the Arduino code.

#define Reflector_In_Use 1

#define MSFS_In_Use 1

### Install Documentation Tools

- These tools were chosen as they are cross-platform and lightweight
- LibreOffice - https://www.libreoffice.org/
- Draw.io – Offline installer – https://get.diagrams.net/.
  - Primary site - https://www.diagrams.net/

### Install Development Environment

- Install Github –
  - http://desktop.github.com/
  - add primary repository -
    - https://github.com/bnepethomas/bne-arduino-flight-simulator-interfaces
- Instal Notepad++ https://notepad-plus-plus.org/downloads/
- Install Arduino IDE – including libraries used (built-in if author is not listed)
  - https://www.arduino.cc/en/software
  - Ethernet – 2.0.2
  - Keyboard – 1.0.6
  - Mouse – 1.0.1
  - Servo 1.2,2 – Michael Margolis
  - Stepper 1.1.3
  - AccelStepper – 1.64.0 – Mike McCauley
  - Adafruit GFX Library – 1.12.2
  - Adafruit SSD1306 – 2.5.15
  - LedControl – 1.0.6 – Eberhard Fahle
  - U8g2 – 2.35.2 – oliver
  - U8g2_for_Adafruit_GFX – 1.8.0 – oliver
  - DCS-BIOS 0.3.1 - Puma
- Install Python – minimum release 3.10 (for Case Statement support)
  - Add python.exe to PATH
  - Install python modules
    - pythonping (used in pyHWLink_System_Check.py)
    - SimConnect. Originally I had to use a fork on SimConnect, but the original project https://github.com/odwdinc/Python-SimConnect has now fixed the error, so using it.
      - Pip install SimConnect (0.4.26)
      - The module will be validated once MSFS 2000 has been installed.

### Install Utilities

- Sim21 uses a Gigabyte Motherboard with AM CPU. Use the Gigabyte Control Center to install additional drivers as the no ability to setup 4 way speakers before adding Realtek audio driver through the control center
  - Once the audio driver is installed the speakers needed to be disconnected and reconnected, and that then gives opens for front and rear speakers. The settings are found in System → Sound → More Sound Settings. This then brings up the Sound panel that enables you to set the configuration of the Speakers, I.e.e Speakers Configure → Quadraphonic. Ensure the Speakers are set to default device.
  - The wireless driver is Wifi 6E compatible and achieves performance of north of 650Mbps with SpeedTest, DCS updates currently top out at 250MBps irrespective of whether the connection is wired or wireless.
- Turn off Power Save Modes. In order to prevent unwanted impacts during software updates, set Turn my Screen Off, Make my Device sleep, and Make my device hibernate to Never under System → Power.
- Nirsoft Multi Monitor Tool
  - https://www.nirsoft.net/utils/multi_monitor_tool.html
- Nirsoft Device Viewer
  - https://www.nirsoft.net/utils/device_manager_view.html
- USB Tree View
  - https://www.uwe-sieber.de/usbtreeview_e.html#download
  - To test restart USB by command line
  - https://www.uwe-sieber.de/misc_tools_e.html#restartusbport
- Wireshark
  - https://www.wireshark.org/download.html
- Auto Logon from Sys Internals
  - https://learn.microsoft.com/en-us/sysinternals/downloads/autologon
  - Run autologon so login occurs automatically – may want to create a local account.

### Install Backup/Imaging Software

- Currently use Acronis True Image – but the perpetual licenses are no longer available – so may need to look for alternatives.

### Install DCS

### Install MSFS 2020

- Start MSFS 2020 and sign in
- Run ‘Python HW Link\pyHWLink_SimConnect_Transmitter.py’

### Install Visual Studio

Install MSFS 2024 SDK

### Install Fly Elise

- Play the USB dongle in a port
- Install Fly Elise Display Pro (https://fly.elise-ng.net/immersive-display-pro/) Version 4.5.3
- Start Fly Elise Display Pro and Validate correct details are displayed in the license screen
- Install Fly Elise Calibration Pro Version 5.0.2. Download Zip, extract and then copy to a folder.
- Refer to “Building and Deploying A Curved Screen” for further details. Of note is the importance of allocating keystrokes to:
  - Start Warp
  - Stop Warp
  - Enable 2D Warping
  - Enable 3D Warping
- Start MSFS 2020 and validate screen is correctly displayed. MSFS SU10 enabled Surround and multiscreen support which improves the curved screen experience. Largely it reduces the distortion encountered ad the edges of the screen, ideally meaning lampposts are no longer leaning over. The Fly Elise team have noted that the surround view support still has room for improvement (as of Oct 2022).

### Install Orbx Central

- Note different pits may operate under different accounts
- Download scenery of interest

### Configure DCS

- Start DCS and load desired modules (eg Syria, Hornet)

### Install and Configure Flight Panels DCS-BIOS

- Clone in GitHub Desktop https://github.com/DCS-Skunkworks/dcs-bios
- Should have already install Arduino DCS-BIOS library.
- Connect the pits USB port
- Statically assign COM Port numbers for the Arduino’s using the noting the Arduino Serial Numbers
- Ben’s document provides a useful guide to setting up Flight Panels DCS-BIOS fork (DCS-BIOS-FLIGHTPANELS.pdf (https://github.com/DCSFlightpanels/dcs-bios/blob/master/Scripts/DCS-BIOS/doc/DCS-BIOS-FLIGHTPANELS_Install%20Guide.pdf))
  - THE FOLLOWING STEPS NEED TO BE VALIDATED!
  - Extract and copy the SOCAT.EXE to the programs directory within the git Repo
  - Edit the batch file to reflect the serial ports in use.
  - Add a taskbar shortcut to the CMD file – Error: Reference source not found

# Screen Layout

All screens are 1920*1080. The Left and Right Screens use small projectors, the primary screen is an old 70” Hisense TV. The Chin screen is a 24” screen.

Left (3) | Front - Primary (2) | Right (1)
| Chin (4)

DCS Screen Size 5760*2160

-1920,0 | | | 0,0 | | | 1920,0 | | 3840,0
-1920,0,1079 | | | | | 1919,1080 | 1920,0,1079 | | 3840,0,1079
| | | 0,2159 | | 1919l,2159

Using Top left monitor as reference point

0,0 | | | 1920,0 | | | 8400,0 | | 5760,0
0,0,1079 | | | | | 3839,1080 | 3840,0,1079 | | 5760,0,1079
| | | 1920,1080
| | | 1920,2159 | | 3839,2159

The Video card is a Nvidia 5090

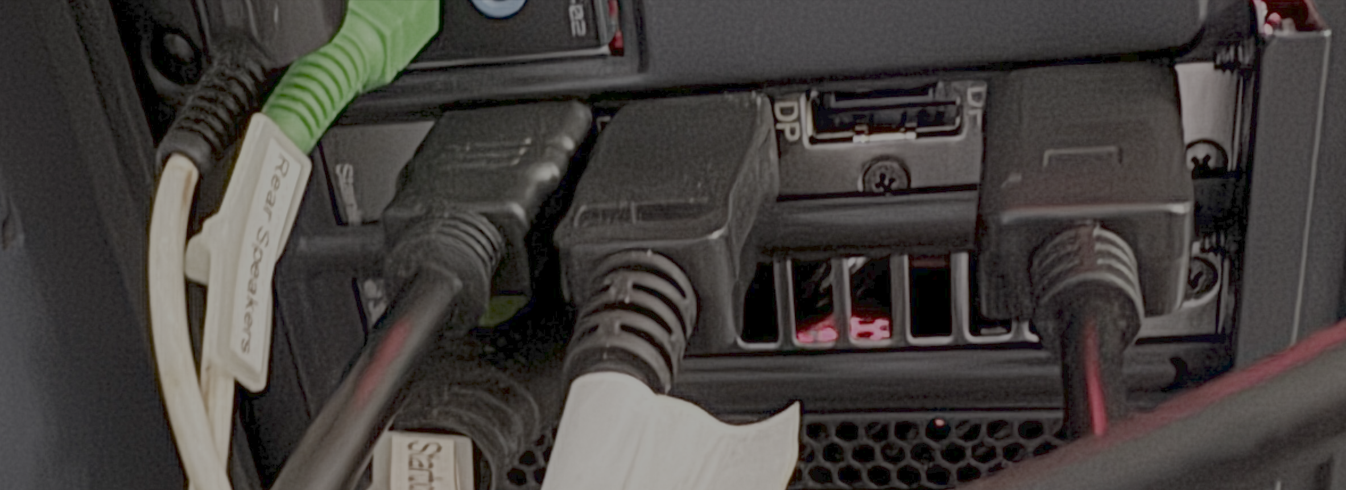
[picture p290: figure]

Figure 2: 5090 Connections

Front | Left | Not Used | Chin
Right

The Left screen is connected through a display port to DVI cable, which then has a DVI to HMDI adapter. The Chin screen is a Display Port to HDMI cable.

# MSFS2024 Configuration

MSFS2024 does support multiple views, although they views still lack flexibility in the UI for Zoom. Whilst initial setup may be done in windowed mode, operating mode should be in full screen. Earlier learnings with MSFS2020 and multiple screens can be found in the following link on GitHub - https://github.com/bnepethomas/bne-arduino-flight-simulator-interfaces/blob/master/Hornet/Hornet Documentation/Building and Deploying A Curved Screen.odt.

Three additional views can be troubling to configure as MSFS does not freeze the view while windows are being configured. When adding a new view it typically appears somewhere need an edge on the primary view.

View | Lateral rotation offset | Vertical rotation offset | Roll rotation offset | Windowed
Window 1 | 90.6 | 0 | -11.1 | Full screen
Window 2 | -90-6 | 0 | 11.6 | Full screen
Window 3 | 24.6 | -33.5 | 0 | Full screen

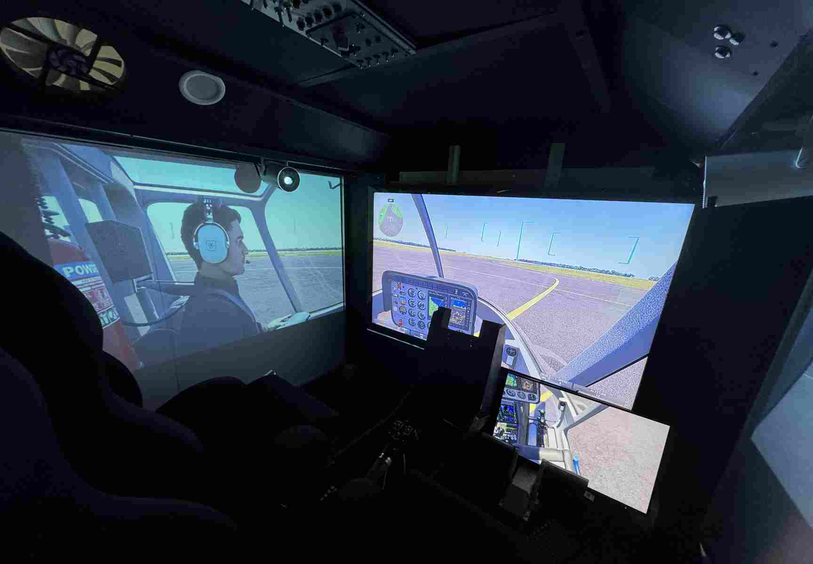
[picture p291: figure]

Figure 3: Camera Views

Left =

{

x = 0;

y = 0;

width = 1920;

height = 1080;

viewDx = -0.785; -- 45 degrees left

viewDy = 0;

useAbsoluteAnglesShift = true;

},

If a configuration error is made in monitor.lua then the entire screen is filled with the main GUI

## ✅ useAbsoluteFOV = true

When set to true, the FOV value you specify becomes an absolute FOV, measured in radians, defining exactly how wide the camera view is for that viewport.

- Your FOV is not influenced by the game’s zoom system
- If you set FOV to 1.0, that’s 1 radian (~57.3°)
- Each viewport gets its own fixed, literal FOV
- Useful for multi-projector or multi-monitor curved screen setups where you want geometric correctness

This makes DCS use the viewport as a true camera frustum.

Noted that loading times are negatively impacted if DCS update is being downloaded in the background, Been stuck at 25% for a number of minutes,

# Duplicating the Drive

A test was run using a 2TB Samsung drive. The Samsung Data Migration tool is now part of the Samsung Magician. A USB to Drive adapter was tried but the new disk was not recognised by either Samsung Magician or Acronis. Had to connect the drive to the internal drive cables for it to be recognised.

# Controlling the Computer using USB

Despite a computer providing power to all USB ports as soon as power is applied, there is no mechanism to use a USB interface to trigger a computer to power up. However, a Wake-On-Lan packet can be sent from both wired and wireless devices on the same VLAN. Using Nico-HID library a Leonardo can concurrently appear as a keyboard and joystick. The Keyboard emulation can be used to trigger a power down and adjust volume.

Full code is in Jet Ranger\Arduino Sketches\Joystick_Volume_Power_Down

Testing of the HID device can be done using either the windows Game Controllers panel or Gamepad Tester - Check Controllers and Joysticks Online (https://hardwaretester.com/gamepad) (https://hardwaretester.com/gamepad)

# Wake On Lan

As there is no USB based mechanism to power on a PC, Wake on Lan is used. ChatGPT provided the following working example. Full code is in Jet Ranger\Python Code\send_wol.py.

def make_magic_packet(mac_bytes: bytes) -> bytes:

"""Construct the 6 x 0xFF header + 16 repetitions of MAC."""

return b'\xff' * 6 + mac_bytes * 16

def send_magic_packet(mac: str, ip: str = '255.255.255.255', port: int = 9, repeat: int = 3, timeout: float = 1.0):

mac_bytes = normalize_mac(mac)

packet = make_magic_packet(mac_bytes)

# UDP broadcast socket

with socket.socket(socket.AF_INET, socket.SOCK_DGRAM) as sock:

sock.setsockopt(socket.SOL_SOCKET, socket.SO_BROADCAST, 1)

sock.settimeout(timeout)

for i in range(max(1, int(repeat))):

try:

sock.sendto(packet, (ip, int(port)))

except Exception as e:

raise RuntimeError(f"Failed to send magic packet (attempt {i+1}): {e}")

The output is as follows (Mac Address is Sim21 motherboard NIC):

python3 send_wol.py 10:ff:e0:b5:b4:bd

Magic packet sent to 10:ff:e0:b5:b4:bd via 255.255.255.255:9 (x3)

# PCB Design Notes

Later Builds of the Hornet Controller PCBs added a Polyfuse and LEDs for monitoring the power rails.

Rail | Colour | Resistor Value
USB 5V | Red | 5K
External 5[^1] | Blue | 5K
12V | Yellow | 10K
Red Status | Red | 5K
Green Status | Green | 5K

# Differences between the Arduino Mega and Due

Whilst the pin layout is similar between the Arduino Mega and the Due there are some differences in pin usage and library capabilities.

## Behaviour and Library differences

There was some instability when programming the Due which has still not been root caused when using the Mac (PC to be tested). When programming using the USB PROG port (nearest the power input), the sketch upload would fail repeatedly unless the USB port was moved to the USB NATIVE port, an up load would fail, move the port back to the USB PROG port and then the upload would succed.

Interesting observation from the Arduino forums[^2]:

The programming port can be temperamental, it disconnects just before programming, and reconnects as a different device.... bosa/bossac? port (something like that) , so you likely see 2 different devices for the programming port.

BUT the native port, there is a fairly well documented 'trick'..... when the sketch compiles, and you see the size of the sketch in white.... press the reset button...... try this several times..... you will get the hang of it eventually.

Another notable difference was the Wire library for the Due does not include Utility TWI (#include "utility/twi.h") which meant code block used to discover I2C devices no longer compiles.

if (!twi_writeTo(addr, &data, 0, 1, 1)) {

SendDebug("Found I2C " + String(addr));

}

## Electrical Differences

| Arduino Mega | Arduino Due
Operating Voltage | 5V | 3V3
CPU | 8-bit AVR ATmega2560 | 32-bit ARM Core Atmel SAM3X8E
CPU Clock | 16 MHz | 84 MHz
Flash Memory | 256 KB | 512 KB
SRAM | 8 KB | 96KB
Analog Inputs | 16 | 12
Analog Resolution | 10 bits (1024) | 12 bits (4096)
DAC | 0 | 2
PWM | 14-15 | 12
Pin Change Interrupt | 0-1,10-15,50-53
Interrupt | 0-1,18-21

The Due runs on 3V3 which means PCB design, especially analog inputs must only reference 3V3, so potentiometers should not be connected to 5V rail.

The Mega presents the SPI interface on both the central 6 Pin Header and Pins 50 to 53, whereas the Mega only presents the SPI interface on the Central pins, freeing up pins 50 to 53 for other purposes.

The Mega presents SDA and SCL on pins 20 and 21 at both ends of the PCB (second set is near the AREF pin). The Due presents SDA and SCL on 20 and 21 (with a 1K5 pull up) and a separate SDA1 and SCL1 near the AREF pin. These pins do not have an inbuilt pull up resistor and are referenced as WIRE1 in the TWI (Two Wire Interface) library.

The Due repurposes A12 to A15 for two DAC outputs and a CAN bus, note these still can be used for digital I/O. The Due presents PWM to pins D2 to D13

# Front Panel Layout

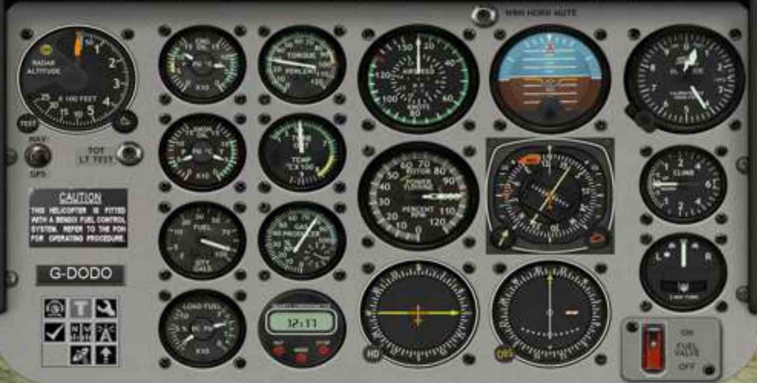
[picture p292: figure]
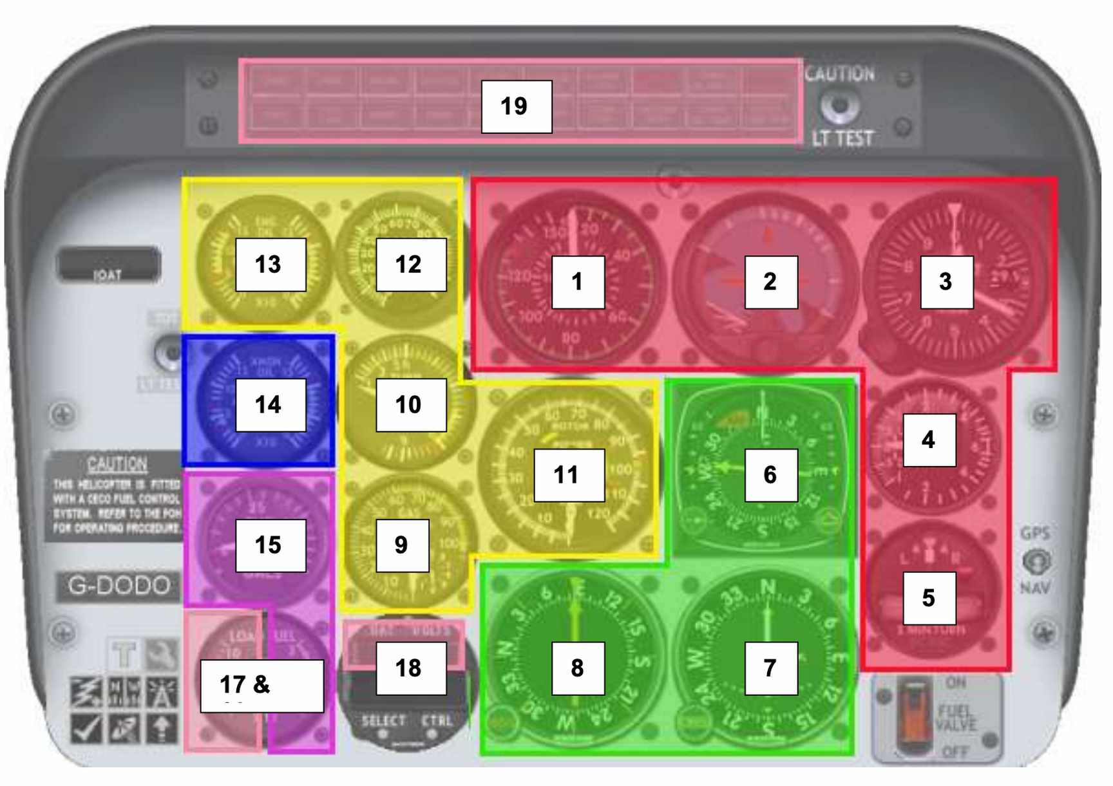
[picture p293: figure]

Flight Instruments

- Airspeed Indicator
- Attitude Indicator
- Altimeter
- Vertical Velocity Indicator
- Turn / Slip Indicator
- Horizontal Situation Indicator (HSI)
- ADF Indicator

Engine Instruments

- Gas Producer (N1) speed
- Exhaust Gas Temperature (EGT) - Also sometimes called TOT, (Turbine Output Temperature)
- Power Turbine (N2) and Rotor (NR) speeds
- Torque meter
- Engine Oil Temperature & Pressure

Transmission Instruments

- Transmission Oil Temperature & Pressure
- Fuel Level
- Fuel Pressure meter

Electrical System Instruments

- Electrical Load meter
- Volt Meter
- Cockpit Clock
- Annunciator Lights

Build and Code Approach

For each guage

- Assembly guage
- Use sweep code to find zero point, set needle just below zero point
- Build out interface code (can we use decimals for fine tuning?)
- Use Analog sweep to find max and points where non linear graduation

The Mega has PWM outputs on 2 - 13, 44 - 46[^3] giving a total 15 pins, however pin D10 is reserved for the Ethernet Module and Pin D5 is usually used for backlighting, so 13 Pins are available

Instrument | Simkits[^4] | Servos | Quick Build | Pin
| | 22 | 13
Airspeed Indicator | | 1 | 1 | D2
Attitude Indicator | L | 2
Altimeter | L
Radar Altimeter | L | 1 | 1 | D3
Vertical Velocity Indicator | S | 1 | 1 | D4
Turn / Slip Indicator | L | 2
Horizontal Situation Indicator (HSI) | L | 1
ADF Indicator | L | 3
Gas Producer (N1) speed | S | 1 | 1 | D6
Exhaust Gas Temperature (EGT) | S | 1 | 1 | D7
Power Turbine (N2) and Rotor (NR) speeds | L | 2 | 2 | D8,D9
Engine Torque | S | 1 | 1 | D11
Engine Oil Temperature & Pressure | S | 2 | 2 | D12, D13
Transmission Oil Temperature & Pressure | S | 2 | 2 | D44,D45
Fuel Level | S | 1 | 1 | D46
Fuel Pressure & Electrical Load | S | 2
Volt Meter
Cockpit Clock | S
Annunciator Lights

# Annunciator

As the annunciator has a built in test button, the ‘Spare’ annunciators do not need to be driven.

Group No | Indicator | Non-Spare
| | 15
RHS
1 | Rotor RPM Low | 1
2 | Engine Out | 1
3 | Trans Oil Pressure | 1
4 | Trans Oil Temp | 1
5 | Battery Temp | 1
6 | Battery Hot | 1
7 | Trans Chip | 1
8 | Engine Chip | 1
9 | T/R Chip | 1
10 | Baggage Door | 1
LHS
1 | Fuel Pump | 1
2 | AFT Fuel Filter | 1
3 | Spare
4 | Gen Fail | 1
5 | Spare
6 | Spare
7 | Low Fuel | 1
8 | Spare
9 | Spare
10 | SC Fail | 1
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
