bnepethomas/bne-arduino-flight-simulator-interfaces/Hornet/Hornet Documentation/Hornet Indicators Instruction Manual.docx

# Hornet Indicators

Last Update 1 Jan 2019

The Hornet Indicators provides an interface between VRS Simulations Superbug and physical display panels.

The Arduino code is owned by Glenn Weston and interfaces closely with Glenn’s Superscript. It is hosted on http://hornetpits.org/index.php?topic=501.0.

The solution has been engineered to use Network connectivity which provides a level of isolation from the Computers USB bus. This does require an additional network card[^1] and some configuration on the PC running Superscript. Data is delivered on a UDP transport, which provides a high level of isolation, enabling the Hornet Indicators solution to be restarted or
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
