bnepethomas/bne-arduino-flight-simulator-interfaces/A10/A10 Documentation/Diptrace/Play_build.jpg

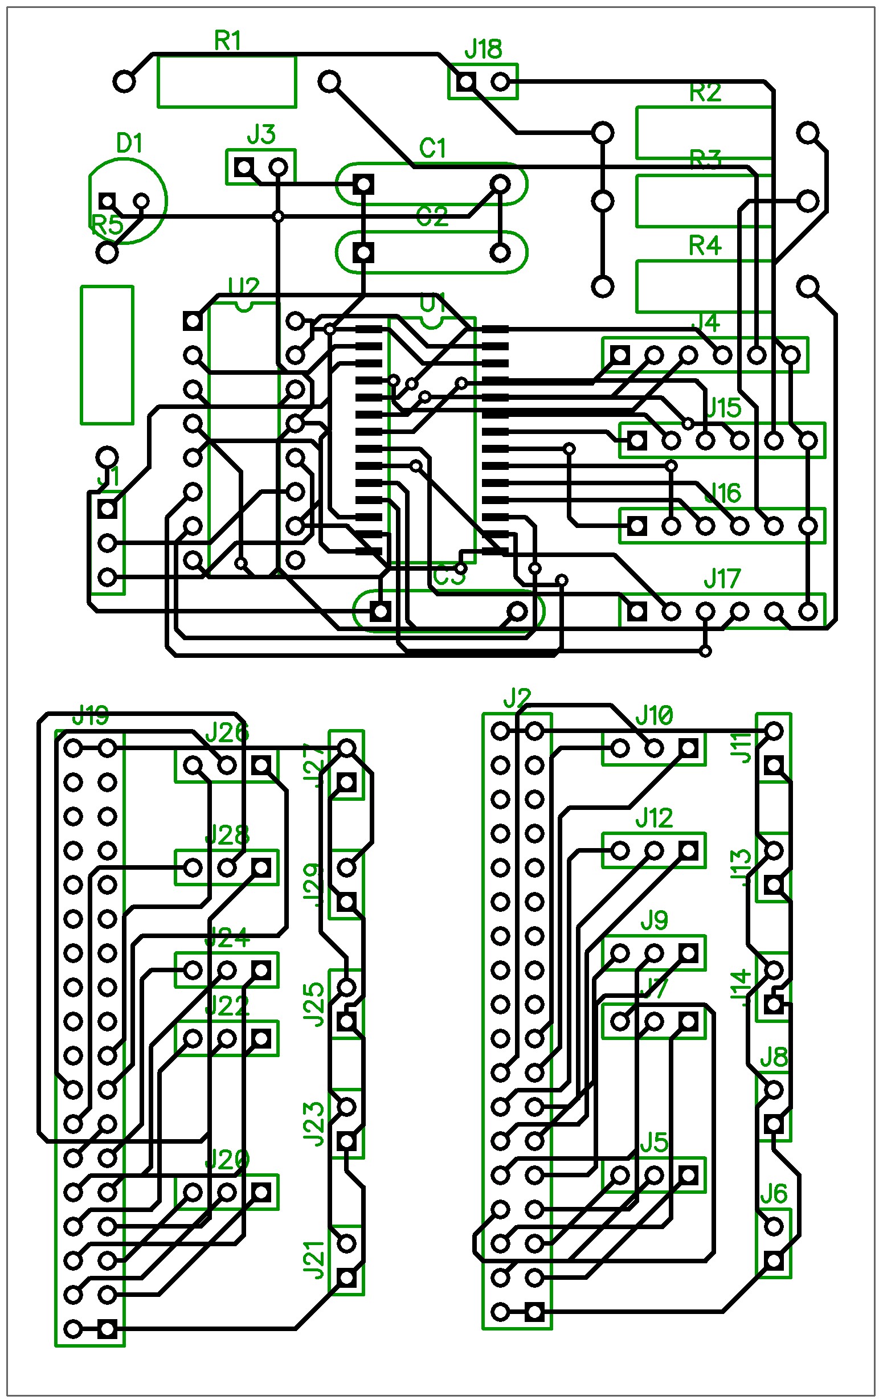
A10/A10 Documentation/Diptrace/Play_build.jpg
