bnepethomas/bne-arduino-flight-simulator-interfaces/Jet Ranger/Jet Ranger Documentation/DocBuild/diagrams/gg17.png

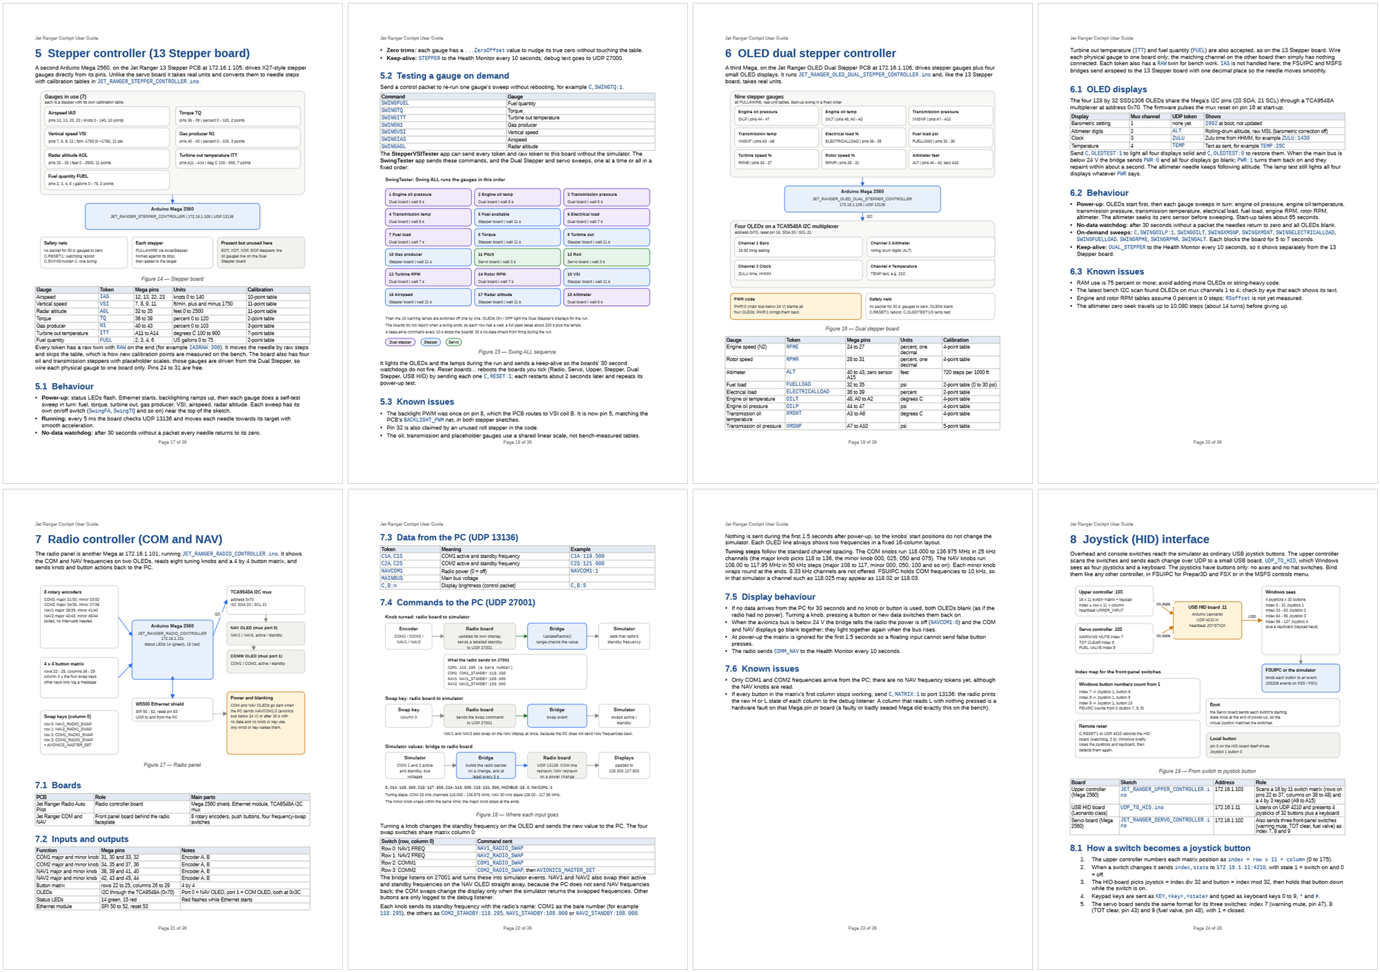
Jet Ranger/Jet Ranger Documentation/DocBuild/diagrams/gg17.png
