bnepethomas/bne-arduino-flight-simulator-interfaces/Jet Ranger/Jet Ranger Documentation/DocBuild/diagrams/gh25.png

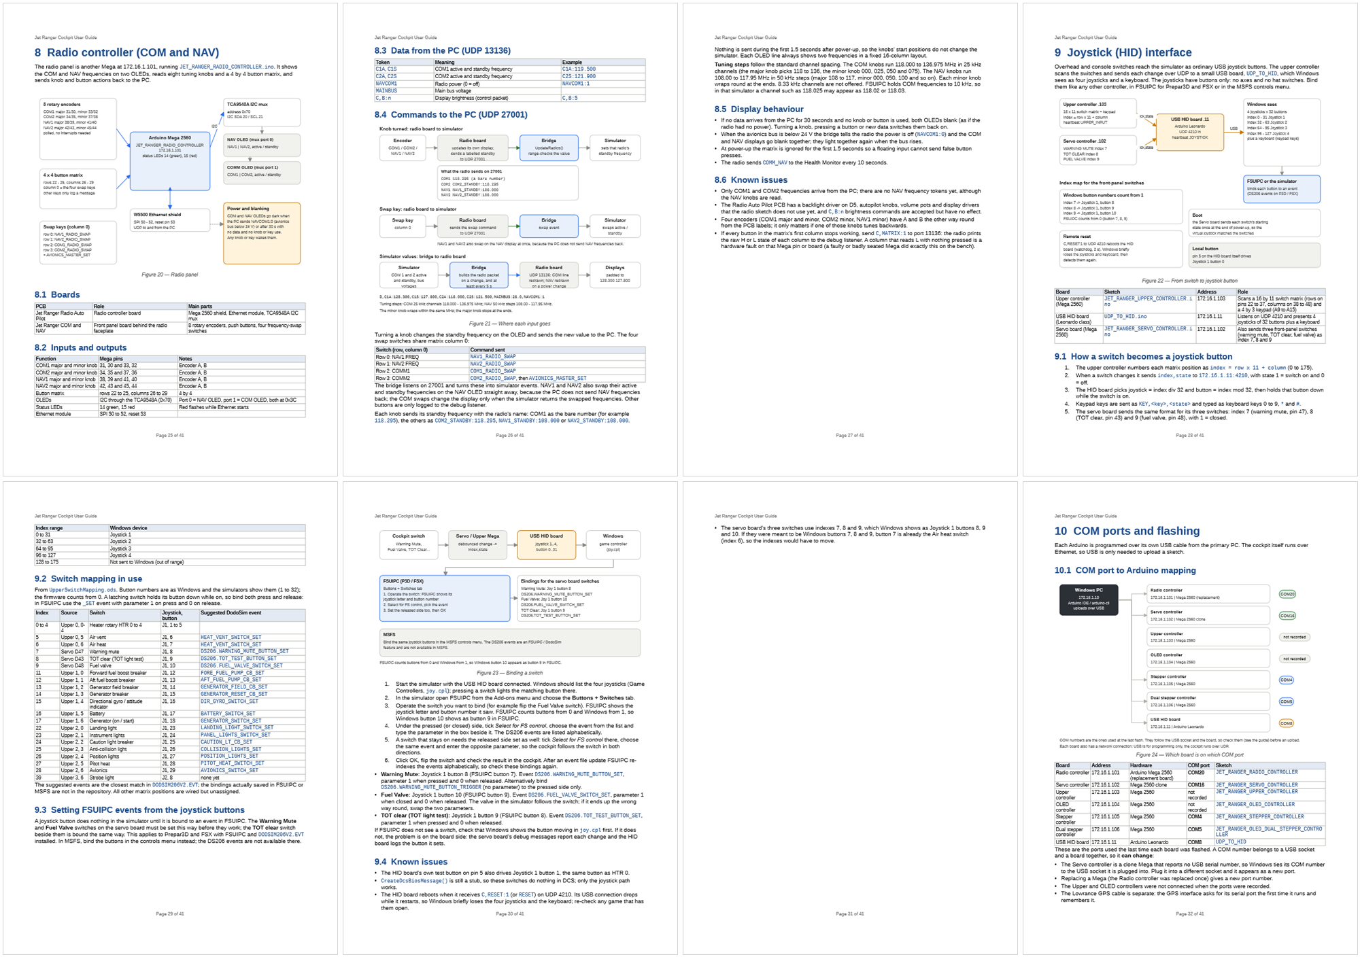
Jet Ranger/Jet Ranger Documentation/DocBuild/diagrams/gh25.png
