bnepethomas/bne-arduino-flight-simulator-interfaces/Jet Ranger/Jet Ranger Documentation/DocBuild/diagrams/gh33.png

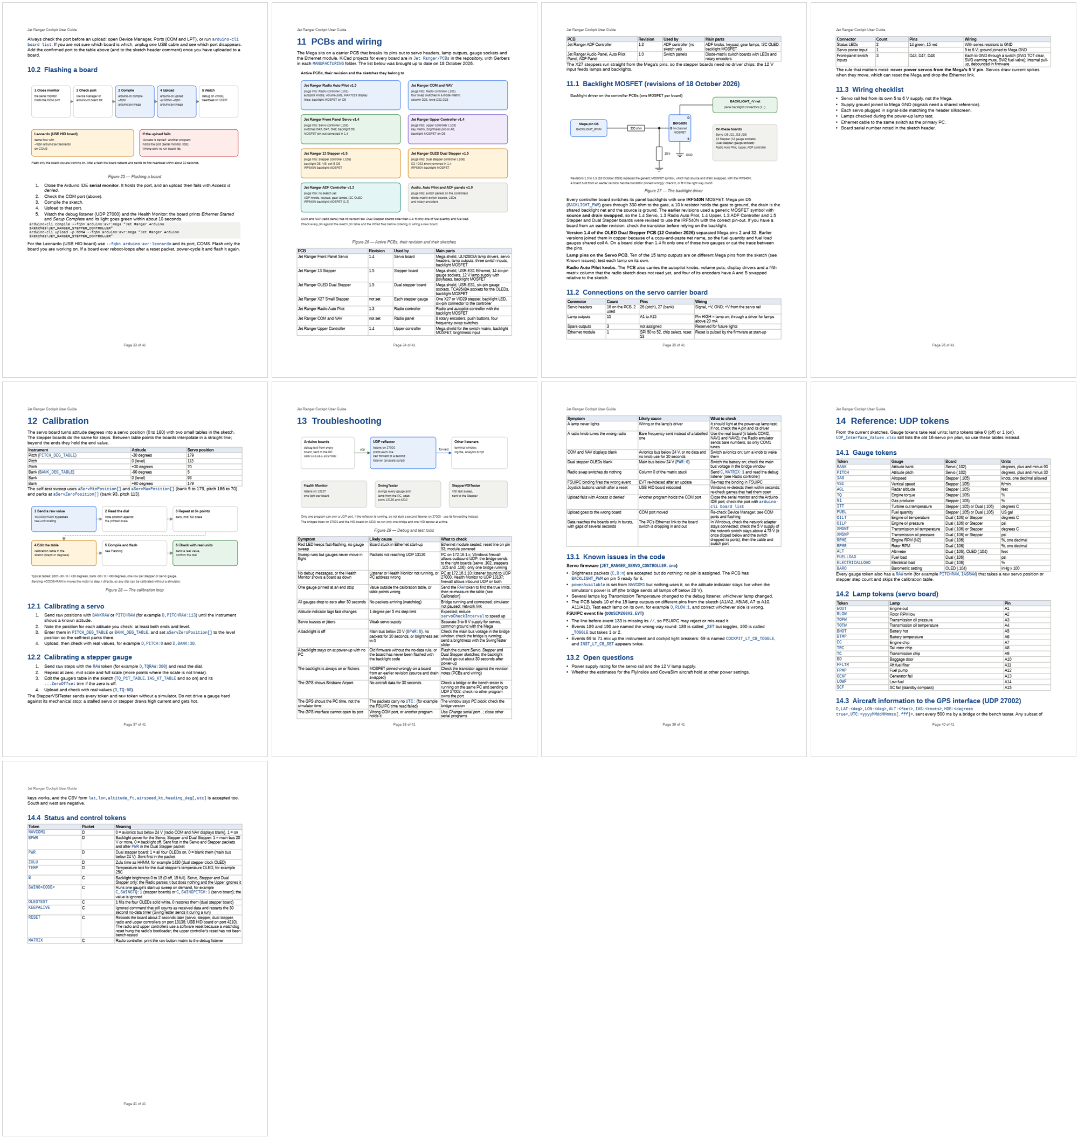
Jet Ranger/Jet Ranger Documentation/DocBuild/diagrams/gh33.png
