bnepethomas/bne-arduino-flight-simulator-interfaces/Jet Ranger/Jet Ranger Documentation/DocBuild/diagrams/m1.png

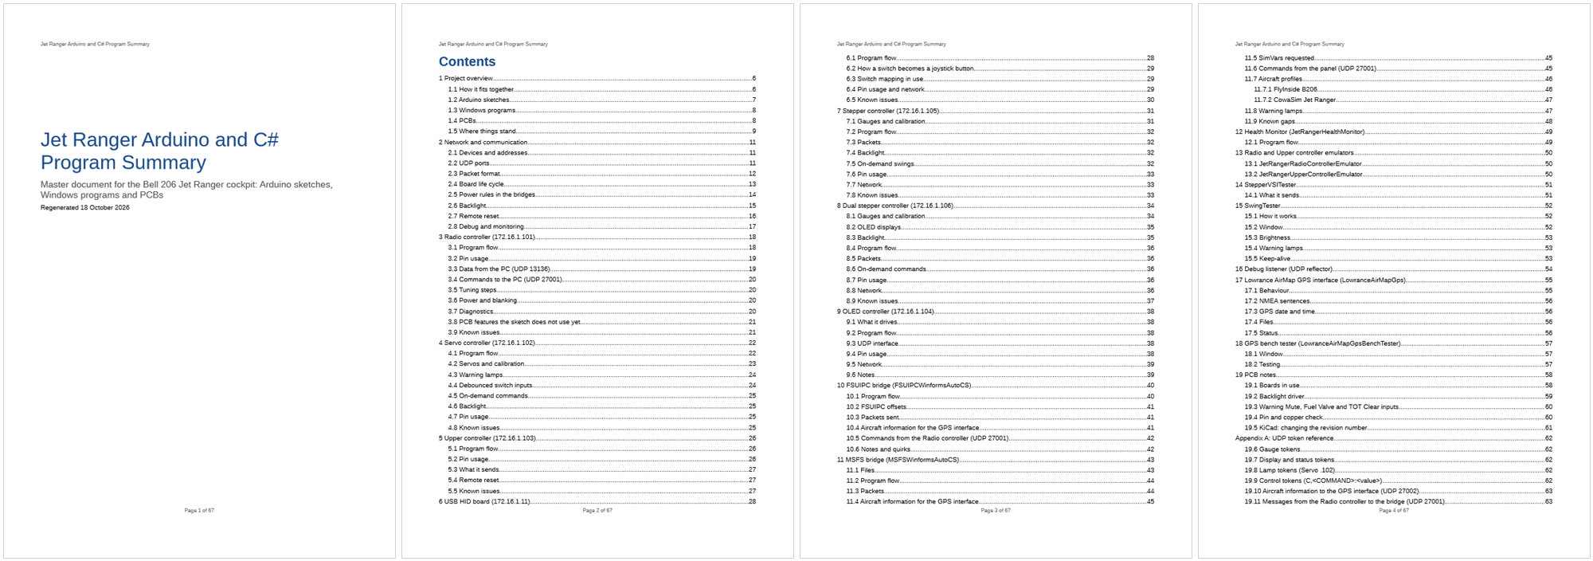
Jet Ranger/Jet Ranger Documentation/DocBuild/diagrams/m1.png
