bnepethomas/bne-arduino-flight-simulator-interfaces/Jet Ranger/Jet Ranger Documentation/DocBuild/diagrams/m41.png

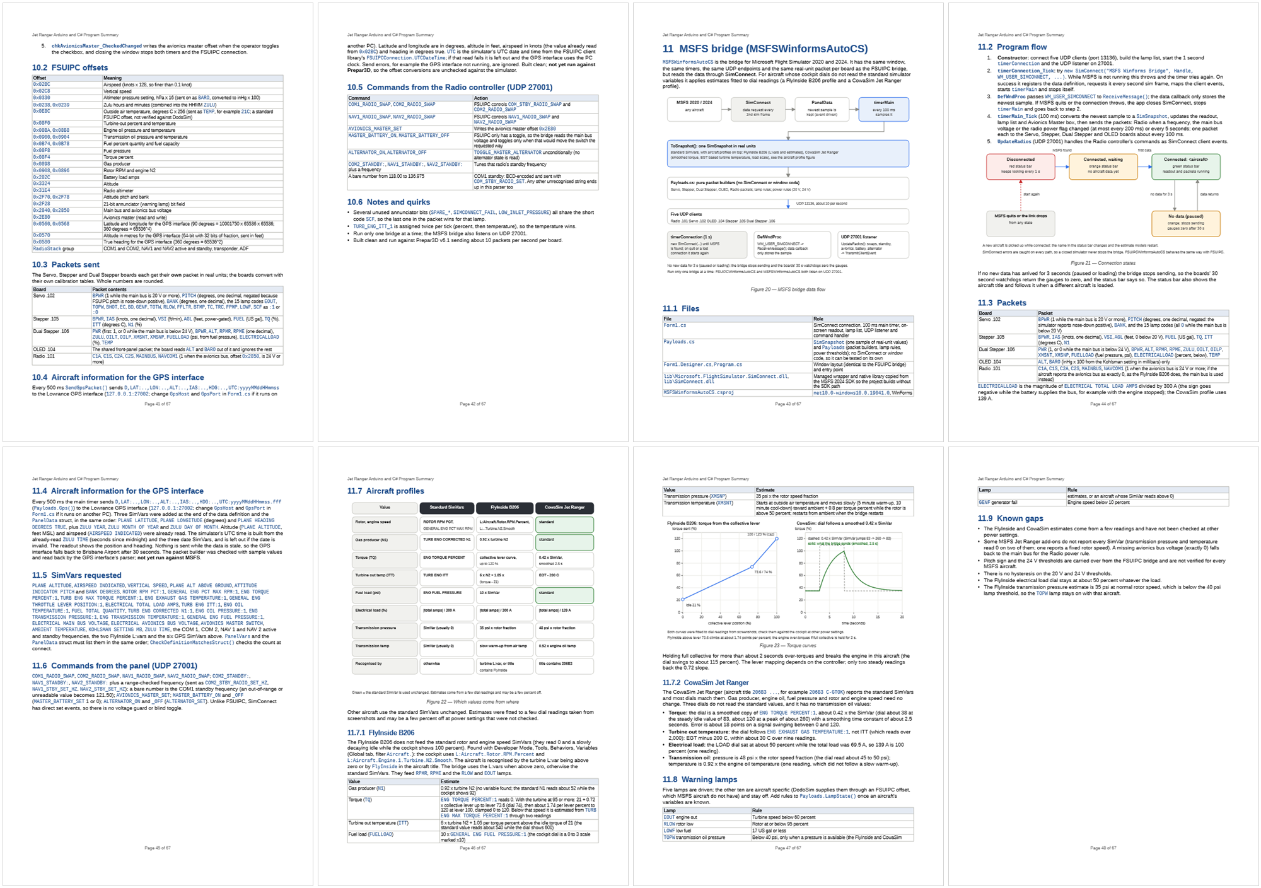
Jet Ranger/Jet Ranger Documentation/DocBuild/diagrams/m41.png
