bnepethomas/bne-arduino-flight-simulator-interfaces/Jet Ranger/Jet Ranger Documentation/DocBuild/diagrams/m49.png

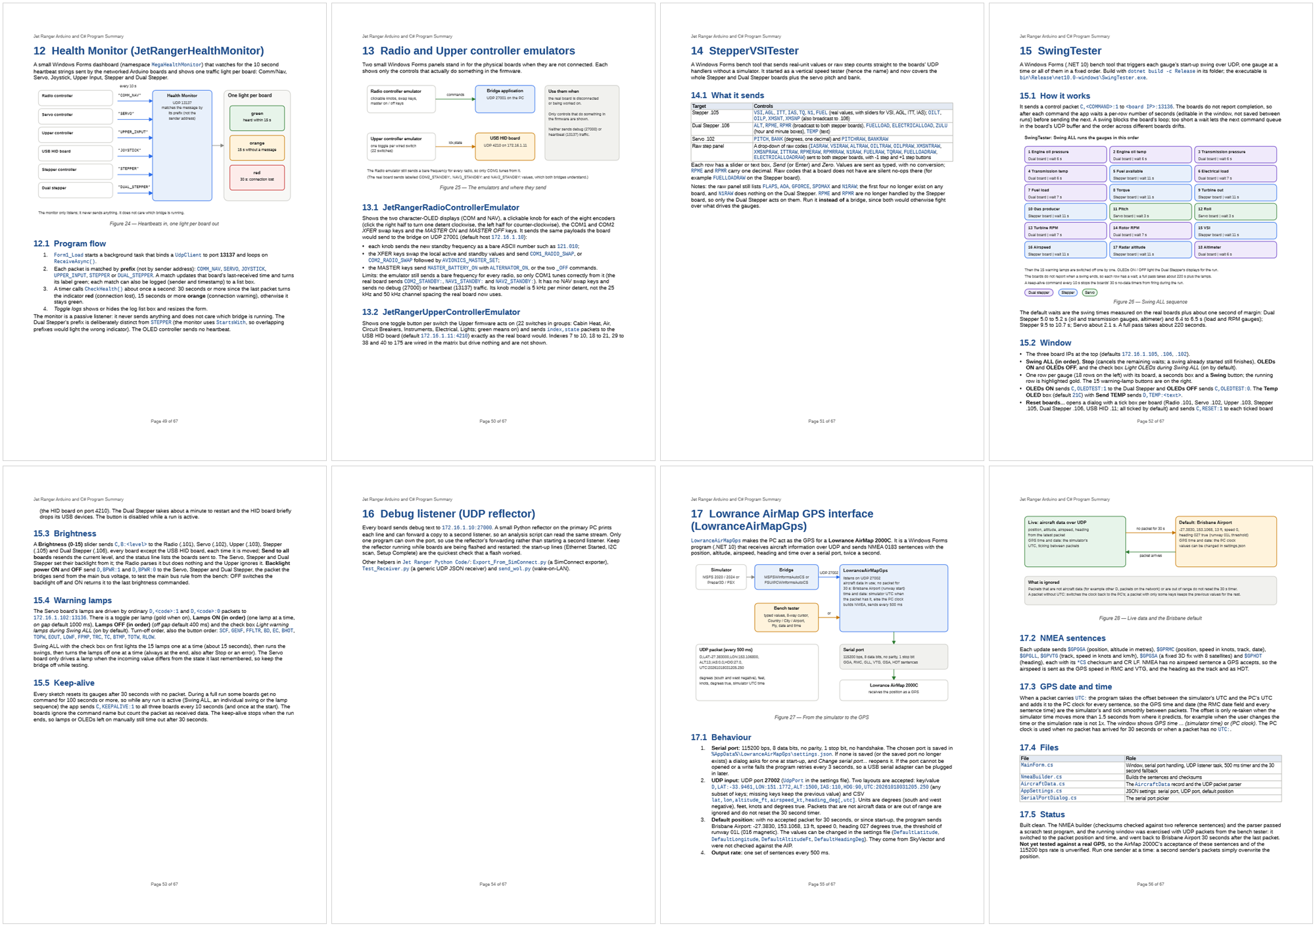
Jet Ranger/Jet Ranger Documentation/DocBuild/diagrams/m49.png
