bnepethomas/bne-arduino-flight-simulator-interfaces/Jet Ranger/Jet Ranger Documentation/DocBuild/diagrams/m57.png

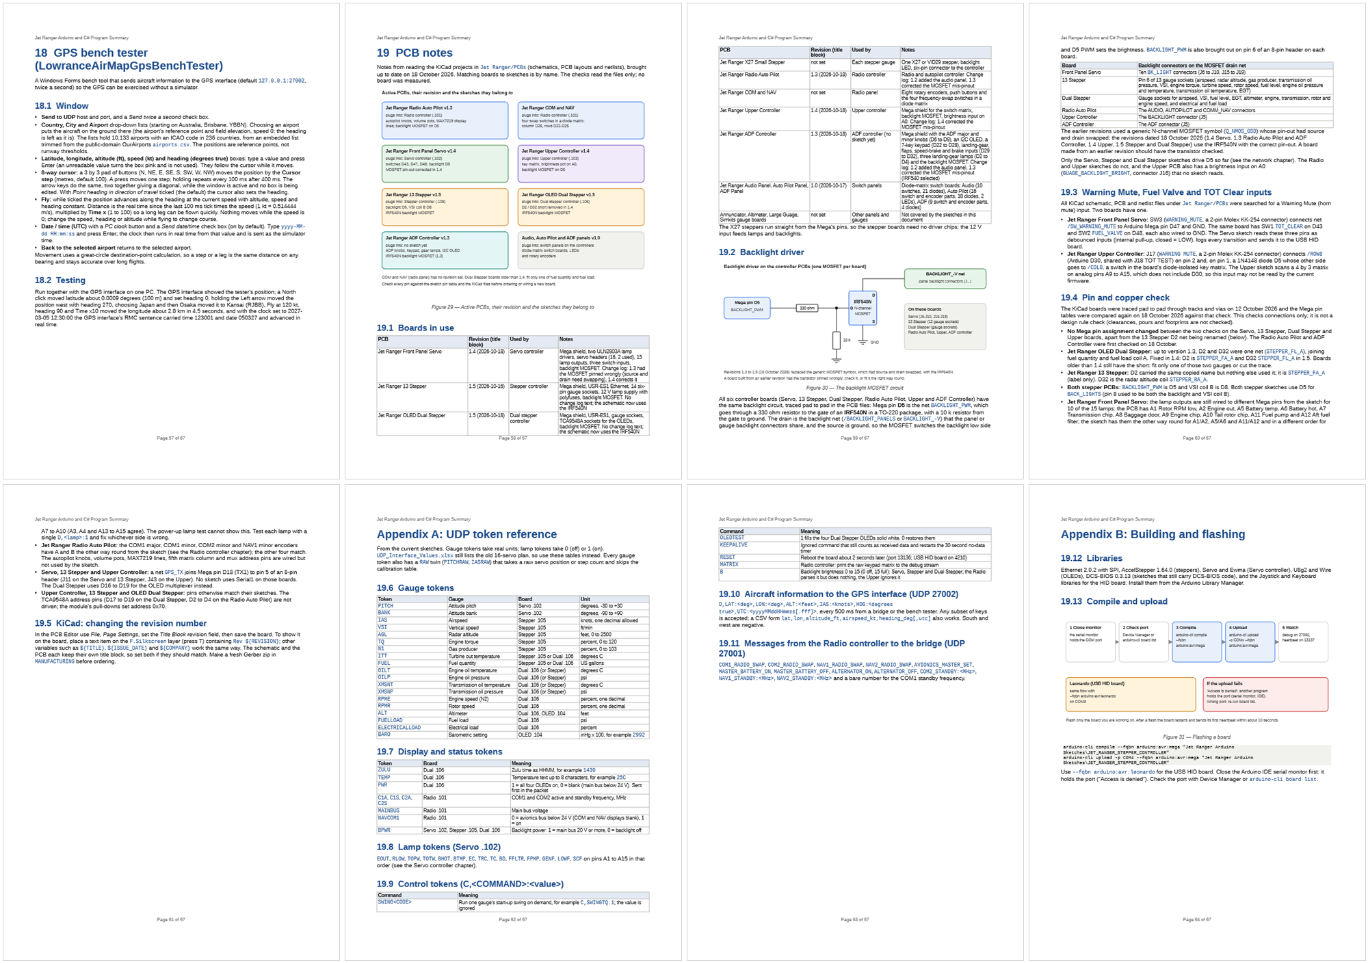
Jet Ranger/Jet Ranger Documentation/DocBuild/diagrams/m57.png
