bnepethomas/bne-arduino-flight-simulator-interfaces/Jet Ranger/Jet Ranger Documentation/DocBuild/diagrams/pg1.png

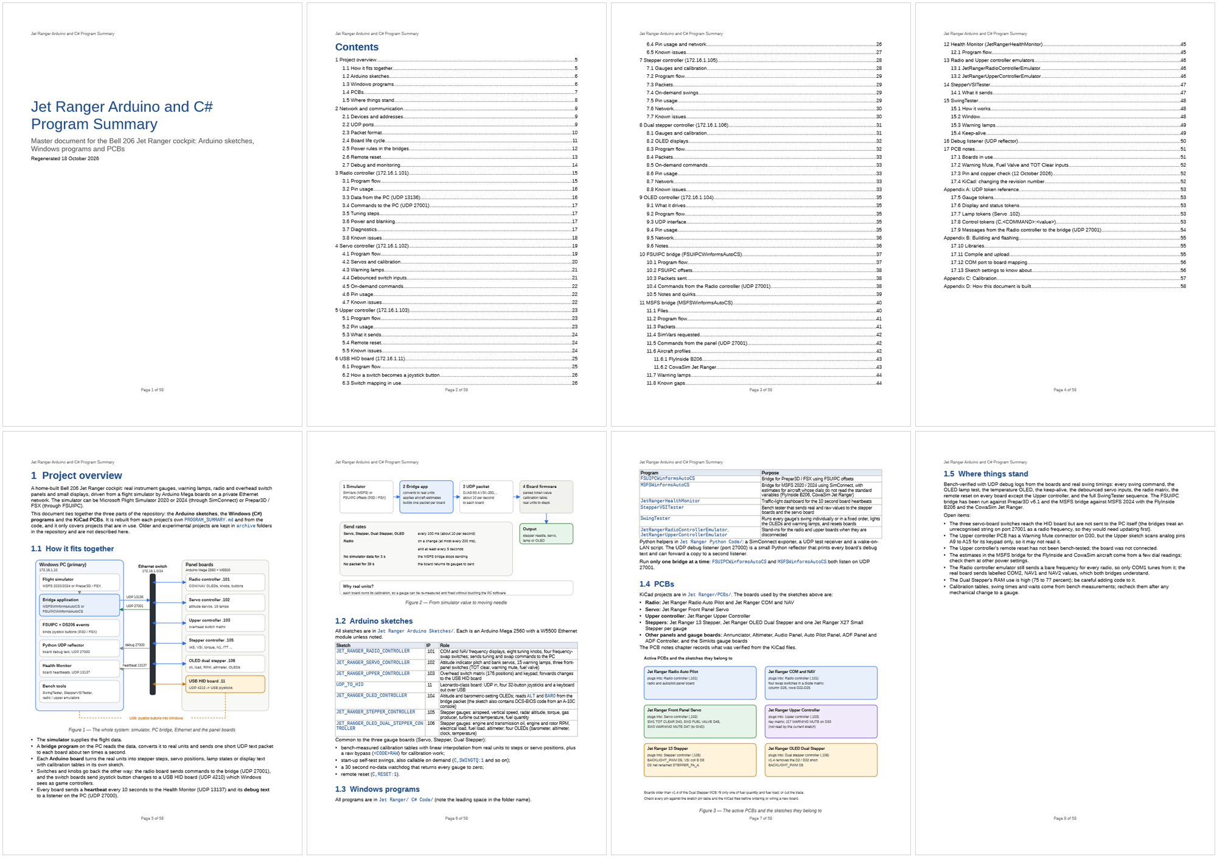
Jet Ranger/Jet Ranger Documentation/DocBuild/diagrams/pg1.png
