bnepethomas/bne-arduino-flight-simulator-interfaces/Jet Ranger/Jet Ranger Documentation/DocBuild/diagrams/pg5.png

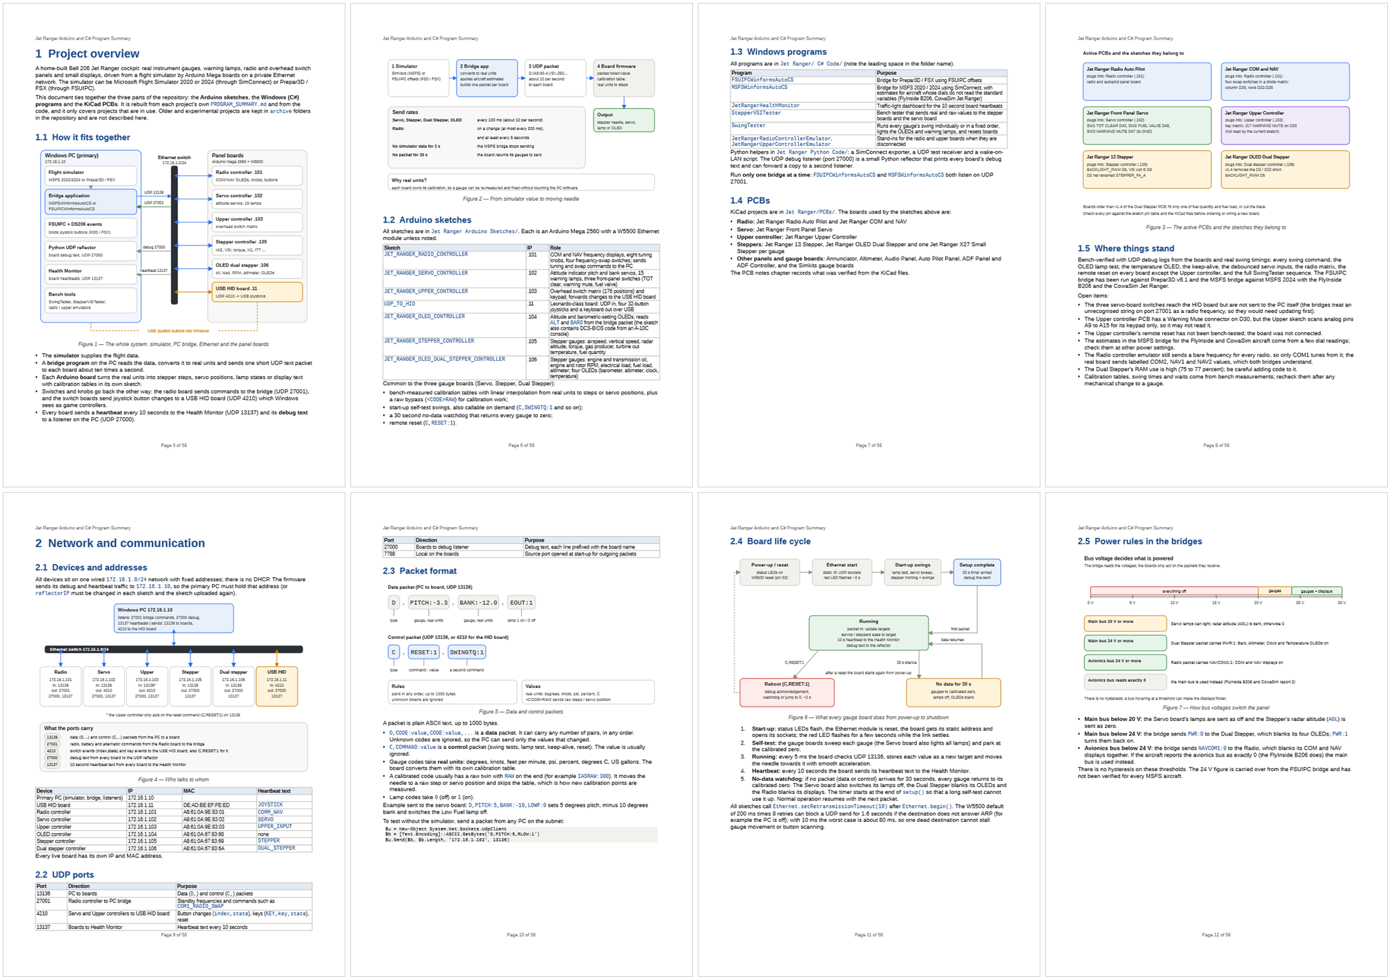
Jet Ranger/Jet Ranger Documentation/DocBuild/diagrams/pg5.png
