bnepethomas/bne-arduino-flight-simulator-interfaces/Jet Ranger/Jet Ranger Documentation/DocBuild/diagrams/pg25.png

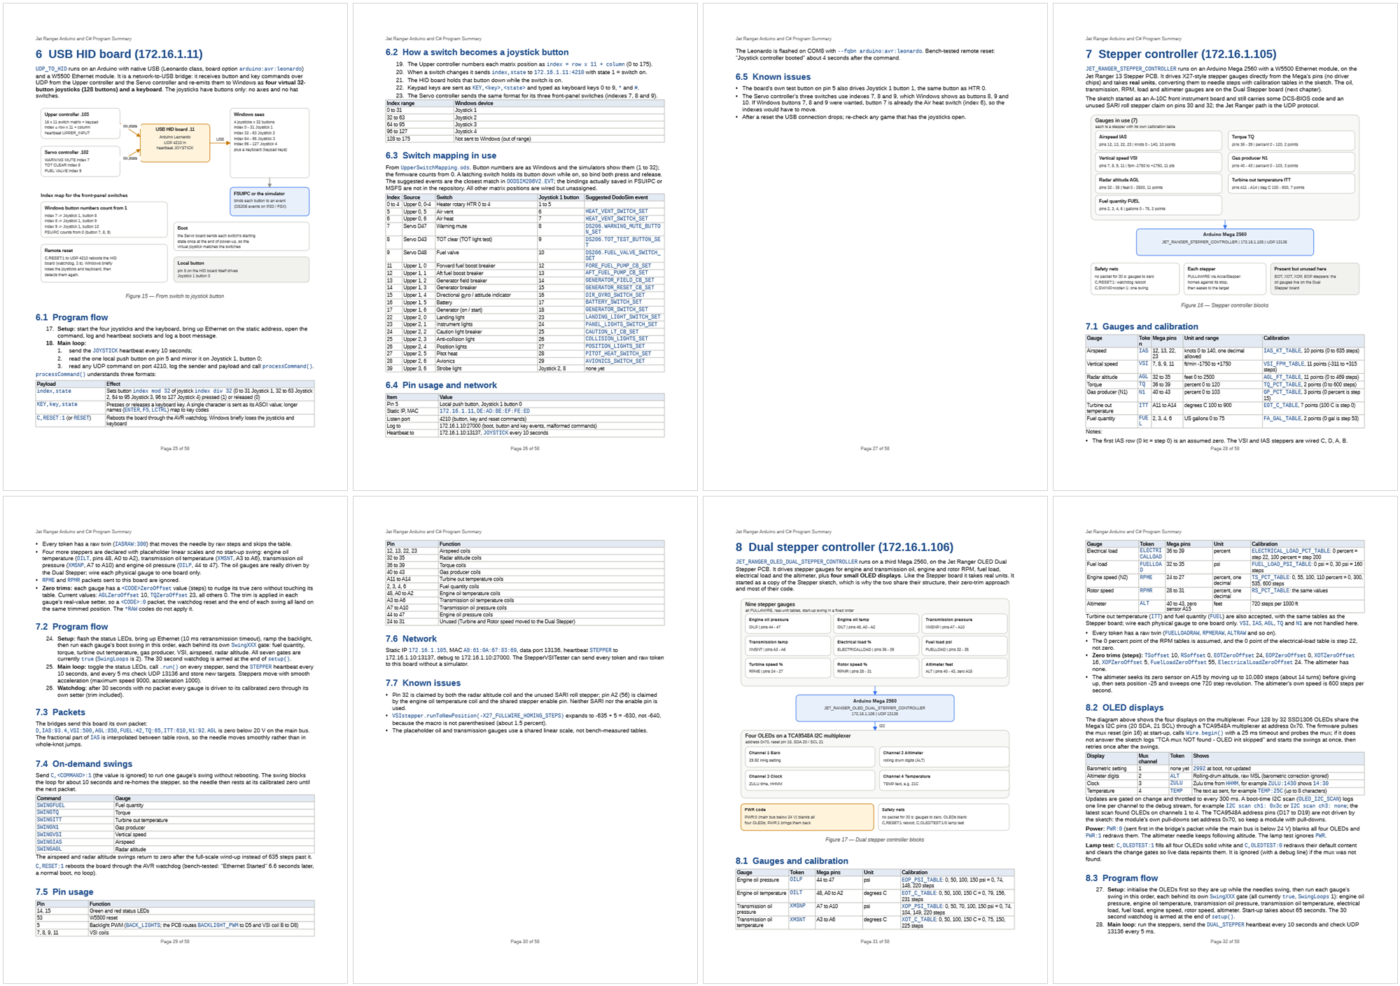
Jet Ranger/Jet Ranger Documentation/DocBuild/diagrams/pg25.png
