bnepethomas/bne-arduino-flight-simulator-interfaces/Jet Ranger/Jet Ranger Documentation/DocBuild/diagrams/png/com_ports.png

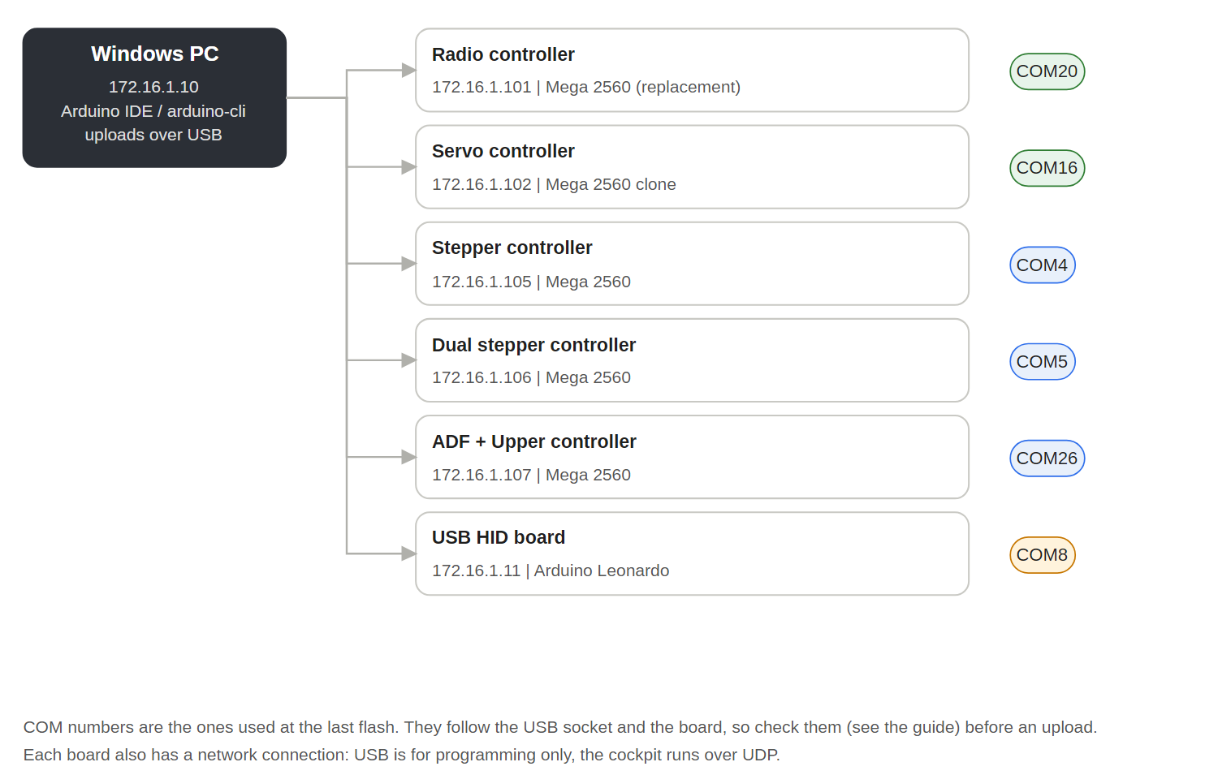
Jet Ranger/Jet Ranger Documentation/DocBuild/diagrams/png/com_ports.png
