bnepethomas/bne-arduino-flight-simulator-interfaces/Jet Ranger/Jet Ranger Documentation/DocBuild/diagrams/png/emulators.png

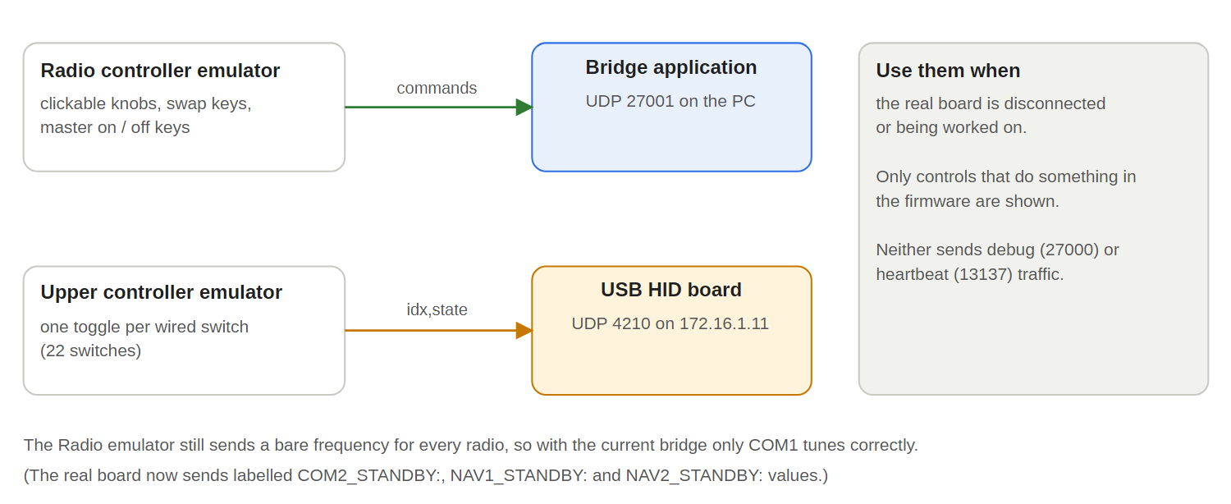
Jet Ranger/Jet Ranger Documentation/DocBuild/diagrams/png/emulators.png
