bnepethomas/bne-arduino-flight-simulator-interfaces/Jet Ranger/Jet Ranger Documentation/DocBuild/diagrams/png/gpage009.png

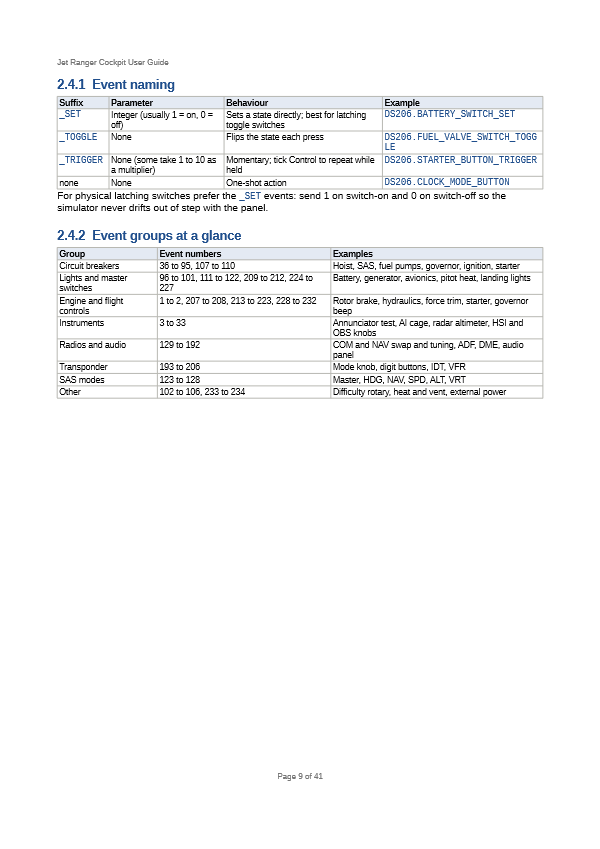
Jet Ranger/Jet Ranger Documentation/DocBuild/diagrams/png/gpage009.png
