bnepethomas/bne-arduino-flight-simulator-interfaces/Jet Ranger/Jet Ranger Documentation/DocBuild/diagrams/png/gpage024.png

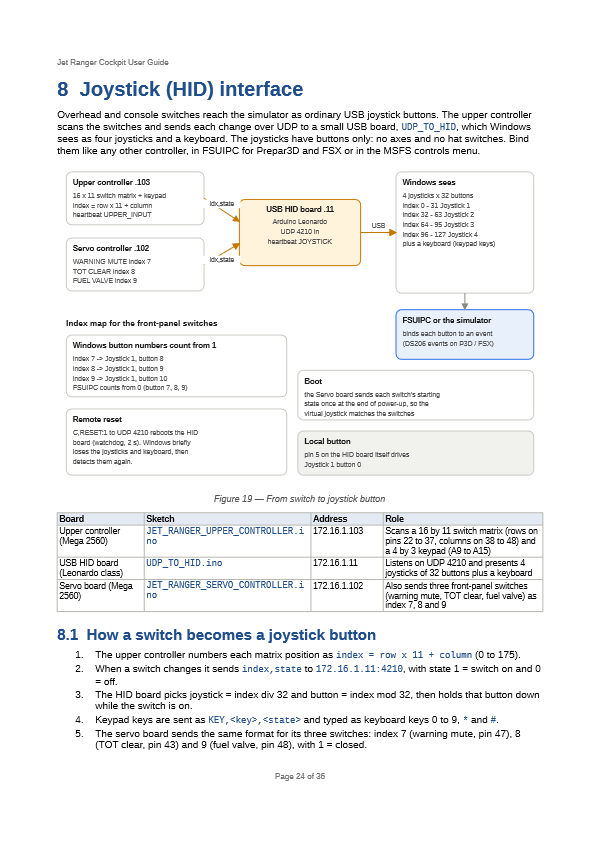
Jet Ranger/Jet Ranger Documentation/DocBuild/diagrams/png/gpage024.png
