bnepethomas/bne-arduino-flight-simulator-interfaces/Jet Ranger/Jet Ranger Documentation/DocBuild/diagrams/png/gpage065.png

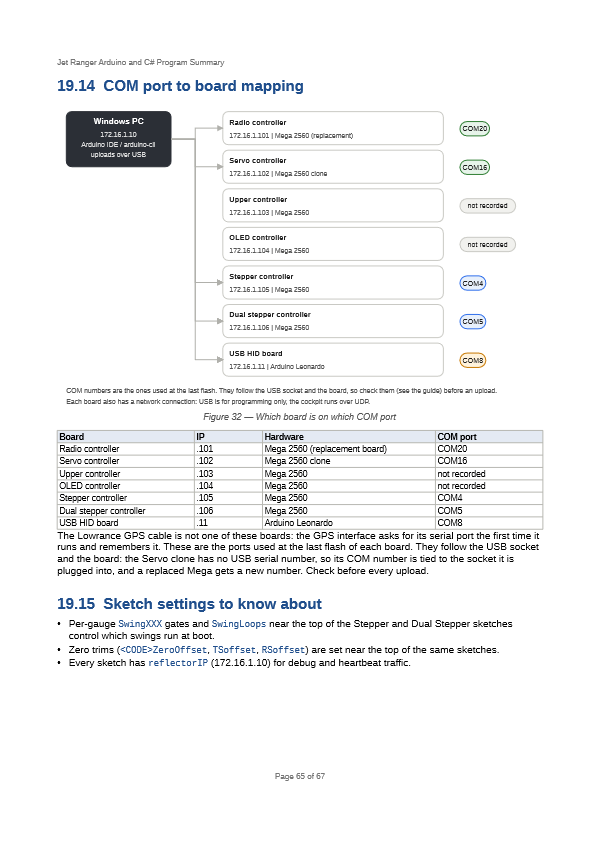
Jet Ranger/Jet Ranger Documentation/DocBuild/diagrams/png/gpage065.png
