bnepethomas/bne-arduino-flight-simulator-interfaces/Jet Ranger/Jet Ranger Documentation/DocBuild/diagrams/png/gps_states.png

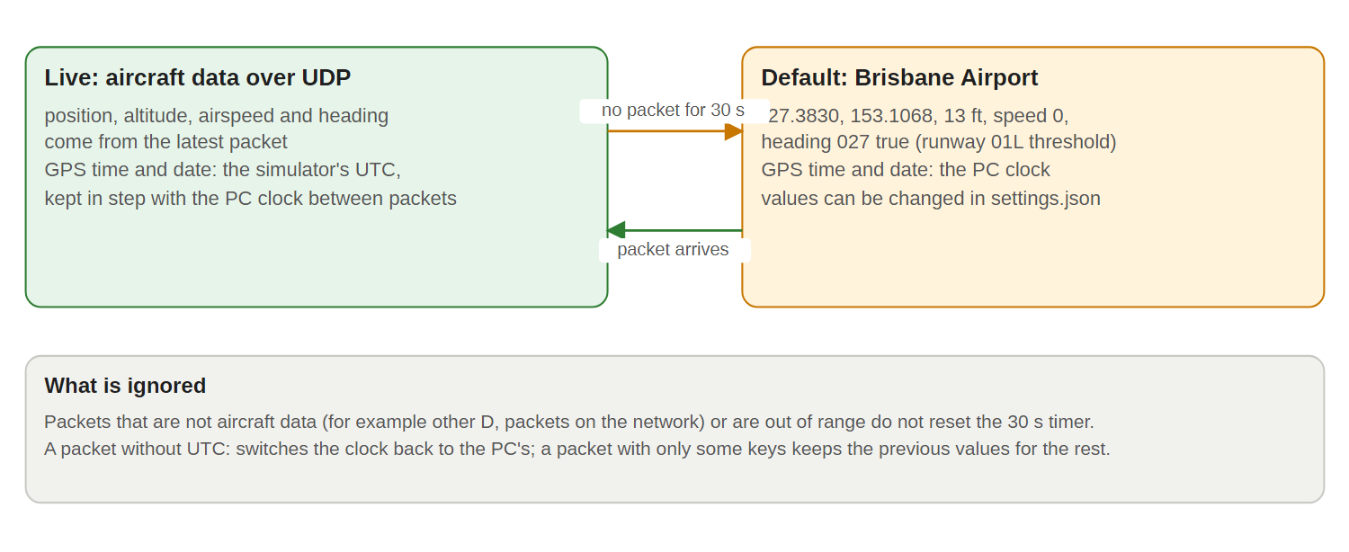
Jet Ranger/Jet Ranger Documentation/DocBuild/diagrams/png/gps_states.png
