bnepethomas/bne-arduino-flight-simulator-interfaces/Jet Ranger/Jet Ranger Documentation/DocBuild/diagrams/png/health_monitor.png

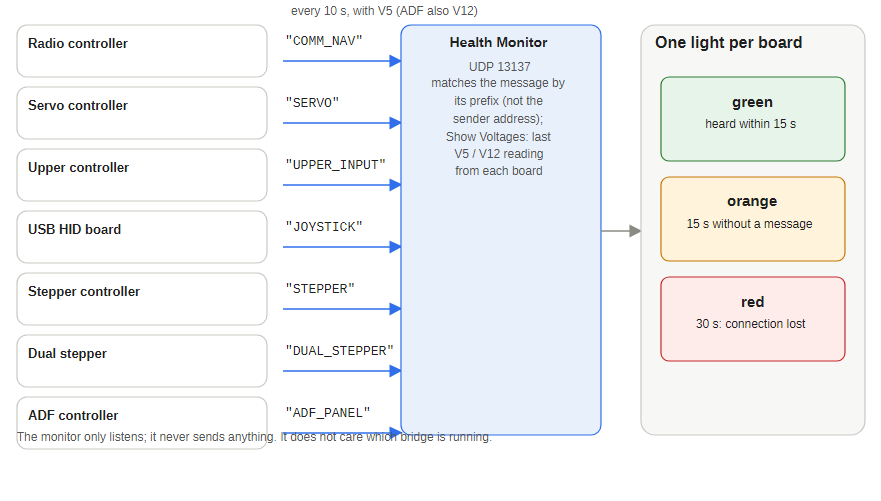
Jet Ranger/Jet Ranger Documentation/DocBuild/diagrams/png/health_monitor.png
