bnepethomas/bne-arduino-flight-simulator-interfaces/Jet Ranger/Jet Ranger Documentation/DocBuild/diagrams/png/joystick_binding.png

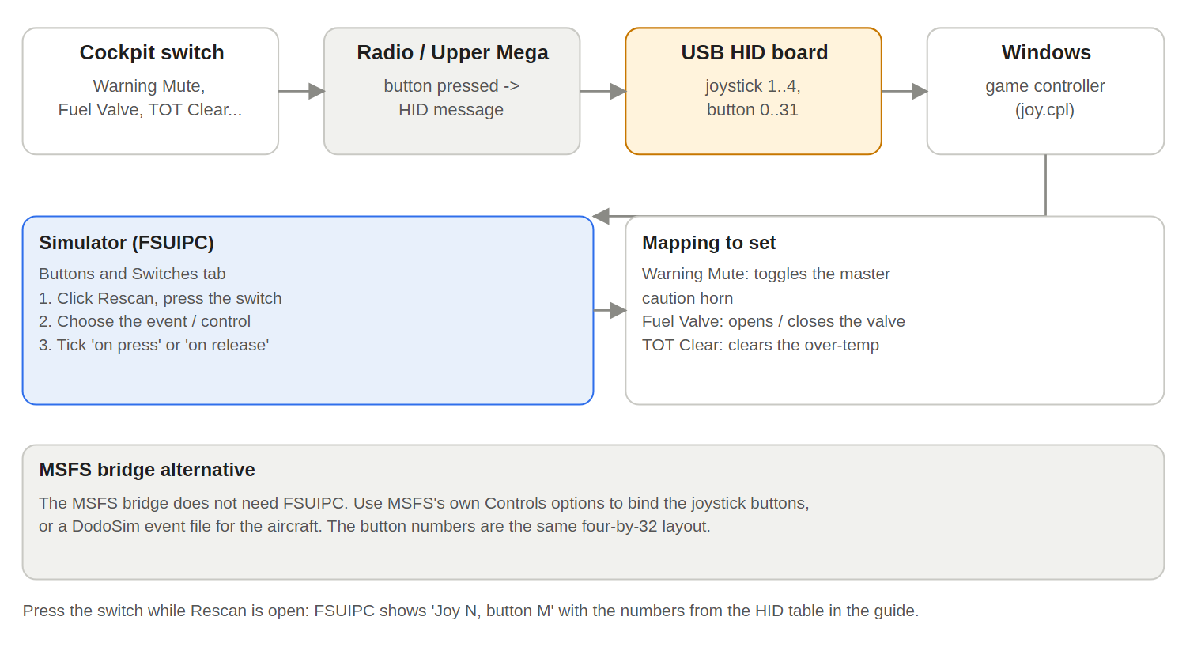
Jet Ranger/Jet Ranger Documentation/DocBuild/diagrams/png/joystick_binding.png
