bnepethomas/bne-arduino-flight-simulator-interfaces/Jet Ranger/Jet Ranger Documentation/DocBuild/diagrams/png/msfs_bridge.png

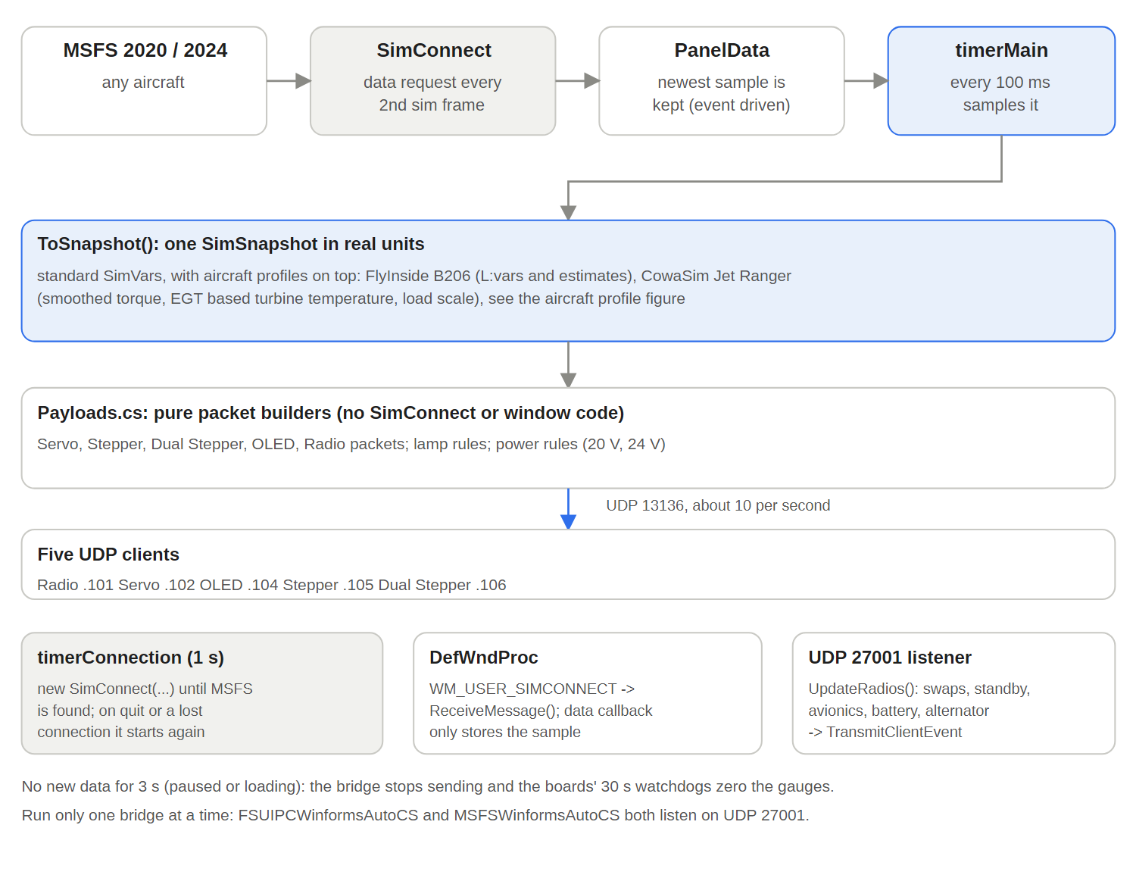
Jet Ranger/Jet Ranger Documentation/DocBuild/diagrams/png/msfs_bridge.png
