bnepethomas/bne-arduino-flight-simulator-interfaces/Jet Ranger/Jet Ranger Documentation/DocBuild/diagrams/png/oled_connectors.png

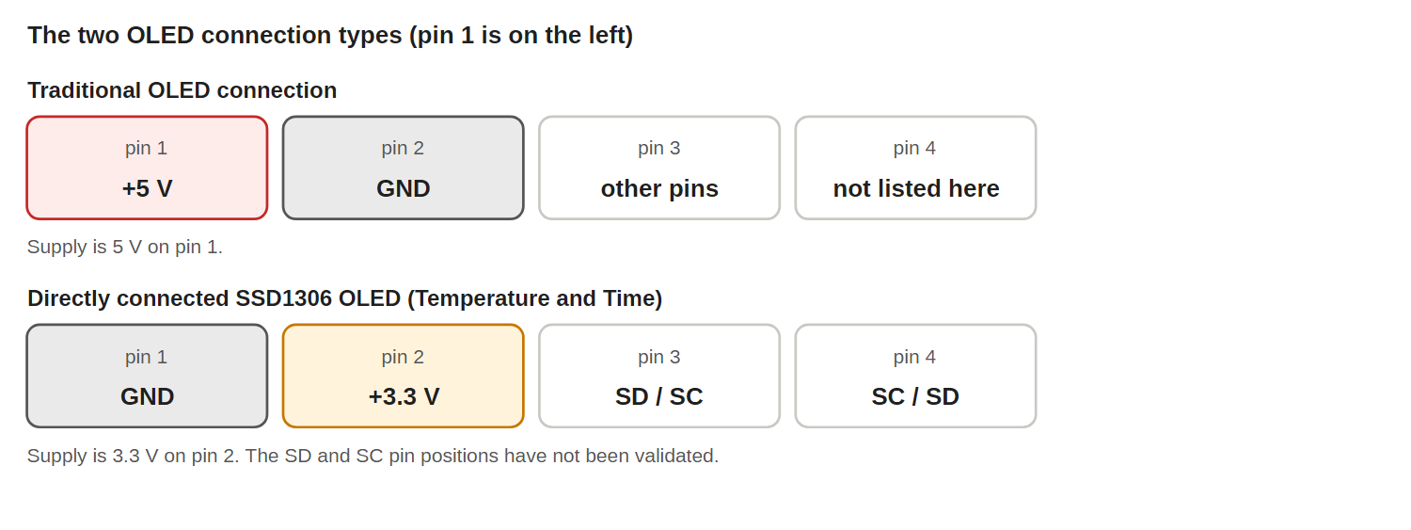
Jet Ranger/Jet Ranger Documentation/DocBuild/diagrams/png/oled_connectors.png
