bnepethomas/bne-arduino-flight-simulator-interfaces/Jet Ranger/Jet Ranger Documentation/DocBuild/diagrams/png/page017.png

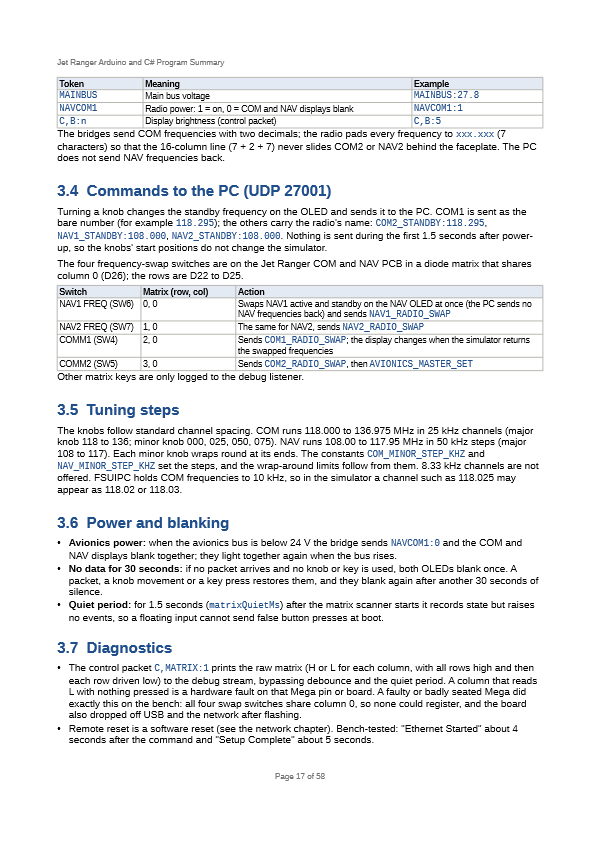
Jet Ranger/Jet Ranger Documentation/DocBuild/diagrams/png/page017.png
