bnepethomas/bne-arduino-flight-simulator-interfaces/Jet Ranger/Jet Ranger Documentation/DocBuild/diagrams/png/page030.png

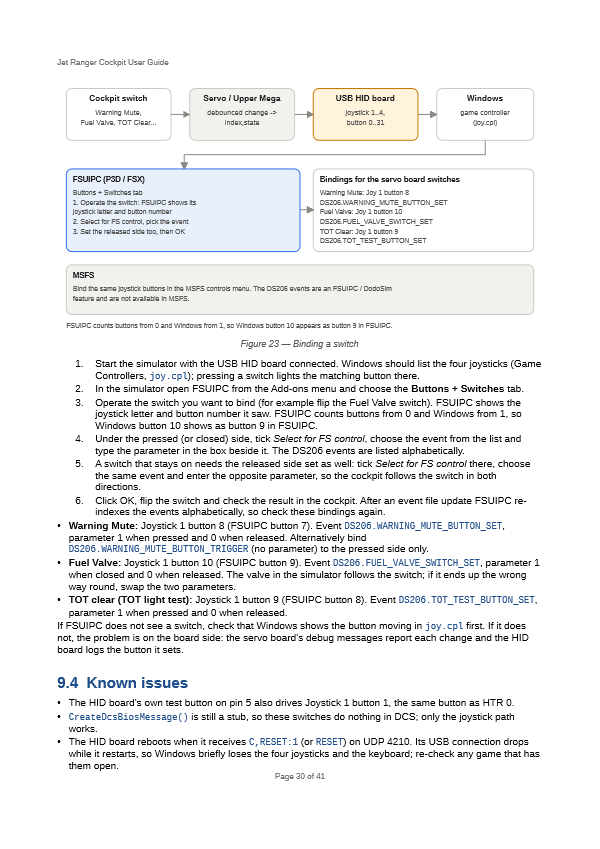
Jet Ranger/Jet Ranger Documentation/DocBuild/diagrams/png/page030.png
