bnepethomas/bne-arduino-flight-simulator-interfaces/Jet Ranger/Jet Ranger Documentation/DocBuild/diagrams/png/page033.png

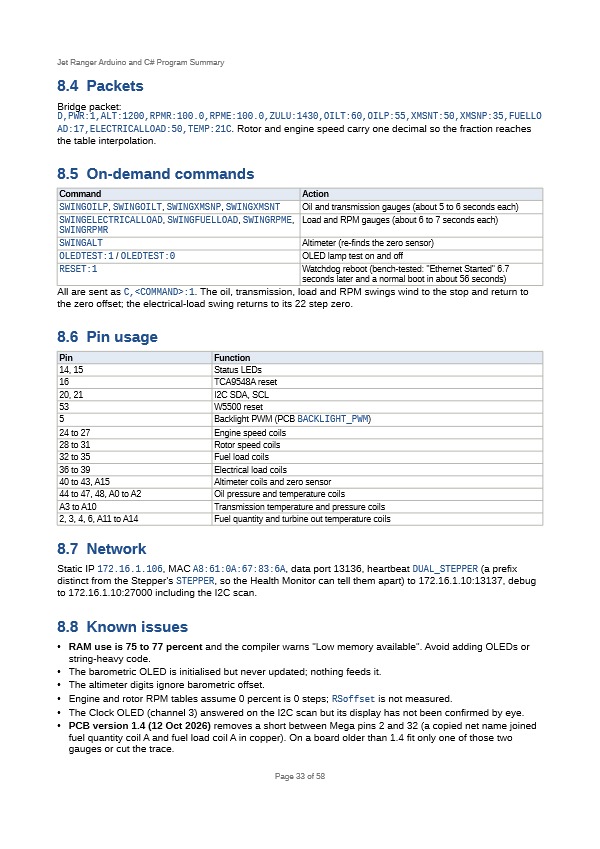
Jet Ranger/Jet Ranger Documentation/DocBuild/diagrams/png/page033.png
