bnepethomas/bne-arduino-flight-simulator-interfaces/Jet Ranger/Jet Ranger Documentation/DocBuild/diagrams/png/power_rules.png

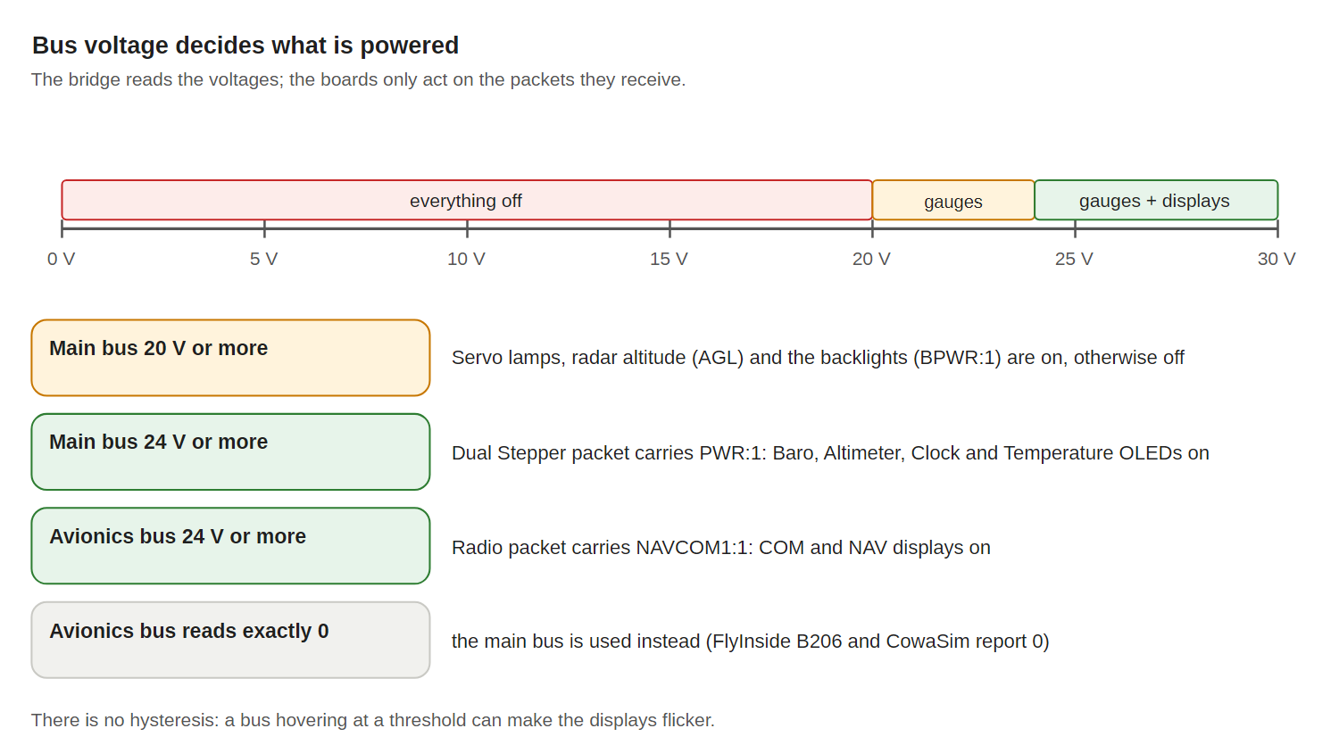
Jet Ranger/Jet Ranger Documentation/DocBuild/diagrams/png/power_rules.png
