bnepethomas/bne-arduino-flight-simulator-interfaces/Jet Ranger/Jet Ranger Documentation/DocBuild/diagrams/png/remote_reset.png

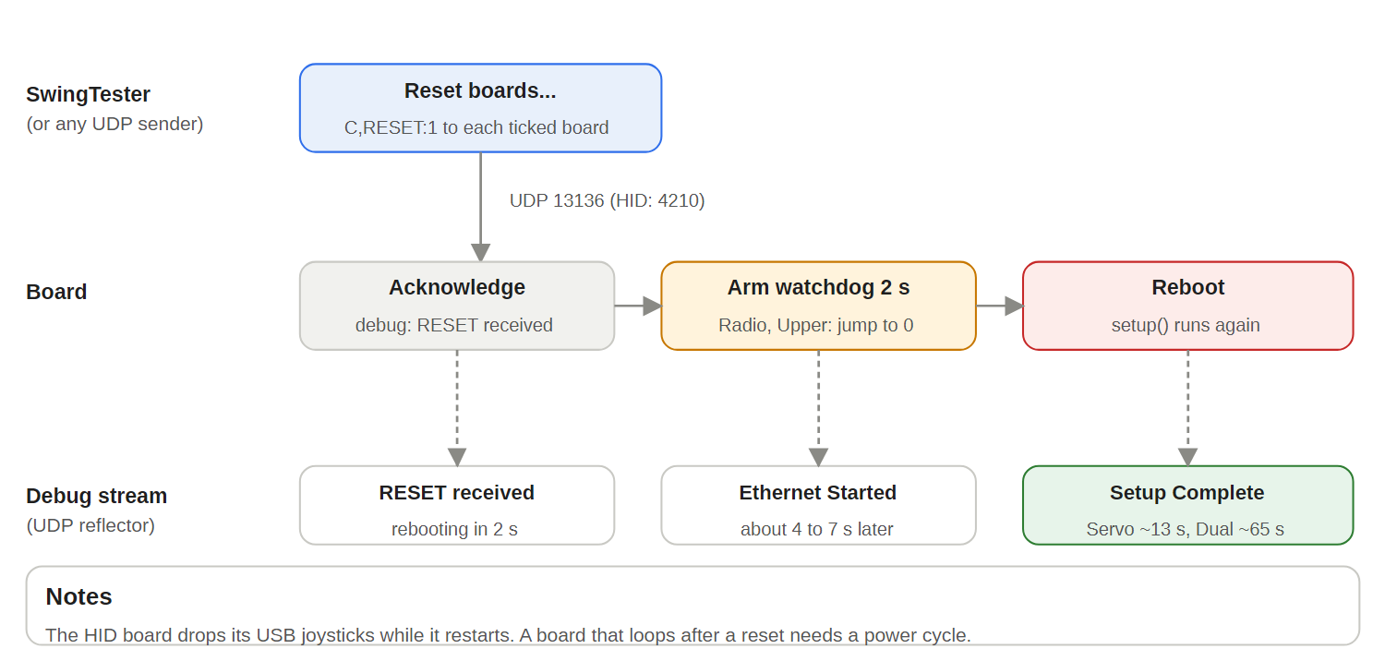
Jet Ranger/Jet Ranger Documentation/DocBuild/diagrams/png/remote_reset.png
