bnepethomas/bne-arduino-flight-simulator-interfaces/Jet Ranger/Jet Ranger Documentation/DocBuild/diagrams/png/servo_blocks.png

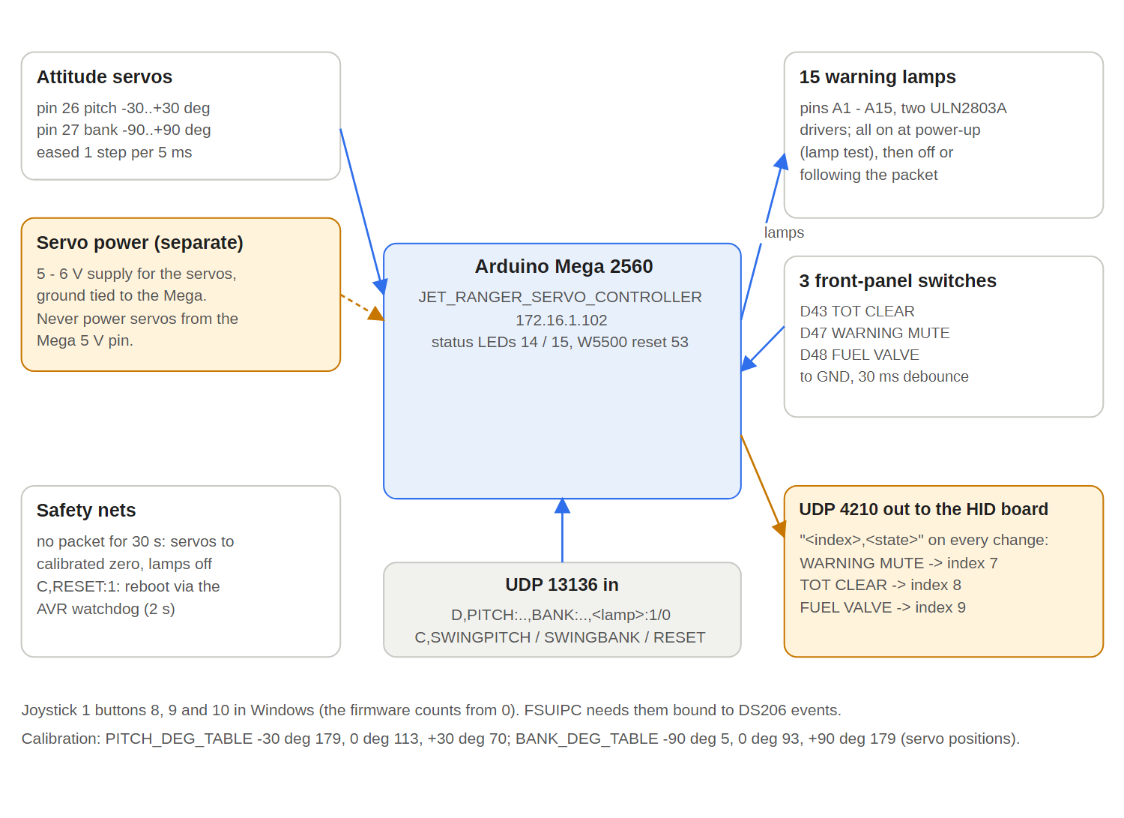
Jet Ranger/Jet Ranger Documentation/DocBuild/diagrams/png/servo_blocks.png
