bnepethomas/bne-arduino-flight-simulator-interfaces/Jet Ranger/Jet Ranger Documentation/DocBuild/diagrams/png/swing_sequence.png

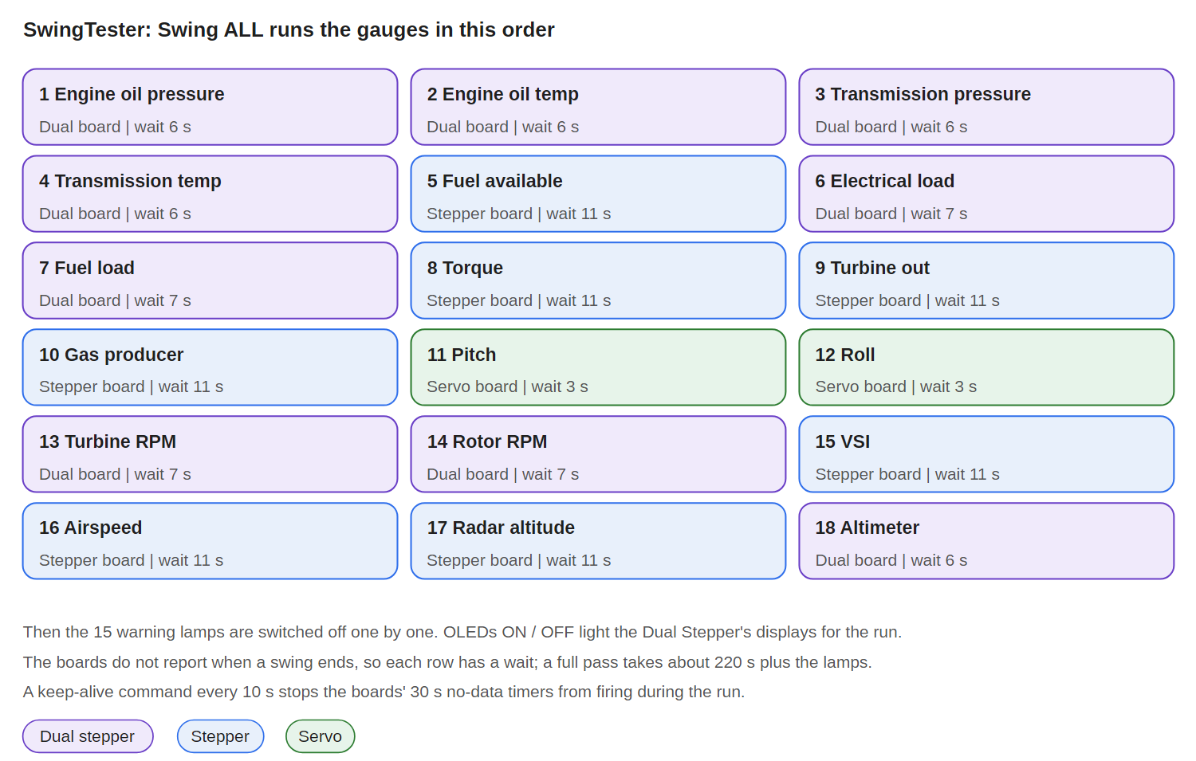
Jet Ranger/Jet Ranger Documentation/DocBuild/diagrams/png/swing_sequence.png
