bnepethomas/bne-arduino-flight-simulator-interfaces/Jet Ranger/Jet Ranger Documentation/DocBuild/diagrams/png/torque_curves.png

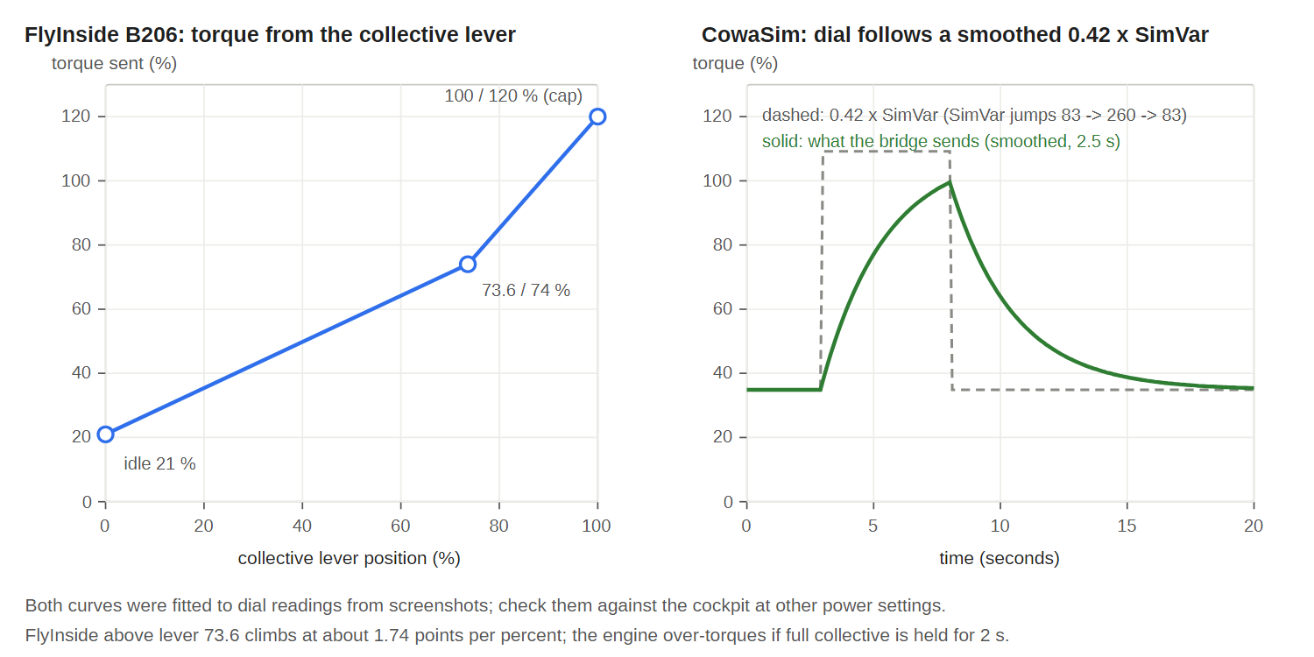
Jet Ranger/Jet Ranger Documentation/DocBuild/diagrams/png/torque_curves.png
