bnepethomas/bne-arduino-flight-simulator-interfaces/Jet Ranger/Jet Ranger Documentation/DocBuild/diagrams/sheetA3.png

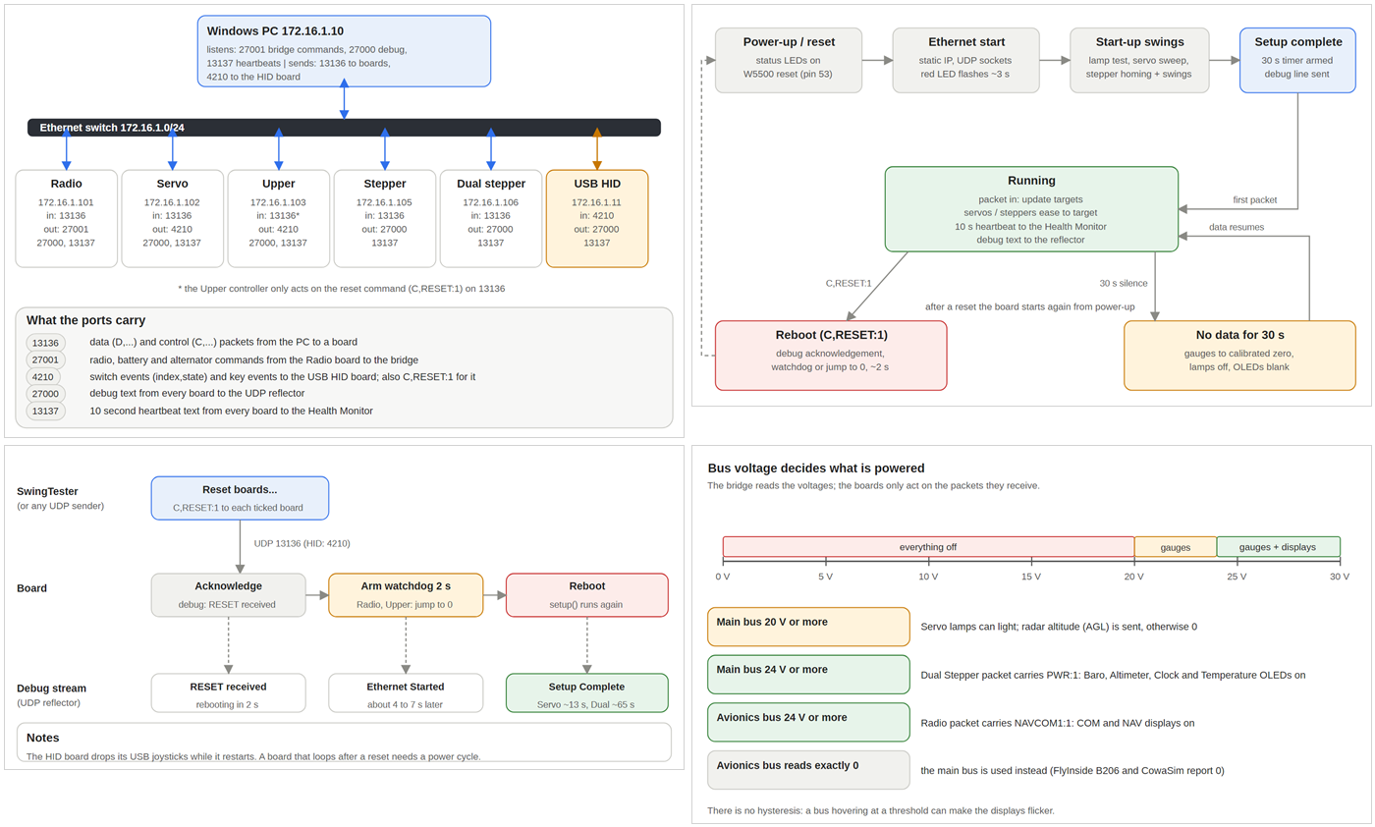
Jet Ranger/Jet Ranger Documentation/DocBuild/diagrams/sheetA3.png
