bnepethomas/bne-arduino-flight-simulator-interfaces/Jet Ranger/Jet Ranger Documentation/DocBuild/diagrams/sheetB1.png

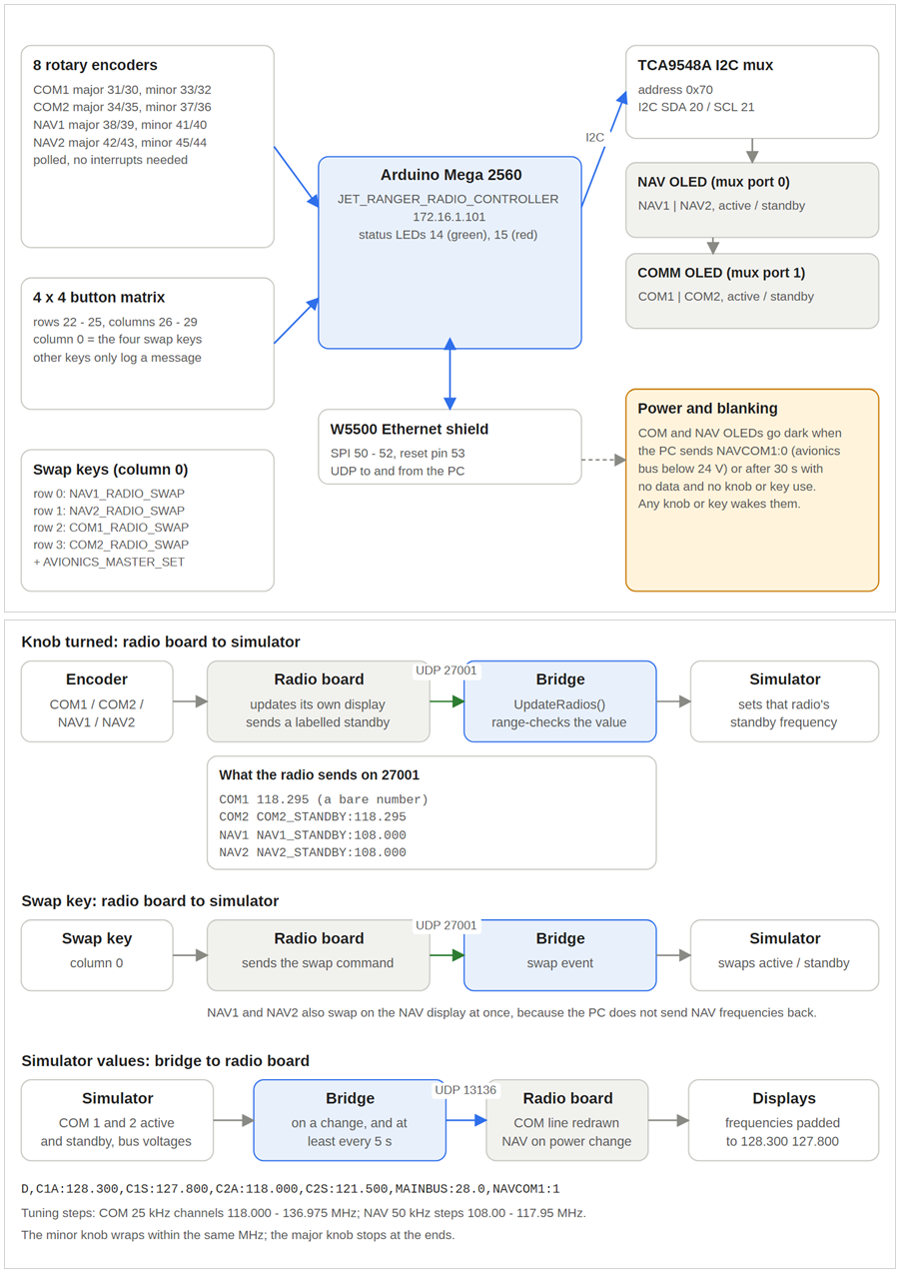
Jet Ranger/Jet Ranger Documentation/DocBuild/diagrams/sheetB1.png
