bnepethomas/bne-arduino-flight-simulator-interfaces/Jet Ranger/Jet Ranger Documentation/DocBuild/diagrams/sheetC3.png

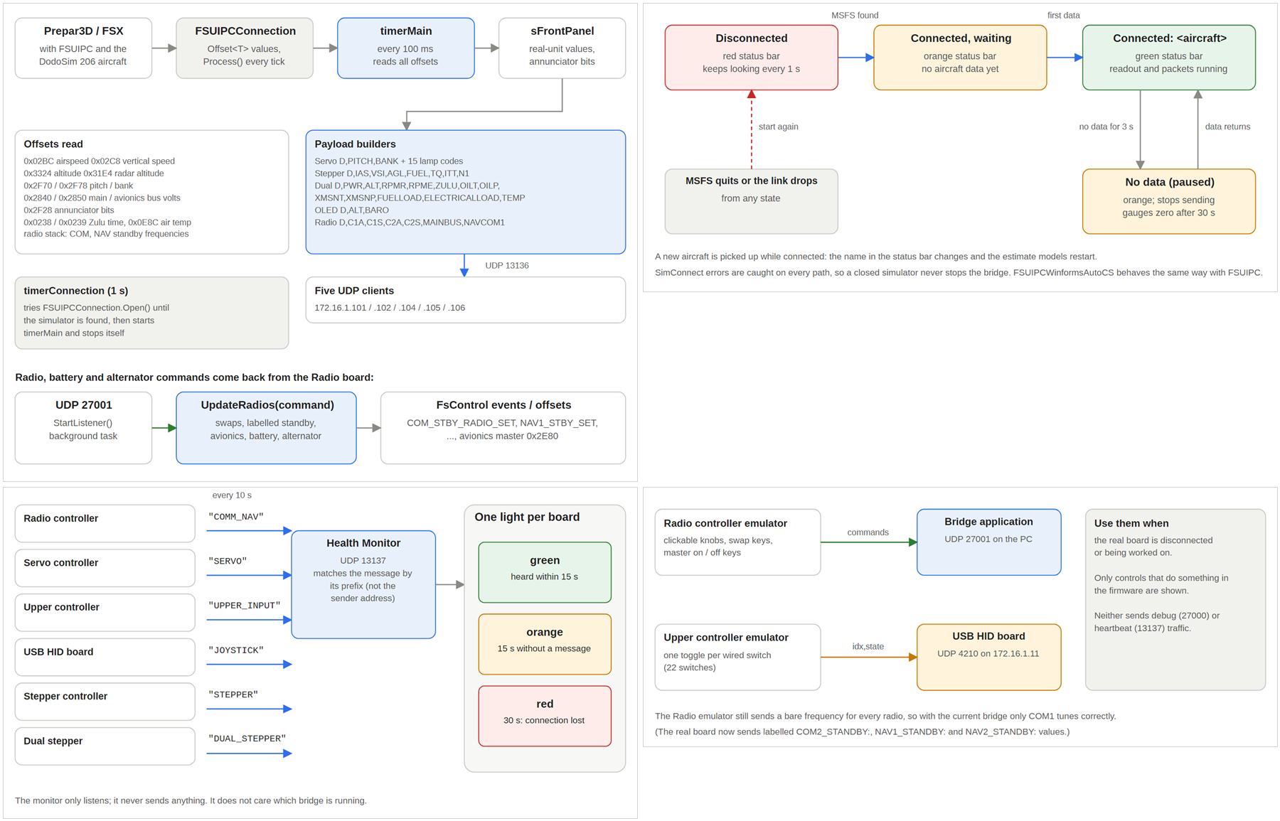
Jet Ranger/Jet Ranger Documentation/DocBuild/diagrams/sheetC3.png
