bnepethomas/bne-arduino-flight-simulator-interfaces/Jet Ranger/Jet Ranger Documentation/DocBuild/diagrams/sheetD2.png

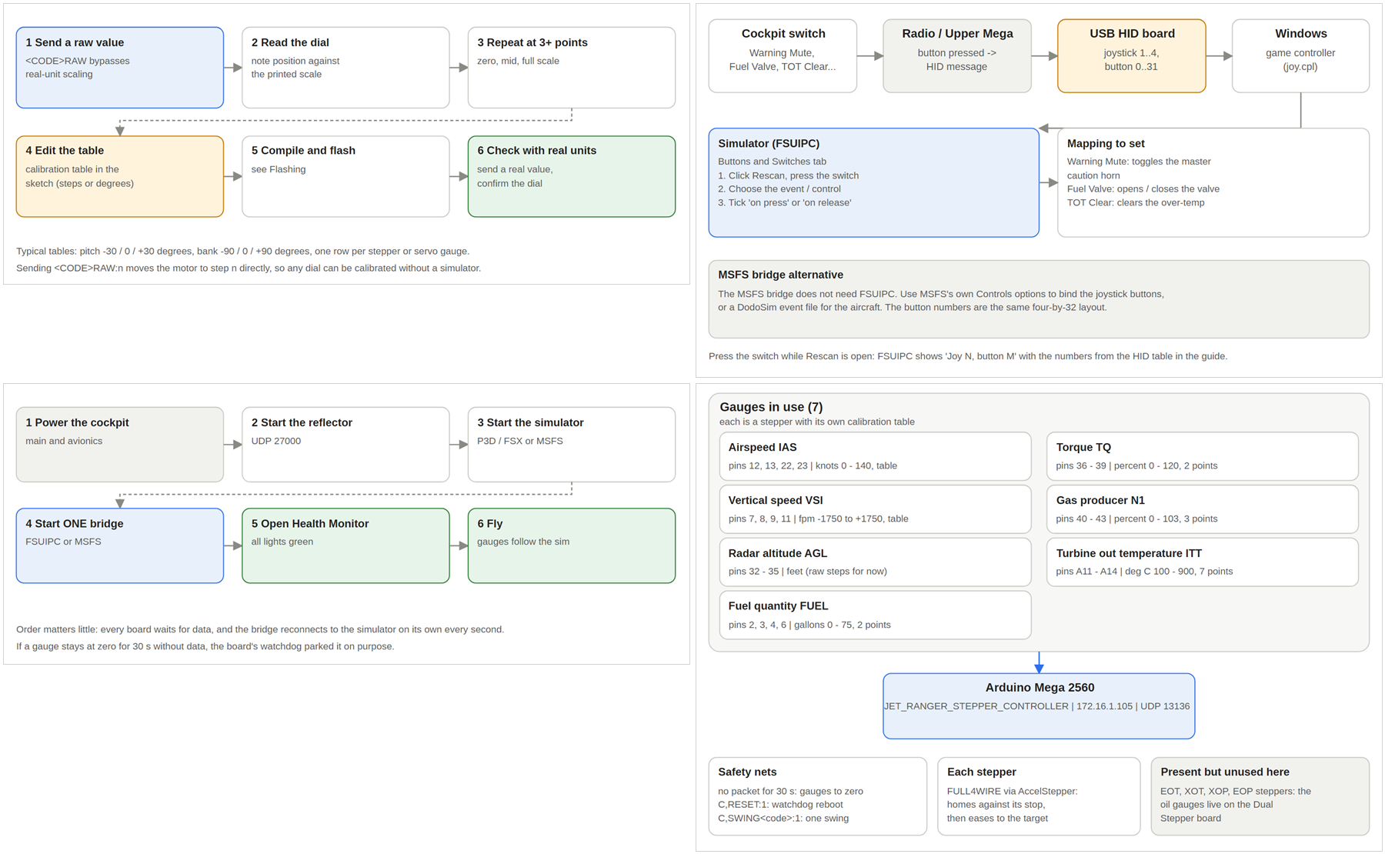
Jet Ranger/Jet Ranger Documentation/DocBuild/diagrams/sheetD2.png
