bnepethomas/bne-arduino-flight-simulator-interfaces/Jet Ranger/Jet Ranger Documentation/DocBuild/diagrams/sheetE2.png

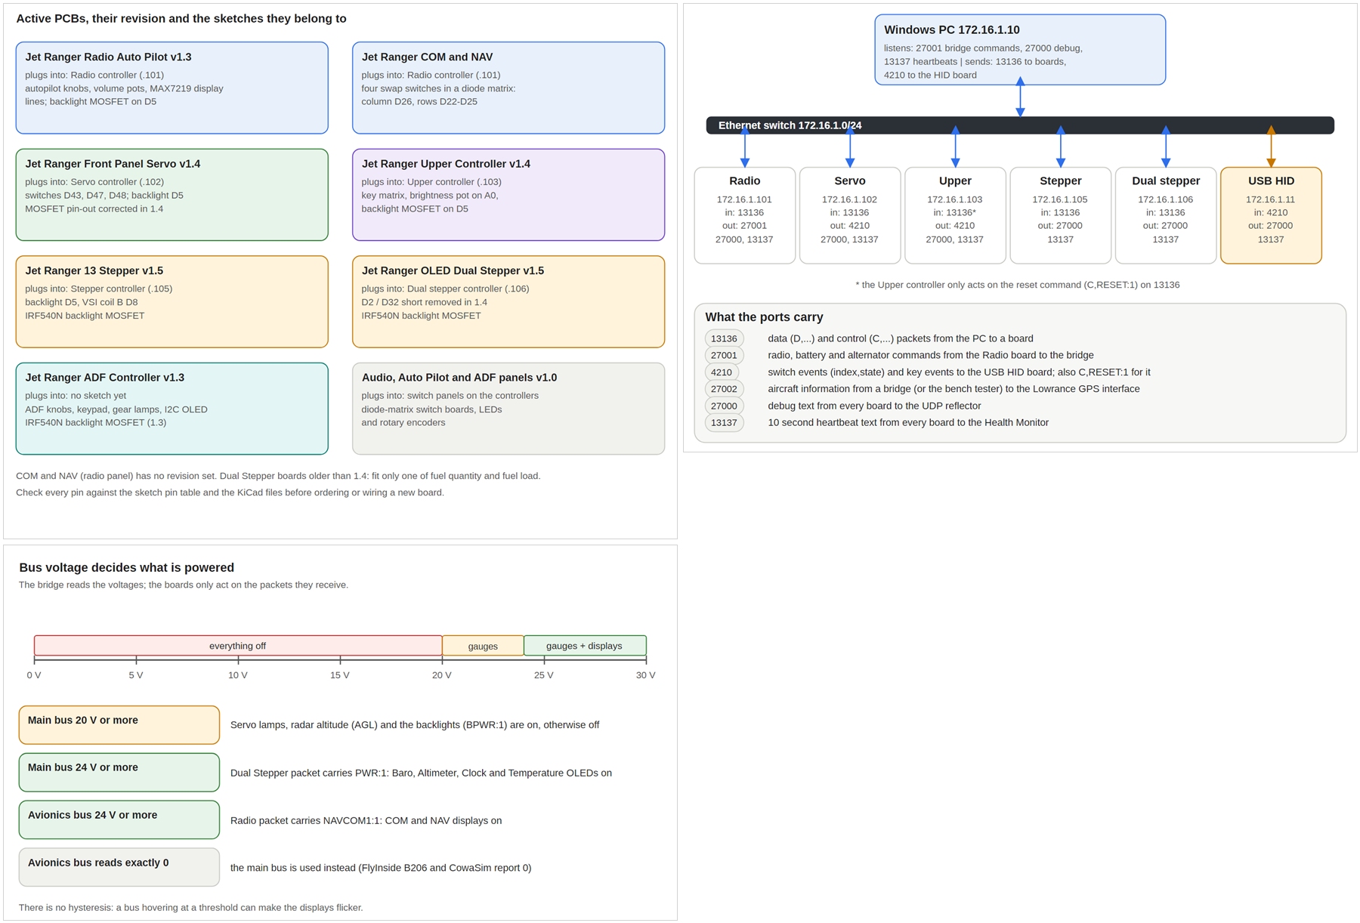
Jet Ranger/Jet Ranger Documentation/DocBuild/diagrams/sheetE2.png
