bnepethomas/bne-arduino-flight-simulator-interfaces/Jet Ranger/Jet Ranger Documentation/DocBuild/diagrams/ssC.png

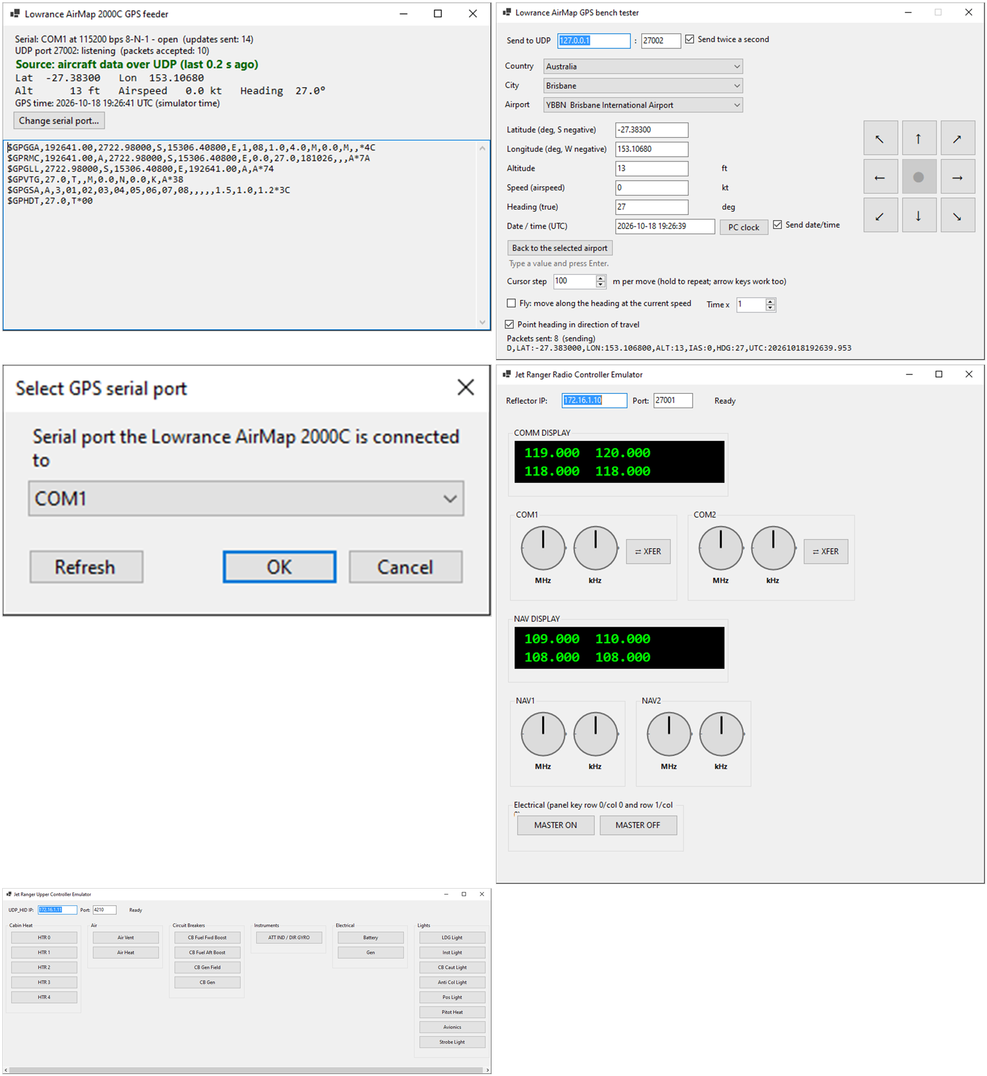
Jet Ranger/Jet Ranger Documentation/DocBuild/diagrams/ssC.png
