bnepethomas/bne-arduino-flight-simulator-interfaces/Jet Ranger/Jet Ranger Documentation/DocBuild/out/pages/page017.png

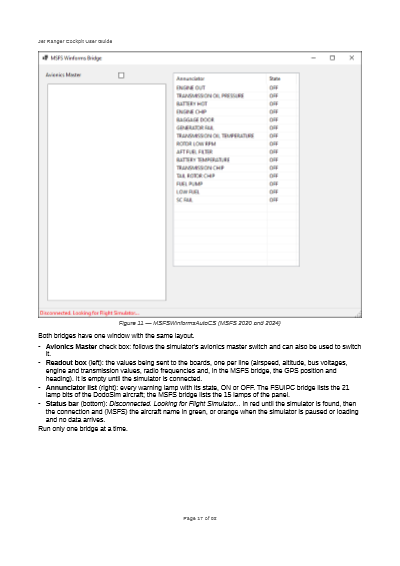
Jet Ranger/Jet Ranger Documentation/DocBuild/out/pages/page017.png
