bnepethomas/bne-arduino-flight-simulator-interfaces/Jet Ranger/Jet Ranger Documentation/DocBuild/out/pages/page066.png

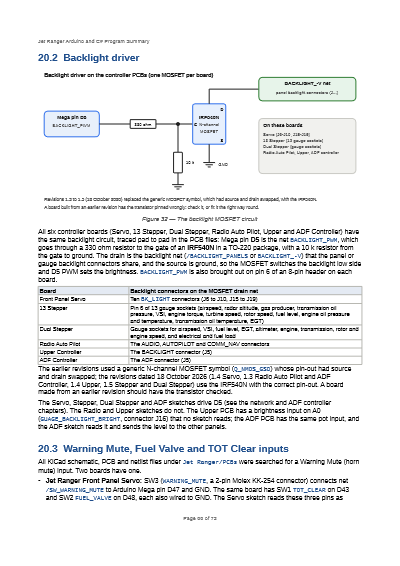
Jet Ranger/Jet Ranger Documentation/DocBuild/out/pages/page066.png
