bnepethomas/bne-arduino-flight-simulator-interfaces/Jet Ranger/Jet Ranger Documentation/DocBuild/out/pagetmp/page077.png

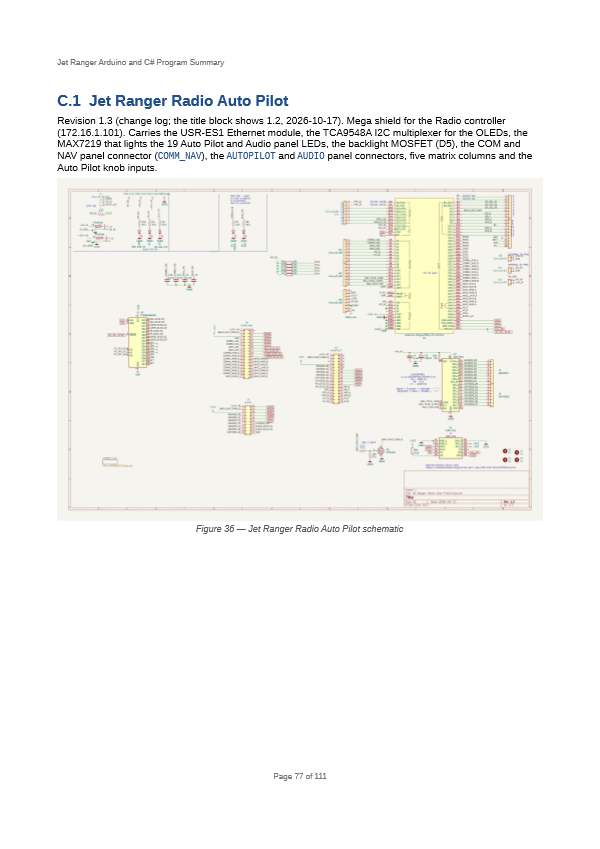
Jet Ranger/Jet Ranger Documentation/DocBuild/out/pagetmp/page077.png
