bnepethomas/bne-arduino-flight-simulator-interfaces/Jet Ranger/Jet Ranger Documentation/DocBuild/out/pagetmp/page080.png

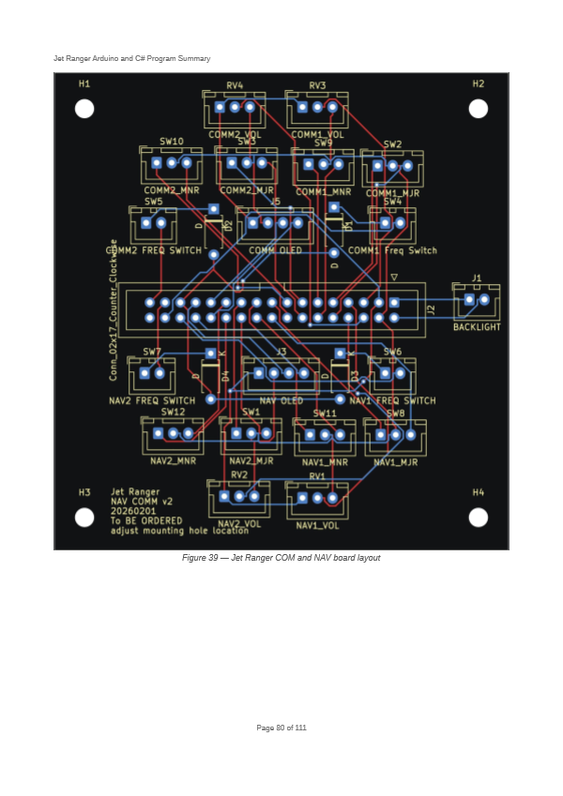
Jet Ranger/Jet Ranger Documentation/DocBuild/out/pagetmp/page080.png
