bnepethomas/bne-arduino-flight-simulator-interfaces/Jet Ranger/Jet Ranger Documentation/DocBuild/out/sheet_guide.png

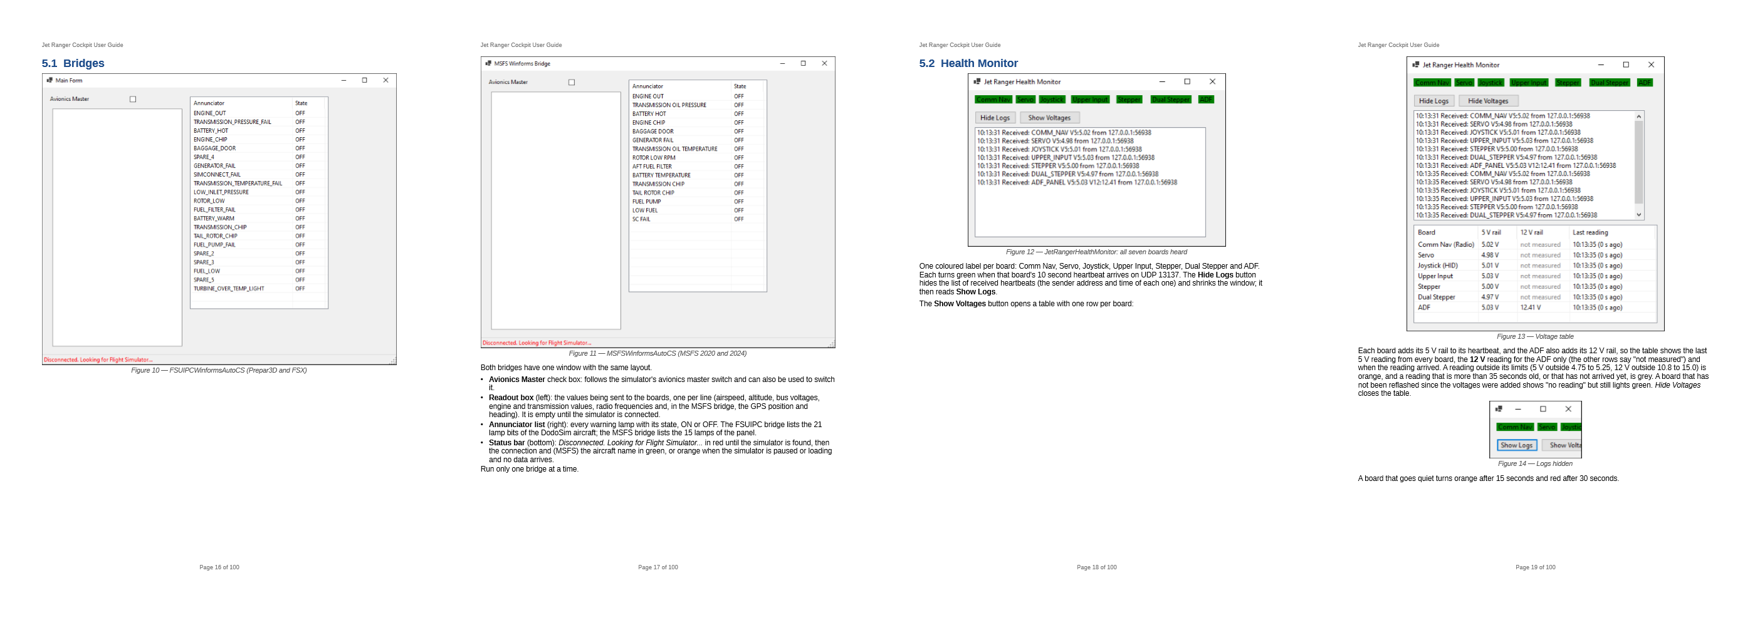
Jet Ranger/Jet Ranger Documentation/DocBuild/out/sheet_guide.png
