bnepethomas/bne-arduino-flight-simulator-interfaces/Jet Ranger/Jet Ranger Documentation/DocBuild/pcb/adf_controller_pcb.jpg

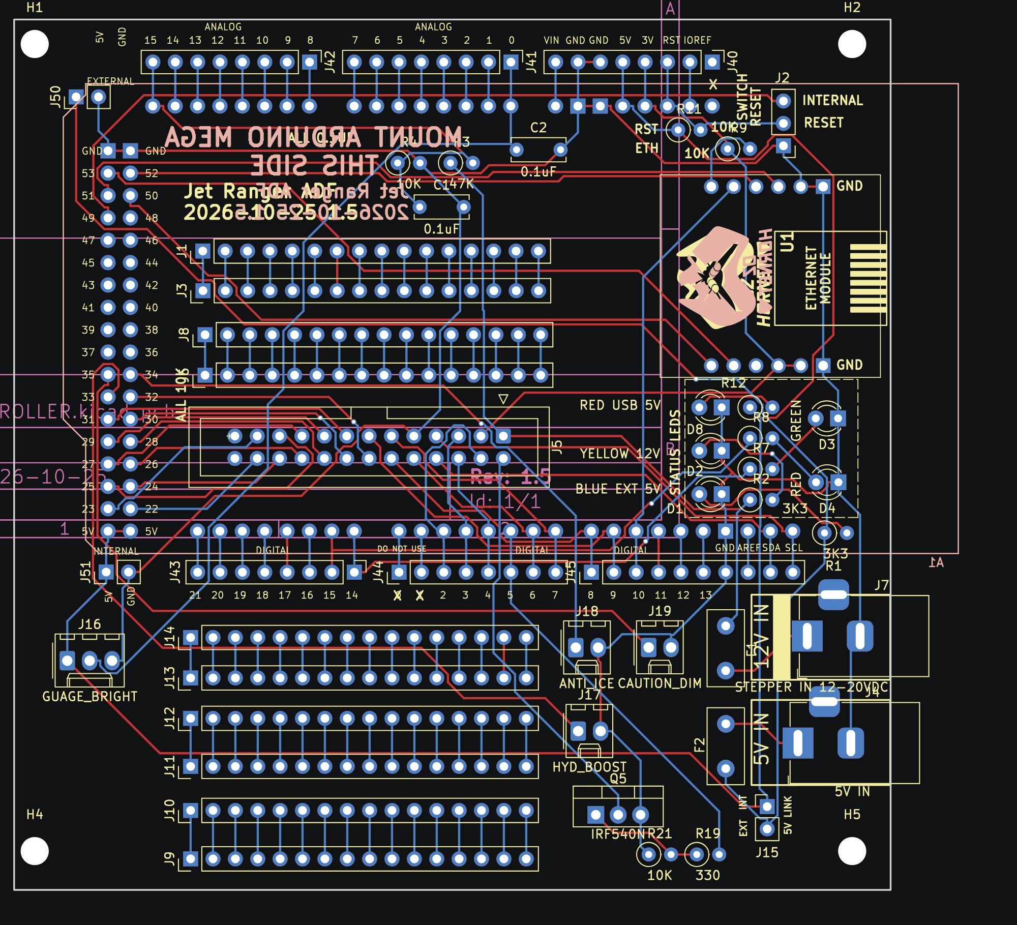
Jet Ranger/Jet Ranger Documentation/DocBuild/pcb/adf_controller_pcb.jpg
