bnepethomas/bne-arduino-flight-simulator-interfaces/Jet Ranger/Jet Ranger Documentation/DocBuild/pcb/upper_controller_sch.jpg

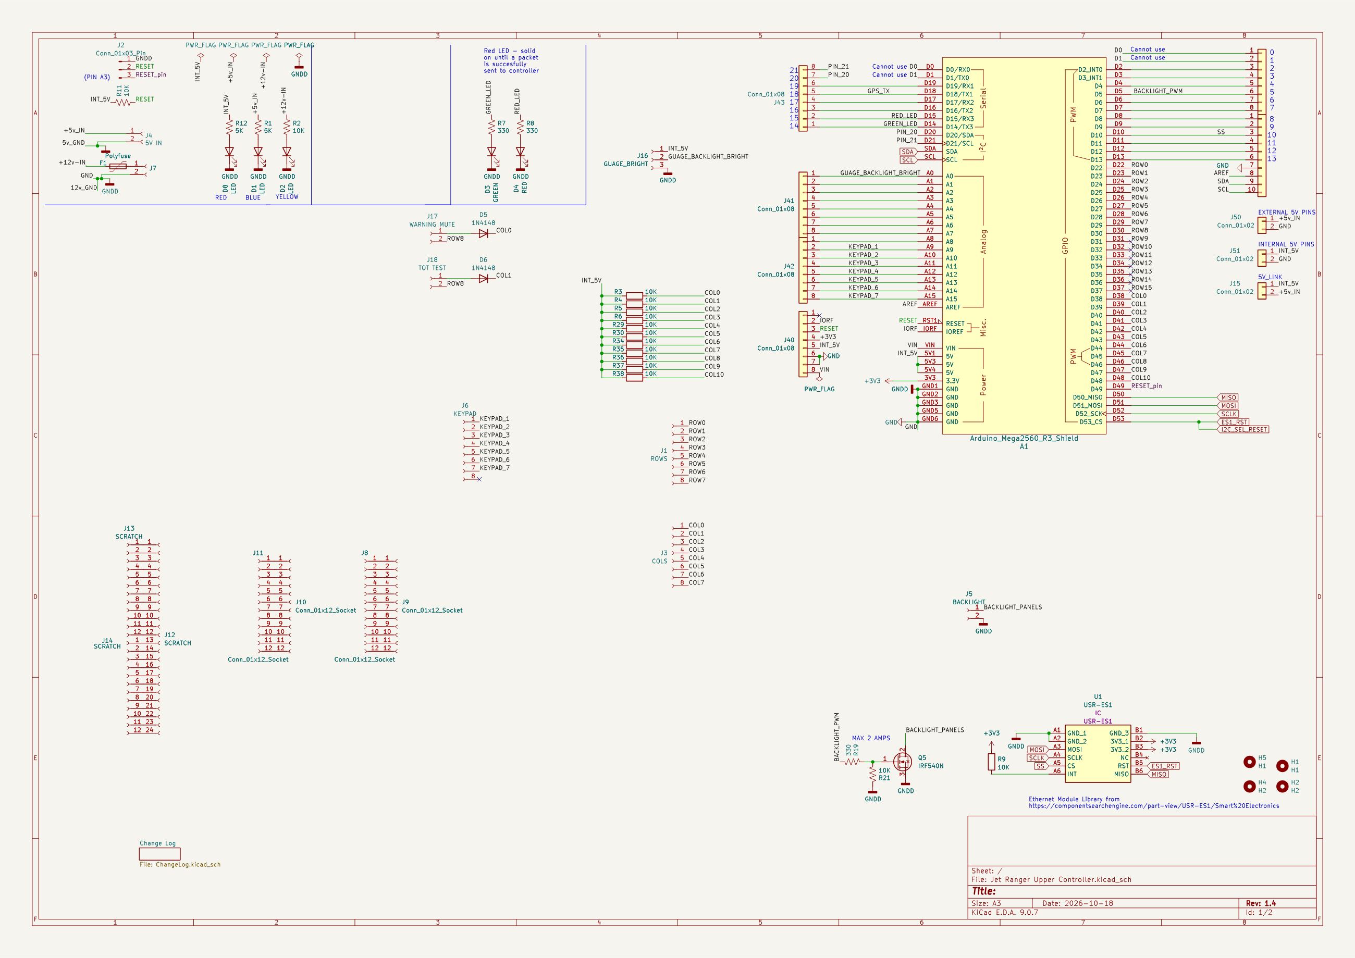
Jet Ranger/Jet Ranger Documentation/DocBuild/pcb/upper_controller_sch.jpg
