bnepethomas/bne-arduino-flight-simulator-interfaces/A10/A10 code to be validated/Projects/bne-dcs-gps-udp-tester/GPS_Test_Sender/readme.txt

Sends UDP frames to the GPS Receiver.  Used to test interface between DCs and GPS
