bnepethomas/bne-arduino-flight-simulator-interfaces/Python HW Link/testjson.txt

{
    "CDU N Key": {
        "down": "iCommandPlaneCDU_N", 
        "category": "CDU panel", 
        "up": "iCommandPlaneCDU_N", 
        "name": "CDU N Key"
    }, 
    "CDU BRT Rocker switch": {
        "down": "iCommandPlaneCDU_BRT", 
        "category": "CDU panel", 
        "up": "iCommandPlaneCDU_BRT", 
        "name": "CDU BRT Rocker switch"
    }, 
    "CMSP JMR ON/OFF": {
        "down": "iCommandPlaneCMSP_JMR_ON", 
        "category": "CMSP Panel", 
        "name": "CMSP JMR ON/OFF"
    }, 
    "Inverter TEST": {
        "down": "iCommandElectricalPowerInverterTEST", 
        "category": "Electrical power control panel", 
        "up": "iCommandElectricalPowerInverterOFF", 
        "name": "Inverter TEST"
    }, 
    "Camera view up-left": {
        "down": "iCommandViewCameraUpLeft", 
        "category": "View Cockpit", 
        "up": "iCommandViewCameraCenter", 
        "name": "Camera view up-left"
    }, 
    "VHF FM Squelch": {
        "down": "iCommandPlane_VHF_FM_Squelch", 
        "category": "VHF FM Radio Control Panel", 
        "name": "VHF FM Squelch"
    }, 
    "Landing Gear Down": {
        "down": "iCommandPlaneGearDown", 
        "category": "Landing gear panel", 
        "name": "Landing Gear Down"
    }, 
    "CB Generator CONT Left": {
        "down": "iCommandPlaneCircuitBreaker_29", 
        "category": "Circuit breaker panel", 
        "name": "CB Generator CONT Left", 
        "ip address": "192.168.77.88"
    }, 
    "F11 camera moving backward": {
        "down": "iCommandViewSlowDown", 
        "category": "View", 
        "name": "F11 camera moving backward"
    }, 
    "Position Lights Off": {
        "down": "iCommandPlanePositionLightsOff", 
        "category": "Lighting Panel", 
        "name": "Position Lights Off"
    }, 
    "AAP Steer Point MISSION": {
        "down": "iCommandPlane_AAP_SteerPt_MISSION", 
        "category": "AAP", 
        "name": "AAP Steer Point MISSION"
    }, 
    "AAP Page Select WAYPT": {
        "down": "iCommandPlane_AAP_PageSel_WAYPT", 
        "category": "AAP", 
        "name": "AAP Page Select WAYPT"
    }, 
    "HOTAS DMS Left": {
        "down": "iCommandPlane_HOTAS_DataManagementSwitchLeft", 
        "category": "HOTAS", 
        "up": "iCommandPlane_HOTAS_DataManagementSwitchOff", 
        "name": "HOTAS DMS Left"
    }, 
    "CDU LSK R9": {
        "down": "iCommandPlaneCDU_LSK_9R", 
        "category": "CDU panel", 
        "up": "iCommandPlaneCDU_LSK_9R", 
        "name": "CDU LSK R9"
    }, 
    "EGI HQ TOD Switch": {
        "down": "iCommandEGI_HQ_TOD", 
        "category": "Antenna Select Panel", 
        "name": "EGI HQ TOD Switch"
    }, 
    "CDU LSK R5": {
        "down": "iCommandPlaneCDU_LSK_5R", 
        "category": "CDU panel", 
        "up": "iCommandPlaneCDU_LSK_5R", 
        "name": "CDU LSK R5"
    }, 
    "CDU LSK R7": {
        "down": "iCommandPlaneCDU_LSK_7R", 
        "category": "CDU panel", 
        "up": "iCommandPlaneCDU_LSK_7R", 
        "name": "CDU LSK R7"
    }, 
    "CDU LSK R3": {
        "down": "iCommandPlaneCDU_LSK_3R", 
        "category": "CDU panel", 
        "up": "iCommandPlaneCDU_LSK_3R", 
        "name": "CDU LSK R3"
    }, 
    "Left wing tank fill disable": {
        "down": "iCommandPlaneFSLeftWingFillDisable", 
        "category": "Fuel system control panel", 
        "name": "Left wing tank fill disable"
    }, 
    "Air refuel control": {
        "down": "iCommandPlaneFSReceiverLever", 
        "category": "Fuel system control panel", 
        "name": "Air refuel control"
    }, 
    "CDU DIM Rocker switch": {
        "down": "iCommandPlaneCDU_DIM", 
        "category": "CDU panel", 
        "up": "iCommandPlaneCDU_DIM", 
        "name": "CDU DIM Rocker switch"
    }, 
    "CB Engine start Right": {
        "down": "iCommandPlaneCircuitBreaker_12", 
        "category": "Circuit breaker panel", 
        "name": "CB Engine start Right"
    }, 
    "Right MFCD SYM Increase": {
        "down": "iCommandPlaneRightMFD_SYM_Up", 
        "category": "Right MFCD", 
        "up": "iCommandPlaneRightMFD_SYM_Stop", 
        "name": "Right MFCD SYM Increase"
    }, 
    "UFC ALT Key": {
        "down": "iCommandPlaneUFC_ALT", 
        "category": "UFC", 
        "up": "iCommandPlaneUFC_ALT", 
        "name": "UFC ALT Key"
    }, 
    "Keep terrain camera altitude": {
        "down": "iCommandViewKeepTerrain", 
        "category": "View Extended", 
        "name": "Keep terrain camera altitude"
    }, 
    "Fly: Nose Up": {
        "down": "iCommandPlaneDownStart", 
        "category": "Flight Control", 
        "up": "iCommandPlaneDownStop", 
        "name": "Fly: Nose Up"
    }, 
    "All Labels": {
        "down": "iCommandMarkerState", 
        "category": "Labels", 
        "name": "All Labels"
    }, 
    "Camera view down-left": {
        "down": "iCommandViewCameraDownLeft", 
        "category": "View Cockpit", 
        "up": "iCommandViewCameraCenter", 
        "name": "Camera view down-left"
    }, 
    "Rotary selector VHF": {
        "down": "iCommandPlaneIntercomVHF", 
        "category": "Intercom control panel", 
        "name": "Rotary selector VHF"
    }, 
    "F11 Jump to free camera": {
        "down": "iCommandViewFreeJump", 
        "category": "View", 
        "name": "F11 Jump to free camera"
    }, 
    "CDU L Key": {
        "down": "iCommandPlaneCDU_L", 
        "category": "CDU panel", 
        "up": "iCommandPlaneCDU_L", 
        "name": "CDU L Key"
    }, 
    "Lock terrain view": {
        "down": "iCommandViewTerrainLock", 
        "category": "View Padlock", 
        "name": "Lock terrain view"
    }, 
    "F10 Theater map view": {
        "down": "iCommandViewAWACS", 
        "category": "View", 
        "name": "F10 Theater map view"
    }, 
    "CDU Z Key": {
        "down": "iCommandPlaneCDU_Z", 
        "category": "CDU panel", 
        "up": "iCommandPlaneCDU_Z", 
        "name": "CDU Z Key"
    }, 
    "CDU OSET Key": {
        "down": "iCommandPlaneCDU_OSET", 
        "category": "CDU panel", 
        "up": "iCommandPlaneCDU_OSET", 
        "name": "CDU OSET Key"
    }, 
    "Rearming and Refueling Window": {
        "down": "iCommandMissionResourcesManagement", 
        "category": "General", 
        "name": "Rearming and Refueling Window"
    }, 
    "NMSP ANCHR button": {
        "down": "iCommandPlaneNMSP_ANCHR", 
        "category": "Navigation Mode Select Panel", 
        "up": "iCommandPlaneNMSP_ANCHR", 
        "name": "NMSP ANCHR button"
    }, 
    "CB Elevator disconnect Left": {
        "down": "iCommandPlaneCircuitBreaker_4", 
        "category": "Circuit breaker panel", 
        "name": "CB Elevator disconnect Left"
    }, 
    "Multiplayer chat - mode All": {
        "down": "iCommandChat", 
        "category": "General", 
        "name": "Multiplayer chat - mode All"
    }, 
    "Altimeter PNEU Mode": {
        "down": "iCommandPlane_Altimeter_PNEU", 
        "category": "Systems", 
        "up": "iCommandPlane_Altimeter_CENTER", 
        "name": "Altimeter PNEU Mode"
    }, 
    "Left Mirror On": {
        "down": "iCommandViewLeftMirrorOn", 
        "category": "View Cockpit", 
        "up": "iCommandViewLeftMirrorOff", 
        "name": "Left Mirror On"
    }, 
    "CDU V Key": {
        "down": "iCommandPlaneCDU_V", 
        "category": "CDU panel", 
        "up": "iCommandPlaneCDU_V", 
        "name": "CDU V Key"
    }, 
    "Right MFCD ADJ Increase": {
        "down": "iCommandPlaneRightMFD_ADJ_Increase", 
        "category": "Right MFCD", 
        "up": "iCommandPlaneRightMFD_ADJ_Stop", 
        "name": "Right MFCD ADJ Increase"
    }, 
    "Master switch ARM": {
        "down": "iCommandPlaneAHCPMasterArm", 
        "category": "Armament HUD Control Panel", 
        "name": "Master switch ARM"
    }, 
    "F2 Toggle camera position": {
        "down": "iCommandViewFromTo", 
        "category": "View", 
        "name": "F2 Toggle camera position"
    }, 
    "Right MFCD OSB 09": {
        "down": "iCommandPlaneRightMFD_OSB9", 
        "category": "Right MFCD", 
        "up": "iCommandPlaneRightMFD_OSB9_Off", 
        "name": "Right MFCD OSB 09"
    }, 
    "Right MFCD OSB 08": {
        "down": "iCommandPlaneRightMFD_OSB8", 
        "category": "Right MFCD", 
        "up": "iCommandPlaneRightMFD_OSB8_Off", 
        "name": "Right MFCD OSB 08"
    }, 
    "Right MFCD OSB 07": {
        "down": "iCommandPlaneRightMFD_OSB7", 
        "category": "Right MFCD", 
        "up": "iCommandPlaneRightMFD_OSB7_Off", 
        "name": "Right MFCD OSB 07"
    }, 
    "Right MFCD OSB 06": {
        "down": "iCommandPlaneRightMFD_OSB6", 
        "category": "Right MFCD", 
        "up": "iCommandPlaneRightMFD_OSB6_Off", 
        "name": "Right MFCD OSB 06"
    }, 
    "Right MFCD OSB 05": {
        "down": "iCommandPlaneRightMFD_OSB5", 
        "category": "Right MFCD", 
        "up": "iCommandPlaneRightMFD_OSB5_Off", 
        "name": "Right MFCD OSB 05"
    }, 
    "Right MFCD OSB 04": {
        "down": "iCommandPlaneRightMFD_OSB4", 
        "category": "Right MFCD", 
        "up": "iCommandPlaneRightMFD_OSB4_Off", 
        "name": "Right MFCD OSB 04"
    }, 
    "Fuel quantity selector EXT CTR": {
        "down": "iCommandPlaneFSQuantityIndicatorSelectorEXTCTR", 
        "category": "Fuel system control panel", 
        "name": "Fuel quantity selector EXT CTR"
    }, 
    "GUN/PAC switch ARM": {
        "down": "iCommandPlaneAHCPGUNPACArm", 
        "category": "Armament HUD Control Panel", 
        "name": "GUN/PAC switch ARM"
    }, 
    "Right MFCD OSB 01": {
        "down": "iCommandPlaneRightMFD_OSB1", 
        "category": "Right MFCD", 
        "up": "iCommandPlaneRightMFD_OSB1_Off", 
        "name": "Right MFCD OSB 01"
    }, 
    "Accelerometer and Compass Light switch": {
        "down": "iCommandPlaneAccelCompLights", 
        "category": "Lighting Panel", 
        "name": "Accelerometer and Compass Light switch"
    }, 
    "HOTAS TMS Right": {
        "down": "iCommandPlane_HOTAS_TargetManagementSwitchRight", 
        "category": "HOTAS", 
        "up": "iCommandPlane_HOTAS_TargetManagementSwitchOff", 
        "name": "HOTAS TMS Right"
    }, 
    "Camera transpose mode (press and hold)": {
        "down": "iCommandViewTransposeModeOn", 
        "category": "View Cockpit", 
        "up": "iCommandViewTransposeModeOff", 
        "name": "Camera transpose mode (press and hold)"
    }, 
    "Left MFCD SYM Increase": {
        "down": "iCommandPlaneLeftMFD_SYM_Up", 
        "category": "Left MFCD", 
        "up": "iCommandPlaneLeftMFD_SYM_Stop", 
        "name": "Left MFCD SYM Increase"
    }, 
    "Info bar view toggle": {
        "down": "iCommandInfoOnOff", 
        "category": "General", 
        "name": "Info bar view toggle"
    }, 
    "CDU 5 Key": {
        "down": "iCommandPlaneCDU_5", 
        "category": "CDU panel", 
        "up": "iCommandPlaneCDU_5", 
        "name": "CDU 5 Key"
    }, 
    "CDU FA Key": {
        "down": "iCommandPlaneCDU_FA", 
        "category": "CDU panel", 
        "up": "iCommandPlaneCDU_FA", 
        "name": "CDU FA Key"
    }, 
    "Wind shield Rain Removal Switch Wash": {
        "down": "iCommandPlane_Env_WindshieldWash", 
        "category": "Environment System Panel", 
        "name": "Wind shield Rain Removal Switch Wash"
    }, 
    "Armament ground safety cover": {
        "down": "iCommandArmGroundSafetyCover", 
        "category": "Systems", 
        "name": "Armament ground safety cover"
    }, 
    "AC generator power right": {
        "down": "iCommandPowerGeneratorRight", 
        "category": "Electrical power control panel", 
        "name": "AC generator power right"
    }, 
    "UFC 9 Key": {
        "down": "iCommandPlaneUFC_9", 
        "category": "UFC", 
        "up": "iCommandPlaneUFC_9", 
        "name": "UFC 9 Key"
    }, 
    "Extend boarding ladder button": {
        "down": "iCommandExtLadderButton", 
        "category": "Systems", 
        "up": "iCommandExtLadderRelease", 
        "name": "Extend boarding ladder button"
    }, 
    "Bleed Air Switch": {
        "down": "iCommandPlane_Env_BleddAir", 
        "category": "Environment System Panel", 
        "name": "Bleed Air Switch"
    }, 
    "Objects switching direction reverse": {
        "down": "iCommandViewSwitchReverse", 
        "category": "View Extended", 
        "name": "Objects switching direction reverse"
    }, 
    "Cockpit panel view in": {
        "down": "iCommandViewTempCockpitOn", 
        "category": "View Cockpit", 
        "up": "iCommandViewTempCockpitOff", 
        "name": "Cockpit panel view in"
    }, 
    "Time accelerate": {
        "down": "iCommandAccelerate", 
        "category": "General", 
        "name": "Time accelerate"
    }, 
    "ILS Power Switch": {
        "down": "iCommandPlane_ILS_Power", 
        "category": "ILS Control Panel", 
        "name": "ILS Power Switch"
    }, 
    "VHF AM Mode MAN": {
        "down": "iCommandPlane_VHF_AM_Mode_MAN", 
        "category": "VHF AM Radio Control Panel", 
        "name": "VHF AM Mode MAN"
    }, 
    "HARS Fast Erect Button": {
        "down": "iCommandPlane_HARS_Fast_Erect", 
        "category": "Systems", 
        "up": "iCommandPlane_HARS_Fast_Erect", 
        "name": "HARS Fast Erect Button"
    }, 
    "UFC 6 Key": {
        "down": "iCommandPlaneUFC_6", 
        "category": "UFC", 
        "up": "iCommandPlaneUFC_6", 
        "name": "UFC 6 Key"
    }, 
    "HARS SYNC Button": {
        "down": "iCommandPlane_HARS_SyncButton", 
        "category": "HARS Control Panel", 
        "up": "iCommandPlane_HARS_SyncButton", 
        "name": "HARS SYNC Button"
    }, 
    "CDU WP Key": {
        "down": "iCommandPlaneCDU_WP", 
        "category": "CDU panel", 
        "up": "iCommandPlaneCDU_WP", 
        "name": "CDU WP Key"
    }, 
    "NVIS LTS ALL": {
        "down": "iCommandPlaneNightVisionLTSALL", 
        "category": "Auxiliary lighting control panel", 
        "name": "NVIS LTS ALL"
    }, 
    "UHF 0.1Mhz selector decrease": {
        "down": "iCommandPlaneUHF01MhzSelectorDec", 
        "category": "UHF Radio", 
        "name": "UHF 0.1Mhz selector decrease"
    }, 
    "Time normal": {
        "down": "iCommandNoAcceleration", 
        "category": "General", 
        "name": "Time normal"
    }, 
    "VHF FM Mode EMER FM": {
        "down": "iCommandPlane_VHF_FM_Mode_EMERFM", 
        "category": "VHF FM Radio Control Panel", 
        "name": "VHF FM Mode EMER FM"
    }, 
    "HARS/SAS OVERRIDE/NORM": {
        "down": "iCommandPlaneHarsSasNormOverride", 
        "category": "Auxiliary lighting control panel", 
        "name": "HARS/SAS OVERRIDE/NORM"
    }, 
    "TGP switch ON/OFF": {
        "down": "iCommandPlaneAHCPTGPOnOff", 
        "category": "Armament HUD Control Panel", 
        "name": "TGP switch ON/OFF"
    }, 
    "Unlock view (stop padlock)": {
        "down": "iCommandViewUnlock", 
        "category": "View Padlock", 
        "name": "Unlock view (stop padlock)"
    }, 
    "Right MFCD OSB 12": {
        "down": "iCommandPlaneRightMFD_OSB12", 
        "category": "Right MFCD", 
        "up": "iCommandPlaneRightMFD_OSB12_Off", 
        "name": "Right MFCD OSB 12"
    }, 
    "Jump into selected aircraft": {
        "down": "iCommandPlaneJump", 
        "category": "General", 
        "name": "Jump into selected aircraft"
    }, 
    "HOTAS CMS Aft": {
        "down": "iCommandPlane_HOTAS_CMS_Down", 
        "category": "HOTAS", 
        "up": "iCommandPlane_HOTAS_CMS_Off", 
        "name": "HOTAS CMS Aft"
    }, 
    "Return camera base": {
        "down": "iCommandViewCameraBaseReturn", 
        "category": "View Cockpit", 
        "name": "Return camera base"
    }, 
    "TACAN Mode Select OFF": {
        "down": "iCommandPlane_TACAN_Mode_Off", 
        "category": "TACAN Control Panel", 
        "name": "TACAN Mode Select OFF"
    }, 
    "Flaps emer retract": {
        "down": "iCommandPlaneEmerFlapsRetract", 
        "category": "Emergency flight control panel", 
        "name": "Flaps emer retract"
    }, 
    "VHF FM Mode PRE": {
        "down": "iCommandPlane_VHF_FM_Mode_PRE", 
        "category": "VHF FM Radio Control Panel", 
        "name": "VHF FM Mode PRE"
    }, 
    "TCN press": {
        "down": "iCommandPlaneIntercomTCNPress", 
        "category": "Intercom control panel", 
        "name": "TCN press"
    }, 
    "Right wing tank boost pump": {
        "down": "iCommandPlaneFSRightWingBoostPump", 
        "category": "Fuel system control panel", 
        "name": "Right wing tank boost pump"
    }, 
    "Right Mirror On": {
        "down": "iCommandViewRightMirrorOn", 
        "category": "View Cockpit", 
        "up": "iCommandViewRightMirrorOff", 
        "name": "Right Mirror On"
    }, 
    "Right MFCD OSB 15": {
        "down": "iCommandPlaneRightMFD_OSB15", 
        "category": "Right MFCD", 
        "up": "iCommandPlaneRightMFD_OSB15_Off", 
        "name": "Right MFCD OSB 15"
    }, 
    "Right MFCD OSB 16": {
        "down": "iCommandPlaneRightMFD_OSB16", 
        "category": "Right MFCD", 
        "up": "iCommandPlaneRightMFD_OSB16_Off", 
        "name": "Right MFCD OSB 16"
    }, 
    "CDU Search forward Key": {
        "down": "iCommandPlaneCDU_BLANC_R", 
        "category": "CDU panel", 
        "up": "iCommandPlaneCDU_BLANC_R", 
        "name": "CDU Search forward Key"
    }, 
    "CDU 0 Key": {
        "down": "iCommandPlaneCDU_0", 
        "category": "CDU panel", 
        "up": "iCommandPlaneCDU_0", 
        "name": "CDU 0 Key"
    }, 
    "HARS Mode Selector SLAVE/DG": {
        "down": "iCommandPlane_HARS_Mode", 
        "category": "HARS Control Panel", 
        "name": "HARS Mode Selector SLAVE/DG"
    }, 
    "Fly: Right Wing Down": {
        "down": "iCommandPlaneRightStart", 
        "category": "Flight Control", 
        "up": "iCommandPlaneRightStop", 
        "name": "Fly: Right Wing Down"
    }, 
    "Right MFCD OSB 18": {
        "down": "iCommandPlaneRightMFD_OSB18", 
        "category": "Right MFCD", 
        "up": "iCommandPlaneRightMFD_OSB18_Off", 
        "name": "Right MFCD OSB 18"
    }, 
    "Ask AWACS available tanker": {
        "down": "iCommandAWACSTankerBearing", 
        "category": "Communications", 
        "name": "Ask AWACS available tanker"
    }, 
    "Right MFCD OSB 19": {
        "down": "iCommandPlaneRightMFD_OSB19", 
        "category": "Right MFCD", 
        "up": "iCommandPlaneRightMFD_OSB19_Off", 
        "name": "Right MFCD OSB 19"
    }, 
    "Refueling signal amplifier": {
        "down": "iCommandPlaneFSSigAmplifier", 
        "category": "Fuel system control panel", 
        "name": "Refueling signal amplifier"
    }, 
    "UHF Antenna Switch LOWER": {
        "down": "iCommandUHFAntennaLower", 
        "category": "Antenna Select Panel", 
        "name": "UHF Antenna Switch LOWER"
    }, 
    "CMSP MODE OFF": {
        "down": "iCommandPlaneCMSP_MODE_OFF", 
        "category": "CMSP Panel", 
        "name": "CMSP MODE OFF"
    }, 
    "Signal lights lamp test": {
        "down": "iCommandLampsControl", 
        "category": "Auxiliary lighting control panel", 
        "up": "iCommandLampsControl_up", 
        "name": "Signal lights lamp test"
    }, 
    "Camera view mouse rate slow": {
        "down": "iCommandViewSlowMouse", 
        "category": "View", 
        "name": "Camera view mouse rate slow"
    }, 
    "HM press": {
        "down": "iCommandPlaneIntercomHM", 
        "category": "Intercom control panel", 
        "name": "HM press"
    }, 
    "Dispatch wingmans - complete mission and RTB": {
        "down": "iCommandPlaneDoAndHome", 
        "category": "Communications", 
        "name": "Dispatch wingmans - complete mission and RTB"
    }, 
    "CDU M Key": {
        "down": "iCommandPlaneCDU_M", 
        "category": "CDU panel", 
        "up": "iCommandPlaneCDU_M", 
        "name": "CDU M Key"
    }, 
    "All missiles padlock": {
        "down": "iCommandAllMissilePadlock", 
        "category": "View Padlock", 
        "name": "All missiles padlock"
    }, 
    "VHF FM Mode MAN": {
        "down": "iCommandPlane_VHF_FM_Mode_MAN", 
        "category": "VHF FM Radio Control Panel", 
        "name": "VHF FM Mode MAN"
    }, 
    "End mission": {
        "down": "iCommandQuit", 
        "category": "General", 
        "name": "End mission"
    }, 
    "Kneeboard current position mark point": {
        "down": "3003", 
        "cockpit_device_id": "100", 
        "category": "Kneeboard", 
        "value_down": "1", 
        "name": "Kneeboard current position mark point"
    }, 
    "Fly: Nose Down": {
        "down": "iCommandPlaneUpStart", 
        "category": "Flight Control", 
        "up": "iCommandPlaneUpStop", 
        "name": "Fly: Nose Down"
    }, 
    "View friends mode": {
        "down": "iCommandViewFriends", 
        "category": "View Extended", 
        "name": "View friends mode"
    }, 
    "CDU A Key": {
        "down": "iCommandPlaneCDU_A", 
        "category": "CDU panel", 
        "up": "iCommandPlaneCDU_A", 
        "name": "CDU A Key"
    }, 
    "Active Pause": {
        "down": "iCommandActivePauseOnOff", 
        "category": "Cheat", 
        "name": "Active Pause"
    }, 
    "Right MFCD CON Increase": {
        "down": "iCommandPlaneRightMFD_CON_Increase", 
        "category": "Right MFCD", 
        "up": "iCommandPlaneRightMFD_CON_Stop", 
        "name": "Right MFCD CON Increase"
    }, 
    "CB Emer fuel shutoff Rignt engine": {
        "down": "iCommandPlaneCircuitBreaker_17", 
        "category": "Circuit breaker panel", 
        "name": "CB Emer fuel shutoff Rignt engine"
    }, 
    "HOTAS DMS Right": {
        "down": "iCommandPlane_HOTAS_DataManagementSwitchRight", 
        "category": "HOTAS", 
        "up": "iCommandPlane_HOTAS_DataManagementSwitchOff", 
        "name": "HOTAS DMS Right"
    }, 
    "Left MFCD BRT Decrease": {
        "down": "iCommandPlaneLeftMFD_BRT_Decrease", 
        "category": "Left MFCD", 
        "up": "iCommandPlaneLeftMFD_BRT_Stop", 
        "name": "Left MFCD BRT Decrease"
    }, 
    "CDU PLUS Key": {
        "down": "iCommandPlaneCDU_PLUS", 
        "category": "CDU panel", 
        "up": "iCommandPlaneCDU_PLUS", 
        "name": "CDU PLUS Key"
    }, 
    "F6 Weapon to target view": {
        "down": "iCommandViewWeaponAndTarget", 
        "category": "View", 
        "name": "F6 Weapon to target view"
    }, 
    "UHF Freq mode MNL": {
        "down": "iCommandPlaneUHFFreqModeDialMNL", 
        "category": "UHF Radio", 
        "name": "UHF Freq mode MNL"
    }, 
    "CB Emer fuel shutoff Left engine": {
        "down": "iCommandPlaneCircuitBreaker_16", 
        "category": "Circuit breaker panel", 
        "name": "CB Emer fuel shutoff Left engine"
    }, 
    "CMSC UNK Key": {
        "down": "iCommandPlaneCMSC_UNK", 
        "category": "CMSC Panel", 
        "up": "iCommandPlaneCMSC_UNK", 
        "name": "CMSC UNK Key"
    }, 
    "AC generator power left": {
        "down": "iCommandPowerGeneratorLeft", 
        "category": "Electrical power control panel", 
        "name": "AC generator power left"
    }, 
    "Time decelerate": {
        "down": "iCommandDecelerate", 
        "category": "General", 
        "name": "Time decelerate"
    }, 
    "Extend boarding ladder cover": {
        "down": "iCommandExtLadderButtonCover", 
        "category": "Systems", 
        "name": "Extend boarding ladder cover"
    }, 
    "Emergency Wheel Brake": {
        "down": "iCommandPlaneEmergencyBrake", 
        "category": "Systems", 
        "up": "iCommandPlaneEmergencyBrake", 
        "name": "Emergency Wheel Brake"
    }, 
    "CDU NAV Key": {
        "down": "iCommandPlaneCDU_NAV", 
        "category": "CDU panel", 
        "up": "iCommandPlaneCDU_NAV", 
        "name": "CDU NAV Key"
    }, 
    "HOTAS CMS Right": {
        "down": "iCommandPlane_HOTAS_CMS_Right", 
        "category": "HOTAS", 
        "up": "iCommandPlane_HOTAS_CMS_Off", 
        "name": "HOTAS CMS Right"
    }, 
    "F2 Aircraft view": {
        "down": "iCommandViewAir", 
        "category": "View", 
        "name": "F2 Aircraft view"
    }, 
    "UFC DATA DOWN Rocker switch": {
        "down": "iCommandPlaneUFC_DATA_DOWN", 
        "category": "UFC", 
        "up": "iCommandPlaneUFC_DATA_DOWN", 
        "name": "UFC DATA DOWN Rocker switch"
    }, 
    "Canopy jettison lever": {
        "down": "iCommandCanopyJettison", 
        "category": "Systems", 
        "name": "Canopy jettison lever"
    }, 
    "Oxygen Dilution Lever": {
        "down": "iCommandPlane_Oxygen_100Oxygen", 
        "category": "Environment System Panel", 
        "name": "Oxygen Dilution Lever"
    }, 
    "CB Battery bus transformer": {
        "down": "iCommandPlaneCircuitBreaker_35", 
        "category": "Circuit breaker panel", 
        "name": "CB Battery bus transformer"
    }, 
    "CMSP MWS ON/OFF": {
        "down": "iCommandPlaneCMSP_MWS_ON", 
        "category": "CMSP Panel", 
        "name": "CMSP MWS ON/OFF"
    }, 
    "View enemies mode": {
        "down": "iCommandViewEnemies", 
        "category": "View Extended", 
        "name": "View enemies mode"
    }, 
    "Object exclude": {
        "down": "iCommandViewObjectIgnore", 
        "category": "View Extended", 
        "name": "Object exclude"
    }, 
    "UHF press": {
        "down": "iCommandPlaneIntercomUHFPress", 
        "category": "Intercom control panel", 
        "name": "UHF press"
    }, 
    "Nose Flooding and Nose Illimination switch": {
        "down": "iCommandPlaneNoseIllum", 
        "category": "Lighting Panel", 
        "name": "Nose Flooding and Nose Illimination switch"
    }, 
    "CDU T Key": {
        "down": "iCommandPlaneCDU_T", 
        "category": "CDU panel", 
        "up": "iCommandPlaneCDU_T", 
        "name": "CDU T Key"
    }, 
    "Pitch SAS engage Right": {
        "down": "iCommandPlanePitchSASEngageR", 
        "category": "Stability Augmentation System", 
        "name": "Pitch SAS engage Right"
    }, 
    "Fly: Rudder Left": {
        "down": "iCommandPlaneLeftRudderStart", 
        "category": "Flight Control", 
        "up": "iCommandPlaneLeftRudderStop", 
        "name": "Fly: Rudder Left"
    }, 
    "F3 Fly-By view": {
        "down": "iCommandViewTower", 
        "category": "View", 
        "name": "F3 Fly-By view"
    }, 
    "UFC INTEN INCREASE Rocker switch": {
        "down": "iCommandPlaneUFC_INTEN_INCREASE", 
        "category": "UFC", 
        "up": "iCommandPlaneUFC_INTEN_INCREASE", 
        "name": "UFC INTEN INCREASE Rocker switch"
    }, 
    "Altimeter ELECT Mode": {
        "down": "iCommandPlane_Altimeter_ELECT", 
        "category": "Systems", 
        "up": "iCommandPlane_Altimeter_CENTER", 
        "name": "Altimeter ELECT Mode"
    }, 
    "Left MFCD OSB 09": {
        "down": "iCommandPlaneLeftMFD_OSB9", 
        "category": "Left MFCD", 
        "up": "iCommandPlaneLeftMFD_OSB9_Off", 
        "name": "Left MFCD OSB 09"
    }, 
    "Left MFCD OSB 08": {
        "down": "iCommandPlaneLeftMFD_OSB8", 
        "category": "Left MFCD", 
        "up": "iCommandPlaneLeftMFD_OSB8_Off", 
        "name": "Left MFCD OSB 08"
    }, 
    "Monitor test Right": {
        "down": "iCommandPlaneSASMonitorTestRight", 
        "category": "Stability Augmentation System", 
        "name": "Monitor test Right"
    }, 
    "Left MFCD OSB 03": {
        "down": "iCommandPlaneLeftMFD_OSB3", 
        "category": "Left MFCD", 
        "up": "iCommandPlaneLeftMFD_OSB3_Off", 
        "name": "Left MFCD OSB 03"
    }, 
    "Left MFCD OSB 02": {
        "down": "iCommandPlaneLeftMFD_OSB2", 
        "category": "Left MFCD", 
        "up": "iCommandPlaneLeftMFD_OSB2_Off", 
        "name": "Left MFCD OSB 02"
    }, 
    "Left MFCD OSB 01": {
        "down": "iCommandPlaneLeftMFD_OSB1", 
        "category": "Left MFCD", 
        "up": "iCommandPlaneLeftMFD_OSB1_Off", 
        "name": "Left MFCD OSB 01"
    }, 
    "Left MFCD OSB 07": {
        "down": "iCommandPlaneLeftMFD_OSB7", 
        "category": "Left MFCD", 
        "up": "iCommandPlaneLeftMFD_OSB7_Off", 
        "name": "Left MFCD OSB 07"
    }, 
    "Left MFCD OSB 06": {
        "down": "iCommandPlaneLeftMFD_OSB6", 
        "category": "Left MFCD", 
        "up": "iCommandPlaneLeftMFD_OSB6_Off", 
        "name": "Left MFCD OSB 06"
    }, 
    "Left MFCD OSB 05": {
        "down": "iCommandPlaneLeftMFD_OSB5", 
        "category": "Left MFCD", 
        "up": "iCommandPlaneLeftMFD_OSB5_Off", 
        "name": "Left MFCD OSB 05"
    }, 
    "Left MFCD OSB 04": {
        "down": "iCommandPlaneLeftMFD_OSB4", 
        "category": "Left MFCD", 
        "up": "iCommandPlaneLeftMFD_OSB4_Off", 
        "name": "Left MFCD OSB 04"
    }, 
    "IFFCC switch TEST": {
        "down": "iCommandPlaneAHCPIFFCCTest", 
        "category": "Armament HUD Control Panel", 
        "name": "IFFCC switch TEST"
    }, 
    "F7 Ground unit view": {
        "down": "iCommandViewGround", 
        "category": "View", 
        "name": "F7 Ground unit view"
    }, 
    "Right MFCD Disable power": {
        "down": "iCommandPlaneRightMFD_BRTMODE_OFF", 
        "category": "Right MFCD", 
        "name": "Right MFCD Disable power"
    }, 
    "Fly: Left Wing Down": {
        "down": "iCommandPlaneLeftStart", 
        "category": "Flight Control", 
        "up": "iCommandPlaneLeftStop", 
        "name": "Fly: Left Wing Down"
    }, 
    "UHF Dial ADF": {
        "down": "iCommandPlaneUHFFunctionDialADF", 
        "category": "UHF Radio", 
        "name": "UHF Dial ADF"
    }, 
    "HARS Hemisphere Selector": {
        "down": "iCommandPlane_HARS_HemisphereSel", 
        "category": "HARS Control Panel", 
        "name": "HARS Hemisphere Selector"
    }, 
    "VHF FM Mode EMER AM": {
        "down": "iCommandPlane_VHF_FM_Mode_EMERAM", 
        "category": "VHF FM Radio Control Panel", 
        "name": "VHF FM Mode EMER AM"
    }, 
    "UFC 1 Key": {
        "down": "iCommandPlaneUFC_1", 
        "category": "UFC", 
        "up": "iCommandPlaneUFC_1", 
        "name": "UFC 1 Key"
    }, 
    "CMSC SEP Key": {
        "down": "iCommandPlaneCMSC_SEP", 
        "category": "CMSC Panel", 
        "up": "iCommandPlaneCMSC_SEP", 
        "name": "CMSC SEP Key"
    }, 
    "Cockpit panel view toggle": {
        "down": "iCommandViewTempCockpitToggle", 
        "category": "View Cockpit", 
        "name": "Cockpit panel view toggle"
    }, 
    "CDU I Key": {
        "down": "iCommandPlaneCDU_I", 
        "category": "CDU panel", 
        "up": "iCommandPlaneCDU_I", 
        "name": "CDU I Key"
    }, 
    "Right MFCD DSP Decrease": {
        "down": "iCommandPlaneRightMFD_DSP_Decrease", 
        "category": "Right MFCD", 
        "up": "iCommandPlaneRightMFD_DSP_Stop", 
        "name": "Right MFCD DSP Decrease"
    }, 
    "CMSP MODE SEMI": {
        "down": "iCommandPlaneCMSP_MODE_SEMI", 
        "category": "CMSP Panel", 
        "name": "CMSP MODE SEMI"
    }, 
    "UFC 4 Key": {
        "down": "iCommandPlaneUFC_4", 
        "category": "UFC", 
        "up": "iCommandPlaneUFC_4", 
        "name": "UFC 4 Key"
    }, 
    "HARS Magnetic Variation +15": {
        "down": "iCommandPlane_HARS_MagneticVar_Plus15", 
        "category": "HARS Control Panel", 
        "name": "HARS Magnetic Variation +15"
    }, 
    "CMSP DISP ON/OFF": {
        "down": "iCommandPlaneCMSP_DISP_ON", 
        "category": "CMSP Panel", 
        "name": "CMSP DISP ON/OFF"
    }, 
    "Oxygen Indicator Test": {
        "down": "iCommandPlane_Oxygen_Ind_Test", 
        "category": "Environment System Panel", 
        "up": "iCommandPlane_Oxygen_Ind_Test", 
        "name": "Oxygen Indicator Test"
    }, 
    "F11 Airport free camera": {
        "down": "iCommandViewFree", 
        "category": "View", 
        "name": "F11 Airport free camera"
    }, 
    "UFC STEER DOWN Rocker switch": {
        "down": "iCommandPlaneUFC_STEER_DOWN", 
        "category": "UFC", 
        "up": "iCommandPlaneUFC_STEER_DOWN", 
        "name": "UFC STEER DOWN Rocker switch"
    }, 
    "ILS press": {
        "down": "iCommandPlaneIntercomILSPress", 
        "category": "Intercom control panel", 
        "name": "ILS press"
    }, 
    "CDU Q Key": {
        "down": "iCommandPlaneCDU_Q", 
        "category": "CDU panel", 
        "up": "iCommandPlaneCDU_Q", 
        "name": "CDU Q Key"
    }, 
    "VHF FM Frequency Mode DN": {
        "down": "iCommandPlane_VHF_FM_FreqMode_DN", 
        "category": "VHF FM Radio Control Panel", 
        "name": "VHF FM Frequency Mode DN"
    }, 
    "CMSP OSB4": {
        "down": "iCommandPlaneCMSP_OSB_4", 
        "category": "CMSP Panel", 
        "up": "iCommandPlaneCMSP_OSB_4", 
        "name": "CMSP OSB4"
    }, 
    "GUN/PAC switch SAFE": {
        "down": "iCommandPlaneAHCPGUNSafe", 
        "category": "Armament HUD Control Panel", 
        "name": "GUN/PAC switch SAFE"
    }, 
    "CMSP OSB2": {
        "down": "iCommandPlaneCMSP_OSB_2", 
        "category": "CMSP Panel", 
        "up": "iCommandPlaneCMSP_OSB_2", 
        "name": "CMSP OSB2"
    }, 
    "CDU 7 Key": {
        "down": "iCommandPlaneCDU_7", 
        "category": "CDU panel", 
        "up": "iCommandPlaneCDU_7", 
        "name": "CDU 7 Key"
    }, 
    "CMSP OSB1": {
        "down": "iCommandPlaneCMSP_OSB_1", 
        "category": "CMSP Panel", 
        "up": "iCommandPlaneCMSP_OSB_1", 
        "name": "CMSP OSB1"
    }, 
    "HOTAS CMS Forward": {
        "down": "iCommandPlane_HOTAS_CMS_Up", 
        "category": "HOTAS", 
        "up": "iCommandPlane_HOTAS_CMS_Off", 
        "name": "HOTAS CMS Forward"
    }, 
    "CMSP JMR MENU": {
        "down": "iCommandPlaneCMSP_JMR_MENU", 
        "category": "CMSP Panel", 
        "up": "iCommandPlaneCMSP_JMR_ON", 
        "name": "CMSP JMR MENU"
    }, 
    "Camera view down-right": {
        "down": "iCommandViewCameraDownRight", 
        "category": "View Cockpit", 
        "up": "iCommandViewCameraCenter", 
        "name": "Camera view down-right"
    }, 
    "HUD Mode switch Day/Night": {
        "down": "iCommandPlaneAHCPHUDModeDayNight", 
        "category": "Armament HUD Control Panel", 
        "name": "HUD Mode switch Day/Night"
    }, 
    "UFC HACK Key": {
        "down": "iCommandPlaneUFC_HACK", 
        "category": "UFC", 
        "up": "iCommandPlaneUFC_HACK", 
        "name": "UFC HACK Key"
    }, 
    "Fire detect bleed air leak test": {
        "down": "iCommandPlaneFireDetectBleedAirTest", 
        "category": "Auxiliary lighting control panel", 
        "up": "iCommandPlaneFireDetectBleedAirTest", 
        "name": "Fire detect bleed air leak test"
    }, 
    "HOTAS TMS Left": {
        "down": "iCommandPlane_HOTAS_TargetManagementSwitchLeft", 
        "category": "HOTAS", 
        "up": "iCommandPlane_HOTAS_TargetManagementSwitchOff", 
        "name": "HOTAS TMS Left"
    }, 
    "Navigation lights": {
        "down": "iCommandPlaneLightsOnOff", 
        "category": "Systems", 
        "name": "Navigation lights"
    }, 
    "NMSP EGI button": {
        "down": "iCommandPlaneNMSP_EGI", 
        "category": "Navigation Mode Select Panel", 
        "up": "iCommandPlaneNMSP_EGI", 
        "name": "NMSP EGI button"
    }, 
    "Canopy Open/Close": {
        "down": "iCommandPlaneFonar", 
        "category": "Systems", 
        "name": "Canopy Open/Close"
    }, 
    "CMSP RWR ON/OFF": {
        "down": "iCommandPlaneCMSP_RWR_ON", 
        "category": "CMSP Panel", 
        "name": "CMSP RWR ON/OFF"
    }, 
    "Fuel quantity selector EXT WING": {
        "down": "iCommandPlaneFSQuantityIndicatorSelectorEXTWING", 
        "category": "Fuel system control panel", 
        "name": "Fuel quantity selector EXT WING"
    }, 
    "UHF 10Mhz selector decrease": {
        "down": "iCommandPlaneUHF10MhzSelectorDec", 
        "category": "UHF Radio", 
        "name": "UHF 10Mhz selector decrease"
    }, 
    "CB Engines ingnitor L/R-1": {
        "down": "iCommandPlaneCircuitBreaker_14", 
        "category": "Circuit breaker panel", 
        "name": "CB Engines ingnitor L/R-1"
    }, 
    "CB Engines ingnitor L/R-2": {
        "down": "iCommandPlaneCircuitBreaker_15", 
        "category": "Circuit breaker panel", 
        "name": "CB Engines ingnitor L/R-2"
    }, 
    "Master switch SAFE": {
        "down": "iCommandPlaneAHCPMasterSafe", 
        "category": "Armament HUD Control Panel", 
        "name": "Master switch SAFE"
    }, 
    "CDU 8 Key": {
        "down": "iCommandPlaneCDU_8", 
        "category": "CDU panel", 
        "up": "iCommandPlaneCDU_8", 
        "name": "CDU 8 Key"
    }, 
    "CB IFF": {
        "down": "iCommandPlaneCircuitBreaker_26", 
        "category": "Circuit breaker panel", 
        "name": "CB IFF"
    }, 
    "CDU 2 Key": {
        "down": "iCommandPlaneCDU_2", 
        "category": "CDU panel", 
        "up": "iCommandPlaneCDU_2", 
        "name": "CDU 2 Key"
    }, 
    "External tanks wing valve": {
        "down": "iCommandPlaneFSExtTanksWingValve", 
        "category": "Fuel system control panel", 
        "name": "External tanks wing valve"
    }, 
    "CDU FPM Key": {
        "down": "iCommandPlaneCDU_FPM", 
        "category": "CDU panel", 
        "up": "iCommandPlaneCDU_FPM", 
        "name": "CDU FPM Key"
    }, 
    "Right MFCD Night illumination": {
        "down": "iCommandPlaneRightMFD_BRTMODE_NIGHT", 
        "category": "Right MFCD", 
        "name": "Right MFCD Night illumination"
    }, 
    "Playback track cancel": {
        "down": "iCommandTrkEsc", 
        "category": "General", 
        "name": "Playback track cancel"
    }, 
    "IFF Antenna Switch UPPER": {
        "down": "iCommandIFFAntennaUpper", 
        "category": "Antenna Select Panel", 
        "name": "IFF Antenna Switch UPPER"
    }, 
    "Snap View 8": {
        "down": "iCommandViewSnapView8", 
        "category": "View Cockpit", 
        "up": "iCommandViewSnapViewStop", 
        "name": "Snap View 8"
    }, 
    "Camera view left": {
        "down": "iCommandViewCameraLeft", 
        "category": "View Cockpit", 
        "up": "iCommandViewCameraCenter", 
        "name": "Camera view left"
    }, 
    "Throttle Right Down Step": {
        "down": "iCommandPlaneAUTDecreaseRegimeRight", 
        "category": "Flight Control", 
        "name": "Throttle Right Down Step"
    }, 
    "UHF Load": {
        "down": "iCommandPlaneUHFLoad", 
        "category": "UHF Radio", 
        "up": "iCommandPlaneUHFLoad", 
        "name": "UHF Load"
    }, 
    "CB INTER COMM": {
        "down": "iCommandPlaneCircuitBreaker_28", 
        "category": "Circuit breaker panel", 
        "name": "CB INTER COMM"
    }, 
    "Ask AWACS home airbase": {
        "down": "iCommandAWACSHomeBearing", 
        "category": "Communications", 
        "name": "Ask AWACS home airbase"
    }, 
    "Oxygen Supply Lever": {
        "down": "iCommandPlane_Oxygen_Supply", 
        "category": "Environment System Panel", 
        "name": "Oxygen Supply Lever"
    }, 
    "UFC SEL DOWN Rocker switch": {
        "down": "iCommandPlaneUFC_SEL_DOWN", 
        "category": "UFC", 
        "up": "iCommandPlaneUFC_SEL_DOWN", 
        "name": "UFC SEL DOWN Rocker switch"
    }, 
    "IFF Antenna Switch BOTH": {
        "down": "iCommandIFFAntennaBoth", 
        "category": "Antenna Select Panel", 
        "name": "IFF Antenna Switch BOTH"
    }, 
    "CDU CLR Key": {
        "down": "iCommandPlaneCDU_CLR", 
        "category": "CDU panel", 
        "up": "iCommandPlaneCDU_CLR", 
        "name": "CDU CLR Key"
    }, 
    "CB Land GEAR": {
        "down": "iCommandPlaneCircuitBreaker_10", 
        "category": "Circuit breaker panel", 
        "name": "CB Land GEAR"
    }, 
    "Attack Air Defenses": {
        "down": "iCommandPlane_EngageAirDefenses", 
        "category": "Communications", 
        "name": "Attack Air Defenses"
    }, 
    "UHF 0.1Mhz selector increase": {
        "down": "iCommandPlaneUHF01MhzSelectorInc", 
        "category": "UHF Radio", 
        "name": "UHF 0.1Mhz selector increase"
    }, 
    "CDU SPC Key": {
        "down": "iCommandPlaneCDU_SPC", 
        "category": "CDU panel", 
        "up": "iCommandPlaneCDU_SPC", 
        "name": "CDU SPC Key"
    }, 
    "Attack my target": {
        "down": "iCommandPlaneAttackMyTarget", 
        "category": "Communications", 
        "name": "Attack my target"
    }, 
    "UHF Panel cover": {
        "down": "iCommandPlaneUHFPanelCover", 
        "category": "UHF Radio", 
        "name": "UHF Panel cover"
    }, 
    "Start/Stop/Reset Flight Clock": {
        "down": "iCommandFlightClockReset", 
        "category": "Systems", 
        "name": "Start/Stop/Reset Flight Clock"
    }, 
    "Right MFCD CON Decrease": {
        "down": "iCommandPlaneRightMFD_CON_Decrease", 
        "category": "Right MFCD", 
        "up": "iCommandPlaneRightMFD_CON_Stop", 
        "name": "Right MFCD CON Decrease"
    }, 
    "APU T-Handle Fire Extinguisher": {
        "down": "iCommand_FireExting_APUExting", 
        "category": "Fire Extinguishers System", 
        "name": "APU T-Handle Fire Extinguisher"
    }, 
    "UFC DEPR UP Rocker switch": {
        "down": "iCommandPlaneUFC_DEPR_UP", 
        "category": "UFC", 
        "up": "iCommandPlaneUFC_DEPR_UP", 
        "name": "UFC DEPR UP Rocker switch"
    }, 
    "CB Engine start Left": {
        "down": "iCommandPlaneCircuitBreaker_11", 
        "category": "Circuit breaker panel", 
        "name": "CB Engine start Left"
    }, 
    "Monitor test Left": {
        "down": "iCommandPlaneSASMonitorTestLeft", 
        "category": "Stability Augmentation System", 
        "name": "Monitor test Left"
    }, 
    "Air Conditioner Control AUTO": {
        "down": "iCommandPlane_Env_AirConditioner_AUTO", 
        "category": "Environment System Panel", 
        "name": "Air Conditioner Control AUTO"
    }, 
    "Right wing tank fill disable": {
        "down": "iCommandPlaneFSRightWingFillDisable", 
        "category": "Fuel system control panel", 
        "name": "Right wing tank fill disable"
    }, 
    "Left Engine T-Handle Fire Extinguisher": {
        "down": "iCommand_FireExting_LeftEngineExting", 
        "category": "Fire Extinguishers System", 
        "name": "Left Engine T-Handle Fire Extinguisher"
    }, 
    "Coordinates units change": {
        "down": "iCommandViewCoordinatesInLinearUnits", 
        "category": "General", 
        "name": "Coordinates units change"
    }, 
    "CDU PREV Key": {
        "down": "iCommandPlaneCDU_PREV", 
        "category": "CDU panel", 
        "up": "iCommandPlaneCDU_PREV", 
        "name": "CDU PREV Key"
    }, 
    "IFFCC switch OFF": {
        "down": "iCommandPlaneAHCPIFFCCOff", 
        "category": "Armament HUD Control Panel", 
        "name": "IFFCC switch OFF"
    }, 
    "UHF Preset chanel selector decrease": {
        "down": "iCommandPlaneUHFPresetChannelSelectorDec", 
        "category": "UHF Radio", 
        "name": "UHF Preset chanel selector decrease"
    }, 
    "CDU LSK L9": {
        "down": "iCommandPlaneCDU_LSK_9L", 
        "category": "CDU panel", 
        "up": "iCommandPlaneCDU_LSK_9L", 
        "name": "CDU LSK L9"
    }, 
    "Trim: Reset": {
        "down": "iCommandPlaneTrimCancel", 
        "category": "HOTAS", 
        "name": "Trim: Reset"
    }, 
    "CDU LSK L7": {
        "down": "iCommandPlaneCDU_LSK_7L", 
        "category": "CDU panel", 
        "up": "iCommandPlaneCDU_LSK_7L", 
        "name": "CDU LSK L7"
    }, 
    "CDU LSK L5": {
        "down": "iCommandPlaneCDU_LSK_5L", 
        "category": "CDU panel", 
        "up": "iCommandPlaneCDU_LSK_5L", 
        "name": "CDU LSK L5"
    }, 
    "CDU LSK L3": {
        "down": "iCommandPlaneCDU_LSK_3L", 
        "category": "CDU panel", 
        "up": "iCommandPlaneCDU_LSK_3L", 
        "name": "CDU LSK L3"
    }, 
    "Rotary selector INT": {
        "down": "iCommandPlaneIntercomINT", 
        "category": "Intercom control panel", 
        "name": "Rotary selector INT"
    }, 
    "AAP Page Select OTHER": {
        "down": "iCommandPlane_AAP_PageSel_OTHER", 
        "category": "AAP", 
        "name": "AAP Page Select OTHER"
    }, 
    "Left MFCD ADJ Decrease": {
        "down": "iCommandPlaneLeftMFD_ADJ_Decrease", 
        "category": "Left MFCD", 
        "up": "iCommandPlaneLeftMFD_ADJ_Stop", 
        "name": "Left MFCD ADJ Decrease"
    }, 
    "Fuel quantity indicator test": {
        "down": "iCommandPlaneFSQuantityIndicatorTest", 
        "category": "Fuel system control panel", 
        "up": "iCommandPlaneFSQuantityIndicatorTest", 
        "name": "Fuel quantity indicator test"
    }, 
    "TACAN Mode Select A A REC": {
        "down": "iCommandPlane_TACAN_Mode_AAREC", 
        "category": "TACAN Control Panel", 
        "name": "TACAN Mode Select A A REC"
    }, 
    "Armament ground safety switch": {
        "down": "iCommandArmGroundSafetySwitch", 
        "category": "Systems", 
        "name": "Armament ground safety switch"
    }, 
    "Right MFCD OSB 10": {
        "down": "iCommandPlaneRightMFD_OSB10", 
        "category": "Right MFCD", 
        "up": "iCommandPlaneRightMFD_OSB10_Off", 
        "name": "Right MFCD OSB 10"
    }, 
    "Right MFCD OSB 11": {
        "down": "iCommandPlaneRightMFD_OSB11", 
        "category": "Right MFCD", 
        "up": "iCommandPlaneRightMFD_OSB11_Off", 
        "name": "Right MFCD OSB 11"
    }, 
    "AAP Steer Point MARK": {
        "down": "iCommandPlane_AAP_SteerPt_MARK", 
        "category": "AAP", 
        "name": "AAP Steer Point MARK"
    }, 
    "Right MFCD OSB 13": {
        "down": "iCommandPlaneRightMFD_OSB13", 
        "category": "Right MFCD", 
        "up": "iCommandPlaneRightMFD_OSB13_Off", 
        "name": "Right MFCD OSB 13"
    }, 
    "Right MFCD OSB 14": {
        "down": "iCommandPlaneRightMFD_OSB14", 
        "category": "Right MFCD", 
        "up": "iCommandPlaneRightMFD_OSB14_Off", 
        "name": "Right MFCD OSB 14"
    }, 
    "Anti-Skid ON/OFF": {
        "down": "iCommandPlaneLGPAntiSkid", 
        "category": "Landing gear panel", 
        "name": "Anti-Skid ON/OFF"
    }, 
    "Left MFCD DSP Decrease": {
        "down": "iCommandPlaneLeftMFD_DSP_Decrease", 
        "category": "Left MFCD", 
        "up": "iCommandPlaneLeftMFD_DSP_Stop", 
        "name": "Left MFCD DSP Decrease"
    }, 
    "Right MFCD OSB 17": {
        "down": "iCommandPlaneRightMFD_OSB17", 
        "category": "Right MFCD", 
        "up": "iCommandPlaneRightMFD_OSB17_Off", 
        "name": "Right MFCD OSB 17"
    }, 
    "CDU 6 Key": {
        "down": "iCommandPlaneCDU_6", 
        "category": "CDU panel", 
        "up": "iCommandPlaneCDU_6", 
        "name": "CDU 6 Key"
    }, 
    "CB Generator CONT Right": {
        "down": "iCommandPlaneCircuitBreaker_30", 
        "category": "Circuit breaker panel", 
        "name": "CB Generator CONT Right"
    }, 
    "Anti-G suit valve test button": {
        "down": "iCommandAntiGSuitTest", 
        "category": "Systems", 
        "name": "Anti-G suit valve test button"
    }, 
    "CDU MK Key": {
        "down": "iCommandPlaneCDU_MK", 
        "category": "CDU panel", 
        "up": "iCommandPlaneCDU_MK", 
        "name": "CDU MK Key"
    }, 
    "Fire Extinguishig Agent Discharge Left": {
        "down": "iCommand_FireExting_Discharge_Left", 
        "category": "Fire Extinguishers System", 
        "name": "Fire Extinguishig Agent Discharge Left"
    }, 
    "AAP CDU Power Switch": {
        "down": "iCommandPlane_AAP_CDU_Power", 
        "category": "AAP", 
        "name": "AAP CDU Power Switch"
    }, 
    "CMSP OSB3": {
        "down": "iCommandPlaneCMSP_OSB_3", 
        "category": "CMSP Panel", 
        "up": "iCommandPlaneCMSP_OSB_3", 
        "name": "CMSP OSB3"
    }, 
    "Downlock Override": {
        "down": "iCommandPlaneLGPDownlockOverride", 
        "category": "Landing gear panel", 
        "up": "iCommandPlaneLGPDownlockOverride", 
        "name": "Downlock Override"
    }, 
    "VHF AM Load": {
        "down": "iCommandPlane_VHF_AM_Load", 
        "category": "VHF AM Radio Control Panel", 
        "up": "iCommandPlane_VHF_AM_Load", 
        "name": "VHF AM Load"
    }, 
    "Anti-Collision Lights switch": {
        "category": "Lighting Panel", 
        "name": "Anti-Collision Lights switch", 
        "cockpit_device_id": "49", 
        "up": "3011", 
        "down": "3010", 
        "value_up": "-1", 
        "value_down": "1"
    }, 
    "UHF 100Mhz selector switch 1": {
        "down": "iCommandPlaneUHF100MhzSelector1", 
        "category": "UHF Radio", 
        "name": "UHF 100Mhz selector switch 1"
    }, 
    "Camera view keyboard rate normal": {
        "down": "iCommandViewNormalKeyboard", 
        "category": "View", 
        "name": "Camera view keyboard rate normal"
    }, 
    "Pause": {
        "down": "iCommandBrakeGo", 
        "category": "General", 
        "name": "Pause"
    }, 
    "Weapon release": {
        "down": "iCommandPlanePickleOn", 
        "category": "HOTAS", 
        "up": "iCommandPlanePickleOff", 
        "name": "Weapon release"
    }, 
    "Auxiliary gear handle lock button": {
        "down": "iCommandEmergencyGearCover", 
        "category": "Landing gear panel", 
        "name": "Auxiliary gear handle lock button"
    }, 
    "View briefing on/off": {
        "down": "iCommandViewBriefing", 
        "category": "General", 
        "name": "View briefing on/off"
    }, 
    "Seat Adjustment Up": {
        "category": "Systems", 
        "name": "Seat Adjustment Up", 
        "cockpit_device_id": "39", 
        "up": "3004", 
        "down": "3004", 
        "value_up": "0", 
        "value_down": "-1"
    }, 
    "Throttle Left Up": {
        "down": "iCommandThrottle1Increase", 
        "category": "Flight Control", 
        "up": "iCommandThrottle1Stop", 
        "name": "Throttle Left Up"
    }, 
    "Camera view right": {
        "down": "iCommandViewCameraRight", 
        "category": "View Cockpit", 
        "up": "iCommandViewCameraCenter", 
        "name": "Camera view right"
    }, 
    "Camera view up slow": {
        "down": "iCommandViewCameraUpSlow", 
        "category": "View Cockpit", 
        "name": "Camera view up slow"
    }, 
    "F5 Ground hostile view": {
        "down": "iCommandViewFightGround", 
        "category": "View", 
        "name": "F5 Ground hostile view"
    }, 
    "Camera view left slow": {
        "down": "iCommandViewCameraLeftSlow", 
        "category": "View Cockpit", 
        "name": "Camera view left slow"
    }, 
    "F6 Released weapon view": {
        "down": "iCommandViewWeapons", 
        "category": "View", 
        "name": "F6 Released weapon view"
    }, 
    "Screenshot": {
        "down": "iCommandScreenShot", 
        "category": "General", 
        "name": "Screenshot"
    }, 
    "Jettison Weapons": {
        "down": "iCommandPlaneJettisonWeapons", 
        "category": "Systems", 
        "name": "Jettison Weapons"
    }, 
    "FM press": {
        "down": "iCommandPlaneIntercomFMPress", 
        "category": "Intercom control panel", 
        "name": "FM press"
    }, 
    "NMSP STR PT button": {
        "down": "iCommandPlaneNMSP_STRPT", 
        "category": "Navigation Mode Select Panel", 
        "up": "iCommandPlaneNMSP_STRPT", 
        "name": "NMSP STR PT button"
    }, 
    "CMSP DISP MENU": {
        "down": "iCommandPlaneCMSP_DISP_MENU", 
        "category": "CMSP Panel", 
        "up": "iCommandPlaneCMSP_DISP_ON", 
        "name": "CMSP DISP MENU"
    }, 
    "TACAN Mode Select T R": {
        "down": "iCommandPlane_TACAN_Mode_TR", 
        "category": "TACAN Control Panel", 
        "name": "TACAN Mode Select T R"
    }, 
    "Right MFCD OSB 03": {
        "down": "iCommandPlaneRightMFD_OSB3", 
        "category": "Right MFCD", 
        "up": "iCommandPlaneRightMFD_OSB3_Off", 
        "name": "Right MFCD OSB 03"
    }, 
    "UHF Preset chanel selector increase": {
        "down": "iCommandPlaneUHFPresetChannelSelectorInc", 
        "category": "UHF Radio", 
        "name": "UHF Preset chanel selector increase"
    }, 
    "Right MFCD OSB 02": {
        "down": "iCommandPlaneRightMFD_OSB2", 
        "category": "Right MFCD", 
        "up": "iCommandPlaneRightMFD_OSB2_Off", 
        "name": "Right MFCD OSB 02"
    }, 
    "Join up formation": {
        "down": "iCommandPlaneJoinUp", 
        "category": "Communications", 
        "name": "Join up formation"
    }, 
    "VHF press": {
        "down": "iCommandPlaneIntercomVHFPress", 
        "category": "Intercom control panel", 
        "name": "VHF press"
    }, 
    "AIM press": {
        "down": "iCommandPlaneIntercomAIMPress", 
        "category": "Intercom control panel", 
        "name": "AIM press"
    }, 
    "AAP Steer Point FLT PLAN": {
        "down": "iCommandPlane_AAP_SteerPt_FLTPLAN", 
        "category": "AAP", 
        "name": "AAP Steer Point FLT PLAN"
    }, 
    "Camera view keyboard rate fast": {
        "down": "iCommandViewFastKeyboard", 
        "category": "View", 
        "name": "Camera view keyboard rate fast"
    }, 
    "Wind shield Rain Removal Switch": {
        "down": "iCommandPlane_Env_WindshieldRainRemove", 
        "category": "Environment System Panel", 
        "name": "Wind shield Rain Removal Switch"
    }, 
    "Controls indicator": {
        "down": "iCommandPlane_ShowControls", 
        "category": "General", 
        "name": "Controls indicator"
    }, 
    "LASER switch ARM": {
        "down": "iCommandPlaneAHCPLaserArm", 
        "category": "Armament HUD Control Panel", 
        "name": "LASER switch ARM"
    }, 
    "F11 camera moving forward": {
        "down": "iCommandViewSpeedUp", 
        "category": "View", 
        "name": "F11 camera moving forward"
    }, 
    "NVIS LTS OFF": {
        "down": "iCommandPlaneNightVisionLTSOFF", 
        "category": "Auxiliary lighting control panel", 
        "name": "NVIS LTS OFF"
    }, 
    "F1 HUD only view switch": {
        "down": "iCommandViewHUDOnlyOnOff", 
        "category": "View", 
        "name": "F1 HUD only view switch"
    }, 
    "CMSP MODE AUTO": {
        "down": "iCommandPlaneCMSP_MODE_AUTO", 
        "category": "CMSP Panel", 
        "name": "CMSP MODE AUTO"
    }, 
    "APU generator power": {
        "down": "iCommandAPUGeneratorPower", 
        "category": "Electrical power control panel", 
        "name": "APU generator power"
    }, 
    "UHF Freq mode GRD": {
        "down": "iCommandPlaneUHFFreqModeDialGRD", 
        "category": "UHF Radio", 
        "name": "UHF Freq mode GRD"
    }, 
    "Zoom normal": {
        "down": "iCommandViewAngleDefault", 
        "category": "View", 
        "name": "Zoom normal"
    }, 
    "Aileron emer disengage off": {
        "down": "iCommandPlaneEmerAileronDisengageOff", 
        "category": "Emergency flight control panel", 
        "name": "Aileron emer disengage off"
    }, 
    "INT press": {
        "down": "iCommandPlaneIntercomINTPress", 
        "category": "Intercom control panel", 
        "name": "INT press"
    }, 
    "F1 Cockpit view": {
        "down": "iCommandViewCockpit", 
        "category": "View", 
        "name": "F1 Cockpit view"
    }, 
    "VHF AM Frequency Mode TK": {
        "down": "iCommandPlane_VHF_AM_FreqMode_TK", 
        "category": "VHF AM Radio Control Panel", 
        "name": "VHF AM Frequency Mode TK"
    }, 
    "Fuel quantity selector MAIN": {
        "down": "iCommandPlaneFSQuantityIndicatorSelectorMAIN", 
        "category": "Fuel system control panel", 
        "name": "Fuel quantity selector MAIN"
    }, 
    "Function control toggle switch STDBY": {
        "down": "iCommandDVADRFunctionSTDBY", 
        "category": "DVADR Remote Control Panel", 
        "name": "Function control toggle switch STDBY"
    }, 
    "Seat Adjustment Down": {
        "category": "Systems", 
        "name": "Seat Adjustment Down", 
        "cockpit_device_id": "39", 
        "up": "3005", 
        "down": "3005", 
        "value_up": "0", 
        "value_down": "1"
    }, 
    "F4 Arcade View": {
        "down": "iCommandViewChaseArcade", 
        "category": "View", 
        "name": "F4 Arcade View"
    }, 
    "F7 Ground JFO/JTAC view": {
        "down": "iCommandViewJFO", 
        "category": "View", 
        "name": "F7 Ground JFO/JTAC view"
    }, 
    "Switch to main menu": {
        "down": "ICommandSwitchToCommonDialog", 
        "category": "Communications", 
        "name": "Switch to main menu"
    }, 
    "Left MFCD Night illumination": {
        "down": "iCommandPlaneLeftMFD_BRTMODE_NIGHT", 
        "category": "Left MFCD", 
        "name": "Left MFCD Night illumination"
    }, 
    "UHF Antenna Switch AUTO": {
        "down": "iCommandUHFAntennaAuto", 
        "category": "Antenna Select Panel", 
        "name": "UHF Antenna Switch AUTO"
    }, 
    "CDU P Key": {
        "down": "iCommandPlaneCDU_P", 
        "category": "CDU panel", 
        "up": "iCommandPlaneCDU_P", 
        "name": "CDU P Key"
    }, 
    "UFC MK Key": {
        "down": "iCommandPlaneUFC_MK", 
        "category": "UFC", 
        "up": "iCommandPlaneUFC_MK", 
        "name": "UFC MK Key"
    }, 
    "Objects switching direction forward": {
        "down": "iCommandViewSwitchForward", 
        "category": "View Extended", 
        "name": "Objects switching direction forward"
    }, 
    "CDU J Key": {
        "down": "iCommandPlaneCDU_J", 
        "category": "CDU panel", 
        "up": "iCommandPlaneCDU_J", 
        "name": "CDU J Key"
    }, 
    "SAI Cage Knob": {
        "down": "iCommand_AGR_Oriet", 
        "category": "Systems", 
        "up": "iCommand_AGR_Oriet", 
        "name": "SAI Cage Knob"
    }, 
    "Throttle Both Down": {
        "down": "iCommandThrottleDecrease", 
        "category": "Flight Control", 
        "up": "iCommandThrottleStop", 
        "name": "Throttle Both Down"
    }, 
    "NMSP ILS button": {
        "down": "iCommandPlaneNMSP_ILS", 
        "category": "Navigation Mode Select Panel", 
        "up": "iCommandPlaneNMSP_ILS", 
        "name": "NMSP ILS button"
    }, 
    "Camera view up-right slow": {
        "down": "iCommandViewCameraUpRightSlow", 
        "category": "View Cockpit", 
        "name": "Camera view up-right slow"
    }, 
    "UHF Freq mode PRESET": {
        "down": "iCommandPlaneUHFFreqModeDialPRESET", 
        "category": "UHF Radio", 
        "name": "UHF Freq mode PRESET"
    }, 
    "Pitot Heater Switch": {
        "down": "iCommandPitotAoAHeat", 
        "category": "Environment System Panel", 
        "name": "Pitot Heater Switch"
    }, 
    "Camera view up-left slow": {
        "down": "iCommandViewCameraUpLeftSlow", 
        "category": "View Cockpit", 
        "name": "Camera view up-left slow"
    }, 
    "F10 Jump to theater map view over current point": {
        "down": "iCommandViewAWACSJump", 
        "category": "View", 
        "name": "F10 Jump to theater map view over current point"
    }, 
    "Get new plane - respawn": {
        "down": "iCommandRecoverHuman", 
        "category": "General", 
        "name": "Get new plane - respawn"
    }, 
    "UFC DATA UP Rocker switch": {
        "down": "iCommandPlaneUFC_DATA_UP", 
        "category": "UFC", 
        "up": "iCommandPlaneUFC_DATA_UP", 
        "name": "UFC DATA UP Rocker switch"
    }, 
    "CB Pitot heat AC": {
        "down": "iCommandPlaneCircuitBreaker_25", 
        "category": "Circuit breaker panel", 
        "name": "CB Pitot heat AC"
    }, 
    "NMSP ABLE/STOW switch": {
        "down": "iCommandPlaneNMSP_PTR_ABLE_STOW", 
        "category": "Navigation Mode Select Panel", 
        "name": "NMSP ABLE/STOW switch"
    }, 
    "CDU H Key": {
        "down": "iCommandPlaneCDU_H", 
        "category": "CDU panel", 
        "up": "iCommandPlaneCDU_H", 
        "name": "CDU H Key"
    }, 
    "HOTAS Master Mode Control Button": {
        "down": "iCommandPlane_HOTAS_MasterModeControlButton", 
        "category": "HOTAS", 
        "up": "iCommandPlane_HOTAS_MasterModeControlButtonUP", 
        "name": "HOTAS Master Mode Control Button"
    }, 
    "UHF Squelch ON/OFF": {
        "down": "iCommandPlaneUHFSquelch", 
        "category": "UHF Radio", 
        "name": "UHF Squelch ON/OFF"
    }, 
    "G-meter reset": {
        "down": "iCommandAccelReset", 
        "category": "Systems", 
        "up": "iCommandAccelReset", 
        "name": "G-meter reset"
    }, 
    "Right MFCD OSB 20": {
        "down": "iCommandPlaneRightMFD_OSB20", 
        "category": "Right MFCD", 
        "up": "iCommandPlaneRightMFD_OSB20_Off", 
        "name": "Right MFCD OSB 20"
    }, 
    "NMSP HARS button": {
        "down": "iCommandPlaneNMSP_HARS", 
        "category": "Navigation Mode Select Panel", 
        "up": "iCommandPlaneNMSP_HARS", 
        "name": "NMSP HARS button"
    }, 
    "Kneeboard glance view": {
        "category": "Kneeboard", 
        "name": "Kneeboard glance view", 
        "up": "iCommandPlaneShowKneeboard", 
        "down": "iCommandPlaneShowKneeboard", 
        "value_up": "-1", 
        "value_down": "1"
    }, 
    "CDU SYS Key": {
        "down": "iCommandPlaneCDU_SYS", 
        "category": "CDU panel", 
        "up": "iCommandPlaneCDU_SYS", 
        "name": "CDU SYS Key"
    }, 
    "Left wing tank boost pump": {
        "down": "iCommandPlaneFSLeftWingBoostPump", 
        "category": "Fuel system control panel", 
        "name": "Left wing tank boost pump"
    }, 
    "CDU Y Key": {
        "down": "iCommandPlaneCDU_Y", 
        "category": "CDU panel", 
        "up": "iCommandPlaneCDU_Y", 
        "name": "CDU Y Key"
    }, 
    "Auxiliary gear handle": {
        "down": "iCommandEmergencyGear", 
        "category": "Landing gear panel", 
        "name": "Auxiliary gear handle"
    }, 
    "F1 Natural head movement view": {
        "down": "iCommandNaturalViewCockpitIn", 
        "category": "View", 
        "name": "F1 Natural head movement view"
    }, 
    "Camera jiggle toggle": {
        "down": "iCommandViewCameraJiggle", 
        "category": "View Extended", 
        "name": "Camera jiggle toggle"
    }, 
    "Stop Procedure": {
        "down": "iCommandEnginesStop", 
        "category": "Cheat", 
        "name": "Stop Procedure"
    }, 
    "One frame mode": {
        "down": "iCommandOneFrame", 
        "category": "General", 
        "name": "One frame mode"
    }, 
    "Tank gate valve": {
        "down": "iCommandPlaneFSTankGate", 
        "category": "Fuel system control panel", 
        "name": "Tank gate valve"
    }, 
    "F5 nearest AC view": {
        "down": "iCommandViewFight", 
        "category": "View", 
        "name": "F5 nearest AC view"
    }, 
    "HOTAS DMS Forward": {
        "down": "iCommandPlane_HOTAS_DataManagementSwitchUp", 
        "category": "HOTAS", 
        "up": "iCommandPlane_HOTAS_DataManagementSwitchOff", 
        "name": "HOTAS DMS Forward"
    }, 
    "Right main tank boost pump": {
        "down": "iCommandPlaneFSRightMainBoostPump", 
        "category": "Fuel system control panel", 
        "name": "Right main tank boost pump"
    }, 
    "VHF AM Squelch": {
        "down": "iCommandPlane_VHF_AM_Squelch", 
        "category": "VHF AM Radio Control Panel", 
        "name": "VHF AM Squelch"
    }, 
    "Left main tank boost pump": {
        "down": "iCommandPlaneFSLeftMainBoostPump", 
        "category": "Fuel system control panel", 
        "name": "Left main tank boost pump"
    }, 
    "UFC LTR Key": {
        "down": "iCommandPlaneUFC_LTR", 
        "category": "UFC", 
        "up": "iCommandPlaneUFC_LTR", 
        "name": "UFC LTR Key"
    }, 
    "Right main tank fill disable": {
        "down": "iCommandPlaneFSRightMainFillDisable", 
        "category": "Fuel system control panel", 
        "name": "Right main tank fill disable"
    }, 
    "CB Converter L": {
        "down": "iCommandPlaneCircuitBreaker_31", 
        "category": "Circuit breaker panel", 
        "name": "CB Converter L"
    }, 
    "CB Emer TRIM": {
        "down": "iCommandPlaneCircuitBreaker_9", 
        "category": "Circuit breaker panel", 
        "name": "CB Emer TRIM"
    }, 
    "Vehicle & Ship Labels": {
        "down": "iCommandMarkerStateShip", 
        "category": "Labels", 
        "name": "Vehicle & Ship Labels"
    }, 
    "CB Ext stores jettison 1": {
        "down": "iCommandPlaneCircuitBreaker_21", 
        "category": "Circuit breaker panel", 
        "name": "CB Ext stores jettison 1"
    }, 
    "CB Ext stores jettison 2": {
        "down": "iCommandPlaneCircuitBreaker_22", 
        "category": "Circuit breaker panel", 
        "name": "CB Ext stores jettison 2"
    }, 
    "Communication menu": {
        "down": "iCommandToggleCommandMenu", 
        "category": "Communications", 
        "name": "Communication menu"
    }, 
    "CDU 1 Key": {
        "down": "iCommandPlaneCDU_1", 
        "category": "CDU panel", 
        "up": "iCommandPlaneCDU_1", 
        "name": "CDU 1 Key"
    }, 
    "HOTAS TMS Aft": {
        "down": "iCommandPlane_HOTAS_TargetManagementSwitchDown", 
        "category": "HOTAS", 
        "up": "iCommandPlane_HOTAS_TargetManagementSwitchOff", 
        "name": "HOTAS TMS Aft"
    }, 
    "CB Aileron disconnect Left": {
        "down": "iCommandPlaneCircuitBreaker_1", 
        "category": "Circuit breaker panel", 
        "name": "CB Aileron disconnect Left"
    }, 
    "CDU R Key": {
        "down": "iCommandPlaneCDU_R", 
        "category": "CDU panel", 
        "up": "iCommandPlaneCDU_R", 
        "name": "CDU R Key"
    }, 
    "CDU MINUS Key": {
        "down": "iCommandPlaneCDU_MINUS", 
        "category": "CDU panel", 
        "up": "iCommandPlaneCDU_MINUS", 
        "name": "CDU MINUS Key"
    }, 
    "CDU BCK Key": {
        "down": "iCommandPlaneCDU_BCK", 
        "category": "CDU panel", 
        "up": "iCommandPlaneCDU_BCK", 
        "name": "CDU BCK Key"
    }, 
    "F4 Chase view": {
        "down": "iCommandViewChase", 
        "category": "View", 
        "name": "F4 Chase view"
    }, 
    "Inverter STBY": {
        "down": "iCommandElectricalPowerInverterSTBY", 
        "category": "Electrical power control panel", 
        "name": "Inverter STBY"
    }, 
    "Dispatch wingmans - complete mission and rejoin": {
        "down": "iCommandPlaneDoAndBack", 
        "category": "Communications", 
        "name": "Dispatch wingmans - complete mission and rejoin"
    }, 
    "ALT SCE switch DELTA": {
        "down": "iCommandPlaneAHCPAltSCEDelta", 
        "category": "Armament HUD Control Panel", 
        "name": "ALT SCE switch DELTA"
    }, 
    "Left elevator emer disengage": {
        "down": "iCommandPlaneEmerElevatorDisengageL", 
        "category": "Emergency flight control panel", 
        "name": "Left elevator emer disengage"
    }, 
    "CB AUX ESS BUS 0A": {
        "down": "iCommandPlaneCircuitBreaker_32", 
        "category": "Circuit breaker panel", 
        "name": "CB AUX ESS BUS 0A"
    }, 
    "CB AUX ESS BUS 0C": {
        "down": "iCommandPlaneCircuitBreaker_34", 
        "category": "Circuit breaker panel", 
        "name": "CB AUX ESS BUS 0C"
    }, 
    "CB AUX ESS BUS 0B": {
        "down": "iCommandPlaneCircuitBreaker_33", 
        "category": "Circuit breaker panel", 
        "name": "CB AUX ESS BUS 0B"
    }, 
    "CMSC PRI Key": {
        "down": "iCommandPlaneCMSC_PRI", 
        "category": "CMSC Panel", 
        "up": "iCommandPlaneCMSC_PRI", 
        "name": "CMSC PRI Key"
    }, 
    "Camera view down slow": {
        "down": "iCommandViewCameraDownSlow", 
        "category": "View Cockpit", 
        "name": "Camera view down slow"
    }, 
    "Stick to trimmer control mode": {
        "down": "iCommandPlaneTrimOn", 
        "category": "Flight Control", 
        "up": "iCommandPlaneTrimOff", 
        "name": "Stick to trimmer control mode"
    }, 
    "UFC Master Caution Key": {
        "down": "iCommandPlaneUFC_MASTER_WARNING", 
        "category": "UFC", 
        "up": "iCommandPlaneUFC_MASTER_WARNING", 
        "name": "UFC Master Caution Key"
    }, 
    "CLOCK Control button": {
        "down": "iCommandMechClock_RightLever_Down", 
        "category": "Systems", 
        "up": "iCommandMechClock_RightLever_Down", 
        "name": "CLOCK Control button"
    }, 
    "HARS Magnetic Variation -15": {
        "down": "iCommandPlane_HARS_MagneticVar_Min15", 
        "category": "HARS Control Panel", 
        "name": "HARS Magnetic Variation -15"
    }, 
    "Objects all excluded - include": {
        "down": "iCommandViewObjectsAll", 
        "category": "View Extended", 
        "name": "Objects all excluded - include"
    }, 
    "UFC DEPR DOWN Rocker switch": {
        "down": "iCommandPlaneUFC_DEPR_DOWN", 
        "category": "UFC", 
        "up": "iCommandPlaneUFC_DEPR_DOWN", 
        "name": "UFC DEPR DOWN Rocker switch"
    }, 
    "CDU W Key": {
        "down": "iCommandPlaneCDU_W", 
        "category": "CDU panel", 
        "up": "iCommandPlaneCDU_W", 
        "name": "CDU W Key"
    }, 
    "Attack Ground Targets": {
        "down": "iCommandPlane_EngageGroundTargets", 
        "category": "Communications", 
        "name": "Attack Ground Targets"
    }, 
    "F2 View own aircraft": {
        "down": "iCommandViewMe", 
        "category": "View", 
        "name": "F2 View own aircraft"
    }, 
    "CMSP MWS MENU": {
        "down": "iCommandPlaneCMSP_MWS_MENU", 
        "category": "CMSP Panel", 
        "up": "iCommandPlaneCMSP_MWS_ON", 
        "name": "CMSP MWS MENU"
    }, 
    "Right MFCD Day illumination": {
        "down": "iCommandPlaneRightMFD_BRTMODE_DAY", 
        "category": "Right MFCD", 
        "name": "Right MFCD Day illumination"
    }, 
    "Elevator emer disengage off": {
        "down": "iCommandPlaneEmerElevatorDisengageOff", 
        "category": "Emergency flight control panel", 
        "name": "Elevator emer disengage off"
    }, 
    "Fire Extinguishig Agent Discharge Off": {
        "down": "iCommand_FireExting_Discharge_Center", 
        "category": "Fire Extinguishers System", 
        "name": "Fire Extinguishig Agent Discharge Off"
    }, 
    "Fuel quantity selector INT": {
        "down": "iCommandPlaneFSQuantityIndicatorSelectorINT", 
        "category": "Fuel system control panel", 
        "name": "Fuel quantity selector INT"
    }, 
    "Take off trim": {
        "down": "iCommandPlaneSASTakeOffTrim", 
        "category": "Stability Augmentation System", 
        "up": "iCommandPlaneSASTakeOffTrim", 
        "name": "Take off trim"
    }, 
    "CMSP Next Down rotary": {
        "down": "iCommandPlaneCMSP_NEXT_DOWN", 
        "category": "CMSP Panel", 
        "up": "iCommandPlaneCMSP_NEXT_DOWN", 
        "name": "CMSP Next Down rotary"
    }, 
    "Right MFCD SYM Decrease": {
        "down": "iCommandPlaneRightMFD_SYM_Dn", 
        "category": "Right MFCD", 
        "up": "iCommandPlaneRightMFD_SYM_Stop", 
        "name": "Right MFCD SYM Decrease"
    }, 
    "Fly: Rudder Right": {
        "down": "iCommandPlaneRightRudderStart", 
        "category": "Flight Control", 
        "up": "iCommandPlaneRightRudderStop", 
        "name": "Fly: Rudder Right"
    }, 
    "Right MFCD BRT Increase": {
        "down": "iCommandPlaneRightMFD_BRT_Increase", 
        "category": "Right MFCD", 
        "up": "iCommandPlaneRightMFD_BRT_Stop", 
        "name": "Right MFCD BRT Increase"
    }, 
    "VHF FM Load": {
        "down": "iCommandPlane_VHF_FM_Load", 
        "category": "VHF FM Radio Control Panel", 
        "up": "iCommandPlane_VHF_FM_Load", 
        "name": "VHF FM Load"
    }, 
    "VHF FM Frequency Mode OFF": {
        "down": "iCommandPlane_VHF_FM_FreqMode_OFF", 
        "category": "VHF FM Radio Control Panel", 
        "name": "VHF FM Frequency Mode OFF"
    }, 
    "NMSP TCN button": {
        "down": "iCommandPlaneNMSP_TCN", 
        "category": "Navigation Mode Select Panel", 
        "up": "iCommandPlaneNMSP_TCN", 
        "name": "NMSP TCN button"
    }, 
    "UFC SPC Key": {
        "down": "iCommandPlaneUFC_SPC", 
        "category": "UFC", 
        "up": "iCommandPlaneUFC_SPC", 
        "name": "UFC SPC Key"
    }, 
    "CDU PG DN Key": {
        "down": "iCommandPlaneCDU_PGDN", 
        "category": "CDU panel", 
        "up": "iCommandPlaneCDU_PGDN", 
        "name": "CDU PG DN Key"
    }, 
    "CDU B Key": {
        "down": "iCommandPlaneCDU_B", 
        "category": "CDU panel", 
        "up": "iCommandPlaneCDU_B", 
        "name": "CDU B Key"
    }, 
    "External tanks fuselage valve": {
        "down": "iCommandPlaneFSExtTanksFuselageValve", 
        "category": "Fuel system control panel", 
        "name": "External tanks fuselage valve"
    }, 
    "Score window": {
        "down": "iCommandScoresWindowToggle", 
        "category": "General", 
        "name": "Score window"
    }, 
    "LASER switch TRAIN": {
        "down": "iCommandPlaneAHCPLaserTrain", 
        "category": "Armament HUD Control Panel", 
        "name": "LASER switch TRAIN"
    }, 
    "Pitch SAS engage Left": {
        "down": "iCommandPlanePitchSASEngageL", 
        "category": "Stability Augmentation System", 
        "name": "Pitch SAS engage Left"
    }, 
    "Kneeboard ON/OFF": {
        "down": "iCommandPlaneShowKneeboard", 
        "category": "Kneeboard", 
        "name": "Kneeboard ON/OFF"
    }, 
    "CDU G Key": {
        "down": "iCommandPlaneCDU_G", 
        "category": "CDU panel", 
        "up": "iCommandPlaneCDU_G", 
        "name": "CDU G Key"
    }, 
    "NMSP TISL button": {
        "down": "iCommandPlaneNMSP_TISL", 
        "category": "Navigation Mode Select Panel", 
        "up": "iCommandPlaneNMSP_TISL", 
        "name": "NMSP TISL button"
    }, 
    "Canopy jettison lever unlock button": {
        "down": "iCommandCanopyJettisonUnlockButton", 
        "category": "Systems", 
        "name": "Canopy jettison lever unlock button"
    }, 
    "HARS Magnetic Variation 0": {
        "down": "iCommandPlane_HARS_MagneticVar_Null", 
        "category": "HARS Control Panel", 
        "name": "HARS Magnetic Variation 0"
    }, 
    "Emergency Disconnect Lever": {
        "down": "iCommandPlaneEmergencyDisconnectLever", 
        "category": "HOTAS", 
        "up": "iCommandPlaneEmergencyDisconnectLever", 
        "name": "Emergency Disconnect Lever"
    }, 
    "CB UHF COM": {
        "down": "iCommandPlaneCircuitBreaker_27", 
        "category": "Circuit breaker panel", 
        "name": "CB UHF COM"
    }, 
    "Camera ordnance tracking": {
        "down": "iCommandViewPlus", 
        "category": "View Extended", 
        "name": "Camera ordnance tracking"
    }, 
    "Camera view mouse rate normal": {
        "down": "iCommandViewNormalMouse", 
        "category": "View", 
        "name": "Camera view mouse rate normal"
    }, 
    "Camera view down-right slow": {
        "down": "iCommandViewCameraDownRight", 
        "category": "View Cockpit", 
        "name": "Camera view down-right slow"
    }, 
    "CDU S Key": {
        "down": "iCommandPlaneCDU_S", 
        "category": "CDU panel", 
        "up": "iCommandPlaneCDU_S", 
        "name": "CDU S Key"
    }, 
    "NVIS LTS TCP": {
        "down": "iCommandPlaneNightVisionLTSTCP", 
        "category": "Auxiliary lighting control panel", 
        "name": "NVIS LTS TCP"
    }, 
    "F12 Static object view": {
        "down": "iCommandViewStatic", 
        "category": "View", 
        "name": "F12 Static object view"
    }, 
    "UHF Test display": {
        "down": "iCommandPlaneUHFTestDisplay", 
        "category": "UHF Radio", 
        "up": "iCommandPlaneUHFTestDisplay", 
        "name": "UHF Test display"
    }, 
    "VHF FM Tone": {
        "down": "iCommandPlane_VHF_FM_Tone", 
        "category": "VHF FM Radio Control Panel", 
        "up": "iCommandPlane_VHF_FM_Tone", 
        "name": "VHF FM Tone"
    }, 
    "F2 Toggle local camera control": {
        "down": "iCommandViewLocal", 
        "category": "View", 
        "name": "F2 Toggle local camera control"
    }, 
    "Flaps Down": {
        "down": "iCommandPlaneFlapsOn", 
        "category": "Systems", 
        "name": "Flaps Down"
    }, 
    "CDU 4 Key": {
        "down": "iCommandPlaneCDU_4", 
        "category": "CDU panel", 
        "up": "iCommandPlaneCDU_4", 
        "name": "CDU 4 Key"
    }, 
    "Throttle Left Up Step": {
        "down": "iCommandPlaneAUTIncreaseRegimeLeft", 
        "category": "Flight Control", 
        "name": "Throttle Left Up Step"
    }, 
    "Yaw SAS engage Right": {
        "down": "iCommandPlaneYawSASEngageR", 
        "category": "Stability Augmentation System", 
        "name": "Yaw SAS engage Right"
    }, 
    "UFC 5 Key": {
        "down": "iCommandPlaneUFC_5", 
        "category": "UFC", 
        "up": "iCommandPlaneUFC_5", 
        "name": "UFC 5 Key"
    }, 
    "Landing Gear Up": {
        "down": "iCommandPlaneGearUp", 
        "category": "Landing gear panel", 
        "name": "Landing Gear Up"
    }, 
    "HOTAS CMS Z Axis": {
        "down": "iCommandPlane_HOTAS_CMS_Zaxis", 
        "category": "HOTAS", 
        "up": "iCommandPlane_HOTAS_CMS_Zaxis_Off", 
        "name": "HOTAS CMS Z Axis"
    }, 
    "UHF 10Mhz selector increase": {
        "down": "iCommandPlaneUHF10MhzSelectorInc", 
        "category": "UHF Radio", 
        "name": "UHF 10Mhz selector increase"
    }, 
    "Start Procedure": {
        "down": "iCommandEnginesStart", 
        "category": "Cheat", 
        "name": "Start Procedure"
    }, 
    "UFC INTEN DECREASE Rocker switch": {
        "down": "iCommandPlaneUFC_INTEN_DECREASE", 
        "category": "UFC", 
        "up": "iCommandPlaneUFC_INTEN_DECREASE", 
        "name": "UFC INTEN DECREASE Rocker switch"
    }, 
    "AAP STEER Switch Down": {
        "down": "iCommandPlane_AAP_SteerSw_Down", 
        "category": "AAP", 
        "up": "iCommandPlane_AAP_SteerSw_Down", 
        "name": "AAP STEER Switch Down"
    }, 
    "Yaw SAS engage Left": {
        "down": "iCommandPlaneYawSASEngageL", 
        "category": "Stability Augmentation System", 
        "name": "Yaw SAS engage Left"
    }, 
    "Oxygen Emergency Lever Test Mark": {
        "down": "iCommandPlane_Oxygen_TestMark", 
        "category": "Environment System Panel", 
        "name": "Oxygen Emergency Lever Test Mark"
    }, 
    "CDU Slash Key": {
        "down": "iCommandPlaneCDU_SLASH", 
        "category": "CDU panel", 
        "up": "iCommandPlaneCDU_SLASH", 
        "name": "CDU Slash Key"
    }, 
    "Oxygen Emergency Lever Emergenvy": {
        "down": "iCommandPlane_Oxygen_Emergency", 
        "category": "Environment System Panel", 
        "name": "Oxygen Emergency Lever Emergenvy"
    }, 
    "Left MFCD OSB 12": {
        "down": "iCommandPlaneLeftMFD_OSB12", 
        "category": "Left MFCD", 
        "up": "iCommandPlaneLeftMFD_OSB12_Off", 
        "name": "Left MFCD OSB 12"
    }, 
    "VHF AM Mode PRE": {
        "down": "iCommandPlane_VHF_AM_Mode_PRE", 
        "category": "VHF AM Radio Control Panel", 
        "name": "VHF AM Mode PRE"
    }, 
    "UHF Dial MAIN": {
        "down": "iCommandPlaneUHFFunctionDialMAIN", 
        "category": "UHF Radio", 
        "name": "UHF Dial MAIN"
    }, 
    "IFFCC switch ON": {
        "down": "iCommandPlaneAHCPIFFCCOn", 
        "category": "Armament HUD Control Panel", 
        "name": "IFFCC switch ON"
    }, 
    "CB Aileron TAB Right": {
        "down": "iCommandPlaneCircuitBreaker_7", 
        "category": "Circuit breaker panel", 
        "name": "CB Aileron TAB Right"
    }, 
    "VHF AM Mode EMER AM": {
        "down": "iCommandPlane_VHF_AM_Mode_EMERAM", 
        "category": "VHF AM Radio Control Panel", 
        "name": "VHF AM Mode EMER AM"
    }, 
    "Left MFCD CON Increase": {
        "down": "iCommandPlaneLeftMFD_CON_Increase", 
        "category": "Left MFCD", 
        "up": "iCommandPlaneLeftMFD_CON_Stop", 
        "name": "Left MFCD CON Increase"
    }, 
    "CDU E Key": {
        "down": "iCommandPlaneCDU_E", 
        "category": "CDU panel", 
        "up": "iCommandPlaneCDU_E", 
        "name": "CDU E Key"
    }, 
    "Cockpit Illumination": {
        "down": "iCommandPlaneCockpitIllumination", 
        "category": "Systems", 
        "name": "Cockpit Illumination"
    }, 
    "CB SPS & Rudder AUTH Limit": {
        "down": "iCommandPlaneCircuitBreaker_3", 
        "category": "Circuit breaker panel", 
        "name": "CB SPS & Rudder AUTH Limit"
    }, 
    "IFF Antenna Switch LOWER": {
        "down": "iCommandIFFAntennaLower", 
        "category": "Antenna Select Panel", 
        "name": "IFF Antenna Switch LOWER"
    }, 
    "UFC SEL UP Rocker switch": {
        "down": "iCommandPlaneUFC_SEL_UP", 
        "category": "UFC", 
        "up": "iCommandPlaneUFC_SEL_UP", 
        "name": "UFC SEL UP Rocker switch"
    }, 
    "Throttle Left Down": {
        "down": "iCommandThrottle1Decrease", 
        "category": "Flight Control", 
        "up": "iCommandThrottle1Stop", 
        "name": "Throttle Left Down"
    }, 
    "CB Standby attitude indicator": {
        "down": "iCommandPlaneCircuitBreaker_23", 
        "category": "Circuit breaker panel", 
        "name": "CB Standby attitude indicator"
    }, 
    "Function control toggle switch REC": {
        "down": "iCommandDVADRFunctionREC", 
        "category": "DVADR Remote Control Panel", 
        "name": "Function control toggle switch REC"
    }, 
    "Missile Labels": {
        "down": "iCommandMarkerStateRocket", 
        "category": "Labels", 
        "name": "Missile Labels"
    }, 
    "Taxi Lights On": {
        "down": "iCommandPlaneLGPTaxiLight", 
        "category": "Landing gear panel", 
        "name": "Taxi Lights On"
    }, 
    "Position Lights Steady": {
        "down": "iCommandPlanePositionLightsSteady", 
        "category": "Lighting Panel", 
        "name": "Position Lights Steady"
    }, 
    "Speed brake emer retract": {
        "down": "iCommandPlaneEmerSpeedBrakeRetract", 
        "category": "Emergency flight control panel", 
        "name": "Speed brake emer retract"
    }, 
    "Temperature/Pressure Control NORM": {
        "down": "iCommandPlane_Env_TempPress_NORM", 
        "category": "Environment System Panel", 
        "name": "Temperature/Pressure Control NORM"
    }, 
    "TACAN Mode X/Y Switch": {
        "down": "iCommandPlane_TACAN_Chanel_XY_Mode", 
        "category": "TACAN Control Panel", 
        "name": "TACAN Mode X/Y Switch"
    }, 
    "Throttle Both Up": {
        "down": "iCommandThrottleIncrease", 
        "category": "Flight Control", 
        "up": "iCommandThrottleStop", 
        "name": "Throttle Both Up"
    }, 
    "Wheel Brake On/Off": {
        "down": "iCommandPlaneWheelBrakeOn", 
        "category": "Systems", 
        "up": "iCommandPlaneWheelBrakeOff", 
        "name": "Wheel Brake On/Off"
    }, 
    "Snap View 4": {
        "down": "iCommandViewSnapView4", 
        "category": "View Cockpit", 
        "up": "iCommandViewSnapViewStop", 
        "name": "Snap View 4"
    }, 
    "Snap View 5": {
        "down": "iCommandViewSnapView5", 
        "category": "View Cockpit", 
        "up": "iCommandViewSnapViewStop", 
        "name": "Snap View 5"
    }, 
    "Snap View 6": {
        "down": "iCommandViewSnapView6", 
        "category": "View Cockpit", 
        "up": "iCommandViewSnapViewStop", 
        "name": "Snap View 6"
    }, 
    "Snap View 7": {
        "down": "iCommandViewSnapView7", 
        "category": "View Cockpit", 
        "up": "iCommandViewSnapViewStop", 
        "name": "Snap View 7"
    }, 
    "Snap View 0": {
        "down": "iCommandViewSnapView0", 
        "category": "View Cockpit", 
        "up": "iCommandViewSnapViewStop", 
        "name": "Snap View 0"
    }, 
    "Snap View 1": {
        "down": "iCommandViewSnapView1", 
        "category": "View Cockpit", 
        "up": "iCommandViewSnapViewStop", 
        "name": "Snap View 1"
    }, 
    "Snap View 2": {
        "down": "iCommandViewSnapView2", 
        "category": "View Cockpit", 
        "up": "iCommandViewSnapViewStop", 
        "name": "Snap View 2"
    }, 
    "Snap View 3": {
        "down": "iCommandViewSnapView3", 
        "category": "View Cockpit", 
        "up": "iCommandViewSnapViewStop", 
        "name": "Snap View 3"
    }, 
    "Multiplayer chat - mode Allies": {
        "down": "iCommandFriendlyChat", 
        "category": "General", 
        "name": "Multiplayer chat - mode Allies"
    }, 
    "Snap View 9": {
        "down": "iCommandViewSnapView9", 
        "category": "View Cockpit", 
        "up": "iCommandViewSnapViewStop", 
        "name": "Snap View 9"
    }, 
    "ALT SCE switch BARO": {
        "down": "iCommandPlaneAHCPAltSCEBaro", 
        "category": "Armament HUD Control Panel", 
        "name": "ALT SCE switch BARO"
    }, 
    "Eject": {
        "down": "iCommandPlaneEject", 
        "category": "Systems", 
        "name": "Eject"
    }, 
    "CMSP RTN Key": {
        "down": "iCommandPlaneCMSP_RTN", 
        "category": "CMSP Panel", 
        "up": "iCommandPlaneCMSP_RTN", 
        "name": "CMSP RTN Key"
    }, 
    "CB Elevator disconnect Right": {
        "down": "iCommandPlaneCircuitBreaker_5", 
        "category": "Circuit breaker panel", 
        "name": "CB Elevator disconnect Right"
    }, 
    "Pitch/Roll trim NORM/OVERRIDE": {
        "down": "iCommandPlaneEmerPitchRollTrim", 
        "category": "Emergency flight control panel", 
        "name": "Pitch/Roll trim NORM/OVERRIDE"
    }, 
    "Signal Lights switch": {
        "down": "iCommandPlaneSignalLTS", 
        "category": "Lighting Panel", 
        "name": "Signal Lights switch"
    }, 
    "UFC 3 Key": {
        "down": "iCommandPlaneUFC_3", 
        "category": "UFC", 
        "up": "iCommandPlaneUFC_3", 
        "name": "UFC 3 Key"
    }, 
    "F9 Landing signal officer view": {
        "down": "iCommandViewLndgOfficer", 
        "category": "View", 
        "name": "F9 Landing signal officer view"
    }, 
    "CMSP MODE STBY": {
        "down": "iCommandPlaneCMSP_MODE_STBY", 
        "category": "CMSP Panel", 
        "name": "CMSP MODE STBY"
    }, 
    "Frame rate counter - Service info": {
        "down": "iCommandGraphicsFrameRate", 
        "category": "General", 
        "name": "Frame rate counter - Service info"
    }, 
    "CMSP MODE MAN": {
        "down": "iCommandPlaneCMSP_MODE_MAN", 
        "category": "CMSP Panel", 
        "name": "CMSP MODE MAN"
    }, 
    "CLOCK Select button": {
        "down": "iCommandMechClock_LeftLever_Down", 
        "category": "Systems", 
        "up": "iCommandMechClock_LeftLever_Down", 
        "name": "CLOCK Select button"
    }, 
    "Internal canopy actuator disengage lever": {
        "down": "iCommandCanopyActuatorDisengage", 
        "category": "Systems", 
        "name": "Internal canopy actuator disengage lever"
    }, 
    "Left MFCD BRT Increase": {
        "down": "iCommandPlaneLeftMFD_BRT_Increase", 
        "category": "Left MFCD", 
        "up": "iCommandPlaneLeftMFD_BRT_Stop", 
        "name": "Left MFCD BRT Increase"
    }, 
    "Kneeboard Previous Page": {
        "down": "3002", 
        "cockpit_device_id": "100", 
        "category": "Kneeboard", 
        "value_down": "1", 
        "name": "Kneeboard Previous Page"
    }, 
    "Throttle Right Up": {
        "down": "iCommandThrottle2Increase", 
        "category": "Flight Control", 
        "up": "iCommandThrottle2Stop", 
        "name": "Throttle Right Up"
    }, 
    "Wheel Brake Left On/Off": {
        "down": "iCommandPlaneWheelBrakeLeftOn", 
        "category": "Systems", 
        "up": "iCommandPlaneWheelBrakeLeftOff", 
        "name": "Wheel Brake Left On/Off"
    }, 
    "TACAN Test Button": {
        "down": "iCommandPlane_TACAN_Test", 
        "category": "TACAN Control Panel", 
        "up": "iCommandPlane_TACAN_Test", 
        "name": "TACAN Test Button"
    }, 
    "Monitor test Off": {
        "down": "iCommandPlaneSASMonitorTestOff", 
        "category": "Stability Augmentation System", 
        "name": "Monitor test Off"
    }, 
    "CMSC JMR Key": {
        "down": "iCommandPlaneCMSC_JMR", 
        "category": "CMSC Panel", 
        "up": "iCommandPlaneCMSC_JMR", 
        "name": "CMSC JMR Key"
    }, 
    "Left MFCD CON Decrease": {
        "down": "iCommandPlaneLeftMFD_CON_Decrease", 
        "category": "Left MFCD", 
        "up": "iCommandPlaneLeftMFD_CON_Stop", 
        "name": "Left MFCD CON Decrease"
    }, 
    "Right elevator emer disengage": {
        "down": "iCommandPlaneEmerElevatorDisengageR", 
        "category": "Emergency flight control panel", 
        "name": "Right elevator emer disengage"
    }, 
    "Right MFCD BRT Decrease": {
        "down": "iCommandPlaneRightMFD_BRT_Decrease", 
        "category": "Right MFCD", 
        "up": "iCommandPlaneRightMFD_BRT_Stop", 
        "name": "Right MFCD BRT Decrease"
    }, 
    "Wheel Brake Right On/Off": {
        "down": "iCommandPlaneWheelBrakeRightOn", 
        "category": "Systems", 
        "up": "iCommandPlaneWheelBrakeRightOff", 
        "name": "Wheel Brake Right On/Off"
    }, 
    "UHF 0.025Mhz selector increase": {
        "down": "iCommandPlaneUHF0025MhzSelectorInc", 
        "category": "UHF Radio", 
        "name": "UHF 0.025Mhz selector increase"
    }, 
    "CDU Point Key": {
        "down": "iCommandPlaneCDU_PNT", 
        "category": "CDU panel", 
        "up": "iCommandPlaneCDU_PNT", 
        "name": "CDU Point Key"
    }, 
    "Battery power": {
        "down": "iCommandBatteryPower", 
        "category": "Electrical power control panel", 
        "name": "Battery power"
    }, 
    "Right MFCD DSP Increase": {
        "down": "iCommandPlaneRightMFD_DSP_Increase", 
        "category": "Right MFCD", 
        "up": "iCommandPlaneRightMFD_DSP_Stop", 
        "name": "Right MFCD DSP Increase"
    }, 
    "Rotary selector FM": {
        "down": "iCommandPlaneIntercomFM", 
        "category": "Intercom control panel", 
        "name": "Rotary selector FM"
    }, 
    "UHF 0.025Mhz selector decrease": {
        "down": "iCommandPlaneUHF0025MhzSelectorDec", 
        "category": "UHF Radio", 
        "name": "UHF 0.025Mhz selector decrease"
    }, 
    "VHF AM Mode EMER FM": {
        "down": "iCommandPlane_VHF_AM_Mode_EMERFM", 
        "category": "VHF AM Radio Control Panel", 
        "name": "VHF AM Mode EMER FM"
    }, 
    "Fuel crossfeed valve": {
        "down": "iCommandPlaneFSTankCrossFeed", 
        "category": "Fuel system control panel", 
        "name": "Fuel crossfeed valve"
    }, 
    "HOTAS Nosewheel Steering Button": {
        "down": "iCommandPlane_HOTAS_NoseWheelSteeringButton", 
        "category": "HOTAS", 
        "up": "iCommandPlane_HOTAS_NoseWheelSteeringButtonOff", 
        "name": "HOTAS Nosewheel Steering Button"
    }, 
    "UFC 2 Key": {
        "down": "iCommandPlaneUFC_2", 
        "category": "UFC", 
        "up": "iCommandPlaneUFC_2", 
        "name": "UFC 2 Key"
    }, 
    "Camera view keyboard rate slow": {
        "down": "iCommandViewSlowKeyboard", 
        "category": "View", 
        "name": "Camera view keyboard rate slow"
    }, 
    "Camera view down-left slow": {
        "down": "iCommandViewCameraDownLeftSlow", 
        "category": "View Cockpit", 
        "name": "Camera view down-left slow"
    }, 
    "Zoom external normal": {
        "down": "iCommandViewExternalZoomDefault", 
        "category": "View", 
        "name": "Zoom external normal"
    }, 
    "Rotary selector HF": {
        "down": "iCommandPlaneIntercomHF", 
        "category": "Intercom control panel", 
        "name": "Rotary selector HF"
    }, 
    "Left MFCD OSB 20": {
        "down": "iCommandPlaneLeftMFD_OSB20", 
        "category": "Left MFCD", 
        "up": "iCommandPlaneLeftMFD_OSB20_Off", 
        "name": "Left MFCD OSB 20"
    }, 
    "CB APU CONT": {
        "down": "iCommandPlaneCircuitBreaker_13", 
        "category": "Circuit breaker panel", 
        "name": "CB APU CONT"
    }, 
    "UFC 7 Key": {
        "down": "iCommandPlaneUFC_7", 
        "category": "UFC", 
        "up": "iCommandPlaneUFC_7", 
        "name": "UFC 7 Key"
    }, 
    "AAP EGI Power Switch": {
        "down": "iCommandPlane_AAP_EGI_Power", 
        "category": "AAP", 
        "name": "AAP EGI Power Switch"
    }, 
    "UHF Status": {
        "down": "iCommandPlaneUHFStatus", 
        "category": "UHF Radio", 
        "up": "iCommandPlaneUHFStatus", 
        "name": "UHF Status"
    }, 
    "Toggle goggles": {
        "down": "iCommandViewNightVisionGogglesOn", 
        "category": "Sensors", 
        "name": "Toggle goggles"
    }, 
    "Wind shield Rain Removal Switch Center": {
        "down": "iCommandPlane_Env_WindshieldCenter", 
        "category": "Environment System Panel", 
        "name": "Wind shield Rain Removal Switch Center"
    }, 
    "CB DC fuel pump": {
        "down": "iCommandPlaneCircuitBreaker_18", 
        "category": "Circuit breaker panel", 
        "name": "CB DC fuel pump"
    }, 
    "CB Bleed air CONT Right": {
        "down": "iCommandPlaneCircuitBreaker_20", 
        "category": "Circuit breaker panel", 
        "name": "CB Bleed air CONT Right"
    }, 
    "UHF 1Mhz selector decrease": {
        "down": "iCommandPlaneUHF1MhzSelectorDec", 
        "category": "UHF Radio", 
        "name": "UHF 1Mhz selector decrease"
    }, 
    "Landing Lights On": {
        "down": "iCommandPlaneLGPLandLight", 
        "category": "Landing gear panel", 
        "name": "Landing Lights On"
    }, 
    "UHF Antenna Switch UPPER": {
        "down": "iCommandUHFAntennaUpper", 
        "category": "Antenna Select Panel", 
        "name": "UHF Antenna Switch UPPER"
    }, 
    "UFC ENT Key": {
        "down": "iCommandPlaneUFC_ENT", 
        "category": "UFC", 
        "up": "iCommandPlaneUFC_ENT", 
        "name": "UFC ENT Key"
    }, 
    "Gun Trigger (first stage)": {
        "down": "iCommandPlane_HOTAS_TriggerFirstStage", 
        "category": "HOTAS", 
        "up": "iCommandPlane_HOTAS_TriggerFirstStage_Off", 
        "name": "Gun Trigger (first stage)"
    }, 
    "Lock view (cycle padlock)": {
        "down": "iCommandViewLock", 
        "category": "View Padlock", 
        "name": "Lock view (cycle padlock)"
    }, 
    "VHF FM Frequency Mode TK": {
        "down": "iCommandPlane_VHF_FM_FreqMode_TK", 
        "category": "VHF FM Radio Control Panel", 
        "name": "VHF FM Frequency Mode TK"
    }, 
    "UFC STEER UP Rocker switch": {
        "down": "iCommandPlaneUFC_STEER_UP", 
        "category": "UFC", 
        "up": "iCommandPlaneUFC_STEER_UP", 
        "name": "UFC STEER UP Rocker switch"
    }, 
    "Show debriefing window": {
        "down": "iCommandDebriefing", 
        "category": "General", 
        "name": "Show debriefing window"
    }, 
    "Left MFCD Day illumination": {
        "down": "iCommandPlaneLeftMFD_BRTMODE_DAY", 
        "category": "Left MFCD", 
        "name": "Left MFCD Day illumination"
    }, 
    "CB Inverter CONT": {
        "down": "iCommandPlaneCircuitBreaker_37", 
        "category": "Circuit breaker panel", 
        "name": "CB Inverter CONT"
    }, 
    "CB Bleed air CONT Left": {
        "down": "iCommandPlaneCircuitBreaker_19", 
        "category": "Circuit breaker panel", 
        "name": "CB Bleed air CONT Left"
    }, 
    "Left MFCD ADJ Increase": {
        "down": "iCommandPlaneLeftMFD_ADJ_Increase", 
        "category": "Left MFCD", 
        "up": "iCommandPlaneLeftMFD_ADJ_Stop", 
        "name": "Left MFCD ADJ Increase"
    }, 
    "CDU F Key": {
        "down": "iCommandPlaneCDU_F", 
        "category": "CDU panel", 
        "up": "iCommandPlaneCDU_F", 
        "name": "CDU F Key"
    }, 
    "Throttle Right Down": {
        "down": "iCommandThrottle2Decrease", 
        "category": "Flight Control", 
        "up": "iCommandThrottle2Stop", 
        "name": "Throttle Right Down"
    }, 
    "HOTAS DMS Aft": {
        "down": "iCommandPlane_HOTAS_DataManagementSwitchDown", 
        "category": "HOTAS", 
        "up": "iCommandPlane_HOTAS_DataManagementSwitchOff", 
        "name": "HOTAS DMS Aft"
    }, 
    "Flight control NORM/MAN REVERSION": {
        "down": "iCommandPlaneEmerFlightControl", 
        "category": "Emergency flight control panel", 
        "name": "Flight control NORM/MAN REVERSION"
    }, 
    "CB Inverter PWR": {
        "down": "iCommandPlaneCircuitBreaker_36", 
        "category": "Circuit breaker panel", 
        "name": "CB Inverter PWR"
    }, 
    "Temperature/Pressure Control DUMP": {
        "down": "iCommandPlane_Env_TempPress_DUMP", 
        "category": "Environment System Panel", 
        "name": "Temperature/Pressure Control DUMP"
    }, 
    "CMSP JTSN": {
        "down": "iCommandPlaneCMSP_JTSN", 
        "category": "CMSP Panel", 
        "name": "CMSP JTSN"
    }, 
    "CB Aileron disconnect Right": {
        "down": "iCommandPlaneCircuitBreaker_2", 
        "category": "Circuit breaker panel", 
        "name": "CB Aileron disconnect Right"
    }, 
    "VHF AM Tone": {
        "down": "iCommandPlane_VHF_AM_Tone", 
        "category": "VHF AM Radio Control Panel", 
        "up": "iCommandPlane_VHF_AM_Tone", 
        "name": "VHF AM Tone"
    }, 
    "Aircraft Labels": {
        "down": "iCommandMarkerStatePlane", 
        "category": "Labels", 
        "name": "Aircraft Labels"
    }, 
    "F1 Head shift movement on / off": {
        "down": "iCommandViewPitHeadOnOff", 
        "category": "View", 
        "name": "F1 Head shift movement on / off"
    }, 
    "HOTAS CMS Left": {
        "down": "iCommandPlane_HOTAS_CMS_Left", 
        "category": "HOTAS", 
        "up": "iCommandPlane_HOTAS_CMS_Off", 
        "name": "HOTAS CMS Left"
    }, 
    "Cover me": {
        "down": "iCommandPlaneCoverMySix", 
        "category": "Communications", 
        "name": "Cover me"
    }, 
    "UHF Dial OFF": {
        "down": "iCommandPlaneUHFFunctionDialOFF", 
        "category": "UHF Radio", 
        "name": "UHF Dial OFF"
    }, 
    "TACAN Mode Select REC": {
        "down": "iCommandPlane_TACAN_Mode_Rec", 
        "category": "TACAN Control Panel", 
        "name": "TACAN Mode Select REC"
    }, 
    "View all mode": {
        "down": "iCommandViewAll", 
        "category": "View Extended", 
        "name": "View all mode"
    }, 
    "Oxygen Emergency Lever Normal": {
        "down": "iCommandPlane_Oxygen_Normal", 
        "category": "Environment System Panel", 
        "name": "Oxygen Emergency Lever Normal"
    }, 
    "CDU D Key": {
        "down": "iCommandPlaneCDU_D", 
        "category": "CDU panel", 
        "up": "iCommandPlaneCDU_D", 
        "name": "CDU D Key"
    }, 
    "UFC FUNC Key": {
        "down": "iCommandPlaneUFC_FUNC", 
        "category": "UFC", 
        "up": "iCommandPlaneUFC_FUNC", 
        "name": "UFC FUNC Key"
    }, 
    "Right aileron emer disengage": {
        "down": "iCommandPlaneEmerAileronDisengageR", 
        "category": "Emergency flight control panel", 
        "name": "Right aileron emer disengage"
    }, 
    "CMSP Next Up rotary": {
        "down": "iCommandPlaneCMSP_NEXT_UP", 
        "category": "CMSP Panel", 
        "up": "iCommandPlaneCMSP_NEXT_UP", 
        "name": "CMSP Next Up rotary"
    }, 
    "ALT SCE switch RADAR": {
        "down": "iCommandPlaneAHCPAltSCERadar", 
        "category": "Armament HUD Control Panel", 
        "name": "ALT SCE switch RADAR"
    }, 
    "Center camera view": {
        "down": "iCommandViewCameraCenter", 
        "category": "View Cockpit", 
        "name": "Center camera view"
    }, 
    "HUD Mode switch NORM/STBY": {
        "down": "iCommandPlaneAHCPHUDModeNormSTBY", 
        "category": "Armament HUD Control Panel", 
        "name": "HUD Mode switch NORM/STBY"
    }, 
    "F9 Ship view": {
        "down": "iCommandViewNavy", 
        "category": "View", 
        "name": "F9 Ship view"
    }, 
    "Threat missile padlock": {
        "down": "iCommandThreatMissilePadlock", 
        "category": "View Padlock", 
        "name": "Threat missile padlock"
    }, 
    "CDU 3 Key": {
        "down": "iCommandPlaneCDU_3", 
        "category": "CDU panel", 
        "up": "iCommandPlaneCDU_3", 
        "name": "CDU 3 Key"
    }, 
    "Throttle Right Up Step": {
        "down": "iCommandPlaneAUTIncreaseRegimeRight", 
        "category": "Flight Control", 
        "name": "Throttle Right Up Step"
    }, 
    "JTRS switch ON/OFF": {
        "down": "iCommandPlaneAHCPJTRSOnOff", 
        "category": "Armament HUD Control Panel", 
        "name": "JTRS switch ON/OFF"
    }, 
    "CB AUX ESS BUS TIE": {
        "down": "iCommandPlaneCircuitBreaker_38", 
        "category": "Circuit breaker panel", 
        "name": "CB AUX ESS BUS TIE"
    }, 
    "Landing/Taxi Lights Off": {
        "down": "iCommandPlaneLGPLightsOff", 
        "category": "Landing gear panel", 
        "name": "Landing/Taxi Lights Off"
    }, 
    "Seat Arm Handle": {
        "down": "iCommandSeatArmHandle", 
        "category": "Systems", 
        "name": "Seat Arm Handle"
    }, 
    "F12 Trains/cars toggle": {
        "down": "iCommandViewLocomotivesToggle", 
        "category": "View", 
        "name": "F12 Trains/cars toggle"
    }, 
    "Left MFCD SYM Decrease": {
        "down": "iCommandPlaneLeftMFD_SYM_Dn", 
        "category": "Left MFCD", 
        "up": "iCommandPlaneLeftMFD_SYM_Stop", 
        "name": "Left MFCD SYM Decrease"
    }, 
    "F3 Fly-By jump view": {
        "down": "iCommandViewTowerJump", 
        "category": "View", 
        "name": "F3 Fly-By jump view"
    }, 
    "Left MFCD Disable power": {
        "down": "iCommandPlaneLeftMFD_BRTMODE_OFF", 
        "category": "Left MFCD", 
        "name": "Left MFCD Disable power"
    }, 
    "Throttle Left Down Step": {
        "down": "iCommandPlaneAUTDecreaseRegimeLeft", 
        "category": "Flight Control", 
        "name": "Throttle Left Down Step"
    }, 
    "Switch dialog": {
        "down": "ICommandSwitchDialog", 
        "category": "Communications", 
        "name": "Switch dialog"
    }, 
    "Left aileron emer disengage": {
        "down": "iCommandPlaneEmerAileronDisengageL", 
        "category": "Emergency flight control panel", 
        "name": "Left aileron emer disengage"
    }, 
    "UFC 8 Key": {
        "down": "iCommandPlaneUFC_8", 
        "category": "UFC", 
        "up": "iCommandPlaneUFC_8", 
        "name": "UFC 8 Key"
    }, 
    "Cockpit Camera Move Center": {
        "down": "iCommandViewPitCameraMoveCenter", 
        "category": "View Cockpit", 
        "name": "Cockpit Camera Move Center"
    }, 
    "CDU C Key": {
        "down": "iCommandPlaneCDU_C", 
        "category": "CDU panel", 
        "up": "iCommandPlaneCDU_C", 
        "name": "CDU C Key"
    }, 
    "Left main tank fill disable": {
        "down": "iCommandPlaneFSLeftMainFillDisable", 
        "category": "Fuel system control panel", 
        "name": "Left main tank fill disable"
    }, 
    "CB Master caution": {
        "down": "iCommandPlaneCircuitBreaker_24", 
        "category": "Circuit breaker panel", 
        "name": "CB Master caution"
    }, 
    "CDU Search back Key": {
        "down": "iCommandPlaneCDU_BLANC_L", 
        "category": "CDU panel", 
        "up": "iCommandPlaneCDU_BLANC_L", 
        "name": "CDU Search back Key"
    }, 
    "UHF 100Mhz selector switch 2": {
        "down": "iCommandPlaneUHF100MhzSelector2", 
        "category": "UHF Radio", 
        "name": "UHF 100Mhz selector switch 2"
    }, 
    "UHF 100Mhz selector switch 3": {
        "down": "iCommandPlaneUHF100MhzSelector3", 
        "category": "UHF Radio", 
        "name": "UHF 100Mhz selector switch 3"
    }, 
    "Air Conditioner Control COLD": {
        "down": "iCommandPlane_Env_AirConditioner_COLD", 
        "category": "Environment System Panel", 
        "up": "iCommandPlane_Env_AirConditioner_COLD", 
        "name": "Air Conditioner Control COLD"
    }, 
    "Camera view up-right": {
        "down": "iCommandViewCameraUpRight", 
        "category": "View Cockpit", 
        "up": "iCommandViewCameraCenter", 
        "name": "Camera view up-right"
    }, 
    "Temperature/Pressure Control RAM": {
        "down": "iCommandPlane_Env_TempPress_RAM", 
        "category": "Environment System Panel", 
        "name": "Temperature/Pressure Control RAM"
    }, 
    "F12 Civil traffic view": {
        "down": "iCommandViewMirage", 
        "category": "View", 
        "name": "F12 Civil traffic view"
    }, 
    "IFF press": {
        "down": "iCommandPlaneIntercomIFFPress", 
        "category": "Intercom control panel", 
        "name": "IFF press"
    }, 
    "Left MFCD DSP Increase": {
        "down": "iCommandPlaneLeftMFD_DSP_Increase", 
        "category": "Left MFCD", 
        "up": "iCommandPlaneLeftMFD_DSP_Stop", 
        "name": "Left MFCD DSP Increase"
    }, 
    "Landing Gear Up/Down": {
        "down": "iCommandPlaneGear", 
        "category": "Landing gear panel", 
        "name": "Landing Gear Up/Down"
    }, 
    "Right Engine T-Handle Fire Extinguisher": {
        "down": "iCommand_FireExting_RightEngineExting", 
        "category": "Fire Extinguishers System", 
        "name": "Right Engine T-Handle Fire Extinguisher"
    }, 
    "UFC CLR Key": {
        "down": "iCommandPlaneUFC_CLR", 
        "category": "UFC", 
        "up": "iCommandPlaneUFC_CLR", 
        "name": "UFC CLR Key"
    }, 
    "Function control toggle switch OFF": {
        "down": "iCommandDVADRFunctionOff", 
        "category": "DVADR Remote Control Panel", 
        "name": "Function control toggle switch OFF"
    }, 
    "Toggle formation": {
        "down": "iCommandPlaneFormation", 
        "category": "Communications", 
        "name": "Toggle formation"
    }, 
    "Air refuel line check": {
        "down": "iCommandPlaneFSLineCheck", 
        "category": "Fuel system control panel", 
        "up": "iCommandPlaneFSLineCheck", 
        "name": "Air refuel line check"
    }, 
    "CB Emer FLAP": {
        "down": "iCommandPlaneCircuitBreaker_8", 
        "category": "Circuit breaker panel", 
        "name": "CB Emer FLAP"
    }, 
    "UHF 100Mhz selector switch A": {
        "down": "iCommandPlaneUHF100MhzSelectorA", 
        "category": "UHF Radio", 
        "name": "UHF 100Mhz selector switch A"
    }, 
    "Camera view mouse rate fast": {
        "down": "iCommandViewFastMouse", 
        "category": "View", 
        "name": "Camera view mouse rate fast"
    }, 
    "TACAN Mode Select A A T R": {
        "down": "iCommandPlane_TACAN_Mode_AATR", 
        "category": "TACAN Control Panel", 
        "name": "TACAN Mode Select A A T R"
    }, 
    "Master switch TRAIN": {
        "down": "iCommandPlaneAHCPMasterTrain", 
        "category": "Armament HUD Control Panel", 
        "name": "Master switch TRAIN"
    }, 
    "Camera view up": {
        "down": "iCommandViewCameraUp", 
        "category": "View Cockpit", 
        "up": "iCommandViewCameraCenter", 
        "name": "Camera view up"
    }, 
    "CDU X Key": {
        "down": "iCommandPlaneCDU_X", 
        "category": "CDU panel", 
        "up": "iCommandPlaneCDU_X", 
        "name": "CDU X Key"
    }, 
    "Gun Trigger": {
        "down": "iCommandPlane_HOTAS_TriggerSecondStage", 
        "category": "HOTAS", 
        "up": "iCommandPlane_HOTAS_TriggerSecondStage_Off", 
        "name": "Gun Trigger"
    }, 
    "CDU K Key": {
        "down": "iCommandPlaneCDU_K", 
        "category": "CDU panel", 
        "up": "iCommandPlaneCDU_K", 
        "name": "CDU K Key"
    }, 
    "CB Aileron TAB Left": {
        "down": "iCommandPlaneCircuitBreaker_6", 
        "category": "Circuit breaker panel", 
        "name": "CB Aileron TAB Left"
    }, 
    "Camera view right slow": {
        "down": "iCommandViewCameraRightSlow", 
        "category": "View Cockpit", 
        "name": "Camera view right slow"
    }, 
    "CMSP RWR MENU": {
        "down": "iCommandPlaneCMSP_RWR_MENU", 
        "category": "CMSP Panel", 
        "up": "iCommandPlaneCMSP_RWR_ON", 
        "name": "CMSP RWR MENU"
    }, 
    "Save Cockpit Angles": {
        "down": "iCommandViewSaveAngles", 
        "category": "View Cockpit", 
        "name": "Save Cockpit Angles"
    }, 
    "LASER switch SAFE": {
        "down": "iCommandPlaneAHCPLaserSafe", 
        "category": "Armament HUD Control Panel", 
        "name": "LASER switch SAFE"
    }, 
    "Left MFCD OSB 18": {
        "down": "iCommandPlaneLeftMFD_OSB18", 
        "category": "Left MFCD", 
        "up": "iCommandPlaneLeftMFD_OSB18_Off", 
        "name": "Left MFCD OSB 18"
    }, 
    "Left MFCD OSB 19": {
        "down": "iCommandPlaneLeftMFD_OSB19", 
        "category": "Left MFCD", 
        "up": "iCommandPlaneLeftMFD_OSB19_Off", 
        "name": "Left MFCD OSB 19"
    }, 
    "UHF 1Mhz selector increase": {
        "down": "iCommandPlaneUHF1MhzSelectorInc", 
        "category": "UHF Radio", 
        "name": "UHF 1Mhz selector increase"
    }, 
    "Air Conditioner Control HOT": {
        "down": "iCommandPlane_Env_AirConditioner_HOT", 
        "category": "Environment System Panel", 
        "up": "iCommandPlane_Env_AirConditioner_HOT", 
        "name": "Air Conditioner Control HOT"
    }, 
    "Camera view down": {
        "down": "iCommandViewCameraDown", 
        "category": "View Cockpit", 
        "up": "iCommandViewCameraCenter", 
        "name": "Camera view down"
    }, 
    "Left MFCD OSB 10": {
        "down": "iCommandPlaneLeftMFD_OSB10", 
        "category": "Left MFCD", 
        "up": "iCommandPlaneLeftMFD_OSB10_Off", 
        "name": "Left MFCD OSB 10"
    }, 
    "Left MFCD OSB 11": {
        "down": "iCommandPlaneLeftMFD_OSB11", 
        "category": "Left MFCD", 
        "up": "iCommandPlaneLeftMFD_OSB11_Off", 
        "name": "Left MFCD OSB 11"
    }, 
    "GUN/PAC switch GUNARM": {
        "down": "iCommandPlaneAHCPGUNArm", 
        "category": "Armament HUD Control Panel", 
        "name": "GUN/PAC switch GUNARM"
    }, 
    "Left MFCD OSB 13": {
        "down": "iCommandPlaneLeftMFD_OSB13", 
        "category": "Left MFCD", 
        "up": "iCommandPlaneLeftMFD_OSB13_Off", 
        "name": "Left MFCD OSB 13"
    }, 
    "Left MFCD OSB 14": {
        "down": "iCommandPlaneLeftMFD_OSB14", 
        "category": "Left MFCD", 
        "up": "iCommandPlaneLeftMFD_OSB14_Off", 
        "name": "Left MFCD OSB 14"
    }, 
    "Left MFCD OSB 15": {
        "down": "iCommandPlaneLeftMFD_OSB15", 
        "category": "Left MFCD", 
        "up": "iCommandPlaneLeftMFD_OSB15_Off", 
        "name": "Left MFCD OSB 15"
    }, 
    "Left MFCD OSB 16": {
        "down": "iCommandPlaneLeftMFD_OSB16", 
        "category": "Left MFCD", 
        "up": "iCommandPlaneLeftMFD_OSB16_Off", 
        "name": "Left MFCD OSB 16"
    }, 
    "Left MFCD OSB 17": {
        "down": "iCommandPlaneLeftMFD_OSB17", 
        "category": "Left MFCD", 
        "up": "iCommandPlaneLeftMFD_OSB17_Off", 
        "name": "Left MFCD OSB 17"
    }, 
    "Emergency flood": {
        "down": "iCommandEmergencyFlood", 
        "category": "Electrical power control panel", 
        "name": "Emergency flood"
    }, 
    "CICU switch ON/OFF": {
        "down": "iCommandPlaneAHCPCICUOnOff", 
        "category": "Armament HUD Control Panel", 
        "name": "CICU switch ON/OFF"
    }, 
    "HOTAS TMS Forward": {
        "down": "iCommandPlane_HOTAS_TargetManagementSwitchUp", 
        "category": "HOTAS", 
        "up": "iCommandPlane_HOTAS_TargetManagementSwitchOff", 
        "name": "HOTAS TMS Forward"
    }, 
    "UHF Dial BOTH": {
        "down": "iCommandPlaneUHFFunctionDialBOTH", 
        "category": "UHF Radio", 
        "name": "UHF Dial BOTH"
    }, 
    "Fuel quantity selector WING": {
        "down": "iCommandPlaneFSQuantityIndicatorSelectorWING", 
        "category": "Fuel system control panel", 
        "name": "Fuel quantity selector WING"
    }, 
    "Fire Extinguishig Agent Discharge Right": {
        "down": "iCommand_FireExting_Discharge_Right", 
        "category": "Fire Extinguishers System", 
        "name": "Fire Extinguishig Agent Discharge Right"
    }, 
    "Clickable mouse cockpit mode On/Off": {
        "down": "iCommandCockpitClickModeOnOff", 
        "category": "General", 
        "name": "Clickable mouse cockpit mode On/Off"
    }, 
    "CDU O Key": {
        "down": "iCommandPlaneCDU_O", 
        "category": "CDU panel", 
        "up": "iCommandPlaneCDU_O", 
        "name": "CDU O Key"
    }, 
    "CMSC MWS Key": {
        "down": "iCommandPlaneCMSC_MWS", 
        "category": "CMSC Panel", 
        "up": "iCommandPlaneCMSC_MWS", 
        "name": "CMSC MWS Key"
    }, 
    "VHF AM Frequency Mode OFF": {
        "down": "iCommandPlane_VHF_AM_FreqMode_OFF", 
        "category": "VHF AM Radio Control Panel", 
        "name": "VHF AM Frequency Mode OFF"
    }, 
    "CDU U Key": {
        "down": "iCommandPlaneCDU_U", 
        "category": "CDU panel", 
        "up": "iCommandPlaneCDU_U", 
        "name": "CDU U Key"
    }, 
    "Inverter OFF": {
        "down": "iCommandElectricalPowerInverterOFF", 
        "category": "Electrical power control panel", 
        "name": "Inverter OFF"
    }, 
    "AAP Page Select STEER": {
        "down": "iCommandPlane_AAP_PageSel_STEER", 
        "category": "AAP", 
        "name": "AAP Page Select STEER"
    }, 
    "Enable visual recon mode": {
        "down": "iCommand_ExplorationStart", 
        "category": "View Cockpit", 
        "name": "Enable visual recon mode"
    }, 
    "AAP STEER Switch Up": {
        "down": "iCommandPlane_AAP_SteerSw_Up", 
        "category": "AAP", 
        "up": "iCommandPlane_AAP_SteerSw_Up", 
        "name": "AAP STEER Switch Up"
    }, 
    "AAP Page Select POSITION": {
        "down": "iCommandPlane_AAP_PageSel_POSITION", 
        "category": "AAP", 
        "name": "AAP Page Select POSITION"
    }, 
    "Flaps Up": {
        "down": "iCommandPlaneFlapsOff", 
        "category": "Systems", 
        "name": "Flaps Up"
    }, 
    "CDU PG UP Key": {
        "down": "iCommandPlaneCDU_PGUP", 
        "category": "CDU panel", 
        "up": "iCommandPlaneCDU_PGUP", 
        "name": "CDU PG UP Key"
    }, 
    "Kneeboard Next Page": {
        "down": "3001", 
        "cockpit_device_id": "100", 
        "category": "Kneeboard", 
        "value_down": "1", 
        "name": "Kneeboard Next Page"
    }, 
    "Wind shield Defog/Deice Switch": {
        "down": "iCommandPlane_Env_WindshieldDefogDeice", 
        "category": "Environment System Panel", 
        "name": "Wind shield Defog/Deice Switch"
    }, 
    "UHF T-Tone": {
        "down": "iCommandPlaneUHFTTone", 
        "category": "UHF Radio", 
        "up": "iCommandPlaneUHFTTone", 
        "name": "UHF T-Tone"
    }, 
    "Position Lights Flash": {
        "down": "iCommandPlanePositionLightsFlash", 
        "category": "Lighting Panel", 
        "name": "Position Lights Flash"
    }, 
    "UFC 0 Key": {
        "down": "iCommandPlaneUFC_0", 
        "category": "UFC", 
        "up": "iCommandPlaneUFC_0", 
        "name": "UFC 0 Key"
    }, 
    "Return camera": {
        "down": "iCommandViewCameraReturn", 
        "category": "View Cockpit", 
        "name": "Return camera"
    }, 
    "Main Air Supply Switch": {
        "down": "iCommandPlane_Env_MainAirSupply", 
        "category": "Environment System Panel", 
        "name": "Main Air Supply Switch"
    }, 
    "CDU 9 Key": {
        "down": "iCommandPlaneCDU_9", 
        "category": "CDU panel", 
        "up": "iCommandPlaneCDU_9", 
        "name": "CDU 9 Key"
    }, 
    "Right MFCD ADJ Decrease": {
        "down": "iCommandPlaneRightMFD_ADJ_Decrease", 
        "category": "Right MFCD", 
        "up": "iCommandPlaneRightMFD_ADJ_Stop", 
        "name": "Right MFCD ADJ Decrease"
    }, 
    "VHF AM Frequency Mode DN": {
        "down": "iCommandPlane_VHF_AM_FreqMode_DN", 
        "category": "VHF AM Radio Control Panel", 
        "name": "VHF AM Frequency Mode DN"
    }, 
    "F4 Look back view": {
        "down": "iCommandViewRear", 
        "category": "View", 
        "name": "F4 Look back view"
    }
}
