bnepethomas/bne-arduino-flight-simulator-interfaces/Fuel Panel/2011414102022_VID 69Electrical and Mechanical Characteristic1.pdf

## ELECTRICAL AND MECHANICAL CHARACTERISTICS

Tamb=25ºC, in partial step mode @ Max. voltage 5V, unless other specified.
Parameter | Symbol | Test Conditions | Min. | Typ. | Max. | Units
Operating Temperature | Ta | | -40 | | 105 | ºC
Coil Resistance | Rb | | 235 | 260 | 285 | Ω
Operating Peak Current | Im | fa=16Hz(50º/s) | | 19.3 | 21.3 | mA
Dynamic Torque | M50 M200 | fa=16Hz(50º/s) fa=66Hz(200º/s) | 0.4 | 0.5 0.4 | | mNm
Static Torque | Ms M0 | Ub=5V Ub=0V | 1 0.16 | 1.2 0.25 | | mNm
Gear Play | | | | ±0.5 | ±1 | Degree
Force allowed on the pointer shaft: Axial force (push) Axial force (pull) Perpendicular force Imposed acceleration | Fa Fa Fq αp | | | | 100 70 7 1000 | N N N Rad/s2
Noise Level | SPL | Back ground:35dBA Fa=16Hz | | 40 | 50 | dBA

Note: fa – full-step frequency
