bnepethomas/bne-arduino-flight-simulator-interfaces/A10/A10 code to be validated/Projects/DCSExtract-master/README.md

Images:

http://skbn.github.io/DCSExtract/
