bnepethomas/bne-arduino-flight-simulator-interfaces/A10/A10 code to be validated/Projects/DCSW_GetCMSP-master/README.md

DCSW_GetCMSP-
=============

a small pattern recognition application to extract the CMSP and CMSC text from DCSW A-10C

==============
Change the code 
==============

Pay attention to these 2 methods, you know what to do, if you don't ask the question in http://forums.eagle.ru/showthread.php?p=1895497

private void lblResult_TextChanged(object sender, EventArgs e)  //this is the CMSP text 

private void lblCMSCResult_TextChanged(object sender, EventArgs e)  //this is the CMSC text
