bnepethomas/bne-arduino-flight-simulator-interfaces/Jet Ranger/ C# Code/LowranceAirMapGpsBenchTester/Data/airports.tsv

AE |  | Al Dhafra Air Base | OMAM | DHF | 24.248199 | 54.547699 | 77
AE |  | Buhasa Airport | OMAB |  | 23.599701 | 53.379398 | 0
AE |  | Jazirah Airport | OMRJ |  | 25.664957 | 55.774413 | 0
AE | Abu Dhabi | Abu Dhabi Northeast Airport - Suweihan Air Base | OMAW |  | 24.526793 | 54.974812 | 88
AE | Abu Dhabi | Al Bateen Executive Airport | OMAD | AZI | 24.427062 | 54.459866 | 16
AE | Abu Dhabi | Zayed International Airport | OMAA | AUH | 24.440966 | 54.649237 | 88
AE | Al Ain | Al Ain International Airport | OMAL | AAN | 24.261700 | 55.609200 | 869
AE | Al Duhaisah | Al Saqr Field | OMRS |  | 25.752944 | 55.959234 | 2
AE | Al Futaisi | Futaysi Airport | OMAF |  | 24.378768 | 54.316025 | 101
AE | Al Qaffay | Al Qaffay Airport | OMQF |  | 24.589560 | 51.727293 | 21
AE | Al Shuweihat | Al Hamra Auxiliary Airport | OMAH |  | 24.073999 | 52.463600 | 50
AE | Al-Yasat | Lower Yasat Island Airport | OMAY |  | 24.188840 | 51.996550 | 0
AE | Arzanah Island | Arzanah Airport | OMAR |  | 24.780872 | 52.559871 | 15
AE | Das Island | Das Island Airport | OMAS |  | 25.138234 | 52.874429 | 12
AE | Delma Island | Delma Airport | OMDL | ZDY | 24.510000 | 52.335200 | 30
AE | Dubai | Al Minhad Air Base | OMDM | NHD | 25.026800 | 55.366199 | 165
AE | Dubai | Dubai International Airport | OMDB | DXB | 25.249790 | 55.370992 | 62
AE | Dubai(Jebel Ali) | Al Maktoum International Airport | OMDW | DWC | 24.896171 | 55.162350 | 114
AE | Fujairah | Fujairah International Airport | OMFJ | FJR | 25.108411 | 56.328061 | 152
AE | Jebel Dhanna | Jebel Dhanna Airport | OMAJ |  | 24.187755 | 52.613934 | 43
AE | Qarnayn Island | Qarnayn Airport | OMAQ |  | 24.930599 | 52.855099 | 0
AE | Ras Al Khaimah | Ras Al Khaimah International Airport | OMRK | RKT | 25.613501 | 55.938801 | 102
AE | Sas Al Nakheel | Sas Al Nakheel Air Base | OMNK |  | 24.441280 | 54.516960 | 14
AE | Sharjah | Sharjah International Airport | OMSJ | SHJ | 25.328600 | 55.517200 | 111
AE | Sir Bani Yas | Sir Bani Yas Airport | OMBY | XSB | 24.283611 | 52.580278 | 25
AE | Zayed City | Liwa Air Base | OMLW |  | 23.651280 | 53.824440 | 422
AE | Zirku Island | Zirku Airport | OMAZ |  | 24.862492 | 53.077141 | 14
AF |  | Logar Airport | OALG |  | 33.986500 | 69.023102 | 6333
AF | Andkhoy | Andkhoy Airport | OAAK |  | 36.942659 | 65.206746 | 900
AF | Bagram | Bagram Airfield | OAIX | OAI | 34.946098 | 69.264999 | 4895
AF | Bamyan | Bamyan Airport | OABN | BIN | 34.808916 | 67.816629 | 8367
AF | Baraki Barak | Shank Air Base | OASH | OAA | 33.922217 | 69.077940 | 6890
AF | Chaghcharan | Chaghcharan Airport | OACC | CCN | 34.526465 | 65.271020 | 7383
AF | Darwaz | Darwaz Airport | OADZ | DAZ | 38.461798 | 70.881606 | 5250
AF | Farah | Farah Airport | OAFR | FAH | 32.366667 | 62.165347 | 3083
AF | Fayzabad | Fayzabad Airport | OAFZ | FBD | 37.122148 | 70.520100 | 3872
AF | Gardez | Gardez Airport | OAGZ | GRG | 33.627366 | 69.237023 | 7790
AF | Ghazni | Ghazni Airport | OAGN | GZI | 33.487853 | 68.525243 | 0
AF | Guzara | Herat - Khwaja Abdullah Ansari International Airport | OAHR | HEA | 34.209999 | 62.228298 | 3206
AF | Ishkashim | Ishkashim Airport | OAEM |  | 36.712720 | 71.612610 | 8420
AF | Jalalabad | Jalalabad Airport | OAJL | JAA | 34.399799 | 70.498596 | 1814
AF | Kabul | Kabul International Airport | OAKB | KBL | 34.565899 | 69.212303 | 5877
AF | Kandahar | Ahmad Shah Baba International Airport | OAKN | KDH | 31.505769 | 65.847963 | 3337
AF | Khost | Khost International Airport | OAKS | KHT | 33.284605 | 69.807340 | 4204
AF | Khost | Salerno Airport | OASL | OLR | 33.363800 | 69.956100 | 3780
AF | Khwahan | Khwahan Airport | OAHN | KWH | 37.890021 | 70.203830 | 3593
AF | Koran va Monjan | Koran va Monjan Airport | OAQM |  | 36.017070 | 70.760850 | 8420
AF | Kunduz | Kunduz Airport | OAUZ | UND | 36.665100 | 68.910797 | 1457
AF | Lashkar Gah | Bost Airport | OABT | BST | 31.559700 | 64.364998 | 2464
AF | Lashkar Gah | Camp Shorabak Airfield | OAZI | OAZ | 31.848735 | 64.223175 | 2943
AF | Maymana | Maymana Zahiraddin Faryabi Airport | OAMN | MMZ | 35.930801 | 64.760902 | 2743
AF | Mazar-i-Sharif | Mazar-i-Sharif International Airport | OAMS | MZR | 36.704120 | 67.210459 | 1284
AF | Muqur | Muqur Airport | OAMK |  | 32.879601 | 67.848602 | 6600
AF | Nili | Nili Airport | OANL |  | 33.739456 | 66.157408 | 0
AF | Orūzgān | Orūzgān Airport | OARG | URZ | 32.903000 | 66.630898 | 6725
AF | Panjab | Panjab Airport | OAPJ |  | 34.391726 | 67.020445 | 8800
AF | Qala-i-Naw | Qala-i-Naw Airport | OAQN | LQN | 34.985472 | 63.117404 | 2999
AF | Qalat | Qalat Airport | OAQA |  | 32.133839 | 66.898917 | 5383
AF | Reg | Dwyer Airport | OADY | DWR | 31.091265 | 64.066053 | 2380
AF | Rostaq | Rostaq Airport | OART |  | 37.106810 | 69.848892 | 4543
AF | Sardeh Band | Sardeh Band Airport | OADS | SBF | 33.320702 | 68.636497 | 6971
AF | Sharana | Sharana Airstrip | OASA | OAS | 33.125750 | 68.838517 | 7340
AF | Sheberghan | Sheberghan Airport | OASG |  | 36.751076 | 65.913038 | 1053
AF | Shindand | Shindand Air Base | OASD | OAH | 33.391300 | 62.261002 | 3773
AF | Shiveh | Sheghnan Airport | OASN | SGA | 37.497642 | 71.508484 | 6700
AF | Skazar | Razer Airport | OARZ | KUR | 36.029893 | 70.714159 | 0
AF | Taleqan | Taleqan Airport | OATQ | TQN | 36.770699 | 69.531998 | 2606
AF | Tarinkot | Tarinkot Airport | OATN | TII | 32.604198 | 65.865799 | 4429
AF | Taywarah | Taywarah Airport | OATW |  | 33.543090 | 64.425420 | 7370
AF | Urgun | Urgun Airport | OAOG | URN | 32.931135 | 69.153167 | 7300
AF | Yangi Qaleh | Yangi Qaleh Airport | OAYQ |  | 37.459000 | 69.646599 | 1600
AF | Yawan | Yawan Airport | OAYW |  | 37.563636 | 70.444496 | 5645
AF | Ziarat-e Amiran Saseb | Nimroz Airport | OANZ |  | 30.963333 | 62.060833 | 1581
AG | Coco Point | Coco Point Lodge Airstrip | TAPT |  | 17.555599 | -61.765301 | 15
AG | Codrington | Burton-Nibbs International Airport | TAPB | BBQ | 17.621194 | -61.798347 | 28
AG | Osbourn | V. C. Bird International Airport | TAPA | ANU | 17.136700 | -61.792702 | 62
AI | The Valley | Clayton J. Lloyd International Airport | TQPF | AXA | 18.204773 | -63.053830 | 127
AL | Kukës | Kukës International Airport | LAKU | KFZ | 42.035802 | 20.415955 | 1120
AL | Kuçovë | Kuçovë Air Base | LAKV |  | 40.771900 | 19.901899 | 135
AL | Rinas | Tirana International Airport Mother Teresa | LATI | TIA | 41.414700 | 19.720600 | 126
AM | Gyumri | Shirak International Airport | UDSG | LWN | 40.750401 | 43.859299 | 5000
AM | Kapan | Syunik Airport | UDCK | YUK | 39.202272 | 46.455204 | 2308
AM | Yerevan | Zvartnots International Airport | UDYZ | EVN | 40.148941 | 44.397887 | 2838
AO | Ambriz | Ambriz Airport | FNAM | AZZ | -7.862220 | 13.116100 | 144
AO | Benguela | Benguela Airport | FNBG | BUG | -12.609000 | 13.403700 | 118
AO | Cabinda | Cabinda Airport | FNCA | CAB | -5.598390 | 12.188145 | 66
AO | Cacolo | Cacolo Airport | FNCC |  | -10.110278 | 19.287304 | 4400
AO | Cafunfo | Cafunfo Airport | FNCF | CFF | -8.783610 | 17.989700 | 0
AO | Calulo | Calulo Airport | FNCU |  | -9.976268 | 14.917932 | 2988
AO | Camabatela | Camabatela Airport | FNCM |  | -8.177847 | 15.383177 | 410
AO | Camaxilo | Camaxilo Airport | FNCX |  | -8.373148 | 18.923625 | 3957
AO | Camembe | Camembe Airport | FNCB |  | -8.119819 | 14.498963 | 2264
AO | Capanda | Kapanda Airport | FNCP | KNP | -9.769370 | 15.455319 | 3366
AO | Catumbela | Catumbela Airport | FNCT | CBT | -12.479200 | 13.486900 | 23
AO | Cazombo | Cazombo Airport | FNCZ | CAV | -11.893100 | 22.916239 | 3700
AO | Chitato | Chitato Airport | FNCH | PGI | -7.358890 | 20.804701 | 2500
AO | Chitato | Dundo Airport | FNDU | DUE | -7.400890 | 20.818501 | 2451
AO | Cuito Cuanavale | Cuito Cuanavale Airport | FNCV | CTI | -15.160300 | 19.156099 | 0
AO | Damba | Damba Airport | FNDB |  | -6.900000 | 15.133000 | 3648
AO | Huambo | Albano Machado Airport | FNHU | NOV | -12.808900 | 15.760500 | 5587
AO | Huambo | Huambo Airport | FNNL |  | -12.786306 | 15.774528 | 5443
AO | Jamba | Jamba Airport | FNJM | JMB | -14.698193 | 16.070148 | 4912
AO | Kuito | Kuito Airport | FNKU | SVP | -12.404600 | 16.947399 | 5618
AO | Lobito | Lobito Airport | FNLB | LLT | -12.371200 | 13.536600 | 10
AO | Luanda | Quatro de Fevereiro International Airport | FNLU | LAD | -8.858370 | 13.231200 | 243
AO | Luanda (Ícolo e Bengo) | Dr. Antonio Agostinho Neto International Airport | FNBJ | NBJ | -9.050734 | 13.499078 | 550
AO | Luau | Luau Airport | FNUA | UAL | -10.715800 | 22.231100 | 3609
AO | Lubango | Lubango Mukanka International Airport | FNUB | SDD | -14.924839 | 13.576653 | 5778
AO | Lucapa | Lucapa Airport | FNLK | LBZ | -8.442339 | 20.732701 | 3029
AO | Luena | Luena Airport | FNUE | LUO | -11.768100 | 19.897699 | 4360
AO | Lumbala | Lumbala Airstrip | FNLM |  | -12.638947 | 22.589028 | 3510
AO | Lumbala N'guimbo | Lumbala Airport | FNBL | GGC | -14.105106 | 21.450830 | 3700
AO | Luzamba | Luzamba Airport | FNLZ | LZM | -9.115960 | 18.049299 | 2904
AO | Malanje | Malanje Airport | FNMA | MEG | -9.525090 | 16.312401 | 3868
AO | Maquela do Zombo | Maquela Airport | FNMQ |  | -6.030280 | 15.136900 | 3051
AO | Mbanza Congo | Mbanza Congo Airport | FNBC | SSY | -6.269900 | 14.247000 | 1860
AO | Menongue | Menongue Airport | FNME | SPP | -14.657600 | 17.719801 | 4469
AO | Moçâmedes | Welwitschia Mirabilis International Airport | FNMO | MSZ | -15.261200 | 12.146800 | 210
AO | N'zeto | N'zeto Airport | FNZE | ARZ | -7.259277 | 12.862355 | 69
AO | Negage | Negage Airport | FNNG | GXG | -7.754510 | 15.287700 | 4105
AO | Ngiva | Ngjiva Pereira Airport | FNGI | VPE | -17.043501 | 15.683800 | 3566
AO | Nzagi | Nzagi Airport | FNZG | NZA | -7.716940 | 21.358200 | 2431
AO | Port Amboim | Porto Amboim Airport | FNPA | PBN | -10.722000 | 13.765500 | 16
AO | Sanza Pombo | Sanza Pombo Airport | FNPB |  | -7.288999 | 15.930191 | 3251
AO | Saurimo | Saurimo Airport | FNSA | VHC | -9.689070 | 20.431900 | 3584
AO | Soyo | Soyo Airport | FNSO | SZA | -6.141090 | 12.371800 | 15
AO | Sumbe | Sumbe Airport | FNSU | NDD | -11.167900 | 13.847500 | 36
AO | Techamutete | Tchamutete Airport | FNTE |  | -15.216387 | 16.054915 | 4241
AO | Toto | Xamindele Airport | FNTO |  | -7.146390 | 14.248600 | 1775
AO | Uige | Uige Airport | FNUG | UGO | -7.603070 | 15.027800 | 2720
AO | Waco Kungo | Waco Kungo Airport | FNWK | CEO | -11.426400 | 15.101400 | 4324
AO | Xangongo | Xangongo Airport | FNXA | XGN | -16.755400 | 14.965300 | 3635
AQ | Amundsen-Scott South Pole Station | Amundsen–Scott South Pole Station Airport | NZSP |  | -90.000000 | -1.000000 | 9300
AQ | Halley Research Station | Halley Research Station | EGAH |  | -75.567406 | -25.516435 | 103
AQ | Patriot Hills Base Camp | Patriot Hills Airport | SCPZ |  | -80.318307 | -81.308128 | 2900
AQ | Rothera Research Station | Rothera Research Station | EGAR |  | -67.567500 | -68.127403 | 9
AQ | Sky Blu | Sky Blu Airstrip | EGAT |  | -74.849722 | -71.566666 | 4740
AQ | Union Glacier | Union Glacier Blue-Ice Runway | SCGC | UGL | -79.777778 | -83.320833 | 2461
AQ | Villa Las Estrellas | Teniente Rodolfo Marsh Martin Airport | SCRM | TNM | -62.191026 | -58.986690 | 147
AR | Alto Rio Senguerr | D. Casimiro Szlapelis Airport | SAVR | ARR | -45.013599 | -70.812202 | 2286
AR | Bahía Blanca | Comandante Espora Airport | SAZB | BHI | -38.725000 | -62.169300 | 246
AR | Bernardo de Irigoyen | Bernardo de Irigoyen Airport | SATI |  | -26.281458 | -53.672578 | 2673
AR | Buenos Aires | Aeroparque Jorge Newbery | SABE | AEP | -34.559419 | -58.415536 | 18
AR | Buenos Aires (Ezeiza) | Ezeiza International Airport - Ministro Pistarini | SAEZ | EZE | -34.822200 | -58.535800 | 67
AR | Catamarca | Coronel Felipe Varela International Airport | SANC | CTC | -28.593117 | -65.751200 | 1522
AR | Ceres | Ceres Airport | SANW | CRR | -29.872292 | -61.927925 | 285
AR | Chapelco/San Martin de los Andes | Aviador C. Campos Airport | SAZY | CPC | -40.075401 | -71.137299 | 2569
AR | Chos Malal | Chos Malal Airport | SAHC | HOS | -37.444698 | -70.222504 | 2788
AR | Chubut | Jose De San Martin Airport | SAWS | JSM | -44.048599 | -70.458900 | 2407
AR | Clorinda | Aeródromo de Clorinda | SATC | CLX | -25.303600 | -57.734400 | 206
AR | Comodoro Rivadavia | General Enrique Mosconi International Airport | SAVC | CRD | -45.786941 | -67.463355 | 189
AR | Concordia | Comodoro Pierrestegui Airport | SAAC | COC | -31.296900 | -57.996600 | 112
AR | Cordoba | Ingeniero Aeronáutico Ambrosio L.V. Taravella International Airport | SACO | COR | -31.312346 | -64.208329 | 1604
AR | Coronel Suarez | Brigadier D.H.E. Ruiz Airport | SAZC | CSZ | -37.446098 | -61.889301 | 767
AR | Corrientes | Corrientes Airport | SARC | CNQ | -27.445500 | -58.761900 | 202
AR | Curuzu Cuatia | Curuzu Cuatia Airport | SATU | UZU | -29.770600 | -57.978900 | 229
AR | Cutral-Co | Cutral-Co Airport | SAZW | CUT | -38.939701 | -69.264603 | 2132
AR | El Bolsón | El Bolsón Airfield | SAVB | EHL | -41.943199 | -71.532303 | 1141
AR | El Calafate | El Calafate - Commander Armando Tola International Airport | SAWC | FTE | -50.280267 | -72.053401 | 669
AR | El Dorado | El Dorado Airport | SATD | ELO | -26.397499 | -54.574699 | 685
AR | El Maitén | El Maitén Airport | SAVD | EMX | -42.029202 | -71.172501 | 2355
AR | El Palomar | El Palomar Airport | SADP | EPA | -34.609900 | -58.612600 | 59
AR | Esquel | Esquel Brigadier Antonio Parodi International Airport | SAVE | EQS | -42.908001 | -71.139503 | 2621
AR | Formosa | Formosa National Airport | SARF | FMA | -26.212700 | -58.228100 | 193
AR | General Pico | General Pico Airport | SAZG | GPO | -35.696201 | -63.758301 | 459
AR | General Roca | Dr. Arturo H. Illia Airport | SAHR | GNR | -39.000702 | -67.620499 | 852
AR | Gobernador Gordillo | Chamical Airport | SACT |  | -30.345303 | -66.294072 | 1502
AR | Gobernador Gregores | Gobernador Gregores Airport | SAWR | GGS | -48.783100 | -70.150002 | 356
AR | Goya | Goya Airport | SATG | OYA | -29.105800 | -59.218900 | 128
AR | Gualeguaychu | Gualeguaychu Airport | SAAG | GHU | -33.005567 | -58.612833 | 75
AR | Ingeniero Jacobacci | Ingeniero Jacobacci - Captain H R Bordón Airport | SAVJ | IGB | -41.320900 | -69.574898 | 2925
AR | Isla Martin Garcia | Isla Martin Garcia Airport | SAAK |  | -34.182100 | -58.246900 | 6
AR | La Cumbre | La Cumbre Airport | SACC | LCM | -31.005800 | -64.531898 | 3733
AR | La Plata | La Plata Airport | SADL | LPG | -34.972200 | -57.894700 | 72
AR | La Rioja | Capitan V A Almonacid Airport | SANL | IRJ | -29.381599 | -66.795799 | 1437
AR | Las Heras | Las Heras Airport | SAVH | LHS | -46.538517 | -68.965323 | 1082
AR | Las Lomitas | Alferez Armando Rodriguez Airport | SATK | LLS | -24.721399 | -60.548801 | 426
AR | Malargue | Comodoro D.R. Salomón Airport | SAMM | LGS | -35.493599 | -69.574303 | 4685
AR | Maquinchao | Maquinchao Airport | SAVQ | MQD | -41.243099 | -68.707802 | 2912
AR | Mar del Plata | Ástor Piazzola International Airport | SAZM | MDQ | -37.934200 | -57.573300 | 72
AR | Mendoza | Governor Francisco Gabrielli International Airport | SAME | MDZ | -32.831699 | -68.792900 | 2310
AR | Mercedes | Mercedes Airport | SATM | MDX | -29.221399 | -58.087799 | 358
AR | Merlo | Valle Del Conlara International Airport | SAOS | RLO | -32.384701 | -65.186501 | 2021
AR | Monte Caseros | Monte Caseros Airport | SARM | MCS | -30.271900 | -57.640200 | 170
AR | Necochea | Necochea Airport | SAZO | NEC | -38.490746 | -58.816337 | 72
AR | Neuquén | Presidente Perón International Airport | SAZN | NQN | -38.949001 | -68.155701 | 895
AR | Olavarria | Olavarria Airport | SAZF | OVR | -36.889999 | -60.216599 | 551
AR | Orán | Orán Airport | SASO | ORA | -23.152800 | -64.329201 | 1171
AR | Parana | General Urquiza Airport | SAAP | PRA | -31.794800 | -60.480400 | 242
AR | Paso de los Libres | Paso De Los Libres Airport | SARL | AOL | -29.689400 | -57.152100 | 230
AR | Pehuajó | Comodoro Pedro Zanni Airport | SAZP | PEH | -35.844600 | -61.857600 | 278
AR | Perito Moreno | Perito Moreno Jalil Hamer Airport | SAWP | PMQ | -46.537899 | -70.978699 | 1410
AR | Posadas | Libertador Gral D Jose De San Martin Airport | SARP | PSS | -27.385800 | -55.970700 | 430
AR | Presidencia Roque Sáenz Peña | Termal Airport | SARS | PRQ | -26.753611 | -60.492222 | 308
AR | Puerto Deseado | Puerto Deseado Airport | SAWD | PUD | -47.735300 | -65.904100 | 268
AR | Puerto Iguazu | Cataratas Del Iguazú International Airport | SARI | IGR | -25.737301 | -54.473400 | 916
AR | Puerto Madryn | El Tehuelche Airport | SAVY | PMY | -42.759200 | -65.102700 | 427
AR | Puerto Santa Cruz | Santa Cruz Airport | SAWU | RZA | -50.016500 | -68.579200 | 364
AR | Rafaela | Rafaela Airport | SAFR | RAF | -31.282500 | -61.501700 | 325
AR | Rawson | Almirante Marco Andres Zar Airport | SAVT | REL | -43.210500 | -65.270300 | 141
AR | Reconquista | Reconquista Airport | SATR | RCQ | -29.210278 | -59.683333 | 160
AR | Resistencia | Resistencia International Airport | SARE | RES | -27.449910 | -59.056125 | 173
AR | Rincon de los Sauces | Rincon De Los Sauces Airport | SAHS | RDS | -37.390598 | -68.904198 | 1968
AR | Rio Cuarto | Area De Material Airport | SAOC | RCU | -33.085098 | -64.261299 | 1380
AR | Rio Gallegos | Piloto Civil Norberto Fernández International Airport | SAWG | RGL | -51.608791 | -69.308948 | 61
AR | Rio Grande | Gobernador Ramón Trejo Noel International Airport | SAWE | RGA | -53.777700 | -67.749400 | 65
AR | Rio Mayo | Rio Mayo Airport | SAWM | ROY | -45.703899 | -70.245598 | 1784
AR | Rio Turbio | 28 de Noviembre Airport | SAWT | RYO | -51.605000 | -72.220300 | 909
AR | Rosario | Rosario Islas Malvinas International Airport | SAAR | ROS | -32.903600 | -60.785000 | 85
AR | Salta | Martín Miguel de Güemes International Airport | SASA | SLA | -24.856001 | -65.486198 | 4088
AR | San Antonio Oeste | Antoine de Saint Exupéry Airport | SAVN | OES | -40.751200 | -65.034300 | 85
AR | San Carlos de Bariloche | Teniente Luis Candelaria International Airport | SAZS | BRC | -41.151199 | -71.157501 | 2774
AR | San Juan | Domingo Faustino Sarmiento Airport | SANU | UAQ | -31.571501 | -68.418198 | 1958
AR | San Julian | Capitan D Daniel Vazquez Airport | SAWJ | ULA | -49.306816 | -67.802596 | 203
AR | San Luis | Brigadier Mayor D Cesar Raul Ojeda Airport | SAOU | LUQ | -33.273201 | -66.356400 | 2328
AR | San Miguel de Tucumán | Teniente Benjamín Matienzo International Airport | SANT | TUC | -26.837397 | -65.104195 | 1493
AR | San Rafael | Suboficial Ay Santiago Germano Airport | SAMR | AFA | -34.588299 | -68.403900 | 2470
AR | San Salvador de Jujuy | Gobernador Horacio Guzman International Airport | SASJ | JUJ | -24.392799 | -65.097801 | 3019
AR | Santa Fe | Sauce Viejo Airport | SAAV | SFN | -31.711700 | -60.811700 | 55
AR | Santa Rosa | Santa Rosa Airport | SAZR | RSA | -36.588299 | -64.275703 | 630
AR | Santa Teresita | Santa Teresita Airport | SAZL | SST | -36.542300 | -56.721800 | 9
AR | Santiago del Estero | Vicecomodoro Angel D. La Paz Aragonés Airport | SANE | SDE | -27.765556 | -64.309998 | 656
AR | Sarmiento | Lago Musters Airport | SAVM | OLN | -45.575200 | -69.077000 | 889
AR | Sierra Grande | Sierra Grande Airport | SAVS | SGV | -41.591702 | -65.339401 | 688
AR | Sunchales | Sunchales Aeroclub Airport | SAFS | NCJ | -30.957500 | -61.528300 | 299
AR | Tandil | Héroes de Malvinas Airport | SAZT | TDL | -37.234634 | -59.228647 | 574
AR | Tartagal | General Enrique Mosconi Airport | SAST | TTG | -22.616877 | -63.793015 | 1472
AR | Termas de Río Hondo | Termas de Río Hondo international Airport | SANR | RHD | -27.496600 | -64.935950 | 935
AR | Tres Arroyos | Tres Arroyos Airport | SAZH | OYO | -38.386900 | -60.329700 | 400
AR | Ushuaia | Ushuaia - Malvinas Argentinas International Airport | SAWH | USH | -54.843300 | -68.295800 | 102
AR | Venado Tuerto | Venado Tuerto Airport | SAFV |  | -33.681800 | -61.956400 | 367
AR | Veronica | Punta Indio Naval Air Base | SAAI |  | -35.353298 | -57.290001 | 49
AR | Viedma / Carmen de Patagones | Gobernador Castello Airport | SAVV | VDM | -40.869200 | -63.000400 | 20
AR | Villa Dolores | Villa Dolores Airport | SAOD | VDR | -31.945200 | -65.146301 | 1847
AR | Villa Gesell | Villa Gesell Airport | SAZV | VLG | -37.235400 | -57.029200 | 32
AR | Villa Maria | Presidente Néstor Kirchner Regional Airport | SAOV |  | -32.320100 | -63.226630 | 670
AR | Villa Mercedes | Villa Reynolds Airport | SAOR | VME | -33.729900 | -65.387398 | 1591
AR | Zapala | Zapala Airport | SAHZ | APZ | -38.975498 | -70.113602 | 3330
AS | Fitiuta Village | Fitiuta Airport | NSFQ | FTI | -14.216131 | -169.423771 | 110
AS | Ofu | Ofu Airport | NSAS | OFU | -14.184400 | -169.669998 | 9
AS | Pago Pago | Pago Pago International Airport | NSTU | PPG | -14.331000 | -170.710007 | 32
AT | Aigen im Ennstal | Fiala-Fernbrugg Air Base | LOXA |  | 47.535730 | 14.141488 | 2093
AT | Altlichtenwarth | Altlichtenwarth Gliderfield | LOAR |  | 48.666100 | 16.825000 | 604
AT | Bad Vöslau | Vöslau-Kottingbrunn Airfield | LOAV |  | 47.965000 | 16.260000 | 765
AT | Dobersberg | Dobersberg Airfield | LOAB |  | 48.922113 | 15.296826 | 1720
AT | Feldkirchen bei Graz | Graz Airport | LOWG | GRZ | 46.991100 | 15.439600 | 1115
AT | Feldkirchen in Kärnten | Feldkirchen Airfield | LOKF |  | 46.708930 | 14.076722 | 1706
AT | Ferlach | Ferlach-Glainach Airfield | LOKG |  | 46.532778 | 14.330833 | 1498
AT | Freistadt | Freistadt Airfield | LOLF |  | 48.513748 | 14.406579 | 2237
AT | Fürstenfeld | Fürstenfeld Airfield | LOGF |  | 47.061873 | 16.083901 | 830
AT | Göriach | Lanzen-Turnau Airfield | LOGL |  | 47.556155 | 15.320327 | 2575
AT | Hofkirchen | Hofkirchen Airfield | LOLH |  | 48.139110 | 14.335840 | 1175
AT | Hohenems | Hohenems-Dornbirn Airfield | LOIH | HOH | 47.384477 | 9.699776 | 1352
AT | Hundsheim | Spitzerberg Airfield | LOAS |  | 48.099157 | 16.933527 | 623
AT | Innsbruck | Innsbruck Airport | LOWI | INN | 47.260201 | 11.344000 | 1907
AT | Kapfenberg | Kapfenberg Airfield | LOGK |  | 47.457544 | 15.331125 | 1719
AT | Kirchheim im Innkreis | Ried-Kirchheim Airfield | LOLK |  | 48.212270 | 13.345678 | 1378
AT | Klagenfurt am Wörthersee | Klagenfurt Airport | LOWK | KLU | 46.642502 | 14.337700 | 1472
AT | Krems an der Donau | Krems/Langenlois Airfield | LOAG |  | 48.446155 | 15.635011 | 1017
AT | Laakirchen | Gmunden-Laakirchen Airfield | LOLU |  | 47.951541 | 13.867271 | 1670
AT | Langkampfen | Kufstein-Langkampfen Airfield | LOIK |  | 47.564713 | 12.127576 | 1588
AT | Lengberg | Lienz-Nikolsdorf Airfield | LOKL |  | 46.798069 | 12.878330 | 2093
AT | Linz | Linz-East Glider Field | LOLO |  | 48.300044 | 14.333606 | 827
AT | Linz | Linz-Hörsching Airport | LOWL | LNZ | 48.235362 | 14.188128 | 980
AT | Mairist | Sankt Donat / Mairist Airfield | LOKR |  | 46.743139 | 14.413134 | 1759
AT | Mariazell | Mariazell Airfield | LOGM |  | 47.789733 | 15.300333 | 2822
AT | Mauterndorf | Mauterndorf Airfield | LOSM |  | 47.131995 | 13.695867 | 3642
AT | Mayerhofen | Mayerhofen Airfield | LOKM |  | 46.974996 | 14.371228 | 2119
AT | Micheldorf | Friesach/Hirt Airfield | LOKH |  | 46.927491 | 14.431848 | 2019
AT | Micheldorf | Micheldorf Airfield | LOLM |  | 47.871669 | 14.125149 | 1509
AT | Niederöblarn | Niederöblarn Airfield | LOGO |  | 47.478742 | 14.007101 | 2142
AT | Nötsch im Gailtal | Nötsch im Gailtal Airfield | LOKN |  | 46.581100 | 13.629200 | 1801
AT | Ober-Grafendorf | Völtendorf Airfield | LOAD |  | 48.160081 | 15.586770 | 1063
AT | Ottenschlag | Ottenschlag Airfield | LOAA |  | 48.418560 | 15.215294 | 2867
AT | Pinkafeld | Pinkafeld Airfield | LOGP |  | 47.386684 | 16.112673 | 1339
AT | Punitz | Punitz-Güssing Airfield | LOGG |  | 47.146654 | 16.317058 | 950
AT | Pupping | Eferding Airfield | LOLE |  | 48.338793 | 13.985209 | 887
AT | Reutte | Reutte-Höfen Airfield | LOIR |  | 47.470897 | 10.691300 | 2806
AT | Salzburg | Salzburg Airport | LOWS | SZG | 47.793301 | 13.004300 | 1411
AT | Sankt Georgen am Ybbsfelde | Sankt Georgen-Ybbsfeld Airfield | LOLG |  | 48.103320 | 14.951091 | 827
AT | Sankt Johann in Tirol | Sankt Johann Airfield | LOIJ |  | 47.520100 | 12.449700 | 2198
AT | Scharnstein | Scharnstein Airfield | LOLC |  | 47.898602 | 13.939400 | 1742
AT | Seitenstetten | Flugplatz Seitenstetten | LOLT |  | 48.050556 | 14.661944 | 1050
AT | Stockerau | Stockerau Airfield | LOAU |  | 48.409121 | 16.191015 | 686
AT | Suben | Schärding-Suben Airfield | LOLS |  | 48.403301 | 13.448300 | 1070
AT | Timmersdorf | Leoben/Timmersdorf Airfield | LOGT |  | 47.379648 | 14.964044 | 2060
AT | Tulln an der Donau | Brumowski Air Base | LOXT |  | 48.319247 | 16.114016 | 574
AT | Vienna | Vienna International Airport | LOWW | VIE | 48.110298 | 16.569700 | 600
AT | Weiz | Weiz-Unterfladnitz Airfield | LOGW |  | 47.170293 | 15.664468 | 1296
AT | Wels | Wels Airfield | LOLW |  | 48.182513 | 14.039283 | 1043
AT | Wiener Neustadt | Wiener Neustadt East Airport | LOAN |  | 47.843300 | 16.260099 | 896
AT | Wiener Neustadt | Wiener Neustadt West Airport | LOXN |  | 47.836933 | 16.221838 | 935
AT | Wolfsberg | Wolfsberg Airfield | LOKW |  | 46.818202 | 14.825154 | 1460
AT | Zell am See | Zell am See Airfield | LOWZ |  | 47.291468 | 12.790632 | 2470
AT | Zeltweg | Hinterstoisser Air Base | LOXZ |  | 47.202801 | 14.744200 | 2264
AU |  | Adels Grove Airport | YALG |  | -18.694729 | 138.527727 | 0
AU |  | Alexandria Homestead Airport | YALX | AXL | -19.060200 | 136.710007 | 0
AU |  | Amata Airport | YAMT | AMT | -26.097363 | 131.202732 | 695
AU |  | Anna Creek Airport | YANK |  | -28.896780 | 136.170795 | 300
AU |  | Aramac Airport | YAMC | AXC | -22.957880 | 145.249504 | 232
AU |  | Ardrossan Airport | YARS |  | -34.447189 | 137.888292 | 92
AU |  | Argyle Airport | YARG | GYL | -16.636944 | 128.451389 | 522
AU |  | Arkaroola Airport | YARK |  | -30.406700 | 139.345993 | 783
AU |  | Augustus Downs Airport | YAGD | AUD | -18.508700 | 139.882084 | 46
AU |  | Balcanoona Airport | YBLC | LCN | -30.535000 | 139.337006 | 144
AU |  | Ballarat Airport | YBLT |  | -37.511700 | 143.791000 | 1433
AU |  | Ballera Airport | YLLE | BBL | -27.405633 | 141.809458 | 385
AU |  | Ballidu Airport | YBIU |  | -30.592693 | 116.779288 | 995
AU |  | Balranald Airport | YBRN | BZD | -34.624834 | 143.577114 | 210
AU |  | Baradine Airport | YBAD |  | -30.955246 | 149.091984 | 998
AU |  | Barimunya Airport | YBRY | BYP | -22.673889 | 119.166111 | 2082
AU |  | Barkly Downs Airport | YBAW | BKP | -20.495833 | 138.474722 | 810
AU |  | Barrow Island Airport | YBWX | BWB | -20.864444 | 115.406111 | 26
AU |  | Bedford Downs Airport | YBDF | BDW | -17.286699 | 127.462997 | 1750
AU |  | Beefwood HLS | YBFW |  | -23.311725 | 148.485371 | 855
AU |  | Bendigo Airport | YBDG | BXG | -36.739399 | 144.330002 | 705
AU |  | Betoota Airport | YBEO | BTX | -25.694791 | 140.738339 | 91
AU |  | Beverley Airport | YBEE |  | -30.190595 | 139.555320 | 116
AU |  | Birchip Airport | YBIR |  | -35.999699 | 142.917007 | 340
AU |  | Birdsville Airport | YBDV | BVI | -25.897499 | 139.348007 | 159
AU |  | Blackwater Airport | YBTR | BLT | -23.603100 | 148.807007 | 657
AU |  | Bollon Airport | YBLL | BLS | -28.051247 | 147.481799 | 182
AU |  | Bombala Airport | YBOM |  | -36.904999 | 149.182007 | 2415
AU |  | Booleroo Centre Airport | YBOC |  | -32.889890 | 138.366382 | 418
AU |  | Boolgeeda | YBGD | OCM | -22.541111 | 117.269444 | 1871
AU |  | Boomi Airport | YBMI |  | -28.728373 | 149.595181 | 618
AU |  | Boonah Airport | YBOA |  | -28.017922 | 152.675857 | 318
AU |  | Borroloola Airport | YBRL | BOX | -16.075300 | 136.302002 | 55
AU |  | Boulia Airport | YBOU | BQL | -22.913300 | 139.899994 | 542
AU |  | Bourke Airport | YBKE | BRK | -30.039200 | 145.951996 | 352
AU |  | Brampton Island Airport | YBPI | BMP | -20.804633 | 149.279931 | 11
AU |  | Brewarrina Airport | YBRW | BWQ | -29.975792 | 146.814380 | 414
AU |  | Bunbury Airport | YBUN | BUY | -33.378056 | 115.676944 | 53
AU |  | Burketown Airport | YBKT | BUC | -17.748600 | 139.533997 | 21
AU |  | Caiguna Airport | YCAG | CGV | -32.280457 | 125.477943 | 87
AU |  | Camfield Airport | YCFD | CFI | -17.021700 | 131.326996 | 0
AU |  | Camooweal Airport | YCMW | CML | -19.911699 | 138.125000 | 241
AU |  | Camp Nifty Airport | YCNF | NIF | -21.671700 | 121.586998 | 295
AU |  | Casino Airport | YCAS | CSI | -28.881304 | 153.060724 | 86
AU |  | Ceduna Airport | YCDU | CED | -32.130600 | 133.710007 | 77
AU |  | Cessnock Airport | YCNK | CES | -32.787498 | 151.341995 | 210
AU |  | Charters Towers Airport | YCHT | CXT | -20.043100 | 146.272995 | 955
AU |  | Clermont Airport | YCMT | CMQ | -22.773100 | 147.621002 | 908
AU |  | Cleve Airport | YCEE | CVC | -33.709702 | 136.505005 | 589
AU |  | Cluny Airport | YUNY | CZY | -24.516701 | 139.617004 | 90
AU |  | Cobar Airport | YCBA | CAZ | -31.538300 | 145.794006 | 724
AU |  | Coconut Island Airport | YCCT | CNC | -10.050139 | 143.070007 | 3
AU |  | Collarenebri Airport | YCBR | CRB | -29.523239 | 148.578243 | 152
AU |  | Collinsville Airport | YCSV | KCE | -20.596701 | 147.860001 | 180
AU |  | Condobolin Airport | YCDO | CBX | -33.065650 | 147.213160 | 650
AU |  | Cooinda Airport | YCOO | CDA | -12.903300 | 132.531998 | 13
AU |  | Cooktown Airport | YCKN | CTN | -15.443649 | 145.183221 | 26
AU |  | Coolah Airport | YCAH | CLH | -31.773864 | 149.615322 | 504
AU |  | Coonabarabran Airport | YCBB | COJ | -31.332500 | 149.266998 | 2117
AU |  | Coonamble Airport | YCNM | CNB | -30.980946 | 148.377833 | 604
AU |  | Cootamundra Airport | YCTM | CMD | -34.624283 | 148.036641 | 1110
AU |  | Corowa Airport | YCOR | CWW | -35.994701 | 146.356995 | 469
AU |  | Corryong Airport | YCRG | CYG | -36.182800 | 147.888000 | 963
AU |  | Cowarie Airport | YCWI | CWR | -27.711700 | 138.328003 | 52
AU |  | Cowell Airport | YCWL | CCW | -33.666698 | 136.891998 | 39
AU |  | Cowra Airport | YCWR | CWT | -33.846894 | 148.648007 | 966
AU |  | Croker Island Airport | YCKI | CKI | -11.165000 | 132.483002 | 16
AU |  | Croydon Airport | YCRY | CDQ | -18.225000 | 142.257996 | 107
AU |  | Cudal Airport | YCUA | CUG | -33.278026 | 148.768708 | 491
AU |  | Cue Airport | YCUE | CUY | -27.450663 | 117.917703 | 442
AU |  | Cunnamulla Airport | YCMU | CMA | -28.030001 | 145.621994 | 630
AU |  | Dalby Airport | YDAY | DBY | -27.158476 | 151.263428 | 1137
AU |  | Dalgaranga Gold Mine Airport | YDGA | DGD | -27.829722 | 117.316389 | 1459
AU |  | Davenport Downs Airport | YDPD | DVP | -24.150000 | 141.108002 | 95
AU |  | Delissaville Airport | YDLV | DLV | -12.550000 | 130.684998 | 34
AU |  | Delta Downs Airport | YDLT | DDN | -16.991699 | 141.317001 | 15
AU |  | Dirranbandi Airport | YDBI | DRN | -28.587912 | 148.217161 | 567
AU |  | Doomadgee Airport | YDMG | DMD | -17.940300 | 138.822006 | 153
AU |  | Durham Downs Airport | YDRH | DHD | -27.075001 | 141.899994 | 116
AU |  | Durrie Airport | YDRI | DRR | -25.684999 | 140.227997 | 58
AU |  | Dysart Airport | YDYS | DYA | -22.622200 | 148.363998 | 670
AU |  | Echuca Airport | YECH | ECH | -36.157200 | 144.761993 | 323
AU |  | Ernabella Airport | YERN | ERB | -26.263300 | 132.182007 | 707
AU |  | Eucla Airport | YECL | EUC | -31.707084 | 128.877243 | 22
AU |  | Evans Head Aerodrome | YEVD | EVH | -29.101786 | 153.419255 | 20
AU |  | Finley Airport | YFIL | FLY | -35.658918 | 145.561214 | 380
AU |  | Fitzroy Crossing Airport | YFTZ | FIZ | -18.183596 | 125.559783 | 368
AU |  | Flora Valley Airport | YFLO | FVL | -18.297844 | 128.455897 | 0
AU |  | Forrest Airport | YFRT | FOS | -30.836620 | 128.112811 | 511
AU |  | Forster (Wallis Is) Airport | YFST | FOT | -32.202489 | 152.481136 | 4
AU |  | Glengyle Airport | YGLE | GLG | -24.808300 | 139.600006 | 91
AU |  | Glenormiston Airport | YGLO | GLM | -22.888300 | 138.824997 | 158
AU |  | Goondiwindi Airport | YGDI | GOO | -28.521400 | 150.320007 | 714
AU |  | Goulburn Airport | YGLB | GUL | -34.810299 | 149.725998 | 2141
AU |  | Greenvale Airport | YGNV | GVP | -18.996600 | 145.013600 | 0
AU |  | Gregory Downs Airport | YGDS | GGD | -18.625000 | 139.233002 | 52
AU |  | Gundaroo Airport | YGDO |  | -35.050500 | 149.255900 | 1860
AU |  | Gunnedah Airport | YGDH | GUH | -30.957511 | 150.248981 | 863
AU |  | Gympie Airport | YGYM | GYP | -26.290149 | 152.702998 | 260
AU |  | Halls Creek Airport | YHLC | HCQ | -18.233900 | 127.669998 | 1346
AU |  | Hamilton Airport | YHML | HLT | -37.648899 | 142.065002 | 803
AU |  | Hay Airport | YHAY | HXX | -34.531399 | 144.830002 | 305
AU |  | Headingly Airport | YHDY | HIP | -21.333300 | 138.283005 | 0
AU |  | Hopetoun Airport | YHPN | HTU | -35.715302 | 142.360001 | 256
AU |  | Horsham Airport | YHSM | HSM | -36.669701 | 142.173004 | 445
AU |  | Humbert River Airport | YHBR | HUB | -16.489670 | 130.630280 | 0
AU |  | Iffley Airport | YIFY | IFF | -18.900000 | 141.216995 | 43
AU |  | Ingham Airport | YIGM | IGH | -18.664149 | 146.145804 | 49
AU |  | Innamincka Airport | YINN | INM | -27.697589 | 140.739498 | 54
AU |  | Innisfail Airport | YIFL | IFL | -17.559401 | 146.011993 | 46
AU |  | Isisford Airport | YISF | ISI | -24.258301 | 144.425003 | 694
AU |  | Jabiru Airport | YJAB | JAB | -12.658056 | 132.894638 | 85
AU |  | Jerilderie Airport | YJER |  | -35.373032 | 145.723152 | 110
AU |  | Jervois Airport | YJVS |  | -22.913300 | 136.119995 | 331
AU |  | Julia Creek Airport | YJLC | JCK | -20.668301 | 141.723007 | 404
AU |  | Jundee Airport | YJUN |  | -26.421700 | 120.577003 | 562
AU |  | Kalkgurung Airport | YKKG | KFG | -17.431900 | 130.807999 | 646
AU |  | Kamileroi Airport | YKML | KML | -19.375000 | 140.057007 | 91
AU |  | Karumba Airport | YKMB | KRB | -17.456699 | 140.830002 | 5
AU |  | Katanning Airport | YKNG | KNI | -33.699423 | 117.657030 | 0
AU |  | Katoomba Airport | YKAT |  | -33.667818 | 150.322741 | 1000
AU |  | Kempsey Airport | YKMP | KPS | -31.072320 | 152.765313 | 54
AU |  | Kerang Airport | YKER | KRA | -35.751400 | 143.938995 | 254
AU |  | King Island Airport | YKII | KNS | -39.877499 | 143.878006 | 132
AU |  | Kingaroy Airport | YKRY | KGY | -26.581077 | 151.839927 | 1492
AU |  | Kingscote Airport | YKSC | KGC | -35.713902 | 137.520996 | 24
AU |  | Lake Evella Airport | YLEV | LEL | -12.498900 | 135.806000 | 256
AU |  | Laura Airport | YLRA | LUU | -15.560495 | 144.451418 | 627
AU |  | Lawn Hill Airport | YLAH | LWH | -18.574530 | 138.586106 | 122
AU |  | Leigh Creek Airport | YLEC | LGH | -30.598301 | 138.425995 | 856
AU |  | Leinster Airport | YLST | LER | -27.843300 | 120.703003 | 1631
AU |  | Lightning Ridge Airport | YLRD | LHG | -29.452857 | 147.977146 | 540
AU |  | Lizard Island Airport | YLZI | LZR | -14.673273 | 145.454571 | 70
AU |  | Lorraine Airport | YLOR | LOA | -18.993299 | 139.906998 | 61
AU |  | Macdonald Downs Airport | YMDS | MNW | -22.444000 | 135.199005 | 0
AU |  | Maitland Airport | YMND | MTL | -32.701265 | 151.492912 | 85
AU |  | Mallacoota Airport | YMCO | XMC | -37.598301 | 149.720001 | 31
AU |  | Manjimup Airport | YMJM | MJP | -34.265301 | 116.139999 | 940
AU |  | Manners Creek Airport | YMCR | MFP | -22.100000 | 137.983002 | 0
AU |  | Marble Bar Airport | YMBL | MBB | -21.163300 | 119.833000 | 194
AU |  | Margaret River (Station) Airport | YMGR | MGV | -18.621700 | 126.883003 | 289
AU |  | Margaret River Airport | YMGT | MQZ | -33.930599 | 115.099998 | 374
AU |  | Marree Airport | YMRE | RRE | -29.663300 | 138.065002 | 50
AU |  | Meekatharra Airport | YMEK | MKR | -26.611700 | 118.547997 | 1713
AU |  | Merty Merty Airport | YMYT | RTY | -28.582713 | 140.303264 | 0
AU |  | Middlemount Airport | YMMU | MMM | -22.801444 | 148.706796 | 547
AU |  | Miles Airport | YMLS | WLE | -26.806447 | 150.168953 | 304
AU |  | Millicent Airport | YMCT | MLR | -37.583599 | 140.365997 | 56
AU |  | Minlaton Airport | YMIN | XML | -34.743801 | 137.529087 | 0
AU |  | Minnipa Airport | YMPA | MIN | -32.843300 | 135.145004 | 155
AU |  | Mitchell Airport | YMIT | MTQ | -26.483299 | 147.936996 | 1144
AU |  | Monkira Airport | YMNK | ONR | -24.816700 | 140.533005 | 107
AU |  | Monto Airport | YMTO | MNQ | -24.892267 | 151.101787 | 757
AU |  | Mooraberree Airport | YMOO | OOR | -25.250000 | 140.983002 | 85
AU |  | Morawa Airport | YMRW | MWB | -29.201700 | 116.022003 | 270
AU |  | Morney Airport | YMNY | OXY | -25.358299 | 141.432999 | 104
AU |  | Mornington Island Airport | YMTI | ONG | -16.662500 | 139.177994 | 33
AU |  | Mount Keith Airport | YMNE | WME | -27.287330 | 120.554937 | 1792
AU |  | Mount Magnet Airport | YMOG | MMG | -28.116100 | 117.842003 | 1354
AU |  | Mount Sanford Station Airport | YMSF | MTD | -16.978300 | 130.554993 | 231
AU |  | Mount Swan Airport | YMNS | MSF | -22.624696 | 135.034512 | 1641
AU |  | Mulga Park Airport | YMUP | MUP | -25.860001 | 131.649994 | 0
AU |  | Mullewa Airport | YMWA | MXU | -28.475000 | 115.516998 | 290
AU |  | Muttaburra Airport | YMTB | UTB | -22.583300 | 144.533005 | 230
AU |  | Myroodan Station Airport | YMYR | MYO | -18.123996 | 124.270261 | 0
AU |  | Nackeroo Airfield | YNKR |  | -15.578026 | 130.475993 | 0
AU |  | Nappa Merrie Airport | YNAP | NMR | -27.549201 | 141.158416 | 55
AU |  | Naracoorte Airport | YNRC | NAC | -36.985298 | 140.725006 | 169
AU |  | Noosa Airport | YNSH | NSV | -26.423177 | 153.064935 | 1
AU |  | Nullabor Motel Airport | YNUB | NUR | -31.441700 | 130.901993 | 67
AU |  | Nullagine Airport | YNUL | NLL | -21.913300 | 120.197998 | 381
AU |  | Numbulwar Airport | YNUM | NUB | -14.271700 | 135.716995 | 31
AU |  | Nyngan Airport | YNYN | NYN | -31.550645 | 147.202973 | 569
AU |  | Oakey Army Aviation Centre | YBOK | OKY | -27.409262 | 151.736727 | 1335
AU |  | Oenpelli Airport | YOEN | OPI | -12.325000 | 133.005997 | 30
AU |  | Onslow Airport | YOLW | ONS | -21.670161 | 115.114902 | 7
AU |  | Oodnadatta Airport | YOOD | ODD | -27.562473 | 135.442946 | 118
AU |  | Orbost Airport | YORB | RBS | -37.790001 | 148.610001 | 28
AU |  | Osborne Mine Airport | YOSB | OSO | -22.081699 | 140.554993 | 285
AU |  | Palm Island Airport | YPAM | PMK | -18.755301 | 146.580994 | 28
AU |  | Pandie Pandie Airport | YPDI | PDE | -26.122248 | 139.403501 | 0
AU |  | Porepunkah Airport | YPOK | MBF | -36.717731 | 146.890039 | 935
AU |  | Port Augusta Airport | YPAG | PUG | -32.506901 | 137.716995 | 56
AU |  | Port Pirie Airport | YPIR | PPI | -33.238899 | 137.994995 | 40
AU |  | Portland Airport | YPOD | PTJ | -38.318100 | 141.470993 | 265
AU |  | Queenstown Airport | YQNS | UEE | -42.075731 | 145.530088 | 867
AU |  | Quilpie Airport | YQLP | ULP | -26.609176 | 144.253746 | 655
AU |  | Quirindi Airport | YQDI | UIR | -31.498177 | 150.521708 | 1054
AU |  | Quorn Airport | YQRN |  | -32.325029 | 138.105542 | 293
AU |  | RAAF Base Amberley | YAMB |  | -27.635381 | 152.711223 | 91
AU |  | Ramingining Airport | YRNG | RAM | -12.356400 | 134.897995 | 206
AU |  | Ravensthorpe Airport | YNRV | RVT | -33.797199 | 120.208000 | 197
AU |  | Renmark Airport | YREN | RMK | -34.196400 | 140.673996 | 115
AU |  | Richmond Airport | YRMD | RCM | -20.701900 | 143.115005 | 676
AU |  | Robinhood Airport | YROB | ROH | -18.844999 | 143.710007 | 460
AU |  | Roseberth Airport | YRSB | RSB | -25.825737 | 139.627476 | 55
AU |  | Rottnest Island Airport | YRTI | RTS | -32.006699 | 115.540001 | 12
AU |  | Roy Hill Station Airport | YRYH | RHL | -22.625816 | 119.959030 | 0
AU |  | Scone Airport | YSCO | NSO | -32.038012 | 150.831966 | 745
AU |  | Serpentine Airport | YSEN |  | -32.394966 | 115.870987 | 9
AU |  | Shepparton Airport | YSHT | SHT | -36.428341 | 145.391473 | 374
AU |  | Smith Point Airport | YSMP | SHU | -11.133566 | 132.159570 | 0
AU |  | Smithton Airport | YSMI | SIO | -40.834999 | 145.084000 | 31
AU |  | South Galway Airport | YSGW | ZGL | -25.674640 | 142.089171 | 116
AU |  | South Goulburn Is Airport | YGBI | GBL | -11.650000 | 133.382004 | 19
AU |  | Southern Cross Airport | YSCR | SQC | -31.240000 | 119.360001 | 354
AU |  | Southport Airport | YSPT | SHQ | -27.921848 | 153.371469 | 2
AU |  | Spring Creek Airport | YSPK | SCG | -18.637704 | 144.545672 | 0
AU |  | Springvale Airport | YSPV | KSV | -23.549999 | 140.699997 | 0
AU |  | St George Airport | YSGE | SGO | -28.049700 | 148.595001 | 656
AU |  | St Helens Airport | YSTH | HLS | -41.336700 | 148.281998 | 48
AU |  | Stanthorpe Airport | YSPE | SNH | -28.620113 | 151.983281 | 2938
AU |  | Stawell Airport | YSWL | SWC | -37.071701 | 142.740997 | 807
AU |  | Strahan Airport | YSRN | SRN | -42.154999 | 145.292007 | 20
AU |  | Streaky Bay Airport | YKBY | KBY | -32.836621 | 134.292991 | 69
AU |  | Swan Hill Airport | YSWH | SWH | -35.375801 | 143.533005 | 234
AU |  | Tableland Homestead Airport | YTAB | TBL | -17.283300 | 126.900002 | 0
AU |  | Tangalooma Airport | YTGA | TAN | -27.137693 | 153.364141 | 0
AU |  | Tara Airport | YTAA | XTR | -27.163054 | 150.476423 | 360
AU |  | Taroom Airport | YTAM | XTO | -25.801701 | 149.899994 | 240
AU |  | Telfer Airport | YTEF | TEF | -21.715000 | 122.228996 | 970
AU |  | Theodore Airport | YTDR | TDR | -24.986796 | 150.093076 | 171
AU |  | Thylungra Airport | YTHY | TYG | -26.093047 | 143.451360 | 165
AU |  | Tibooburra Airport | YTIB | TYB | -29.451099 | 142.057999 | 584
AU |  | Timber Creek Airport | YTBR | TBK | -15.620000 | 130.445007 | 16
AU |  | Tindal Airport | YPTN | KTR | -14.521100 | 132.378006 | 443
AU |  | Tocumwal Airport | YTOC | TCW | -35.811699 | 145.608002 | 372
AU |  | Vanrook Station Airport | YVRS | VNR | -16.961532 | 141.952270 | 43
AU |  | Walcha Airport | YWCH | WLC | -31.009492 | 151.547442 | 0
AU |  | Walgett Airport | YWLG | WGE | -30.032801 | 148.126007 | 439
AU |  | Warracknabeal Airport | YWKB | WKB | -36.321098 | 142.419006 | 397
AU |  | Warrawagine Airport | YWWG | WRW | -20.844200 | 120.702003 | 0
AU |  | Warrnambool Airport | YWBL | WMB | -38.295300 | 142.447006 | 242
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
