bnepethomas/bne-arduino-flight-simulator-interfaces/A10/A10 Hardware Test Sketches/Image2LCD settings.PNG

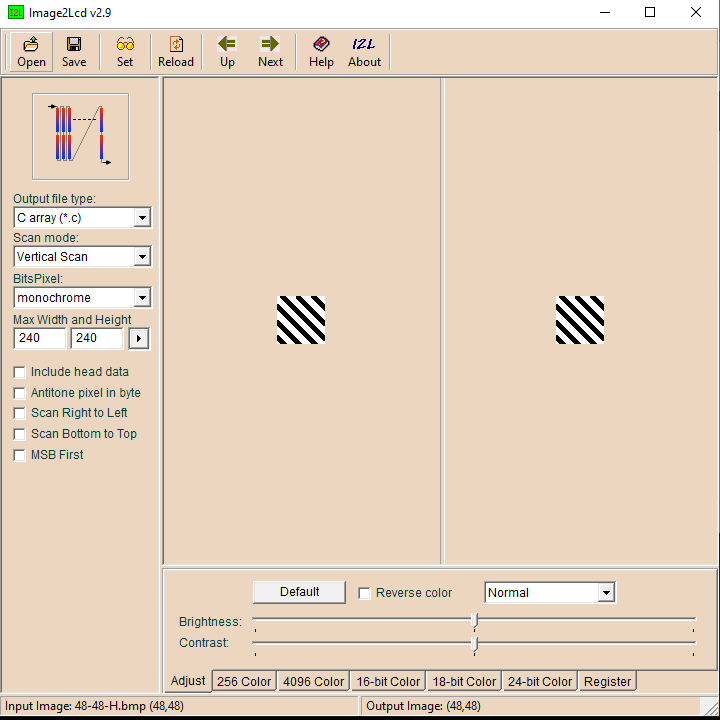
A10/A10 Hardware Test Sketches/Image2LCD settings.PNG
