bnepethomas/bne-arduino-flight-simulator-interfaces/Jet Ranger/Jet Ranger Documentation/DocBuild/diagrams/png/ss_stepper_vsi_tester_full.png

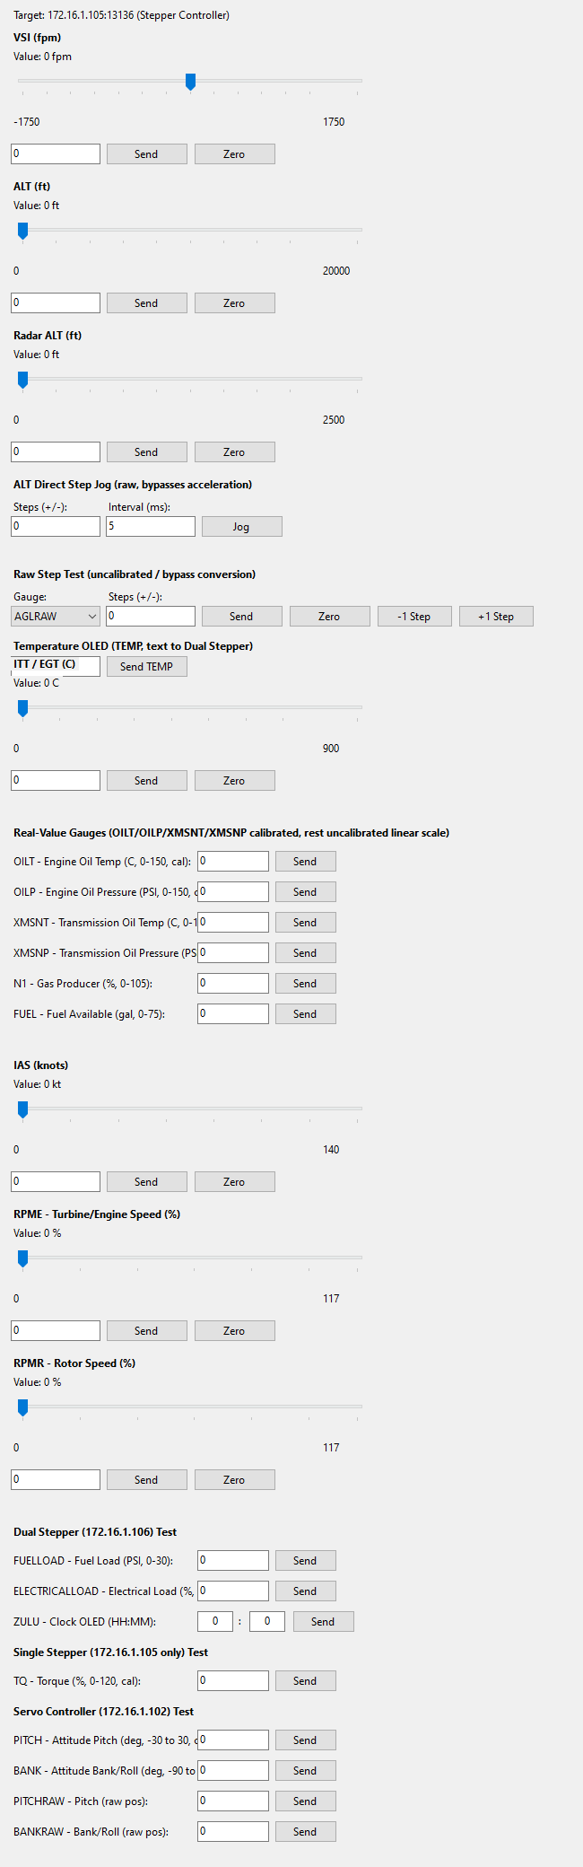
Jet Ranger/Jet Ranger Documentation/DocBuild/diagrams/png/ss_stepper_vsi_tester_full.png
