bnepethomas/bne-arduino-flight-simulator-interfaces/Jet Ranger/Jet Ranger Documentation/DocBuild/diagrams/png/ss_swing_tester.png

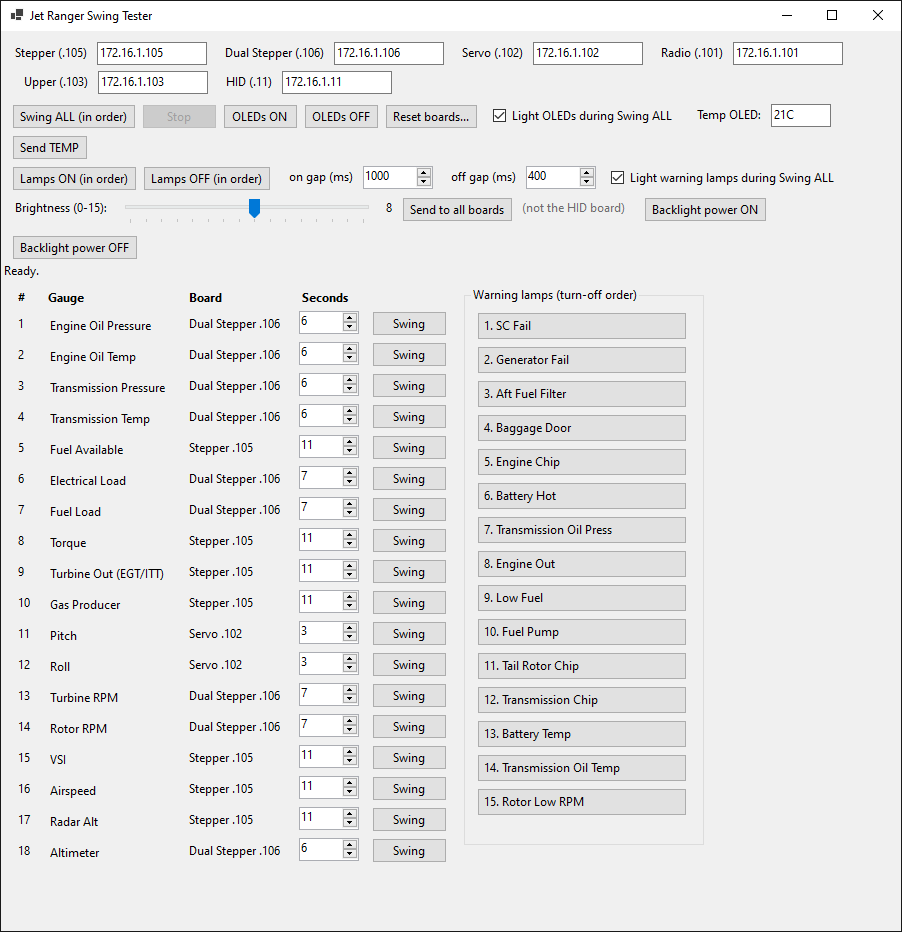
Jet Ranger/Jet Ranger Documentation/DocBuild/diagrams/png/ss_swing_tester.png
