bnepethomas/bne-arduino-flight-simulator-interfaces/Jet Ranger/Jet Ranger Documentation/DocBuild/screenshots/stepper_vsi_tester.png

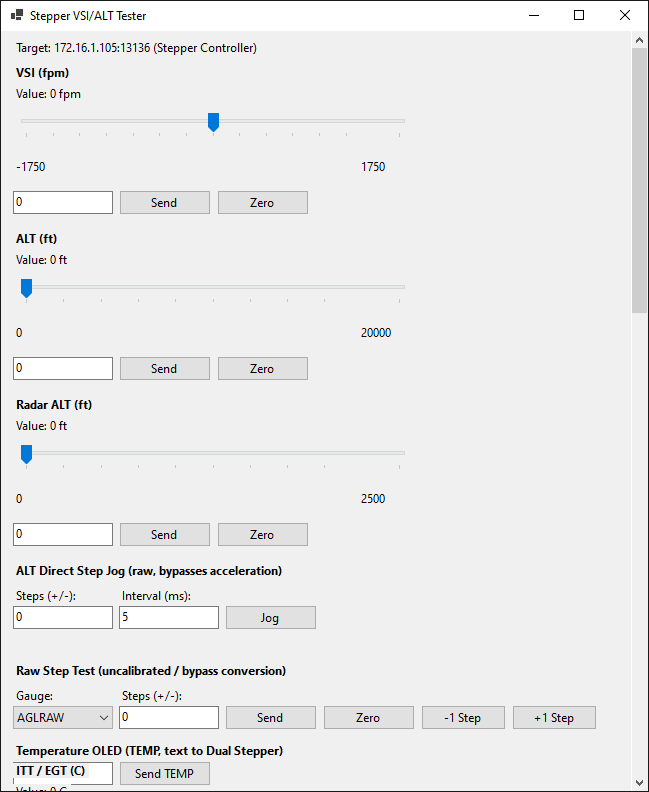
Jet Ranger/Jet Ranger Documentation/DocBuild/screenshots/stepper_vsi_tester.png
