bnepethomas/bne-arduino-flight-simulator-interfaces/Jet Ranger/PCBs/Experimental/Jet Ranger MAX7219 Radio Test/MATRIX.png

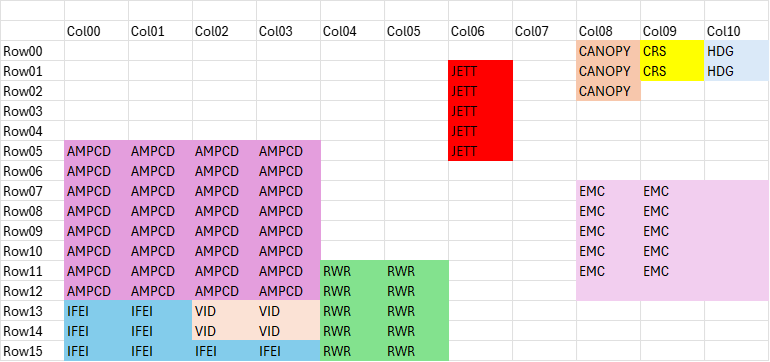
Jet Ranger/PCBs/Experimental/Jet Ranger MAX7219 Radio Test/MATRIX.png
