bnepethomas/bne-arduino-flight-simulator-interfaces/Jet Ranger/PCBs/Jet Ranger OLED Dual Stepper/Jet Ranger Servo Changes.txt

Jet Ranger Servo Changes

20251212	Original Build

20260111	Corrected Servo Pin - was +5V In GND -> IN +5V GND
		Aunniciator connectors had isolated 12V bus - merged to +12v-IN
		General tidy up of board layout V1.2
		Ordered V1.2
