bnepethomas/bne-arduino-flight-simulator-interfaces/(threads)

Thread 1 (2021-10-18):

Info wanted

edwardker, 2021-10-18:
Hi,
Spectacular project you have got running here.
I am an noob and I am trying to build an OpenHornet cockpit.
I am starting with the DDI/AMPCD. I am trying to order the necessary items but some things are unclear to mee (noob alert!!!!).
For the DDI there are resistors needed with a value of 330 and 150. But I can order 330K and 330R values. Wich do I need?

You also mention a "Modular DDI", but I am having a hard time finding the PCB for a modular DDI/AMPCD.
Could you point me in the right direction?

Thank you very much
Kind regards, Edward

bnepethomas, 2022-06-06:
question answered

Closed 2022-06-06.

Thread 2 (2023-07-16):

Pull up resistors on SARI stepper drivers

bnepethomas, 2023-07-16:
To protect steppers should the Arduino not start correctly. Probably 4.7K - Ben is validating

Closed 2023-09-16.

Thread 3 (2023-07-16):

Correct Silk Screen on SARI PCB

bnepethomas, 2023-07-16:
One for Ben

Closed 2023-09-16.

Thread 4 (2023-07-16):

5V on Ethernet interface

bnepethomas, 2023-07-16:
Check it is no longer a separate 5V rail.

bnepethomas, 2023-09-16:
Beleive this should be 3V3 rail not 5V rail

Closed 2023-09-16.

Thread 6 (2023-07-29):

LED BACK LIGHT - data line incomplete / line duplicated

Ben-F111, 2023-07-29:
was noticed in final testing that the data line is incomplete and duplicated

correction required

KI CAD

SARI STANDBY_ETHERNET

J10 - PIN 14 change assignment from LED_DATA_IN to LED_DATA_LOOP_3

PCB corrected manual and tested ok

Closed 2023-09-16.

Thread 7 (2023-09-16):

Change SARI Mosfet

bnepethomas, 2023-09-16:
Change form P to N Channel - add input curren limiting resistor - 220 ohm and pull down to ensure the coil is not energised if the Mega is not active.

Closed 2023-09-16.

Thread 8 (2023-09-24):

Missing Tracks between Ethernet Module and Mega

bnepethomas, 2023-09-24:
Issue that may be associated with using a drawing heirarchy -
The following pins are not connected after routing
ES1_RST - B5  - D53
MISO          B6  - D51
SS               A5 - D10
SCLK          A4 - D52
MOSI          A3 - D50

Looks like issue is due to not using Global Net Labels for child drawings

bnepethomas, 2023-10-24:
Add global net for power

bnepethomas, 2024-08-10:
Global Labels needed

Closed 2024-08-10.

Thread 11 (2024-08-10):

add second IIC interface for UHF radio

bnepethomas, 2024-08-10:
currently missing connection for primary radio channel
