bnepethomas/bne-arduino-flight-simulator-interfaces/Compass Clock/20091120013606VID60-02.pdf

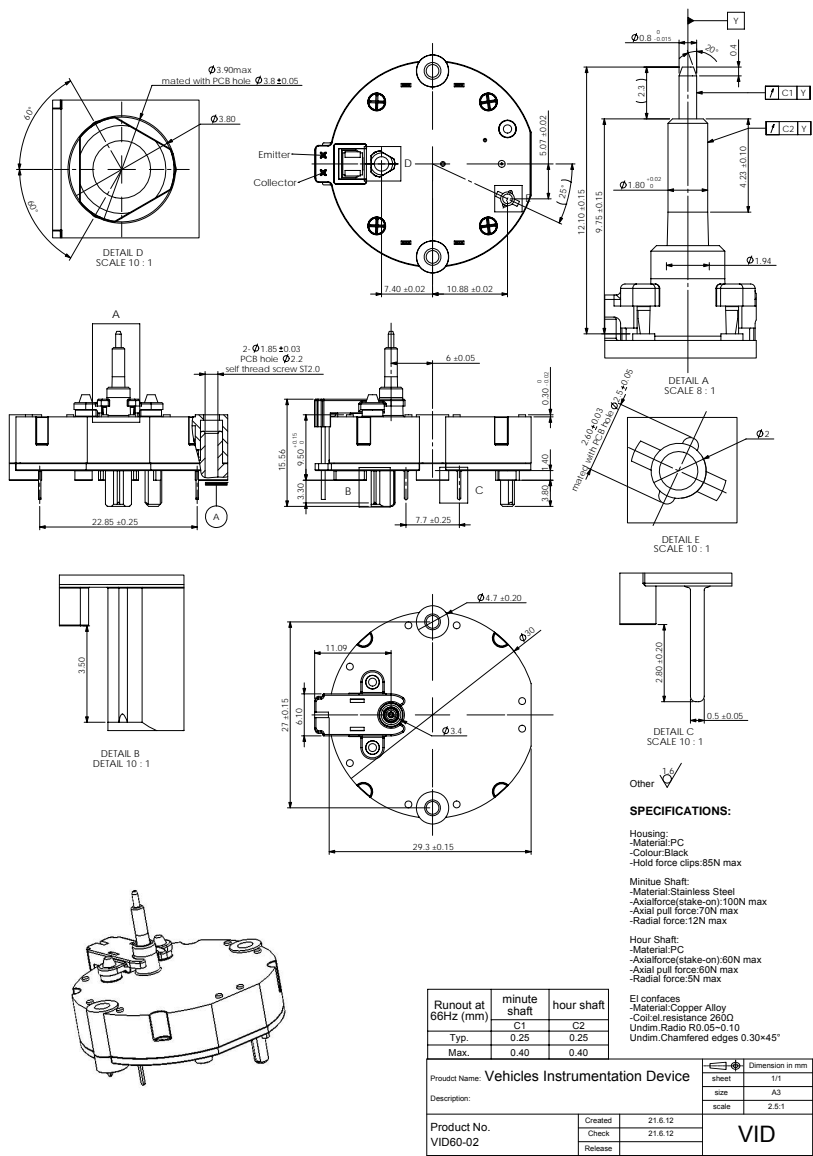
[picture p451: page 1]
3.90max; Other; SPECIFICATIONS:; Emitter; Collector; DETAIL A SCALE 8 : 1; DETAIL B DETAIL 10 : 1; DETAIL C SCALE 10 : 1; DETAIL D SCALE 10 : 1; DETAIL E SCALE 10 : 1; mated; with; PCB hole 2.5

mated with PCB hole 3.8 0.05

PCB hoie 2.2
self thread screw ST2.0

Housing:
-Material:PC
-Colour:Black
-Hold force clips:85N max
Minitue Shaft:
-Material:Stainless Steel
-Axialforce(stake-on):100N max
-Axial pull force:70N max
-Radial force:12N max
Hour Shaft:
-Axialforce(stake-on):60N max
-Axial pull force:60N max
-Radial force:5N max
El confaces
-Material:Copper Alloy
-Coil:el.resistance 260Ω
Undim.Radio R0.05~0.10
Undim.Chamfered edges 0.30×45°

Runout at 66Hz (mm) | minute shaft | hour shaft

Typ. | 0.25 | 0.25
Max. | 0.40 | 0.40
Vehicles Instrumentation Device Proudct Name: Description: | | Dimension in mm

sheet | 1/1
size | A3
scale | 2.5:1

Product No. VID60-02 | Created | | VID ²¹.6.12

Check | 21.6.12
Release
