bnepethomas/bne-arduino-flight-simulator-interfaces/Fuel Panel/20090905105401VID29.pdf

B

C

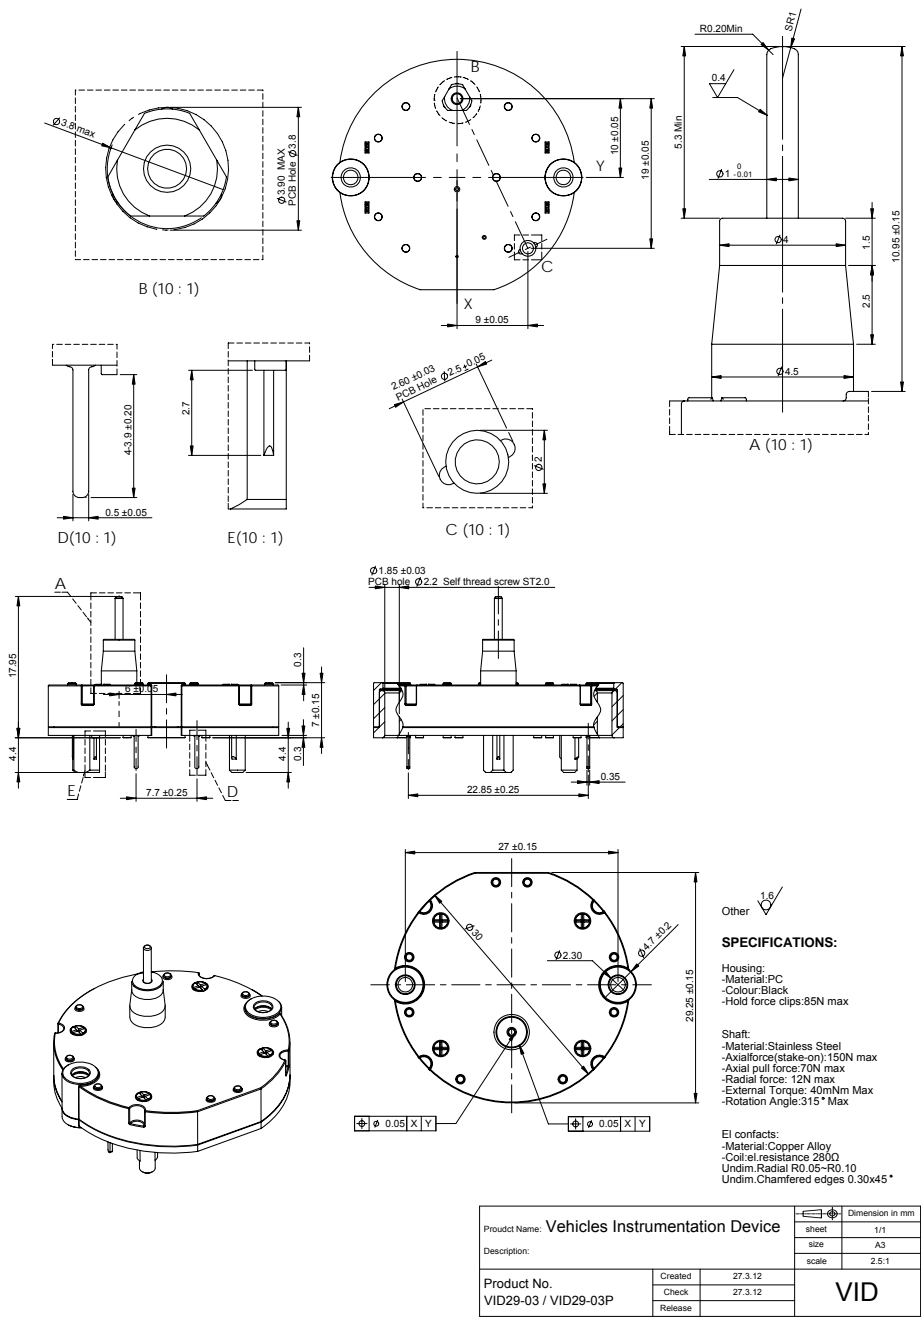
[picture p452: page 1]
3.90 MAX; PCB Hole 3.8; 5.3 Min; 3.8 max; PCB Hole 2.5 0.05; SPECIFICATIONS:; Other; R0.20Min

PCB hole 2.2 Self thread screw ST2.0

Housing:
-Material:PC
-Colour:Black
-Hold force clips:85N max

Shaft:
-Material:Stainless Steel
-Axialforce(stake-on):150N max
-Axial pull force:70N max
-Radial force: 12N max
-External Torque: 40mNm Max
-Rotation Angle:315 Max

El confacts:
-Material:Copper Alloy
-Coil:el.resistance 280Ω
Undim.Radial R0.05~R0.10
Undim.Chamfered edges 0.30x45

Vehicles Instrumentation Device Proudct Name: Description: | Dimension in mm

sheet
size | A3
scale | 2.5:1

Product No. VID29-03 / VID29-03P | Created Check Release | 27.3.12 | VID ²⁷.3.12

X

Y

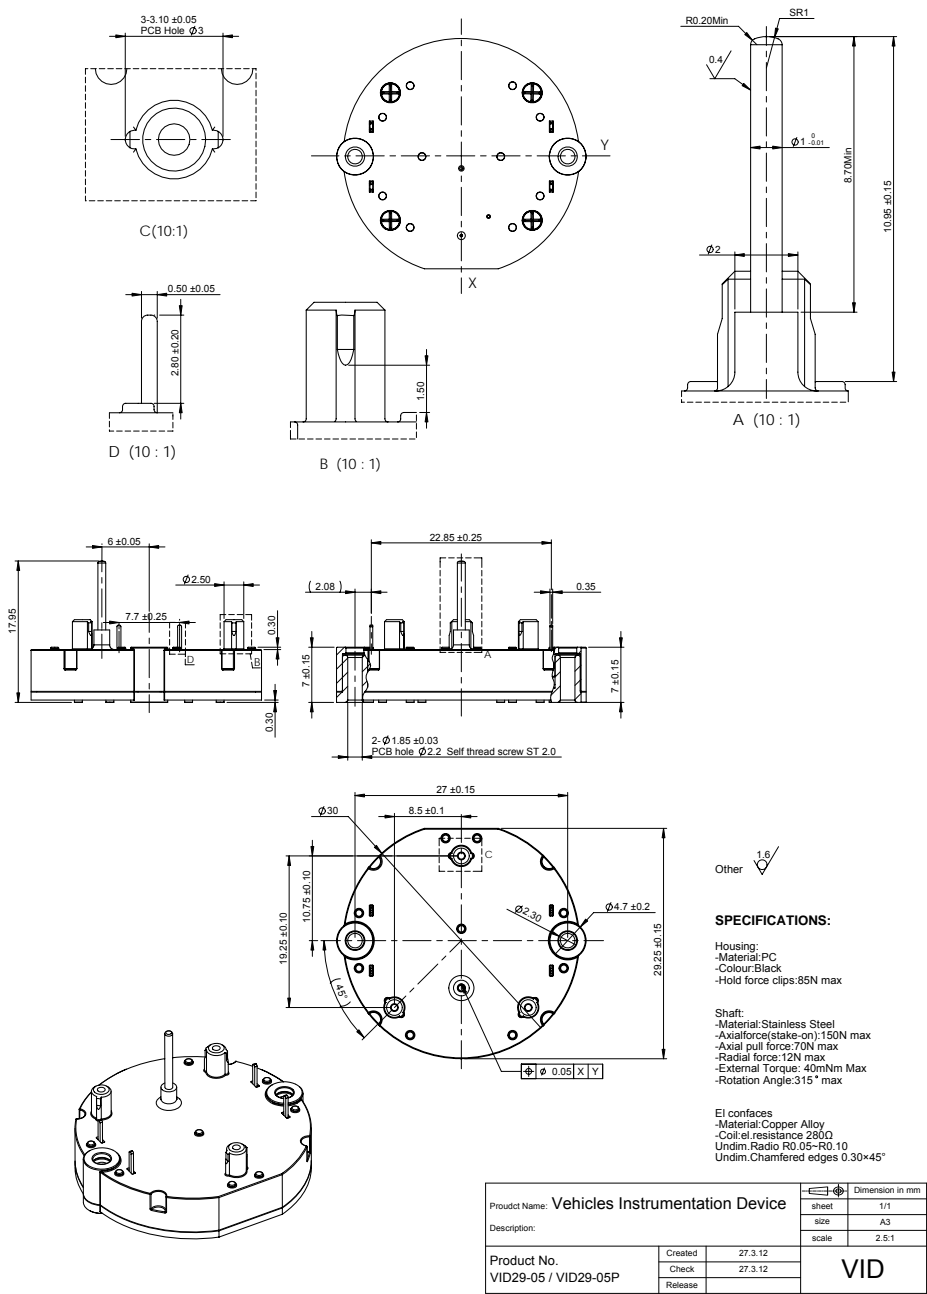
[picture p453: page 2]
8.70Min; 3-3.10 ±0.05 PCB Hole 3; SPECIFICATIONS:; Other; VID29-05 / VID29-05P; 2- 1.85 ±0.03 PCB hole; 0.20Min

2.2 Self thread screw ST 2.0

Housing:
-Material:PC
-Colour:Black
-Hold force clips:85N max

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

El confaces
-Material:Copper Alloy
-Coil:el.resistance 280Ω
Undim.Radio R0.05~R0.10
Undim.Chamfered edges 0.30×45°

X

Y

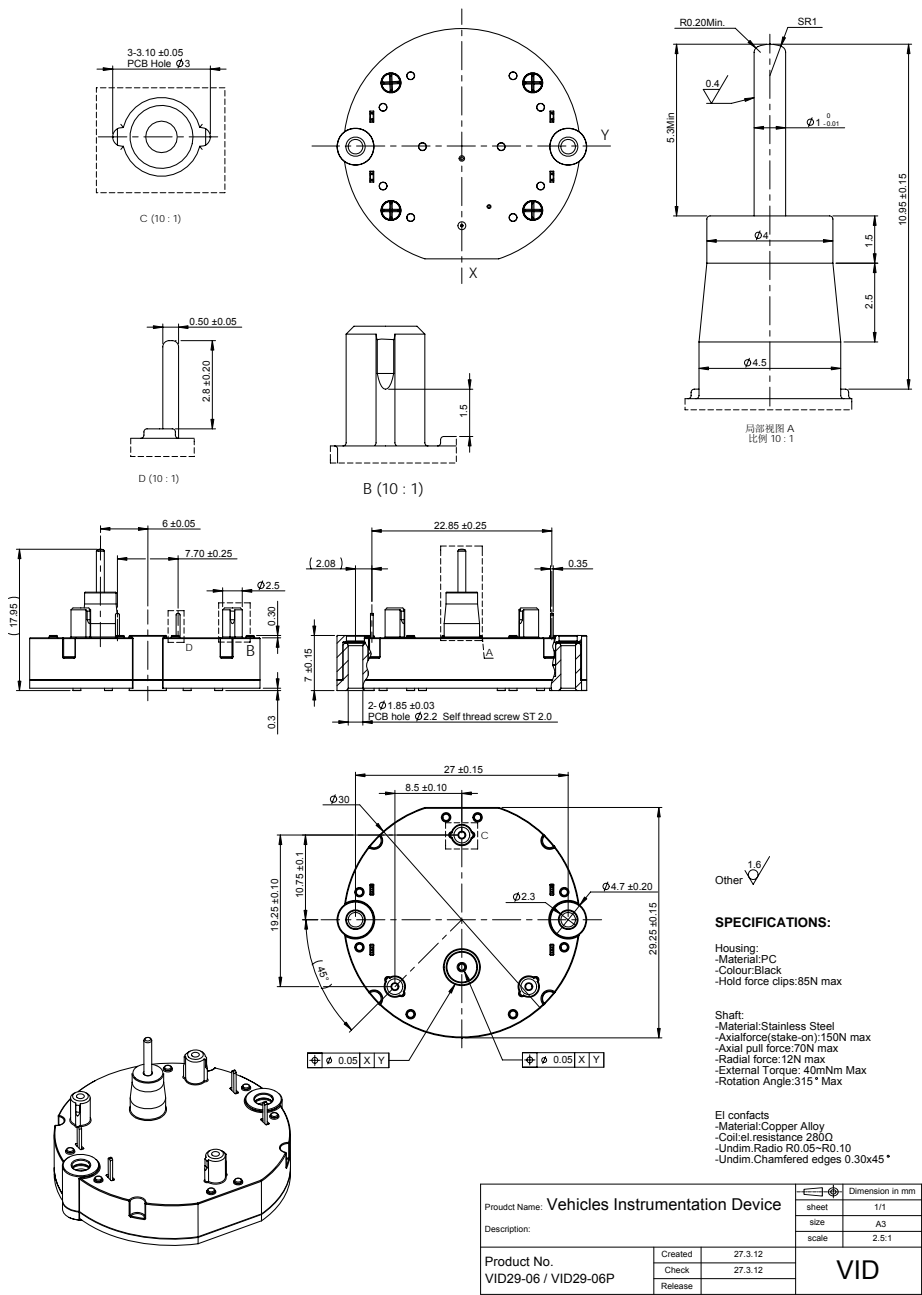
[picture p454: page 3]
5.3Min; SPECIFICATIONS:; Other; 局部视图 A 比例 10 : 1; R0.20Min.; VID29-06 / VID29-06P; 2- 1.85 ±0.03 PCB hole

2.2 Self thread screw ST 2.0

Housing:
-Material:PC
-Colour:Black
-Hold force clips:85N max

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

X

Y

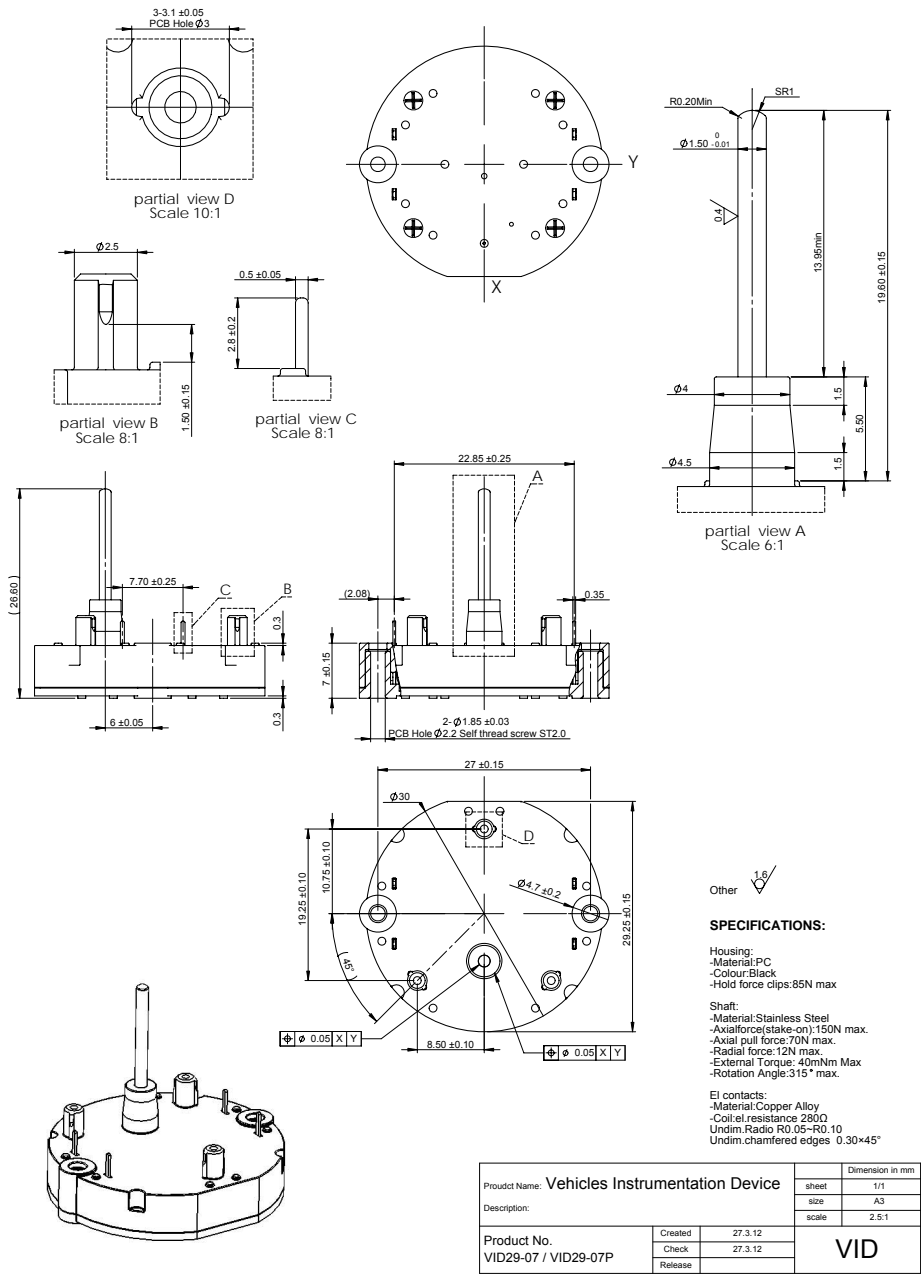
[picture p455: page 4]
13.95min; PCB Hole; SPECIFICATIONS:; Other; partial view A; Scale 6 ⁰.4; R0.20Min; partial view C Scale 8:1; partial view D Scale 10:1; partial view B Scale 8:1; VID29-07 / VID29-07P

2.2 Self thread screw ST2.0

Housing:
-Material:PC
-Colour:Black
-Hold force clips:85N max
Shaft:
-Material:Stainless Steel
-Axialforce(stake-on):150N max.
-Axial pull force:70N max.
-Radial force:12N max.
-External Torque: 40mNm Max
-Rotation Angle:315 max.
El contacts:
-Material:Copper Alloy
-Coil:el.resistance 280Ω
Undim.Radio R0.05~R0.10
Undim.chamfered edges 0.30×45°

B

C

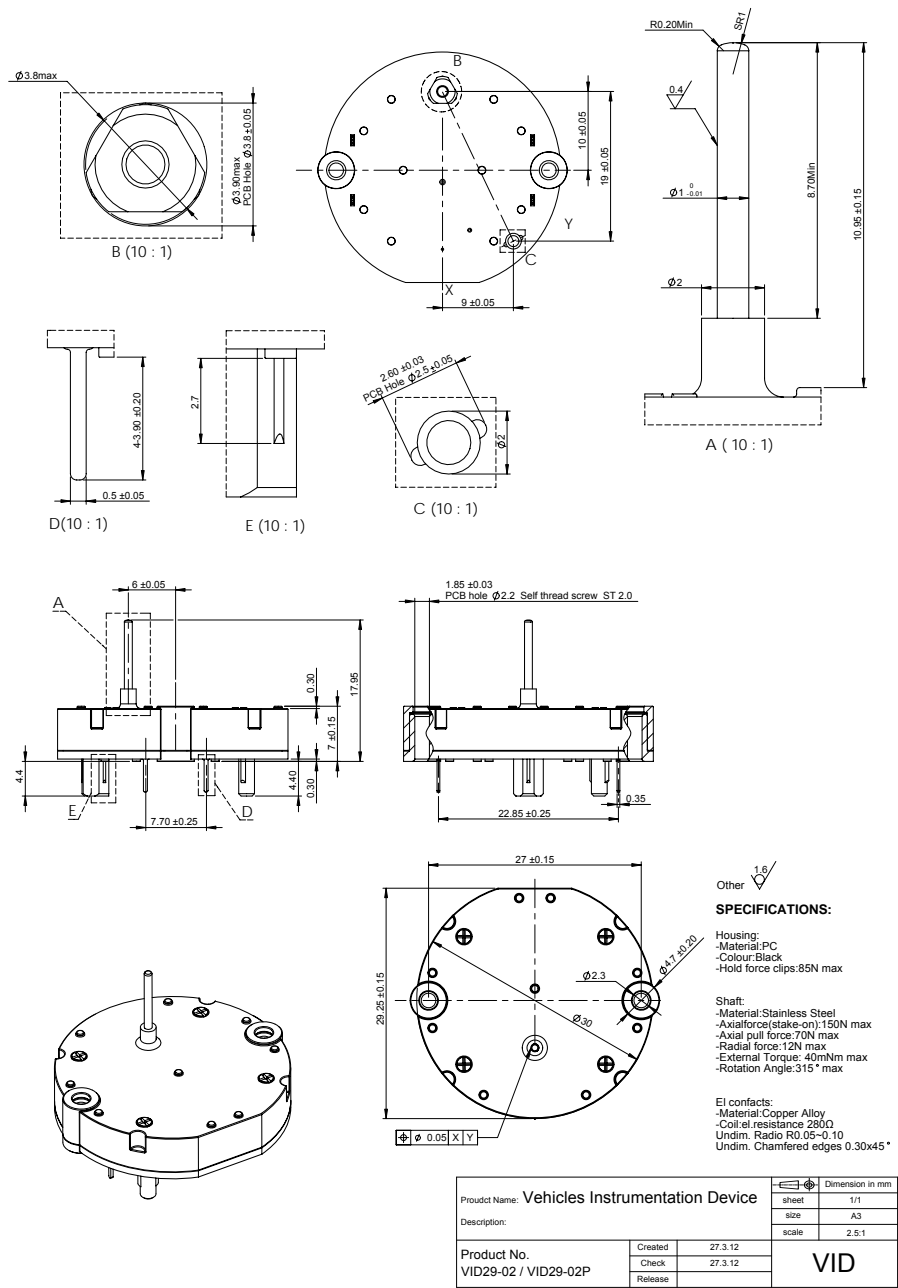
[picture p456: page 5]
3.90max; PCB Hole 3.8 0.05; 8.70Min; SPECIFICATIONS:; VID29-02 / VID29-02P; Other; 3.8max; PCB Hole 2.5 0.05; 1.85 ±0.03 PCB hole; Min; SR¹

2.2 Self thread screw ST 2.0

Housing:
-Material:PC
-Colour:Black
-Hold force clips:85N max

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

El confacts:
-Material:Copper Alloy
-Coil:el.resistance 280Ω
Undim. Radio R0.05~0.10
Undim. Chamfered edges 0.30x45
