bnepethomas/bne-arduino-flight-simulator-interfaces/Jet Ranger/Jet Ranger Documentation/Jet Ranger Instrument Map A3.pdf

Jet Ranger cockpit: gauges, lamps and displays, and the controller board that drives each one

Instrument map, A3 landscape. Needles and lamps are drawn at illustrative readings. Cables end at the named connector on the board (references as printed on the PCBs).

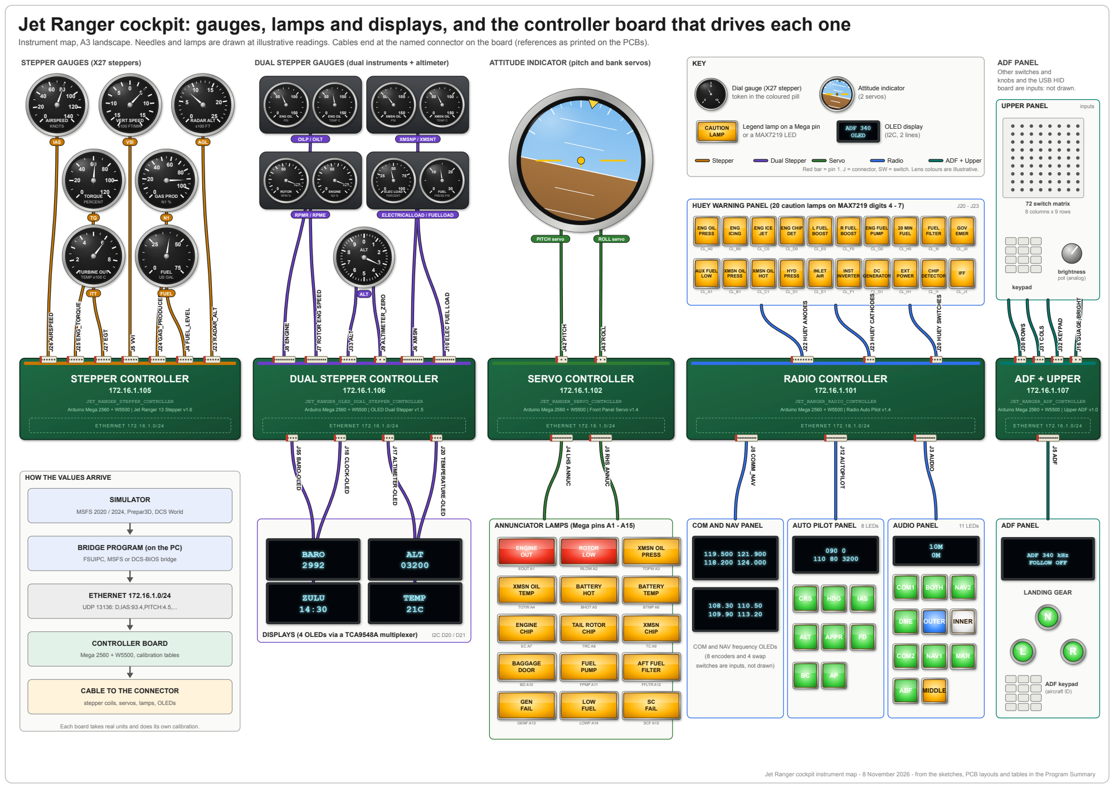
[picture p457: page 1]

ADF PANEL
Other switches and
knobs and the USB HID
board are inputs: not drawn.

Dial gauge (X27 stepper)
token in the coloured pill

Legend lamp on a Mega pin
or a MAX7219 LED

Red bar = pin 1. J = connector, SW = switch. Lens colours are illustrative.

SPEED J7 ROTOR ENG SPEED

LOAD J10 ELEC FUEL LOAD

HUEY CATHODES J23 HUEY CATHODES

HUEY SWITCHES J20 HUEY SWITCHES

HUEY ANODES J22 HUEY ANODES

JET_RANGER_OLED_DUAL_STEPPER_CONTROLLER
Arduino Mega 2560 + W5500 | OLED Dual Stepper v1.5

JET_RANGER_RADIO_CONTROLLER
Arduino Mega 2560 + W5500 | Radio Auto Pilot v1.4

JET_RANGER_ADF_CONTROLLER
Arduino Mega 2560 + W5500 | Upper ADF v1.0

Arduino Mega 2560 + W5500 | Jet Ranger 13 Stepper v1.6

Arduino Mega 2560 + W5500 | Front Panel Servo v1.4

J17 ALTIMETER-OLED

BARO-OLED J55 BARO-OLED

CLOCK-OLED J18 CLOCK-OLED

TEMPERATURE-OLED J20 TEMPERATURE-OLED

LHS ANNUC J4 LHS ANNUC

RHS ANNUC J5 RHS ANNUC

HOW THE VALUES ARRIVE

BRIDGE PROGRAM (on the PC)
FSUIPC, MSFS or DCS-BIOS bridge

COM and NAV frequency OLEDs
(8 encoders and 4 swap
switches are inputs, not drawn)

CABLE TO THE CONNECTOR
stepper coils, servos, lamps, OLEDs

Each board takes real units and does its own calibration.

Jet Ranger cockpit instrument map - 8 November 2026 - from the sketches, PCB layouts and tables in the Program Summary
