bnepethomas/bne-arduino-flight-simulator-interfaces/A10/A10 PCBs/Forward Console Combined Input and Output.pdf

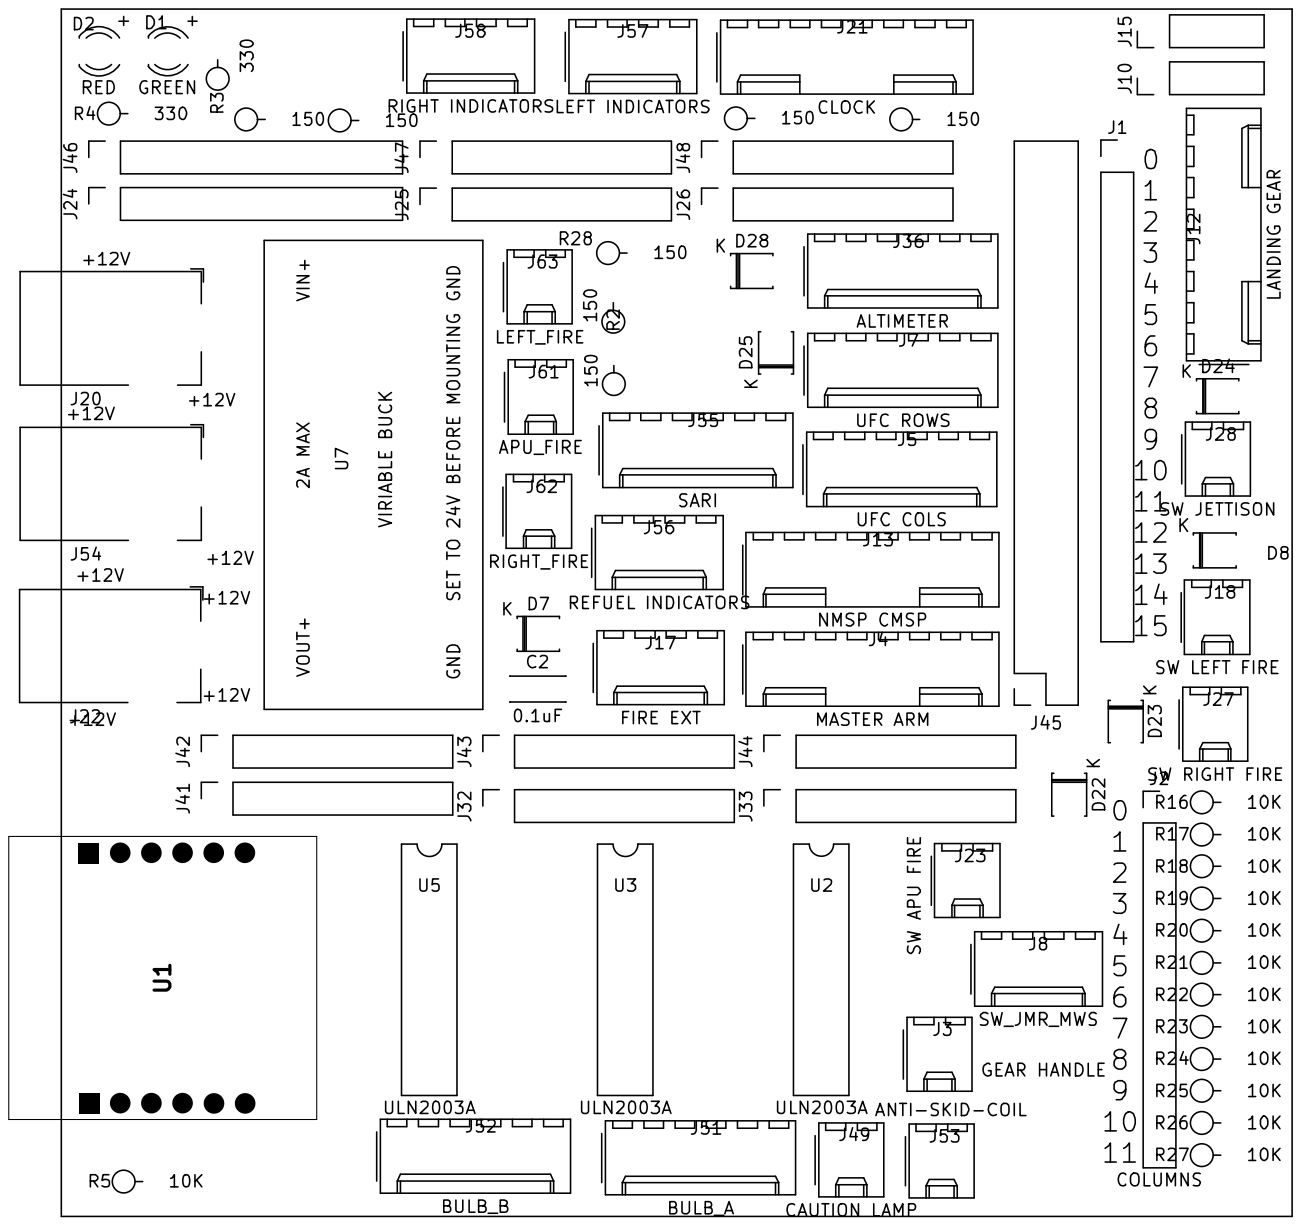
[picture p458: page 1]
