bnepethomas/bne-arduino-flight-simulator-interfaces/A10/A10 Documentation/PCB Silkscreens/Forward 7 Stepper Driver.pdf

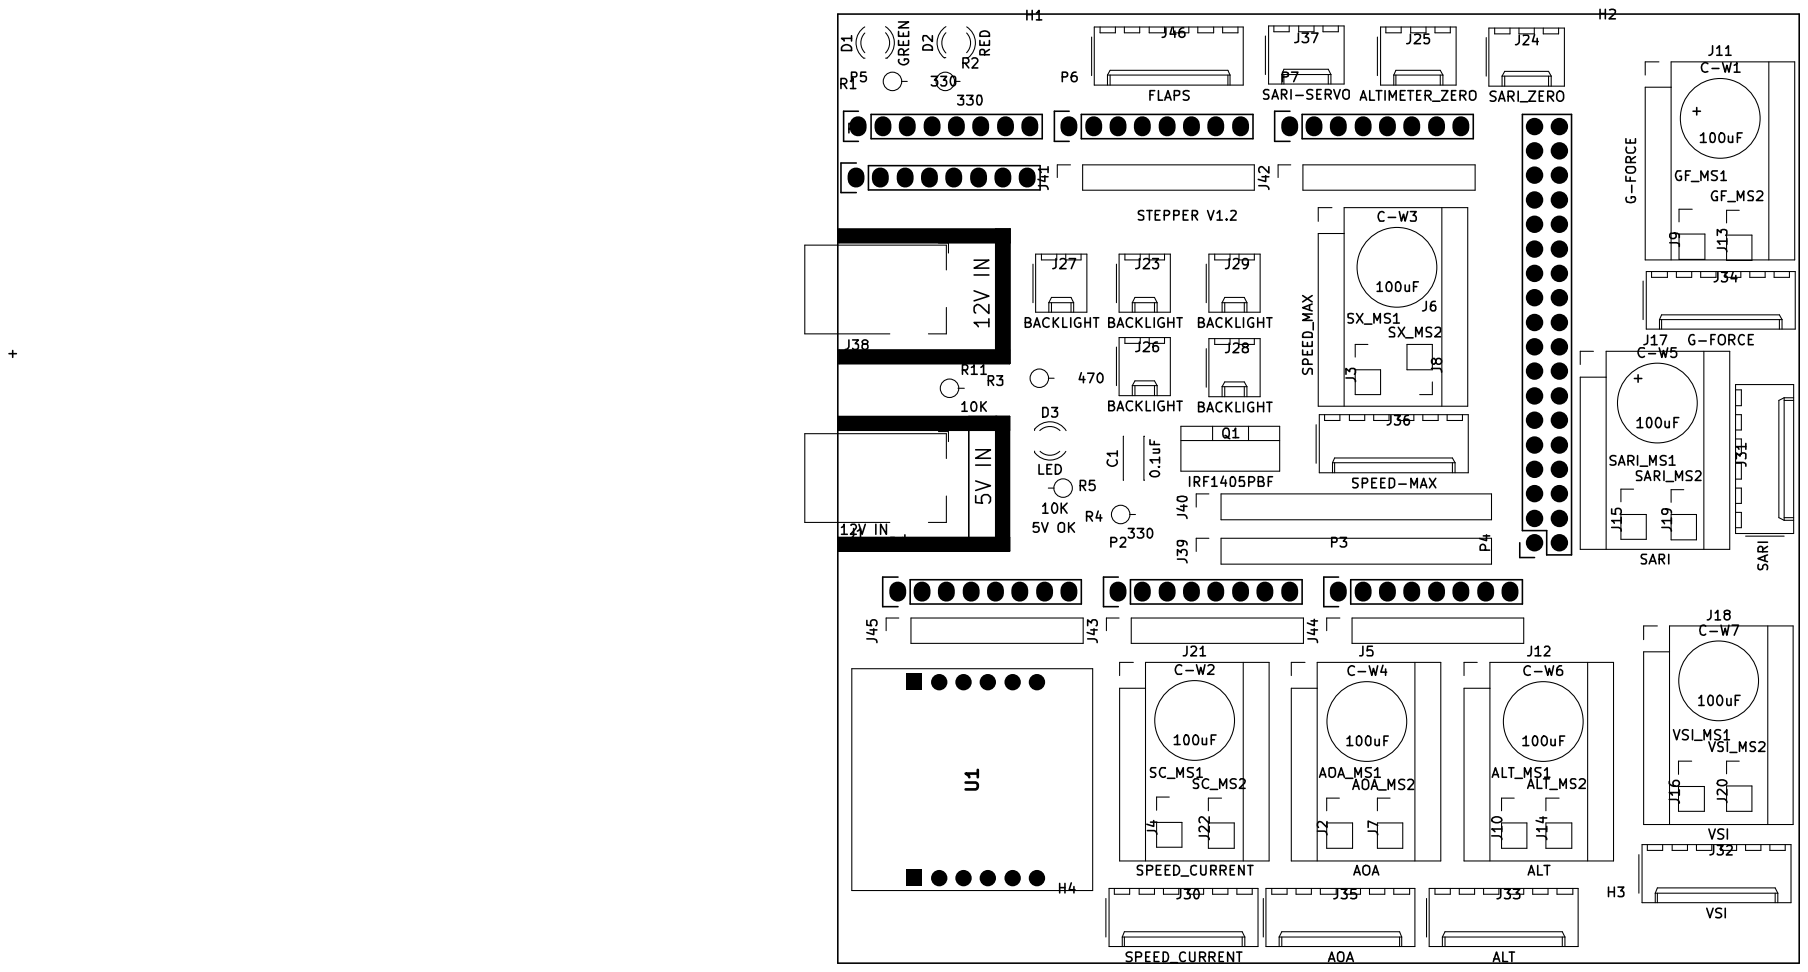
[picture p459: page 1]
