bnepethomas/bne-arduino-flight-simulator-interfaces/A10/A10 Documentation/PCB Silkscreens/Forward OLED.pdf

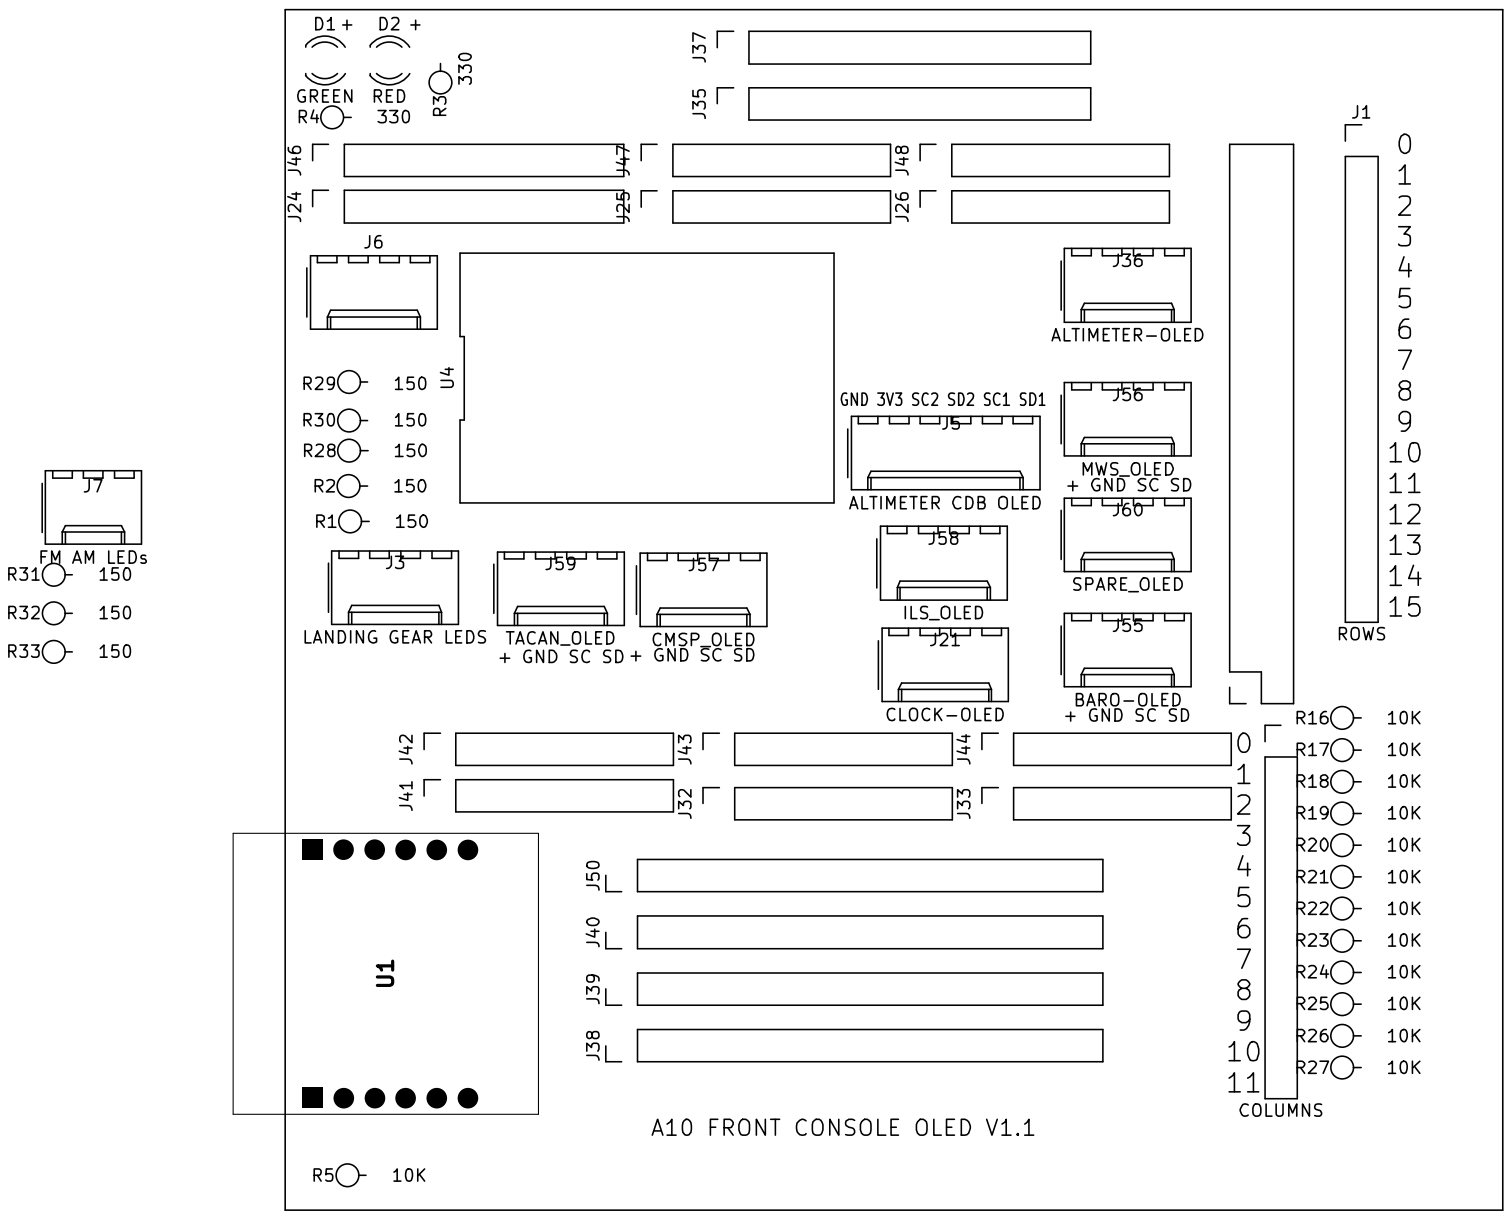
[picture p460: page 1]
