bnepethomas/bne-arduino-flight-simulator-interfaces/A10/A10 Documentation/PCB Silkscreens/Left Combined Input output.pdf

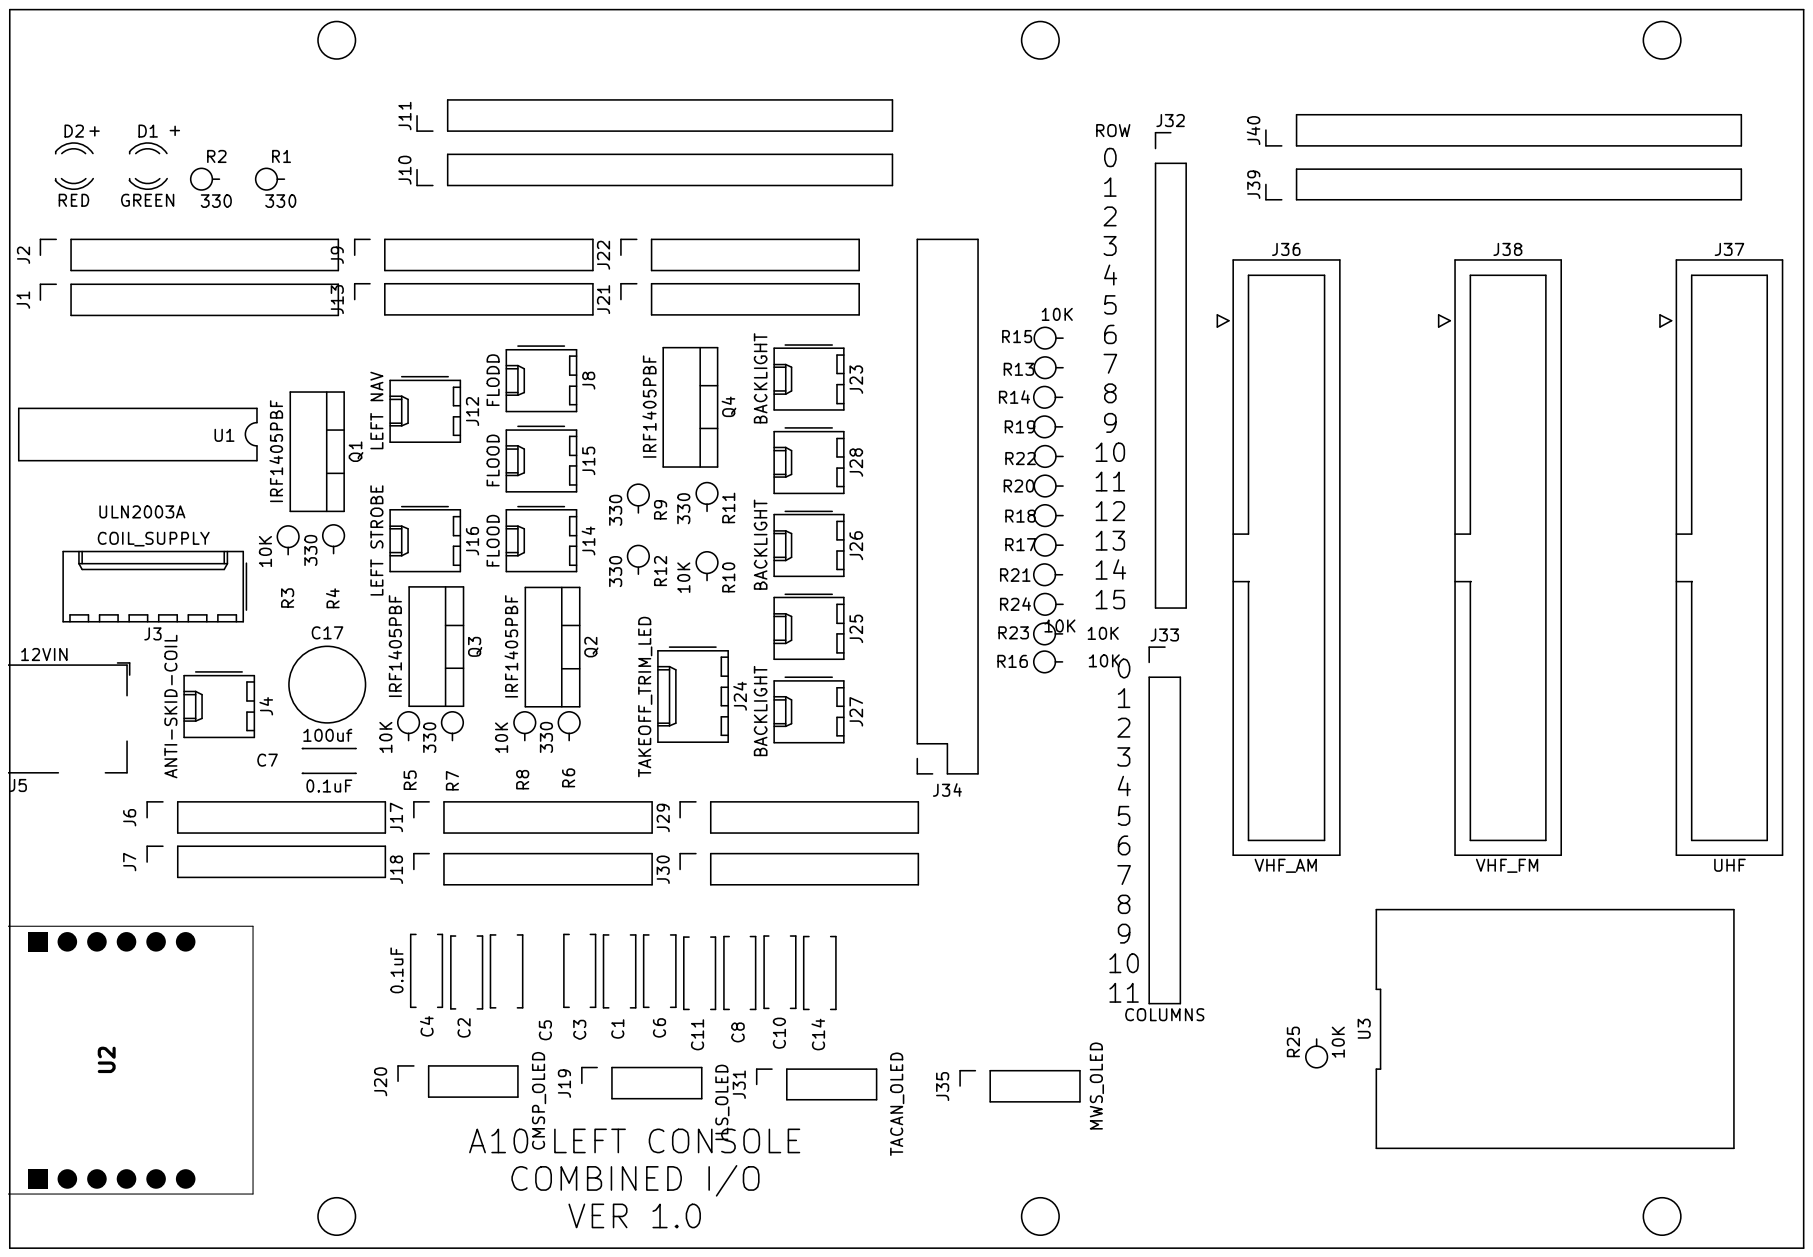
[picture p461: page 1]
