bnepethomas/bne-arduino-flight-simulator-interfaces/A10/A10 Documentation/PCB Silkscreens/Left Console Input.pdf

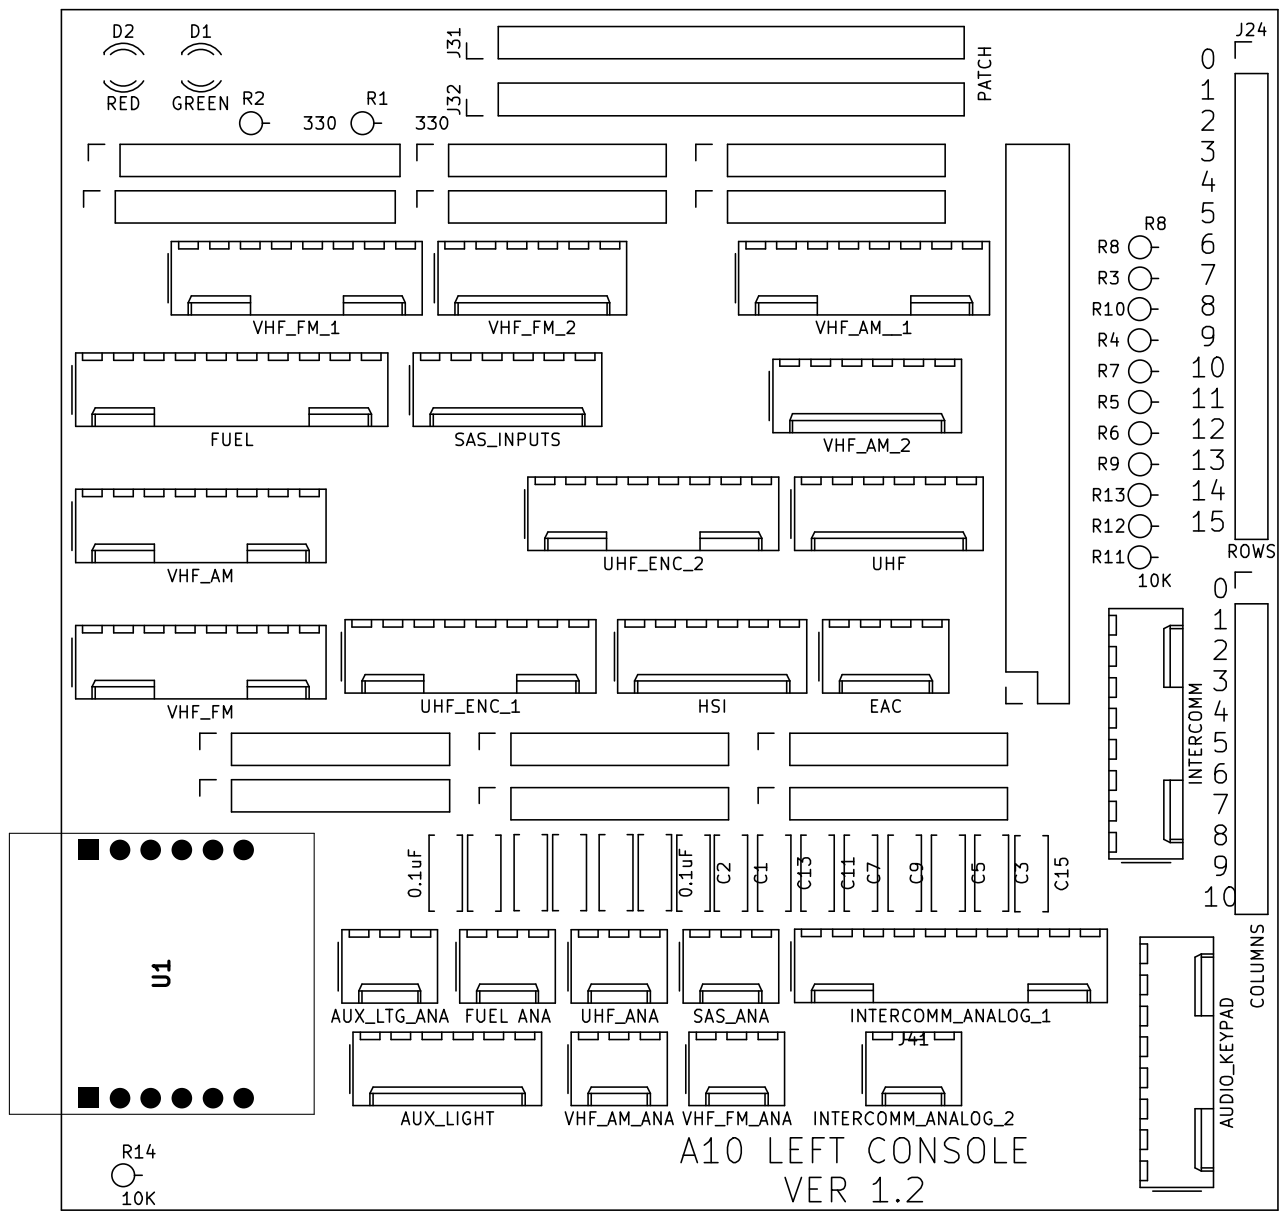
[picture p462: page 1]
