bnepethomas/bne-arduino-flight-simulator-interfaces/A10/A10 Documentation/PCB Silkscreens/right ouput v1.2.pdf

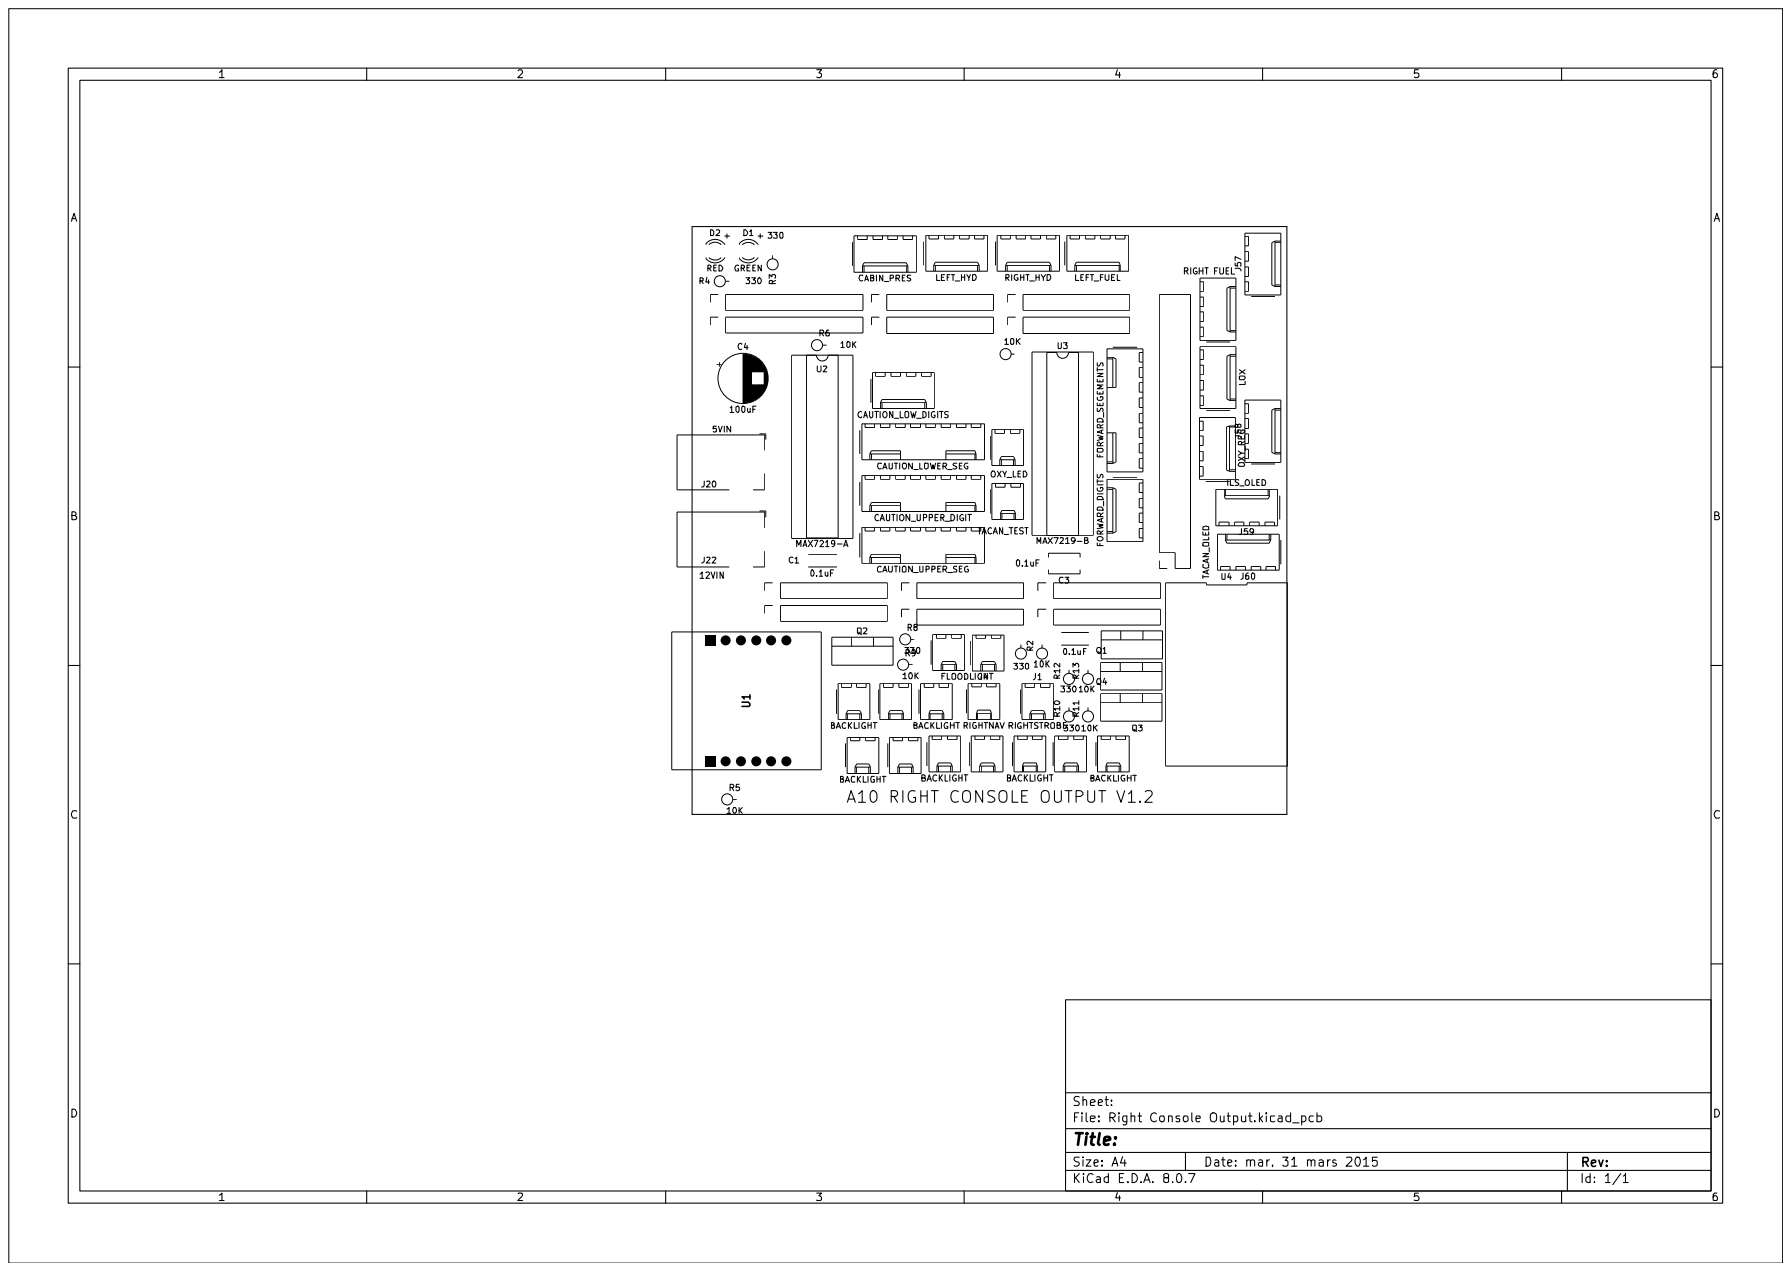
[picture p463: page 1]
