bnepethomas/bne-arduino-flight-simulator-interfaces/A10/A10 Documentation/PCB Silkscreens/right output v1.2.pdf

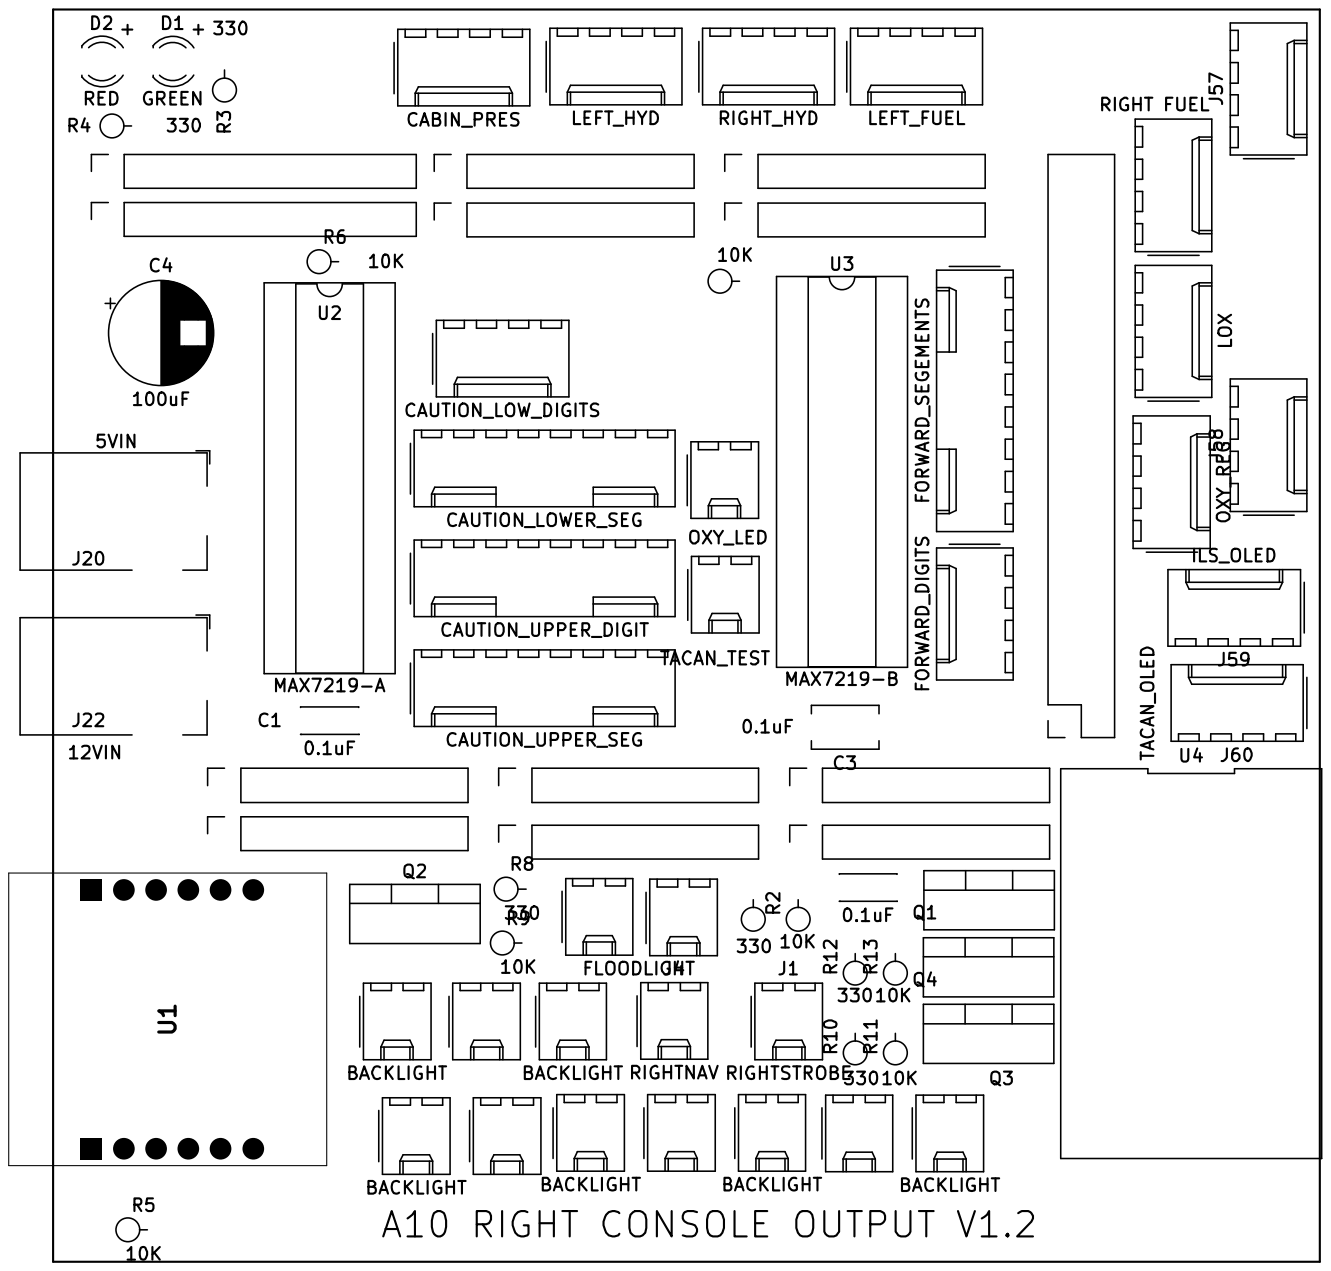
[picture p464: page 1]
