bnepethomas/bne-arduino-flight-simulator-interfaces/A10/A10 Documentation/PCB Silkscreens/Roght Input v1.3 .pdf

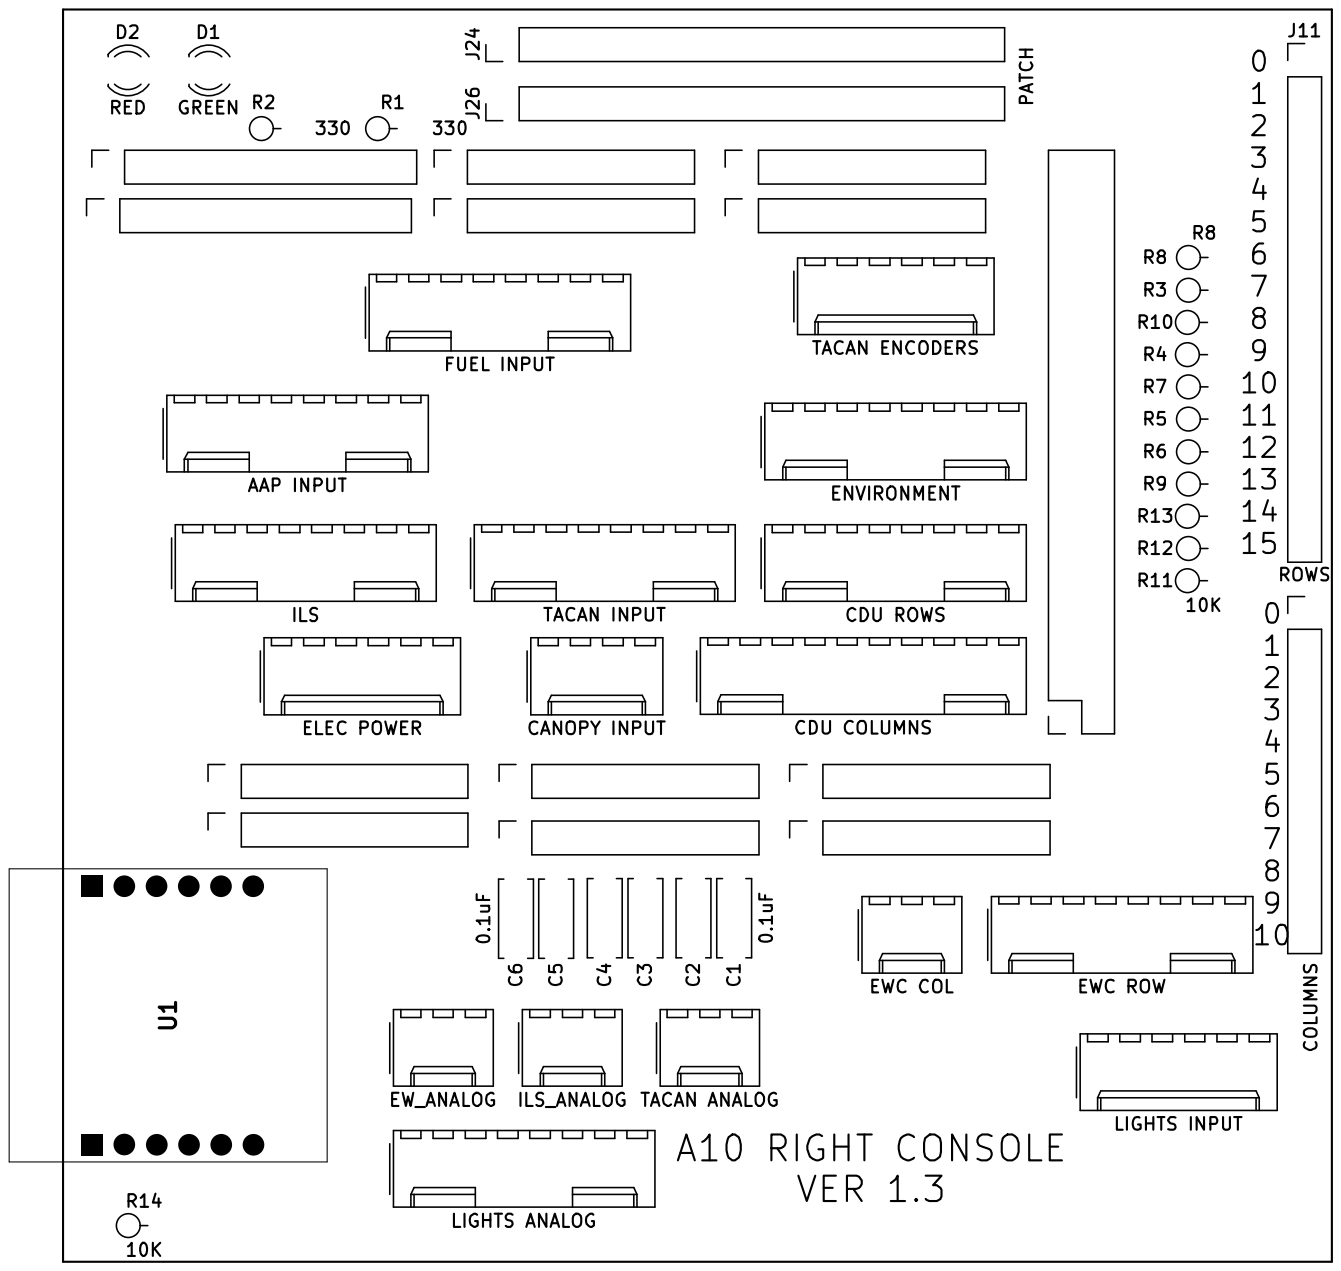
[picture p465: page 1]
