bnepethomas/bne-arduino-flight-simulator-interfaces/Hornet/Hornet Documentation/PCB Layouts/Left Controller v002.pdf

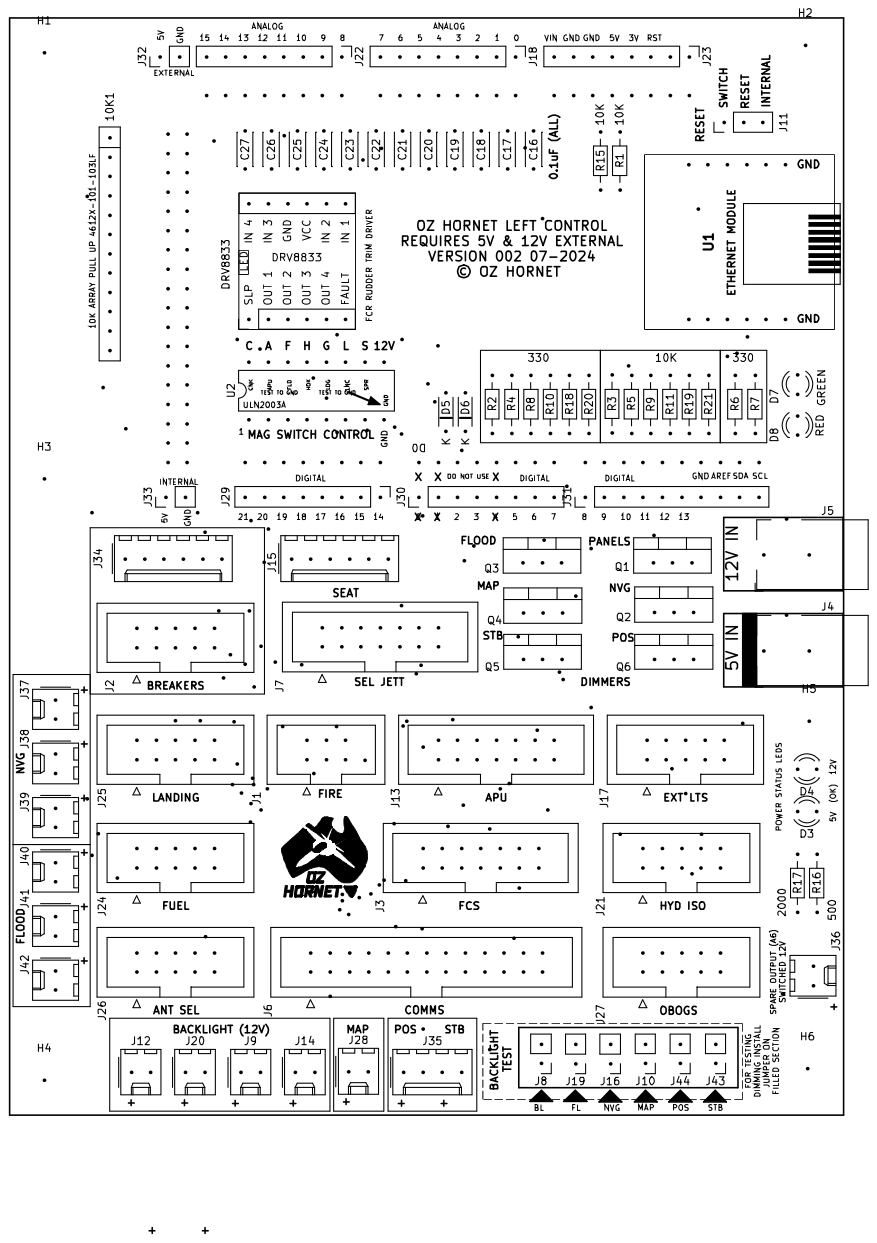
[picture p466: page 1]
