bnepethomas/bne-arduino-flight-simulator-interfaces/Hornet/Hornet PCBs/Active/Arduino_NW_I2C/Arduino_NW_Template.pdf

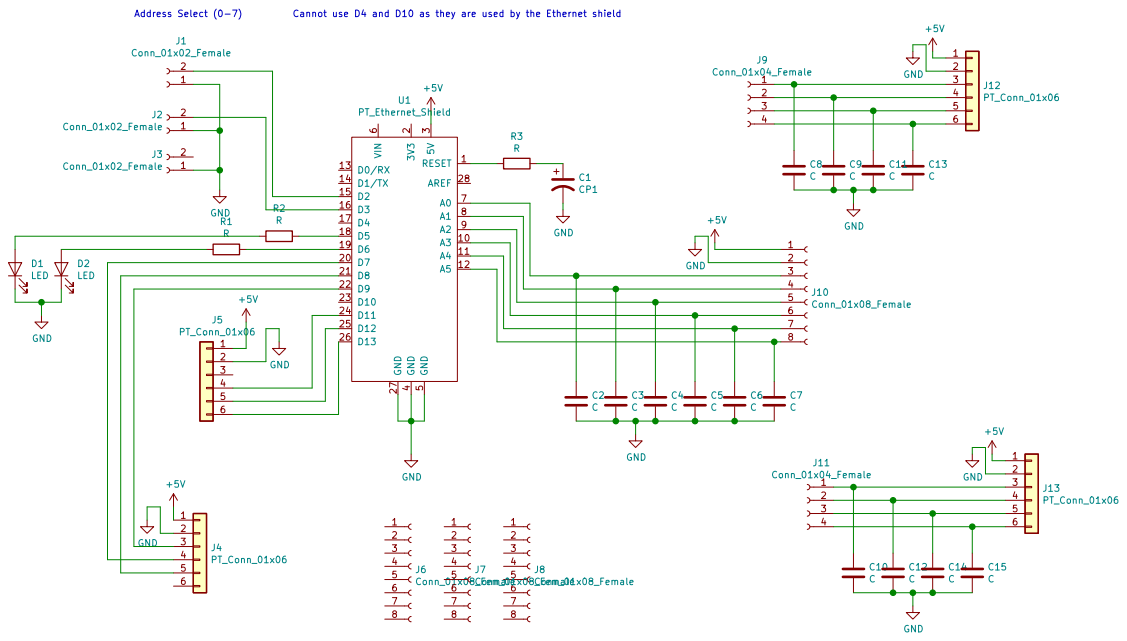
[picture p467: page 1]
