bnepethomas/bne-arduino-flight-simulator-interfaces/Hornet/Hornet PCBs/Active/ddi_button_board/ddi_outline.pdf

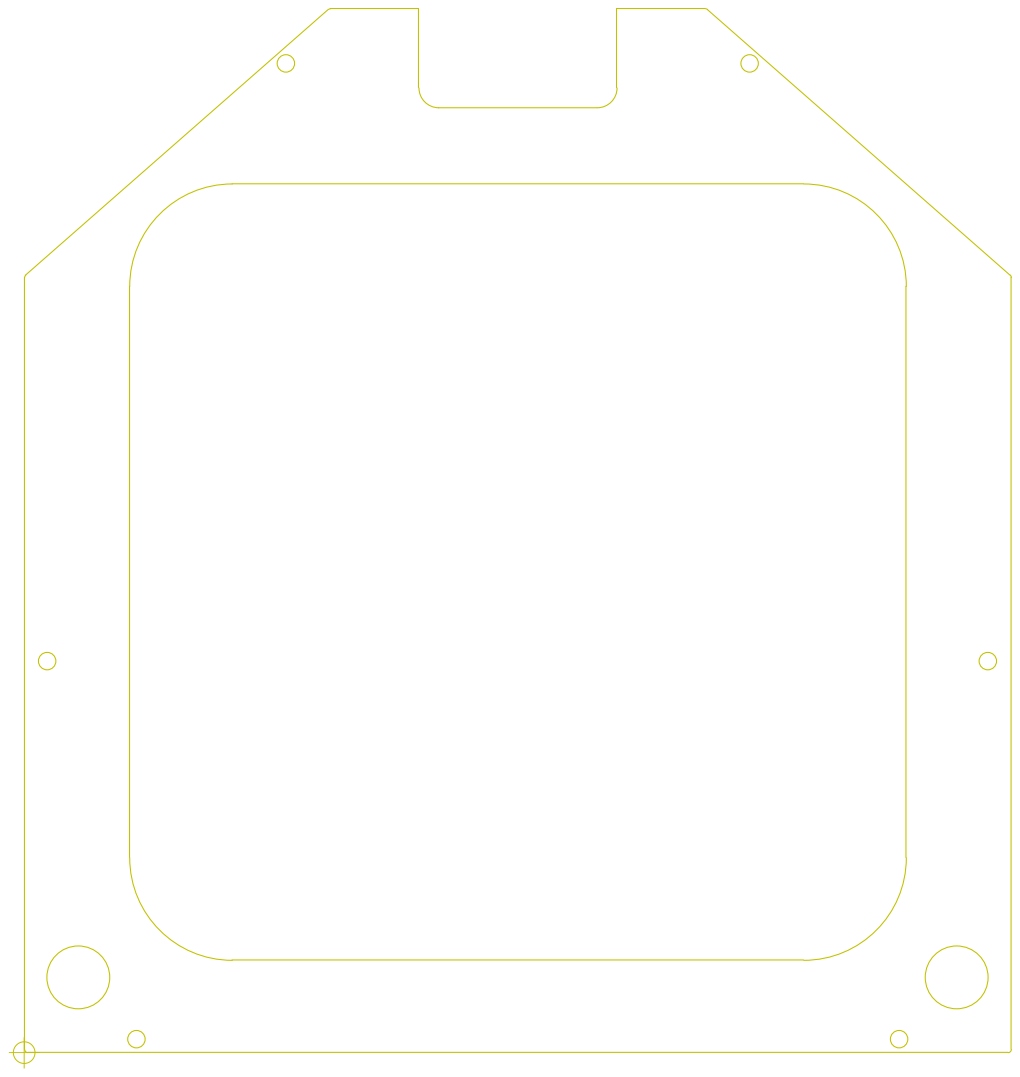
[picture p468: page 1]
