bnepethomas/bne-arduino-flight-simulator-interfaces/Hornet/Hornet PCBs/Active/MFD/MFD-F_Mask.pdf

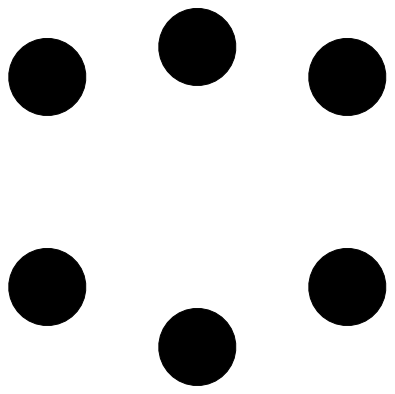
[picture p469: page 1]
