bnepethomas/bne-arduino-flight-simulator-interfaces/Hornet/Hornet PCBs/Active/MFD/MFD-F_SilkS.pdf

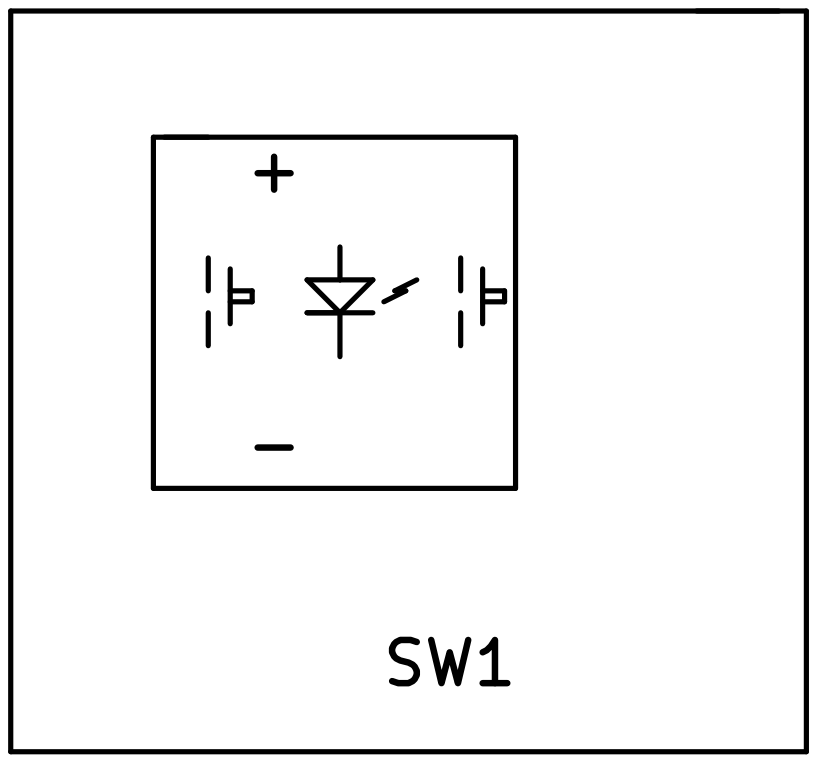
[picture p470: page 1]
