bnepethomas/bne-arduino-flight-simulator-interfaces/(list of files, drawings)

Other design files:
A10/A10 Documentation/Diptrace/Arduino_Compass_v001_dev.dch
A10/A10 Documentation/Diptrace/Arduino_Compass_v002_dev.dch
A10/A10 Documentation/Diptrace/Arduino_Compass_v003_dev.dch
A10/A10 Documentation/Diptrace/Arduino_Compass_v004.dch
A10/A10 Documentation/Diptrace/Arduino_Compass_v005.dch
A10/A10 Documentation/Diptrace/Arduino_Joystick_v001.dch
A10/A10 Documentation/Diptrace/Arduino_Joystick_v001.dip
A10/A10 Documentation/Diptrace/Arduino_Joystick_v001A.dch
A10/A10 Documentation/Diptrace/Arduino_Joystick_v001A.dip
A10/A10 Documentation/Diptrace/Arduino_Joystick_v001B.dch
A10/A10 Documentation/Diptrace/Arduino_Joystick_v001B.dip
A10/A10 Documentation/Diptrace/Arduino_Joystick_v002.dch
A10/A10 Documentation/Diptrace/Arduino_Joystick_v002a.dip
A10/A10 Documentation/Diptrace/Arduino_Joystick_v003.dch
A10/A10 Documentation/Diptrace/Arduino_Max7219_002.dip
A10/A10 Documentation/Diptrace/Arduino_Max7219_AAAG_AOA_Lock_20150912a.dch
A10/A10 Documentation/Diptrace/Arduino_Max7219_AAAG_AOA_Lock_20150912a.dip
A10/A10 Documentation/Diptrace/Arduino_Max7219_Bottom_Right.dch
A10/A10 Documentation/Diptrace/Arduino_Max7219_Bottom_Right_001.dch
A10/A10 Documentation/Diptrace/Arduino_Max7219_Bottom_Right_001.dip
A10/A10 Documentation/Diptrace/Arduino_Max7219_Bottom_Right_20150831a.dch
A10/A10 Documentation/Diptrace/Arduino_Max7219_Breakout_v001.dch
A10/A10 Documentation/Diptrace/Arduino_Max7219_Breakout_v001.dip
A10/A10 Documentation/Diptrace/Arduino_Max7219_Breakout_v002.dch
A10/A10 Documentation/Diptrace/Arduino_Max7219_Combined_20150912a.dip
A10/A10 Documentation/Diptrace/Arduino_Max7219_Gear_20150904a.dch
A10/A10 Documentation/Diptrace/Arduino_Max7219_Gear_Selective_Jet_20150904a.dip
A10/A10 Documentation/Diptrace/Arduino_Max7219_Right_Eyebrow_20150904a.dch
A10/A10 Documentation/Diptrace/Arduino_Max7219_Right_Eyebrow_20150904a.dip
A10/A10 Documentation/Diptrace/Arduino_Max7219_Right_Eyebrow_20150904b.dip
A10/A10 Documentation/Diptrace/Arduino_Max7219_Right_Eyebrow_20150904c.dip
A10/A10 Documentation/Diptrace/Arduino_Max7219_Right_Eyebrow_20150904d.dip
A10/A10 Documentation/Diptrace/Arduino_Max7219_Right_Eyebrow_20150907a.dip
A10/A10 Documentation/Diptrace/Arduino_Max7219_Right_Eyebrow_20150907b.dip
A10/A10 Documentation/Diptrace/Arduino_Max7219_Right_Eyebrow_20150907c.dip
A10/A10 Documentation/Diptrace/Arduino_Max7219_Right_Eyebrow_20150907d.dip
A10/A10 Documentation/Diptrace/Arduino_Max7219_Top_Left.dch
A10/A10 Documentation/Diptrace/Arduino_Max7219_Top_Left_20150831a.dch
A10/A10 Documentation/Diptrace/Arduino_Max7219_Top_Left_20150903aa.dch
A10/A10 Documentation/Diptrace/Arduino_Max7219_Top_Left_20150903b.dch
A10/A10 Documentation/Diptrace/Arduino_Max7219_Top_Left_V001.dch
A10/A10 Documentation/Diptrace/Arduino_Max7219_Top_Leftt_20150903a.dip
A10/A10 Documentation/Diptrace/Arduino_Max7219_Top_Leftt_20150904a.dip
A10/A10 Documentation/Diptrace/Arduino_Max7219_Top_Right.dch
A10/A10 Documentation/Diptrace/Arduino_Max7219_tOP_Right_001.dip
A10/A10 Documentation/Diptrace/Arduino_Max7219_v001.dch
A10/A10 Documentation/Diptrace/Arduino_Max7219_v002.dch
A10/A10 Documentation/Diptrace/Arduino_Max7219_Warning_20150904a.dch
A10/A10 Documentation/Diptrace/Arduino_Max7219_Warning_20150904b.dip
A10/A10 Documentation/Diptrace/Arduino_Max7219_Warning_20150904c.dip
A10/A10 Documentation/Diptrace/Arduino_Stepper.dch
A10/A10 Documentation/Diptrace/Arduino_Stepper_v001.dch
A10/A10 Documentation/Diptrace/Arduino_Stepper_v001.dip
A10/A10 Documentation/Diptrace/Arduino_Stepper_v002.dch
A10/A10 Documentation/Diptrace/Arduino_Stepper_v003_dev.dch
A10/A10 Documentation/Diptrace/Arduino_Stepper_v004.dch
A10/A10 Documentation/Diptrace/ArduinoUnoOledV001.dip
A10/A10 Documentation/Diptrace/ArduinoUnoOutlineOLEDMuxv01.dip
A10/A10 Documentation/Diptrace/ArduinoUnoOutlineOLEDMuxv01a.dip
A10/A10 Documentation/Diptrace/ArduinoUnoOutlineOLEDMuxv01aOrdered.dip
A10/A10 Documentation/Diptrace/ArduinoUnoOutlineOLEDMuxv02a.dip
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
