bnepethomas/bne-arduino-flight-simulator-interfaces/Jet Ranger/PCBs/Jet Ranger Radio Auto Pilot/Jet Ranger Radio Auto Pilot.kicad_pcb

## KiCad design Jet Ranger/PCBs/Jet Ranger Radio Auto Pilot/Jet Ranger Radio Auto Pilot.kicad_pcb (2026-10-31)

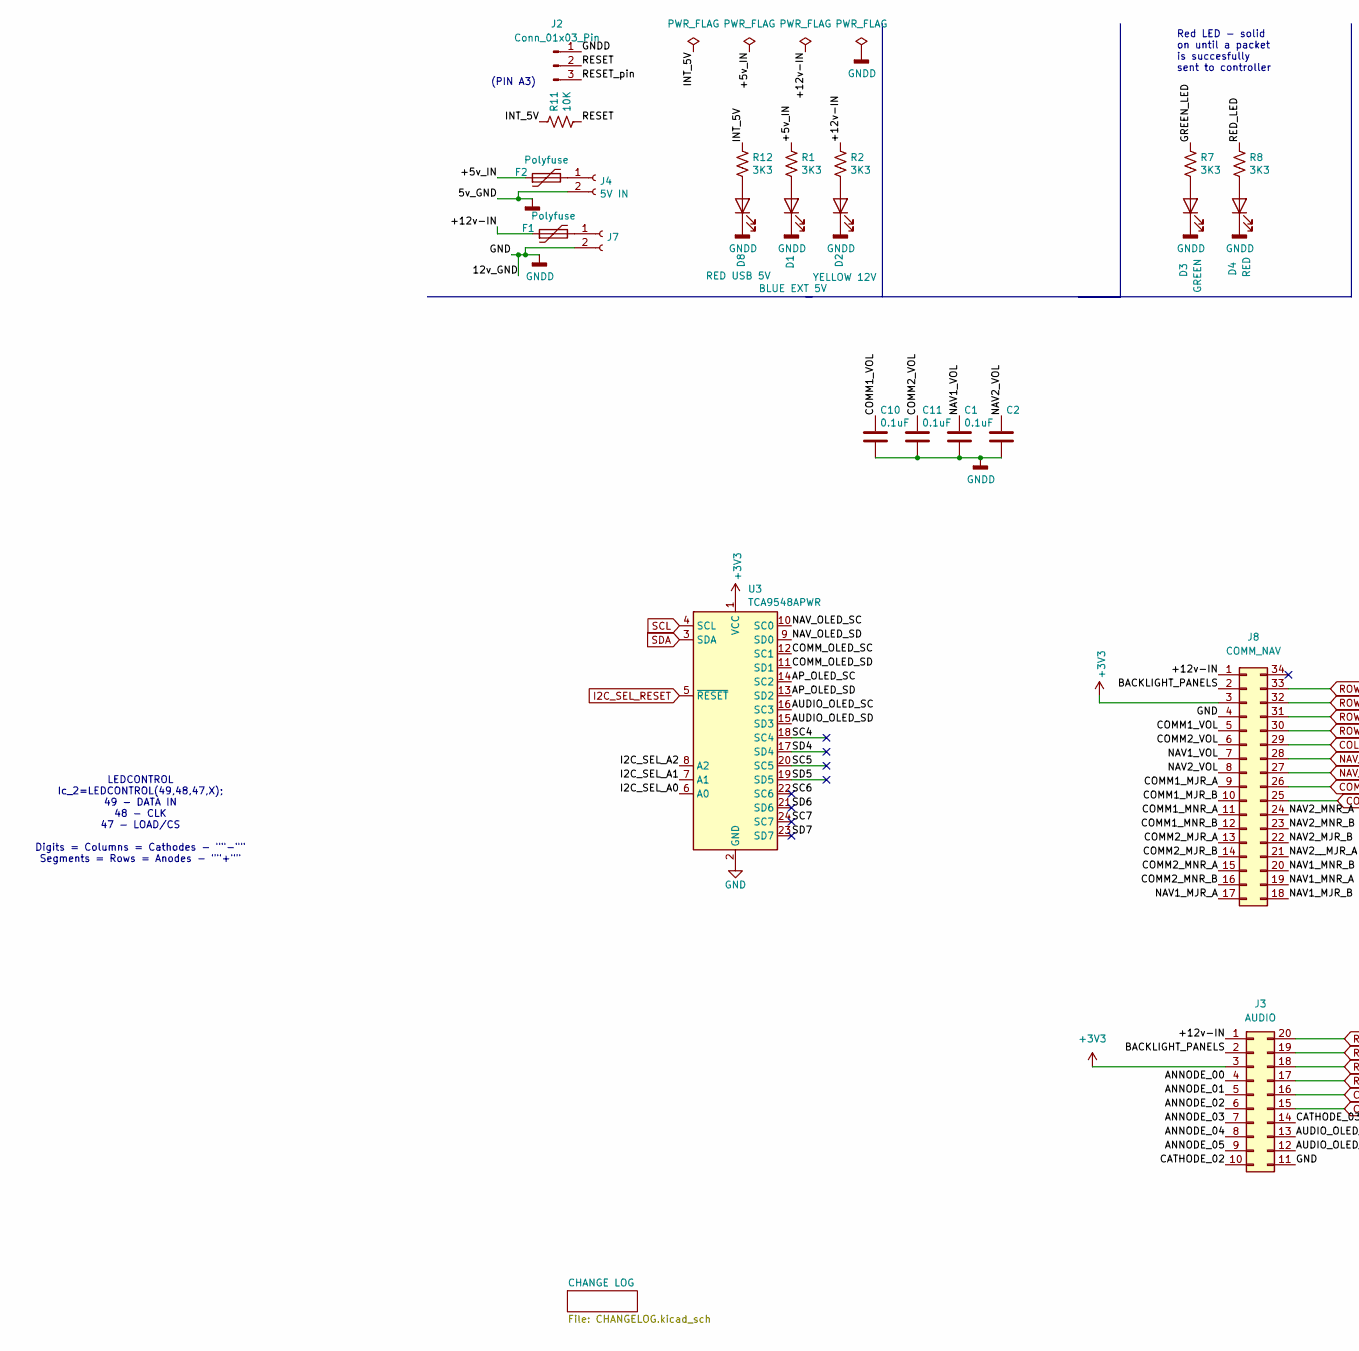
[picture p471: schematic Jet Ranger Radio Auto Pilot.kicad_sch, part in row 1, column 1]

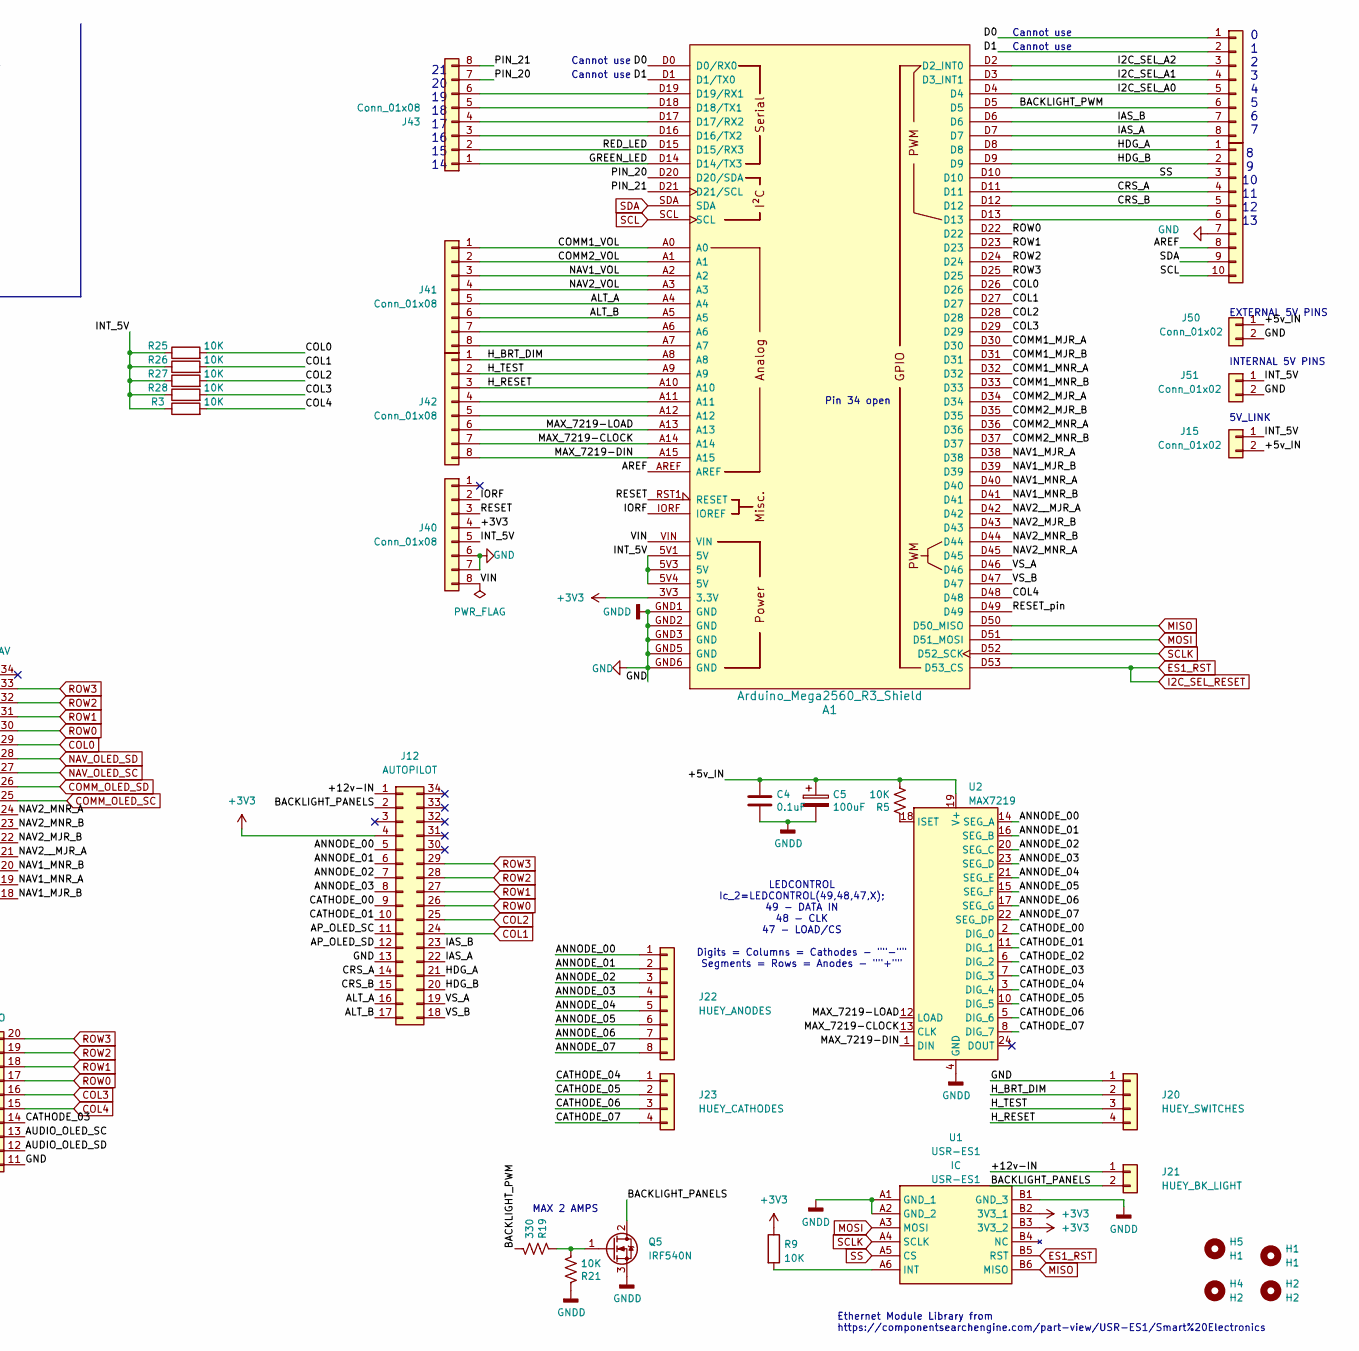
[picture p472: schematic Jet Ranger Radio Auto Pilot.kicad_sch, part in row 1, column 2]

Parts:
A1: Arduino_Mega2560_R3_Shield
C1, C2, C4, C10, C11: 0.1uF; C_Disc_D3.0mm_W2.0mm_P2.50mm
C5: 100uF; C_Radial_D8.0mm_H7.0mm_P3.50mm
D1: BLUE EXT 5V; LED_D3.0mm
D2: YELLOW 12V; LED_D3.0mm
D3: GREEN; LED_D3.0mm
D4: RED; LED_D3.0mm
D8: RED USB 5V; LED_D3.0mm
F1, F2: Polyfuse; Fuse_Littelfuse_395Series
H1, H5: H1; MountingHole_3.2mm_M3
H2, H4: H2; MountingHole_3.2mm_M3
J2: Conn_01x03_Pin; PinHeader_1x03_P2.54mm_Vertical
J3: AUDIO; IDC-Header_2x10_P2.54mm_Vertical
J4: 5V IN; BarrelJack_Horizontal
J7: STEPPER IN 12-20VDC; BarrelJack_Horizontal
J8: COMM_NAV; IDC-Header_2x17_P2.54mm_Vertical
J12: AUTOPILOT; IDC-Header_2x17_P2.54mm_Vertical
J15, J50, J51: Conn_01x02; PinHeader_1x02_P2.54mm_Vertical
J20: HUEY_SWITCHES; Molex_KK-254_AE-6410-04A_1x04_P2.54mm_Vertical
J21: HUEY_BK_LIGHT; Molex_KK-254_AE-6410-02A_1x02_P2.54mm_Vertical
J22: HUEY_ANODES; Molex_KK-254_AE-6410-08A_1x08_P2.54mm_Vertical
J23: HUEY_CATHODES; Molex_KK-254_AE-6410-04A_1x04_P2.54mm_Vertical
J40, J41, J42, J43, J44: Conn_01x08; PinHeader_1x08_P2.54mm_Vertical
J45: Conn_01x10; PinHeader_1x10_P2.54mm_Vertical
Q5: IRF540N; TO-220-3_Vertical
R1, R2, R7, R8, R12: 3K3; R_Axial_DIN0207_L6.3mm_D2.5mm_P2.54mm_Vertical
R3, R5, R9, R11, R21, R25, R26, R27, R28: 10K; R_Axial_DIN0207_L6.3mm_D2.5mm_P2.54mm_Vertical
R19: 330; R_Axial_DIN0207_L6.3mm_D2.5mm_P2.54mm_Vertical
U1: USR-ES1; USRES1; Manufacturer_Part_Number USR-ES1
U2: MAX7219; DIP-24_W7.62mm_LongPads
U3: TCA9548APWR; AllieExpress_TCA9548A

Connections:
+3V3: A1.3V3 (3.3V), J3.3, J8.3, J12.4, J40.4, R9.1, U1.B2 (3V3_1), U1.B3 (3V3_2), U3.1 (VCC)
/+5v_IN: C4.1, C5.1, F2.1, J15.2, J50.1, R1.1, R5.2, U2.19 (V+)
/+12v-IN: F1.1, J3.1, J8.1, J12.1, J21.1, R2.1
/ALT_A: A1.A4, J12.16, J41.5
/ALT_B: A1.A5, J12.17, J41.6
/ANNODE_00: J3.4, J12.5, J22.1, U2.14 (SEG_A)
/ANNODE_01: J3.5, J12.6, J22.2, U2.16 (SEG_B)
/ANNODE_02: J3.6, J12.7, J22.3, U2.20 (SEG_C)
/ANNODE_03: J3.7, J12.8, J22.4, U2.23 (SEG_D)
/ANNODE_04: J3.8, J22.5, U2.21 (SEG_E)
/ANNODE_05: J3.9, J22.6, U2.15 (SEG_F)
/ANNODE_06: J22.7, U2.17 (SEG_G)
/ANNODE_07: J22.8, U2.22 (SEG_DP)
/AP_OLED_SC: J12.11, U3.14 (SC2)
/AP_OLED_SD: J12.12, U3.13 (SD2)
/AREF: A1.AREF, J45.8
/AUDIO_OLED_SC: J3.13, U3.16 (SC3)
/AUDIO_OLED_SD: J3.12, U3.15 (SD3)
/BACKLIGHT_PANELS: J3.2, J8.2, J12.2, J21.2, Q5.2 (D)
/BACKLIGHT_PWM: A1.D5, J44.6, R19.2
/CATHODE_00: J12.9, U2.2 (DIG_0)
/CATHODE_01: J12.10, U2.11 (DIG_1)
/CATHODE_02: J3.10, U2.6 (DIG_2)
/CATHODE_03: J3.14, U2.7 (DIG_3)
/CATHODE_04: J23.1, U2.3 (DIG_4)
/CATHODE_05: J23.2, U2.10 (DIG_5)
/CATHODE_06: J23.3, U2.5 (DIG_6)
/CATHODE_07: J23.4, U2.8 (DIG_7)
/COMM1_MJR_A: A1.D30, J8.9
/COMM1_MJR_B: A1.D31, J8.10
/COMM1_MNR_A: A1.D32, J8.11
/COMM1_MNR_B: A1.D33, J8.12
/COMM1_VOL: A1.A0, C10.1, J8.5, J41.1
/COMM2_MJR_A: A1.D34, J8.13
/COMM2_MJR_B: A1.D35, J8.14
/COMM2_MNR_A: A1.D36, J8.15
/COMM2_MNR_B: A1.D37, J8.16
/COMM2_VOL: A1.A1, C11.1, J8.6, J41.2
/CRS_A: A1.D11, J12.14, J45.4
/CRS_B: A1.D12, J12.15, J45.5
/D0: A1.D0 (D0/RX0), J44.1
/D1: A1.D1 (D1/TX0), J44.2
/GREEN_LED: A1.D14 (D14/TX3), J43.1, R7.1
/HDG_A: A1.D8, J12.21, J45.1
/HDG_B: A1.D9, J12.20, J45.2
/H_BRT_DIM: A1.A8, J20.2, J42.1
/H_RESET: A1.A10, J20.4, J42.3
/H_TEST: A1.A9, J20.3, J42.2
/I2C_SEL_A0: A1.D4, J44.5, U3.6 (A0)
/I2C_SEL_A1: A1.D3 (D3_INT1), J44.4, U3.7 (A1)
/I2C_SEL_A2: A1.D2 (D2_INT0), J44.3, U3.8 (A2)
/IAS_A: A1.D7, J12.22, J44.8
/IAS_B: A1.D6, J12.23, J44.7
/INT_5V: A1.5V1 (5V), A1.5V3 (5V), A1.5V4 (5V), J15.1, J40.5, J51.1, R3.1, R11.1, R12.1, R25.1, R26.1, R27.1, R28.1
/IORF: A1.IORF (IOREF), J40.2
/MAX_7219-CLOCK: A1.A14, J42.7, U2.13 (CLK)
/MAX_7219-DIN: A1.A15, J42.8, U2.1 (DIN)
/MAX_7219-LOAD: A1.A13, J42.6, U2.12 (LOAD)
/NAV1_MJR_A: A1.D38, J8.17
/NAV1_MJR_B: A1.D39, J8.18
/NAV1_MNR_A: A1.D40, J8.19
/NAV1_MNR_B: A1.D41, J8.20
/NAV1_VOL: A1.A2, C1.1, J8.7, J41.3
/NAV2_MJR_B: A1.D43, J8.22
/NAV2_MNR_A: A1.D45, J8.24
/NAV2_MNR_B: A1.D44, J8.23
/NAV2_VOL: A1.A3, C2.1, J8.8, J41.4
/NAV2__MJR_A: A1.D42, J8.21
/PIN_20: A1.D20 (D20/SDA), J43.7
/PIN_21: A1.D21 (D21/SCL), J43.8
/RED_LED: A1.D15 (D15/RX3), J43.2, R8.1
/RESET: A1.RST1 (RESET), J2.2, J40.3, R11.2
/RESET_pin: A1.D49, J2.3
/SC4: U3.18 (SC4)
/SC5: U3.20 (SC5)
/SC6: U3.22 (SC6)
/SC7: U3.24 (SC7)
/SD4: U3.17 (SD4)
/SD5: U3.19 (SD5)
/SD6: U3.21 (SD6)
/SD7: U3.23 (SD7)
/VIN: A1.VIN, J40.8
/VS_A: A1.D46, J12.19
/VS_B: A1.D47, J12.18
COL0: A1.D26, J8.29, R25.2
COL1: A1.D27, J12.24, R26.2
COL2: A1.D28, J12.25, R27.2
COL3: A1.D29, J3.16, R28.2
COL4: A1.D48, J3.15, R3.2
COMM_OLED_SC: J8.25, U3.12 (SC1)
COMM_OLED_SD: J8.26, U3.11 (SD1)
ES1_RST: A1.D53 (D53_CS), U1.B5 (RST), U3.5 (~RESET)
GND: A1.GND1 (GND), A1.GND2 (GND), A1.GND3 (GND), A1.GND5 (GND), A1.GND6 (GND), C1.2, C2.2, C4.2, C5.2, C10.2, C11.2, D1.1 (K), D2.1 (K), D3.1 (K), D4.1 (K), D8.1 (K), J2.1, J3.11, J4.2, J7.2, J8.4, J12.13, J20.1, J40.6, J40.7, J45.7, J50.2, J51.2, Q5.3 (S), R21.1, U1.A1 (GND_1), U1.A2 (GND_2), U1.B1 (GND_3), U2.4 (GND), U2.9 (GND), U3.2 (GND)
MISO: A1.D50 (D50_MISO), U1.B6 (MISO)
MOSI: A1.D51 (D51_MOSI), U1.A3 (MOSI)
NAV_OLED_SC: J8.27, U3.10 (SC0)
NAV_OLED_SD: J8.28, U3.9 (SD0)
unnamed: A1.D16 (D16/TX2), J43.3
unnamed: A1.D17 (D17/RX2), J43.4
unnamed: A1.D18 (D18/TX1), J43.5
unnamed: A1.D19 (D19/RX1), J43.6
unnamed: D1.2 (A), R1.2
unnamed: D2.2 (A), R2.2
unnamed: D3.2 (A), R7.2
unnamed: D4.2 (A), R8.2
unnamed: D8.2 (A), R12.2
unnamed: F2.2, J4.1
unnamed: F1.2, J7.1
unnamed: A1.A6, J41.7
unnamed: A1.A7, J41.8
unnamed: A1.A11, J42.4
unnamed: A1.A12, J42.5
unnamed: A1.D13, J45.6
unnamed: Q5.1 (G), R19.1, R21.2
unnamed: R9.2, U1.A6 (INT)
unnamed: R5.1, U2.18 (ISET)
ROW0: A1.D22, J3.17, J8.30, J12.26
ROW1: A1.D23, J3.18, J8.31, J12.27
ROW2: A1.D24, J3.19, J8.32, J12.28
ROW3: A1.D25, J3.20, J8.33, J12.29
SCL: A1.SCL, J45.10, U3.4 (SCL)
SCLK: A1.D52 (D52_SCK), U1.A4 (SCLK)
SDA: A1.SDA, J45.9, U3.3 (SDA)
SS: A1.D10, J45.3, U1.A5 (CS)

Notes on the sheet:
Pin 34 open
MAX 2 AMPS
INTERNAL 5V PINS
Ethernet Module Library from https://componentsearchengine.com/part-view/USR-ES1/Smart%20Electronics
LEDCONTROL Ic_2=LEDCONTROL(49,48,47,X); 49 - DATA IN 48 - CLK 47 - LOAD/CS Digits = Columns = Cathodes - ""-"" Segments = Rows = Anodes - ""+""
Cannot use
(PIN A3)
0 1 2 3 4 5 6 7
Red LED - solid on until a packet is succesfully sent to controller
5V_LINK
21 20 19 18 17 16 15 14
EXTERNAL 5V PINS
8 9 10 11 12 13

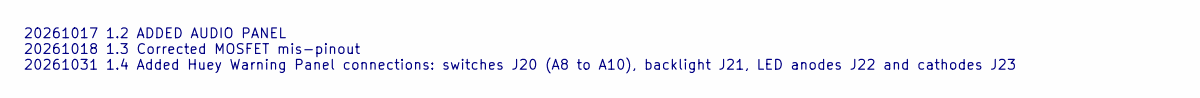
[picture p473: schematic CHANGELOG.kicad_sch]

Notes on the sheet:
20261017 1.2 ADDED AUDIO PANEL 20261018 1.3 Corrected MOSFET mis-pinout 20261031 1.4 Added Huey Warning Panel connections: switches J20 (A8 to A10), backlight J21, LED anodes J22 and cathodes J23

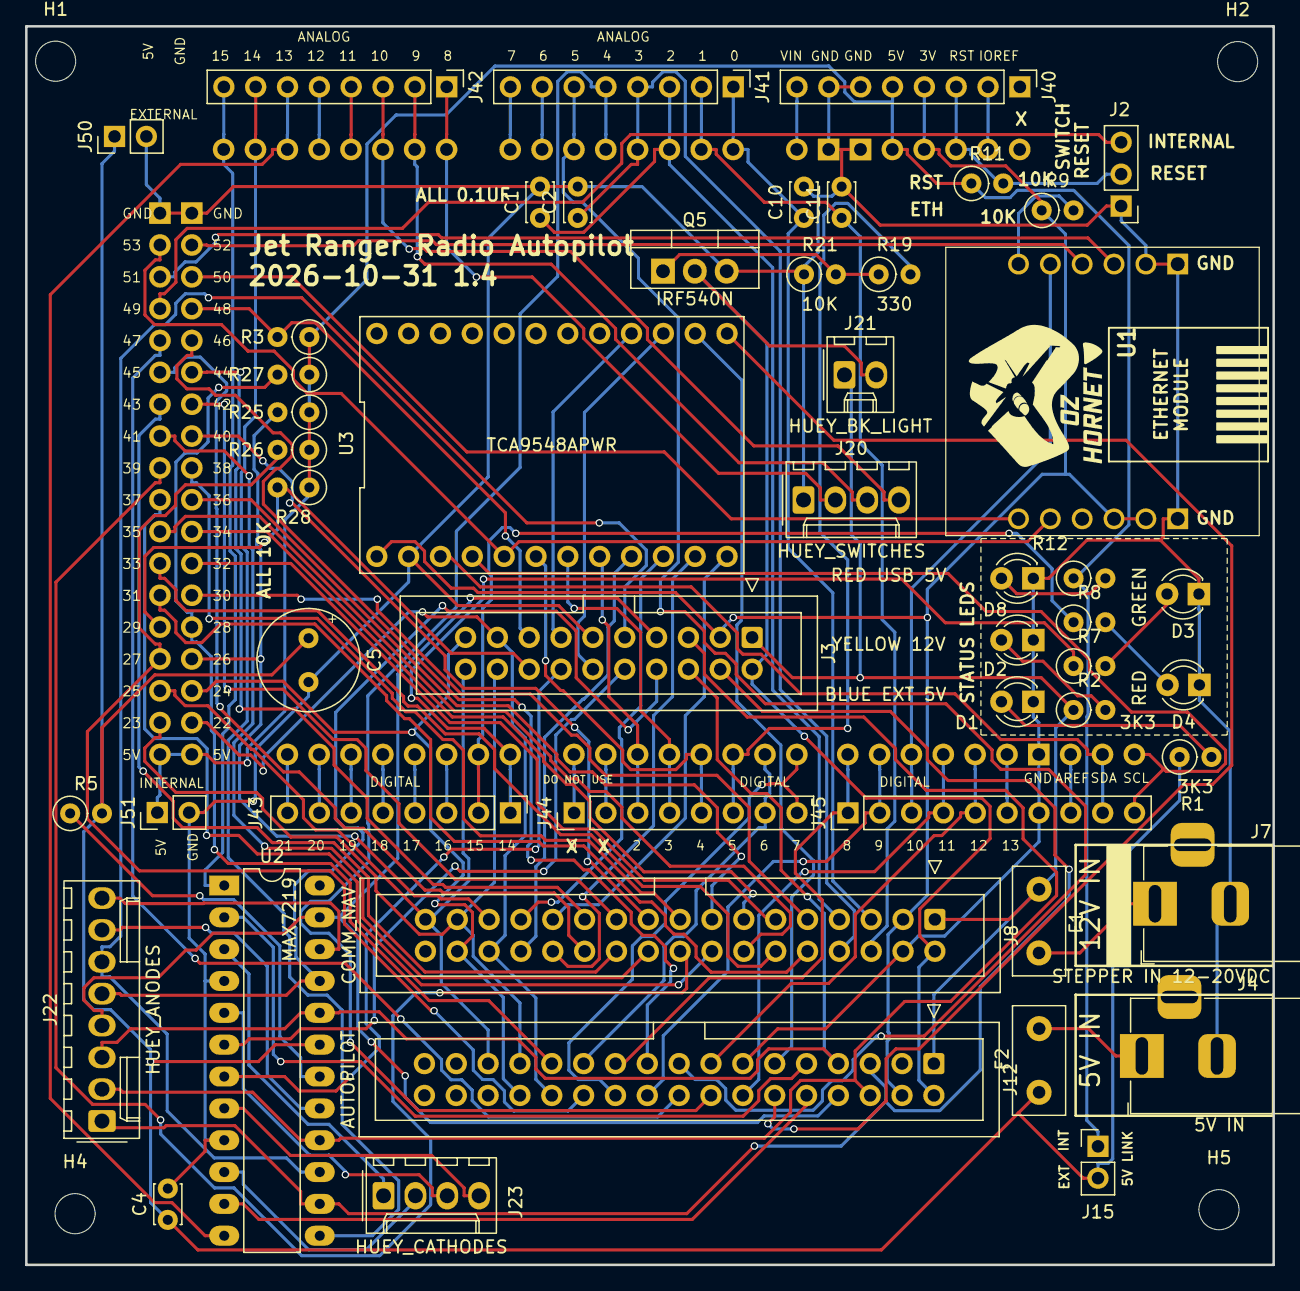
[picture p474: board Jet Ranger Radio Auto Pilot.kicad_pcb from above]

Board: 2 copper layers, 99.5 x 98.8 mm, 56 parts (0 on the bottom side), 116 nets.
