bnepethomas/bne-arduino-flight-simulator-interfaces/Jet Ranger/PCBs/Jet Ranger Huey Panel/Jet Ranger Huey Panel.kicad_pcb

## KiCad design Jet Ranger/PCBs/Jet Ranger Huey Panel/Jet Ranger Huey Panel.kicad_pcb (2026-10-30)

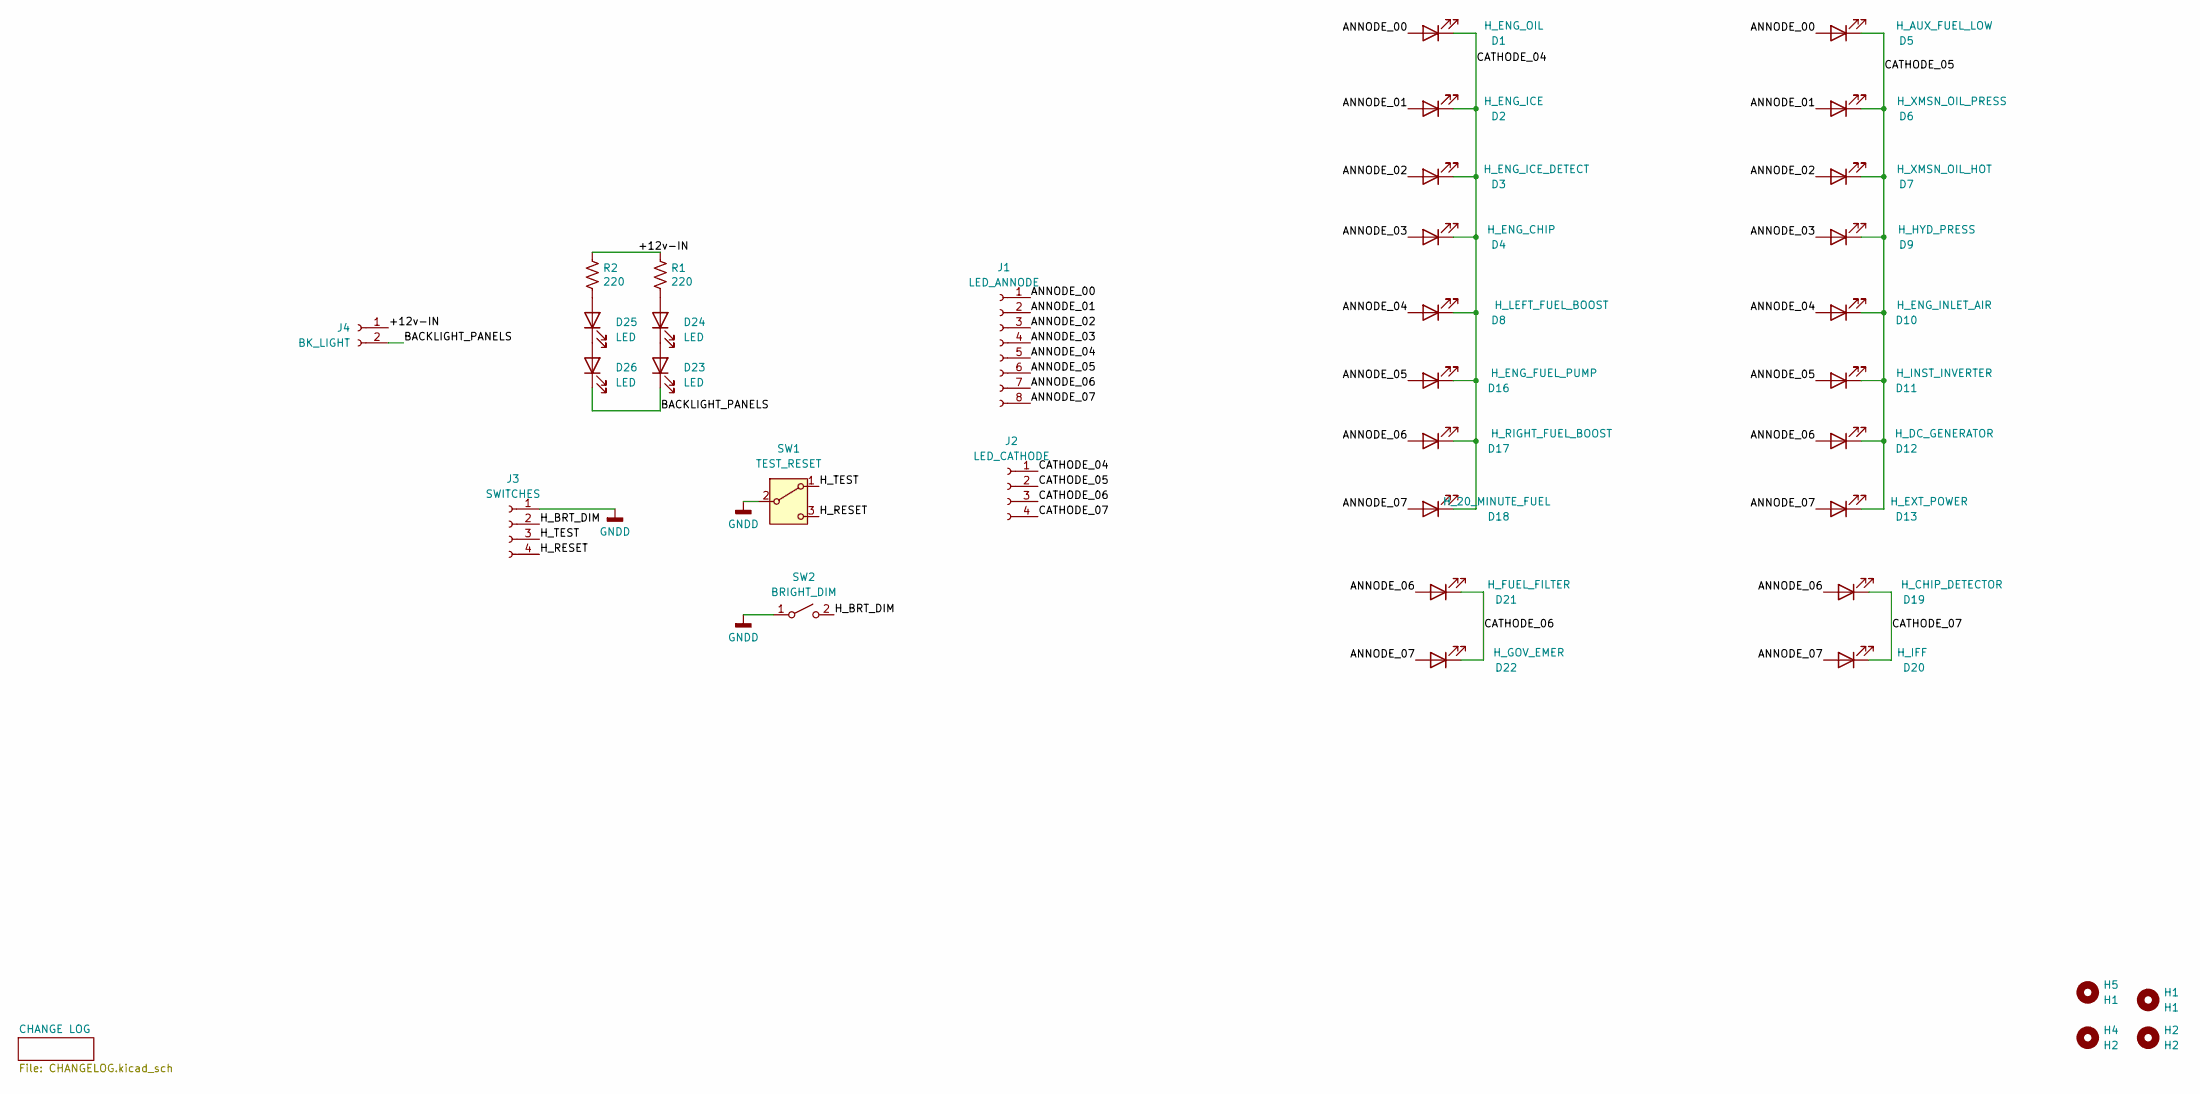
[picture p475: schematic Jet Ranger Huey Panel.kicad_sch]

Parts:
D1: H_ENG_OIL; LED_D3.0mm
D2: H_ENG_ICE; LED_D3.0mm
D3: H_ENG_ICE_DETECT; LED_D3.0mm
D4: H_ENG_CHIP; LED_D3.0mm
D5: H_AUX_FUEL_LOW; LED_D3.0mm
D6: H_XMSN_OIL_PRESS; LED_D3.0mm
D7: H_XMSN_OIL_HOT; LED_D3.0mm
D8: H_LEFT_FUEL_BOOST; LED_D3.0mm
D9: H_HYD_PRESS; LED_D3.0mm
D10: H_ENG_INLET_AIR; LED_D3.0mm
D11: H_INST_INVERTER; LED_D3.0mm
D12: H_DC_GENERATOR; LED_D3.0mm
D13: H_EXT_POWER; LED_D3.0mm
D16: H_ENG_FUEL_PUMP; LED_D3.0mm
D17: H_RIGHT_FUEL_BOOST; LED_D3.0mm
D18: H_20_MINUTE_FUEL; LED_D3.0mm
D19: H_CHIP_DETECTOR; LED_D3.0mm
D20: H_IFF; LED_D3.0mm
D21: H_FUEL_FILTER; LED_D3.0mm
D22: H_GOV_EMER; LED_D3.0mm
D23, D24, D25, D26: LED; LED_D3.0mm
H1, H5: H1; MountingHole_3.2mm_M3
H2, H4: H2; MountingHole_3.2mm_M3
J1: LED_ANNODE; Molex_KK-254_AE-6410-08A_1x08_P2.54mm_Vertical
J2: LED_CATHODE; Molex_KK-254_AE-6410-04A_1x04_P2.54mm_Vertical
J3: SWITCHES; Molex_KK-254_AE-6410-04A_1x04_P2.54mm_Vertical
J4: BK_LIGHT; Molex_KK-254_AE-6410-02A_1x02_P2.54mm_Vertical
R1, R2: 220; R_Axial_DIN0207_L6.3mm_D2.5mm_P2.54mm_Vertical
SW1: TEST_RESET; Molex_KK-254_AE-6410-03A_1x03_P2.54mm_Vertical
SW2: BRIGHT_DIM; Molex_KK-254_AE-6410-02A_1x02_P2.54mm_Vertical

Connections:
/+12v-IN: J4.1, R1.1, R2.1
/ANNODE_00: D1.2 (A), D5.2 (A), J1.1
/ANNODE_01: D2.2 (A), D6.2 (A), J1.2
/ANNODE_02: D3.2 (A), D7.2 (A), J1.3
/ANNODE_03: D4.2 (A), D9.2 (A), J1.4
/ANNODE_04: D8.2 (A), D10.2 (A), J1.5
/ANNODE_05: D11.2 (A), D16.2 (A), J1.6
/ANNODE_06: D12.2 (A), D17.2 (A), D19.2 (A), D21.2 (A), J1.7
/ANNODE_07: D13.2 (A), D18.2 (A), D20.2 (A), D22.2 (A), J1.8
/BACKLIGHT_PANELS: D23.1 (K), D26.1 (K), J4.2
/CATHODE_04: D1.1 (K), D2.1 (K), D3.1 (K), D4.1 (K), D8.1 (K), D16.1 (K), D17.1 (K), D18.1 (K), J2.1
/CATHODE_05: D5.1 (K), D6.1 (K), D7.1 (K), D9.1 (K), D10.1 (K), D11.1 (K), D12.1 (K), D13.1 (K), J2.2
/CATHODE_06: D21.1 (K), D22.1 (K), J2.3
/CATHODE_07: D19.1 (K), D20.1 (K), J2.4
/H_BRT_DIM: J3.2, SW2.2 (B)
/H_RESET: J3.4, SW1.3 (C)
/H_TEST: J3.3, SW1.1 (A)
GNDD: J3.1, SW1.2 (B), SW2.1 (A)
unnamed: D23.2 (A), D24.1 (K)
unnamed: D24.2 (A), R1.2
unnamed: D25.2 (A), R2.2
unnamed: D25.1 (K), D26.2 (A)

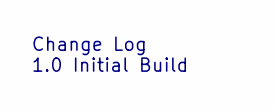
[picture p476: schematic CHANGELOG.kicad_sch]

Notes on the sheet:
Change Log 1.0 Initial Build

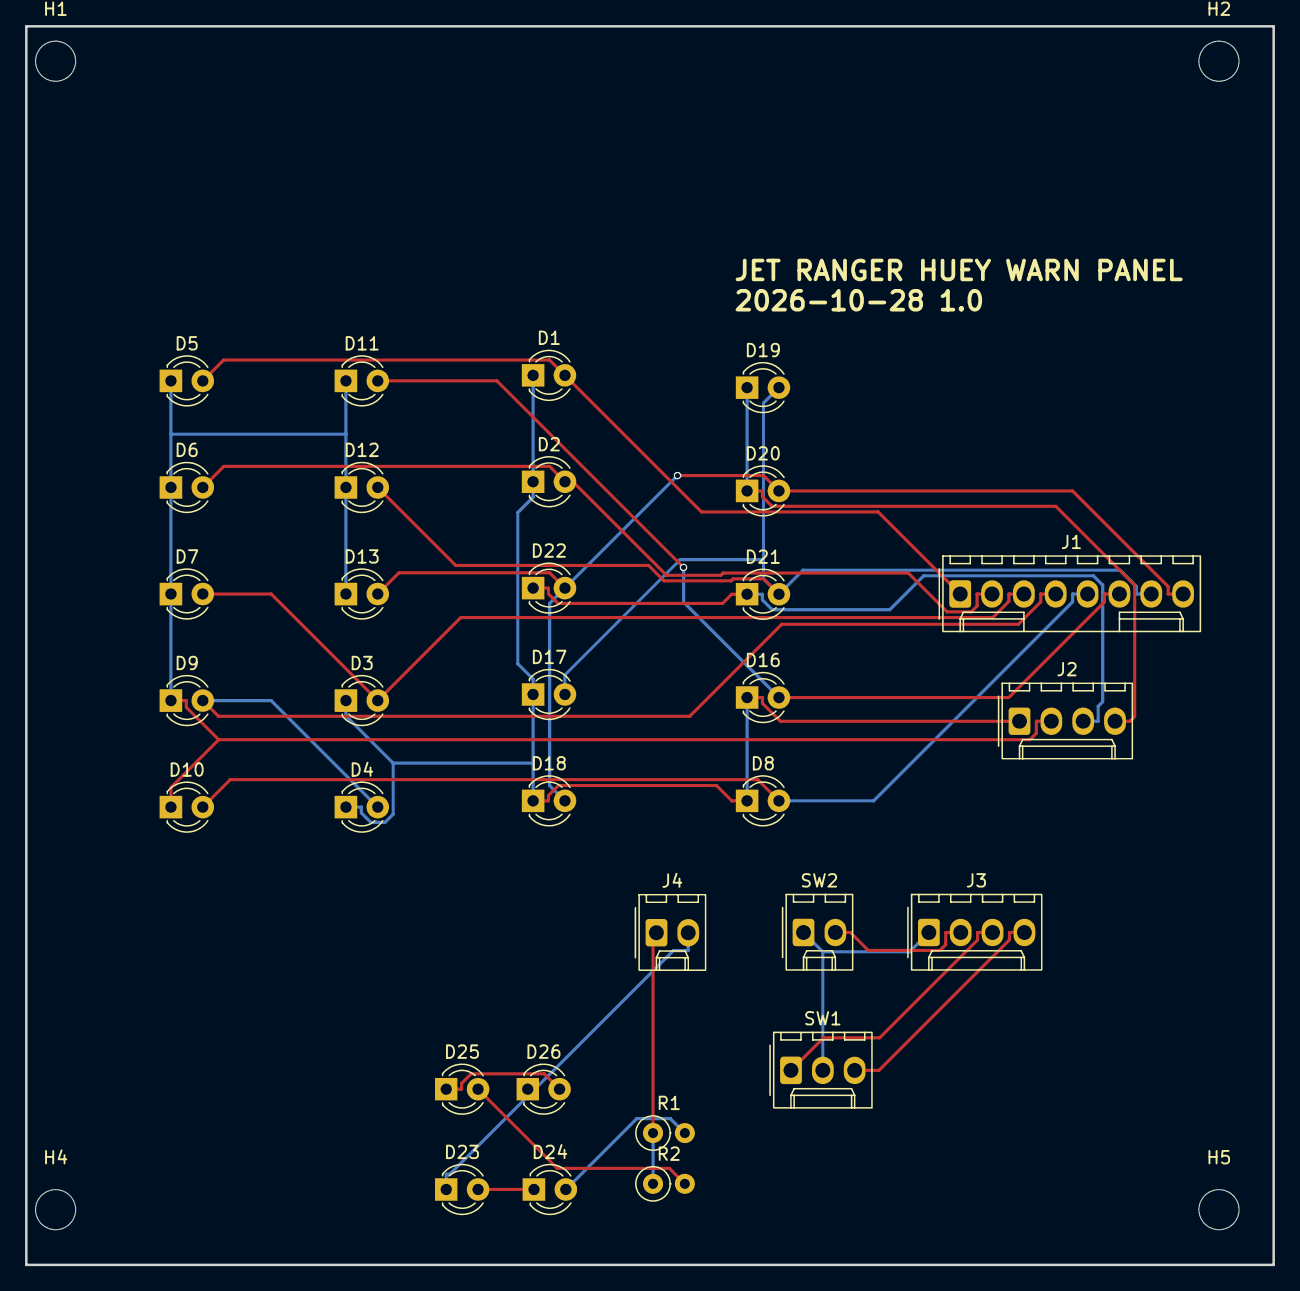
[picture p477: board Jet Ranger Huey Panel.kicad_pcb from above]

Board: 2 copper layers, 99.5 x 98.8 mm, 36 parts (0 on the bottom side), 22 nets.
