bnepethomas/bne-arduino-flight-simulator-interfaces/Jet Ranger/PCBs/JET RANGER UPPER ADF CONTROLLER/JET RANGER UPPER ADF CONTROLLER.kicad_pcb

## KiCad design Jet Ranger/PCBs/JET RANGER UPPER ADF CONTROLLER/JET RANGER UPPER ADF CONTROLLER.kicad_pcb (2026-10-26)

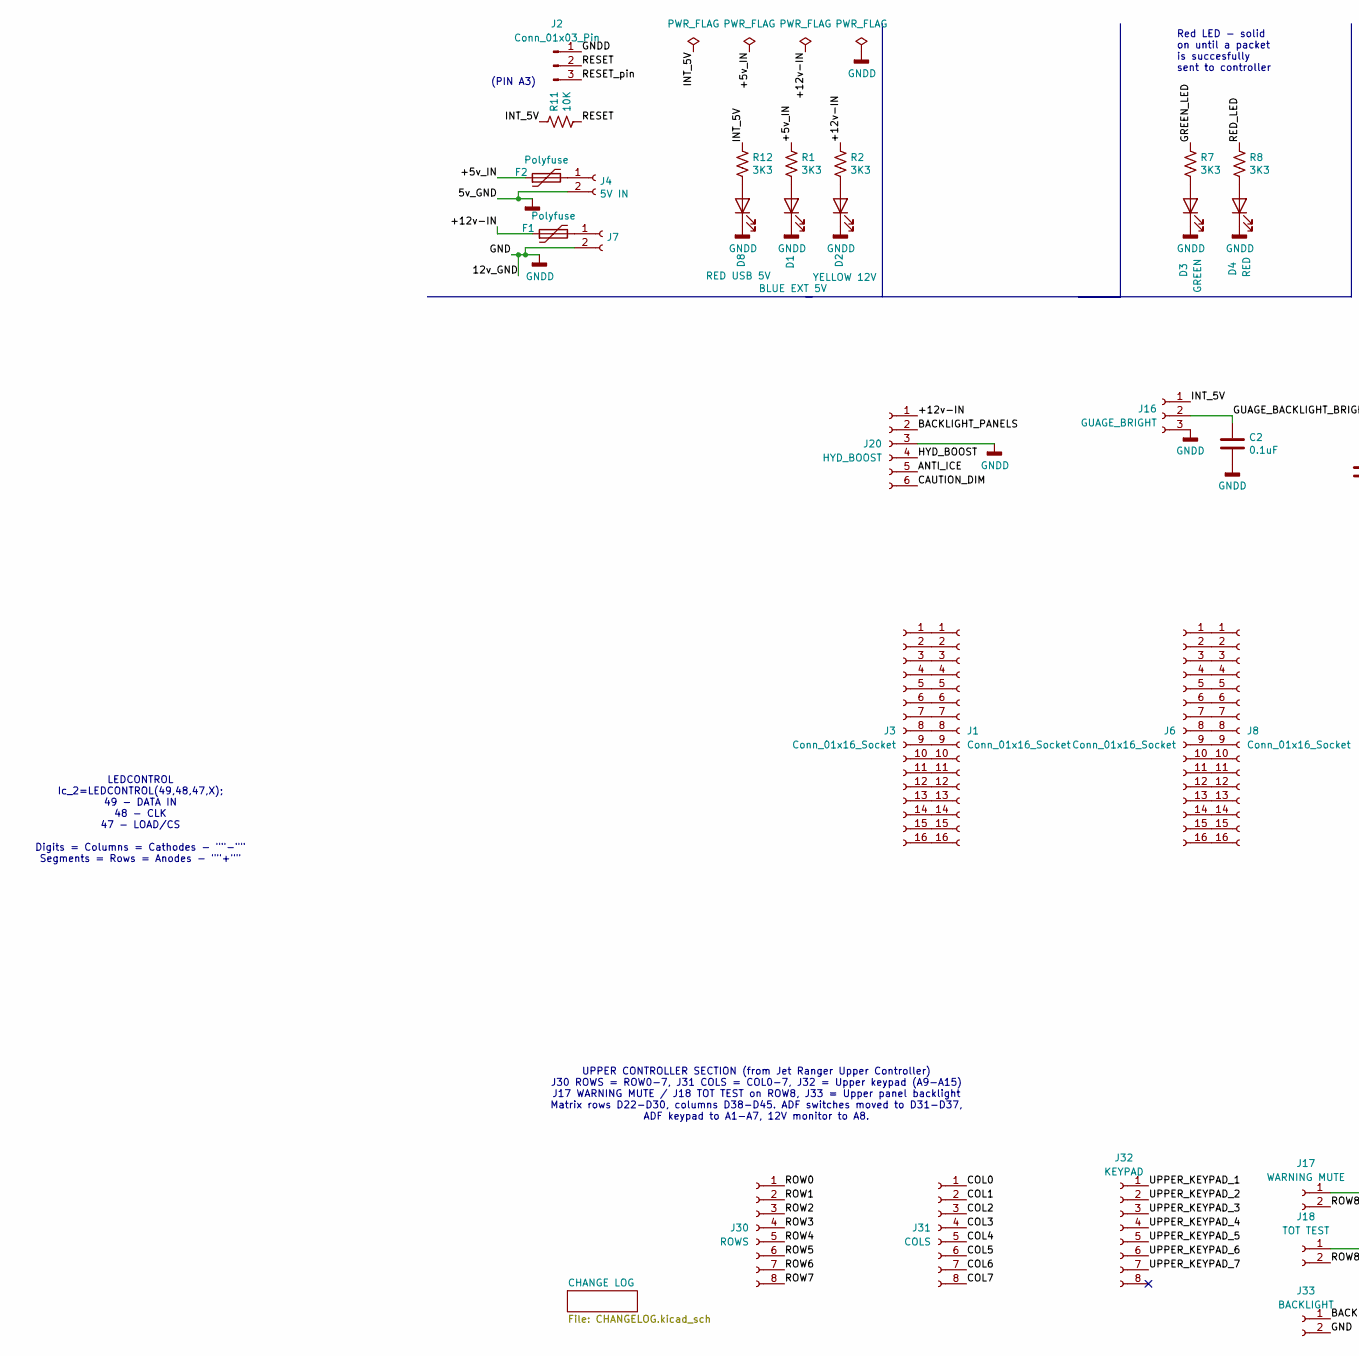
[picture p478: schematic JET RANGER UPPER ADF CONTROLLER.kicad_sch, Jet Ranger Upper + ADF Controller, part in row 1, column 1]

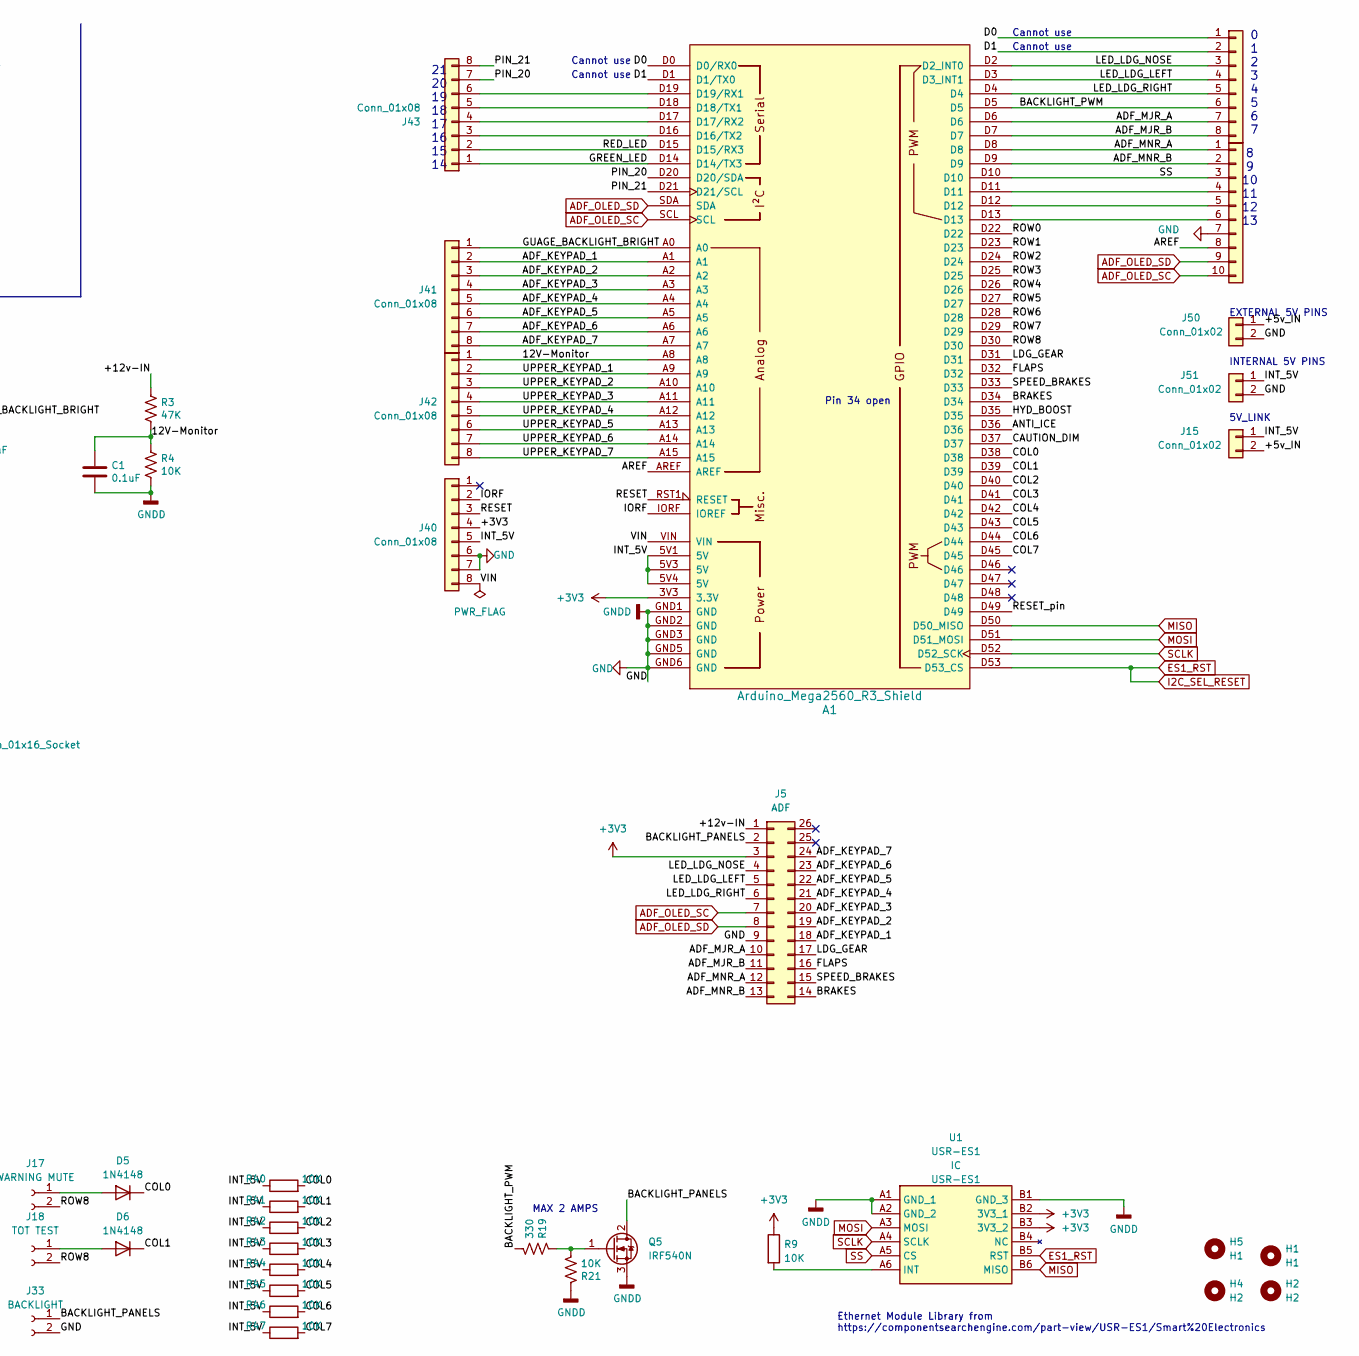
[picture p479: schematic JET RANGER UPPER ADF CONTROLLER.kicad_sch, Jet Ranger Upper + ADF Controller, part in row 1, column 2]

Parts:
A1: Arduino_Mega2560_R3_Shield
C1, C2: 0.1uF; C_Disc_D6.0mm_W2.5mm_P5.00mm
D1: BLUE EXT 5V; LED_D3.0mm
D2: YELLOW 12V; LED_D3.0mm
D3: GREEN; LED_D3.0mm
D4: RED; LED_D3.0mm
D5, D6: 1N4148; D_DO-35_SOD27_P7.62mm_Horizontal
D8: RED USB 5V; LED_D3.0mm
F1, F2: Polyfuse; Fuse_Littelfuse_395Series
H1, H5: H1; MountingHole_3.2mm_M3
H2, H4: H2; MountingHole_3.2mm_M3
J1, J3, J6, J8: Conn_01x16_Socket; PinHeader_1x16_P2.54mm_Vertical
J2: Conn_01x03_Pin; PinHeader_1x03_P2.54mm_Vertical
J4: 5V IN; BarrelJack_Horizontal
J5: ADF; IDC-Header_2x13_P2.54mm_Vertical
J7: STEPPER IN 12-20VDC; BarrelJack_Horizontal
J15, J50, J51: Conn_01x02; PinHeader_1x02_P2.54mm_Vertical
J16: GUAGE_BRIGHT; Molex_KK-254_AE-6410-03A_1x03_P2.54mm_Vertical
J17: WARNING MUTE; Molex_KK-254_AE-6410-02A_1x02_P2.54mm_Vertical
J18: TOT TEST; Molex_KK-254_AE-6410-02A_1x02_P2.54mm_Vertical
J20: HYD_BOOST; Molex_KK-254_AE-6410-06A_1x06_P2.54mm_Vertical
J30: ROWS; Molex_KK-254_AE-6410-08A_1x08_P2.54mm_Vertical
J31: COLS; Molex_KK-254_AE-6410-08A_1x08_P2.54mm_Vertical
J32: KEYPAD; Molex_KK-254_AE-6410-08A_1x08_P2.54mm_Vertical
J33: BACKLIGHT; Molex_KK-254_AE-6410-02A_1x02_P2.54mm_Vertical
J40, J41, J42, J43, J44: Conn_01x08; PinHeader_1x08_P2.54mm_Vertical
J45: Conn_01x10; PinHeader_1x10_P2.54mm_Vertical
Q5: IRF540N; TO-220-3_Vertical
R1, R2, R7, R8, R12: 3K3; R_Axial_DIN0207_L6.3mm_D2.5mm_P2.54mm_Vertical
R3: 47K; R_Axial_DIN0207_L6.3mm_D2.5mm_P2.54mm_Vertical
R4, R9, R11, R21, R40, R41, R42, R43, R44, R45, R46, R47: 10K; R_Axial_DIN0207_L6.3mm_D2.5mm_P2.54mm_Vertical
R19: 330; R_Axial_DIN0207_L6.3mm_D2.5mm_P2.54mm_Vertical
U1: USR-ES1; USRES1; Manufacturer_Part_Number USR-ES1

Connections:
+3V3: A1.3V3 (3.3V), J5.3, J40.4, R9.1, U1.B2 (3V3_1), U1.B3 (3V3_2)
/12V-Monitor: A1.A8, C1.1, J42.1, R3.2, R4.1
/+5v_IN: F2.1, J15.2, J50.1, R1.1
/+12v-IN: F1.1, J5.1, J20.1, R2.1, R3.1
/ADF_KEYPAD_1: A1.A1, J5.18, J41.2
/ADF_KEYPAD_2: A1.A2, J5.19, J41.3
/ADF_KEYPAD_3: A1.A3, J5.20, J41.4
/ADF_KEYPAD_4: A1.A4, J5.21, J41.5
/ADF_KEYPAD_5: A1.A5, J5.22, J41.6
/ADF_KEYPAD_6: A1.A6, J5.23, J41.7
/ADF_KEYPAD_7: A1.A7, J5.24, J41.8
/ADF_MJR_A: A1.D6, J5.10, J44.7
/ADF_MJR_B: A1.D7, J5.11, J44.8
/ADF_MNR_A: A1.D8, J5.12, J45.1
/ADF_MNR_B: A1.D9, J5.13, J45.2
/ANTI_ICE: A1.D36, J20.5
/AREF: A1.AREF, J45.8
/BACKLIGHT_PANELS: J5.2, J20.2, J33.1, Q5.2 (D)
/BACKLIGHT_PWM: A1.D5, J44.6, R19.2
/BRAKES: A1.D34, J5.14
/CAUTION_DIM: A1.D37, J20.6
/COL0: A1.D38, D5.1 (K), J31.1, R40.2
/COL1: A1.D39, D6.1 (K), J31.2, R41.2
/COL2: A1.D40, J31.3, R42.2
/COL3: A1.D41, J31.4, R43.2
/COL4: A1.D42, J31.5, R44.2
/COL5: A1.D43, J31.6, R45.2
/COL6: A1.D44, J31.7, R46.2
/COL7: A1.D45, J31.8, R47.2
/D0: A1.D0 (D0/RX0), J44.1
/D1: A1.D1 (D1/TX0), J44.2
/FLAPS: A1.D32, J5.16
/GREEN_LED: A1.D14 (D14/TX3), J43.1, R7.1
/GUAGE_BACKLIGHT_BRIGHT: A1.A0, C2.1, J16.2, J41.1
/HYD_BOOST: A1.D35, J20.4
/INT_5V: A1.5V1 (5V), A1.5V3 (5V), A1.5V4 (5V), J15.1, J16.1, J40.5, J51.1, R11.1, R12.1, R40.1, R41.1, R42.1, R43.1, R44.1, R45.1, R46.1, R47.1
/IORF: A1.IORF (IOREF), J40.2
/LDG_GEAR: A1.D31, J5.17
/LED_LDG_LEFT: A1.D3 (D3_INT1), J5.5, J44.4
/LED_LDG_NOSE: A1.D2 (D2_INT0), J5.4, J44.3
/LED_LDG_RIGHT: A1.D4, J5.6, J44.5
/PIN_20: A1.D20 (D20/SDA), J43.7
/PIN_21: A1.D21 (D21/SCL), J43.8
/RED_LED: A1.D15 (D15/RX3), J43.2, R8.1
/RESET: A1.RST1 (RESET), J2.2, J40.3, R11.2
/RESET_pin: A1.D49, J2.3
/ROW0: A1.D22, J30.1
/ROW1: A1.D23, J30.2
/ROW2: A1.D24, J30.3
/ROW3: A1.D25, J30.4
/ROW4: A1.D26, J30.5
/ROW5: A1.D27, J30.6
/ROW6: A1.D28, J30.7
/ROW7: A1.D29, J30.8
/ROW8: A1.D30, J17.2, J18.2
/SPEED_BRAKES: A1.D33, J5.15
/UPPER_KEYPAD_1: A1.A9, J32.1, J42.2
/UPPER_KEYPAD_2: A1.A10, J32.2, J42.3
/UPPER_KEYPAD_3: A1.A11, J32.3, J42.4
/UPPER_KEYPAD_4: A1.A12, J32.4, J42.5
/UPPER_KEYPAD_5: A1.A13, J32.5, J42.6
/UPPER_KEYPAD_6: A1.A14, J32.6, J42.7
/UPPER_KEYPAD_7: A1.A15, J32.7, J42.8
/VIN: A1.VIN, J40.8
ADF_OLED_SC: A1.SCL, J5.7, J45.10
ADF_OLED_SD: A1.SDA, J5.8, J45.9
ES1_RST: A1.D53 (D53_CS), U1.B5 (RST)
GND: A1.GND1 (GND), A1.GND2 (GND), A1.GND3 (GND), A1.GND5 (GND), A1.GND6 (GND), C1.2, C2.2, D1.1 (K), D2.1 (K), D3.1 (K), D4.1 (K), D8.1 (K), J2.1, J4.2, J5.9, J7.2, J16.3, J20.3, J33.2, J40.6, J40.7, J45.7, J50.2, J51.2, Q5.3 (S), R4.2, R21.1, U1.A1 (GND_1), U1.A2 (GND_2), U1.B1 (GND_3)
MISO: A1.D50 (D50_MISO), U1.B6 (MISO)
MOSI: A1.D51 (D51_MOSI), U1.A3 (MOSI)
unnamed: A1.D16 (D16/TX2), J43.3
unnamed: A1.D17 (D17/RX2), J43.4
unnamed: A1.D18 (D18/TX1), J43.5
unnamed: A1.D19 (D19/RX1), J43.6
unnamed: D1.2 (A), R1.2
unnamed: D2.2 (A), R2.2
unnamed: D3.2 (A), R7.2
unnamed: D4.2 (A), R8.2
unnamed: D5.2 (A), J17.1
unnamed: D6.2 (A), J18.1
unnamed: D8.2 (A), R12.2
unnamed: J1.1, J3.1
unnamed: J1.2, J3.2
unnamed: J1.3, J3.3
unnamed: J1.4, J3.4
unnamed: J1.5, J3.5
unnamed: J1.6, J3.6
unnamed: J1.7, J3.7
unnamed: J1.8, J3.8
unnamed: J1.9, J3.9
unnamed: J1.10, J3.10
unnamed: J1.11, J3.11
unnamed: J1.12, J3.12
unnamed: J1.13, J3.13
unnamed: J1.14, J3.14
unnamed: J1.15, J3.15
unnamed: J1.16, J3.16
unnamed: F2.2, J4.1
unnamed: J6.1, J8.1
unnamed: J6.2, J8.2
unnamed: J6.3, J8.3
unnamed: J6.4, J8.4
unnamed: J6.5, J8.5
unnamed: J6.6, J8.6
unnamed: J6.7, J8.7
unnamed: J6.8, J8.8
unnamed: J6.9, J8.9
unnamed: J6.10, J8.10
unnamed: J6.11, J8.11
unnamed: J6.12, J8.12
unnamed: J6.13, J8.13
unnamed: J6.14, J8.14
unnamed: J6.15, J8.15
unnamed: J6.16, J8.16
unnamed: F1.2, J7.1
unnamed: A1.D11, J45.4
unnamed: A1.D12, J45.5
unnamed: A1.D13, J45.6
unnamed: Q5.1 (G), R19.1, R21.2
unnamed: R9.2, U1.A6 (INT)
SCLK: A1.D52 (D52_SCK), U1.A4 (SCLK)
SS: A1.D10, J45.3, U1.A5 (CS)

Notes on the sheet:
Pin 34 open
MAX 2 AMPS
INTERNAL 5V PINS
Ethernet Module Library from https://componentsearchengine.com/part-view/USR-ES1/Smart%20Electronics
Cannot use
(PIN A3)
0 1 2 3 4 5 6 7
LEDCONTROL Ic_2=LEDCONTROL(49,48,47,X); 49 - DATA IN 48 - CLK 47 - LOAD/CS Digits = Columns = Cathodes - ""-"" Segments = Rows = Anodes - ""+""
Red LED - solid on until a packet is succesfully sent to controller
5V_LINK
21 20 19 18 17 16 15 14
EXTERNAL 5V PINS
8 9 10 11 12 13
UPPER CONTROLLER SECTION (from Jet Ranger Upper Controller) J30 ROWS = ROW0-7, J31 COLS = COL0-7, J32 = Upper keypad (A9-A15) J17 WARNING MUTE / J18 TOT TEST on ROW8, J33 = Upper panel backlight Matrix rows D22-D30, columns D38-D45. ADF switches moved to D31-D37, ADF keypad to A1-A7, 12V monitor to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
