bnepethomas/bne-arduino-flight-simulator-interfaces/Jet Ranger/PCBs/JET RANGER UPPER ADF CONTROLLER/JET RANGER UPPER ADF CONTROLLER.kicad_pcb

## KiCad design Jet Ranger/PCBs/JET RANGER UPPER ADF CONTROLLER/JET RANGER UPPER ADF CONTROLLER.kicad_pcb (continued)

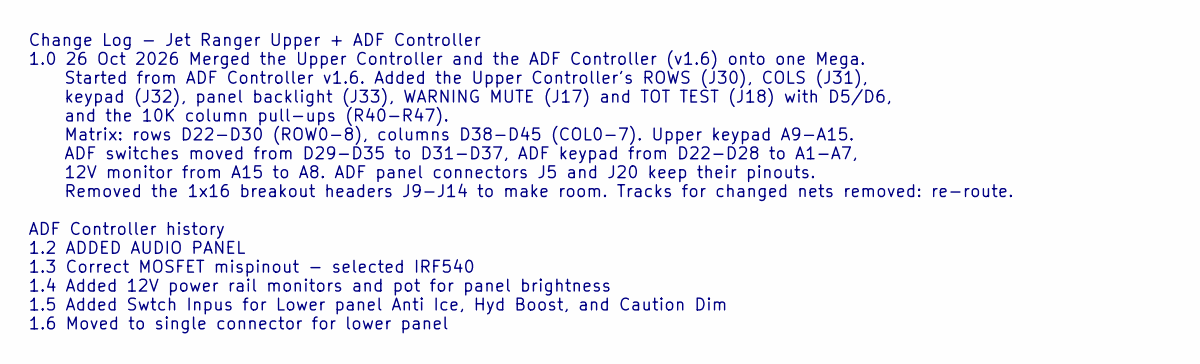
[picture p480: schematic CHANGELOG.kicad_sch]

Notes on the sheet:
Change Log - Jet Ranger Upper + ADF Controller 1.0 26 Oct 2026 Merged the Upper Controller and the ADF Controller (v1.6) onto one Mega. Started from ADF Controller v1.6. Added the Upper Controller's ROWS (J30), COLS (J31), keypad (J32), panel backlight (J33), WARNING MUTE (J17) and TOT TEST (J18) w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

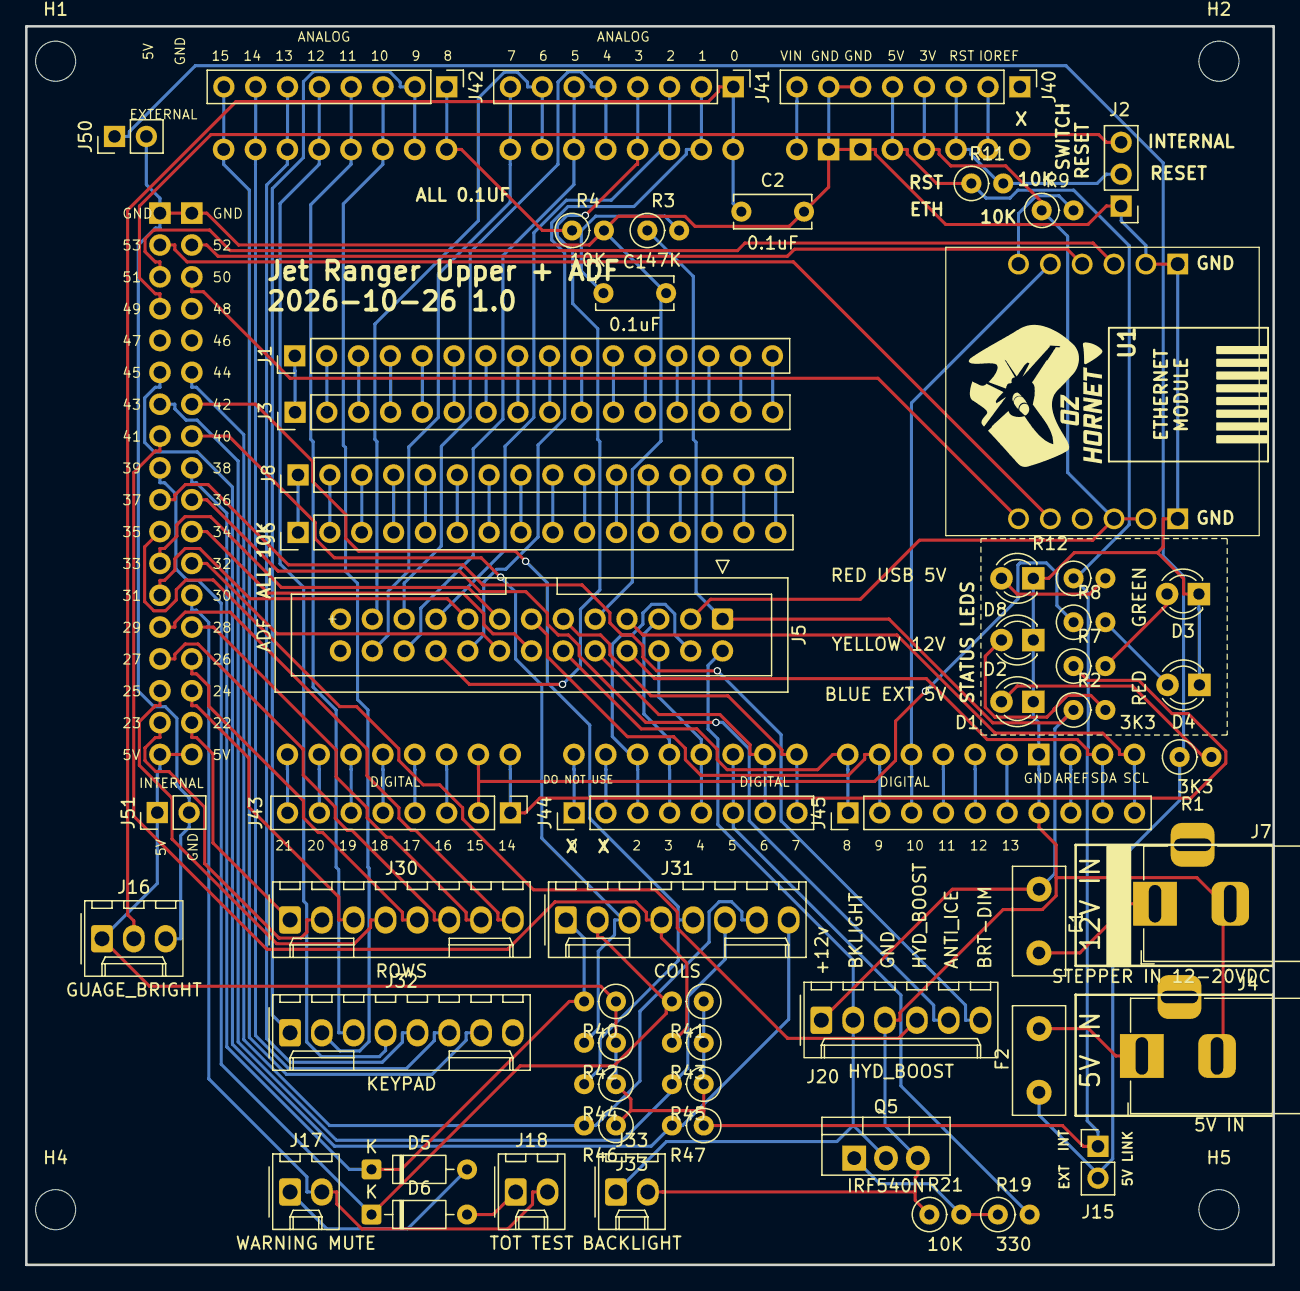
[picture p481: board JET RANGER UPPER ADF CONTROLLER.kicad_pcb from above]

Board: 2 copper layers, 99.5 x 98.8 mm, 62 parts (0 on the bottom side), 122 nets.
