bnepethomas/bne-arduino-flight-simulator-interfaces/Jet Ranger/PCBs/Jet Ranger Front Panel Servo/Jet Ranger Front Panel Servo.kicad_pcb

## KiCad design Jet Ranger/PCBs/Jet Ranger Front Panel Servo/Jet Ranger Front Panel Servo.kicad_pcb (2026-10-18)

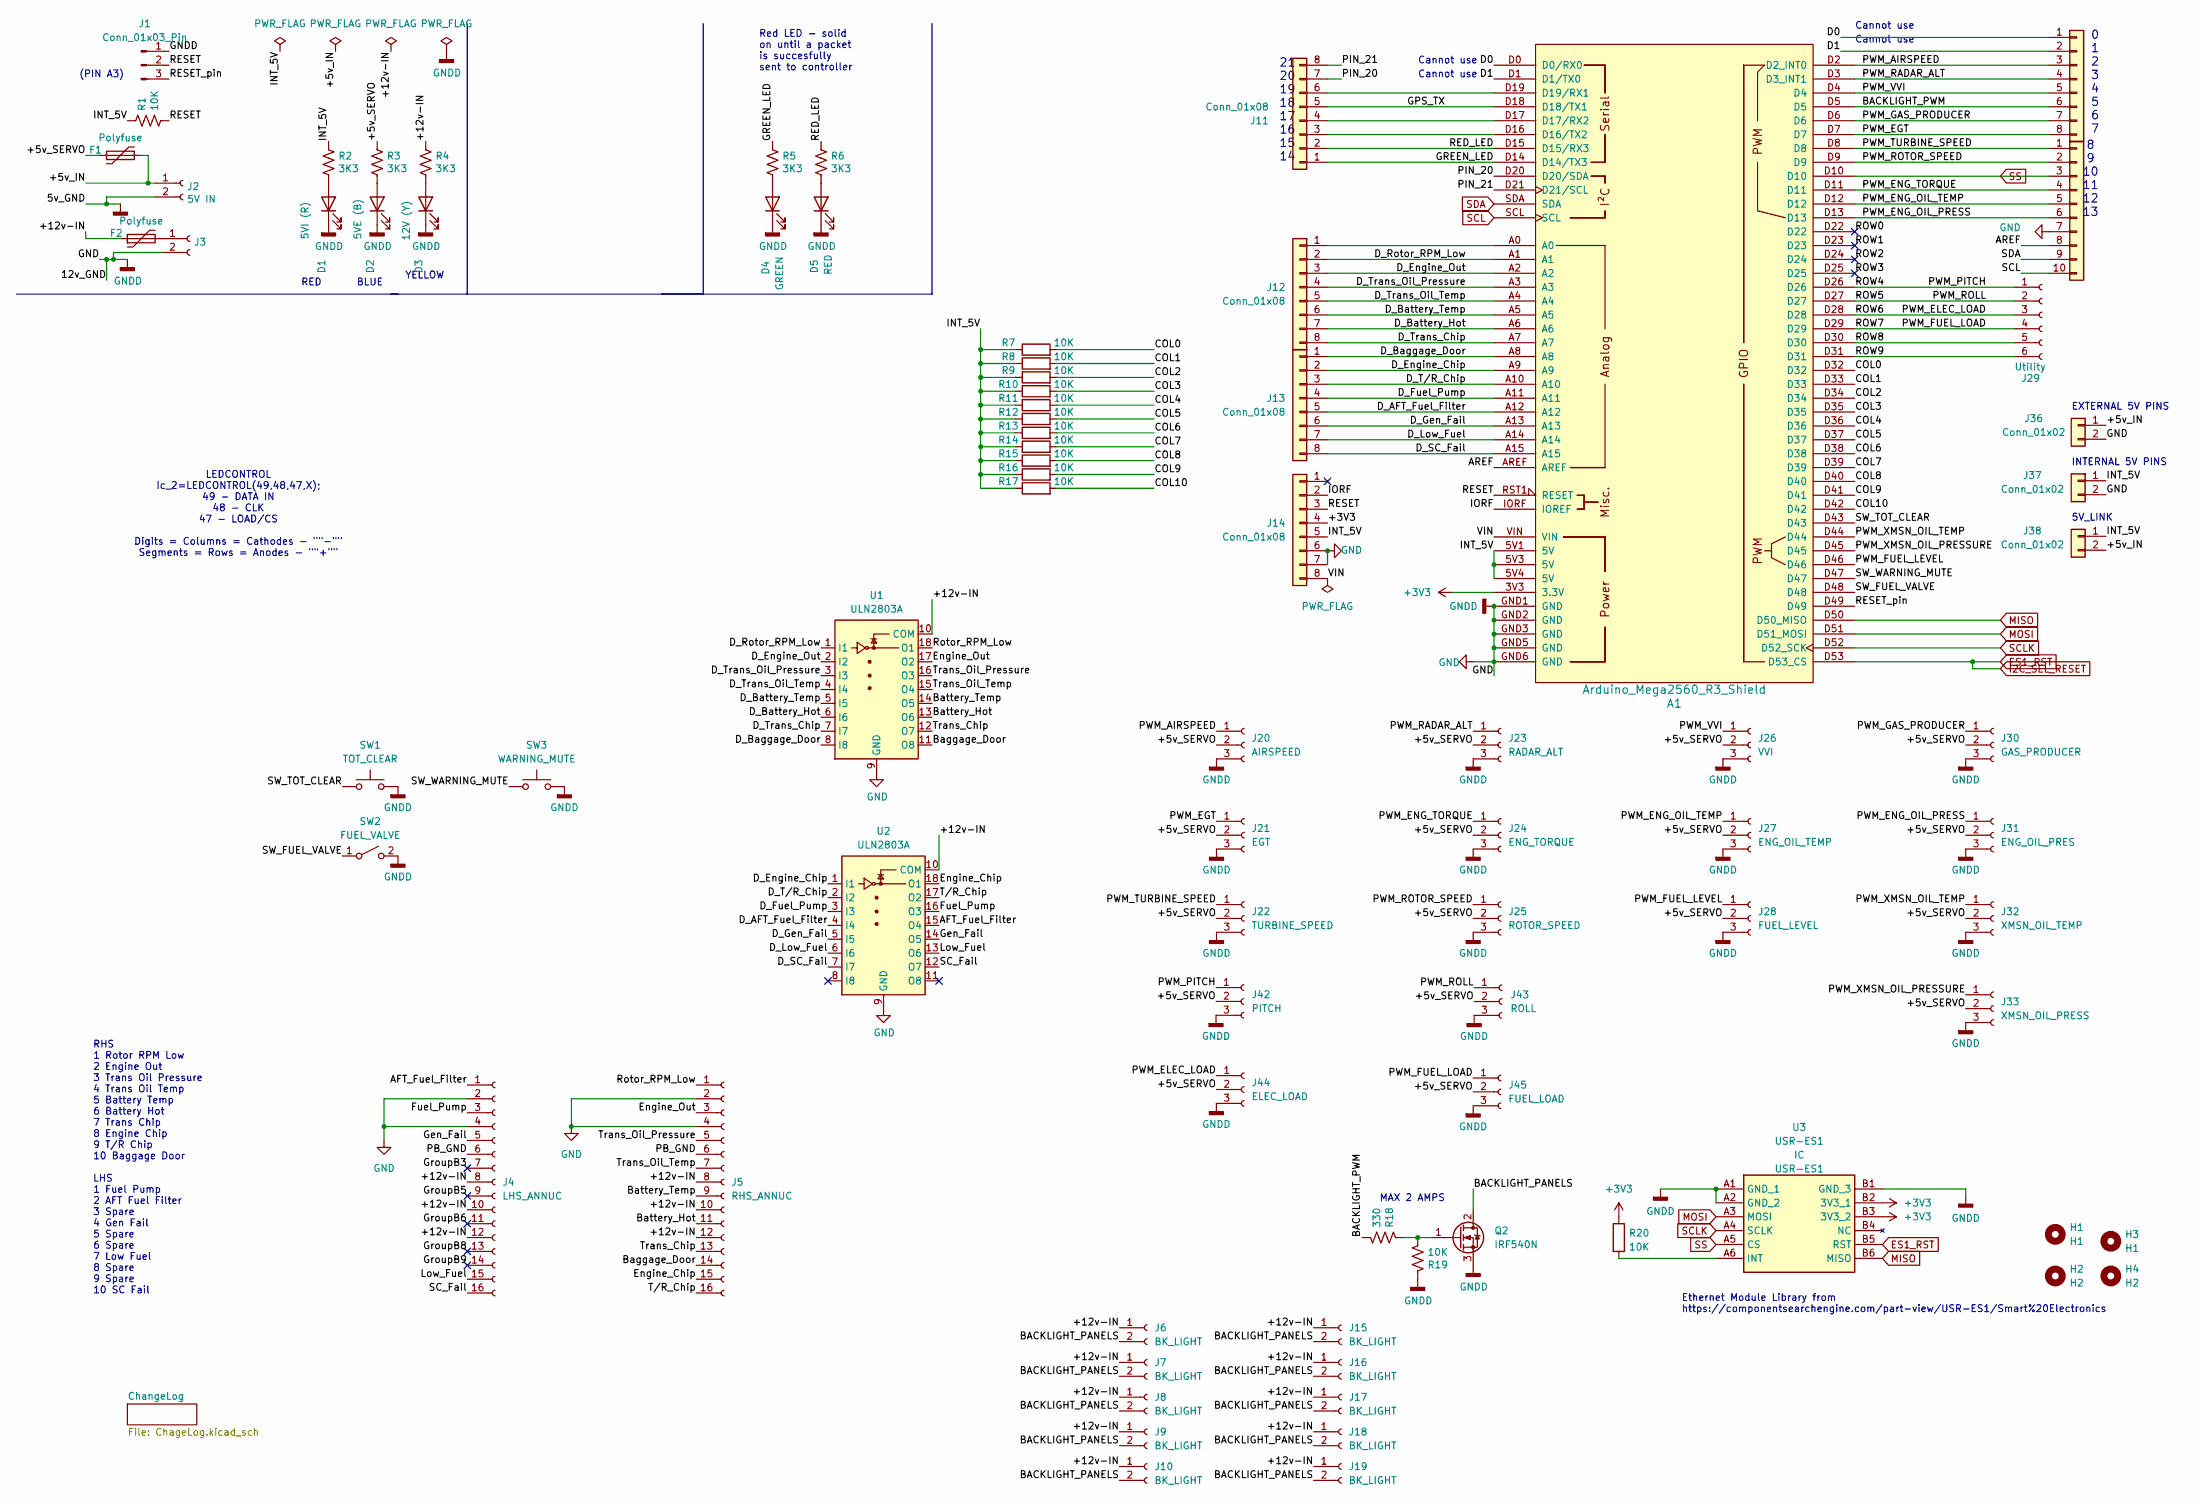
[picture p482: schematic Jet Ranger Front Panel Servo.kicad_sch]

Parts:
A1: Arduino_Mega2560_R3_Shield
D1: 5VI (R); LED_D3.0mm
D2: 5VE (B); LED_D3.0mm
D3: 12V (Y); LED_D3.0mm
D4: GREEN; LED_D3.0mm
D5: RED; LED_D3.0mm
F1, F2: Polyfuse; Fuse_Littelfuse_395Series
H1, H3: H1; MountingHole_3.2mm_M3
H2, H4: H2; MountingHole_3.2mm_M3
J1: Conn_01x03_Pin; PinHeader_1x03_P2.54mm_Vertical
J2: 5V IN; BarrelJack_Horizontal
J3: STEPPER IN 12-20VDC; BarrelJack_Horizontal
J4: LHS_ANNUC; IDC-Header_2x08_P2.54mm_Vertical
J5: RHS_ANNUC; IDC-Header_2x08_P2.54mm_Vertical
J6, J7, J8, J9, J10, J15, J16, J17, J18, J19: BK_LIGHT; Molex_KK-254_AE-6410-02A_1x02_P2.54mm_Vertical
J11, J12, J13, J14, J34: Conn_01x08; PinHeader_1x08_P2.54mm_Vertical
J20: AIRSPEED; PinHeader_1x03_P2.54mm_Vertical
J21: EGT; PinHeader_1x03_P2.54mm_Vertical
J22: TURBINE_SPEED; PinHeader_1x03_P2.54mm_Vertical
J23: RADAR_ALT; PinHeader_1x03_P2.54mm_Vertical
J24: ENG_TORQUE; PinHeader_1x03_P2.54mm_Vertical
J25: ROTOR_SPEED; PinHeader_1x03_P2.54mm_Vertical
J26: VVI; PinHeader_1x03_P2.54mm_Vertical
J27: ENG_OIL_TEMP; PinHeader_1x03_P2.54mm_Vertical
J28: FUEL_LEVEL; PinHeader_1x03_P2.54mm_Vertical
J29: Utility; PinHeader_1x06_P2.54mm_Vertical
J30: GAS_PRODUCER; PinHeader_1x03_P2.54mm_Vertical
J31: ENG_OIL_PRES; PinHeader_1x03_P2.54mm_Vertical
J32: XMSN_OIL_TEMP; PinHeader_1x03_P2.54mm_Vertical
J33: XMSN_OIL_PRESS; PinHeader_1x03_P2.54mm_Vertical
J35: Conn_01x10; PinHeader_1x10_P2.54mm_Vertical
J36, J37, J38: Conn_01x02; PinHeader_1x02_P2.54mm_Vertical
J42: PITCH; PinHeader_1x03_P2.54mm_Vertical
J43: ROLL; PinHeader_1x03_P2.54mm_Vertical
J44: ELEC_LOAD; PinHeader_1x03_P2.54mm_Vertical
J45: FUEL_LOAD; PinHeader_1x03_P2.54mm_Vertical
Q2: IRF540N; TO-220-3_Vertical
R1, R7, R8, R9, R10, R11, R12, R13, R14, R15, R16, R17, R19, R20: 10K; R_Axial_DIN0207_L6.3mm_D2.5mm_P2.54mm_Vertical
R2, R3, R4, R5, R6: 3K3; R_Axial_DIN0207_L6.3mm_D2.5mm_P2.54mm_Vertical
R18: 330; R_Axial_DIN0207_L6.3mm_D2.5mm_P2.54mm_Vertical
SW1: TOT_CLEAR; Molex_KK-254_AE-6410-02A_1x02_P2.54mm_Vertical
SW2: FUEL_VALVE; Molex_KK-254_AE-6410-02A_1x02_P2.54mm_Vertical
SW3: WARNING_MUTE; Molex_KK-254_AE-6410-02A_1x02_P2.54mm_Vertical
U1, U2: ULN2803A; DIP-18_W7.62mm
U3: USR-ES1; USRES1; Manufacturer_Part_Number USR-ES1

Connections:
+3V3: A1.3V3 (3.3V), J14.4, R20.1, U3.B2 (3V3_1), U3.B3 (3V3_2)
/+5v_IN: F1.2, J2.1, J36.1, J38.2
/+5v_SERVO: F1.1, J20.2, J21.2, J22.2, J23.2, J24.2, J25.2, J26.2, J27.2, J28.2, J30.2, J31.2, J32.2, J33.2, J42.2, J43.2, J44.2, J45.2, R3.1
/+12v-IN: F2.1, J4.8, J4.10, J4.12, J5.8, J5.10, J5.12, J6.1, J7.1, J8.1, J9.1, J10.1, J15.1, J16.1, J17.1, J18.1, J19.1, R4.1, U1.10 (COM), U2.10 (COM)
/AFT_Fuel_Filter: J4.1, U2.15 (O4)
/AREF: A1.AREF, J35.8
/BACKLIGHT_PANELS: J6.2, J7.2, J8.2, J9.2, J10.2, J15.2, J16.2, J17.2, J18.2, J19.2, Q2.2 (D)
/BACKLIGHT_PWM: A1.D5, J34.6, R18.2
/Baggage_Door: J5.14, U1.11 (O8)
/Battery_Hot: J5.11, U1.13 (O6)
/Battery_Temp: J5.9, U1.14 (O5)
/COL0: A1.D32, R7.2
/COL1: A1.D33, R8.2
/COL2: A1.D34, R9.2
/COL3: A1.D35, R10.2
/COL4: A1.D36, R11.2
/COL5: A1.D37, R12.2
/COL6: A1.D38, R13.2
/COL7: A1.D39, R14.2
/COL8: A1.D40, R15.2
/COL9: A1.D41, R16.2
/COL10: A1.D42, R17.2
/D0: A1.D0 (D0/RX0), J34.1
/D1: A1.D1 (D1/TX0), J34.2
/D_AFT_Fuel_Filter: A1.A12, J13.5, U2.4 (I4)
/D_Baggage_Door: A1.A8, J13.1, U1.8 (I8)
/D_Battery_Hot: A1.A6, J12.7, U1.6 (I6)
/D_Battery_Temp: A1.A5, J12.6, U1.5 (I5)
/D_Engine_Chip: A1.A9, J13.2, U2.1 (I1)
/D_Engine_Out: A1.A2, J12.3, U1.2 (I2)
/D_Fuel_Pump: A1.A11, J13.4, U2.3 (I3)
/D_Gen_Fail: A1.A13, J13.6, U2.5 (I5)
/D_Low_Fuel: A1.A14, J13.7, U2.6 (I6)
/D_Rotor_RPM_Low: A1.A1, J12.2, U1.1 (I1)
/D_SC_Fail: A1.A15, J13.8, U2.7 (I7)
/D_Trans_Chip: A1.A7, J12.8, U1.7 (I7)
/D_Trans_Oil_Pressure: A1.A3, J12.4, U1.3 (I3)
/D_Trans_Oil_Temp: A1.A4, J12.5, U1.4 (I4)
/D_T/R_Chip: A1.A10, J13.3, U2.2 (I2)
/Engine_Chip: J5.15, U2.18 (O1)
/Engine_Out: J5.3, U1.17 (O2)
/Fuel_Pump: J4.3, U2.16 (O3)
/GPS_TX: A1.D18 (D18/TX1), J11.5
/GREEN_LED: A1.D14 (D14/TX3), J11.1, R5.1
/Gen_Fail: J4.5, U2.14 (O5)
/GroupB3: J4.7
/GroupB5: J4.9
/GroupB6: J4.11
/GroupB8: J4.13
/GroupB9: J4.14
/INT_5V: A1.5V1 (5V), A1.5V3 (5V), A1.5V4 (5V), J14.5, J37.1, J38.1, R1.1, R2.1, R7.1, R8.1, R9.1, R10.1, R11.1, R12.1, R13.1, R14.1, R15.1, R16.1, R17.1
/IORF: A1.IORF (IOREF), J14.2
/Low_Fuel: J4.15, U2.13 (O6)
/PB_GND: J4.6, J5.6
/PIN_20: A1.D20 (D20/SDA), J11.7
/PIN_21: A1.D21 (D21/SCL), J11.8
/PWM_AIRSPEED: A1.D2 (D2_INT0), J20.1, J34.3
/PWM_EGT: A1.D7, J21.1, J34.8
/PWM_ELEC_LOAD: A1.D28, J29.3, J44.1
/PWM_ENG_OIL_PRESS: A1.D13, J31.1, J35.6
/PWM_ENG_OIL_TEMP: A1.D12, J27.1, J35.5
/PWM_ENG_TORQUE: A1.D11, J24.1, J35.4
/PWM_FUEL_LEVEL: A1.D46, J28.1
/PWM_FUEL_LOAD: A1.D29, J29.4, J45.1
/PWM_GAS_PRODUCER: A1.D6, J30.1, J34.7
/PWM_PITCH: A1.D26, J29.1, J42.1
/PWM_RADAR_ALT: A1.D3 (D3_INT1), J23.1, J34.4
/PWM_ROLL: A1.D27, J29.2, J43.1
/PWM_ROTOR_SPEED: A1.D9, J25.1, J35.2
/PWM_TURBINE_SPEED: A1.D8, J22.1, J35.1
/PWM_VVI: A1.D4, J26.1, J34.5
/PWM_XMSN_OIL_PRESSURE: A1.D45, J33.1
/PWM_XMSN_OIL_TEMP: A1.D44, J32.1
/RED_LED: A1.D15 (D15/RX3), J11.2, R6.1
/RESET: A1.RST1 (RESET), J1.2, J14.3, R1.2
/RESET_pin: A1.D49, J1.3
/ROW0: A1.D22
/ROW1: A1.D23
/ROW2: A1.D24
/ROW3: A1.D25
/ROW8: A1.D30, J29.5
/ROW9: A1.D31, J29.6
/Rotor_RPM_Low: J5.1, U1.18 (O1)
/SC_Fail: J4.16, U2.12 (O7)
/SW_FUEL_VALVE: A1.D48, SW2.1 (A)
/SW_TOT_CLEAR: A1.D43, SW1.1
/SW_WARNING_MUTE: A1.D47, SW3.1
/Trans_Chip: J5.13, U1.12 (O7)
/Trans_Oil_Pressure: J5.5, U1.16 (O3)
/Trans_Oil_Temp: J5.7, U1.15 (O4)
/T/R_Chip: J5.16, U2.17 (O2)
/VIN: A1.VIN, J14.8
ES1_RST: A1.D53 (D53_CS), U3.B5 (RST)
GND: A1.GND1 (GND), A1.GND2 (GND), A1.GND3 (GND), A1.GND5 (GND), A1.GND6 (GND), D1.1 (K), D2.1 (K), D3.1 (K), D4.1 (K), D5.1 (K), J1.1, J2.2, J3.2, J4.2, J4.4, J5.2, J5.4, J14.6, J14.7, J20.3, J21.3, J22.3, J23.3, J24.3, J25.3, J26.3, J27.3, J28.3, J30.3, J31.3, J32.3, J33.3, J35.7, J36.2, J37.2, J42.3, J43.3, J44.3, J45.3, Q2.3 (S), R19.1, SW1.2, SW2.2 (B), SW3.2, U1.9 (GND), U2.9 (GND), U3.A1 (GND_1), U3.A2 (GND_2), U3.B1 (GND_3)
MISO: A1.D50 (D50_MISO), U3.B6 (MISO)
MOSI: A1.D51 (D51_MOSI), U3.A3 (MOSI)
unnamed: A1.D16 (D16/TX2), J11.3
unnamed: A1.D17 (D17/RX2), J11.4
unnamed: A1.D19 (D19/RX1), J11.6
unnamed: D1.2 (A), R2.2
unnamed: D2.2 (A), R3.2
unnamed: D3.2 (A), R4.2
unnamed: D4.2 (A), R5.2
unnamed: D5.2 (A), R6.2
unnamed: F2.2, J3.1
unnamed: A1.A0, J12.1
unnamed: Q2.1 (G), R18.1, R19.2
unnamed: R20.2, U3.A6 (INT)
SCL: A1.SCL, J35.10
SCLK: A1.D52 (D52_SCK), U3.A4 (SCLK)
SDA: A1.SDA, J35.9
SS: A1.D10, J35.3, U3.A5 (CS)

Notes on the sheet:
YELLOW
MAX 2 AMPS
BLUE
INTERNAL 5V PINS
Ethernet Module Library from https://componentsearchengine.com/part-view/USR-ES1/Smart%20Electronics
Cannot use
RED
(PIN A3)
0 1 2 3 4 5 6 7
LEDCONTROL Ic_2=LEDCONTROL(49,48,47,X); 49 - DATA IN 48 - CLK 47 - LOAD/CS Digits = Columns = Cathodes - ""-"" Segments = Rows = Anodes - ""+""
Red LED - solid on until a packet is succesfully sent to controller
RHS 1 Rotor RPM Low 2 Engine Out 3 Trans Oil Pressure 4 Trans Oil Temp 5 Battery Temp 6 Battery Hot 7 Trans Chip 8 Engine Chip 9 T/R Chip 10 Baggage Door LHS 1 Fuel Pump 2 AFT Fuel Filter 3 Spare 4 Gen Fail 5 Spare 6 Spare 7 Low Fuel 8 Spare 9 Spare 10 SC Fail
5V_LINK
21 20 19 18 17 16 15 14
EXTERNAL 5V PINS
8 9 10 11 12 13

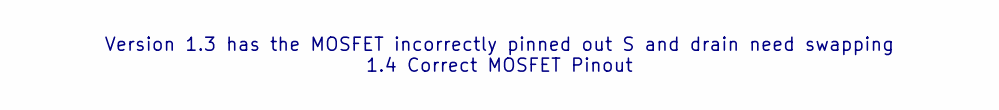
[picture p483: schematic ChageLog.kicad_sch]

Notes on the sheet:
Version 1.3 has the MOSFET incorrectly pinned out S and drain need swapping 1.4 Correct MOSFET Pinout

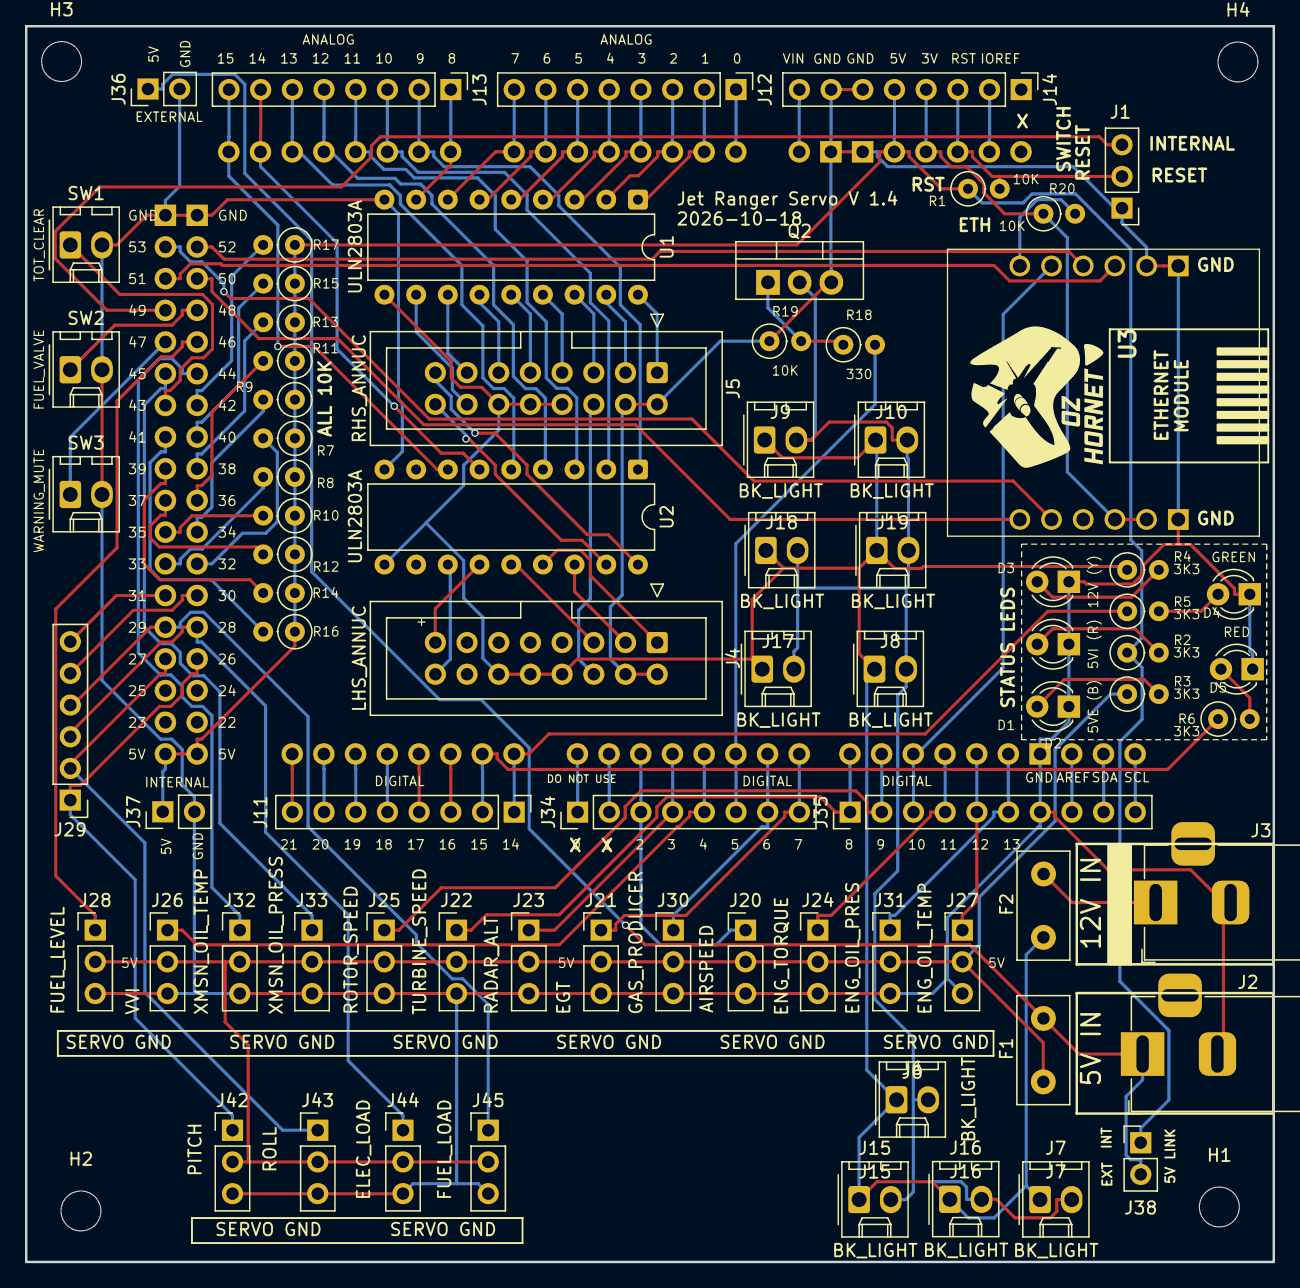
[picture p484: board Jet Ranger Front Panel Servo.kicad_pcb from above]

Board: 2 copper layers, 100.0 x 99.1 mm, 81 parts (0 on the bottom side), 103 nets.
