bnepethomas/bne-arduino-flight-simulator-interfaces/Jet Ranger/PCBs/Jet Ranger Upper Controller/Jet Ranger Upper Controller.kicad_pcb

## KiCad design Jet Ranger/PCBs/Jet Ranger Upper Controller/Jet Ranger Upper Controller.kicad_pcb (2026-10-18)

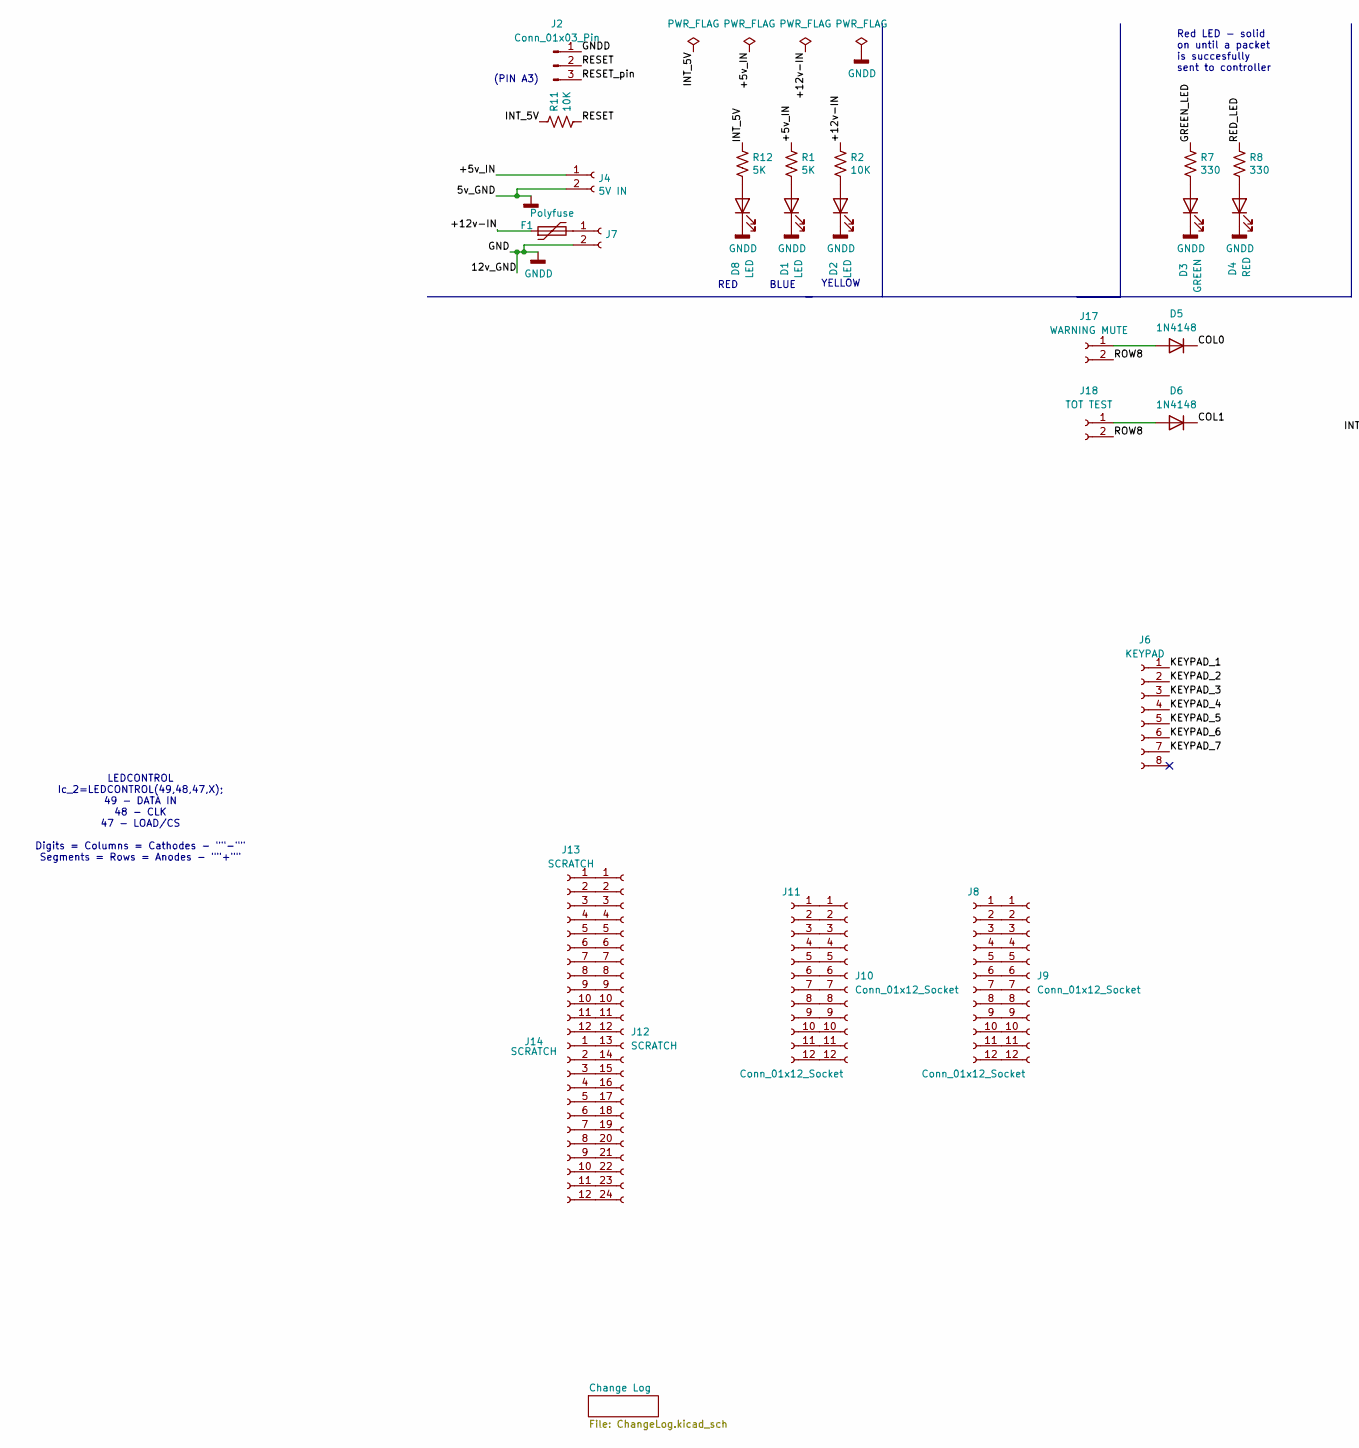
[picture p485: schematic Jet Ranger Upper Controller.kicad_sch, part in row 1, column 1]

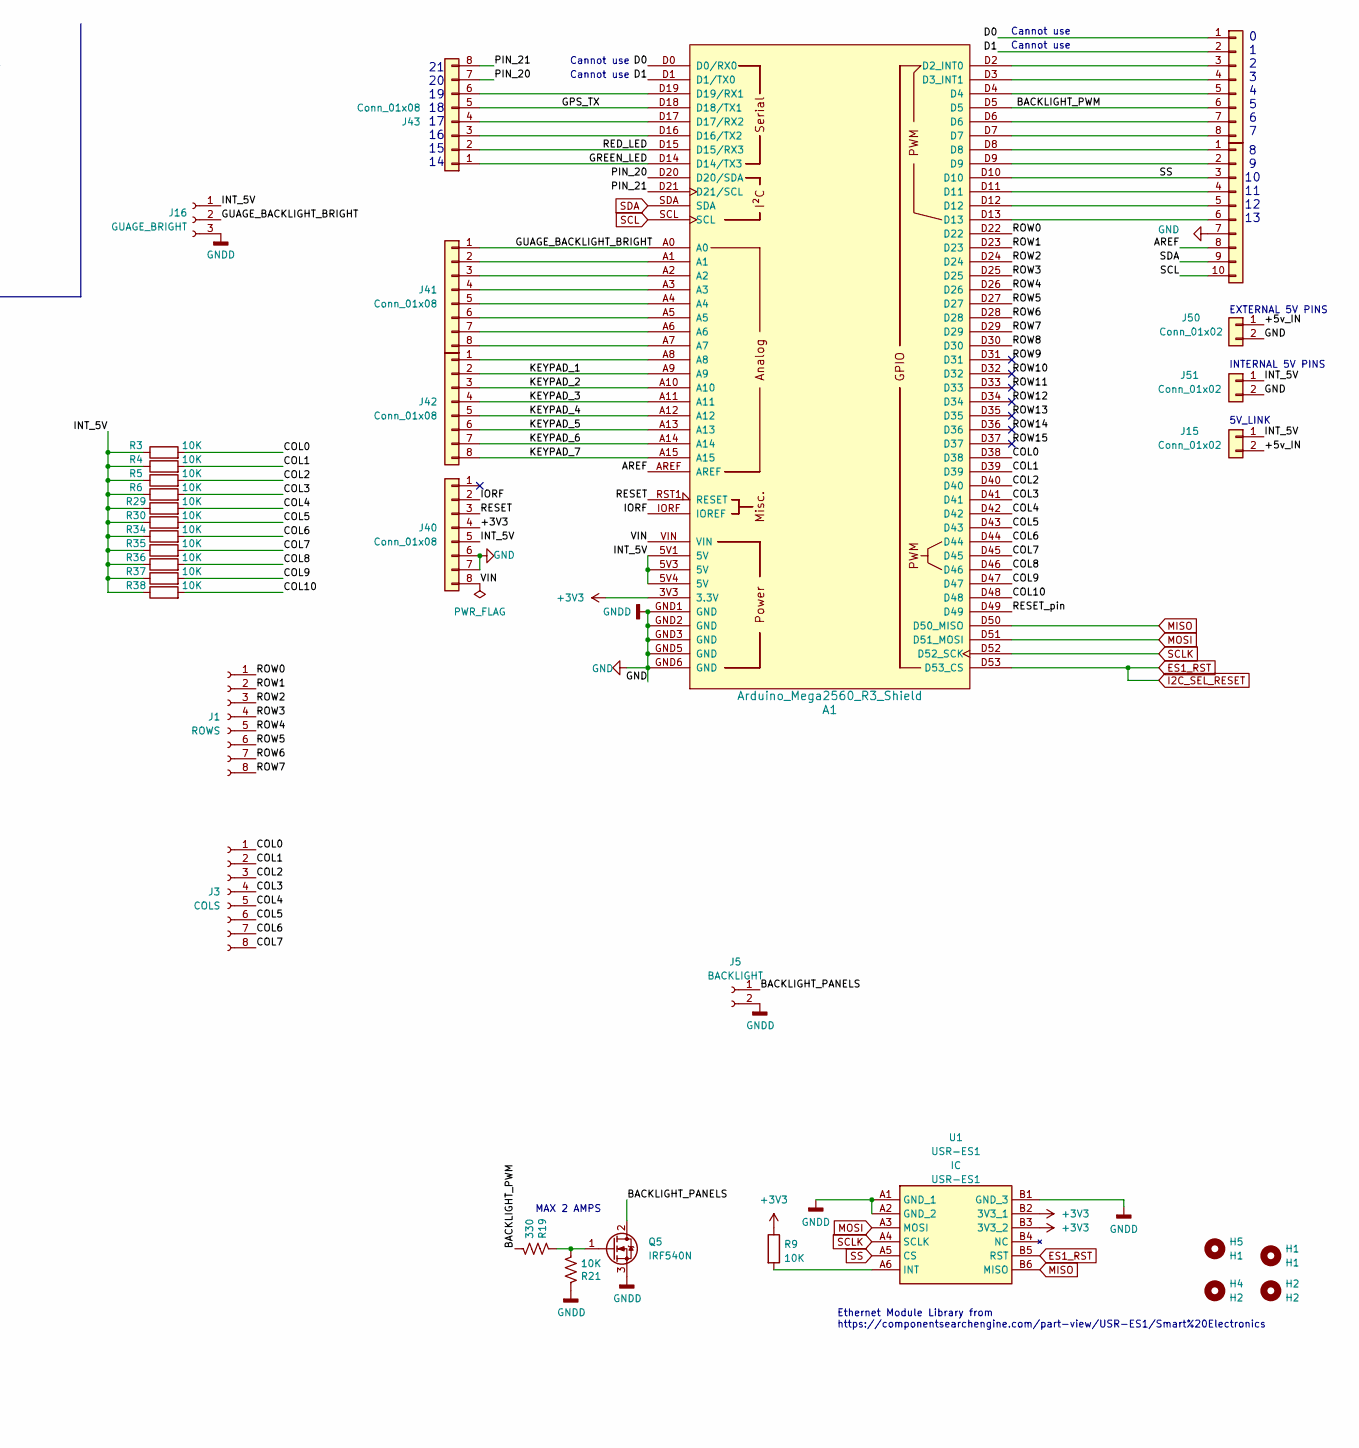
[picture p486: schematic Jet Ranger Upper Controller.kicad_sch, part in row 1, column 2]

Parts:
A1: Arduino_Mega2560_R3_Shield
D1, D2, D8: LED; LED_D3.0mm
D3: GREEN; LED_D3.0mm
D4: RED; LED_D3.0mm
D5, D6: 1N4148; D_DO-35_SOD27_P7.62mm_Horizontal
F1: Polyfuse; Fuse_Bourns_MF-RG400
H1, H5: H1; MountingHole_3.2mm_M3
H2, H4: H2; MountingHole_3.2mm_M3
J1: ROWS; Molex_KK-254_AE-6410-08A_1x08_P2.54mm_Vertical
J2: Conn_01x03_Pin; PinHeader_1x03_P2.54mm_Vertical
J3: COLS; Molex_KK-254_AE-6410-08A_1x08_P2.54mm_Vertical
J4: 5V IN; BarrelJack_Horizontal
J5: BACKLIGHT; Molex_KK-254_AE-6410-02A_1x02_P2.54mm_Vertical
J6: KEYPAD; Molex_KK-254_AE-6410-08A_1x08_P2.54mm_Vertical
J7: STEPPER IN 12-20VDC; BarrelJack_Horizontal
J8, J9, J10, J11: Conn_01x12_Socket; PinHeader_1x12_P2.54mm_Vertical
J12: SCRATCH; IDC-Header_2x12_P2.54mm_Vertical
J13, J14: SCRATCH; PinHeader_1x12_P2.54mm_Vertical
J15, J50, J51: Conn_01x02; PinHeader_1x02_P2.54mm_Vertical
J16: GUAGE_BRIGHT; Molex_KK-254_AE-6410-03A_1x03_P2.54mm_Vertical
J17: WARNING MUTE; Molex_KK-254_AE-6410-02A_1x02_P2.54mm_Vertical
J18: TOT TEST; Molex_KK-254_AE-6410-02A_1x02_P2.54mm_Vertical
J40, J41, J42, J43, J44: Conn_01x08; PinHeader_1x08_P2.54mm_Vertical
J45: Conn_01x10; PinHeader_1x10_P2.54mm_Vertical
Q5: IRF540N; TO-220-3_Vertical
R1, R12: 5K; R_Axial_DIN0207_L6.3mm_D2.5mm_P2.54mm_Vertical
R2, R3, R4, R5, R6, R9, R11, R21, R29, R30, R34, R35, R36, R37, R38: 10K; R_Axial_DIN0207_L6.3mm_D2.5mm_P2.54mm_Vertical
R7, R8, R19: 330; R_Axial_DIN0207_L6.3mm_D2.5mm_P2.54mm_Vertical
U1: USR-ES1; USRES1; Manufacturer_Part_Number USR-ES1

Connections:
+3V3: A1.3V3 (3.3V), J40.4, R9.1, U1.B2 (3V3_1), U1.B3 (3V3_2)
/+5v_IN: J4.1, J15.2, J50.1, R1.1
/+12v-IN: F1.1, R2.1
/AREF: A1.AREF, J45.8
/BACKLIGHT_PANELS: J5.1, Q5.2 (D)
/BACKLIGHT_PWM: A1.D5, J44.6, R19.2
/COL0: A1.D38, D5.1 (K), J3.1, R3.2
/COL1: A1.D39, D6.1 (K), J3.2, R4.2
/COL2: A1.D40, J3.3, R5.2
/COL3: A1.D41, J3.4, R6.2
/COL4: A1.D42, J3.5, R29.2
/COL5: A1.D43, J3.6, R30.2
/COL6: A1.D44, J3.7, R34.2
/COL7: A1.D45, J3.8, R35.2
/COL8: A1.D46, R36.2
/COL9: A1.D47, R37.2
/COL10: A1.D48, R38.2
/D0: A1.D0 (D0/RX0), J44.1
/D1: A1.D1 (D1/TX0), J44.2
/GPS_TX: A1.D18 (D18/TX1), J43.5
/GREEN_LED: A1.D14 (D14/TX3), J43.1, R7.1
/GUAGE_BACKLIGHT_BRIGHT: A1.A0, J16.2, J41.1
/INT_5V: A1.5V1 (5V), A1.5V3 (5V), A1.5V4 (5V), J15.1, J16.1, J40.5, J51.1, R3.1, R4.1, R5.1, R6.1, R11.1, R12.1, R29.1, R30.1, R34.1, R35.1, R36.1, R37.1, R38.1
/IORF: A1.IORF (IOREF), J40.2
/KEYPAD_1: A1.A9, J6.1, J42.2
/KEYPAD_2: A1.A10, J6.2, J42.3
/KEYPAD_3: A1.A11, J6.3, J42.4
/KEYPAD_4: A1.A12, J6.4, J42.5
/KEYPAD_5: A1.A13, J6.5, J42.6
/KEYPAD_6: A1.A14, J6.6, J42.7
/KEYPAD_7: A1.A15, J6.7, J42.8
/PIN_20: A1.D20 (D20/SDA), J43.7
/PIN_21: A1.D21 (D21/SCL), J43.8
/RED_LED: A1.D15 (D15/RX3), J43.2, R8.1
/RESET: A1.RST1 (RESET), J2.2, J40.3, R11.2
/RESET_pin: A1.D49, J2.3
/ROW0: A1.D22, J1.1
/ROW1: A1.D23, J1.2
/ROW2: A1.D24, J1.3
/ROW3: A1.D25, J1.4
/ROW4: A1.D26, J1.5
/ROW5: A1.D27, J1.6
/ROW6: A1.D28, J1.7
/ROW7: A1.D29, J1.8
/ROW8: A1.D30, J17.2, J18.2
/ROW9: A1.D31
/ROW10: A1.D32
/ROW11: A1.D33
/ROW12: A1.D34
/ROW13: A1.D35
/ROW14: A1.D36
/ROW15: A1.D37
/VIN: A1.VIN, J40.8
ES1_RST: A1.D53 (D53_CS), U1.B5 (RST)
GND: A1.GND1 (GND), A1.GND2 (GND), A1.GND3 (GND), A1.GND5 (GND), A1.GND6 (GND), D1.1 (K), D2.1 (K), D3.1 (K), D4.1 (K), D8.1 (K), J2.1, J4.2, J5.2, J7.2, J16.3, J40.6, J40.7, J45.7, J50.2, J51.2, Q5.3 (S), R21.1, U1.A1 (GND_1), U1.A2 (GND_2), U1.B1 (GND_3)
MISO: A1.D50 (D50_MISO), U1.B6 (MISO)
MOSI: A1.D51 (D51_MOSI), U1.A3 (MOSI)
unnamed: A1.D2 (D2_INT0), J44.3
unnamed: A1.D3 (D3_INT1), J44.4
unnamed: A1.D16 (D16/TX2), J43.3
unnamed: A1.D17 (D17/RX2), J43.4
unnamed: A1.D19 (D19/RX1), J43.6
unnamed: D1.2 (A), R1.2
unnamed: D2.2 (A), R2.2
unnamed: D3.2 (A), R7.2
unnamed: D4.2 (A), R8.2
unnamed: D5.2 (A), J17.1
unnamed: D6.2 (A), J18.1
unnamed: D8.2 (A), R12.2
unnamed: F1.2, J7.1
unnamed: J8.1, J9.1
unnamed: J8.2, J9.2
unnamed: J8.3, J9.3
unnamed: J8.4, J9.4
unnamed: J8.5, J9.5
unnamed: J8.6, J9.6
unnamed: J8.7, J9.7
unnamed: J8.8, J9.8
unnamed: J8.9, J9.9
unnamed: J8.10, J9.10
unnamed: J8.11, J9.11
unnamed: J8.12, J9.12
unnamed: J10.1, J11.1
unnamed: J10.2, J11.2
unnamed: J10.3, J11.3
unnamed: J10.4, J11.4
unnamed: J10.5, J11.5
unnamed: J10.6, J11.6
unnamed: J10.7, J11.7
unnamed: J10.8, J11.8
unnamed: J10.9, J11.9
unnamed: J10.10, J11.10
unnamed: J10.11, J11.11
unnamed: J10.12, J11.12
unnamed: J12.1, J13.1
unnamed: J12.2, J13.2
unnamed: J12.3, J13.3
unnamed: J12.4, J13.4
unnamed: J12.5, J13.5
unnamed: J12.6, J13.6
unnamed: J12.7, J13.7
unnamed: J12.8, J13.8
unnamed: J12.9, J13.9
unnamed: J12.10, J13.10
unnamed: J12.11, J13.11
unnamed: J12.12, J13.12
unnamed: J12.13, J14.1
unnamed: J12.14, J14.2
unnamed: J12.15, J14.3
unnamed: J12.16, J14.4
unnamed: J12.17, J14.5
unnamed: J12.18, J14.6
unnamed: J12.19, J14.7
unnamed: J12.20, J14.8
unnamed: J12.21, J14.9
unnamed: J12.22, J14.10
unnamed: J12.23, J14.11
unnamed: J12.24, J14.12
unnamed: A1.A1, J41.2
unnamed: A1.A2, J41.3
unnamed: A1.A3, J41.4
unnamed: A1.A4, J41.5
unnamed: A1.A5, J41.6
unnamed: A1.A6, J41.7
unnamed: A1.A7, J41.8
unnamed: A1.A8, J42.1
unnamed: A1.D4, J44.5
unnamed: A1.D6, J44.7
unnamed: A1.D7, J44.8
unnamed: A1.D8, J45.1
unnamed: A1.D9, J45.2
unnamed: A1.D11, J45.4
unnamed: A1.D12, J45.5
unnamed: A1.D13, J45.6
unnamed: Q5.1 (G), R19.1, R21.2
unnamed: R9.2, U1.A6 (INT)
SCL: A1.SCL, J45.10
SCLK: A1.D52 (D52_SCK), U1.A4 (SCLK)
SDA: A1.SDA, J45.9
SS: A1.D10, J45.3, U1.A5 (CS)

Notes on the sheet:
YELLOW
MAX 2 AMPS
BLUE
INTERNAL 5V PINS
Ethernet Module Library from https://componentsearchengine.com/part-view/USR-ES1/Smart%20Electronics
Cannot use
RED
(PIN A3)
0 1 2 3 4 5 6 7
LEDCONTROL Ic_2=LEDCONTROL(49,48,47,X); 49 - DATA IN 48 - CLK 47 - LOAD/CS Digits = Columns = Cathodes - ""-"" Segments = Rows = Anodes - ""+""
Red LED - solid on until a packet is succesfully sent to controller
5V_LINK
21 20 19 18 17 16 15 14
EXTERNAL 5V PINS
8 9 10 11 12 13

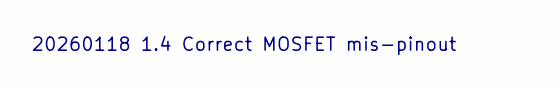
[picture p487: schematic ChangeLog.kicad_sch]

Notes on the sheet:
20260118 1.4 Correct MOSFET mis-pinout

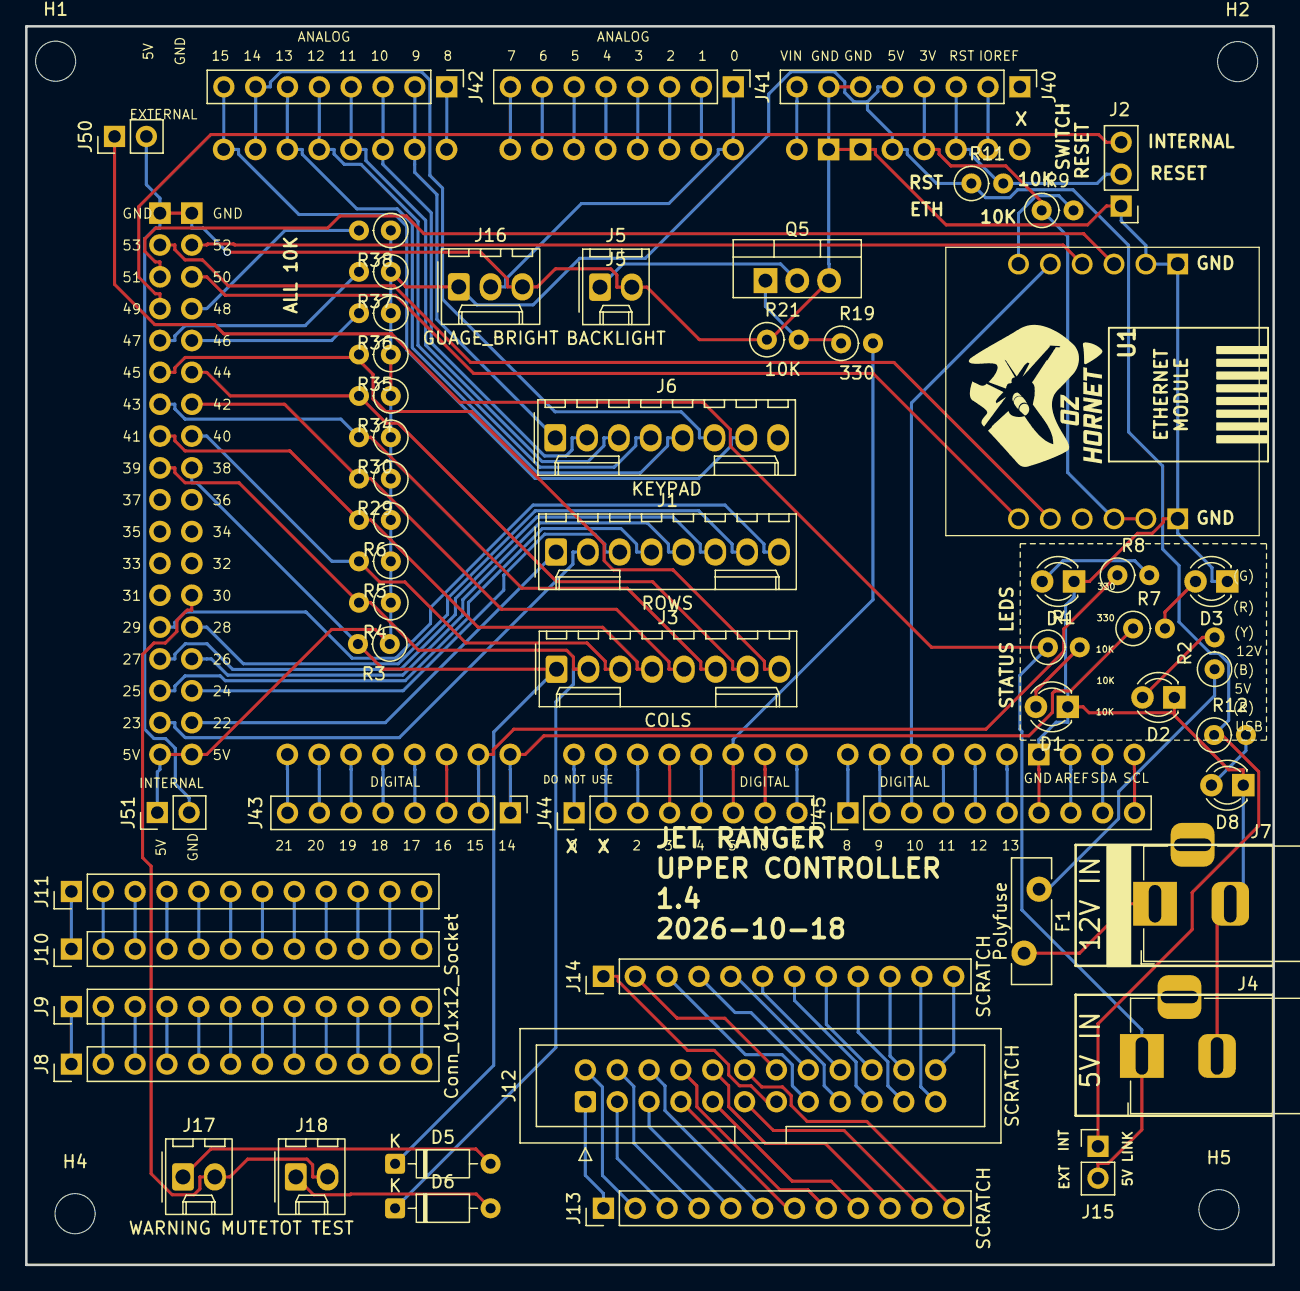
[picture p488: board Jet Ranger Upper Controller.kicad_pcb from above]

Board: 2 copper layers, 99.5 x 98.8 mm, 61 parts (0 on the bottom side), 133 nets.
