bnepethomas/bne-arduino-flight-simulator-interfaces/Jet Ranger/PCBs/Jet Ranger 13 Stepper/Jet Ranger 13 Stepper.kicad_pcb

## KiCad design Jet Ranger/PCBs/Jet Ranger 13 Stepper/Jet Ranger 13 Stepper.kicad_pcb (2026-10-18)

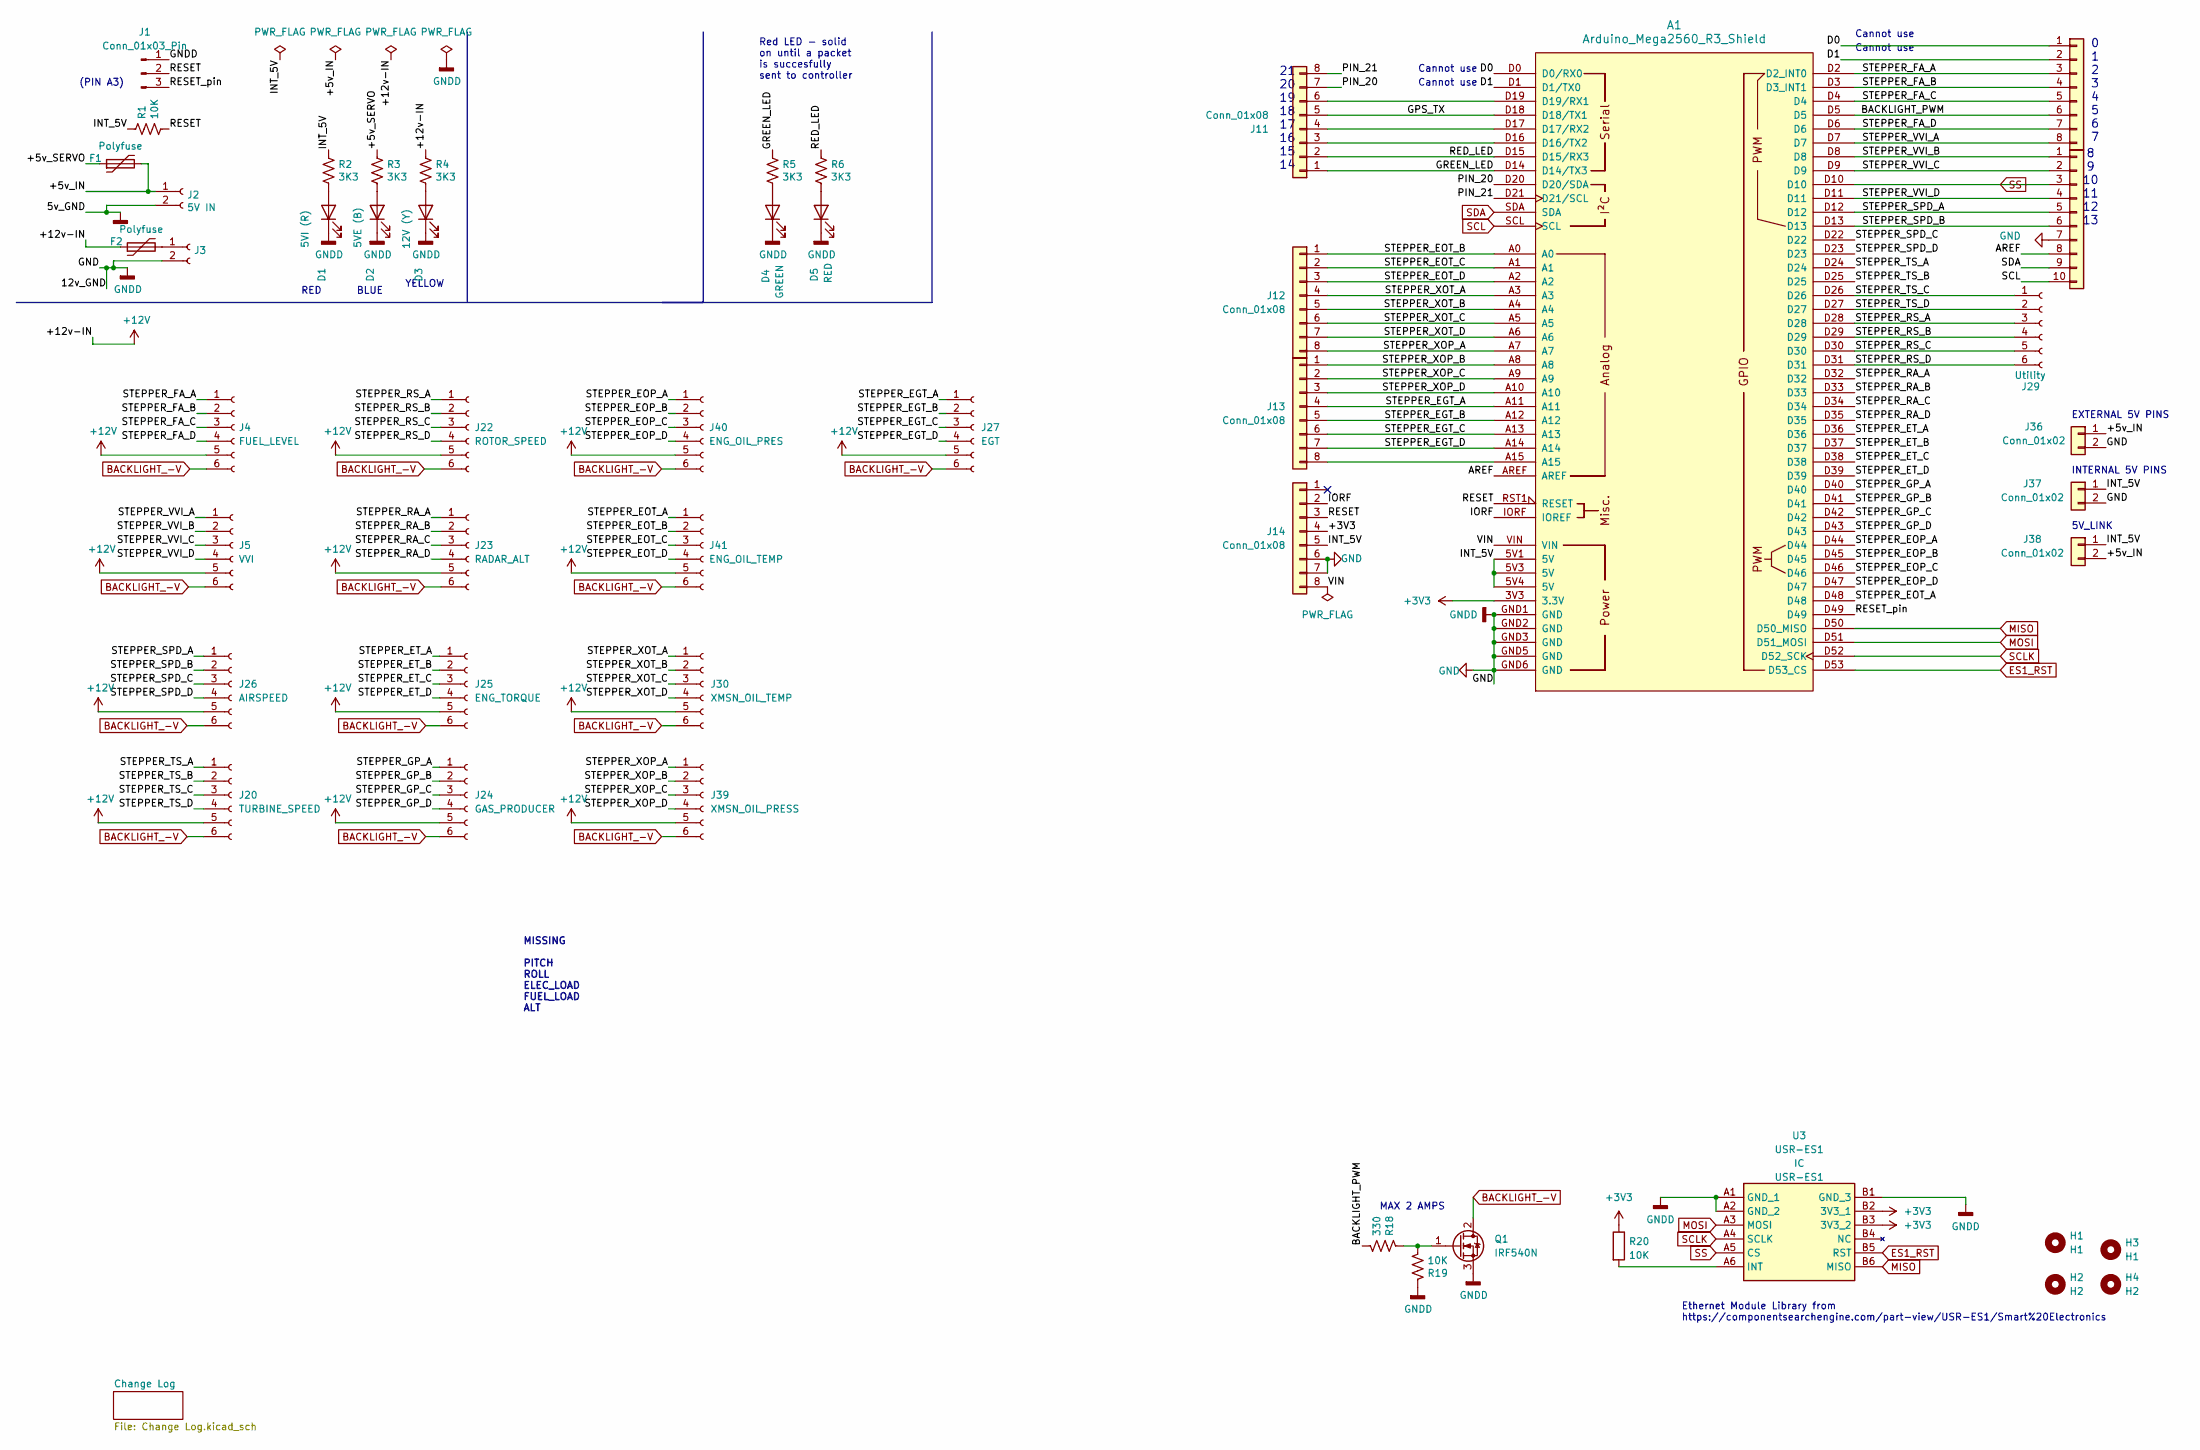
[picture p489: schematic Jet Ranger 13 Stepper.kicad_sch]

Parts:
A1: Arduino_Mega2560_R3_Shield
D1: 5VI (R); LED_D3.0mm
D2: 5VE (B); LED_D3.0mm
D3: 12V (Y); LED_D3.0mm
D4: GREEN; LED_D3.0mm
D5: RED; LED_D3.0mm
F1, F2: Polyfuse; Fuse_Littelfuse_395Series
H1, H3: H1; MountingHole_3.2mm_M3
H2, H4: H2; MountingHole_3.2mm_M3
J1: Conn_01x03_Pin; PinHeader_1x03_P2.54mm_Vertical
J2: 5V IN; BarrelJack_Horizontal
J3: STEPPER IN 12-20VDC; BarrelJack_Horizontal
J4: FUEL_LEVEL; Molex_KK-254_AE-6410-06A_1x06_P2.54mm_Vertical
J5: VVI; Molex_KK-254_AE-6410-06A_1x06_P2.54mm_Vertical
J11, J12, J13, J14, J34: Conn_01x08; PinHeader_1x08_P2.54mm_Vertical
J20: TURBINE_SPEED; Molex_KK-254_AE-6410-06A_1x06_P2.54mm_Vertical
J22: ROTOR_SPEED; Molex_KK-254_AE-6410-06A_1x06_P2.54mm_Vertical
J23: RADAR_ALT; Molex_KK-254_AE-6410-06A_1x06_P2.54mm_Vertical
J24: GAS_PRODUCER; Molex_KK-254_AE-6410-06A_1x06_P2.54mm_Vertical
J25: ENG_TORQUE; Molex_KK-254_AE-6410-06A_1x06_P2.54mm_Vertical
J26: AIRSPEED; Molex_KK-254_AE-6410-06A_1x06_P2.54mm_Vertical
J27: EGT; Molex_KK-254_AE-6410-06A_1x06_P2.54mm_Vertical
J29: Utility; PinHeader_1x06_P2.54mm_Vertical
J30: XMSN_OIL_TEMP; Molex_KK-254_AE-6410-06A_1x06_P2.54mm_Vertical
J35: Conn_01x10; PinHeader_1x10_P2.54mm_Vertical
J36, J37, J38: Conn_01x02; PinHeader_1x02_P2.54mm_Vertical
J39: XMSN_OIL_PRESS; Molex_KK-254_AE-6410-06A_1x06_P2.54mm_Vertical
J40: ENG_OIL_PRES; Molex_KK-254_AE-6410-06A_1x06_P2.54mm_Vertical
J41: ENG_OIL_TEMP; Molex_KK-254_AE-6410-06A_1x06_P2.54mm_Vertical
Q1: IRF540N; TO-220-3_Vertical
R1, R19, R20: 10K; R_Axial_DIN0207_L6.3mm_D2.5mm_P2.54mm_Vertical
R2, R3, R4, R5, R6: 3K3; R_Axial_DIN0207_L6.3mm_D2.5mm_P2.54mm_Vertical
R18: 330; R_Axial_DIN0207_L6.3mm_D2.5mm_P2.54mm_Vertical
U3: USR-ES1; USRES1; Manufacturer_Part_Number USR-ES1

Connections:
+3V3: A1.3V3 (3.3V), J14.4, R20.1, U3.B2 (3V3_1), U3.B3 (3V3_2)
+12V: F2.1, J4.5, J5.5, J20.5, J22.5, J23.5, J24.5, J25.5, J26.5, J27.5, J30.5, J39.5, J40.5, J41.5, R4.1
/+5v_IN: F1.2, J2.1, J36.1, J38.2
/+5v_SERVO: F1.1, R3.1
/AREF: A1.AREF, J35.8
/BACKLIGHT_PWM: A1.D5, J34.6, R18.2
/D0: A1.D0 (D0/RX0), J34.1
/D1: A1.D1 (D1/TX0), J34.2
/GPS_TX: A1.D18 (D18/TX1), J11.5
/GREEN_LED: A1.D14 (D14/TX3), J11.1, R5.1
/INT_5V: A1.5V1 (5V), A1.5V3 (5V), A1.5V4 (5V), J14.5, J37.1, J38.1, R1.1, R2.1
/IORF: A1.IORF (IOREF), J14.2
/PIN_20: A1.D20 (D20/SDA), J11.7
/PIN_21: A1.D21 (D21/SCL), J11.8
/RED_LED: A1.D15 (D15/RX3), J11.2, R6.1
/RESET: A1.RST1 (RESET), J1.2, J14.3, R1.2
/RESET_pin: A1.D49, J1.3
/STEPPER_EGT_A: A1.A11, J13.4, J27.1
/STEPPER_EGT_B: A1.A12, J13.5, J27.2
/STEPPER_EGT_C: A1.A13, J13.6, J27.3
/STEPPER_EGT_D: A1.A14, J13.7, J27.4
/STEPPER_EOP_A: A1.D44, J40.1
/STEPPER_EOP_B: A1.D45, J40.2
/STEPPER_EOP_C: A1.D46, J40.3
/STEPPER_EOP_D: A1.D47, J40.4
/STEPPER_EOT_A: A1.D48, J41.1
/STEPPER_EOT_B: A1.A0, J12.1, J41.2
/STEPPER_EOT_C: A1.A1, J12.2, J41.3
/STEPPER_EOT_D: A1.A2, J12.3, J41.4
/STEPPER_ET_A: A1.D36, J25.1
/STEPPER_ET_B: A1.D37, J25.2
/STEPPER_ET_C: A1.D38, J25.3
/STEPPER_ET_D: A1.D39, J25.4
/STEPPER_FA_A: A1.D2 (D2_INT0), J4.1, J34.3
/STEPPER_FA_B: A1.D3 (D3_INT1), J4.2, J34.4
/STEPPER_FA_C: A1.D4, J4.3, J34.5
/STEPPER_FA_D: A1.D6, J4.4, J34.7
/STEPPER_GP_A: A1.D40, J24.1
/STEPPER_GP_B: A1.D41, J24.2
/STEPPER_GP_C: A1.D42, J24.3
/STEPPER_GP_D: A1.D43, J24.4
/STEPPER_RA_A: A1.D32, J23.1
/STEPPER_RA_B: A1.D33, J23.2
/STEPPER_RA_C: A1.D34, J23.3
/STEPPER_RA_D: A1.D35, J23.4
/STEPPER_RS_A: A1.D28, J22.1, J29.3
/STEPPER_RS_B: A1.D29, J22.2, J29.4
/STEPPER_RS_C: A1.D30, J22.3, J29.5
/STEPPER_RS_D: A1.D31, J22.4, J29.6
/STEPPER_SPD_A: A1.D12, J26.1, J35.5
/STEPPER_SPD_B: A1.D13, J26.2, J35.6
/STEPPER_SPD_C: A1.D22, J26.3
/STEPPER_SPD_D: A1.D23, J26.4
/STEPPER_TS_A: A1.D24, J20.1
/STEPPER_TS_B: A1.D25, J20.2
/STEPPER_TS_C: A1.D26, J20.3, J29.1
/STEPPER_TS_D: A1.D27, J20.4, J29.2
/STEPPER_VVI_A: A1.D7, J5.1, J34.8
/STEPPER_VVI_B: A1.D8, J5.2, J35.1
/STEPPER_VVI_C: A1.D9, J5.3, J35.2
/STEPPER_VVI_D: A1.D11, J5.4, J35.4
/STEPPER_XOP_A: A1.A7, J12.8, J39.1
/STEPPER_XOP_B: A1.A8, J13.1, J39.2
/STEPPER_XOP_C: A1.A9, J13.2, J39.3
/STEPPER_XOP_D: A1.A10, J13.3, J39.4
/STEPPER_XOT_A: A1.A3, J12.4, J30.1
/STEPPER_XOT_B: A1.A4, J12.5, J30.2
/STEPPER_XOT_C: A1.A5, J12.6, J30.3
/STEPPER_XOT_D: A1.A6, J12.7, J30.4
/VIN: A1.VIN, J14.8
BACKLIGHT_-V: J4.6, J5.6, J20.6, J22.6, J23.6, J24.6, J25.6, J26.6, J27.6, J30.6, J39.6, J40.6, J41.6, Q1.2 (D)
ES1_RST: A1.D53 (D53_CS), U3.B5 (RST)
GND: A1.GND1 (GND), A1.GND2 (GND), A1.GND3 (GND), A1.GND5 (GND), A1.GND6 (GND), D1.1 (K), D2.1 (K), D3.1 (K), D4.1 (K), D5.1 (K), J1.1, J2.2, J3.2, J14.6, J14.7, J35.7, J36.2, J37.2, Q1.3 (S), R19.1, U3.A1 (GND_1), U3.A2 (GND_2), U3.B1 (GND_3)
MISO: A1.D50 (D50_MISO), U3.B6 (MISO)
MOSI: A1.D51 (D51_MOSI), U3.A3 (MOSI)
unnamed: A1.D16 (D16/TX2), J11.3
unnamed: A1.D17 (D17/RX2), J11.4
unnamed: A1.D19 (D19/RX1), J11.6
unnamed: D1.2 (A), R2.2
unnamed: D2.2 (A), R3.2
unnamed: D3.2 (A), R4.2
unnamed: D4.2 (A), R5.2
unnamed: D5.2 (A), R6.2
unnamed: F2.2, J3.1
unnamed: A1.A15, J13.8
unnamed: Q1.1 (G), R18.1, R19.2
unnamed: R20.2, U3.A6 (INT)
SCL: A1.SCL, J35.10
SCLK: A1.D52 (D52_SCK), U3.A4 (SCLK)
SDA: A1.SDA, J35.9
SS: A1.D10, J35.3, U3.A5 (CS)

Notes on the sheet:
YELLOW
MAX 2 AMPS
MISSING PITCH ROLL ELEC_LOAD FUEL_LOAD ALT
BLUE
INTERNAL 5V PINS
Ethernet Module Library from https://componentsearchengine.com/part-view/USR-ES1/Smart%20Electronics
Cannot use
RED
(PIN A3)
0 1 2 3 4 5 6 7
Red LED - solid on until a packet is succesfully sent to controller
5V_LINK
21 20 19 18 17 16 15 14
EXTERNAL 5V PINS
8 9 10 11 12 13

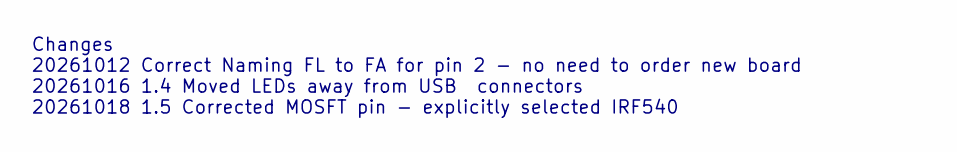
[picture p490: schematic Change Log.kicad_sch]

Notes on the sheet:
Changes 20261012 Correct Naming FL to FA for pin 2 - no need to order new board 20261016 1.4 Moved LEDs away from USB connectors 20261018 1.5 Corrected MOSFT pin - explicitly selected IRF540

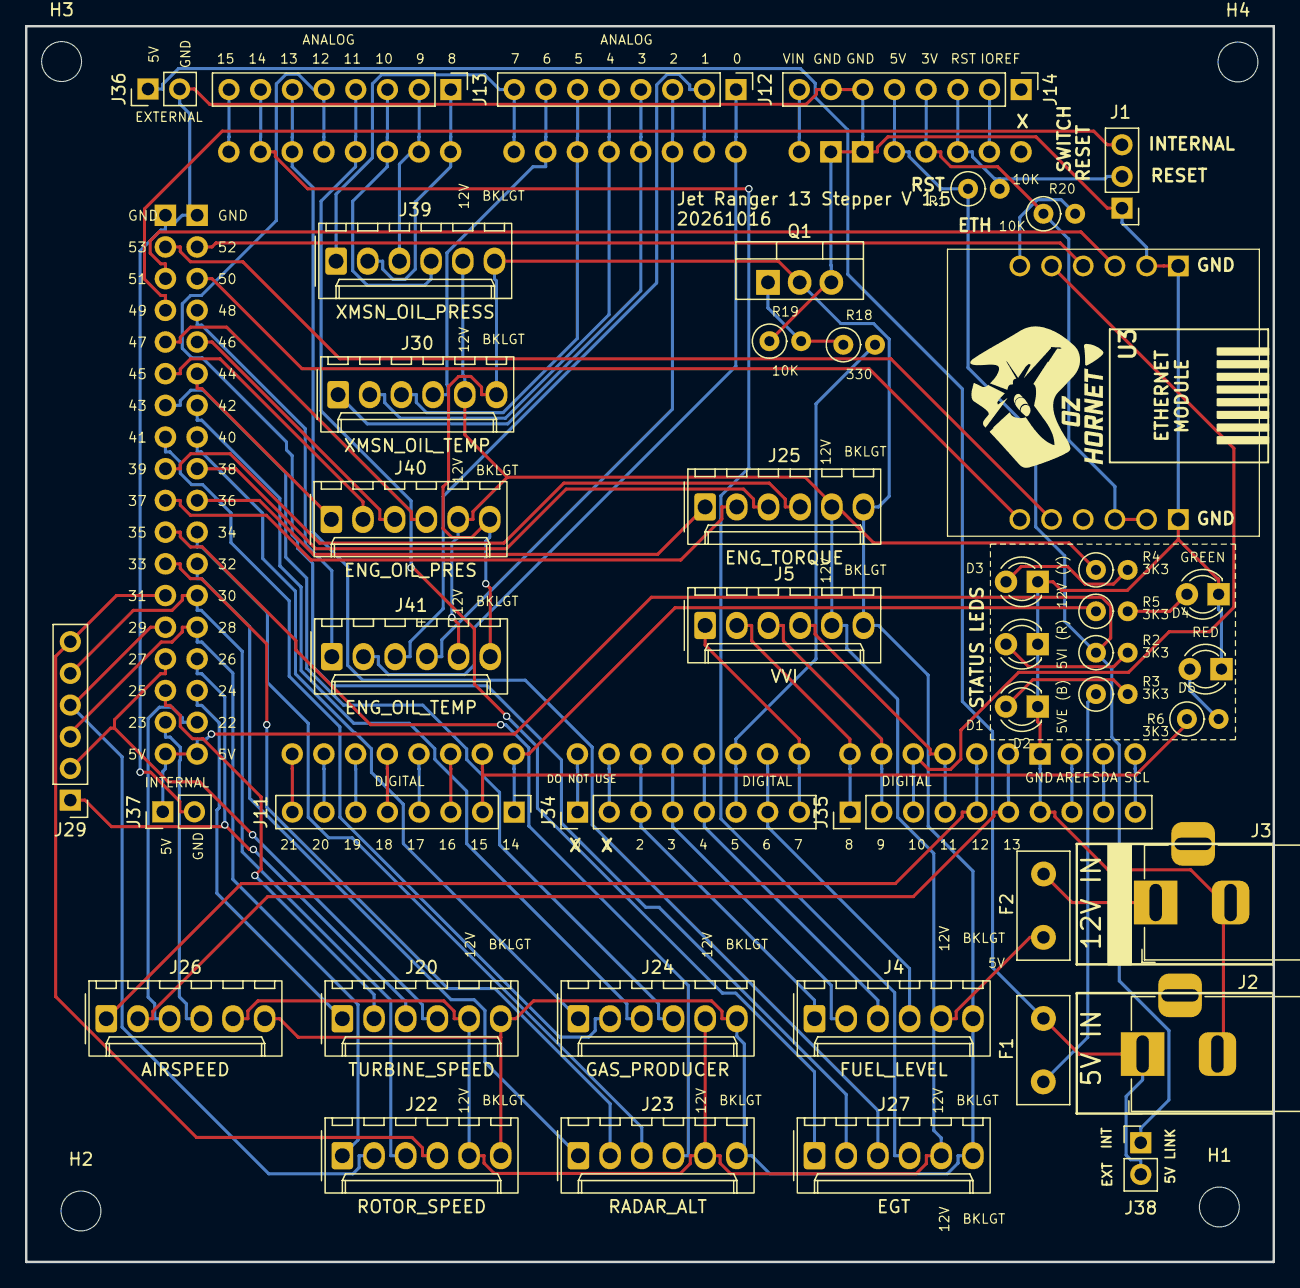
[picture p491: board Jet Ranger 13 Stepper.kicad_pcb from above]

Board: 2 copper layers, 100.0 x 99.1 mm, 49 parts (0 on the bottom side), 91 nets.
