bnepethomas/bne-arduino-flight-simulator-interfaces/Jet Ranger/PCBs/Jet Ranger Altimeter/Jet Ranger Altimeter.kicad_pcb

## KiCad design Jet Ranger/PCBs/Jet Ranger Altimeter/Jet Ranger Altimeter.kicad_pcb (2026-08-16)

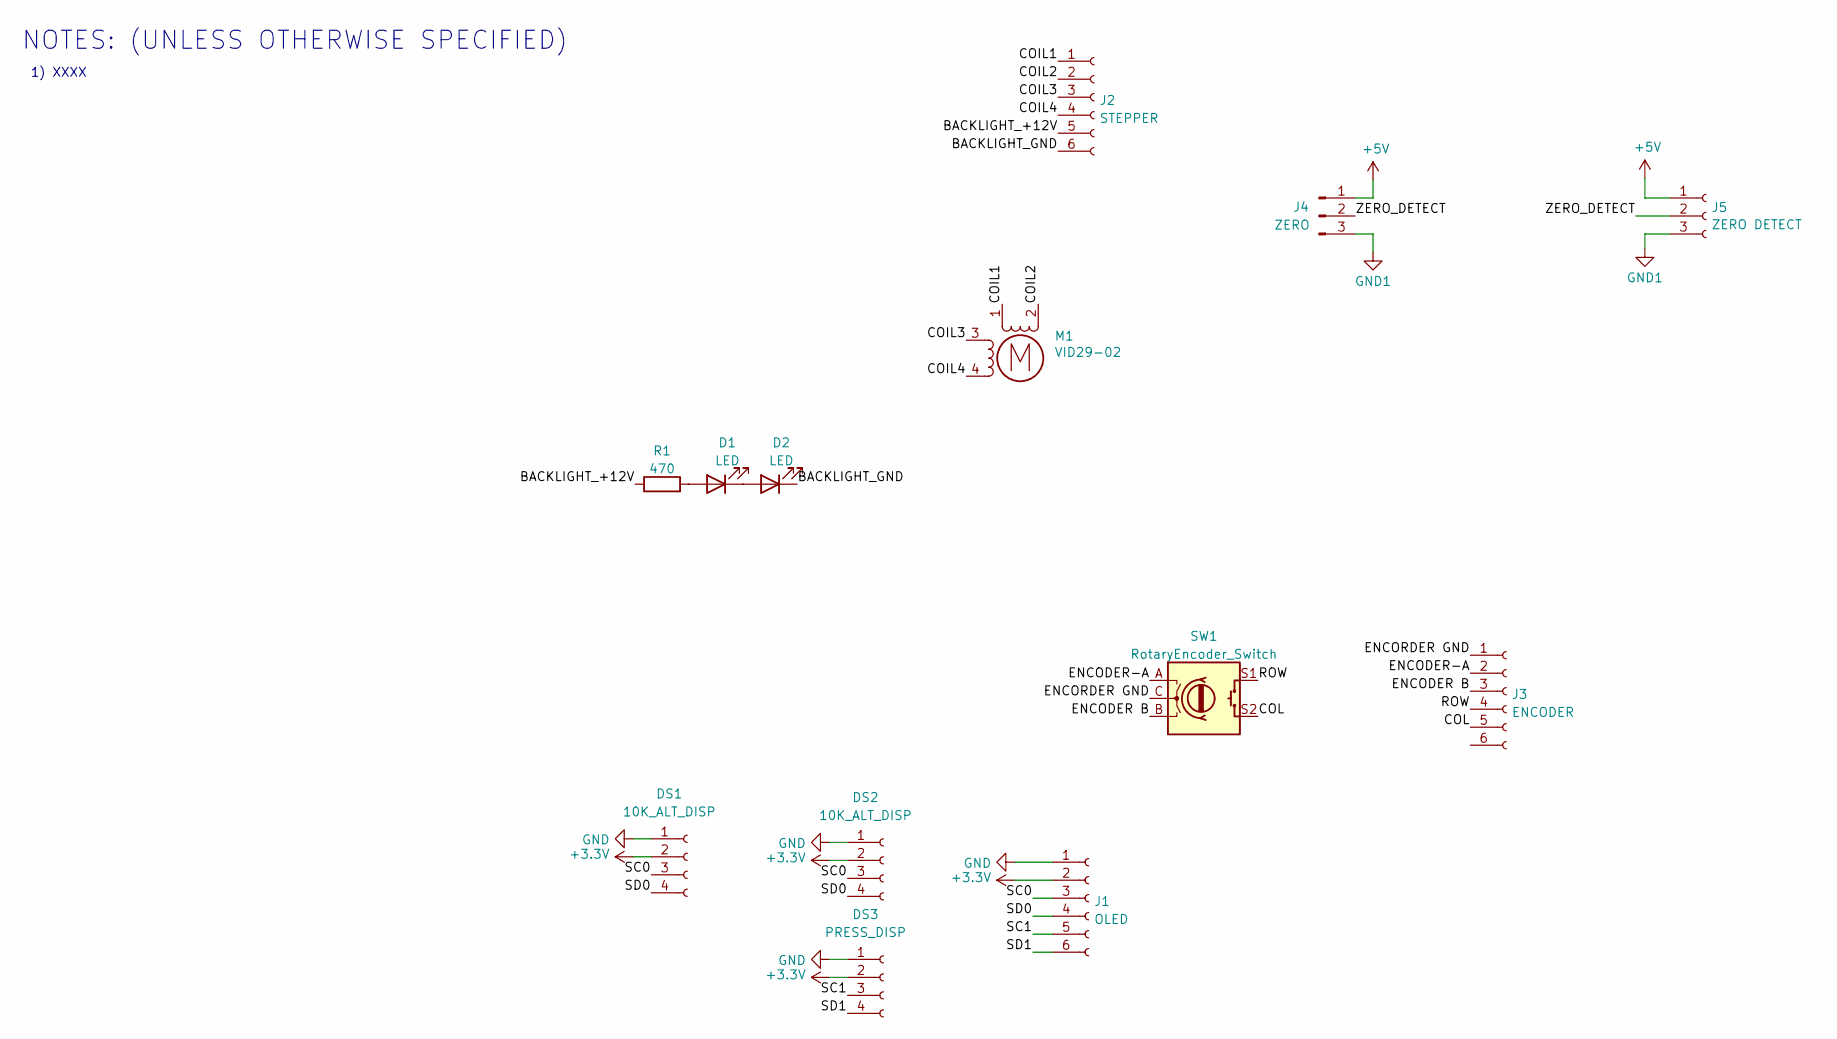
[picture p492: schematic Jet Ranger Altimeter.kicad_sch]

Parts:
D1, D2: LED; LED_D3.0mm
DS1, DS2: 10K_ALT_DISP; PinSocket_1x04_P2.54mm_Vertical
DS3: PRESS_DISP; PinSocket_1x04_P2.54mm_Vertical
J1: OLED; Molex_KK-254_AE-6410-06A_1x06_P2.54mm_Vertical
J2: STEPPER; Molex_KK-254_AE-6410-06A_1x06_P2.54mm_Vertical
J3: ENCODER; Molex_KK-254_AE-6410-06A_1x06_P2.54mm_Vertical
J4: ZERO; PinHeader_1x03_P2.54mm_Vertical
J5: ZERO DETECT; Molex_KK-254_AE-6410-03A_1x03_P2.54mm_Vertical
M1: VID29-02
R1: 470; R_Axial_DIN0204_L3.6mm_D1.6mm_P1.90mm_Vertical
SW1: RotaryEncoder_Switch; RotaryEncoder_Alps_EC11E-Switch_Vertical_H20mm

Connections:
+3V3: DS1.2, DS2.2, DS3.2, J1.2
+5V: J4.1, J5.1
/BACKLIGHT_+12V: J2.5, R1.1
/BACKLIGHT_GND: D2.1 (K), J2.6
/COIL1: J2.1, M1.1
/COIL2: J2.2, M1.2 (-)
/COIL3: J2.3, M1.3
/COIL4: J2.4, M1.4
/COL: J3.5, SW1.S2
/ENCODER B: J3.3, SW1.B
/ENCODER-A: J3.2, SW1.A
/ENCORDER GND: J3.1, SW1.C
/ROW: J3.4, SW1.S1
/SC0: DS1.3, DS2.3, J1.3
/SC1: DS3.3, J1.5
/SD0: DS1.4, DS2.4, J1.4
/SD1: DS3.4, J1.6
/ZERO_DETECT: J4.2, J5.2
GND: DS1.1, DS2.1, DS3.1, J1.1
GND1: J4.3, J5.3
unnamed: D1.2 (A), R1.2
unnamed: D1.1 (K), D2.2 (A)

Notes on the sheet:
1) XXXX
NOTES: (UNLESS OTHERWISE SPECIFIED)

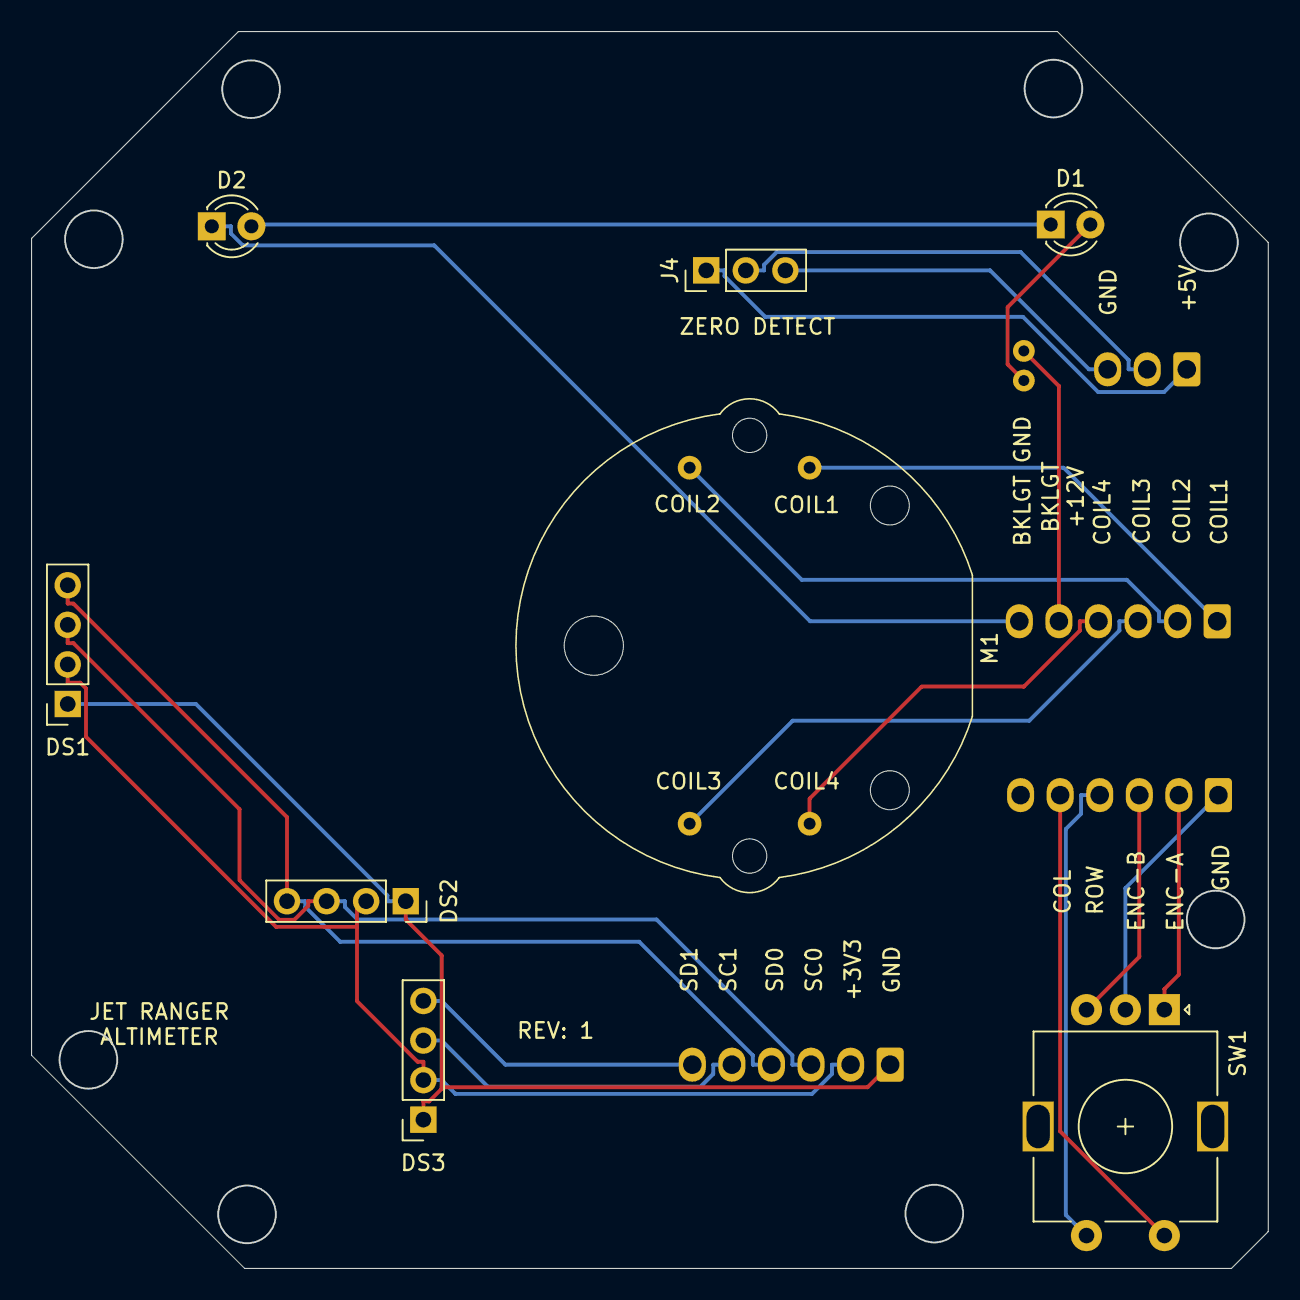
[picture p493: board Jet Ranger Altimeter.kicad_pcb from above]

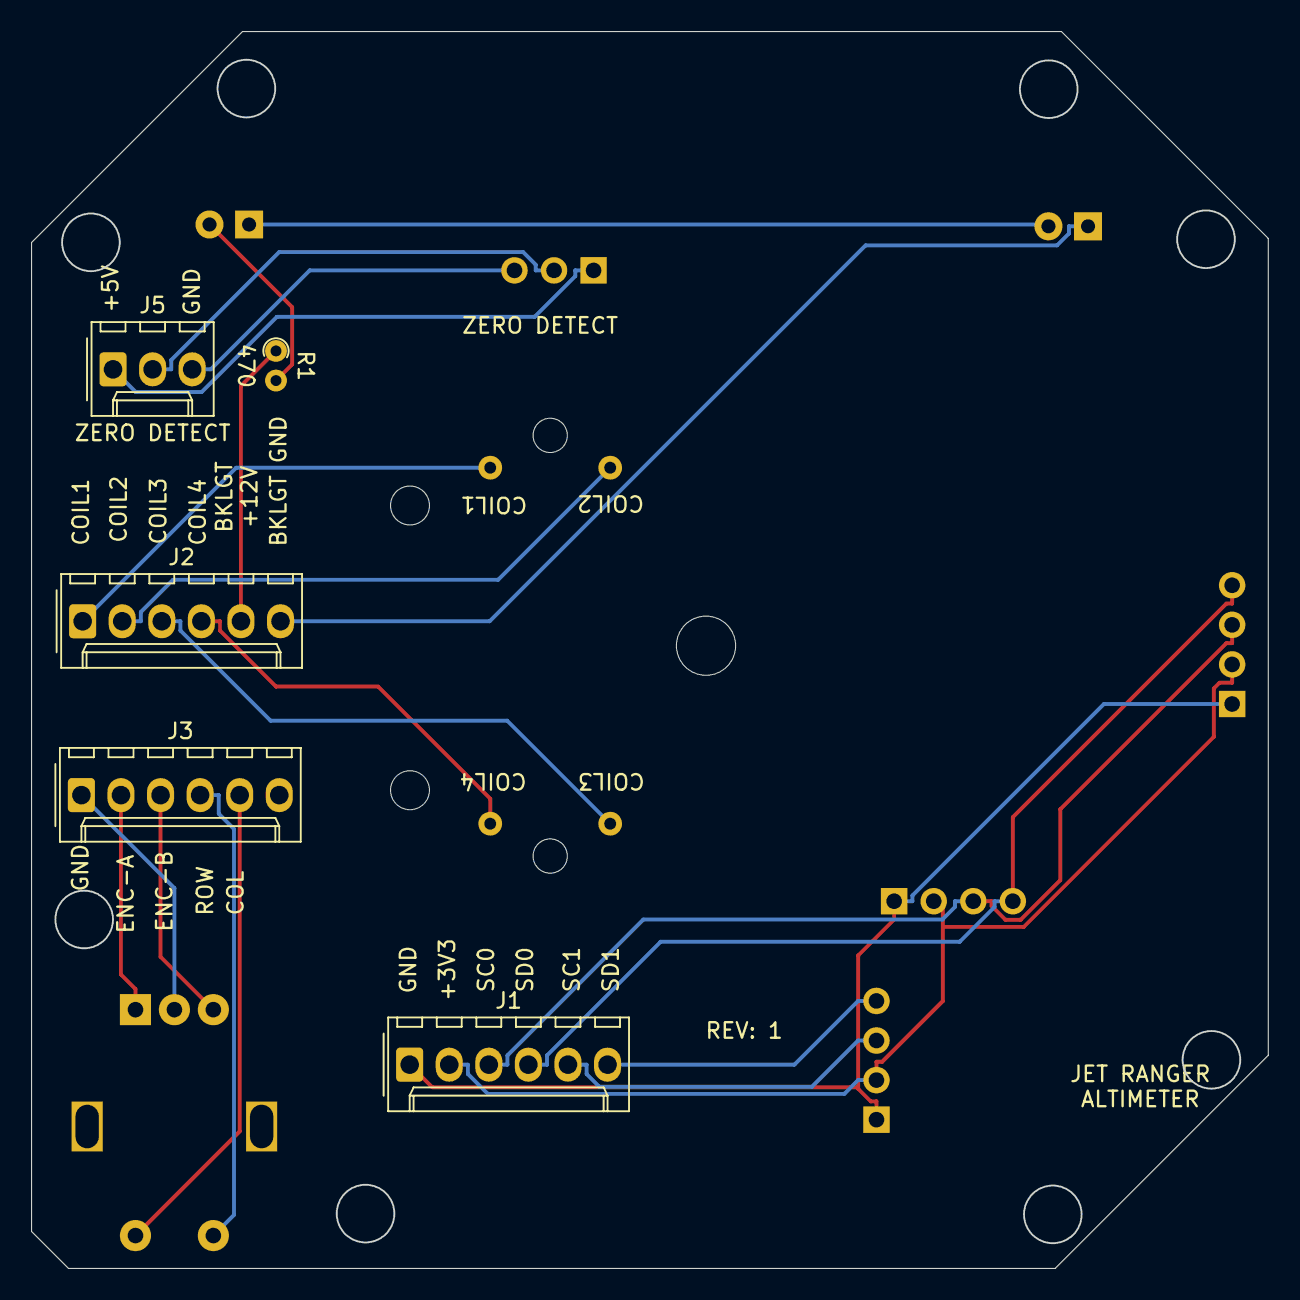
[picture p494: board Jet Ranger Altimeter.kicad_pcb from below]

Board: 2 copper layers, 79.4 x 79.4 mm, 13 parts (5 on the bottom side), 22 nets.
