bnepethomas/bne-arduino-flight-simulator-interfaces/Jet Ranger/PCBs/Jet Ranger X27 Small Stepper/Jet Ranger X27 Small Stepper.kicad_pcb

## KiCad design Jet Ranger/PCBs/Jet Ranger X27 Small Stepper/Jet Ranger X27 Small Stepper.kicad_pcb (2026-08-12)

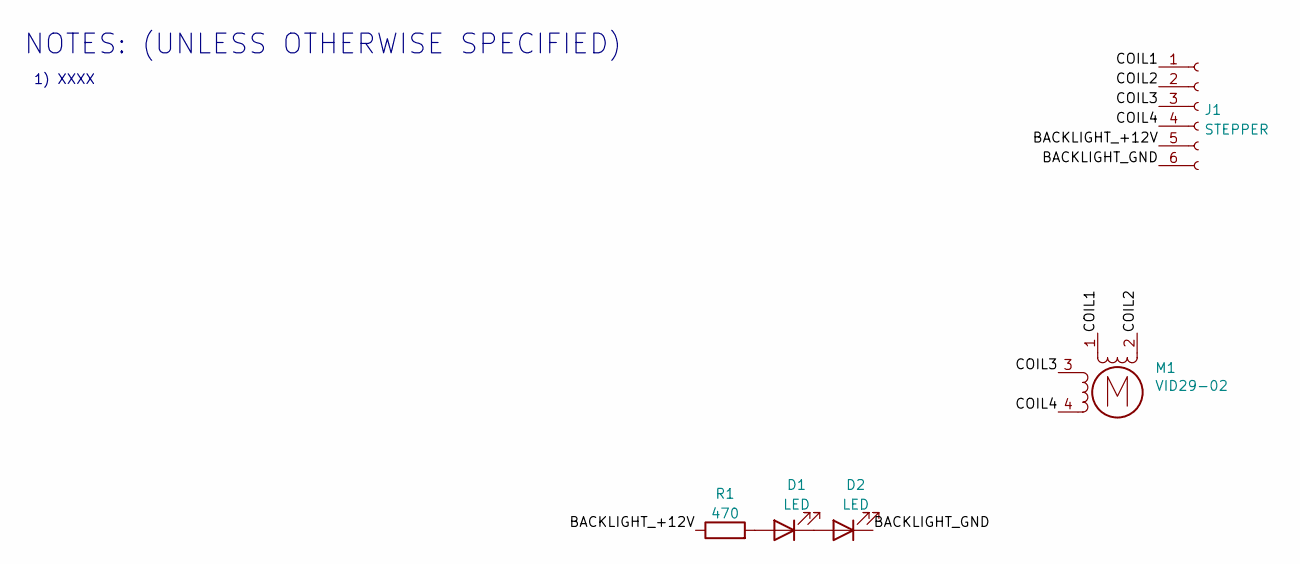
[picture p495: schematic Jet Ranger X27 Small Stepper.kicad_sch]

Parts:
D1, D2: LED; LED_D3.0mm
J1: STEPPER; Molex_KK-254_AE-6410-06A_1x06_P2.54mm_Vertical
M1: VID29-02
R1: 470; R_Axial_DIN0204_L3.6mm_D1.6mm_P1.90mm_Vertical

Connections:
/BACKLIGHT_+12V: J1.5, R1.1
/BACKLIGHT_GND: D2.1 (K), J1.6
/COIL1: J1.1, M1.1
/COIL2: J1.2, M1.2 (-)
/COIL3: J1.3, M1.3
/COIL4: J1.4, M1.4
unnamed: D1.2 (A), R1.2
unnamed: D1.1 (K), D2.2 (A)

Notes on the sheet:
1) XXXX
NOTES: (UNLESS OTHERWISE SPECIFIED)

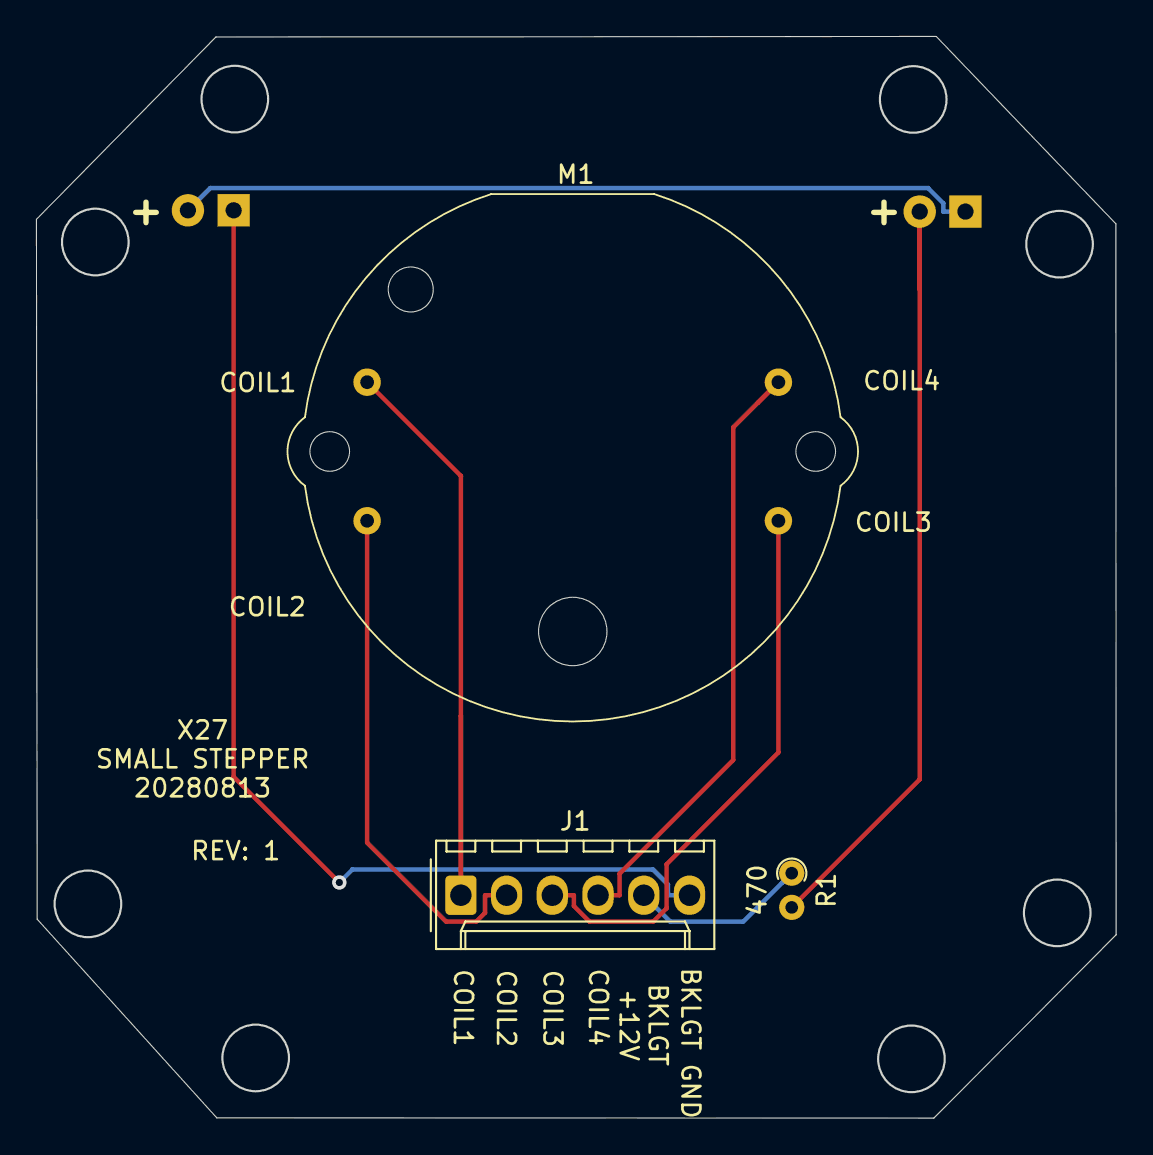
[picture p496: board Jet Ranger X27 Small Stepper.kicad_pcb from above]

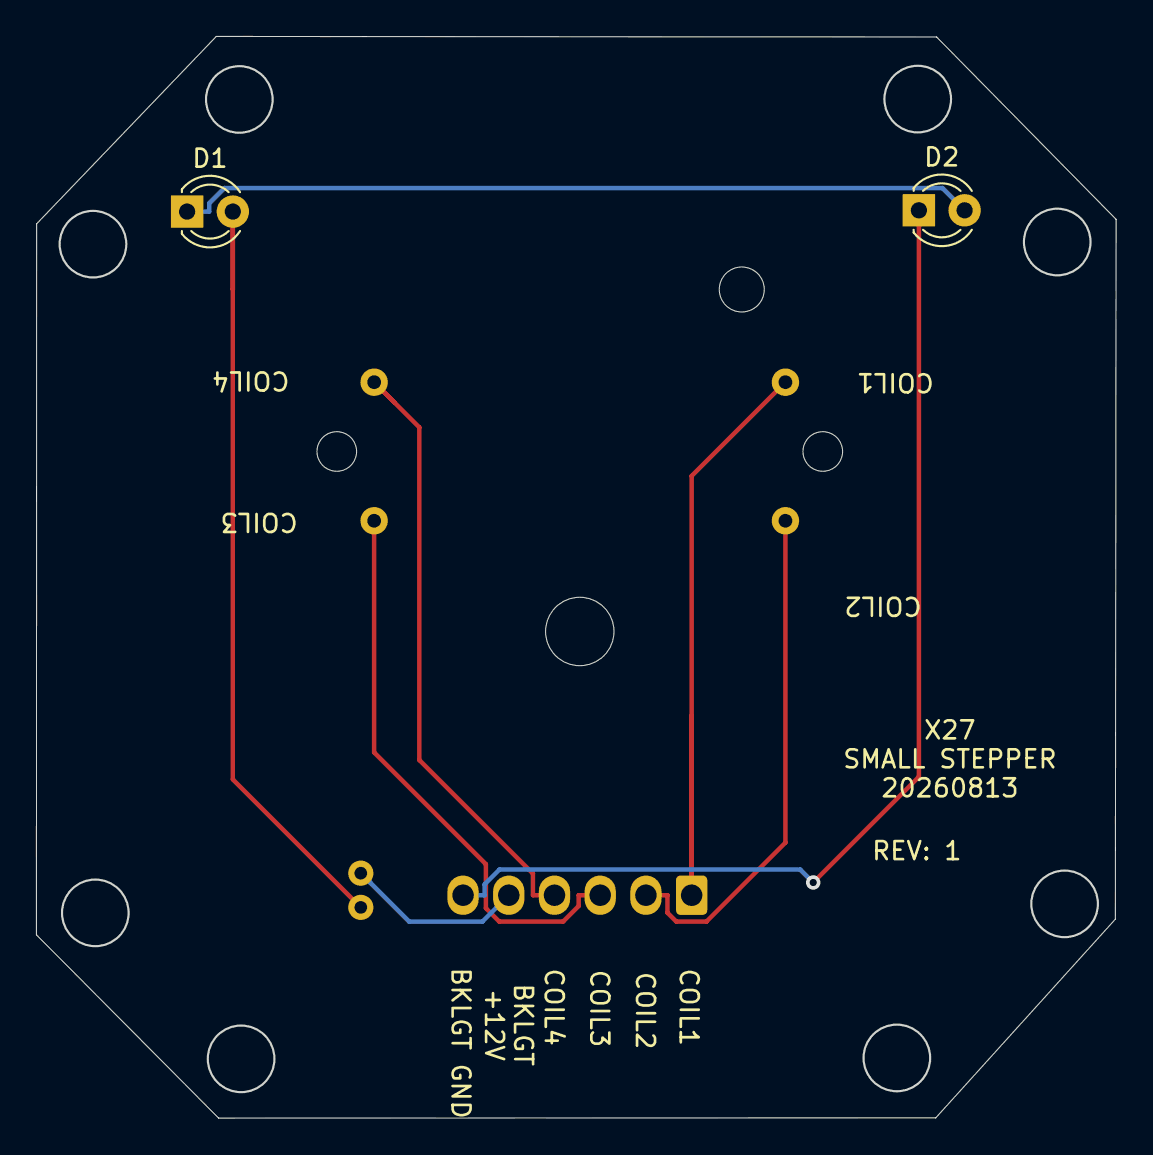
[picture p497: board Jet Ranger X27 Small Stepper.kicad_pcb from below]

Board: 2 copper layers, 60.0 x 60.1 mm, 5 parts (2 on the bottom side), 8 nets.
