bnepethomas/bne-arduino-flight-simulator-interfaces/Jet Ranger/PCBs/Simkits Large Dual Gauge/Simkits Large Dual Gauge.kicad_pcb

## KiCad design Jet Ranger/PCBs/Simkits Large Dual Gauge/Simkits Large Dual Gauge.kicad_pcb (2026-08-09)

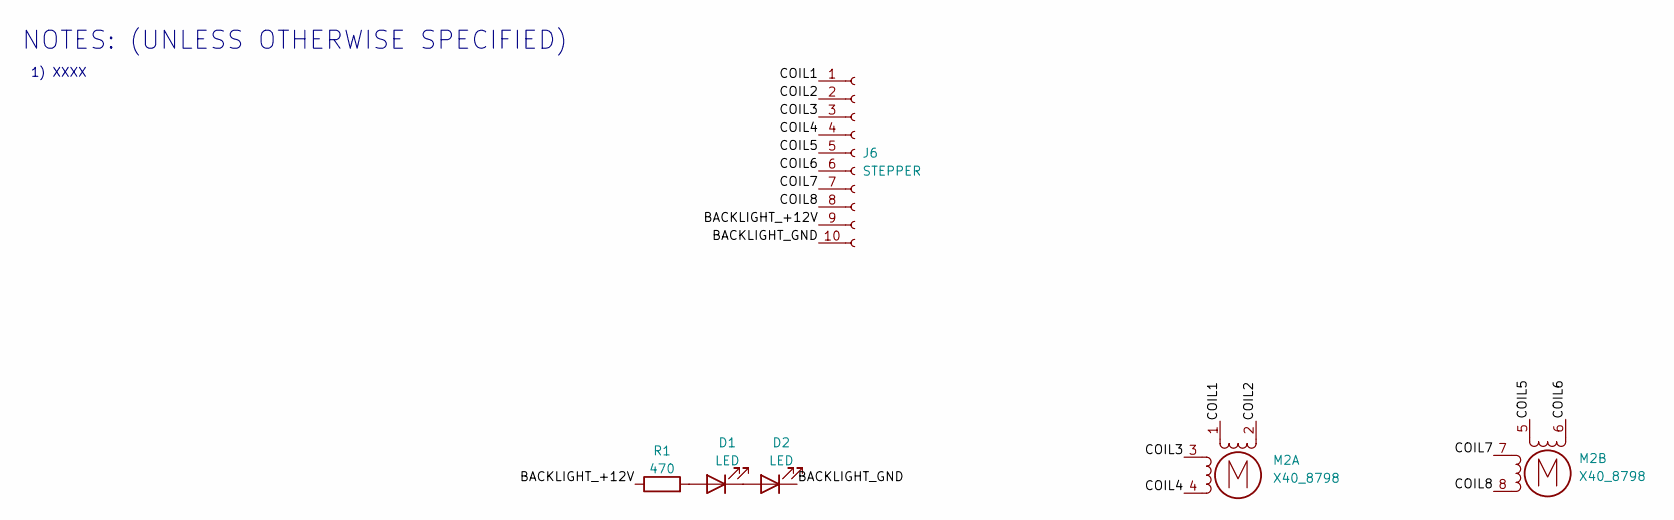
[picture p498: schematic Simkits Large Dual Gauge.kicad_sch]

Parts:
D1, D2: LED; LED_D3.0mm
J6: STEPPER; Molex_KK-254_AE-6410-10A_1x10_P2.54mm_Vertical
M2: X40_8798; x40_8798
R1: 470; R_Axial_DIN0204_L3.6mm_D1.6mm_P1.90mm_Vertical

Connections:
/BACKLIGHT_+12V: J6.9, R1.1
/BACKLIGHT_GND: D2.1 (K), J6.10
/COIL1: J6.1, M2.1
/COIL2: J6.2, M2.2 (-)
/COIL3: J6.3, M2.3
/COIL4: J6.4, M2.4
/COIL5: J6.5, M2.5
/COIL6: J6.6, M2.6 (-)
/COIL7: J6.7, M2.7
/COIL8: J6.8, M2.8
unnamed: D1.2 (A), R1.2
unnamed: D1.1 (K), D2.2 (A)

Notes on the sheet:
1) XXXX
NOTES: (UNLESS OTHERWISE SPECIFIED)
