bnepethomas/bne-arduino-flight-simulator-interfaces/Jet Ranger/PCBs/Simkits Large Dual Gauge/Simkits Large Dual Gauge.kicad_pcb

## KiCad design Jet Ranger/PCBs/Simkits Large Dual Gauge/Simkits Large Dual Gauge.kicad_pcb (continued)

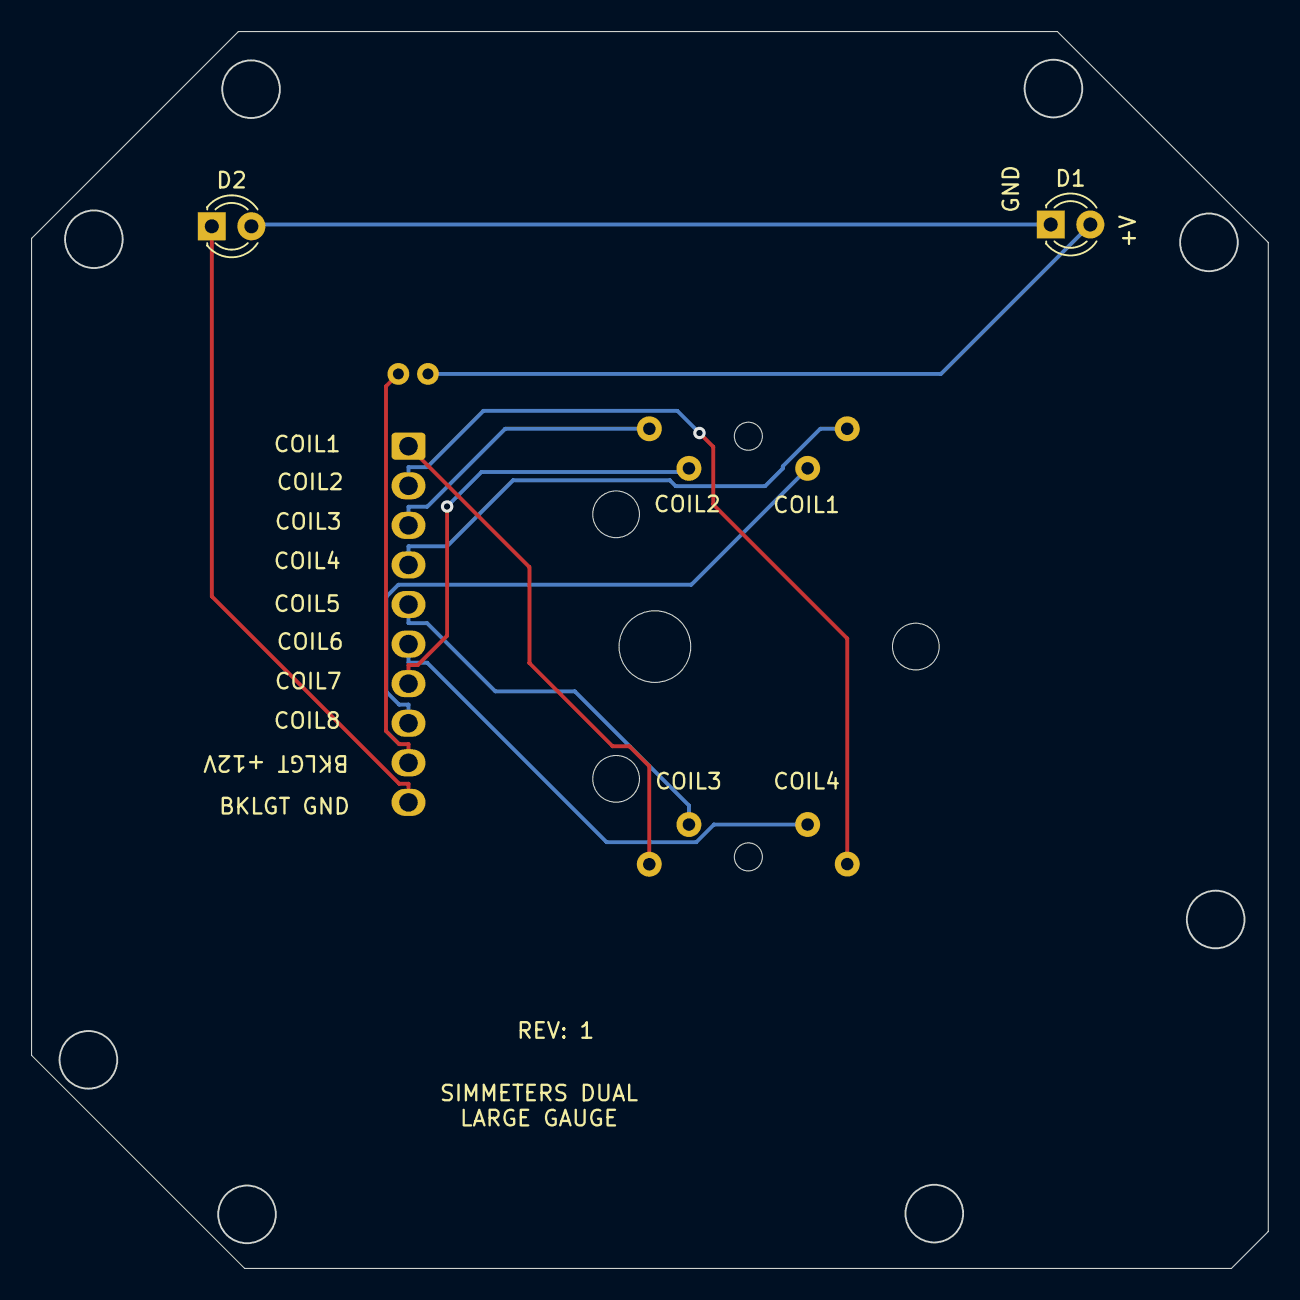
[picture p499: board Simkits Large Dual Gauge.kicad_pcb from above]

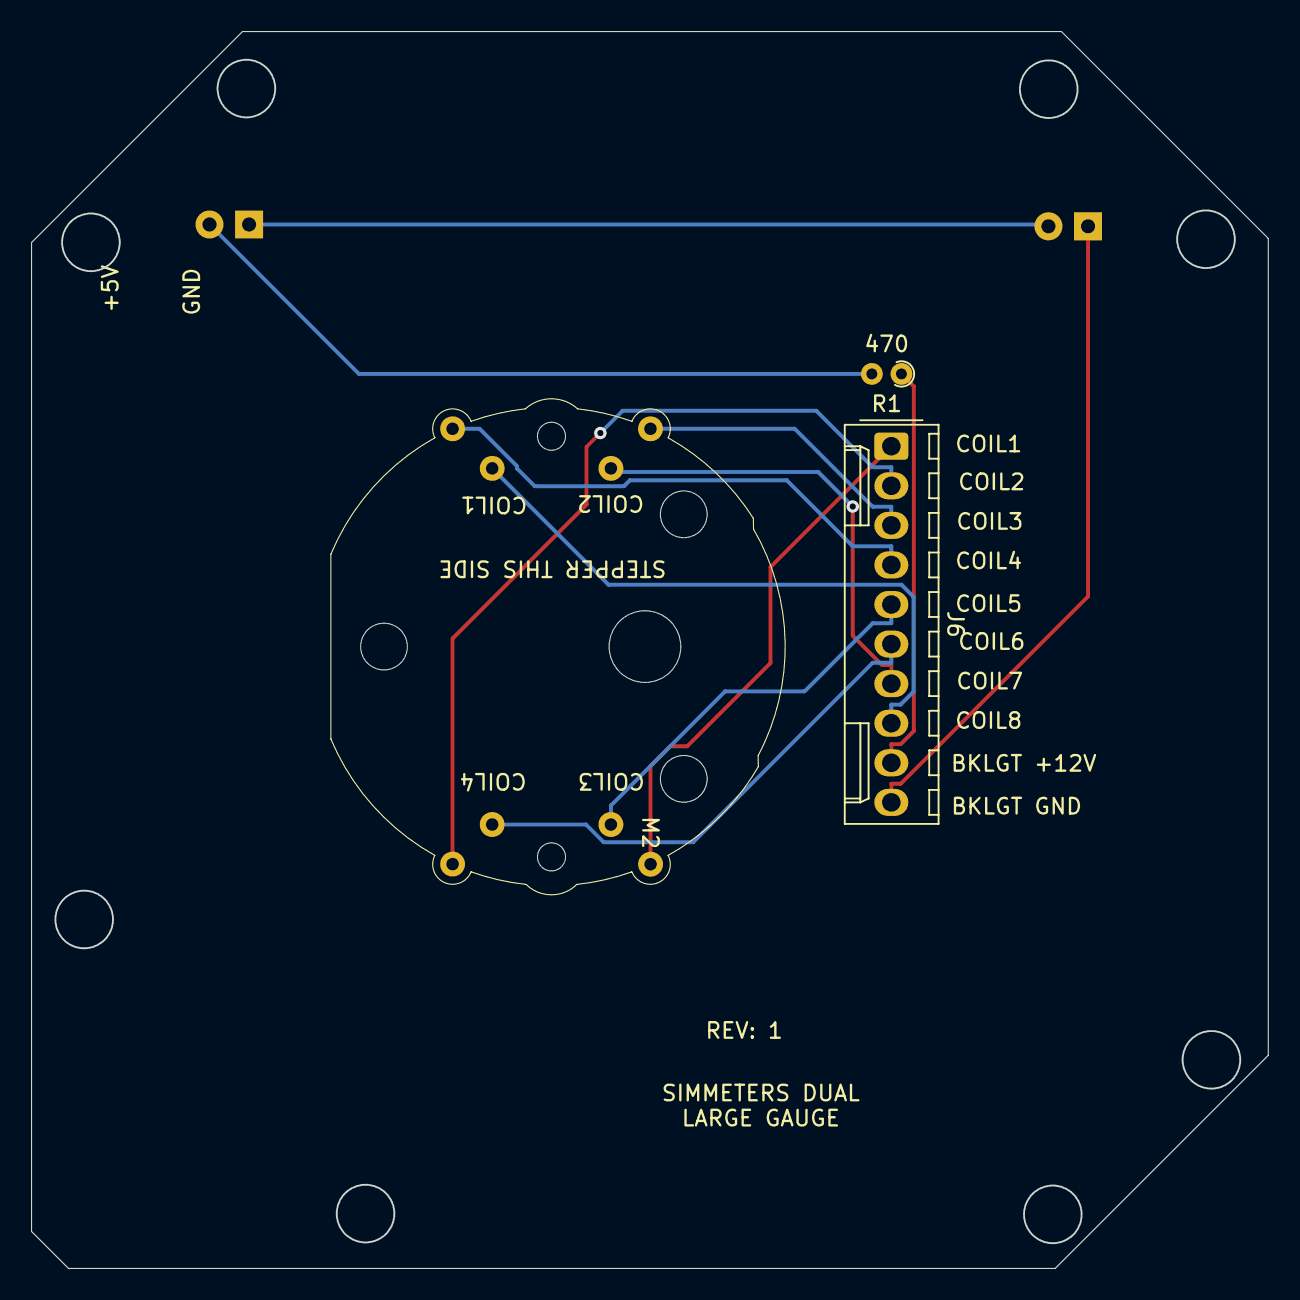
[picture p500: board Simkits Large Dual Gauge.kicad_pcb from below]

Board: 2 copper layers, 79.4 x 79.4 mm, 5 parts (2 on the bottom side), 12 nets.
