bnepethomas/bne-arduino-flight-simulator-interfaces/Hornet/Hornet PCBs/Active/Right_Controller/Right_Control_V004-Redo/Right_Control_V004-Redo.kicad_pcb

## KiCad design Hornet/Hornet PCBs/Active/Right_Controller/Right_Control_V004-Redo/Right_Control_V004-Redo.kicad_pcb (2026-05-22)

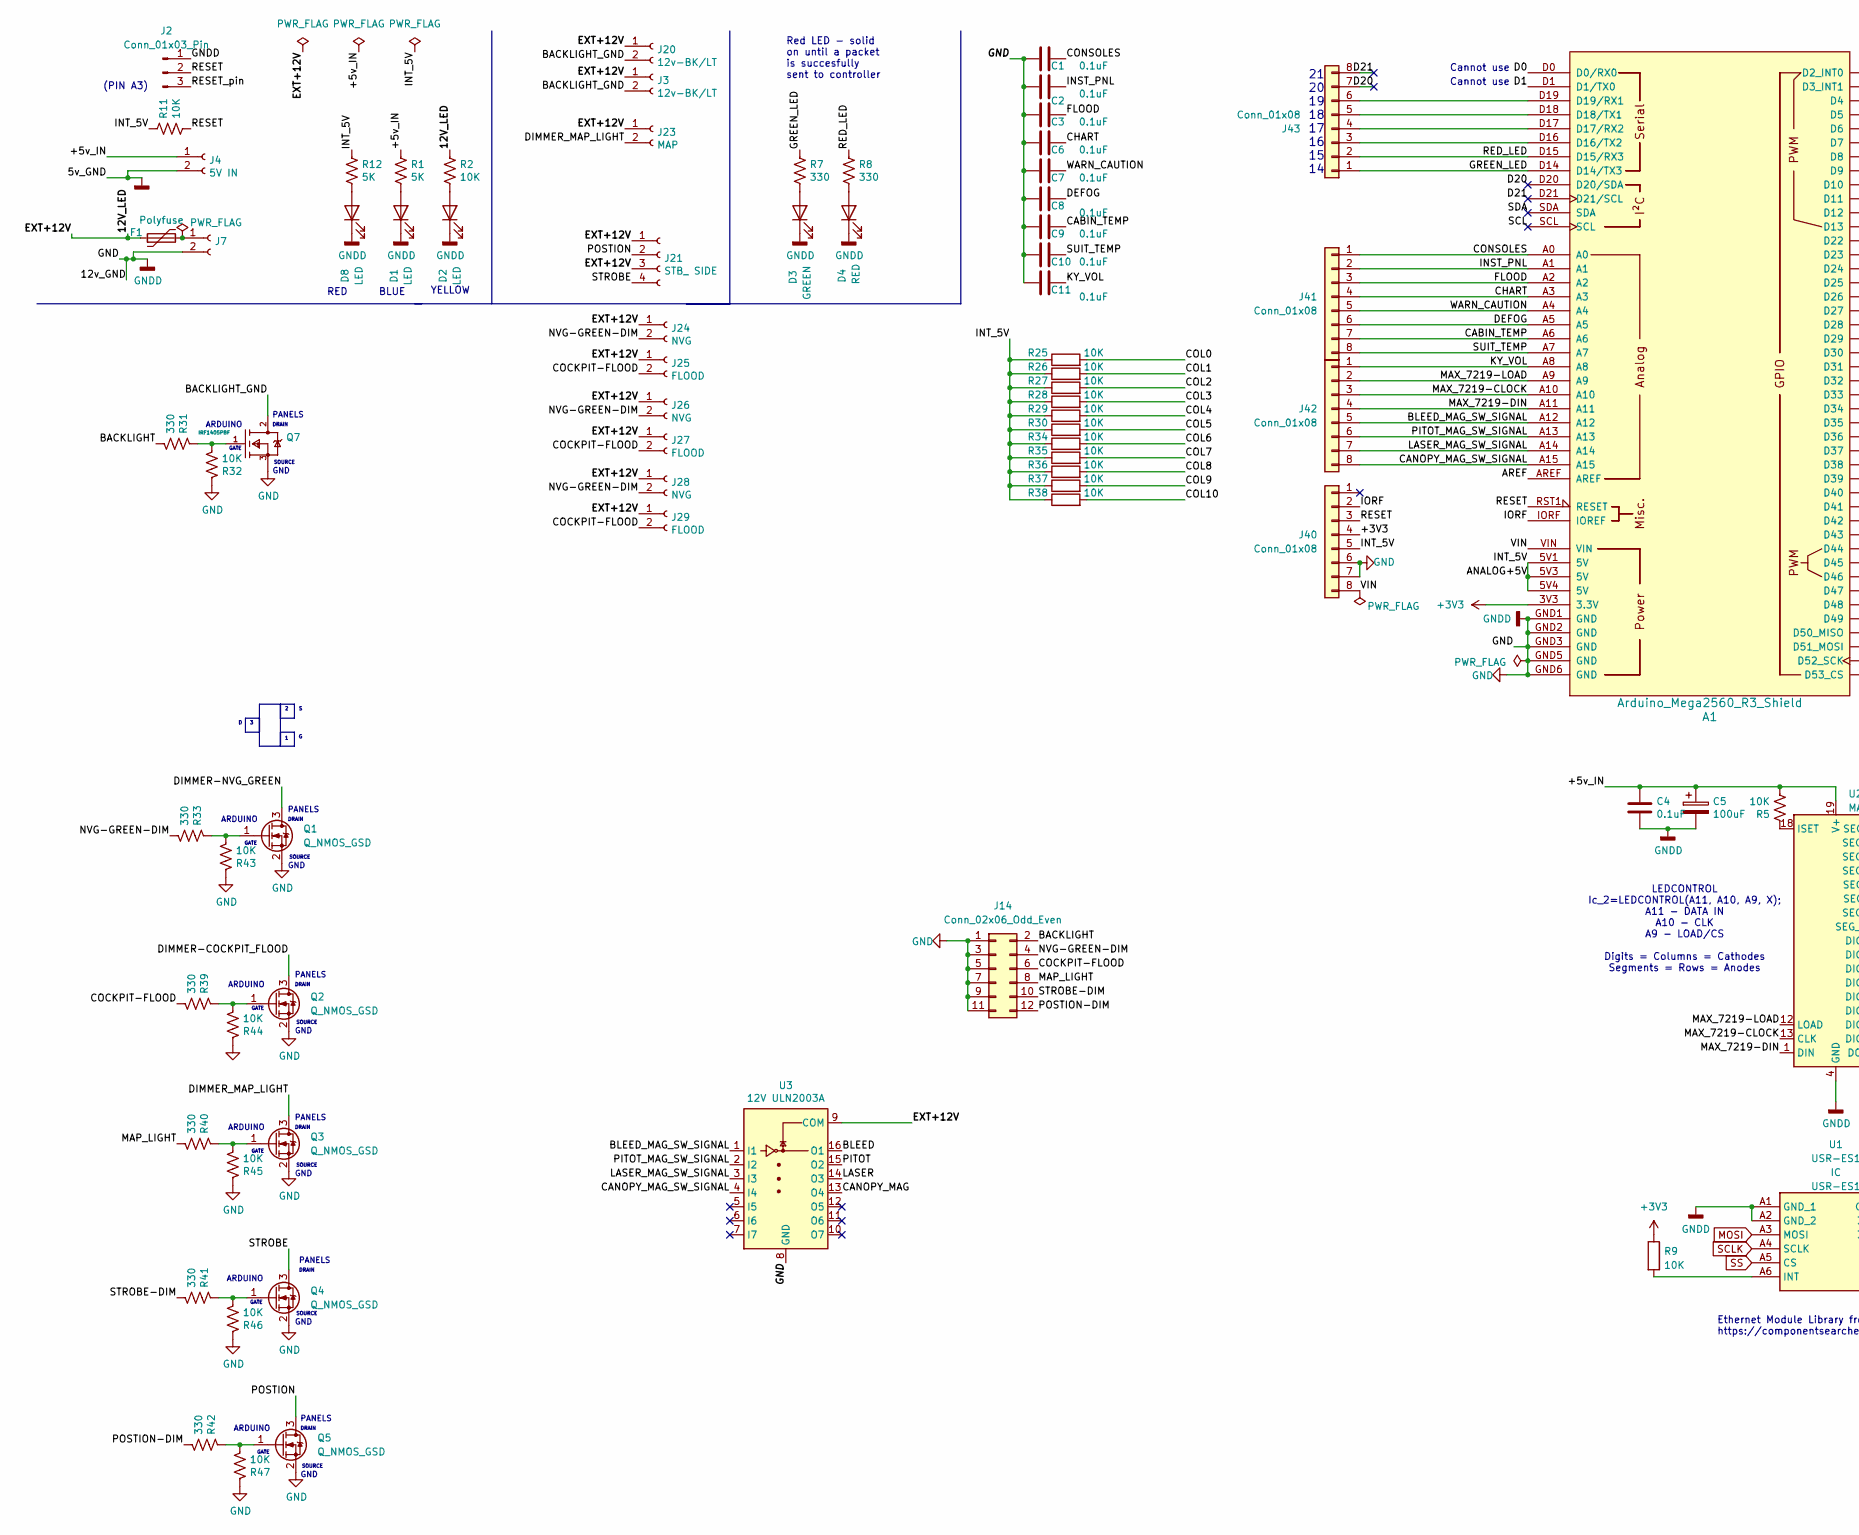
[picture p501: schematic Right_Control_V004-Redo.kicad_sch, part in row 1, column 1]

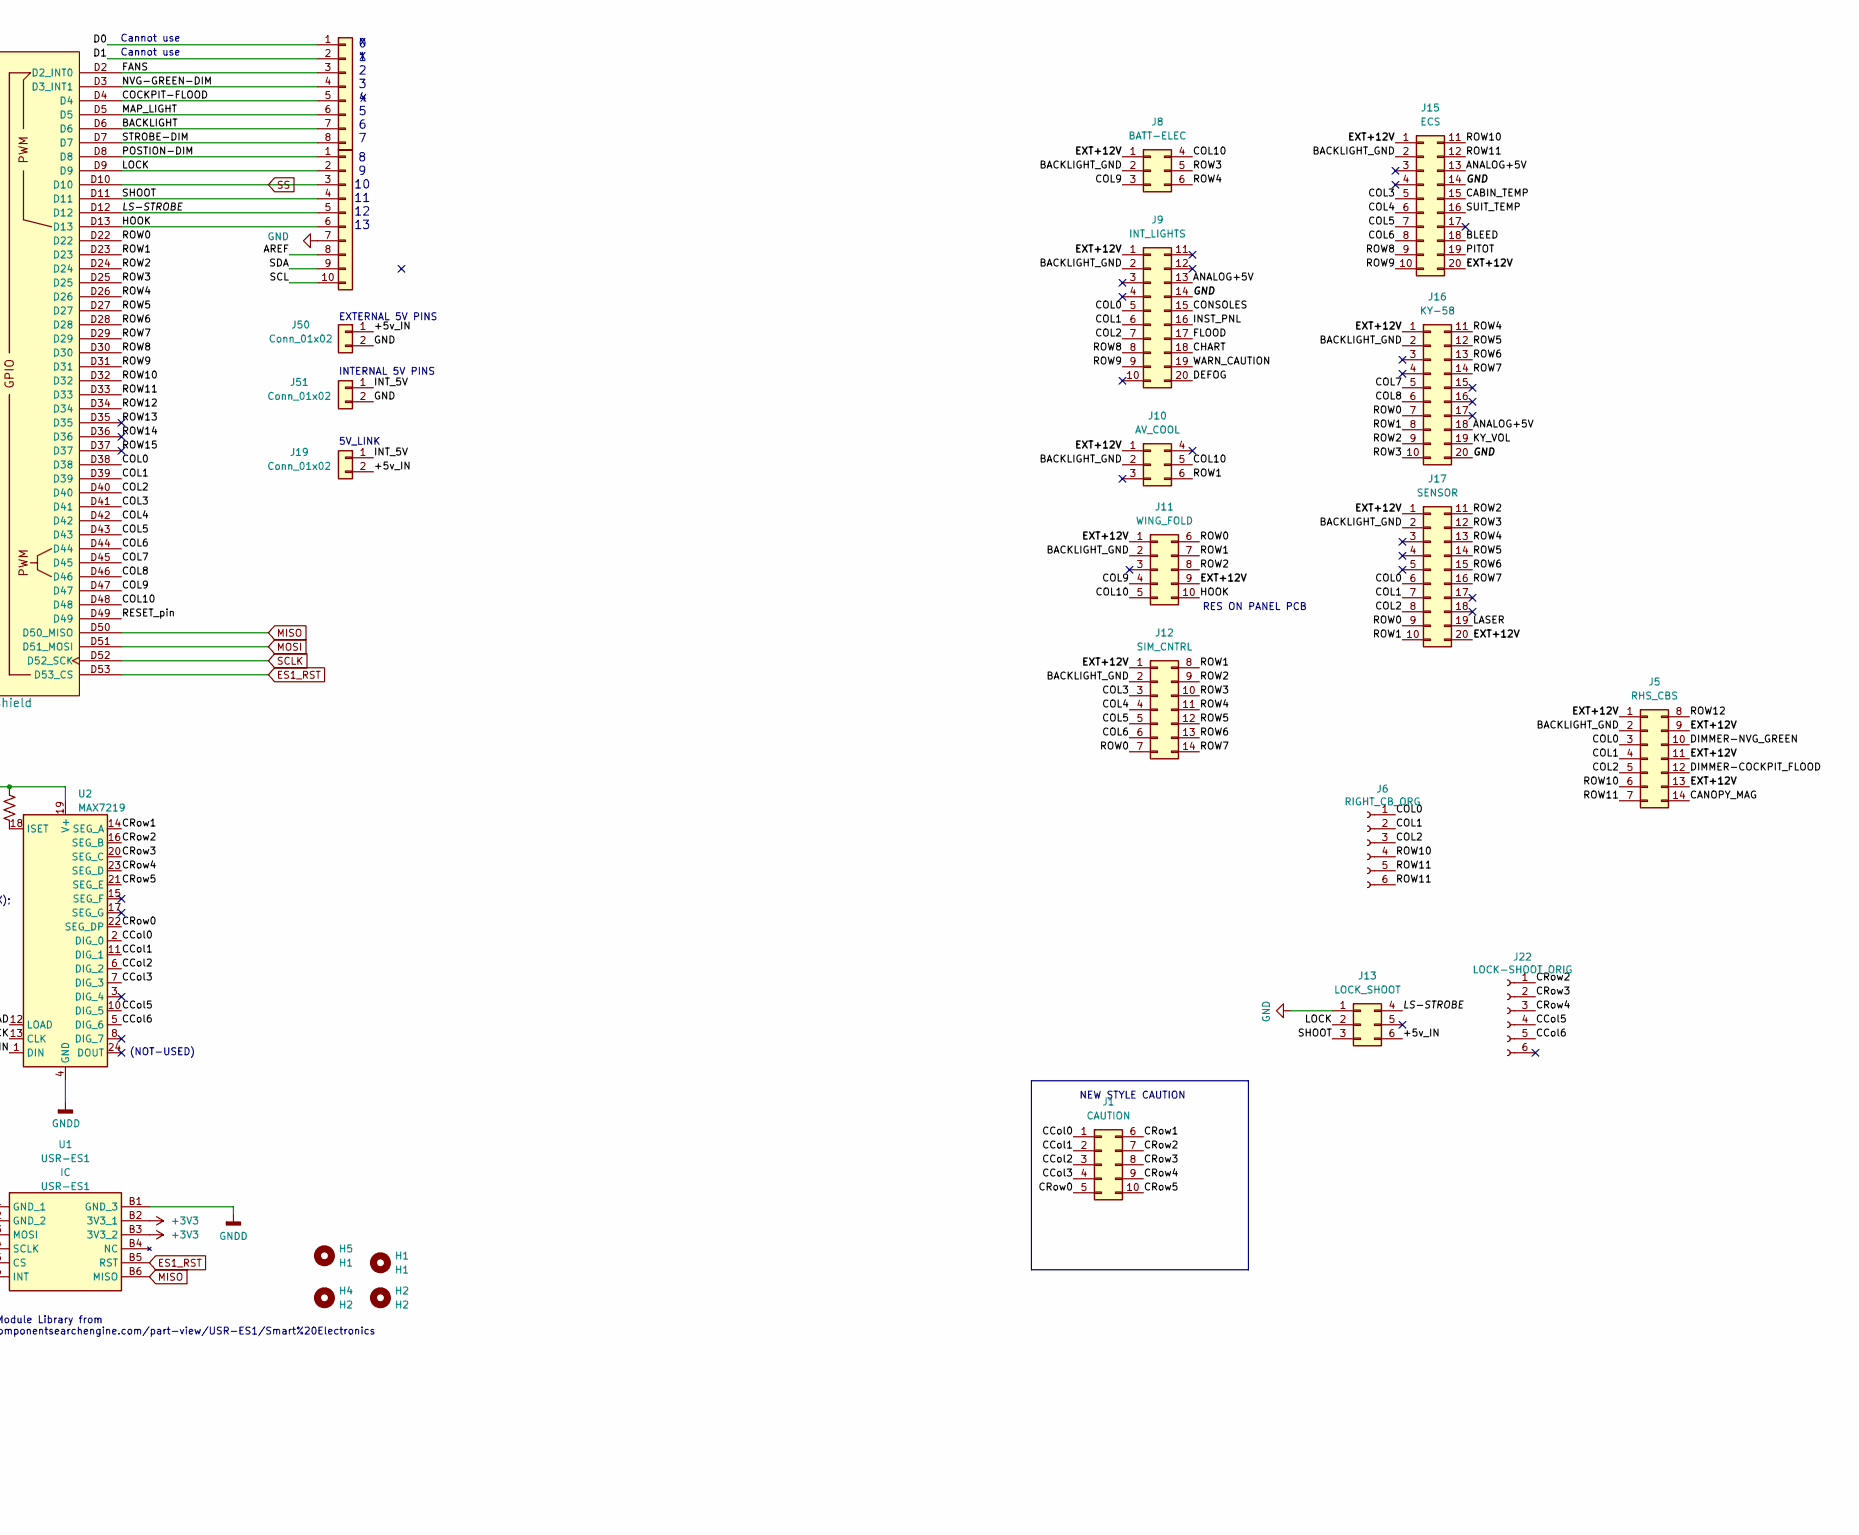
[picture p502: schematic Right_Control_V004-Redo.kicad_sch, part in row 1, column 2]

Parts:
A1: Arduino_Mega2560_R3_Shield
C1, C2, C3, C4, C6, C7, C8, C9, C10, C11: 0.1uF; C_0805_2012Metric
C5: 100uF; C_1210_3225Metric
D1, D2, D8: LED; LED_0805_2012Metric
D3: GREEN; LED_0805_2012Metric
D4: RED; LED_0805_2012Metric
F1: Polyfuse; Fuse_1206_3216Metric
H1, H5: H1; MountingHole_2.5mm
H2, H4: H2; MountingHole_2.5mm
J1: CAUTION; IDC-Header_2x05_P2.54mm_Vertical
J2: Conn_01x03_Pin; PinHeader_1x03_P2.54mm_Vertical
J3, J20: 12v-BK/LT; Molex_KK-254_AE-6410-02A_1x02_P2.54mm_Vertical
J4: 5V IN; BarrelJack_Horizontal
J5: RHS_CBS; IDC-Header_2x07_P2.54mm_Vertical
J6: RIGHT_CB_ORG; Molex_KK-254_AE-6410-06A_1x06_P2.54mm_Vertical
J7: STEPPER IN 12-20VDC; BarrelJack_Horizontal
J8: BATT-ELEC; IDC-Header_2x03_P2.54mm_Vertical
J9: INT_LIGHTS; IDC-Header_2x10_P2.54mm_Vertical
J10: AV_COOL; IDC-Header_2x03_P2.54mm_Vertical
J11: WING_FOLD; IDC-Header_2x05_P2.54mm_Vertical
J12: SIM_CNTRL; IDC-Header_2x07_P2.54mm_Vertical
J13: LOCK_SHOOT; IDC-Header_2x03_P2.54mm_Vertical
J14: Conn_02x06_Odd_Even; PinHeader_2x06_P2.54mm_Vertical
J15: ECS; IDC-Header_2x10_P2.54mm_Vertical
J16: KY-58; IDC-Header_2x10_P2.54mm_Vertical
J17: SENSOR; IDC-Header_2x10_P2.54mm_Vertical
J19, J50, J51: Conn_01x02; PinHeader_1x02_P2.54mm_Vertical
J21: STB_ SIDE; Molex_KK-254_AE-6410-04A_1x04_P2.54mm_Vertical
J22: LOCK-SHOOT_ORIG; Molex_KK-254_AE-6410-06A_1x06_P2.54mm_Vertical
J23: MAP; Molex_KK-254_AE-6410-02A_1x02_P2.54mm_Vertical
J24, J26, J28: NVG; Molex_KK-254_AE-6410-02A_1x02_P2.54mm_Vertical
J25, J27, J29: FLOOD; Molex_KK-254_AE-6410-02A_1x02_P2.54mm_Vertical
J40, J41, J42, J43, J44: Conn_01x08; PinHeader_1x08_P2.54mm_Vertical
J45: Conn_01x10; PinHeader_1x10_P2.54mm_Vertical
Q1, Q2, Q3, Q4, Q5: Q_NMOS_GSD; SOT-23
Q7: IRF1405PBF; TO-220-3_Vertical; mouser part number 942-IRF1405PBF; digikey description MOSFET N-CH 55V 169A TO-220AB
R1, R12: 5K; R_0805_2012Metric
R2, R5, R9, R11, R25, R26, R27, R28, R29, R30, R32, R34, R35, R36, R37, R38, R43, R44, R45, R46, R47: 10K; R_0805_2012Metric
R7, R8, R31, R33, R39, R40, R41, R42: 330; R_0805_2012Metric
U1: USR-ES1; USRES1; Manufacturer_Part_Number USR-ES1
U2: MAX7219; DIP-24_W7.62mm_LongPads
U3: 12V ULN2003A; DIP-16_W7.62mm

Connections:
+3V3: A1.3V3 (3.3V), J40.4, R9.1, U1.B2 (3V3_1), U1.B3 (3V3_2)
/12V_LED: F1.1, J3.1, J5.1, J5.9, J5.11, J5.13, J8.1, J9.1, J10.1, J11.1, J11.9, J12.1, J15.1, J15.20, J16.1, J17.1, J17.20, J20.1, J21.1, J21.3, J23.1, J24.1, J25.1, J26.1, J27.1, J28.1, J29.1, R2.1, U3.9 (COM)
/+5v_IN: C4.1, C5.1, J4.1, J13.6, J19.2, J50.1, R1.1, R5.2, U2.19 (V+)
/ANALOG+5V: A1.5V1 (5V), A1.5V3 (5V), A1.5V4 (5V), J9.13, J15.13, J16.18, J19.1, J40.5, J51.1, R11.1, R12.1, R25.1, R26.1, R27.1, R28.1, R29.1, R30.1, R34.1, R35.1, R36.1, R37.1, R38.1
/AREF: A1.AREF, J45.8
/BACKLIGHT: A1.D6, J14.2, J44.7, R31.2
/BACKLIGHT_GND: J3.2, J5.2, J8.2, J9.2, J10.2, J11.2, J12.2, J15.2, J16.2, J17.2, J20.2, Q7.2 (D)
/BLEED: J15.18, U3.16 (O1)
/BLEED_MAG_SW_SIGNAL: A1.A12, J42.5, U3.1 (I1)
/CABIN_TEMP: A1.A6, C9.1, J15.15, J41.7
/CANOPY_MAG: J5.14, U3.13 (O4)
/CANOPY_MAG_SW_SIGNAL: A1.A15, J42.8, U3.4 (I4)
/CCol0: J1.1, U2.2 (DIG_0)
/CCol1: J1.2, U2.11 (DIG_1)
/CCol2: J1.3, U2.6 (DIG_2)
/CCol3: J1.4, U2.7 (DIG_3)
/CCol5: J22.4, U2.10 (DIG_5)
/CCol6: J22.5, U2.5 (DIG_6)
/CHART: A1.A3, C6.1, J9.18, J41.4
/COCKPIT-FLOOD: A1.D4, J14.6, J25.2, J27.2, J29.2, J44.5, R39.2
/COL0: A1.D38, J5.3, J6.1, J9.5, J17.6, R25.2
/COL1: A1.D39, J5.4, J6.2, J9.6, J17.7, R26.2
/COL2: A1.D40, J5.5, J6.3, J9.7, J17.8, R27.2
/COL3: A1.D41, J12.3, J15.5, R28.2
/COL4: A1.D42, J12.4, J15.6, R29.2
/COL5: A1.D43, J12.5, J15.7, R30.2
/COL6: A1.D44, J12.6, J15.8, R34.2
/COL7: A1.D45, J16.5, R35.2
/COL8: A1.D46, J16.6, R36.2
/COL9: A1.D47, J8.3, J11.4, R37.2
/COL10: A1.D48, J8.4, J10.5, J11.5, R38.2
/CONSOLES: A1.A0, C1.1, J9.15, J41.1
/CRow0: J1.5, U2.22 (SEG_DP)
/CRow1: J1.6, U2.14 (SEG_A)
/CRow2: J1.7, J22.1, U2.16 (SEG_B)
/CRow3: J1.8, J22.2, U2.20 (SEG_C)
/CRow4: J1.9, J22.3, U2.23 (SEG_D)
/CRow5: J1.10, U2.21 (SEG_E)
/D0: A1.D0 (D0/RX0), J44.1
/D1: A1.D1 (D1/TX0), J44.2
/D20: A1.D20 (D20/SDA), J43.7
/D21: A1.D21 (D21/SCL), J43.8
/DEFOG: A1.A5, C8.1, J9.20, J41.6
/DIMMER-COCKPIT_FLOOD: J5.12, Q2.3 (D)
/DIMMER-NVG_GREEN: J5.10, Q1.3 (D)
/DIMMER_MAP_LIGHT: J23.2, Q3.3 (D)
/FANS: A1.D2 (D2_INT0), J44.3
/FLOOD: A1.A2, C3.1, J9.17, J41.3
/GREEN_LED: A1.D14 (D14/TX3), J43.1, R7.1
/HOOK: A1.D13, J11.10, J45.6
/INST_PNL: A1.A1, C2.1, J9.16, J41.2
/IORF: A1.IORF (IOREF), J40.2
/KY_VOL: A1.A8, C11.1, J16.19, J42.1
/LASER: J17.19, U3.14 (O3)
/LASER_MAG_SW_SIGNAL: A1.A14, J42.7, U3.3 (I3)
/LOCK: A1.D9, J13.2, J45.2
/LS-STROBE: A1.D12, J13.4, J45.5
/MAP_LIGHT: A1.D5, J14.8, J44.6, R40.2
/MAX_7219-CLOCK: A1.A10, J42.3, U2.13 (CLK)
/MAX_7219-DIN: A1.A11, J42.4, U2.1 (DIN)
/MAX_7219-LOAD: A1.A9, J42.2, U2.12 (LOAD)
/NVG-GREEN-DIM: A1.D3 (D3_INT1), J14.4, J24.2, J26.2, J28.2, J44.4, R33.2
/PITOT: J15.19, U3.15 (O2)
/PITOT_MAG_SW_SIGNAL: A1.A13, J42.6, U3.2 (I2)
/POSTION: J21.2, Q5.3 (D)
/POSTION-DIM: A1.D8, J14.12, J45.1, R42.2
/RED_LED: A1.D15 (D15/RX3), J43.2, R8.1
/RESET: A1.RST1 (RESET), J2.2, J40.3, R11.2
/RESET_pin: A1.D49, J2.3
/ROW0: A1.D22, J11.6, J12.7, J16.7, J17.9
/ROW1: A1.D23, J10.6, J11.7, J12.8, J16.8, J17.10
/ROW2: A1.D24, J11.8, J12.9, J16.9, J17.11
/ROW3: A1.D25, J8.5, J12.10, J16.10, J17.12
/ROW4: A1.D26, J8.6, J12.11, J16.11, J17.13
/ROW5: A1.D27, J12.12, J16.12, J17.14
/ROW6: A1.D28, J12.13, J16.13, J17.15
/ROW7: A1.D29, J12.14, J16.14, J17.16
/ROW8: A1.D30, J9.8, J15.9
/ROW9: A1.D31, J9.9, J15.10
/ROW10: A1.D32, J5.6, J6.4, J15.11
/ROW11: A1.D33, J5.7, J6.5, J6.6, J15.12
/ROW12: A1.D34, J5.8
/ROW13: A1.D35
/ROW14: A1.D36
/ROW15: A1.D37
/SCL: A1.SCL, J45.10
/SDA: A1.SDA, J45.9
/SHOOT: A1.D11, J13.3, J45.4
/STROBE: J21.4, Q4.3 (D)
/STROBE-DIM: A1.D7, J14.10, J44.8, R41.2
/SUIT_TEMP: A1.A7, C10.1, J15.16, J41.8
/VIN: A1.VIN, J40.8
/WARN_CAUTION: A1.A4, C7.1, J9.19, J41.5
ES1_RST: A1.D53 (D53_CS), U1.B5 (RST)
GND: A1.GND1 (GND), A1.GND2 (GND), A1.GND3 (GND), A1.GND5 (GND), A1.GND6 (GND), C1.2, C2.2, C3.2, C4.2, C5.2, C6.2, C7.2, C8.2, C9.2, C10.2, C11.2, D1.1 (K), D2.1 (K), D3.1 (K), D4.1 (K), D8.1 (K), J2.1, J4.2, J7.2, J9.14, J13.1, J14.1, J14.3, J14.5, J14.7, J14.9, J14.11, J15.14, J16.20, J40.6, J40.7, J45.7, J50.2, J51.2, Q1.2 (S), Q2.2 (S), Q3.2 (S), Q4.2 (S), Q5.2 (S), Q7.3 (S), R32.1, R43.1, R44.1, R45.1, R46.1, R47.1, U1.A1 (GND_1), U1.A2 (GND_2), U1.B1 (GND_3), U2.4 (GND), U2.9 (GND), U3.8 (GND)
MISO: A1.D50 (D50_MISO), U1.B6 (MISO)
MOSI: A1.D51 (D51_MOSI), U1.A3 (MOSI)
unnamed: A1.D16 (D16/TX2), J43.3
unnamed: A1.D17 (D17/RX2), J43.4
unnamed: A1.D18 (D18/TX1), J43.5
unnamed: A1.D19 (D19/RX1), J43.6
unnamed: D1.2 (A), R1.2
unnamed: D2.2 (A), R2.2
unnamed: D3.2 (A), R7.2
unnamed: D4.2 (A), R8.2
unnamed: D8.2 (A), R12.2
unnamed: F1.2, J7.1
unnamed: Q1.1 (G), R33.1, R43.2
unnamed: Q2.1 (G), R39.1, R44.2
unnamed: Q3.1 (G), R40.1, R45.2
unnamed: Q4.1 (G), R41.1, R46.2
unnamed: Q5.1 (G), R42.1, R47.2
unnamed: Q7.1 (G), R31.1, R32.2
unnamed: R9.2, U1.A6 (INT)
unnamed: R5.1, U2.18 (ISET)
SCLK: A1.D52 (D52_SCK), U1.A4 (SCLK)
SS: A1.D10, J45.3, U1.A5 (CS)

Notes on the sheet:
YELLOW
ARDUINO
SOURCE
GND
PANELS
DRAIN
BLUE
RES ON PANEL PCB
NEW STYLE CAUTION
INTERNAL 5V PINS
5V_LINK
Ethernet Module Library from https://componentsearchengine.com/part-view/USR-ES1/Smart%20Electronics
LEDCONTROL Ic_2=LEDCONTROL(A11, A10, A9, X); A11 - DATA IN A10 - CLK A9 - LOAD/CS Digits = Columns = Cathodes Segments = Rows = Anodes
GATE
Cannot use
RED
(PIN A3)
0 1 2 3 4 5 6 7
Red LED - solid on until a packet is succesfully sent to controller
(NOT-USED)
21 20 19 18 17 16 15 14
EXTERNAL 5V PINS
8 9 10 11 12 13

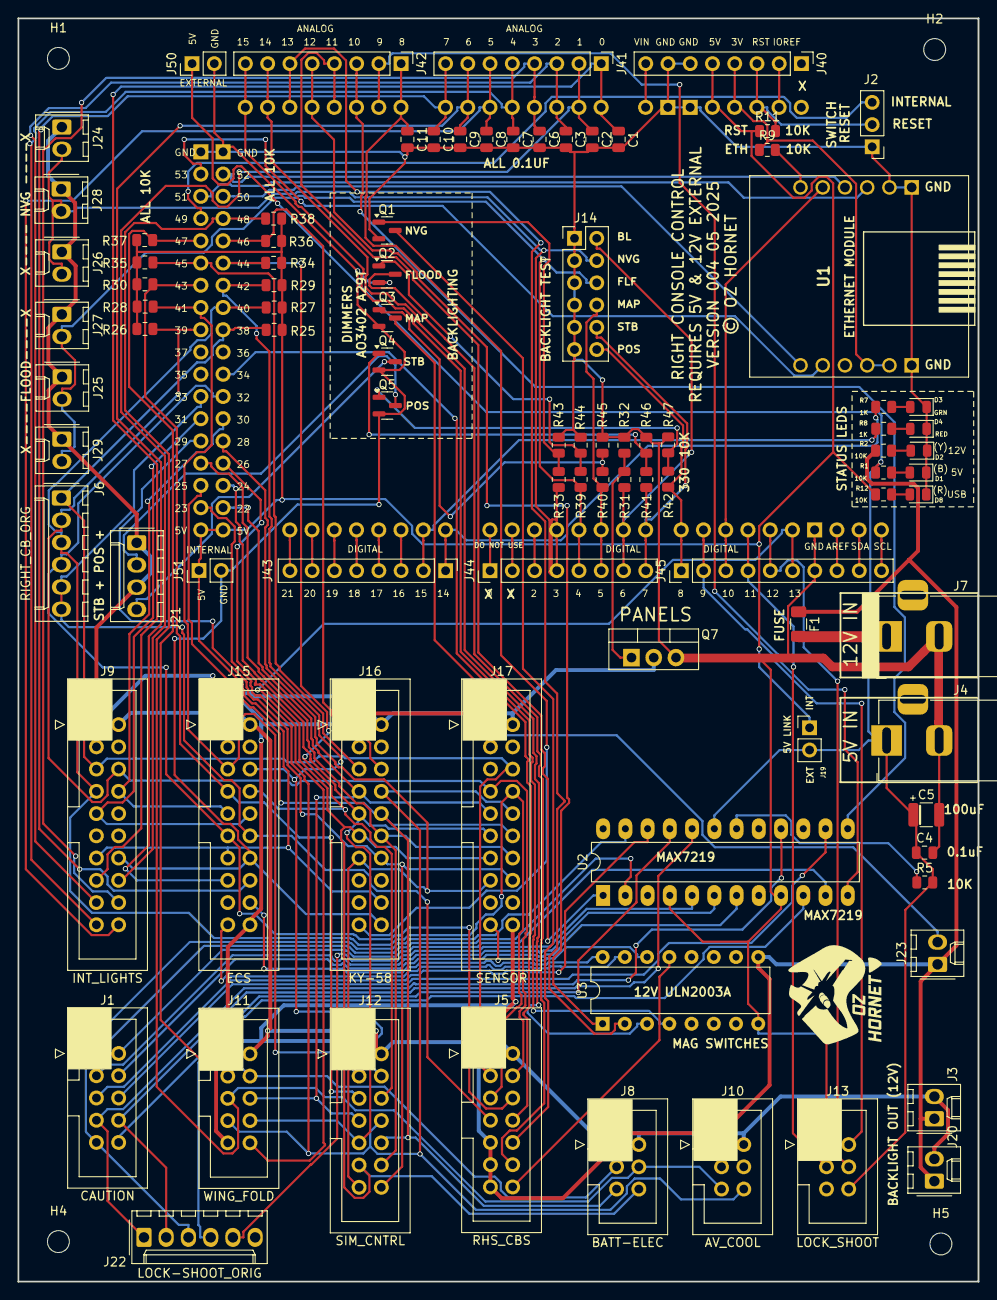
[picture p503: board Right_Control_V004-Redo.kicad_pcb from above]

Board: 2 copper layers, 109.7 x 144.3 mm, 98 parts (0 on the bottom side), 114 nets.
