bnepethomas/bne-arduino-flight-simulator-interfaces/Hornet/Hornet PCBs/Active/Left Console/LEFT_CONTROLLER-v005 June 2025/LEFT_CONTROLLER-v005 June 2025.kicad_pcb

## KiCad design Hornet/Hornet PCBs/Active/Left Console/LEFT_CONTROLLER-v005 June 2025/LEFT_CONTROLLER-v005 June 2025.kicad_pcb (2026-05-22)

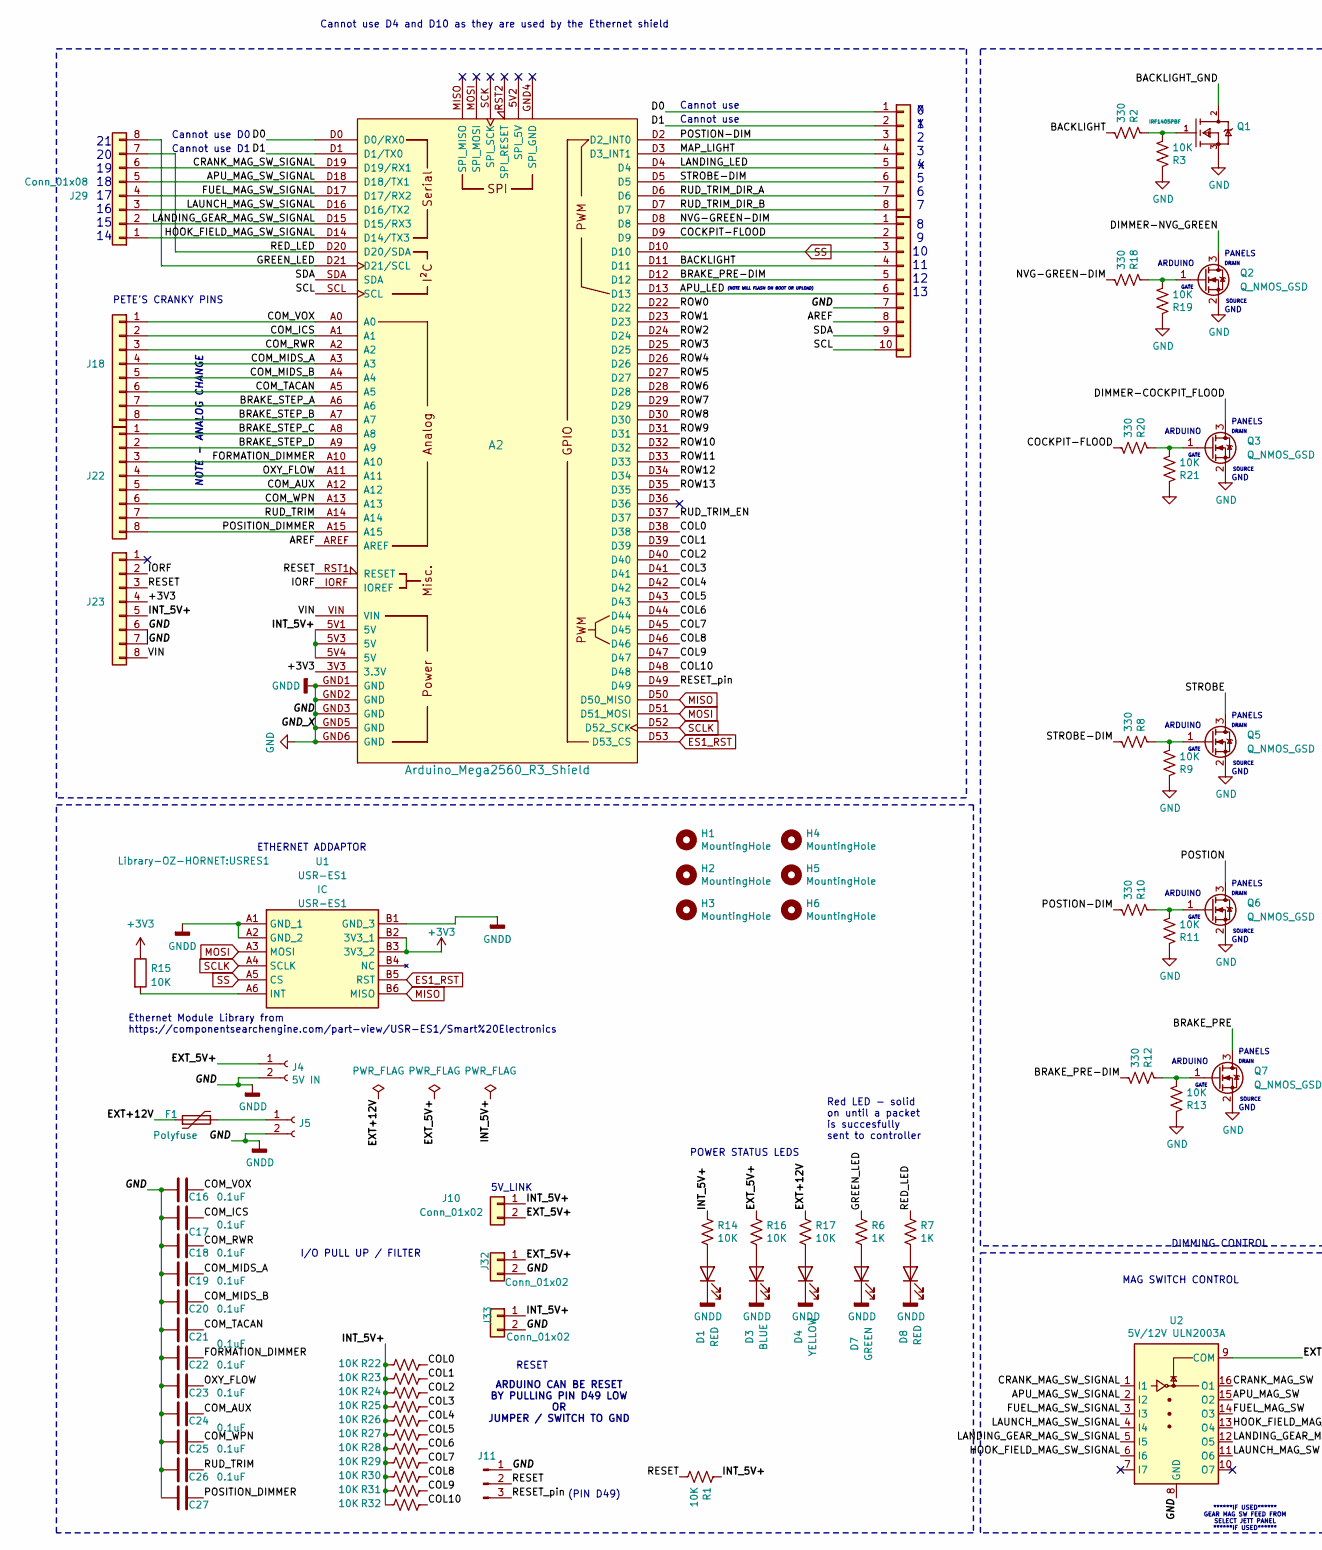
[picture p504: schematic LEFT_CONTROLLER-v005 June 2025.kicad_sch, part in row 1, column 1]

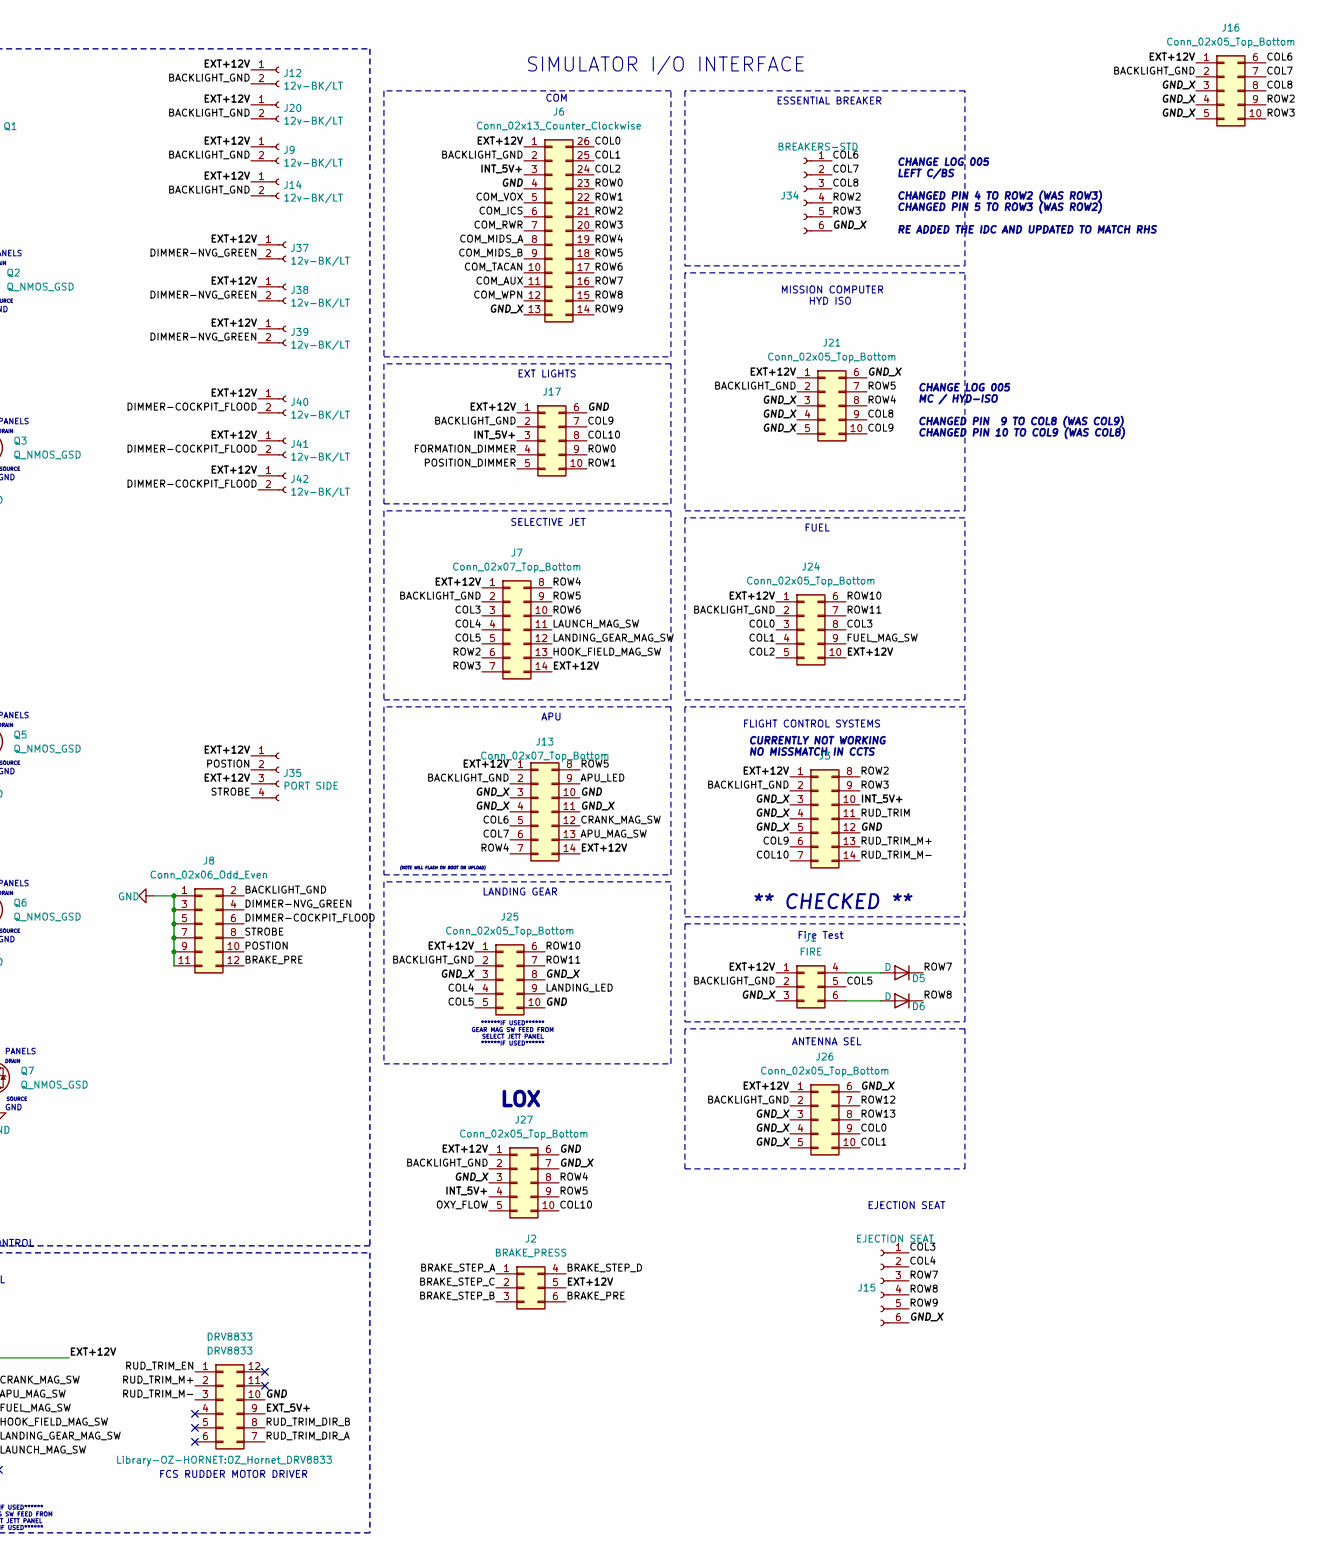
[picture p505: schematic LEFT_CONTROLLER-v005 June 2025.kicad_sch, part in row 1, column 2]

Parts:
A2: Arduino_Mega2560_R3_Shield
C16, C17, C18, C19, C20, C21, C22, C23, C24, C25, C26, C27: 0.1uF; C_0805_2012Metric
D1, D8: RED; LED_0805_2012Metric
D3: BLUE; LED_0805_2012Metric
D4: YELLOW; LED_0805_2012Metric
D5, D6: D; D_0805_2012Metric
D7: GREEN; LED_0805_2012Metric
DRV8833: DRV8833; OZ_Hornet_DRV8833
F1: Polyfuse; Fuse_1206_3216Metric
H1, H2, H3, H4, H5, H6: MountingHole; MountingHole_3.2mm_M3
J1: FIRE; IDC-Header_2x03_P2.54mm_Vertical
J2: BRAKE_PRESS; IDC-Header_2x03_P2.54mm_Vertical
J3, J7, J13: Conn_02x07_Top_Bottom; IDC-Header_2x07_P2.54mm_Vertical
J4: 5V IN; BarrelJack_Horizontal
J5: STEPPER IN 12-20VDC; BarrelJack_Horizontal
J6: Conn_02x13_Counter_Clockwise; IDC-Header_2x13_P2.54mm_Vertical
J8: Conn_02x06_Odd_Even; PinHeader_2x06_P2.54mm_Vertical
J9, J12, J14, J20, J37, J38, J39, J40, J41, J42: 12v-BK/LT; Molex_KK-254_AE-6410-02A_1x02_P2.54mm_Vertical
J10, J32, J33: Conn_01x02; PinHeader_1x02_P2.54mm_Vertical
J11: Conn_01x03_Pin; PinHeader_1x03_P2.54mm_Vertical
J15: EJECTION SEAT; Molex_KK-254_AE-6410-06A_1x06_P2.54mm_Vertical
J16, J17, J21, J24, J25, J26, J27: Conn_02x05_Top_Bottom; IDC-Header_2x05_P2.54mm_Vertical
J18, J22, J23, J29, J30: Conn_01x08; PinHeader_1x08_P2.54mm_Vertical
J31: Conn_01x10; PinHeader_1x10_P2.54mm_Vertical
J34: BREAKERS-STD; Molex_KK-254_AE-6410-06A_1x06_P2.54mm_Vertical
J35: PORT SIDE; Molex_KK-254_AE-6410-04A_1x04_P2.54mm_Vertical
Q1: IRF1405PBF; TO-220-3_Vertical; mouser part number 942-IRF1405PBF; digikey description MOSFET N-CH 55V 169A TO-220AB
Q2, Q3, Q5, Q6, Q7: Q_NMOS_GSD; SOT-23
R1, R3, R9, R11, R13, R14, R15, R16, R17, R19, R21, R22, R23, R24, R25, R26, R27, R28, R29, R30, R31, R32: 10K; R_0805_2012Metric
R2, R8, R10, R12, R18, R20: 330; R_0805_2012Metric
R6, R7: 1K; R_0805_2012Metric
U1: USR-ES1; USRES1; Manufacturer_Part_Number USR-ES1
U2: 5V/12V ULN2003A; DIP-16_W7.62mm

Connections:
+3V3: A2.3V3 (3.3V), J23.4, R15.1, U1.B2 (3V3_1), U1.B3 (3V3_2)
/APU_LED: A2.D13, J13.9, J31.6
/APU_MAG_SW: J13.13, U2.15 (O2)
/APU_MAG_SW_SIGNAL: A2.D18 (D18/TX1), J29.5, U2.2 (I2)
/AREF: A2.AREF, J31.8
/BACKLIGHT: A2.D11, J31.4, R2.2
/BACKLIGHT_GND: J1.2, J3.2, J6.2, J7.2, J8.2, J9.2, J12.2, J13.2, J14.2, J16.2, J17.2, J20.2, J21.2, J24.2, J25.2, J26.2, J27.2, Q1.2 (D)
/BRAKE_PRE: J2.6, J8.12, Q7.3 (D)
/BRAKE_PRE-DIM: A2.D12, J31.5, R12.2
/BRAKE_STEP_A: A2.A6, J2.1, J18.7
/BRAKE_STEP_B: A2.A7, J2.3, J18.8
/BRAKE_STEP_C: A2.A8, J2.2, J22.1
/BRAKE_STEP_D: A2.A9, J2.4, J22.2
/COCKPIT-FLOOD: A2.D9, J31.2, R20.2
/COL0: A2.D38, J6.26, J24.3, J26.9, R22.1
/COL1: A2.D39, J6.25, J24.4, J26.10, R23.1
/COL2: A2.D40, J6.24, J24.5, R24.1
/COL3: A2.D41, J7.3, J15.1, J24.8, R25.1
/COL4: A2.D42, J7.4, J15.2, J25.4, R26.1
/COL5: A2.D43, J1.5, J7.5, J25.5, R27.1
/COL6: A2.D44, J13.5, J16.6, J34.1, R28.1
/COL7: A2.D45, J13.6, J16.7, J34.2, R29.1
/COL10: A2.D48, J3.7, J17.8, J27.10, R32.1
/COM_AUX: A2.A12, C24.1, J6.11, J22.5
/COM_ICS: A2.A1, C17.1, J6.6, J18.2
/COM_MIDS_A: A2.A3, C19.1, J6.8, J18.4
/COM_MIDS_B: A2.A4, C20.1, J6.9, J18.5
/COM_RWR: A2.A2, C18.1, J6.7, J18.3
/COM_TACAN: A2.A5, C21.1, J6.10, J18.6
/COM_VOX: A2.A0, C16.1, J6.5, J18.1
/COM_WPN: A2.A13, C25.1, J6.12, J22.6
/CRANK_MAG_SW: J13.12, U2.16 (O1)
/CRANK_MAG_SW_SIGNAL: A2.D19 (D19/RX1), J29.6, U2.1 (I1)
/D0: A2.D0 (D0/RX0), J30.1
/D1: A2.D1 (D1/TX0), J30.2
/DIMMER-COCKPIT_FLOOD: J8.6, J40.2, J41.2, J42.2, Q3.3 (D)
/DIMMER-NVG_GREEN: J8.4, J37.2, J38.2, J39.2, Q2.3 (D)
/EXT+12V: F1.1, J1.1, J2.5, J3.1, J6.1, J7.1, J7.14, J9.1, J12.1, J13.1, J13.14, J14.1, J16.1, J17.1, J20.1, J21.1, J24.1, J24.10, J25.1, J26.1, J27.1, J35.1, J35.3, J37.1, J38.1, J39.1, J40.1, J41.1, J42.1, R17.1, U2.9 (COM)
/EXT_5V+: DRV8833.9, J4.1, J10.2, J32.1, R16.1
/FORMATION_DIMMER: A2.A10, C22.1, J17.4, J22.3
/FUEL_MAG_SW: J24.9, U2.14 (O3)
/FUEL_MAG_SW_SIGNAL: A2.D17 (D17/RX2), J29.4, U2.3 (I3)
/GREEN_LED: A2.D21 (D21/SCL), J29.8, R6.1
/HOOK_FIELD_MAG_SW: J7.13, U2.13 (O4)
/HOOK_FIELD_MAG_SW_SIGNAL: A2.D14 (D14/TX3), J29.1, U2.6 (I6)
/INT_5V+: A2.5V1 (5V), A2.5V3 (5V), A2.5V4 (5V), J3.10, J6.3, J10.1, J17.3, J23.5, J27.4, J33.1, R1.1, R14.1, R22.2, R23.2, R24.2, R25.2, R26.2, R27.2, R28.2, R29.2, R30.2, R31.2, R32.2
/IORF: A2.IORF (IOREF), J23.2
/LANDING_GEAR_MAG_SW: J7.12, U2.12 (O5)
/LANDING_GEAR_MAG_SW_SIGNAL: A2.D15 (D15/RX3), J29.2, U2.5 (I5)
/LANDING_LED: A2.D4, J25.9, J30.5
/LAUNCH_MAG_SW: J7.11, U2.11 (O6)
/LAUNCH_MAG_SW_SIGNAL: A2.D16 (D16/TX2), J29.3, U2.4 (I4)
/MAP_LIGHT: A2.D3 (D3_INT1), J30.4
/NVG-GREEN-DIM: A2.D8, J31.1, R18.2
/OXY_FLOW: A2.A11, C23.1, J22.4, J27.5
/POSITION_DIMMER: A2.A15, C27.1, J17.5, J22.8
/POSTION: J8.10, J35.2, Q6.3 (D)
/POSTION-DIM: A2.D2 (D2_INT0), J30.3, R10.2
/RED_LED: A2.D20 (D20/SDA), J29.7, R7.1
/RESET: A2.RST1 (RESET), J11.2, J23.3, R1.2
/RESET_pin: A2.D49, J11.3
/ROW0: A2.D22, J6.23, J17.9
/ROW1: A2.D23, J6.22, J17.10
/ROW4: A2.D26, J6.19, J7.8, J13.7, J21.8, J27.8
/ROW5: A2.D27, J6.18, J7.9, J13.8, J21.7, J27.9
/ROW6: A2.D28, J6.17, J7.10
/ROW7: A2.D29, D5.1 (K), J6.16, J15.3
/ROW8: A2.D30, D6.1 (K), J6.15, J15.4
/ROW9: A2.D31, J6.14, J15.5
/ROW10: A2.D32, J24.6, J25.6
/ROW11: A2.D33, J24.7, J25.7
/ROW12: A2.D34, J26.7
/ROW13: A2.D35, J26.8
/RUD_TRIM: A2.A14, C26.1, J3.11, J22.7
/RUD_TRIM_DIR_A: A2.D6, DRV8833.7, J30.7
/RUD_TRIM_DIR_B: A2.D7, DRV8833.8, J30.8
/RUD_TRIM_EN: A2.D37, DRV8833.1
/RUD_TRIM_M+: DRV8833.2, J3.13
/RUD_TRIM_M-: DRV8833.3, J3.14
/SCL: A2.SCL, J31.10
/SDA: A2.SDA, J31.9
/STROBE: J8.8, J35.4, Q5.3 (D)
/STROBE-DIM: A2.D5, J30.6, R8.2
/VIN: A2.VIN, J23.8
ES1_RST: A2.D53 (D53_CS), U1.B5 (RST)
GND: A2.GND1 (GND), A2.GND2 (GND), A2.GND3 (GND), A2.GND5 (GND), A2.GND6 (GND), C16.2, C17.2, C18.2, C19.2, C20.2, C21.2, C22.2, C23.2, C24.2, C25.2, C26.2, C27.2, D1.1 (K), D3.1 (K), D4.1 (K), D7.1 (K), D8.1 (K), DRV8833.10, J1.3, J3.3, J3.4, J3.5, J3.12, J4.2, J5.2, J6.4, J6.13, J8.1, J8.3, J8.5, J8.7, J8.9, J8.11, J11.1, J13.3, J13.4, J13.10, J13.11, J15.6, J16.3, J16.4, J16.5, J17.6, J21.3, J21.4, J21.5, J21.6, J23.6, J23.7, J25.3, J25.8, J25.10, J26.3, J26.4, J26.5, J26.6, J27.3, J27.6, J27.7, J31.7, J32.2, J33.2, J34.6, Q1.3 (S), Q2.2 (S), Q3.2 (S), Q5.2 (S), Q6.2 (S), Q7.2 (S), R3.1, R9.1, R11.1, R13.1, R19.1, R21.1, U1.A1 (GND_1), U1.A2 (GND_2), U1.B1 (GND_3), U2.8 (GND)
MISO: A2.D50 (D50_MISO), U1.B6 (MISO)
MOSI: A2.D51 (D51_MOSI), U1.A3 (MOSI)
unnamed: D1.2 (A), R14.2
unnamed: D3.2 (A), R16.2
unnamed: D4.2 (A), R17.2
unnamed: D5.2 (A), J1.4
unnamed: D6.2 (A), J1.6
unnamed: D7.2 (A), R6.2
unnamed: D8.2 (A), R7.2
unnamed: F1.2, J5.1
unnamed: Q1.1 (G), R2.1, R3.2
unnamed: Q2.1 (G), R18.1, R19.2
unnamed: Q3.1 (G), R20.1, R21.2
unnamed: Q5.1 (G), R8.1, R9.2
unnamed: Q6.1 (G), R10.1, R11.2
unnamed: Q7.1 (G), R12.1, R13.2
unnamed: R15.2, U1.A6 (INT)
SCLK: A2.D52 (D52_SCK), U1.A4 (SCLK)
SS: A2.D10, J31.3, U1.A5 (CS)

Notes on the sheet:
ANTENNA SEL
(NOTE WILL FLASH ON BOOT OR UPLOAD)
SOURCE
** CHECKED **
EJECTION SEAT
GND
EXT LIGHTS
CURRENTLY NOT WORKING NO MISSMATCH IN CCTS
PANELS
ARDUINO
COM
Fire Test
FLIGHT CONTROL SYSTEMS
CHANGE LOG 005 LEFT C/BS CHANGED PIN 4 TO ROW2 (WAS ROW3) CHANGED PIN 5 TO ROW3 (WAS ROW2) RE ADDED THE IDC AND UPDATED TO MATCH RHS
DRAIN
Cannot use
******IF USED****** GEAR MAG SW FEED FROM SELECT JETT PANEL ******IF USED******
SIMULATOR I/O INTERFACE
GATE
POWER STATUS LEDS
NOTE - ANALOG CHANGE
RESET
FUEL
APU
I/O PULL UP / FILTER
CHANGE LOG 005 MC / HYD-ISO CHANGED PIN 9 TO COL8 (WAS COL9) CHANGED PIN 10 TO COL9 (WAS COL8)
0 1 2 3 4 5 6 7
Cannot use D1
Cannot use D0
21 20 19 18 17 16 15 14
ESSENTIAL BREAKER
FCS RUDDER MOTOR DRIVER
PETE'S CRANKY PINS
LOX
HYD ISO
DIMMING CONTROL
ARDUINO CAN BE RESET BY PULLING PIN D49 LOW OR JUMPER / SWITCH TO GND
ETHERNET ADDAPTOR
SELECTIVE JET
Ethernet Module Library from https://componentsearchengine.com/part-view/USR-ES1/Smart%20Electronics
Red LED - solid on until a packet is succesfully sent to controller
(PIN D49)
MAG SWITCH CONTROL
8 9 10 11 12 13
Cannot use D4 and D10 as they are used by the Ethernet shield
5V_LINK
LANDING GEAR
MISSION COMPUTER

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
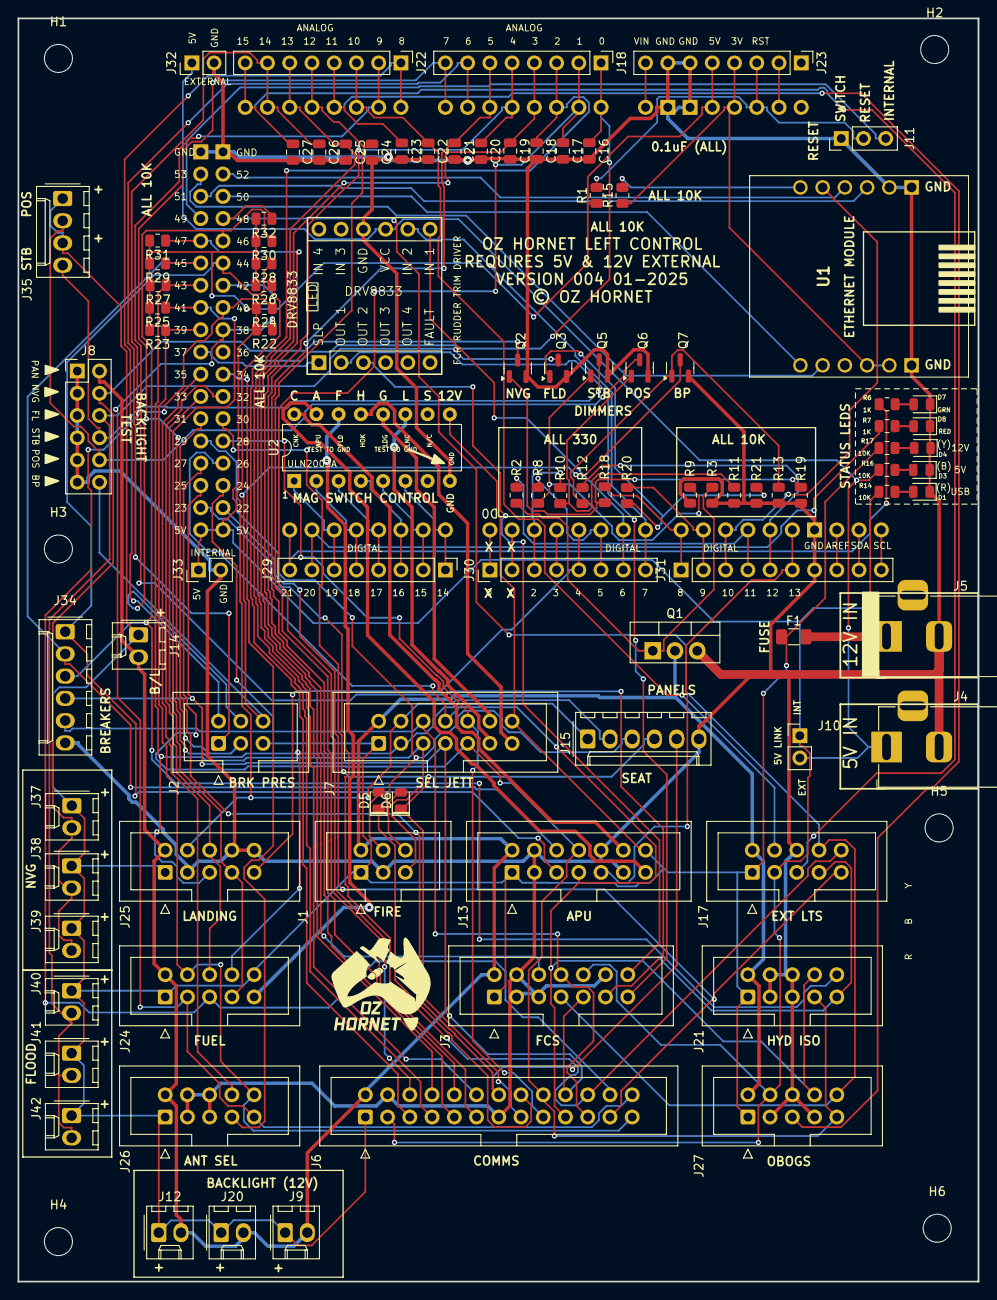
[picture p506: board LEFT_CONTROLLER-v005 June 2025.kicad_pcb from above]

Board: 2 copper layers, 109.7 x 144.3 mm, 104 parts (0 on the bottom side), 109 nets.
