bnepethomas/bne-arduino-flight-simulator-interfaces/Hornet/Hornet PCBs/Active/Left Console/LEFT_CONTROLLER-v005 June 2025/KORRY-INSERT/KORRY-INSERT.kicad_pcb

## KiCad design Hornet/Hornet PCBs/Active/Left Console/LEFT_CONTROLLER-v005 June 2025/KORRY-INSERT/KORRY-INSERT.kicad_pcb (2025-11-29)

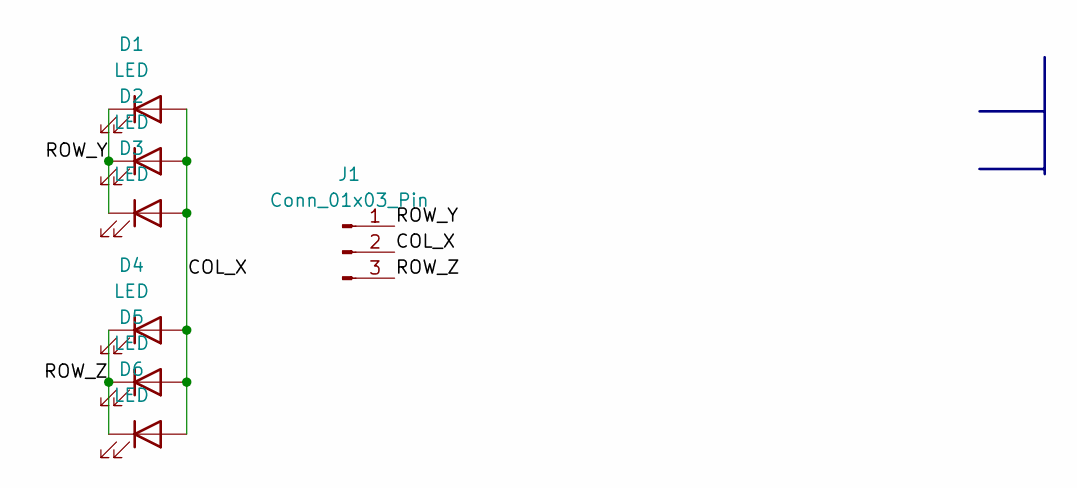
[picture p507: schematic KORRY-INSERT.kicad_sch]

Parts:
D1, D2, D3, D4, D5, D6: LED; LED_0402_1005Metric
J1: Conn_01x03_Pin; PinHeader_1x03_P1.27mm_Vertical

Connections:
/COL_X: D1.2 (A), D2.2 (A), D3.2 (A), D4.2 (A), D5.2 (A), D6.2 (A), J1.2
/ROW_Y: D1.1 (K), D2.1 (K), D3.1 (K), J1.1
/ROW_Z: D4.1 (K), D5.1 (K), D6.1 (K), J1.3

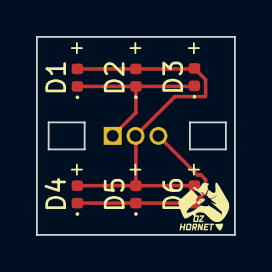
[picture p508: board KORRY-INSERT.kicad_pcb from above]

Board: 2 copper layers, 11.0 x 11.0 mm, 7 parts (1 on the bottom side), 3 nets.
