bnepethomas/bne-arduino-flight-simulator-interfaces/Hornet/Hornet PCBs/Active/UIP LEFT SIDE BREAKOUT/UIP LEFT SIDE BREAKOUT.kicad_pcb

## KiCad design Hornet/Hornet PCBs/Active/UIP LEFT SIDE BREAKOUT/UIP LEFT SIDE BREAKOUT.kicad_pcb (2026-05-17)

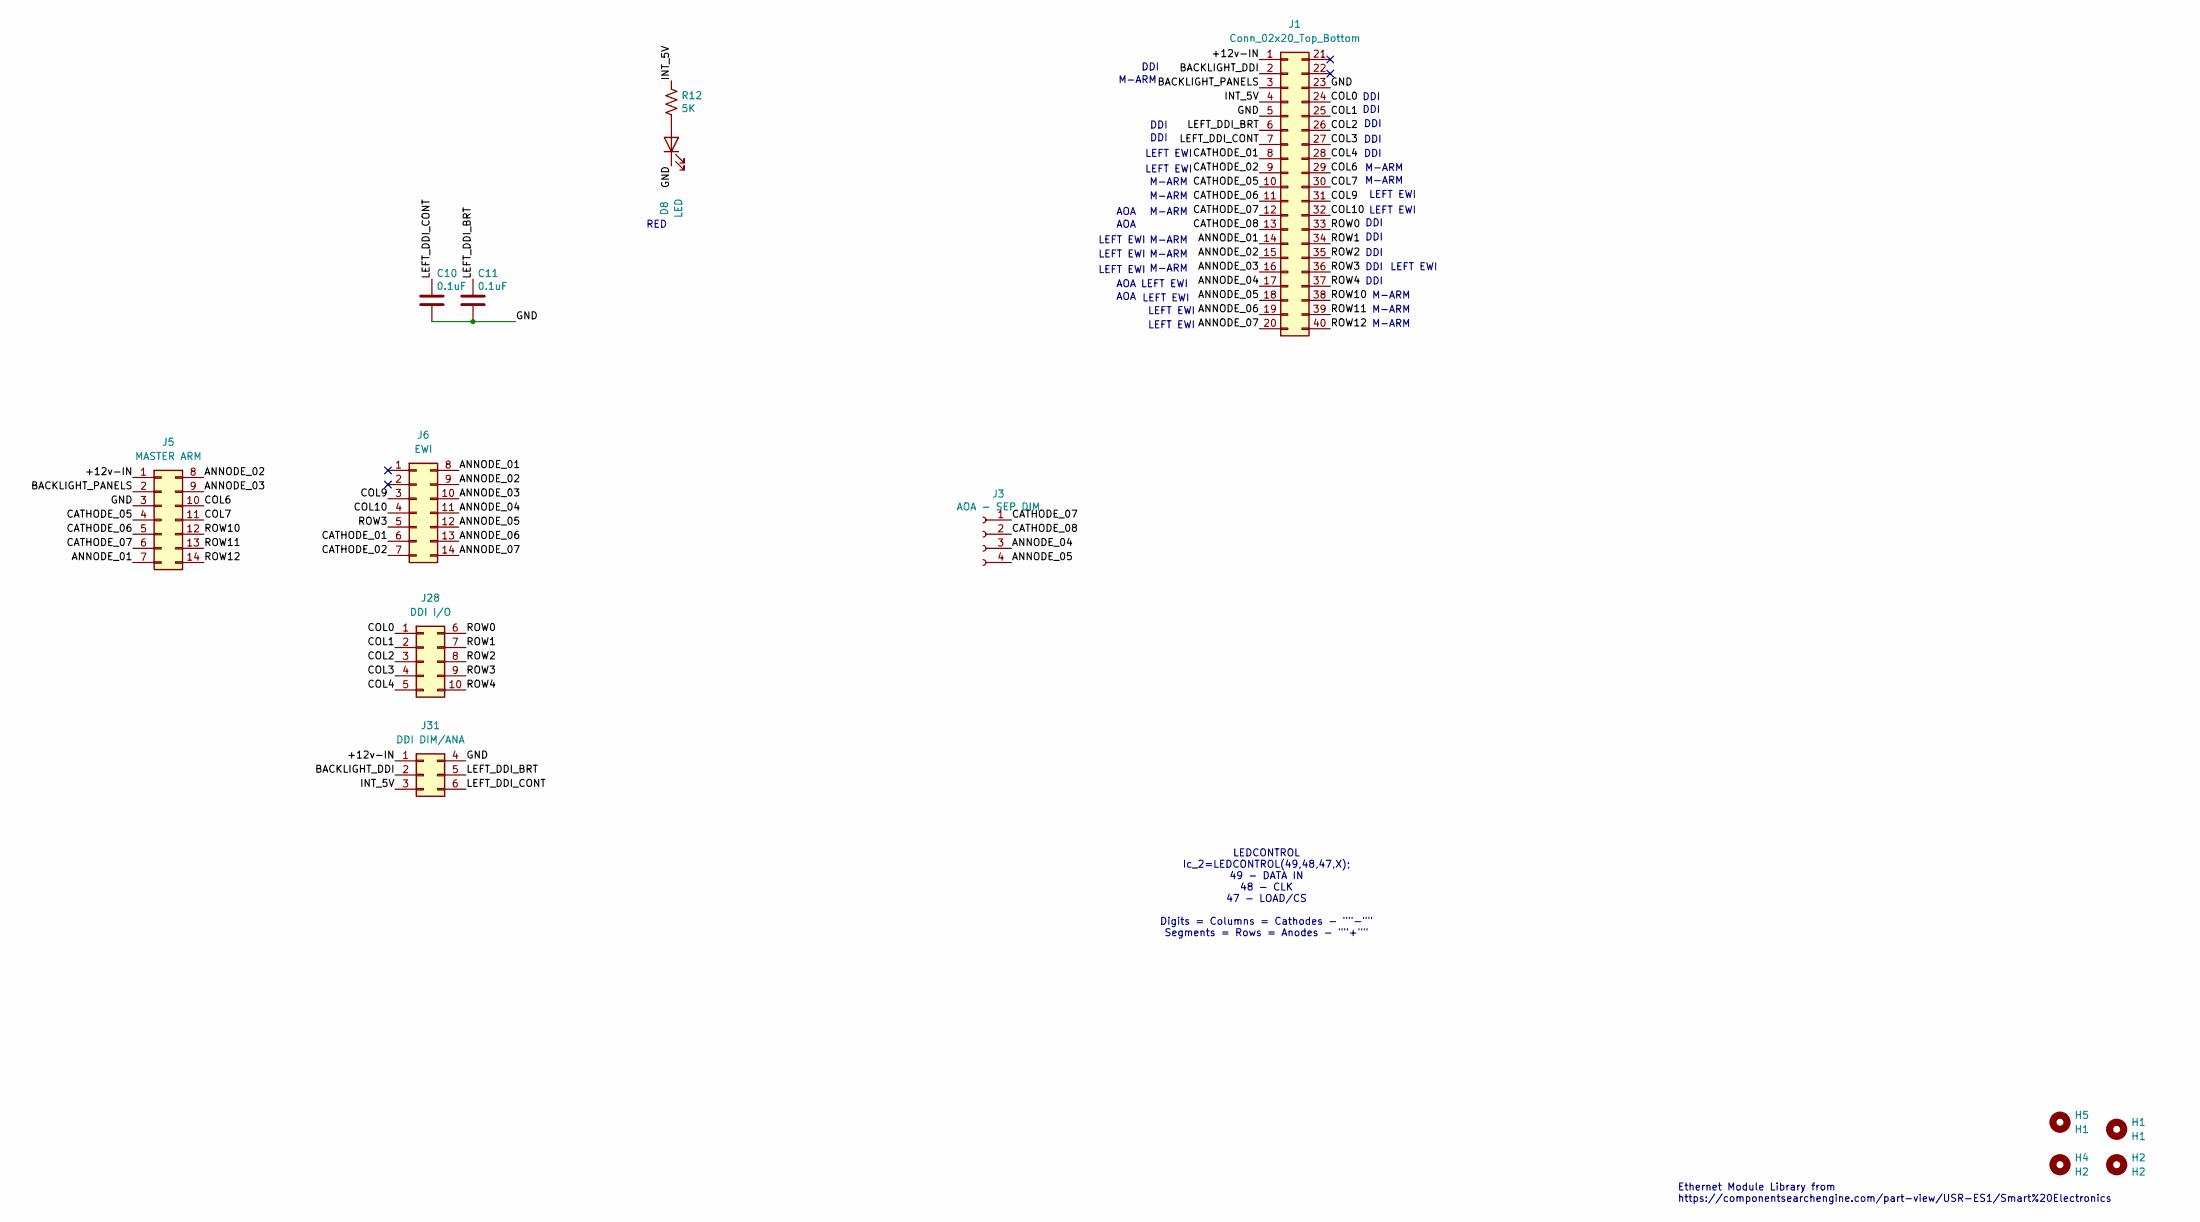
[picture p509: schematic UIP LEFT SIDE BREAKOUT.kicad_sch]

Parts:
C10, C11: 0.1uF; C_0805_2012Metric
D8: LED; LED_0805_2012Metric
H1, H5: H1; MountingHole_2.5mm
H2, H4: H2; MountingHole_2.5mm
J1: Conn_02x20_Top_Bottom; IDC-Header_2x20_P2.54mm_Vertical
J3: AOA - SEP DIM; Molex_KK-254_AE-6410-04A_1x04_P2.54mm_Vertical
J5: MASTER ARM; IDC-Header_2x07_P2.54mm_Vertical
J6: EWI; IDC-Header_2x07_P2.54mm_Vertical
J28: DDI I/O; IDC-Header_2x05_P2.54mm_Vertical
J31: DDI DIM/ANA; IDC-Header_2x03_P2.54mm_Vertical
R12: 5K; R_0805_2012Metric

Connections:
/+12v-IN: J1.1, J5.1, J31.1
/ANNODE_01: J1.14, J5.7, J6.8
/ANNODE_02: J1.15, J5.8, J6.9
/ANNODE_03: J1.16, J5.9, J6.10
/ANNODE_04: J1.17, J3.3, J6.11
/ANNODE_05: J1.18, J3.4, J6.12
/ANNODE_06: J1.19, J6.13
/ANNODE_07: J1.20, J6.14
/BACKLIGHT_DDI: J1.2, J31.2
/BACKLIGHT_PANELS: J1.3, J5.2
/CATHODE_01: J1.8, J6.6
/CATHODE_02: J1.9, J6.7
/CATHODE_05: J1.10, J5.4
/CATHODE_06: J1.11, J5.5
/CATHODE_07: J1.12, J3.1, J5.6
/CATHODE_08: J1.13, J3.2
/COL0: J1.24, J28.1
/COL1: J1.25, J28.2
/COL2: J1.26, J28.3
/COL3: J1.27, J28.4
/COL4: J1.28, J28.5
/COL6: J1.29, J5.10
/COL7: J1.30, J5.11
/COL9: J1.31, J6.3
/COL10: J1.32, J6.4
/GND: C10.2, C11.2, D8.1 (K), J1.5, J1.23, J5.3, J31.4
/INT_5V: J1.4, J31.3, R12.1
/LEFT_DDI_BRT: C11.1, J1.6, J31.5
/LEFT_DDI_CONT: C10.1, J1.7, J31.6
/ROW0: J1.33, J28.6
/ROW1: J1.34, J28.7
/ROW2: J1.35, J28.8
/ROW3: J1.36, J6.5, J28.9
/ROW4: J1.37, J28.10
/ROW10: J1.38, J5.12
/ROW11: J1.39, J5.13
/ROW12: J1.40, J5.14
unnamed: D8.2 (A), R12.2

Notes on the sheet:
M-ARM
LEFT EWI
DDI
AOA
Ethernet Module Library from https://componentsearchengine.com/part-view/USR-ES1/Smart%20Electronics
LEDCONTROL Ic_2=LEDCONTROL(49,48,47,X); 49 - DATA IN 48 - CLK 47 - LOAD/CS Digits = Columns = Cathodes - ""-"" Segments = Rows = Anodes - ""+""
RED

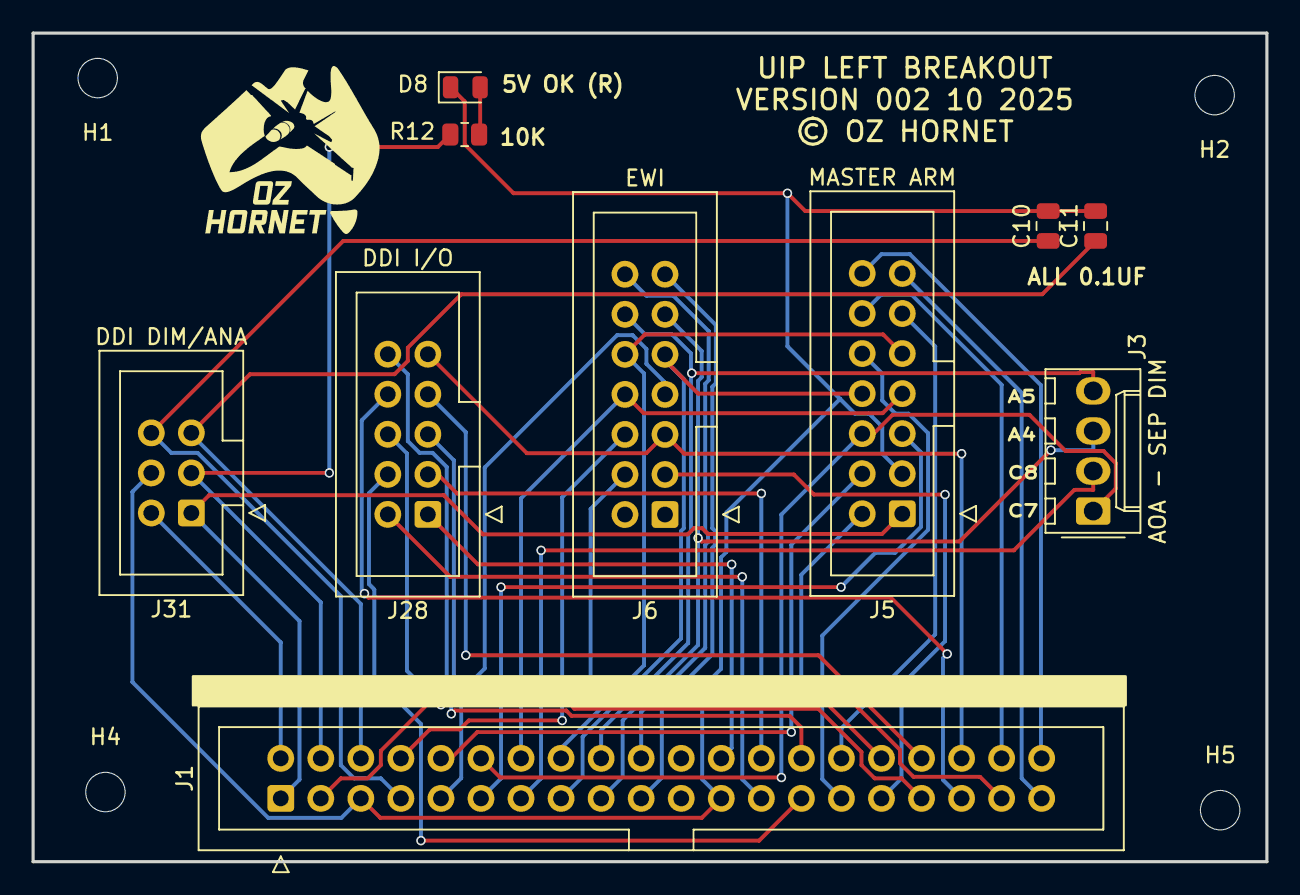
[picture p510: board UIP LEFT SIDE BREAKOUT.kicad_pcb from above]

Board: 2 copper layers, 78.2 x 52.6 mm, 14 parts (0 on the bottom side), 38 nets.
