bnepethomas/bne-arduino-flight-simulator-interfaces/Hornet/Hornet PCBs/Active/UIP CONTROLLER/UIP CONTROLLER.kicad_pcb

## KiCad design Hornet/Hornet PCBs/Active/UIP CONTROLLER/UIP CONTROLLER.kicad_pcb (2026-05-17)

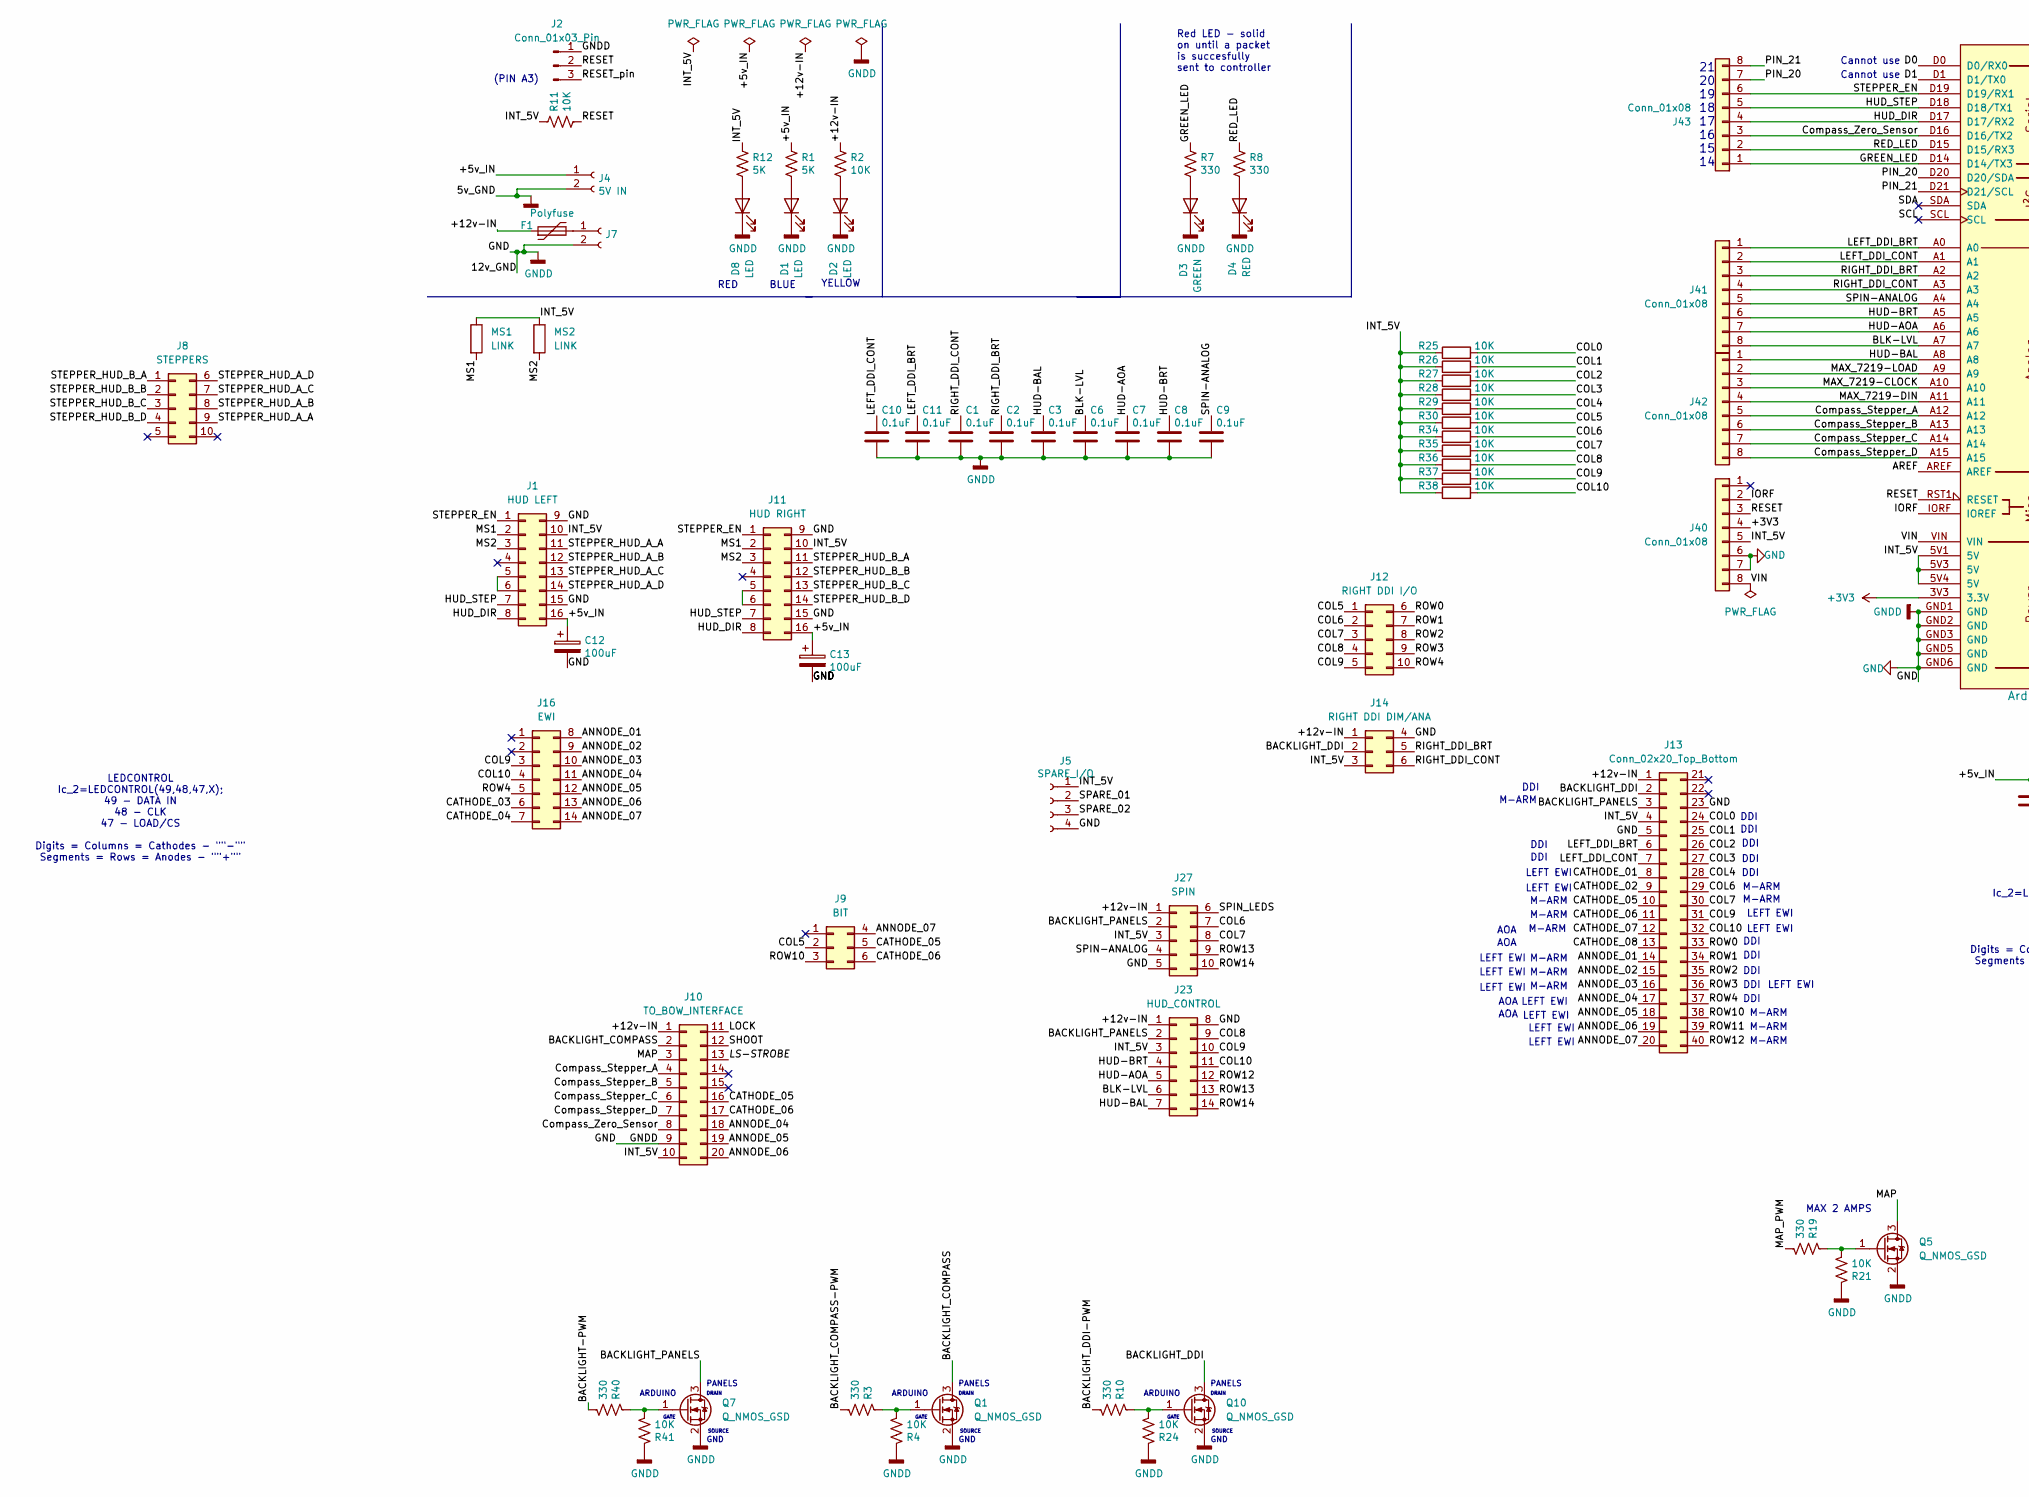
[picture p511: schematic UIP CONTROLLER.kicad_sch, part in row 1, column 1]

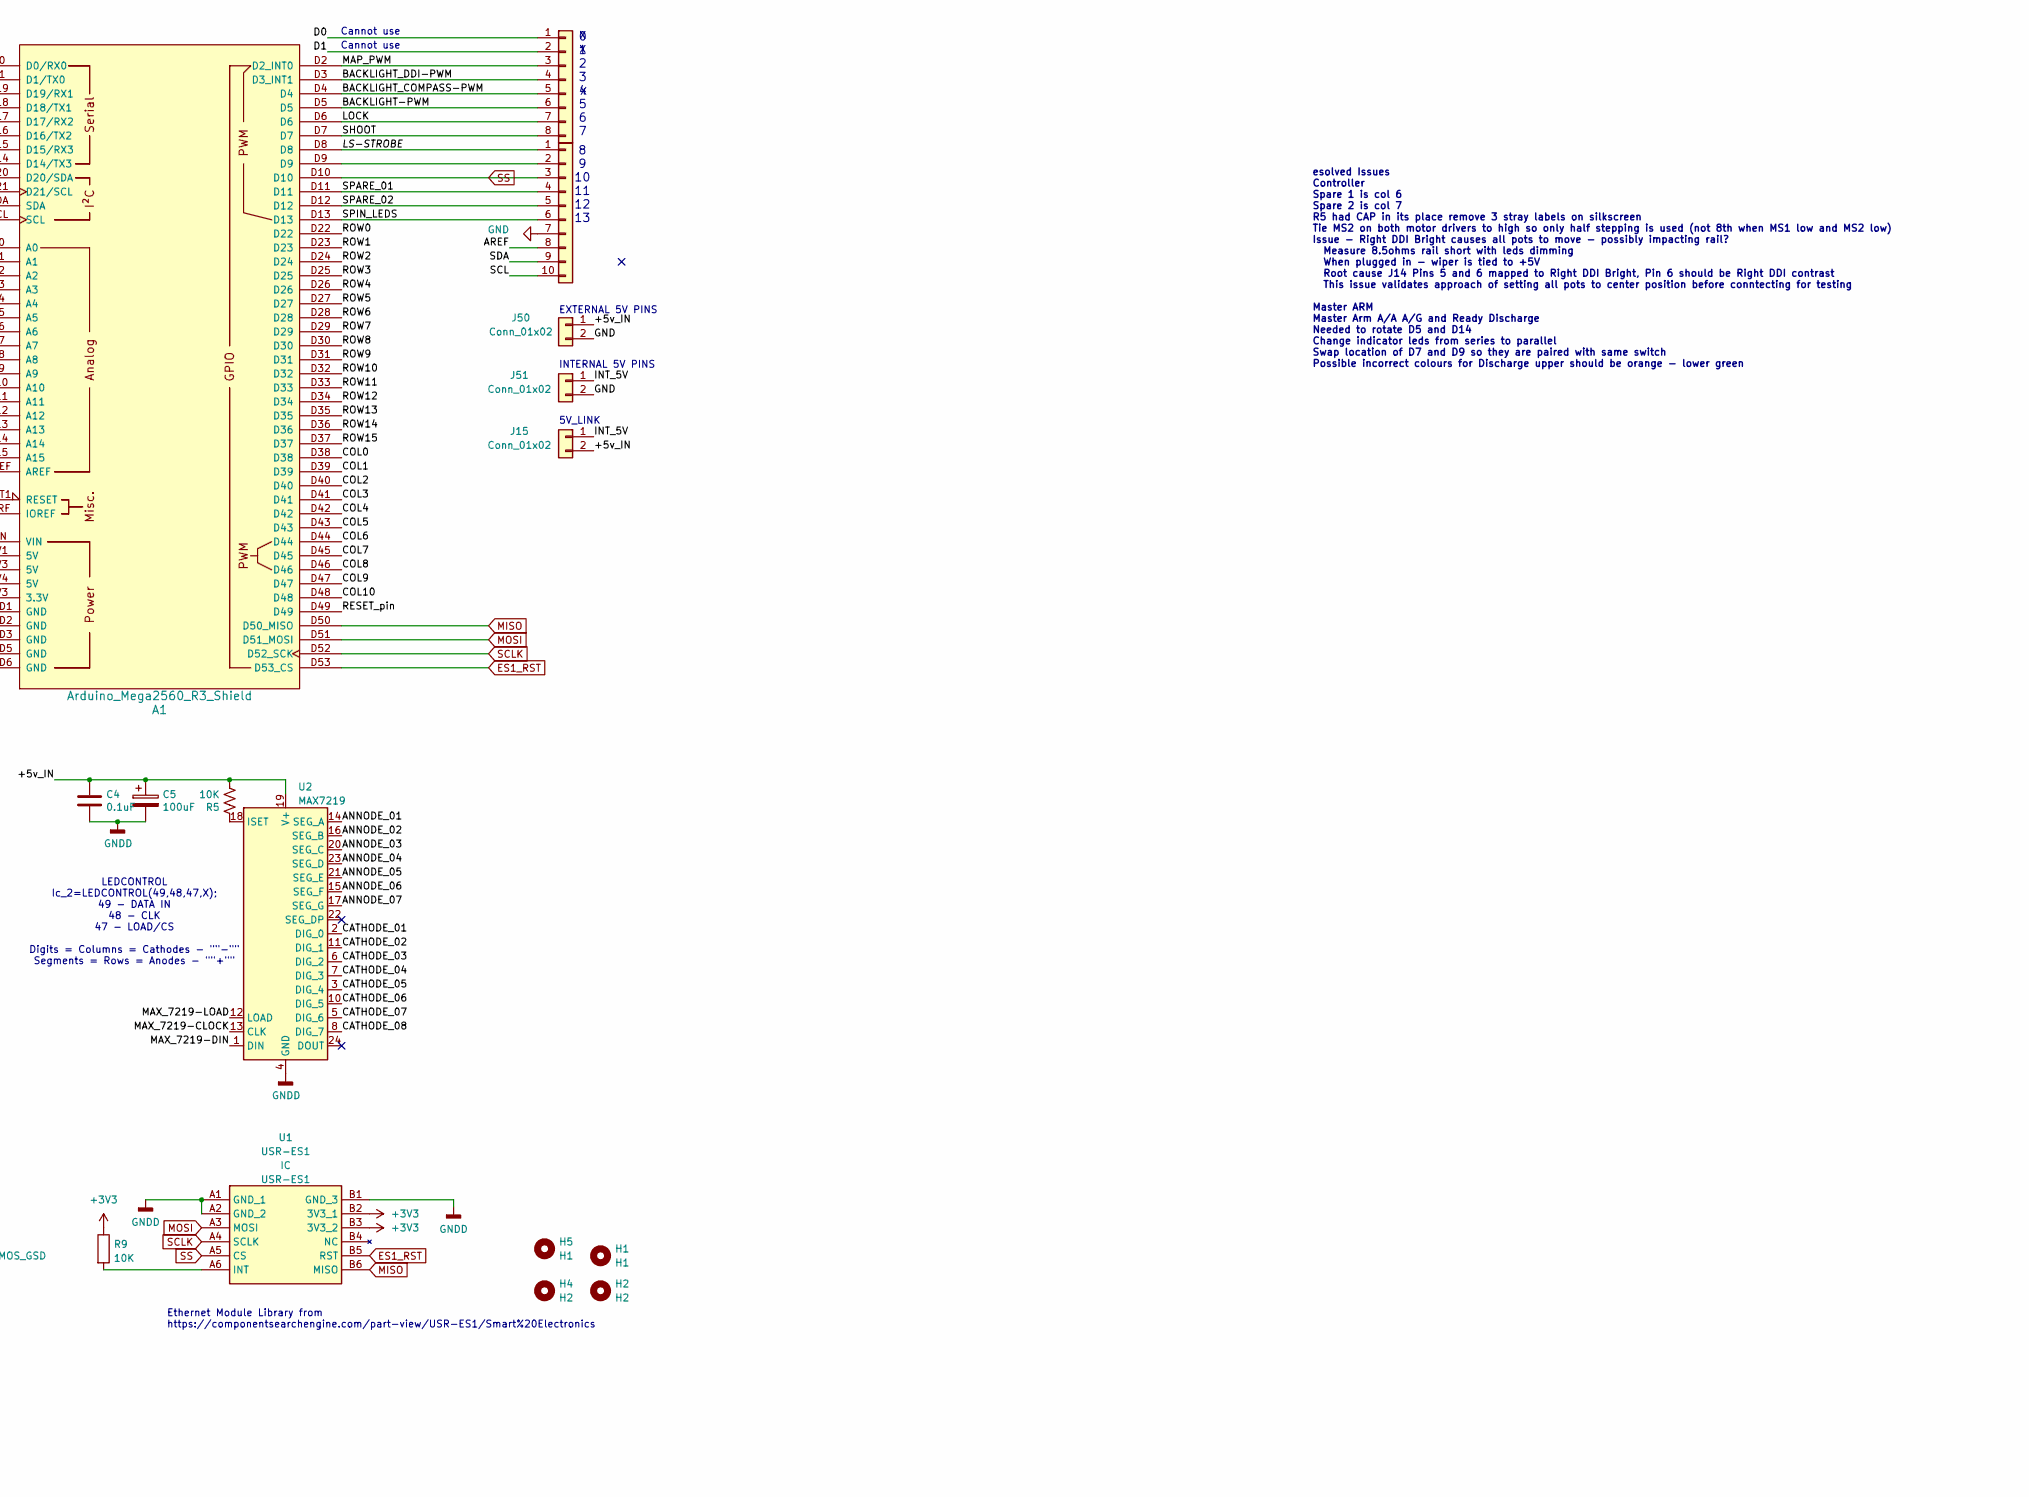
[picture p512: schematic UIP CONTROLLER.kicad_sch, part in row 1, column 2]

Parts:
A1: Arduino_Mega2560_R3_Shield
C1, C2, C3, C4, C6, C7, C8, C9, C10, C11: 0.1uF; C_0805_2012Metric
C5, C12, C13: 100uF; C_1210_3225Metric
D1, D2, D8: LED; LED_0805_2012Metric
D3: GREEN; LED_0805_2012Metric
D4: RED; LED_0805_2012Metric
F1: Polyfuse; Fuse_1206_3216Metric
H1, H5: H1; MountingHole_2.5mm
H2, H4: H2; MountingHole_2.5mm
J1: HUD LEFT; Pololu_Breakout-16_15.2x20.3mm
J2: Conn_01x03_Pin; PinHeader_1x03_P2.54mm_Vertical
J4: 5V IN; BarrelJack_Horizontal
J5: SPARE_I/O; Molex_KK-254_AE-6410-04A_1x04_P2.54mm_Vertical
J7: STEPPER IN 12-20VDC; BarrelJack_Horizontal
J8: STEPPERS; IDC-Header_2x05_P2.54mm_Vertical
J9: BIT; IDC-Header_2x03_P2.54mm_Vertical
J10: TO_BOW_INTERFACE; IDC-Header_2x10_P2.54mm_Vertical
J11: HUD RIGHT; Pololu_Breakout-16_15.2x20.3mm
J12: RIGHT DDI I/O; IDC-Header_2x05_P2.54mm_Vertical
J13: Conn_02x20_Top_Bottom; IDC-Header_2x20_P2.54mm_Vertical
J14: RIGHT DDI DIM/ANA; IDC-Header_2x03_P2.54mm_Vertical
J15, J50, J51: Conn_01x02; PinHeader_1x02_P2.54mm_Vertical
J16: EWI; IDC-Header_2x07_P2.54mm_Vertical
J23: HUD_CONTROL; IDC-Header_2x07_P2.54mm_Vertical
J27: SPIN; IDC-Header_2x05_P2.54mm_Vertical
J40, J41, J42, J43, J44: Conn_01x08; PinHeader_1x08_P2.54mm_Vertical
J45: Conn_01x10; PinHeader_1x10_P2.54mm_Vertical
MS1, MS2: LINK; R_0805_2012Metric
Q1, Q5, Q7, Q10: Q_NMOS_GSD; SOT-23
R1, R12: 5K; R_0805_2012Metric
R2, R4, R5, R9, R11, R21, R24, R25, R26, R27, R28, R29, R30, R34, R35, R36, R37, R38, R41: 10K; R_0805_2012Metric
R3, R7, R8, R10, R19, R40: 330; R_0805_2012Metric
U1: USR-ES1; USRES1; Manufacturer_Part_Number USR-ES1
U2: MAX7219; DIP-24_W7.62mm_LongPads

Connections:
+3V3: A1.3V3 (3.3V), J40.4, R9.1, U1.B2 (3V3_1), U1.B3 (3V3_2)
/+5v_IN: C4.1, C5.1, C12.1, C13.1, J1.16, J4.1, J11.16, J15.2, J50.1, R1.1, R5.2, U2.19 (V+)
/+12v-IN: F1.1, J10.1, J13.1, J14.1, J23.1, J27.1, R2.1
/ANNODE_01: J13.14, J16.8, U2.14 (SEG_A)
/ANNODE_02: J13.15, J16.9, U2.16 (SEG_B)
/ANNODE_03: J13.16, J16.10, U2.20 (SEG_C)
/ANNODE_04: J10.18, J13.17, J16.11, U2.23 (SEG_D)
/ANNODE_05: J10.19, J13.18, J16.12, U2.21 (SEG_E)
/ANNODE_06: J10.20, J13.19, J16.13, U2.15 (SEG_F)
/ANNODE_07: J9.4, J13.20, J16.14, U2.17 (SEG_G)
/AREF: A1.AREF, J45.8
/BACKLIGHT-PWM: A1.D5, J44.6, R40.2
/BACKLIGHT_COMPASS: J10.2, Q1.3 (D)
/BACKLIGHT_COMPASS-PWM: A1.D4, J44.5, R3.2
/BACKLIGHT_DDI: J13.2, J14.2, Q10.3 (D)
/BACKLIGHT_DDI-PWM: A1.D3 (D3_INT1), J44.4, R10.2
/BACKLIGHT_PANELS: J13.3, J23.2, J27.2, Q7.3 (D)
/BLK-LVL: A1.A7, C6.1, J23.6, J41.8
/CATHODE_01: J13.8, U2.2 (DIG_0)
/CATHODE_02: J13.9, U2.11 (DIG_1)
/CATHODE_03: J16.6, U2.6 (DIG_2)
/CATHODE_04: J16.7, U2.7 (DIG_3)
/CATHODE_05: J9.5, J10.16, J13.10, U2.3 (DIG_4)
/CATHODE_06: J9.6, J10.17, J13.11, U2.10 (DIG_5)
/CATHODE_07: J13.12, U2.5 (DIG_6)
/CATHODE_08: J13.13, U2.8 (DIG_7)
/COL0: A1.D38, J13.24, R25.2
/COL1: A1.D39, J13.25, R26.2
/COL2: A1.D40, J13.26, R27.2
/COL3: A1.D41, J13.27, R28.2
/COL4: A1.D42, J13.28, R29.2
/COL5: A1.D43, J9.2, J12.1, R30.2
/COL6: A1.D44, J12.2, J13.29, J27.7, R34.2
/COL7: A1.D45, J12.3, J13.30, J27.8, R35.2
/COL8: A1.D46, J12.4, J23.9, R36.2
/COL9: A1.D47, J12.5, J13.31, J16.3, J23.10, R37.2
/COL10: A1.D48, J13.32, J16.4, J23.11, R38.2
/Compass_Stepper_A: A1.A12, J10.4, J42.5
/Compass_Stepper_B: A1.A13, J10.5, J42.6
/Compass_Stepper_C: A1.A14, J10.6, J42.7
/Compass_Stepper_D: A1.A15, J10.7, J42.8
/Compass_Zero_Sensor: A1.D16 (D16/TX2), J10.8, J43.3
/D0: A1.D0 (D0/RX0), J44.1
/D1: A1.D1 (D1/TX0), J44.2
/GREEN_LED: A1.D14 (D14/TX3), J43.1, R7.1
/HUD-AOA: A1.A6, C7.1, J23.5, J41.7
/HUD-BAL: A1.A8, C3.1, J23.7, J42.1
/HUD-BRT: A1.A5, C8.1, J23.4, J41.6
/HUD_DIR: A1.D17 (D17/RX2), J1.8, J11.8, J43.4
/HUD_STEP: A1.D18 (D18/TX1), J1.7, J11.7, J43.5
/INT_5V: A1.5V1 (5V), A1.5V3 (5V), A1.5V4 (5V), J1.10, J5.1, J10.10, J11.10, J13.4, J14.3, J15.1, J23.3, J27.3, J40.5, J51.1, MS1.1, MS2.1, R11.1, R12.1, R25.1, R26.1, R27.1, R28.1, R29.1, R30.1, R34.1, R35.1, R36.1, R37.1, R38.1
/IORF: A1.IORF (IOREF), J40.2
/LEFT_DDI_BRT: A1.A0, C11.1, J13.6, J41.1
/LEFT_DDI_CONT: A1.A1, C10.1, J13.7, J41.2
/LOCK: A1.D6, J10.11, J44.7
/LS-STROBE: A1.D8, J10.13, J45.1
/MAP: J10.3, Q5.3 (D)
/MAP_PWM: A1.D2 (D2_INT0), J44.3, R19.2
/MAX_7219-CLOCK: A1.A10, J42.3, U2.13 (CLK)
/MAX_7219-DIN: A1.A11, J42.4, U2.1 (DIN)
/MAX_7219-LOAD: A1.A9, J42.2, U2.12 (LOAD)
/MS1: J1.2, J11.2, MS1.2
/MS2: J1.3, J11.3, MS2.2
/PIN_20: A1.D20 (D20/SDA), J43.7
/PIN_21: A1.D21 (D21/SCL), J43.8
/RED_LED: A1.D15 (D15/RX3), J43.2, R8.1
/RESET: A1.RST1 (RESET), J2.2, J40.3, R11.2
/RESET_pin: A1.D49, J2.3
/RIGHT_DDI_BRT: A1.A2, C2.1, J14.5, J41.3
/RIGHT_DDI_CONT: A1.A3, C1.1, J14.6, J41.4
/ROW0: A1.D22, J12.6, J13.33
/ROW1: A1.D23, J12.7, J13.34
/ROW2: A1.D24, J12.8, J13.35
/ROW3: A1.D25, J12.9, J13.36
/ROW4: A1.D26, J12.10, J13.37, J16.5
/ROW5: A1.D27
/ROW6: A1.D28
/ROW7: A1.D29
/ROW8: A1.D30
/ROW9: A1.D31
/ROW10: A1.D32, J9.3, J13.38
/ROW11: A1.D33, J13.39
/ROW12: A1.D34, J13.40, J23.12
/ROW13: A1.D35, J23.13, J27.9
/ROW14: A1.D36, J23.14, J27.10
/ROW15: A1.D37
/SCL: A1.SCL, J45.10
/SDA: A1.SDA, J45.9
/SHOOT: A1.D7, J10.12, J44.8
/SPARE_01: A1.D11, J5.2, J45.4
/SPARE_02: A1.D12, J5.3, J45.5
/SPIN-ANALOG: A1.A4, C9.1, J27.4, J41.5
/SPIN_LEDS: A1.D13, J27.6, J45.6
/STEPPER_EN: A1.D19 (D19/RX1), J1.1, J11.1, J43.6
/STEPPER_HUD_A_A: J1.11, J8.9
/STEPPER_HUD_A_B: J1.12, J8.8
/STEPPER_HUD_A_C: J1.13, J8.7
/STEPPER_HUD_A_D: J1.14, J8.6
/STEPPER_HUD_B_A: J8.1, J11.11
/STEPPER_HUD_B_B: J8.2, J11.12
/STEPPER_HUD_B_C: J8.3, J11.13
/STEPPER_HUD_B_D: J8.4, J11.14
/VIN: A1.VIN, J40.8
ES1_RST: A1.D53 (D53_CS), U1.B5 (RST)
GND: A1.GND1 (GND), A1.GND2 (GND), A1.GND3 (GND), A1.GND5 (GND), A1.GND6 (GND), C1.2, C2.2, C3.2, C4.2, C5.2, C6.2, C7.2, C8.2, C9.2, C10.2, C11.2, C12.2, C13.2, D1.1 (K), D2.1 (K), D3.1 (K), D4.1 (K), D8.1 (K), J1.9, J1.15, J2.1, J4.2, J5.4, J7.2, J10.9, J11.9, J11.15, J13.5, J13.23, J14.4, J23.8, J27.5, J40.6, J40.7, J45.7, J50.2, J51.2, Q1.2 (S), Q5.2 (S), Q7.2 (S), Q10.2 (S), R4.1, R21.1, R24.1, R41.1, U1.A1 (GND_1), U1.A2 (GND_2), U1.B1 (GND_3), U2.4 (GND), U2.9 (GND)
MISO: A1.D50 (D50_MISO), U1.B6 (MISO)
MOSI: A1.D51 (D51_MOSI), U1.A3 (MOSI)
unnamed: D1.2 (A), R1.2
unnamed: D2.2 (A), R2.2
unnamed: D3.2 (A), R7.2
unnamed: D4.2 (A), R8.2
unnamed: D8.2 (A), R12.2
unnamed: J1.5, J1.6
unnamed: F1.2, J7.1
unnamed: J11.5, J11.6
unnamed: A1.D9, J45.2
unnamed: Q1.1 (G), R3.1, R4.2
unnamed: Q5.1 (G), R19.1, R21.2
unnamed: Q7.1 (G), R40.1, R41.2
unnamed: Q10.1 (G), R10.1, R24.2
unnamed: R9.2, U1.A6 (INT)
unnamed: R5.1, U2.18 (ISET)
SCLK: A1.D52 (D52_SCK), U1.A4 (SCLK)
SS: A1.D10, J45.3, U1.A5 (CS)

Notes on the sheet:
YELLOW
MAX 2 AMPS
DDI
M-ARM
PANELS
SOURCE
AOA
esolved Issues Controller Spare 1 is col 6 Spare 2 is col 7 R5 had CAP in its place remove 3 stray labels on silkscreen Tie MS2 on both motor drivers to high so only half stepping is used (not 8th when MS1 low and MS2 low) Issue - Right DDI Bright causes all pots to move - possibly impacting rail? 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
LEFT EWI
BLUE
INTERNAL 5V PINS
Ethernet Module Library from https://componentsearchengine.com/part-view/USR-ES1/Smart%20Electronics
GATE
LEDCONTROL Ic_2=LEDCONTROL(49,48,47,X); 49 - DATA IN 48 - CLK 47 - LOAD/CS Digits = Columns = Cathodes - ""-"" Segments = Rows = Anodes - ""+""
ARDUINO
Cannot use
RED
(PIN A3)
GND
0 1 2 3 4 5 6 7
Red LED - solid on until a packet is succesfully sent to controller
5V_LINK
21 20 19 18 17 16 15 14
EXTERNAL 5V PINS
8 9 10 11 12 13
DRAIN

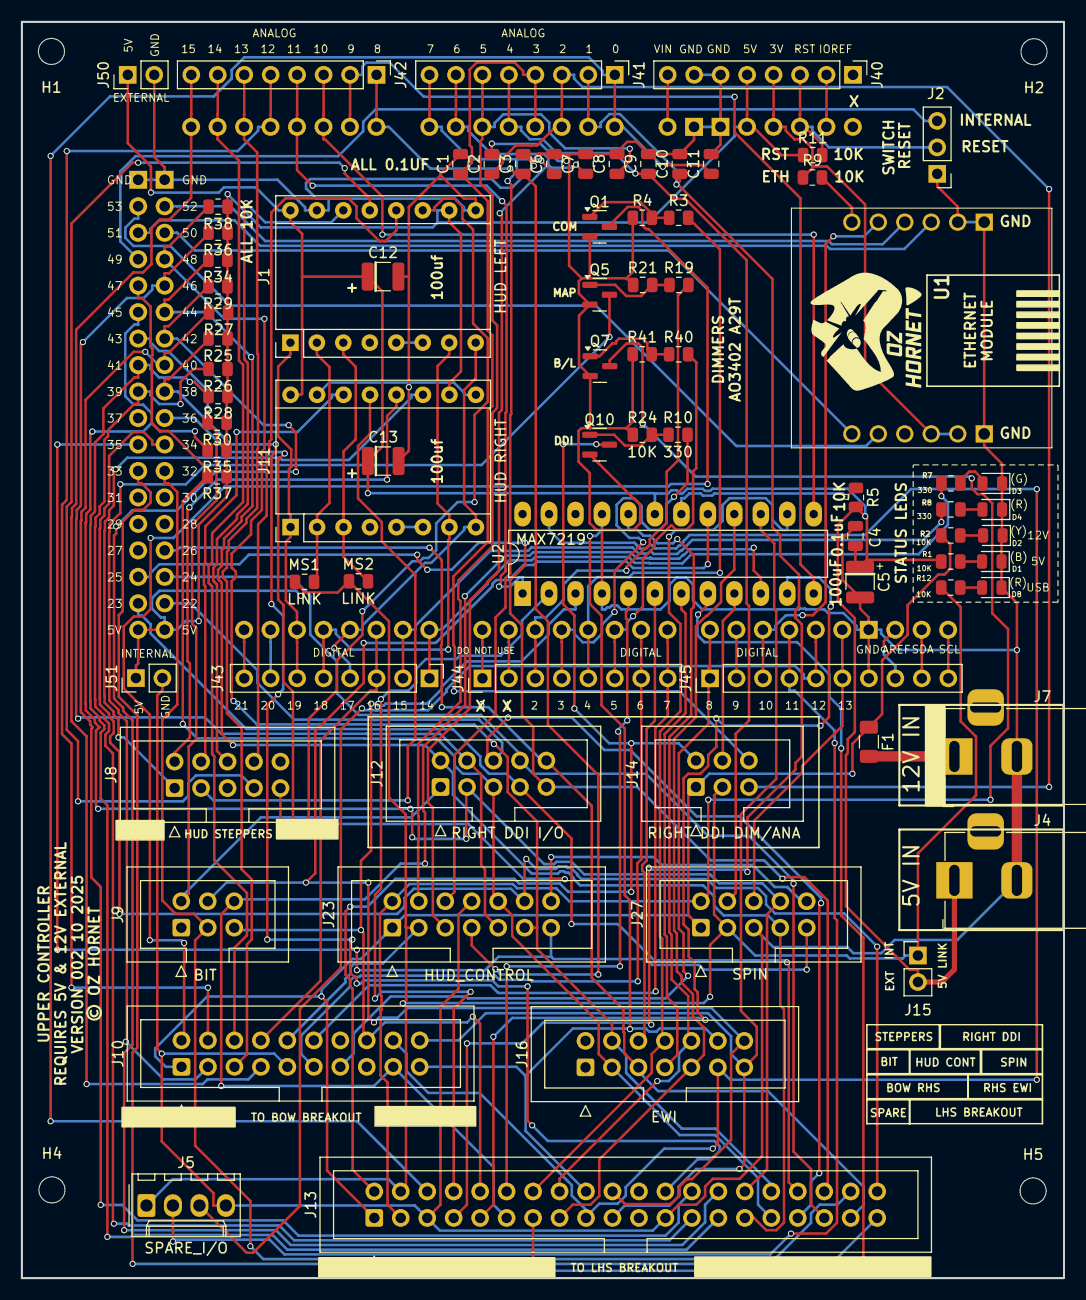
[picture p513: board UIP CONTROLLER.kicad_pcb from above]

Board: 2 copper layers, 100.0 x 120.6 mm, 83 parts (0 on the bottom side), 118 nets.
