bnepethomas/bne-arduino-flight-simulator-interfaces/Hornet/Hornet PCBs/Active/SIM_CONTROL - V003/SIM_CONTROL.kicad_pcb

## KiCad design Hornet/Hornet PCBs/Active/SIM_CONTROL - V003/SIM_CONTROL.kicad_pcb (2026-05-16)

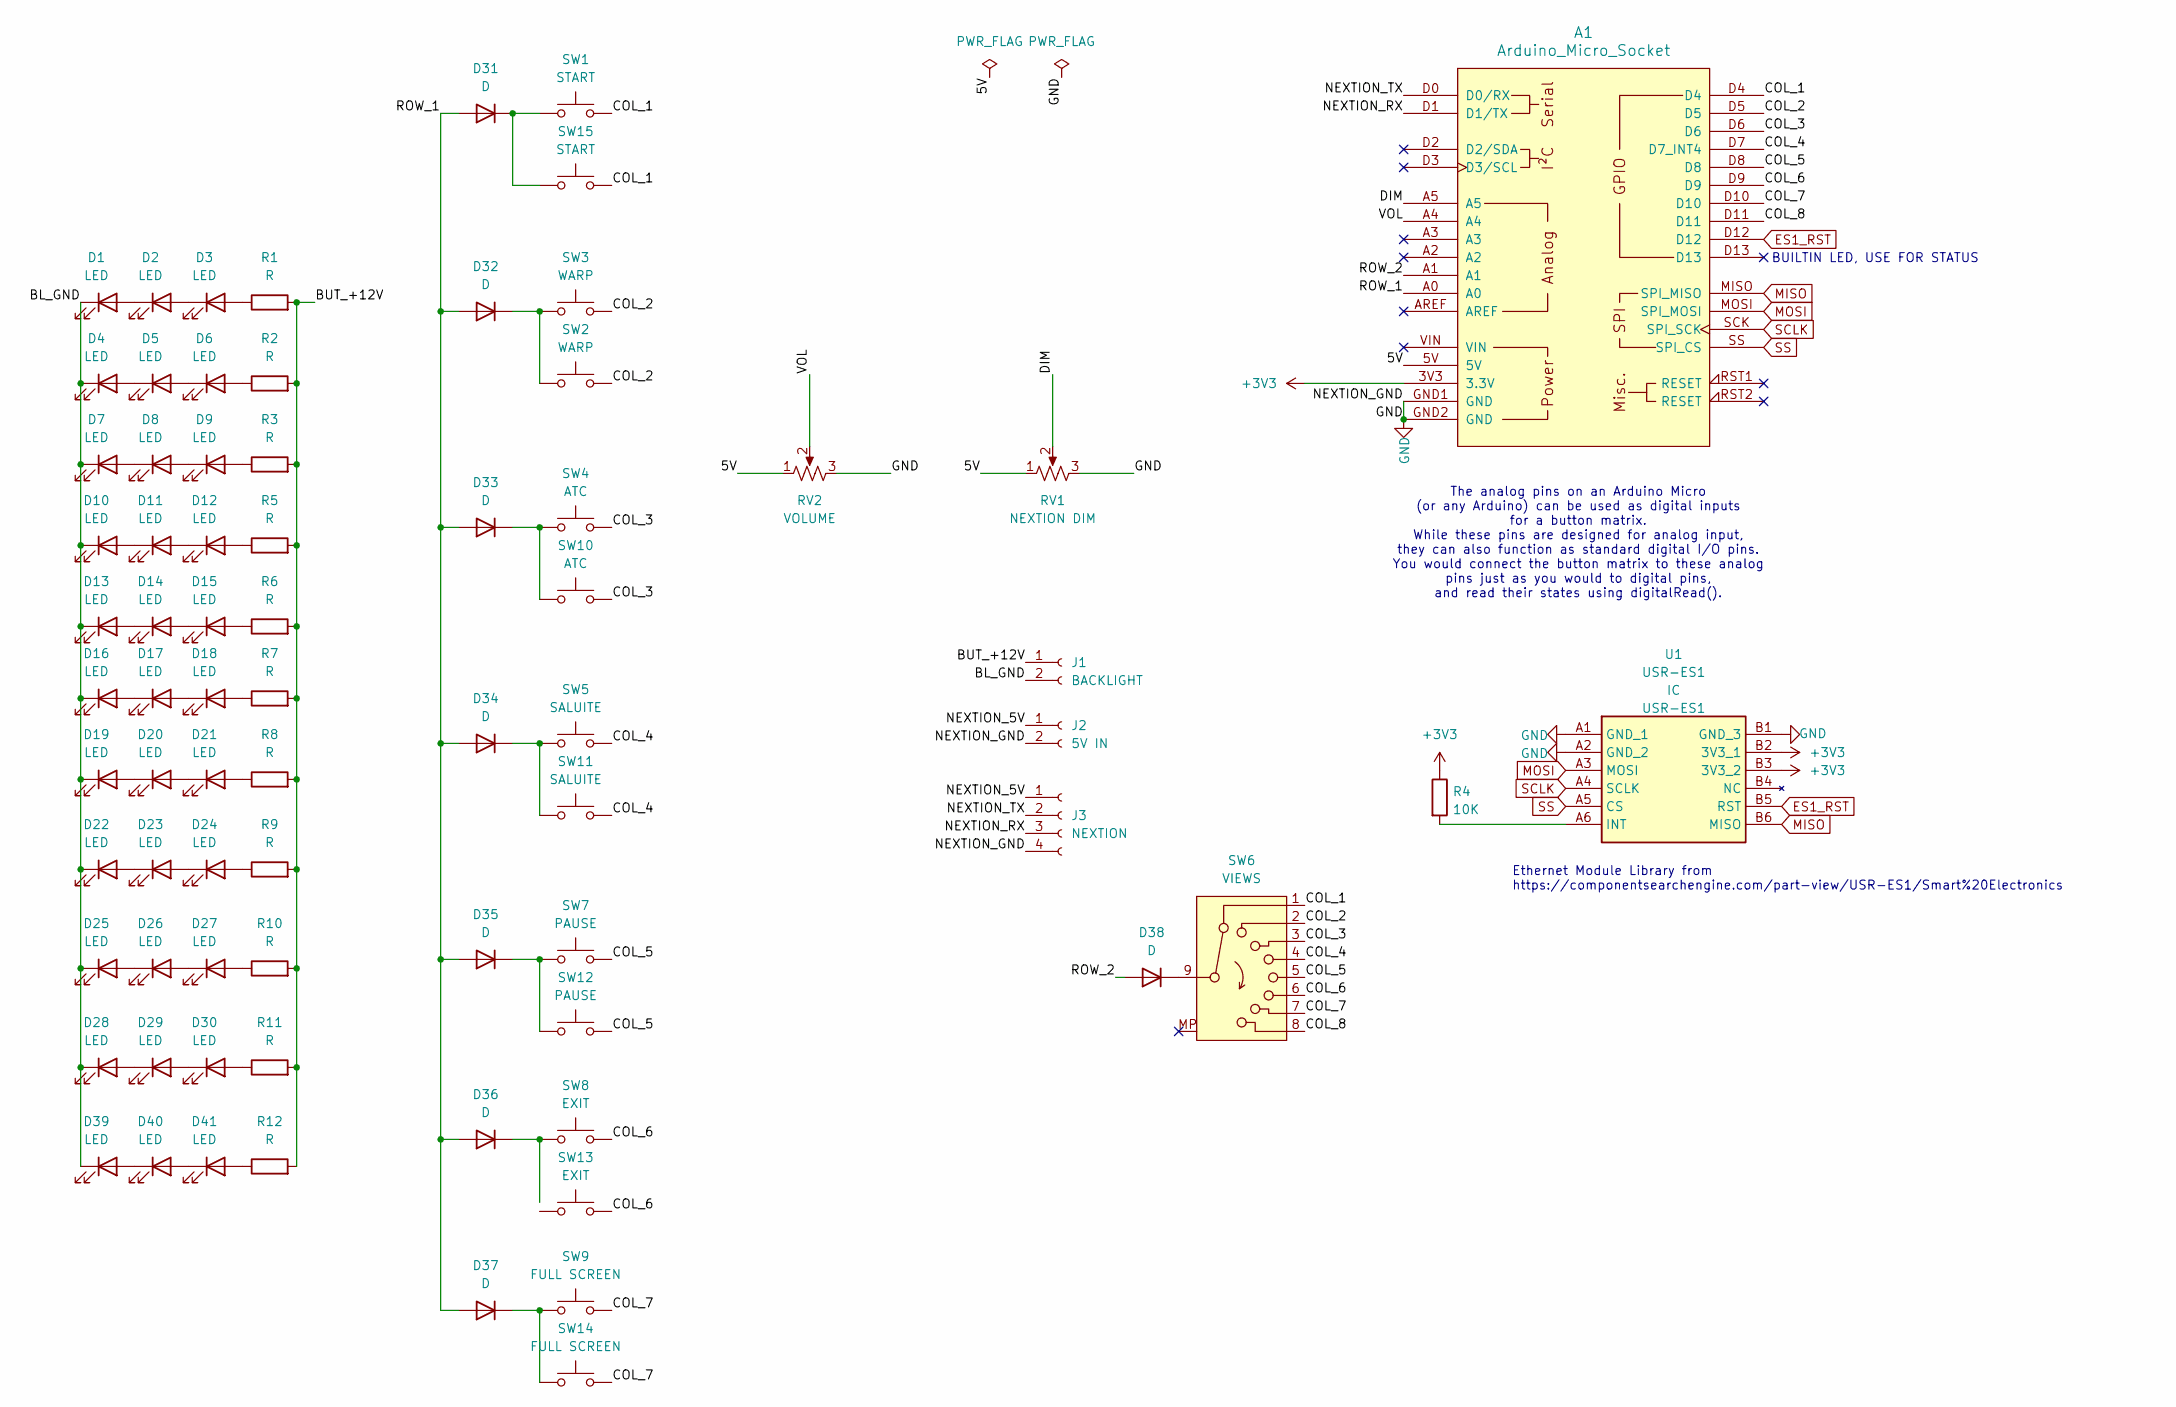
[picture p514: schematic SIM_CONTROL.kicad_sch]

Parts:
A1: Arduino_Micro_Socket
D1, D2, D3, D4, D5, D6, D7, D8, D9, D10, D11, D12, D13, D14, D15, D16, D17, D18, D19, D20, D21, D22, D23, D24, D25, D26, D27, D28, D29, D30, D39, D40, D41: LED; LED_0805_2012Metric
D31, D32, D33, D34, D35, D36, D37, D38: D; D_0805_2012Metric_Pad1.15x1.40mm_HandSolder
J1: BACKLIGHT; Molex_KK-254_AE-6410-02A_1x02_P2.54mm_Vertical
J2: 5V IN; BarrelJack_Horizontal
J3: NEXTION; Molex_KK-254_AE-6410-04A_1x04_P2.54mm_Vertical
R1, R2, R3, R5, R6, R7, R8, R9, R10, R11, R12: R; R_0805_2012Metric
R4: 10K; R_0805_2012Metric
RV1: NEXTION DIM; JST_XA_B03B-XASK-1_1x03_P2.50mm_Vertical
RV2: VOLUME; JST_XA_B03B-XASK-1_1x03_P2.50mm_Vertical
SW1, SW15: START; SW_Push_1P1T_XKB_TS-1187A
SW2, SW3: WARP; SW_Push_1P1T_XKB_TS-1187A
SW4, SW10: ATC; SW_Push_1P1T_XKB_TS-1187A
SW5, SW11: SALUITE; SW_Push_1P1T_XKB_TS-1187A
SW6: VIEWS; Molex_KK-254_AE-6410-10A_1x10_P2.54mm_Vertical
SW7, SW12: PAUSE; SW_Push_1P1T_XKB_TS-1187A
SW8, SW13: EXIT; SW_Push_1P1T_XKB_TS-1187A
SW9, SW14: FULL SCREEN; SW_Push_1P1T_XKB_TS-1187A
U1: USR-ES1; USRES1; Manufacturer_Part_Number USR-ES1

Connections:
+3V3: A1.3V3 (3.3V), R4.1, U1.B2 (3V3_1), U1.B3 (3V3_2)
/5V: A1.5V, RV1.1, RV2.1
/BL_GND: D1.1 (K), D4.1 (K), D7.1 (K), D10.1 (K), D13.1 (K), D16.1 (K), D19.1 (K), D22.1 (K), D25.1 (K), D28.1 (K), D39.1 (K), J1.2
/BUT_+12V: J1.1, R1.2, R2.2, R3.2, R5.2, R6.2, R7.2, R8.2, R9.2, R10.2, R11.2, R12.2
/COL_1: A1.D4, SW1.2, SW6.1, SW15.2
/COL_2: A1.D5, SW2.2, SW3.2, SW6.2
/COL_3: A1.D6, SW4.2, SW6.3, SW10.2
/COL_4: A1.D7 (D7_INT4), SW5.2, SW6.4, SW11.2
/COL_5: A1.D8, SW6.5, SW7.2, SW12.2
/COL_6: A1.D9, SW6.6, SW8.2, SW13.2
/COL_7: A1.D10, SW6.7, SW9.2, SW14.2
/COL_8: A1.D11, SW6.8
/DIM: A1.A5, RV1.2
/NEXTION_5V: J2.1, J3.1
/NEXTION_RX: A1.D1 (D1/TX), J3.3
/NEXTION_TX: A1.D0 (D0/RX), J3.2
/ROW_1: A1.A0, D31.2 (A), D32.2 (A), D33.2 (A), D34.2 (A), D35.2 (A), D36.2 (A), D37.2 (A)
/ROW_2: A1.A1, D38.2 (A)
/VOL: A1.A4, RV2.2
ES1_RST: A1.D12, U1.B5 (RST)
GND: A1.GND1 (GND), A1.GND2 (GND), J2.2, J3.4, RV1.3, RV2.3, U1.A1 (GND_1), U1.A2 (GND_2), U1.B1 (GND_3)
MISO: A1.MISO (SPI_MISO), U1.B6 (MISO)
MOSI: A1.MOSI (SPI_MOSI), U1.A3 (MOSI)
unnamed: D1.2 (A), D2.1 (K)
unnamed: D2.2 (A), D3.1 (K)
unnamed: D3.2 (A), R1.1
unnamed: D4.2 (A), D5.1 (K)
unnamed: D5.2 (A), D6.1 (K)
unnamed: D6.2 (A), R2.1
unnamed: D7.2 (A), D8.1 (K)
unnamed: D8.2 (A), D9.1 (K)
unnamed: D9.2 (A), R3.1
unnamed: D10.2 (A), D11.1 (K)
unnamed: D11.2 (A), D12.1 (K)
unnamed: D12.2 (A), R5.1
unnamed: D13.2 (A), D14.1 (K)
unnamed: D14.2 (A), D15.1 (K)
unnamed: D15.2 (A), R6.1
unnamed: D16.2 (A), D17.1 (K)
unnamed: D17.2 (A), D18.1 (K)
unnamed: D18.2 (A), R7.1
unnamed: D19.2 (A), D20.1 (K)
unnamed: D20.2 (A), D21.1 (K)
unnamed: D21.2 (A), R8.1
unnamed: D22.2 (A), D23.1 (K)
unnamed: D23.2 (A), D24.1 (K)
unnamed: D24.2 (A), R9.1
unnamed: D25.2 (A), D26.1 (K)
unnamed: D26.2 (A), D27.1 (K)
unnamed: D27.2 (A), R10.1
unnamed: D28.2 (A), D29.1 (K)
unnamed: D29.2 (A), D30.1 (K)
unnamed: D30.2 (A), R11.1
unnamed: D31.1 (K), SW1.1, SW15.1
unnamed: D32.1 (K), SW2.1, SW3.1
unnamed: D33.1 (K), SW4.1, SW10.1
unnamed: D34.1 (K), SW5.1, SW11.1
unnamed: D35.1 (K), SW7.1, SW12.1
unnamed: D36.1 (K), SW8.1
unnamed: D37.1 (K), SW9.1, SW14.1
unnamed: D38.1 (K), SW6.9
unnamed: D39.2 (A), D40.1 (K)
unnamed: D40.2 (A), D41.1 (K)
unnamed: D41.2 (A), R12.1
unnamed: R4.2, U1.A6 (INT)
SCLK: A1.SCK (SPI_SCK), U1.A4 (SCLK)
SS: A1.SS (SPI_CS), U1.A5 (CS)

Notes on the sheet:
Ethernet Module Library from https://componentsearchengine.com/part-view/USR-ES1/Smart%20Electronics
The analog pins on an Arduino Micro (or any Arduino) can be used as digital inputs for a button matrix. While these pins are designed for analog input, they can also function as standard digital I/O pins. You would connect the button matrix to these analog pins just as you would to digital pins, an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
BUILTIN LED, USE FOR STATUS

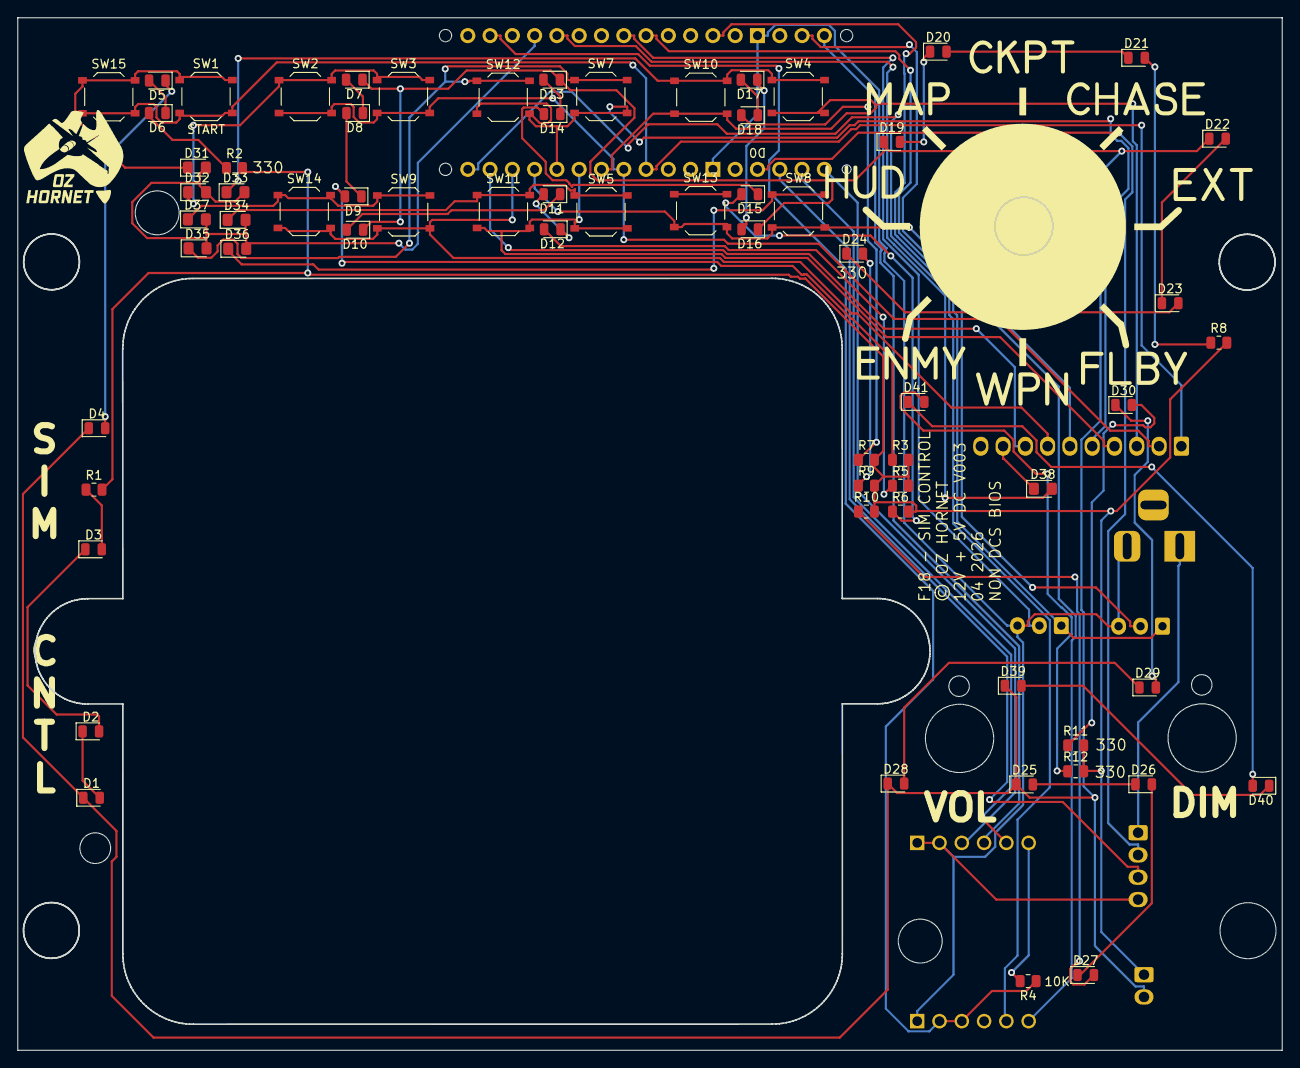
[picture p515: board SIM_CONTROL.kicad_pcb from above]

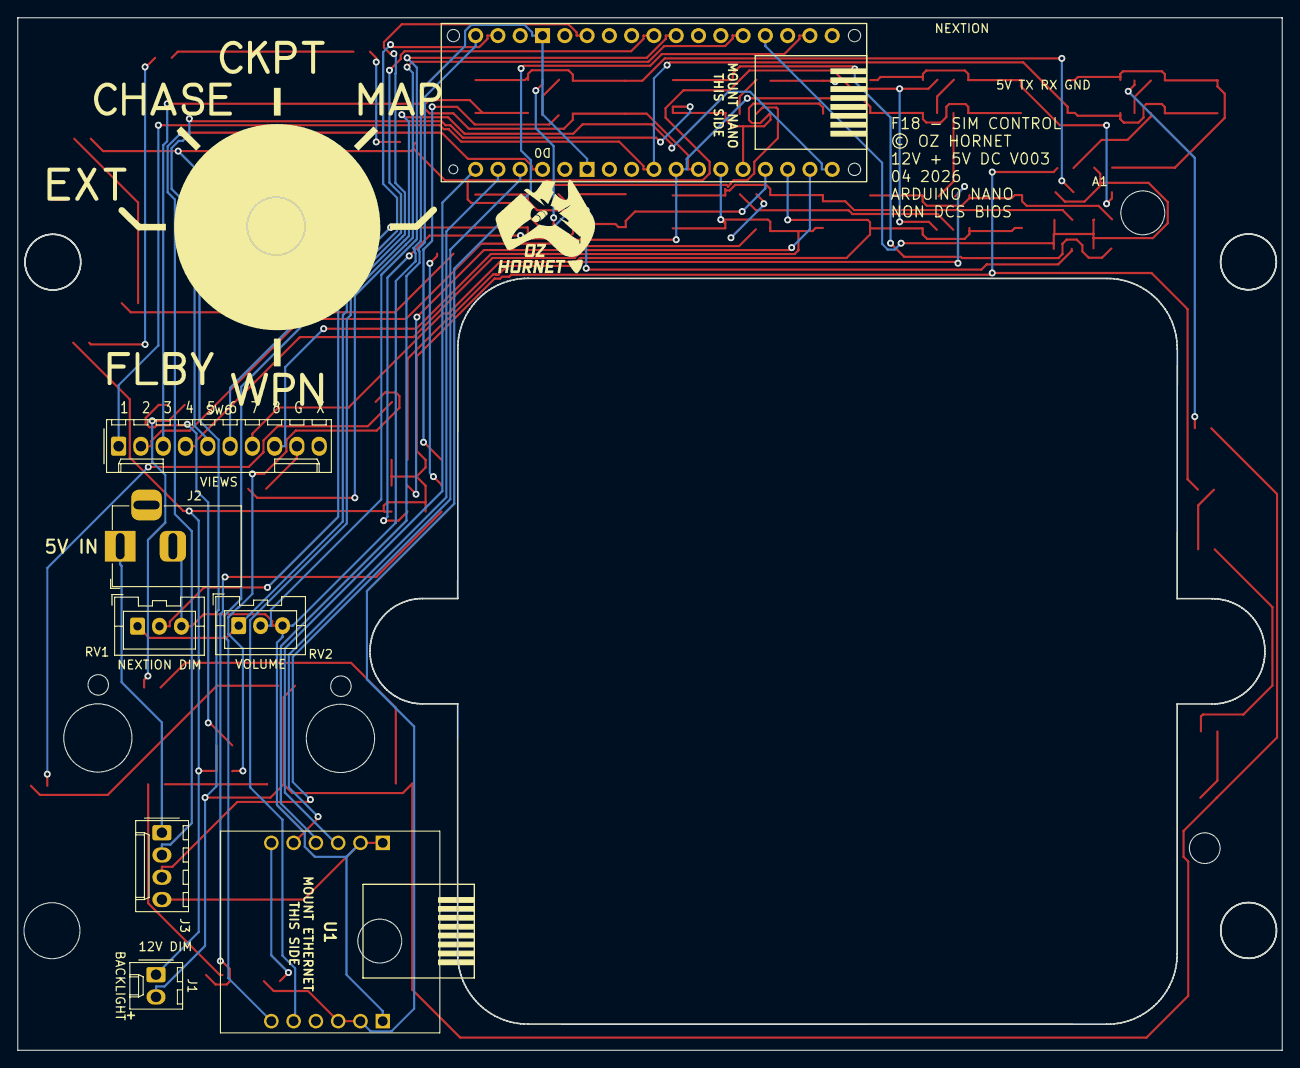
[picture p516: board SIM_CONTROL.kicad_pcb from below]

Board: 2 copper layers, 144.1 x 117.7 mm, 76 parts (8 on the bottom side), 67 nets.

Other parts of the board:
MH12: Switch_Rotary_8pos45Deg; A12505RNZQ - SWITCH, ROTARY, 45 DEG, 8-POS
