bnepethomas/bne-arduino-flight-simulator-interfaces/Jet Ranger/PCBs/Jet Ranger Radio Controller/Jet Ranger Radio Controller.kicad_pcb

## KiCad design Jet Ranger/PCBs/Jet Ranger Radio Controller/Jet Ranger Radio Controller.kicad_pcb (2025-11-29)

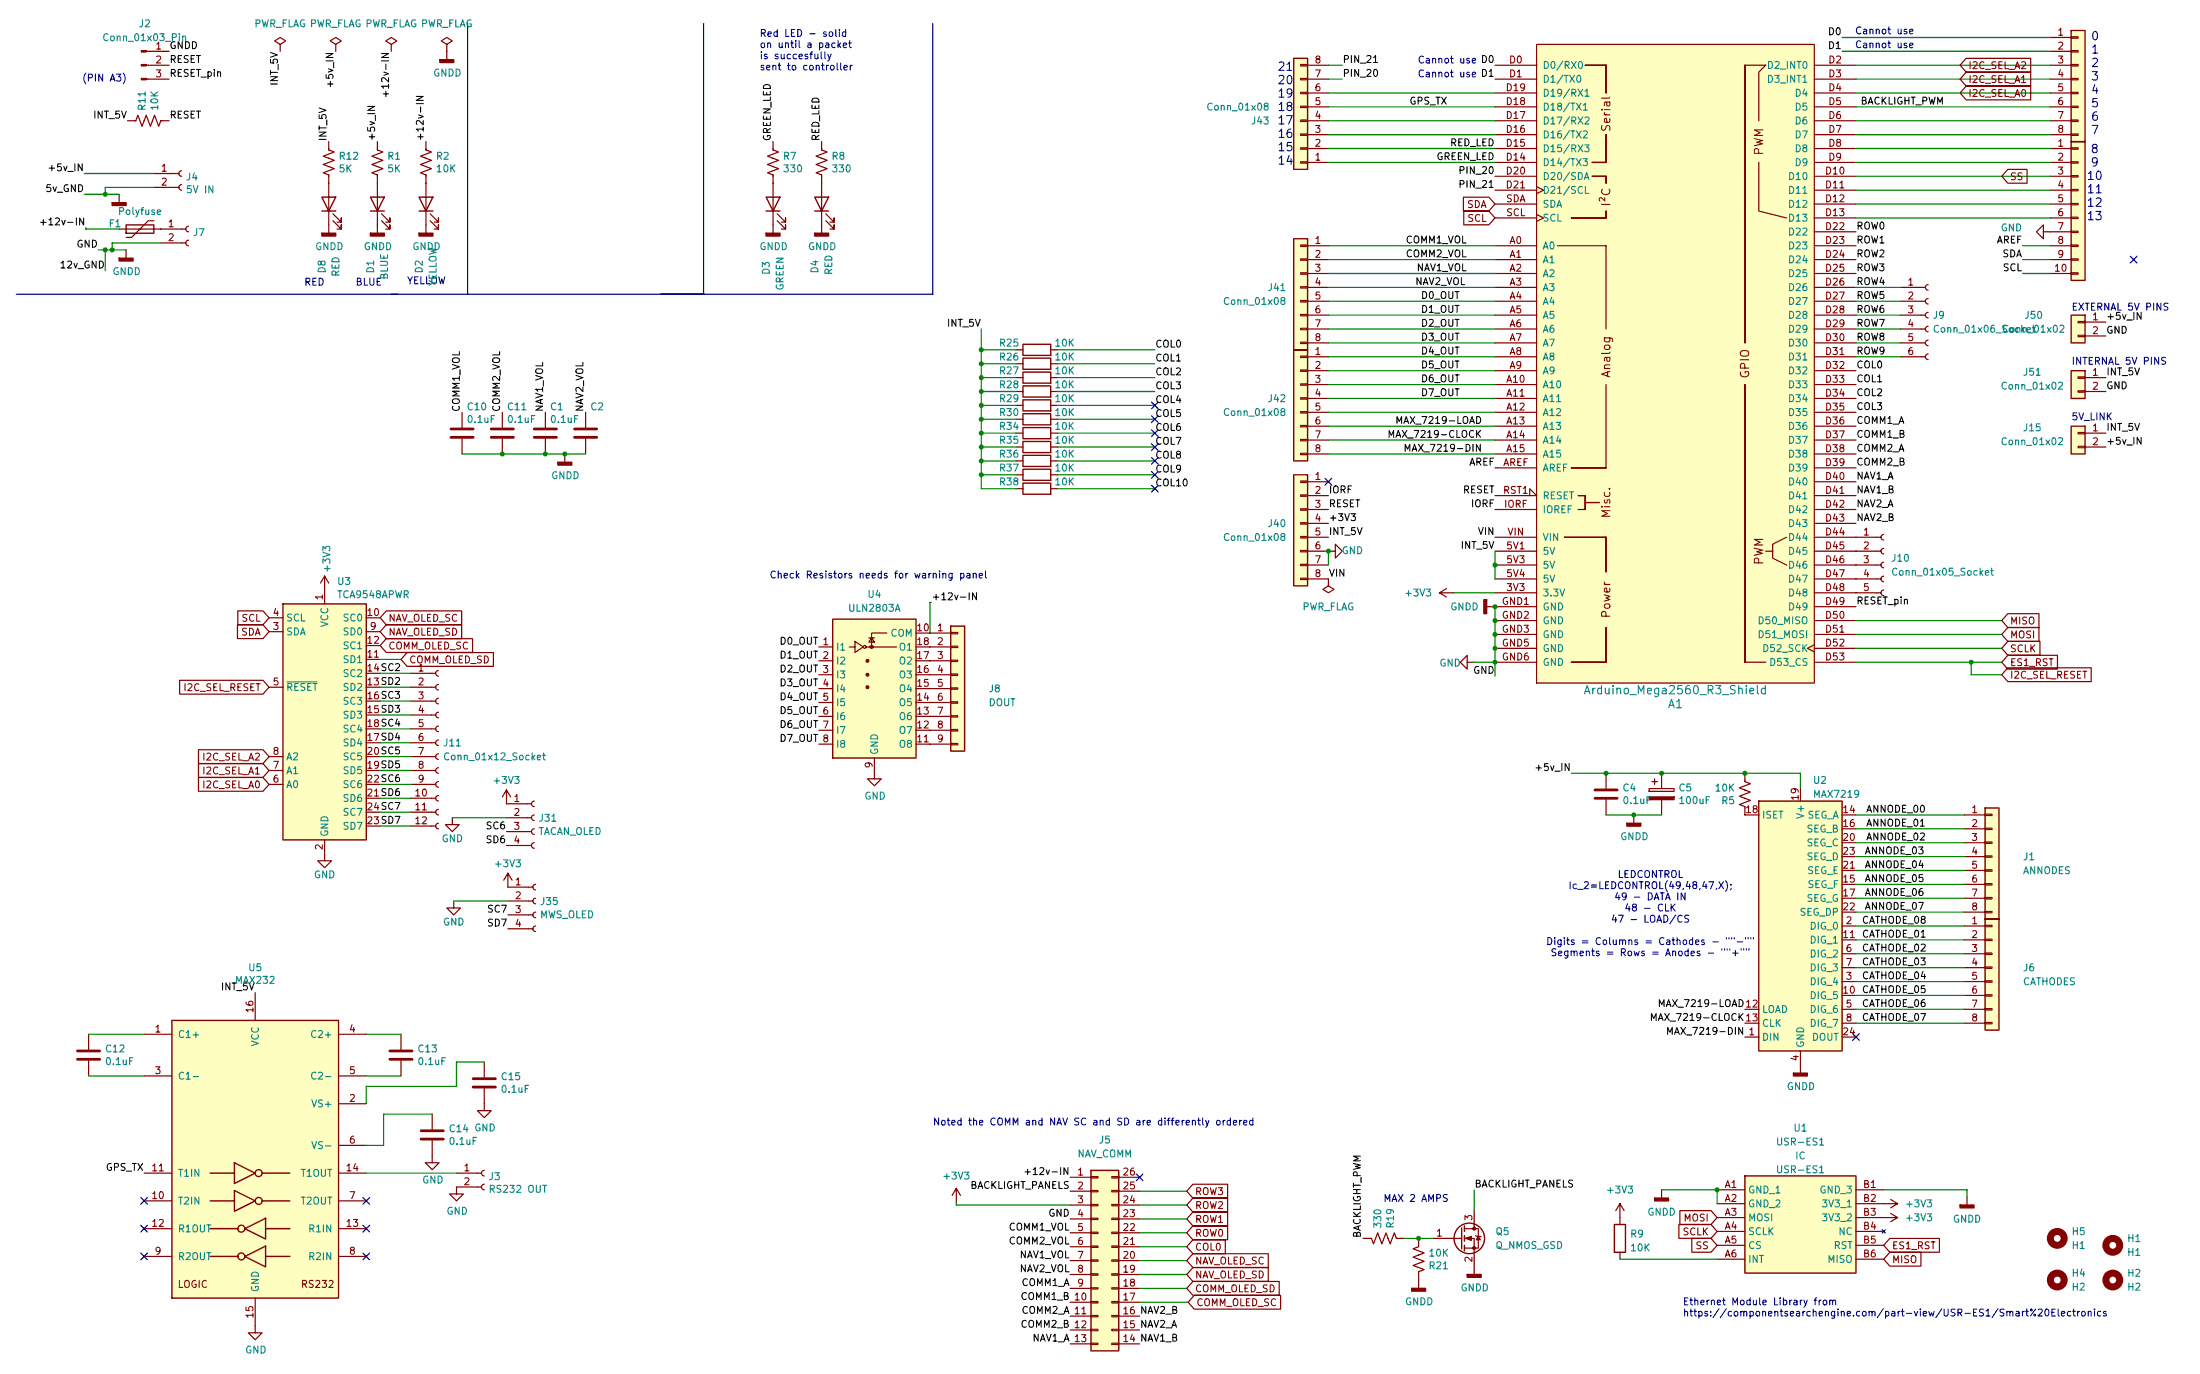
[picture p517: schematic Jet Ranger Radio Controller.kicad_sch]

Parts:
A1: Arduino_Mega2560_R3_Shield
C1, C2, C4, C10, C11: 0.1uF; C_Disc_D3.0mm_W2.0mm_P2.50mm
C5: 100uF; C_Radial_D8.0mm_H7.0mm_P3.50mm
C12, C13, C14, C15: 0.1uF; C_Disc_D4.3mm_W1.9mm_P5.00mm
D1: BLUE; LED_D3.0mm
D2: YELLOW; LED_D3.0mm
D3: GREEN; LED_D3.0mm
D4, D8: RED; LED_D3.0mm
F1: Polyfuse; Fuse_1206_3216Metric
H1, H5: H1; MountingHole_3.2mm_M3
H2, H4: H2; MountingHole_3.2mm_M3
J1: ANNODES; PinHeader_1x08_P2.54mm_Vertical
J2: Conn_01x03_Pin; PinHeader_1x03_P2.54mm_Vertical
J3: RS232 OUT; Molex_KK-254_AE-6410-02A_1x02_P2.54mm_Vertical
J4: 5V IN; BarrelJack_Horizontal
J5: NAV_COMM; IDC-Header_2x13_P2.54mm_Vertical
J6: CATHODES; PinHeader_1x08_P2.54mm_Vertical
J7: STEPPER IN 12-20VDC; BarrelJack_Horizontal
J8: DOUT; PinHeader_1x09_P2.54mm_Vertical
J9: Conn_01x06_Socket; PinHeader_1x06_P2.54mm_Vertical
J10: Conn_01x05_Socket; PinHeader_1x05_P2.54mm_Vertical
J11: Conn_01x12_Socket; PinHeader_1x12_P2.54mm_Vertical
J15, J50, J51: Conn_01x02; PinHeader_1x02_P2.54mm_Vertical
J31: TACAN_OLED; PinSocket_1x04_P2.54mm_Vertical
J35: MWS_OLED; PinSocket_1x04_P2.54mm_Vertical
J40, J41, J42, J43, J44: Conn_01x08; PinHeader_1x08_P2.54mm_Vertical
J45: Conn_01x10; PinHeader_1x10_P2.54mm_Vertical
Q5: Q_NMOS_GSD; TO-220-3_Vertical
R1, R12: 5K; R_Axial_DIN0207_L6.3mm_D2.5mm_P2.54mm_Vertical
R2, R5, R9, R11, R21, R25, R26, R27, R28, R29, R30, R34, R35, R36, R37, R38: 10K; R_Axial_DIN0207_L6.3mm_D2.5mm_P2.54mm_Vertical
R7, R8, R19: 330; R_Axial_DIN0207_L6.3mm_D2.5mm_P2.54mm_Vertical
U1: USR-ES1; USRES1; Manufacturer_Part_Number USR-ES1
U2: MAX7219; DIP-24_W7.62mm_LongPads
U3: TCA9548APWR; AllieExpress_TCA9548A
U4: ULN2803A; DIP-18_W7.62mm
U5: MAX232; DIP-16_W7.62mm

Connections:
+3V3: A1.3V3 (3.3V), J5.3, J31.1, J35.1, J40.4, R9.1, U1.B2 (3V3_1), U1.B3 (3V3_2), U3.1 (VCC)
/+5v_IN: C4.1, C5.1, J4.1, J15.2, J50.1, R1.1, R5.2, U2.19 (V+)
/+12v-IN: F1.1, J5.1, J8.1, R2.1, U4.10 (COM)
/ANNODE_00: J1.1, U2.14 (SEG_A)
/ANNODE_01: J1.2, U2.16 (SEG_B)
/ANNODE_02: J1.3, U2.20 (SEG_C)
/ANNODE_03: J1.4, U2.23 (SEG_D)
/ANNODE_04: J1.5, U2.21 (SEG_E)
/ANNODE_05: J1.6, U2.15 (SEG_F)
/ANNODE_06: J1.7, U2.17 (SEG_G)
/ANNODE_07: J1.8, U2.22 (SEG_DP)
/AREF: A1.AREF, J45.8
/BACKLIGHT_PANELS: J5.2, Q5.3 (D)
/BACKLIGHT_PWM: A1.D5, J44.6, R19.2
/CATHODE_01: J6.2, U2.11 (DIG_1)
/CATHODE_02: J6.3, U2.6 (DIG_2)
/CATHODE_03: J6.4, U2.7 (DIG_3)
/CATHODE_04: J6.5, U2.3 (DIG_4)
/CATHODE_05: J6.6, U2.10 (DIG_5)
/CATHODE_06: J6.7, U2.5 (DIG_6)
/CATHODE_07: J6.8, U2.8 (DIG_7)
/CATHODE_08: J6.1, U2.2 (DIG_0)
/COL1: A1.D33, R26.2
/COL2: A1.D34, R27.2
/COL3: A1.D35, R28.2
/COL4: R29.2
/COL5: R30.2
/COL6: R34.2
/COL7: R35.2
/COL8: R36.2
/COL9: R37.2
/COL10: R38.2
/COMM1_A: A1.D36, J5.9
/COMM1_B: A1.D37, J5.10
/COMM1_VOL: A1.A0, C10.1, J5.5, J41.1
/COMM2_A: A1.D38, J5.11
/COMM2_B: A1.D39, J5.12
/COMM2_VOL: A1.A1, C11.1, J5.6, J41.2
/D0: A1.D0 (D0/RX0), J44.1
/D0_OUT: A1.A4, J41.5, U4.1 (I1)
/D1: A1.D1 (D1/TX0), J44.2
/D1_OUT: A1.A5, J41.6, U4.2 (I2)
/D2_OUT: A1.A6, J41.7, U4.3 (I3)
/D3_OUT: A1.A7, J41.8, U4.4 (I4)
/D4_OUT: A1.A8, J42.1, U4.5 (I5)
/D5_OUT: A1.A9, J42.2, U4.6 (I6)
/D6_OUT: A1.A10, J42.3, U4.7 (I7)
/D7_OUT: A1.A11, J42.4, U4.8 (I8)
/GPS_TX: A1.D18 (D18/TX1), J43.5, U5.11 (T1IN)
/GREEN_LED: A1.D14 (D14/TX3), J43.1, R7.1
/INT_5V: A1.5V1 (5V), A1.5V3 (5V), A1.5V4 (5V), J15.1, J40.5, J51.1, R11.1, R12.1, R25.1, R26.1, R27.1, R28.1, R29.1, R30.1, R34.1, R35.1, R36.1, R37.1, R38.1, U5.16 (VCC)
/IORF: A1.IORF (IOREF), J40.2
/MAX_7219-CLOCK: A1.A14, J42.7, U2.13 (CLK)
/MAX_7219-DIN: A1.A15, J42.8, U2.1 (DIN)
/MAX_7219-LOAD: A1.A13, J42.6, U2.12 (LOAD)
/NAV1_A: A1.D40, J5.13
/NAV1_B: A1.D41, J5.14
/NAV1_VOL: A1.A2, C1.1, J5.7, J41.3
/NAV2_A: A1.D42, J5.15
/NAV2_B: A1.D43, J5.16
/NAV2_VOL: A1.A3, C2.1, J5.8, J41.4
/PIN_20: A1.D20 (D20/SDA), J43.7
/PIN_21: A1.D21 (D21/SCL), J43.8
/RED_LED: A1.D15 (D15/RX3), J43.2, R8.1
/RESET: A1.RST1 (RESET), J2.2, J40.3, R11.2
/RESET_pin: A1.D49, J2.3
/ROW4: A1.D26, J9.1
/ROW5: A1.D27, J9.2
/ROW6: A1.D28, J9.3
/ROW7: A1.D29, J9.4
/ROW8: A1.D30, J9.5
/ROW9: A1.D31, J9.6
/SC2: J11.1, U3.14 (SC2)
/SC3: J11.3, U3.16 (SC3)
/SC4: J11.5, U3.18 (SC4)
/SC5: J11.7, U3.20 (SC5)
/SC6: J11.9, J31.3, U3.22 (SC6)
/SC7: J11.11, J35.3, U3.24 (SC7)
/SD2: J11.2, U3.13 (SD2)
/SD3: J11.4, U3.15 (SD3)
/SD4: J11.6, U3.17 (SD4)
/SD5: J11.8, U3.19 (SD5)
/SD6: J11.10, J31.4, U3.21 (SD6)
/SD7: J11.12, J35.4, U3.23 (SD7)
/VIN: A1.VIN, J40.8
COL0: A1.D32, J5.21, R25.2
COMM_OLED_SC: J5.17, U3.12 (SC1)
COMM_OLED_SD: J5.18, U3.11 (SD1)
ES1_RST: A1.D53 (D53_CS), U1.B5 (RST), U3.5 (~RESET)
GND: A1.GND1 (GND), A1.GND2 (GND), A1.GND3 (GND), A1.GND5 (GND), A1.GND6 (GND), C1.2, C2.2, C4.2, C5.2, C10.2, C11.2, C14.2, C15.2, D1.1 (K), D2.1 (K), D3.1 (K), D4.1 (K), D8.1 (K), J2.1, J3.2, J4.2, J5.4, J7.2, J31.2, J35.2, J40.6, J40.7, J45.7, J50.2, J51.2, Q5.2 (S), R21.1, U1.A1 (GND_1), U1.A2 (GND_2), U1.B1 (GND_3), U2.4 (GND), U2.9 (GND), U3.2 (GND), U4.9 (GND), U5.15 (GND)
I2C_SEL_A0: A1.D4, J44.5, U3.6 (A0)
I2C_SEL_A1: A1.D3 (D3_INT1), J44.4, U3.7 (A1)
I2C_SEL_A2: A1.D2 (D2_INT0), J44.3, U3.8 (A2)
MISO: A1.D50 (D50_MISO), U1.B6 (MISO)
MOSI: A1.D51 (D51_MOSI), U1.A3 (MOSI)
NAV_OLED_SC: J5.20, U3.10 (SC0)
NAV_OLED_SD: J5.19, U3.9 (SD0)
unnamed: A1.D16 (D16/TX2), J43.3
unnamed: A1.D17 (D17/RX2), J43.4
unnamed: A1.D19 (D19/RX1), J43.6
unnamed: D1.2 (A), R1.2
unnamed: D2.2 (A), R2.2
unnamed: D3.2 (A), R7.2
unnamed: D4.2 (A), R8.2
unnamed: D8.2 (A), R12.2
unnamed: J3.1, U5.14 (T1OUT)
unnamed: F1.2, J7.1
unnamed: J8.2, U4.18 (O1)
unnamed: J8.3, U4.17 (O2)
unnamed: J8.4, U4.16 (O3)
unnamed: J8.5, U4.15 (O4)
unnamed: J8.6, U4.14 (O5)
unnamed: J8.7, U4.13 (O6)
unnamed: J8.8, U4.12 (O7)
unnamed: J8.9, U4.11 (O8)
unnamed: A1.D44, J10.1
unnamed: A1.D45, J10.2
unnamed: A1.D46, J10.3
unnamed: A1.D47, J10.4
unnamed: A1.D48, J10.5
unnamed: A1.A12, J42.5
unnamed: A1.D6, J44.7
unnamed: A1.D7, J44.8
unnamed: A1.D8, J45.1
unnamed: A1.D9, J45.2
unnamed: A1.D11, J45.4
unnamed: A1.D12, J45.5
unnamed: A1.D13, J45.6
unnamed: Q5.1 (G), R19.1, R21.2
unnamed: R9.2, U1.A6 (INT)
unnamed: R5.1, U2.18 (ISET)
unnamed: C12.1, U5.1 (C1+)
unnamed: C12.2, U5.3 (C1-)
unnamed: C13.1, U5.4 (C2+)
unnamed: C13.2, U5.5 (C2-)
unnamed: C15.1, U5.2 (VS+)
unnamed: C14.1, U5.6 (VS-)
ROW0: A1.D22, J5.22
ROW1: A1.D23, J5.23
ROW2: A1.D24, J5.24
ROW3: A1.D25, J5.25
SCL: A1.SCL, J45.10, U3.4 (SCL)
SCLK: A1.D52 (D52_SCK), U1.A4 (SCLK)
SDA: A1.SDA, J45.9, U3.3 (SDA)
SS: A1.D10, J45.3, U1.A5 (CS)

Notes on the sheet:
YELLOW
MAX 2 AMPS
BLUE
INTERNAL 5V PINS
Ethernet Module Library from https://componentsearchengine.com/part-view/USR-ES1/Smart%20Electronics
LEDCONTROL Ic_2=LEDCONTROL(49,48,47,X); 49 - DATA IN 48 - CLK 47 - LOAD/CS Digits = Columns = Cathodes - ""-"" Segments = Rows = Anodes - ""+""
Cannot use
RED
(PIN A3)
Noted the COMM and NAV SC and SD are differently ordered
0 1 2 3 4 5 6 7
Red LED - solid on until a packet is succesfully sent to controller
5V_LINK
Check Resistors needs for warning panel
21 20 19 18 17 16 15 14
EXTERNAL 5V PINS
8 9 10 11 12 13

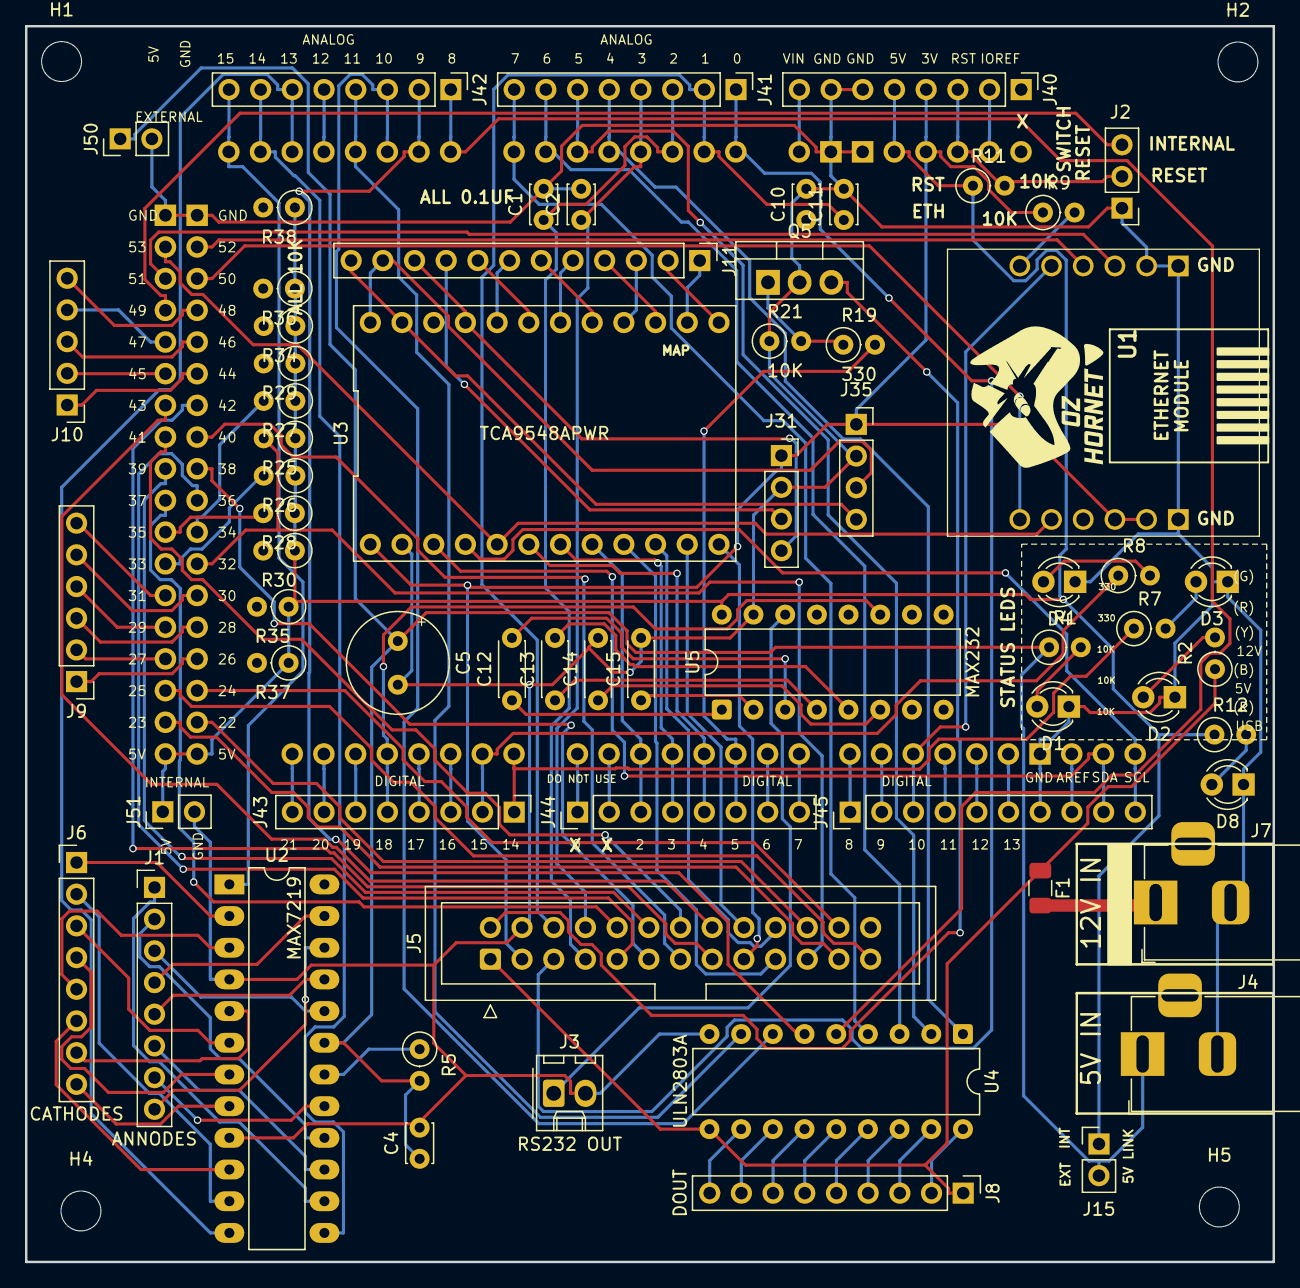
[picture p518: board Jet Ranger Radio Controller.kicad_pcb from above]

Board: 2 copper layers, 100.0 x 99.1 mm, 70 parts (0 on the bottom side), 138 nets.
