bnepethomas/bne-arduino-flight-simulator-interfaces/Jet Ranger/PCBs/Jet Ranger Auto Pilot Audio/Jet Ranger Auto Pilot Audio.kicad_pcb

## KiCad design Jet Ranger/PCBs/Jet Ranger Auto Pilot Audio/Jet Ranger Auto Pilot Audio.kicad_pcb (2025-11-29)

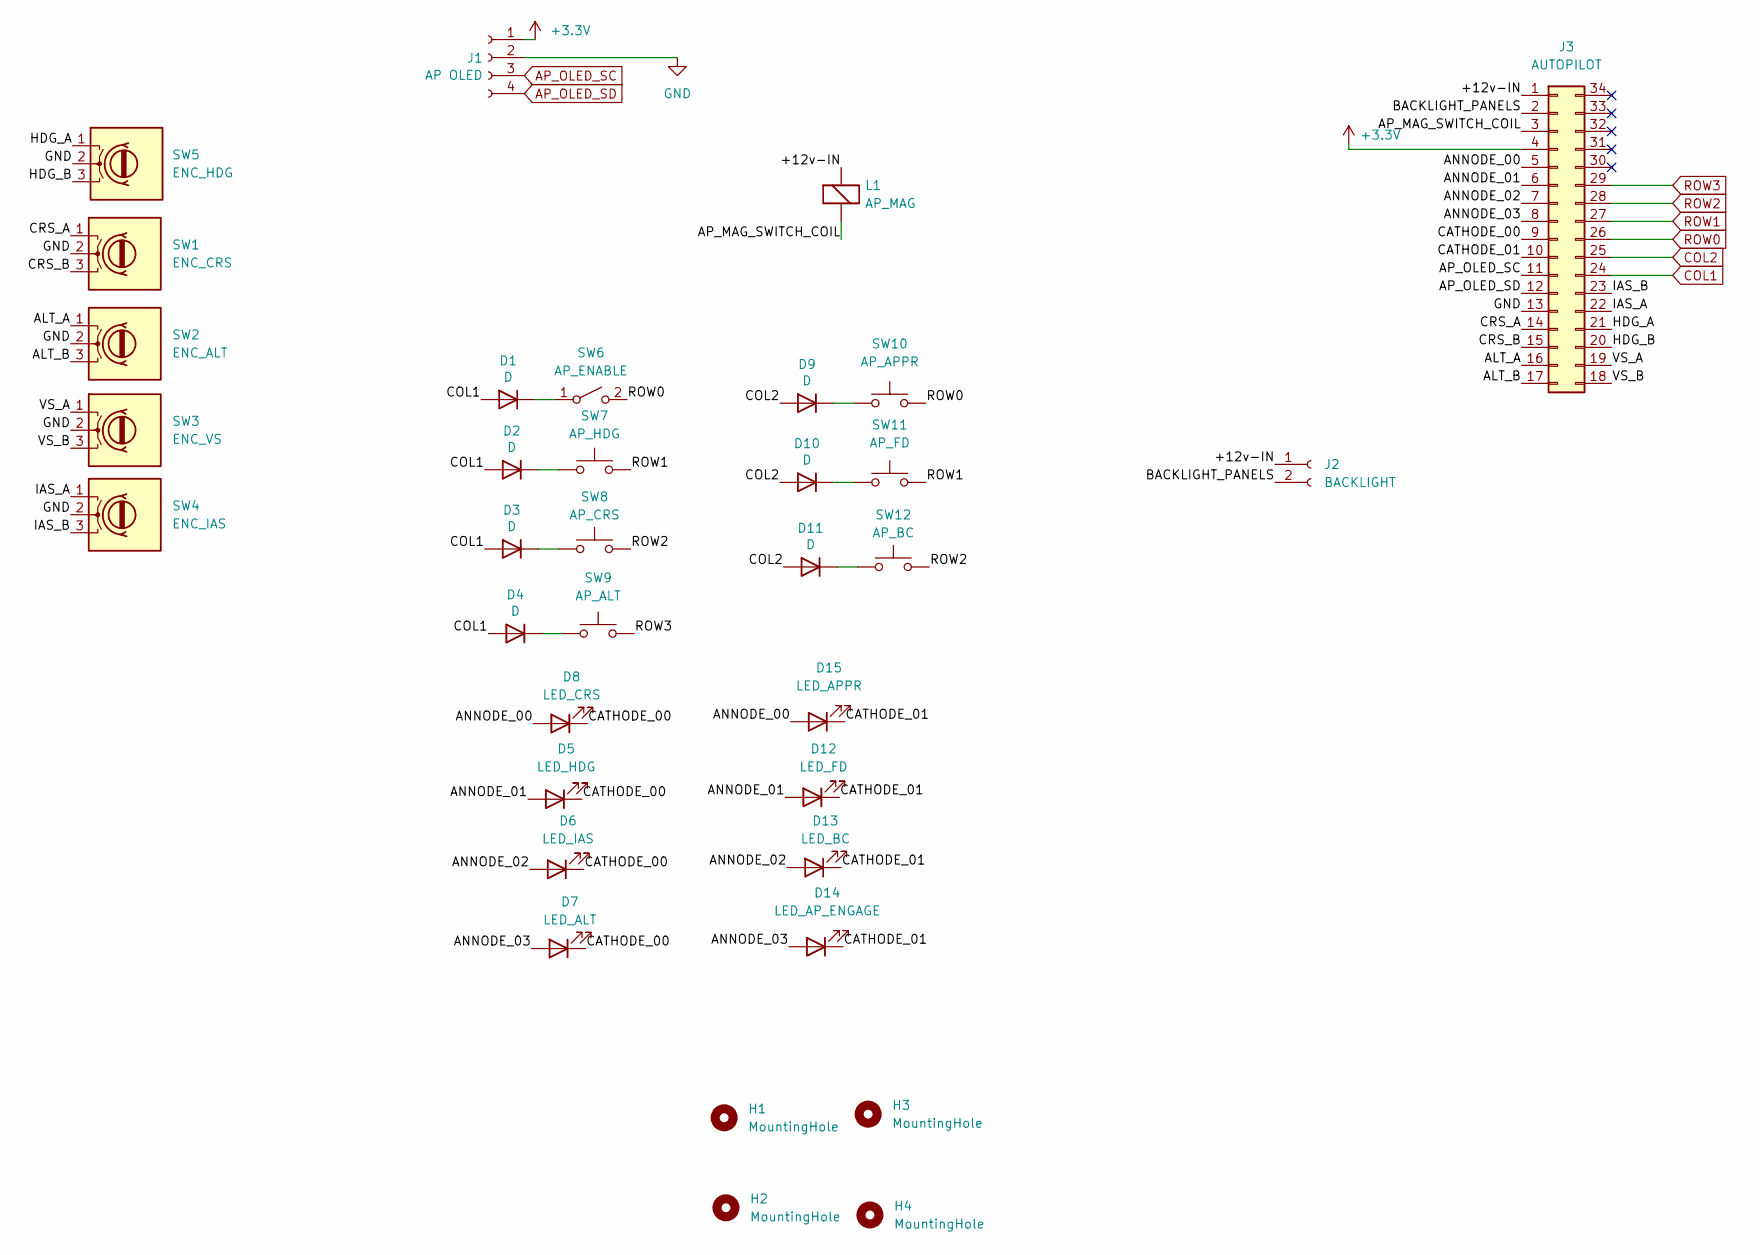
[picture p519: schematic Jet Ranger Auto Pilot Audio.kicad_sch]

Parts:
D1, D2, D3, D4, D9, D10, D11: D; D_A-405_P7.62mm_Horizontal
D5: LED_HDG; JST_XH_B2B-XH-A_1x02_P2.50mm_Vertical
D6: LED_IAS; JST_XH_B2B-XH-A_1x02_P2.50mm_Vertical
D7: LED_ALT; JST_XH_B2B-XH-A_1x02_P2.50mm_Vertical
D8: LED_CRS; JST_XH_B2B-XH-A_1x02_P2.50mm_Vertical
D12: LED_FD; JST_XH_B2B-XH-A_1x02_P2.50mm_Vertical
D13: LED_BC; JST_XH_B2B-XH-A_1x02_P2.50mm_Vertical
D14: LED_AP_ENGAGE; JST_XH_B2B-XH-A_1x02_P2.50mm_Vertical
D15: LED_APPR; JST_XH_B2B-XH-A_1x02_P2.50mm_Vertical
H1, H2, H3, H4: MountingHole; MountingHole_3.2mm_M3
J1: AP OLED; JST_XH_B4B-XH-A_1x04_P2.50mm_Vertical
J2: BACKLIGHT; JST_XH_B2B-XH-A_1x02_P2.50mm_Vertical
J3: AUTOPILOT; IDC-Header_2x17_P2.54mm_Vertical
L1: AP_MAG; JST_XH_B2B-XH-A_1x02_P2.50mm_Vertical
SW1: ENC_CRS; JST_XH_B3B-XH-A_1x03_P2.50mm_Vertical
SW2: ENC_ALT; JST_XH_B3B-XH-A_1x03_P2.50mm_Vertical
SW3: ENC_VS; JST_XH_B3B-XH-A_1x03_P2.50mm_Vertical
SW4: ENC_IAS; JST_XH_B3B-XH-A_1x03_P2.50mm_Vertical
SW5: ENC_HDG; JST_XH_B3B-XH-A_1x03_P2.50mm_Vertical
SW6: AP_ENABLE; JST_XH_B2B-XH-A_1x02_P2.50mm_Vertical
SW7: AP_HDG; JST_XH_B2B-XH-A_1x02_P2.50mm_Vertical
SW8: AP_CRS; JST_XH_B2B-XH-A_1x02_P2.50mm_Vertical
SW9: AP_ALT; JST_XH_B2B-XH-A_1x02_P2.50mm_Vertical
SW10: AP_APPR; JST_XH_B2B-XH-A_1x02_P2.50mm_Vertical
SW11: AP_FD; JST_XH_B2B-XH-A_1x02_P2.50mm_Vertical
SW12: AP_BC; JST_XH_B2B-XH-A_1x02_P2.50mm_Vertical

Connections:
+3.3V: J1.1, J3.4
/+12v-IN: J2.1, J3.1, L1.1 (-)
/ALT_A: J3.16, SW2.1 (A)
/ALT_B: J3.17, SW2.3 (B)
/ANNODE_00: D8.1 (A), D15.1 (A), J3.5
/ANNODE_01: D5.1 (A), D12.1 (A), J3.6
/ANNODE_02: D6.1 (A), D13.1 (A), J3.7
/ANNODE_03: D7.1 (A), D14.1 (A), J3.8
/AP_MAG_SWITCH_COIL: J3.3, L1.2 (+)
/BACKLIGHT_PANELS: J2.2, J3.2
/CATHODE_00: D5.2 (K), D6.2 (K), D7.2 (K), D8.2 (K), J3.9
/CATHODE_01: D12.2 (K), D13.2 (K), D14.2 (K), D15.2 (K), J3.10
/CRS_A: J3.14, SW1.1 (A)
/CRS_B: J3.15, SW1.3 (B)
/HDG_A: J3.21, SW5.1 (A)
/HDG_B: J3.20, SW5.3 (B)
/IAS_A: J3.22, SW4.1 (A)
/IAS_B: J3.23, SW4.3 (B)
/VS_A: J3.19, SW3.1 (A)
/VS_B: J3.18, SW3.3 (B)
AP_OLED_SC: J1.3, J3.11
AP_OLED_SD: J1.4, J3.12
COL1: D1.2 (A), D2.2 (A), D3.2 (A), D4.2 (A), J3.24
COL2: D9.2 (A), D10.2 (A), D11.2 (A), J3.25
GND: J1.2, J3.13, SW1.2 (C), SW2.2 (C), SW3.2 (C), SW4.2 (C), SW5.2 (C)
unnamed: D1.1 (K), SW6.1 (A)
unnamed: D2.1 (K), SW7.1
unnamed: D3.1 (K), SW8.1
unnamed: D4.1 (K), SW9.1
unnamed: D9.1 (K), SW10.1
unnamed: D10.1 (K), SW11.1
unnamed: D11.1 (K), SW12.1
ROW0: J3.26, SW6.2 (B), SW10.2
ROW1: J3.27, SW7.2, SW11.2
ROW2: J3.28, SW8.2, SW12.2
ROW3: J3.29, SW9.2

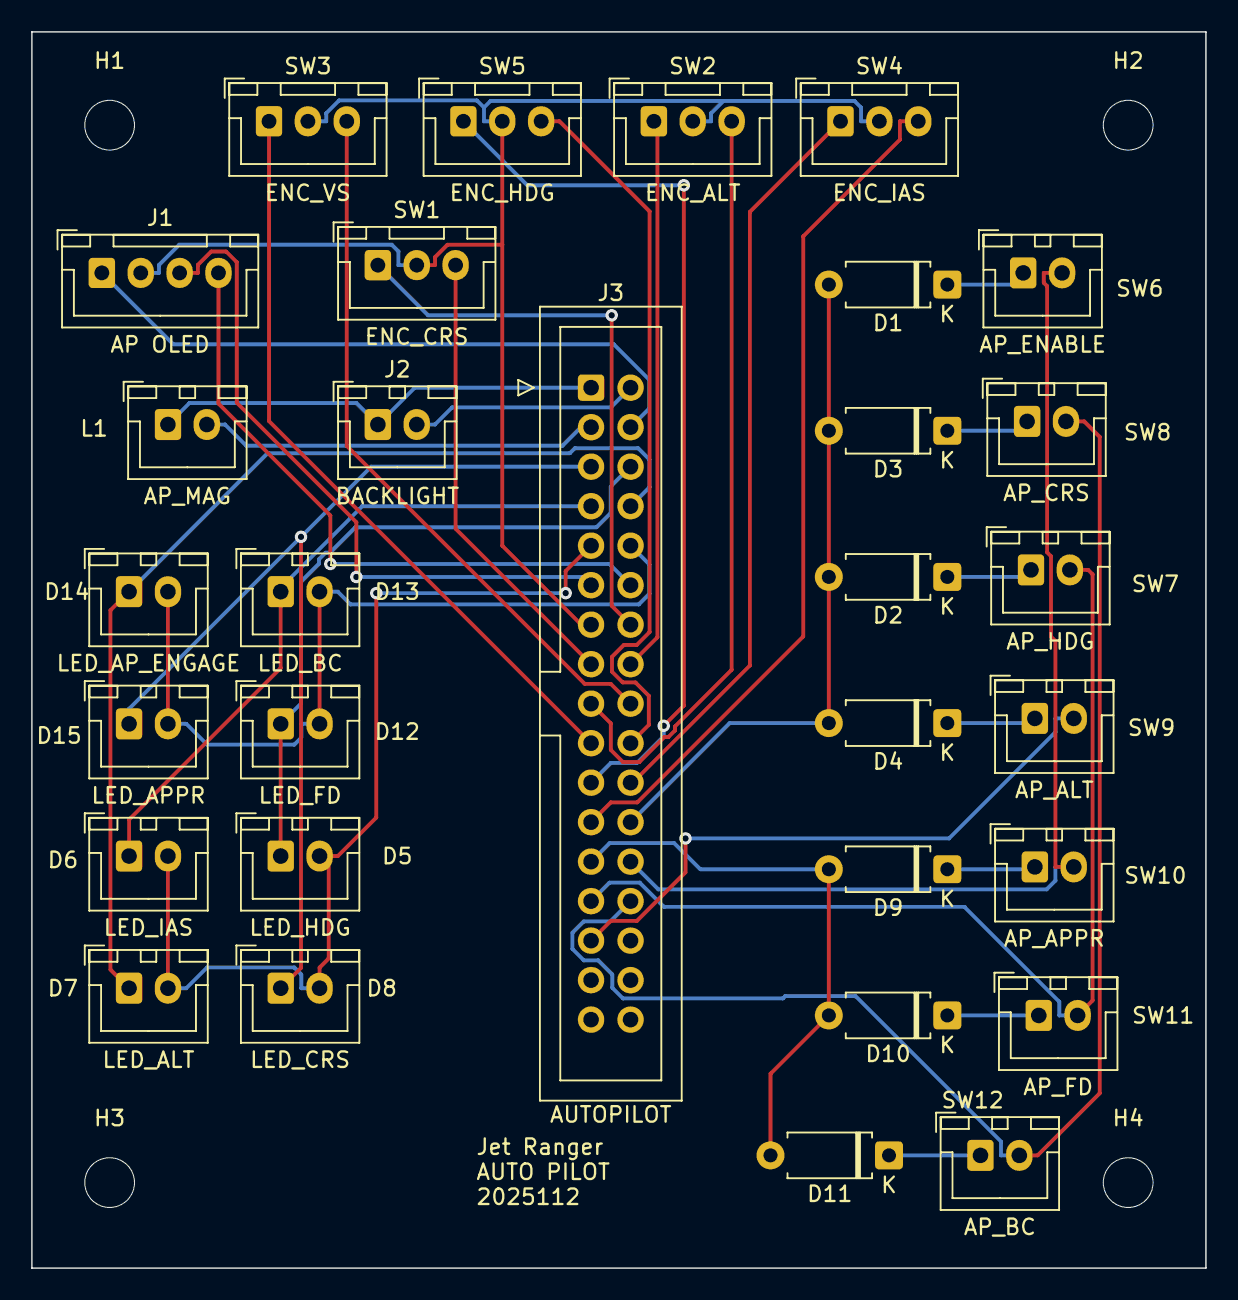
[picture p520: board Jet Ranger Auto Pilot Audio.kicad_pcb from above]

Board: 2 copper layers, 75.5 x 79.5 mm, 35 parts (0 on the bottom side), 36 nets.
