bnepethomas/bne-arduino-flight-simulator-interfaces/Jet Ranger/PCBs/Jet Ranger Test/Jet Ranger Test.kicad_pcb

## KiCad design Jet Ranger/PCBs/Jet Ranger Test/Jet Ranger Test.kicad_pcb (2025-11-29)

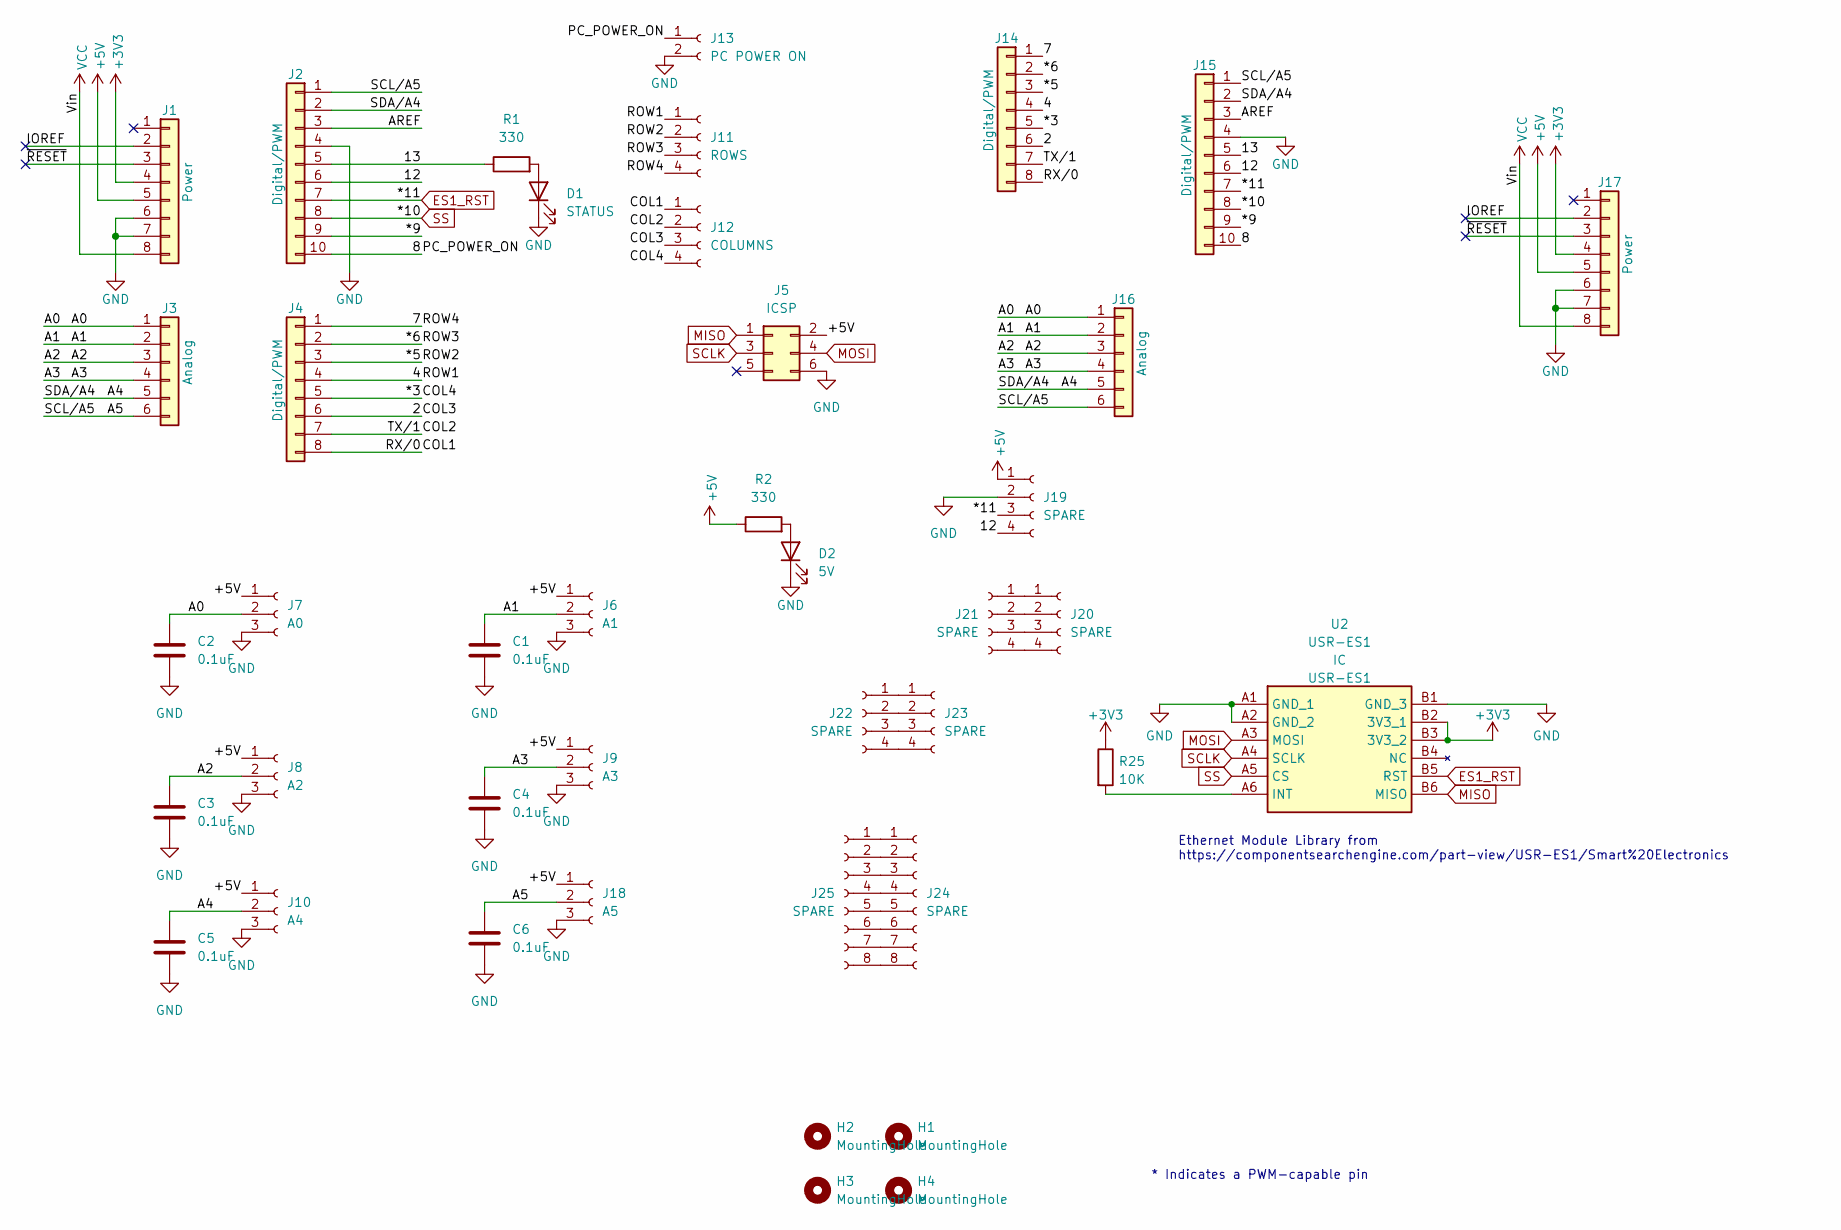
[picture p521: schematic Jet Ranger Test.kicad_sch]

Parts:
C1, C2, C3, C4, C5, C6: 0.1uF; C_Disc_D3.0mm_W2.0mm_P2.50mm
D1: STATUS; LED_D3.0mm_FlatTop
D2: 5V; LED_D3.0mm_FlatTop
H1, H2, H3, H4: MountingHole; MountingHole_3.2mm_M3
J1, J17: Power; PinSocket_1x08_P2.54mm_Vertical
J2, J15: Digital/PWM; PinSocket_1x10_P2.54mm_Vertical
J3, J16: Analog; PinSocket_1x06_P2.54mm_Vertical
J4, J14: Digital/PWM; PinSocket_1x08_P2.54mm_Vertical
J5: ICSP; PinHeader_2x03_P2.54mm_Vertical
J6: A1; JST_XA_B03B-XASK-1_1x03_P2.50mm_Vertical
J7: A0; JST_XA_B03B-XASK-1_1x03_P2.50mm_Vertical
J8: A2; JST_XA_B03B-XASK-1_1x03_P2.50mm_Vertical
J9: A3; JST_XA_B03B-XASK-1_1x03_P2.50mm_Vertical
J10: A4; JST_XA_B03B-XASK-1_1x03_P2.50mm_Vertical
J11: ROWS; Molex_KK-254_AE-6410-04A_1x04_P2.54mm_Vertical
J12: COLUMNS; Molex_KK-254_AE-6410-04A_1x04_P2.54mm_Vertical
J13: PC POWER ON; JST_XA_B02B-XASK-1_1x02_P2.50mm_Vertical
J18: A5; JST_XA_B03B-XASK-1_1x03_P2.50mm_Vertical
J19, J20, J21, J22, J23: SPARE; Molex_KK-254_AE-6410-04A_1x04_P2.54mm_Vertical
J24, J25: SPARE; Molex_KK-254_AE-6410-08A_1x08_P2.54mm_Vertical
R1, R2: 330; R_Axial_DIN0204_L3.6mm_D1.6mm_P2.54mm_Vertical
R25: 10K; R_Axial_DIN0204_L3.6mm_D1.6mm_P2.54mm_Vertical
U2: USR-ES1; USRES1; Manufacturer_Part_Number USR-ES1

Connections:
+3V3: J1.4, J17.4, R25.1, U2.B2 (3V3_1), U2.B3 (3V3_2)
+5V: J1.5, J5.2, J6.1, J7.1, J8.1, J9.1, J10.1, J17.5, J18.1, J19.1, R2.1
/2: J4.6, J12.3, J14.6
/4: J4.4, J11.1, J14.4
/7: J4.1, J11.4, J14.1
/8: J2.10, J13.1, J15.10
/12: J2.6, J15.6, J19.4
/13: J2.5, J15.5, R1.1
/*3: J4.5, J12.4, J14.5
/*5: J4.3, J11.2, J14.3
/*6: J4.2, J11.3, J14.2
/*9: J2.9, J15.9
/A0: C2.1, J3.1, J7.2, J16.1
/A1: C1.1, J3.2, J6.2, J16.2
/A2: C3.1, J3.3, J8.2, J16.3
/A3: C4.1, J3.4, J9.2, J16.4
/A4: C5.1, J2.2, J3.5, J10.2, J15.2, J16.5
/A5: C6.1, J2.1, J3.6, J15.1, J16.6, J18.2
/AREF: J2.3, J15.3
/COL1: J4.8, J12.1, J14.8
/COL2: J4.7, J12.2, J14.7
/IOREF: J1.2, J17.2
/~RESET: J1.3, J17.3
ES1_RST: J2.7, J15.7, J19.3, U2.B5 (RST)
GND: C1.2, C2.2, C3.2, C4.2, C5.2, C6.2, D1.1 (K), D2.1 (K), J1.6, J1.7, J2.4, J5.6, J6.3, J7.3, J8.3, J9.3, J10.3, J13.2, J15.4, J17.6, J17.7, J18.3, J19.2, U2.A1 (GND_1), U2.A2 (GND_2), U2.B1 (GND_3)
MISO: J5.1, U2.B6 (MISO)
MOSI: J5.4, U2.A3 (MOSI)
unnamed: D1.2 (A), R1.2
unnamed: D2.2 (A), R2.2
unnamed: J20.1, J21.1
unnamed: J20.2, J21.2
unnamed: J20.3, J21.3
unnamed: J20.4, J21.4
unnamed: J22.1, J23.1
unnamed: J22.2, J23.2
unnamed: J22.3, J23.3
unnamed: J22.4, J23.4
unnamed: J24.1, J25.1
unnamed: J24.2, J25.2
unnamed: J24.3, J25.3
unnamed: J24.4, J25.4
unnamed: J24.5, J25.5
unnamed: J24.6, J25.6
unnamed: J24.7, J25.7
unnamed: J24.8, J25.8
unnamed: R25.2, U2.A6 (INT)
SCLK: J5.3, U2.A4 (SCLK)
SS: J2.8, J15.8, U2.A5 (CS)
VCC: J1.8, J17.8

Notes on the sheet:
Ethernet Module Library from https://componentsearchengine.com/part-view/USR-ES1/Smart%20Electronics
* Indicates a PWM-capable pin

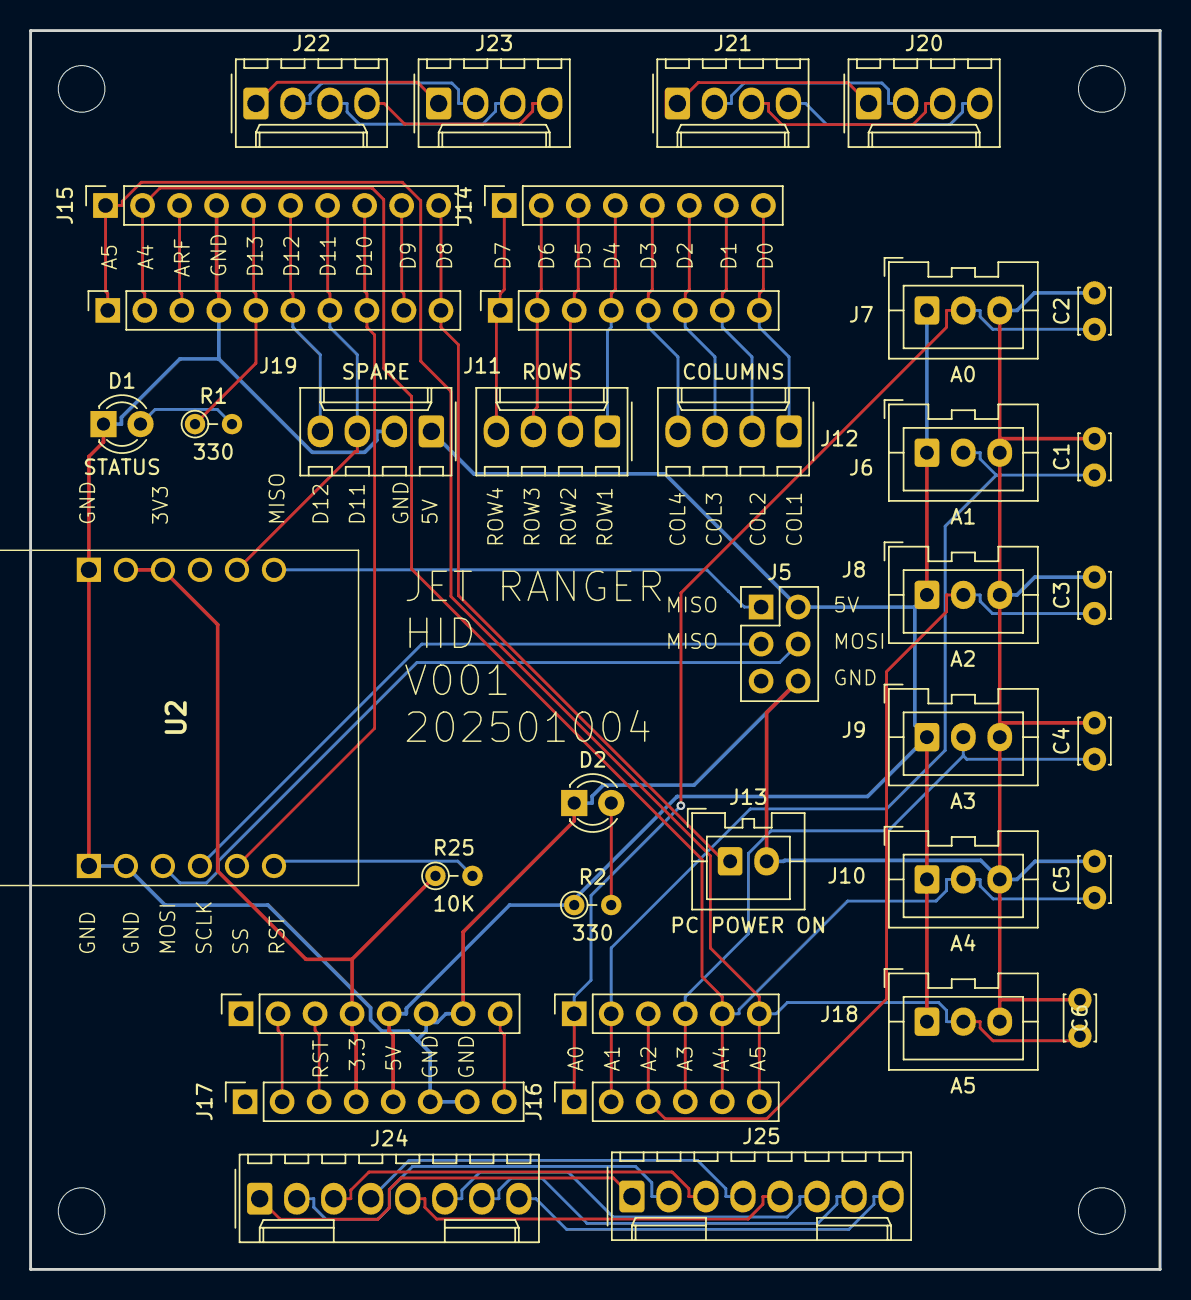
[picture p522: board Jet Ranger Test.kicad_pcb from above]

Board: 2 copper layers, 77.5 x 85.0 mm, 41 parts (0 on the bottom side), 49 nets.
