bnepethomas/bne-arduino-flight-simulator-interfaces/Jet Ranger/PCBs/Jet Ranger COM and NAV/Jet Ranger COM and NAV.kicad_pcb

## KiCad design Jet Ranger/PCBs/Jet Ranger COM and NAV/Jet Ranger COM and NAV.kicad_pcb (2026-02-01)

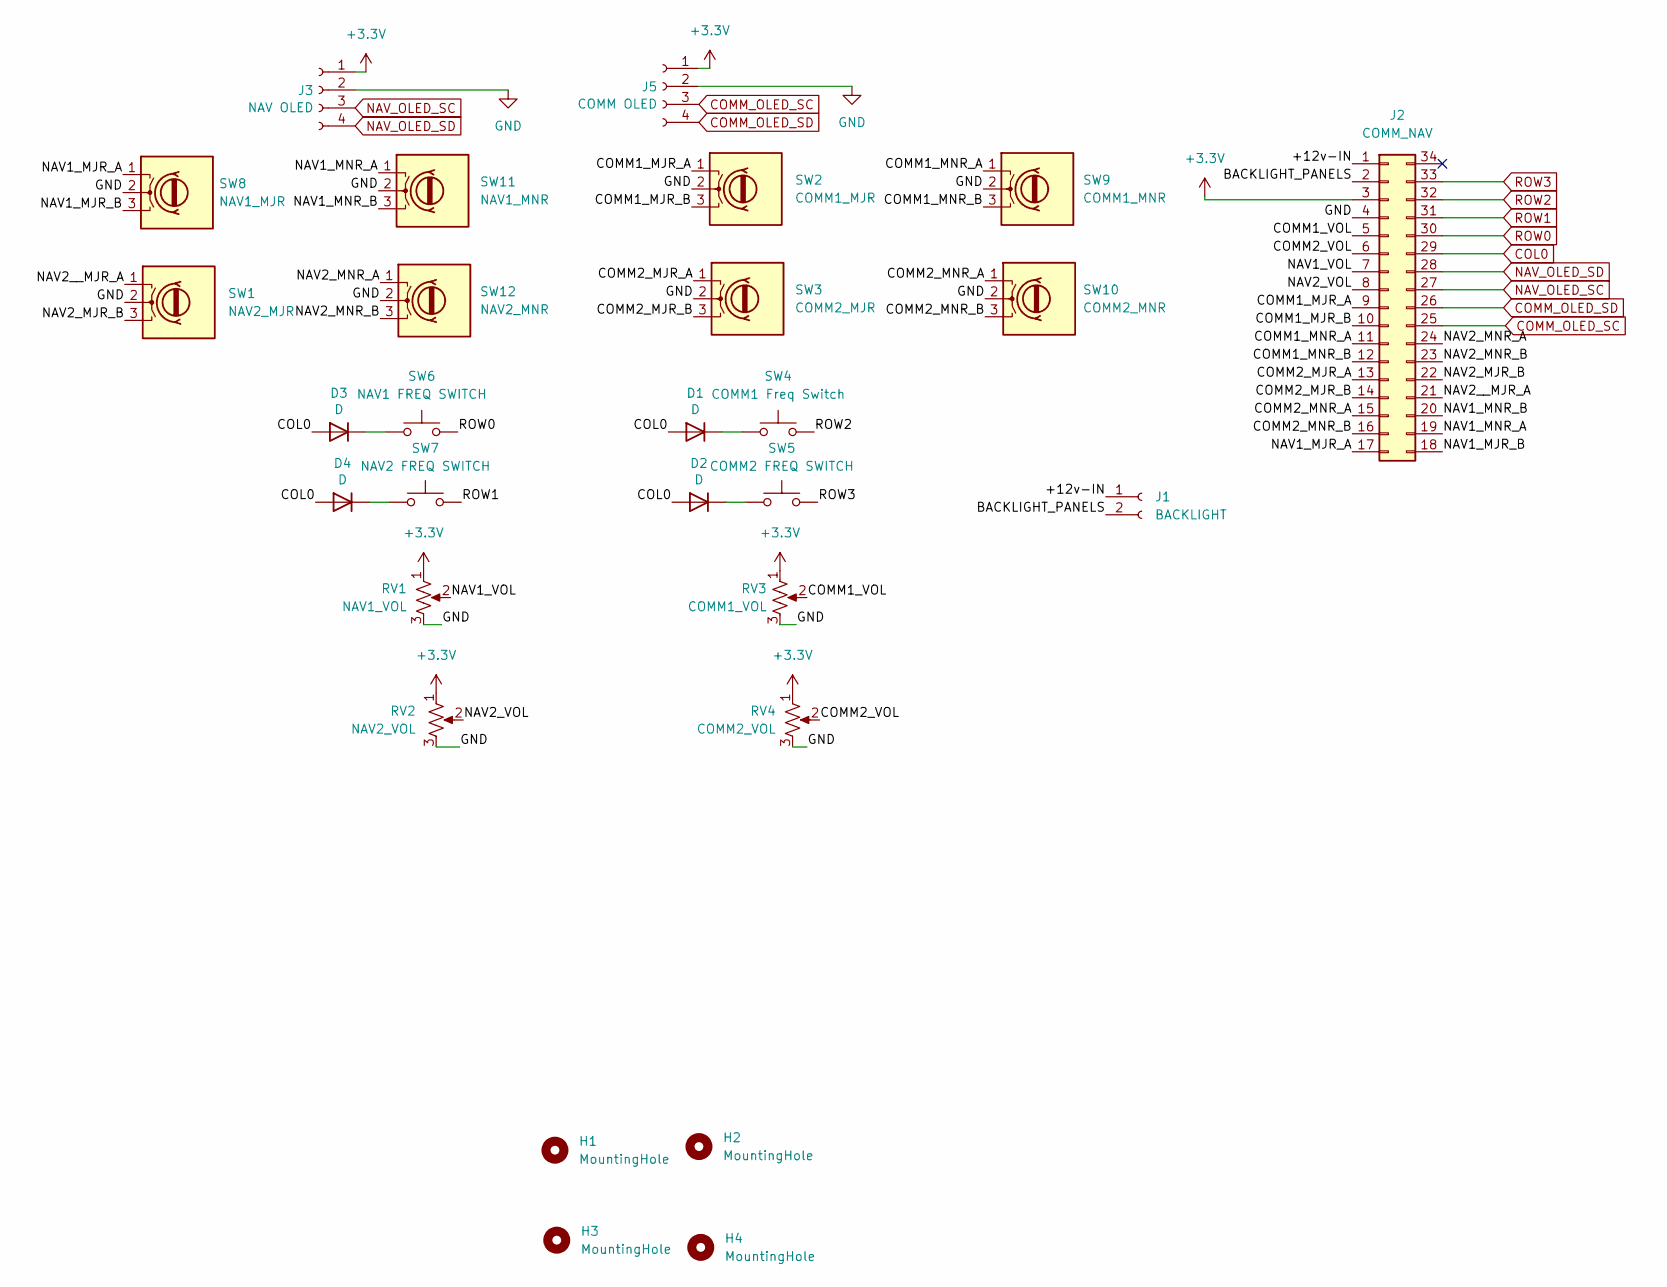
[picture p523: schematic Jet Ranger COM and NAV.kicad_sch]

Parts:
D1, D2, D3, D4: D; D_A-405_P7.62mm_Horizontal
H1, H2, H3, H4: MountingHole; MountingHole_3.2mm_M3
J1: BACKLIGHT; JST_XH_B2B-XH-A_1x02_P2.50mm_Vertical
J2: COMM_NAV; IDC-Header_2x17_P2.54mm_Vertical
J3: NAV OLED; JST_XH_B4B-XH-A_1x04_P2.50mm_Vertical
J5: COMM OLED; JST_XH_B4B-XH-A_1x04_P2.50mm_Vertical
RV1: NAV1_VOL; JST_XH_B3B-XH-A_1x03_P2.50mm_Vertical
RV2: NAV2_VOL; JST_XH_B3B-XH-A_1x03_P2.50mm_Vertical
RV3: COMM1_VOL; JST_XH_B3B-XH-A_1x03_P2.50mm_Vertical
RV4: COMM2_VOL; JST_XH_B3B-XH-A_1x03_P2.50mm_Vertical
SW1: NAV2_MJR; JST_XH_B3B-XH-A_1x03_P2.50mm_Vertical
SW2: COMM1_MJR; JST_XH_B3B-XH-A_1x03_P2.50mm_Vertical
SW3: COMM2_MJR; JST_XH_B3B-XH-A_1x03_P2.50mm_Vertical
SW4: COMM1 Freq Switch; JST_XH_B2B-XH-A_1x02_P2.50mm_Vertical
SW5: COMM2 FREQ SWITCH; JST_XH_B2B-XH-A_1x02_P2.50mm_Vertical
SW6: NAV1 FREQ SWITCH; JST_XH_B2B-XH-A_1x02_P2.50mm_Vertical
SW7: NAV2 FREQ SWITCH; JST_XH_B2B-XH-A_1x02_P2.50mm_Vertical
SW8: NAV1_MJR; JST_XH_B3B-XH-A_1x03_P2.50mm_Vertical
SW9: COMM1_MNR; JST_XH_B3B-XH-A_1x03_P2.50mm_Vertical
SW10: COMM2_MNR; JST_XH_B3B-XH-A_1x03_P2.50mm_Vertical
SW11: NAV1_MNR; JST_XH_B3B-XH-A_1x03_P2.50mm_Vertical
SW12: NAV2_MNR; JST_XH_B3B-XH-A_1x03_P2.50mm_Vertical

Connections:
+3.3V: J2.3, J3.1, J5.1, RV1.1, RV2.1, RV3.1, RV4.1
/+12v-IN: J1.1, J2.1
/BACKLIGHT_PANELS: J1.2, J2.2
/COMM1_MJR_A: J2.9, SW2.1
/COMM1_MJR_B: J2.10, SW2.3
/COMM1_MNR_A: J2.11, SW9.1
/COMM1_MNR_B: J2.12, SW9.3
/COMM1_VOL: J2.5, RV3.2
/COMM2_MJR_A: J2.13, SW3.1
/COMM2_MJR_B: J2.14, SW3.3
/COMM2_MNR_A: J2.15, SW10.1
/COMM2_MNR_B: J2.16, SW10.3
/COMM2_VOL: J2.6, RV4.2
/NAV1_MJR_A: J2.17, SW8.1
/NAV1_MJR_B: J2.18, SW8.3
/NAV1_MNR_A: J2.19, SW11.1
/NAV1_MNR_B: J2.20, SW11.3
/NAV1_VOL: J2.7, RV1.2
/NAV2_MJR_B: J2.22, SW1.3
/NAV2_MNR_A: J2.24, SW12.1
/NAV2_MNR_B: J2.23, SW12.3
/NAV2_VOL: J2.8, RV2.2
/NAV2__MJR_A: J2.21, SW1.1
COL0: D1.2 (A), D2.2 (A), D3.2 (A), D4.2 (A), J2.29
COMM_OLED_SC: J2.25, J5.3
COMM_OLED_SD: J2.26, J5.4
GND: J2.4, J3.2, J5.2, RV1.3, RV2.3, RV3.3, RV4.3, SW1.2, SW2.2, SW3.2, SW8.2, SW9.2, SW10.2, SW11.2, SW12.2
NAV_OLED_SC: J2.27, J3.3
NAV_OLED_SD: J2.28, J3.4
unnamed: D1.1 (K), SW4.1
unnamed: D2.1 (K), SW5.1
unnamed: D3.1 (K), SW6.1
unnamed: D4.1 (K), SW7.1
ROW0: J2.30, SW6.2
ROW1: J2.31, SW7.2
ROW2: J2.32, SW4.2
ROW3: J2.33, SW5.2

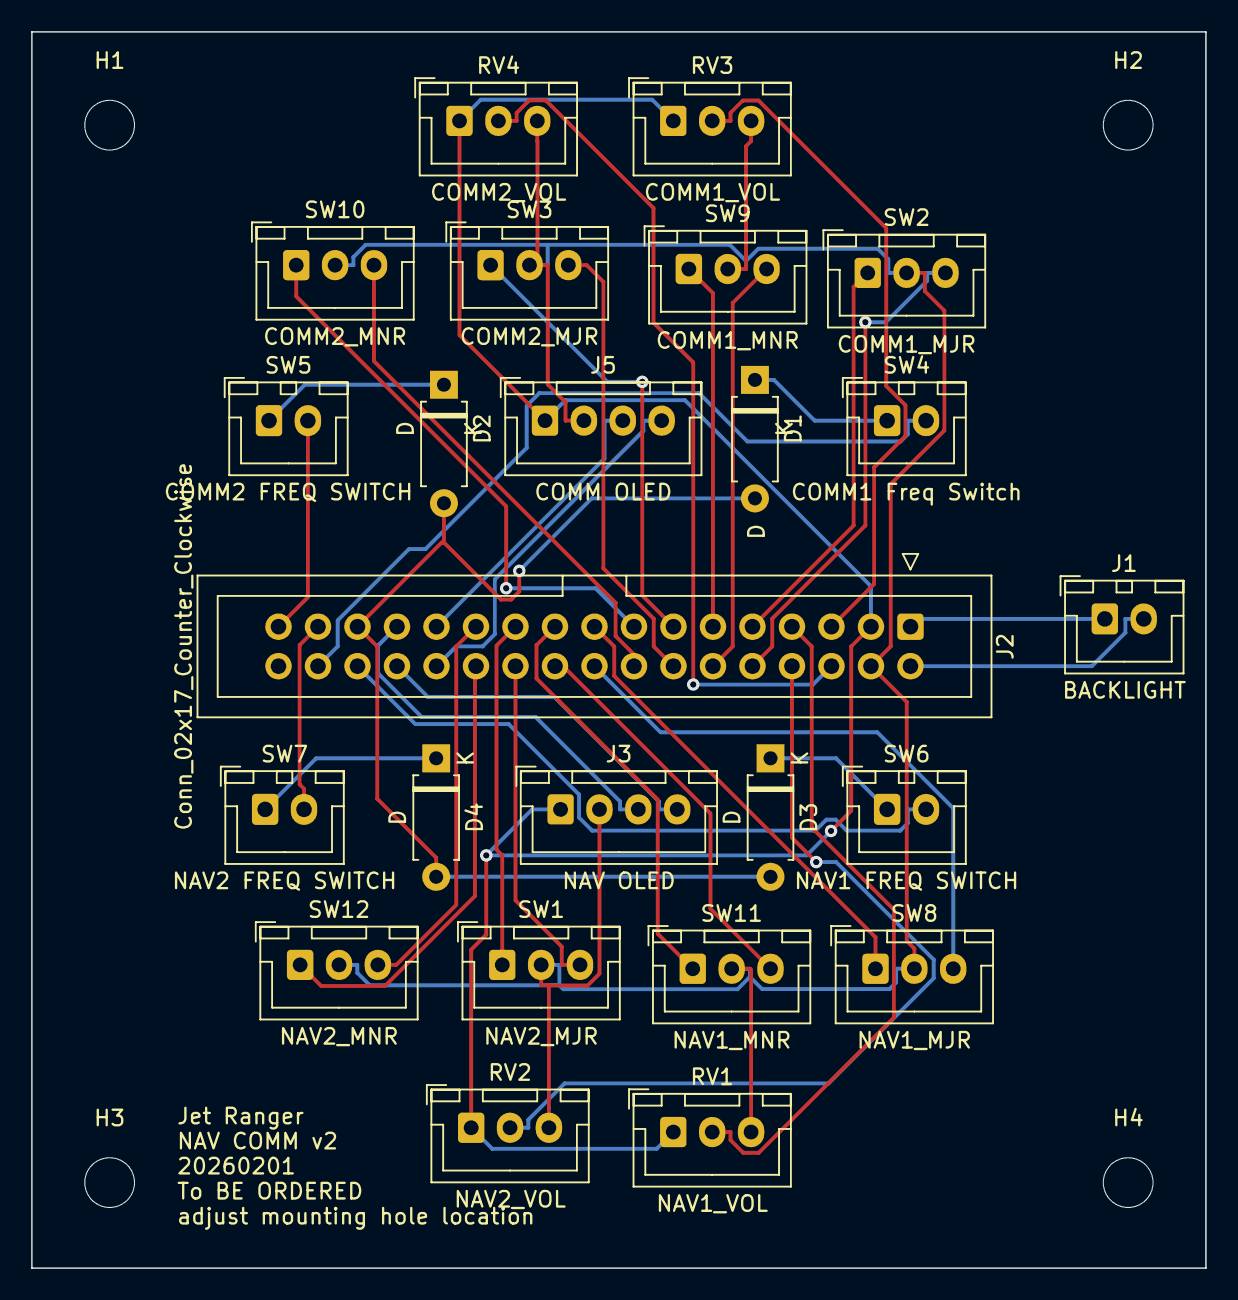
[picture p524: board Jet Ranger COM and NAV.kicad_pcb from above]

Board: 2 copper layers, 75.5 x 79.5 mm, 28 parts (0 on the bottom side), 37 nets.
