bnepethomas/bne-arduino-flight-simulator-interfaces/Hornet/Hornet PCBs/Active/OZ-HORNET-POWER-DIST/OZ-HORNET-POWER-DIST.kicad_pcb

## KiCad design Hornet/Hornet PCBs/Active/OZ-HORNET-POWER-DIST/OZ-HORNET-POWER-DIST.kicad_pcb (2026-02-08)

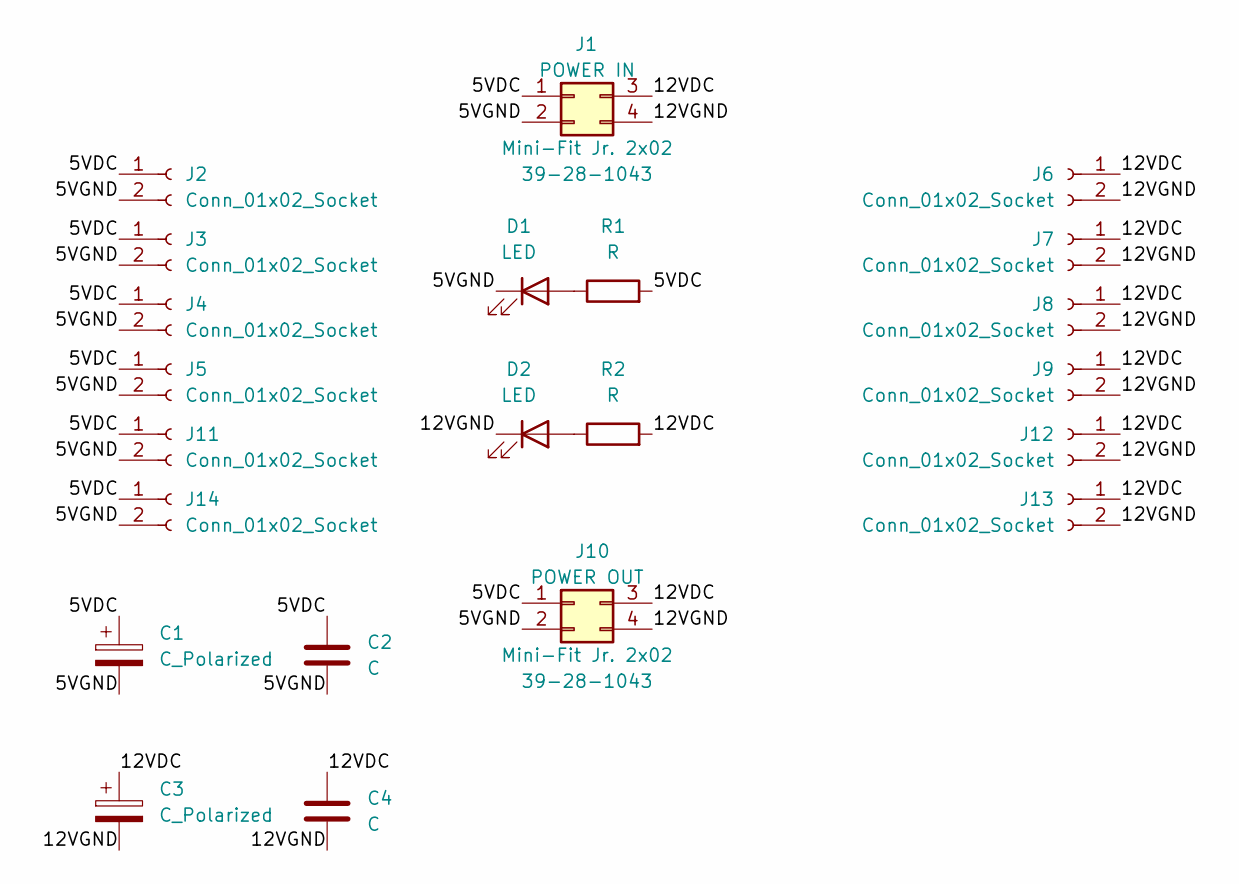
[picture p525: schematic OZ-HORNET-POWER-DIST.kicad_sch]

Parts:
C1, C3: C_Polarized; CP_Radial_D6.3mm_P2.50mm
C2, C4: C; C_Disc_D5.0mm_W2.5mm_P2.50mm
D1, D2: LED; LED_D3.0mm
J1, J10: Mini-Fit Jr. 2x02; Aliexpress_Mini-Fit_Jr_5566-04A_2x02_P4.20mm_Vertical; Manufacturer PN 39-28-1043; LCSC C293502
J2, J3, J4, J5, J6, J7, J8, J9, J11, J12, J13, J14: Conn_01x02_Socket; BarrelJack_Horizontal
R1, R2: R; R_Axial_DIN0204_L3.6mm_D1.6mm_P5.08mm_Horizontal

Connections:
/5VDC: C1.1, C2.1, J1.1, J2.1, J3.1, J4.1, J5.1, J10.1, J11.1, J14.1, R1.2
/5VGND: C1.2, C2.2, D1.1 (K), J1.2 (Pin_3), J2.2, J3.2, J4.2, J5.2, J10.2 (Pin_3), J11.2, J14.2
/12VDC: C3.1, C4.1, J1.3 (Pin_2), J6.1, J7.1, J8.1, J9.1, J10.3 (Pin_2), J12.1, J13.1, R2.2
/12VGND: C3.2, C4.2, D2.1 (K), J1.4, J6.2, J7.2, J8.2, J9.2, J10.4, J12.2, J13.2
unnamed: D1.2 (A), R1.1
unnamed: D2.2 (A), R2.1

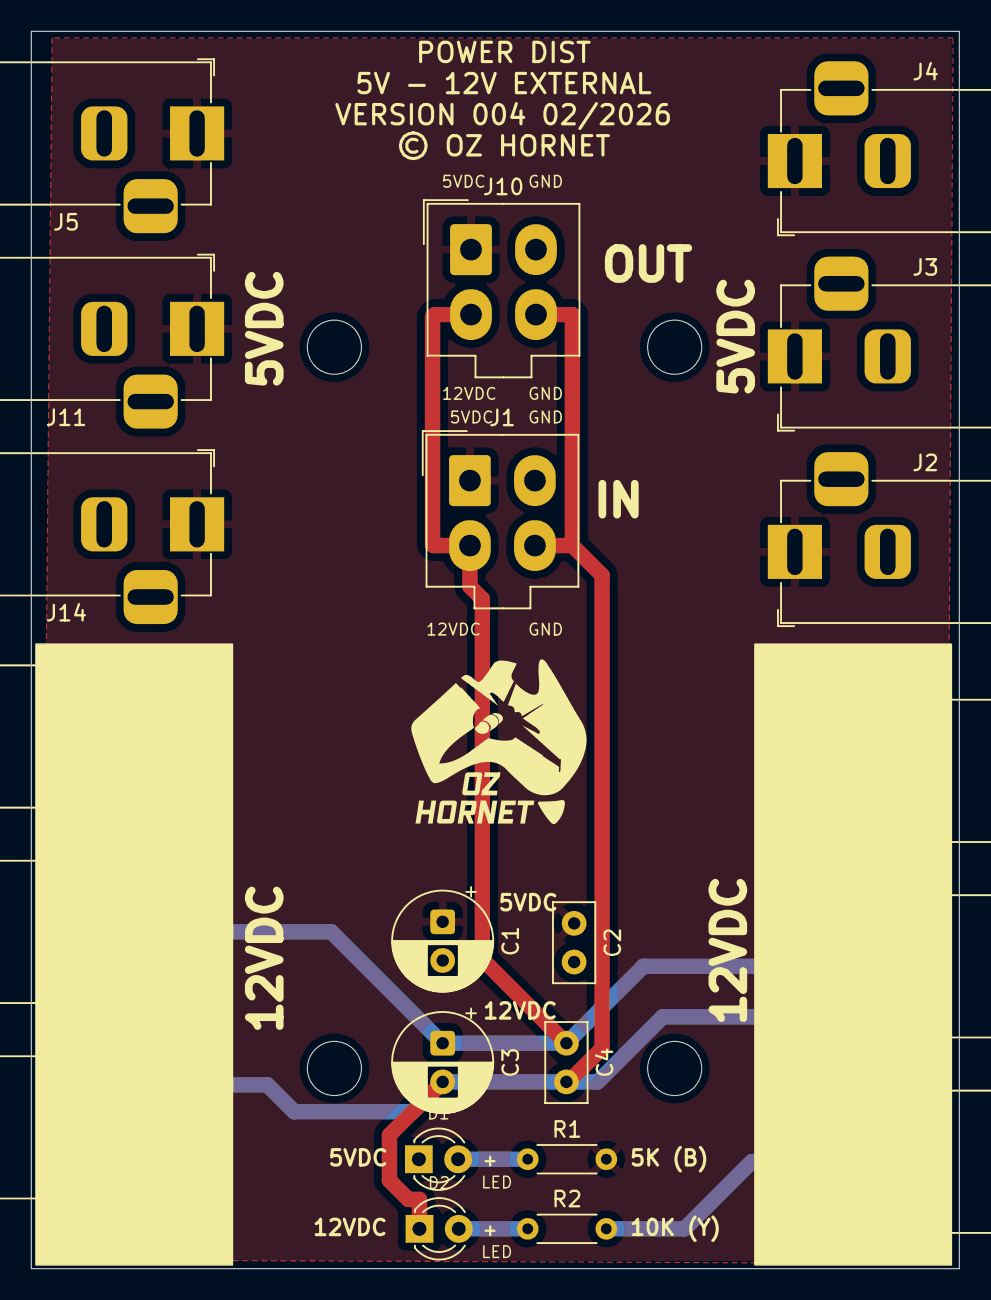
[picture p526: board OZ-HORNET-POWER-DIST.kicad_pcb from above]

Board: 2 copper layers, 60.0 x 80.0 mm, 22 parts (0 on the bottom side), 6 nets.
