bnepethomas/bne-arduino-flight-simulator-interfaces/Hornet/Hornet PCBs/Active/LED_Downlight/LED_Downlight.kicad_pcb

## KiCad design Hornet/Hornet PCBs/Active/LED_Downlight/LED_Downlight.kicad_pcb (2025-11-29)

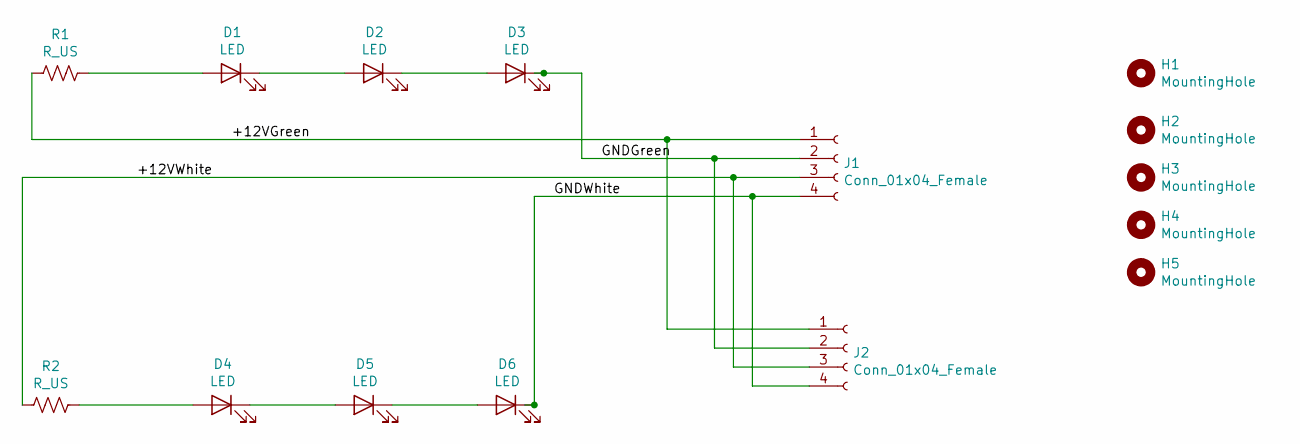
[picture p527: schematic LED_Downlight.sch]

Parts:
D1, D2, D3, D4, D5, D6: LED; LED_D8.0mm-LargePins
H1, H2, H3, H4, H5: MountingHole; MountingHole_3.2mm_M3
J1, J2: Conn_01x04_Female; PinHeader_1x04_P2.54mm_Horizontal
R1, R2: R_US; R_Axial_DIN0207_L6.3mm_D2.5mm_P7.62mm_Horizontal

Connections:
/+12VGreen: J1.1, J2.1, R1.1
/+12VWhite: J1.3, J2.3, R2.1
/GNDGreen: D3.1 (K), J1.2, J2.2
/GNDWhite: D6.1 (K), J1.4, J2.4
unnamed: D1.1 (K), D2.2 (A)
unnamed: D1.2 (A), R1.2
unnamed: D2.1 (K), D3.2 (A)
unnamed: D4.1 (K), D5.2 (A)
unnamed: D4.2 (A), R2.2
unnamed: D5.1 (K), D6.2 (A)

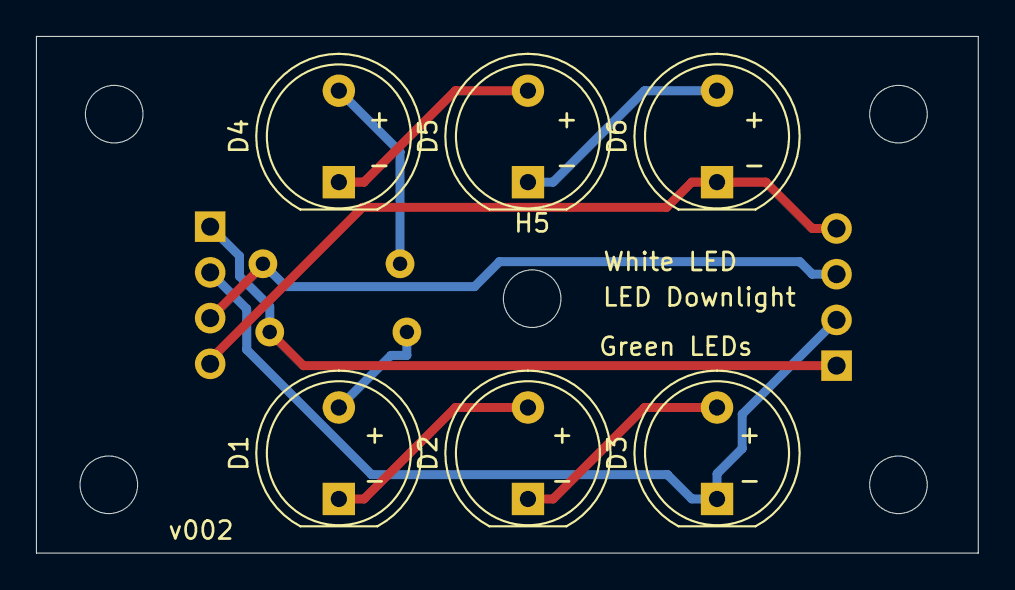
[picture p528: board LED_Downlight.kicad_pcb from above]

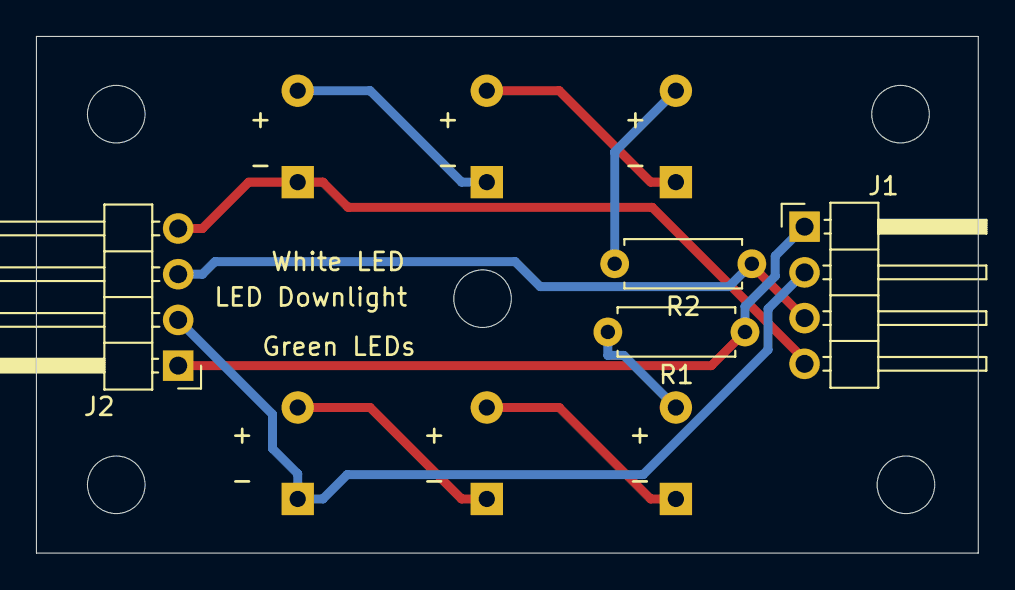
[picture p529: board LED_Downlight.kicad_pcb from below]

Board: 2 copper layers, 52.3 x 28.7 mm, 15 parts (4 on the bottom side), 10 nets.
