bnepethomas/bne-arduino-flight-simulator-interfaces/Hornet/Hornet PCBs/Active/AMPCD_button_board/Buttons_AMPCD.kicad_pcb

## KiCad design Hornet/Hornet PCBs/Active/AMPCD_button_board/Buttons_AMPCD.kicad_pcb (2025-11-29)

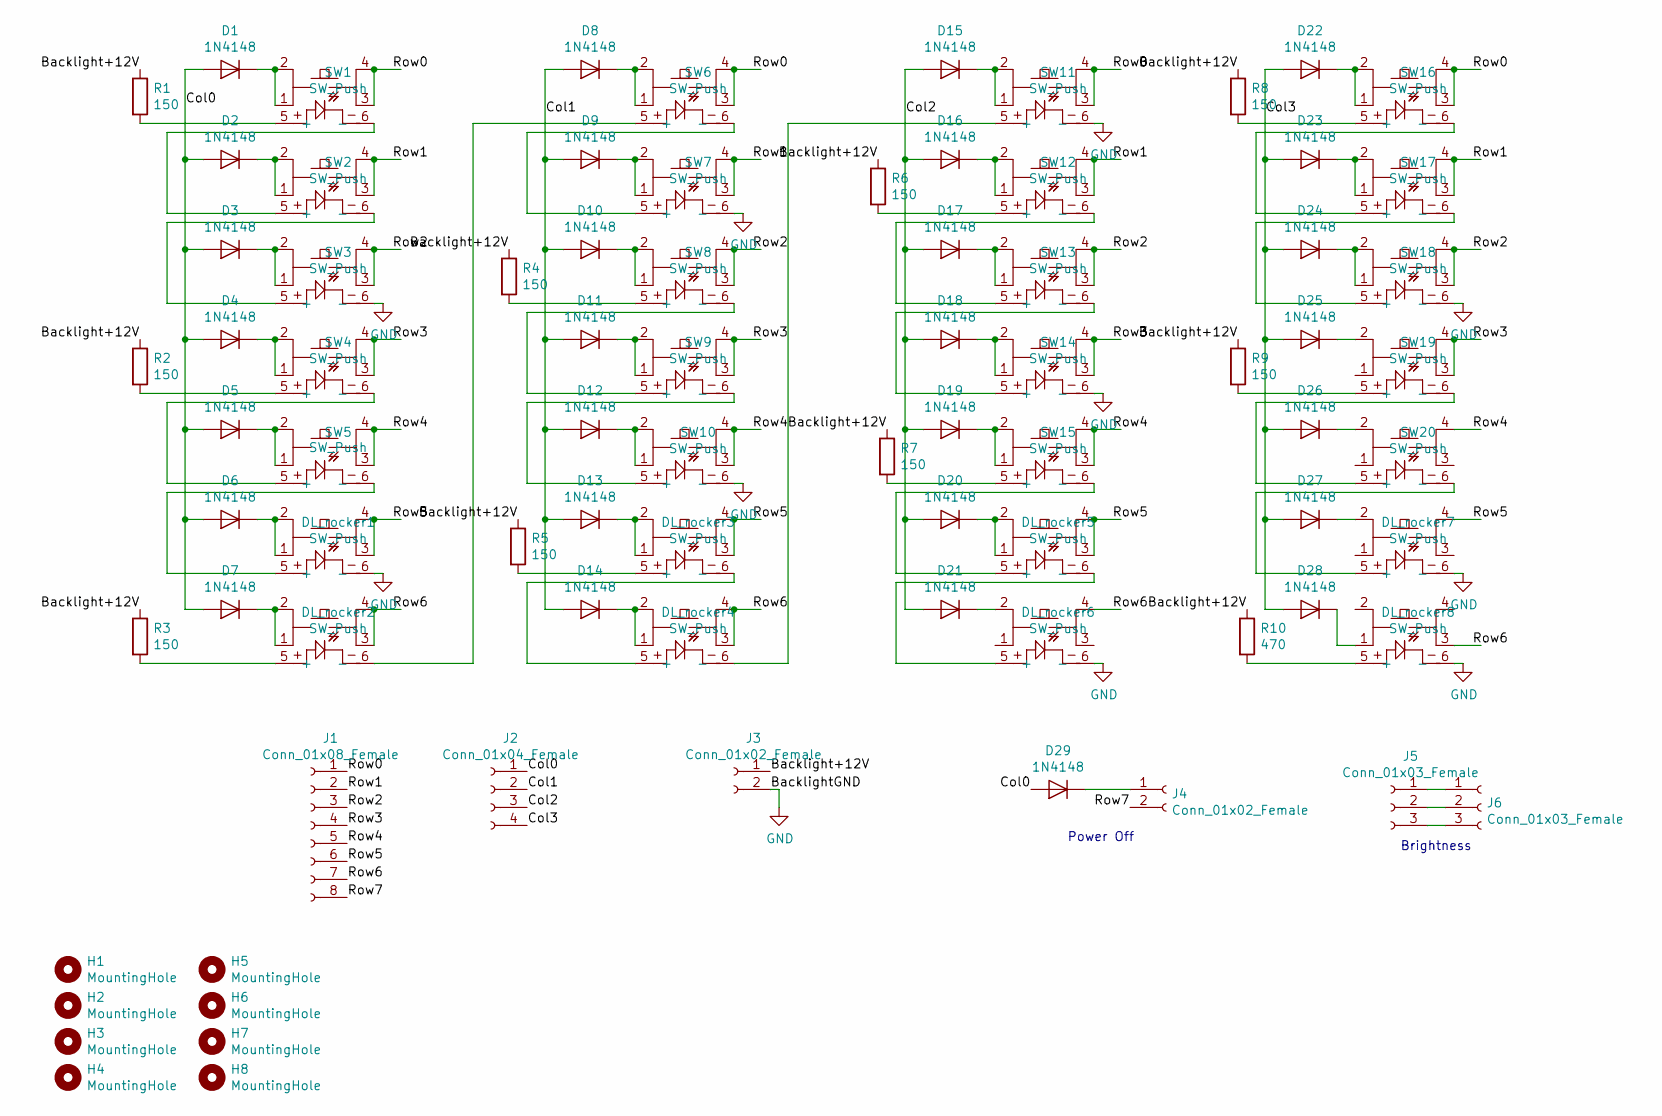
[picture p530: schematic Buttons_AMPCD.sch]

Parts:
D1, D2, D3, D4, D5, D6, D7, D8, D9, D10, D11, D12, D13, D14, D15, D16, D17, D18, D19, D20, D21, D22, D23, D24, D25, D26, D27, D28, D29: 1N4148; D_DO-35_SOD27_P7.62mm_Horizontal
DL_rocker1, DL_rocker2, DL_rocker3, DL_rocker4, DL_rocker5, DL_rocker6, DL_rocker7, DL_rocker8: SW_Push; PT_Small_Tactile_Switch_With_LED
H1, H2, H3, H4, H5, H6, H7, H8: MountingHole; MountingHole_2.5mm
J1: Conn_01x08_Female; Molex_1x08_P2.54mm_Vertical
J2: Conn_01x04_Female; Molex_1x04_P2.54mm_Vertical
J3, J4: Conn_01x02_Female; Molex_1x02_P2.54mm_Vertical
J5, J6: Conn_01x03_Female; Molex_1x03_P2.54mm_Vertical
R1, R2, R3, R4, R5, R6, R7, R8, R9: 150; R_Axial_DIN0207_L6.3mm_D2.5mm_P7.62mm_Horizontal
R10: 470; R_Axial_DIN0207_L6.3mm_D2.5mm_P7.62mm_Horizontal
SW1, SW2, SW3, SW4, SW5, SW6, SW7, SW8, SW9, SW10, SW11, SW12, SW13, SW14, SW15, SW16, SW17, SW18, SW19, SW20: SW_Push; PT_Small_Tactile_Switch_With_LED

Connections:
/Backlight+12V: J3.1, R1.1, R2.1, R3.1, R4.1, R5.1, R6.1, R7.1, R8.1, R9.1, R10.1
/Col0: D1.2 (A), D2.2 (A), D3.2 (A), D4.2 (A), D5.2 (A), D6.2 (A), D7.2 (A), D29.2 (A), J2.1
/Col1: D8.2 (A), D9.2 (A), D10.2 (A), D11.2 (A), D12.2 (A), D13.2 (A), D14.2 (A), J2.2
/Col2: D15.2 (A), D16.2 (A), D17.2 (A), D18.2 (A), D19.2 (A), D20.2 (A), D21.2 (A), J2.3
/Col3: D22.2 (A), D23.2 (A), D24.2 (A), D25.2 (A), D26.2 (A), D27.2 (A), D28.2 (A), J2.4
/Row0: J1.1, SW1.3, SW1.4, SW6.3, SW6.4, SW11.3, SW11.4, SW16.3, SW16.4
/Row1: J1.2, SW2.3, SW2.4, SW7.3, SW7.4, SW12.3, SW12.4, SW17.3, SW17.4
/Row2: J1.3, SW3.3, SW3.4, SW8.3, SW8.4, SW13.3, SW13.4, SW18.3, SW18.4
/Row3: J1.4, SW4.3, SW4.4, SW9.3, SW9.4, SW14.3, SW14.4, SW19.3, SW19.4
/Row4: J1.5, SW5.3, SW5.4, SW10.3, SW10.4, SW15.3, SW15.4, SW20.4
/Row5: DL_rocker1.3, DL_rocker1.4, DL_rocker3.3, DL_rocker3.4, DL_rocker5.3, DL_rocker5.4, DL_rocker7.4, J1.6
/Row6: DL_rocker2.3, DL_rocker2.4, DL_rocker4.3, DL_rocker4.4, DL_rocker6.4, DL_rocker8.3, J1.7
/Row7: J1.8, J4.2
GND: DL_rocker1.6 (-), DL_rocker6.6 (-), DL_rocker7.6 (-), DL_rocker8.6 (-), J3.2, SW3.6 (-), SW7.6 (-), SW10.6 (-), SW11.6 (-), SW14.6 (-), SW18.6 (-)
unnamed: D1.1 (K), SW1.1, SW1.2
unnamed: D2.1 (K), SW2.1, SW2.2
unnamed: D3.1 (K), SW3.1, SW3.2
unnamed: D4.1 (K), SW4.1, SW4.2
unnamed: D5.1 (K), SW5.1, SW5.2
unnamed: D6.1 (K), DL_rocker1.1, DL_rocker1.2
unnamed: D7.1 (K), DL_rocker2.1, DL_rocker2.2
unnamed: D8.1 (K), SW6.1, SW6.2
unnamed: D9.1 (K), SW7.1, SW7.2
unnamed: D10.1 (K), SW8.1, SW8.2
unnamed: D11.1 (K), SW9.1, SW9.2
unnamed: D12.1 (K), SW10.1, SW10.2
unnamed: D13.1 (K), DL_rocker3.1, DL_rocker3.2
unnamed: D14.1 (K), DL_rocker4.1, DL_rocker4.2
unnamed: D15.1 (K), SW11.1, SW11.2
unnamed: D16.1 (K), SW12.1, SW12.2
unnamed: D17.1 (K), SW13.1, SW13.2
unnamed: D18.1 (K), SW14.1, SW14.2
unnamed: D19.1 (K), SW15.1, SW15.2
unnamed: D20.1 (K), DL_rocker5.1, DL_rocker5.2
unnamed: D21.1 (K), DL_rocker6.2
unnamed: D22.1 (K), SW16.1, SW16.2
unnamed: D23.1 (K), SW17.1, SW17.2
unnamed: D24.1 (K), SW18.1, SW18.2
unnamed: D25.1 (K), SW19.2
unnamed: D26.1 (K), SW20.2
unnamed: D27.1 (K), DL_rocker7.2
unnamed: D28.1 (K), DL_rocker8.1
unnamed: D29.1 (K), J4.1
unnamed: DL_rocker1.5 (+), SW5.6 (-)
unnamed: DL_rocker2.5 (+), R3.2
unnamed: DL_rocker2.6 (-), SW6.5 (+)
unnamed: DL_rocker3.5 (+), R5.2
unnamed: DL_rocker3.6 (-), DL_rocker4.5 (+)
unnamed: DL_rocker4.6 (-), SW11.5 (+)
unnamed: DL_rocker5.5 (+), SW15.6 (-)
unnamed: DL_rocker5.6 (-), DL_rocker6.5 (+)
unnamed: DL_rocker7.5 (+), SW20.6 (-)
unnamed: DL_rocker8.5 (+), R10.2
unnamed: J5.1, J6.1
unnamed: J5.2, J6.2
unnamed: J5.3, J6.3
unnamed: R1.2, SW1.5 (+)
unnamed: R2.2, SW4.5 (+)
unnamed: R4.2, SW8.5 (+)
unnamed: R6.2, SW12.5 (+)
unnamed: R7.2, SW15.5 (+)
unnamed: R8.2, SW16.5 (+)
unnamed: R9.2, SW19.5 (+)
unnamed: SW1.6 (-), SW2.5 (+)
unnamed: SW2.6 (-), SW3.5 (+)
unnamed: SW4.6 (-), SW5.5 (+)
unnamed: SW6.6 (-), SW7.5 (+)
unnamed: SW8.6 (-), SW9.5 (+)
unnamed: SW9.6 (-), SW10.5 (+)
unnamed: SW12.6 (-), SW13.5 (+)
unnamed: SW13.6 (-), SW14.5 (+)
unnamed: SW16.6 (-), SW17.5 (+)
unnamed: SW17.6 (-), SW18.5 (+)
unnamed: SW19.6 (-), SW20.5 (+)

Notes on the sheet:
Power Off
Brightness

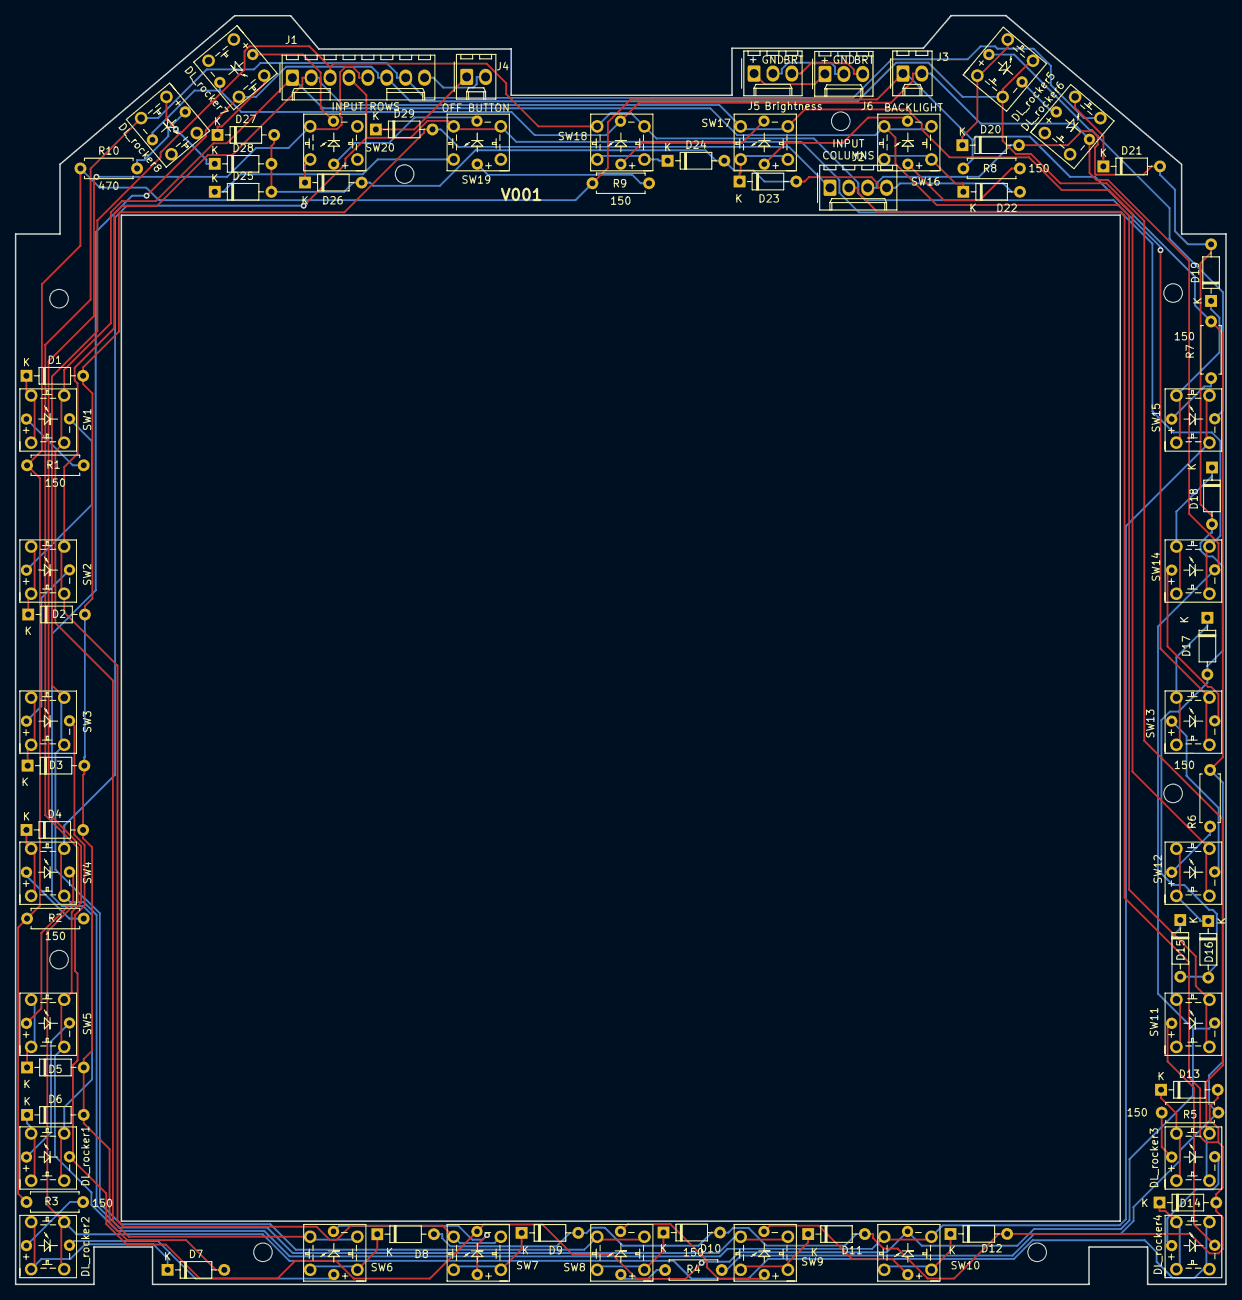
[picture p531: board Buttons_AMPCD.kicad_pcb from above]

Board: 2 copper layers, 162.8 x 170.7 mm, 81 parts (0 on the bottom side), 74 nets.
