bnepethomas/bne-arduino-flight-simulator-interfaces/A10/A10 PCBs/Z- A10 Retired PCBs/Forward Console General Output/Forward Console General Output.kicad_pcb

## KiCad design A10/A10 PCBs/Z- A10 Retired PCBs/Forward Console General Output/Forward Console General Output.kicad_pcb (2025-11-29, an earlier design)

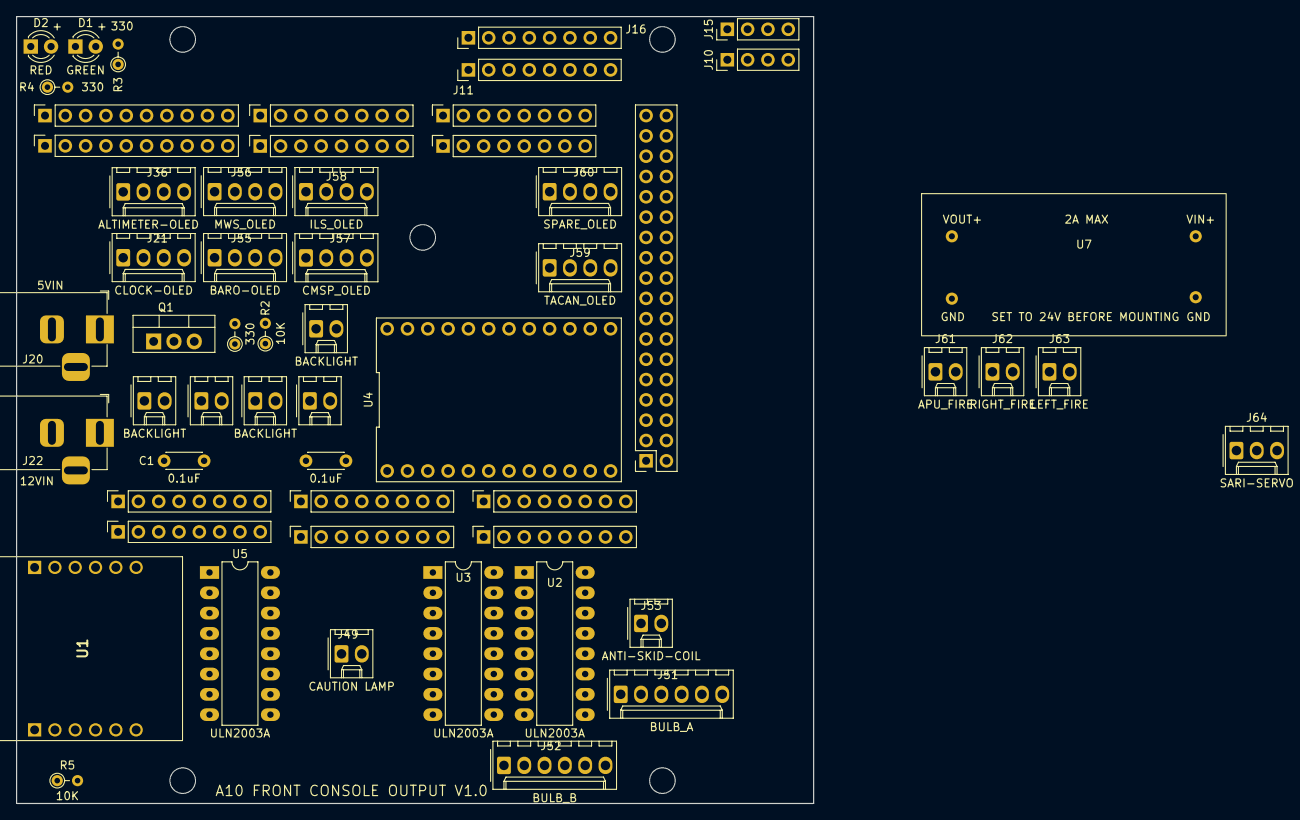
[picture p532: board Forward Console General Output.kicad_pcb from above]

Board: 2 copper layers, 99.7 x 98.4 mm, 61 parts (0 on the bottom side), 100 nets, no tracks yet.

Parts:
C1, C2: 0.1uF; C_Disc_D4.3mm_W1.9mm_P5.00mm
D1: GREEN; LED_D3.0mm
D2: RED; LED_D3.0mm
H1, H2, H3, H4: MountingHole; MountingHole_3.2mm
J3, J6, J9, J14, J19: BACKLIGHT; Molex_KK-254_AE-6410-02A_1x02_P2.54mm_Vertical
J10, J15: PATCH; PinHeader_1x04_P2.54mm_Vertical
J11, J16: PATCH; PinHeader_1x08_P2.54mm_Vertical
J20: 5VIN; BarrelJack_Horizontal
J21: CLOCK-OLED; Molex_KK-254_AE-6410-04A_1x04_P2.54mm_Vertical
J22: 12VIN; BarrelJack_Horizontal
J24, J46: PWM; PinSocket_1x10_P2.54mm_Vertical
J25, J47: PWM; PinSocket_1x08_P2.54mm_Vertical
J26, J48: Communication; PinSocket_1x08_P2.54mm_Vertical
J32, J33, J43, J44: Analog; PinSocket_1x08_P2.54mm_Vertical
J36: ALTIMETER-OLED; Molex_KK-254_AE-6410-04A_1x04_P2.54mm_Vertical
J41, J42: Power; PinSocket_1x08_P2.54mm_Vertical
J45: Digital; PinSocket_2x18_P2.54mm_Vertical
J49: CAUTION LAMP; Molex_KK-254_AE-6410-02A_1x02_P2.54mm_Vertical
J51: BULB_A; Molex_KK-254_AE-6410-06A_1x06_P2.54mm_Vertical
J52: BULB_B; Molex_KK-254_AE-6410-06A_1x06_P2.54mm_Vertical
J53: ANTI-SKID-COIL; Molex_KK-254_AE-6410-02A_1x02_P2.54mm_Vertical
J55: BARO-OLED; Molex_KK-254_AE-6410-04A_1x04_P2.54mm_Vertical
J56: MWS_OLED; Molex_KK-254_AE-6410-04A_1x04_P2.54mm_Vertical
J57: CMSP_OLED; Molex_KK-254_AE-6410-04A_1x04_P2.54mm_Vertical
J58: ILS_OLED; Molex_KK-254_AE-6410-04A_1x04_P2.54mm_Vertical
J59: TACAN_OLED; Molex_KK-254_AE-6410-04A_1x04_P2.54mm_Vertical
J60: SPARE_OLED; Molex_KK-254_AE-6410-04A_1x04_P2.54mm_Vertical
J61: APU_FIRE; Molex_KK-254_AE-6410-02A_1x02_P2.54mm_Vertical
J62: RIGHT_FIRE; Molex_KK-254_AE-6410-02A_1x02_P2.54mm_Vertical
J63: LEFT_FIRE; Molex_KK-254_AE-6410-02A_1x02_P2.54mm_Vertical
J64: SARI-SERVO; Molex_KK-254_AE-6410-03A_1x03_P2.54mm_Vertical
MH1: MountingHole_3.2mm
Q1: IRF1405PBF; TO-220-3_Vertical
R1, R3, R4: 330; R_Axial_DIN0204_L3.6mm_D1.6mm_P2.54mm_Vertical
R2, R5: 10K; R_Axial_DIN0204_L3.6mm_D1.6mm_P2.54mm_Vertical
U1: USR-ES1; USRES1
U2, U3, U5: ULN2003A; DIP-16_W7.62mm_LongPads
U4: TCA9548APWR; DIP-24_TCA9548A
U7: VIRIABLE BUCK; VARIABLE_BUCK

Connections:
+3V3: J41.4, J42.4, R5.1, U1.B2 (3V3_1), U1.B3 (3V3_2), U4.1 (VCC)
+5V: J21.1, J36.1, J41.5, J42.5, J45.35, J45.36, J55.1, J56.1, J57.1, J58.1, J59.1, J60.1
+5VD: C1.1, J20.1, J64.1
+12V: C2.1, J3.1, J6.1, J9.1, J14.1, J19.1, J22.1, J49.1, J51.1, J52.1, J53.1, U2.9 (COM), U3.9 (COM), U7.1 (VIN)
+24V: J61.1, J62.1, J63.1, U5.9 (COM), U7.4 (24V_OUT)
/*12: J24.6, J46.6, R4.1
/*13: J24.5, J46.5, R3.1
/AREF: J24.3, J46.3
/COIL AND LAMP DRIVERS/ANCHR: J52.4, U3.15 (O2)
/COIL AND LAMP DRIVERS/B_APU_FIRE: J61.2, U5.15 (O2)
/COIL AND LAMP DRIVERS/B_LEFT_FIRE: J63.2, U5.16 (O1)
/COIL AND LAMP DRIVERS/B_RIGHT_FIRE: J62.2, U5.14 (O3)
/COIL AND LAMP DRIVERS/CAUTION_LAMP-: J49.2, U2.16 (O1)
/COIL AND LAMP DRIVERS/COIL_ANTI_SKID: J53.2, U3.12 (O5)
/COIL AND LAMP DRIVERS/EGI: J51.6, U2.11 (O6)
/COIL AND LAMP DRIVERS/HARS: J51.5, U2.12 (O5)
/COIL AND LAMP DRIVERS/ILS: J52.6, U3.13 (O4)
/COIL AND LAMP DRIVERS/MISSLE LAUNCH: J51.4, U2.13 (O4)
/COIL AND LAMP DRIVERS/PRI: J51.2, U2.15 (O2)
/COIL AND LAMP DRIVERS/SEP: J51.3, U2.14 (O3)
/COIL AND LAMP DRIVERS/STR PT: J52.3, U3.16 (O1)
/COIL AND LAMP DRIVERS/TCN: J52.5, U3.14 (O3)
/COIL AND LAMP DRIVERS/TISL: J52.2, U2.10 (O7)
/IOREF: J41.2, J42.2
/OLED/SC0: J21.3, U4.10 (SC0)
/OLED/SC1: J36.3, U4.12 (SC1)
/OLED/SC2: J55.3, U4.14 (SC2)
/OLED/SC3: J56.3, U4.16 (SC3)
/OLED/SC4: J57.3, U4.18 (SC4)
/OLED/SC5: J58.3, U4.20 (SC5)
/OLED/SC6: J59.3, U4.22 (SC6)
/OLED/SC7: J60.3, U4.24 (SC7)
/OLED/SD0: J21.4, U4.9 (SD0)
/OLED/SD1: J36.4, U4.11 (SD1)
/OLED/SD2: J55.4, U4.13 (SD2)
/OLED/SD3: J56.4, U4.15 (SD3)
/OLED/SD4: J57.4, U4.17 (SD4)
/OLED/SD5: J58.4, U4.19 (SD5)
/OLED/SD6: J59.4, U4.21 (SD6)
/OLED/SD7: J60.4, U4.23 (SD7)
/RX0/0: J25.8, J47.8
/TX0/1: J25.7, J47.7
/~RESET: J41.3, J42.3
A0 D54: J32.1, J43.1, U5.1 (I1)
A1 D55: J32.2, J43.2, U5.2 (I2)
A2 D56: J32.3, J43.3, U5.3 (I3)
A3 D57: J32.4, J43.4
A4 D58: J32.5, J43.5, U2.1 (I1)
A5 D59: J32.6, J43.6, U2.2 (I2)
A6 D60: J32.7, J43.7, U2.3 (I3)
A7 D61: J32.8, J43.8, U2.4 (I4)
A8 D62: J33.1, J44.1, U2.5 (I5)
A9 D63: J33.2, J44.2, U2.6 (I6)
A10 D64: J33.3, J44.3, U2.7 (I7)
A11 D65: J33.4, J44.4, U3.1 (I1)
A12 D66: J33.5, J44.5, U3.2 (I2)
A13 D67: J33.6, J44.6, U3.3 (I3)
A14 D68: J33.7, J44.7, U3.4 (I4)
A15 D69: J33.8, J44.8, U3.5 (I5)
BACKLIGHT: J25.6, J47.6, R1.2
BACKLIGHT_-V: J3.2, J6.2, J9.2, J14.2, J19.2, Q1.2 (D)
D3: J25.5, J47.5
D4: J25.4, J47.4
D5: J25.3, J47.3
D6: J25.2, J47.2
D7: J25.1, J47.1
D8: J24.10, J46.10
D9: J24.9, J46.9
D11: J24.7, J46.7
D14: J26.1, J48.1, J64.2
D15: J26.2, J48.2
D16: J26.3, J48.3, U4.5 (~RESET)
D17: J26.4, J48.4, U4.8 (A2)
D18: J26.5, J48.5, U4.7 (A1)
D19: J26.6, J48.6, U4.6 (A0)
D20 SDA: J24.2, J26.7, J46.2, J48.7, U4.3 (SDA)
D21 SCL: J24.1, J26.8, J46.1, J48.8, U4.4 (SCL)
ES1_RST: J45.4, U1.B5 (RST)
GND: C1.2, C2.2, D1.1 (K), D2.1 (K), J20.2, J21.2, J22.2, J24.4, J36.2, J41.6, J41.7, J42.6, J42.7, J45.1, J45.2, J46.4, J55.2, J56.2, J57.2, J58.2, J59.2, J60.2, J64.3, Q1.3 (S), R2.1, U1.A1 (GND_1), U1.A2 (GND_2), U1.B1 (GND_3), U2.8 (GND), U3.6 (I6), U3.7 (I7), U3.8 (GND), U4.2 (GND), U5.6 (I6), U5.7 (I7), U5.8 (GND), U7.2 (GND), U7.3 (GND)
MISO: J45.5, U1.B6 (MISO)
MOSI: J45.6, U1.A3 (MOSI)
unnamed: D1.2 (A), R3.2
unnamed: D2.2 (A), R4.2
unnamed: J10.1, J15.1
unnamed: J10.2, J15.2
unnamed: J10.3, J15.3
unnamed: J10.4, J15.4
unnamed: J11.1, J16.1
unnamed: J11.2, J16.2
unnamed: J11.3, J16.3
unnamed: J11.4, J16.4
unnamed: J11.5, J16.5
unnamed: J11.6, J16.6
unnamed: J11.7, J16.7
unnamed: J11.8, J16.8
unnamed: Q1.1 (G), R1.1, R2.2
unnamed: R5.2, U1.A6 (INT)
SCLK: J45.3, U1.A4 (SCLK)
SS: J24.8, J46.8, U1.A5 (CS)
VCC: J41.8, J42.8
