bnepethomas/bne-arduino-flight-simulator-interfaces/Hornet/Hornet PCBs/Active/OH - Left Console - 7 - Communication Panel/OH - Left Console - 7 - Communication Panel.kicad_pcb

## KiCad design Hornet/Hornet PCBs/Active/OH - Left Console - 7 - Communication Panel/OH - Left Console - 7 - Communication Panel.kicad_pcb (2025-11-29)

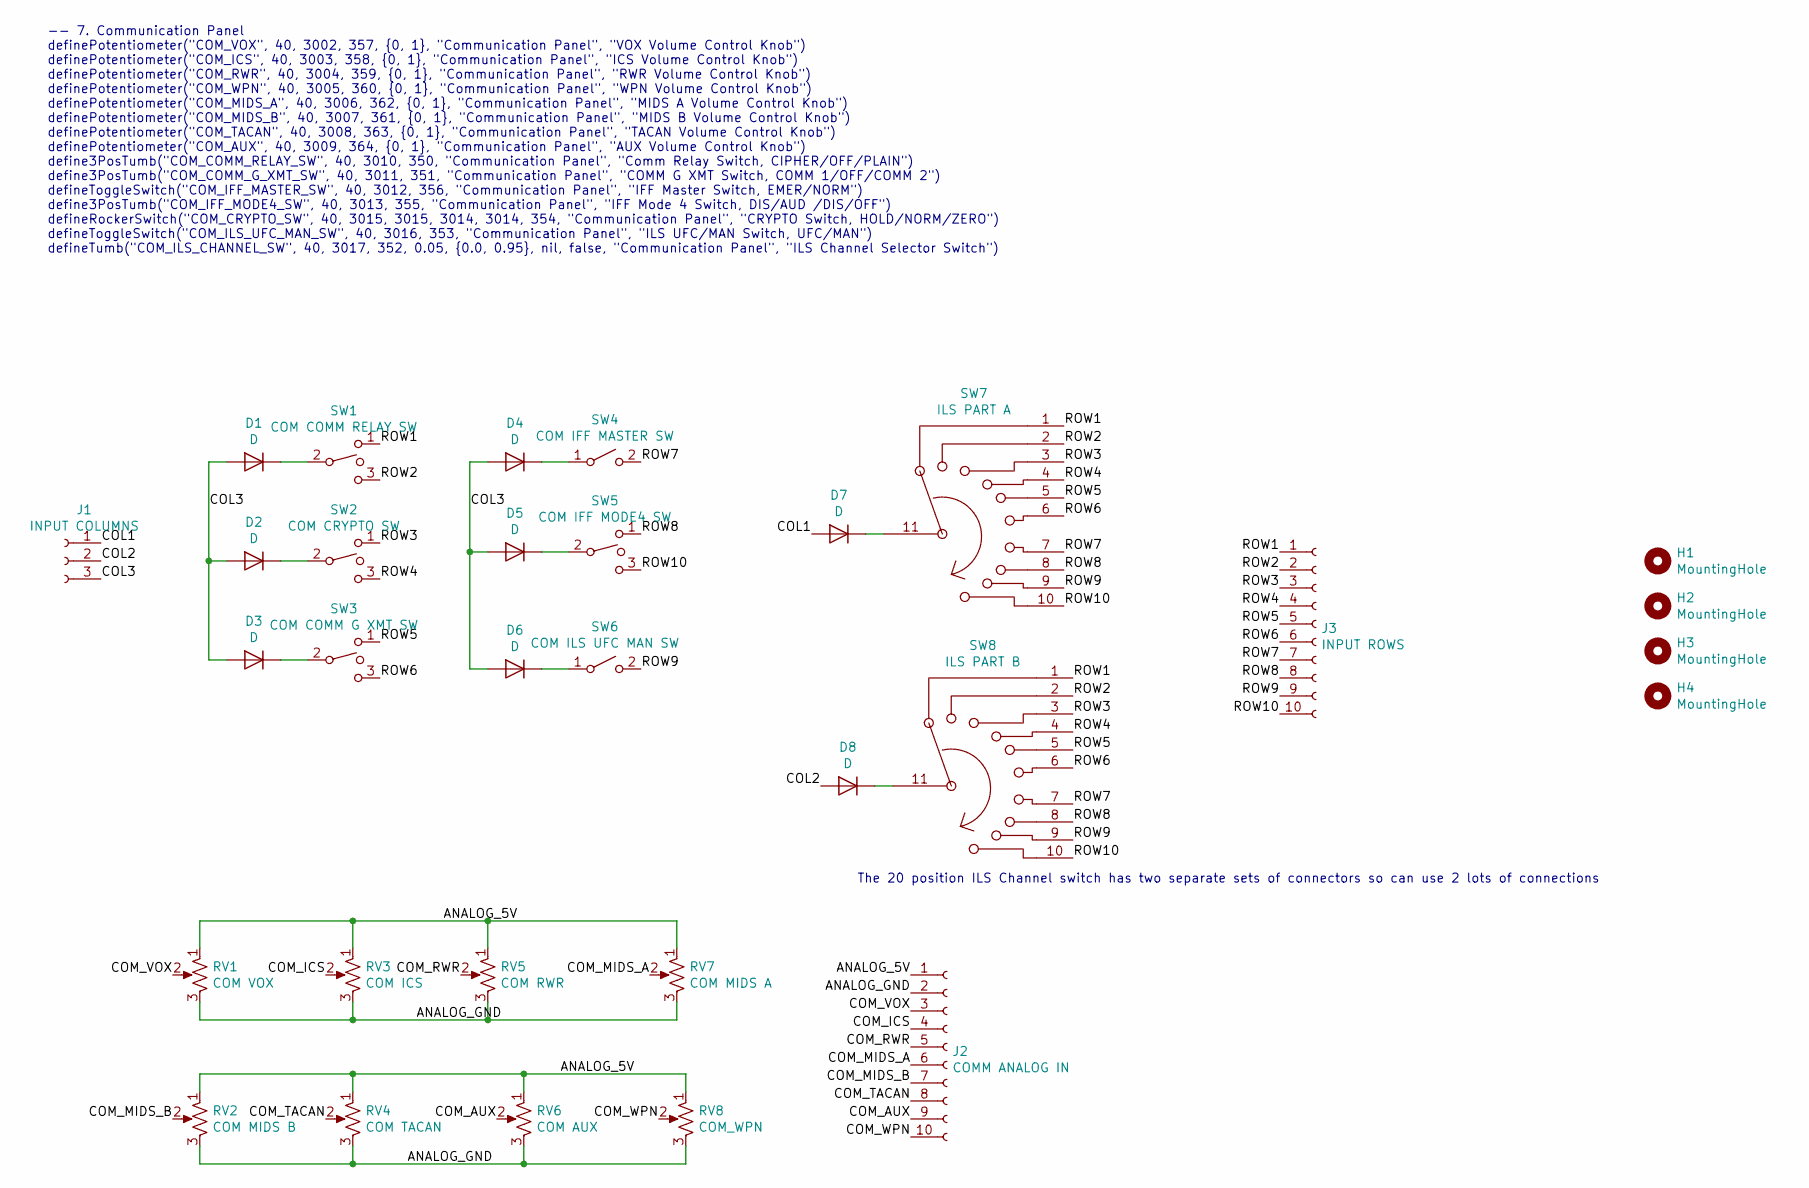
[picture p533: schematic OH - Left Console - 7 - Communication Panel.sch]

Parts:
D1, D2, D3, D4, D5, D6, D7, D8: D; D_Signal_P7.62mm_Horizontal
H1, H2, H3, H4: MountingHole; MountingHole_3.2mm_M3
J1: INPUT COLUMNS; Molex_1x03_P2.54mm_Vertical
J2: COMM ANALOG IN; Molex_1x10_P2.54mm_Vertical
J3: INPUT ROWS; Molex_1x10_P2.54mm_Vertical
RV1: COM VOX; Molex_1x03_P2.54mm_Vertical
RV2: COM MIDS B; Molex_1x03_P2.54mm_Vertical
RV3: COM ICS; Molex_1x03_P2.54mm_Vertical
RV4: COM TACAN; Molex_1x03_P2.54mm_Vertical
RV5: COM RWR; Molex_1x03_P2.54mm_Vertical
RV6: COM AUX; Molex_1x03_P2.54mm_Vertical
RV7: COM MIDS A; Molex_1x03_P2.54mm_Vertical
RV8: COM_WPN; Molex_1x03_P2.54mm_Vertical
SW1: COM COMM RELAY SW; Molex_1x03_P2.54mm_Vertical
SW2: COM CRYPTO SW; Molex_1x03_P2.54mm_Vertical
SW3: COM COMM G XMT SW; Molex_1x03_P2.54mm_Vertical
SW4: COM IFF MASTER SW; Molex_1x02_P2.54mm_Vertical
SW5: COM IFF MODE4 SW; Molex_1x03_P2.54mm_Vertical
SW6: COM ILS UFC MAN SW; Molex_1x02_P2.54mm_Vertical
SW7: ILS PART A; Molex_KK-254_AE-6410-12A_1x12_P2.54mm_Vertical
SW8: ILS PART B; Molex_KK-254_AE-6410-12A_1x12_P2.54mm_Vertical

Connections:
/ANALOG_5V: J2.1, RV1.1, RV2.1, RV3.1, RV4.1, RV5.1, RV6.1, RV7.1, RV8.1
/ANALOG_GND: J2.2, RV1.3, RV2.3, RV3.3, RV4.3, RV5.3, RV6.3, RV7.3, RV8.3
/COL1: D7.2 (A), J1.1
/COL2: D8.2 (A), J1.2
/COL3: D1.2 (A), D2.2 (A), D3.2 (A), D4.2 (A), D5.2 (A), D6.2 (A), J1.3
/COM_AUX: J2.9, RV6.2
/COM_ICS: J2.4, RV3.2
/COM_MIDS_A: J2.6, RV7.2
/COM_MIDS_B: J2.7, RV2.2
/COM_RWR: J2.5, RV5.2
/COM_TACAN: J2.8, RV4.2
/COM_VOX: J2.3, RV1.2
/COM_WPN: J2.10, RV8.2
/ROW1: J3.1, SW1.1, SW7.1, SW8.1
/ROW2: J3.2, SW1.3, SW7.2, SW8.2
/ROW3: J3.3, SW2.1, SW7.3, SW8.3
/ROW4: J3.4, SW2.3, SW7.4, SW8.4
/ROW5: J3.5, SW3.1, SW7.5, SW8.5
/ROW6: J3.6, SW3.3, SW7.6, SW8.6
/ROW7: J3.7, SW4.2 (B), SW7.7, SW8.7
/ROW8: J3.8, SW5.1, SW7.8, SW8.8
/ROW9: J3.9, SW6.2 (B), SW7.9, SW8.9
/ROW10: J3.10, SW5.3, SW7.10, SW8.10
unnamed: D1.1 (K), SW1.2
unnamed: D2.1 (K), SW2.2
unnamed: D3.1 (K), SW3.2
unnamed: D4.1 (K), SW4.1 (A)
unnamed: D5.1 (K), SW5.2
unnamed: D6.1 (K), SW6.1 (A)
unnamed: D7.1 (K), SW7.11
unnamed: D8.1 (K), SW8.11

Notes on the sheet:
-- 7. Communication Panel definePotentiometer("COM_VOX", 40, 3002, 357, {0, 1}, "Communication Panel", "VOX Volume Control Knob") definePotentiometer("COM_ICS", 40, 3003, 358, {0, 1}, "Communication Panel", "ICS Volume Control Knob") definePotentiometer("COM_RWR", 40, 3004, 359, {0, 1}, "Communicat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
The 20 position ILS Channel switch has two separate sets of connectors so can use 2 lots of connections

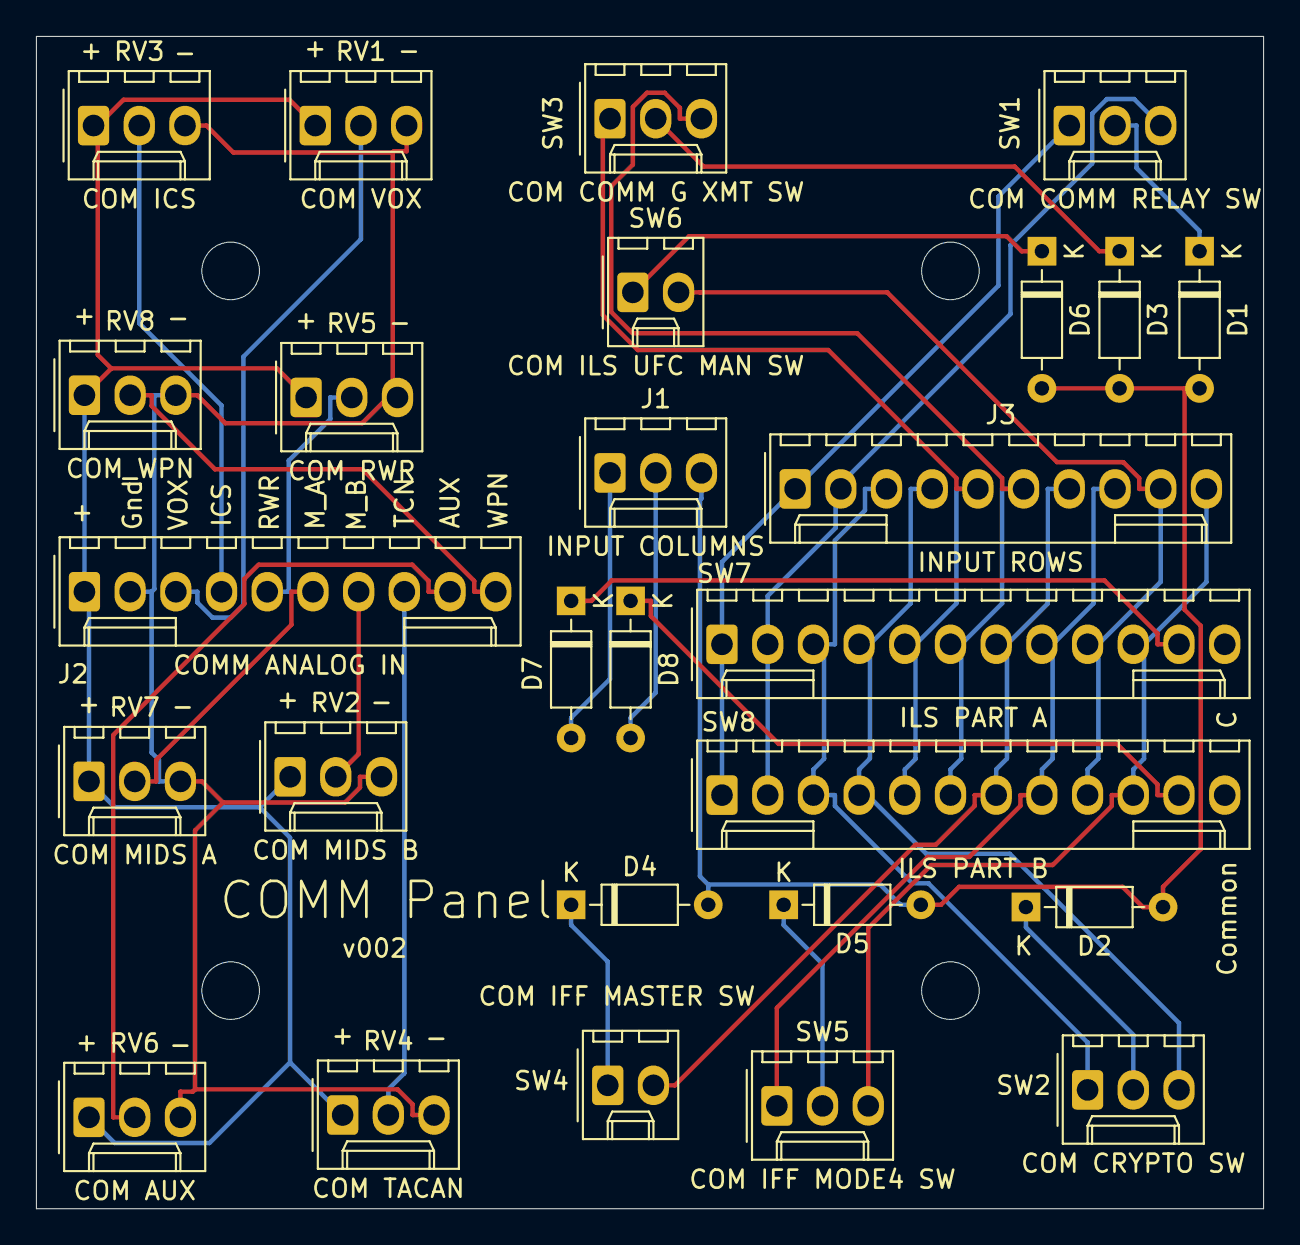
[picture p534: board OH - Left Console - 7 - Communication Panel.kicad_pcb from above]

Board: 2 copper layers, 68.2 x 65.2 mm, 31 parts (0 on the bottom side), 31 nets.
