bnepethomas/bne-arduino-flight-simulator-interfaces/A10/A10 PCBs/General Use/Potentiometer Mount Type 2/Potentiometer Mount Type 2.kicad_pcb

## KiCad design A10/A10 PCBs/General Use/Potentiometer Mount Type 2/Potentiometer Mount Type 2.kicad_pcb (2025-11-29)

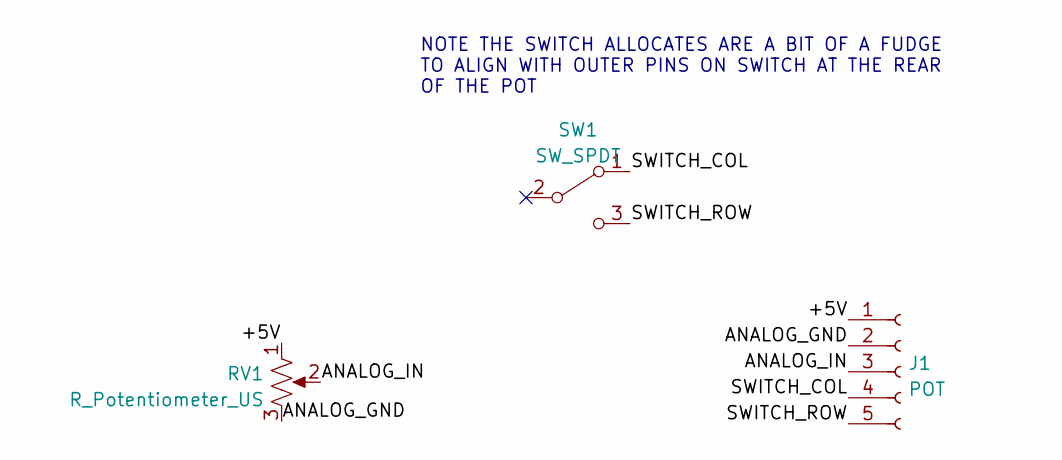
[picture p535: schematic Potentiometer Mount Type 2.kicad_sch]

Parts:
J1: POT; Molex_KK-254_AE-6410-05A_1x05_P2.54mm_Vertical
RV1: R_Potentiometer_US; PinHeader_1x03_P2.54mm_Vertical
SW1: SW_SPDT; PinHeader_1x03_P2.54mm_Vertical

Connections:
/+5V: J1.1, RV1.1
/ANALOG_GND: J1.2, RV1.3
/ANALOG_IN: J1.3, RV1.2
/SWITCH_COL: J1.4, SW1.1 (A)
/SWITCH_ROW: J1.5, SW1.3 (C)

Notes on the sheet:
NOTE THE SWITCH ALLOCATES ARE A BIT OF A FUDGE TO ALIGN WITH OUTER PINS ON SWITCH AT THE REAR OF THE POT

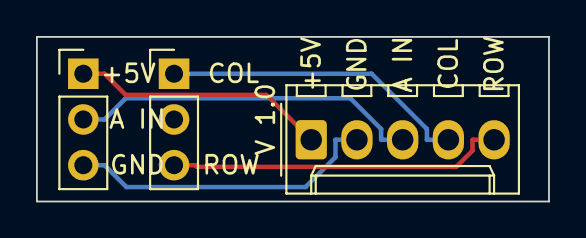
[picture p536: board Potentiometer Mount Type 2.kicad_pcb from above]

Board: 2 copper layers, 28.4 x 9.1 mm, 3 parts (0 on the bottom side), 5 nets.
