bnepethomas/bne-arduino-flight-simulator-interfaces/Hornet/Hornet PCBs/Active/OH - General Purpose Small PCB/OH - General Purpose Small PCB.kicad_pcb

## KiCad design Hornet/Hornet PCBs/Active/OH - General Purpose Small PCB/OH - General Purpose Small PCB.kicad_pcb (2025-11-29)

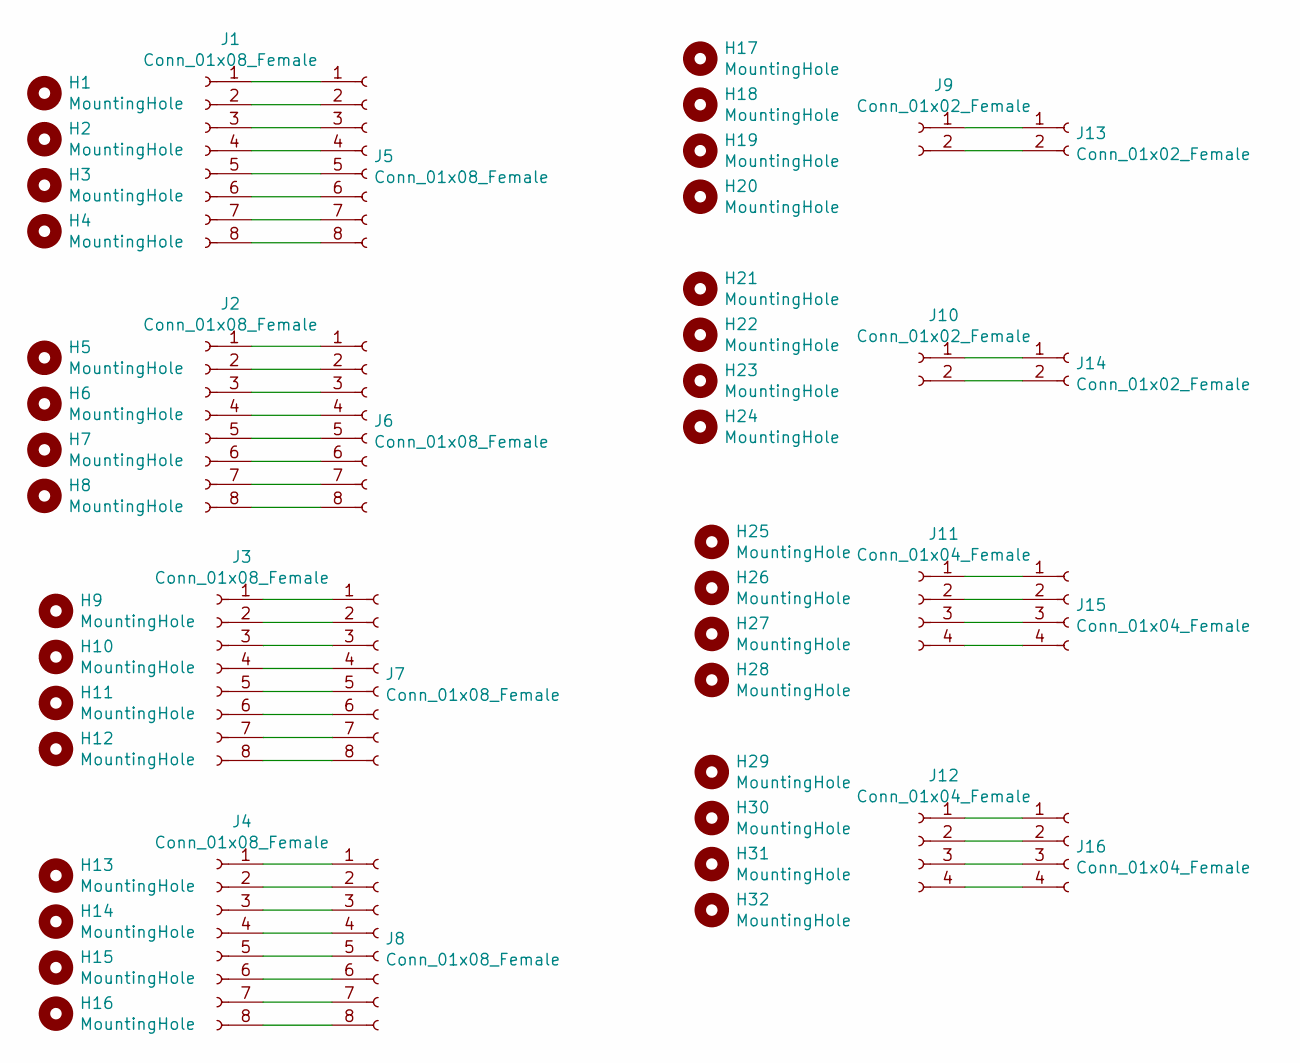
[picture p537: schematic OH - General Purpose Small PCB.sch]

Parts:
H1, H2, H3, H4, H5, H6, H7, H8, H9, H10, H11, H12, H13, H14, H15, H16, H17, H18, H19, H20, H21, H22, H23, H24, H25, H26, H27, H28, H29, H30, H31, H32: MountingHole; MountingHole_3.2mm_M3
J1, J2, J3, J4, J5, J6, J7, J8: Conn_01x08_Female; Molex_1x08_P2.54mm_Vertical
J9, J10, J13, J14: Conn_01x02_Female; Molex_1x02_P2.54mm_Vertical
J11, J12, J15, J16: Conn_01x04_Female; Molex_1x04_P2.54mm_Vertical

Connections:
unnamed: J1.1, J5.1
unnamed: J1.2, J5.2
unnamed: J1.3, J5.3
unnamed: J1.4, J5.4
unnamed: J1.5, J5.5
unnamed: J1.6, J5.6
unnamed: J1.7, J5.7
unnamed: J1.8, J5.8
unnamed: J2.1, J6.1
unnamed: J2.2, J6.2
unnamed: J2.3, J6.3
unnamed: J2.4, J6.4
unnamed: J2.5, J6.5
unnamed: J2.6, J6.6
unnamed: J2.7, J6.7
unnamed: J2.8, J6.8
unnamed: J3.1, J7.1
unnamed: J3.2, J7.2
unnamed: J3.3, J7.3
unnamed: J3.4, J7.4
unnamed: J3.5, J7.5
unnamed: J3.6, J7.6
unnamed: J3.7, J7.7
unnamed: J3.8, J7.8
unnamed: J4.1, J8.1
unnamed: J4.2, J8.2
unnamed: J4.3, J8.3
unnamed: J4.4, J8.4
unnamed: J4.5, J8.5
unnamed: J4.6, J8.6
unnamed: J4.7, J8.7
unnamed: J4.8, J8.8
unnamed: J10.1, J14.1
unnamed: J10.2, J14.2
unnamed: J11.1, J15.1
unnamed: J11.2, J15.2
unnamed: J11.3, J15.3
unnamed: J11.4, J15.4
unnamed: J12.1, J16.1
unnamed: J12.2, J16.2
unnamed: J12.3, J16.3
unnamed: J12.4, J16.4
unnamed: J9.1, J13.1
unnamed: J9.2, J13.2

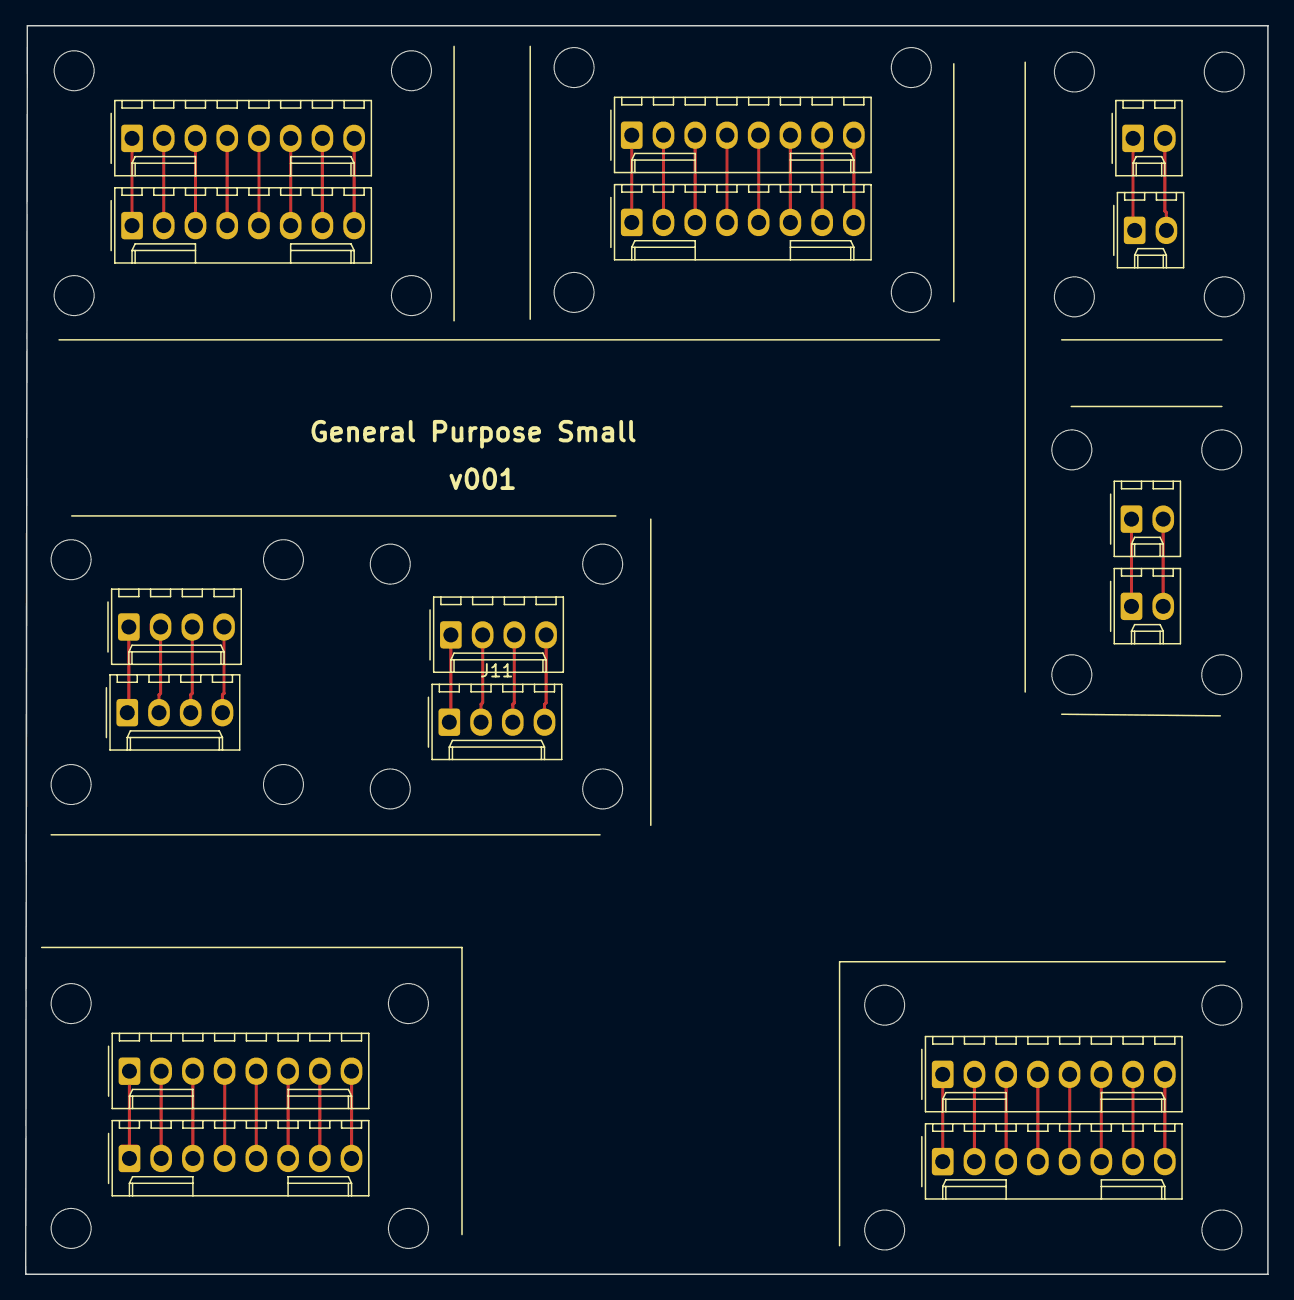
[picture p538: board OH - General Purpose Small PCB.kicad_pcb from above]

Board: 2 copper layers, 99.4 x 99.9 mm, 48 parts (0 on the bottom side), 44 nets.
