bnepethomas/bne-arduino-flight-simulator-interfaces/A10/A10 PCBs/Left Console Individual PCBs/INTERCOMM/INTERCOMM.kicad_pcb

## KiCad design A10/A10 PCBs/Left Console Individual PCBs/INTERCOMM/INTERCOMM.kicad_pcb (2025-11-29)

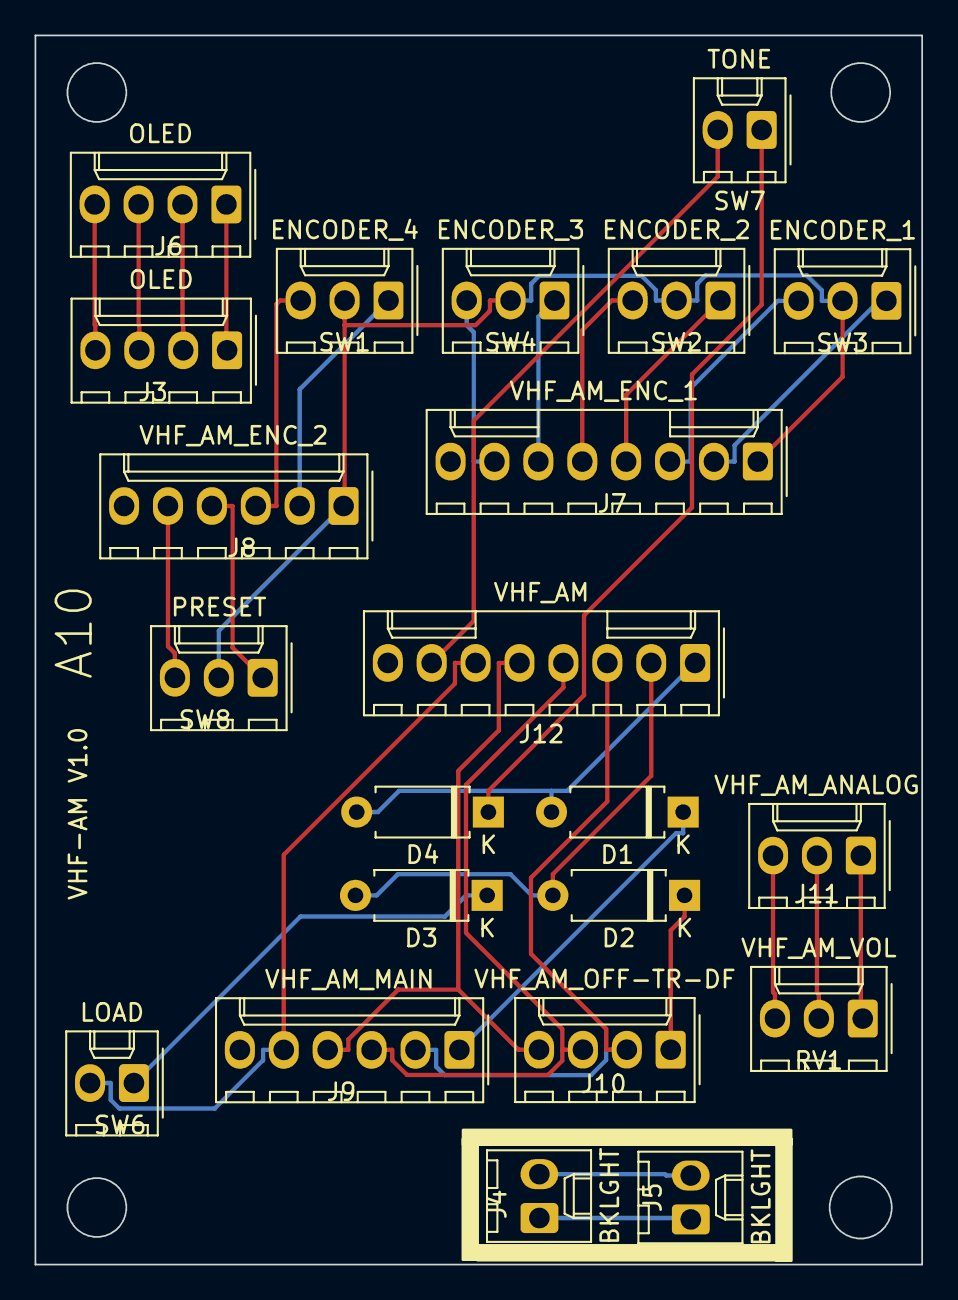
[picture p539: board INTERCOMM.kicad_pcb from above]

Board: 2 copper layers, 51.3 x 71.1 mm, 22 parts (0 on the bottom side), 31 nets.

Parts:
D1, D2, D3, D4: D; D_A-405_P7.62mm_Horizontal
J3, J6: OLED; Molex_KK-254_AE-6410-04A_1x04_P2.54mm_Vertical
J4, J5: BKLGHT; Molex_KK-254_AE-6410-02A_1x02_P2.54mm_Vertical
J7: VHF_AM_ENC_1; Molex_KK-254_AE-6410-08A_1x08_P2.54mm_Vertical
J8: VHF_AM_ENC_2; Molex_KK-254_AE-6410-06A_1x06_P2.54mm_Vertical
J9: VHF_AM_MAIN; Molex_KK-254_AE-6410-06A_1x06_P2.54mm_Vertical
J10: VHF_AM_OFF-TR-DF; Molex_KK-254_AE-6410-04A_1x04_P2.54mm_Vertical
J11: VHF_AM_ANALOG; Molex_KK-254_AE-6410-03A_1x03_P2.54mm_Vertical
J12: VHF_AM; Molex_KK-254_AE-6410-08A_1x08_P2.54mm_Vertical
RV1: VHF_AM_VOL; Molex_KK-254_AE-6410-03A_1x03_P2.54mm_Vertical
SW1: ENCODER_4; Molex_KK-254_AE-6410-03A_1x03_P2.54mm_Vertical
SW2: ENCODER_2; Molex_KK-254_AE-6410-03A_1x03_P2.54mm_Vertical
SW3: ENCODER_1; Molex_KK-254_AE-6410-03A_1x03_P2.54mm_Vertical
SW4: ENCODER_3; Molex_KK-254_AE-6410-03A_1x03_P2.54mm_Vertical
SW6: LOAD; Molex_KK-254_AE-6410-02A_1x02_P2.54mm_Vertical
SW7: TONE; Molex_KK-254_AE-6410-02A_1x02_P2.54mm_Vertical
SW8: PRESET; Molex_KK-254_AE-6410-03A_1x03_P2.54mm_Vertical

Connections:
/ANALOG_5V: J11.1, RV1.1
/ANALOG_GND: J11.3, RV1.3
/COL4: D1.2 (A), D4.2 (A), J12.1
/COL5: D2.2 (A), D3.2 (A), J12.2
/ROW0: J9.2, J10.2, J12.3
/ROW1: J9.3, J10.3, J12.4
/ROW2: J9.4, J10.4, J12.5
/ROW3: J9.5, J12.6, SW6.2
/ROW4: J12.7, SW7.2
/VHF_AM_VOL: J11.2, RV1.2
/VHF__AM_ENC_1_A: J7.2, SW3.1
/VHF__AM_ENC_1_B: J7.3, SW3.3
/VHF__AM_ENC_2_A: J7.4, SW2.1
/VHF__AM_ENC_2_B: J7.5, SW2.3
/VHF__AM_ENC_3_A: J7.6, SW4.1
/VHF__AM_ENC_3_B: J7.7, SW4.3
/VHF__AM_ENC_4_A: J8.2, SW1.1
/VHF__AM_ENC_4_B: J8.3, SW1.3
/VHF__AM_PRESET_A: J8.4, SW8.1
/VHF__AM_PRESET_B: J8.5, SW8.3
GND: J7.1, J8.1, SW1.2, SW2.2, SW3.2, SW4.2, SW8.2
unnamed: D1.1 (K), J9.1
unnamed: D2.1 (K), J10.1
unnamed: D3.1 (K), SW6.1
unnamed: D4.1 (K), SW7.1
unnamed: J3.1, J6.1
unnamed: J3.2, J6.2
unnamed: J3.3, J6.3
unnamed: J3.4, J6.4
unnamed: J4.1, J5.1
unnamed: J4.2, J5.2
