bnepethomas/bne-arduino-flight-simulator-interfaces/Hornet/Hornet PCBs/Active/ddi_button_board/Buttons_DDI.kicad_pcb

## KiCad design Hornet/Hornet PCBs/Active/ddi_button_board/Buttons_DDI.kicad_pcb (2025-11-29)

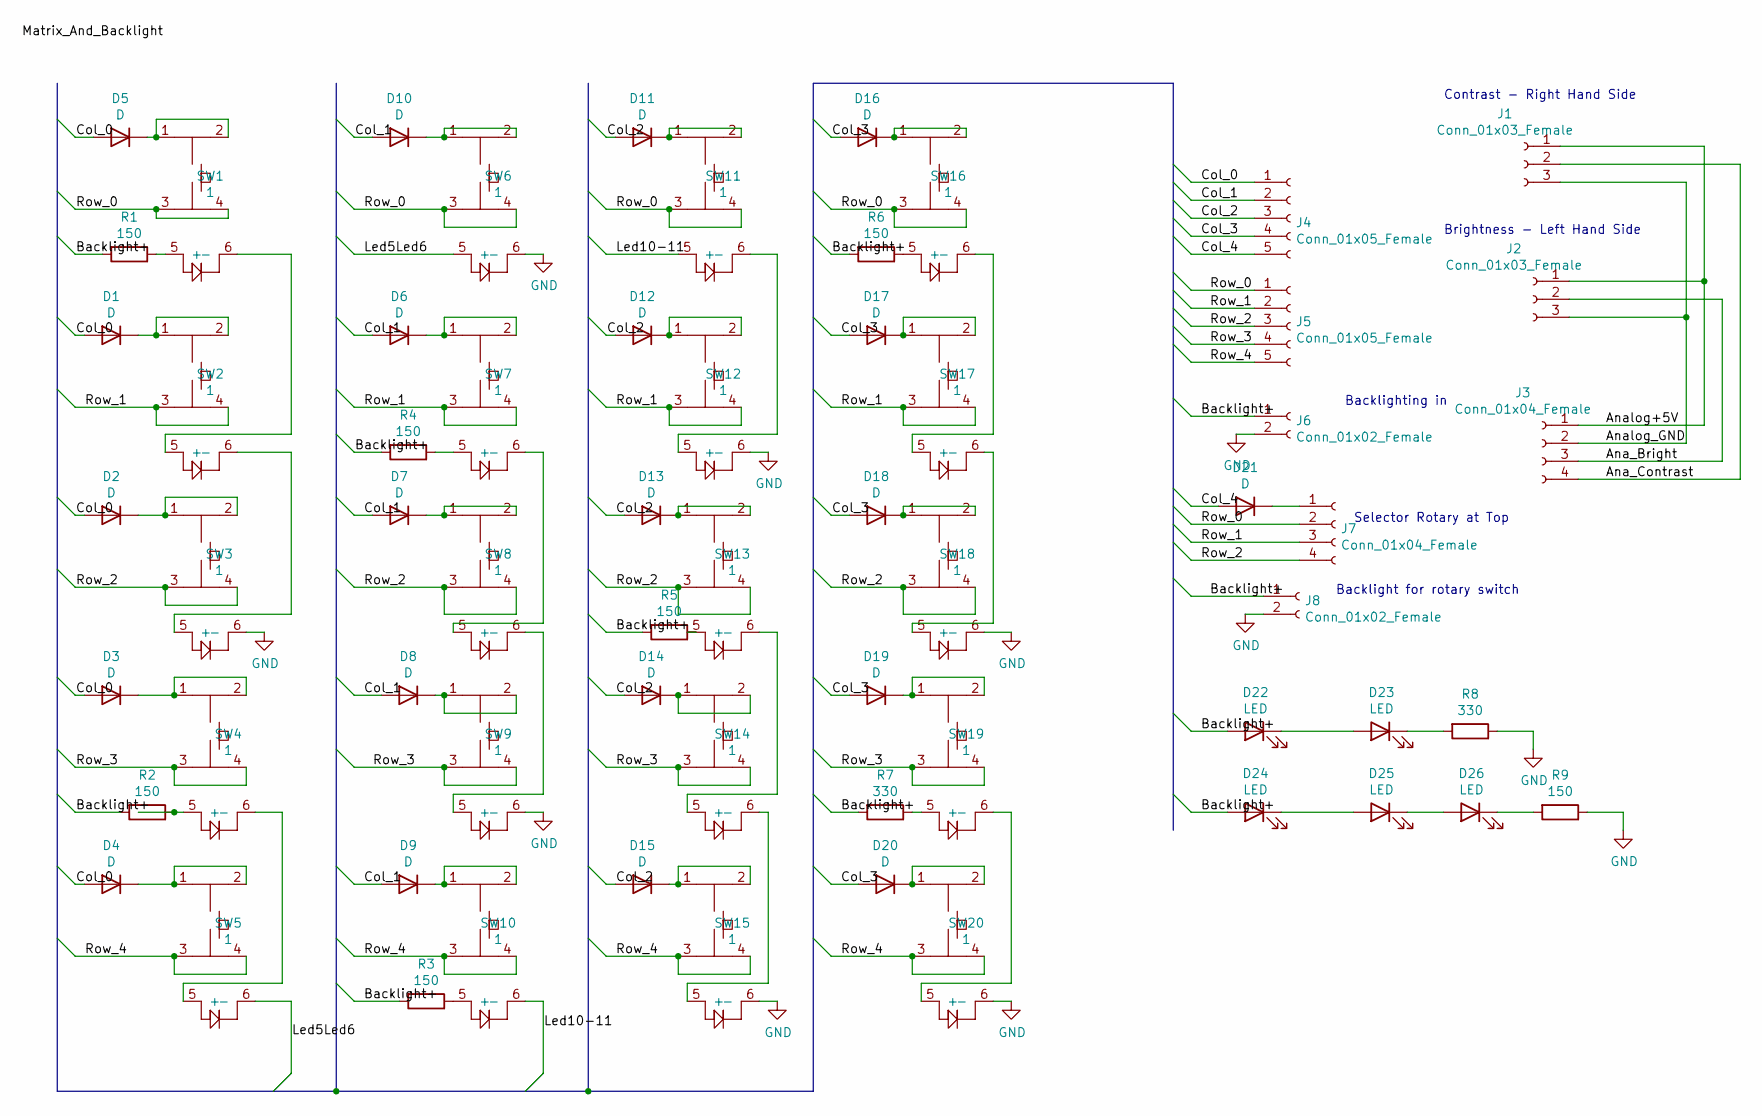
[picture p540: schematic Buttons_DDI.sch]

Parts:
D1, D2, D3, D4, D5, D6, D7, D8, D9, D10, D11, D12, D13, D14, D15, D16, D17, D18, D19, D20, D21: D; D_A-405_P7.62mm_Horizontal
D22, D23, D24, D25, D26: LED; LED_D3.0mm
J1, J2: Conn_01x03_Female; PinHeader_1x03_P2.54mm_Vertical
J3, J7: Conn_01x04_Female; PinHeader_1x04_P2.54mm_Vertical
J4, J5: Conn_01x05_Female; PinHeader_1x05_P2.54mm_Vertical
J6, J8: Conn_01x02_Female; PinHeader_1x02_P2.54mm_Vertical
R1, R2, R3, R4, R5, R6, R9: 150; R_Axial_DIN0207_L6.3mm_D2.5mm_P7.62mm_Horizontal
R7, R8: 330; R_Axial_DIN0207_L6.3mm_D2.5mm_P7.62mm_Horizontal
SW1, SW2, SW3, SW4, SW5, SW6, SW7, SW8, SW9, SW10, SW11, SW12, SW13, SW14, SW15, SW16, SW17, SW18, SW19, SW20: 1; PT_Small_Tactile_Switch_With_LED

Connections:
/Ana_Bright: J2.2, J3.3
/Ana_Contrast: J1.2, J3.4
/Analog+5V: J1.1, J2.1, J3.1
/Analog_GND: J1.3, J2.3, J3.2
/Backlight+: D22.2 (A), D24.2 (A), J6.1, J8.1, R1.2, R2.2, R3.2, R4.2, R5.2, R6.2, R7.2
/Col_0: D1.2 (A), D2.2 (A), D3.2 (A), D4.2 (A), D5.2 (A), J4.1
/Col_1: D6.2 (A), D7.2 (A), D8.2 (A), D9.2 (A), D10.2 (A), J4.2
/Col_2: D11.2 (A), D12.2 (A), D13.2 (A), D14.2 (A), D15.2 (A), J4.3
/Col_3: D16.2 (A), D17.2 (A), D18.2 (A), D19.2 (A), D20.2 (A), J4.4
/Col_4: D21.2 (A), J4.5
/Led5Led6: SW5.6 (-), SW6.5 (+)
/Led10-11: SW10.6 (-), SW11.5 (+)
/Row_0: J5.1, J7.2, SW1.3, SW1.4, SW6.3, SW6.4, SW11.3, SW11.4, SW16.3, SW16.4
/Row_1: J5.2, J7.3, SW2.3, SW2.4, SW7.3, SW7.4, SW12.3, SW12.4, SW17.3, SW17.4
/Row_2: J5.3, J7.4, SW3.3, SW3.4, SW8.3, SW8.4, SW13.3, SW13.4, SW18.3, SW18.4
/Row_3: J5.4, SW4.3, SW4.4, SW9.3, SW9.4, SW14.3, SW14.4, SW19.3, SW19.4
/Row_4: J5.5, SW5.3, SW5.4, SW10.3, SW10.4, SW15.3, SW15.4, SW20.3, SW20.4
GND: J6.2, J8.2, R8.1, R9.1, SW3.6 (-), SW6.6 (-), SW9.6 (-), SW12.6 (-), SW15.6 (-), SW18.6 (-), SW20.6 (-)
unnamed: D1.1 (K), SW2.1, SW2.2
unnamed: D2.1 (K), SW3.1, SW3.2
unnamed: D3.1 (K), SW4.1, SW4.2
unnamed: D4.1 (K), SW5.1, SW5.2
unnamed: D5.1 (K), SW1.1, SW1.2
unnamed: D6.1 (K), SW7.1, SW7.2
unnamed: D7.1 (K), SW8.1, SW8.2
unnamed: D8.1 (K), SW9.1, SW9.2
unnamed: D9.1 (K), SW10.1, SW10.2
unnamed: D10.1 (K), SW6.1, SW6.2
unnamed: D11.1 (K), SW11.1, SW11.2
unnamed: D12.1 (K), SW12.1, SW12.2
unnamed: D13.1 (K), SW13.1, SW13.2
unnamed: D14.1 (K), SW14.1, SW14.2
unnamed: D15.1 (K), SW15.1, SW15.2
unnamed: D16.1 (K), SW16.1, SW16.2
unnamed: D17.1 (K), SW17.1, SW17.2
unnamed: D18.1 (K), SW18.1, SW18.2
unnamed: D19.1 (K), SW19.1, SW19.2
unnamed: D20.1 (K), SW20.1, SW20.2
unnamed: D21.1 (K), J7.1
unnamed: D22.1 (K), D23.2 (A)
unnamed: D23.1 (K), R8.2
unnamed: D24.1 (K), D25.2 (A)
unnamed: D25.1 (K), D26.2 (A)
unnamed: D26.1 (K), R9.2
unnamed: R1.1, SW1.5 (+)
unnamed: R2.1, SW4.5 (+)
unnamed: R3.1, SW10.5 (+)
unnamed: R4.1, SW7.5 (+)
unnamed: R5.1, SW13.5 (+)
unnamed: R6.1, SW16.5 (+)
unnamed: R7.1, SW19.5 (+)
unnamed: SW1.6 (-), SW2.5 (+)
unnamed: SW2.6 (-), SW3.5 (+)
unnamed: SW4.6 (-), SW5.5 (+)
unnamed: SW7.6 (-), SW8.5 (+)
unnamed: SW8.6 (-), SW9.5 (+)
unnamed: SW11.6 (-), SW12.5 (+)
unnamed: SW13.6 (-), SW14.5 (+)
unnamed: SW14.6 (-), SW15.5 (+)
unnamed: SW16.6 (-), SW17.5 (+)
unnamed: SW17.6 (-), SW18.5 (+)
unnamed: SW19.6 (-), SW20.5 (+)

Notes on the sheet:
Brightness - Left Hand Side
Contrast - Right Hand Side
Selector Rotary at Top
Backlighting in
Backlight for rotary switch

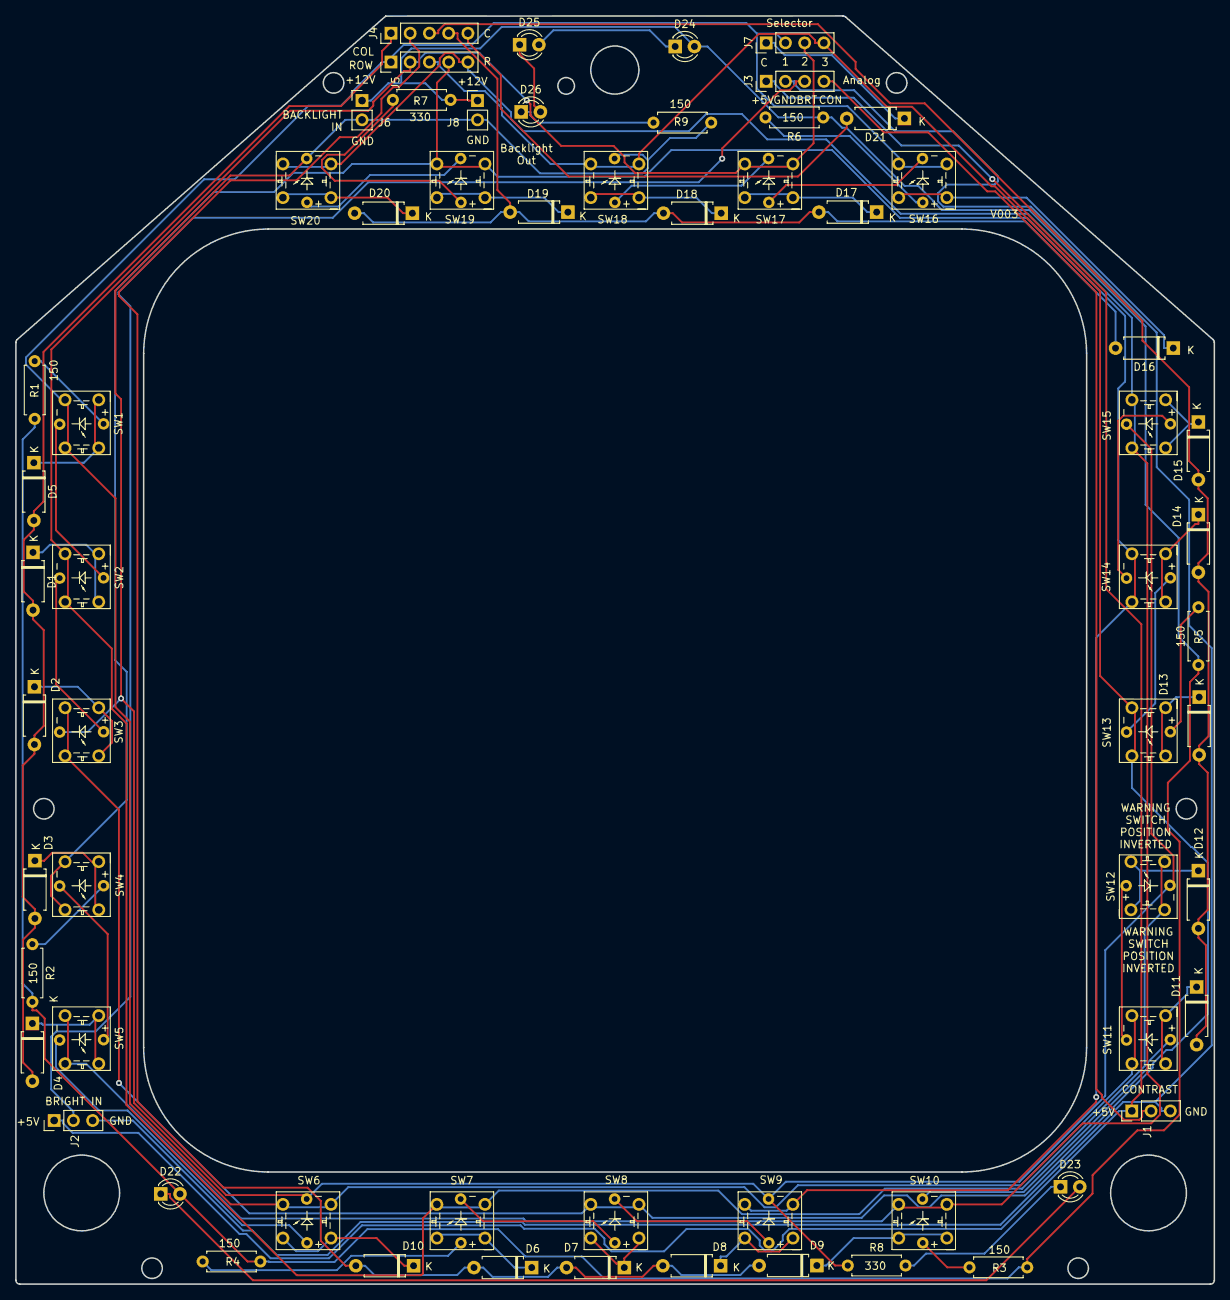
[picture p541: board Buttons_DDI.kicad_pcb from above]

Board: 2 copper layers, 158.2 x 167.4 mm, 63 parts (0 on the bottom side), 62 nets.
