bnepethomas/bne-arduino-flight-simulator-interfaces/A10/A10 PCBs/A10 Power Distro PCB v1/a10 Power Distro PCB v1.kicad_sch

## KiCad design A10/A10 PCBs/A10 Power Distro PCB v1/a10 Power Distro PCB v1.kicad_sch (2025-11-29)

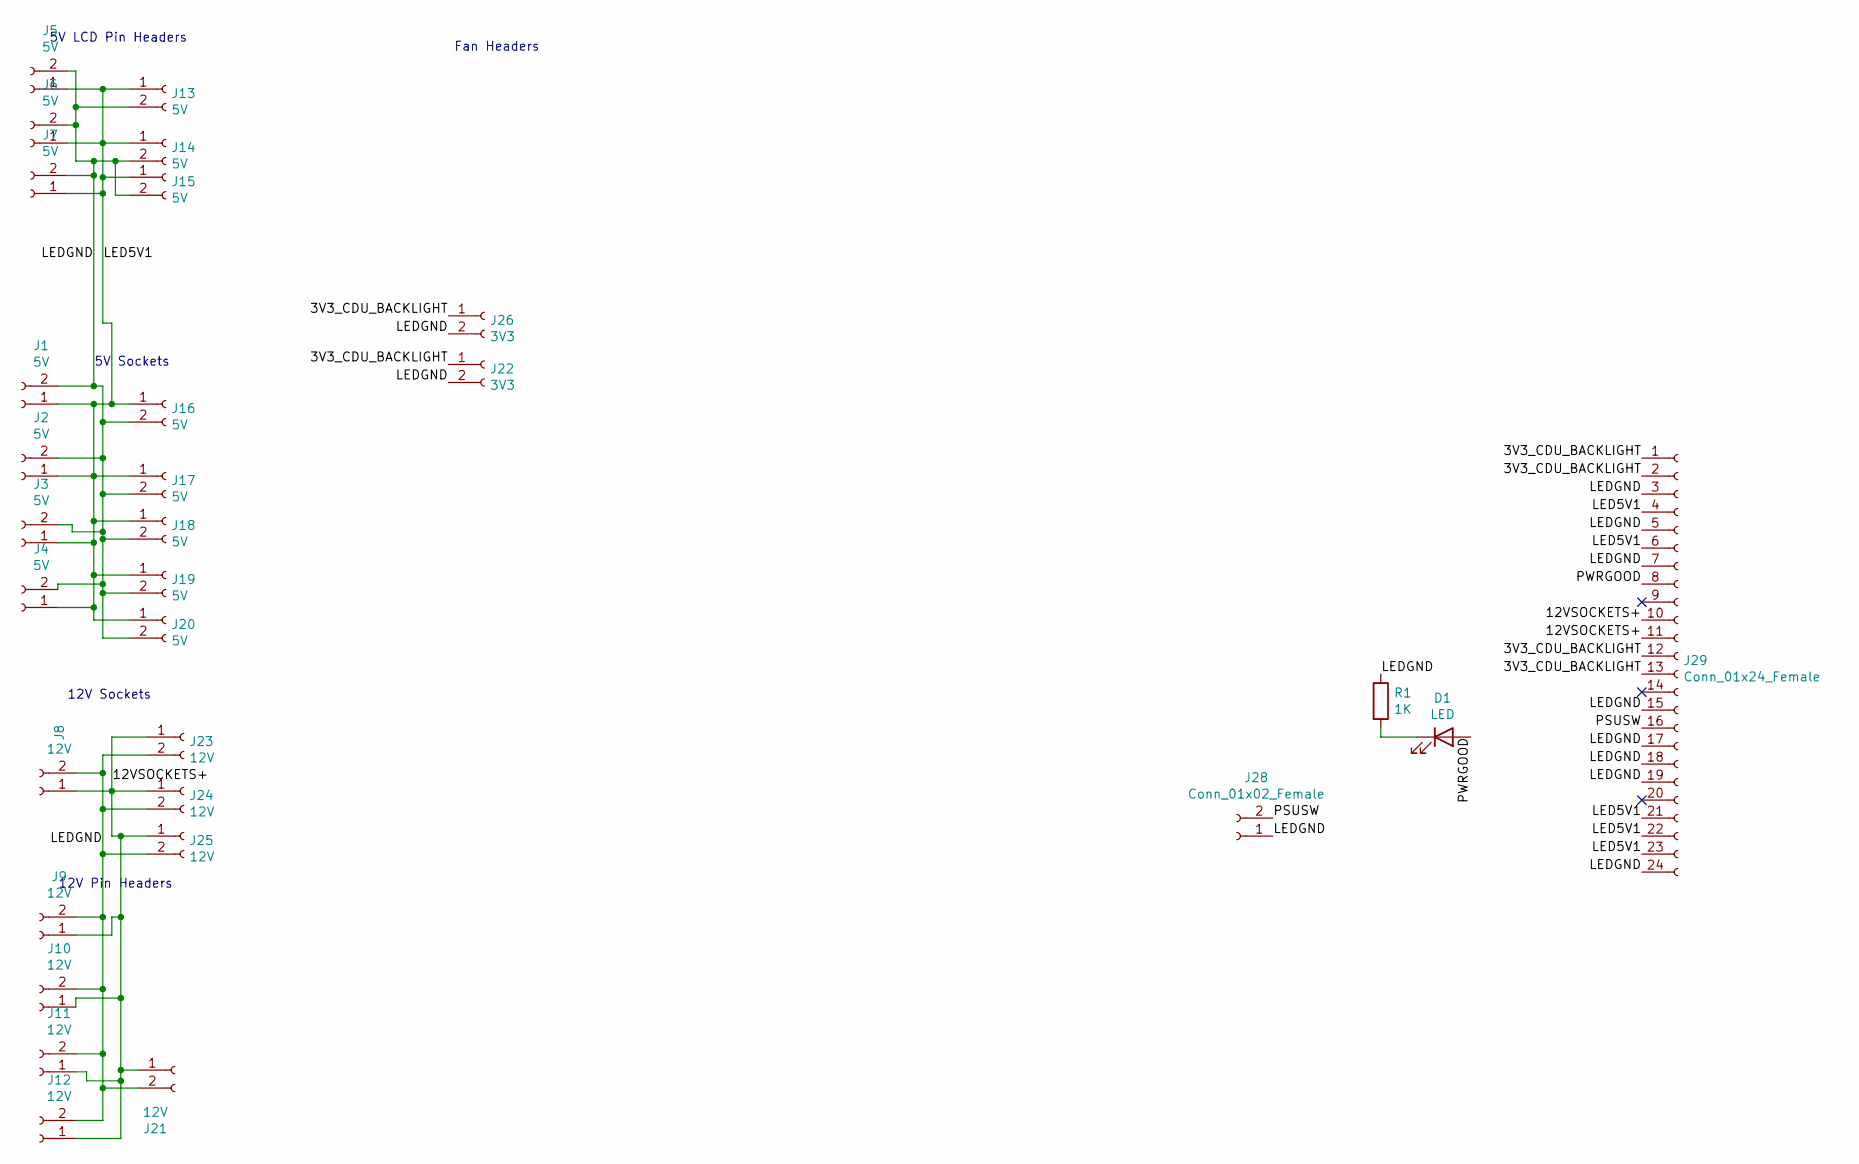
[picture p542: schematic a10 Power Distro PCB v1.kicad_sch]

Parts:
D1: LED; LED_D3.0mm
J1, J2, J3, J4, J16, J17, J18: 5V; BarrelJack_Horizontal
J5, J6, J7, J13, J14, J15, J19, J20: 5V; Molex_KK-254_AE-6410-02A_1x02_P2.54mm_Vertical
J8, J11, J12, J23, J24, J25: 12V; BarrelJack_Horizontal
J9, J10, J21: 12V; Molex_KK-254_AE-6410-02A_1x02_P2.54mm_Vertical
J22: 3V3; BarrelJack_Horizontal
J26: 3V3; Molex_KK-254_AE-6410-02A_1x02_P2.54mm_Vertical
J28: Conn_01x02_Female; Molex_KK-254_AE-6410-02A_1x02_P2.54mm_Vertical
J29: Conn_01x24_Female; Molex_Mini-Fit_Jr_5566-24A_2x12_P4.20mm_Vertical
R1: 1K; R_Axial_DIN0207_L6.3mm_D2.5mm_P7.62mm_Horizontal

Connections:
3V3_CDU_BACKLIGHT: J22.1, J26.1, J29.1, J29.2, J29.12, J29.13
12VSOCKETS+: J8.1, J9.1, J10.1, J11.1, J12.1, J21.1, J23.1, J24.1, J25.1, J29.10, J29.11
LED5V1: J1.1, J2.1, J3.1, J4.1, J5.1, J6.1, J7.1, J13.1, J14.1, J15.1, J16.1, J17.1, J18.1, J19.1, J20.1, J29.4, J29.6, J29.21, J29.22, J29.23
LEDGND: J1.2, J2.2, J3.2, J4.2, J5.2, J6.2, J7.2, J8.2, J9.2, J10.2, J11.2, J12.2, J13.2, J14.2, J15.2, J16.2, J17.2, J18.2, J19.2, J20.2, J21.2, J22.2, J23.2, J24.2, J25.2, J26.2, J28.1, J29.3, J29.5, J29.7, J29.15, J29.17, J29.18, J29.19, J29.24, R1.1
unnamed: D1.1 (K), R1.2
PSUSW: J28.2, J29.16
PWRGOOD: D1.2 (A), J29.8

Notes on the sheet:
Fan Headers
12V Pin Headers
5V LCD Pin Headers
12V Sockets
5V Sockets
