bnepethomas/bne-arduino-flight-simulator-interfaces/A10/A10 PCBs/Cable Pass Through/Cable Pass Through.kicad_sch

## KiCad design A10/A10 PCBs/Cable Pass Through/Cable Pass Through.kicad_sch (2025-11-29)

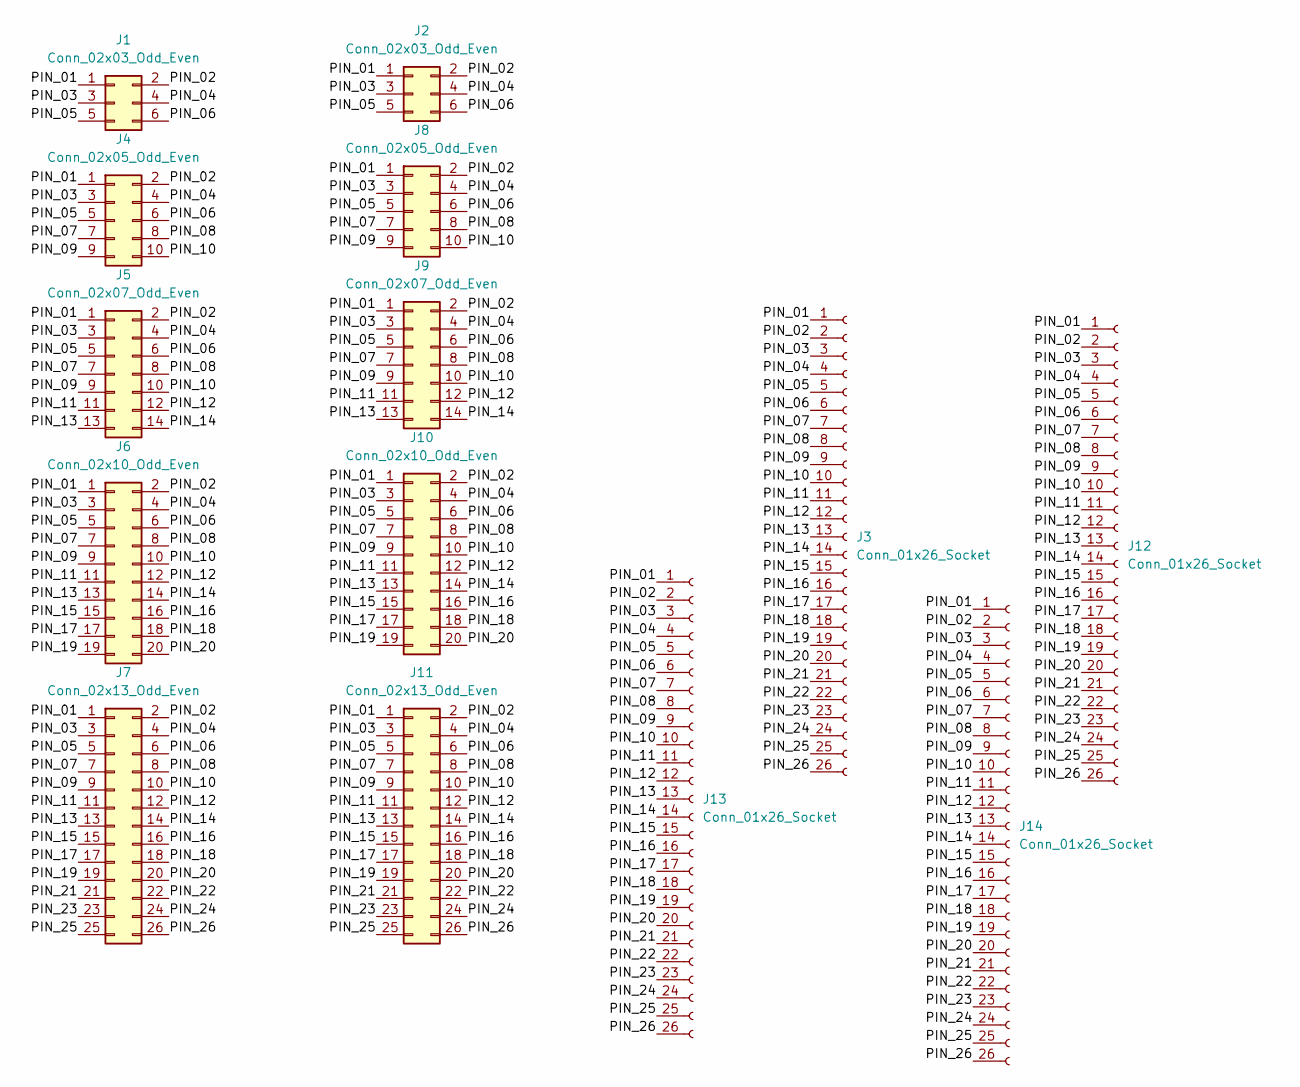
[picture p543: schematic Cable Pass Through.kicad_sch]

Parts:
J1, J2: Conn_02x03_Odd_Even; IDC-Header_2x03_P2.54mm_Vertical
J3, J12, J13, J14: Conn_01x26_Socket; PinHeader_1x26_P2.54mm_Vertical
J4, J8: Conn_02x05_Odd_Even; IDC-Header_2x05_P2.54mm_Vertical
J5, J9: Conn_02x07_Odd_Even; IDC-Header_2x07_P2.54mm_Vertical
J6, J10: Conn_02x10_Odd_Even; IDC-Header_2x10_P2.54mm_Vertical
J7, J11: Conn_02x13_Odd_Even; IDC-Header_2x13_P2.54mm_Vertical

Connections:
PIN_01: J1.1, J2.1, J3.1, J4.1, J5.1, J6.1, J7.1, J8.1, J9.1, J10.1, J11.1, J12.1, J13.1, J14.1
PIN_02: J1.2, J2.2, J3.2, J4.2, J5.2, J6.2, J7.2, J8.2, J9.2, J10.2, J11.2, J12.2, J13.2, J14.2
PIN_03: J1.3, J2.3, J3.3, J4.3, J5.3, J6.3, J7.3, J8.3, J9.3, J10.3, J11.3, J12.3, J13.3, J14.3
PIN_04: J1.4, J2.4, J3.4, J4.4, J5.4, J6.4, J7.4, J8.4, J9.4, J10.4, J11.4, J12.4, J13.4, J14.4
PIN_05: J1.5, J2.5, J3.5, J4.5, J5.5, J6.5, J7.5, J8.5, J9.5, J10.5, J11.5, J12.5, J13.5, J14.5
PIN_06: J1.6, J2.6, J3.6, J4.6, J5.6, J6.6, J7.6, J8.6, J9.6, J10.6, J11.6, J12.6, J13.6, J14.6
PIN_07: J3.7, J4.7, J5.7, J6.7, J7.7, J8.7, J9.7, J10.7, J11.7, J12.7, J13.7, J14.7
PIN_08: J3.8, J4.8, J5.8, J6.8, J7.8, J8.8, J9.8, J10.8, J11.8, J12.8, J13.8, J14.8
PIN_09: J3.9, J4.9, J5.9, J6.9, J7.9, J8.9, J9.9, J10.9, J11.9, J12.9, J13.9, J14.9
PIN_10: J3.10, J4.10, J5.10, J6.10, J7.10, J8.10, J9.10, J10.10, J11.10, J12.10, J13.10, J14.10
PIN_11: J3.11, J5.11, J6.11, J7.11, J9.11, J10.11, J11.11, J12.11, J13.11, J14.11
PIN_12: J3.12, J5.12, J6.12, J7.12, J9.12, J10.12, J11.12, J12.12, J13.12, J14.12
PIN_13: J3.13, J5.13, J6.13, J7.13, J9.13, J10.13, J11.13, J12.13, J13.13, J14.13
PIN_14: J3.14, J5.14, J6.14, J7.14, J9.14, J10.14, J11.14, J12.14, J13.14, J14.14
PIN_15: J3.15, J6.15, J7.15, J10.15, J11.15, J12.15, J13.15, J14.15
PIN_16: J3.16, J6.16, J7.16, J10.16, J11.16, J12.16, J13.16, J14.16
PIN_17: J3.17, J6.17, J7.17, J10.17, J11.17, J12.17, J13.17, J14.17
PIN_18: J3.18, J6.18, J7.18, J10.18, J11.18, J12.18, J13.18, J14.18
PIN_19: J3.19, J6.19, J7.19, J10.19, J11.19, J12.19, J13.19, J14.19
PIN_20: J3.20, J6.20, J7.20, J10.20, J11.20, J12.20, J13.20, J14.20
PIN_21: J3.21, J7.21, J11.21, J12.21, J13.21, J14.21
PIN_22: J3.22, J7.22, J11.22, J12.22, J13.22, J14.22
PIN_23: J3.23, J7.23, J11.23, J12.23, J13.23, J14.23
PIN_24: J3.24, J7.24, J11.24, J12.24, J13.24, J14.24
PIN_25: J3.25, J7.25, J11.25, J12.25, J13.25, J14.25
PIN_26: J3.26, J7.26, J11.26, J12.26, J13.26, J14.26
