bnepethomas/bne-arduino-flight-simulator-interfaces/A10/A10 PCBs/Cable Tester/Cable Tester.kicad_sch

## KiCad design A10/A10 PCBs/Cable Tester/Cable Tester.kicad_sch (2025-11-29)

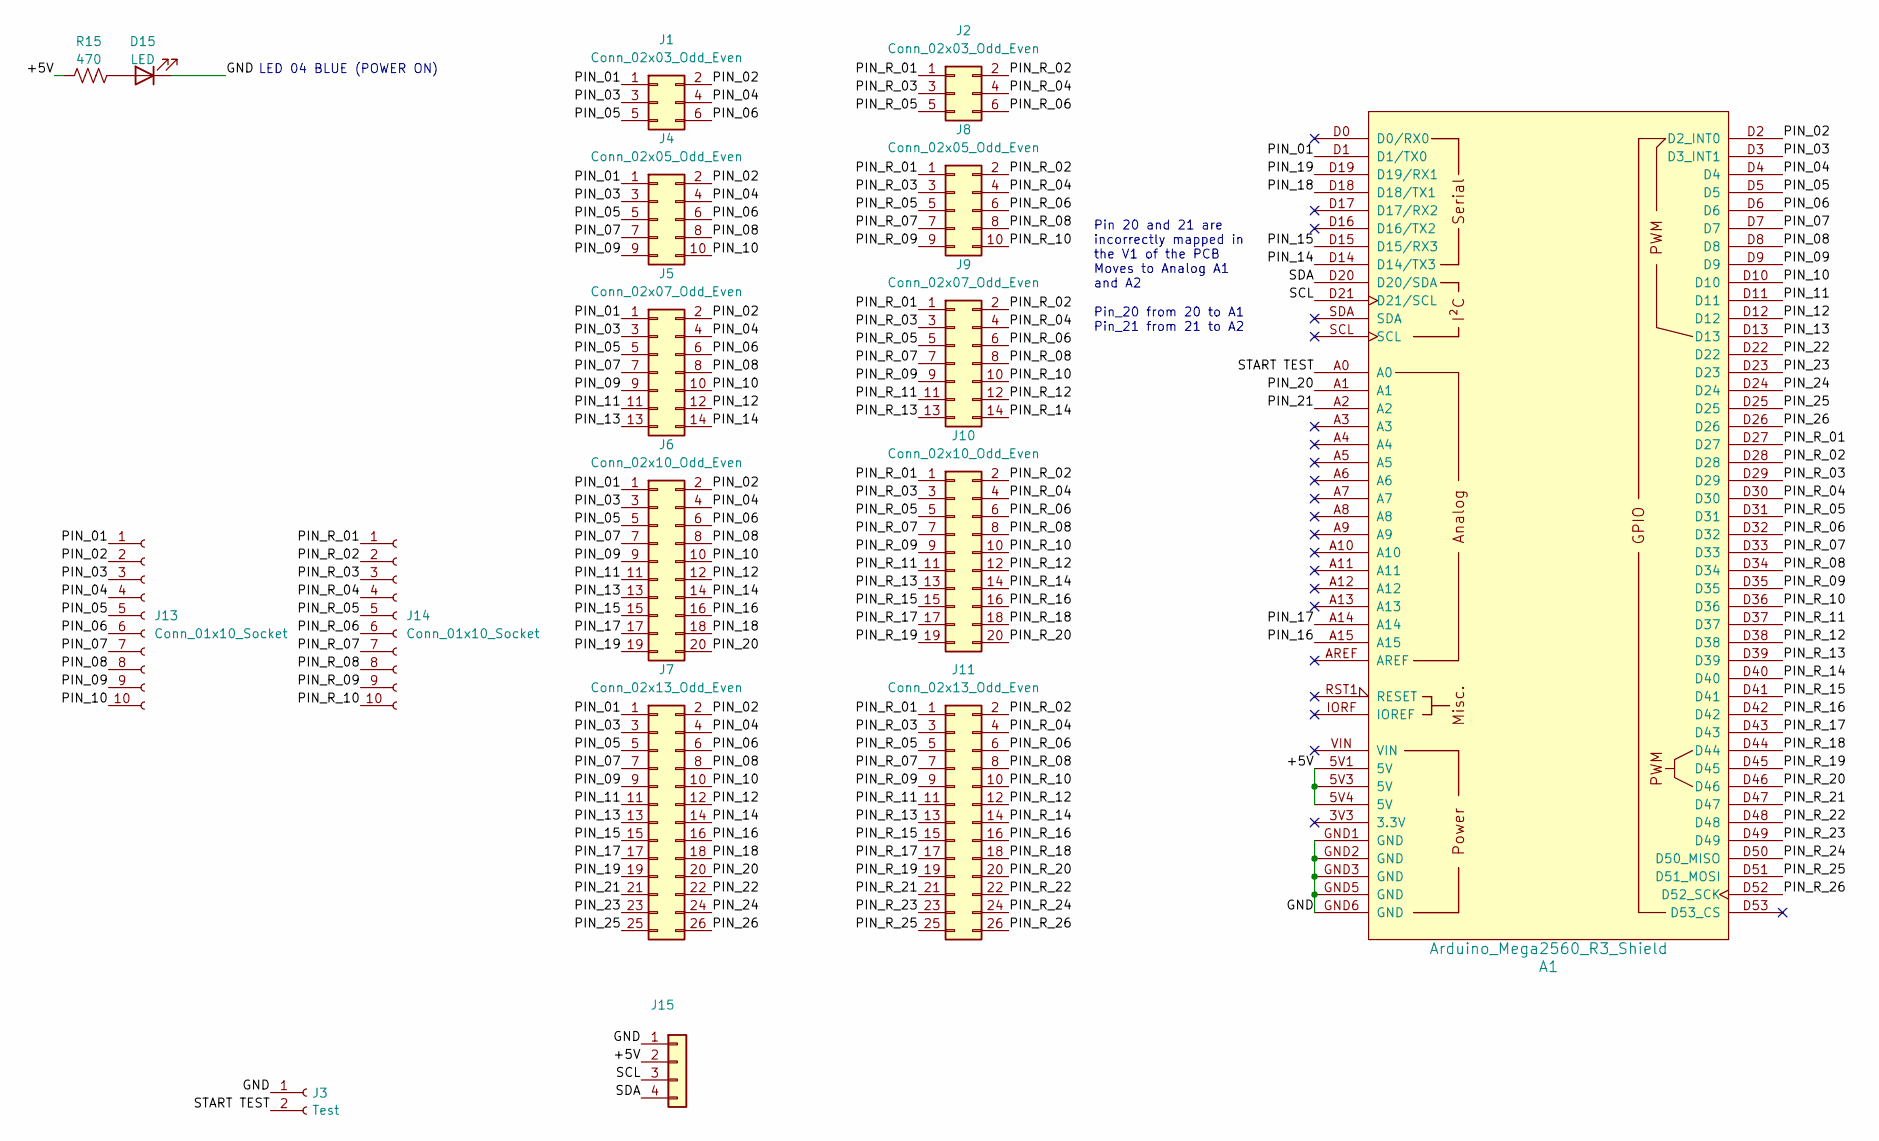
[picture p544: schematic Cable Tester.kicad_sch]

Parts:
A1: Arduino_Mega2560_R3_Shield
D15: LED; LED_D3.0mm
J1, J2: Conn_02x03_Odd_Even; IDC-Header_2x03_P2.54mm_Vertical
J3: Test; JST_XA_B02B-XASK-1_1x02_P2.50mm_Vertical
J4, J8: Conn_02x05_Odd_Even; IDC-Header_2x05_P2.54mm_Vertical
J5, J9: Conn_02x07_Odd_Even; IDC-Header_2x07_P2.54mm_Vertical
J6, J10: Conn_02x10_Odd_Even; IDC-Header_2x10_P2.54mm_Vertical
J7, J11: Conn_02x13_Odd_Even; IDC-Header_2x13_P2.54mm_Vertical
J13, J14: Conn_01x10_Socket; PinHeader_1x10_P2.54mm_Vertical
J15: PT_Conn_01x04; Molex_KK-254_AE-6410-04A_1x04_P2.54mm_Vertical
R15: 470; R_Axial_DIN0204_L3.6mm_D1.6mm_P2.54mm_Vertical

Connections:
+5V: A1.5V1 (5V), A1.5V3 (5V), A1.5V4 (5V), J15.2, R15.1
GND: A1.GND1 (GND), A1.GND2 (GND), A1.GND3 (GND), A1.GND5 (GND), A1.GND6 (GND), D15.1 (K), J3.1, J15.1
unnamed: D15.2 (A), R15.2
PIN_01: A1.D1 (D1/TX0), J1.1, J4.1, J5.1, J6.1, J7.1, J13.1
PIN_02: A1.D2 (D2_INT0), J1.2, J4.2, J5.2, J6.2, J7.2, J13.2
PIN_03: A1.D3 (D3_INT1), J1.3, J4.3, J5.3, J6.3, J7.3, J13.3
PIN_04: A1.D4, J1.4, J4.4, J5.4, J6.4, J7.4, J13.4
PIN_05: A1.D5, J1.5, J4.5, J5.5, J6.5, J7.5, J13.5
PIN_06: A1.D6, J1.6, J4.6, J5.6, J6.6, J7.6, J13.6
PIN_07: A1.D7, J4.7, J5.7, J6.7, J7.7, J13.7
PIN_08: A1.D8, J4.8, J5.8, J6.8, J7.8, J13.8
PIN_09: A1.D9, J4.9, J5.9, J6.9, J7.9, J13.9
PIN_10: A1.D10, J4.10, J5.10, J6.10, J7.10, J13.10
PIN_11: A1.D11, J5.11, J6.11, J7.11
PIN_12: A1.D12, J5.12, J6.12, J7.12
PIN_13: A1.D13, J5.13, J6.13, J7.13
PIN_14: A1.D14 (D14/TX3), J5.14, J6.14, J7.14
PIN_15: A1.D15 (D15/RX3), J6.15, J7.15
PIN_16: A1.A15, J6.16, J7.16
PIN_17: A1.A14, J6.17, J7.17
PIN_18: A1.D18 (D18/TX1), J6.18, J7.18
PIN_19: A1.D19 (D19/RX1), J6.19, J7.19
PIN_20: A1.A1, J6.20, J7.20
PIN_21: A1.A2, J7.21
PIN_22: A1.D22, J7.22
PIN_23: A1.D23, J7.23
PIN_24: A1.D24, J7.24
PIN_25: A1.D25, J7.25
PIN_26: A1.D26, J7.26
PIN_R_01: A1.D27, J2.1, J8.1, J9.1, J10.1, J11.1, J14.1
PIN_R_02: A1.D28, J2.2, J8.2, J9.2, J10.2, J11.2, J14.2
PIN_R_03: A1.D29, J2.3, J8.3, J9.3, J10.3, J11.3, J14.3
PIN_R_04: A1.D30, J2.4, J8.4, J9.4, J10.4, J11.4, J14.4
PIN_R_05: A1.D31, J2.5, J8.5, J9.5, J10.5, J11.5, J14.5
PIN_R_06: A1.D32, J2.6, J8.6, J9.6, J10.6, J11.6, J14.6
PIN_R_07: A1.D33, J8.7, J9.7, J10.7, J11.7, J14.7
PIN_R_08: A1.D34, J8.8, J9.8, J10.8, J11.8, J14.8
PIN_R_09: A1.D35, J8.9, J9.9, J10.9, J11.9, J14.9
PIN_R_10: A1.D36, J8.10, J9.10, J10.10, J11.10, J14.10
PIN_R_11: A1.D37, J9.11, J10.11, J11.11
PIN_R_12: A1.D38, J9.12, J10.12, J11.12
PIN_R_13: A1.D39, J9.13, J10.13, J11.13
PIN_R_14: A1.D40, J9.14, J10.14, J11.14
PIN_R_15: A1.D41, J10.15, J11.15
PIN_R_16: A1.D42, J10.16, J11.16
PIN_R_17: A1.D43, J10.17, J11.17
PIN_R_18: A1.D44, J10.18, J11.18
PIN_R_19: A1.D45, J10.19, J11.19
PIN_R_20: A1.D46, J10.20, J11.20
PIN_R_21: A1.D47, J11.21
PIN_R_22: A1.D48, J11.22
PIN_R_23: A1.D49, J11.23
PIN_R_24: A1.D50 (D50_MISO), J11.24
PIN_R_25: A1.D51 (D51_MOSI), J11.25
PIN_R_26: A1.D52 (D52_SCK), J11.26
SCL: A1.D21 (D21/SCL), J15.3
SDA: A1.D20 (D20/SDA), J15.4
START TEST: A1.A0, J3.2

Notes on the sheet:
Pin 20 and 21 are incorrectly mapped in the V1 of the PCB Moves to Analog A1 and A2 Pin_20 from 20 to A1 Pin_21 from 21 to A2
LED 04 BLUE (POWER ON)
