bnepethomas/bne-arduino-flight-simulator-interfaces/A10/A10 PCBs/Forward Console 7 Stepper Driver/BACKLIGHTING.kicad_sch

## KiCad design A10/A10 PCBs/Forward Console 7 Stepper Driver/BACKLIGHTING.kicad_sch (2025-11-29)

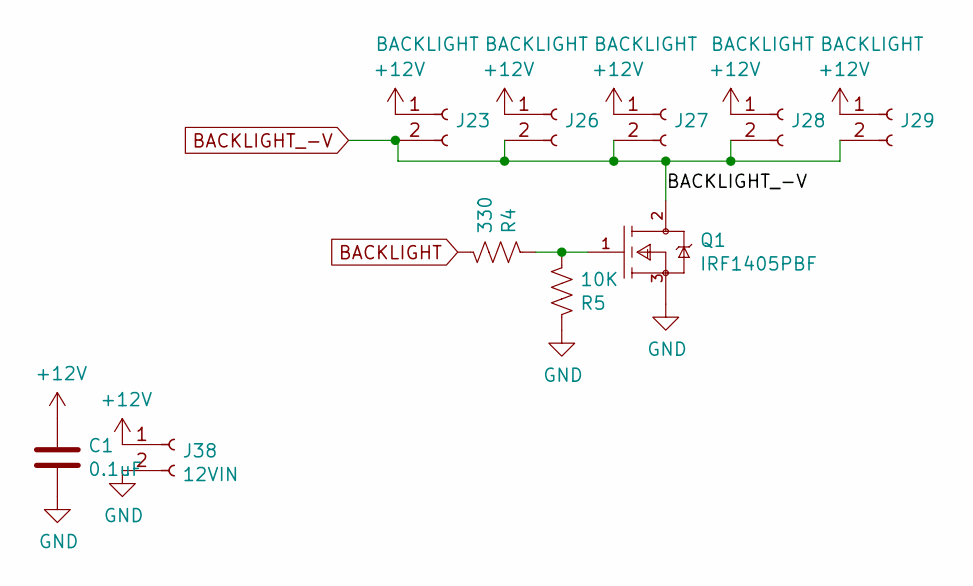
[picture p545: schematic BACKLIGHTING.kicad_sch]

Parts:
C1: 0.1uF; C_Disc_D4.3mm_W1.9mm_P5.00mm
J23, J26, J27, J28, J29: BACKLIGHT; Molex_KK-254_AE-6410-02A_1x02_P2.54mm_Vertical
J38: 12VIN; BarrelJack_Horizontal
Q1: IRF1405PBF; TO-220-3_Vertical; mouser part number 942-IRF1405PBF; digikey description MOSFET N-CH 55V 169A TO-220AB
R4: 330; R_Axial_DIN0204_L3.6mm_D1.6mm_P2.54mm_Vertical
R5: 10K; R_Axial_DIN0204_L3.6mm_D1.6mm_P2.54mm_Vertical

Connections:
+12V: C1.1, J23.1, J26.1, J27.1, J28.1, J29.1, J38.1
BACKLIGHT: R4.2
BACKLIGHT_-V: J23.2, J26.2, J27.2, J28.2, J29.2, Q1.2 (D)
GND: C1.2, J38.2, Q1.3 (S), R5.1
unnamed: Q1.1 (G), R4.1, R5.2
