bnepethomas/bne-arduino-flight-simulator-interfaces/A10/A10 PCBs/Forward Console 7 Stepper Driver/FORWARD 7 STEPPER DRIVER.kicad_sch

## KiCad design A10/A10 PCBs/Forward Console 7 Stepper Driver/FORWARD 7 STEPPER DRIVER.kicad_sch (2025-11-29)

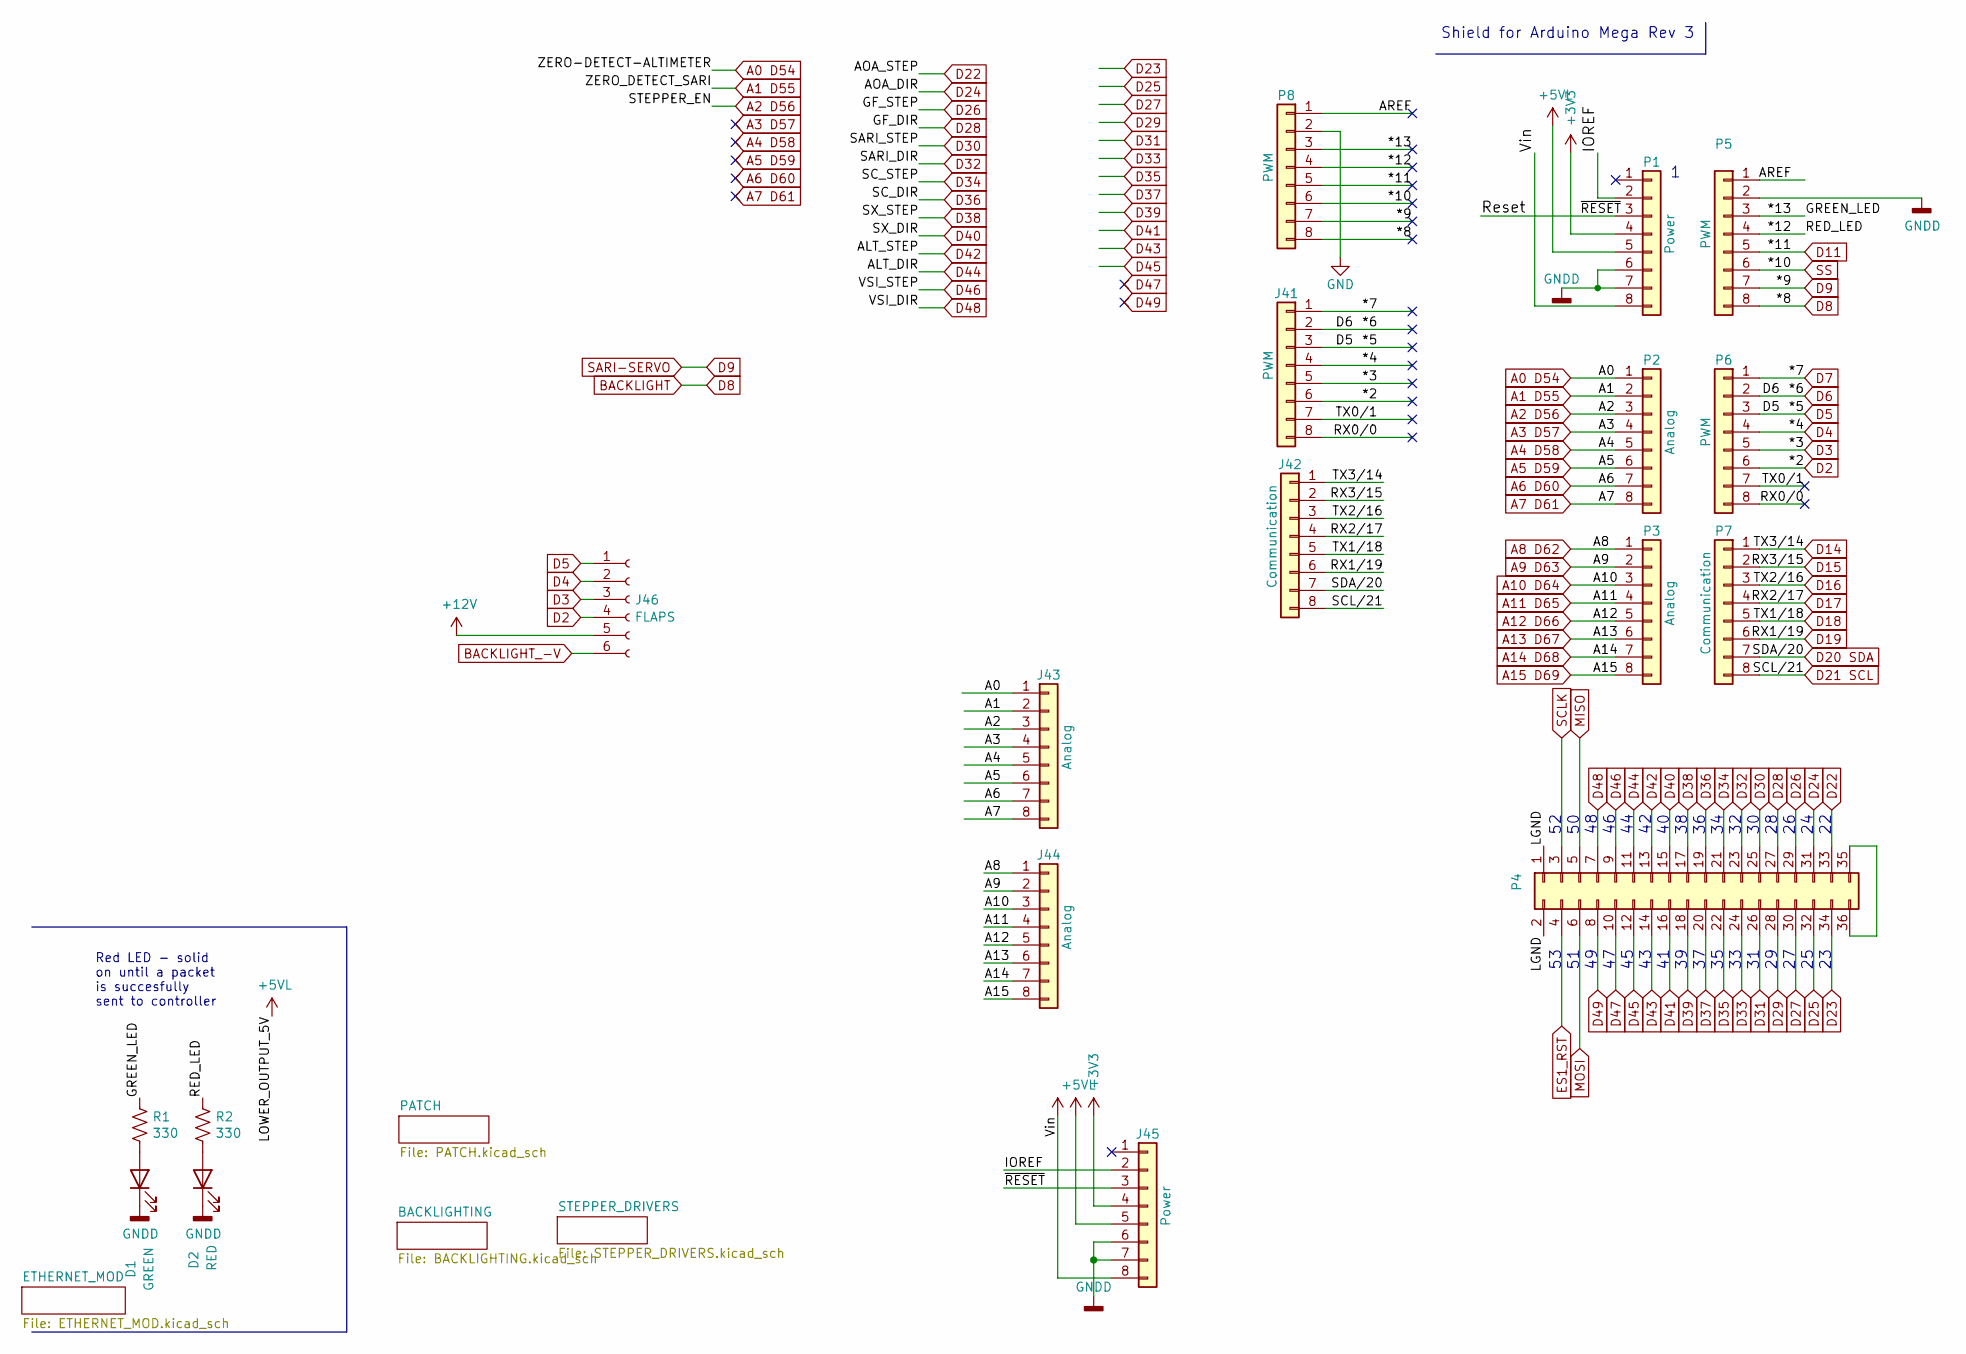
[picture p547: schematic FORWARD 7 STEPPER DRIVER.kicad_sch]

Parts:
D1: GREEN; LED_D3.0mm
D2: RED; LED_D3.0mm
J41: PWM; PinSocket_1x08_P2.54mm_Vertical
J42: Communication; PinSocket_1x08_P2.54mm_Vertical
J43, J44: Analog; PinSocket_1x08_P2.54mm_Vertical
J45: Power; PinSocket_1x08_P2.54mm_Vertical
J46: FLAPS; Molex_KK-254_AE-6410-06A_1x06_P2.54mm_Vertical
P1: Power; Socket_Strip_Arduino_1x08
P2, P3: Analog; Socket_Strip_Arduino_1x08
P4: Digital; Socket_Strip_Arduino_2x18
P5, P6, P8: PWM; Socket_Strip_Arduino_1x08
P7: Communication; Socket_Strip_Arduino_1x08
R1: 330; R_Axial_DIN0204_L3.6mm_D1.6mm_P2.54mm_Vertical
R2: 330; PT_R_Axial_DIN0204_L3.6mm_D1.6mm_P2.54mm_Vertical

Connections:
2: J41.6, J46.4, P6.6
3: J41.5, J46.3, P6.5
4: J41.4, J46.2, P6.4
5: J41.3, J46.1, P6.3
6: J41.2, P6.2
7: J41.1, P6.1
8: P5.8, P8.8
9: P5.7, P8.7
10: P5.6, P8.6
11: P5.5, P8.5
12: P5.4, P8.4, R2.1
13: P5.3, P8.3, R1.1
+3V3: J45.4, P1.4
+5VL: J45.5, P1.5
+12V: J46.5
A0 D54: J43.1, P2.1
A1 D55: J43.2, P2.2
A2 D56: J43.3, P2.3
A3 D57: J43.4, P2.4
A4 D58: J43.5, P2.5
A5 D59: J43.6, P2.6
A6 D60: J43.7, P2.7
A7 D61: J43.8, P2.8
A8 D62: J44.1, P3.1
A9 D63: J44.2, P3.2
A10 D64: J44.3, P3.3
A11 D65: J44.4, P3.4
A12 D66: J44.5, P3.5
A13 D67: J44.6, P3.6
A14 D68: J44.7, P3.7
A15 D69: J44.8, P3.8
AREF: P5.1, P8.1
BACKLIGHT_-V: J46.6
D14: J42.1, P7.1
D15: J42.2, P7.2
D16: J42.3, P7.3
D17: J42.4, P7.4
D18: J42.5, P7.5
D19: J42.6, P7.6
D20 SDA: J42.7, P7.7
D21 SCL: J42.8, P7.8
D22: P4.33
D23: P4.34
D24: P4.31
D25: P4.32
D26: P4.29
D27: P4.30
D28: P4.27
D29: P4.28
D30: P4.25
D31: P4.26
D32: P4.23
D33: P4.24
D34: P4.21
D35: P4.22
D36: P4.19
D37: P4.20
D38: P4.17
D39: P4.18
D40: P4.15
D41: P4.16
D42: P4.13
D43: P4.14
D44: P4.11
D45: P4.12
D46: P4.9
D47: P4.10
D48: P4.7
D49: P4.8
ES1_RST: P4.4
GND: P8.2
GNDD: D1.1 (K), D2.1 (K), J45.6, J45.7, P1.6, P1.7, P5.2
IOREF: J45.2, P1.2
LGND: P4.1, P4.2
MISO: P4.5
MOSI: P4.6
unnamed: D1.2 (A), R1.2
unnamed: D2.2 (A), R2.2
unnamed: P4.35, P4.36
RX0/0: J41.8, P6.8
Reset: J45.3, P1.3
SCLK: P4.3
TX0/1: J41.7, P6.7
VCC: J45.8, P1.8

Notes on the sheet:
Shield for Arduino Mega Rev 3
Red LED - solid on until a packet is succesfully sent to controller
