bnepethomas/bne-arduino-flight-simulator-interfaces/A10/A10 PCBs/Forward Console 7 Stepper Driver/PATCH.kicad_sch

## KiCad design A10/A10 PCBs/Forward Console 7 Stepper Driver/PATCH.kicad_sch (2025-11-29)

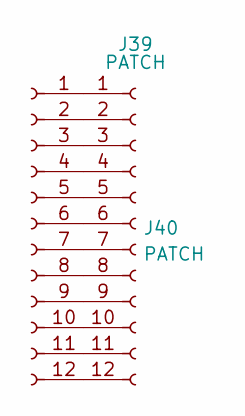
[picture p548: schematic PATCH.kicad_sch]

Parts:
J39, J40: PATCH; PinSocket_1x12_P2.54mm_Vertical

Connections:
unnamed: J39.1, J40.1
unnamed: J39.2, J40.2
unnamed: J39.3, J40.3
unnamed: J39.4, J40.4
unnamed: J39.5, J40.5
unnamed: J39.6, J40.6
unnamed: J39.7, J40.7
unnamed: J39.8, J40.8
unnamed: J39.9, J40.9
unnamed: J39.10, J40.10
unnamed: J39.11, J40.11
unnamed: J39.12, J40.12
