bnepethomas/bne-arduino-flight-simulator-interfaces/A10/A10 PCBs/Forward Console 7 Stepper Driver/STEPPER_DRIVERS.kicad_sch

## KiCad design A10/A10 PCBs/Forward Console 7 Stepper Driver/STEPPER_DRIVERS.kicad_sch (2025-11-29)

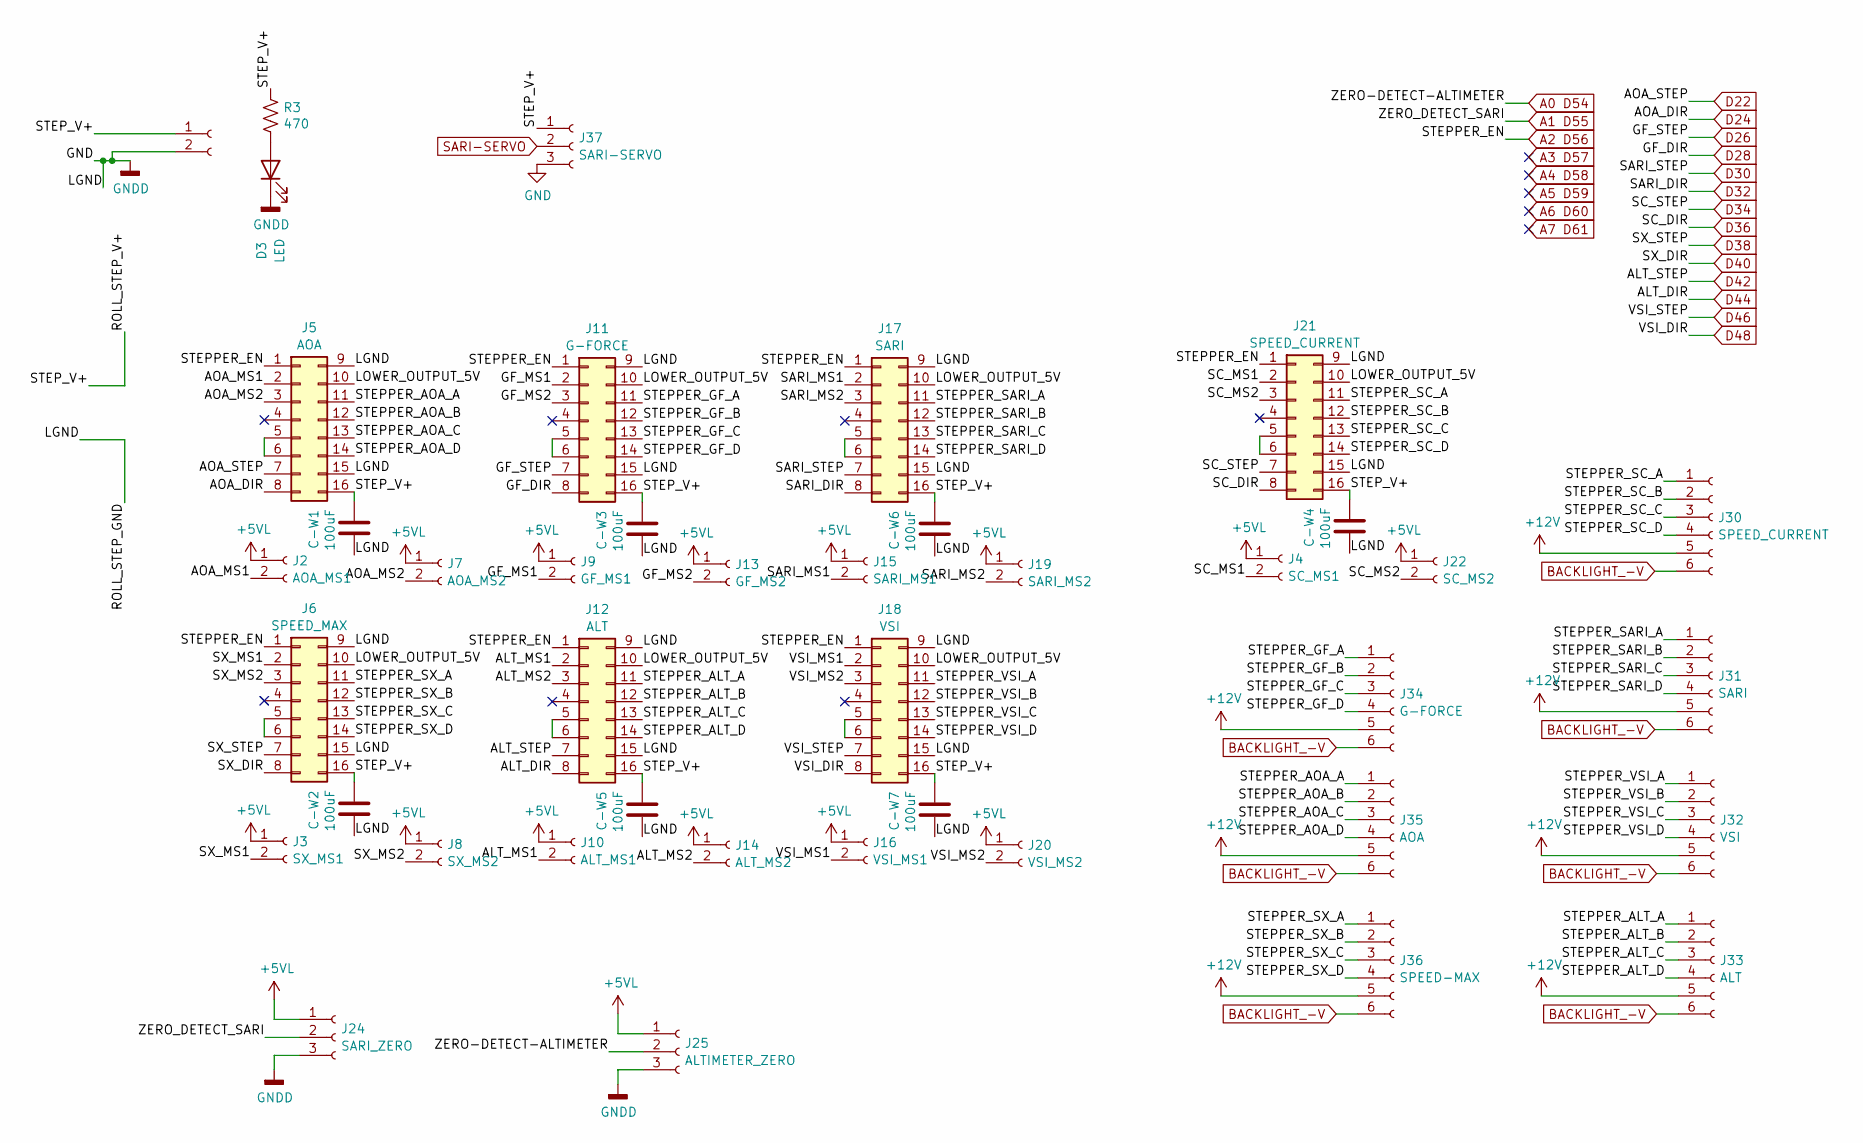
[picture p549: schematic STEPPER_DRIVERS.kicad_sch]

Parts:
C-W1, C-W2, C-W3, C-W4, C-W5, C-W6, C-W7: 100uF; C_Radial_D8.0mm_H7.0mm_P3.50mm
D3: LED; LED_D3.0mm
J1: STEPPER IN 12-20VDC; BarrelJack_Horizontal
J2: AOA_MS1; PinHeader_1x02_P2.54mm_Vertical
J3: SX_MS1; PinHeader_1x02_P2.54mm_Vertical
J4: SC_MS1; PinHeader_1x02_P2.54mm_Vertical
J5: AOA; Pololu_Breakout-16_15.2x20.3mm
J6: SPEED_MAX; Pololu_Breakout-16_15.2x20.3mm
J7: AOA_MS2; PinHeader_1x02_P2.54mm_Vertical
J8: SX_MS2; PinHeader_1x02_P2.54mm_Vertical
J9: GF_MS1; PinHeader_1x02_P2.54mm_Vertical
J10: ALT_MS1; PinHeader_1x02_P2.54mm_Vertical
J11: G-FORCE; Pololu_Breakout-16_15.2x20.3mm
J12: ALT; Pololu_Breakout-16_15.2x20.3mm
J13: GF_MS2; PinHeader_1x02_P2.54mm_Vertical
J14: ALT_MS2; PinHeader_1x02_P2.54mm_Vertical
J15: SARI_MS1; PinHeader_1x02_P2.54mm_Vertical
J16: VSI_MS1; PinHeader_1x02_P2.54mm_Vertical
J17: SARI; Pololu_Breakout-16_15.2x20.3mm
J18: VSI; Pololu_Breakout-16_15.2x20.3mm
J19: SARI_MS2; PinHeader_1x02_P2.54mm_Vertical
J20: VSI_MS2; PinHeader_1x02_P2.54mm_Vertical
J21: SPEED_CURRENT; Pololu_Breakout-16_15.2x20.3mm
J22: SC_MS2; PinHeader_1x02_P2.54mm_Vertical
J24: SARI_ZERO; Molex_KK-254_AE-6410-03A_1x03_P2.54mm_Vertical
J25: ALTIMETER_ZERO; Molex_KK-254_AE-6410-03A_1x03_P2.54mm_Vertical
J30: SPEED_CURRENT; Molex_KK-254_AE-6410-06A_1x06_P2.54mm_Vertical
J31: SARI; Molex_KK-254_AE-6410-06A_1x06_P2.54mm_Vertical
J32: VSI; Molex_KK-254_AE-6410-06A_1x06_P2.54mm_Vertical
J33: ALT; Molex_KK-254_AE-6410-06A_1x06_P2.54mm_Vertical
J34: G-FORCE; Molex_KK-254_AE-6410-06A_1x06_P2.54mm_Vertical
J35: AOA; Molex_KK-254_AE-6410-06A_1x06_P2.54mm_Vertical
J36: SPEED-MAX; Molex_KK-254_AE-6410-06A_1x06_P2.54mm_Vertical
J37: SARI-SERVO; Molex_KK-254_AE-6410-03A_1x03_P2.54mm_Vertical
R3: 470; R_Axial_DIN0204_L3.6mm_D1.6mm_P2.54mm_Vertical

Connections:
+5VL: J2.1, J3.1, J4.1, J7.1, J8.1, J9.1, J10.1, J13.1, J14.1, J15.1, J16.1, J19.1, J20.1, J22.1, J24.1, J25.1
+12V: J30.5, J31.5, J32.5, J33.5, J34.5, J35.5, J36.5
A0 D54: J25.2
A1 D55: J24.2
A2 D56: J5.1, J6.1, J11.1, J12.1, J17.1, J18.1, J21.1
ALT_MS1: J10.2, J12.2
ALT_MS2: J12.3, J14.2
AOA_MS1: J2.2, J5.2
AOA_MS2: J5.3, J7.2
BACKLIGHT_-V: J30.6, J31.6, J32.6, J33.6, J34.6, J35.6, J36.6
D22: J5.7
D24: J5.8
D26: J11.7
D28: J11.8
D30: J17.7
D32: J17.8
D34: J21.7
D36: J21.8
D38: J6.7
D40: J6.8
D42: J12.7
D44: J12.8
D46: J18.7
D48: J18.8
GF_MS1: J9.2, J11.2
GF_MS2: J11.3, J13.2
GND: J37.3
GNDD: C-W1.2, C-W2.2, C-W3.2, C-W4.2, C-W5.2, C-W6.2, C-W7.2, D3.1 (K), J1.2, J5.9, J5.15, J6.9, J6.15, J11.9, J11.15, J12.9, J12.15, J17.9, J17.15, J18.9, J18.15, J21.9, J21.15, J24.3, J25.3
LOWER_OUTPUT_5V: J5.10, J6.10, J11.10, J12.10, J17.10, J18.10, J21.10
unnamed: D3.2 (A), R3.2
unnamed: J5.5, J5.6
unnamed: J6.5, J6.6
unnamed: J11.5, J11.6
unnamed: J12.5, J12.6
unnamed: J17.5, J17.6
unnamed: J18.5, J18.6
unnamed: J21.5, J21.6
ROLL_STEP_V+: C-W1.1, C-W2.1, C-W3.1, C-W4.1, C-W5.1, C-W6.1, C-W7.1, J1.1, J5.16, J6.16, J11.16, J12.16, J17.16, J18.16, J21.16, J37.1, R3.1
SARI-SERVO: J37.2
SARI_MS1: J15.2, J17.2
SARI_MS2: J17.3, J19.2
SC_MS1: J4.2, J21.2
SC_MS2: J21.3, J22.2
STEPPER_ALT_A: J12.11, J33.1
STEPPER_ALT_B: J12.12, J33.2
STEPPER_ALT_C: J12.13, J33.3
STEPPER_ALT_D: J12.14, J33.4
STEPPER_AOA_A: J5.11, J35.1
STEPPER_AOA_B: J5.12, J35.2
STEPPER_AOA_C: J5.13, J35.3
STEPPER_AOA_D: J5.14, J35.4
STEPPER_GF_A: J11.11, J34.1
STEPPER_GF_B: J11.12, J34.2
STEPPER_GF_C: J11.13, J34.3
STEPPER_GF_D: J11.14, J34.4
STEPPER_SARI_A: J17.11, J31.1
STEPPER_SARI_B: J17.12, J31.2
STEPPER_SARI_C: J17.13, J31.3
STEPPER_SARI_D: J17.14, J31.4
STEPPER_SC_A: J21.11, J30.1
STEPPER_SC_B: J21.12, J30.2
STEPPER_SC_C: J21.13, J30.3
STEPPER_SC_D: J21.14, J30.4
STEPPER_SX_A: J6.11, J36.1
STEPPER_SX_B: J6.12, J36.2
STEPPER_SX_C: J6.13, J36.3
STEPPER_SX_D: J6.14, J36.4
STEPPER_VSI_A: J18.11, J32.1
STEPPER_VSI_B: J18.12, J32.2
STEPPER_VSI_C: J18.13, J32.3
STEPPER_VSI_D: J18.14, J32.4
SX_MS1: J3.2, J6.2
SX_MS2: J6.3, J8.2
VSI_MS1: J16.2, J18.2
VSI_MS2: J18.3, J20.2
