bnepethomas/bne-arduino-flight-simulator-interfaces/A10/A10 PCBs/Forward Console Combined Input and Output/BACKLIGHTING.kicad_sch

## KiCad design A10/A10 PCBs/Forward Console Combined Input and Output/BACKLIGHTING.kicad_sch (2025-11-29)

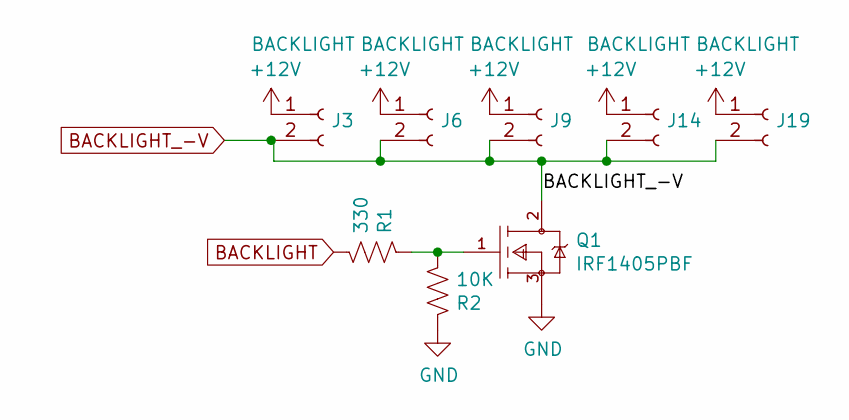
[picture p550: schematic BACKLIGHTING.kicad_sch]

Parts:
J3, J6, J9, J14, J19: BACKLIGHT; Molex_KK-254_AE-6410-02A_1x02_P2.54mm_Vertical
Q1: IRF1405PBF; TO-220-3_Vertical; mouser part number 942-IRF1405PBF; digikey description MOSFET N-CH 55V 169A TO-220AB
R1: 330; R_Axial_DIN0204_L3.6mm_D1.6mm_P2.54mm_Vertical
R2: 10K; R_Axial_DIN0204_L3.6mm_D1.6mm_P2.54mm_Vertical

Connections:
+12V: J3.1, J6.1, J9.1, J14.1, J19.1
BACKLIGHT: R1.2
BACKLIGHT_-V: J3.2, J6.2, J9.2, J14.2, J19.2, Q1.2 (D)
GND: Q1.3 (S), R2.1
unnamed: Q1.1 (G), R1.1, R2.2
