bnepethomas/bne-arduino-flight-simulator-interfaces/A10/A10 PCBs/Forward Console Combined Input and Output/COIL AND LAMP DRIVERS.kicad_sch

## KiCad design A10/A10 PCBs/Forward Console Combined Input and Output/COIL AND LAMP DRIVERS.kicad_sch (2025-11-29)

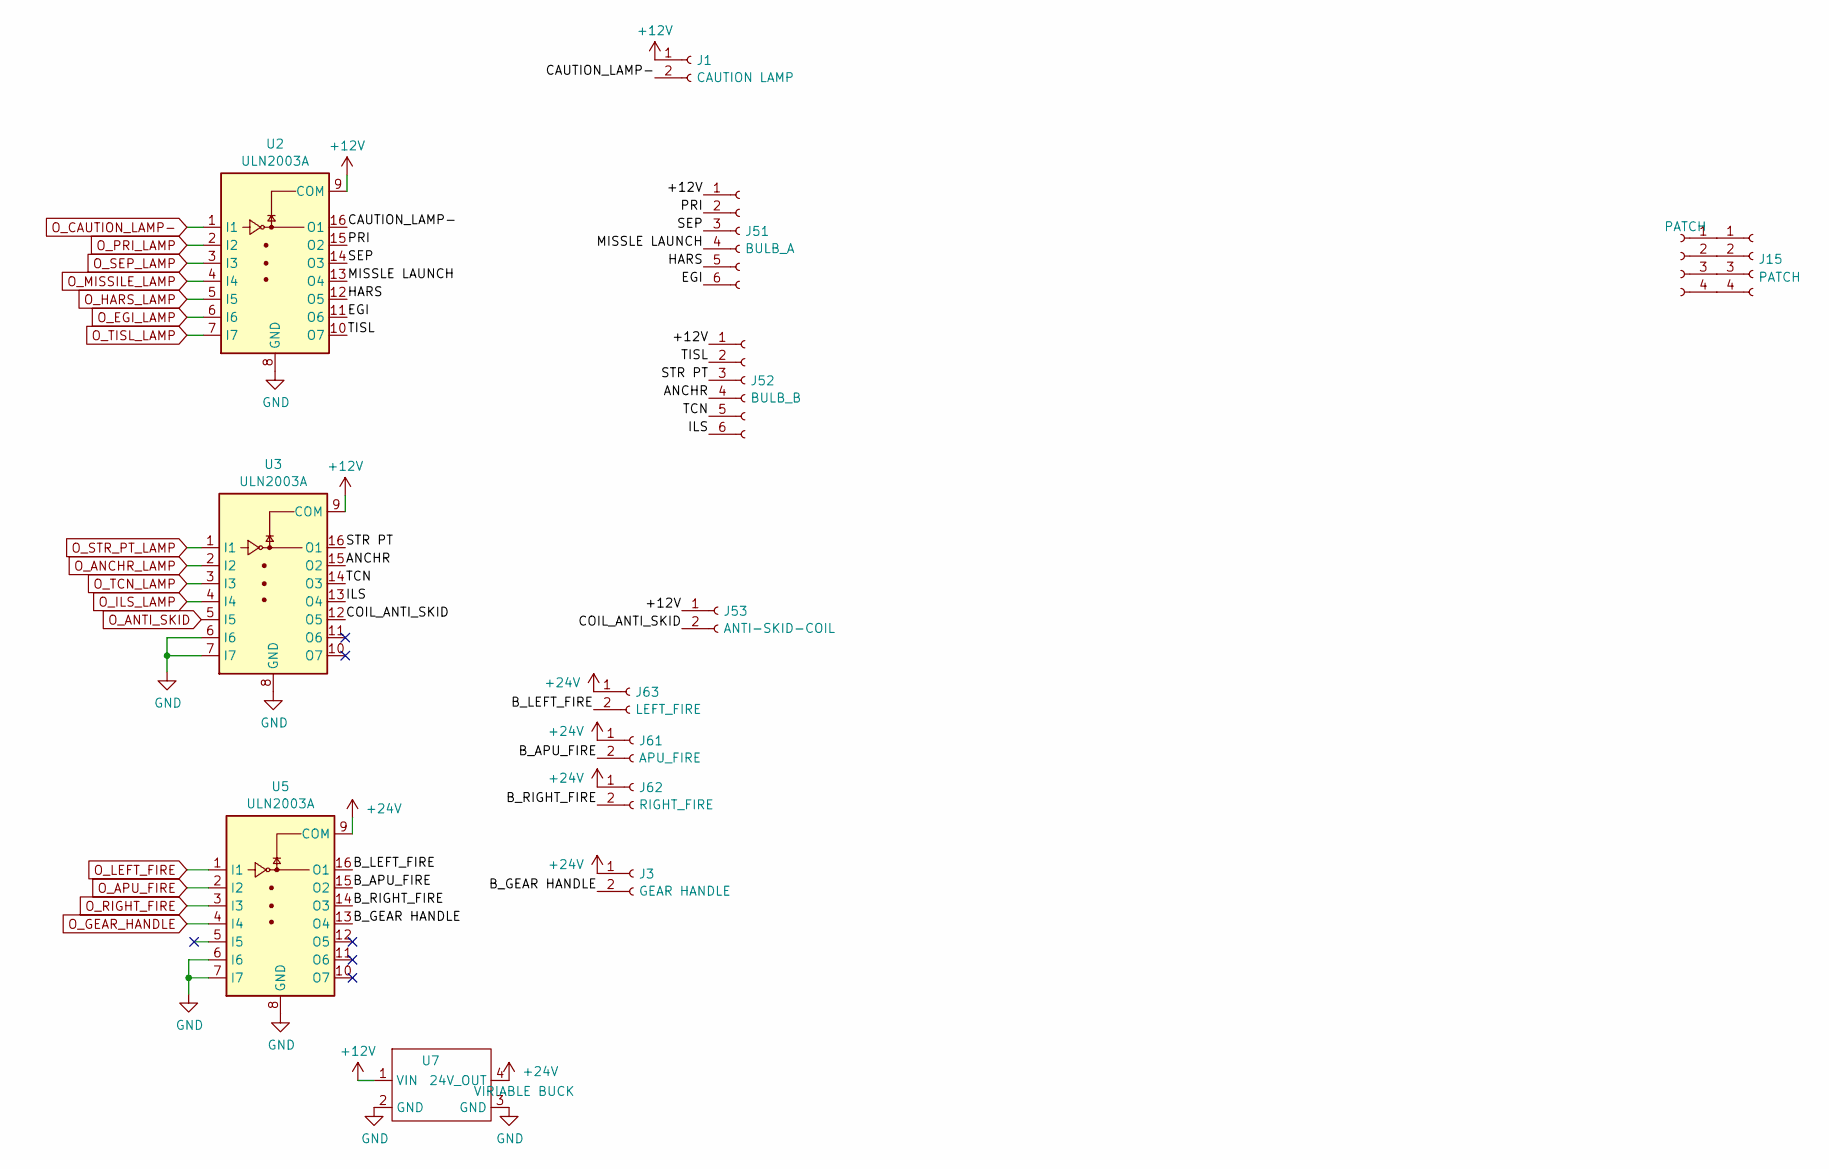
[picture p551: schematic COIL AND LAMP DRIVERS.kicad_sch]

Parts:
J1: CAUTION LAMP; Molex_KK-254_AE-6410-02A_1x02_P2.54mm_Vertical
J3: GEAR HANDLE; Molex_KK-254_AE-6410-02A_1x02_P2.54mm_Vertical
J10, J15: PATCH; PinHeader_1x04_P2.54mm_Vertical
J51: BULB_A; Molex_KK-254_AE-6410-06A_1x06_P2.54mm_Vertical
J52: BULB_B; Molex_KK-254_AE-6410-06A_1x06_P2.54mm_Vertical
J53: ANTI-SKID-COIL; Molex_KK-254_AE-6410-02A_1x02_P2.54mm_Vertical
J61: APU_FIRE; Molex_KK-254_AE-6410-02A_1x02_P2.54mm_Vertical
J62: RIGHT_FIRE; Molex_KK-254_AE-6410-02A_1x02_P2.54mm_Vertical
J63: LEFT_FIRE; Molex_KK-254_AE-6410-02A_1x02_P2.54mm_Vertical
U2, U3, U5: ULN2003A; DIP-16_W7.62mm_LongPads
U7: VIRIABLE BUCK; VARIABLE_BUCK

Connections:
+12V: J1.1, J51.1, J52.1, J53.1, U2.9 (COM), U3.9 (COM), U7.1 (VIN)
+24V: J3.1, J61.1, J62.1, J63.1, U5.9 (COM), U7.4 (24V_OUT)
ANCHR: J52.4, U3.15 (O2)
B_APU_FIRE: J61.2, U5.15 (O2)
B_GEAR HANDLE: J3.2, U5.13 (O4)
B_LEFT_FIRE: J63.2, U5.16 (O1)
B_RIGHT_FIRE: J62.2, U5.14 (O3)
CAUTION_LAMP-: J1.2, U2.16 (O1)
COIL_ANTI_SKID: J53.2, U3.12 (O5)
EGI: J51.6, U2.11 (O6)
GND: U2.8 (GND), U3.6 (I6), U3.7 (I7), U3.8 (GND), U5.6 (I6), U5.7 (I7), U5.8 (GND), U7.2 (GND), U7.3 (GND)
HARS: J51.5, U2.12 (O5)
ILS: J52.6, U3.13 (O4)
MISSLE LAUNCH: J51.4, U2.13 (O4)
unnamed: J10.1, J15.1
unnamed: J10.2, J15.2
unnamed: J10.3, J15.3
unnamed: J10.4, J15.4
O_ANCHR_LAMP: U3.2 (I2)
O_ANTI_SKID: U3.5 (I5)
O_APU_FIRE: U5.2 (I2)
O_CAUTION_LAMP-: U2.1 (I1)
O_EGI_LAMP: U2.6 (I6)
O_GEAR_HANDLE: U5.4 (I4)
O_HARS_LAMP: U2.5 (I5)
O_ILS_LAMP: U3.4 (I4)
O_LEFT_FIRE: U5.1 (I1)
O_MISSILE_LAMP: U2.4 (I4)
O_PRI_LAMP: U2.2 (I2)
O_RIGHT_FIRE: U5.3 (I3)
O_SEP_LAMP: U2.3 (I3)
O_STR_PT_LAMP: U3.1 (I1)
O_TCN_LAMP: U3.3 (I3)
O_TISL_LAMP: U2.7 (I7)
PRI: J51.2, U2.15 (O2)
SEP: J51.3, U2.14 (O3)
STR PT: J52.3, U3.16 (O1)
TCN: J52.5, U3.14 (O3)
TISL: J52.2, U2.10 (O7)
