bnepethomas/bne-arduino-flight-simulator-interfaces/A10/A10 PCBs/Forward Console Combined Input and Output/Forward Console Combined Input and Output.kicad_sch

## KiCad design A10/A10 PCBs/Forward Console Combined Input and Output/Forward Console Combined Input and Output.kicad_sch (2025-11-29)

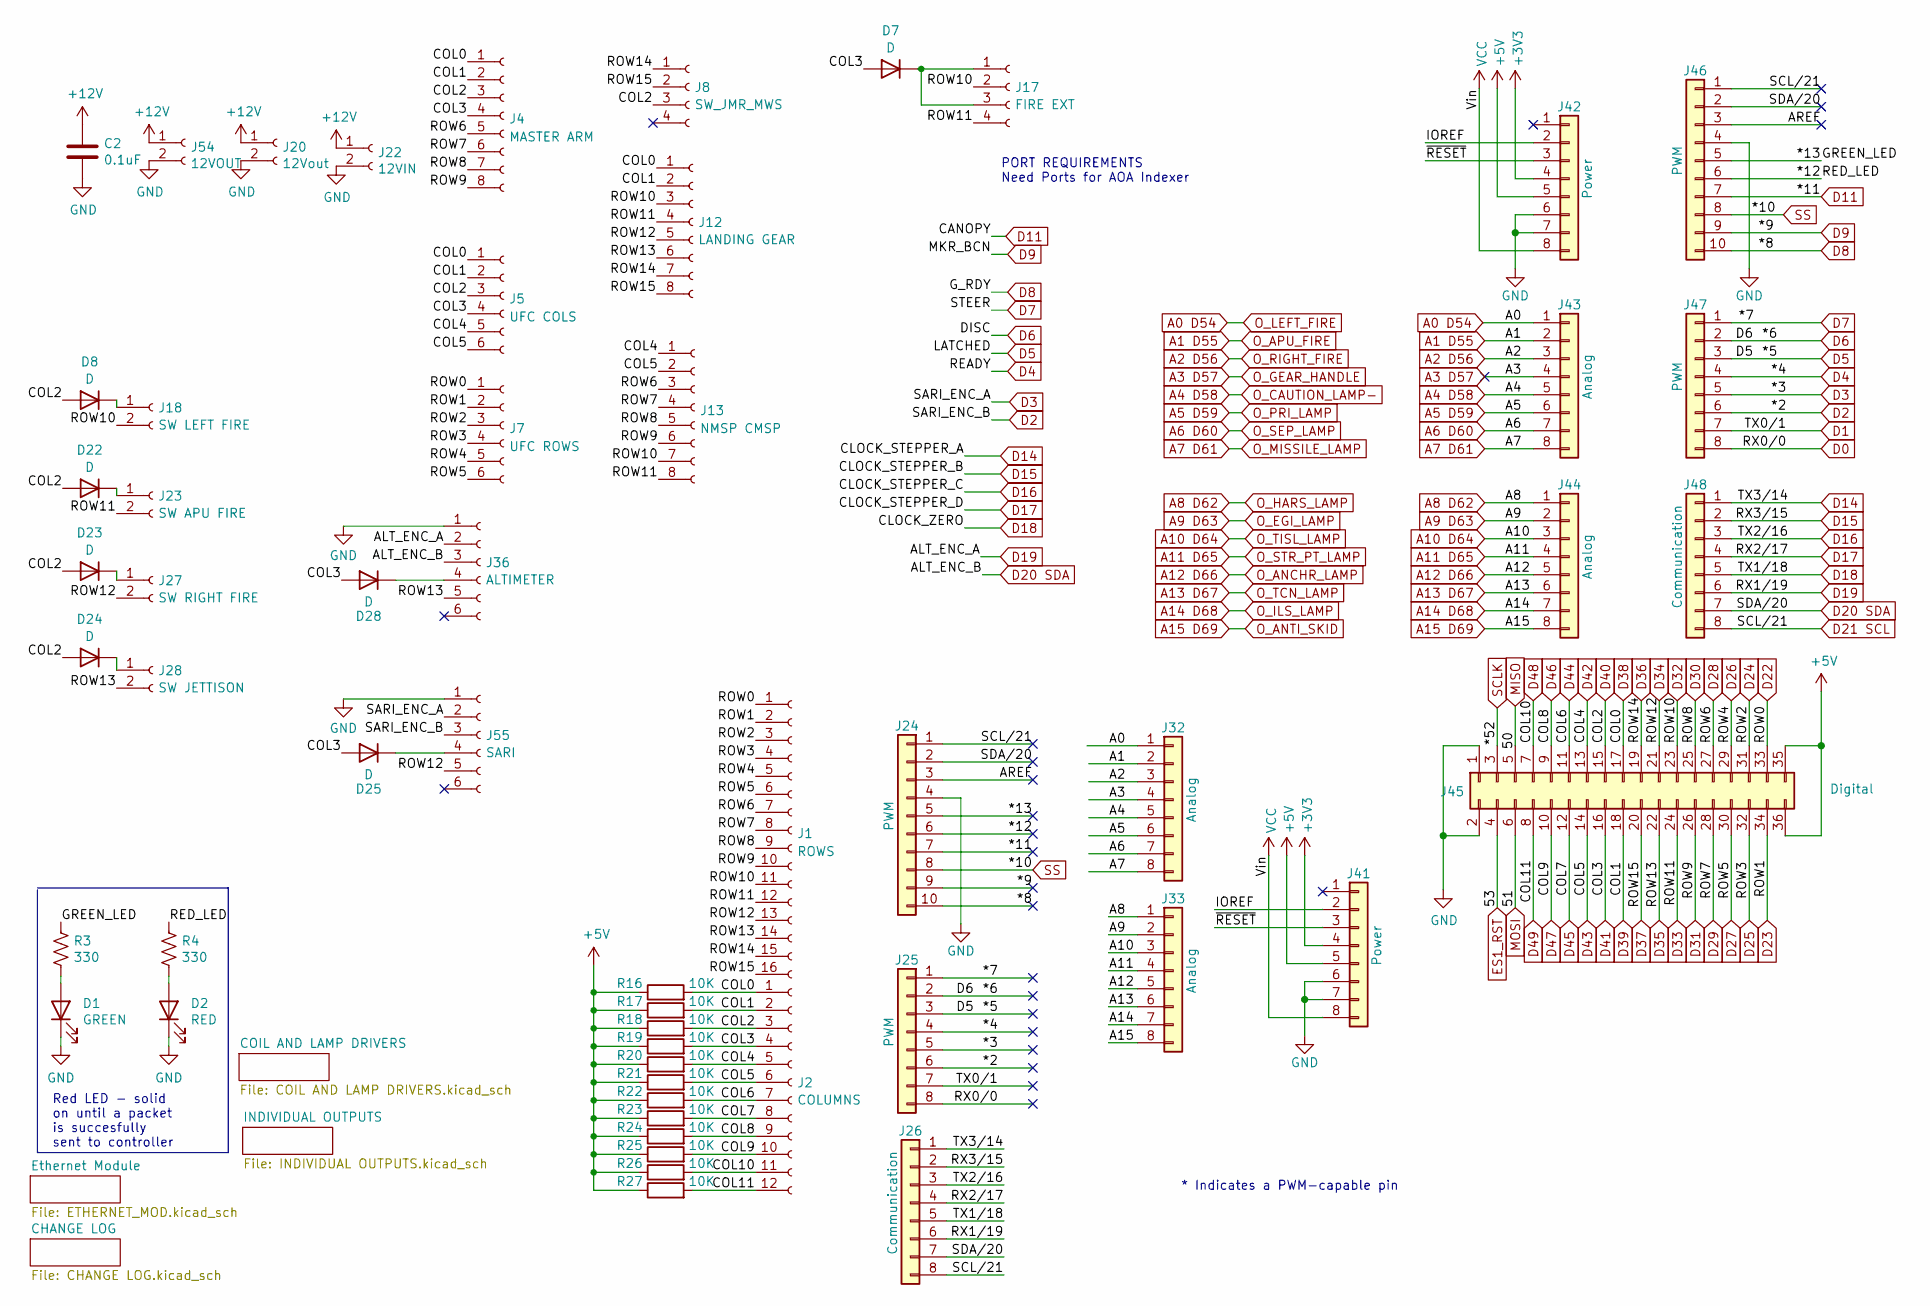
[picture p553: schematic Forward Console Combined Input and Output.kicad_sch]

Parts:
C2: 0.1uF; C_Disc_D4.3mm_W1.9mm_P5.00mm
D1: GREEN; LED_D3.0mm
D2: RED; LED_D3.0mm
D7, D8, D22, D23, D24, D25, D28: D; D_T-1_P5.08mm_Horizontal
J1: ROWS; PinHeader_1x16_P2.54mm_Vertical
J2: COLUMNS; PinHeader_1x12_P2.54mm_Vertical
J4: MASTER ARM; Molex_KK-254_AE-6410-08A_1x08_P2.54mm_Vertical
J5: UFC COLS; Molex_KK-254_AE-6410-06A_1x06_P2.54mm_Vertical
J7: UFC ROWS; Molex_KK-254_AE-6410-06A_1x06_P2.54mm_Vertical
J8: SW_JMR_MWS; Molex_KK-254_AE-6410-04A_1x04_P2.54mm_Vertical
J12: LANDING GEAR; Molex_KK-254_AE-6410-08A_1x08_P2.54mm_Vertical
J13: NMSP CMSP; Molex_KK-254_AE-6410-08A_1x08_P2.54mm_Vertical
J17: FIRE EXT; Molex_KK-254_AE-6410-04A_1x04_P2.54mm_Vertical
J18: SW LEFT FIRE; Molex_KK-254_AE-6410-02A_1x02_P2.54mm_Vertical
J20: 12Vout; BarrelJack_Horizontal
J22: 12VIN; BarrelJack_Horizontal
J23: SW APU FIRE; Molex_KK-254_AE-6410-02A_1x02_P2.54mm_Vertical
J24, J46: PWM; PinSocket_1x10_P2.54mm_Vertical
J25, J47: PWM; PinSocket_1x08_P2.54mm_Vertical
J26, J48: Communication; PinSocket_1x08_P2.54mm_Vertical
J27: SW RIGHT FIRE; Molex_KK-254_AE-6410-02A_1x02_P2.54mm_Vertical
J28: SW JETTISON; Molex_KK-254_AE-6410-02A_1x02_P2.54mm_Vertical
J32, J33, J43, J44: Analog; PinSocket_1x08_P2.54mm_Vertical
J36: ALTIMETER; Molex_KK-254_AE-6410-06A_1x06_P2.54mm_Vertical
J41, J42: Power; PinSocket_1x08_P2.54mm_Vertical
J45: Digital; PinSocket_2x18_P2.54mm_Vertical
J54: 12VOUT; BarrelJack_Horizontal
J55: SARI; Molex_KK-254_AE-6410-06A_1x06_P2.54mm_Vertical
R3, R4: 330; R_Axial_DIN0204_L3.6mm_D1.6mm_P2.54mm_Vertical
R16, R17, R18, R19, R20, R21, R22, R23, R24, R25, R26, R27: 10K; R_Axial_DIN0204_L3.6mm_D1.6mm_P2.54mm_Vertical

Connections:
2: J25.6, J47.6, J55.3
3: J25.5, J47.5, J55.2
4: J25.4, J47.4
5: J25.3, J47.3
6: J25.2, J47.2
7: J25.1, J47.1
8: J24.10, J46.10
9: J24.9, J46.9
10: J24.8, J46.8
11: J24.7, J46.7
12: J24.6, J46.6, R4.1
13: J24.5, J46.5, R3.1
52: J45.3
+3V3: J41.4, J42.4
+5V: J41.5, J42.5, J45.35, J45.36, R16.1, R17.1, R18.1, R19.1, R20.1, R21.1, R22.1, R23.1, R24.1, R25.1, R26.1, R27.1
+12V: C2.1, J20.1, J22.1, J54.1
A0 D54: J32.1, J43.1
A1 D55: J32.2, J43.2
A2 D56: J32.3, J43.3
A3 D57: J32.4, J43.4
A4 D58: J32.5, J43.5
A5 D59: J32.6, J43.6
A6 D60: J32.7, J43.7
A7 D61: J32.8, J43.8
A8 D62: J33.1, J44.1
A9 D63: J33.2, J44.2
A10 D64: J33.3, J44.3
A11 D65: J33.4, J44.4
A12 D66: J33.5, J44.5
A13 D67: J33.6, J44.6
A14 D68: J33.7, J44.7
A15 D69: J33.8, J44.8
AREF: J24.3, J46.3
D0: J25.8, J47.8
D1: J25.7, J47.7
D14: J26.1, J48.1
D15: J26.2, J48.2
D16: J26.3, J48.3
D17: J26.4, J48.4
D18: J26.5, J48.5
D19: J26.6, J36.2, J48.6
D20 SDA: J24.2, J26.7, J36.3, J46.2, J48.7
D21 SCL: J24.1, J26.8, J46.1, J48.8
D22: J1.1, J7.1, J45.33
D23: J1.2, J7.2, J45.34
D24: J1.3, J7.3, J45.31
D25: J1.4, J7.4, J45.32
D26: J1.5, J7.5, J45.29
D27: J1.6, J7.6, J45.30
D28: J1.7, J4.5, J13.3, J45.27
D29: J1.8, J4.6, J13.4, J45.28
D30: J1.9, J4.7, J13.5, J45.25
D31: J1.10, J4.8, J13.6, J45.26
D32: J1.11, J12.3, J13.7, J17.2, J18.2, J45.23
D33: J1.12, J12.4, J13.8, J17.4, J23.2, J45.24
D34: J1.13, J12.5, J27.2, J45.21, J55.5
D35: J1.14, J12.6, J28.2, J36.5, J45.22
D36: J1.15, J8.1, J12.7, J45.19
D37: J1.16, J8.2, J12.8, J45.20
D38: J2.1, J4.1, J5.1, J12.1, J45.17, R16.2
D39: J2.2, J4.2, J5.2, J12.2, J45.18, R17.2
D40: D8.2 (A), D22.2 (A), D23.2 (A), D24.2 (A), J2.3, J4.3, J5.3, J8.3, J45.15, R18.2
D41: D7.2 (A), D25.2 (A), D28.2 (A), J2.4, J4.4, J5.4, J45.16, R19.2
D42: J2.5, J5.5, J13.1, J45.13, R20.2
D43: J2.6, J5.6, J13.2, J45.14, R21.2
D44: J2.7, J45.11, R22.2
D45: J2.8, J45.12, R23.2
D46: J2.9, J45.9, R24.2
D47: J2.10, J45.10, R25.2
D48: J2.11, J45.7, R26.2
D49: J2.12, J45.8, R27.2
ES1_RST: J45.4
GND: C2.2, D1.1 (K), D2.1 (K), J20.2, J22.2, J24.4, J36.1, J41.6, J41.7, J42.6, J42.7, J45.1, J45.2, J46.4, J54.2, J55.1
IOREF: J41.2, J42.2
MISO: J45.5
MOSI: J45.6
unnamed: D1.2 (A), R3.2
unnamed: D2.2 (A), R4.2
unnamed: D7.1 (K), J17.1, J17.3
unnamed: D8.1 (K), J18.1
unnamed: D22.1 (K), J23.1
unnamed: D23.1 (K), J27.1
unnamed: D24.1 (K), J28.1
unnamed: D25.1 (K), J55.4
unnamed: D28.1 (K), J36.4
VCC: J41.8, J42.8
~RESET: J41.3, J42.3

Notes on the sheet:
Red LED - solid on until a packet is succesfully sent to controller
* Indicates a PWM-capable pin
PORT REQUIREMENTS Need Ports for AOA Indexer
