bnepethomas/bne-arduino-flight-simulator-interfaces/A10/A10 PCBs/Forward Console Combined Input and Output/INDIVIDUAL OUTPUTS.kicad_sch

## KiCad design A10/A10 PCBs/Forward Console Combined Input and Output/INDIVIDUAL OUTPUTS.kicad_sch (2025-11-29)

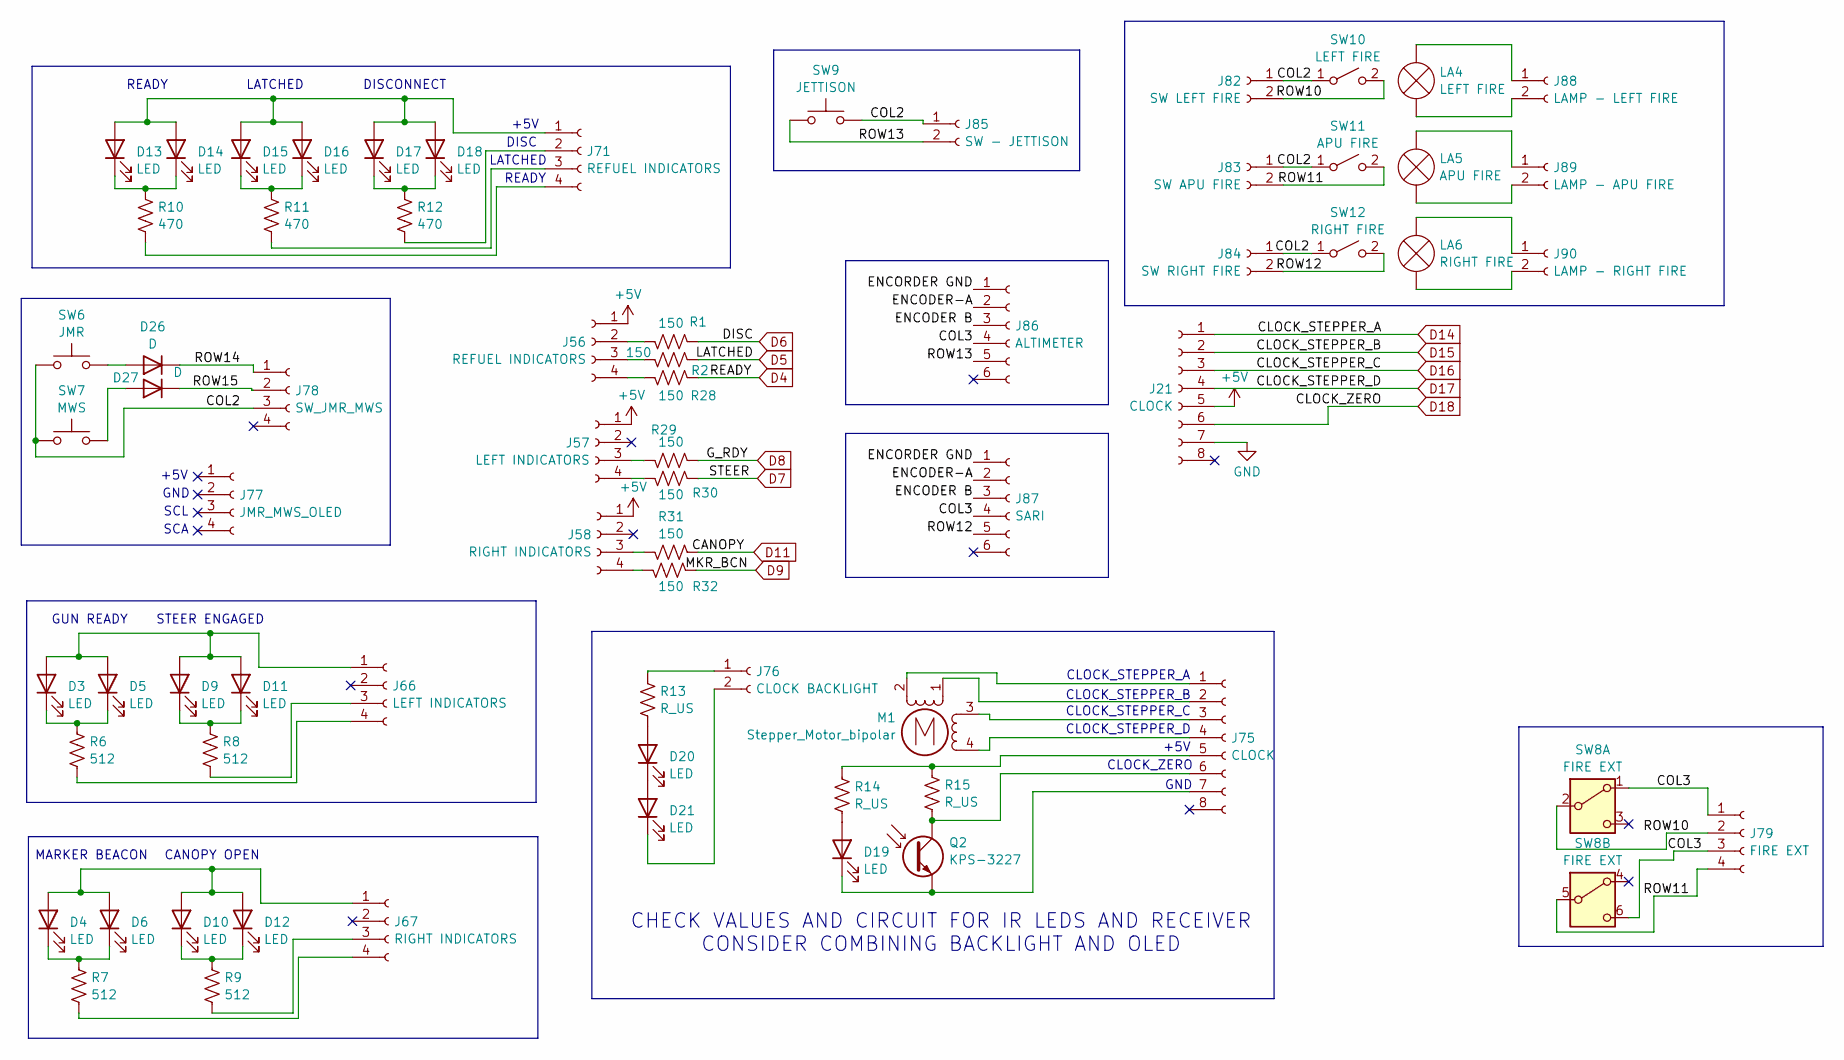
[picture p554: schematic INDIVIDUAL OUTPUTS.kicad_sch]

Parts:
D3, D4, D5, D6, D9, D10, D11, D12, D13, D14, D15, D16, D17, D18, D19, D20, D21: LED
D26, D27: D; D_T-1_P5.08mm_Horizontal
J21: CLOCK; Molex_KK-254_AE-6410-08A_1x08_P2.54mm_Vertical
J56, J71: REFUEL INDICATORS; Molex_KK-254_AE-6410-04A_1x04_P2.54mm_Vertical
J57, J66: LEFT INDICATORS; Molex_KK-254_AE-6410-04A_1x04_P2.54mm_Vertical
J58, J67: RIGHT INDICATORS; Molex_KK-254_AE-6410-04A_1x04_P2.54mm_Vertical
J75: CLOCK
J76: CLOCK BACKLIGHT
J77: JMR_MWS_OLED; Molex_KK-254_AE-6410-04A_1x04_P2.54mm_Vertical
J78: SW_JMR_MWS; Molex_KK-254_AE-6410-04A_1x04_P2.54mm_Vertical
J79: FIRE EXT; Molex_KK-254_AE-6410-04A_1x04_P2.54mm_Vertical
J82: SW LEFT FIRE
J83: SW APU FIRE
J84: SW RIGHT FIRE
J85: SW - JETTISON
J86: ALTIMETER; Molex_KK-254_AE-6410-06A_1x06_P2.54mm_Vertical
J87: SARI; Molex_KK-254_AE-6410-06A_1x06_P2.54mm_Vertical
J88: LAMP - LEFT FIRE
J89: LAMP - APU FIRE
J90: LAMP - RIGHT FIRE
LA4: LEFT FIRE
LA5: APU FIRE
LA6: RIGHT FIRE
M1: Stepper_Motor_bipolar
Q2: KPS-3227; Kingbright_KPS-3227
R1, R2, R28, R29, R30, R31, R32: 150; R_Axial_DIN0204_L3.6mm_D1.6mm_P2.54mm_Vertical
R6, R7, R8, R9: 512
R10, R11, R12: 470
R13, R14, R15: R_US; R_Axial_DIN0204_L3.6mm_D1.6mm_P2.54mm_Vertical
SW6: JMR
SW7: MWS
SW8: FIRE EXT
SW9: JETTISON
SW10: LEFT FIRE; Molex_KK-254_AE-6410-02A_1x02_P2.54mm_Vertical
SW11: APU FIRE; Molex_KK-254_AE-6410-02A_1x02_P2.54mm_Vertical
SW12: RIGHT FIRE; Molex_KK-254_AE-6410-02A_1x02_P2.54mm_Vertical

Connections:
+5V: J21.5, J56.1, J57.1, J58.1
COL2: J78.3, J82.1, J83.1, J84.1, J85.1, SW6.1, SW7.1, SW9.2, SW10.1 (A), SW11.1 (A), SW12.1 (A)
COL3: J79.1, J79.3, J86.4, J87.4, SW8.1 (A), SW8.6 (C)
D4: R28.2
D5: R2.2
D6: R1.2
D7: R30.2
D8: R29.2
D9: R32.2
D11: R31.2
D14: J21.1
D15: J21.2
D16: J21.3
D17: J21.4
D18: J21.6
ENCODER B: J86.3, J87.3
ENCODER-A: J86.2, J87.2
ENCORDER GND: J86.1, J87.1
GND: J21.7
unnamed: D3.1 (K), D5.1 (K), R6.1
unnamed: D4.1 (K), D6.1 (K), R7.1
unnamed: D10.1 (K), D12.1 (K), R9.1
unnamed: D4.2 (A), D6.2 (A), D10.2 (A), D12.2 (A), J67.1
unnamed: D9.1 (K), D11.1 (K), R8.1
unnamed: D3.2 (A), D5.2 (A), D9.2 (A), D11.2 (A), J66.1
unnamed: D13.1 (K), D14.1 (K), R10.1
unnamed: D13.2 (A), D14.2 (A), D15.2 (A), D16.2 (A), D17.2 (A), D18.2 (A), J71.1
unnamed: D15.1 (K), D16.1 (K), R11.1
unnamed: D17.1 (K), D18.1 (K), R12.1
unnamed: D19.1 (K), J75.7, Q2.2, Q2.4
unnamed: D19.2 (A), R14.2
unnamed: D20.1 (K), D21.2 (A)
unnamed: D20.2 (A), R13.2
unnamed: D21.1 (K), J76.2
unnamed: D26.2 (A), SW6.2
unnamed: D27.2 (A), SW7.2
unnamed: J56.2, R1.1
unnamed: J56.3, R2.1
unnamed: J56.4, R28.1
unnamed: J57.3, R29.1
unnamed: J57.4, R30.1
unnamed: J58.3, R31.1
unnamed: J58.4, R32.1
unnamed: J66.3, R8.2
unnamed: J66.4, R6.2
unnamed: J67.3, R9.2
unnamed: J67.4, R7.2
unnamed: J71.2, R12.2
unnamed: J71.3, R11.2
unnamed: J71.4, R10.2
unnamed: J75.1, M1.2 (-)
unnamed: J75.2, M1.1
unnamed: J75.3, M1.3
unnamed: J75.4, M1.4
unnamed: J75.5, R14.1, R15.1
unnamed: J75.6, Q2.1, Q2.3, R15.2
unnamed: J76.1, R13.1
unnamed: J88.1, LA4.2 (+)
unnamed: J88.2, LA4.1 (-)
unnamed: J89.1, LA5.2 (+)
unnamed: J89.2, LA5.1 (-)
unnamed: J90.1, LA6.2 (+)
unnamed: J90.2, LA6.1 (-)
ROW10: J79.2, J82.2, SW8.2 (B), SW10.2 (B)
ROW11: J79.4, J83.2, SW8.5 (B), SW11.2 (B)
ROW12: J84.2, J87.5, SW12.2 (B)
ROW13: J85.2, J86.5, SW9.1
ROW14: D26.1 (K), J78.1
ROW15: D27.1 (K), J78.2

Notes on the sheet:
GUN READY
READY
+5V
CLOCK_STEPPER_A
DISC
CLOCK_STEPPER_C
GND
CLOCK_ZERO
LATCHED
CHECK VALUES AND CIRCUIT FOR IR LEDS AND RECEIVER CONSIDER COMBINING BACKLIGHT AND OLED
DISCONNECT
SCL
SCA
CLOCK_STEPPER_D
CANOPY OPEN
STEER ENGAGED
MARKER BEACON
CLOCK_STEPPER_B
