bnepethomas/bne-arduino-flight-simulator-interfaces/A10/A10 PCBs/Forward Console Combined Input and Output/MAX7219A.kicad_sch

## KiCad design A10/A10 PCBs/Forward Console Combined Input and Output/MAX7219A.kicad_sch (2025-11-29)

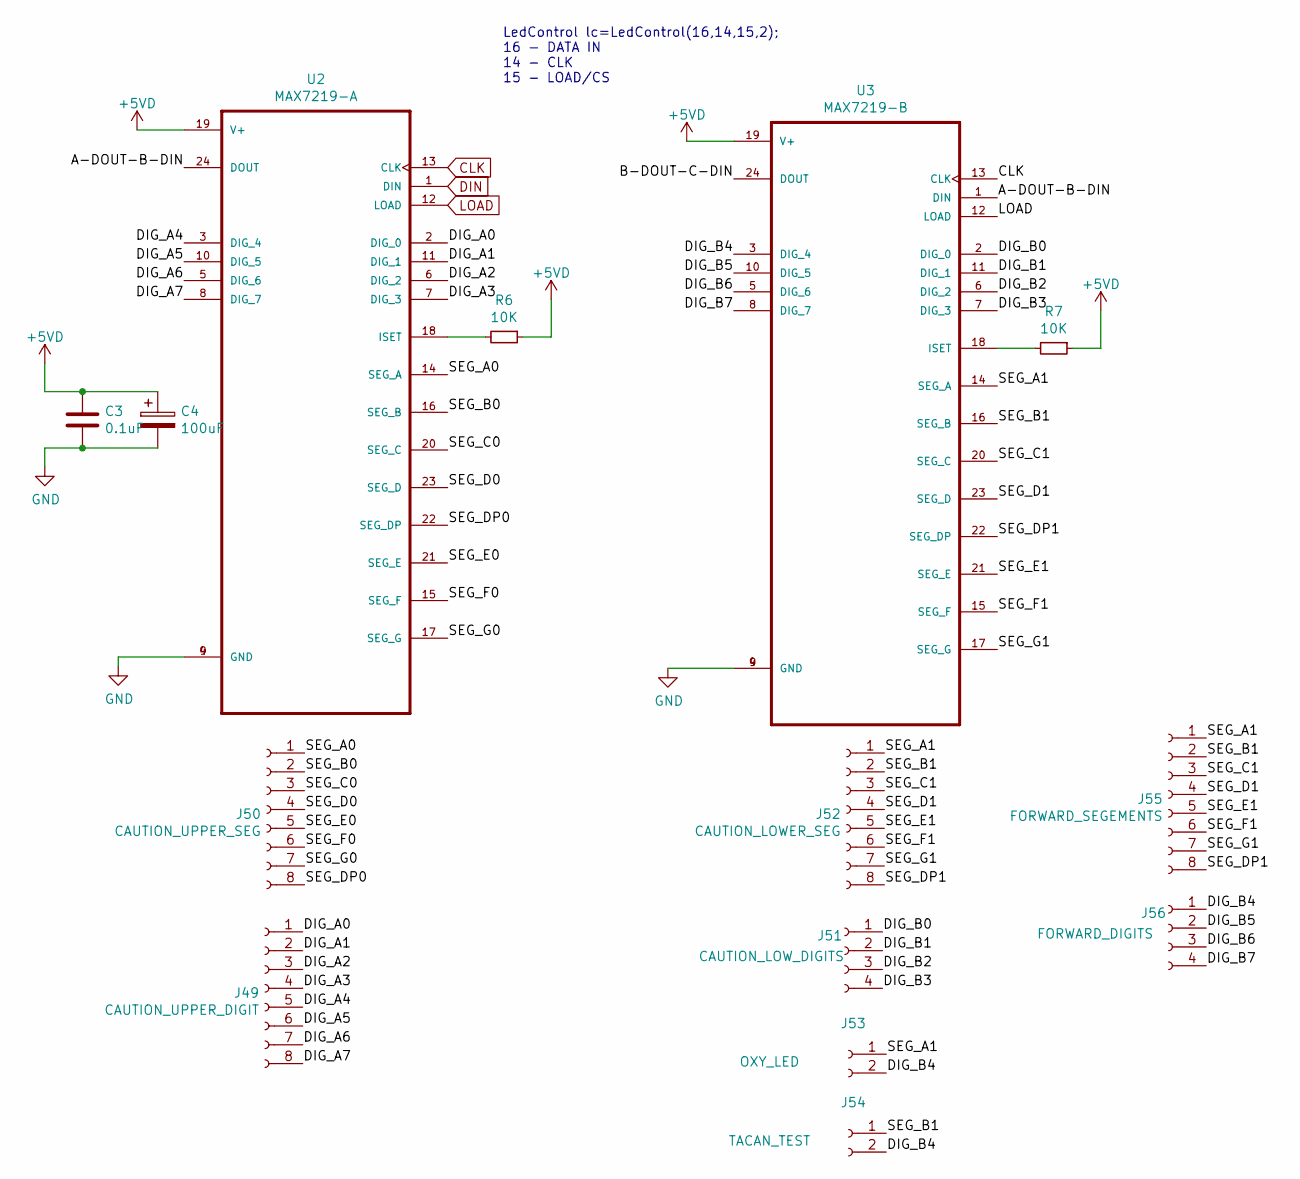
[picture p555: schematic MAX7219A.kicad_sch]

Parts:
C3: 0.1uF; C_Disc_D5.1mm_W3.2mm_P5.00mm
C4: 100uF; CP_Radial_D8.0mm_P5.00mm
J49: CAUTION_UPPER_DIGIT; Molex_KK-254_AE-6410-08A_1x08_P2.54mm_Vertical
J50: CAUTION_UPPER_SEG; Molex_KK-254_AE-6410-08A_1x08_P2.54mm_Vertical
J51: CAUTION_LOW_DIGITS; Molex_KK-254_AE-6410-04A_1x04_P2.54mm_Vertical
J52: CAUTION_LOWER_SEG; Molex_KK-254_AE-6410-08A_1x08_P2.54mm_Vertical
J53: OXY_LED; Molex_KK-254_AE-6410-02A_1x02_P2.54mm_Vertical
J54: TACAN_TEST; Molex_KK-254_AE-6410-02A_1x02_P2.54mm_Vertical
J55: FORWARD_SEGEMENTS; Molex_KK-254_AE-6410-08A_1x08_P2.54mm_Vertical
J56: FORWARD_DIGITS; Molex_KK-254_AE-6410-04A_1x04_P2.54mm_Vertical
R6, R7: 10K; R_Axial_DIN0204_L3.6mm_D1.6mm_P2.54mm_Vertical
U2: MAX7219-A; DIP-24_W7.62mm_Socket
U3: MAX7219-B; DIP-24_W7.62mm_Socket

Connections:
+5VD: C3.1, C4.1, R6.1, R7.1, U2.19 (V+), U3.19 (V+)
A-DOUT-B-DIN: U2.24 (DOUT), U3.1 (DIN)
B-DOUT-C-DIN: U3.24 (DOUT)
CLK: U2.13 (CLK), U3.13 (CLK)
DIG_A0: J49.1, U2.2 (DIG_0)
DIG_A1: J49.2, U2.11 (DIG_1)
DIG_A2: J49.3, U2.6 (DIG_2)
DIG_A3: J49.4, U2.7 (DIG_3)
DIG_A4: J49.5, U2.3 (DIG_4)
DIG_A5: J49.6, U2.10 (DIG_5)
DIG_A6: J49.7, U2.5 (DIG_6)
DIG_A7: J49.8, U2.8 (DIG_7)
DIG_B0: J51.1, U3.2 (DIG_0)
DIG_B1: J51.2, U3.11 (DIG_1)
DIG_B2: J51.3, U3.6 (DIG_2)
DIG_B3: J51.4, U3.7 (DIG_3)
DIG_B4: J53.2, J54.2, J56.1, U3.3 (DIG_4)
DIG_B5: J56.2, U3.10 (DIG_5)
DIG_B6: J56.3, U3.5 (DIG_6)
DIG_B7: J56.4, U3.8 (DIG_7)
DIN: U2.1 (DIN)
GND: C3.2, C4.2, U2.4 (GND), U2.9 (GND), U3.4 (GND), U3.9 (GND)
LOAD: U2.12 (LOAD), U3.12 (LOAD)
unnamed: R6.2, U2.18 (ISET)
unnamed: R7.2, U3.18 (ISET)
SEG_A0: J50.1, U2.14 (SEG_A)
SEG_A1: J52.1, J53.1, J55.1, U3.14 (SEG_A)
SEG_B0: J50.2, U2.16 (SEG_B)
SEG_B1: J52.2, J54.1, J55.2, U3.16 (SEG_B)
SEG_C0: J50.3, U2.20 (SEG_C)
SEG_C1: J52.3, J55.3, U3.20 (SEG_C)
SEG_D0: J50.4, U2.23 (SEG_D)
SEG_D1: J52.4, J55.4, U3.23 (SEG_D)
SEG_DP0: J50.8, U2.22 (SEG_DP)
SEG_DP1: J52.8, J55.8, U3.22 (SEG_DP)
SEG_E0: J50.5, U2.21 (SEG_E)
SEG_E1: J52.5, J55.5, U3.21 (SEG_E)
SEG_F0: J50.6, U2.15 (SEG_F)
SEG_F1: J52.6, J55.6, U3.15 (SEG_F)
SEG_G0: J50.7, U2.17 (SEG_G)
SEG_G1: J52.7, J55.7, U3.17 (SEG_G)

Notes on the sheet:
LedControl lc=LedControl(16,14,15,2); 16 - DATA IN 14 - CLK 15 - LOAD/CS
