bnepethomas/bne-arduino-flight-simulator-interfaces/A10/A10 PCBs/Forward Console Combined Input and Output/STEPPER_DRIVERS.kicad_sch

## KiCad design A10/A10 PCBs/Forward Console Combined Input and Output/STEPPER_DRIVERS.kicad_sch (2025-11-29)

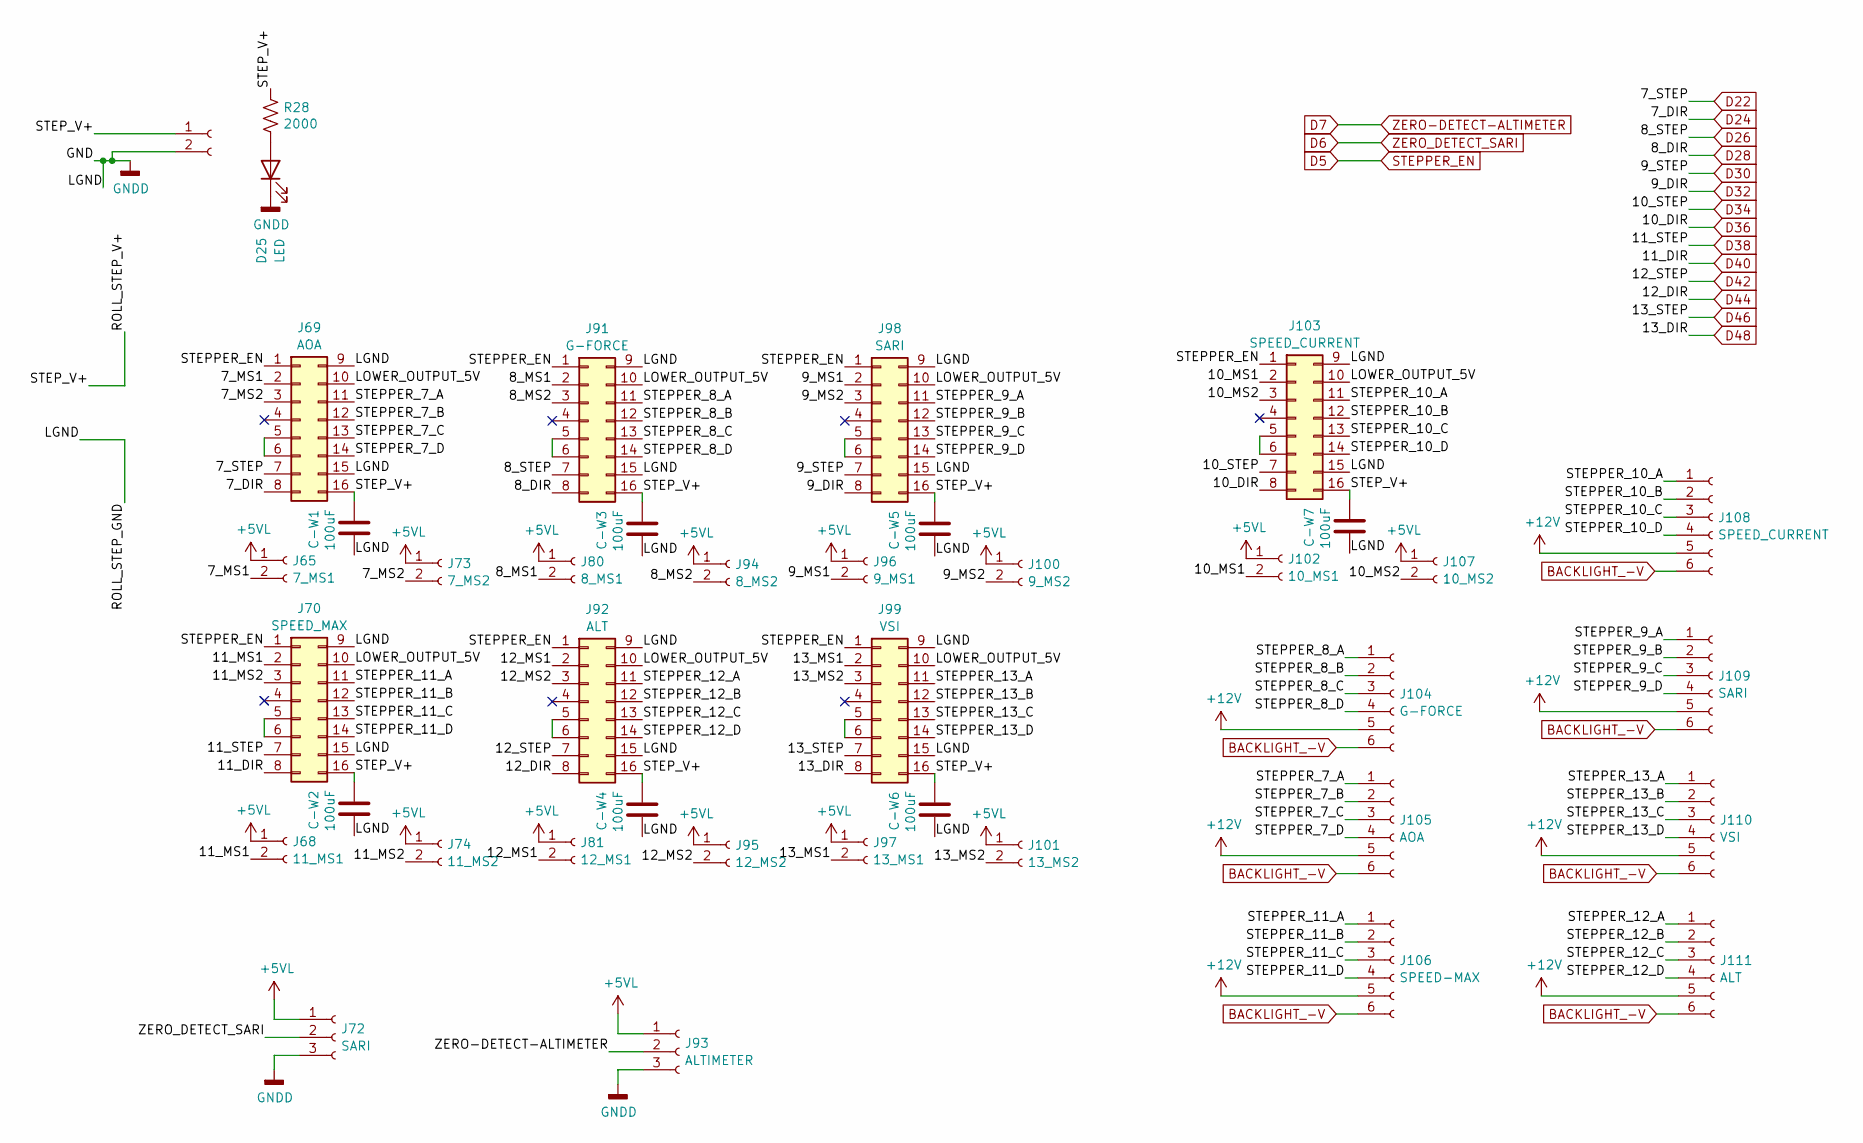
[picture p557: schematic STEPPER_DRIVERS.kicad_sch]

Parts:
C-W1, C-W2, C-W3, C-W4, C-W5, C-W6, C-W7: 100uF; C_Radial_D8.0mm_H7.0mm_P3.50mm
D25: LED; LED_D3.0mm
J54: STEPPER IN 12-20VDC; BarrelJack_Horizontal
J65: 7_MS1; PinHeader_1x02_P2.54mm_Vertical
J68: 11_MS1; PinHeader_1x02_P2.54mm_Vertical
J69: AOA; Pololu_Breakout-16_15.2x20.3mm
J70: SPEED_MAX; Pololu_Breakout-16_15.2x20.3mm
J72: SARI; Molex_KK-254_AE-6410-03A_1x03_P2.54mm_Vertical
J73: 7_MS2; PinHeader_1x02_P2.54mm_Vertical
J74: 11_MS2; PinHeader_1x02_P2.54mm_Vertical
J80: 8_MS1; PinHeader_1x02_P2.54mm_Vertical
J81: 12_MS1; PinHeader_1x02_P2.54mm_Vertical
J91: G-FORCE; Pololu_Breakout-16_15.2x20.3mm
J92: ALT; Pololu_Breakout-16_15.2x20.3mm
J93: ALTIMETER; Molex_KK-254_AE-6410-03A_1x03_P2.54mm_Vertical
J94: 8_MS2; PinHeader_1x02_P2.54mm_Vertical
J95: 12_MS2; PinHeader_1x02_P2.54mm_Vertical
J96: 9_MS1; PinHeader_1x02_P2.54mm_Vertical
J97: 13_MS1; PinHeader_1x02_P2.54mm_Vertical
J98: SARI; Pololu_Breakout-16_15.2x20.3mm
J99: VSI; Pololu_Breakout-16_15.2x20.3mm
J100: 9_MS2; PinHeader_1x02_P2.54mm_Vertical
J101: 13_MS2; PinHeader_1x02_P2.54mm_Vertical
J102: 10_MS1; PinHeader_1x02_P2.54mm_Vertical
J103: SPEED_CURRENT; Pololu_Breakout-16_15.2x20.3mm
J104: G-FORCE; Molex_KK-254_AE-6410-06A_1x06_P2.54mm_Vertical
J105: AOA; Molex_KK-254_AE-6410-06A_1x06_P2.54mm_Vertical
J106: SPEED-MAX; Molex_KK-254_AE-6410-06A_1x06_P2.54mm_Vertical
J107: 10_MS2; PinHeader_1x02_P2.54mm_Vertical
J108: SPEED_CURRENT; Molex_KK-254_AE-6410-06A_1x06_P2.54mm_Vertical
J109: SARI; Molex_KK-254_AE-6410-06A_1x06_P2.54mm_Vertical
J110: VSI; Molex_KK-254_AE-6410-06A_1x06_P2.54mm_Vertical
J111: ALT; Molex_KK-254_AE-6410-06A_1x06_P2.54mm_Vertical
R28: 2000; R_Axial_DIN0204_L3.6mm_D1.6mm_P2.54mm_Vertical

Connections:
7_MS1: J65.2, J69.2
7_MS2: J69.3, J73.2
8_MS1: J80.2, J91.2
8_MS2: J91.3, J94.2
9_MS1: J96.2, J98.2
9_MS2: J98.3, J100.2
10_MS1: J102.2, J103.2
10_MS2: J103.3, J107.2
11_MS1: J68.2, J70.2
11_MS2: J70.3, J74.2
12_MS1: J81.2, J92.2
12_MS2: J92.3, J95.2
13_MS1: J97.2, J99.2
13_MS2: J99.3, J101.2
+5VL: J65.1, J68.1, J72.1, J73.1, J74.1, J80.1, J81.1, J93.1, J94.1, J95.1, J96.1, J97.1, J100.1, J101.1, J102.1, J107.1
+12V: J104.5, J105.5, J106.5, J108.5, J109.5, J110.5, J111.5
BACKLIGHT_-V: J104.6, J105.6, J106.6, J108.6, J109.6, J110.6, J111.6
D22: J69.7
D24: J69.8
D26: J91.7
D28: J91.8
D30: J98.7
D32: J98.8
D34: J103.7
D36: J103.8
D38: J70.7
D40: J70.8
D42: J92.7
D44: J92.8
D46: J99.7
D48: J99.8
GNDD: C-W1.2, C-W2.2, C-W3.2, C-W4.2, C-W5.2, C-W6.2, C-W7.2, D25.1 (K), J54.2, J69.9, J69.15, J70.9, J70.15, J72.3, J91.9, J91.15, J92.9, J92.15, J93.3, J98.9, J98.15, J99.9, J99.15, J103.9, J103.15
LOWER_OUTPUT_5V: J69.10, J70.10, J91.10, J92.10, J98.10, J99.10, J103.10
unnamed: D25.2 (A), R28.2
unnamed: J69.5, J69.6
unnamed: J70.5, J70.6
unnamed: J91.5, J91.6
unnamed: J92.5, J92.6
unnamed: J98.5, J98.6
unnamed: J99.5, J99.6
unnamed: J103.5, J103.6
ROLL_STEP_V+: C-W1.1, C-W2.1, C-W3.1, C-W4.1, C-W5.1, C-W6.1, C-W7.1, J54.1, J69.16, J70.16, J91.16, J92.16, J98.16, J99.16, J103.16, R28.1
STEPPER_7_A: J69.11, J105.1
STEPPER_7_B: J69.12, J105.2
STEPPER_7_C: J69.13, J105.3
STEPPER_7_D: J69.14, J105.4
STEPPER_8_A: J91.11, J104.1
STEPPER_8_B: J91.12, J104.2
STEPPER_8_C: J91.13, J104.3
STEPPER_8_D: J91.14, J104.4
STEPPER_9_A: J98.11, J109.1
STEPPER_9_B: J98.12, J109.2
STEPPER_9_C: J98.13, J109.3
STEPPER_9_D: J98.14, J109.4
STEPPER_10_A: J103.11, J108.1
STEPPER_10_B: J103.12, J108.2
STEPPER_10_C: J103.13, J108.3
STEPPER_10_D: J103.14, J108.4
STEPPER_11_A: J70.11, J106.1
STEPPER_11_B: J70.12, J106.2
STEPPER_11_C: J70.13, J106.3
STEPPER_11_D: J70.14, J106.4
STEPPER_12_A: J92.11, J111.1
STEPPER_12_B: J92.12, J111.2
STEPPER_12_C: J92.13, J111.3
STEPPER_12_D: J92.14, J111.4
STEPPER_13_A: J99.11, J110.1
STEPPER_13_B: J99.12, J110.2
STEPPER_13_C: J99.13, J110.3
STEPPER_13_D: J99.14, J110.4
STEPPER_EN: J69.1, J70.1, J91.1, J92.1, J98.1, J99.1, J103.1
ZERO-DETECT-ALTIMETER: J93.2
ZERO_DETECT_SARI: J72.2
