bnepethomas/bne-arduino-flight-simulator-interfaces/A10/A10 PCBs/Forward Console OLED/Forward OLED.kicad_sch

## KiCad design A10/A10 PCBs/Forward Console OLED/Forward OLED.kicad_sch (2025-11-29)

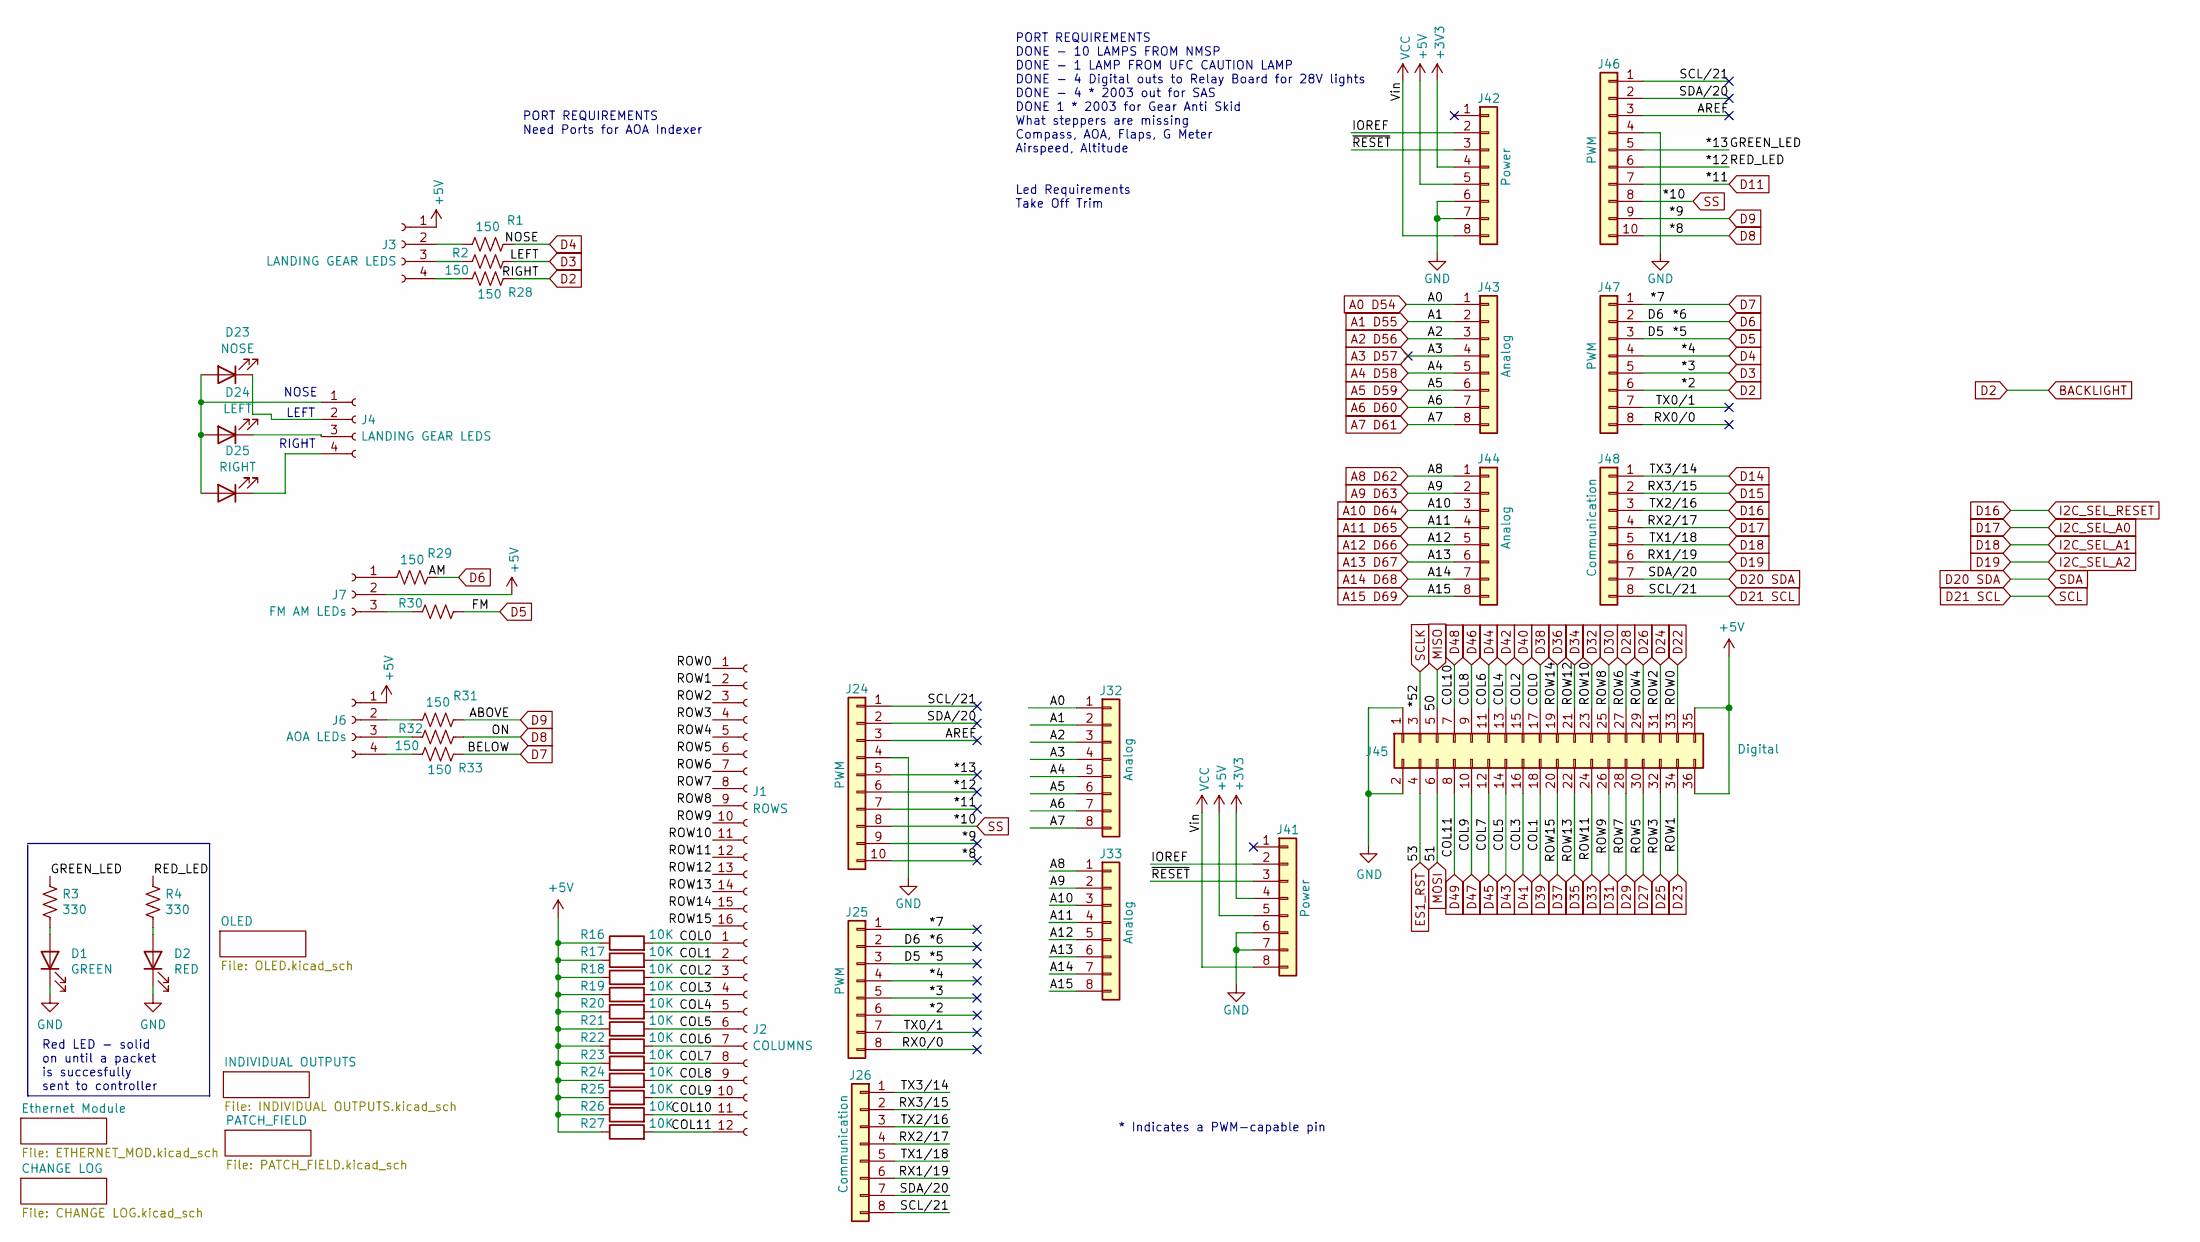
[picture p558: schematic Forward OLED.kicad_sch]

Parts:
D1: GREEN; LED_D3.0mm
D2: RED; LED_D3.0mm
D23: NOSE; Molex_KK-254_AE-6410-02A_1x02_P2.54mm_Vertical
D24: LEFT; Molex_KK-254_AE-6410-02A_1x02_P2.54mm_Vertical
D25: RIGHT; Molex_KK-254_AE-6410-02A_1x02_P2.54mm_Vertical
J1: ROWS; PinHeader_1x16_P2.54mm_Vertical
J2: COLUMNS; PinHeader_1x12_P2.54mm_Vertical
J3, J4: LANDING GEAR LEDS; Molex_KK-254_AE-6410-04A_1x04_P2.54mm_Vertical
J6: AOA LEDs; Molex_KK-254_AE-6410-04A_1x04_P2.54mm_Vertical
J7: FM AM LEDs; Molex_KK-254_AE-6410-03A_1x03_P2.54mm_Vertical
J24, J46: PWM; PinSocket_1x10_P2.54mm_Vertical
J25, J47: PWM; PinSocket_1x08_P2.54mm_Vertical
J26, J48: Communication; PinSocket_1x08_P2.54mm_Vertical
J32, J33, J43, J44: Analog; PinSocket_1x08_P2.54mm_Vertical
J41, J42: Power; PinSocket_1x08_P2.54mm_Vertical
J45: Digital; PinSocket_2x18_P2.54mm_Vertical
R1, R2, R28, R29, R30, R31, R32, R33: 150; R_Axial_DIN0204_L3.6mm_D1.6mm_P2.54mm_Vertical
R3, R4: 330; R_Axial_DIN0204_L3.6mm_D1.6mm_P2.54mm_Vertical
R16, R17, R18, R19, R20, R21, R22, R23, R24, R25, R26, R27: 10K; R_Axial_DIN0204_L3.6mm_D1.6mm_P2.54mm_Vertical

Connections:
2: J25.6, J47.6, R28.2
3: J25.5, J47.5, R2.2
4: J25.4, J47.4, R1.2
5: J25.3, J47.3, R30.2
6: J25.2, J47.2, R29.2
7: J25.1, J47.1, R33.2
8: J24.10, J46.10, R32.2
9: J24.9, J46.9, R31.2
10: J24.8, J46.8
11: J24.7, J46.7
12: J24.6, J46.6, R4.1
13: J24.5, J46.5, R3.1
52: J45.3
+3V3: J41.4, J42.4
+5V: J3.1, J6.1, J7.2, J41.5, J42.5, J45.35, J45.36, R16.1, R17.1, R18.1, R19.1, R20.1, R21.1, R22.1, R23.1, R24.1, R25.1, R26.1, R27.1
A0 D54: J32.1, J43.1
A1 D55: J32.2, J43.2
A2 D56: J32.3, J43.3
A3 D57: J32.4, J43.4
A4 D58: J32.5, J43.5
A5 D59: J32.6, J43.6
A6 D60: J32.7, J43.7
A7 D61: J32.8, J43.8
A8 D62: J33.1, J44.1
A9 D63: J33.2, J44.2
A10 D64: J33.3, J44.3
A11 D65: J33.4, J44.4
A12 D66: J33.5, J44.5
A13 D67: J33.6, J44.6
A14 D68: J33.7, J44.7
A15 D69: J33.8, J44.8
AREF: J24.3, J46.3
D14: J26.1, J48.1
D15: J26.2, J48.2
D16: J26.3, J48.3
D17: J26.4, J48.4
D18: J26.5, J48.5
D19: J26.6, J48.6
D20 SDA: J24.2, J26.7, J46.2, J48.7
D21 SCL: J24.1, J26.8, J46.1, J48.8
D22: J1.1, J45.33
D23: J1.2, J45.34
D24: J1.3, J45.31
D25: J1.4, J45.32
D26: J1.5, J45.29
D27: J1.6, J45.30
D28: J1.7, J45.27
D29: J1.8, J45.28
D30: J1.9, J45.25
D31: J1.10, J45.26
D32: J1.11, J45.23
D33: J1.12, J45.24
D34: J1.13, J45.21
D35: J1.14, J45.22
D36: J1.15, J45.19
D37: J1.16, J45.20
D38: J2.1, J45.17, R16.2
D39: J2.2, J45.18, R17.2
D40: J2.3, J45.15, R18.2
D41: J2.4, J45.16, R19.2
D42: J2.5, J45.13, R20.2
D43: J2.6, J45.14, R21.2
D44: J2.7, J45.11, R22.2
D45: J2.8, J45.12, R23.2
D46: J2.9, J45.9, R24.2
D47: J2.10, J45.10, R25.2
D48: J2.11, J45.7, R26.2
D49: J2.12, J45.8, R27.2
ES1_RST: J45.4
GND: D1.1 (K), D2.1 (K), J24.4, J41.6, J41.7, J42.6, J42.7, J45.1, J45.2, J46.4
IOREF: J41.2, J42.2
MISO: J45.5
MOSI: J45.6
unnamed: D1.2 (A), R3.2
unnamed: D2.2 (A), R4.2
unnamed: D23.1 (K), J4.2
unnamed: D23.2 (A), D24.2 (A), D25.2 (A), J4.1
unnamed: D24.1 (K), J4.3
unnamed: D25.1 (K), J4.4
unnamed: J3.2, R1.1
unnamed: J3.3, R2.1
unnamed: J3.4, R28.1
unnamed: J6.2, R31.1
unnamed: J6.3, R32.1
unnamed: J6.4, R33.1
unnamed: J7.1, R29.1
unnamed: J7.3, R30.1
RX0/0: J25.8, J47.8
TX0/1: J25.7, J47.7
VCC: J41.8, J42.8
~RESET: J41.3, J42.3

Notes on the sheet:
LEFT
PORT REQUIREMENTS Need Ports for AOA Indexer
RIGHT
NOSE
Red LED - solid on until a packet is succesfully sent to controller
* Indicates a PWM-capable pin
PORT REQUIREMENTS DONE - 10 LAMPS FROM NMSP DONE - 1 LAMP FROM UFC CAUTION LAMP DONE - 4 Digital outs to Relay Board for 28V lights DONE - 4 * 2003 out for SAS DONE 1 * 2003 for Gear Anti Skid What steppers are missing Compass, AOA, Flaps, G Meter Airspeed, Altitude Led Requirements Take Off Trim
