bnepethomas/bne-arduino-flight-simulator-interfaces/A10/A10 PCBs/Forward Console OLED/OLED.kicad_sch

## KiCad design A10/A10 PCBs/Forward Console OLED/OLED.kicad_sch (2025-11-29)

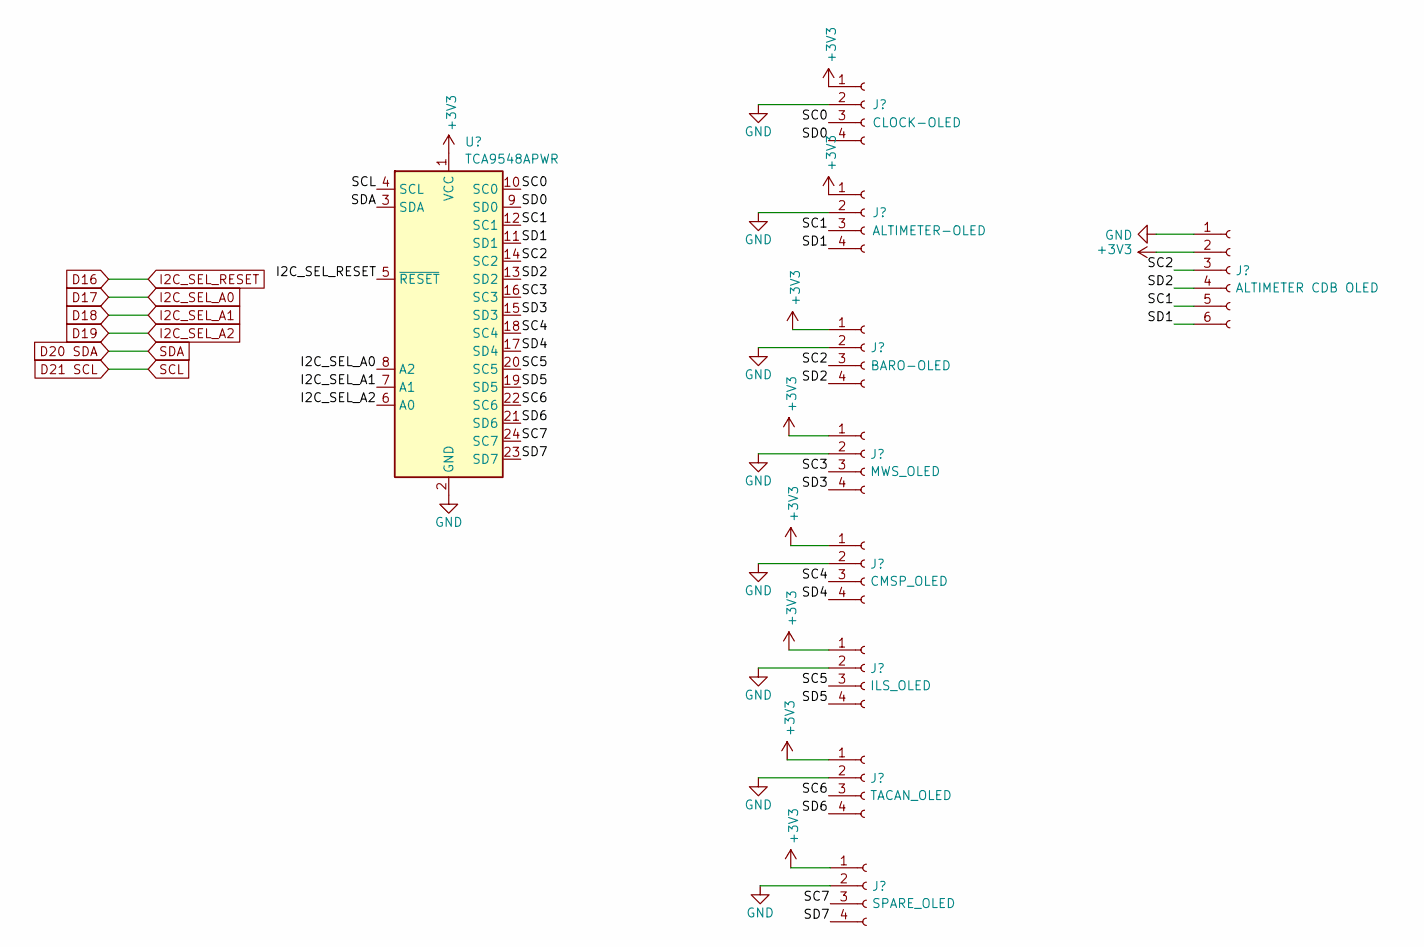
[picture p560: schematic OLED.kicad_sch]

Parts:
J5: ALTIMETER CDB OLED; Molex_KK-254_AE-6410-06A_1x06_P2.54mm_Vertical
J21: CLOCK-OLED; Molex_KK-254_AE-6410-04A_1x04_P2.54mm_Vertical
J36: ALTIMETER-OLED; Molex_KK-254_AE-6410-04A_1x04_P2.54mm_Vertical
J55: BARO-OLED; Molex_KK-254_AE-6410-04A_1x04_P2.54mm_Vertical
J56: MWS_OLED; Molex_KK-254_AE-6410-04A_1x04_P2.54mm_Vertical
J57: CMSP_OLED; Molex_KK-254_AE-6410-04A_1x04_P2.54mm_Vertical
J58: ILS_OLED; Molex_KK-254_AE-6410-04A_1x04_P2.54mm_Vertical
J59: TACAN_OLED; Molex_KK-254_AE-6410-04A_1x04_P2.54mm_Vertical
J60: SPARE_OLED; Molex_KK-254_AE-6410-04A_1x04_P2.54mm_Vertical
U4: TCA9548APWR; DIP-24_TCA9548A

Connections:
+3V3: J5.2, J21.1, J36.1, J55.1, J56.1, J57.1, J58.1, J59.1, J60.1, U4.1 (VCC)
GND: J5.1, J21.2, J36.2, J55.2, J56.2, J57.2, J58.2, J59.2, J60.2, U4.2 (GND)
I2C_SEL_A0: U4.8 (A2)
I2C_SEL_A1: U4.7 (A1)
I2C_SEL_A2: U4.6 (A0)
I2C_SEL_RESET: U4.5 (~RESET)
SC0: J21.3, U4.10 (SC0)
SC1: J5.5, J36.3, U4.12 (SC1)
SC2: J5.3, J55.3, U4.14 (SC2)
SC3: J56.3, U4.16 (SC3)
SC4: J57.3, U4.18 (SC4)
SC5: J58.3, U4.20 (SC5)
SC6: J59.3, U4.22 (SC6)
SC7: J60.3, U4.24 (SC7)
SCL: U4.4 (SCL)
SD0: J21.4, U4.9 (SD0)
SD1: J5.6, J36.4, U4.11 (SD1)
SD2: J5.4, J55.4, U4.13 (SD2)
SD3: J56.4, U4.15 (SD3)
SD4: J57.4, U4.17 (SD4)
SD5: J58.4, U4.19 (SD5)
SD6: J59.4, U4.21 (SD6)
SD7: J60.4, U4.23 (SD7)
SDA: U4.3 (SDA)
