bnepethomas/bne-arduino-flight-simulator-interfaces/A10/A10 PCBs/Forward Console OLED/PATCH_FIELD.kicad_sch

## KiCad design A10/A10 PCBs/Forward Console OLED/PATCH_FIELD.kicad_sch (2025-11-29)

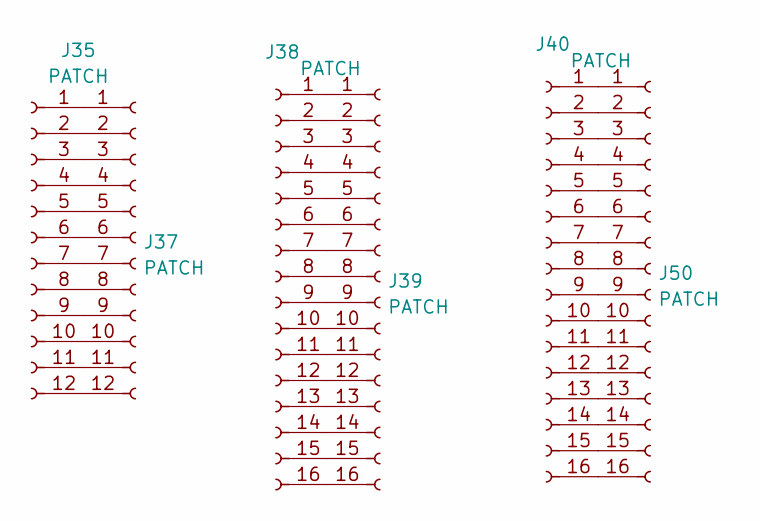
[picture p561: schematic PATCH_FIELD.kicad_sch]

Parts:
J35, J37: PATCH; PinSocket_1x12_P2.54mm_Vertical
J38, J39, J40, J50: PATCH; PinHeader_1x16_P2.54mm_Vertical

Connections:
unnamed: J35.1, J37.1
unnamed: J35.2, J37.2
unnamed: J35.3, J37.3
unnamed: J35.4, J37.4
unnamed: J35.5, J37.5
unnamed: J35.6, J37.6
unnamed: J35.7, J37.7
unnamed: J35.8, J37.8
unnamed: J35.9, J37.9
unnamed: J35.10, J37.10
unnamed: J35.11, J37.11
unnamed: J35.12, J37.12
unnamed: J38.1, J39.1
unnamed: J38.2, J39.2
unnamed: J38.3, J39.3
unnamed: J38.4, J39.4
unnamed: J38.5, J39.5
unnamed: J38.6, J39.6
unnamed: J38.7, J39.7
unnamed: J38.8, J39.8
unnamed: J38.9, J39.9
unnamed: J38.10, J39.10
unnamed: J38.11, J39.11
unnamed: J38.12, J39.12
unnamed: J38.13, J39.13
unnamed: J38.14, J39.14
unnamed: J38.15, J39.15
unnamed: J38.16, J39.16
unnamed: J40.1, J50.1
unnamed: J40.2, J50.2
unnamed: J40.3, J50.3
unnamed: J40.4, J50.4
unnamed: J40.5, J50.5
unnamed: J40.6, J50.6
unnamed: J40.7, J50.7
unnamed: J40.8, J50.8
unnamed: J40.9, J50.9
unnamed: J40.10, J50.10
unnamed: J40.11, J50.11
unnamed: J40.12, J50.12
unnamed: J40.13, J50.13
unnamed: J40.14, J50.14
unnamed: J40.15, J50.15
unnamed: J40.16, J50.16
