bnepethomas/bne-arduino-flight-simulator-interfaces/A10/A10 PCBs/Left Console Input and Output with Rotary/ETHERNET_MOD.kicad_sch

## KiCad design A10/A10 PCBs/Left Console Input and Output with Rotary/ETHERNET_MOD.kicad_sch (2025-11-29)

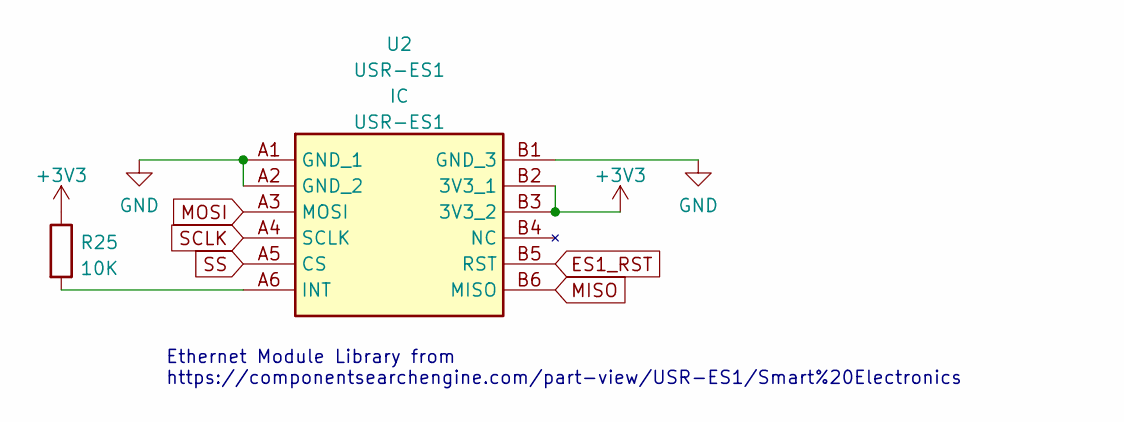
[picture p562: schematic ETHERNET_MOD.kicad_sch]

Parts:
R25: 10K; R_Axial_DIN0204_L3.6mm_D1.6mm_P2.54mm_Vertical
U2: USR-ES1; USRES1; Manufacturer_Part_Number USR-ES1

Connections:
+3V3: R25.1, U2.B2 (3V3_1), U2.B3 (3V3_2)
ES1_RST: U2.B5 (RST)
GND: U2.A1 (GND_1), U2.A2 (GND_2), U2.B1 (GND_3)
MISO: U2.B6 (MISO)
MOSI: U2.A3 (MOSI)
unnamed: R25.2, U2.A6 (INT)
SCLK: U2.A4 (SCLK)
SS: U2.A5 (CS)

Notes on the sheet:
Ethernet Module Library from https://componentsearchengine.com/part-view/USR-ES1/Smart%20Electronics
