bnepethomas/bne-arduino-flight-simulator-interfaces/A10/A10 PCBs/Left Console Input and Output with Rotary/Inputs-From-Panels.kicad_sch

## KiCad design A10/A10 PCBs/Left Console Input and Output with Rotary/Inputs-From-Panels.kicad_sch (2025-11-29)

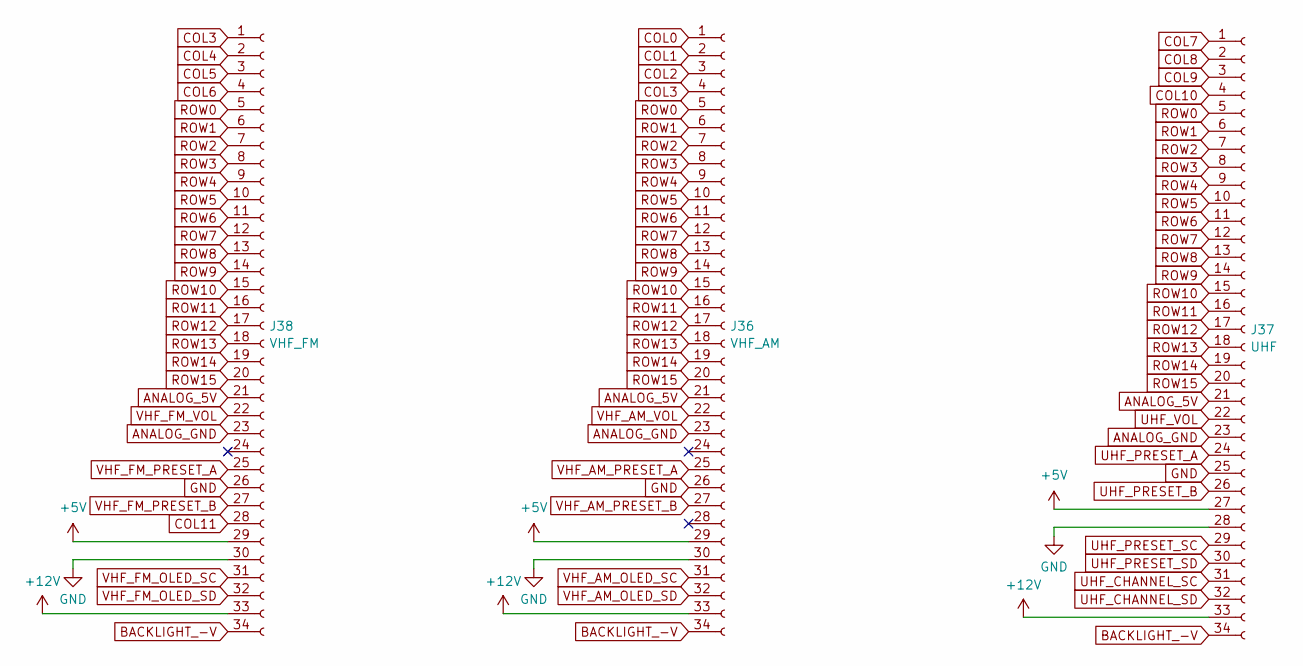
[picture p563: schematic Inputs-From-Panels.kicad_sch]

Parts:
J36: VHF_AM; IDC-Header_2x17_P2.54mm_Vertical
J37: UHF; IDC-Header_2x17_P2.54mm_Vertical
J38: VHF_FM; IDC-Header_2x17_P2.54mm_Vertical

Connections:
+5V: J36.29, J37.27, J38.29
+12V: J36.33, J37.33, J38.33
ANALOG_5V: J36.21, J37.21, J38.21
ANALOG_GND: J36.23, J37.23, J38.23
BACKLIGHT_-V: J36.34, J37.34, J38.34
COL0: J36.1
COL1: J36.2
COL2: J36.3
COL3: J36.4, J38.1
COL4: J38.2
COL5: J38.3
COL6: J38.4
COL7: J37.1
COL8: J37.2
COL9: J37.3
COL10: J37.4
COL11: J38.28
GND: J36.26, J36.30, J37.25, J37.28, J38.26, J38.30
ROW0: J36.5, J37.5, J38.5
ROW1: J36.6, J37.6, J38.6
ROW2: J36.7, J37.7, J38.7
ROW3: J36.8, J37.8, J38.8
ROW4: J36.9, J37.9, J38.9
ROW5: J36.10, J37.10, J38.10
ROW6: J36.11, J37.11, J38.11
ROW7: J36.12, J37.12, J38.12
ROW8: J36.13, J37.13, J38.13
ROW9: J36.14, J37.14, J38.14
ROW10: J36.15, J37.15, J38.15
ROW11: J36.16, J37.16, J38.16
ROW12: J36.17, J37.17, J38.17
ROW13: J36.18, J37.18, J38.18
ROW14: J36.19, J37.19, J38.19
ROW15: J36.20, J37.20, J38.20
UHF_CHANNEL_SC: J37.31
UHF_CHANNEL_SD: J37.32
UHF_PRESET_A: J37.24
UHF_PRESET_B: J37.26
UHF_PRESET_SC: J37.29
UHF_PRESET_SD: J37.30
UHF_VOL: J37.22
VHF_AM_OLED_SC: J36.31
VHF_AM_OLED_SD: J36.32
VHF_AM_PRESET_A: J36.25
VHF_AM_PRESET_B: J36.27
VHF_AM_VOL: J36.22
VHF_FM_OLED_SC: J38.31
VHF_FM_OLED_SD: J38.32
VHF_FM_PRESET_A: J38.25
VHF_FM_PRESET_B: J38.27
VHF_FM_VOL: J38.22
