bnepethomas/bne-arduino-flight-simulator-interfaces/A10/A10 PCBs/Left Console Input and Output with Rotary/LIGHTING.kicad_sch

## KiCad design A10/A10 PCBs/Left Console Input and Output with Rotary/LIGHTING.kicad_sch (2025-11-29)

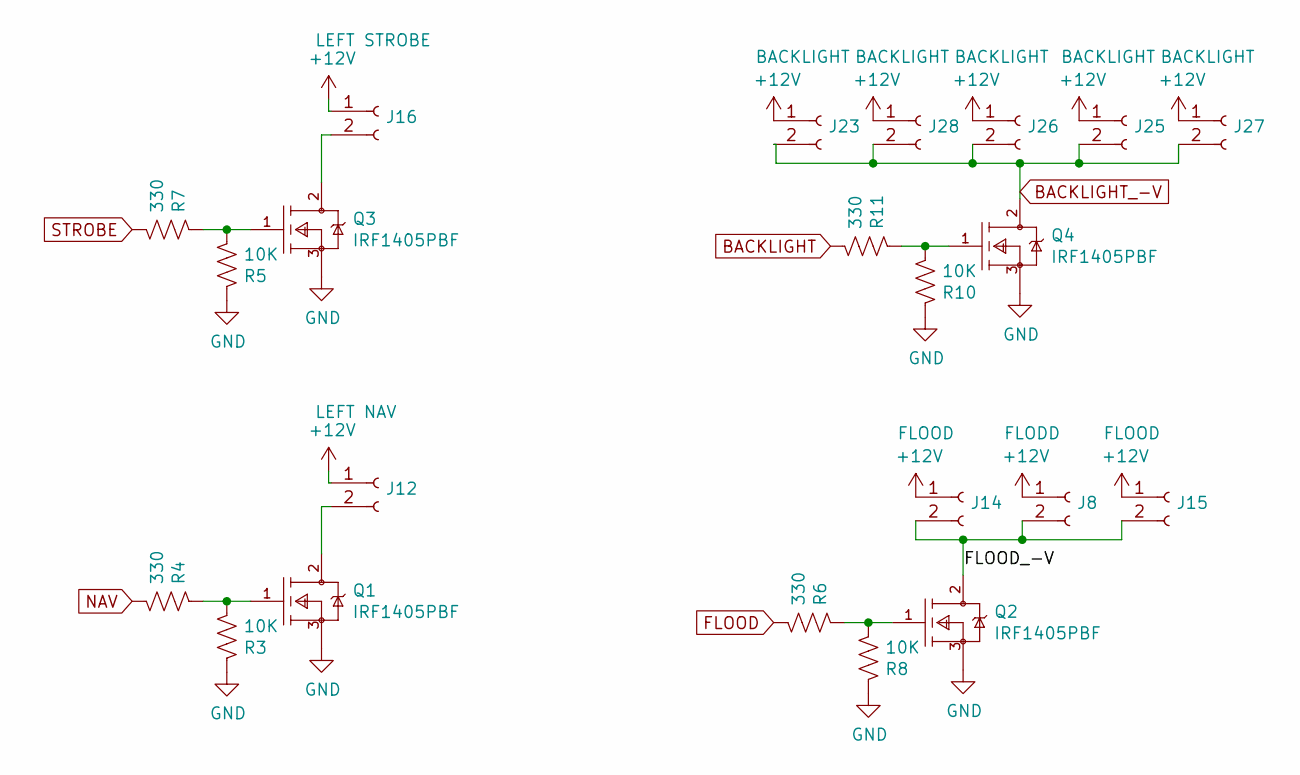
[picture p564: schematic LIGHTING.kicad_sch]

Parts:
J8: FLODD; Molex_KK-254_AE-6410-02A_1x02_P2.54mm_Vertical
J12: LEFT NAV; Molex_KK-254_AE-6410-02A_1x02_P2.54mm_Vertical
J14, J15: FLOOD; Molex_KK-254_AE-6410-02A_1x02_P2.54mm_Vertical
J16: LEFT STROBE; Molex_KK-254_AE-6410-02A_1x02_P2.54mm_Vertical
J23, J25, J26, J27, J28: BACKLIGHT; Molex_KK-254_AE-6410-02A_1x02_P2.54mm_Vertical
Q1, Q2, Q3, Q4: IRF1405PBF; TO-220-3_Vertical; mouser part number 942-IRF1405PBF; digikey description MOSFET N-CH 55V 169A TO-220AB
R3, R5, R8, R10: 10K; R_Axial_DIN0204_L3.6mm_D1.6mm_P2.54mm_Vertical
R4, R6, R7, R11: 330; R_Axial_DIN0204_L3.6mm_D1.6mm_P2.54mm_Vertical

Connections:
+12V: J8.1, J12.1, J14.1, J15.1, J16.1, J23.1, J25.1, J26.1, J27.1, J28.1
BACKLIGHT: R11.2
BACKLIGHT_-V: J23.2, J25.2, J26.2, J27.2, J28.2, Q4.2 (D)
FLOOD: R6.2
FLOOD_-V: J8.2, J14.2, J15.2, Q2.2 (D)
GND: Q1.3 (S), Q2.3 (S), Q3.3 (S), Q4.3 (S), R3.1, R5.1, R8.1, R10.1
NAV: R4.2
unnamed: J12.2, Q1.2 (D)
unnamed: J16.2, Q3.2 (D)
unnamed: Q1.1 (G), R3.2, R4.1
unnamed: Q2.1 (G), R6.1, R8.2
unnamed: Q3.1 (G), R5.2, R7.1
unnamed: Q4.1 (G), R10.2, R11.1
STROBE: R7.2
