bnepethomas/bne-arduino-flight-simulator-interfaces/A10/A10 PCBs/Left Console Input and Output with Rotary/Left Console Input and Output with Rotary.kicad_sch

## KiCad design A10/A10 PCBs/Left Console Input and Output with Rotary/Left Console Input and Output with Rotary.kicad_sch (2025-11-29)

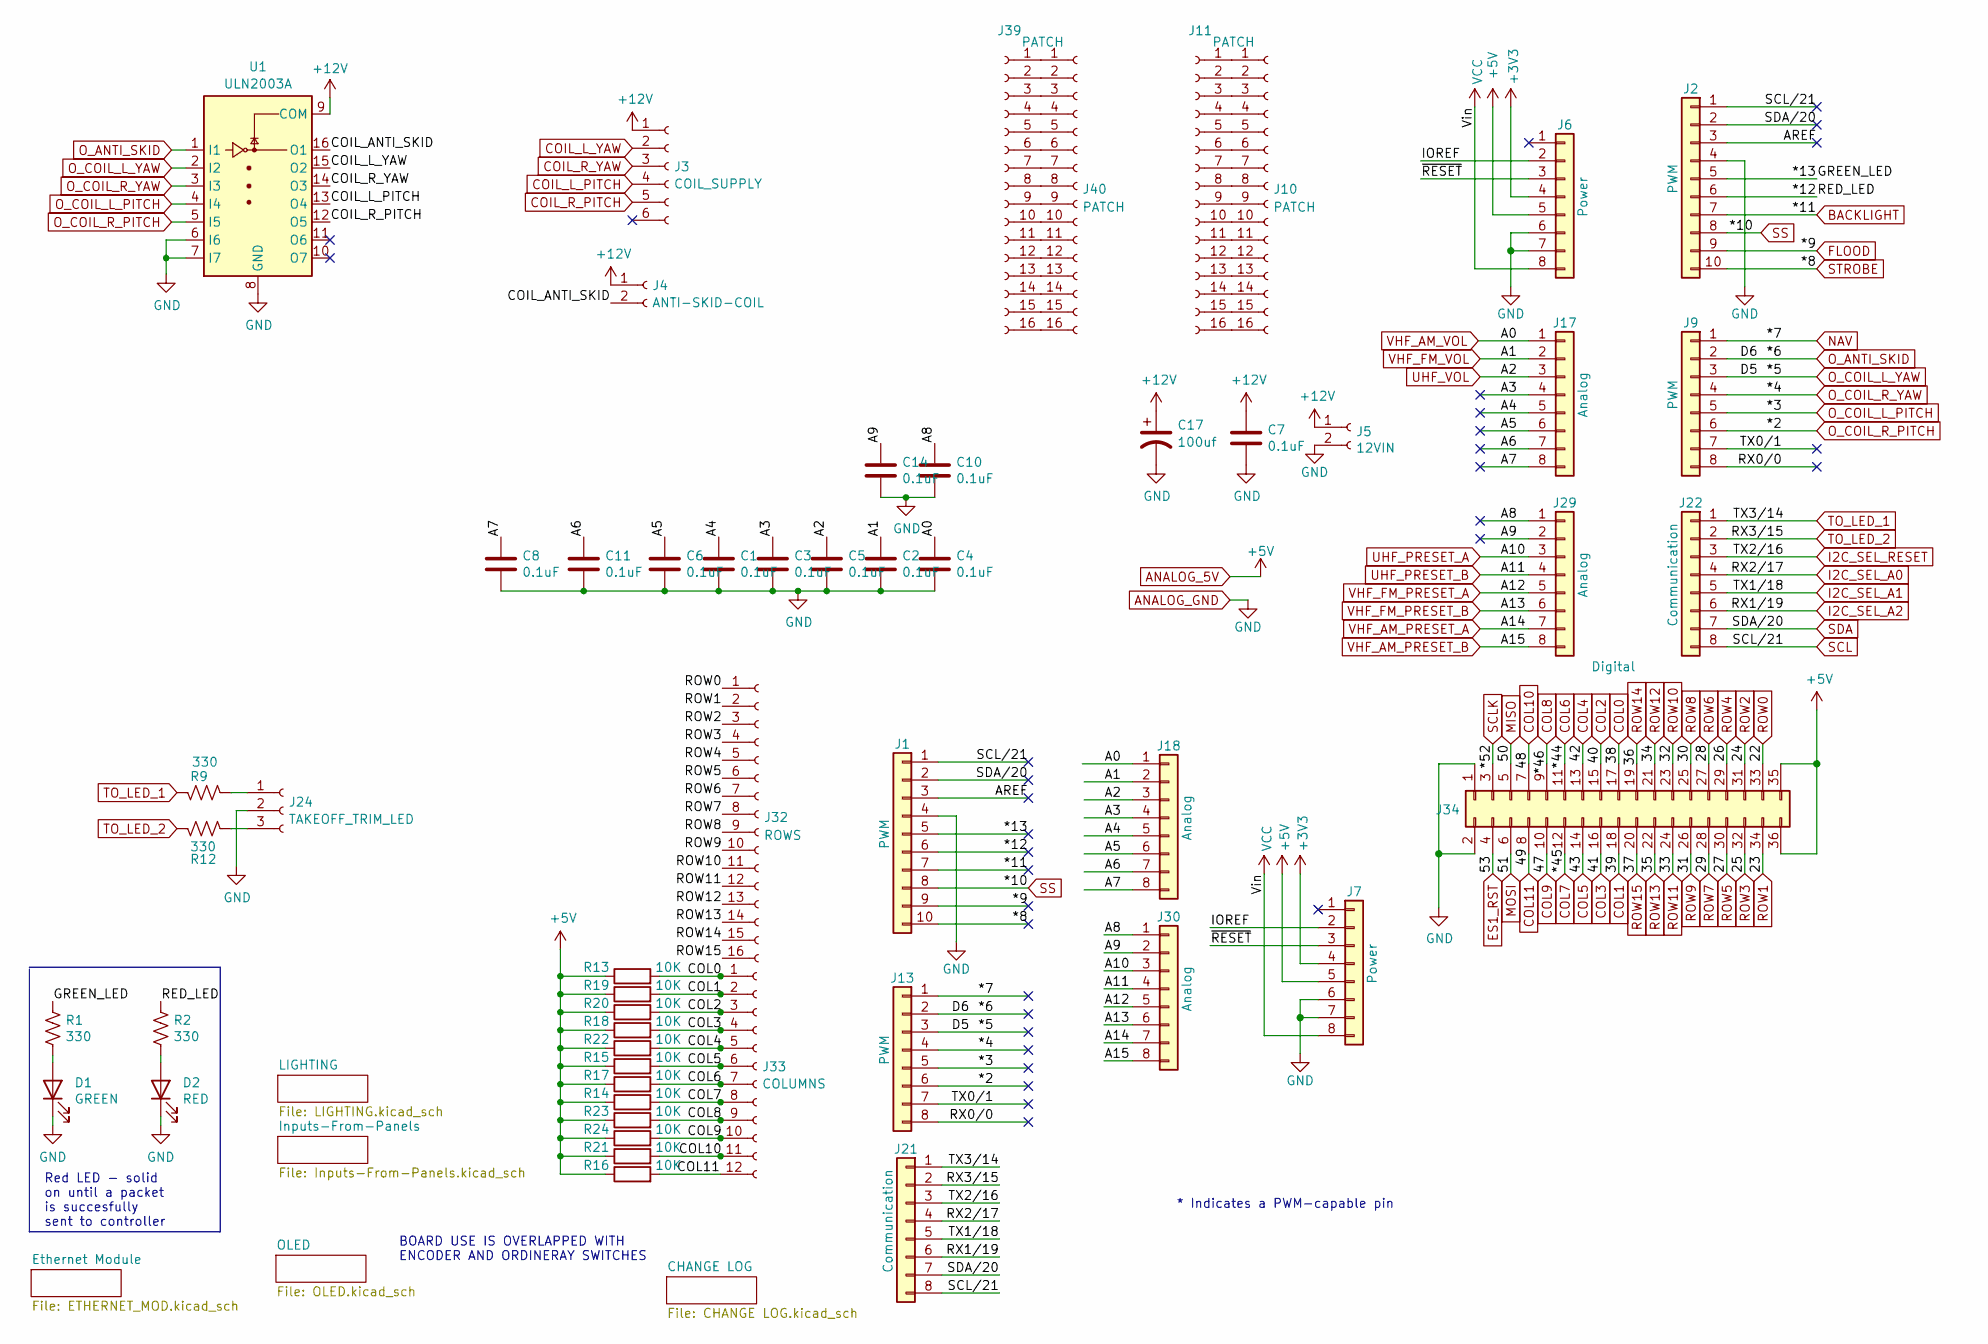
[picture p565: schematic Left Console Input and Output with Rotary.kicad_sch]

Parts:
C1, C2, C3, C4, C5, C6, C8, C10, C11, C14: 0.1uF; C_Disc_D6.0mm_W2.5mm_P5.00mm
C7: 0.1uF; C_Disc_D4.3mm_W1.9mm_P5.00mm
C17: 100uf; C_Radial_D6.3mm_H5.0mm_P2.50mm
D1: GREEN; LED_D3.0mm
D2: RED; LED_D3.0mm
J1, J2: PWM; PinSocket_1x10_P2.54mm_Vertical
J3: COIL_SUPPLY; Molex_KK-254_AE-6410-06A_1x06_P2.54mm_Vertical
J4: ANTI-SKID-COIL; Molex_KK-254_AE-6410-02A_1x02_P2.54mm_Vertical
J5: 12VIN; BarrelJack_Horizontal
J6, J7: Power; PinSocket_1x08_P2.54mm_Vertical
J9, J13: PWM; PinSocket_1x08_P2.54mm_Vertical
J10, J11, J39, J40: PATCH; PinHeader_1x16_P2.54mm_Vertical
J17, J18, J29, J30: Analog; PinSocket_1x08_P2.54mm_Vertical
J21, J22: Communication; PinSocket_1x08_P2.54mm_Vertical
J24: TAKEOFF_TRIM_LED; Molex_KK-254_AE-6410-03A_1x03_P2.54mm_Vertical
J32: ROWS; PinHeader_1x16_P2.54mm_Vertical
J33: COLUMNS; PinHeader_1x12_P2.54mm_Vertical
J34: Digital; PinSocket_2x18_P2.54mm_Vertical
R1, R2, R9, R12: 330; R_Axial_DIN0204_L3.6mm_D1.6mm_P2.54mm_Vertical
R13, R14, R15, R16, R17, R18, R19, R20, R21, R22, R23, R24: 10K; R_Axial_DIN0204_L3.6mm_D1.6mm_P2.54mm_Vertical
U1: ULN2003A; DIP-16_W7.62mm_LongPads

Connections:
2: J9.6, J13.6, U1.5 (I5)
3: J9.5, J13.5, U1.4 (I4)
4: J9.4, J13.4, U1.3 (I3)
5: J9.3, J13.3, U1.2 (I2)
6: J9.2, J13.2, U1.1 (I1)
7: J9.1, J13.1
8: J1.10, J2.10
9: J1.9, J2.9
10: J1.8, J2.8
11: J1.7, J2.7
12: J1.6, J2.6, R2.1
13: J1.5, J2.5, R1.1
44: J34.11
45: J34.12
46: J34.9
52: J34.3
+3V3: J6.4, J7.4
+5V: J6.5, J7.5, J34.35, J34.36, R13.1, R14.1, R15.1, R16.1, R17.1, R18.1, R19.1, R20.1, R21.1, R22.1, R23.1, R24.1
+12V: C7.1, C17.1, J3.1, J4.1, J5.1, U1.9 (COM)
A3: C3.1, J17.4, J18.4
A4: C1.1, J17.5, J18.5
A5: C6.1, J17.6, J18.6
A6: C11.1, J17.7, J18.7
A7: C8.1, J17.8, J18.8
A8: C10.1, J29.1, J30.1
A9: C14.1, J29.2, J30.2
ANALOG_GND: C1.2, C2.2, C3.2, C4.2, C5.2, C6.2, C7.2, C8.2, C10.2, C11.2, C14.2, C17.2, D1.1 (K), D2.1 (K), J1.4, J2.4, J5.2, J6.6, J6.7, J7.6, J7.7, J24.2, J34.1, J34.2, U1.6 (I6), U1.7 (I7), U1.8 (GND)
AREF: J1.3, J2.3
COIL_ANTI_SKID: J4.2, U1.16 (O1)
COIL_L_PITCH: J3.4, U1.13 (O4)
COIL_L_YAW: J3.2, U1.15 (O2)
COIL_R_PITCH: J3.5, U1.12 (O5)
COIL_R_YAW: J3.3, U1.14 (O3)
COL0: J33.1, J34.17, R13.2
COL1: J33.2, J34.18, R19.2
COL2: J33.3, J34.15, R20.2
COL3: J33.4, J34.16, R18.2
COL4: J33.5, J34.13, R22.2
COL5: J33.6, J34.14, R15.2
COL6: J33.7, R17.2
COL7: J33.8, R14.2
COL8: J33.9, R23.2
COL9: J33.10, J34.10, R24.2
COL10: J33.11, J34.7, R21.2
COL11: J33.12, J34.8, R16.2
ES1_RST: J34.4
I2C_SEL_A0: J21.4, J22.4
I2C_SEL_A1: J21.5, J22.5
I2C_SEL_A2: J21.6, J22.6
I2C_SEL_RESET: J21.3, J22.3
IOREF: J6.2, J7.2
MISO: J34.5
MOSI: J34.6
unnamed: D1.2 (A), R1.2
unnamed: D2.2 (A), R2.2
unnamed: J10.1, J11.1
unnamed: J10.2, J11.2
unnamed: J10.3, J11.3
unnamed: J10.4, J11.4
unnamed: J10.5, J11.5
unnamed: J10.6, J11.6
unnamed: J10.7, J11.7
unnamed: J10.8, J11.8
unnamed: J10.9, J11.9
unnamed: J10.10, J11.10
unnamed: J10.11, J11.11
unnamed: J10.12, J11.12
unnamed: J10.13, J11.13
unnamed: J10.14, J11.14
unnamed: J10.15, J11.15
unnamed: J10.16, J11.16
unnamed: J24.1, R9.1
unnamed: J24.3, R12.1
unnamed: J39.1, J40.1
unnamed: J39.2, J40.2
unnamed: J39.3, J40.3
unnamed: J39.4, J40.4
unnamed: J39.5, J40.5
unnamed: J39.6, J40.6
unnamed: J39.7, J40.7
unnamed: J39.8, J40.8
unnamed: J39.9, J40.9
unnamed: J39.10, J40.10
unnamed: J39.11, J40.11
unnamed: J39.12, J40.12
unnamed: J39.13, J40.13
unnamed: J39.14, J40.14
unnamed: J39.15, J40.15
unnamed: J39.16, J40.16
ROW0: J32.1, J34.33
ROW1: J32.2, J34.34
ROW2: J32.3, J34.31
ROW3: J32.4, J34.32
ROW4: J32.5, J34.29
ROW5: J32.6, J34.30
ROW6: J32.7, J34.27
ROW7: J32.8, J34.28
ROW8: J32.9, J34.25
ROW9: J32.10, J34.26
ROW10: J32.11, J34.23
ROW11: J32.12, J34.24
ROW12: J32.13, J34.21
ROW13: J32.14, J34.22
ROW14: J32.15, J34.19
ROW15: J32.16, J34.20
RX0/0: J9.8, J13.8
SCL: J1.1, J2.1, J21.8, J22.8
SDA: J1.2, J2.2, J21.7, J22.7
TO_LED_1: J21.1, J22.1, R9.2
TO_LED_2: J21.2, J22.2, R12.2
TX0/1: J9.7, J13.7
UHF_PRESET_A: J29.3, J30.3
UHF_PRESET_B: J29.4, J30.4
UHF_VOL: C5.1, J17.3, J18.3
VCC: J6.8, J7.8
VHF_AM_PRESET_A: J29.7, J30.7
VHF_AM_PRESET_B: J29.8, J30.8
VHF_AM_VOL: C4.1, J17.1, J18.1
VHF_FM_PRESET_A: J29.5, J30.5
VHF_FM_PRESET_B: J29.6, J30.6
VHF_FM_VOL: C2.1, J17.2, J18.2
~RESET: J6.3, J7.3

Notes on the sheet:
BOARD USE IS OVERLAPPED WITH ENCODER AND ORDINERAY SWITCHES
Red LED - solid on until a packet is succesfully sent to controller
* Indicates a PWM-capable pin
