bnepethomas/bne-arduino-flight-simulator-interfaces/A10/A10 PCBs/Left Console Input and Output with Rotary/OLED.kicad_sch

## KiCad design A10/A10 PCBs/Left Console Input and Output with Rotary/OLED.kicad_sch (2025-11-29)

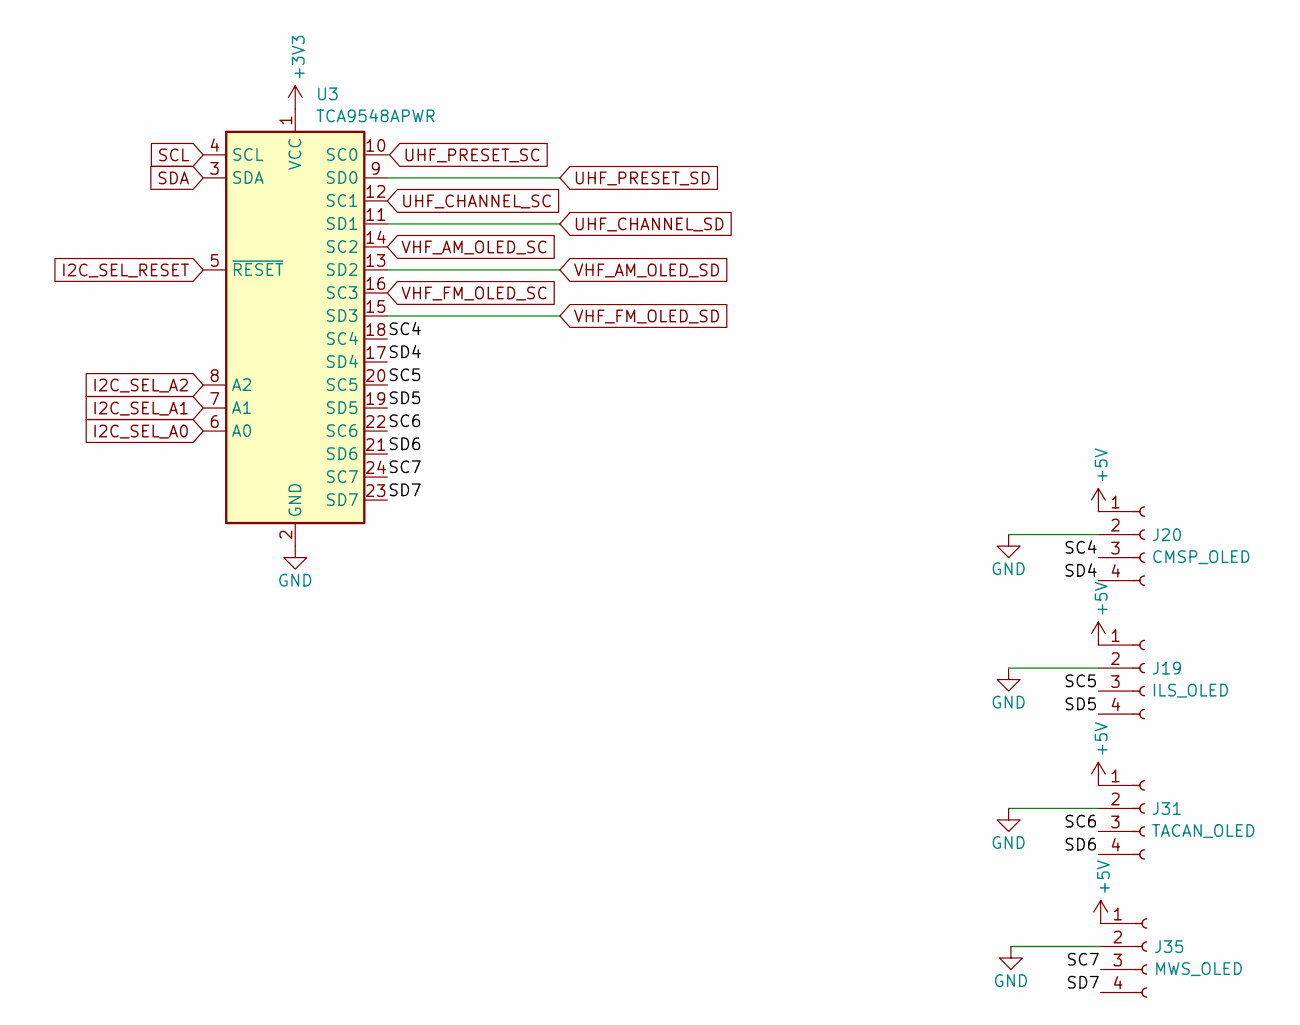
[picture p566: schematic OLED.kicad_sch]

Parts:
J19: ILS_OLED; PinSocket_1x04_P2.54mm_Vertical
J20: CMSP_OLED; PinSocket_1x04_P2.54mm_Vertical
J31: TACAN_OLED; PinSocket_1x04_P2.54mm_Vertical
J35: MWS_OLED; PinSocket_1x04_P2.54mm_Vertical
U3: TCA9548APWR; DIP-24_TCA9548A

Connections:
+3V3: U3.1 (VCC)
+5V: J19.1, J20.1, J31.1, J35.1
GND: J19.2, J20.2, J31.2, J35.2, U3.2 (GND)
I2C_SEL_A0: U3.6 (A0)
I2C_SEL_A1: U3.7 (A1)
I2C_SEL_A2: U3.8 (A2)
I2C_SEL_RESET: U3.5 (~RESET)
SC4: J20.3, U3.18 (SC4)
SC5: J19.3, U3.20 (SC5)
SC6: J31.3, U3.22 (SC6)
SC7: J35.3, U3.24 (SC7)
SCL: U3.4 (SCL)
SD4: J20.4, U3.17 (SD4)
SD5: J19.4, U3.19 (SD5)
SD6: J31.4, U3.21 (SD6)
SD7: J35.4, U3.23 (SD7)
SDA: U3.3 (SDA)
UHF_CHANNEL_SC: U3.12 (SC1)
UHF_CHANNEL_SD: U3.11 (SD1)
UHF_PRESET_SC: U3.10 (SC0)
UHF_PRESET_SD: U3.9 (SD0)
VHF_AM_OLED_SC: U3.14 (SC2)
VHF_AM_OLED_SD: U3.13 (SD2)
VHF_FM_OLED_SC: U3.16 (SC3)
VHF_FM_OLED_SD: U3.15 (SD3)
