bnepethomas/bne-arduino-flight-simulator-interfaces/A10/A10 PCBs/Left Console Input/ETHERNET_MOD.kicad_sch

## KiCad design A10/A10 PCBs/Left Console Input/ETHERNET_MOD.kicad_sch (2025-11-29)

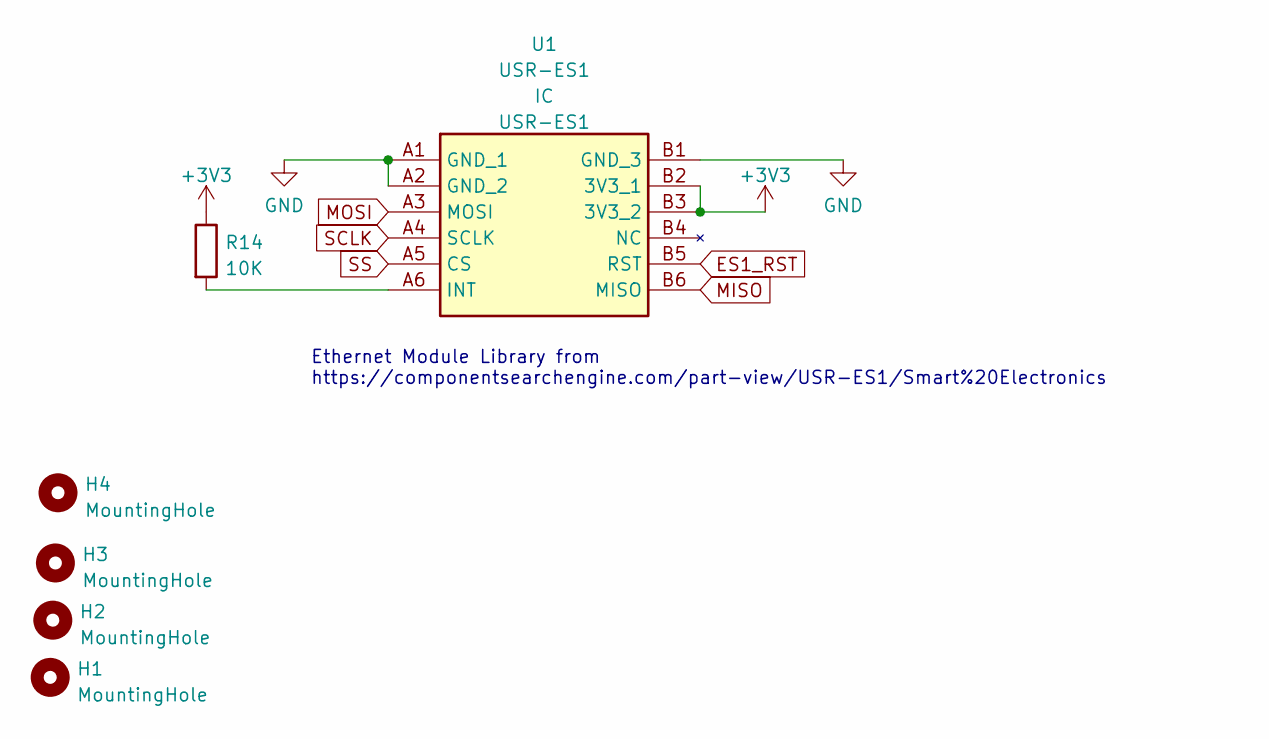
[picture p567: schematic ETHERNET_MOD.kicad_sch]

Parts:
H1, H2, H3, H4: MountingHole; MountingHole_3.2mm
R14: 10K; R_Axial_DIN0204_L3.6mm_D1.6mm_P2.54mm_Vertical
U1: USR-ES1; USRES1; Manufacturer_Part_Number USR-ES1

Connections:
+3V3: R14.1, U1.B2 (3V3_1), U1.B3 (3V3_2)
ES1_RST: U1.B5 (RST)
GND: U1.A1 (GND_1), U1.A2 (GND_2), U1.B1 (GND_3)
MISO: U1.B6 (MISO)
MOSI: U1.A3 (MOSI)
unnamed: R14.2, U1.A6 (INT)
SCLK: U1.A4 (SCLK)
SS: U1.A5 (CS)

Notes on the sheet:
Ethernet Module Library from https://componentsearchengine.com/part-view/USR-ES1/Smart%20Electronics
