bnepethomas/bne-arduino-flight-simulator-interfaces/A10/A10 PCBs/Left Console Input/Left Console Input.kicad_sch

## KiCad design A10/A10 PCBs/Left Console Input/Left Console Input.kicad_sch (2025-11-29)

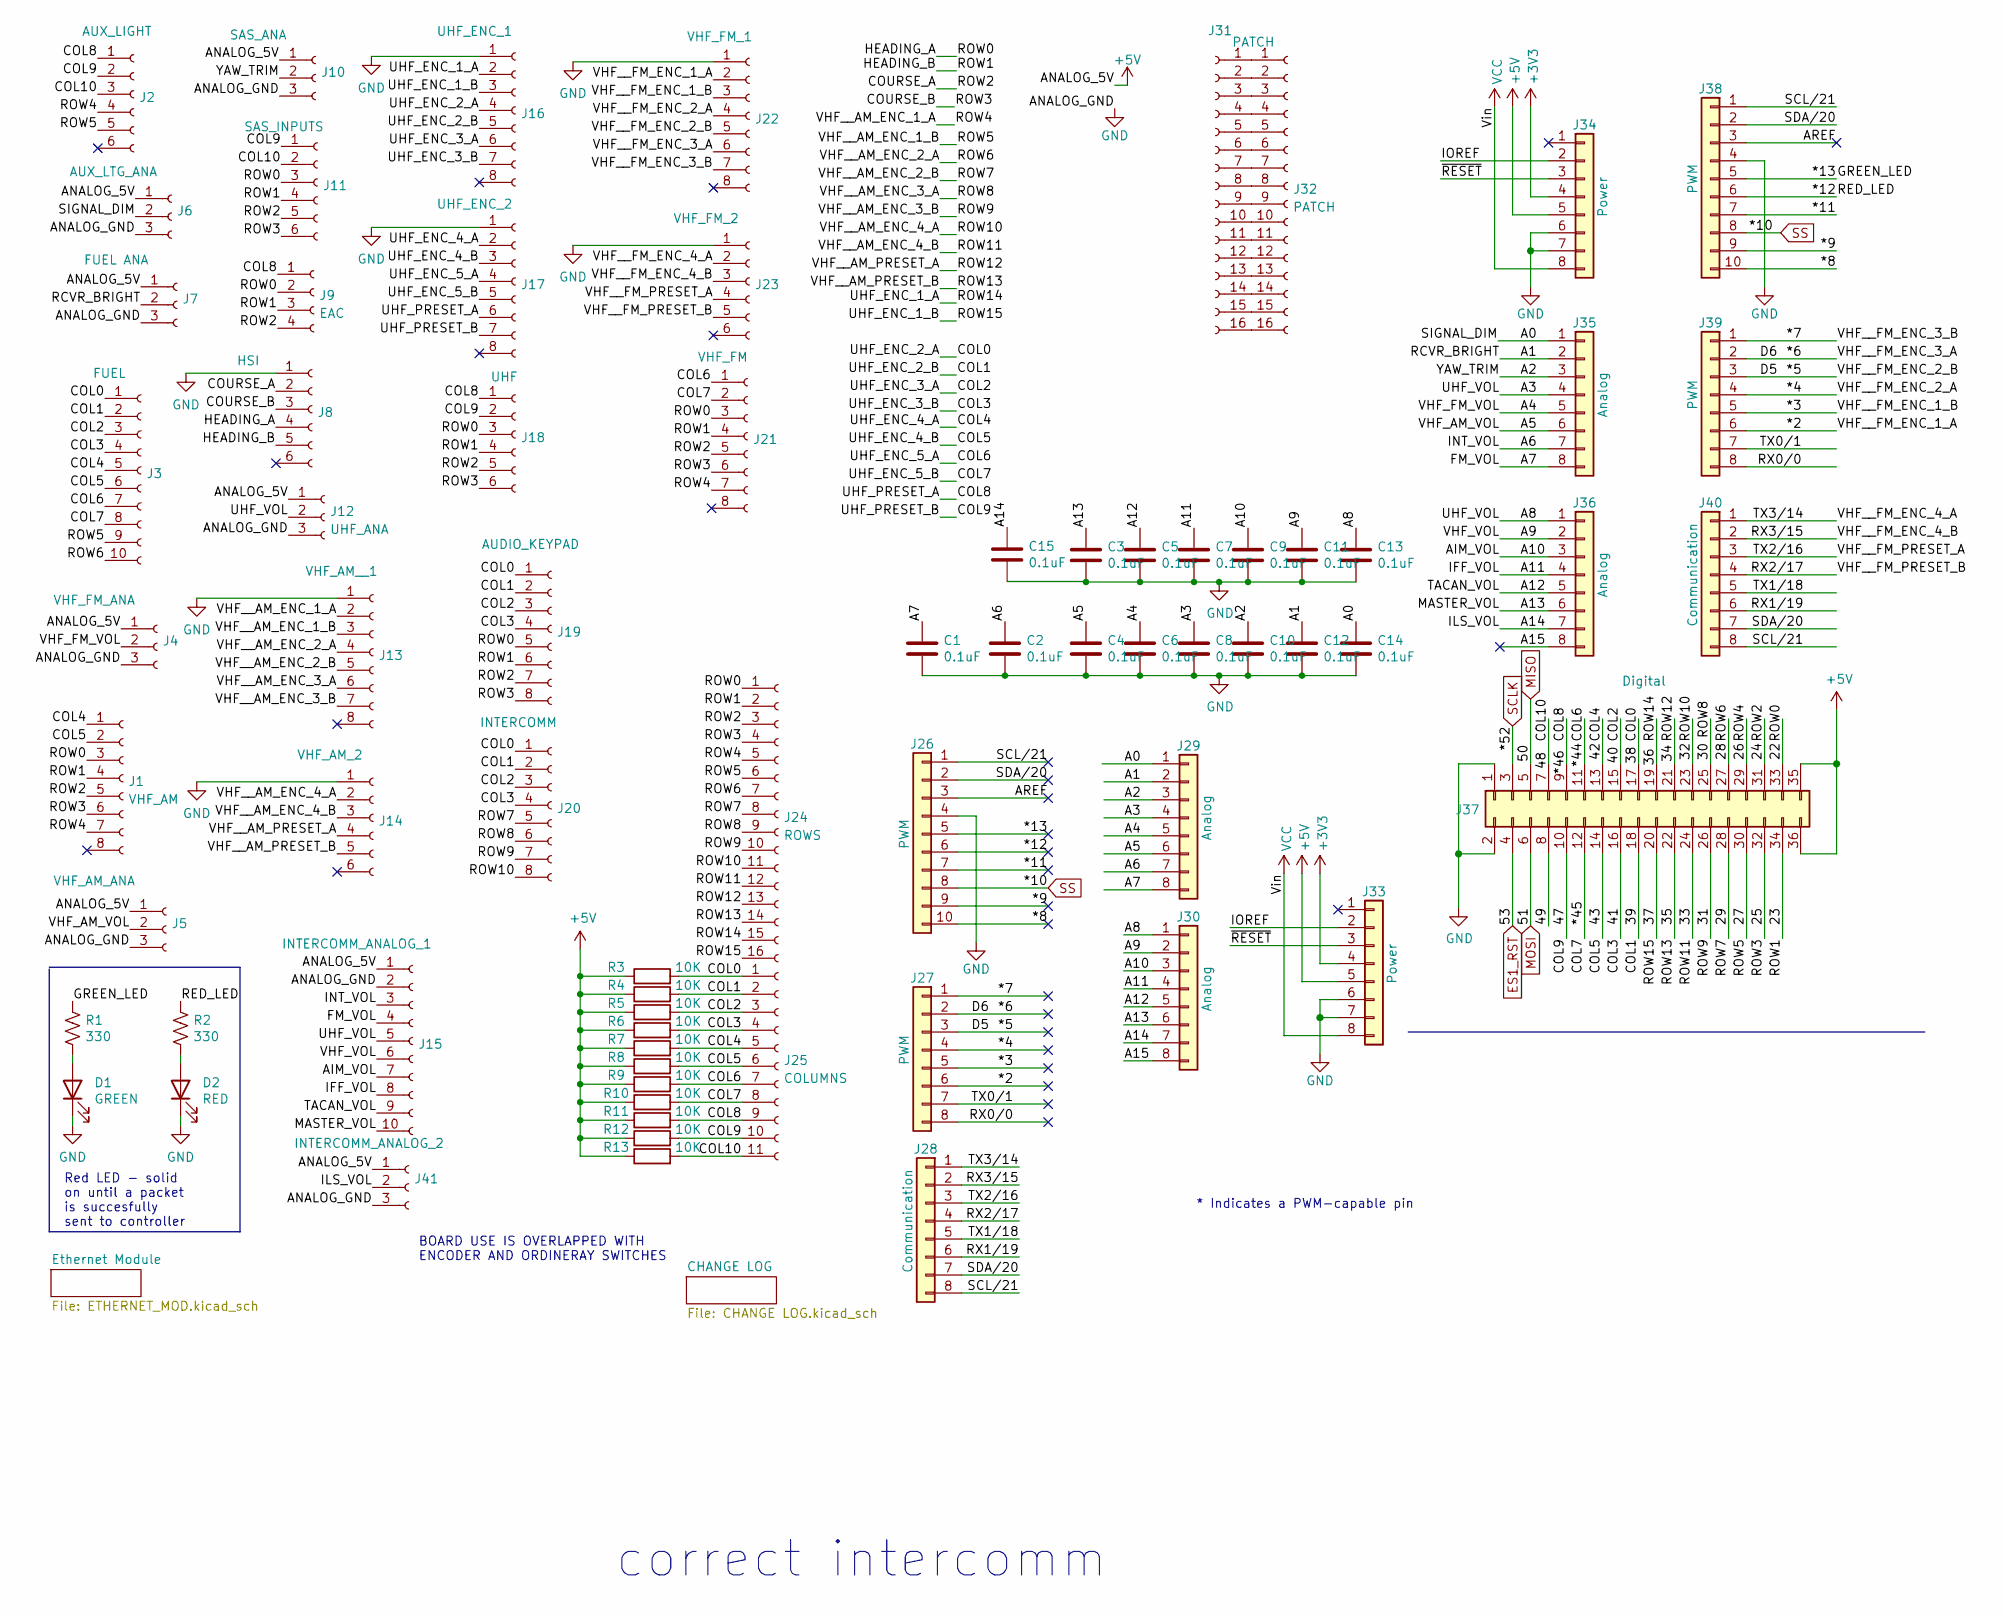
[picture p568: schematic Left Console Input.kicad_sch]

Parts:
C1, C2, C3, C4, C5, C6, C7, C8, C9, C10, C11, C12, C13, C14, C15: 0.1uF; C_Disc_D6.0mm_W2.5mm_P5.00mm
D1: GREEN; LED_D3.0mm
D2: RED; LED_D3.0mm
J1: VHF_AM; Molex_KK-254_AE-6410-08A_1x08_P2.54mm_Vertical
J2: AUX_LIGHT; Molex_KK-254_AE-6410-06A_1x06_P2.54mm_Vertical
J3: FUEL; Molex_KK-254_AE-6410-10A_1x10_P2.54mm_Vertical
J4: VHF_FM_ANA; Molex_KK-254_AE-6410-03A_1x03_P2.54mm_Vertical
J5: VHF_AM_ANA; Molex_KK-254_AE-6410-03A_1x03_P2.54mm_Vertical
J6: AUX_LTG_ANA; Molex_KK-254_AE-6410-03A_1x03_P2.54mm_Vertical
J7: FUEL ANA; Molex_KK-254_AE-6410-03A_1x03_P2.54mm_Vertical
J8: HSI; Molex_KK-254_AE-6410-06A_1x06_P2.54mm_Vertical
J9: EAC; Molex_KK-254_AE-6410-04A_1x04_P2.54mm_Vertical
J10: SAS_ANA; Molex_KK-254_AE-6410-03A_1x03_P2.54mm_Vertical
J11: SAS_INPUTS; Molex_KK-254_AE-6410-06A_1x06_P2.54mm_Vertical
J12: UHF_ANA; Molex_KK-254_AE-6410-03A_1x03_P2.54mm_Vertical
J13: VHF_AM__1; Molex_KK-254_AE-6410-08A_1x08_P2.54mm_Vertical
J14: VHF_AM_2; Molex_KK-254_AE-6410-06A_1x06_P2.54mm_Vertical
J15: INTERCOMM_ANALOG_1; Molex_KK-254_AE-6410-10A_1x10_P2.54mm_Vertical
J16: UHF_ENC_1; Molex_KK-254_AE-6410-08A_1x08_P2.54mm_Vertical
J17: UHF_ENC_2; Molex_KK-254_AE-6410-08A_1x08_P2.54mm_Vertical
J18: UHF; Molex_KK-254_AE-6410-06A_1x06_P2.54mm_Vertical
J19: AUDIO_KEYPAD; Molex_KK-254_AE-6410-08A_1x08_P2.54mm_Vertical
J20: INTERCOMM; Molex_KK-254_AE-6410-08A_1x08_P2.54mm_Vertical
J21: VHF_FM; Molex_KK-254_AE-6410-08A_1x08_P2.54mm_Vertical
J22: VHF_FM_1; Molex_KK-254_AE-6410-08A_1x08_P2.54mm_Vertical
J23: VHF_FM_2; Molex_KK-254_AE-6410-06A_1x06_P2.54mm_Vertical
J24: ROWS; PinHeader_1x16_P2.54mm_Vertical
J25: COLUMNS; PinHeader_1x11_P2.54mm_Vertical
J26, J38: PWM; PinSocket_1x10_P2.54mm_Vertical
J27, J39: PWM; PinSocket_1x08_P2.54mm_Vertical
J28, J40: Communication; PinSocket_1x08_P2.54mm_Vertical
J29, J30, J35, J36: Analog; PinSocket_1x08_P2.54mm_Vertical
J31, J32: PATCH; PinHeader_1x16_P2.54mm_Vertical
J33, J34: Power; PinSocket_1x08_P2.54mm_Vertical
J37: Digital; PinSocket_2x18_P2.54mm_Vertical
J41: INTERCOMM_ANALOG_2; Molex_KK-254_AE-6410-03A_1x03_P2.54mm_Vertical
R1, R2: 330; R_Axial_DIN0204_L3.6mm_D1.6mm_P2.54mm_Vertical
R3, R4, R5, R6, R7, R8, R9, R10, R11, R12, R13: 10K; R_Axial_DIN0204_L3.6mm_D1.6mm_P2.54mm_Vertical

Connections:
2: J22.2, J27.6, J39.6
3: J22.3, J27.5, J39.5
4: J22.4, J27.4, J39.4
5: J22.5, J27.3, J39.3
6: J22.6, J27.2, J39.2
7: J22.7, J27.1, J39.1
8: J26.10, J38.10
9: J26.9, J38.9
10: J26.8, J38.8
11: J26.7, J38.7
12: J26.6, J38.6, R2.1
13: J26.5, J38.5, R1.1
22: J1.3, J8.4, J9.2, J11.3, J18.3, J19.5, J21.3, J24.1, J37.33
23: J1.4, J8.5, J9.3, J11.4, J18.4, J19.6, J21.4, J24.2, J37.34
24: J1.5, J8.2, J9.4, J11.5, J18.5, J19.7, J21.5, J24.3, J37.31
25: J1.6, J8.3, J11.6, J18.6, J19.8, J21.6, J24.4, J37.32
26: J1.7, J2.4, J13.2, J21.7, J24.5, J37.29
27: J2.5, J3.9, J13.3, J24.6, J37.30
28: J3.10, J13.4, J24.7, J37.27
29: J13.5, J20.5, J24.8, J37.28
30: J13.6, J20.6, J24.9, J37.25
31: J13.7, J20.7, J24.10, J37.26
32: J14.2, J20.8, J24.11, J37.23
33: J14.3, J24.12, J37.24
34: J14.4, J24.13, J37.21
35: J14.5, J24.14, J37.22
36: J16.2, J24.15, J37.19
37: J16.3, J24.16, J37.20
38: J3.1, J16.4, J19.1, J20.1, J25.1, J37.17, R3.2
39: J3.2, J16.5, J19.2, J20.2, J25.2, J37.18, R4.2
40: J3.3, J16.6, J19.3, J20.3, J25.3, J37.15, R5.2
41: J3.4, J16.7, J19.4, J20.4, J25.4, J37.16, R6.2
42: J1.1, J3.5, J17.2, J25.5, J37.13, R7.2
43: J1.2, J3.6, J17.3, J25.6, J37.14, R8.2
44: J3.7, J17.4, J21.1, J25.7, J37.11, R9.2
45: J3.8, J17.5, J21.2, J25.8, J37.12, R10.2
46: J2.1, J9.1, J17.6, J18.1, J25.9, J37.9, R11.2
47: J2.2, J11.1, J17.7, J18.2, J25.10, J37.10, R12.2
48: J2.3, J11.2, J25.11, J37.7, R13.2
49: J37.8
52: J37.3
+3V3: J33.4, J34.4
+5V: J4.1, J5.1, J6.1, J7.1, J10.1, J12.1, J15.1, J33.5, J34.5, J37.35, J37.36, J41.1, R3.1, R4.1, R5.1, R6.1, R7.1, R8.1, R9.1, R10.1, R11.1, R12.1, R13.1
A0: C14.1, J6.2, J29.1, J35.1
A1: C12.1, J7.2, J29.2, J35.2
A2: C10.1, J10.2, J29.3, J35.3
A3: C8.1, C13.1, J12.2, J15.5, J29.4, J30.1, J35.4, J36.1
A4: C6.1, J4.2, J29.5, J35.5
A5: C4.1, J5.2, J29.6, J35.6
A6: C2.1, J15.3, J29.7, J35.7
A7: C1.1, J15.4, J29.8, J35.8
A9: C11.1, J15.6, J30.2, J36.2
A10: C9.1, J15.7, J30.3, J36.3
A11: C7.1, J15.8, J30.4, J36.4
A12: C5.1, J15.9, J30.5, J36.5
A13: C3.1, J15.10, J30.6, J36.6
A14: C15.1, J30.7, J36.7, J41.2
A15: J30.8, J36.8
AREF: J26.3, J38.3
ES1_RST: J37.4
GND: C1.2, C2.2, C3.2, C4.2, C5.2, C6.2, C7.2, C8.2, C9.2, C10.2, C11.2, C12.2, C13.2, C14.2, C15.2, D1.1 (K), D2.1 (K), J4.3, J5.3, J6.3, J7.3, J8.1, J10.3, J12.3, J13.1, J14.1, J15.2, J16.1, J17.1, J22.1, J23.1, J26.4, J33.6, J33.7, J34.6, J34.7, J37.1, J37.2, J38.4, J41.3
IOREF: J33.2, J34.2
MISO: J37.5
MOSI: J37.6
unnamed: D1.2 (A), R1.2
unnamed: D2.2 (A), R2.2
unnamed: J31.1, J32.1
unnamed: J31.2, J32.2
unnamed: J31.3, J32.3
unnamed: J31.4, J32.4
unnamed: J31.5, J32.5
unnamed: J31.6, J32.6
unnamed: J31.7, J32.7
unnamed: J31.8, J32.8
unnamed: J31.9, J32.9
unnamed: J31.10, J32.10
unnamed: J31.11, J32.11
unnamed: J31.12, J32.12
unnamed: J31.13, J32.13
unnamed: J31.14, J32.14
unnamed: J31.15, J32.15
unnamed: J31.16, J32.16
RX0/0: J27.8, J39.8
RX1/19: J28.6, J40.6
RX2/17: J23.5, J28.4, J40.4
RX3/15: J23.3, J28.2, J40.2
SCL/21: J26.1, J28.8, J38.1, J40.8
SDA/20: J26.2, J28.7, J38.2, J40.7
TX0/1: J27.7, J39.7
TX1/18: J28.5, J40.5
TX2/16: J23.4, J28.3, J40.3
TX3/14: J23.2, J28.1, J40.1
VCC: J33.8, J34.8
~RESET: J33.3, J34.3

Notes on the sheet:
BOARD USE IS OVERLAPPED WITH ENCODER AND ORDINERAY SWITCHES
Red LED - solid on until a packet is succesfully sent to controller
* Indicates a PWM-capable pin
correct intercomm
