bnepethomas/bne-arduino-flight-simulator-interfaces/A10/A10 PCBs/Left Console Overview/AUDIO_KEYPAD.kicad_sch

## KiCad design A10/A10 PCBs/Left Console Overview/AUDIO_KEYPAD.kicad_sch (2025-11-29)

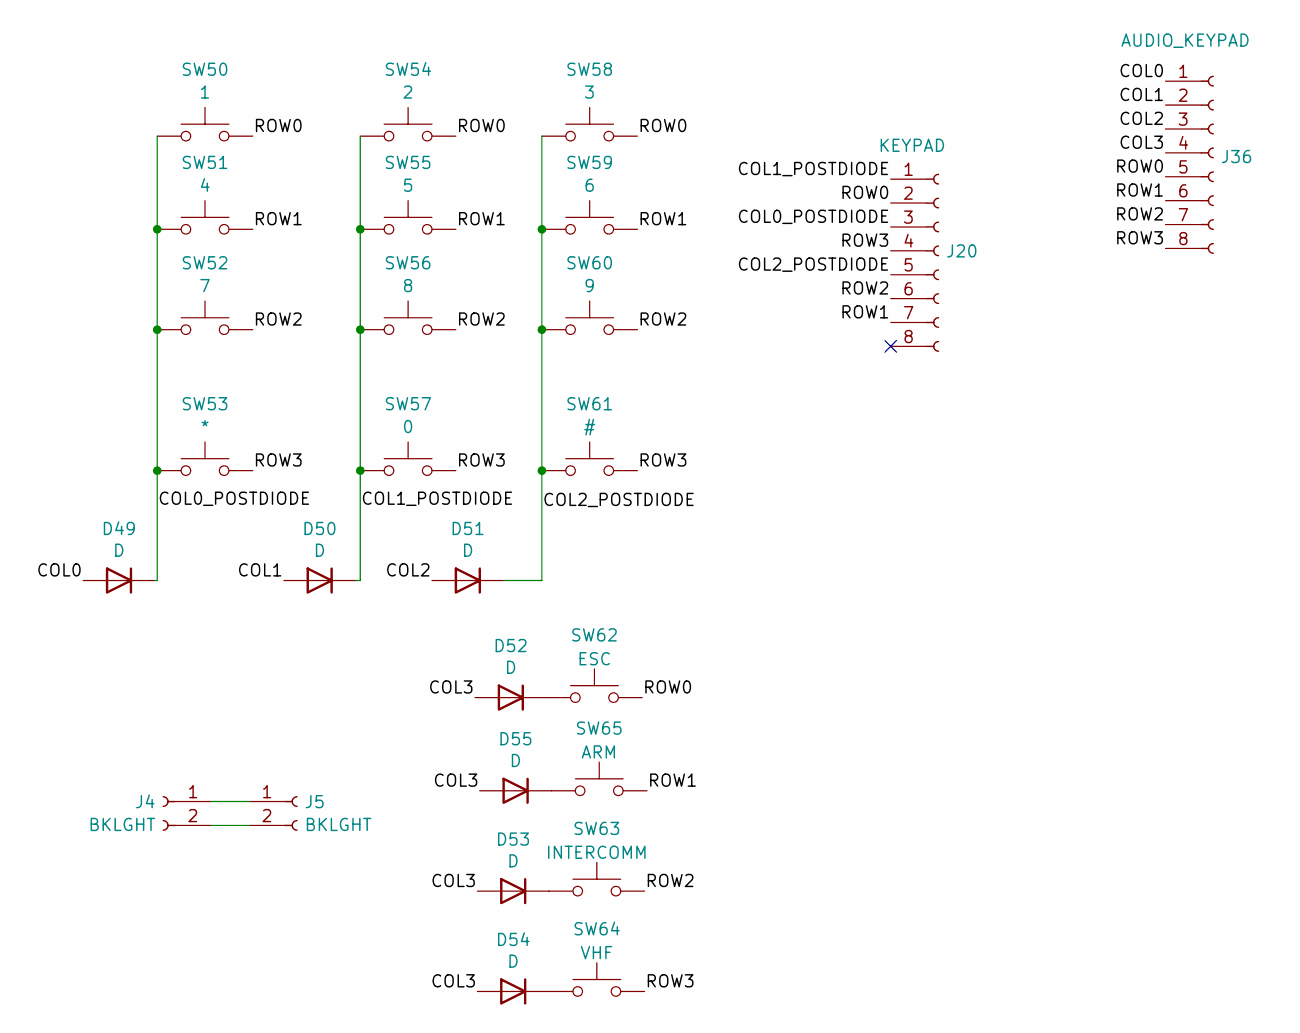
[picture p569: schematic AUDIO_KEYPAD.kicad_sch]

Parts:
D49, D50, D51, D52, D53, D54, D55: D; D_A-405_P7.62mm_Horizontal
J4, J5: BKLGHT; Molex_KK-254_AE-6410-02A_1x02_P2.54mm_Vertical
J20: KEYPAD; Molex_KK-254_AE-6410-08A_1x08_P2.54mm_Vertical
J36: AUDIO_KEYPAD
SW50: 1; Molex_KK-254_AE-6410-02A_1x02_P2.54mm_Vertical
SW51: 4; Molex_KK-254_AE-6410-02A_1x02_P2.54mm_Vertical
SW52: 7; Molex_KK-254_AE-6410-02A_1x02_P2.54mm_Vertical
SW53: *; Molex_KK-254_AE-6410-02A_1x02_P2.54mm_Vertical
SW54: 2; Molex_KK-254_AE-6410-02A_1x02_P2.54mm_Vertical
SW55: 5; Molex_KK-254_AE-6410-02A_1x02_P2.54mm_Vertical
SW56: 8; Molex_KK-254_AE-6410-02A_1x02_P2.54mm_Vertical
SW57: 0; Molex_KK-254_AE-6410-02A_1x02_P2.54mm_Vertical
SW58: 3; Molex_KK-254_AE-6410-02A_1x02_P2.54mm_Vertical
SW59: 6; Molex_KK-254_AE-6410-02A_1x02_P2.54mm_Vertical
SW60: 9; Molex_KK-254_AE-6410-02A_1x02_P2.54mm_Vertical
SW61: #; Molex_KK-254_AE-6410-02A_1x02_P2.54mm_Vertical
SW62: ESC; Molex_KK-254_AE-6410-02A_1x02_P2.54mm_Vertical
SW63: INTERCOMM; Molex_KK-254_AE-6410-02A_1x02_P2.54mm_Vertical
SW64: VHF; Molex_KK-254_AE-6410-02A_1x02_P2.54mm_Vertical
SW65: ARM; Molex_KK-254_AE-6410-02A_1x02_P2.54mm_Vertical

Connections:
COL0: D49.2 (A), J36.1
COL0_POSTDIODE: D49.1 (K), J20.3, SW50.1, SW51.1, SW52.1, SW53.1
COL1: D50.2 (A), J36.2
COL1_POSTDIODE: D50.1 (K), J20.1, SW54.1, SW55.1, SW56.1, SW57.1
COL2: D51.2 (A), J36.3
COL2_POSTDIODE: D51.1 (K), J20.5, SW58.1, SW59.1, SW60.1, SW61.1
COL3: D52.2 (A), D53.2 (A), D54.2 (A), D55.2 (A), J36.4
unnamed: D52.1 (K), SW62.1
unnamed: D53.1 (K), SW63.1
unnamed: D54.1 (K), SW64.1
unnamed: D55.1 (K), SW65.1
unnamed: J4.1, J5.1
unnamed: J4.2, J5.2
ROW0: J20.2, J36.5, SW50.2, SW54.2, SW58.2, SW62.2
ROW1: J20.7, J36.6, SW51.2, SW55.2, SW59.2, SW65.2
ROW2: J20.6, J36.7, SW52.2, SW56.2, SW60.2, SW63.2
ROW3: J20.4, J36.8, SW53.2, SW57.2, SW61.2, SW64.2
