bnepethomas/bne-arduino-flight-simulator-interfaces/A10/A10 PCBs/Left Console Overview/AUX_LIGHT.kicad_sch

## KiCad design A10/A10 PCBs/Left Console Overview/AUX_LIGHT.kicad_sch (2025-11-29)

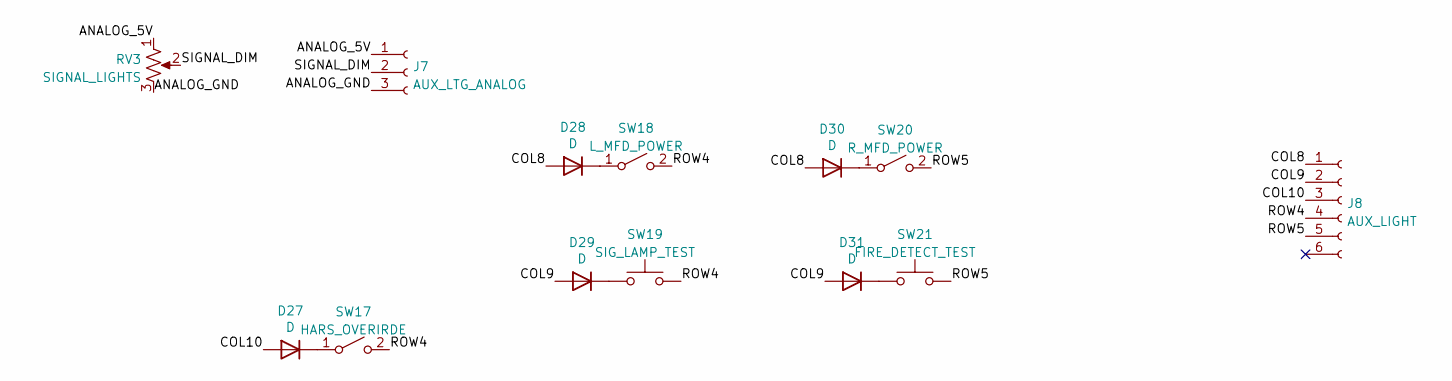
[picture p570: schematic AUX_LIGHT.kicad_sch]

Parts:
D27, D28, D29, D30, D31: D; D_Signal_P7.62mm_Horizontal
J7: AUX_LTG_ANALOG
J8: AUX_LIGHT
RV3: SIGNAL_LIGHTS
SW17: HARS_OVERIRDE
SW18: L_MFD_POWER
SW19: SIG_LAMP_TEST
SW20: R_MFD_POWER
SW21: FIRE_DETECT_TEST

Connections:
ANALOG_5V: J7.1, RV3.1
ANALOG_GND: J7.3, RV3.3
COL8: D28.2 (A), D30.2 (A), J8.1
COL9: D29.2 (A), D31.2 (A), J8.2
COL10: D27.2 (A), J8.3
unnamed: D27.1 (K), SW17.1 (A)
unnamed: D28.1 (K), SW18.1 (A)
unnamed: D29.1 (K), SW19.1
unnamed: D30.1 (K), SW20.1 (A)
unnamed: D31.1 (K), SW21.1
ROW4: J8.4, SW17.2 (B), SW18.2 (B), SW19.2
ROW5: J8.5, SW20.2 (B), SW21.2
SIGNAL_DIM: J7.2, RV3.2
