bnepethomas/bne-arduino-flight-simulator-interfaces/A10/A10 PCBs/Left Console Overview/EAC.kicad_sch

## KiCad design A10/A10 PCBs/Left Console Overview/EAC.kicad_sch (2025-11-29)

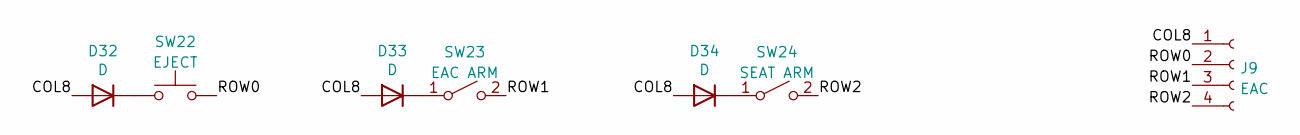
[picture p571: schematic EAC.kicad_sch]

Parts:
D32, D33, D34: D; D_Signal_P7.62mm_Horizontal
J9: EAC
SW22: EJECT
SW23: EAC ARM
SW24: SEAT ARM

Connections:
COL8: D32.2 (A), D33.2 (A), D34.2 (A), J9.1
unnamed: D32.1 (K), SW22.1
unnamed: D33.1 (K), SW23.1 (A)
unnamed: D34.1 (K), SW24.1 (A)
ROW0: J9.2, SW22.2
ROW1: J9.3, SW23.2 (B)
ROW2: J9.4, SW24.2 (B)
