bnepethomas/bne-arduino-flight-simulator-interfaces/A10/A10 PCBs/Left Console Overview/FUEL.kicad_sch

## KiCad design A10/A10 PCBs/Left Console Overview/FUEL.kicad_sch (2025-11-29)

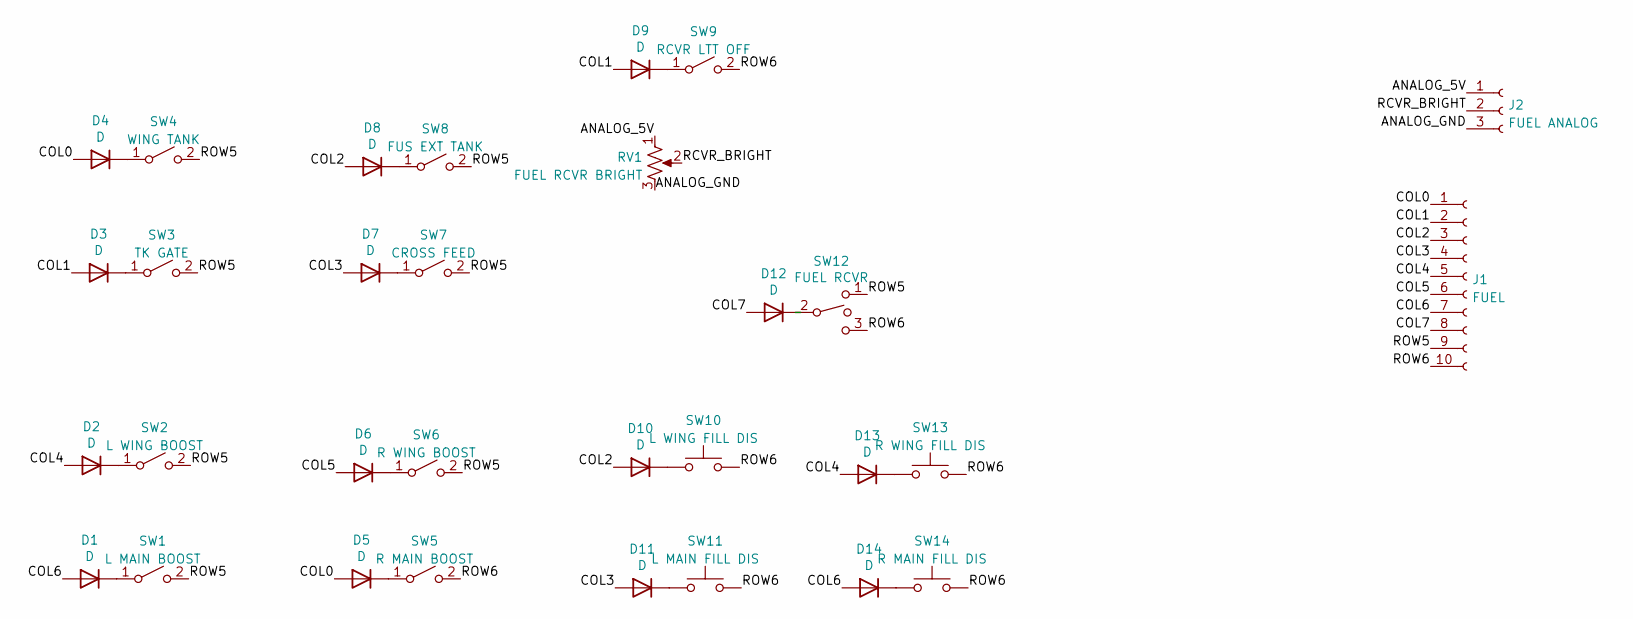
[picture p572: schematic FUEL.kicad_sch]

Parts:
D1, D2, D3, D4, D5, D6, D7, D8, D9, D10, D11, D12, D13, D14: D; D_Signal_P7.62mm_Horizontal
J1: FUEL
J2: FUEL ANALOG
RV1: FUEL RCVR BRIGHT
SW1: L MAIN BOOST
SW2: L WING BOOST
SW3: TK GATE
SW4: WING TANK
SW5: R MAIN BOOST
SW6: R WING BOOST
SW7: CROSS FEED
SW8: FUS EXT TANK
SW9: RCVR LTT OFF
SW10: L WING FILL DIS
SW11: L MAIN FILL DIS
SW12: FUEL RCVR; Molex_1x03_P2.54mm_Vertical
SW13: R WING FILL DIS
SW14: R MAIN FILL DIS

Connections:
ANALOG_5V: J2.1, RV1.1
ANALOG_GND: J2.3, RV1.3
COL0: D4.2 (A), D5.2 (A), J1.1
COL1: D3.2 (A), D9.2 (A), J1.2
COL2: D8.2 (A), D10.2 (A), J1.3
COL3: D7.2 (A), D11.2 (A), J1.4
COL4: D2.2 (A), D13.2 (A), J1.5
COL5: D6.2 (A), J1.6
COL6: D1.2 (A), D14.2 (A), J1.7
COL7: D12.2 (A), J1.8
unnamed: D1.1 (K), SW1.1 (A)
unnamed: D2.1 (K), SW2.1 (A)
unnamed: D3.1 (K), SW3.1 (A)
unnamed: D4.1 (K), SW4.1 (A)
unnamed: D5.1 (K), SW5.1 (A)
unnamed: D6.1 (K), SW6.1 (A)
unnamed: D7.1 (K), SW7.1 (A)
unnamed: D8.1 (K), SW8.1 (A)
unnamed: D9.1 (K), SW9.1 (A)
unnamed: D10.1 (K), SW10.1
unnamed: D11.1 (K), SW11.1
unnamed: D12.1 (K), SW12.2
unnamed: D13.1 (K), SW13.1
unnamed: D14.1 (K), SW14.1
RCVR_BRIGHT: J2.2, RV1.2
ROW5: J1.9, SW1.2 (B), SW2.2 (B), SW3.2 (B), SW4.2 (B), SW6.2 (B), SW7.2 (B), SW8.2 (B), SW12.1
ROW6: J1.10, SW5.2 (B), SW9.2 (B), SW10.2, SW11.2, SW12.3, SW13.2, SW14.2
