bnepethomas/bne-arduino-flight-simulator-interfaces/A10/A10 PCBs/Left Console Overview/HSI.kicad_sch

## KiCad design A10/A10 PCBs/Left Console Overview/HSI.kicad_sch (2025-11-29)

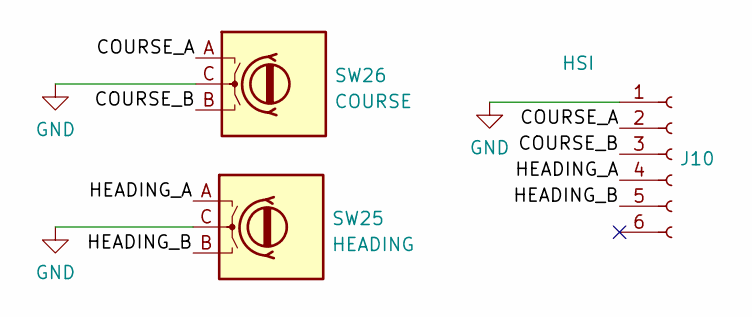
[picture p573: schematic HSI.kicad_sch]

Parts:
J10: HSI; Molex_KK-254_AE-6410-06A_1x06_P2.54mm_Vertical
SW25: HEADING; Molex_KK-254_AE-6410-03A_1x03_P2.54mm_Vertical
SW26: COURSE; Molex_KK-254_AE-6410-03A_1x03_P2.54mm_Vertical

Connections:
COURSE_A: J10.2, SW26.A
COURSE_B: J10.3, SW26.B
GND: J10.1, SW25.C, SW26.C
HEADING_A: J10.4, SW25.A
HEADING_B: J10.5, SW25.B
