bnepethomas/bne-arduino-flight-simulator-interfaces/A10/A10 PCBs/Left Console Overview/INTERCOMM.kicad_sch

## KiCad design A10/A10 PCBs/Left Console Overview/INTERCOMM.kicad_sch (2025-11-29)

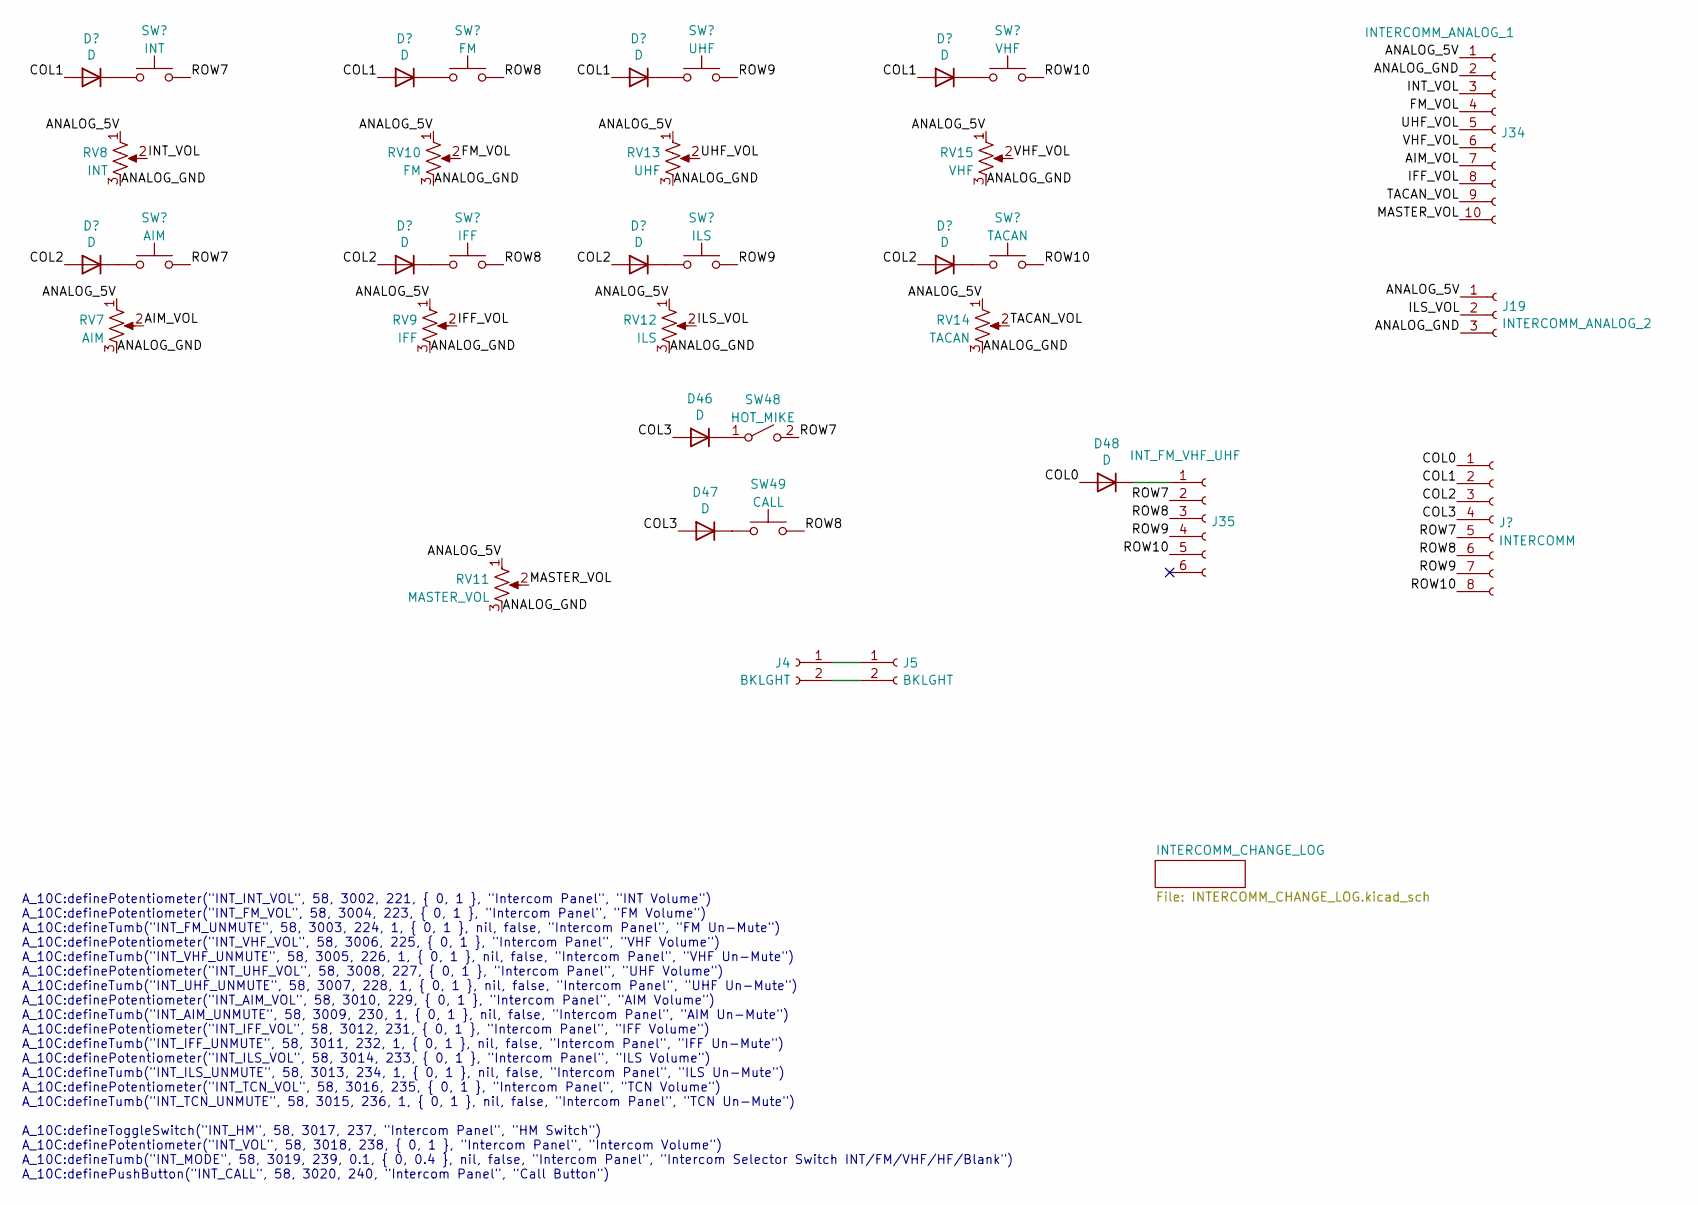
[picture p574: schematic INTERCOMM.kicad_sch]

Parts:
D46: D; D_Signal_P7.62mm_Horizontal
D47, D48: D; D_A-405_P7.62mm_Horizontal
J4, J5: BKLGHT; Molex_KK-254_AE-6410-02A_1x02_P2.54mm_Vertical
J19: INTERCOMM_ANALOG_2
J34: INTERCOMM_ANALOG_1; Potentiometer_Alps_RK097_Single_Horizontal_Switch
J35: INT_FM_VHF_UHF; Molex_KK-254_AE-6410-06A_1x06_P2.54mm_Vertical
RV7: AIM
RV8: INT
RV9: IFF
RV10: FM
RV11: MASTER_VOL
RV12: ILS
RV13: UHF
RV14: TACAN
RV15: VHF
SW48: HOT_MIKE
SW49: CALL; Molex_KK-254_AE-6410-02A_1x02_P2.54mm_Vertical

Connections:
AIM_VOL: J34.7, RV7.2
ANALOG_5V: J19.1, J34.1, RV7.1, RV8.1, RV9.1, RV10.1, RV11.1, RV12.1, RV13.1, RV14.1, RV15.1
ANALOG_GND: J19.3, J34.2, RV7.3, RV8.3, RV9.3, RV10.3, RV11.3, RV12.3, RV13.3, RV14.3, RV15.3
COL0: D48.2 (A)
COL3: D46.2 (A), D47.2 (A)
FM_VOL: J34.4, RV10.2
IFF_VOL: J34.8, RV9.2
ILS_VOL: J19.2, RV12.2
INT_VOL: J34.3, RV8.2
MASTER_VOL: J34.10, RV11.2
unnamed: D46.1 (K), SW48.1 (A)
unnamed: D47.1 (K), SW49.1
unnamed: D48.1 (K), J35.1
unnamed: J4.1, J5.1
unnamed: J4.2, J5.2
ROW7: J35.2, SW48.2 (B)
ROW8: J35.3, SW49.2
ROW9: J35.4
ROW10: J35.5
TACAN_VOL: J34.9, RV14.2
UHF_VOL: J34.5, RV13.2
VHF_VOL: J34.6, RV15.2

Notes on the sheet:
A_10C:definePotentiometer("INT_INT_VOL", 58, 3002, 221, { 0, 1 }, "Intercom Panel", "INT Volume") A_10C:definePotentiometer("INT_FM_VOL", 58, 3004, 223, { 0, 1 }, "Intercom Panel", "FM Volume") A_10C:defineTumb("INT_FM_UNMUTE", 58, 3003, 224, 1, { 0, 1 }, nil, false, "Intercom Panel", "FM Un-Mute")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
