bnepethomas/bne-arduino-flight-simulator-interfaces/A10/A10 PCBs/Left Console Overview/SAS.kicad_sch

## KiCad design A10/A10 PCBs/Left Console Overview/SAS.kicad_sch (2025-11-29)

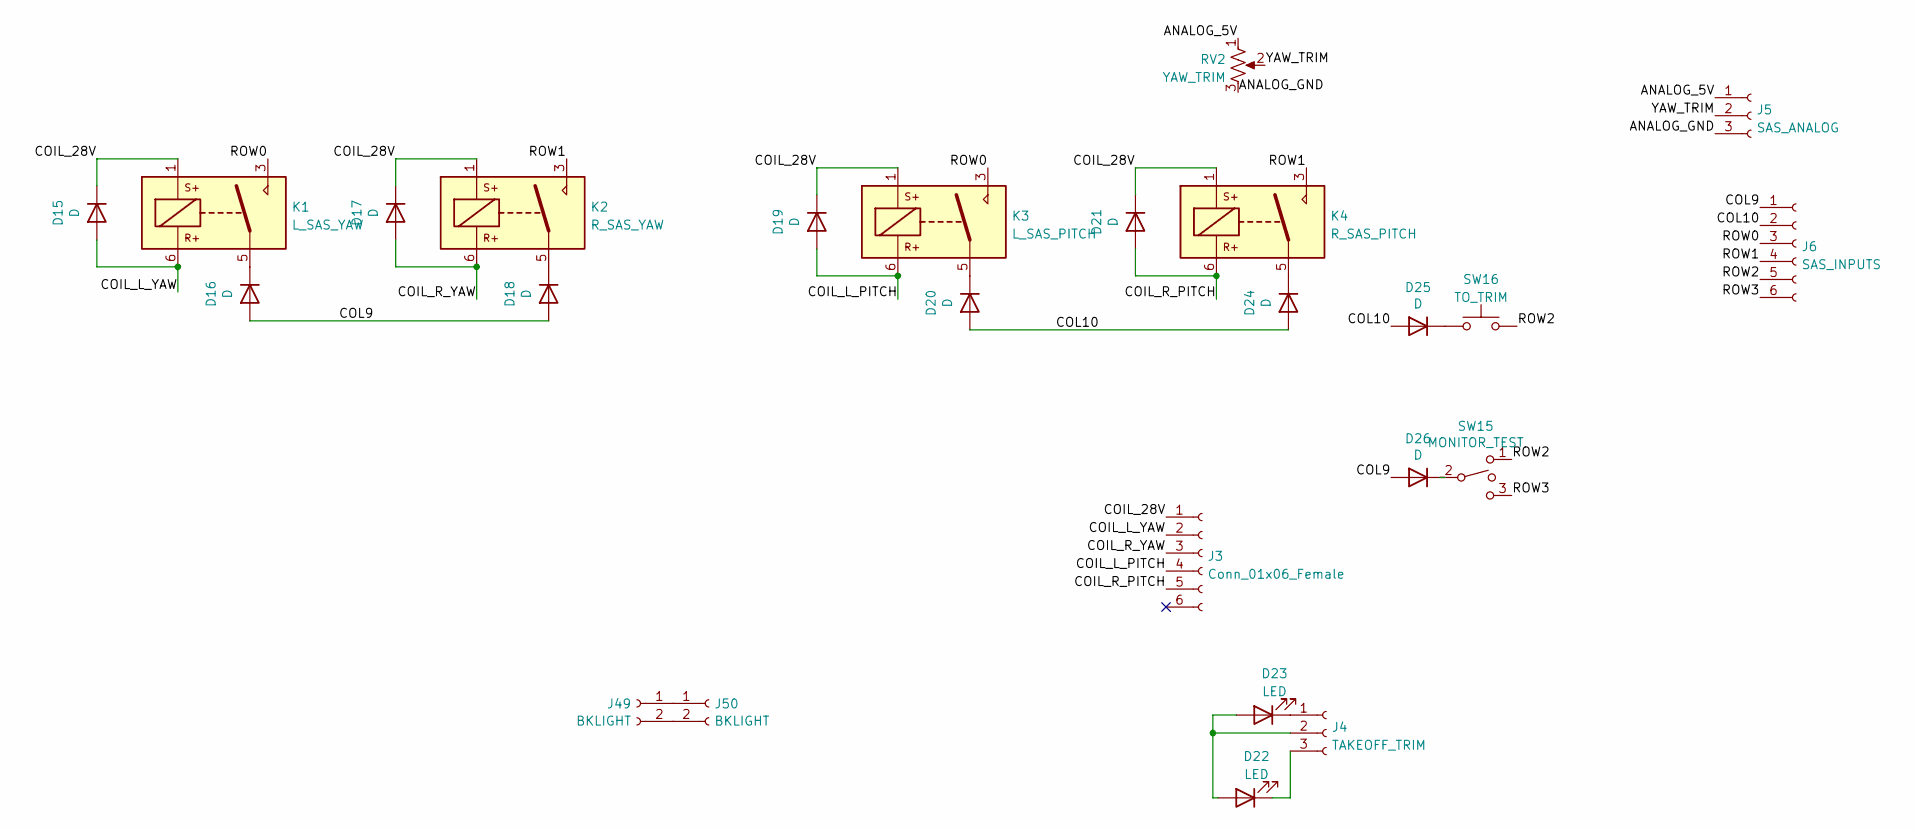
[picture p575: schematic SAS.kicad_sch]

Parts:
D15, D16, D17, D18, D19, D20, D21, D24, D25: D; D_A-405_P7.62mm_Horizontal
D22, D23: LED; Molex_KK-254_AE-6410-02A_1x02_P2.54mm_Vertical
D26: D; D_Signal_P7.62mm_Horizontal
J3: Conn_01x06_Female
J4: TAKEOFF_TRIM
J5: SAS_ANALOG
J6: SAS_INPUTS
J49, J50: BKLIGHT
K1: L_SAS_YAW; Relay_1P1T_NO_10x24x18.8mm_Panasonic_ADW11xxxxW_THT
K2: R_SAS_YAW; Relay_1P1T_NO_10x24x18.8mm_Panasonic_ADW11xxxxW_THT
K3: L_SAS_PITCH; Relay_1P1T_NO_10x24x18.8mm_Panasonic_ADW11xxxxW_THT
K4: R_SAS_PITCH; Relay_1P1T_NO_10x24x18.8mm_Panasonic_ADW11xxxxW_THT
RV2: YAW_TRIM
SW15: MONITOR_TEST; Molex_1x03_P2.54mm_Vertical
SW16: TO_TRIM; Molex_KK-254_AE-6410-02A_1x02_P2.54mm_Vertical

Connections:
ANALOG_5V: J5.1, RV2.1
ANALOG_GND: J5.3, RV2.3
COIL_28V: D15.1 (K), D17.1 (K), D19.1 (K), D21.1 (K), J3.1, K1.1, K2.1, K3.1, K4.1
COIL_L_PITCH: D19.2 (A), J3.4, K3.6
COIL_L_YAW: D15.2 (A), J3.2, K1.6
COIL_R_PITCH: D21.2 (A), J3.5, K4.6
COIL_R_YAW: D17.2 (A), J3.3, K2.6
COL9: D16.2 (A), D18.2 (A), D26.2 (A), J6.1
COL10: D20.2 (A), D24.2 (A), D25.2 (A), J6.2
unnamed: D16.1 (K), K1.5
unnamed: D18.1 (K), K2.5
unnamed: D20.1 (K), K3.5
unnamed: D22.1 (K), J4.3
unnamed: D22.2 (A), D23.2 (A), J4.2
unnamed: D23.1 (K), J4.1
unnamed: D24.1 (K), K4.5
unnamed: D25.1 (K), SW16.1
unnamed: D26.1 (K), SW15.2
unnamed: J49.1, J50.1
unnamed: J49.2, J50.2
ROW0: J6.3, K1.3, K3.3
ROW1: J6.4, K2.3, K4.3
ROW2: J6.5, SW15.1, SW16.2
ROW3: J6.6, SW15.3
YAW_TRIM: J5.2, RV2.2
