bnepethomas/bne-arduino-flight-simulator-interfaces/A10/A10 PCBs/Left Console Overview/UHF.kicad_sch

## KiCad design A10/A10 PCBs/Left Console Overview/UHF.kicad_sch (2025-11-29)

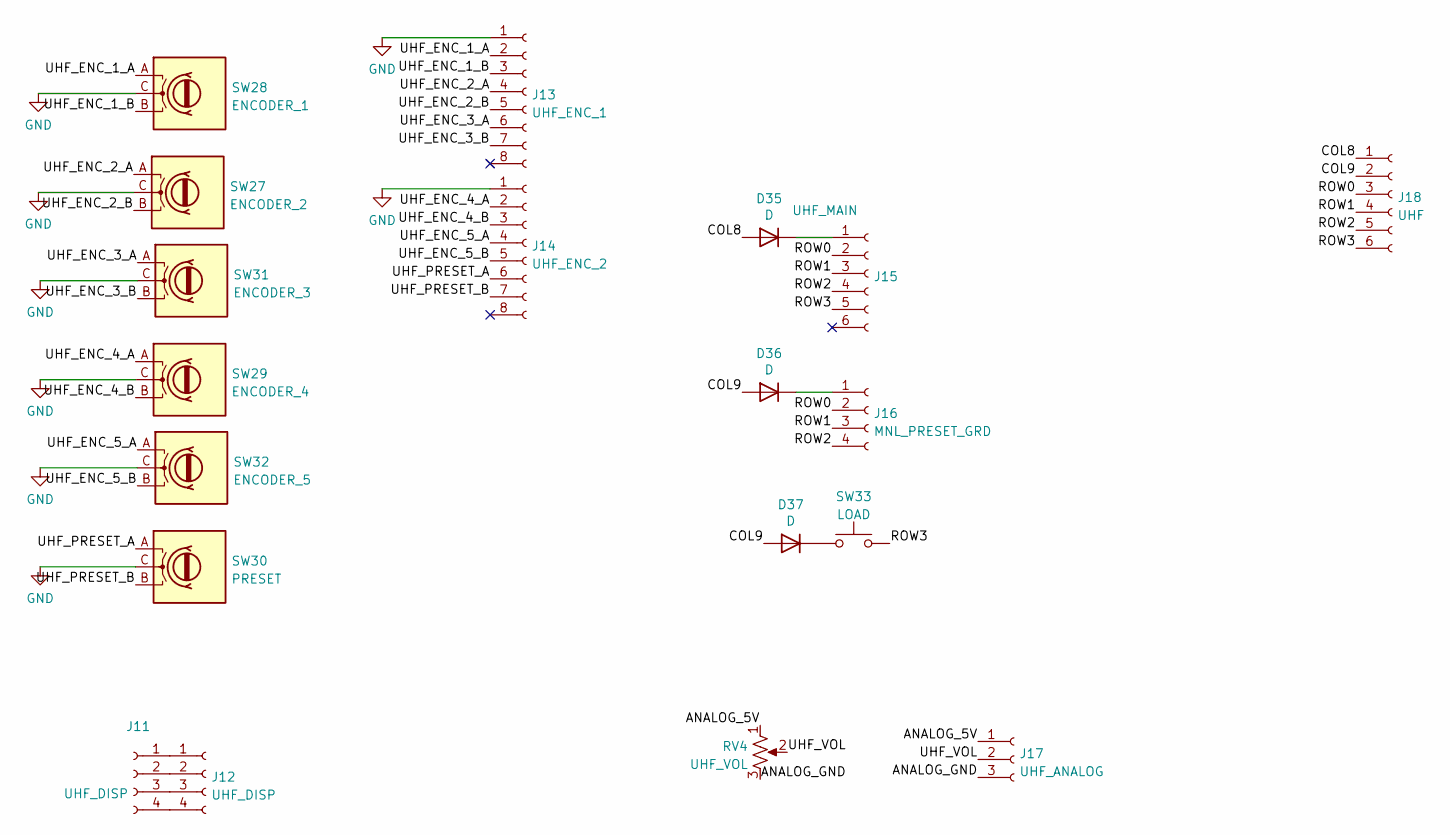
[picture p576: schematic UHF.kicad_sch]

Parts:
D35, D36, D37: D; D_A-405_P7.62mm_Horizontal
J11, J12: UHF_DISP
J13: UHF_ENC_1
J14: UHF_ENC_2
J15: UHF_MAIN; Molex_KK-254_AE-6410-06A_1x06_P2.54mm_Vertical
J16: MNL_PRESET_GRD
J17: UHF_ANALOG
J18: UHF
RV4: UHF_VOL
SW27: ENCODER_2; Molex_KK-254_AE-6410-03A_1x03_P2.54mm_Vertical
SW28: ENCODER_1; Molex_KK-254_AE-6410-03A_1x03_P2.54mm_Vertical
SW29: ENCODER_4; Molex_KK-254_AE-6410-03A_1x03_P2.54mm_Vertical
SW30: PRESET; Molex_KK-254_AE-6410-03A_1x03_P2.54mm_Vertical
SW31: ENCODER_3; Molex_KK-254_AE-6410-03A_1x03_P2.54mm_Vertical
SW32: ENCODER_5; Molex_KK-254_AE-6410-03A_1x03_P2.54mm_Vertical
SW33: LOAD; Molex_KK-254_AE-6410-02A_1x02_P2.54mm_Vertical

Connections:
ANALOG_5V: J17.1, RV4.1
ANALOG_GND: J17.3, RV4.3
COL8: D35.2 (A), J18.1
COL9: D36.2 (A), D37.2 (A), J18.2
GND: J13.1, J14.1, SW27.C, SW28.C, SW29.C, SW30.C, SW31.C, SW32.C
unnamed: D35.1 (K), J15.1
unnamed: D36.1 (K), J16.1
unnamed: D37.1 (K), SW33.1
unnamed: J11.1, J12.1
unnamed: J11.2, J12.2
unnamed: J11.3, J12.3
unnamed: J11.4, J12.4
ROW0: J15.2, J16.2, J18.3
ROW1: J15.3, J16.3, J18.4
ROW2: J15.4, J16.4, J18.5
ROW3: J15.5, J18.6, SW33.2
UHF_ENC_1_A: J13.2, SW28.A
UHF_ENC_1_B: J13.3, SW28.B
UHF_ENC_2_A: J13.4, SW27.A
UHF_ENC_2_B: J13.5, SW27.B
UHF_ENC_3_A: J13.6, SW31.A
UHF_ENC_3_B: J13.7, SW31.B
UHF_ENC_4_A: J14.2, SW29.A
UHF_ENC_4_B: J14.3, SW29.B
UHF_ENC_5_A: J14.4, SW32.A
UHF_ENC_5_B: J14.5, SW32.B
UHF_PRESET_A: J14.6, SW30.A
UHF_PRESET_B: J14.7, SW30.B
UHF_VOL: J17.2, RV4.2
