bnepethomas/bne-arduino-flight-simulator-interfaces/A10/A10 PCBs/Left Console Overview/VHF_AM.kicad_sch

## KiCad design A10/A10 PCBs/Left Console Overview/VHF_AM.kicad_sch (2025-11-29)

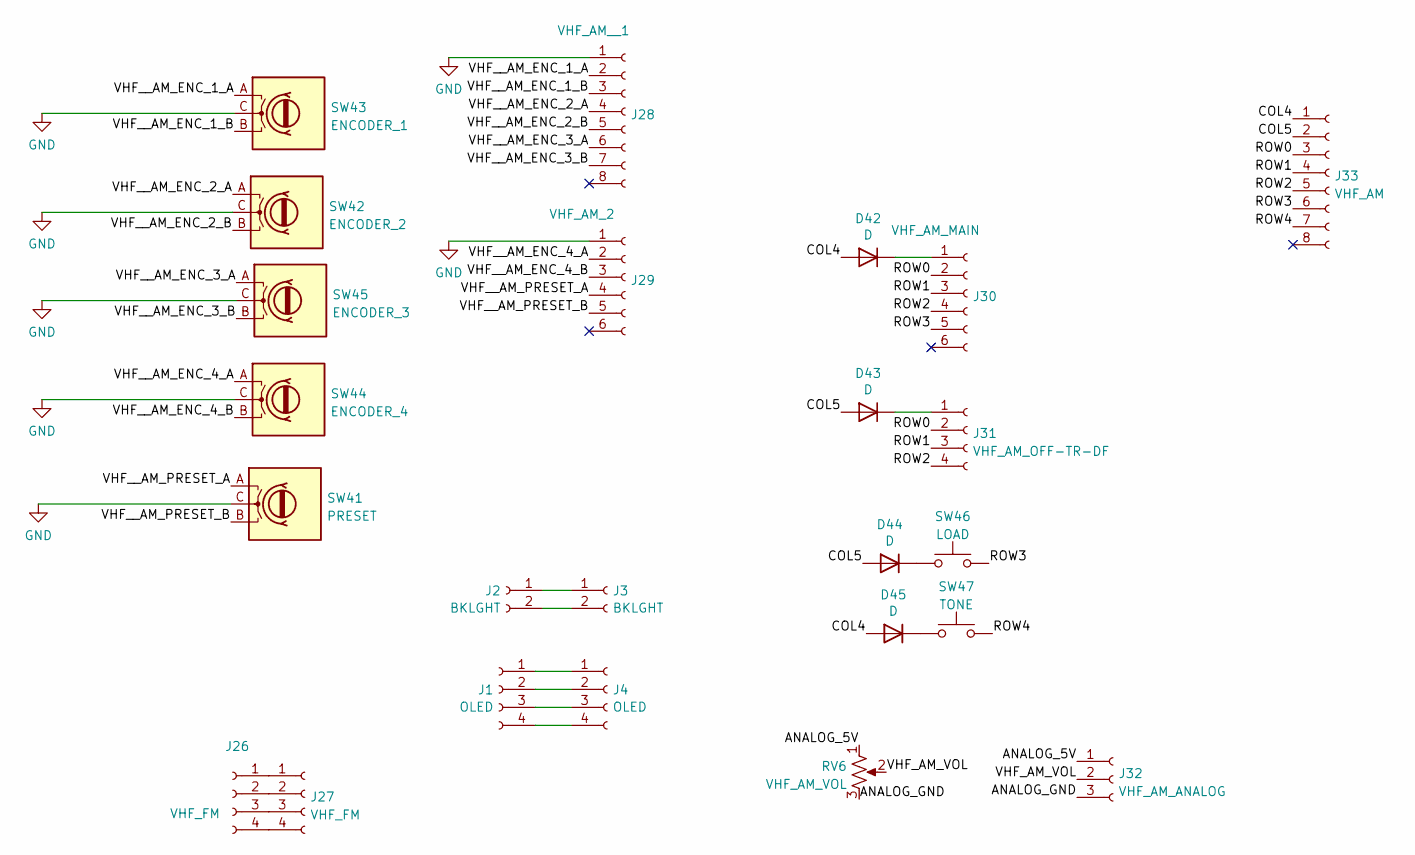
[picture p577: schematic VHF_AM.kicad_sch]

Parts:
D42, D43, D44, D45: D; D_A-405_P7.62mm_Horizontal
J1, J4: OLED; Molex_KK-254_AE-6410-04A_1x04_P2.54mm_Vertical
J2, J3: BKLGHT; Molex_KK-254_AE-6410-02A_1x02_P2.54mm_Vertical
J26, J27: VHF_FM
J28: VHF_AM__1
J29: VHF_AM_2; Molex_KK-254_AE-6410-06A_1x06_P2.54mm_Vertical
J30: VHF_AM_MAIN; Molex_KK-254_AE-6410-06A_1x06_P2.54mm_Vertical
J31: VHF_AM_OFF-TR-DF
J32: VHF_AM_ANALOG
J33: VHF_AM
RV6: VHF_AM_VOL
SW41: PRESET; Molex_KK-254_AE-6410-03A_1x03_P2.54mm_Vertical
SW42: ENCODER_2; Molex_KK-254_AE-6410-03A_1x03_P2.54mm_Vertical
SW43: ENCODER_1; Molex_KK-254_AE-6410-03A_1x03_P2.54mm_Vertical
SW44: ENCODER_4; Molex_KK-254_AE-6410-03A_1x03_P2.54mm_Vertical
SW45: ENCODER_3; Molex_KK-254_AE-6410-03A_1x03_P2.54mm_Vertical
SW46: LOAD; Molex_KK-254_AE-6410-02A_1x02_P2.54mm_Vertical
SW47: TONE; Molex_KK-254_AE-6410-02A_1x02_P2.54mm_Vertical

Connections:
ANALOG_5V: J32.1, RV6.1
ANALOG_GND: J32.3, RV6.3
COL4: D42.2 (A), D45.2 (A), J33.1
COL5: D43.2 (A), D44.2 (A), J33.2
GND: J28.1, J29.1, SW41.C, SW42.C, SW43.C, SW44.C, SW45.C
unnamed: D42.1 (K), J30.1
unnamed: D43.1 (K), J31.1
unnamed: D44.1 (K), SW46.1
unnamed: D45.1 (K), SW47.1
unnamed: J1.1, J4.1
unnamed: J1.2, J4.2
unnamed: J1.3, J4.3
unnamed: J1.4, J4.4
unnamed: J2.1, J3.1
unnamed: J2.2, J3.2
unnamed: J26.1, J27.1
unnamed: J26.2, J27.2
unnamed: J26.3, J27.3
unnamed: J26.4, J27.4
ROW0: J30.2, J31.2, J33.3
ROW1: J30.3, J31.3, J33.4
ROW2: J30.4, J31.4, J33.5
ROW3: J30.5, J33.6, SW46.2
ROW4: J33.7, SW47.2
VHF_AM_VOL: J32.2, RV6.2
VHF__AM_ENC_1_A: J28.2, SW43.A
VHF__AM_ENC_1_B: J28.3, SW43.B
VHF__AM_ENC_2_A: J28.4, SW42.A
VHF__AM_ENC_2_B: J28.5, SW42.B
VHF__AM_ENC_3_A: J28.6, SW45.A
VHF__AM_ENC_3_B: J28.7, SW45.B
VHF__AM_ENC_4_A: J29.2, SW44.A
VHF__AM_ENC_4_B: J29.3, SW44.B
VHF__AM_PRESET_A: J29.4, SW41.A
VHF__AM_PRESET_B: J29.5, SW41.B
