bnepethomas/bne-arduino-flight-simulator-interfaces/A10/A10 PCBs/Left Console Overview/VHF_FM.kicad_sch

## KiCad design A10/A10 PCBs/Left Console Overview/VHF_FM.kicad_sch (2025-11-29)

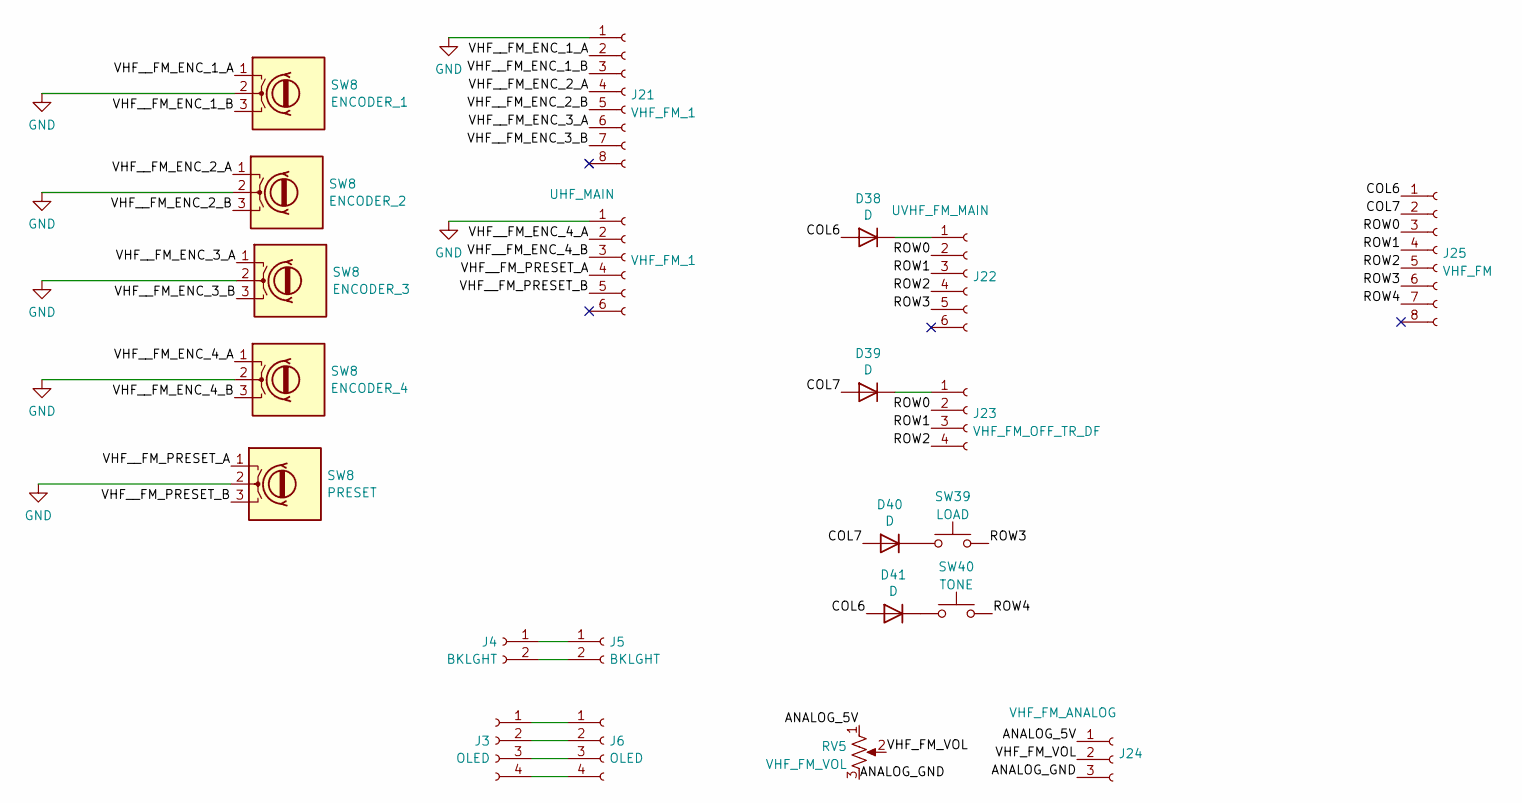
[picture p578: schematic VHF_FM.kicad_sch]

Parts:
D38, D39, D40, D41: D; D_A-405_P7.62mm_Horizontal
J3, J6: OLED; Molex_KK-254_AE-6410-04A_1x04_P2.54mm_Vertical
J4, J5: BKLGHT; Molex_KK-254_AE-6410-02A_1x02_P2.54mm_Vertical
J21: VHF_FM_1
J22: UVHF_FM_MAIN; Molex_KK-254_AE-6410-06A_1x06_P2.54mm_Vertical
J23: VHF_FM_OFF_TR_DF
J24: VHF_FM_ANALOG
J25: VHF_FM
RV5: VHF_FM_VOL
SW8: ENCODER_4; Molex_KK-254_AE-6410-03A_1x03_P2.54mm_Vertical
SW39: LOAD; Molex_KK-254_AE-6410-02A_1x02_P2.54mm_Vertical
SW40: TONE; Molex_KK-254_AE-6410-02A_1x02_P2.54mm_Vertical
VHF_FM_1: UHF_MAIN; Molex_KK-254_AE-6410-06A_1x06_P2.54mm_Vertical

Connections:
ANALOG_5V: J24.1, RV5.1
ANALOG_GND: J24.3, RV5.3
COL6: D38.2 (A), D41.2 (A), J25.1
COL7: D39.2 (A), D40.2 (A), J25.2
GND: J21.1, SW8.2, VHF_FM_1.1
unnamed: D38.1 (K), J22.1
unnamed: D39.1 (K), J23.1
unnamed: D40.1 (K), SW39.1
unnamed: D41.1 (K), SW40.1
unnamed: J3.1, J6.1
unnamed: J3.2, J6.2
unnamed: J3.3, J6.3
unnamed: J3.4, J6.4
unnamed: J4.1, J5.1
unnamed: J4.2, J5.2
ROW0: J22.2, J23.2, J25.3
ROW1: J22.3, J23.3, J25.4
ROW2: J22.4, J23.4, J25.5
ROW3: J22.5, J25.6, SW39.2
ROW4: J25.7, SW40.2
VHF_FM_VOL: J24.2, RV5.2
VHF__FM_ENC_1_A: J21.2, SW8.1
VHF__FM_ENC_1_B: J21.3, SW8.3
VHF__FM_ENC_2_A: J21.4, SW8.1
VHF__FM_ENC_2_B: J21.5, SW8.3
VHF__FM_ENC_3_A: J21.6, SW8.1
VHF__FM_ENC_3_B: J21.7, SW8.3
VHF__FM_ENC_4_A: SW8.1, VHF_FM_1.2
VHF__FM_ENC_4_B: SW8.3, VHF_FM_1.3
VHF__FM_PRESET_A: SW8.1, VHF_FM_1.4
VHF__FM_PRESET_B: SW8.3, VHF_FM_1.5
