bnepethomas/bne-arduino-flight-simulator-interfaces/A10/A10 PCBs/Right Console Input/Right Console Input.kicad_sch

## KiCad design A10/A10 PCBs/Right Console Input/Right Console Input.kicad_sch (2025-11-29)

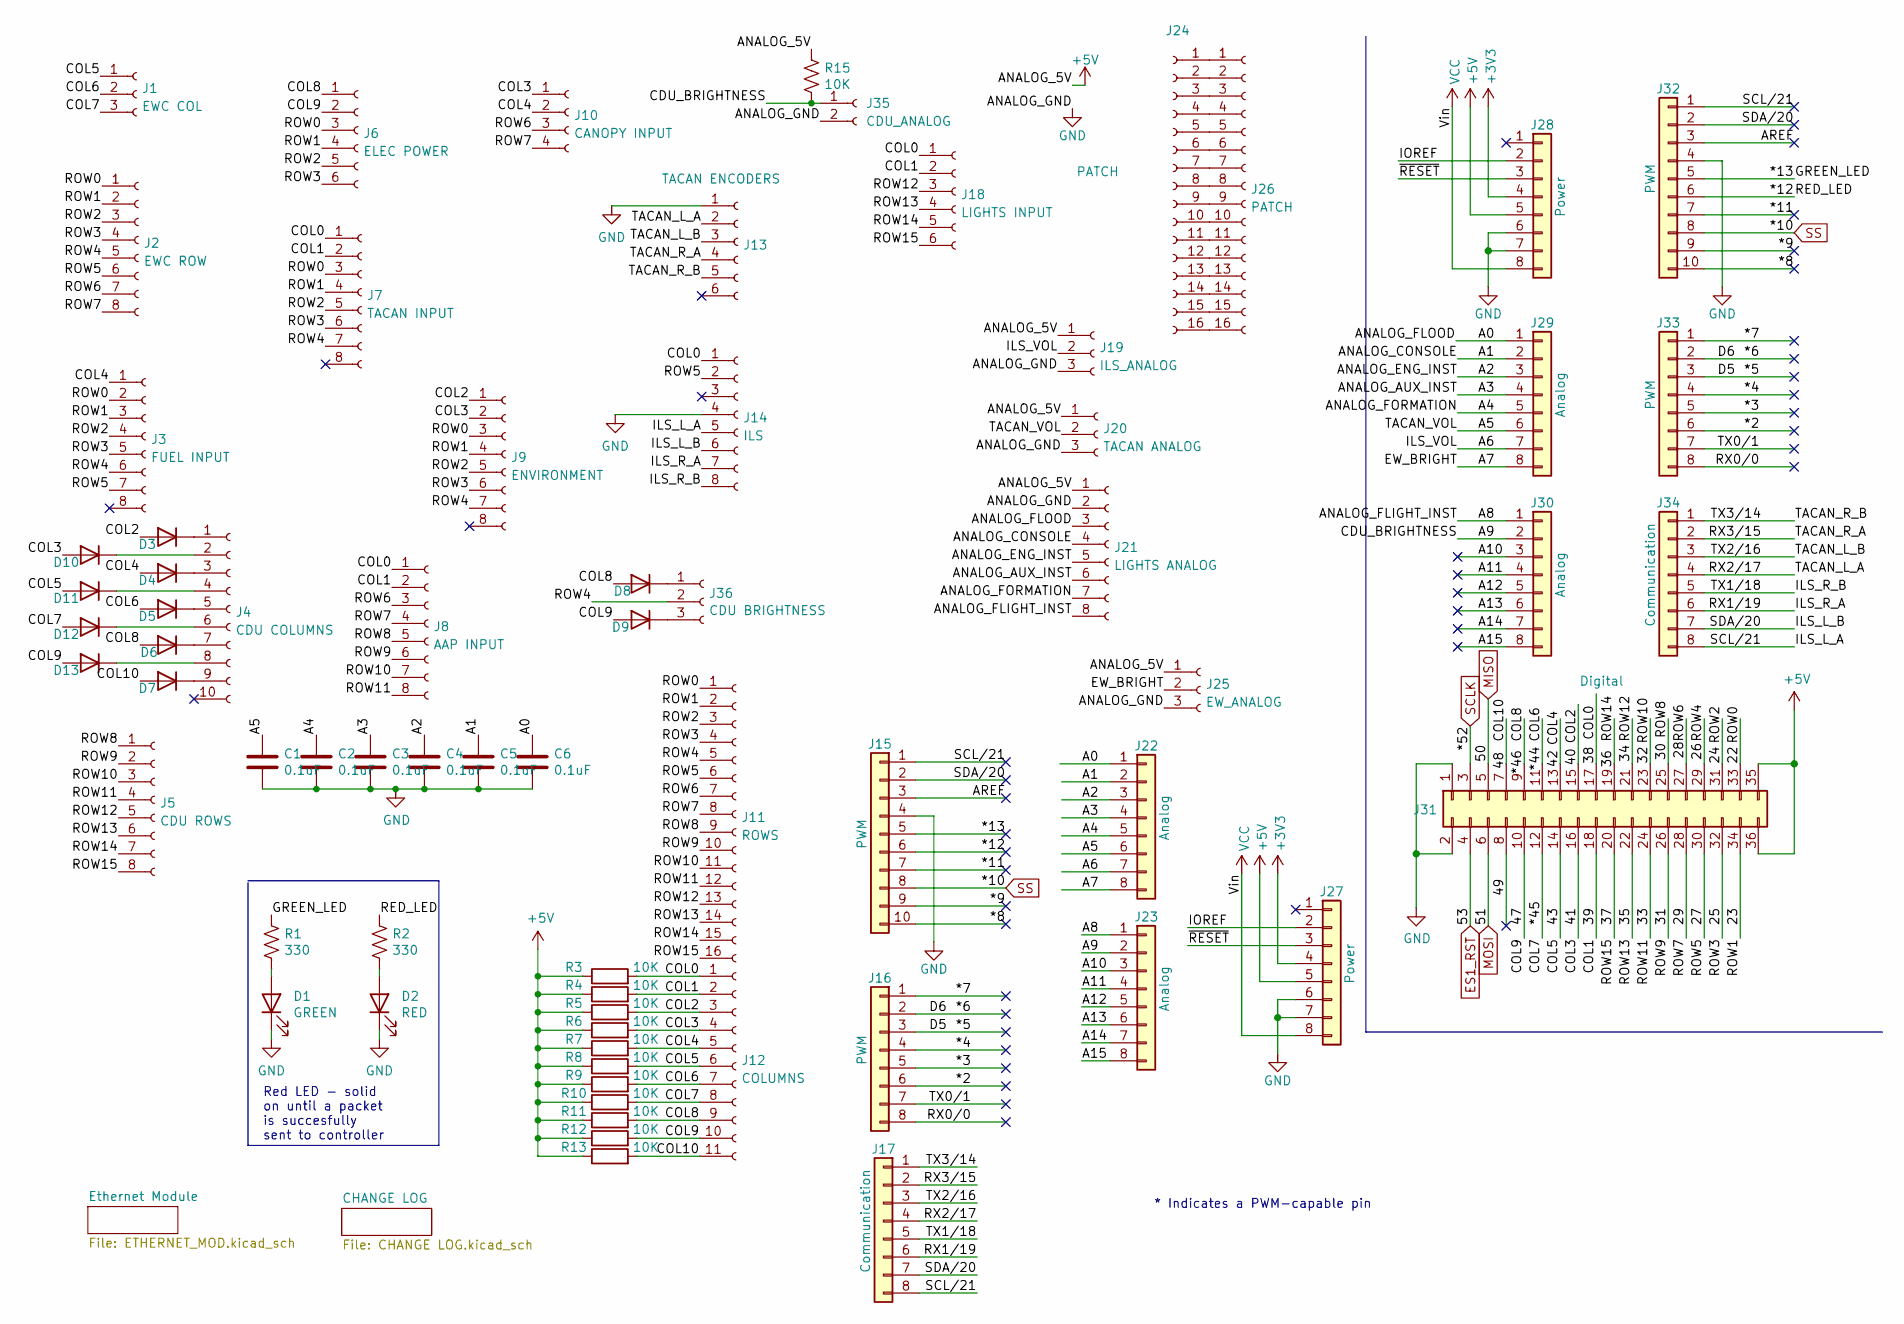
[picture p579: schematic Right Console Input.kicad_sch]

Parts:
C1, C2, C3, C4, C5, C6: 0.1uF; C_Disc_D6.0mm_W2.5mm_P5.00mm
D1: GREEN; LED_D3.0mm
D2: RED; LED_D3.0mm
D3, D4, D5, D6, D7, D8, D9, D10, D11, D12, D13: D; D_A-405_P2.54mm_Vertical_AnodeUp
J1: EWC COL; Molex_KK-254_AE-6410-03A_1x03_P2.54mm_Vertical
J2: EWC ROW; Molex_KK-254_AE-6410-08A_1x08_P2.54mm_Vertical
J3: FUEL INPUT; Molex_KK-254_AE-6410-08A_1x08_P2.54mm_Vertical
J4: CDU COLUMNS; Molex_KK-254_AE-6410-10A_1x10_P2.54mm_Vertical
J5: CDU ROWS; Molex_KK-254_AE-6410-08A_1x08_P2.54mm_Vertical
J6: ELEC POWER; Molex_KK-254_AE-6410-06A_1x06_P2.54mm_Vertical
J7: TACAN INPUT; Molex_KK-254_AE-6410-08A_1x08_P2.54mm_Vertical
J8: AAP INPUT; Molex_KK-254_AE-6410-08A_1x08_P2.54mm_Vertical
J9: ENVIRONMENT; Molex_KK-254_AE-6410-08A_1x08_P2.54mm_Vertical
J10: CANOPY INPUT; Molex_KK-254_AE-6410-04A_1x04_P2.54mm_Vertical
J11: ROWS; PinHeader_1x16_P2.54mm_Vertical
J12: COLUMNS; PinHeader_1x11_P2.54mm_Vertical
J13: TACAN ENCODERS; Molex_KK-254_AE-6410-06A_1x06_P2.54mm_Vertical
J14: ILS; Molex_KK-254_AE-6410-08A_1x08_P2.54mm_Vertical
J15, J32: PWM; PinSocket_1x10_P2.54mm_Vertical
J16, J33: PWM; PinSocket_1x08_P2.54mm_Vertical
J17, J34: Communication; PinSocket_1x08_P2.54mm_Vertical
J18: LIGHTS INPUT; Molex_KK-254_AE-6410-06A_1x06_P2.54mm_Vertical
J19: ILS_ANALOG; Molex_KK-254_AE-6410-03A_1x03_P2.54mm_Vertical
J20: TACAN ANALOG; Molex_KK-254_AE-6410-03A_1x03_P2.54mm_Vertical
J21: LIGHTS ANALOG; Molex_KK-254_AE-6410-08A_1x08_P2.54mm_Vertical
J22, J23, J29, J30: Analog; PinSocket_1x08_P2.54mm_Vertical
J24, J26: PATCH; PinHeader_1x16_P2.54mm_Vertical
J25: EW_ANALOG; Molex_KK-254_AE-6410-03A_1x03_P2.54mm_Vertical
J27, J28: Power; PinSocket_1x08_P2.54mm_Vertical
J31: Digital; PinSocket_2x18_P2.54mm_Vertical
J35: CDU_ANALOG; Molex_KK-254_AE-6410-02A_1x02_P2.54mm_Vertical
J36: CDU BRIGHTNESS; Molex_KK-254_AE-6410-03A_1x03_P2.54mm_Vertical
R1, R2: 330; R_Axial_DIN0204_L3.6mm_D1.6mm_P2.54mm_Vertical
R3, R4, R5, R6, R7, R8, R9, R10, R11, R12, R13, R15: 10K; R_Axial_DIN0204_L3.6mm_D1.6mm_P2.54mm_Vertical

Connections:
2: J16.6, J33.6
3: J16.5, J33.5
4: J16.4, J33.4
5: J16.3, J33.3
6: J16.2, J33.2
7: J16.1, J33.1
8: J15.10, J32.10
9: J15.9, J32.9
10: J15.8, J32.8
11: J15.7, J32.7
12: J15.6, J32.6, R2.1
13: J15.5, J32.5, R1.1
22: J2.1, J3.2, J6.3, J7.3, J9.3, J11.1, J31.33
23: J2.2, J3.3, J6.4, J7.4, J9.4, J11.2, J31.34
24: J2.3, J3.4, J6.5, J7.5, J9.5, J11.3, J31.31
25: J2.4, J3.5, J6.6, J7.6, J9.6, J11.4, J31.32
26: J2.5, J3.6, J7.7, J9.7, J11.5, J31.29, J36.2
27: J2.6, J3.7, J11.6, J14.2, J31.30
28: J2.7, J8.3, J10.3, J11.7, J31.27
29: J2.8, J8.4, J10.4, J11.8, J31.28
30: J5.1, J8.5, J11.9, J31.25
31: J5.2, J8.6, J11.10, J31.26
32: J5.3, J8.7, J11.11, J31.23
33: J5.4, J8.8, J11.12, J31.24
34: J5.5, J11.13, J18.3, J31.21
35: J5.6, J11.14, J18.4, J31.22
36: J5.7, J11.15, J18.5, J31.19
37: J5.8, J11.16, J18.6, J31.20
38: J7.1, J8.1, J12.1, J14.1, J18.1, J31.17, R3.2
39: J7.2, J8.2, J12.2, J18.2, J31.18, R4.2
40: D3.2 (A), J9.1, J12.3, J31.15, R5.2
41: D10.2 (A), J9.2, J10.1, J12.4, J31.16, R6.2
42: D4.2 (A), J3.1, J10.2, J12.5, J31.13, R7.2
43: D11.2 (A), J1.1, J12.6, J31.14, R8.2
44: D5.2 (A), J1.2, J12.7, J31.11, R9.2
45: D12.2 (A), J1.3, J12.8, J31.12, R10.2
46: D6.2 (A), D8.2 (A), J6.1, J12.9, J31.9, R11.2
47: D9.2 (A), D13.2 (A), J6.2, J12.10, J31.10, R12.2
48: D7.2 (A), J12.11, J31.7, R13.2
49: J31.8
52: J31.3
+3V3: J27.4, J28.4
+5V: J19.1, J20.1, J21.1, J25.1, J27.5, J28.5, J31.35, J31.36, R3.1, R4.1, R5.1, R6.1, R7.1, R8.1, R9.1, R10.1, R11.1, R12.1, R13.1, R15.1
A0: C6.1, J21.3, J22.1, J29.1
A1: C5.1, J21.4, J22.2, J29.2
A2: C4.1, J21.5, J22.3, J29.3
A3: C3.1, J21.6, J22.4, J29.4
A4: C2.1, J21.7, J22.5, J29.5
A5: C1.1, J20.2, J22.6, J29.6
A6: J19.2, J22.7, J29.7
A7: J22.8, J25.2, J29.8
A8: J21.8, J23.1, J30.1
A9: J23.2, J30.2, J35.1, R15.2
A10: J23.3, J30.3
A11: J23.4, J30.4
A12: J23.5, J30.5
A13: J23.6, J30.6
A14: J23.7, J30.7
A15: J23.8, J30.8
AREF: J15.3, J32.3
ES1_RST: J31.4
GND: C1.2, C2.2, C3.2, C4.2, C5.2, C6.2, D1.1 (K), D2.1 (K), J13.1, J14.4, J15.4, J19.3, J20.3, J21.2, J25.3, J27.6, J27.7, J28.6, J28.7, J31.1, J31.2, J32.4, J35.2
ILS_L_A: J14.5, J15.1, J17.8, J32.1, J34.8
ILS_L_B: J14.6, J15.2, J17.7, J32.2, J34.7
ILS_R_A: J14.7, J17.6, J34.6
ILS_R_B: J14.8, J17.5, J34.5
IOREF: J27.2, J28.2
MISO: J31.5
MOSI: J31.6
unnamed: D1.2 (A), R1.2
unnamed: D2.2 (A), R2.2
unnamed: D3.1 (K), J4.1
unnamed: D4.1 (K), J4.3
unnamed: D5.1 (K), J4.5
unnamed: D6.1 (K), J4.7
unnamed: D7.1 (K), J4.9
unnamed: D8.1 (K), J36.1
unnamed: D9.1 (K), J36.3
unnamed: D10.1 (K), J4.2
unnamed: D11.1 (K), J4.4
unnamed: D12.1 (K), J4.6
unnamed: D13.1 (K), J4.8
unnamed: J24.1, J26.1
unnamed: J24.2, J26.2
unnamed: J24.3, J26.3
unnamed: J24.4, J26.4
unnamed: J24.5, J26.5
unnamed: J24.6, J26.6
unnamed: J24.7, J26.7
unnamed: J24.8, J26.8
unnamed: J24.9, J26.9
unnamed: J24.10, J26.10
unnamed: J24.11, J26.11
unnamed: J24.12, J26.12
unnamed: J24.13, J26.13
unnamed: J24.14, J26.14
unnamed: J24.15, J26.15
unnamed: J24.16, J26.16
RX0/0: J16.8, J33.8
RX2/17: J13.2, J17.4, J34.4
RX3/15: J13.4, J17.2, J34.2
TACAN_L_B: J13.3, J17.3, J34.3
TACAN_R_B: J13.5, J17.1, J34.1
TX0/1: J16.7, J33.7
VCC: J27.8, J28.8
~RESET: J27.3, J28.3

Notes on the sheet:
Red LED - solid on until a packet is succesfully sent to controller
* Indicates a PWM-capable pin
