bnepethomas/bne-arduino-flight-simulator-interfaces/A10/A10 PCBs/Right Console Output/Right Console Output.kicad_sch

## KiCad design A10/A10 PCBs/Right Console Output/Right Console Output.kicad_sch (2025-11-29)

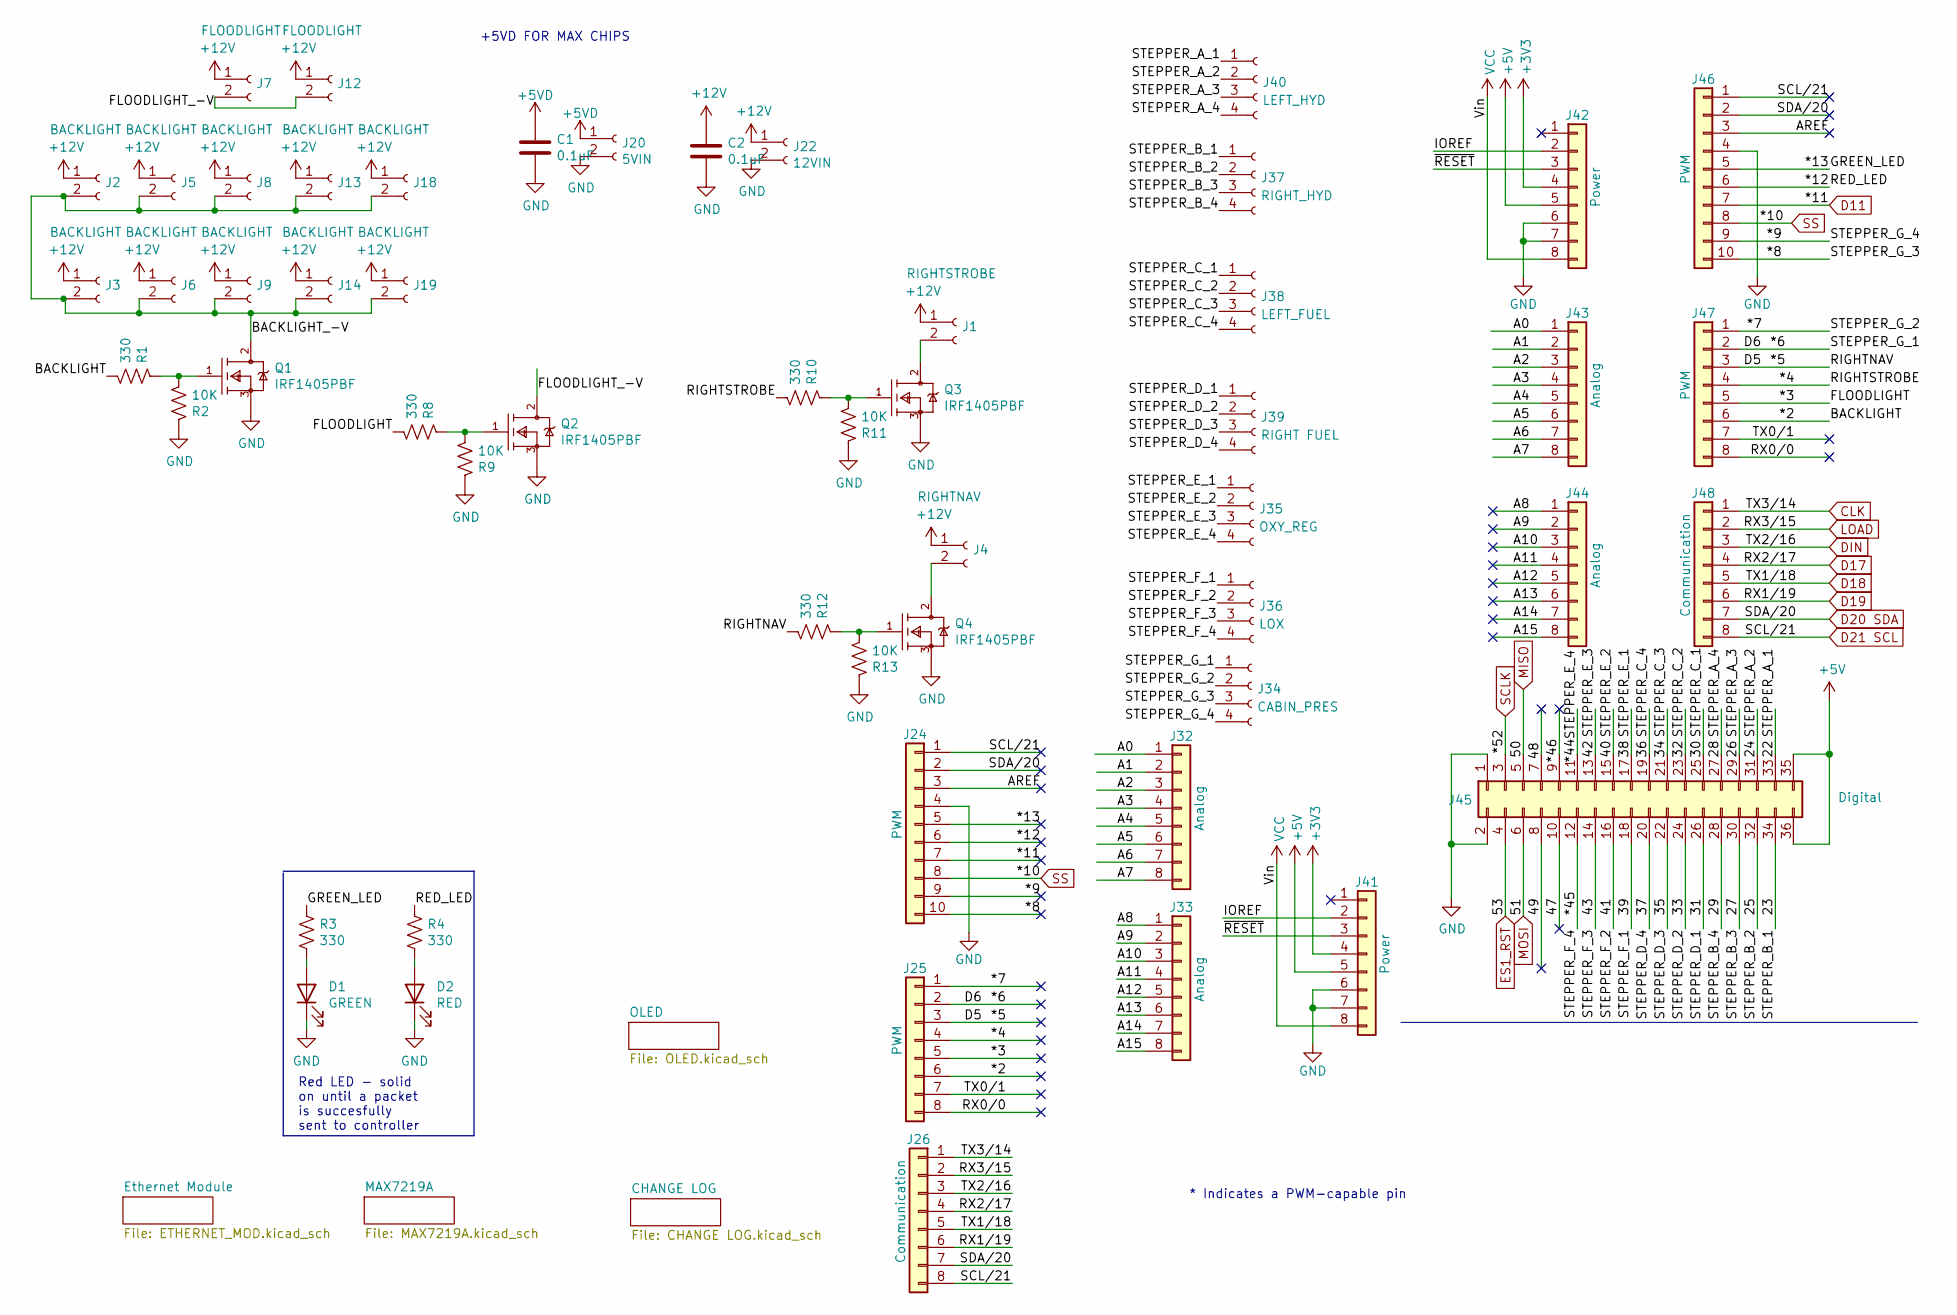
[picture p581: schematic Right Console Output.kicad_sch]

Parts:
C1, C2: 0.1uF; C_Disc_D4.3mm_W1.9mm_P5.00mm
D1: GREEN; LED_D3.0mm
D2: RED; LED_D3.0mm
J1: RIGHTSTROBE; Molex_KK-254_AE-6410-02A_1x02_P2.54mm_Vertical
J2, J3, J5, J6, J8, J9, J13, J14, J18, J19: BACKLIGHT; Molex_KK-254_AE-6410-02A_1x02_P2.54mm_Vertical
J4: RIGHTNAV; Molex_KK-254_AE-6410-02A_1x02_P2.54mm_Vertical
J7, J12: FLOODLIGHT; Molex_KK-254_AE-6410-02A_1x02_P2.54mm_Vertical
J20: 5VIN; BarrelJack_Horizontal
J22: 12VIN; BarrelJack_Horizontal
J24, J46: PWM; PinSocket_1x10_P2.54mm_Vertical
J25, J47: PWM; PinSocket_1x08_P2.54mm_Vertical
J26, J48: Communication; PinSocket_1x08_P2.54mm_Vertical
J32, J33, J43, J44: Analog; PinSocket_1x08_P2.54mm_Vertical
J34: CABIN_PRES; Molex_KK-254_AE-6410-04A_1x04_P2.54mm_Vertical
J35: OXY_REG; Molex_KK-254_AE-6410-04A_1x04_P2.54mm_Vertical
J36: LOX; Molex_KK-254_AE-6410-04A_1x04_P2.54mm_Vertical
J37: RIGHT_HYD; Molex_KK-254_AE-6410-04A_1x04_P2.54mm_Vertical
J38: LEFT_FUEL; Molex_KK-254_AE-6410-04A_1x04_P2.54mm_Vertical
J39: RIGHT FUEL; Molex_KK-254_AE-6410-04A_1x04_P2.54mm_Vertical
J40: LEFT_HYD; Molex_KK-254_AE-6410-04A_1x04_P2.54mm_Vertical
J41, J42: Power; PinSocket_1x08_P2.54mm_Vertical
J45: Digital; PinSocket_2x18_P2.54mm_Vertical
Q1, Q2, Q3, Q4: IRF1405PBF; TO-220-3_Vertical; mouser part number 942-IRF1405PBF; digikey description MOSFET N-CH 55V 169A TO-220AB
R1, R3, R4, R8, R10, R12: 330; R_Axial_DIN0204_L3.6mm_D1.6mm_P2.54mm_Vertical
R2, R9, R11, R13: 10K; R_Axial_DIN0204_L3.6mm_D1.6mm_P2.54mm_Vertical

Connections:
2: J25.6, J47.6, R1.2
3: J25.5, J47.5, R8.2
4: J25.4, J47.4, R10.2
5: J25.3, J47.3, R12.2
6: J25.2, J34.1, J47.2
7: J25.1, J34.2, J47.1
8: J24.10, J34.3, J46.10
9: J24.9, J34.4, J46.9
10: J24.8, J46.8
11: J24.7, J46.7
12: J24.6, J46.6, R4.1
13: J24.5, J46.5, R3.1
22: J40.1, J45.33
23: J37.1, J45.34
24: J40.2, J45.31
25: J37.2, J45.32
26: J40.3, J45.29
27: J37.3, J45.30
28: J40.4, J45.27
29: J37.4, J45.28
30: J38.1, J45.25
31: J39.1, J45.26
32: J38.2, J45.23
33: J39.2, J45.24
34: J38.3, J45.21
35: J39.3, J45.22
36: J38.4, J45.19
37: J39.4, J45.20
38: J35.1, J45.17
39: J36.1, J45.18
40: J35.2, J45.15
41: J36.2, J45.16
42: J35.3, J45.13
43: J36.3, J45.14
44: J35.4, J45.11
45: J36.4, J45.12
46: J45.9
47: J45.10
48: J45.7
49: J45.8
52: J45.3
+3V3: J41.4, J42.4
+5V: J41.5, J42.5, J45.35, J45.36
+5VD: C1.1, J20.1
+12V: C2.1, J1.1, J2.1, J3.1, J4.1, J5.1, J6.1, J7.1, J8.1, J9.1, J12.1, J13.1, J14.1, J18.1, J19.1, J22.1
A0: J32.1, J43.1
A1: J32.2, J43.2
A2: J32.3, J43.3
A3: J32.4, J43.4
A4: J32.5, J43.5
A5: J32.6, J43.6
A6: J32.7, J43.7
A7: J32.8, J43.8
A8: J33.1, J44.1
A9: J33.2, J44.2
A10: J33.3, J44.3
A11: J33.4, J44.4
A12: J33.5, J44.5
A13: J33.6, J44.6
A14: J33.7, J44.7
A15: J33.8, J44.8
AREF: J24.3, J46.3
BACKLIGHT_-V: J2.2, J3.2, J5.2, J6.2, J8.2, J9.2, J13.2, J14.2, J18.2, J19.2, Q1.2 (D)
CLK: J26.1, J48.1
D17: J26.4, J48.4
D18: J26.5, J48.5
D19: J26.6, J48.6
D20 SDA: J24.2, J26.7, J46.2, J48.7
D21 SCL: J24.1, J26.8, J46.1, J48.8
DIN: J26.3, J48.3
ES1_RST: J45.4
FLOODLIGHT_-V: J7.2, J12.2, Q2.2 (D)
GND: C1.2, C2.2, D1.1 (K), D2.1 (K), J20.2, J22.2, J24.4, J41.6, J41.7, J42.6, J42.7, J45.1, J45.2, J46.4, Q1.3 (S), Q2.3 (S), Q3.3 (S), Q4.3 (S), R2.1, R9.1, R11.1, R13.1
IOREF: J41.2, J42.2
LOAD: J26.2, J48.2
MISO: J45.5
MOSI: J45.6
unnamed: D1.2 (A), R3.2
unnamed: D2.2 (A), R4.2
unnamed: J1.2, Q3.2 (D)
unnamed: J4.2, Q4.2 (D)
unnamed: Q1.1 (G), R1.1, R2.2
unnamed: Q2.1 (G), R8.1, R9.2
unnamed: Q3.1 (G), R10.1, R11.2
unnamed: Q4.1 (G), R12.1, R13.2
RX0/0: J25.8, J47.8
TX0/1: J25.7, J47.7
VCC: J41.8, J42.8
~RESET: J41.3, J42.3

Notes on the sheet:
Red LED - solid on until a packet is succesfully sent to controller
+5VD FOR MAX CHIPS
* Indicates a PWM-capable pin
