bnepethomas/bne-arduino-flight-simulator-interfaces/A10/A10 PCBs/Right Console Overview/AAP.kicad_sch

## KiCad design A10/A10 PCBs/Right Console Overview/AAP.kicad_sch (2025-11-29)

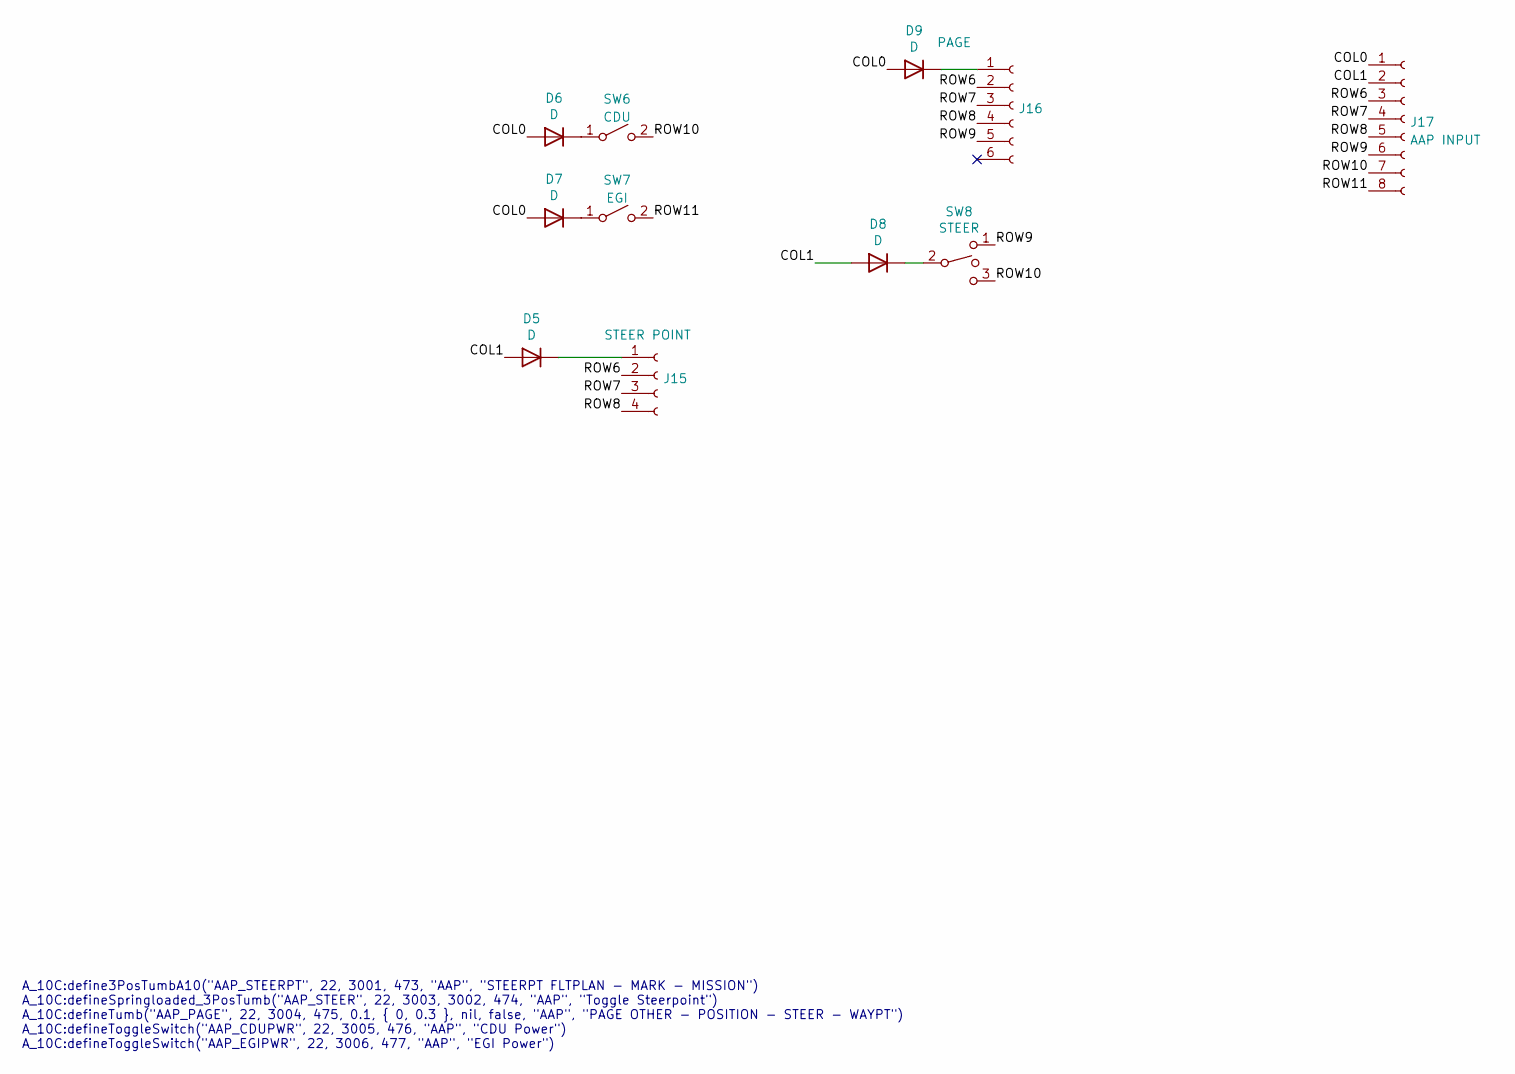
[picture p582: schematic AAP.kicad_sch]

Parts:
D5, D6, D7, D8: D; D_Signal_P7.62mm_Horizontal
D9: D; D_A-405_P7.62mm_Horizontal
J15: STEER POINT
J16: PAGE; Molex_KK-254_AE-6410-06A_1x06_P2.54mm_Vertical
J17: AAP INPUT; Molex_KK-254_AE-6410-08A_1x08_P2.54mm_Vertical
SW6: CDU
SW7: EGI
SW8: STEER; Molex_1x03_P2.54mm_Vertical

Connections:
COL0: D6.2 (A), D7.2 (A), D9.2 (A), J17.1
COL1: D5.2 (A), D8.2 (A), J17.2
unnamed: D5.1 (K), J15.1
unnamed: D6.1 (K), SW6.1 (A)
unnamed: D7.1 (K), SW7.1 (A)
unnamed: D8.1 (K), SW8.2
unnamed: D9.1 (K), J16.1
ROW6: J15.2, J16.2, J17.3
ROW7: J15.3, J16.3, J17.4
ROW8: J15.4, J16.4, J17.5
ROW9: J16.5, J17.6, SW8.1
ROW10: J17.7, SW6.2 (B), SW8.3
ROW11: J17.8, SW7.2 (B)

Notes on the sheet:
A_10C:define3PosTumbA10("AAP_STEERPT", 22, 3001, 473, "AAP", "STEERPT FLTPLAN - MARK - MISSION") A_10C:defineSpringloaded_3PosTumb("AAP_STEER", 22, 3003, 3002, 474, "AAP", "Toggle Steerpoint") A_10C:defineTumb("AAP_PAGE", 22, 3004, 475, 0.1, { 0, 0.3 }, nil, false, "AAP", "PAGE OTHER - POSITION - S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
