bnepethomas/bne-arduino-flight-simulator-interfaces/A10/A10 PCBs/Right Console Overview/CANOPY.kicad_sch

## KiCad design A10/A10 PCBs/Right Console Overview/CANOPY.kicad_sch (2025-11-29)

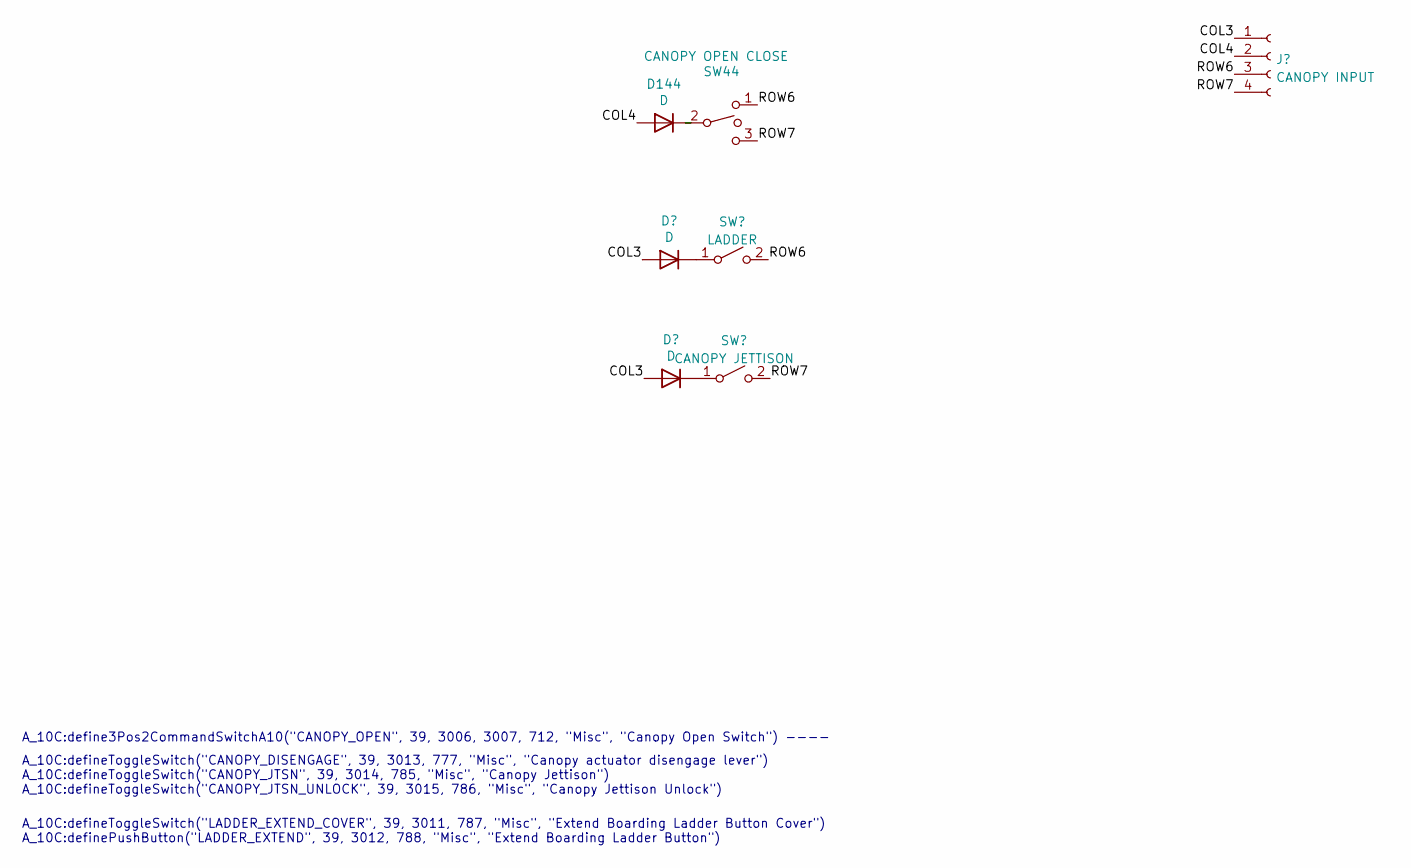
[picture p583: schematic CANOPY.kicad_sch]

Parts:
D144: D; D_Signal_P7.62mm_Horizontal
SW44: CANOPY OPEN CLOSE; Molex_1x03_P2.54mm_Vertical

Connections:
COL4: D144.2 (A)
unnamed: D144.1 (K), SW44.2
ROW6: SW44.1
ROW7: SW44.3

Notes on the sheet:
A_10C:defineToggleSwitch("CANOPY_DISENGAGE", 39, 3013, 777, "Misc", "Canopy actuator disengage lever") A_10C:defineToggleSwitch("CANOPY_JTSN", 39, 3014, 785, "Misc", "Canopy Jettison") A_10C:defineToggleSwitch("CANOPY_JTSN_UNLOCK", 39, 3015, 786, "Misc", "Canopy Jettison Unlock")
A_10C:defineToggleSwitch("LADDER_EXTEND_COVER", 39, 3011, 787, "Misc", "Extend Boarding Ladder Button Cover") A_10C:definePushButton("LADDER_EXTEND", 39, 3012, 788, "Misc", "Extend Boarding Ladder Button")
A_10C:define3Pos2CommandSwitchA10("CANOPY_OPEN", 39, 3006, 3007, 712, "Misc", "Canopy Open Switch") ----
