bnepethomas/bne-arduino-flight-simulator-interfaces/A10/A10 PCBs/Right Console Overview/CDU.kicad_sch

## KiCad design A10/A10 PCBs/Right Console Overview/CDU.kicad_sch (2025-11-29)

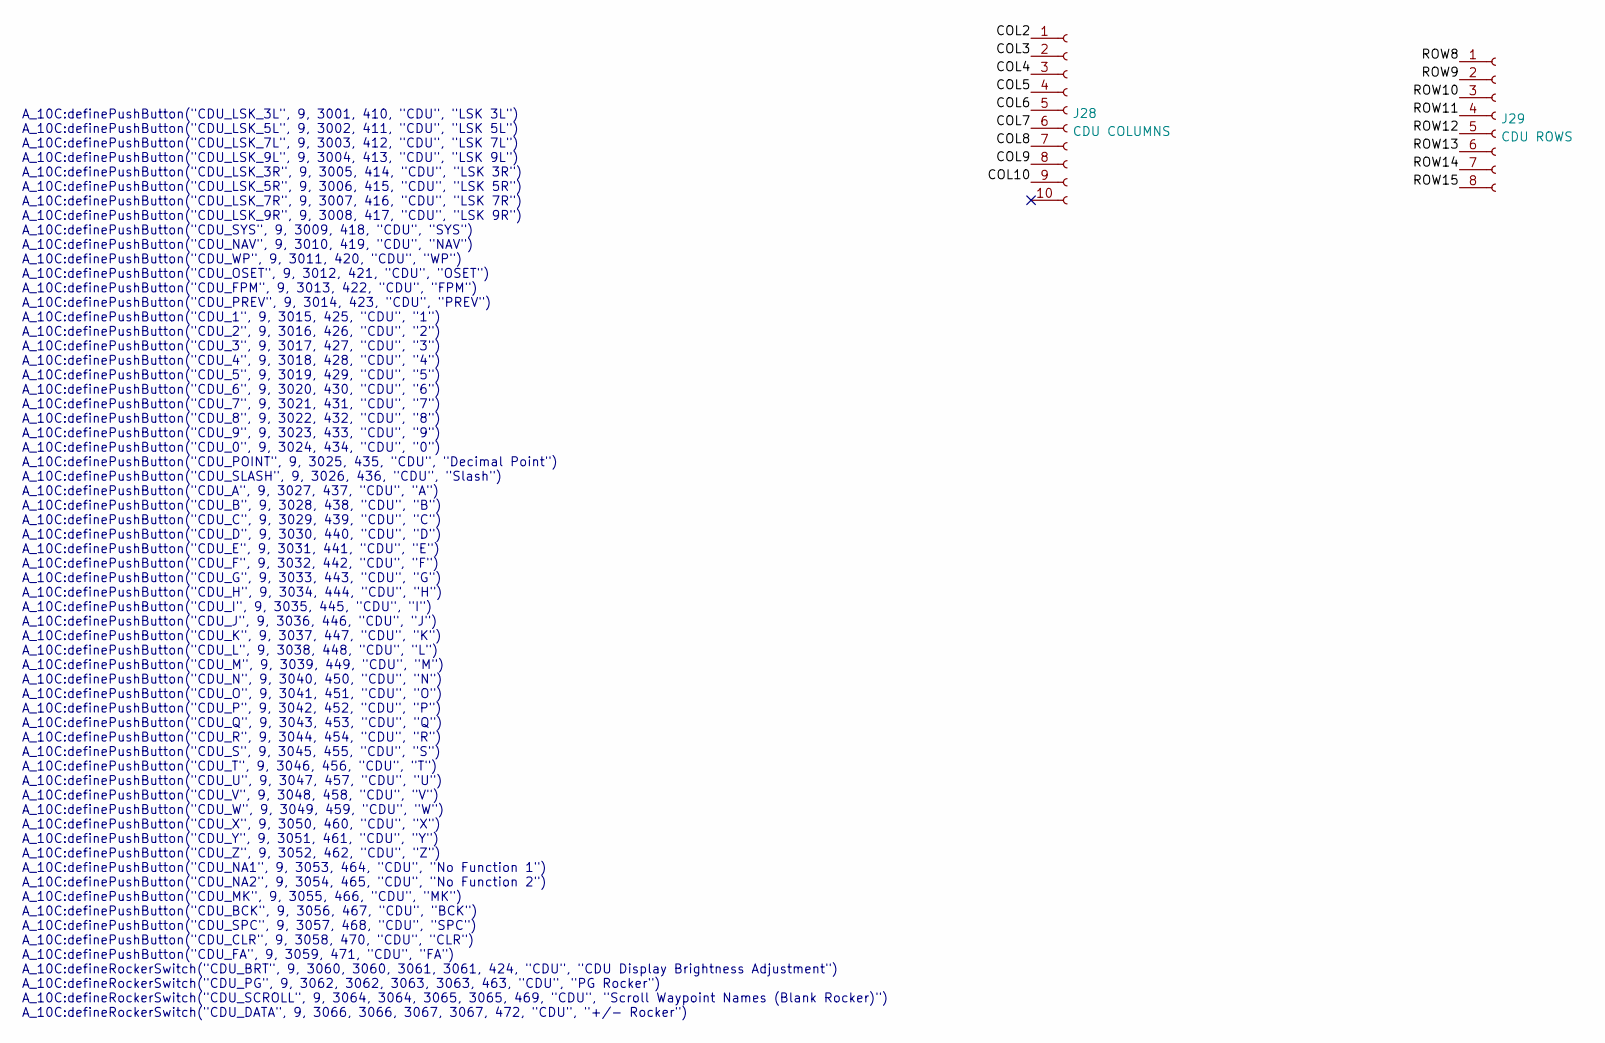
[picture p584: schematic CDU.kicad_sch]

Parts:
J28: CDU COLUMNS
J29: CDU ROWS

Connections:
COL2: J28.1
COL3: J28.2
COL4: J28.3
COL5: J28.4
COL6: J28.5
COL7: J28.6
COL8: J28.7
COL9: J28.8
COL10: J28.9
ROW8: J29.1
ROW9: J29.2
ROW10: J29.3
ROW11: J29.4
ROW12: J29.5
ROW13: J29.6
ROW14: J29.7
ROW15: J29.8

Notes on the sheet:
A_10C:definePushButton("CDU_LSK_3L", 9, 3001, 410, "CDU", "LSK 3L") A_10C:definePushButton("CDU_LSK_5L", 9, 3002, 411, "CDU", "LSK 5L") A_10C:definePushButton("CDU_LSK_7L", 9, 3003, 412, "CDU", "LSK 7L") A_10C:definePushButton("CDU_LSK_9L", 9, 3004, 413, "CDU", "LSK 9L") A_10C:definePushButton("CDU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
