bnepethomas/bne-arduino-flight-simulator-interfaces/A10/A10 PCBs/Right Console Overview/ELECT POWER.kicad_sch

## KiCad design A10/A10 PCBs/Right Console Overview/ELECT POWER.kicad_sch (2025-11-29)

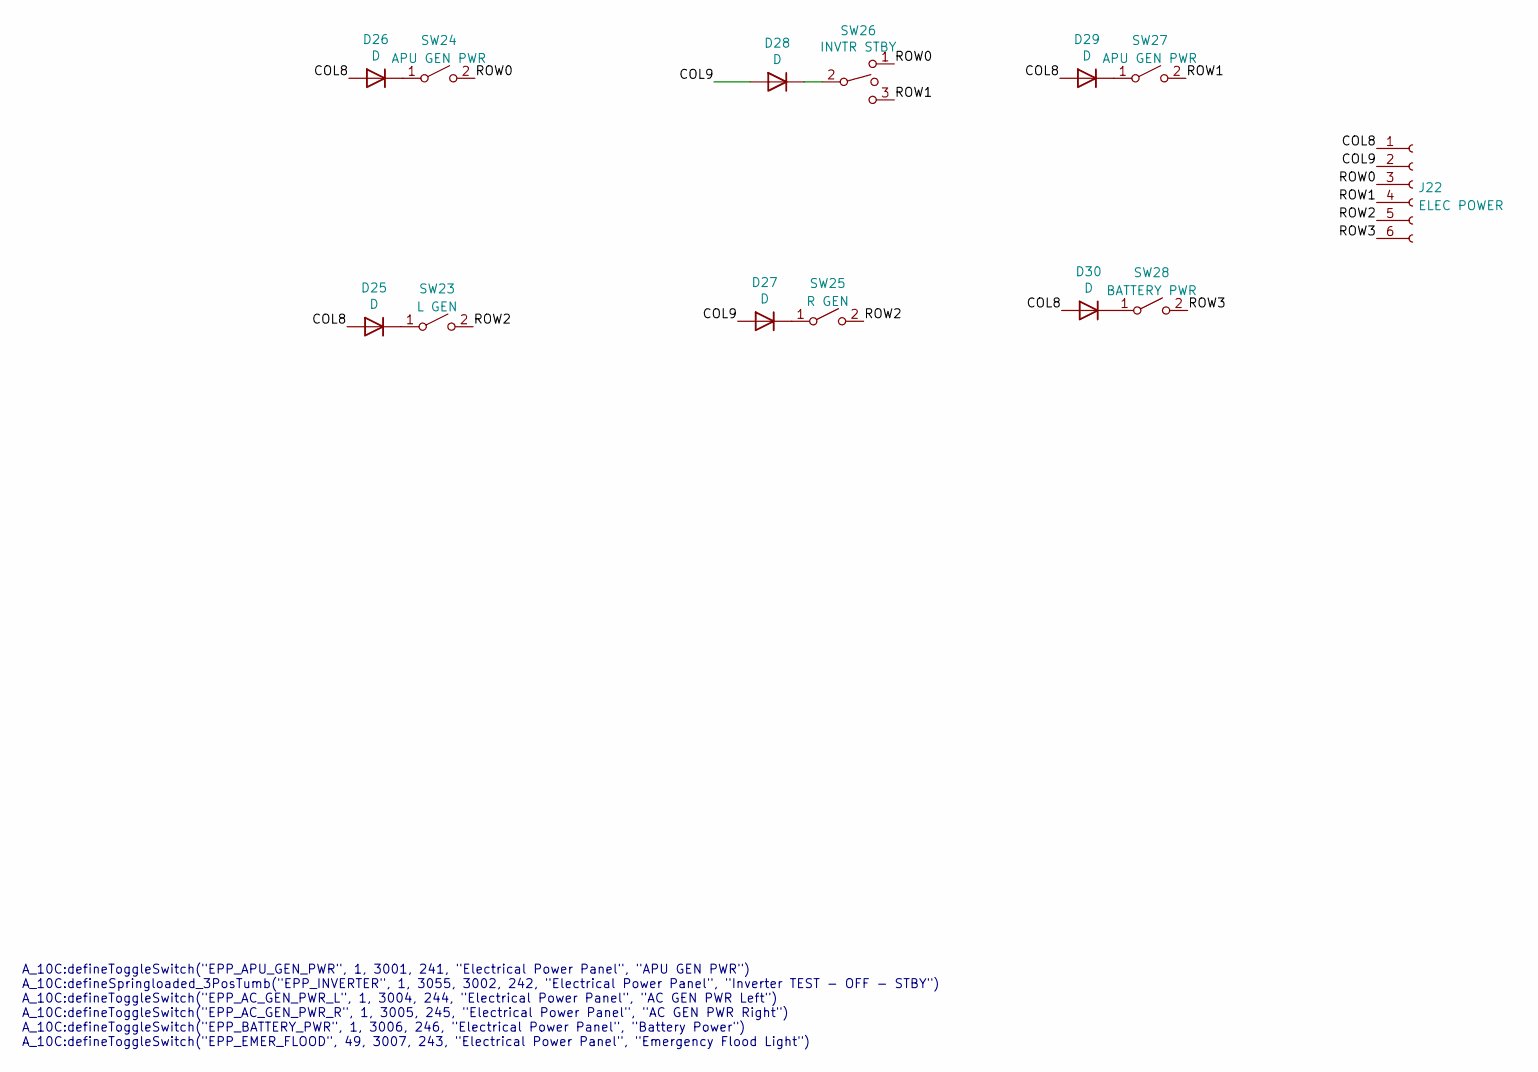
[picture p585: schematic ELECT POWER.kicad_sch]

Parts:
D25, D26, D27, D28, D29, D30: D; D_Signal_P7.62mm_Horizontal
J22: ELEC POWER
SW23: L GEN
SW24, SW27: APU GEN PWR
SW25: R GEN
SW26: INVTR STBY; Molex_1x03_P2.54mm_Vertical
SW28: BATTERY PWR

Connections:
COL8: D25.2 (A), D26.2 (A), D29.2 (A), D30.2 (A), J22.1
COL9: D27.2 (A), D28.2 (A), J22.2
unnamed: D25.1 (K), SW23.1 (A)
unnamed: D26.1 (K), SW24.1 (A)
unnamed: D27.1 (K), SW25.1 (A)
unnamed: D28.1 (K), SW26.2
unnamed: D29.1 (K), SW27.1 (A)
unnamed: D30.1 (K), SW28.1 (A)
ROW0: J22.3, SW24.2 (B), SW26.1
ROW1: J22.4, SW26.3, SW27.2 (B)
ROW2: J22.5, SW23.2 (B), SW25.2 (B)
ROW3: J22.6, SW28.2 (B)

Notes on the sheet:
A_10C:defineToggleSwitch("EPP_APU_GEN_PWR", 1, 3001, 241, "Electrical Power Panel", "APU GEN PWR") A_10C:defineSpringloaded_3PosTumb("EPP_INVERTER", 1, 3055, 3002, 242, "Electrical Power Panel", "Inverter TEST - OFF - STBY") A_10C:defineToggleSwitch("EPP_AC_GEN_PWR_L", 1, 3004, 244, "Electrical Pow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
