bnepethomas/bne-arduino-flight-simulator-interfaces/A10/A10 PCBs/Right Console Overview/ENVIRONMENT.kicad_sch

## KiCad design A10/A10 PCBs/Right Console Overview/ENVIRONMENT.kicad_sch (2025-11-29)

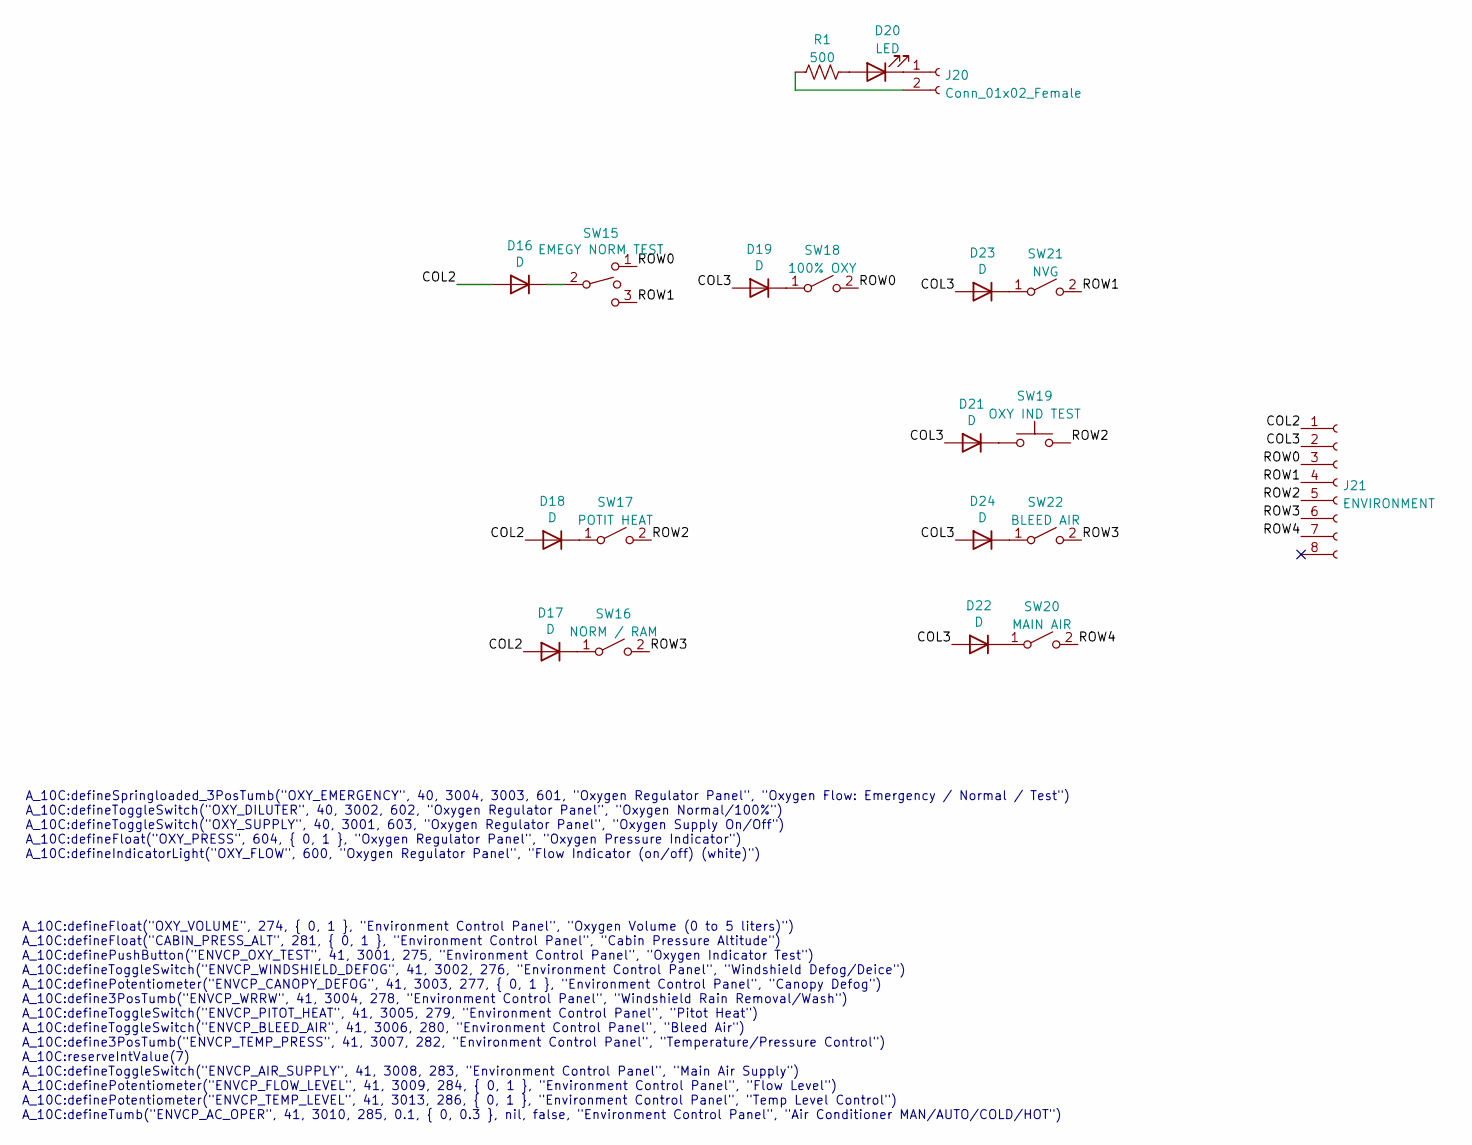
[picture p586: schematic ENVIRONMENT.kicad_sch]

Parts:
D16, D17, D18, D19, D22, D23, D24: D; D_Signal_P7.62mm_Horizontal
D20: LED; Molex_KK-254_AE-6410-02A_1x02_P2.54mm_Vertical
D21: D; D_A-405_P7.62mm_Horizontal
J20: Conn_01x02_Female
J21: ENVIRONMENT
R1: 500
SW15: EMEGY NORM TEST; Molex_1x03_P2.54mm_Vertical
SW16: NORM / RAM
SW17: POTIT HEAT
SW18: 100% OXY
SW19: OXY IND TEST; Molex_KK-254_AE-6410-02A_1x02_P2.54mm_Vertical
SW20: MAIN AIR
SW21: NVG
SW22: BLEED AIR

Connections:
COL2: D16.2 (A), D17.2 (A), D18.2 (A), J21.1
COL3: D19.2 (A), D21.2 (A), D22.2 (A), D23.2 (A), D24.2 (A), J21.2
unnamed: D16.1 (K), SW15.2
unnamed: D17.1 (K), SW16.1 (A)
unnamed: D18.1 (K), SW17.1 (A)
unnamed: D19.1 (K), SW18.1 (A)
unnamed: D20.1 (K), J20.1
unnamed: D20.2 (A), R1.2
unnamed: D21.1 (K), SW19.1
unnamed: D22.1 (K), SW20.1 (A)
unnamed: D23.1 (K), SW21.1 (A)
unnamed: D24.1 (K), SW22.1 (A)
unnamed: J20.2, R1.1
ROW0: J21.3, SW15.1, SW18.2 (B)
ROW1: J21.4, SW15.3, SW21.2 (B)
ROW2: J21.5, SW17.2 (B), SW19.2
ROW3: J21.6, SW16.2 (B), SW22.2 (B)
ROW4: J21.7, SW20.2 (B)

Notes on the sheet:
A_10C:defineFloat("OXY_VOLUME", 274, { 0, 1 }, "Environment Control Panel", "Oxygen Volume (0 to 5 liters)") A_10C:defineFloat("CABIN_PRESS_ALT", 281, { 0, 1 }, "Environment Control Panel", "Cabin Pressure Altitude") A_10C:definePushButton("ENVCP_OXY_TEST", 41, 3001, 275, "Environment Control Panel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
A_10C:defineSpringloaded_3PosTumb("OXY_EMERGENCY", 40, 3004, 3003, 601, "Oxygen Regulator Panel", "Oxygen Flow: Emergency / Normal / Test") A_10C:defineToggleSwitch("OXY_DILUTER", 40, 3002, 602, "Oxygen Regulator Panel", "Oxygen Normal/100%") A_10C:defineToggleSwitch("OXY_SUPPLY", 40, 3001, 603, "O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
