bnepethomas/bne-arduino-flight-simulator-interfaces/A10/A10 PCBs/Right Console Overview/EW.kicad_sch

## KiCad design A10/A10 PCBs/Right Console Overview/EW.kicad_sch (2025-11-29)

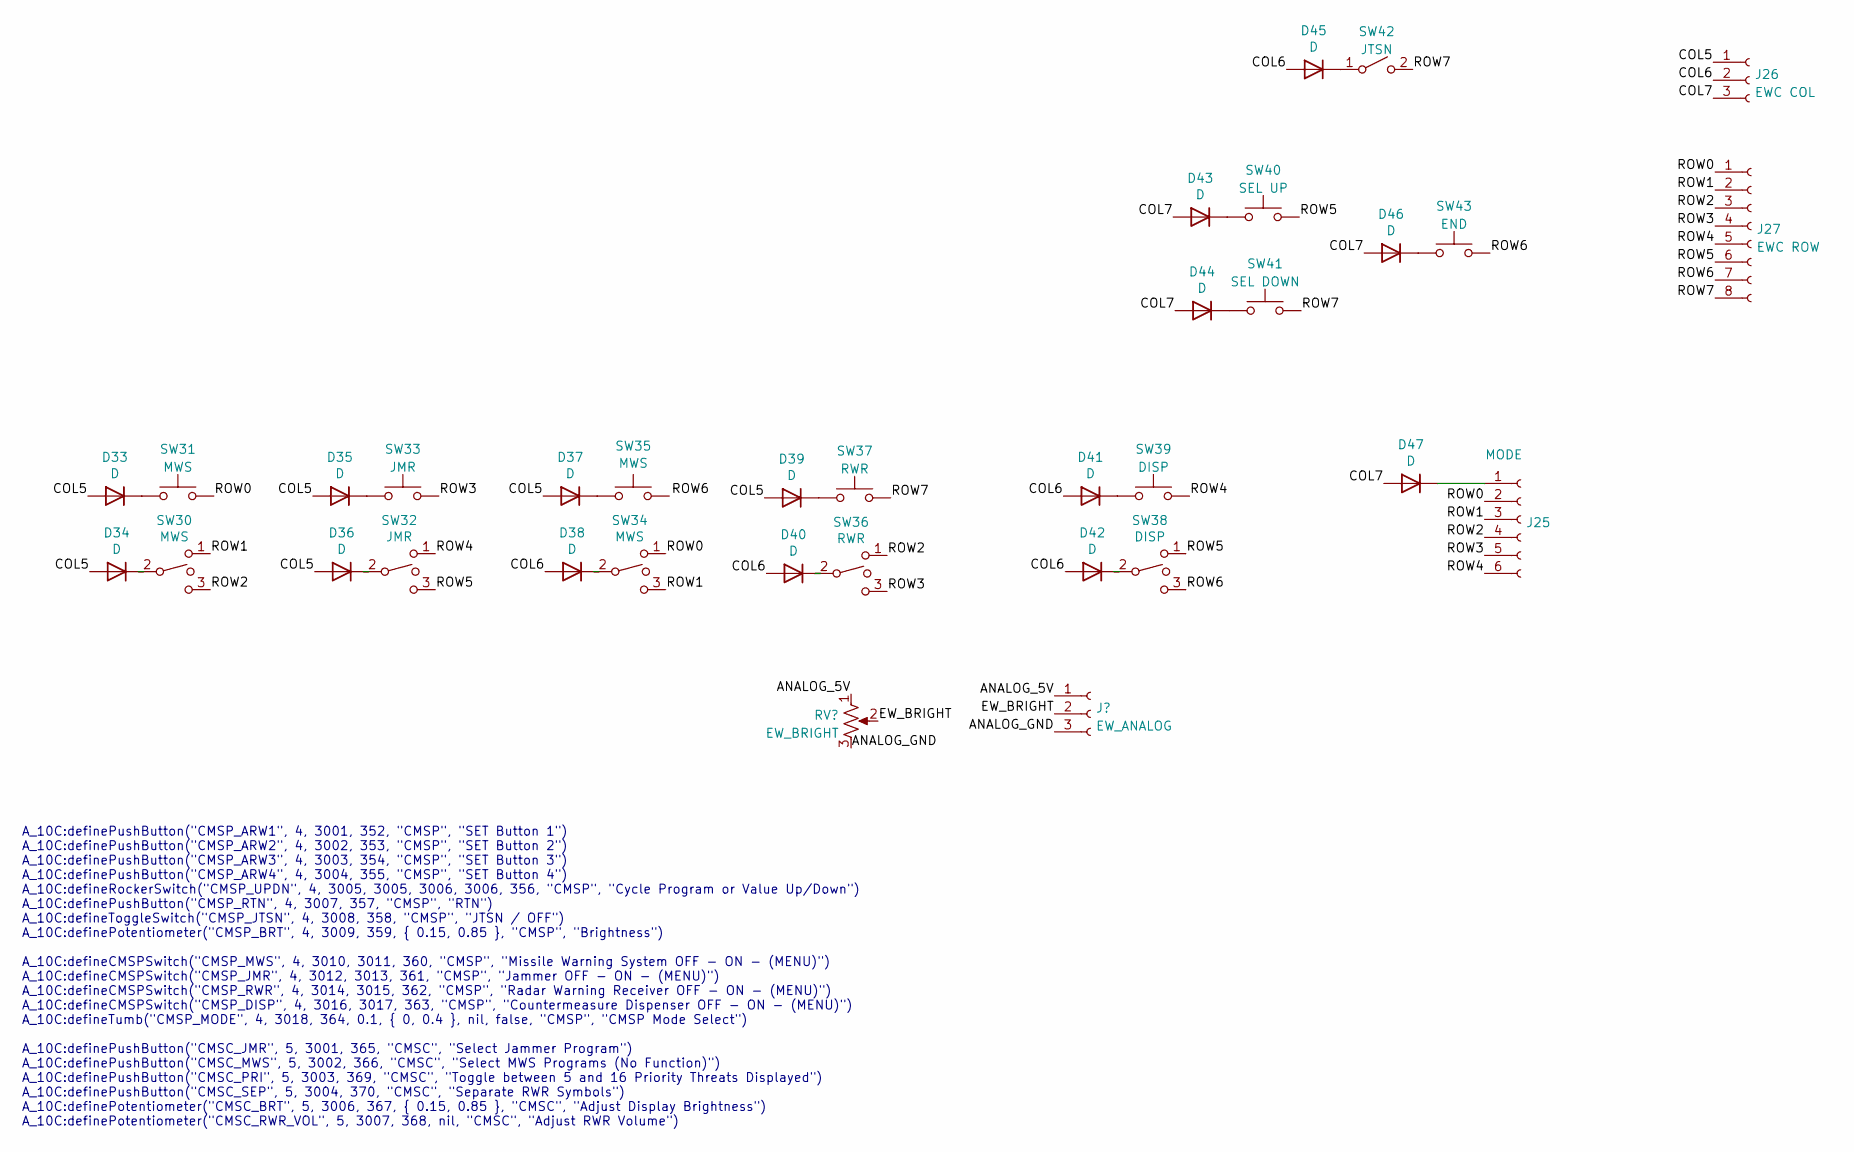
[picture p587: schematic EW.kicad_sch]

Parts:
D33, D34, D35, D36, D37, D38, D39, D40, D41, D42, D43, D44, D45, D46: D; D_Signal_P7.62mm_Horizontal
D47: D; D_A-405_P7.62mm_Horizontal
J25: MODE; Molex_KK-254_AE-6410-06A_1x06_P2.54mm_Vertical
J26: EWC COL
J27: EWC ROW
SW30, SW34: MWS; Molex_1x03_P2.54mm_Vertical
SW31, SW35: MWS
SW32: JMR; Molex_1x03_P2.54mm_Vertical
SW33: JMR
SW36: RWR; Molex_1x03_P2.54mm_Vertical
SW37: RWR
SW38: DISP; Molex_1x03_P2.54mm_Vertical
SW39: DISP
SW40: SEL UP
SW41: SEL DOWN
SW42: JTSN
SW43: END

Connections:
COL5: D33.2 (A), D34.2 (A), D35.2 (A), D36.2 (A), D37.2 (A), D39.2 (A), J26.1
COL6: D38.2 (A), D40.2 (A), D41.2 (A), D42.2 (A), D45.2 (A), J26.2
COL7: D43.2 (A), D44.2 (A), D46.2 (A), D47.2 (A), J26.3
unnamed: D33.1 (K), SW31.1
unnamed: D34.1 (K), SW30.2
unnamed: D35.1 (K), SW33.1
unnamed: D36.1 (K), SW32.2
unnamed: D37.1 (K), SW35.1
unnamed: D38.1 (K), SW34.2
unnamed: D39.1 (K), SW37.1
unnamed: D40.1 (K), SW36.2
unnamed: D41.1 (K), SW39.1
unnamed: D42.1 (K), SW38.2
unnamed: D43.1 (K), SW40.1
unnamed: D44.1 (K), SW41.1
unnamed: D45.1 (K), SW42.1 (A)
unnamed: D46.1 (K), SW43.1
unnamed: D47.1 (K), J25.1
ROW0: J25.2, J27.1, SW31.2, SW34.1
ROW1: J25.3, J27.2, SW30.1, SW34.3
ROW2: J25.4, J27.3, SW30.3, SW36.1
ROW3: J25.5, J27.4, SW33.2, SW36.3
ROW4: J25.6, J27.5, SW32.1, SW39.2
ROW5: J27.6, SW32.3, SW38.1, SW40.2
ROW6: J27.7, SW38.3, SW43.2
ROW7: J27.8, SW37.2, SW41.2, SW42.2 (B)

Notes on the sheet:
A_10C:definePushButton("CMSP_ARW1", 4, 3001, 352, "CMSP", "SET Button 1") A_10C:definePushButton("CMSP_ARW2", 4, 3002, 353, "CMSP", "SET Button 2") A_10C:definePushButton("CMSP_ARW3", 4, 3003, 354, "CMSP", "SET Button 3") A_10C:definePushButton("CMSP_ARW4", 4, 3004, 355, "CMSP", "SET Button 4") A_1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
