bnepethomas/bne-arduino-flight-simulator-interfaces/A10/A10 PCBs/Right Console Overview/Fuel.kicad_sch

## KiCad design A10/A10 PCBs/Right Console Overview/Fuel.kicad_sch (2025-11-29)

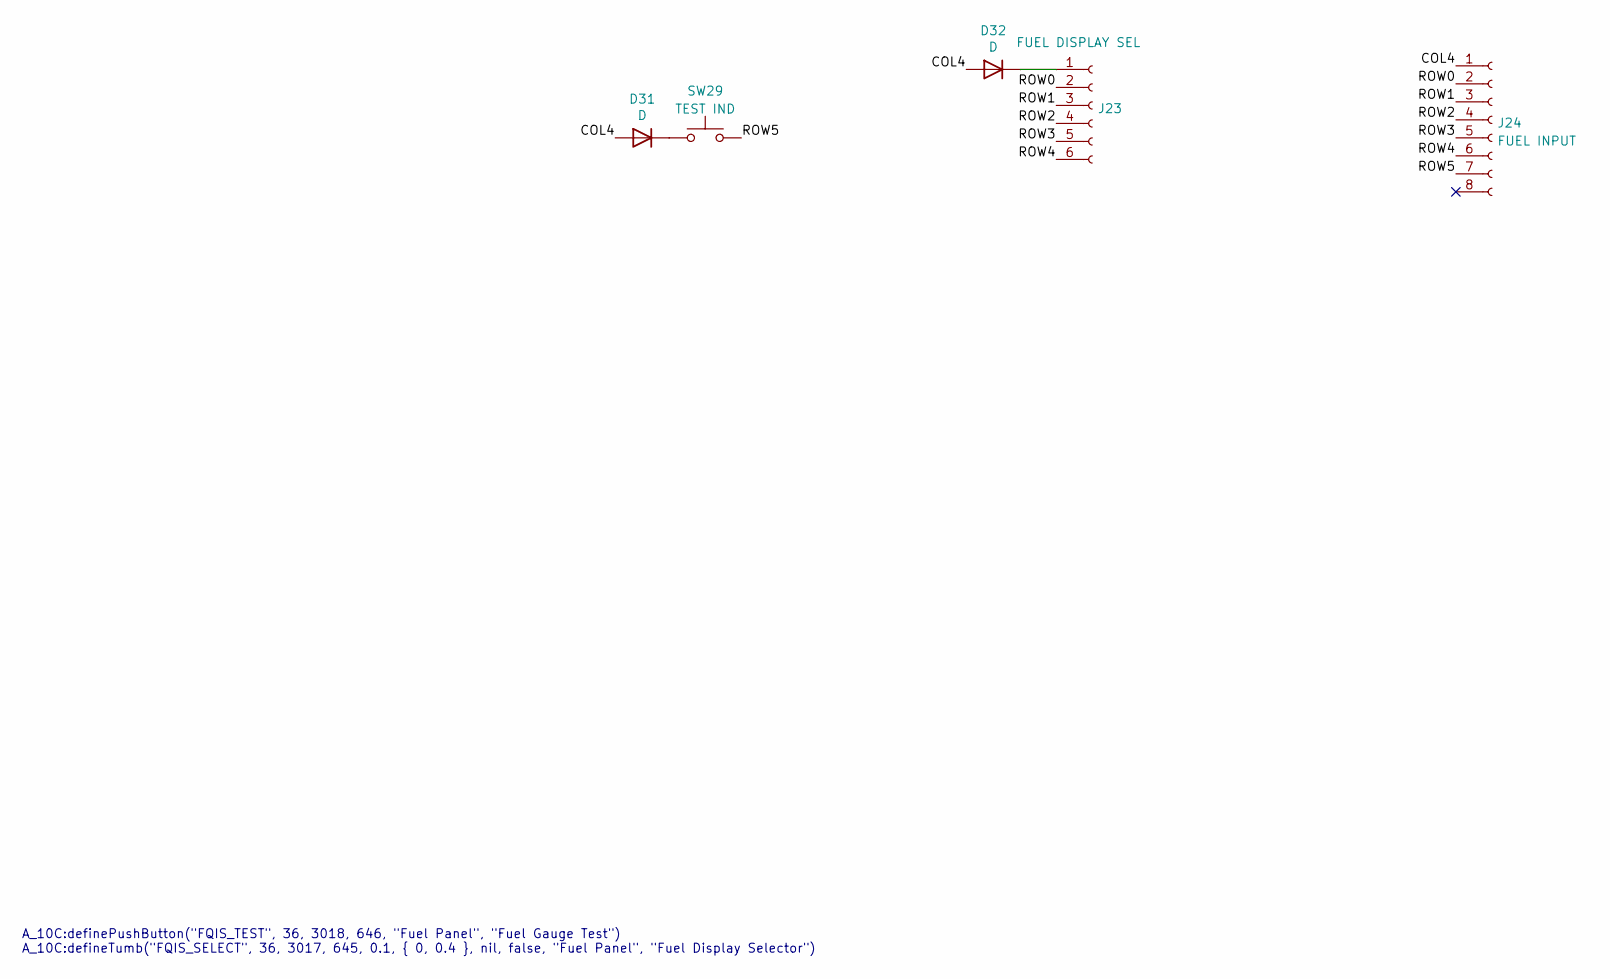
[picture p588: schematic Fuel.kicad_sch]

Parts:
D31: D; D_Signal_P7.62mm_Horizontal
D32: D; D_A-405_P7.62mm_Horizontal
J23: FUEL DISPLAY SEL; Molex_KK-254_AE-6410-06A_1x06_P2.54mm_Vertical
J24: FUEL INPUT; Molex_KK-254_AE-6410-08A_1x08_P2.54mm_Vertical
SW29: TEST IND

Connections:
COL4: D31.2 (A), D32.2 (A), J24.1
unnamed: D31.1 (K), SW29.1
unnamed: D32.1 (K), J23.1
ROW0: J23.2, J24.2
ROW1: J23.3, J24.3
ROW2: J23.4, J24.4
ROW3: J23.5, J24.5
ROW4: J23.6, J24.6
ROW5: J24.7, SW29.2

Notes on the sheet:
A_10C:definePushButton("FQIS_TEST", 36, 3018, 646, "Fuel Panel", "Fuel Gauge Test") A_10C:defineTumb("FQIS_SELECT", 36, 3017, 645, 0.1, { 0, 0.4 }, nil, false, "Fuel Panel", "Fuel Display Selector")
