bnepethomas/bne-arduino-flight-simulator-interfaces/A10/A10 PCBs/Right Console Overview/ILS.kicad_sch

## KiCad design A10/A10 PCBs/Right Console Overview/ILS.kicad_sch (2025-11-29)

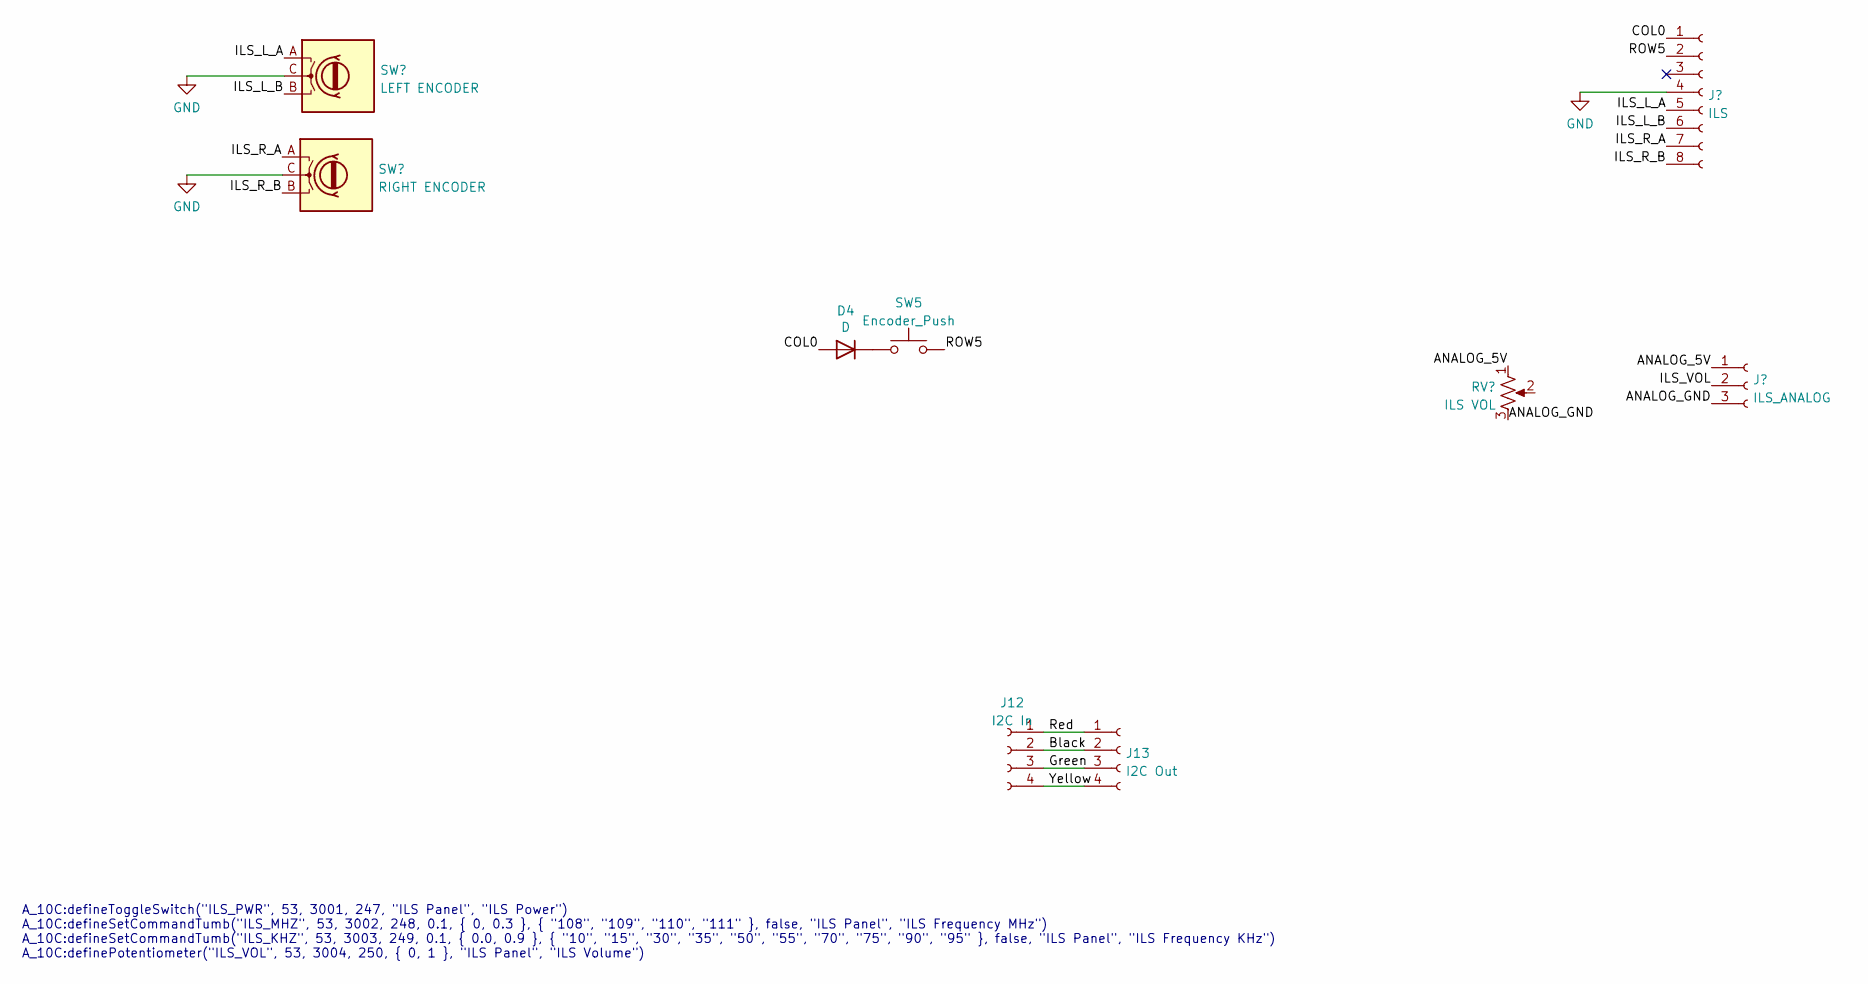
[picture p589: schematic ILS.kicad_sch]

Parts:
D4: D; D_A-405_P7.62mm_Horizontal
J12: I2C In; Molex_KK-254_AE-6410-04A_1x04_P2.54mm_Vertical
J13: I2C Out; Molex_KK-254_AE-6410-04A_1x04_P2.54mm_Vertical
SW5: Encoder_Push; Molex_KK-254_AE-6410-02A_1x02_P2.54mm_Vertical

Connections:
Black: J12.2, J13.2
COL0: D4.2 (A)
Green: J12.3, J13.3
unnamed: D4.1 (K), SW5.1
ROW5: SW5.2
Red: J12.1, J13.1
Yellow: J12.4, J13.4

Notes on the sheet:
A_10C:defineToggleSwitch("ILS_PWR", 53, 3001, 247, "ILS Panel", "ILS Power") A_10C:defineSetCommandTumb("ILS_MHZ", 53, 3002, 248, 0.1, { 0, 0.3 }, { "108", "109", "110", "111" }, false, "ILS Panel", "ILS Frequency MHz") A_10C:defineSetCommandTumb("ILS_KHZ", 53, 3003, 249, 0.1, { 0.0, 0.9 }, { "10",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
