bnepethomas/bne-arduino-flight-simulator-interfaces/A10/A10 PCBs/Right Console Overview/LIGHTS.kicad_sch

## KiCad design A10/A10 PCBs/Right Console Overview/LIGHTS.kicad_sch (2025-11-29)

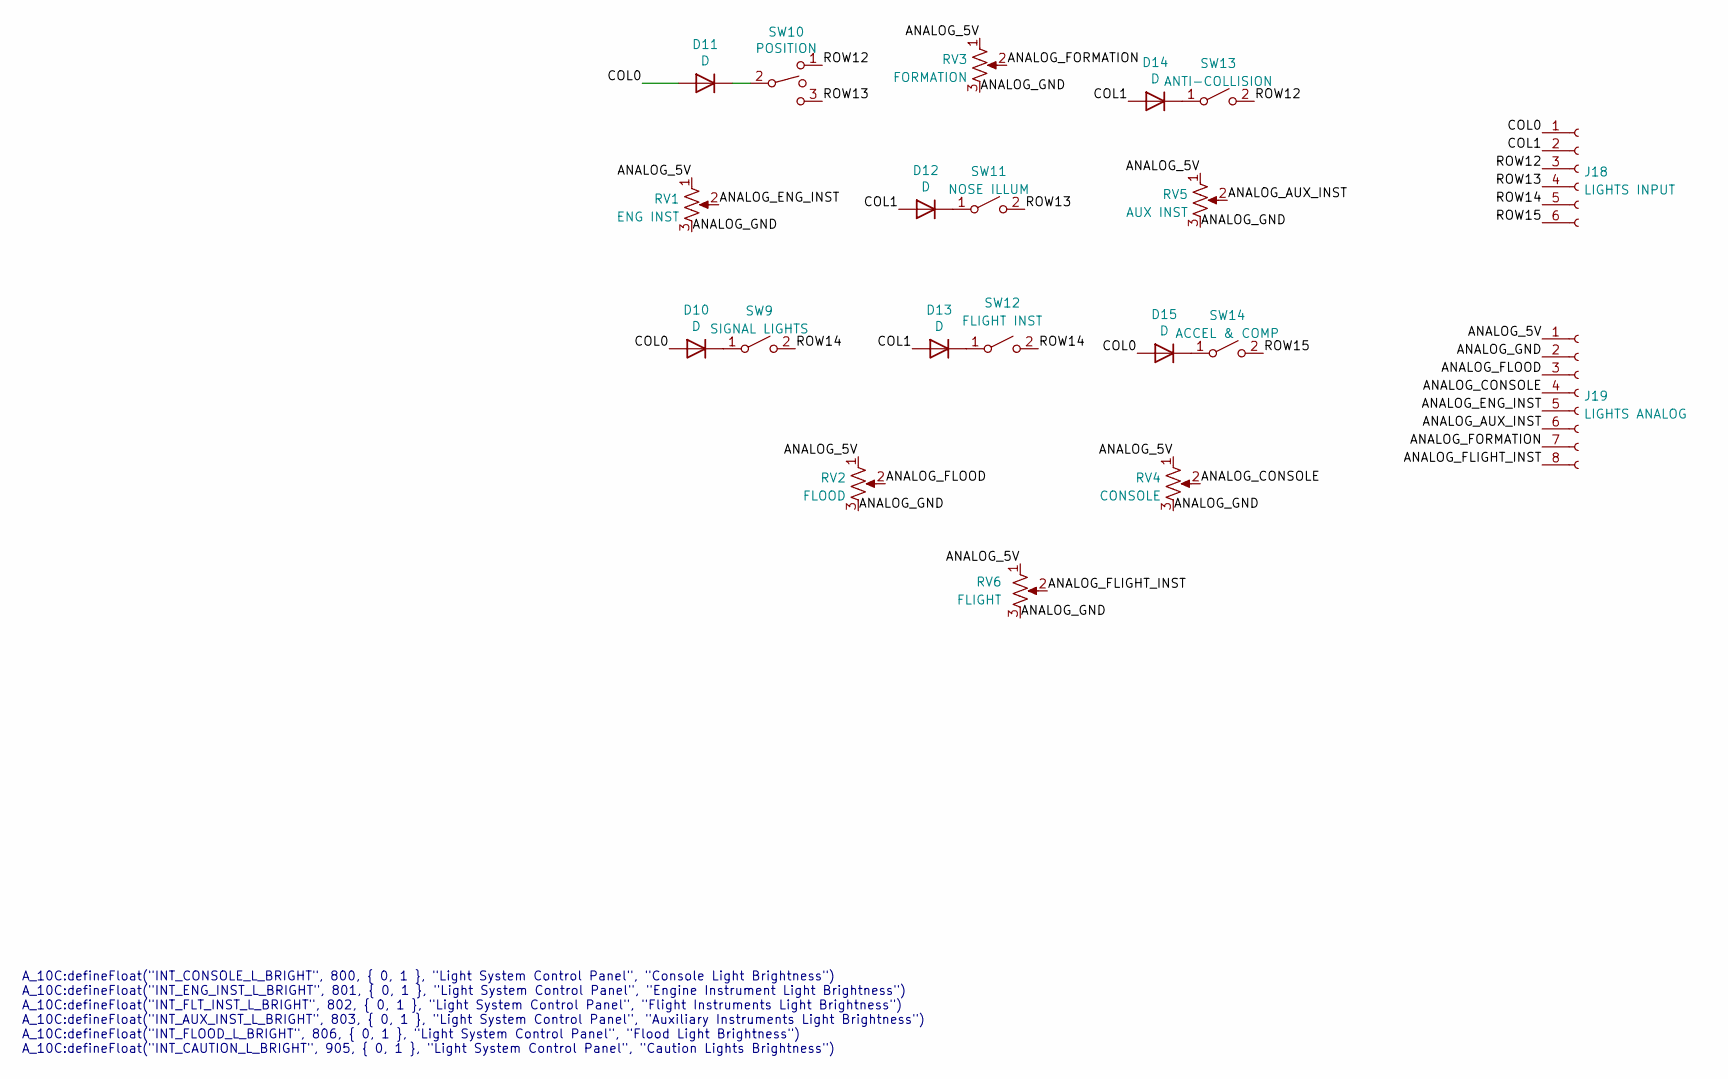
[picture p590: schematic LIGHTS.kicad_sch]

Parts:
D10, D11, D12, D13, D14, D15: D; D_Signal_P7.62mm_Horizontal
J18: LIGHTS INPUT
J19: LIGHTS ANALOG; Molex_KK-254_AE-6410-08A_1x08_P2.54mm_Vertical
RV1: ENG INST
RV2: FLOOD
RV3: FORMATION
RV4: CONSOLE
RV5: AUX INST
RV6: FLIGHT
SW9: SIGNAL LIGHTS
SW10: POSITION; Molex_1x03_P2.54mm_Vertical
SW11: NOSE ILLUM
SW12: FLIGHT INST
SW13: ANTI-COLLISION
SW14: ACCEL & COMP

Connections:
ANALOG_5V: J19.1, RV1.1, RV2.1, RV3.1, RV4.1, RV5.1, RV6.1
ANALOG_AUX_INST: J19.6, RV5.2
ANALOG_CONSOLE: J19.4, RV4.2
ANALOG_ENG_INST: J19.5, RV1.2
ANALOG_FLIGHT_INST: J19.8, RV6.2
ANALOG_FLOOD: J19.3, RV2.2
ANALOG_FORMATION: J19.7, RV3.2
ANALOG_GND: J19.2, RV1.3, RV2.3, RV3.3, RV4.3, RV5.3, RV6.3
COL0: D10.2 (A), D11.2 (A), D15.2 (A), J18.1
COL1: D12.2 (A), D13.2 (A), D14.2 (A), J18.2
unnamed: D10.1 (K), SW9.1 (A)
unnamed: D11.1 (K), SW10.2
unnamed: D12.1 (K), SW11.1 (A)
unnamed: D13.1 (K), SW12.1 (A)
unnamed: D14.1 (K), SW13.1 (A)
unnamed: D15.1 (K), SW14.1 (A)
ROW12: J18.3, SW10.1, SW13.2 (B)
ROW13: J18.4, SW10.3, SW11.2 (B)
ROW14: J18.5, SW9.2 (B), SW12.2 (B)
ROW15: J18.6, SW14.2 (B)

Notes on the sheet:
A_10C:defineFloat("INT_CONSOLE_L_BRIGHT", 800, { 0, 1 }, "Light System Control Panel", "Console Light Brightness") A_10C:defineFloat("INT_ENG_INST_L_BRIGHT", 801, { 0, 1 }, "Light System Control Panel", "Engine Instrument Light Brightness") A_10C:defineFloat("INT_FLT_INST_L_BRIGHT", 802, { 0, 1 }, 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
