bnepethomas/bne-arduino-flight-simulator-interfaces/A10/A10 PCBs/Right Console Overview/TACAN.kicad_sch

## KiCad design A10/A10 PCBs/Right Console Overview/TACAN.kicad_sch (2025-11-29)

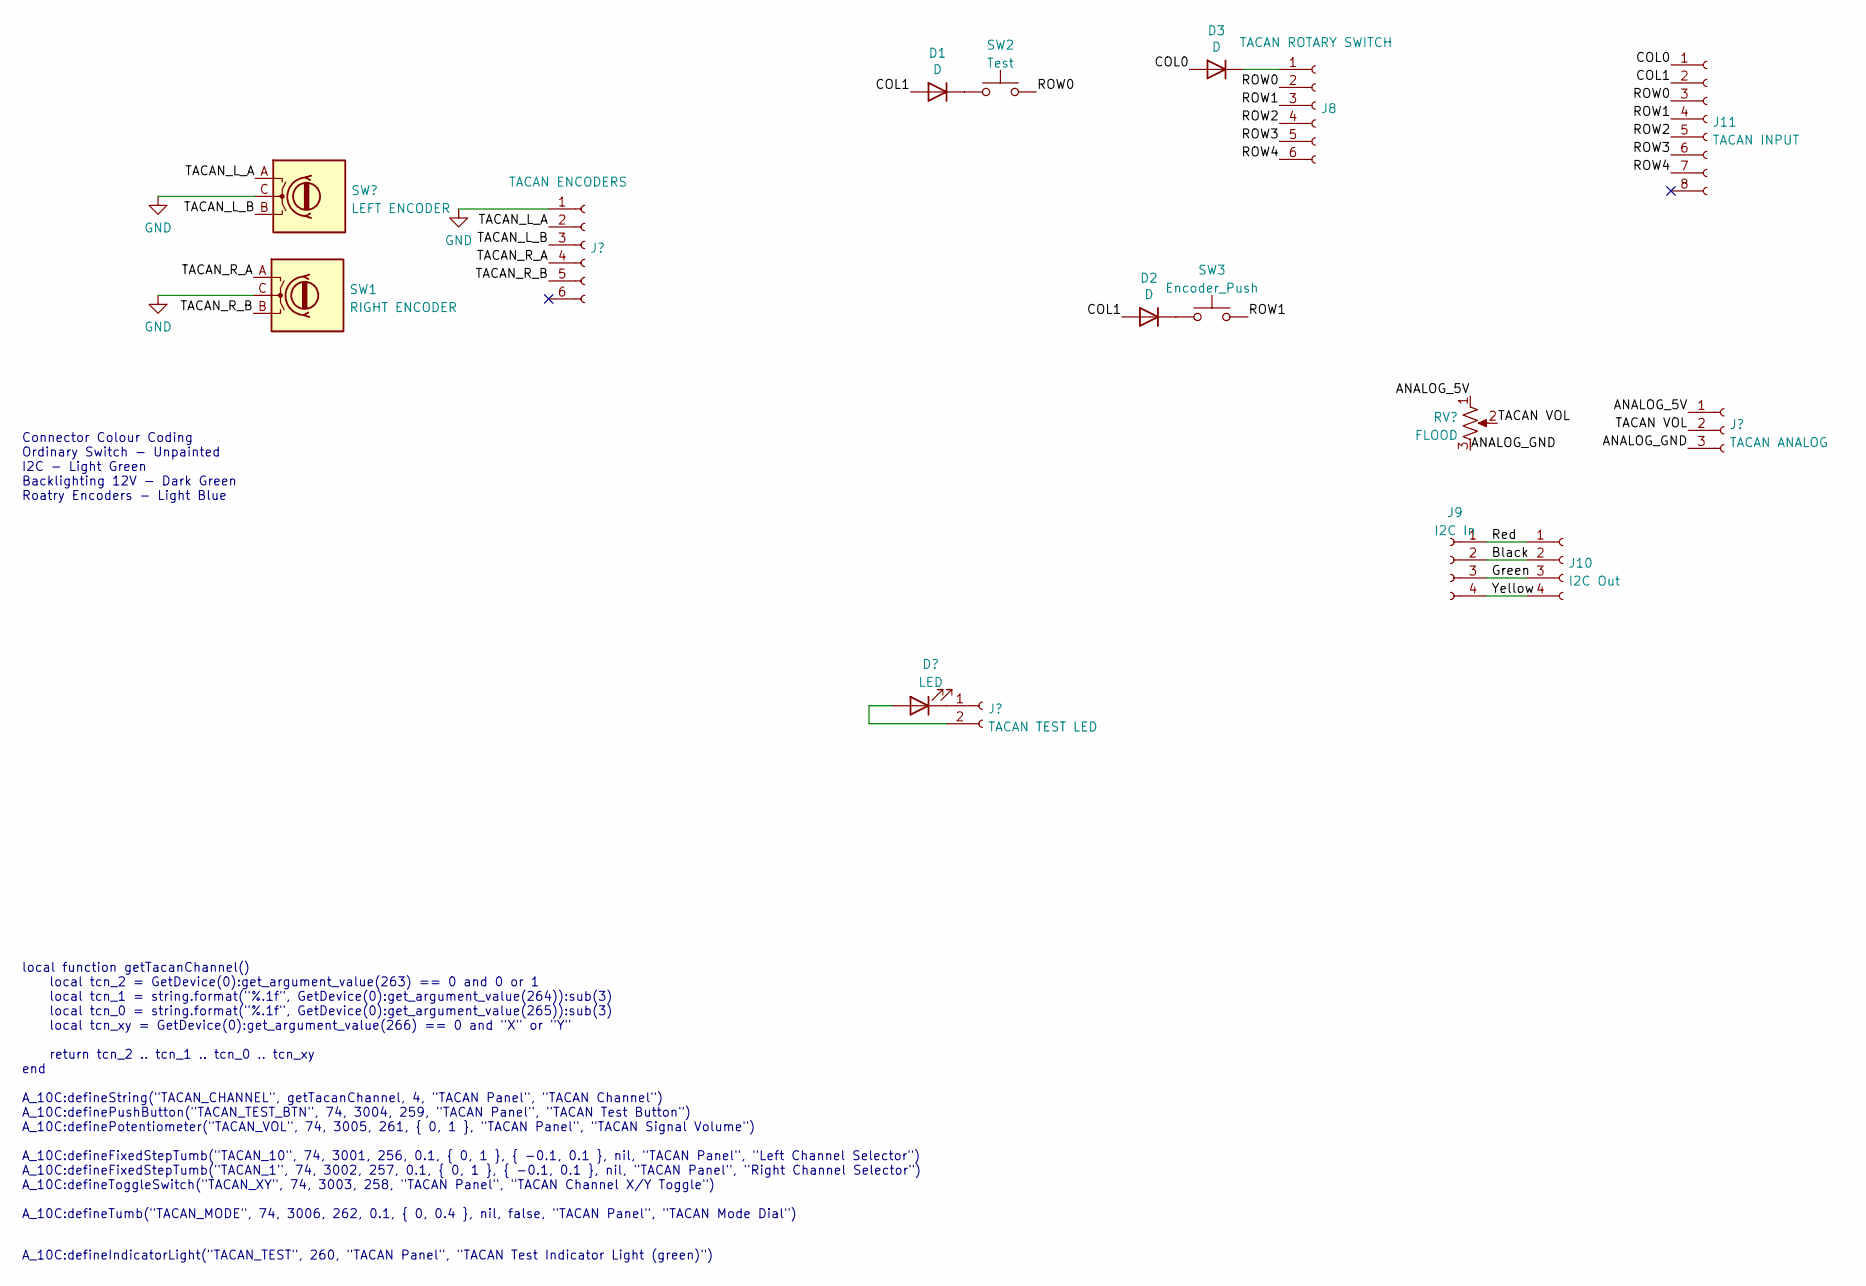
[picture p591: schematic TACAN.kicad_sch]

Parts:
D1, D2, D3: D; D_A-405_P7.62mm_Horizontal
J8: TACAN ROTARY SWITCH; Molex_KK-254_AE-6410-06A_1x06_P2.54mm_Vertical
J9: I2C In; Molex_KK-254_AE-6410-04A_1x04_P2.54mm_Vertical
J10: I2C Out; Molex_KK-254_AE-6410-04A_1x04_P2.54mm_Vertical
J11: TACAN INPUT; Molex_KK-254_AE-6410-08A_1x08_P2.54mm_Vertical
SW1: RIGHT ENCODER; Molex_KK-254_AE-6410-03A_1x03_P2.54mm_Vertical
SW2: Test; Molex_KK-254_AE-6410-02A_1x02_P2.54mm_Vertical
SW3: Encoder_Push; Molex_KK-254_AE-6410-02A_1x02_P2.54mm_Vertical

Connections:
Black: J9.2, J10.2
COL0: D3.2 (A), J11.1
COL1: D1.2 (A), D2.2 (A), J11.2
Green: J9.3, J10.3
unnamed: D1.1 (K), SW2.1
unnamed: D2.1 (K), SW3.1
unnamed: D3.1 (K), J8.1
ROW0: J8.2, J11.3, SW2.2
ROW1: J8.3, J11.4, SW3.2
ROW2: J8.4, J11.5
ROW3: J8.5, J11.6
ROW4: J8.6, J11.7
Red: J9.1, J10.1
TACAN_R_A: SW1.A
TACAN_R_B: SW1.B
Yellow: J9.4, J10.4

Notes on the sheet:
Connector Colour Coding Ordinary Switch - Unpainted I2C - Light Green Backlighting 12V - Dark Green Roatry Encoders - Light Blue
A_10C:defineIndicatorLight("TACAN_TEST", 260, "TACAN Panel", "TACAN Test Indicator Light (green)")
local function getTacanChannel() local tcn_2 = GetDevice(0):get_argument_value(263) == 0 and 0 or 1 local tcn_1 = string.format("%.1f", GetDevice(0):get_argument_value(264)):sub(3) local tcn_0 = string.format("%.1f", GetDevice(0):get_argument_value(265)):sub(3) local tcn_xy = GetDevice(0):get_argum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
