bnepethomas/bne-arduino-flight-simulator-interfaces/F16/F16 PCBs/FORWARD CONSOLE OVERVIEW/FLIGHT-CONTROL.kicad_sch

## KiCad design F16/F16 PCBs/FORWARD CONSOLE OVERVIEW/FLIGHT-CONTROL.kicad_sch (2025-11-29)

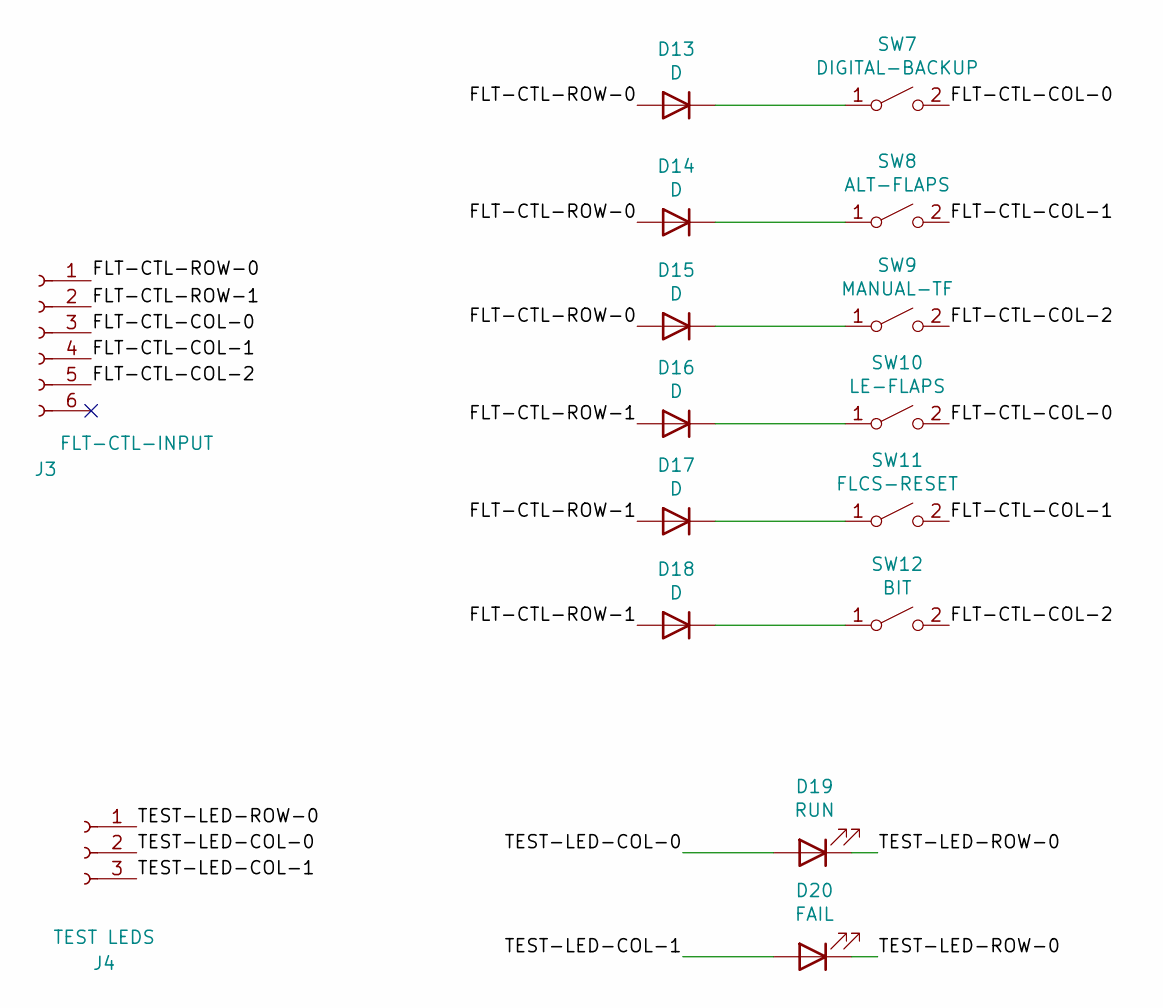
[picture p593: schematic FLIGHT-CONTROL.kicad_sch]

Parts:
D13, D14, D15, D16, D17, D18: D; D_Signal_P7.62mm_Horizontal
D19: RUN; Molex_1x02_P2.54mm_Vertical
D20: FAIL; Molex_1x02_P2.54mm_Vertical
J3: FLT-CTL-INPUT; Molex_1x06_P2.54mm_Vertical
J4: TEST LEDS; Molex_1x04_P2.54mm_Vertical
SW7: DIGITAL-BACKUP; Molex_1x02_P2.54mm_Vertical
SW8: ALT-FLAPS; Molex_1x02_P2.54mm_Vertical
SW9: MANUAL-TF; Molex_1x02_P2.54mm_Vertical
SW10: LE-FLAPS; Molex_1x02_P2.54mm_Vertical
SW11: FLCS-RESET; Molex_1x02_P2.54mm_Vertical
SW12: BIT; Molex_1x02_P2.54mm_Vertical

Connections:
FLT-CTL-COL-0: J3.3, SW7.2 (B), SW10.2 (B)
FLT-CTL-COL-1: J3.4, SW8.2 (B), SW11.2 (B)
FLT-CTL-COL-2: J3.5, SW9.2 (B), SW12.2 (B)
FLT-CTL-ROW-0: D13.2 (A), D14.2 (A), D15.2 (A)
FLT-CTL-ROW-1: D16.2 (A), D17.2 (A), D18.2 (A), J3.2
unnamed: D13.1 (K), SW7.1 (A)
unnamed: D14.1 (K), SW8.1 (A)
unnamed: D15.1 (K), SW9.1 (A)
unnamed: D16.1 (K), SW10.1 (A)
unnamed: D17.1 (K), SW11.1 (A)
unnamed: D18.1 (K), SW12.1 (A)
TEST-LED-COL-0: D19.2 (A), J4.2
TEST-LED-COL-1: D20.2 (A), J4.3
TEST-LED-ROW-0: D19.1 (K), D20.1 (K), J4.1
