bnepethomas/bne-arduino-flight-simulator-interfaces/F16/F16 PCBs/FORWARD CONSOLE OVERVIEW/Test.kicad_sch

## KiCad design F16/F16 PCBs/FORWARD CONSOLE OVERVIEW/Test.kicad_sch (2025-11-29)

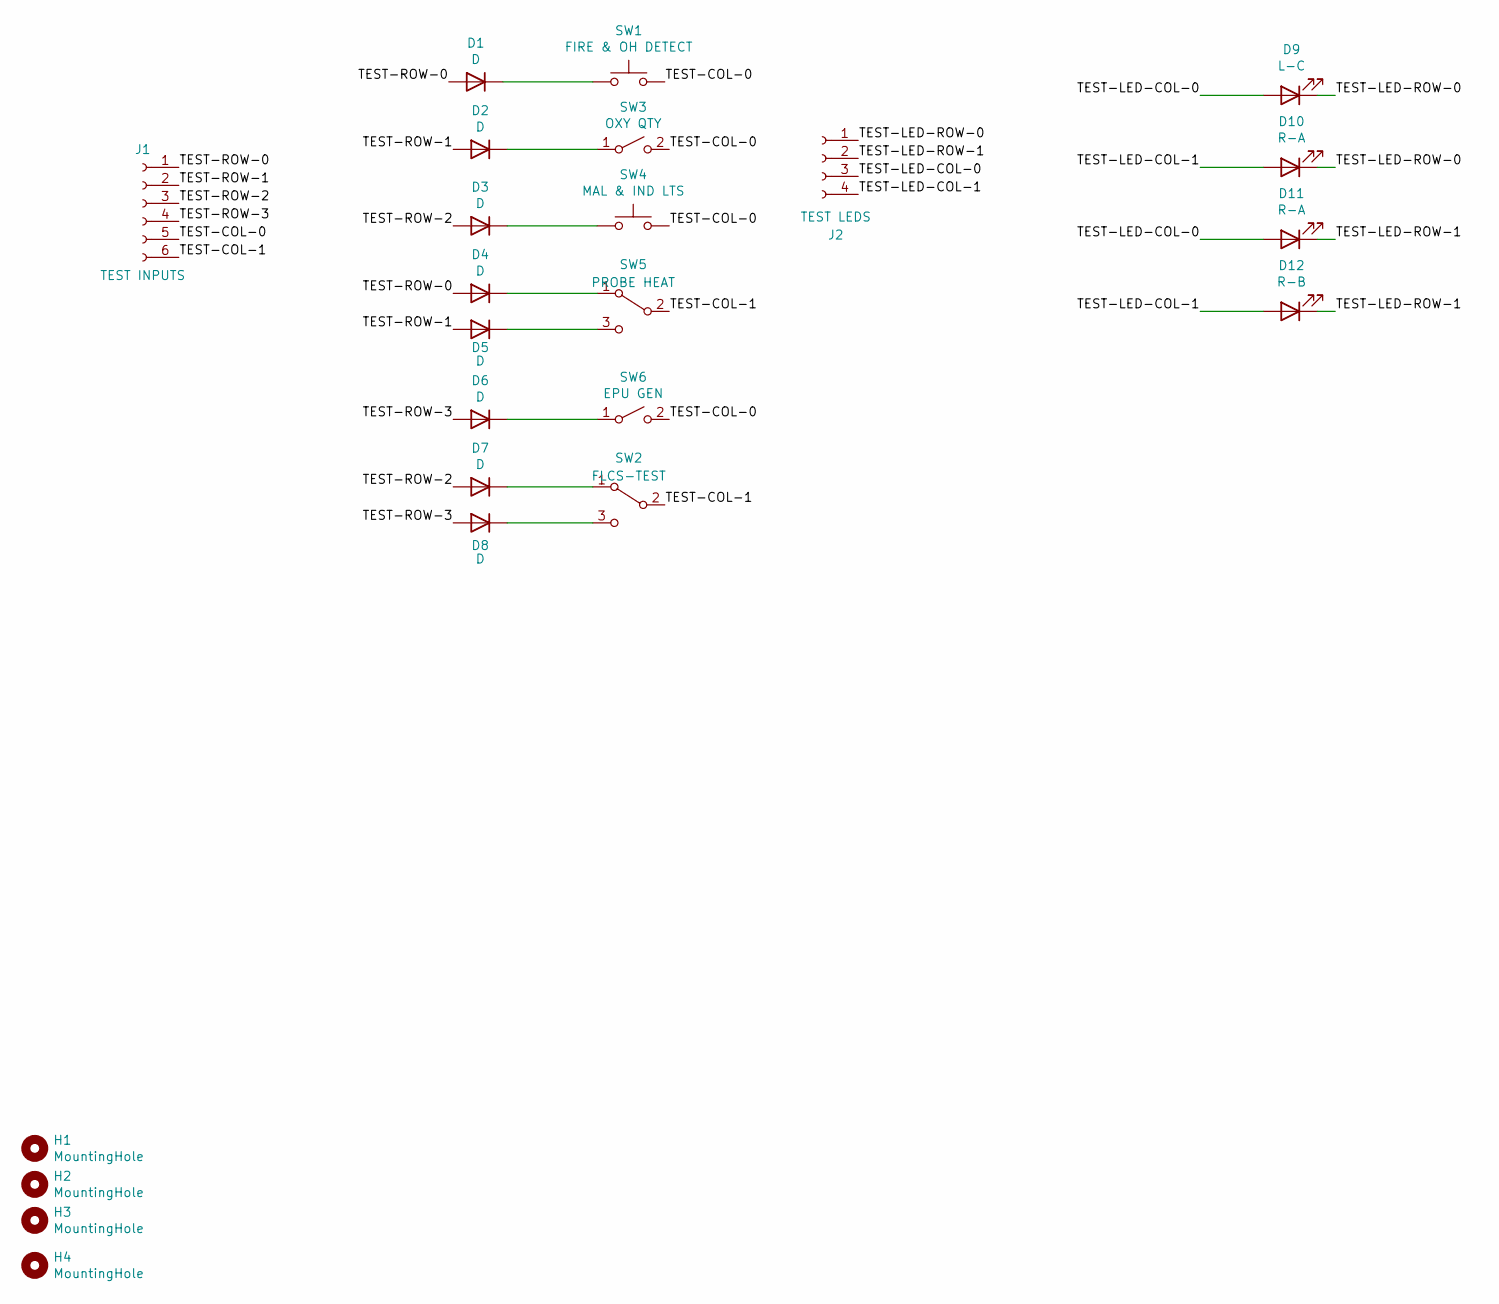
[picture p594: schematic Test.kicad_sch]

Parts:
D1, D2, D3, D4, D5, D6, D7, D8: D; D_Signal_P7.62mm_Horizontal
D9: L-C; Molex_1x02_P2.54mm_Vertical
D10, D11: R-A; Molex_1x02_P2.54mm_Vertical
D12: R-B; Molex_1x02_P2.54mm_Vertical
H1, H2, H3, H4: MountingHole; MountingHole_3.2mm_M3
J1: TEST INPUTS; Molex_1x06_P2.54mm_Vertical
J2: TEST LEDS; Molex_1x04_P2.54mm_Vertical
SW1: FIRE & OH DETECT; Molex_1x02_P2.54mm_Vertical
SW2: FLCS-TEST; Molex_1x03_P2.54mm_Vertical
SW3: OXY QTY; Molex_1x02_P2.54mm_Vertical
SW4: MAL & IND LTS; Molex_1x02_P2.54mm_Vertical
SW5: PROBE HEAT; Molex_1x03_P2.54mm_Vertical
SW6: EPU GEN; Molex_1x02_P2.54mm_Vertical

Connections:
unnamed: D1.1 (K), SW1.1
unnamed: D2.1 (K), SW3.1 (A)
unnamed: D3.1 (K), SW4.1
unnamed: D4.1 (K), SW5.1 (A)
unnamed: D5.1 (K), SW5.3 (C)
unnamed: D6.1 (K), SW6.1 (A)
unnamed: D7.1 (K), SW2.1 (A)
unnamed: D8.1 (K), SW2.3 (C)
TEST-COL-0: J1.5, SW1.2, SW3.2 (B), SW4.2, SW6.2 (B)
TEST-COL-1: J1.6, SW2.2 (B), SW5.2 (B)
TEST-LED-COL-0: D9.2 (A), D11.2 (A), J2.3
TEST-LED-COL-1: D10.2 (A), D12.2 (A), J2.4
TEST-LED-ROW-0: D9.1 (K), D10.1 (K), J2.1
TEST-LED-ROW-1: D11.1 (K), D12.1 (K), J2.2
TEST-ROW-0: D1.2 (A), D4.2 (A), J1.1
TEST-ROW-1: D2.2 (A), D5.2 (A), J1.2
TEST-ROW-2: D3.2 (A), D7.2 (A), J1.3
TEST-ROW-3: D6.2 (A), D8.2 (A), J1.4
