bnepethomas/bne-arduino-flight-simulator-interfaces/Jet Ranger/PCBs/Jet Ranger ADF Panel/Jet Ranger ADF Panel.kicad_sch

## KiCad design Jet Ranger/PCBs/Jet Ranger ADF Panel/Jet Ranger ADF Panel.kicad_sch (2026-10-17)

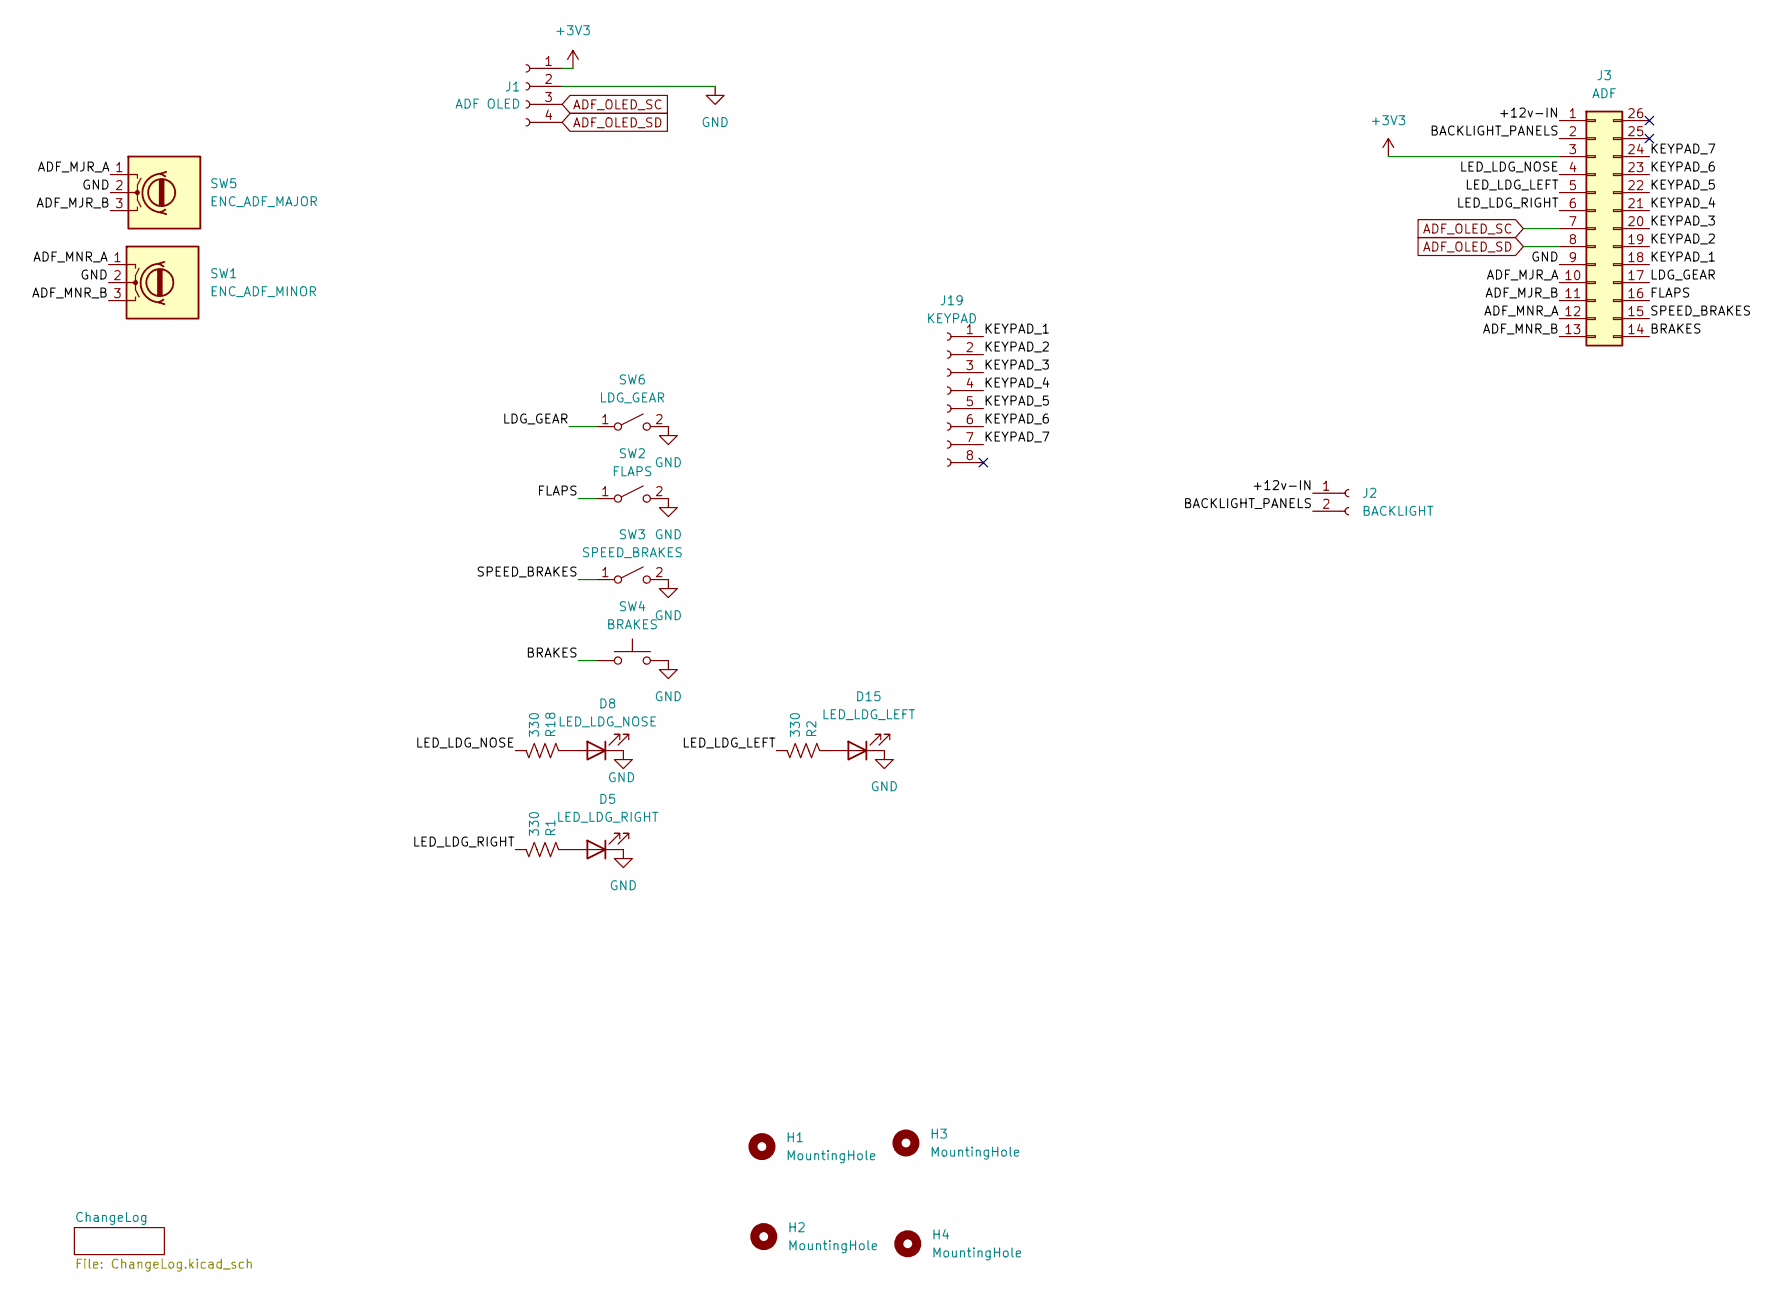
[picture p595: schematic Jet Ranger ADF Panel.kicad_sch]

Parts:
D5: LED_LDG_RIGHT; JST_XH_B2B-XH-A_1x02_P2.50mm_Vertical
D8: LED_LDG_NOSE; JST_XH_B2B-XH-A_1x02_P2.50mm_Vertical
D15: LED_LDG_LEFT; JST_XH_B2B-XH-A_1x02_P2.50mm_Vertical
H1, H2, H3, H4: MountingHole; MountingHole_3.2mm_M3
J1: ADF OLED; JST_XH_B4B-XH-A_1x04_P2.50mm_Vertical
J2: BACKLIGHT; JST_XH_B2B-XH-A_1x02_P2.50mm_Vertical
J3: ADF; IDC-Header_2x13_P2.54mm_Vertical
J19: KEYPAD; Molex_KK-254_AE-6410-08A_1x08_P2.54mm_Vertical
R1, R2, R18: 330; R_Axial_DIN0207_L6.3mm_D2.5mm_P2.54mm_Vertical
SW1: ENC_ADF_MINOR; JST_XH_B3B-XH-A_1x03_P2.50mm_Vertical
SW2: FLAPS; JST_XH_B2B-XH-A_1x02_P2.50mm_Vertical
SW3: SPEED_BRAKES; JST_XH_B2B-XH-A_1x02_P2.50mm_Vertical
SW4: BRAKES; JST_XH_B2B-XH-A_1x02_P2.50mm_Vertical
SW5: ENC_ADF_MAJOR; JST_XH_B3B-XH-A_1x03_P2.50mm_Vertical
SW6: LDG_GEAR; JST_XH_B2B-XH-A_1x02_P2.50mm_Vertical

Connections:
+3V3: J1.1, J3.3
+12v-IN: J2.1, J3.1
ADF_MJR_A: J3.10, SW5.1 (A)
ADF_MJR_B: J3.11, SW5.3 (B)
ADF_MNR_A: J3.12, SW1.1 (A)
ADF_MNR_B: J3.13, SW1.3 (B)
ADF_OLED_SC: J1.3, J3.7
ADF_OLED_SD: J1.4, J3.8
BACKLIGHT_PANELS: J2.2, J3.2
BRAKES: J3.14, SW4.1
FLAPS: J3.16, SW2.1 (A)
GND: D5.2 (K), D8.2 (K), D15.2 (K), J1.2, J3.9, SW1.2 (C), SW2.2 (B), SW3.2 (B), SW4.2, SW5.2 (C), SW6.2 (B)
KEYPAD_1: J3.18, J19.1
KEYPAD_2: J3.19, J19.2
KEYPAD_3: J3.20, J19.3
KEYPAD_4: J3.21, J19.4
KEYPAD_5: J3.22, J19.5
KEYPAD_6: J3.23, J19.6
KEYPAD_7: J3.24, J19.7
LDG_GEAR: J3.17, SW6.1 (A)
LED_LDG_LEFT: J3.5, R2.2
LED_LDG_NOSE: J3.4, R18.2
LED_LDG_RIGHT: J3.6, R1.2
unnamed: D5.1 (A), R1.1
unnamed: D8.1 (A), R18.1
unnamed: D15.1 (A), R2.1
SPEED_BRAKES: J3.15, SW3.1 (A)
