bnepethomas/bne-arduino-flight-simulator-interfaces/Jet Ranger/PCBs/Jet Ranger Audio Panel/Jet Ranger Audio Panel.kicad_sch

## KiCad design Jet Ranger/PCBs/Jet Ranger Audio Panel/Jet Ranger Audio Panel.kicad_sch (2026-10-17)

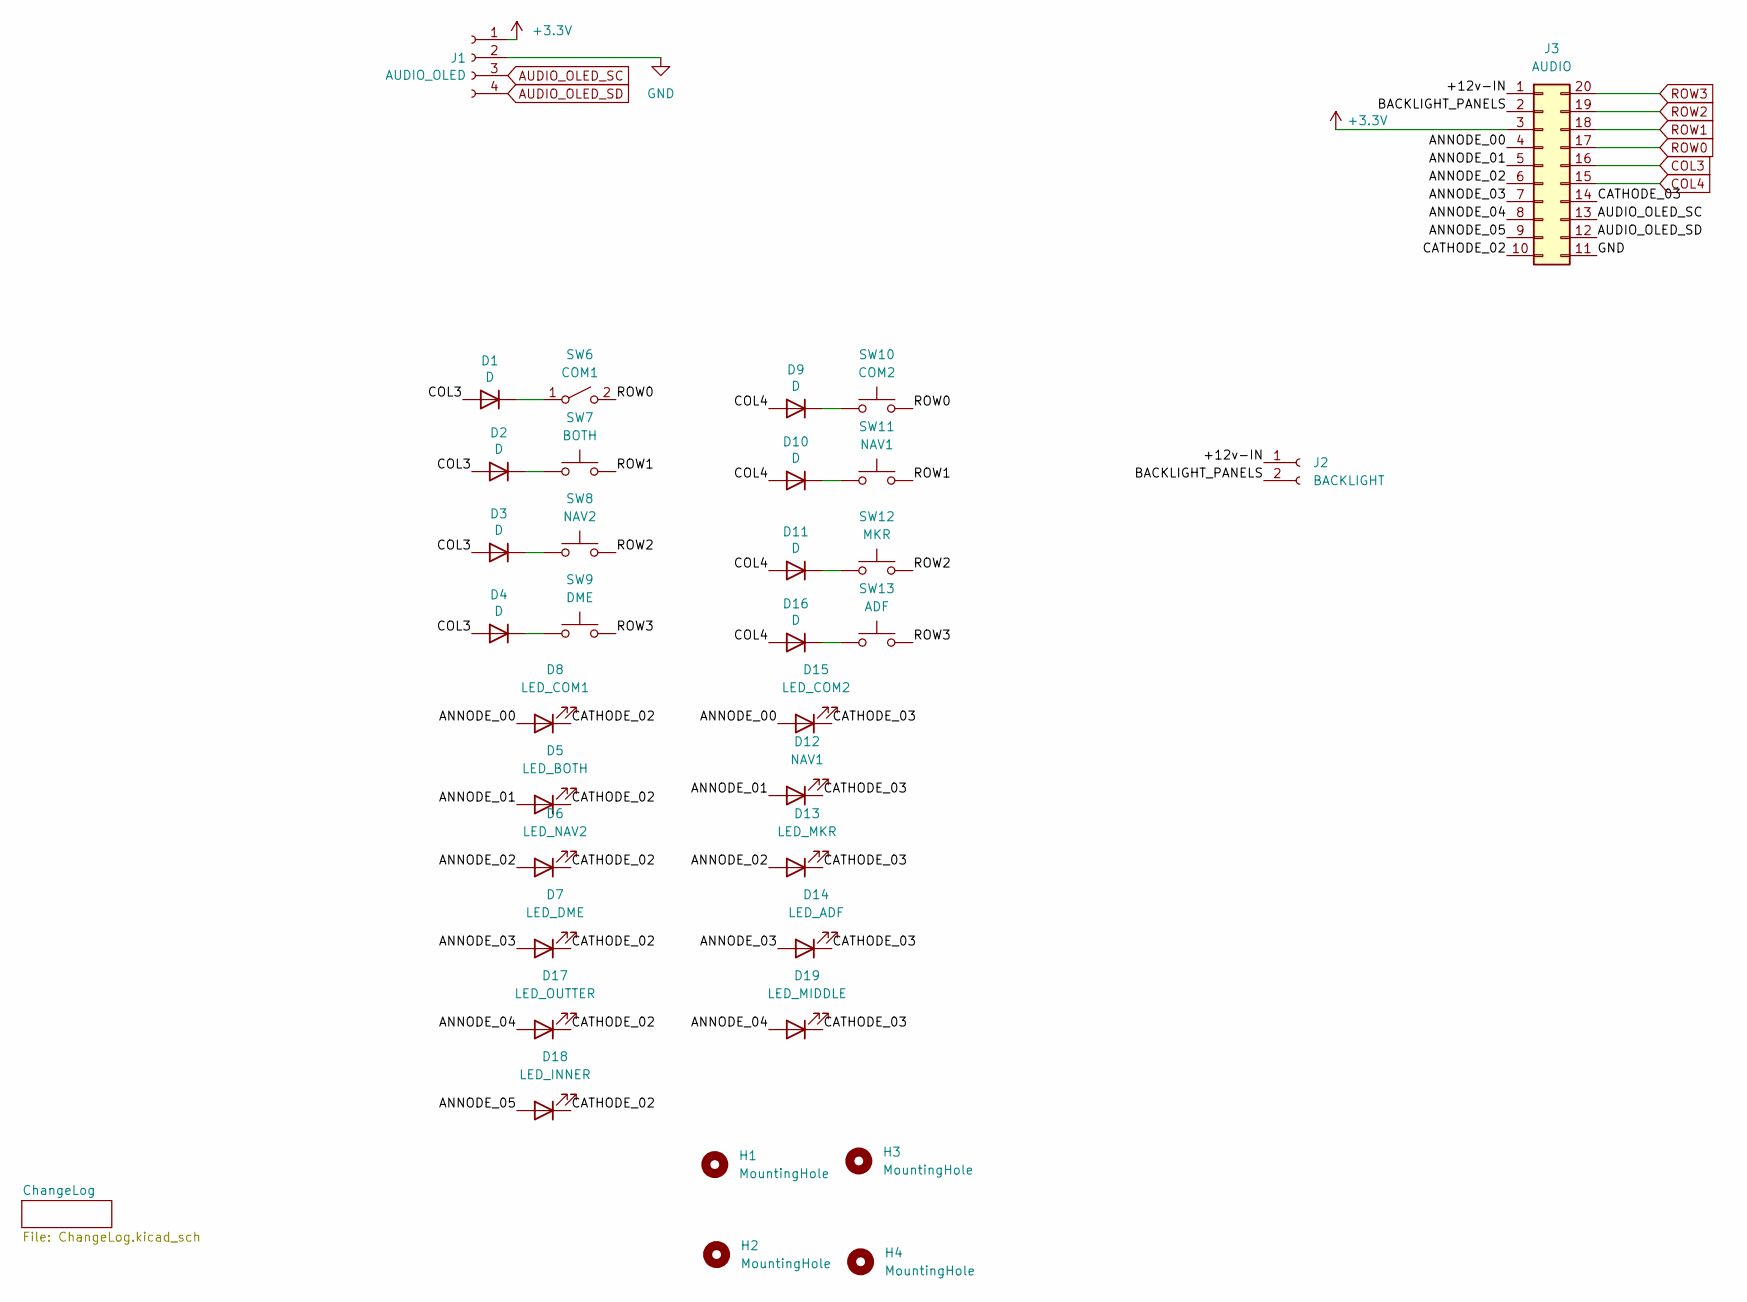
[picture p596: schematic Jet Ranger Audio Panel.kicad_sch]

Parts:
D1, D2, D3, D4, D9, D10, D11, D16: D; D_A-405_P7.62mm_Horizontal
D5: LED_BOTH; JST_XH_B2B-XH-A_1x02_P2.50mm_Vertical
D6: LED_NAV2; JST_XH_B2B-XH-A_1x02_P2.50mm_Vertical
D7: LED_DME; JST_XH_B2B-XH-A_1x02_P2.50mm_Vertical
D8: LED_COM1; JST_XH_B2B-XH-A_1x02_P2.50mm_Vertical
D12: NAV1; JST_XH_B2B-XH-A_1x02_P2.50mm_Vertical
D13: LED_MKR; JST_XH_B2B-XH-A_1x02_P2.50mm_Vertical
D14: LED_ADF; JST_XH_B2B-XH-A_1x02_P2.50mm_Vertical
D15: LED_COM2; JST_XH_B2B-XH-A_1x02_P2.50mm_Vertical
D17: LED_OUTTER; JST_XH_B2B-XH-A_1x02_P2.50mm_Vertical
D18: LED_INNER; JST_XH_B2B-XH-A_1x02_P2.50mm_Vertical
D19: LED_MIDDLE; JST_XH_B2B-XH-A_1x02_P2.50mm_Vertical
H1, H2, H3, H4: MountingHole; MountingHole_3.2mm_M3
J1: AUDIO_OLED; JST_XH_B4B-XH-A_1x04_P2.50mm_Vertical
J2: BACKLIGHT; JST_XH_B2B-XH-A_1x02_P2.50mm_Vertical
J3: AUDIO; IDC-Header_2x10_P2.54mm_Vertical
SW6: COM1; JST_XH_B2B-XH-A_1x02_P2.50mm_Vertical
SW7: BOTH; JST_XH_B2B-XH-A_1x02_P2.50mm_Vertical
SW8: NAV2; JST_XH_B2B-XH-A_1x02_P2.50mm_Vertical
SW9: DME; JST_XH_B2B-XH-A_1x02_P2.50mm_Vertical
SW10: COM2; JST_XH_B2B-XH-A_1x02_P2.50mm_Vertical
SW11: NAV1; JST_XH_B2B-XH-A_1x02_P2.50mm_Vertical
SW12: MKR; JST_XH_B2B-XH-A_1x02_P2.50mm_Vertical
SW13: ADF; JST_XH_B2B-XH-A_1x02_P2.50mm_Vertical

Connections:
+3.3V: J1.1, J3.3
+12v-IN: J2.1, J3.1
ANNODE_00: D8.1 (A), D15.1 (A), J3.4
ANNODE_01: D5.1 (A), D12.1 (A), J3.5
ANNODE_02: D6.1 (A), D13.1 (A), J3.6
ANNODE_03: D7.1 (A), D14.1 (A), J3.7
ANNODE_04: D17.1 (A), D19.1 (A), J3.8
ANNODE_05: D18.1 (A), J3.9
AUDIO_OLED_SC: J1.3, J3.13
AUDIO_OLED_SD: J1.4, J3.12
BACKLIGHT_PANELS: J2.2, J3.2
CATHODE_02: D5.2 (K), D6.2 (K), D7.2 (K), D8.2 (K), D17.2 (K), D18.2 (K), J3.10
CATHODE_03: D12.2 (K), D13.2 (K), D14.2 (K), D15.2 (K), D19.2 (K), J3.14
COL3: D1.2 (A), D2.2 (A), D3.2 (A), D4.2 (A), J3.16
COL4: D9.2 (A), D10.2 (A), D11.2 (A), D16.2 (A), J3.15
GND: J1.2, J3.11
unnamed: D1.1 (K), SW6.1 (A)
unnamed: D2.1 (K), SW7.1
unnamed: D3.1 (K), SW8.1
unnamed: D4.1 (K), SW9.1
unnamed: D9.1 (K), SW10.1
unnamed: D10.1 (K), SW11.1
unnamed: D11.1 (K), SW12.1
unnamed: D16.1 (K), SW13.1
ROW0: J3.17, SW6.2 (B), SW10.2
ROW1: J3.18, SW7.2, SW11.2
ROW2: J3.19, SW8.2, SW12.2
ROW3: J3.20, SW9.2, SW13.2
