bnepethomas/bne-arduino-flight-simulator-interfaces/A10/A10 PCBs/Forward Console Inidividual PCBS/CMSP NMSP/CMSP NMSP.kicad_sch

## KiCad design A10/A10 PCBs/Forward Console Inidividual PCBS/CMSP NMSP/CMSP NMSP.kicad_sch (2025-11-29)

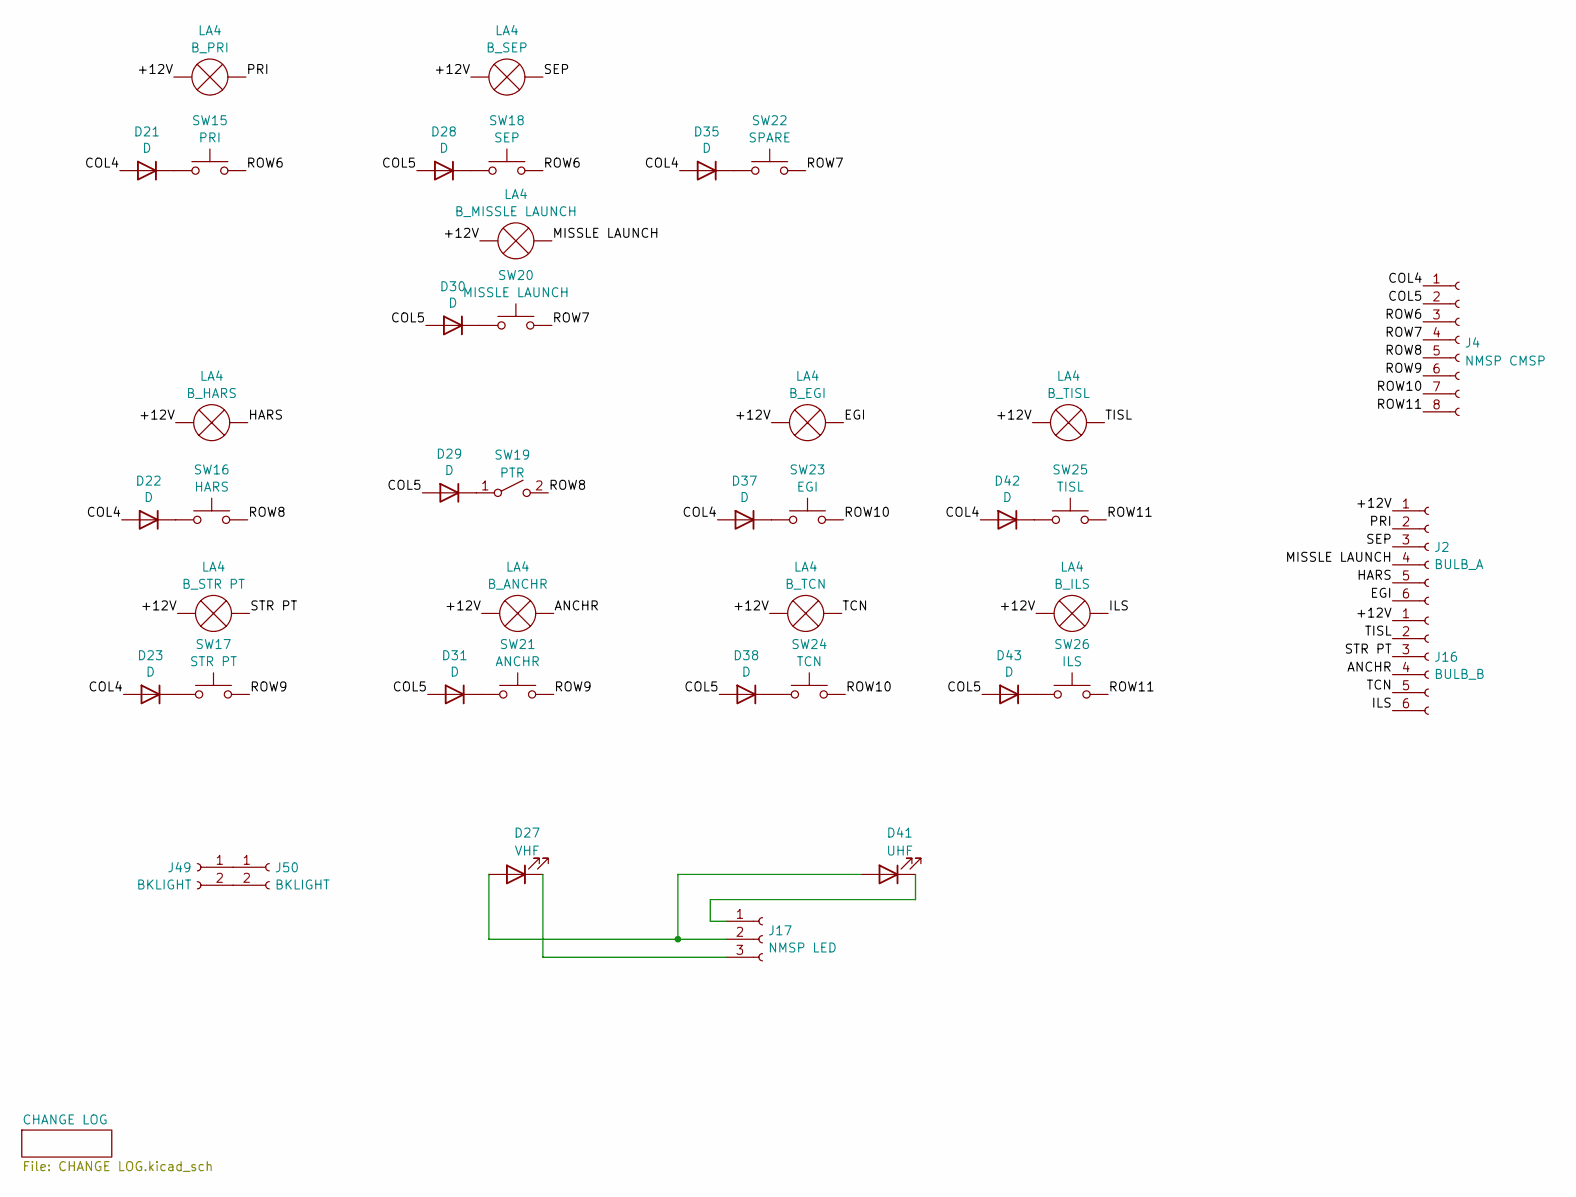
[picture p597: schematic CMSP NMSP.kicad_sch]

Parts:
D21, D22, D23, D28, D29, D30, D31, D35, D37, D38, D42, D43: D; D_A-405_P2.54mm_Vertical_AnodeUp
D27: VHF; Molex_KK-254_AE-6410-02A_1x02_P2.54mm_Vertical
D41: UHF; Molex_KK-254_AE-6410-02A_1x02_P2.54mm_Vertical
J2: BULB_A; Molex_KK-254_AE-6410-06A_1x06_P2.54mm_Vertical
J4: NMSP CMSP; Molex_KK-254_AE-6410-08A_1x08_P2.54mm_Vertical
J16: BULB_B; Molex_KK-254_AE-6410-06A_1x06_P2.54mm_Vertical
J17: NMSP LED; Molex_KK-254_AE-6410-03A_1x03_P2.54mm_Vertical
J49, J50: BKLIGHT; Molex_KK-254_AE-6410-02A_1x02_P2.54mm_Vertical
LA4: B_EGI; Molex_KK-254_AE-6410-02A_1x02_P2.54mm_Vertical
SW15: PRI; Molex_KK-254_AE-6410-02A_1x02_P2.54mm_Vertical
SW16: HARS; Molex_KK-254_AE-6410-02A_1x02_P2.54mm_Vertical
SW17: STR PT; Molex_KK-254_AE-6410-02A_1x02_P2.54mm_Vertical
SW18: SEP; Molex_KK-254_AE-6410-02A_1x02_P2.54mm_Vertical
SW19: PTR; Molex_KK-254_AE-6410-02A_1x02_P2.54mm_Vertical
SW20: MISSLE LAUNCH; Molex_KK-254_AE-6410-02A_1x02_P2.54mm_Vertical
SW21: ANCHR; Molex_KK-254_AE-6410-02A_1x02_P2.54mm_Vertical
SW22: SPARE; Molex_KK-254_AE-6410-02A_1x02_P2.54mm_Vertical
SW23: EGI; Molex_KK-254_AE-6410-02A_1x02_P2.54mm_Vertical
SW24: TCN; Molex_KK-254_AE-6410-02A_1x02_P2.54mm_Vertical
SW25: TISL; Molex_KK-254_AE-6410-02A_1x02_P2.54mm_Vertical
SW26: ILS; Molex_KK-254_AE-6410-02A_1x02_P2.54mm_Vertical

Connections:
+12V: J2.1, J16.1, LA4.2 (+)
ANCHR: J16.4, LA4.1 (-)
COL4: D21.2 (A), D22.2 (A), D23.2 (A), D35.2 (A), D37.2 (A), D42.2 (A), J4.1
COL5: D28.2 (A), D29.2 (A), D30.2 (A), D31.2 (A), D38.2 (A), D43.2 (A), J4.2
EGI: J2.6, LA4.1 (-)
HARS: J2.5, LA4.1 (-)
ILS: J16.6, LA4.1 (-)
MISSLE LAUNCH: J2.4, LA4.1 (-)
unnamed: D21.1 (K), SW15.1
unnamed: D22.1 (K), SW16.1
unnamed: D23.1 (K), SW17.1
unnamed: D27.1 (K), J17.3
unnamed: D27.2 (A), D41.2 (A), J17.2
unnamed: D28.1 (K), SW18.1
unnamed: D29.1 (K), SW19.1 (A)
unnamed: D30.1 (K), SW20.1
unnamed: D31.1 (K), SW21.1
unnamed: D35.1 (K), SW22.1
unnamed: D37.1 (K), SW23.1
unnamed: D38.1 (K), SW24.1
unnamed: D41.1 (K), J17.1
unnamed: D42.1 (K), SW25.1
unnamed: D43.1 (K), SW26.1
unnamed: J49.1, J50.1
unnamed: J49.2, J50.2
PRI: J2.2, LA4.1 (-)
ROW6: J4.3, SW15.2, SW18.2
ROW7: J4.4, SW20.2, SW22.2
ROW8: J4.5, SW16.2, SW19.2 (B)
ROW9: J4.6, SW17.2, SW21.2
ROW10: J4.7, SW23.2, SW24.2
ROW11: J4.8, SW25.2, SW26.2
SEP: J2.3, LA4.1 (-)
STR PT: J16.3, LA4.1 (-)
TCN: J16.5, LA4.1 (-)
TISL: J16.2, LA4.1 (-)
