bnepethomas/bne-arduino-flight-simulator-interfaces/A10/A10 PCBs/Forward Console Inidividual PCBS/FORWARD LED DISTRIBUTION/FORWARD LED DISTRIBUTION.kicad_sch

## KiCad design A10/A10 PCBs/Forward Console Inidividual PCBS/FORWARD LED DISTRIBUTION/FORWARD LED DISTRIBUTION.kicad_sch (2025-11-29)

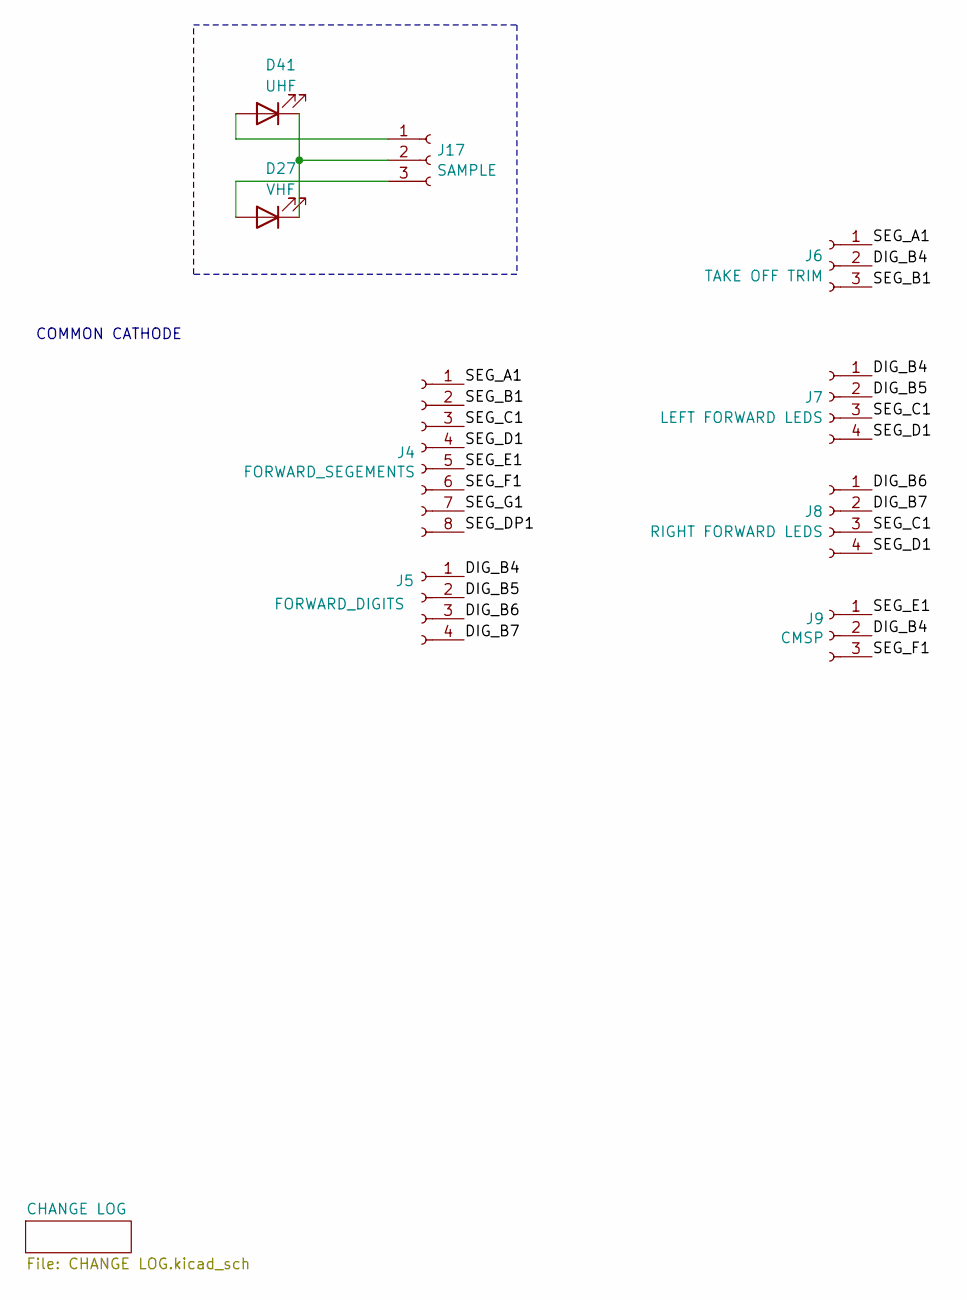
[picture p598: schematic FORWARD LED DISTRIBUTION.kicad_sch]

Parts:
D27: VHF; Molex_KK-254_AE-6410-02A_1x02_P2.54mm_Vertical
D41: UHF; Molex_KK-254_AE-6410-02A_1x02_P2.54mm_Vertical
J4: FORWARD_SEGEMENTS; Molex_KK-254_AE-6410-08A_1x08_P2.54mm_Vertical
J5: FORWARD_DIGITS; Molex_KK-254_AE-6410-04A_1x04_P2.54mm_Vertical
J6: TAKE OFF TRIM; Molex_KK-254_AE-6410-03A_1x03_P2.54mm_Vertical
J7: LEFT FORWARD LEDS; Molex_KK-254_AE-6410-04A_1x04_P2.54mm_Vertical
J8: RIGHT FORWARD LEDS; Molex_KK-254_AE-6410-04A_1x04_P2.54mm_Vertical
J9: CMSP; Molex_KK-254_AE-6410-04A_1x04_P2.54mm_Vertical
J17: SAMPLE; Molex_KK-254_AE-6410-03A_1x03_P2.54mm_Vertical

Connections:
DIG_B4: J5.1, J6.2, J7.1, J9.2
DIG_B5: J5.2, J7.2
DIG_B6: J5.3, J8.1
DIG_B7: J5.4, J8.2
unnamed: D27.1 (K), D41.1 (K), J17.2
unnamed: D27.2 (A), J17.3
unnamed: D41.2 (A), J17.1
SEG_A1: J4.1, J6.1
SEG_B1: J4.2, J6.3
SEG_C1: J4.3, J7.3, J8.3
SEG_D1: J4.4, J7.4, J8.4
SEG_DP1: J4.8
SEG_E1: J4.5, J9.1
SEG_F1: J4.6, J9.3
SEG_G1: J4.7

Notes on the sheet:
COMMON CATHODE
