bnepethomas/bne-arduino-flight-simulator-interfaces/A10/A10 PCBs/Forward Console Inidividual PCBS/LANDING GEAR/LANDING GEAR.kicad_sch

## KiCad design A10/A10 PCBs/Forward Console Inidividual PCBS/LANDING GEAR/LANDING GEAR.kicad_sch (2025-11-29)

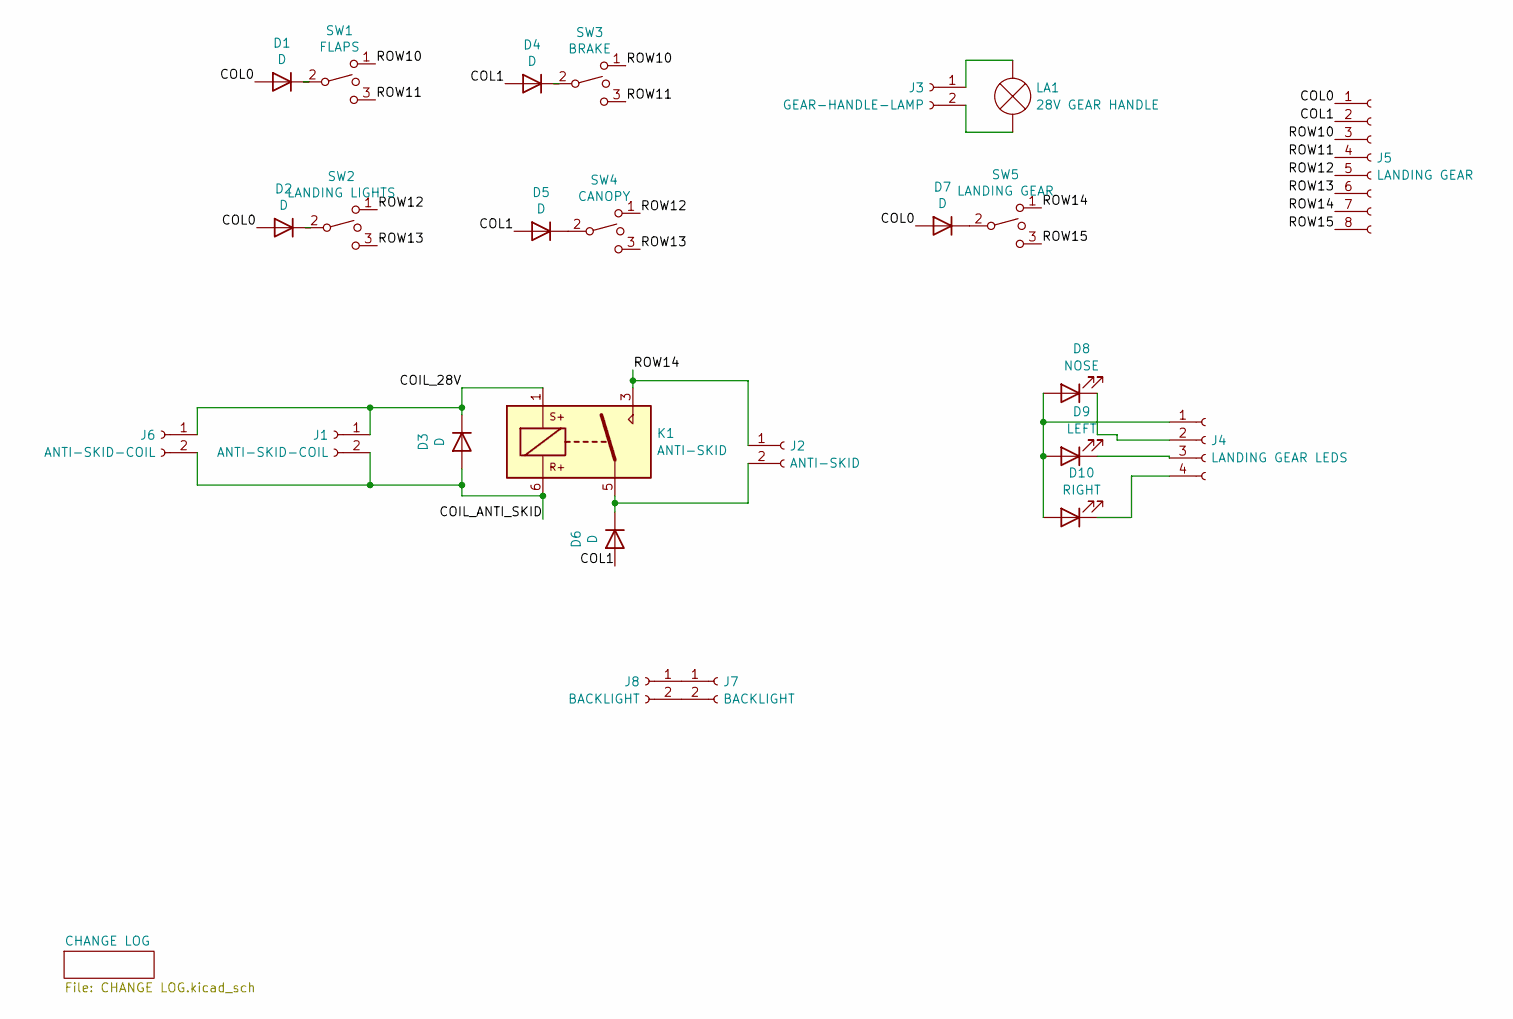
[picture p599: schematic LANDING GEAR.kicad_sch]

Parts:
D1, D2, D3, D4, D5, D6, D7: D; D_A-405_P2.54mm_Vertical_AnodeUp
D8: NOSE; Molex_KK-254_AE-6410-02A_1x02_P2.54mm_Vertical
D9: LEFT; Molex_KK-254_AE-6410-02A_1x02_P2.54mm_Vertical
D10: RIGHT; Molex_KK-254_AE-6410-02A_1x02_P2.54mm_Vertical
J1, J6: ANTI-SKID-COIL; Molex_KK-254_AE-6410-02A_1x02_P2.54mm_Vertical
J2: ANTI-SKID; Molex_KK-254_AE-6410-02A_1x02_P2.54mm_Vertical
J3: GEAR-HANDLE-LAMP; Molex_KK-254_AE-6410-02A_1x02_P2.54mm_Vertical
J4: LANDING GEAR LEDS; Molex_KK-254_AE-6410-04A_1x04_P2.54mm_Vertical
J5: LANDING GEAR; Molex_KK-254_AE-6410-08A_1x08_P2.54mm_Vertical
J7, J8: BACKLIGHT; Molex_KK-254_AE-6410-02A_1x02_P2.54mm_Vertical
K1: ANTI-SKID; Relay_1P1T_NO_10x24x18.8mm_Panasonic_ADW11xxxxW_THT
LA1: 28V GEAR HANDLE; Molex_KK-254_AE-6410-02A_1x02_P2.54mm_Vertical
SW1: FLAPS; Molex_KK-254_AE-6410-03A_1x03_P2.54mm_Vertical
SW2: LANDING LIGHTS; Molex_KK-254_AE-6410-03A_1x03_P2.54mm_Vertical
SW3: BRAKE; Molex_KK-254_AE-6410-03A_1x03_P2.54mm_Vertical
SW4: CANOPY; Molex_KK-254_AE-6410-03A_1x03_P2.54mm_Vertical
SW5: LANDING GEAR; Molex_KK-254_AE-6410-03A_1x03_P2.54mm_Vertical

Connections:
COIL_28V: D3.1 (K), J1.1, J6.1, K1.1
COIL_ANTI_SKID: D3.2 (A), J1.2, J6.2, K1.6
COL0: D1.2 (A), D2.2 (A), D7.2 (A), J5.1
COL1: D4.2 (A), D5.2 (A), D6.2 (A), J5.2
unnamed: D1.1 (K), SW1.2
unnamed: D2.1 (K), SW2.2
unnamed: D4.1 (K), SW3.2
unnamed: D5.1 (K), SW4.2
unnamed: D6.1 (K), J2.2, K1.5
unnamed: D7.1 (K), SW5.2
unnamed: D8.1 (K), J4.2
unnamed: D9.1 (K), J4.3
unnamed: D10.1 (K), J4.4
unnamed: D8.2 (A), D9.2 (A), D10.2 (A), J4.1
unnamed: J3.1, LA1.1 (-)
unnamed: J3.2, LA1.2 (+)
unnamed: J7.1, J8.1
unnamed: J7.2, J8.2
ROW10: J5.3, SW1.1, SW3.1
ROW11: J5.4, SW1.3, SW3.3
ROW12: J5.5, SW2.1, SW4.1
ROW13: J5.6, SW2.3, SW4.3
ROW14: J2.1, J5.7, K1.3, SW5.1
ROW15: J5.8, SW5.3
