bnepethomas/bne-arduino-flight-simulator-interfaces/A10/A10 PCBs/Forward Console Inidividual PCBS/MASTER ARM/MASTER ARM.kicad_sch

## KiCad design A10/A10 PCBs/Forward Console Inidividual PCBS/MASTER ARM/MASTER ARM.kicad_sch (2025-11-29)

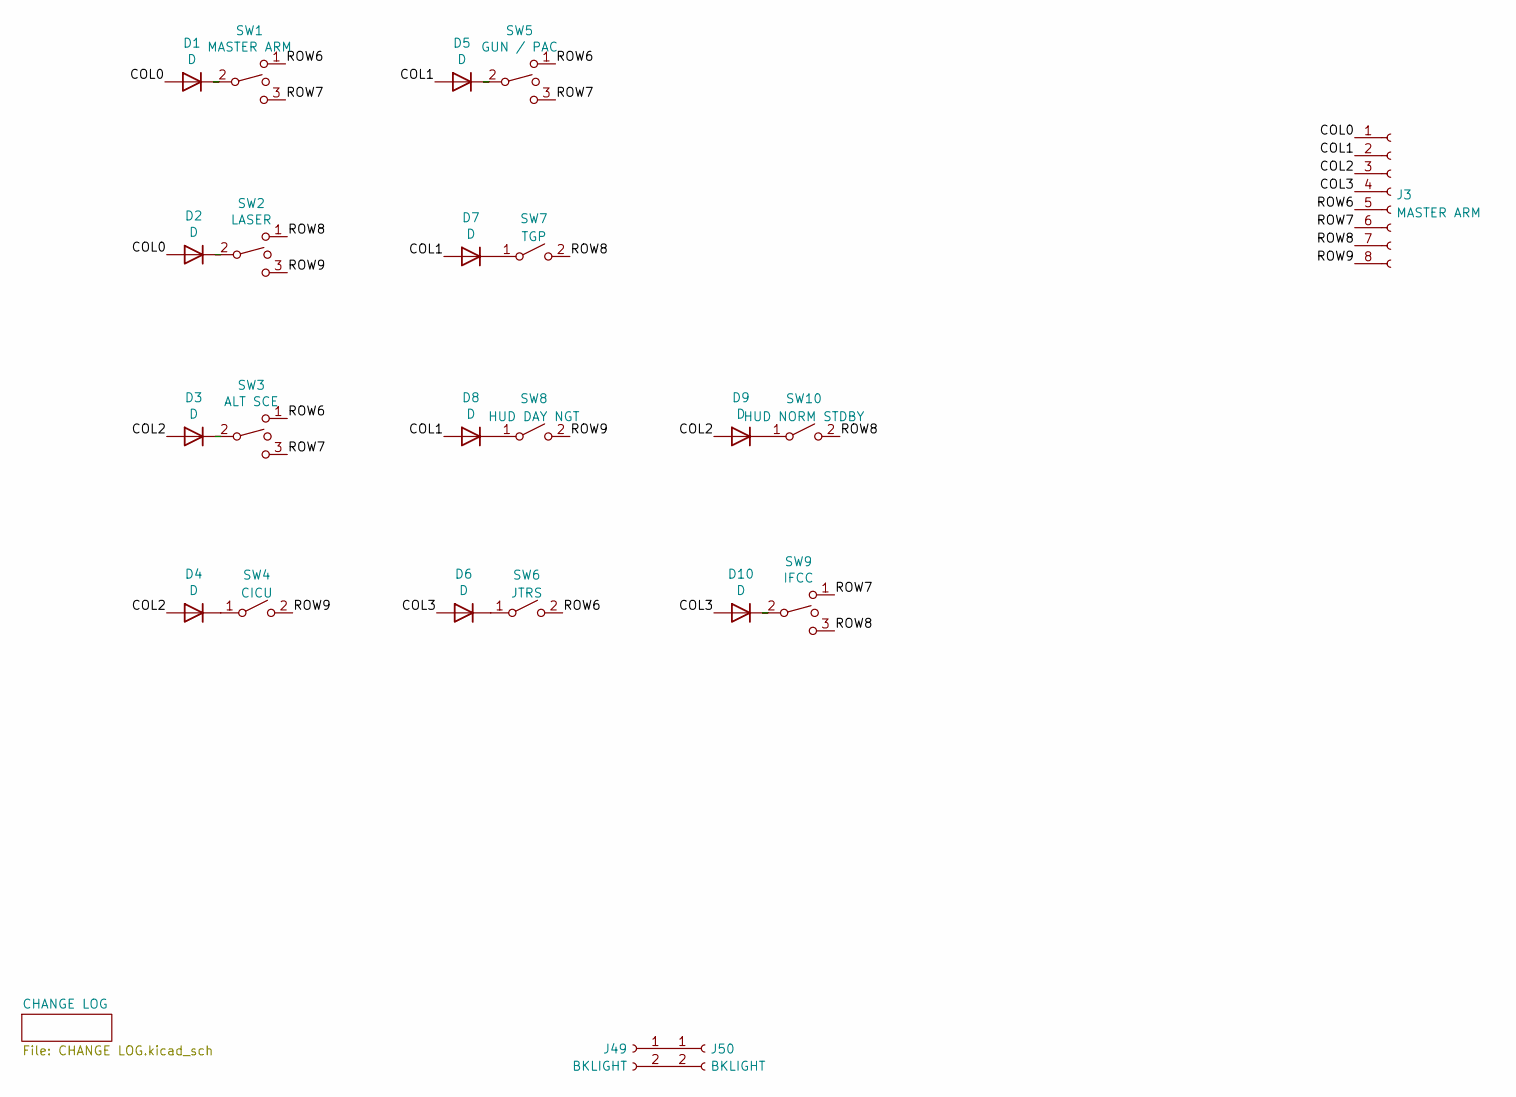
[picture p600: schematic MASTER ARM.kicad_sch]

Parts:
D1, D2, D3, D4, D5, D6, D7, D8, D9, D10: D; D_A-405_P2.54mm_Vertical_AnodeUp
J3: MASTER ARM; Molex_KK-254_AE-6410-08A_1x08_P2.54mm_Vertical
J49, J50: BKLIGHT; Molex_KK-254_AE-6410-02A_1x02_P2.54mm_Vertical
SW1: MASTER ARM; Molex_KK-254_AE-6410-03A_1x03_P2.54mm_Vertical
SW2: LASER; Molex_KK-254_AE-6410-03A_1x03_P2.54mm_Vertical
SW3: ALT SCE; Molex_KK-254_AE-6410-03A_1x03_P2.54mm_Vertical
SW4: CICU; Molex_KK-254_AE-6410-02A_1x02_P2.54mm_Vertical
SW5: GUN / PAC; Molex_KK-254_AE-6410-03A_1x03_P2.54mm_Vertical
SW6: JTRS; Molex_KK-254_AE-6410-02A_1x02_P2.54mm_Vertical
SW7: TGP; Molex_KK-254_AE-6410-02A_1x02_P2.54mm_Vertical
SW8: HUD DAY NGT; Molex_KK-254_AE-6410-02A_1x02_P2.54mm_Vertical
SW9: IFCC; Molex_KK-254_AE-6410-03A_1x03_P2.54mm_Vertical
SW10: HUD NORM STDBY; Molex_KK-254_AE-6410-02A_1x02_P2.54mm_Vertical

Connections:
COL0: D1.2 (A), D2.2 (A), J3.1
COL1: D5.2 (A), D7.2 (A), D8.2 (A), J3.2
COL2: D3.2 (A), D4.2 (A), D9.2 (A), J3.3
COL3: D6.2 (A), D10.2 (A), J3.4
unnamed: D1.1 (K), SW1.2
unnamed: D2.1 (K), SW2.2
unnamed: D3.1 (K), SW3.2
unnamed: D4.1 (K), SW4.1 (A)
unnamed: D5.1 (K), SW5.2
unnamed: D6.1 (K), SW6.1 (A)
unnamed: D7.1 (K), SW7.1 (A)
unnamed: D8.1 (K), SW8.1 (A)
unnamed: D9.1 (K), SW10.1 (A)
unnamed: D10.1 (K), SW9.2
unnamed: J49.1, J50.1
unnamed: J49.2, J50.2
ROW6: J3.5, SW1.1, SW3.1, SW5.1, SW6.2 (B)
ROW7: J3.6, SW1.3, SW3.3, SW5.3, SW9.1
ROW8: J3.7, SW2.1, SW7.2 (B), SW9.3, SW10.2 (B)
ROW9: J3.8, SW2.3, SW4.2 (B), SW8.2 (B)
