bnepethomas/bne-arduino-flight-simulator-interfaces/A10/A10 PCBs/Forward Console Inidividual PCBS/UFC/BACKLIGHTING.kicad_sch

## KiCad design A10/A10 PCBs/Forward Console Inidividual PCBS/UFC/BACKLIGHTING.kicad_sch (2025-11-29)

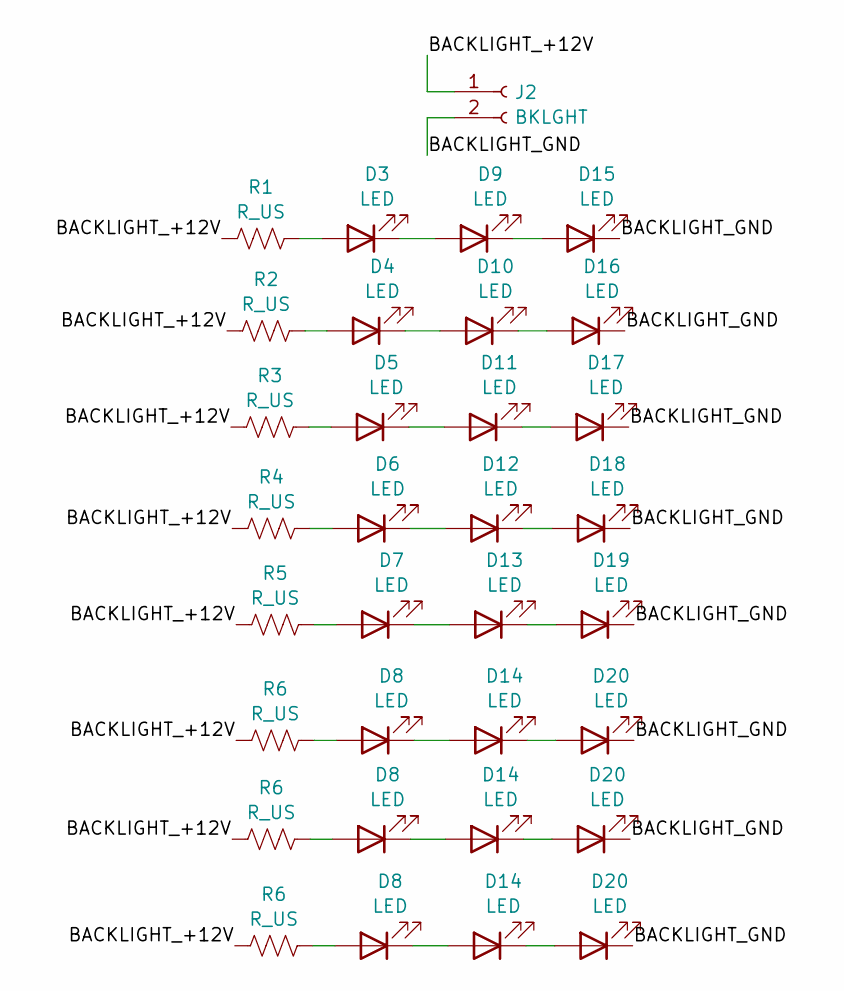
[picture p601: schematic BACKLIGHTING.kicad_sch]

Parts:
D3, D4, D5, D6, D7, D8, D9, D10, D11, D12, D13, D14, D15, D16, D17, D18, D19, D20: LED; LED_D3.0mm_FlatTop
J2: BKLGHT; Molex_KK-254_AE-6410-02A_1x02_P2.54mm_Vertical
R1, R2, R3, R4, R5, R6: R_US; R_Axial_DIN0207_L6.3mm_D2.5mm_P2.54mm_Vertical

Connections:
BACKLIGHT_+12V: J2.1, R1.1, R2.1, R3.1, R4.1, R5.1, R6.1
BACKLIGHT_GND: D15.1 (K), D16.1 (K), D17.1 (K), D18.1 (K), D19.1 (K), D20.1 (K), J2.2
unnamed: D3.1 (K), D9.2 (A)
unnamed: D3.2 (A), R1.2
unnamed: D4.2 (A), R2.2
unnamed: D5.2 (A), R3.2
unnamed: D6.2 (A), R4.2
unnamed: D7.2 (A), R5.2
unnamed: D8.2 (A), R6.2
unnamed: D10.1 (K), D16.2 (A)
unnamed: D4.1 (K), D10.2 (A)
unnamed: D11.1 (K), D17.2 (A)
unnamed: D5.1 (K), D11.2 (A)
unnamed: D12.1 (K), D18.2 (A)
unnamed: D6.1 (K), D12.2 (A)
unnamed: D13.1 (K), D19.2 (A)
unnamed: D7.1 (K), D13.2 (A)
unnamed: D14.1 (K), D20.2 (A)
unnamed: D8.1 (K), D14.2 (A)
unnamed: D9.1 (K), D15.2 (A)
