bnepethomas/bne-arduino-flight-simulator-interfaces/A10/A10 PCBs/Forward Console Inidividual PCBS/UFC/UFC.kicad_sch

## KiCad design A10/A10 PCBs/Forward Console Inidividual PCBS/UFC/UFC.kicad_sch (2025-11-29)

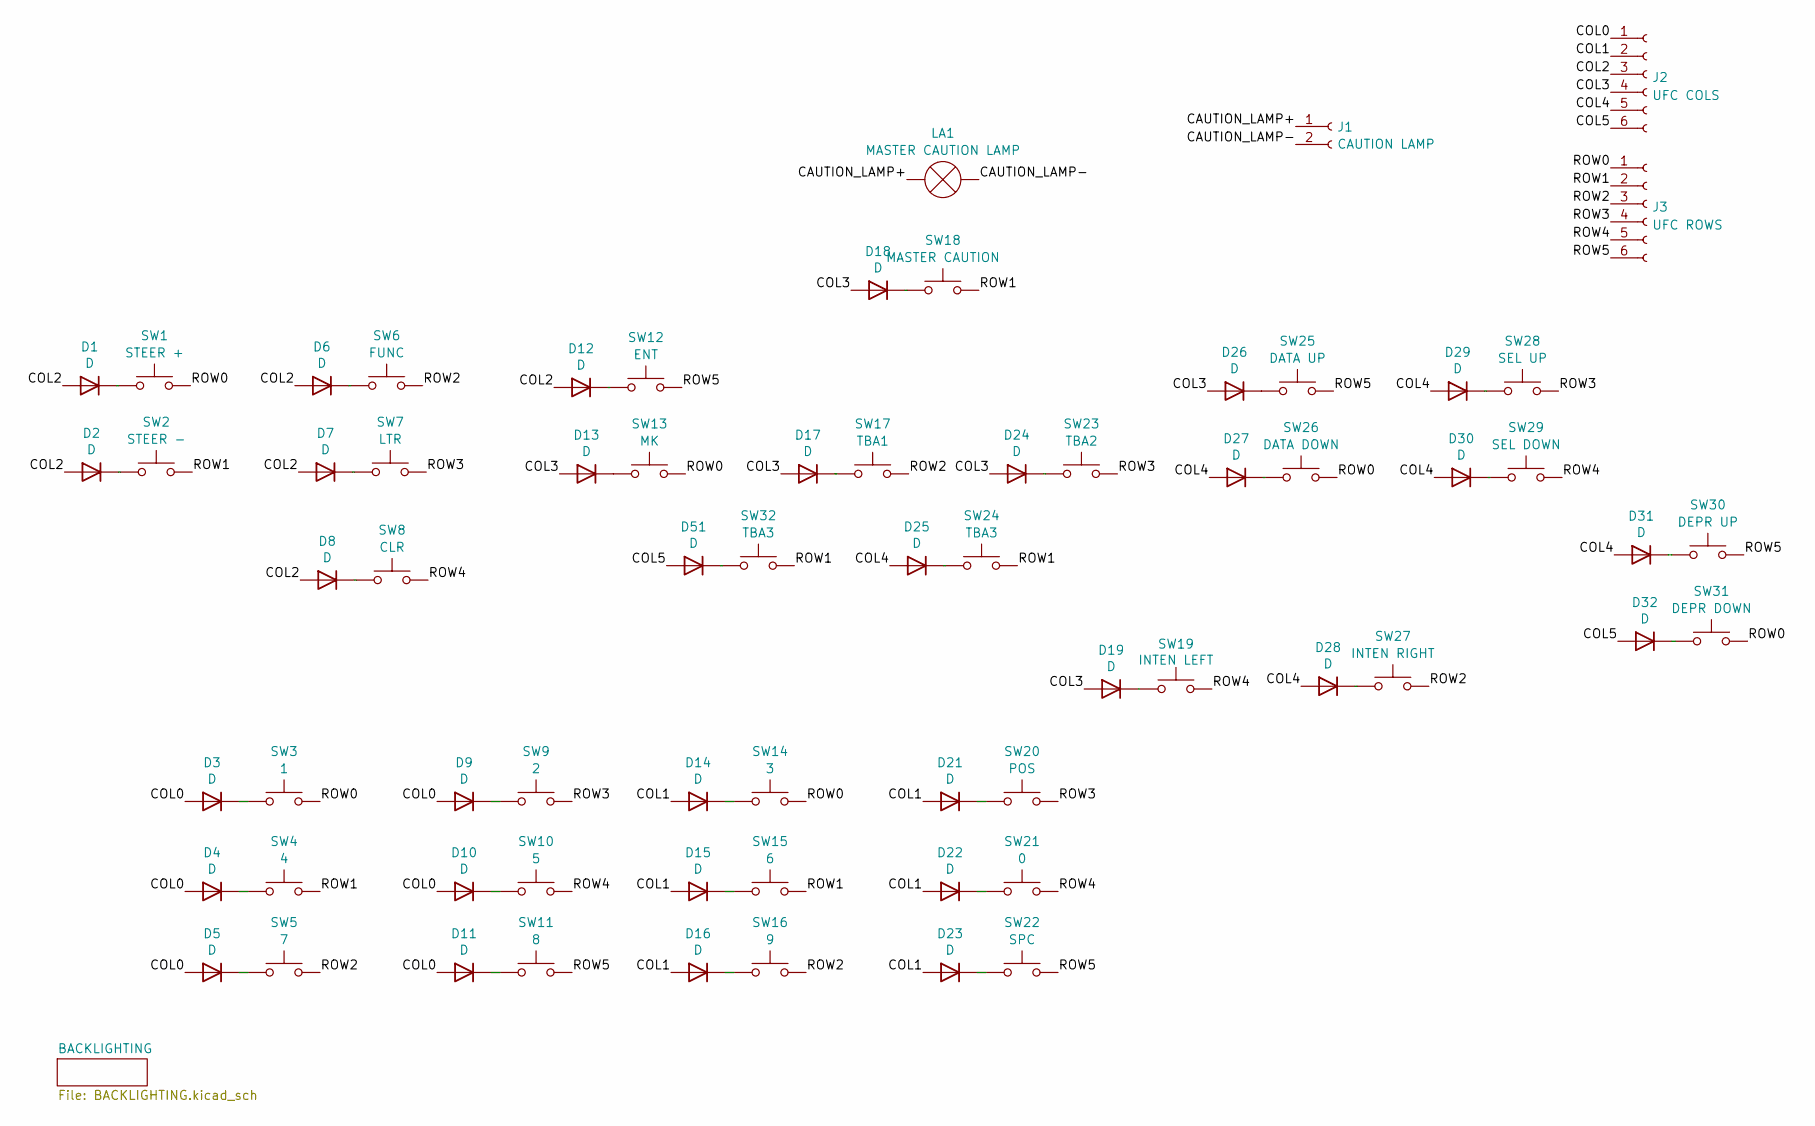
[picture p602: schematic UFC.kicad_sch]

Parts:
D1, D2, D3, D4, D5, D6, D7, D8, D9, D10, D11, D12, D13, D14, D15, D16, D17, D18, D19, D21, D22, D23, D24, D25, D26, D27, D28, D29, D30, D31, D32, D51: D; D_A-405_P2.54mm_Vertical_AnodeUp
J1: CAUTION LAMP; Molex_KK-254_AE-6410-02A_1x02_P2.54mm_Vertical
J2: UFC COLS; Molex_KK-254_AE-6410-06A_1x06_P2.54mm_Vertical
J3: UFC ROWS; Molex_KK-254_AE-6410-06A_1x06_P2.54mm_Vertical
LA1: MASTER CAUTION LAMP; Molex_KK-254_AE-6410-02A_1x02_P2.54mm_Vertical
SW1: STEER +; SW_PUSH-12mm
SW2: STEER -; SW_PUSH-12mm
SW3: 1; SW_PUSH-12mm
SW4: 4; SW_PUSH-12mm
SW5: 7; SW_PUSH-12mm
SW6: FUNC; SW_PUSH-12mm
SW7: LTR; SW_PUSH-12mm
SW8: CLR; SW_PUSH-12mm
SW9: 2; SW_PUSH-12mm
SW10: 5; SW_PUSH-12mm
SW11: 8; SW_PUSH-12mm
SW12: ENT; SW_PUSH-12mm
SW13: MK; SW_PUSH-12mm
SW14: 3; SW_PUSH-12mm
SW15: 6; SW_PUSH-12mm
SW16: 9; SW_PUSH-12mm
SW17: TBA1; SW_PUSH-12mm
SW18: MASTER CAUTION; Molex_KK-254_AE-6410-02A_1x02_P2.54mm_Vertical
SW19: INTEN LEFT; SW_PUSH-12mm
SW20: POS; SW_PUSH-12mm
SW21: 0; SW_PUSH-12mm
SW22: SPC; SW_PUSH-12mm
SW23: TBA2; SW_PUSH-12mm
SW24, SW32: TBA3; SW_PUSH-12mm
SW25: DATA UP; SW_PUSH-12mm
SW26: DATA DOWN; SW_PUSH-12mm
SW27: INTEN RIGHT; SW_PUSH-12mm
SW28: SEL UP; SW_PUSH-12mm
SW29: SEL DOWN; SW_PUSH-12mm
SW30: DEPR UP; SW_PUSH-12mm
SW31: DEPR DOWN; SW_PUSH-12mm

Connections:
CAUTION_LAMP+: J1.1, LA1.2 (+)
CAUTION_LAMP-: J1.2, LA1.1 (-)
COL0: D3.2 (A), D4.2 (A), D5.2 (A), D9.2 (A), D10.2 (A), D11.2 (A), J2.1
COL1: D14.2 (A), D15.2 (A), D16.2 (A), D21.2 (A), D22.2 (A), D23.2 (A), J2.2
COL2: D1.2 (A), D2.2 (A), D6.2 (A), D7.2 (A), D8.2 (A), D12.2 (A), J2.3
COL3: D13.2 (A), D17.2 (A), D18.2 (A), D19.2 (A), D24.2 (A), D26.2 (A), J2.4
COL4: D25.2 (A), D27.2 (A), D28.2 (A), D29.2 (A), D30.2 (A), D31.2 (A), J2.5
COL5: D32.2 (A), D51.2 (A), J2.6
unnamed: D1.1 (K), SW1.1
unnamed: D2.1 (K), SW2.1
unnamed: D3.1 (K), SW3.1
unnamed: D4.1 (K), SW4.1
unnamed: D5.1 (K), SW5.1
unnamed: D6.1 (K), SW6.1
unnamed: D7.1 (K), SW7.1
unnamed: D8.1 (K), SW8.1
unnamed: D9.1 (K), SW9.1
unnamed: D10.1 (K), SW10.1
unnamed: D11.1 (K), SW11.1
unnamed: D12.1 (K), SW12.1
unnamed: D13.1 (K), SW13.1
unnamed: D14.1 (K), SW14.1
unnamed: D15.1 (K), SW15.1
unnamed: D16.1 (K), SW16.1
unnamed: D17.1 (K), SW17.1
unnamed: D18.1 (K), SW18.1
unnamed: D19.1 (K), SW19.1
unnamed: D21.1 (K), SW20.1
unnamed: D22.1 (K), SW21.1
unnamed: D23.1 (K), SW22.1
unnamed: D24.1 (K), SW23.1
unnamed: D25.1 (K), SW24.1
unnamed: D26.1 (K), SW25.1
unnamed: D27.1 (K), SW26.1
unnamed: D28.1 (K), SW27.1
unnamed: D29.1 (K), SW28.1
unnamed: D30.1 (K), SW29.1
unnamed: D31.1 (K), SW30.1
unnamed: D32.1 (K), SW31.1
unnamed: D51.1 (K), SW32.1
ROW0: J3.1, SW1.2, SW3.2, SW13.2, SW14.2, SW26.2, SW31.2
ROW1: J3.2, SW2.2, SW4.2, SW15.2, SW18.2, SW24.2, SW32.2
ROW2: J3.3, SW5.2, SW6.2, SW16.2, SW17.2, SW27.2
ROW3: J3.4, SW7.2, SW9.2, SW20.2, SW23.2, SW28.2
ROW4: J3.5, SW8.2, SW10.2, SW19.2, SW21.2, SW29.2
ROW5: J3.6, SW11.2, SW12.2, SW22.2, SW25.2, SW30.2
