bnepethomas/bne-arduino-flight-simulator-interfaces/A10/A10 PCBs/Right Console Individual PCBs/CDU/CDU.kicad_sch

## KiCad design A10/A10 PCBs/Right Console Individual PCBs/CDU/CDU.kicad_sch (2025-11-29)

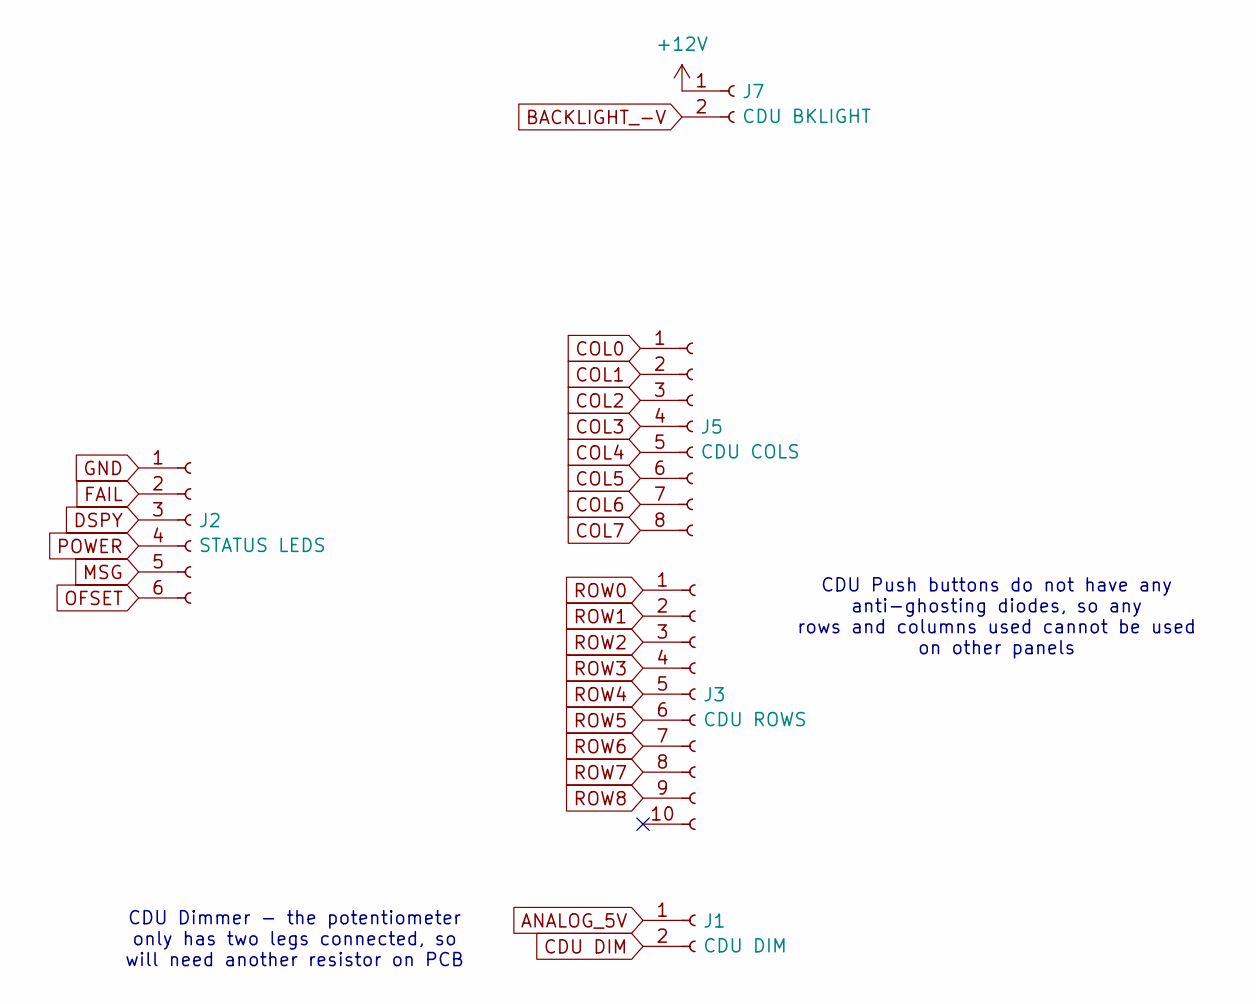
[picture p603: schematic CDU.kicad_sch]

Parts:
J1: CDU DIM
J2: STATUS LEDS
J3: CDU ROWS
J5: CDU COLS
J7: CDU BKLIGHT

Connections:
+12V: J7.1
ANALOG_5V: J1.1
BACKLIGHT_-V: J7.2
CDU DIM: J1.2
COL0: J5.1
COL1: J5.2
COL2: J5.3
COL3: J5.4
COL4: J5.5
COL5: J5.6
COL6: J5.7
COL7: J5.8
DSPY: J2.3
FAIL: J2.2
GND: J2.1
MSG: J2.5
OFSET: J2.6
POWER: J2.4
ROW0: J3.1
ROW1: J3.2
ROW2: J3.3
ROW3: J3.4
ROW4: J3.5
ROW5: J3.6
ROW6: J3.7
ROW7: J3.8
ROW8: J3.9

Notes on the sheet:
CDU Push buttons do not have any anti-ghosting diodes, so any rows and columns used cannot be used on other panels
CDU Dimmer - the potentiometer only has two legs connected, so will need another resistor on PCB
