bnepethomas/bne-arduino-flight-simulator-interfaces/A10/A10 PCBs/Right Console Individual PCBs/EWS/EWS.kicad_sch

## KiCad design A10/A10 PCBs/Right Console Individual PCBs/EWS/EWS.kicad_sch (2025-11-29)

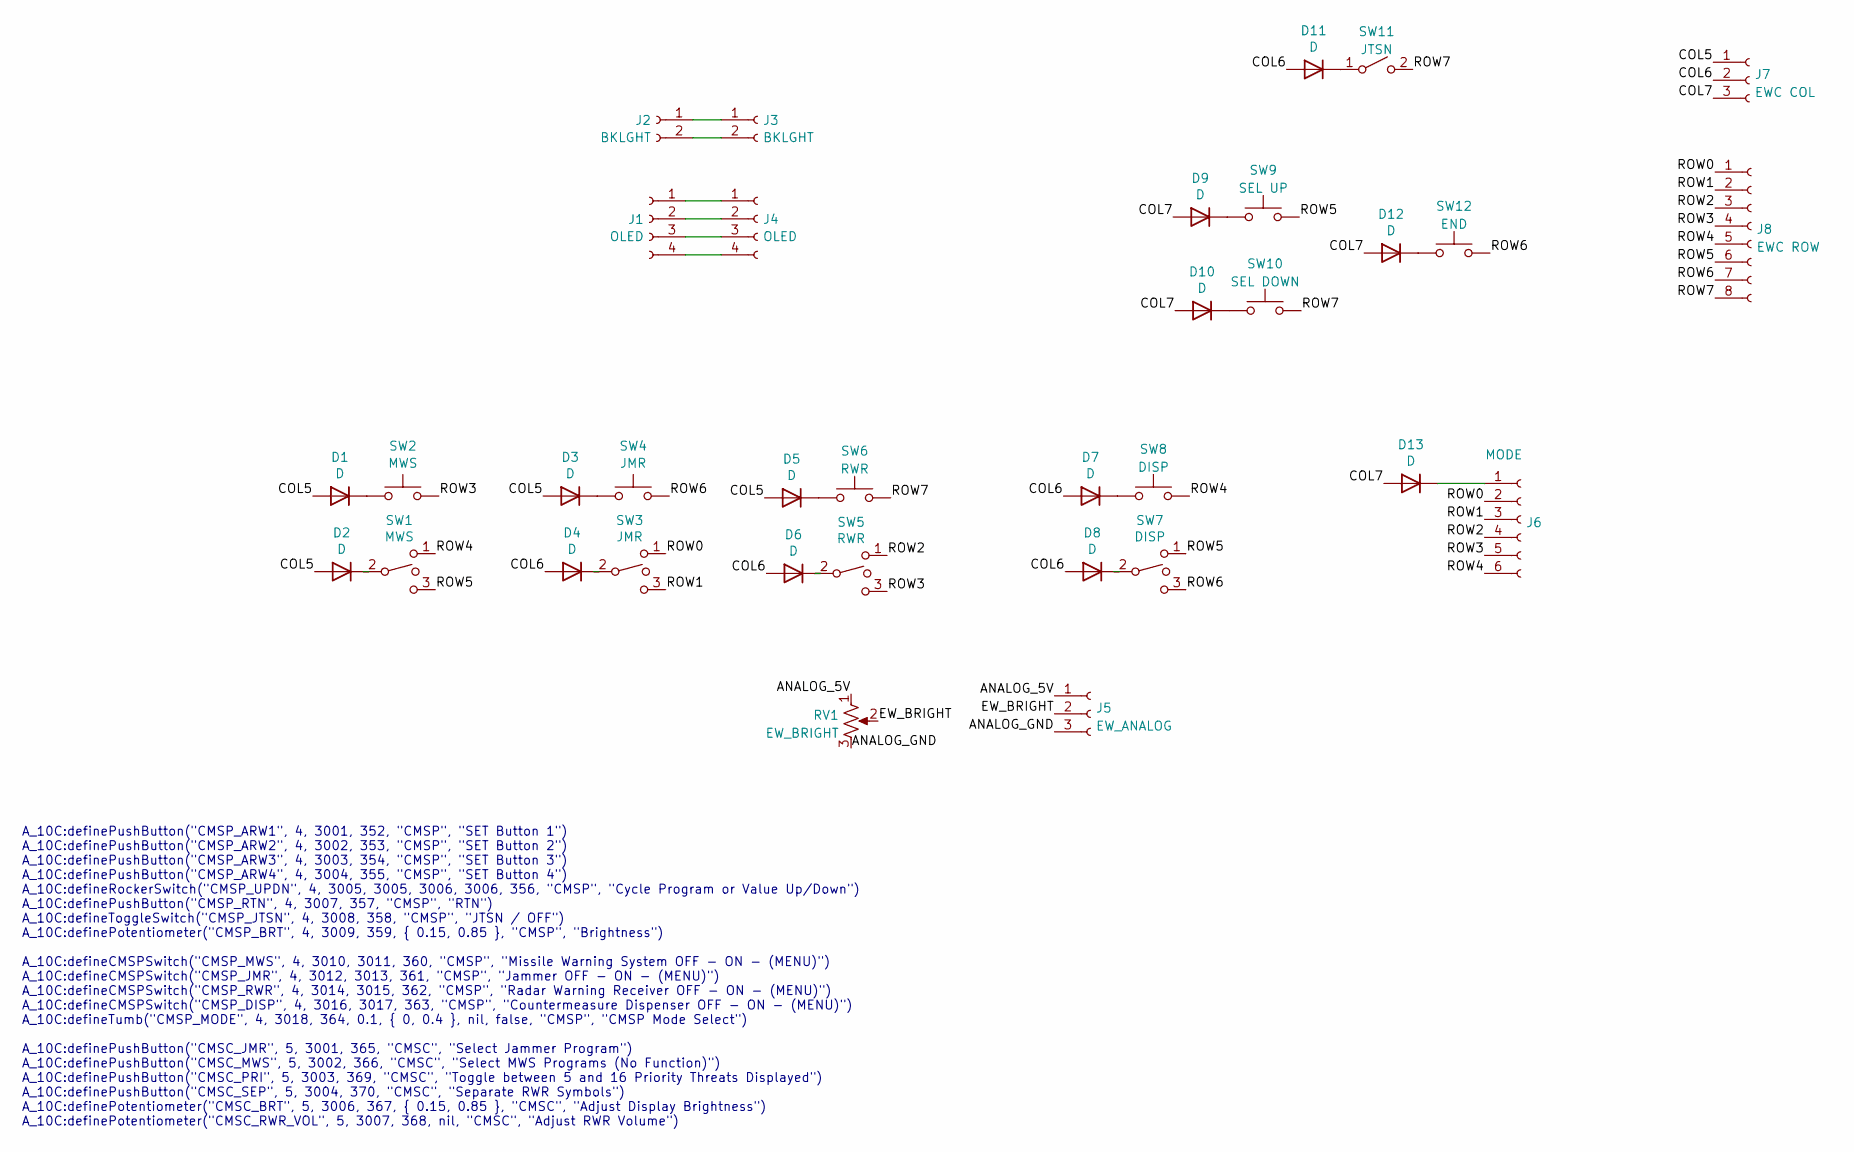
[picture p605: schematic EWS.kicad_sch]

Parts:
D1, D2, D3, D4, D5, D6, D7, D8, D9, D10, D11, D12, D13: D; D_A-405_P2.54mm_Vertical_AnodeUp
J1, J4: OLED; Molex_KK-254_AE-6410-04A_1x04_P2.54mm_Vertical
J2, J3: BKLGHT; Molex_KK-254_AE-6410-02A_1x02_P2.54mm_Vertical
J5: EW_ANALOG; Molex_KK-254_AE-6410-03A_1x03_P2.54mm_Vertical
J6: MODE; Molex_KK-254_AE-6410-06A_1x06_P2.54mm_Vertical
J7: EWC COL; Molex_KK-254_AE-6410-03A_1x03_P2.54mm_Vertical
J8: EWC ROW; Molex_KK-254_AE-6410-08A_1x08_P2.54mm_Vertical
RV1: EW_BRIGHT; Molex_KK-254_AE-6410-03A_1x03_P2.54mm_Vertical
SW1: MWS; Molex_KK-254_AE-6410-03A_1x03_P2.54mm_Vertical
SW2: MWS; Molex_KK-254_AE-6410-02A_1x02_P2.54mm_Vertical
SW3: JMR; Molex_KK-254_AE-6410-03A_1x03_P2.54mm_Vertical
SW4: JMR; Molex_KK-254_AE-6410-02A_1x02_P2.54mm_Vertical
SW5: RWR; Molex_KK-254_AE-6410-03A_1x03_P2.54mm_Vertical
SW6: RWR; Molex_KK-254_AE-6410-02A_1x02_P2.54mm_Vertical
SW7: DISP; Molex_KK-254_AE-6410-03A_1x03_P2.54mm_Vertical
SW8: DISP; Molex_KK-254_AE-6410-02A_1x02_P2.54mm_Vertical
SW9: SEL UP; Molex_KK-254_AE-6410-02A_1x02_P2.54mm_Vertical
SW10: SEL DOWN; Molex_KK-254_AE-6410-02A_1x02_P2.54mm_Vertical
SW11: JTSN; Molex_KK-254_AE-6410-02A_1x02_P2.54mm_Vertical
SW12: END; Molex_KK-254_AE-6410-02A_1x02_P2.54mm_Vertical

Connections:
ANALOG_5V: J5.1, RV1.1
ANALOG_GND: J5.3, RV1.3
COL5: D1.2 (A), D2.2 (A), D3.2 (A), D5.2 (A), J7.1
COL6: D4.2 (A), D6.2 (A), D7.2 (A), D8.2 (A), D11.2 (A), J7.2
COL7: D9.2 (A), D10.2 (A), D12.2 (A), D13.2 (A), J7.3
EW_BRIGHT: J5.2, RV1.2
unnamed: D1.1 (K), SW2.1
unnamed: D2.1 (K), SW1.2
unnamed: D3.1 (K), SW4.1
unnamed: D4.1 (K), SW3.2
unnamed: D5.1 (K), SW6.1
unnamed: D6.1 (K), SW5.2
unnamed: D7.1 (K), SW8.1
unnamed: D8.1 (K), SW7.2
unnamed: D9.1 (K), SW9.1
unnamed: D10.1 (K), SW10.1
unnamed: D11.1 (K), SW11.1 (A)
unnamed: D12.1 (K), SW12.1
unnamed: D13.1 (K), J6.1
unnamed: J1.1, J4.1
unnamed: J1.2, J4.2
unnamed: J1.3, J4.3
unnamed: J1.4, J4.4
unnamed: J2.1, J3.1
unnamed: J2.2, J3.2
ROW0: J6.2, J8.1, SW3.1
ROW1: J6.3, J8.2, SW3.3
ROW2: J6.4, J8.3, SW5.1
ROW3: J6.5, J8.4, SW2.2, SW5.3
ROW4: J6.6, J8.5, SW1.1, SW8.2
ROW5: J8.6, SW1.3, SW7.1, SW9.2
ROW6: J8.7, SW4.2, SW7.3, SW12.2
ROW7: J8.8, SW6.2, SW10.2, SW11.2 (B)

Notes on the sheet:
A_10C:definePushButton("CMSP_ARW1", 4, 3001, 352, "CMSP", "SET Button 1") A_10C:definePushButton("CMSP_ARW2", 4, 3002, 353, "CMSP", "SET Button 2") A_10C:definePushButton("CMSP_ARW3", 4, 3003, 354, "CMSP", "SET Button 3") A_10C:definePushButton("CMSP_ARW4", 4, 3004, 355, "CMSP", "SET Button 4") A_1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
