bnepethomas/bne-arduino-flight-simulator-interfaces/A10/A10 PCBs/Right Console Individual PCBs/Fuel Panel/Fuel Panel.kicad_sch

## KiCad design A10/A10 PCBs/Right Console Individual PCBs/Fuel Panel/Fuel Panel.kicad_sch (2025-11-29)

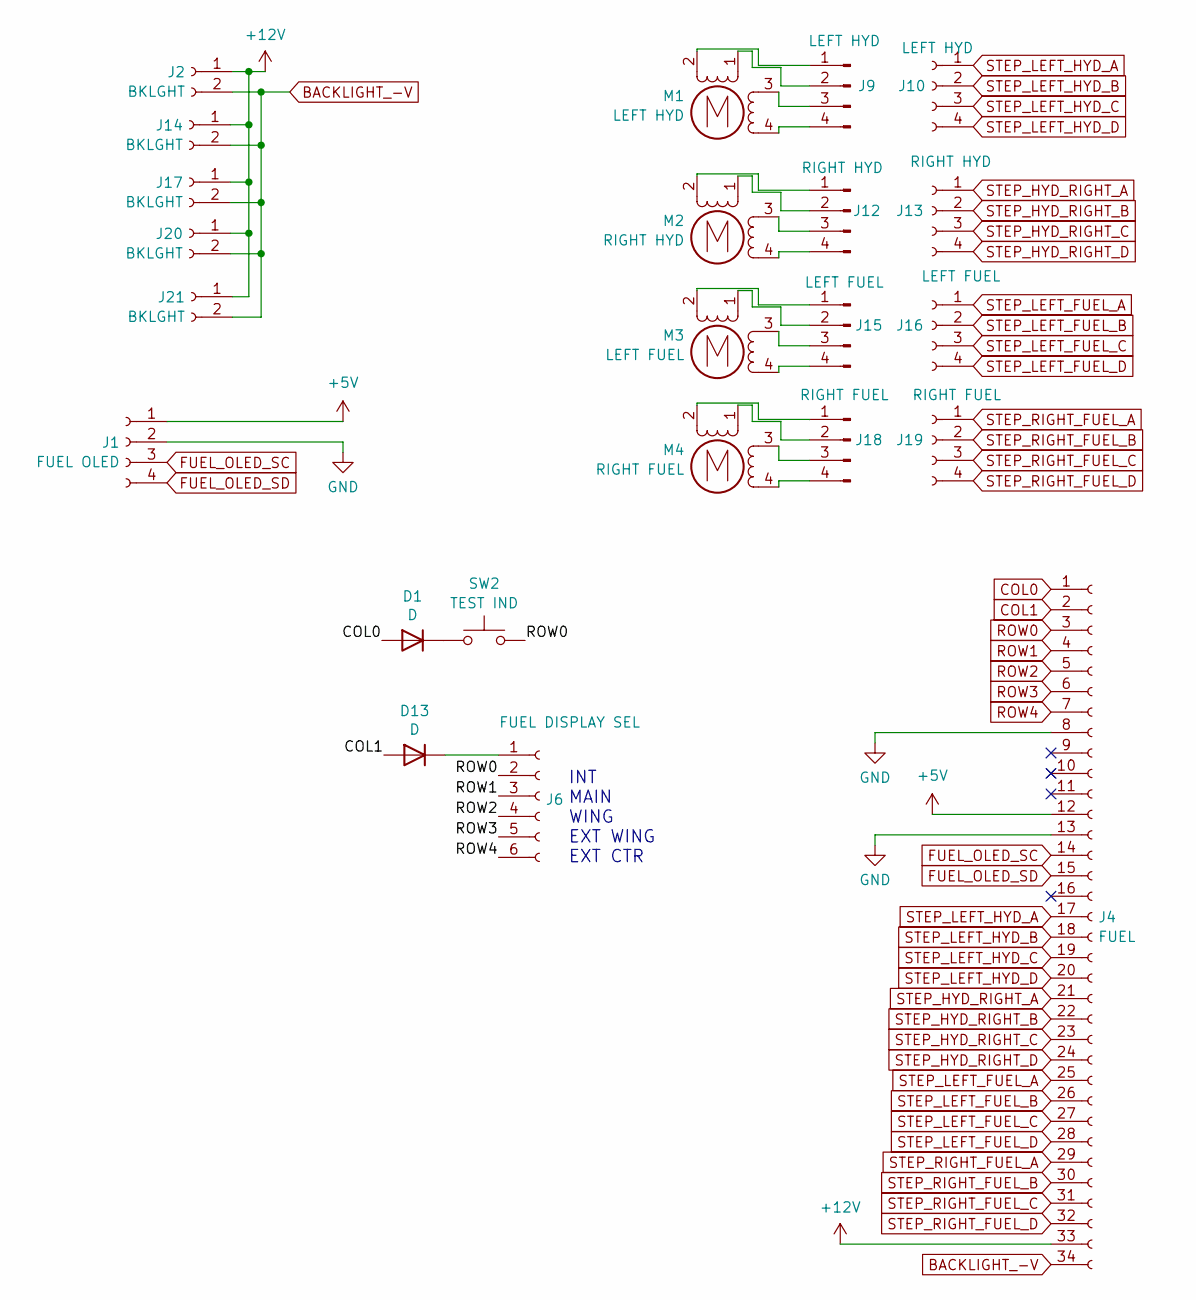
[picture p606: schematic Fuel Panel.kicad_sch]

Parts:
D1, D13: D; D_DO-35_SOD27_P7.62mm_Horizontal
J1: FUEL OLED; Molex_KK-254_AE-6410-04A_1x04_P2.54mm_Vertical
J2, J14, J17, J20, J21: BKLGHT; Molex_KK-254_AE-6410-02A_1x02_P2.54mm_Vertical
J4: FUEL; IDC-Header_2x17_P2.54mm_Vertical
J6: FUEL DISPLAY SEL; Molex_KK-254_AE-6410-06A_1x06_P2.54mm_Vertical
J9: LEFT HYD
J10: LEFT HYD; Molex_KK-254_AE-6410-04A_1x04_P2.54mm_Vertical
J12: RIGHT HYD
J13: RIGHT HYD; Molex_KK-254_AE-6410-04A_1x04_P2.54mm_Vertical
J15: LEFT FUEL
J16: LEFT FUEL; Molex_KK-254_AE-6410-04A_1x04_P2.54mm_Vertical
J18: RIGHT FUEL
J19: RIGHT FUEL; Molex_KK-254_AE-6410-04A_1x04_P2.54mm_Vertical
M1: LEFT HYD
M2: RIGHT HYD
M3: LEFT FUEL
M4: RIGHT FUEL
SW2: TEST IND; Molex_KK-254_AE-6410-02A_1x02_P2.54mm_Vertical

Connections:
+5V: J1.1, J4.12
+12V: J2.1, J4.33, J14.1, J17.1, J20.1, J21.1
BACKLIGHT_-V: J2.2, J4.34, J14.2, J17.2, J20.2, J21.2
COL0: D1.2 (A), J4.1
COL1: D13.2 (A), J4.2
FUEL_OLED_SC: J1.3, J4.14
FUEL_OLED_SD: J1.4, J4.15
GND: J1.2, J4.8, J4.13
unnamed: D1.1 (K), SW2.1
unnamed: D13.1 (K), J6.1
unnamed: J9.1, M1.2 (-)
unnamed: J9.2, M1.1
unnamed: J9.3, M1.3
unnamed: J9.4, M1.4
unnamed: J12.1, M2.2 (-)
unnamed: J12.2, M2.1
unnamed: J12.3, M2.3
unnamed: J12.4, M2.4
unnamed: J15.1, M3.2 (-)
unnamed: J15.2, M3.1
unnamed: J15.3, M3.3
unnamed: J15.4, M3.4
unnamed: J18.1, M4.2 (-)
unnamed: J18.2, M4.1
unnamed: J18.3, M4.3
unnamed: J18.4, M4.4
ROW0: J4.3, J6.2, SW2.2
ROW1: J4.4, J6.3
ROW2: J4.5, J6.4
ROW3: J4.6, J6.5
ROW4: J4.7, J6.6
STEP_HYD_RIGHT_A: J4.21, J13.1
STEP_HYD_RIGHT_B: J4.22, J13.2
STEP_HYD_RIGHT_C: J4.23, J13.3
STEP_HYD_RIGHT_D: J4.24, J13.4
STEP_LEFT_FUEL_A: J4.25, J16.1
STEP_LEFT_FUEL_B: J4.26, J16.2
STEP_LEFT_FUEL_C: J4.27, J16.3
STEP_LEFT_FUEL_D: J4.28, J16.4
STEP_LEFT_HYD_A: J4.17, J10.1
STEP_LEFT_HYD_B: J4.18, J10.2
STEP_LEFT_HYD_C: J4.19, J10.3
STEP_LEFT_HYD_D: J4.20, J10.4
STEP_RIGHT_FUEL_A: J4.29, J19.1
STEP_RIGHT_FUEL_B: J4.30, J19.2
STEP_RIGHT_FUEL_C: J4.31, J19.3
STEP_RIGHT_FUEL_D: J4.32, J19.4

Notes on the sheet:
INT MAIN WING EXT WING EXT CTR
