bnepethomas/bne-arduino-flight-simulator-interfaces/F16/F16 PCBs/AIC/AIC Auxcomm/AIC Auxcomm.kicad_sch

## KiCad design F16/F16 PCBs/AIC/AIC Auxcomm/AIC Auxcomm.kicad_sch (2025-11-29)

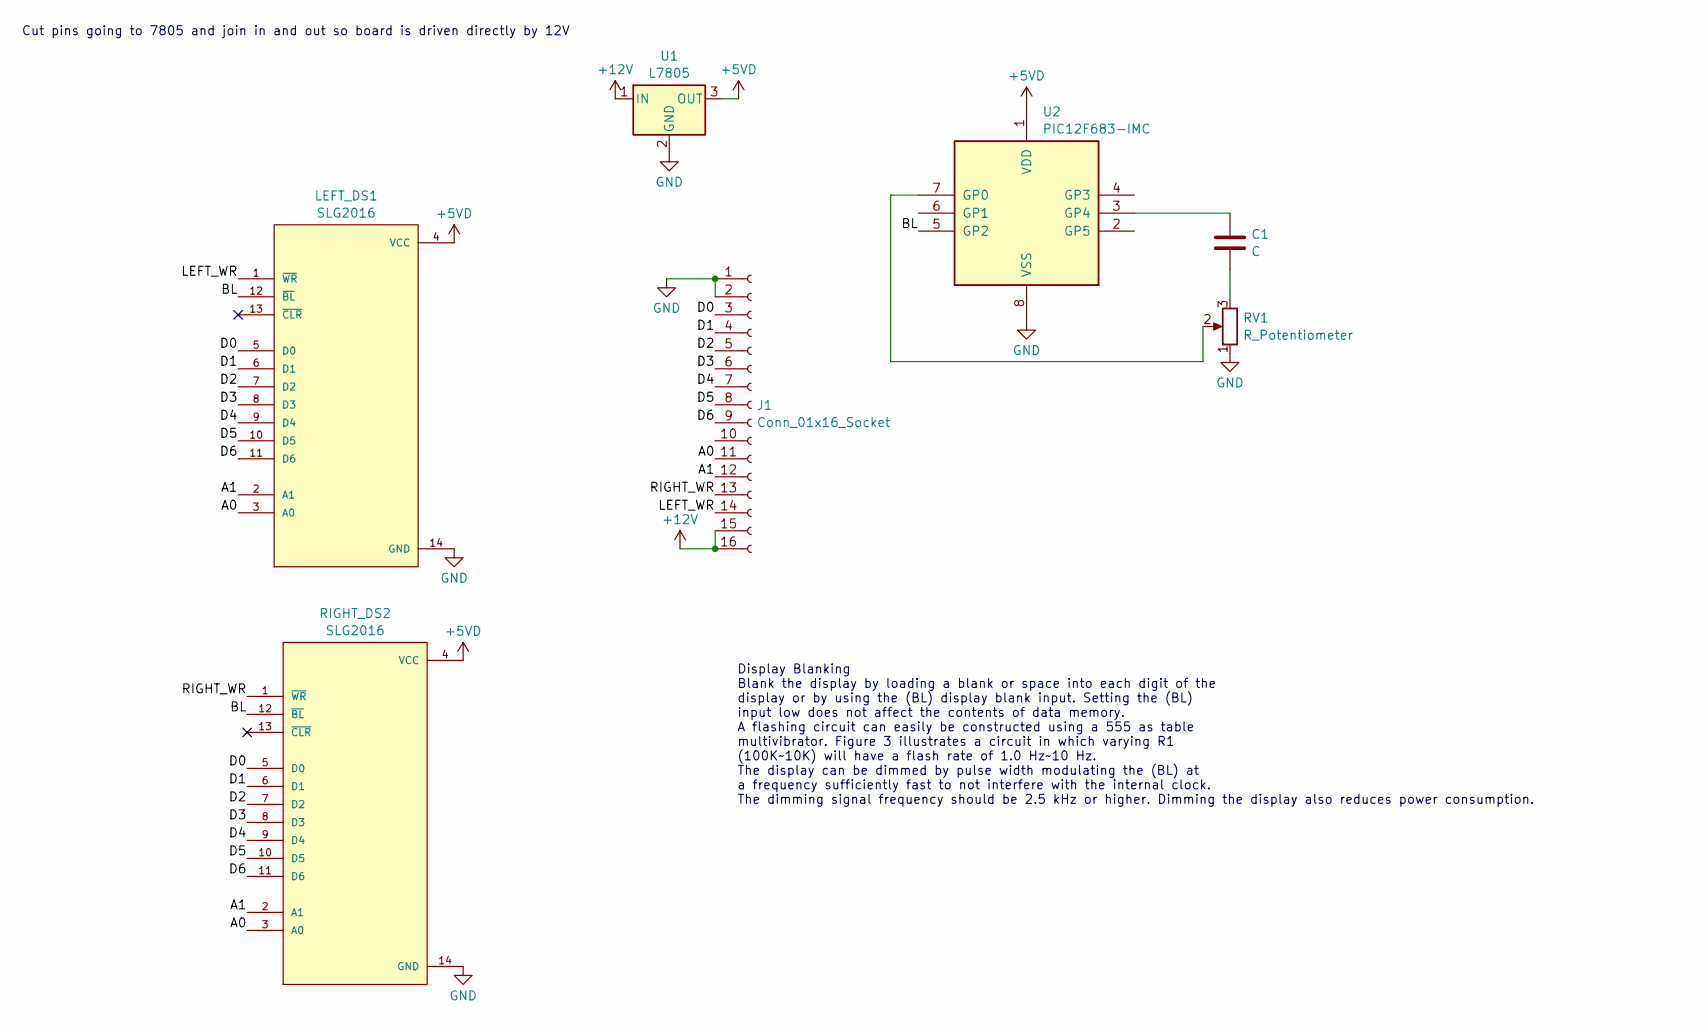
[picture p607: schematic AIC Auxcomm.kicad_sch]

Parts:
C1: C
J1: Conn_01x16_Socket
LEFT_DS1: SLG2016; LED_SLG2016
RIGHT_DS2: SLG2016; LED_SLG2016
RV1: R_Potentiometer
U1: L7805
U2: PIC12F683-IMC; DIP-8_W7.62mm

Connections:
+5VD: LEFT_DS1.4 (VCC), RIGHT_DS2.4 (VCC), U1.3 (OUT), U2.1 (VDD)
+12V: J1.15, J1.16, U1.1 (IN)
A0: J1.11, LEFT_DS1.3 (A0), RIGHT_DS2.3 (A0)
A1: J1.12, LEFT_DS1.2 (A1), RIGHT_DS2.2 (A1)
BL: LEFT_DS1.12 (~BL), RIGHT_DS2.12 (~BL), U2.5 (GP2)
D0: J1.3, LEFT_DS1.5 (D0), RIGHT_DS2.5 (D0)
D1: J1.4, LEFT_DS1.6 (D1), RIGHT_DS2.6 (D1)
D2: J1.5, LEFT_DS1.7 (D2), RIGHT_DS2.7 (D2)
D3: J1.6, LEFT_DS1.8 (D3), RIGHT_DS2.8 (D3)
D4: J1.7, LEFT_DS1.9 (D4), RIGHT_DS2.9 (D4)
D5: J1.8, LEFT_DS1.10 (D5), RIGHT_DS2.10 (D5)
D6: J1.9, LEFT_DS1.11 (D6), RIGHT_DS2.11 (D6)
GND: J1.1, J1.2, LEFT_DS1.14 (GND), RIGHT_DS2.14 (GND), RV1.1, U1.2 (GND), U2.8 (VSS)
LEFT_WR: J1.14, LEFT_DS1.1 (~WR)
unnamed: C1.1, U2.3 (GP4)
unnamed: C1.2, RV1.3
unnamed: RV1.2, U2.7 (GP0)
RIGHT_WR: J1.13, RIGHT_DS2.1 (~WR)

Notes on the sheet:
Cut pins going to 7805 and join in and out so board is driven directly by 12V
Display Blanking Blank the display by loading a blank or space into each digit of the display or by using the (BL) display blank input. Setting the (BL) input low does not affect the contents of data memory. A flashing circuit can easily be constructed using a 555 as table multivibrator. Figure 3 i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
