bnepethomas/bne-arduino-flight-simulator-interfaces/F16/F16 PCBs/AIC/AIC CMDS/AIC CMDS.kicad_sch

## KiCad design F16/F16 PCBs/AIC/AIC CMDS/AIC CMDS.kicad_sch (2025-11-29)

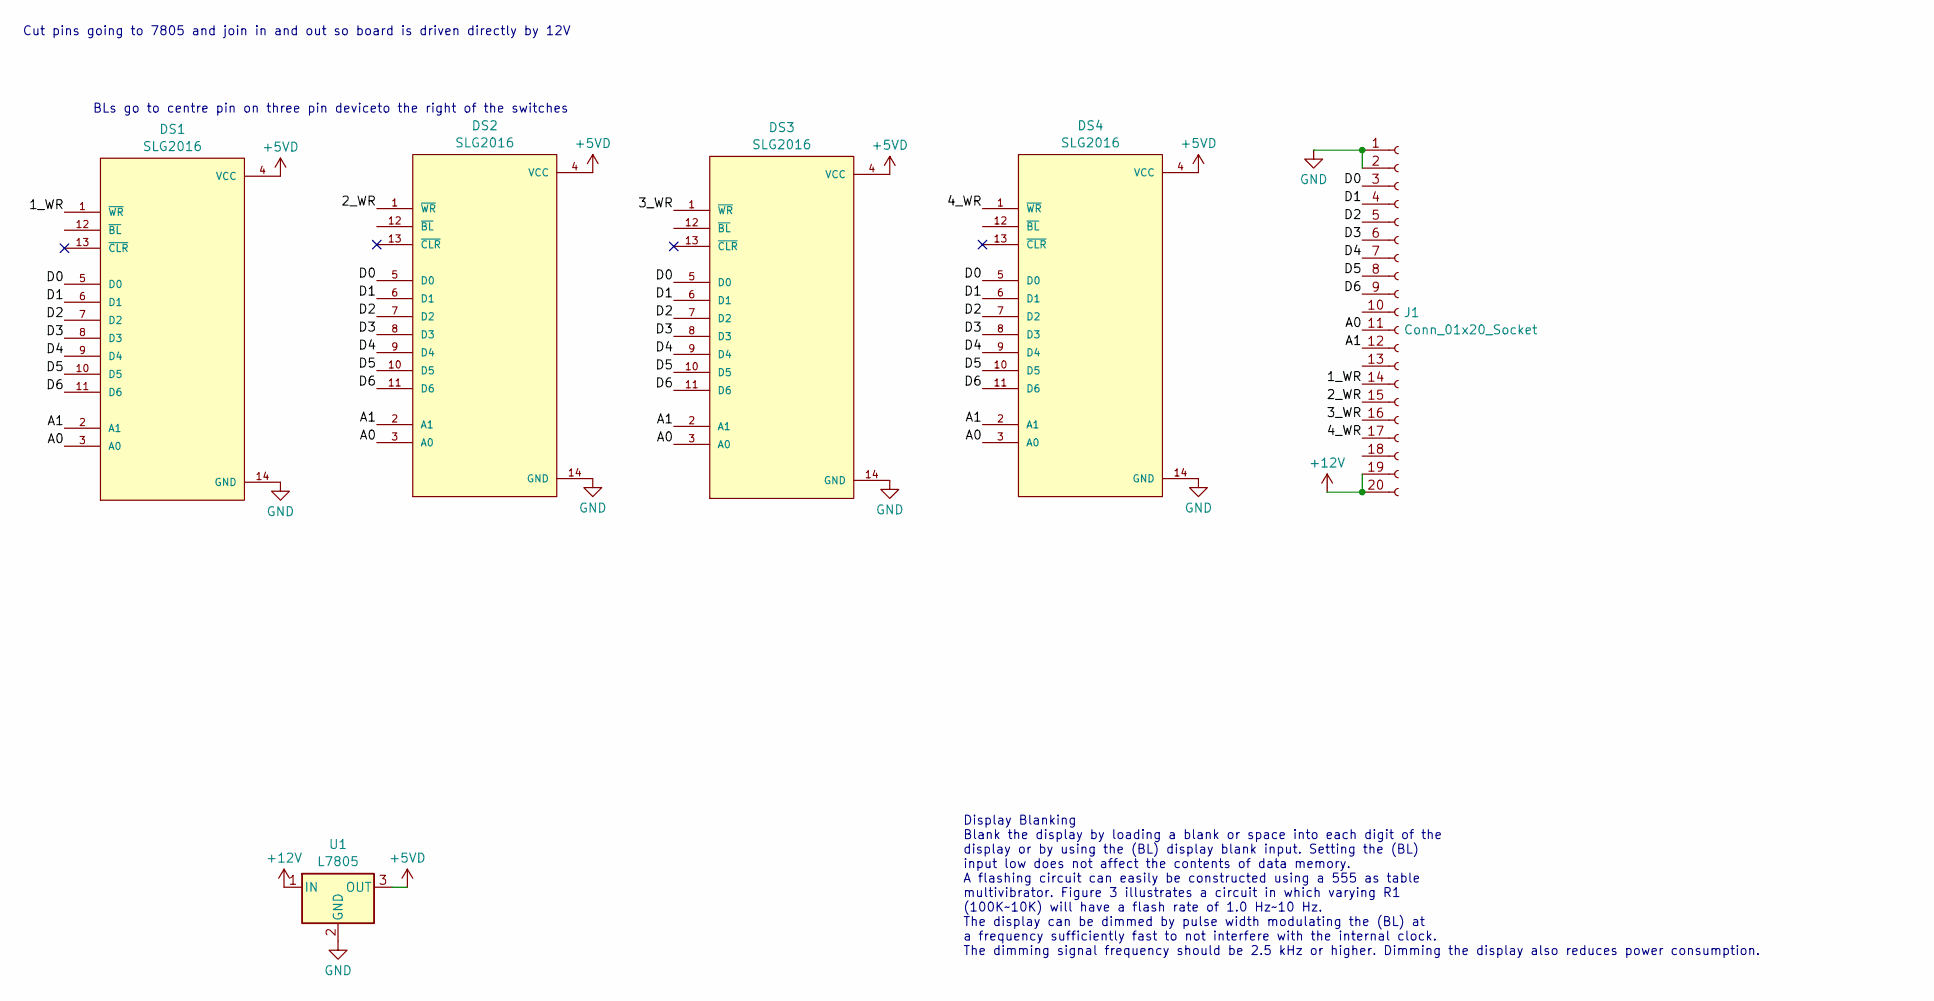
[picture p608: schematic AIC CMDS.kicad_sch]

Parts:
DS1, DS2, DS3, DS4: SLG2016; LED_SLG2016
J1: Conn_01x20_Socket
U1: L7805

Connections:
1_WR: DS1.1 (~WR), J1.14
2_WR: DS2.1 (~WR), J1.15
3_WR: DS3.1 (~WR), J1.16
4_WR: DS4.1 (~WR), J1.17
+5VD: DS1.4 (VCC), DS2.4 (VCC), DS3.4 (VCC), DS4.4 (VCC), U1.3 (OUT)
+12V: J1.19, J1.20, U1.1 (IN)
A0: DS1.3 (A0), DS2.3 (A0), DS3.3 (A0), DS4.3 (A0), J1.11
A1: DS1.2 (A1), DS2.2 (A1), DS3.2 (A1), DS4.2 (A1), J1.12
D0: DS1.5 (D0), DS2.5 (D0), DS3.5 (D0), DS4.5 (D0), J1.3
D1: DS1.6 (D1), DS2.6 (D1), DS3.6 (D1), DS4.6 (D1), J1.4
D2: DS1.7 (D2), DS2.7 (D2), DS3.7 (D2), DS4.7 (D2), J1.5
D3: DS1.8 (D3), DS2.8 (D3), DS3.8 (D3), DS4.8 (D3), J1.6
D4: DS1.9 (D4), DS2.9 (D4), DS3.9 (D4), DS4.9 (D4), J1.7
D5: DS1.10 (D5), DS2.10 (D5), DS3.10 (D5), DS4.10 (D5), J1.8
D6: DS1.11 (D6), DS2.11 (D6), DS3.11 (D6), DS4.11 (D6), J1.9
GND: DS1.14 (GND), DS2.14 (GND), DS3.14 (GND), DS4.14 (GND), J1.1, J1.2, U1.2 (GND)

Notes on the sheet:
Cut pins going to 7805 and join in and out so board is driven directly by 12V
Display Blanking Blank the display by loading a blank or space into each digit of the display or by using the (BL) display blank input. Setting the (BL) input low does not affect the contents of data memory. A flashing circuit can easily be constructed using a 555 as table multivibrator. Figure 3 i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
BLs go to centre pin on three pin deviceto the right of the switches
