bnepethomas/bne-arduino-flight-simulator-interfaces/Hornet/Hornet PCBs/Active/SmallPCB/SmallPanelSwitchPCB.sch

## KiCad design Hornet/Hornet PCBs/Active/SmallPCB/SmallPanelSwitchPCB.sch (2025-11-29)

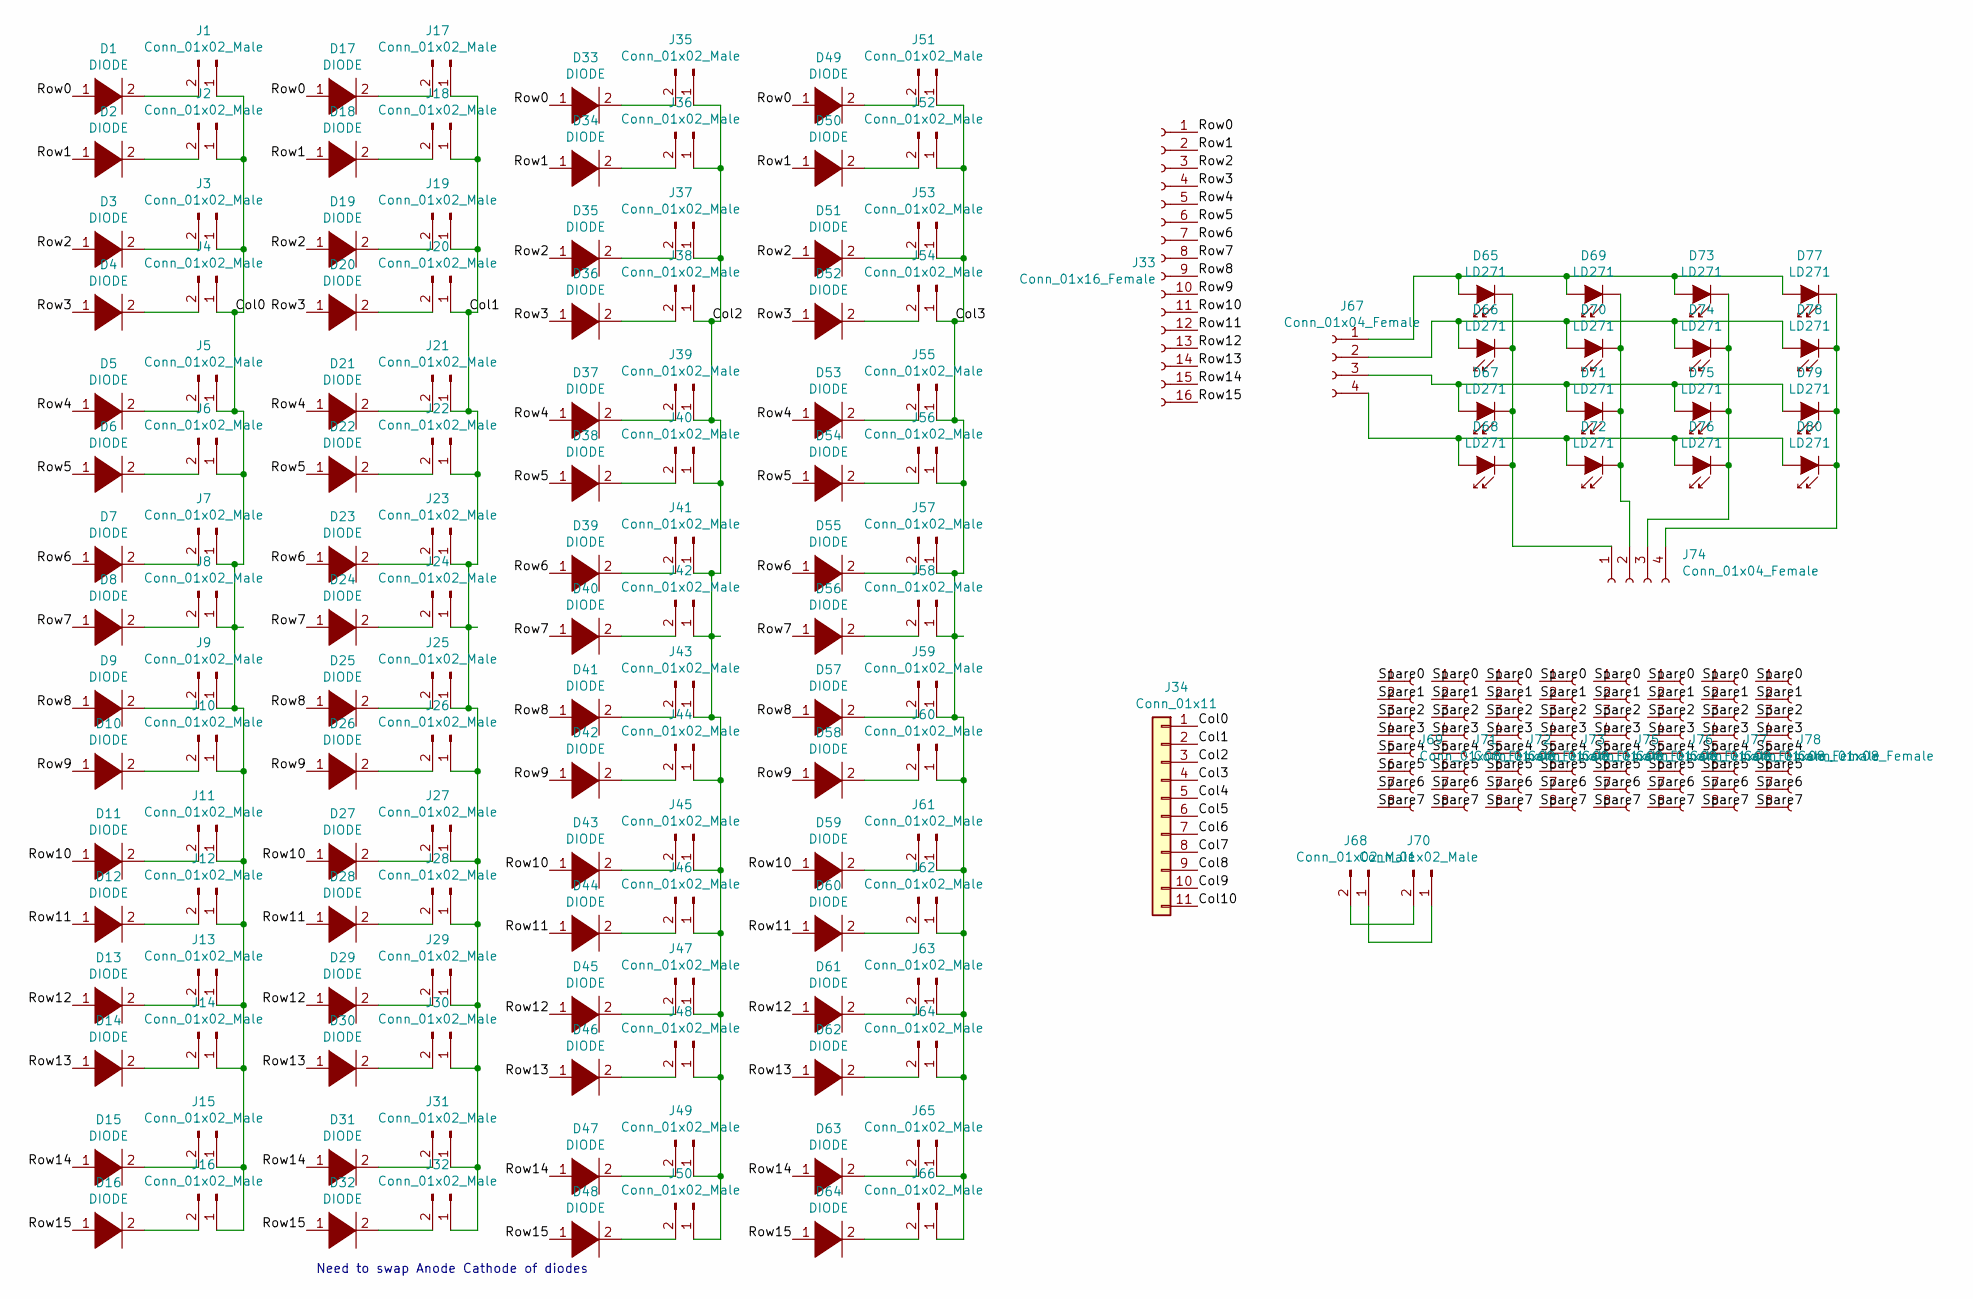
[picture p609: schematic SmallPanelSwitchPCB.sch]

Parts:
D1, D2, D3, D4, D5, D6, D7, D8, D9, D10, D11, D12, D13, D14, D15, D16, D17, D18, D19, D20, D21, D22, D23, D24, D25, D26, D27, D28, D29, D30, D31, D32, D33, D34, D35, D36, D37, D38, D39, D40, D41, D42, D43, D44, D45, D46, D47, D48, D49, D50, D51, D52, D53, D54, D55, D56, D57, D58, D59, D60, D61, D62, D63, D64: DIODE; D_DO-41_SOD81_P2.54mm_Vertical_KathodeUp
D65, D66, D67, D68, D69, D70, D71, D72, D73, D74, D75, D76, D77, D78, D79, D80: LD271; LED_D5.0mm_IRGrey
J1, J2, J3, J4, J5, J6, J7, J8, J9, J10, J11, J12, J13, J14, J15, J16, J17, J18, J19, J20, J21, J22, J23, J24, J25, J26, J27, J28, J29, J30, J31, J32, J35, J36, J37, J38, J39, J40, J41, J42, J43, J44, J45, J46, J47, J48, J49, J50, J51, J52, J53, J54, J55, J56, J57, J58, J59, J60, J61, J62, J63, J64, J65, J66, J68, J70: Conn_01x02_Male; PinHeader_1x02_P2.54mm_Vertical
J33: Conn_01x16_Female; PinHeader_1x16_P2.54mm_Vertical
J34: Conn_01x11; PinHeader_1x11_P2.54mm_Vertical
J67, J74: Conn_01x04_Female; PinHeader_1x04_P2.54mm_Vertical
J69, J71, J72, J73, J75, J76, J77, J78: Conn_01x08_Female; PinHeader_1x08_P2.54mm_Vertical

Connections:
Col0: J1.1, J2.1, J3.1, J4.1, J5.1, J6.1, J7.1, J8.1, J9.1, J10.1, J11.1, J12.1, J13.1, J14.1, J15.1, J16.1, J34.1
Col1: J17.1, J18.1, J19.1, J20.1, J21.1, J22.1, J23.1, J24.1, J25.1, J26.1, J27.1, J28.1, J29.1, J30.1, J31.1, J32.1, J34.2
Col2: J34.3, J35.1, J36.1, J37.1, J38.1, J39.1, J40.1, J41.1, J42.1, J43.1, J44.1, J45.1, J46.1, J47.1, J48.1, J49.1, J50.1
Col3: J34.4, J51.1, J52.1, J53.1, J54.1, J55.1, J56.1, J57.1, J58.1, J59.1, J60.1, J61.1, J62.1, J63.1, J64.1, J65.1, J66.1
Col4: J34.5
Col5: J34.6
Col6: J34.7
Col7: J34.8
Col8: J34.9
Col9: J34.10
Col10: J34.11
unnamed: D1.2 (A), J1.2
unnamed: D2.2 (A), J2.2
unnamed: D3.2 (A), J3.2
unnamed: D4.2 (A), J4.2
unnamed: D5.2 (A), J5.2
unnamed: D6.2 (A), J6.2
unnamed: D7.2 (A), J7.2
unnamed: D8.2 (A), J8.2
unnamed: D9.2 (A), J9.2
unnamed: D10.2 (A), J10.2
unnamed: D11.2 (A), J11.2
unnamed: D12.2 (A), J12.2
unnamed: D13.2 (A), J13.2
unnamed: D14.2 (A), J14.2
unnamed: D15.2 (A), J15.2
unnamed: D16.2 (A), J16.2
unnamed: D17.2 (A), J17.2
unnamed: D18.2 (A), J18.2
unnamed: D19.2 (A), J19.2
unnamed: D20.2 (A), J20.2
unnamed: D21.2 (A), J21.2
unnamed: D22.2 (A), J22.2
unnamed: D23.2 (A), J23.2
unnamed: D24.2 (A), J24.2
unnamed: D25.2 (A), J25.2
unnamed: D26.2 (A), J26.2
unnamed: D27.2 (A), J27.2
unnamed: D28.2 (A), J28.2
unnamed: D29.2 (A), J29.2
unnamed: D30.2 (A), J30.2
unnamed: D31.2 (A), J31.2
unnamed: D32.2 (A), J32.2
unnamed: D33.2 (A), J35.2
unnamed: D34.2 (A), J36.2
unnamed: D35.2 (A), J37.2
unnamed: D36.2 (A), J38.2
unnamed: D37.2 (A), J39.2
unnamed: D38.2 (A), J40.2
unnamed: D39.2 (A), J41.2
unnamed: D40.2 (A), J42.2
unnamed: D41.2 (A), J43.2
unnamed: D42.2 (A), J44.2
unnamed: D43.2 (A), J45.2
unnamed: D44.2 (A), J46.2
unnamed: D45.2 (A), J47.2
unnamed: D46.2 (A), J48.2
unnamed: D47.2 (A), J49.2
unnamed: D48.2 (A), J50.2
unnamed: D49.2 (A), J51.2
unnamed: D50.2 (A), J52.2
unnamed: D51.2 (A), J53.2
unnamed: D52.2 (A), J54.2
unnamed: D53.2 (A), J55.2
unnamed: D54.2 (A), J56.2
unnamed: D55.2 (A), J57.2
unnamed: D56.2 (A), J58.2
unnamed: D57.2 (A), J59.2
unnamed: D58.2 (A), J60.2
unnamed: D59.2 (A), J61.2
unnamed: D60.2 (A), J62.2
unnamed: D61.2 (A), J63.2
unnamed: D62.2 (A), J64.2
unnamed: D63.2 (A), J65.2
unnamed: D64.2 (A), J66.2
unnamed: D65.1 (K), D66.1 (K), D67.1 (K), D68.1 (K), J74.1
unnamed: D65.2 (A), D69.2 (A), D73.2 (A), D77.2 (A), J67.1
unnamed: D66.2 (A), D70.2 (A), D74.2 (A), D78.2 (A), J67.2
unnamed: D67.2 (A), D71.2 (A), D75.2 (A), D79.2 (A), J67.3
unnamed: D68.2 (A), D72.2 (A), D76.2 (A), D80.2 (A), J67.4
unnamed: D69.1 (K), D70.1 (K), D71.1 (K), D72.1 (K), J74.2
unnamed: D73.1 (K), D74.1 (K), D75.1 (K), D76.1 (K), J74.3
unnamed: D77.1 (K), D78.1 (K), D79.1 (K), D80.1 (K), J74.4
unnamed: J68.1, J70.1
unnamed: J68.2, J70.2
Row0: D1.1 (K), D17.1 (K), D33.1 (K), D49.1 (K), J33.1
Row1: D2.1 (K), D18.1 (K), D34.1 (K), D50.1 (K), J33.2
Row2: D3.1 (K), D19.1 (K), D35.1 (K), D51.1 (K), J33.3
Row3: D4.1 (K), D20.1 (K), D36.1 (K), D52.1 (K), J33.4
Row4: D5.1 (K), D21.1 (K), D37.1 (K), D53.1 (K), J33.5
Row5: D6.1 (K), D22.1 (K), D38.1 (K), D54.1 (K), J33.6
Row6: D7.1 (K), D23.1 (K), D39.1 (K), D55.1 (K), J33.7
Row7: D8.1 (K), D24.1 (K), D40.1 (K), D56.1 (K), J33.8
Row8: D9.1 (K), D25.1 (K), D41.1 (K), D57.1 (K), J33.9
Row9: D10.1 (K), D26.1 (K), D42.1 (K), D58.1 (K), J33.10
Row10: D11.1 (K), D27.1 (K), D43.1 (K), D59.1 (K), J33.11
Row11: D12.1 (K), D28.1 (K), D44.1 (K), D60.1 (K), J33.12
Row12: D13.1 (K), D29.1 (K), D45.1 (K), D61.1 (K), J33.13
Row13: D14.1 (K), D30.1 (K), D46.1 (K), D62.1 (K), J33.14
Row14: D15.1 (K), D31.1 (K), D47.1 (K), D63.1 (K), J33.15
Row15: D16.1 (K), D32.1 (K), D48.1 (K), D64.1 (K), J33.16
Spare0: J69.1, J71.1, J72.1, J73.1, J75.1, J76.1, J77.1, J78.1
Spare1: J69.2, J71.2, J72.2, J73.2, J75.2, J76.2, J77.2, J78.2
Spare2: J69.3, J71.3, J72.3, J73.3, J75.3, J76.3, J77.3, J78.3
Spare3: J69.4, J71.4, J72.4, J73.4, J75.4, J76.4, J77.4, J78.4
Spare4: J69.5, J71.5, J72.5, J73.5, J75.5, J76.5, J77.5, J78.5
Spare5: J69.6, J71.6, J72.6, J73.6, J75.6, J76.6, J77.6, J78.6
Spare6: J69.7, J71.7, J72.7, J73.7, J75.7, J76.7, J77.7, J78.7
Spare7: J69.8, J71.8, J72.8, J73.8, J75.8, J76.8, J77.8, J78.8

Notes on the sheet:
Need to swap Anode Cathode of diodes
