bnepethomas/bne-arduino-flight-simulator-interfaces/Hornet/Hornet PCBs/Active/Switch_interface/Switch_interface.sch

## KiCad design Hornet/Hornet PCBs/Active/Switch_interface/Switch_interface.sch (2025-11-29)

Schematic: Switch_interface.sch

Parts:
J1: Conn_02x18_Odd_Even; PinHeader_2x18_P2.54mm_Vertical
J2, J3: Conn_02x18_Odd_Even; PinHeader_2x17_P2.54mm_Vertical
J4, J6, J8, J10, J12, J14, J16, J18: Conn_01x13; PinHeader_1x16_P2.54mm_Vertical
J5, J7, J9, J11, J13, J15, J17, J19: Conn_01x13; PinHeader_1x13_P2.54mm_Vertical
R1, R2, R3, R4, R5, R6, R7, R8, R9, R10, R11: R_US; R_Axial_DIN0207_L6.3mm_D2.5mm_P2.54mm_Vertical

Notes on the sheet:
digitalPin 22~ 37 used as row0 ~ row 15, digital pin 38~53 used as column 0 ~ 15, When an Ethernet shield is connected Columns 13 and 14 are pulled up to 1.5V - so do not use It's a 16 * 14 matrix (due to loss of two columns)
