bnepethomas/bne-arduino-flight-simulator-interfaces/Hornet/Hornet PCBs/Active/UFC - CONNECTION PCB/UFC - General Purpose Small PCB.sch

## KiCad design Hornet/Hornet PCBs/Active/UFC - CONNECTION PCB/UFC - General Purpose Small PCB.sch (2025-11-29)

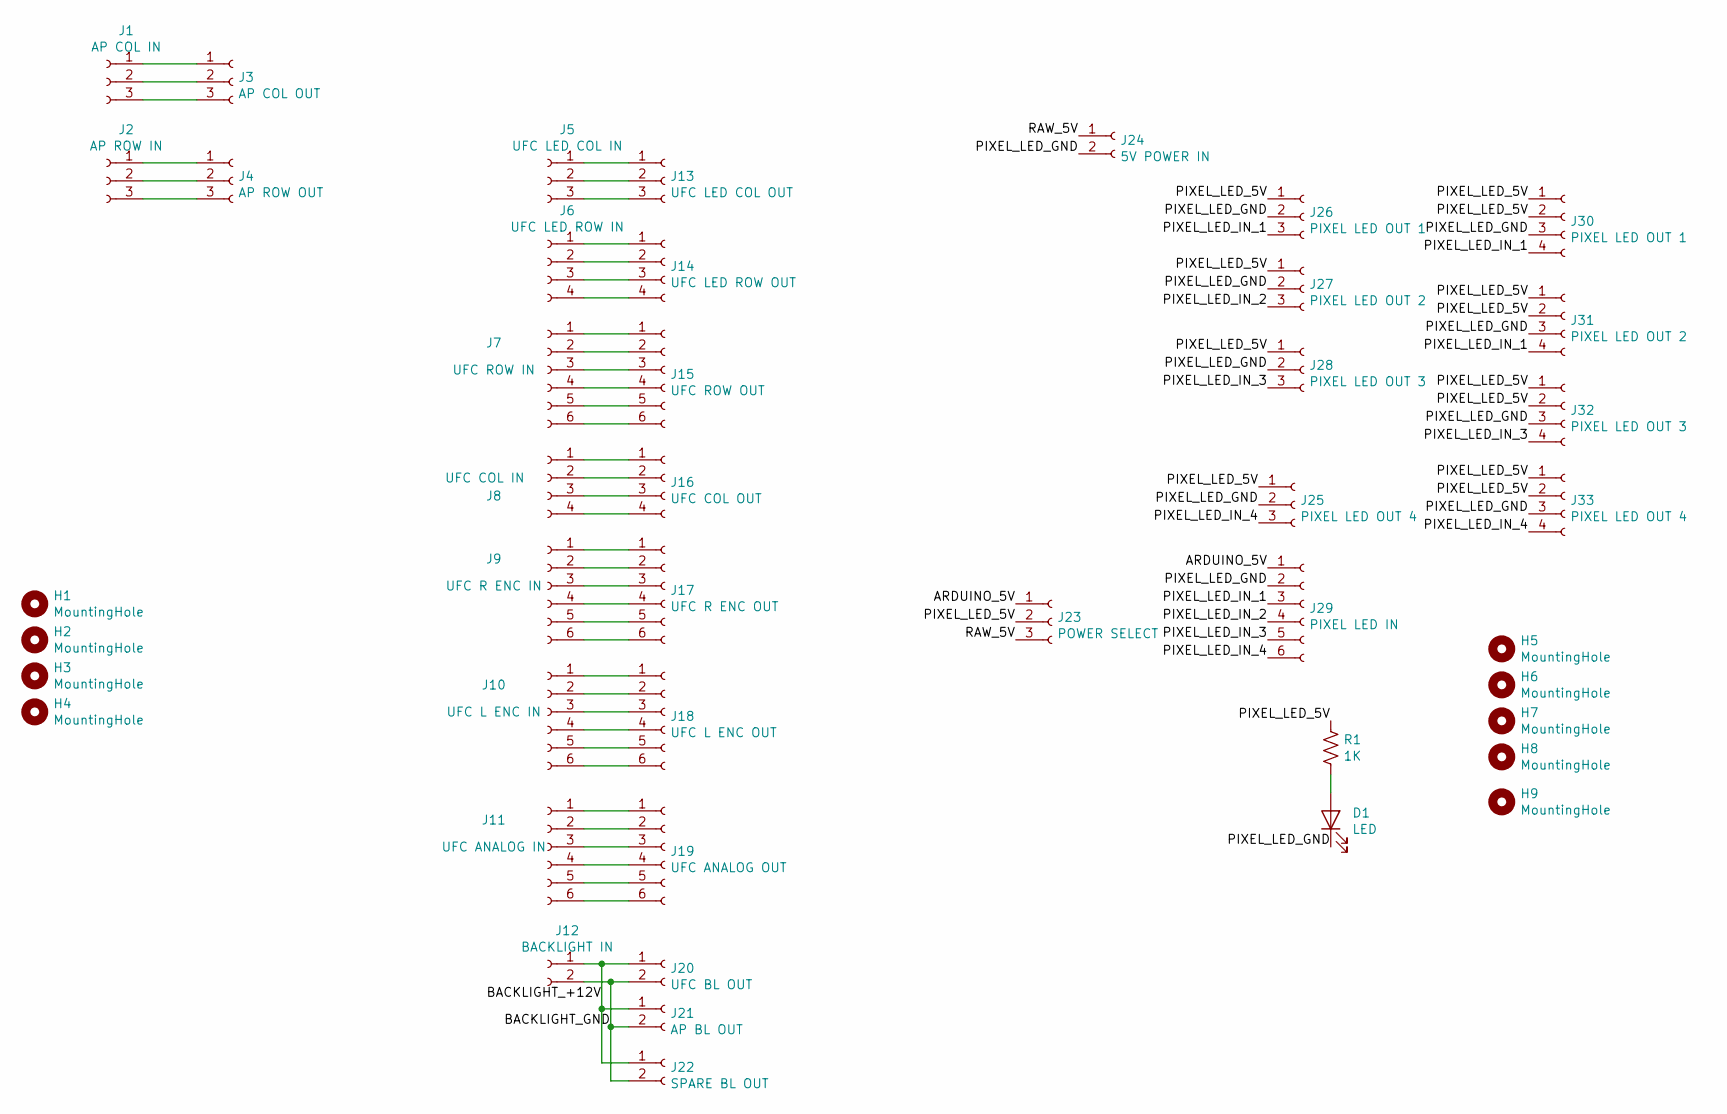
[picture p610: schematic UFC - General Purpose Small PCB.sch]

Parts:
D1: LED; LED_D5.0mm
H1, H2, H3, H4, H5, H6, H7, H8, H9: MountingHole; MountingHole_3.2mm_M3
J1: AP COL IN; Molex_1x03_P2.54mm_Vertical
J2: AP ROW IN; Molex_1x03_P2.54mm_Vertical
J3: AP COL OUT; Molex_1x03_P2.54mm_Vertical
J4: AP ROW OUT; Molex_1x03_P2.54mm_Vertical
J5: UFC LED COL IN; Molex_1x03_P2.54mm_Vertical
J6: UFC LED ROW IN; Molex_1x04_P2.54mm_Vertical
J7: UFC ROW IN; Molex_1x06_P2.54mm_Vertical
J8: UFC COL IN; Molex_1x04_P2.54mm_Vertical
J9: UFC R ENC IN; Molex_1x06_P2.54mm_Vertical
J10: UFC L ENC IN; Molex_1x06_P2.54mm_Vertical
J11: UFC ANALOG IN; Molex_1x06_P2.54mm_Vertical
J12: BACKLIGHT IN; Molex_1x02_P2.54mm_Vertical
J13: UFC LED COL OUT; Molex_1x03_P2.54mm_Vertical
J14: UFC LED ROW OUT; Molex_1x04_P2.54mm_Vertical
J15: UFC ROW OUT; Molex_1x06_P2.54mm_Vertical
J16: UFC COL OUT; Molex_1x04_P2.54mm_Vertical
J17: UFC R ENC OUT; Molex_1x06_P2.54mm_Vertical
J18: UFC L ENC OUT; Molex_1x06_P2.54mm_Vertical
J19: UFC ANALOG OUT; Molex_1x06_P2.54mm_Vertical
J20: UFC BL OUT; Molex_1x02_P2.54mm_Vertical
J21: AP BL OUT; Molex_1x02_P2.54mm_Vertical
J22: SPARE BL OUT; Molex_1x02_P2.54mm_Vertical
J23: POWER SELECT; PinHeader_1x03_P2.54mm_Vertical
J24: 5V POWER IN; BarrelJack_Horizontal
J25: PIXEL LED OUT 4; Molex_1x03_P2.54mm_Vertical
J26: PIXEL LED OUT 1; Molex_1x03_P2.54mm_Vertical
J27: PIXEL LED OUT 2; Molex_1x03_P2.54mm_Vertical
J28: PIXEL LED OUT 3; Molex_1x03_P2.54mm_Vertical
J29: PIXEL LED IN; Molex_1x06_P2.54mm_Vertical
J30: PIXEL LED OUT 1; Molex_Mini-Fit_Jr_5566-04A_2x02_P4.20mm_Vertical
J31: PIXEL LED OUT 2; Molex_Mini-Fit_Jr_5566-04A_2x02_P4.20mm_Vertical
J32: PIXEL LED OUT 3; Molex_Mini-Fit_Jr_5566-04A_2x02_P4.20mm_Vertical
J33: PIXEL LED OUT 4; Molex_Mini-Fit_Jr_5566-04A_2x02_P4.20mm_Vertical
R1: 1K; R_Axial_DIN0207_L6.3mm_D2.5mm_P7.62mm_Horizontal

Connections:
ARDUINO_5V: J23.1, J29.1
BACKLIGHT_+12V: J12.1, J20.1, J21.1, J22.1
BACKLIGHT_GND: J12.2, J20.2, J21.2, J22.2
unnamed: D1.2 (A), R1.2
unnamed: J1.1, J3.1
unnamed: J1.2, J3.2
unnamed: J1.3, J3.3
unnamed: J2.1, J4.1
unnamed: J2.2, J4.2
unnamed: J2.3, J4.3
unnamed: J10.1, J18.1
unnamed: J10.2, J18.2
unnamed: J10.3, J18.3
unnamed: J10.4, J18.4
unnamed: J10.5, J18.5
unnamed: J10.6, J18.6
unnamed: J11.1, J19.1
unnamed: J11.2, J19.2
unnamed: J11.3, J19.3
unnamed: J11.4, J19.4
unnamed: J11.5, J19.5
unnamed: J11.6, J19.6
unnamed: J5.1, J13.1
unnamed: J5.2, J13.2
unnamed: J5.3, J13.3
unnamed: J6.1, J14.1
unnamed: J6.2, J14.2
unnamed: J6.3, J14.3
unnamed: J6.4, J14.4
unnamed: J7.1, J15.1
unnamed: J7.2, J15.2
unnamed: J7.3, J15.3
unnamed: J7.4, J15.4
unnamed: J7.5, J15.5
unnamed: J7.6, J15.6
unnamed: J8.1, J16.1
unnamed: J8.2, J16.2
unnamed: J8.3, J16.3
unnamed: J8.4, J16.4
unnamed: J9.1, J17.1
unnamed: J9.2, J17.2
unnamed: J9.3, J17.3
unnamed: J9.4, J17.4
unnamed: J9.5, J17.5
unnamed: J9.6, J17.6
PIXEL_LED_5V: J23.2, J25.1, J26.1, J27.1, J28.1, J30.1, J30.2, J31.1, J31.2, J32.1, J32.2, J33.1, J33.2, R1.1
PIXEL_LED_GND: D1.1 (K), J24.2, J25.2, J26.2, J27.2, J28.2, J29.2, J30.3, J31.3, J32.3, J33.3
PIXEL_LED_IN_1: J26.3, J29.3, J30.4, J31.4
PIXEL_LED_IN_2: J27.3, J29.4
PIXEL_LED_IN_3: J28.3, J29.5, J32.4
PIXEL_LED_IN_4: J25.3, J29.6, J33.4
RAW_5V: J23.3, J24.1
