bnepethomas/bne-arduino-flight-simulator-interfaces/Hornet/Hornet PCBs/Active/UFC/UFC.sch

## KiCad design Hornet/Hornet PCBs/Active/UFC/UFC.sch (2025-11-29)

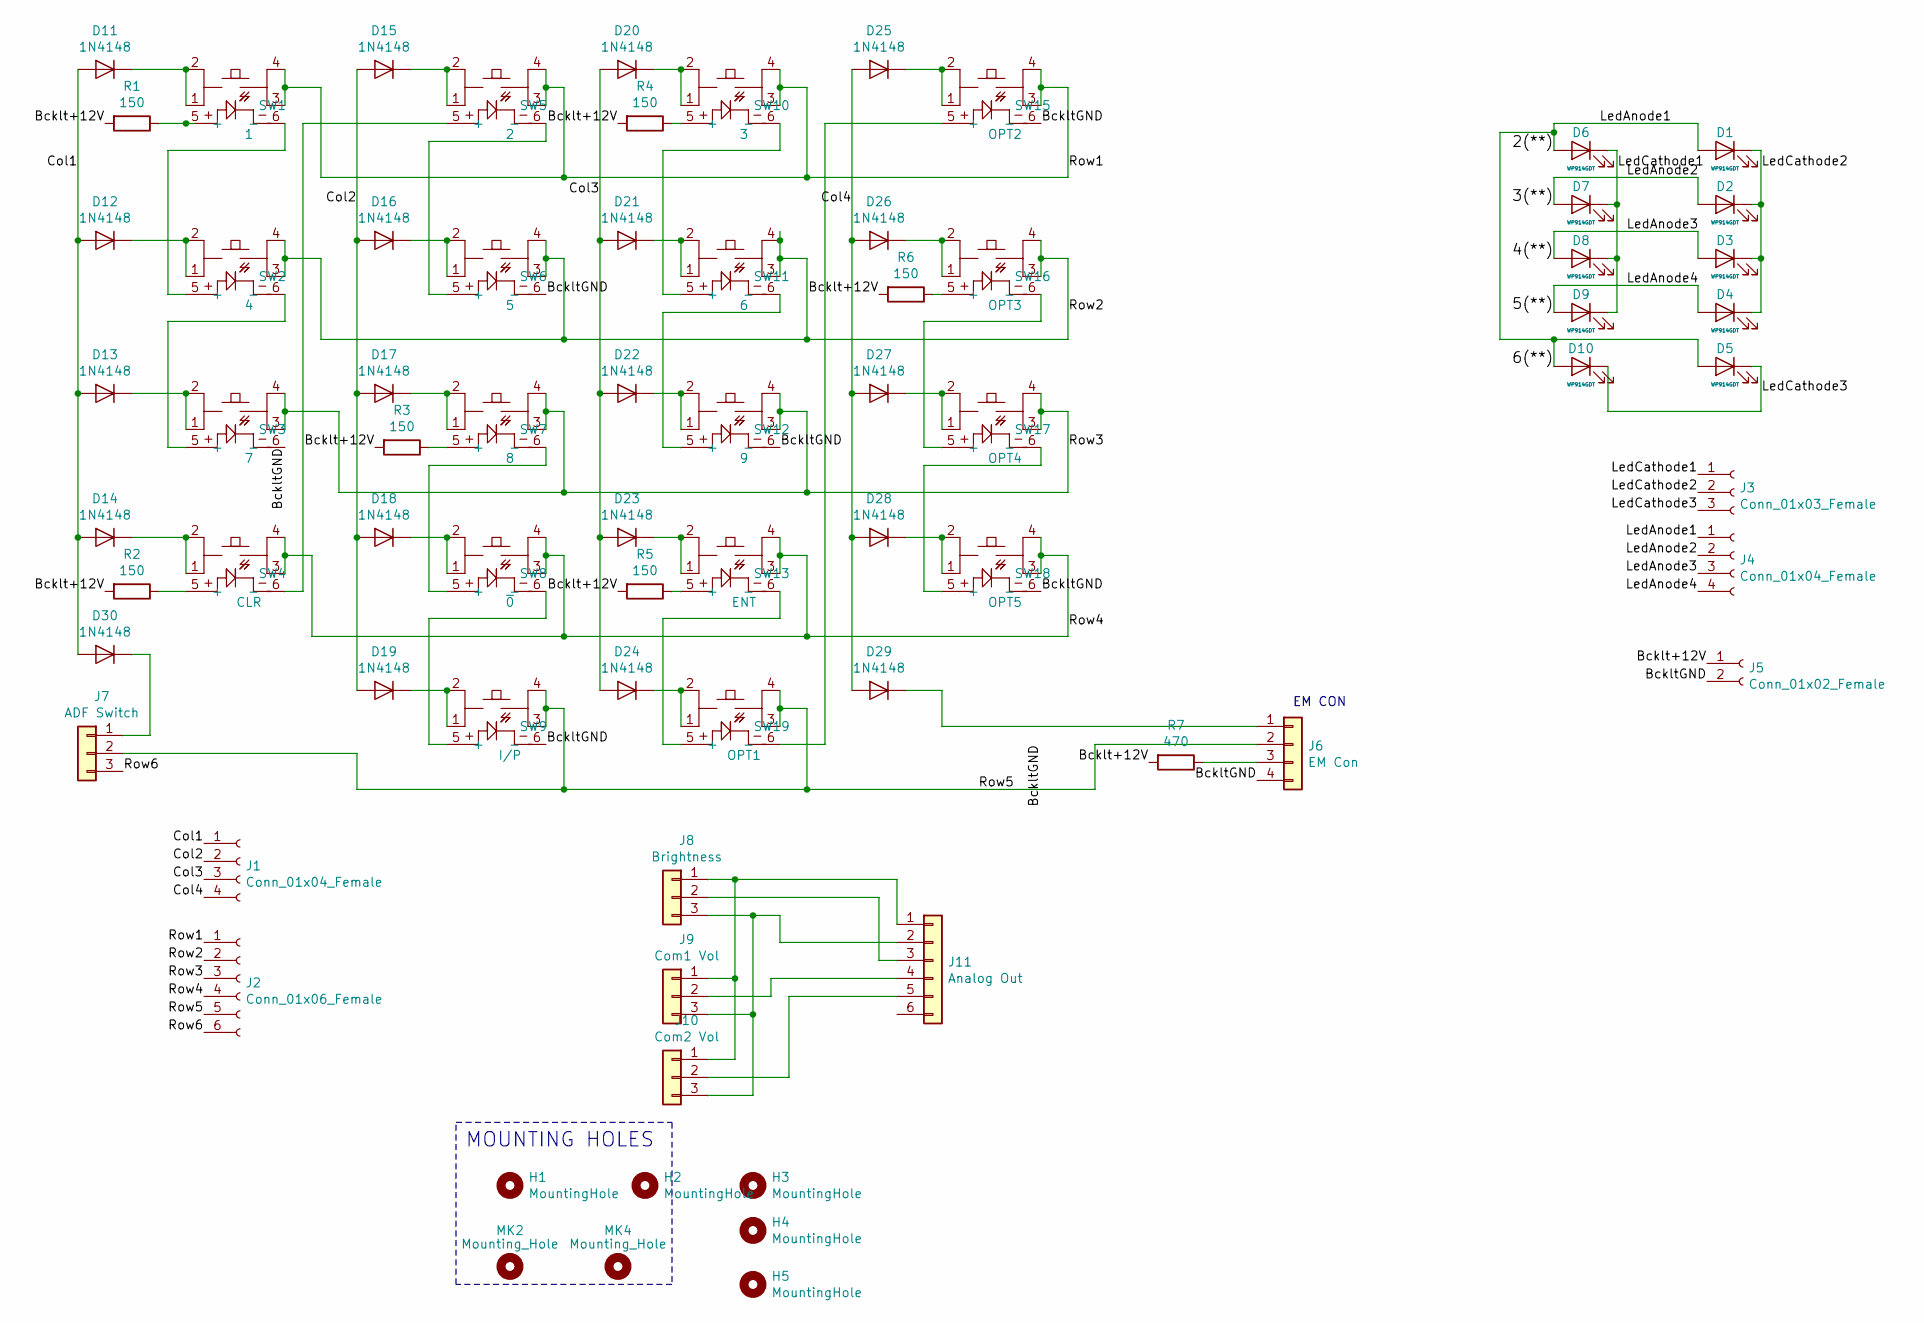
[picture p611: schematic UFC.sch]

Parts:
D1, D2, D3, D4, D5, D6, D7, D8, D9, D10: WP914GDT; LED_D3.0mm
D11, D12, D13, D14, D15, D16, D17, D18, D19, D20, D21, D22, D23, D24, D25, D26, D27, D28, D29, D30: 1N4148; D_DO-35_SOD27_P7.62mm_Horizontal
H1, H2, H3, H4, H5: MountingHole; MountingHole_3.2mm_M3
J1, J4: Conn_01x04_Female; Molex_1x04_P2.54mm_Vertical
J2: Conn_01x06_Female; Molex_1x06_P2.54mm_Vertical
J3: Conn_01x03_Female; Molex_1x03_P2.54mm_Vertical
J5: Conn_01x02_Female; Molex_1x02_P2.54mm_Vertical
J6: EM Con; Molex_1x04_P2.54mm_Vertical
J7: ADF Switch; Molex_1x03_P2.54mm_Vertical
J8: Brightness; Molex_1x03_P2.54mm_Vertical
J9: Com1 Vol; Molex_1x03_P2.54mm_Vertical
J10: Com2 Vol; Molex_1x03_P2.54mm_Vertical
J11: Analog Out; Molex_1x06_P2.54mm_Vertical
MK2, MK4: Mounting_Hole; MountingHole_3mm
R1, R2, R3, R4, R5, R6: 150; R_Axial_DIN0207_L6.3mm_D2.5mm_P7.62mm_Horizontal
R7: 470; R_Axial_DIN0207_L6.3mm_D2.5mm_P7.62mm_Horizontal
SW1: 1; PT_Small_Tactile_Switch_With_LED
SW2: 4; PT_Small_Tactile_Switch_With_LED
SW3: 7; PT_Small_Tactile_Switch_With_LED
SW4: CLR; PT_Small_Tactile_Switch_With_LED
SW5: 2; PT_Small_Tactile_Switch_With_LED
SW6: 5; PT_Small_Tactile_Switch_With_LED
SW7: 8; PT_Small_Tactile_Switch_With_LED
SW8: ~0; PT_Small_Tactile_Switch_With_LED
SW9: I/P; PT_Small_Tactile_Switch_With_LED
SW10: 3; PT_Small_Tactile_Switch_With_LED
SW11: 6; PT_Small_Tactile_Switch_With_LED
SW12: 9; PT_Small_Tactile_Switch_With_LED
SW13: ENT; PT_Small_Tactile_Switch_With_LED
SW15: OPT2; PT_Small_Tactile_Switch_With_LED
SW16: OPT3; PT_Small_Tactile_Switch_With_LED
SW17: OPT4; PT_Small_Tactile_Switch_With_LED
SW18: OPT5; PT_Small_Tactile_Switch_With_LED
SW19: OPT1; PT_Small_Tactile_Switch_With_LED

Connections:
2(**): D1.2 (A), D5.2 (A), D6.2 (A), D10.2 (A), J4.1
3(**): D2.2 (A), D7.2 (A), J4.2
4(**): D3.2 (A), D8.2 (A), J4.3
5(**): D4.2 (A), D9.2 (A), J4.4
Bcklt+12V: J5.1, R1.2, R2.2, R3.2, R4.2, R5.2, R6.2, R7.2
BckltGND: J5.2, J6.4, SW3.6 (-), SW6.6 (-), SW9.6 (-), SW12.6 (-), SW15.6 (-), SW18.6 (-)
Col1: D11.2 (A), D12.2 (A), D13.2 (A), D14.2 (A), D30.2 (A), J1.1
Col2: D15.2 (A), D16.2 (A), D17.2 (A), D18.2 (A), D19.2 (A), J1.2
Col3: D20.2 (A), D21.2 (A), D22.2 (A), D23.2 (A), D24.2 (A), J1.3
Col4: D25.2 (A), D26.2 (A), D27.2 (A), D28.2 (A), D29.2 (A), J1.4
LedCathode1: D6.1 (K), D7.1 (K), D8.1 (K), D9.1 (K), J3.1
LedCathode2: D1.1 (K), D2.1 (K), D3.1 (K), D4.1 (K), J3.2
LedCathode3: D5.1 (K), D10.1 (K), J3.3
unnamed: D11.1 (K), SW1.1, SW1.2
unnamed: D12.1 (K), SW2.1, SW2.2
unnamed: D13.1 (K), SW3.1, SW3.2
unnamed: D14.1 (K), SW4.1, SW4.2
unnamed: D15.1 (K), SW5.1, SW5.2
unnamed: D16.1 (K), SW6.1, SW6.2
unnamed: D17.1 (K), SW7.1, SW7.2
unnamed: D18.1 (K), SW8.1, SW8.2
unnamed: D19.1 (K), SW9.1, SW9.2
unnamed: D20.1 (K), SW10.1, SW10.2
unnamed: D21.1 (K), SW11.1, SW11.2
unnamed: D22.1 (K), SW12.1, SW12.2
unnamed: D23.1 (K), SW13.1, SW13.2
unnamed: D24.1 (K), SW19.1, SW19.2
unnamed: D25.1 (K), SW15.1, SW15.2
unnamed: D26.1 (K), SW16.1, SW16.2
unnamed: D27.1 (K), SW17.1, SW17.2
unnamed: D28.1 (K), SW18.1, SW18.2
unnamed: D29.1 (K), J6.1
unnamed: D30.1 (K), J7.1
unnamed: J6.3, R7.1
unnamed: J8.1, J9.1, J10.1, J11.1
unnamed: J10.2, J11.5
unnamed: J8.3, J9.3, J10.3, J11.2
unnamed: J8.2, J11.3
unnamed: J9.2, J11.4
unnamed: R1.1, SW1.5 (+)
unnamed: R2.1, SW4.5 (+)
unnamed: R3.1, SW7.5 (+)
unnamed: R4.1, SW10.5 (+)
unnamed: R5.1, SW13.5 (+)
unnamed: R6.1, SW16.5 (+)
unnamed: SW1.6 (-), SW2.5 (+)
unnamed: SW2.6 (-), SW3.5 (+)
unnamed: SW4.6 (-), SW5.5 (+)
unnamed: SW5.6 (-), SW6.5 (+)
unnamed: SW7.6 (-), SW8.5 (+)
unnamed: SW8.6 (-), SW9.5 (+)
unnamed: SW10.6 (-), SW11.5 (+)
unnamed: SW11.6 (-), SW12.5 (+)
unnamed: SW13.6 (-), SW19.5 (+)
unnamed: SW15.5 (+), SW19.6 (-)
unnamed: SW16.6 (-), SW17.5 (+)
unnamed: SW17.6 (-), SW18.5 (+)
Row1: J2.1, SW1.3, SW1.4, SW5.3, SW5.4, SW10.3, SW10.4, SW15.3, SW15.4
Row2: J2.2, SW2.3, SW2.4, SW6.3, SW6.4, SW11.3, SW11.4, SW16.3, SW16.4
Row3: J2.3, SW3.3, SW3.4, SW7.3, SW7.4, SW12.3, SW12.4, SW17.3, SW17.4
Row4: J2.4, SW4.3, SW4.4, SW8.3, SW8.4, SW13.3, SW13.4, SW18.3, SW18.4
Row5: J2.5, J6.2, J7.2, SW9.3, SW9.4, SW19.3, SW19.4
Row6: J2.6, J7.3

Notes on the sheet:
MOUNTING HOLES
EM CON
