bnepethomas/bne-arduino-flight-simulator-interfaces/Hornet/Hornet PCBs/Active/UIP - CONNECTION BOARD/OH - General Purpose Small PCB.sch

## KiCad design Hornet/Hornet PCBs/Active/UIP - CONNECTION BOARD/OH - General Purpose Small PCB.sch (2025-11-29)

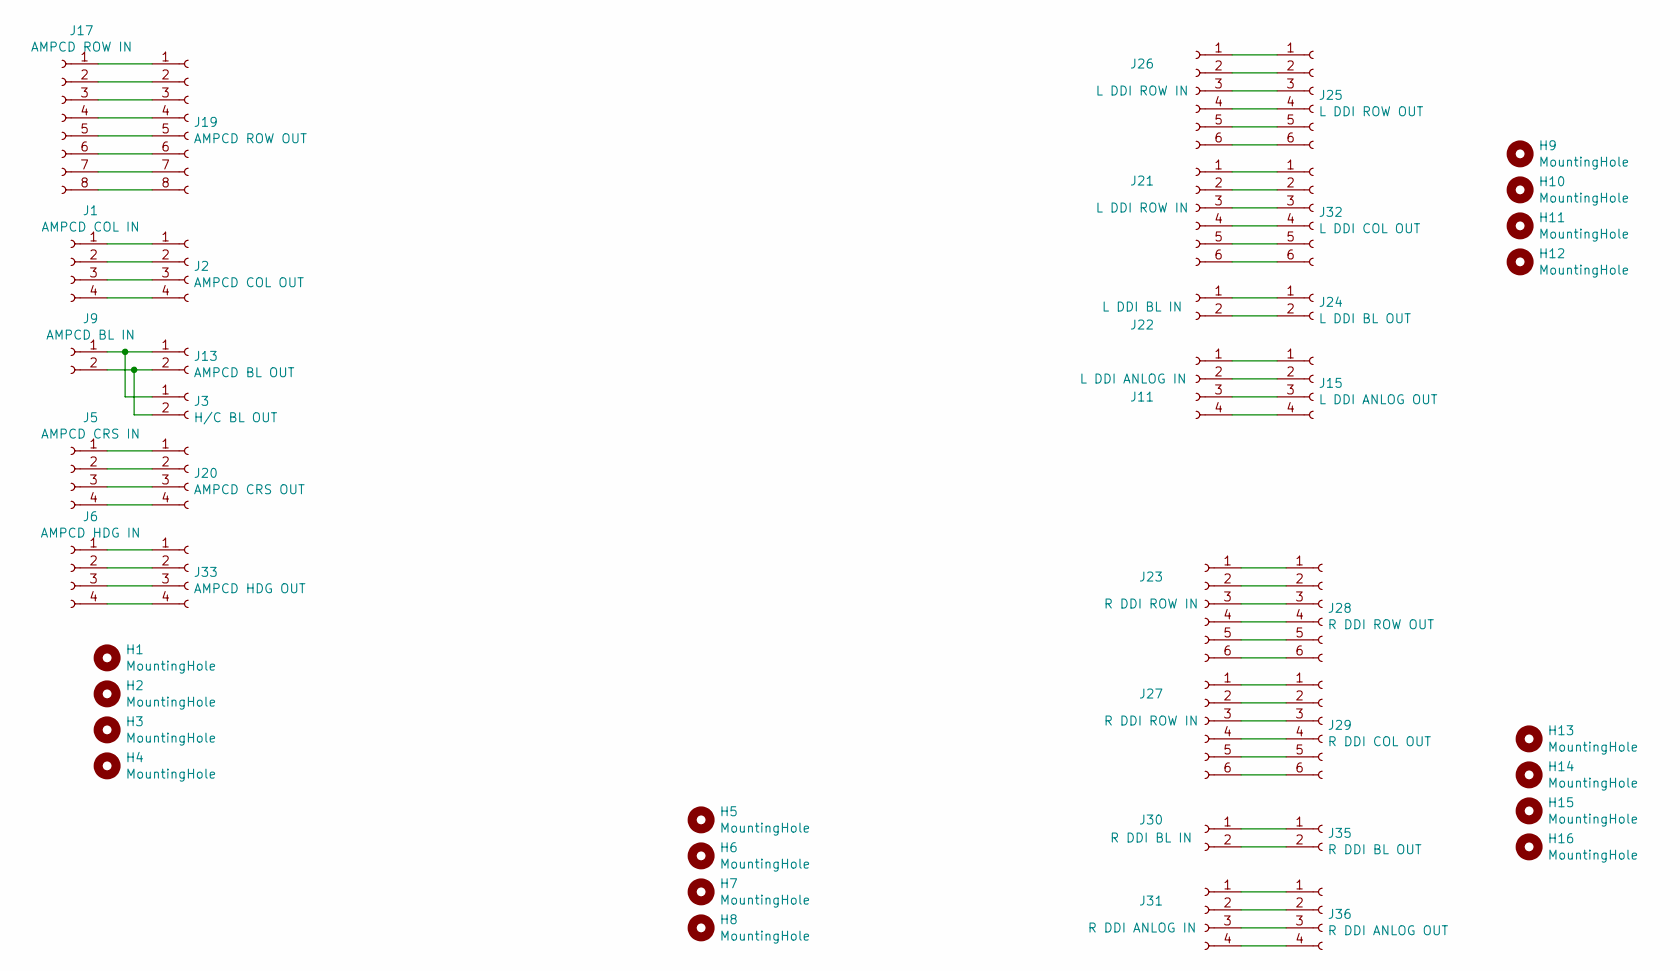
[picture p612: schematic OH - General Purpose Small PCB.sch]

Parts:
H1, H2, H3, H4, H5, H6, H7, H8, H9, H10, H11, H12, H13, H14, H15, H16: MountingHole; MountingHole_3.2mm_M3
J1: AMPCD COL IN; Molex_1x04_P2.54mm_Vertical
J2: AMPCD COL OUT; Molex_1x04_P2.54mm_Vertical
J3: H/C BL OUT; Molex_1x02_P2.54mm_Vertical
J5: AMPCD CRS IN; Molex_1x04_P2.54mm_Vertical
J6: AMPCD HDG IN; Molex_1x04_P2.54mm_Vertical
J9: AMPCD BL IN; Molex_1x02_P2.54mm_Vertical
J11: L DDI ANLOG IN; Molex_1x04_P2.54mm_Vertical
J13: AMPCD BL OUT; Molex_1x02_P2.54mm_Vertical
J15: L DDI ANLOG OUT; Molex_1x04_P2.54mm_Vertical
J17: AMPCD ROW IN; Molex_1x08_P2.54mm_Vertical
J19: AMPCD ROW OUT; Molex_1x08_P2.54mm_Vertical
J20: AMPCD CRS OUT; Molex_1x04_P2.54mm_Vertical
J21, J26: L DDI ROW IN; Molex_1x06_P2.54mm_Vertical
J22: L DDI BL IN; Molex_1x02_P2.54mm_Vertical
J23, J27: R DDI ROW IN; Molex_1x06_P2.54mm_Vertical
J24: L DDI BL OUT; Molex_1x02_P2.54mm_Vertical
J25: L DDI ROW OUT; Molex_1x06_P2.54mm_Vertical
J28: R DDI ROW OUT; Molex_1x06_P2.54mm_Vertical
J29: R DDI COL OUT; Molex_1x06_P2.54mm_Vertical
J30: R DDI BL IN; Molex_1x02_P2.54mm_Vertical
J31: R DDI ANLOG IN; Molex_1x04_P2.54mm_Vertical
J32: L DDI COL OUT; Molex_1x06_P2.54mm_Vertical
J33: AMPCD HDG OUT; Molex_1x04_P2.54mm_Vertical
J35: R DDI BL OUT; Molex_1x02_P2.54mm_Vertical
J36: R DDI ANLOG OUT; Molex_1x04_P2.54mm_Vertical

Connections:
unnamed: J1.1, J2.1
unnamed: J1.2, J2.2
unnamed: J1.3, J2.3
unnamed: J1.4, J2.4
unnamed: J11.1, J15.1
unnamed: J11.2, J15.2
unnamed: J11.3, J15.3
unnamed: J11.4, J15.4
unnamed: J3.1, J9.1, J13.1
unnamed: J3.2, J9.2, J13.2
unnamed: J17.1, J19.1
unnamed: J17.2, J19.2
unnamed: J17.3, J19.3
unnamed: J17.4, J19.4
unnamed: J17.5, J19.5
unnamed: J17.6, J19.6
unnamed: J17.7, J19.7
unnamed: J17.8, J19.8
unnamed: J5.1, J20.1
unnamed: J5.2, J20.2
unnamed: J5.3, J20.3
unnamed: J5.4, J20.4
unnamed: J21.1, J32.1
unnamed: J21.2, J32.2
unnamed: J21.3, J32.3
unnamed: J21.4, J32.4
unnamed: J21.5, J32.5
unnamed: J21.6, J32.6
unnamed: J22.1, J24.1
unnamed: J22.2, J24.2
unnamed: J23.1, J28.1
unnamed: J23.2, J28.2
unnamed: J23.3, J28.3
unnamed: J23.4, J28.4
unnamed: J23.5, J28.5
unnamed: J23.6, J28.6
unnamed: J25.1, J26.1
unnamed: J25.2, J26.2
unnamed: J25.3, J26.3
unnamed: J25.4, J26.4
unnamed: J25.5, J26.5
unnamed: J25.6, J26.6
unnamed: J27.1, J29.1
unnamed: J27.2, J29.2
unnamed: J27.3, J29.3
unnamed: J27.4, J29.4
unnamed: J27.5, J29.5
unnamed: J27.6, J29.6
unnamed: J30.1, J35.1
unnamed: J30.2, J35.2
unnamed: J31.1, J36.1
unnamed: J31.2, J36.2
unnamed: J31.3, J36.3
unnamed: J31.4, J36.4
unnamed: J6.1, J33.1
unnamed: J6.2, J33.2
unnamed: J6.3, J33.3
unnamed: J6.4, J33.4
