bnepethomas/bne-arduino-flight-simulator-interfaces/Hornet/Hornet PCBs/Active/VerySmallPanel/VerySmallPanel.sch

## KiCad design Hornet/Hornet PCBs/Active/VerySmallPanel/VerySmallPanel.sch (2025-11-29)

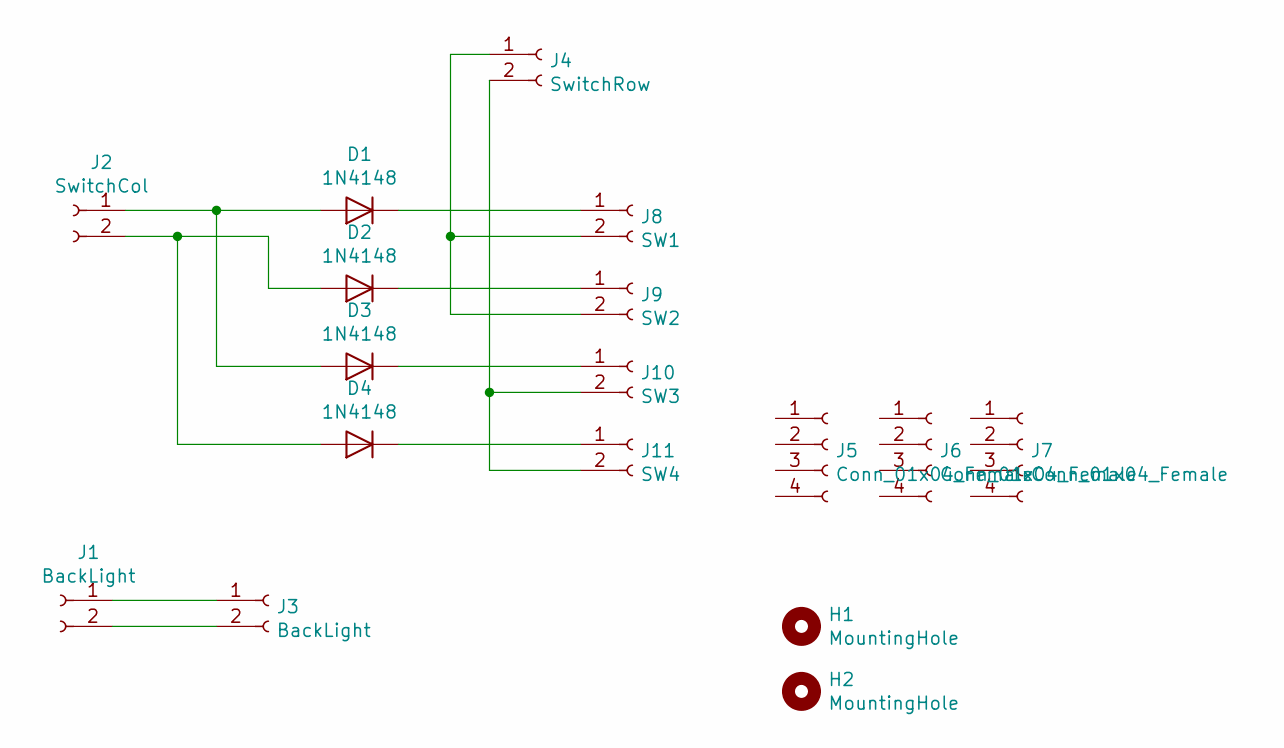
[picture p613: schematic VerySmallPanel.sch]

Parts:
D1, D2, D3, D4: 1N4148; PT_R_Axial_DIN0204_L3.6mm_D1.6mm_P2.54mm_Vertical
H1, H2: MountingHole; MountingHole_3.2mm_M3
J1, J3: BackLight; Molex_1x02_P2.54mm_Vertical
J2: SwitchCol; Molex_1x02_P2.54mm_Vertical
J4: SwitchRow; Molex_1x02_P2.54mm_Vertical
J5, J6, J7: Conn_01x04_Female; PinSocket_1x04_P2.54mm_Vertical
J8: SW1; Molex_1x02_P2.54mm_Vertical
J9: SW2; Molex_1x02_P2.54mm_Vertical
J10: SW3; Molex_1x02_P2.54mm_Vertical
J11: SW4; Molex_1x02_P2.54mm_Vertical

Connections:
unnamed: D1.1 (K), J8.1
unnamed: D1.2 (A), D3.2 (A), J2.1
unnamed: D2.1 (K), J9.1
unnamed: D2.2 (A), D4.2 (A), J2.2
unnamed: D3.1 (K), J10.1
unnamed: D4.1 (K), J11.1
unnamed: J1.1, J3.1
unnamed: J1.2, J3.2
unnamed: J4.1, J8.2, J9.2
unnamed: J4.2, J10.2, J11.2
