bnepethomas/bne-arduino-flight-simulator-interfaces/Hornet/Hornet PCBs/Active/pcb1/pcb1.sch

## KiCad design Hornet/Hornet PCBs/Active/pcb1/pcb1.sch (2025-11-29)

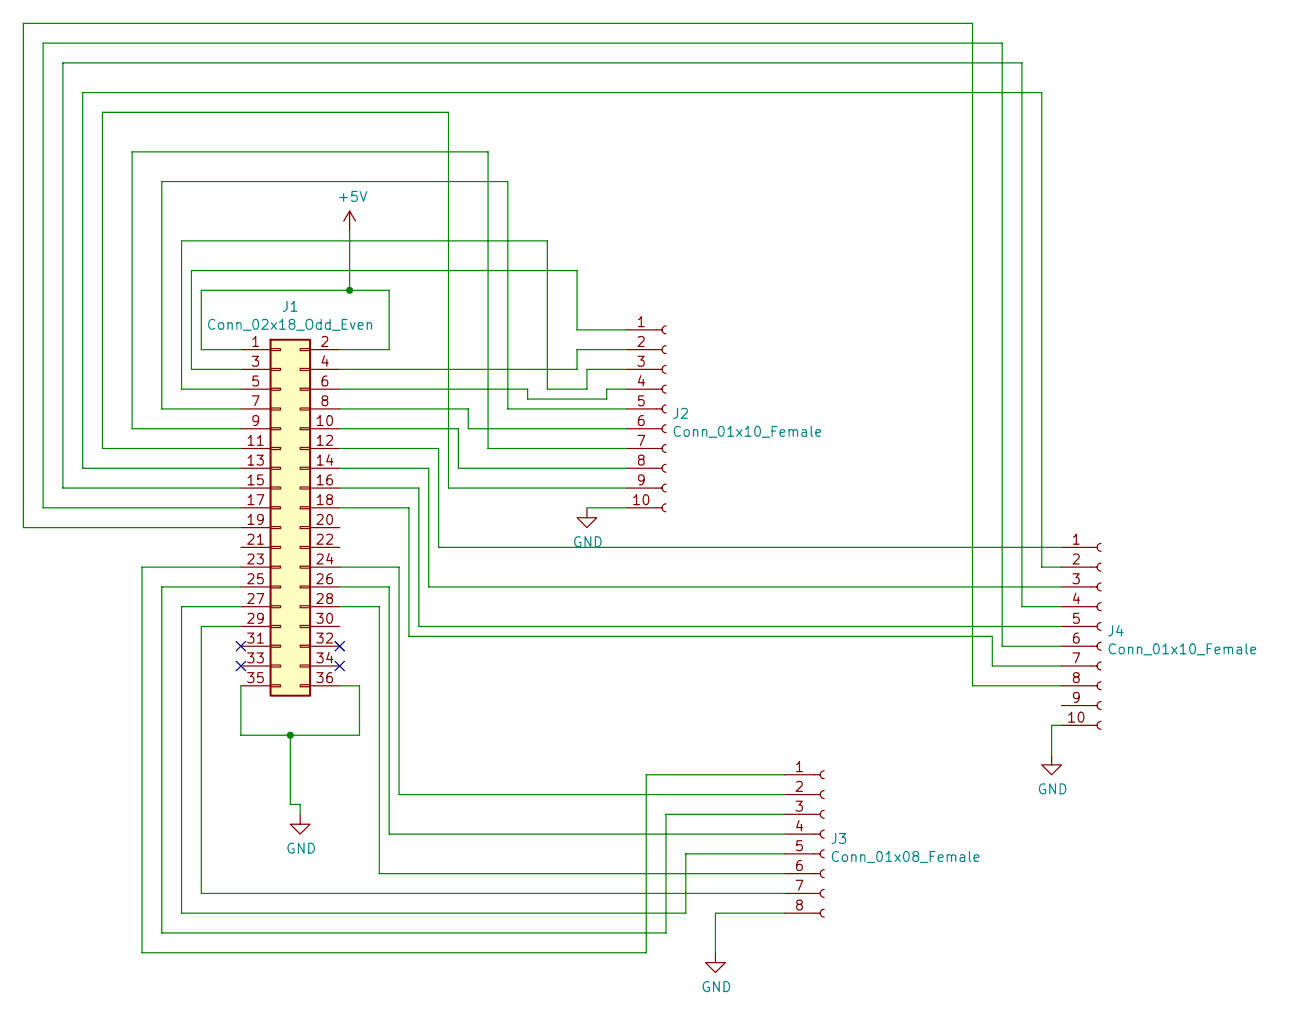
[picture p614: schematic pcb1.sch]

Parts:
J1: Conn_02x18_Odd_Even; PinHeader_2x18_P2.54mm_Vertical
J2, J4: Conn_01x10_Female; PinHeader_1x10_P2.54mm_Vertical
J3: Conn_01x08_Female; PinHeader_1x08_P2.54mm_Vertical

Connections:
+5V: J1.1, J1.2
GND: J1.35, J1.36, J2.10, J3.8, J4.10
unnamed: J1.3, J2.1
unnamed: J1.4, J2.2
unnamed: J1.5, J2.3
unnamed: J1.6, J2.4
unnamed: J1.7, J2.5
unnamed: J1.8, J2.6
unnamed: J1.9, J2.7
unnamed: J1.10, J2.8
unnamed: J1.11, J2.9
unnamed: J1.12, J4.1
unnamed: J1.13, J4.2
unnamed: J1.14, J4.3
unnamed: J1.15, J4.4
unnamed: J1.16, J4.5
unnamed: J1.17, J4.6
unnamed: J1.18, J4.7
unnamed: J1.19, J4.8
unnamed: J1.23, J3.1
unnamed: J1.24, J3.2
unnamed: J1.25, J3.3
unnamed: J1.26, J3.4
unnamed: J1.27, J3.5
unnamed: J1.28, J3.6
unnamed: J1.29, J3.7
