bnepethomas/bne-arduino-flight-simulator-interfaces/Hornet/Hornet PCBs/Active/standby_altimeter/standby_altimeter.kicad_sch

## KiCad design Hornet/Hornet PCBs/Active/standby_altimeter/standby_altimeter.kicad_sch (2025-11-29)

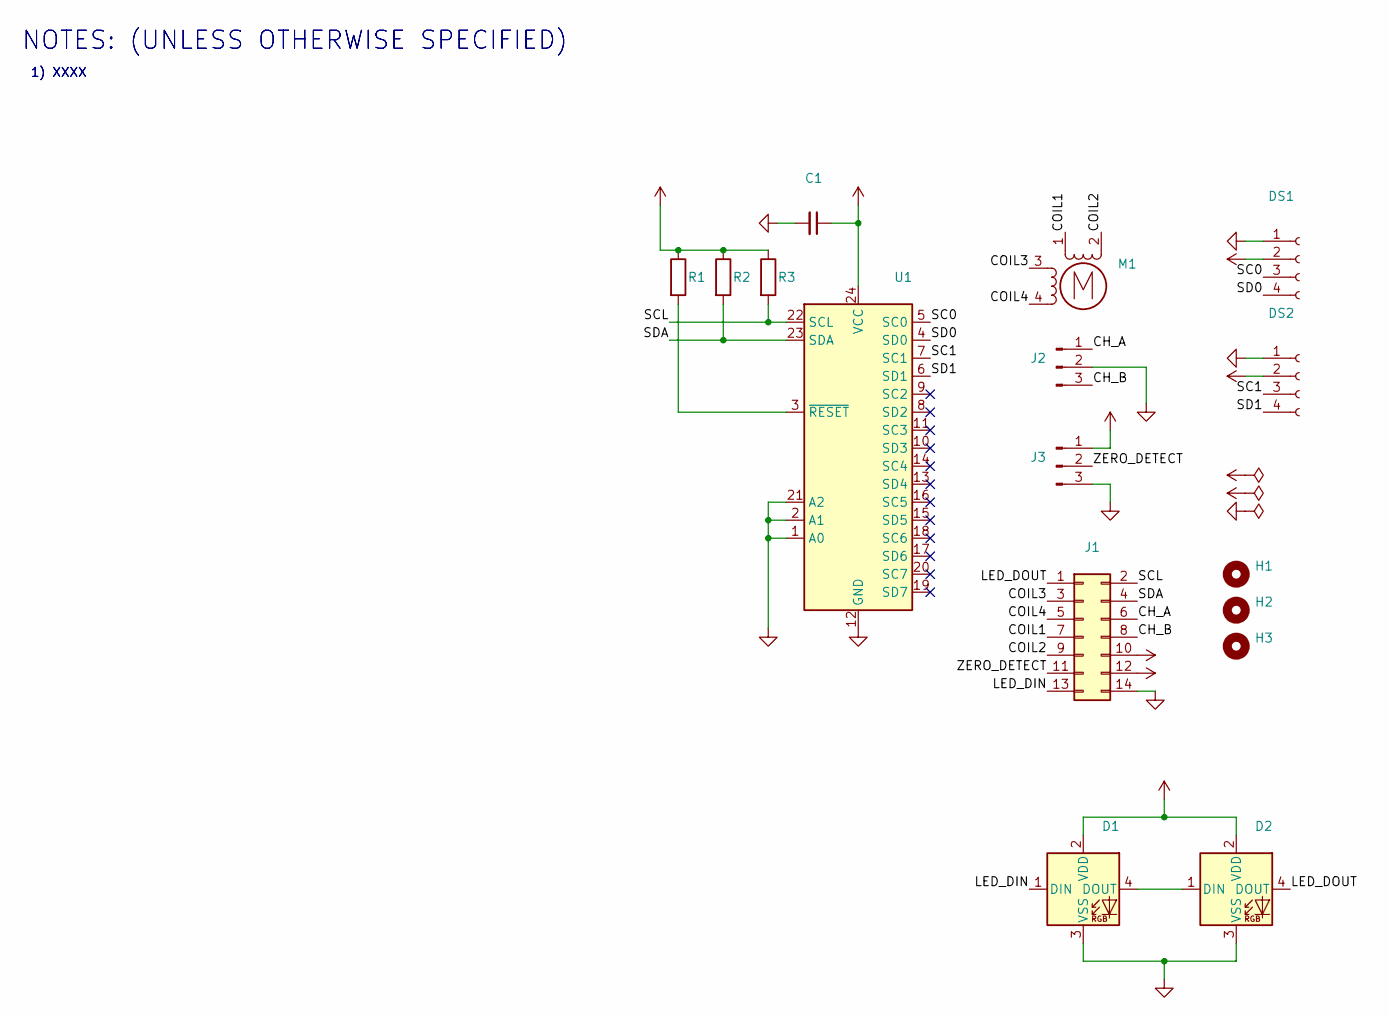
[picture p616: schematic standby_altimeter.kicad_sch]

Parts:
C1: LCSC C96123
D1, D2: (no value)
DS1, DS2: (no value)
H1, H2, H3: (no value)
J1, J2, J3: (no value)
M1: (no value)
R1, R2, R3: LCSC C25804
U1: LCSC C130026

Connections:
CH_A: J1.6, J2.1
CH_B: J1.8, J2.3
COIL1: J1.7, M1.1
COIL2: J1.9, M1.2 (-)
COIL3: J1.3, M1.3
COIL4: J1.5, M1.4
LED_DIN: D1.1 (DIN), J1.13
LED_DOUT: D2.4 (DOUT), J1.1
unnamed: C1.1, C1.2, D1.2 (VDD), D1.3 (VSS), D2.2 (VDD), D2.3 (VSS), DS1.1, DS1.2, DS2.1, DS2.2, J1.10, J1.12, J1.14, J2.2, J3.1, J3.3, R1.1, R2.1, R3.1, U1.1 (A0), U1.2 (A1), U1.12 (GND), U1.21 (A2), U1.24 (VCC)
unnamed: D1.4 (DOUT), D2.1 (DIN)
unnamed: R1.2, U1.3 (~RESET)
SC0: DS1.3, U1.5 (SC0)
SC1: DS2.3, U1.7 (SC1)
SCL: J1.2, R3.2, U1.22 (SCL)
SD0: DS1.4, U1.4 (SD0)
SD1: DS2.4, U1.6 (SD1)
SDA: J1.4, R2.2, U1.23 (SDA)
ZERO_DETECT: J1.11, J3.2

Notes on the sheet:
1) XXXX
NOTES: (UNLESS OTHERWISE SPECIFIED)
