bnepethomas/bne-arduino-flight-simulator-interfaces/Hornet/Hornet PCBs/Active/util_photoswitch/util_photoswitch.kicad_sch

## KiCad design Hornet/Hornet PCBs/Active/util_photoswitch/util_photoswitch.kicad_sch (2025-11-29)

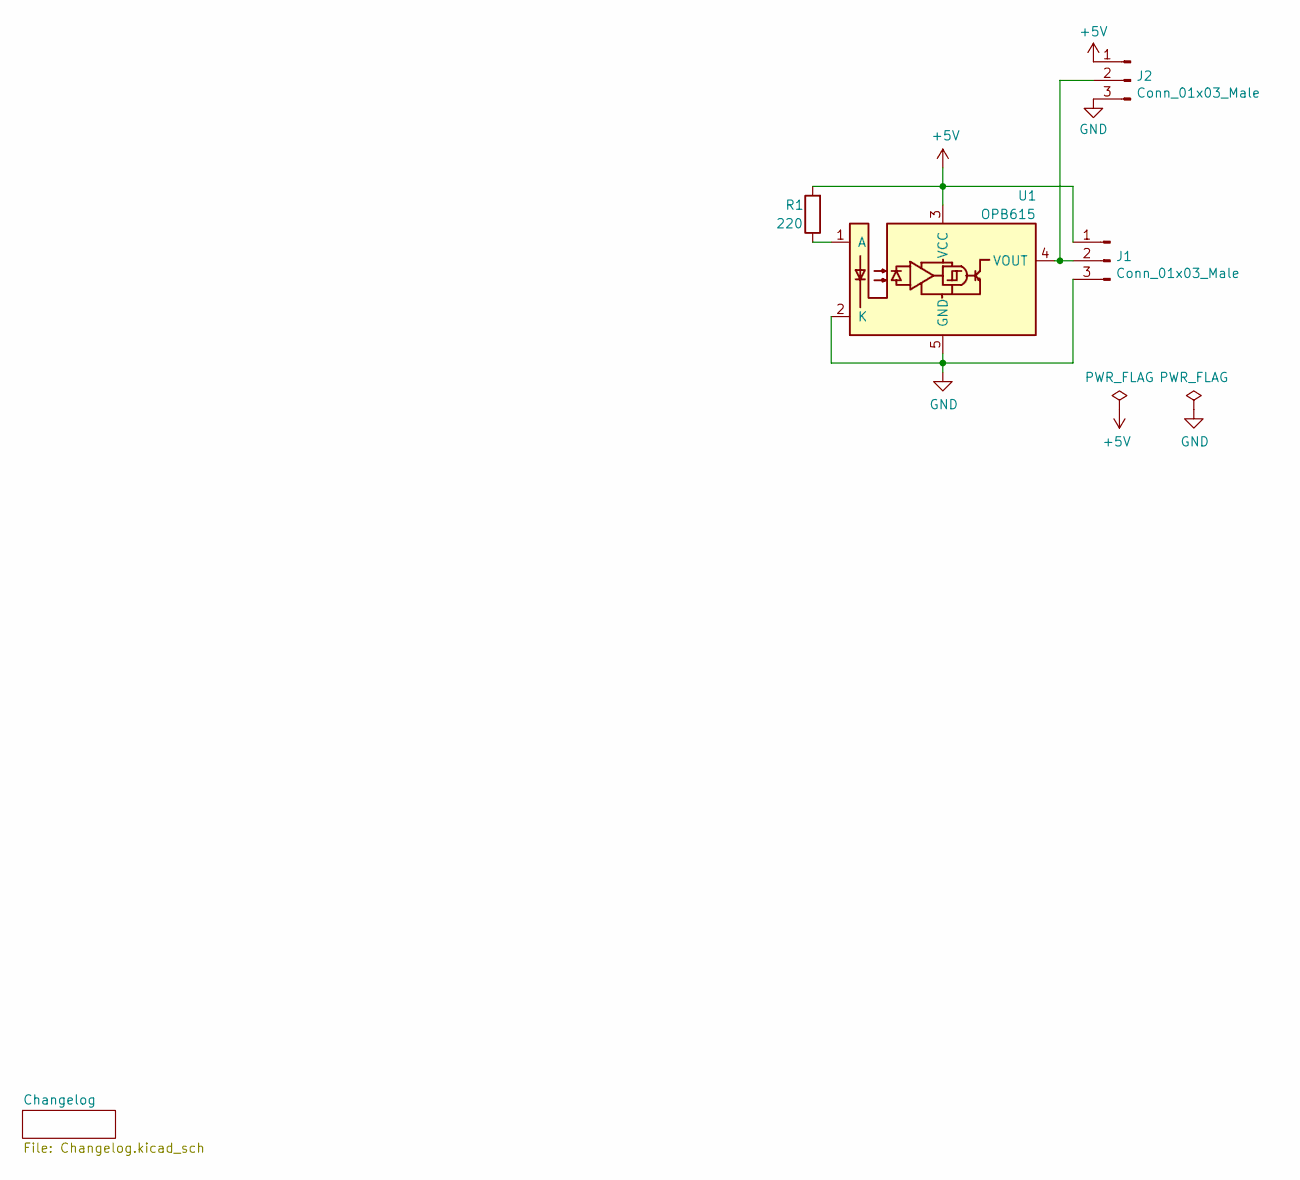
[picture p617: schematic util_photoswitch.kicad_sch]

Parts:
J1: Conn_01x03_Male; PinHeader_1x03_P2.54mm_Horizontal
J2: Conn_01x03_Male; PinHeader_1x03_P2.54mm_Vertical
R1: 220; R_Axial_DIN0207_L6.3mm_D2.5mm_P7.62mm_Horizontal
U1: OPB615; OPB61x

Connections:
+5V: J1.1, J2.1, R1.2, U1.3 (VCC)
GND: J1.3, J2.3, U1.2 (K), U1.5 (GND)
unnamed: J1.2, J2.2, U1.4 (VOUT)
unnamed: R1.1, U1.1 (A)
