bnepethomas/bne-arduino-flight-simulator-interfaces/A10/A10 PCBs/General Use/Gauges/Analog Instruments Small Engine/Analog Instruments Small Engine.kicad_sch

## KiCad design A10/A10 PCBs/General Use/Gauges/Analog Instruments Small Engine/Analog Instruments Small Engine.kicad_sch (2025-11-29)

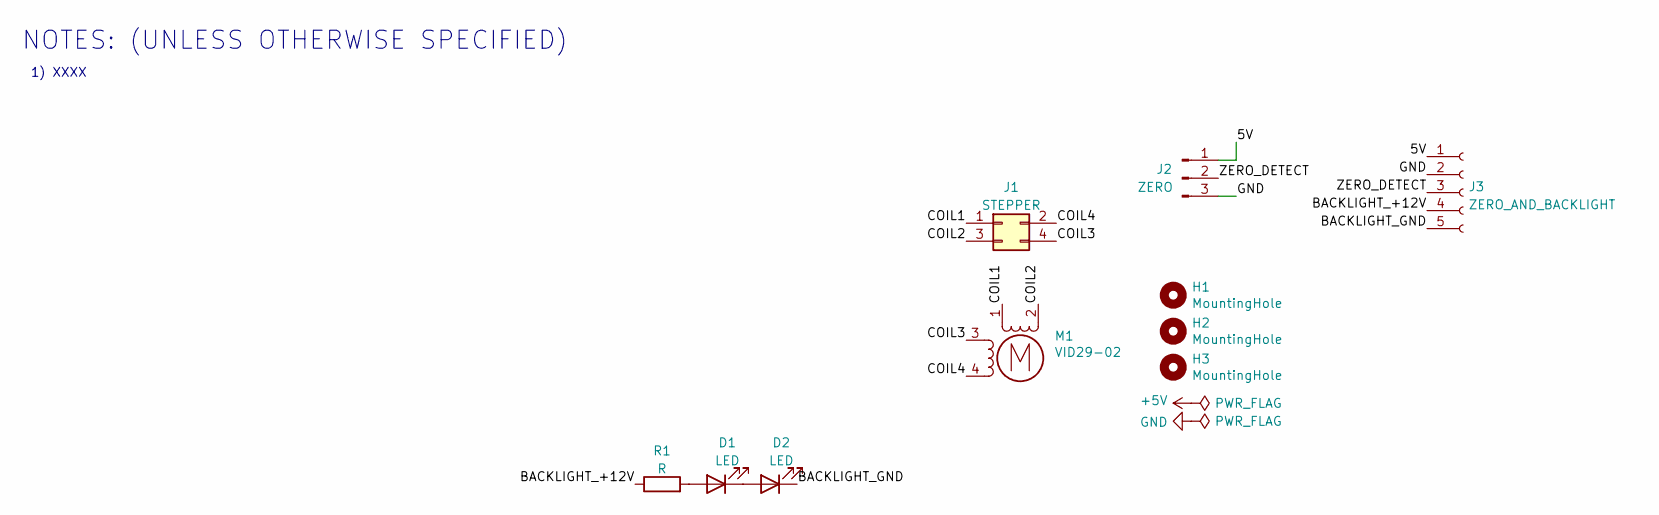
[picture p618: schematic Analog Instruments Small Engine.kicad_sch]

Parts:
D1, D2: LED; LED_D5.0mm
H1, H2, H3: MountingHole; MountingHole_2.5mm
J1: STEPPER; Molex_PicoBlade_53047-0410_1x04_P1.25mm_Vertical
J2: ZERO; PinHeader_1x03_P2.54mm_Vertical
J3: ZERO_AND_BACKLIGHT; Molex_PicoBlade_53047-0510_1x05_P1.25mm_Vertical
M1: VID29-02
R1: R; R_Axial_DIN0204_L3.6mm_D1.6mm_P1.90mm_Vertical

Connections:
5V: J2.1, J3.1
BACKLIGHT_+12V: J3.4, R1.1
BACKLIGHT_GND: D2.1 (K), J3.5
COIL1: J1.1, M1.1
COIL2: J1.3, M1.2 (-)
COIL3: J1.4, M1.3
COIL4: J1.2, M1.4
GND: J2.3, J3.2
unnamed: D1.1 (K), D2.2 (A)
unnamed: D1.2 (A), R1.2
ZERO_DETECT: J2.2, J3.3

Notes on the sheet:
1) XXXX
NOTES: (UNLESS OTHERWISE SPECIFIED)
