bnepethomas/bne-arduino-flight-simulator-interfaces/A10/A10 PCBs/General Use/Gauges/Simmeters Small Engine Replacement/Simmeters Small Engine Replacement.kicad_sch

## KiCad design A10/A10 PCBs/General Use/Gauges/Simmeters Small Engine Replacement/Simmeters Small Engine Replacement.kicad_sch (2025-11-29)

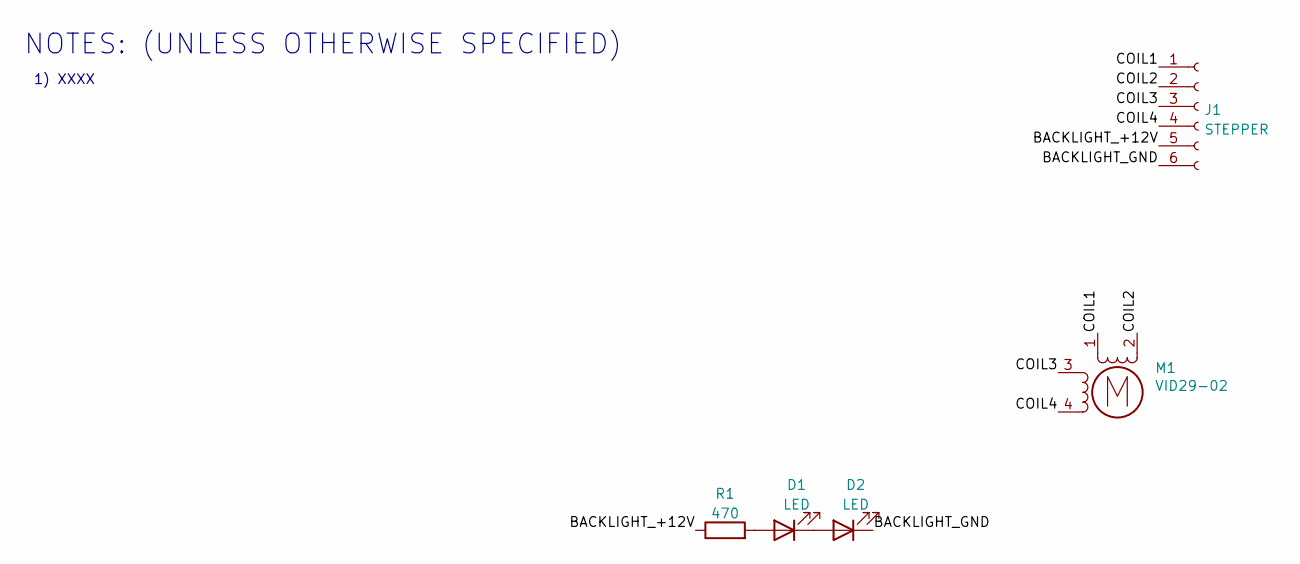
[picture p619: schematic Simmeters Small Engine Replacement.kicad_sch]

Parts:
D1, D2: LED; LED_D3.0mm
J1: STEPPER; Molex_KK-254_AE-6410-06A_1x06_P2.54mm_Vertical
M1: VID29-02; VID29-05P
R1: 470; R_Axial_DIN0204_L3.6mm_D1.6mm_P1.90mm_Vertical

Connections:
BACKLIGHT_+12V: J1.5, R1.1
BACKLIGHT_GND: D2.1 (K), J1.6
COIL1: J1.1, M1.1
COIL2: J1.2, M1.2 (-)
COIL3: J1.3, M1.3
COIL4: J1.4, M1.4
unnamed: D1.1 (K), D2.2 (A)
unnamed: D1.2 (A), R1.2

Notes on the sheet:
1) XXXX
NOTES: (UNLESS OTHERWISE SPECIFIED)
