bnepethomas/bne-arduino-flight-simulator-interfaces/Hornet/Hornet PCBs/Active/AV COOL PANEL/Power DB/Power DB.kicad_sch

## KiCad design Hornet/Hornet PCBs/Active/AV COOL PANEL/Power DB/Power DB.kicad_sch (2025-11-29)

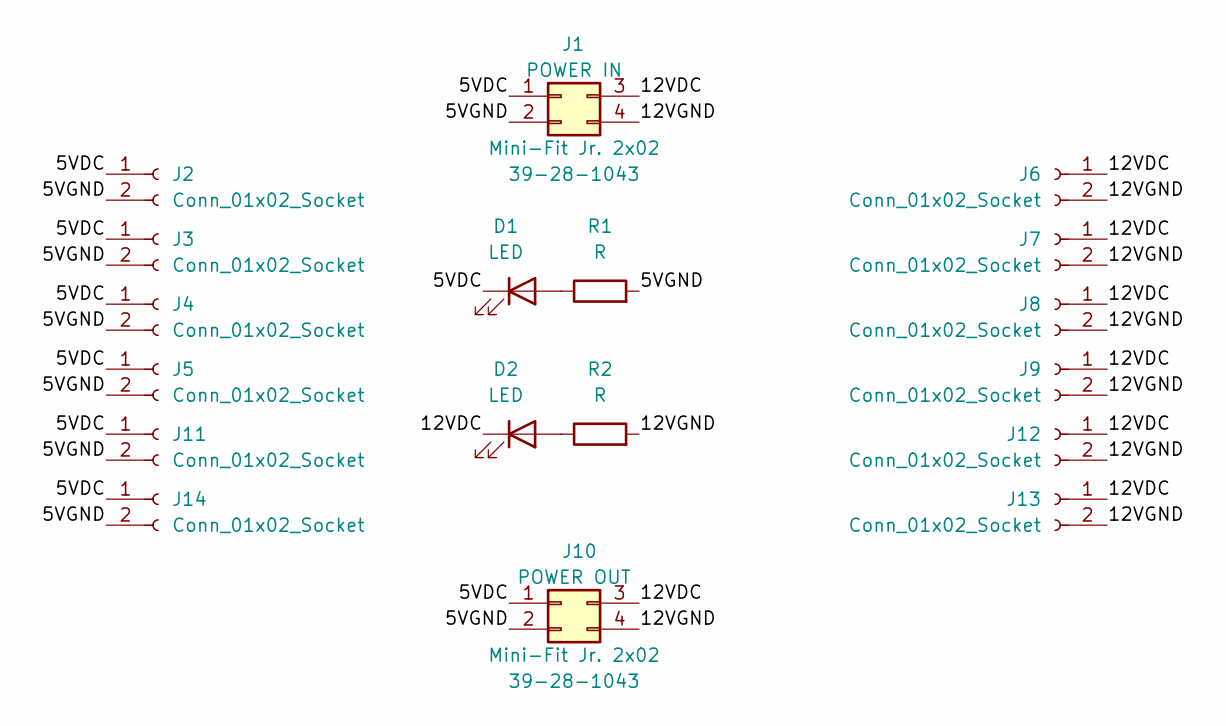
[picture p620: schematic Power DB.kicad_sch]

Parts:
D1, D2: LED; LED_0805_2012Metric
J1, J10: Mini-Fit Jr. 2x02; Molex_Mini-Fit_Jr_5566-04A_2x02_P4.20mm_Vertical; Manufacturer PN 39-28-1043; LCSC C293502
J2, J3, J4, J5, J6, J7, J8, J9, J11, J12, J13, J14: Conn_01x02_Socket; BarrelJack_Horizontal
R1, R2: R; R_0805_2012Metric

Connections:
5VDC: D1.1 (K), J1.1, J2.1, J3.1, J4.1, J5.1, J10.1, J11.1, J14.1
5VGND: J1.2 (Pin_3), J2.2, J3.2, J4.2, J5.2, J10.2 (Pin_3), J11.2, J14.2, R1.2
12VDC: D2.1 (K), J1.3 (Pin_2), J6.1, J7.1, J8.1, J9.1, J10.3 (Pin_2), J12.1, J13.1
12VGND: J1.4, J6.2, J7.2, J8.2, J9.2, J10.4, J12.2, J13.2, R2.2
unnamed: D1.2 (A), R1.1
unnamed: D2.2 (A), R2.1
