bnepethomas/bne-arduino-flight-simulator-interfaces/Hornet/Hornet PCBs/Active/Backlighting V2/APU-Combined/APU-Combined.kicad_sch

## KiCad design Hornet/Hornet PCBs/Active/Backlighting V2/APU-Combined/APU-Combined.kicad_sch (2025-11-29)

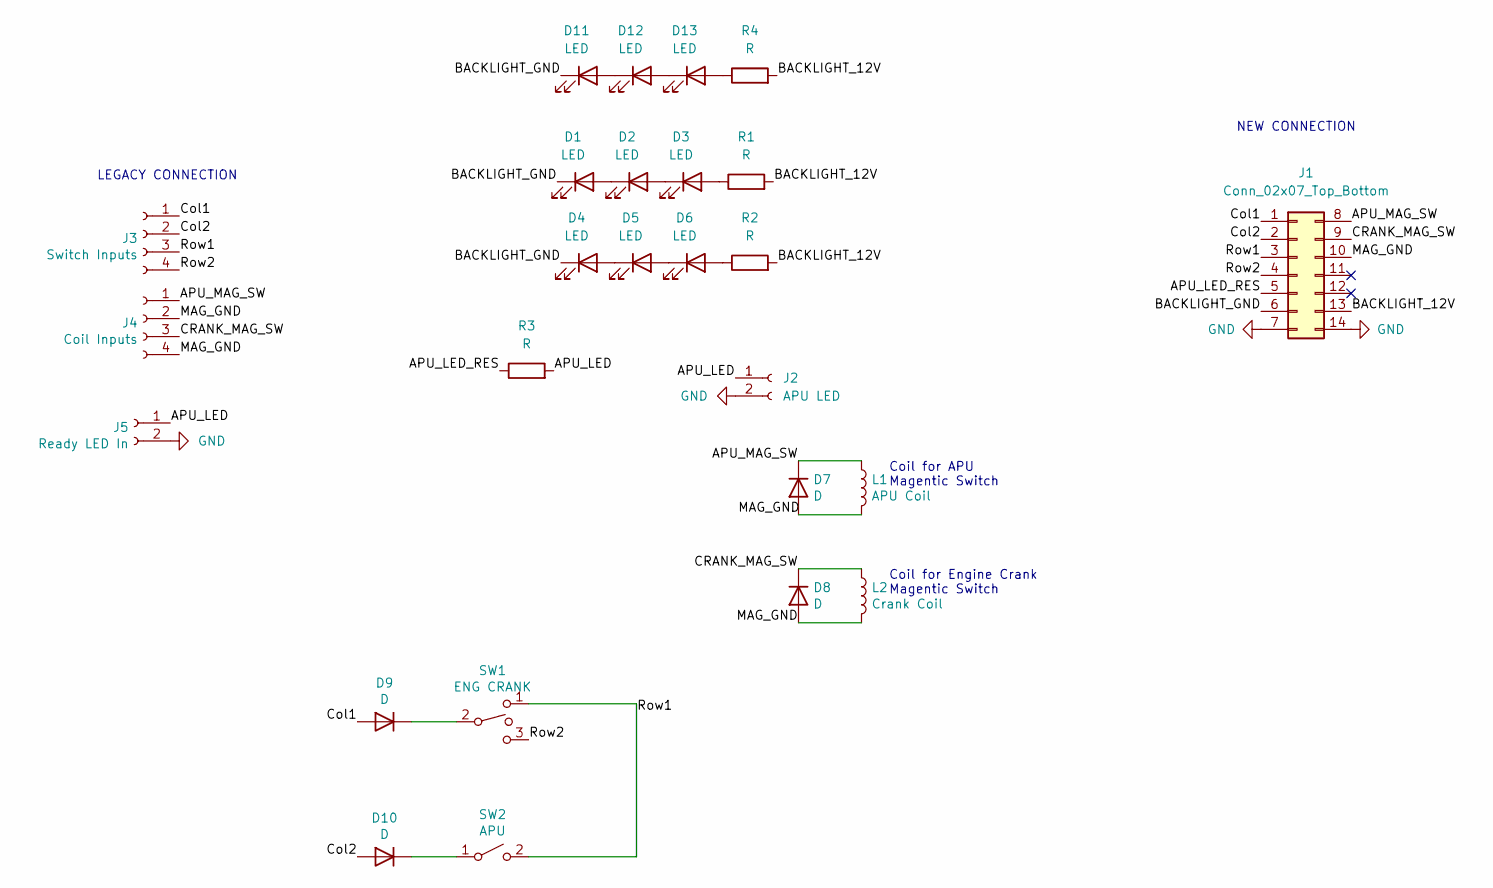
[picture p621: schematic APU-Combined.kicad_sch]

Parts:
D1, D2, D3, D4, D5, D6, D11, D12, D13: LED; LED_D3.0mm_FlatTop
D7, D8: D; D_DO-41_SOD81_P7.62mm_Horizontal
D9, D10: D; D_DO-34_SOD68_P7.62mm_Horizontal
J1: Conn_02x07_Top_Bottom; PinHeader_2x07_P2.54mm_Vertical
J2: APU LED; Molex_KK-254_AE-6410-02A_1x02_P2.54mm_Vertical
J3: Switch Inputs; Molex_KK-254_AE-6410-04A_1x04_P2.54mm_Vertical
J4: Coil Inputs; Molex_KK-254_AE-6410-04A_1x04_P2.54mm_Vertical
J5: Ready LED In; Molex_KK-254_AE-6410-02A_1x02_P2.54mm_Vertical
L1: APU Coil; Molex_KK-254_AE-6410-02A_1x02_P2.54mm_Vertical
L2: Crank Coil; Molex_KK-254_AE-6410-02A_1x02_P2.54mm_Vertical
R1, R2, R3, R4: R; R_Axial_DIN0204_L3.6mm_D1.6mm_P7.62mm_Horizontal
SW1: ENG CRANK; Molex_KK-254_AE-6410-03A_1x03_P2.54mm_Vertical
SW2: APU; Molex_KK-254_AE-6410-02A_1x02_P2.54mm_Vertical

Connections:
APU_LED: J2.1, J5.1, R3.2
APU_LED_RES: J1.5, R3.1
APU_MAG_SW: D7.1 (K), J1.8, J4.1, L1.1
BACKLIGHT_12V: J1.13, R1.2, R2.2, R4.2
BACKLIGHT_GND: D1.1 (K), D4.1 (K), D11.1 (K), J1.6
CRANK_MAG_SW: D8.1 (K), J1.9, J4.3, L2.1
Col1: D9.2 (A), J1.1, J3.1
Col2: D10.2 (A), J1.2, J3.2
GND: J1.7, J1.14, J2.2, J5.2
MAG_GND: D7.2 (A), D8.2 (A), J1.10, J4.2, J4.4, L1.2, L2.2
unnamed: D1.2 (A), D2.1 (K)
unnamed: D2.2 (A), D3.1 (K)
unnamed: D3.2 (A), R1.1
unnamed: D4.2 (A), D5.1 (K)
unnamed: D5.2 (A), D6.1 (K)
unnamed: D6.2 (A), R2.1
unnamed: D9.1 (K), SW1.2
unnamed: D10.1 (K), SW2.1 (A)
unnamed: D11.2 (A), D12.1 (K)
unnamed: D12.2 (A), D13.1 (K)
unnamed: D13.2 (A), R4.1
Row1: J1.3, J3.3, SW1.1, SW2.2 (B)
Row2: J1.4, J3.4, SW1.3

Notes on the sheet:
NEW CONNECTION
Coil for Engine Crank Magentic Switch
LEGACY CONNECTION
Coil for APU Magentic Switch
