bnepethomas/bne-arduino-flight-simulator-interfaces/Hornet/Hornet PCBs/Active/Backlighting V2/INT-LT-F18/INT-LT-F18.kicad_sch

## KiCad design Hornet/Hornet PCBs/Active/Backlighting V2/INT-LT-F18/INT-LT-F18.kicad_sch (2025-11-29)

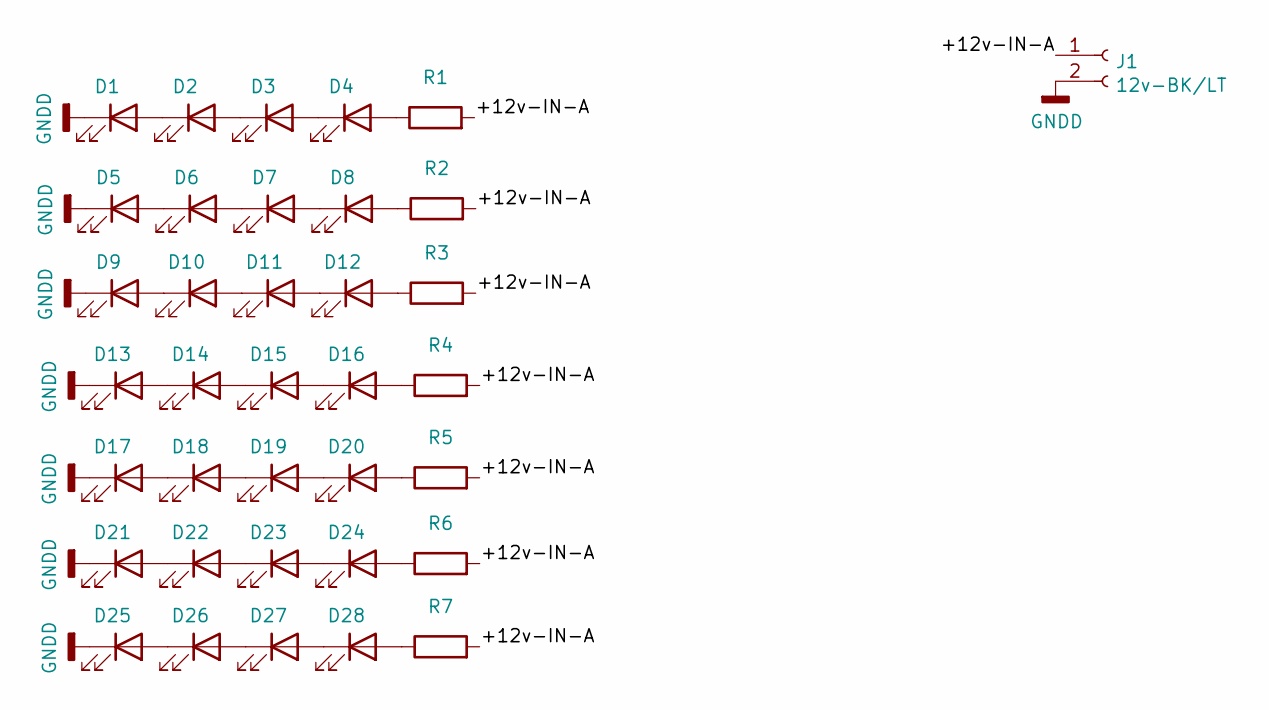
[picture p623: schematic INT-LT-F18.kicad_sch]

Parts:
D1, D2, D3, D4, D5, D6, D7, D8, D9, D10, D11, D12, D13, D14, D15, D16, D17, D18, D19, D20, D21, D22, D23, D24, D25, D26, D27, D28: LED; LED_HL-A-3528U51GC-S1-13HL
J1: 12v-BK/LT; Molex_KK-254_AE-6410-02A_1x02_P2.54mm_Vertical
R1, R2, R3, R4, R5, R6, R7: 180; R_0402_1005Metric

Connections:
+12v-IN-A: J1.1, R1.2, R2.2, R3.2, R4.2, R5.2, R6.2, R7.2
GNDD: D1.1 (K), D5.1 (K), D9.1 (K), D13.1 (K), D17.1 (K), D21.1 (K), D25.1 (K), J1.2
unnamed: D1.2 (A), D2.1 (K)
unnamed: D2.2 (A), D3.1 (K)
unnamed: D3.2 (A), D4.1 (K)
unnamed: D4.2 (A), R1.1
unnamed: D5.2 (A), D6.1 (K)
unnamed: D6.2 (A), D7.1 (K)
unnamed: D7.2 (A), D8.1 (K)
unnamed: D8.2 (A), R2.1
unnamed: D9.2 (A), D10.1 (K)
unnamed: D10.2 (A), D11.1 (K)
unnamed: D11.2 (A), D12.1 (K)
unnamed: D12.2 (A), R3.1
unnamed: D13.2 (A), D14.1 (K)
unnamed: D14.2 (A), D15.1 (K)
unnamed: D15.2 (A), D16.1 (K)
unnamed: D16.2 (A), R4.1
unnamed: D17.2 (A), D18.1 (K)
unnamed: D18.2 (A), D19.1 (K)
unnamed: D19.2 (A), D20.1 (K)
unnamed: D20.2 (A), R5.1
unnamed: D21.2 (A), D22.1 (K)
unnamed: D22.2 (A), D23.1 (K)
unnamed: D23.2 (A), D24.1 (K)
unnamed: D24.2 (A), R6.1
unnamed: D25.2 (A), D26.1 (K)
unnamed: D26.2 (A), D27.1 (K)
unnamed: D27.2 (A), D28.1 (K)
unnamed: D28.2 (A), R7.1
