bnepethomas/bne-arduino-flight-simulator-interfaces/Hornet/Hornet PCBs/Active/Backlighting V2/Landing_Gear_Panel_PCB_LED-V1.0/Landing Gear Panel PCB V2.kicad_sch

## KiCad design Hornet/Hornet PCBs/Active/Backlighting V2/Landing_Gear_Panel_PCB_LED-V1.0/Landing Gear Panel PCB V2.kicad_sch (2025-11-29)

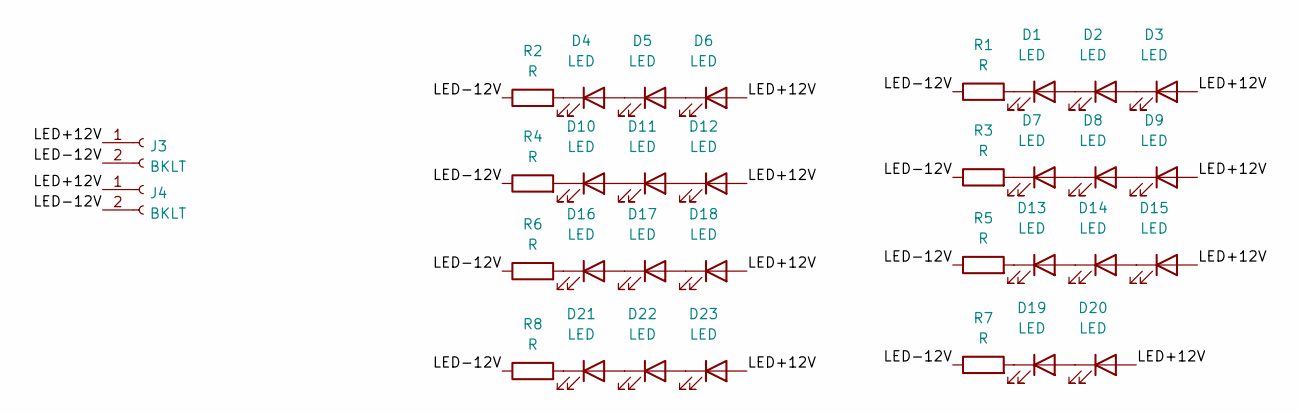
[picture p624: schematic Landing Gear Panel PCB V2.kicad_sch]

Parts:
D1, D2, D3, D4, D5, D6, D7, D8, D9, D10, D11, D12, D13, D14, D15, D16, D17, D18, D19, D20, D21, D22, D23: LED; LED_D3.0mm
J3, J4: BKLT; Molex_KK-254_AE-6410-02A_1x02_P2.54mm_Vertical
R1, R2, R3, R4, R5, R6, R7, R8: R; R_Axial_DIN0204_L3.6mm_D1.6mm_P2.54mm_Vertical

Connections:
LED+12V: D3.2 (A), D6.2 (A), D9.2 (A), D12.2 (A), D15.2 (A), D18.2 (A), D20.2 (A), D23.2 (A), J3.1, J4.1
LED-12V: J3.2, J4.2, R1.1, R2.1, R3.1, R4.1, R5.1, R6.1, R7.1, R8.1
unnamed: D1.1 (K), R1.2
unnamed: D1.2 (A), D2.1 (K)
unnamed: D2.2 (A), D3.1 (K)
unnamed: D4.1 (K), R2.2
unnamed: D4.2 (A), D5.1 (K)
unnamed: D5.2 (A), D6.1 (K)
unnamed: D7.1 (K), R3.2
unnamed: D7.2 (A), D8.1 (K)
unnamed: D8.2 (A), D9.1 (K)
unnamed: D10.1 (K), R4.2
unnamed: D10.2 (A), D11.1 (K)
unnamed: D11.2 (A), D12.1 (K)
unnamed: D13.1 (K), R5.2
unnamed: D13.2 (A), D14.1 (K)
unnamed: D14.2 (A), D15.1 (K)
unnamed: D16.1 (K), R6.2
unnamed: D16.2 (A), D17.1 (K)
unnamed: D17.2 (A), D18.1 (K)
unnamed: D19.1 (K), R7.2
unnamed: D19.2 (A), D20.1 (K)
unnamed: D21.1 (K), R8.2
unnamed: D21.2 (A), D22.1 (K)
unnamed: D22.2 (A), D23.1 (K)
