bnepethomas/bne-arduino-flight-simulator-interfaces/Hornet/Hornet PCBs/Active/Eyebrow_warning_indicators/Left/EWI_Left.sch

## KiCad design Hornet/Hornet PCBs/Active/Eyebrow_warning_indicators/Left/EWI_Left.sch (2025-11-29)

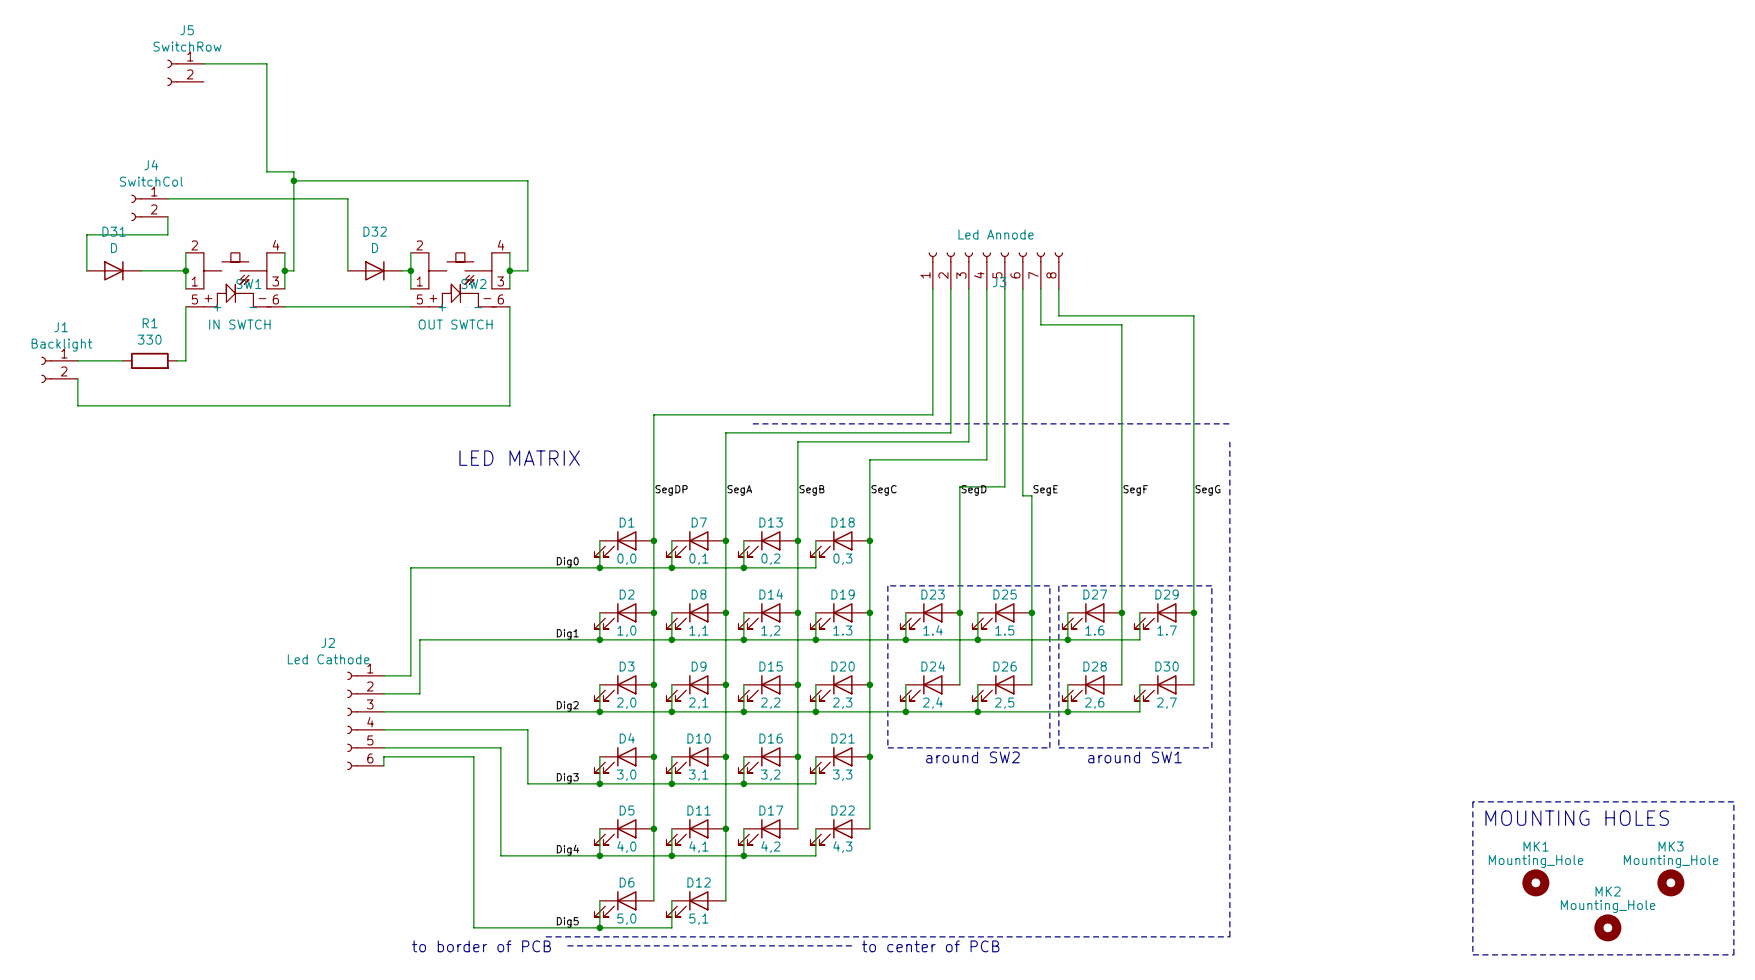
[picture p625: schematic EWI_Left.sch]

Parts:
D1: 0,0; LED_D3.0mm_FlatTop
D2: 1,0; LED_D3.0mm_FlatTop
D3: 2,0; LED_D3.0mm_FlatTop
D4: 3,0; LED_D3.0mm_FlatTop
D5: 4,0; LED_D3.0mm_FlatTop
D6: 5,0; LED_D3.0mm_FlatTop
D7: 0,1; LED_D3.0mm_FlatTop
D8: 1,1; LED_D3.0mm_FlatTop
D9: 2,1; LED_D3.0mm_FlatTop
D10: 3,1; LED_D3.0mm_FlatTop
D11: 4,1; LED_D3.0mm_FlatTop
D12: 5,1; LED_D3.0mm_FlatTop
D13: 0,2; LED_D3.0mm_FlatTop
D14: 1,2; LED_D3.0mm_FlatTop
D15: 2,2; LED_D3.0mm_FlatTop
D16: 3,2; LED_D3.0mm_FlatTop
D17: 4,2; LED_D3.0mm_FlatTop
D18: 0,3; LED_D3.0mm_FlatTop
D19: 1.3; LED_D3.0mm_FlatTop
D20: 2,3; LED_D3.0mm_FlatTop
D21: 3,3; LED_D3.0mm_FlatTop
D22: 4,3; LED_D3.0mm_FlatTop
D23: 1.4; LED_D3.0mm_FlatTop
D24: 2,4; LED_D3.0mm_FlatTop
D25: 1.5; LED_D3.0mm_FlatTop
D26: 2,5; LED_D3.0mm_FlatTop
D27: 1.6; LED_D3.0mm_FlatTop
D28: 2,6; LED_D3.0mm_FlatTop
D29: 1.7; LED_D3.0mm_FlatTop
D30: 2,7; LED_D3.0mm_FlatTop
D31, D32: D; D_Signal_P7.62mm_Horizontal
J1: Backlight; Molex_1x02_P2.54mm_Vertical
J2: Led Cathode; Molex_1x06_P2.54mm_Vertical
J3: Led Annode; Molex_1x08_P2.54mm_Vertical
J4: SwitchCol; Molex_1x02_P2.54mm_Vertical
J5: SwitchRow; Molex_1x02_P2.54mm_Vertical
MK1, MK2, MK3: Mounting_Hole; MountingHole_2.5mm
R1: 330; R_Axial_DIN0207_L6.3mm_D2.5mm_P7.62mm_Horizontal
SW1: IN SWTCH; PT_Small_Tactile_Switch_With_LED
SW2: OUT SWTCH; PT_Small_Tactile_Switch_With_LED

Connections:
Dig0: D1.1 (K), D7.1 (K), D13.1 (K), D18.1 (K), J2.1
Dig1: D2.1 (K), D8.1 (K), D14.1 (K), D19.1 (K), D23.1 (K), D25.1 (K), D27.1 (K), D29.1 (K), J2.2
Dig2: D3.1 (K), D9.1 (K), D15.1 (K), D20.1 (K), D24.1 (K), D26.1 (K), D28.1 (K), D30.1 (K), J2.3
Dig3: D4.1 (K), D10.1 (K), D16.1 (K), D21.1 (K), J2.4
Dig4: D5.1 (K), D11.1 (K), D17.1 (K), D22.1 (K), J2.5
Dig5: D6.1 (K), D12.1 (K), J2.6
unnamed: D31.1 (K), SW1.1, SW1.2
unnamed: D31.2 (A), J4.2
unnamed: D32.1 (K), SW2.1, SW2.2
unnamed: D32.2 (A), J4.1
unnamed: J1.1, R1.1
unnamed: J1.2, SW2.6 (-)
unnamed: J5.1, SW1.3, SW1.4, SW2.3, SW2.4
unnamed: R1.2, SW1.5 (+)
unnamed: SW1.6 (-), SW2.5 (+)
SegA: D7.2 (A), D8.2 (A), D9.2 (A), D10.2 (A), D11.2 (A), D12.2 (A), J3.2
SegB: D13.2 (A), D14.2 (A), D15.2 (A), D16.2 (A), D17.2 (A), J3.3
SegC: D18.2 (A), D19.2 (A), D20.2 (A), D21.2 (A), D22.2 (A), J3.4
SegD: D23.2 (A), D24.2 (A), J3.5
SegDP: D1.2 (A), D2.2 (A), D3.2 (A), D4.2 (A), D5.2 (A), D6.2 (A), J3.1
SegE: D25.2 (A), D26.2 (A), J3.6
SegF: D27.2 (A), D28.2 (A), J3.7
SegG: D29.2 (A), D30.2 (A), J3.8

Notes on the sheet:
MOUNTING HOLES
LED MATRIX
around SW1
around SW2
to center of PCB
to border of PCB
