bnepethomas/bne-arduino-flight-simulator-interfaces/Hornet/Hornet PCBs/Active/pcb1/pcb_combined/pcb_combined.sch

## KiCad design Hornet/Hornet PCBs/Active/pcb1/pcb_combined/pcb_combined.sch (2025-11-29)

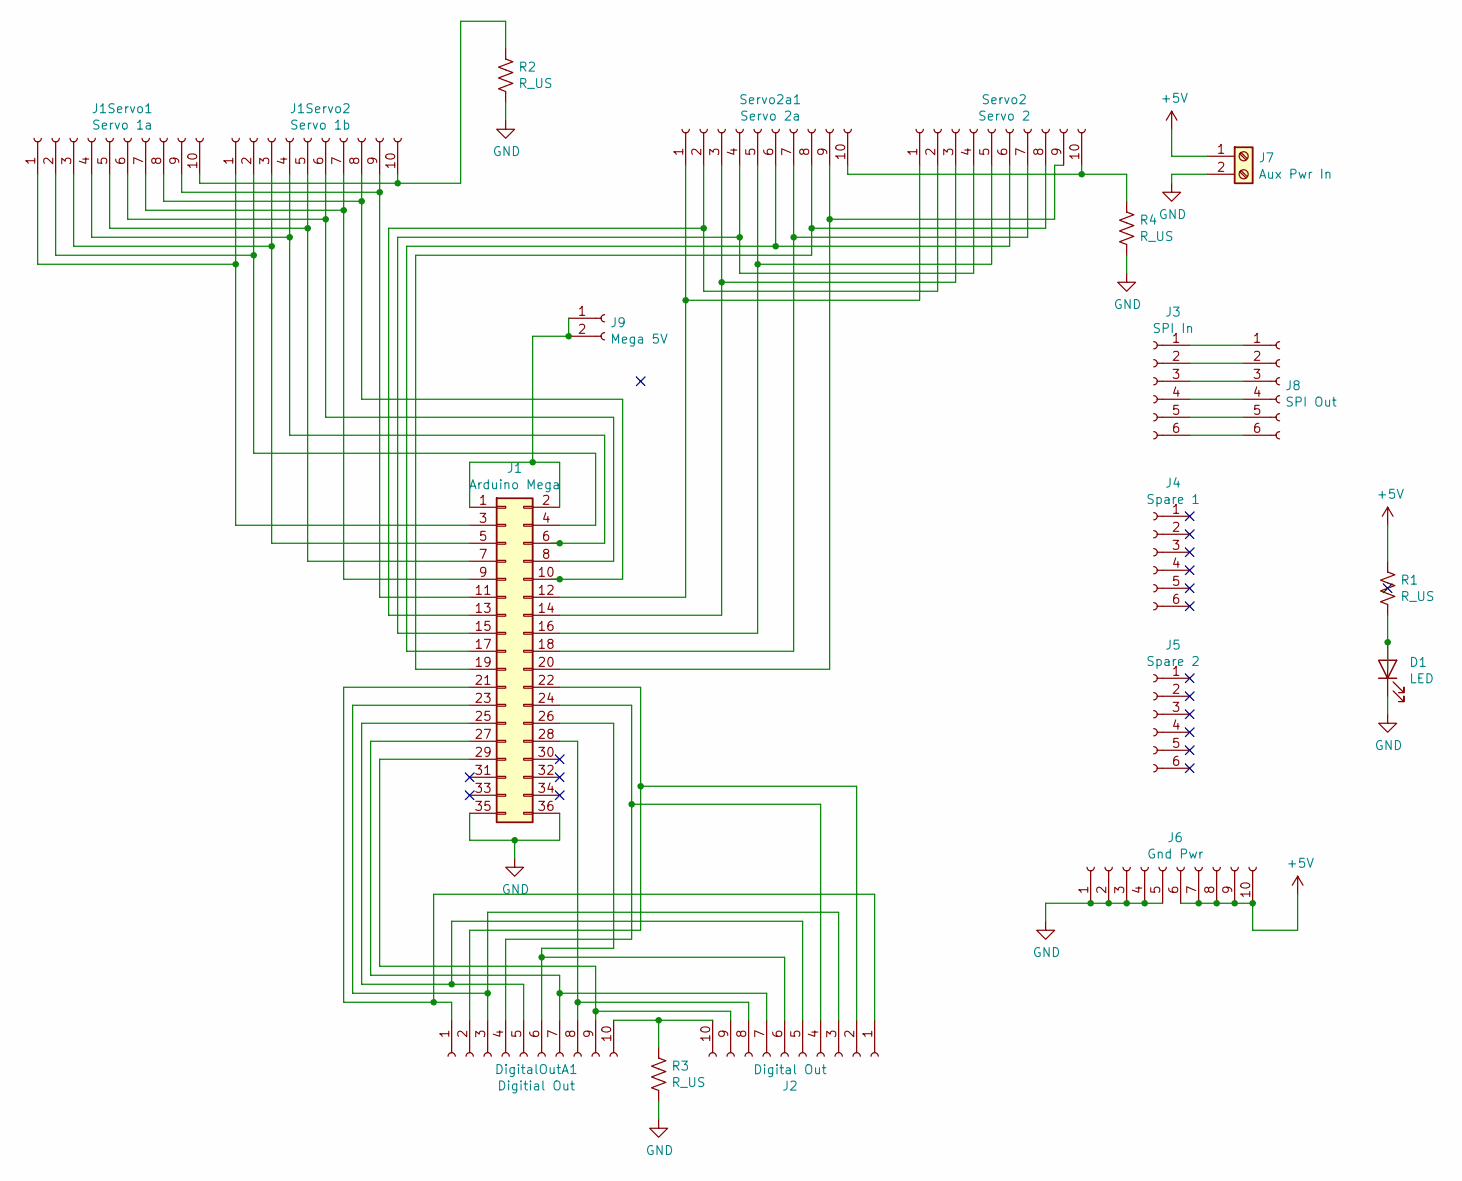
[picture p626: schematic pcb_combined.sch]

Parts:
D1: LED; LED_D5.0mm
DigitalOutA1: Digitial Out; PinHeader_1x10_P2.54mm_Vertical
J1: Arduino Mega; PinHeader_2x18_P2.54mm_Vertical
J1Servo1: Servo 1a; PinHeader_1x10_P2.54mm_Vertical
J1Servo2: Servo 1b; PinHeader_1x10_P2.54mm_Vertical
J2: Digital Out; PinHeader_1x10_P2.54mm_Vertical
J3: SPI In; PinHeader_1x06_P2.54mm_Vertical
J4: Spare 1; PinHeader_1x06_P2.54mm_Vertical
J5: Spare 2; PinHeader_1x06_P2.54mm_Vertical
J6: Gnd Pwr; PinHeader_1x10_P2.54mm_Vertical
J7: Aux Pwr In; TerminalBlock_bornier-2_P5.08mm
J8: SPI Out; PinHeader_1x06_P2.54mm_Vertical
J9: Mega 5V; PinHeader_1x02_P2.54mm_Vertical
R1, R2, R3, R4: R_US; R_Axial_DIN0207_L6.3mm_D2.5mm_P2.54mm_Vertical
Servo2: Servo 2; PinHeader_1x10_P2.54mm_Vertical
Servo2a1: Servo 2a; PinHeader_1x10_P2.54mm_Vertical

Connections:
+5V: J6.6, J6.7, J6.8, J6.9, J6.10, J7.1, R1.1
GND: D1.1 (K), J1.35, J1.36, J6.1, J6.2, J6.3, J6.4, J6.5, J7.2, R2.2, R3.2, R4.2
unnamed: D1.2 (A), R1.2
unnamed: DigitalOutA1.1, J1.21, J2.1
unnamed: DigitalOutA1.2, J1.22, J2.2
unnamed: DigitalOutA1.3, J1.23, J2.3
unnamed: DigitalOutA1.4, J1.24, J2.4
unnamed: DigitalOutA1.5, J1.25, J2.5
unnamed: DigitalOutA1.6, J1.26, J2.6
unnamed: DigitalOutA1.7, J1.27, J2.7
unnamed: DigitalOutA1.8, J1.28, J2.8
unnamed: DigitalOutA1.9, J1.29, J2.9
unnamed: DigitalOutA1.10, J2.10, R3.1
unnamed: J1.1, J1.2, J9.1, J9.2
unnamed: J1.3, J1Servo1.1, J1Servo2.1
unnamed: J1.4, J1Servo1.2, J1Servo2.2
unnamed: J1.5, J1Servo1.3, J1Servo2.3
unnamed: J1.6, J1Servo1.4, J1Servo2.4
unnamed: J1.7, J1Servo1.5, J1Servo2.5
unnamed: J1.8, J1Servo1.6, J1Servo2.6
unnamed: J1.9, J1Servo1.7, J1Servo2.7
unnamed: J1.10, J1Servo1.8, J1Servo2.8
unnamed: J1.11, J1Servo1.9, J1Servo2.9
unnamed: J1.12, Servo2.1, Servo2a1.1
unnamed: J1.13, Servo2.2, Servo2a1.2
unnamed: J1.14, Servo2.3, Servo2a1.3
unnamed: J1.15, Servo2.4, Servo2a1.4
unnamed: J1.16, Servo2.5, Servo2a1.5
unnamed: J1.17, Servo2.6, Servo2a1.6
unnamed: J1.18, Servo2.7, Servo2a1.7
unnamed: J1.19, Servo2.8, Servo2a1.8
unnamed: J1.20, Servo2.9, Servo2a1.9
unnamed: J1Servo1.10, J1Servo2.10, R2.1
unnamed: J3.1, J8.1
unnamed: J3.2, J8.2
unnamed: J3.3, J8.3
unnamed: J3.4, J8.4
unnamed: J3.5, J8.5
unnamed: J3.6, J8.6
unnamed: R4.1, Servo2.10, Servo2a1.10
