bnepethomas/bne-arduino-flight-simulator-interfaces/Hornet/Hornet PCBs/Active/Left Console/COMPASS/COMPASS-CONTROL/COMPASS-CONTROL.kicad_sch

## KiCad design Hornet/Hornet PCBs/Active/Left Console/COMPASS/COMPASS-CONTROL/COMPASS-CONTROL.kicad_sch (2025-11-29)

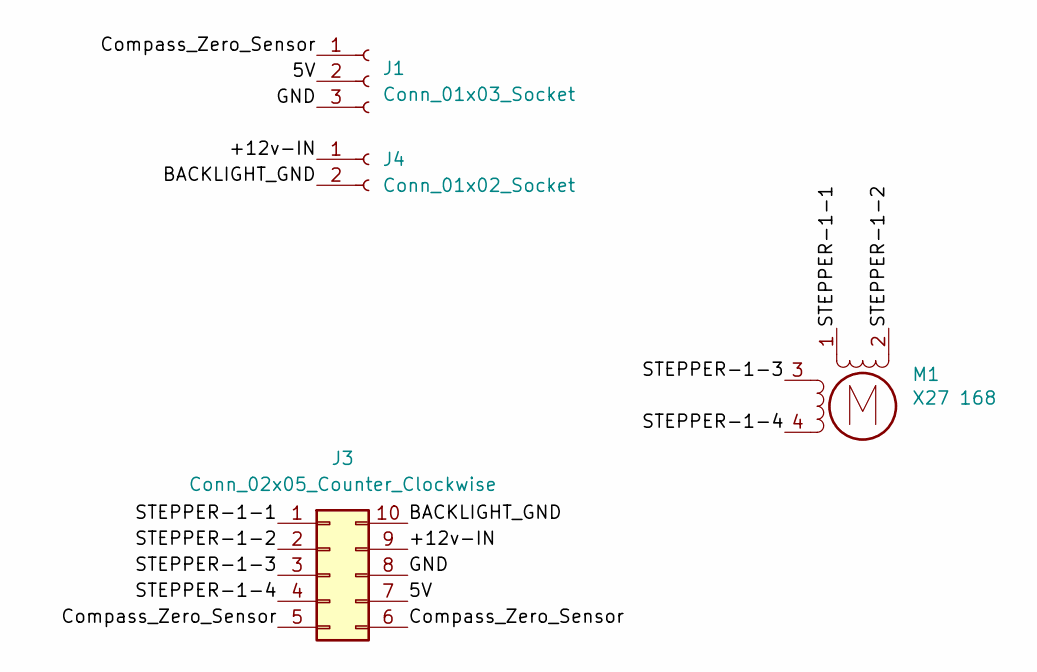
[picture p627: schematic COMPASS-CONTROL.kicad_sch]

Parts:
J1: Conn_01x03_Socket; Molex_KK-254_AE-6410-03A_1x03_P2.54mm_Vertical
J3: Conn_02x05_Counter_Clockwise; IDC-Header_2x05_P2.54mm_Vertical
J4: Conn_01x02_Socket; Molex_KK-254_AE-6410-02A_1x02_P2.54mm_Vertical
M1: X27 168; X27-168

Connections:
5V: J1.2, J3.7
+12v-IN: J3.9, J4.1
BACKLIGHT_GND: J3.10, J4.2
Compass_Zero_Sensor: J1.1, J3.5, J3.6
GND: J1.3, J3.8
STEPPER-1-1: J3.1, M1.1
STEPPER-1-2: J3.2, M1.2 (-)
STEPPER-1-3: J3.3, M1.3
STEPPER-1-4: J3.4, M1.4
