bnepethomas/bne-arduino-flight-simulator-interfaces/Hornet/Hornet PCBs/Active/Left Console/COMPASS/compass-STEPPER/compass-STEPPER.kicad_sch

## KiCad design Hornet/Hornet PCBs/Active/Left Console/COMPASS/compass-STEPPER/compass-STEPPER.kicad_sch (2025-11-29)

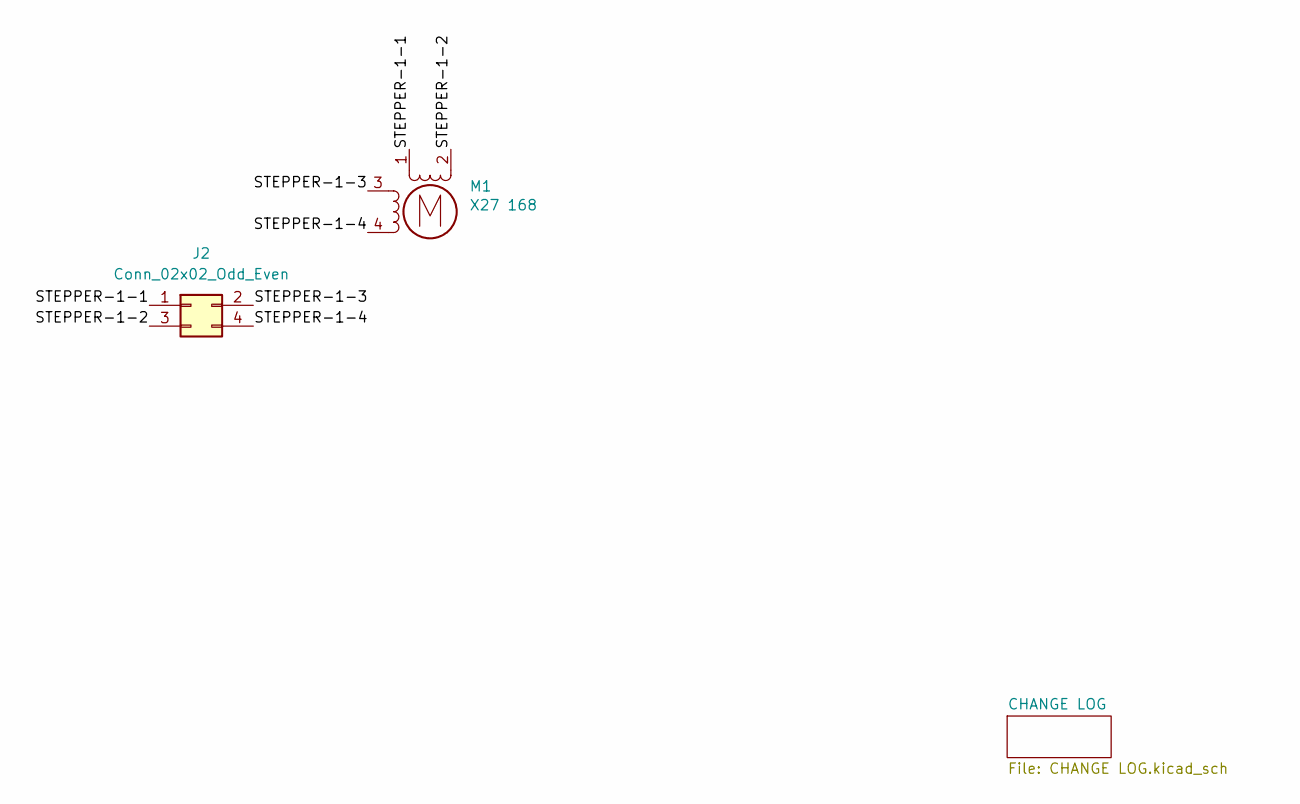
[picture p628: schematic compass-STEPPER.kicad_sch]

Parts:
J2: Conn_02x02_Odd_Even; PinHeader_2x02_P2.54mm_Vertical
M1: X27 168; X27-168

Connections:
STEPPER-1-1: J2.1, M1.1
STEPPER-1-2: J2.3, M1.2 (-)
STEPPER-1-3: J2.2, M1.3
STEPPER-1-4: J2.4, M1.4
