bnepethomas/bne-arduino-flight-simulator-interfaces/Jet Ranger/Jet Ranger Arduino Sketches/JET_RANGER_OLED_DUAL_STEPPER_CONTROLLER/JET_RANGER_OLED_DUAL_STEPPER_CONTROLLER.ino

/*
JET_RANGER_OLED_DUAL_STEPPERS

Based on Jet_Ranger_Steppers drivws dual stepper guages

Drives:

SARI
AccelStepper FuelLoadStepper
(ALTstepper, SpeedMaxstepper, FlapsStepper, AOAstepper, GForcestepper -
 all removed/commented out; no longer declared in this sketch)
AccelStepper EOTstepper
AccelStepper XOTstepper
AccelStepper XOPstepper
AccelStepper EGTstepper
AccelStepper TSstepper
AccelStepper RSstepper
AccelStepper FAstepper
AccelStepper ElectricalLoadStepper
AccelStepper GPstepper
AccelStepper EOPstepper

BACK_LIGHTS

*/


////////////////////---||||||||||********||||||||||---\\\\\\\\\\\\\\\\\\\\
//||               FUNCTION = JET RANGER STEPPER CONTROLLER           ||\\
//||            ARDUINO PROCESSOR TYPE = Arduino Mega 2560            ||\\
//||      ARDUINO CHIP SERIAL NUMBER = SN -                           ||\\
//||                    CONNECTED COM PORT = tba                      ||\\
//||               ****ADD ASSIGNED COM PORT NUMBER****               ||\\
//||            ****DO CHECK S/N BEFORE UPLOAD NEW DATA****           ||\\
////////////////////---||||||||||********||||||||||---\\\\\\\\\\\\\\\\\\\\

/*
 *  */

#define SwingLoops 1
#define SwingALT true
#define SwingRPM true
#define SwingFUELLOAD true
#define SwingELECTRICALLOAD true
#define SwingEOT true
#define SwingEOP true
#define SwingXOT true
#define SwingXOP true


int Ethernet_In_Use = 1;
int Reflector_In_Use = 1;
#define DCSBIOS_In_Use 1
#define MSFS_In_Use 0  // Used to interface into MSFS - set to 0 if not in use


#define DCSBIOS_IRQ_SERIAL
#include <DcsBios.h>


// ###################################### Begin Ethernet Related #############################
#include <SPI.h>
#include <Ethernet.h>
#include <EthernetUdp.h>

#define EthernetStartupDelay 500
#define ES1_RESET_PIN 53

String BoardName = "Jet Ranger OLED Dual Steppers";

// These local Mac and IP Address will be reassigned early in startup based on
// the device ID as set by address pins
byte mac[] = { 0xA8, 0x61, 0x0A, 0x67, 0x83, 0x6A };
String sMac = "A8:61:0A:67:83:6A";
IPAddress ip(172, 16, 1, 106);
String strMyIP = "172.16.1.106";

// Reflector
IPAddress reflectorIP(172, 16, 1, 10);
String strReflectorIP = "X.X.X.X";

// Arduino Due for Keystroke translation and Pixel Led driving
IPAddress targetIP(172, 16, 1, 110);
String strTargetIP = "X.X.X.X";

// Computer Running MSFS
IPAddress MSFSIP(172, 16, 1, 10);
String strMSFSIP = "X.X.X.X";

const unsigned int localport = 7788;
const unsigned int localdebugport = 7795;
const unsigned int keyboardport = 7788;
const unsigned int ledport = 7789;
const unsigned int remoteport = 7790;
const unsigned int reflectorport = 27000;
// Matches JET_RANGER_SERVO_CONTROLLER's MSFSport so the same PC bridge app
// wire format ("D,CODE:value,...") can be reused. Was previously 7791 and unused.
const unsigned int MSFSport = 13136;

// Health keepalive - same pattern as JET_RANGER_UPPER_CONTROLLER.ino's
// aliveudp: a bare ASCII prefix string ("DUAL_STEPPER", no
// delimiter/payload) sent to reflectorIP (172.16.1.10, the
// JetRangerHealthMonitor host) every aliveinterval, so that app can show
// this board's live/dead status next to COMM_NAV/SERVO/UPPER_INPUT/
// JOYSTICK/STEPPER. Deliberately distinct from the single-board sketch's
// "STEPPER" prefix - JetRangerHealthMonitor matches by message prefix
// only, not sender IP, so reusing "STEPPER" here would have made the two
// boards indistinguishable to it.
const unsigned int aliveport = 13137;
const unsigned long aliveinterval = 10000;
unsigned long lastalivesent = 0;
EthernetUDP aliveudp;
EthernetUDP startupSyncUdp;  // Start-up backlight announcement (UDP port 13138)

int packetSize;
int debugLen;
EthernetUDP udp;
EthernetUDP debugUDP;
// Receives the same front-panel data packets JET_RANGER_SERVO_CONTROLLER
// listens for; only ALT (altitude) and the engine/transmission gauges are wired up.
EthernetUDP MSFSudp;
int MSFSpacketsize;
int MSFSLen;
const unsigned long incomingcheckinterval = 5;
long lastincomingpacketcheck = 0;
char packetBuffer[1000];     //buffer to store the incoming data
char outpacketBuffer[1000];  //buffer to store the outgoing data

// No-data watchdog: if no UDP packet arrives on MSFSudp (the "D,CODE:value"
// feed from FSUIPCWinformsAutoCS/StepperVSITester) for noDataTimeoutMs,
// every gauge is driven back to its calibrated zero - same "zero" each
// gauge's own setter (setTS(0)/setRS(0)/etc, offset-aware) or a "CODE:0"
// UDP packet would produce, not the steppers' raw internal 0. Guards
// against a dead network link/crashed sim-bridge app leaving gauges
// frozen at a stale in-flight reading indefinitely. DCS-BIOS traffic
// (serial, not this UDP feed) does NOT reset this timer - only
// MSFSudp packets count. gaugesResetForNoData latches so the reset only
// fires once per outage, not every loop() while still timed out.
const unsigned long noDataTimeoutMs = 30000;
unsigned long lastMSFSDataMillis = 0;
bool gaugesResetForNoData = false;
const unsigned long delayBeforeSendingPacket = 2000;
unsigned long ethernetStartTime = 0;

// Used to Distinguish between the left, front, and right inputs
// Left=0, Front=1, Right=2
#define INPUT_MODULE_NUMBER 2

// ---------------------------------------------------------------------------------------------------------------------------------------------
// Firmware version. RAISE FIRMWARE_BUILD BY ONE EVERY TIME THIS SKETCH IS CHANGED (and FIRMWARE_VERSION for a larger change). The board sends the
// version, the build number and the date and time it was compiled to the debug stream at start-up and whenever it receives "C,VERSION:1", so the
// code on a board can be checked against the sketch.
// ---------------------------------------------------------------------------------------------------------------------------------------------
#define FIRMWARE_NAME "OLED Dual Stepper Controller"
#define FIRMWARE_VERSION "1.0"
#define FIRMWARE_BUILD 7

String firmwareText() {
  return String(F(FIRMWARE_NAME " firmware ")) + F(FIRMWARE_VERSION) + F(" build ") + String(FIRMWARE_BUILD) + F(" compiled ") + F(__DATE__ " " __TIME__);
}

// The firmware version for the heartbeat: " FW:1.0.2" is version 1.0, build 2. The Health Monitor shows it in its voltage table.
String firmwareHeartbeatText() {
  return String(F(" FW:")) + F(FIRMWARE_VERSION) + F(".") + String(FIRMWARE_BUILD);
}

void SendDebug(String MessageToSend) {
  if ((Reflector_In_Use == 1) && (Ethernet_In_Use == 1)) {
    udp.beginPacket(reflectorIP, reflectorport);
    udp.print(MessageToSend);
    udp.endPacket();
  }
}
// ###################################### End Ethernet Related #############################

// Aligned with Stepper-Tuning-Harness's LED pins (that sketch moved them
// off 12/13).
#define RED_STATUS_LED_PORT 15
#define GREEN_STATUS_LED_PORT 14
#define Check_LED_R 15
#define Check_LED_G 14

#define FLASH_TIME 300

unsigned long NEXT_STATUS_TOGGLE_TIMER = 0;
bool GREEN_LED_STATE = false;
bool RED_LED_STATE = false;
unsigned long timeSinceRedLedChanged = 0;






unsigned long currentMillis = 0;
unsigned long previousMillis = 0;



// Note Pin 4 and Pin 10 cannot be used for other purposes.
//Arduino communicates with both the W5500 and SD card using the SPI bus (through the ICSP header).
//This is on digital pins 10, 11, 12, and 13 on the Uno and pins 50, 51, and 52 on the Mega.
//On both boards, pin 10 is used to select the W5500 and pin 4 for the SD card. These pins cannot be used for general I/O.
//On the Mega, the hardware SS pin, 53, is not used to select either the W5500 or the SD card,
//but it must be kept as an output or the SPI interface won't work.

#define BACK_LIGHTS 5  // PCB: D5 = BACKLIGHT_PWM (D8 is VSI coil B)

// Backlight control. The backlight follows the main bus (BPWR:1/0 from the bridge: 1 = main bus 20 V or more) and the last
// brightness command (C,B:0-15). Until a C,B command has been received it uses BacklightDefaultPwm; once one has, the last
// commanded level is used every time power is applied. While the main bus is below 20 V the backlight is off.
// It is also off while the no-data watchdog has fired (no UDP packet for 30 s, including after power-up with no PC), and comes back
// at the same level when data resumes.
#define BacklightDefaultPwm 65
bool backlightPowered = true;        // true until the bridge reports the main bus is down
bool backlightNoData = false;        // true while the no-data watchdog has fired
int backlightCommandedPwm = -1;      // PWM from the last C,B command; -1 = none received yet

// ---------------------------------------------------------------------------------------------------------------------------------------------
// Start-up backlight. From reset every controller keeps its backlight ON (at the commanded or default level), whatever the no-data watchdog or the
// bridge's BPWR says, until the 13 Stepper controller, which is the last to finish its start-up, announces that start-up is complete. The announcement
// is the text "STARTUPDONE" sent to UDP port 13138 of every other controller (a port of its own, so it never counts as data for the 30 second no-data
// watchdog). The hold then ends: the backlight goes off and the bridge switches it on again (BPWR:1) as usual. If the announcement never comes (the
// Stepper controller is off) the hold ends by itself after STARTUP_BACKLIGHT_MAX_MS.
// ---------------------------------------------------------------------------------------------------------------------------------------------
#define STARTUP_SYNC_PORT 13138
#define STARTUP_BACKLIGHT_MAX_MS 180000UL
#define STARTUP_BACKLIGHT_PWM 255          // 100 percent while the start-up hold is on, whatever was commanded
#define AFTER_STARTUP_BACKLIGHT_PWM 179    // 70 percent: the commanded level when the hold ends (the backlight then goes off until BPWR:1)
bool backlightStartupHold = true;
void applyBacklight();
void endBacklightStartupHold(const String& why);
void refreshAfterStartupHold();   // redraws the OLEDs and puts the indicator lamps back to their normal state

void applyBacklight() {
  int pwm = 0;
  if (backlightStartupHold) pwm = STARTUP_BACKLIGHT_PWM;   // 100 percent until the Stepper controller announces start-up is complete
  else if (backlightPowered && !backlightNoData) pwm = (backlightCommandedPwm >= 0) ? backlightCommandedPwm : BacklightDefaultPwm;
  analogWrite(BACK_LIGHTS, pwm);
}

// Ends the start-up hold: the backlight goes off, and stays off until the bridge reports the main bus is up (BPWR:1).
void endBacklightStartupHold(const String& why) {
  if (!backlightStartupHold) return;
  backlightStartupHold = false;
  backlightPowered = false;
  backlightCommandedPwm = AFTER_STARTUP_BACKLIGHT_PWM;   // 70 percent from now on, until a C,B command changes it
  applyBacklight();
  SendDebug("Start-up backlight off (" + why + ")");
  refreshAfterStartupHold();
}

// ########################## BEGIN STEPPERS ########################################
#include <AccelStepper.h>

#define STEPPER_MAX_SPEED 9000
#define STEPPER_ZERO_SEEK_SPEED 600
#define STEPPER_ACCELERATION 1000
#define ALT_STEPPER_MAX_SPEED 600
#define ALT_STEPPER_ZERO_SEEK_SPEED 100
#define ALT_STEPPER_ACCELERATION 600

#define AllstepperEnablePin 56


// STALE as of the Flaps removal below: no `FlapsStepper` object exists
// in this sketch any more (its AccelStepper construct and startup block
// are commented out further down), so these two defines are now
// orphaned - nothing reads them. Left in place rather than deleted since
// it wasn't asked for, but they no longer describe live pin usage.
#define FlapsStepPin 46
#define FlapsDirectionPin 48
// Fine-trim offsets (steps) added to TS_PCT_TABLE's/RS_PCT_TABLE's
// computed target - dial in the
// real needles' true mechanical zero without touching the calibration
// tables themselves. Used both at runtime (setTS()/setRS()) and by the
// Turbine/Rotor Speed startup swings' "return to zero" step (below) -
// must be #define'd before setup() - they can't live down next to
// setTS()/setRS() where they're mainly used.
// TSoffset has since been given a real value (20); RSoffset is still an
// unmeasured 0.
#define TSoffset 13
#define RSoffset 8

// Fine-trim zero offsets (steps) for the remaining calibrated gauges, same
// purpose/pattern as TSoffset/RSoffset above (and as the per-gauge
// <CODE>ZeroOffset set in JET_RANGER_STEPPER_CONTROLLER.ino): dial in each
// real needle's true mechanical zero without touching its calibration
// table. Added inside each gauge's real-value setter (setEOT()/etc), so
// "<CODE>:0" packets, the no-data-watchdog reset and the boot swing's
// "return to zero" step all land on the same trimmed position. The *RAW
// UDP codes deliberately bypass them. All default to 0 (unmeasured, safe
// no-op) - must be #define'd before setup() since the swings use them.
#define EOTZeroOffset 24
#define EOPZeroOffset 0
#define XOTZeroOffset 16
#define XOPZeroOffset 5
#define FuelLoadZeroOffset 10
#define ElectricalLoadZeroOffset 24

// New gauges ported from Stepper-Tuning-Harness (same pin assignments as
// that bench sketch, all 4-wire direct-drive FULL4WIRE). Added as bare
// AccelStepper objects only - no homing/startup routine or DCS-BIOS
// binding yet, since none of these are bench-verified (direction,
// steps-per-unit, or even a real end stop location) on this hardware.
// Reachable for now only via the raw step-passthrough UDP test codes in
// HandleOutputValuePair() below. NOT checked for pin collisions against
// this sketch's existing active pins (ALT/SpeedMax/Flaps/AOA/GForce/
// AllstepperEnablePin, none of which were removed here the way they were
// in the harness) - see the summary given alongside this change.

#define STEPPER_FL_COIL_A 32
#define STEPPER_FL_COIL_B 33
#define STEPPER_FL_COIL_C 34
#define STEPPER_FL_COIL_D 35


#define EOT_COIL_A 48
#define EOT_COIL_B A0
#define EOT_COIL_C A1
#define EOT_COIL_D A2

#define XOT_COIL_A A3
#define XOT_COIL_B A4
#define XOT_COIL_C A5
#define XOT_COIL_D A6

#define XOP_COIL_A A7
#define XOP_COIL_B A8
#define XOP_COIL_C A9
#define XOP_COIL_D A10

#define EGT_COIL_A A11
#define EGT_COIL_B A12
#define EGT_COIL_C A13
#define EGT_COIL_D A14

#define TS_COIL_A 24
#define TS_COIL_B 25
#define TS_COIL_C 26
#define TS_COIL_D 27

#define RS_COIL_A 28
#define RS_COIL_B 29
#define RS_COIL_C 30
#define RS_COIL_D 31

#define FA_COIL_A 2
#define FA_COIL_B 3
#define FA_COIL_C 4
#define FA_COIL_D 6

#define EL_COIL_A 36
#define EL_COIL_B 37
#define EL_COIL_C 38
#define EL_COIL_D 39

// #define GP_COIL_A 40
// #define GP_COIL_B 41
// #define GP_COIL_C 42
// #define GP_COIL_D 43

#define EOP_COIL_A 44
#define EOP_COIL_B 45
#define EOP_COIL_C 46
#define EOP_COIL_D 47

#define STEPPER_ALT_A 40
#define STEPPER_ALT_B 41
#define STEPPER_ALT_C 42
#define STEPPER_ALT_D 43
#define ALTzeroSensePin A15

#define STEPS 315 * 16       // The 16 is the default divisors when no pins are tied together on the driver module \
                            // For an unmodified Vid series there are 315 steps
#define DUAL_STEPS 315 * 16  // The Dual stepper seems to have fewer steps between stops
// Direct-drive (FULL4WIRE) step count, no overshoot multiplier needed -
// originally for Flaps.
#define FULL4WIRE_STEPS 315
#define FULL4WIRE_HOMING_STEPS FULL4WIRE_STEPS + 1
#define X27_FULLWIRE_STEPS 630
#define X27_FULLWIRE_HOMING_STEPS X27_FULLWIRE_STEPS + 1
#define Z27_360_FULLWIRE_STEPS 720
AccelStepper ALTstepper(AccelStepper::FULL4WIRE, STEPPER_ALT_A, STEPPER_ALT_B, STEPPER_ALT_C, STEPPER_ALT_D);

// New gauges below, ported from Stepper-Tuning-Harness - see the pin
// defines above for the collision-check caveat. FuelLoadStepper's coil
// argument order (C, D, A, B rather than A, B, C, D) matches exactly what
// the harness uses, carried over as-is rather than "corrected" to A..D,
// since that order was whatever the harness found to work on the bench.
// STEPPER_FL_COIL_A..D are the same physical pins (32-35) the Radar Alt
// stepper used on the single-board sketch this was forked from - this
// board repurposes that stepper as a Fuel Load gauge instead, so the
// object is renamed to match (was RadarAltStepper).
AccelStepper FuelLoadStepper(AccelStepper::FULL4WIRE, STEPPER_FL_COIL_C, STEPPER_FL_COIL_D, STEPPER_FL_COIL_A, STEPPER_FL_COIL_B);
AccelStepper EOTstepper(AccelStepper::FULL4WIRE, EOT_COIL_C, EOT_COIL_D, EOT_COIL_A, EOT_COIL_B);
AccelStepper EOPstepper(AccelStepper::FULL4WIRE, EOP_COIL_A, EOP_COIL_B, EOP_COIL_C, EOP_COIL_D);
AccelStepper XOTstepper(AccelStepper::FULL4WIRE, XOT_COIL_C, XOT_COIL_D, XOT_COIL_A, XOT_COIL_B);
AccelStepper XOPstepper(AccelStepper::FULL4WIRE, XOP_COIL_A, XOP_COIL_B, XOP_COIL_C, XOP_COIL_D);
AccelStepper EGTstepper(AccelStepper::FULL4WIRE, EGT_COIL_A, EGT_COIL_B, EGT_COIL_C, EGT_COIL_D);
AccelStepper TSstepper(AccelStepper::FULL4WIRE, TS_COIL_C, TS_COIL_D, TS_COIL_A, TS_COIL_B);
AccelStepper RSstepper(AccelStepper::FULL4WIRE, RS_COIL_C, RS_COIL_D, RS_COIL_A, RS_COIL_B);
AccelStepper FAstepper(AccelStepper::FULL4WIRE, FA_COIL_A, FA_COIL_B, FA_COIL_C, FA_COIL_D);
// EL_COIL_A..D are the same physical pins (36-39) the Torque stepper
// used on the single-board sketch this was forked from - this board
// repurposes that stepper as an Electrical Load gauge instead, so the
// object is renamed to match (was ETstepper).
AccelStepper ElectricalLoadStepper(AccelStepper::FULL4WIRE, EL_COIL_A, EL_COIL_B, EL_COIL_C, EL_COIL_D);
// AccelStepper GPstepper(AccelStepper::FULL4WIRE, GP_COIL_A, GP_COIL_B, GP_COIL_C, GP_COIL_D);

// ########################### END STEPPERS #########################################

// ############################# BEGIN OLED #########################################

String sAircraftName = "";

#define BARO_OLED_Port 1
#define ALT_OLED_Port 2
// TCA9548A channel 3 - some mux breakout boards label each channel's pin
// pair SD0/SC0..SD7/SC7, so "SD3/SC3" is this channel's I2C data/clock
// pair. Same physical hardware/display class as the Altimeter OLED
// (u8g2_ALT below), just its own unit on its own mux channel - not a
// second use of the Altimeter's actual display.
#define CLOCK_OLED_Port 3
// TCA9548A channel 4 (SD4/SC4) - the Temperature OLED. Same display class and
// font as the Clock OLED; shows a temperature string such as "21C" received
// over UDP as "TEMP:<text>" (see onTempChange()).
#define TEMP_OLED_Port 4
#define TEMP_DEFAULT_TEXT "21C"

#include <U8g2lib.h>
#include <SPI.h>
#include <Wire.h>

// Op OLEDs
U8G2_SSD1306_128X32_UNIVISION_F_HW_I2C u8g2_ALT(U8G2_R0, /* reset=*/U8X8_PIN_NONE);
U8G2_SSD1306_128X32_UNIVISION_F_HW_I2C u8g2_BARO(U8G2_R0, U8X8_PIN_NONE);
U8G2_SSD1306_128X32_UNIVISION_F_HW_I2C u8g2_CLOCK(U8G2_R0, U8X8_PIN_NONE);
U8G2_SSD1306_128X32_UNIVISION_F_HW_I2C u8g2_TEMP(U8G2_R0, U8X8_PIN_NONE);


extern "C" {
#include "utility/twi.h"  // from Wire library, so we can do bus scanning
}

#define TCAADDR 0x70
#define TCA_RESET_PIN 16  // TCA9548A RESET (active low)
// Set to 1 (default) to run the diagnostic I2C scan of all 8 mux channels in
// initOLEDs(), reporting one line per channel over the UDP debug stream.
// Set to 0 to skip it and save boot time.
#define OLED_I2C_SCAN 1

int CurrentDisplay = 0;
int Brightness = 0;
char buffer[20];  //plenty of space for the value of millis() plus a zero terminator



// Altimeter delta 1000 feet for 112 pressure units
// which maps to 8.92857 feet per pressure unit with 2992 as reference
// so delta is (pressure reading - 2992) * 8.92857
#define feetDeltaPerPressureUnit 8.92857


int iLastAltitudeValue = 0;
// Minimum time between Altimeter OLED redraws, regardless of how often
// onAltMslFtChange() fires or how often the value actually changes -
// separate from (and in addition to) the iLastAltitudeValue change-check
// below. lastAltOledUpdateMillis only advances when an update actually
// happens, so a value change that arrives before the interval has
// elapsed isn't lost - it's just deferred to the next eligible callback.
const unsigned long minAltOledUpdateIntervalMs = 300;
unsigned long lastAltOledUpdateMillis = 0;

// Clock OLED - HHMM-encoded (e.g. 1430 for 14:30 Zulu), received over UDP
// from FSUIPCWinformsAutoCS (no DCS-BIOS callback for this one - FSUIPC
// is the only data source). Same gate-on-change + throttle pattern as
// the Altimeter OLED above.
int iLastZuluTimeValue = -1;

// All four OLEDs (Baro, Altimeter, Clock, Temperature) are blanked while
// oledsPowered is false - see setOledsPower() near oledTest(). The ZULU / TEMP /
// altitude / baro draw paths check it.
bool oledsPowered = true;

// Temperature OLED - last string drawn (empty = nothing drawn yet) and the
// same 300ms redraw throttle the Clock uses.
String sLastTempText = "";
const unsigned long minTempOledUpdateIntervalMs = 300;
unsigned long lastTempOledUpdateMillis = 0;
const unsigned long minClockOledUpdateIntervalMs = 300;
unsigned long lastClockOledUpdateMillis = 0;

int iAltitudeDelta = 0;
int iBaro = 2992;
int iBaroOnes = 2;
int iBaroTens = 9;
int iBaroHundreds = 9;
int iBaroThousands = 2;
String BaroOnes = String(iBaroOnes);
String BaroTens = String(iBaroTens);
String BaroHundreds = String(iBaroHundreds);
String BaroThousands = String(iBaroThousands);
bool BaroUpdated = true;

// Altimeter
unsigned long nextAltimeterUpdate = 0;
int updateAltimeterInterval = 100;

String Alt1000s = "0";
int LastAlt1000s = 0;
String Alt10000s = "0";
int LastAlt10000s = 0;
bool AltCounterUpdated = true;

char* ptrtopass;

String txtChaffFlare = "S240s120";
String txtJMRstatus = "SBY AIR ";
String txtMWSstatus = "ACTIVE ";


void tcaselect(uint8_t i) {
  if (i > 7) return;

  Wire.beginTransmission(TCAADDR);
  Wire.write(1 << i);
  Wire.endTransmission();
}


void updateBARO(String strnewValue) {

  const char* newValue = strnewValue.c_str();
  tcaselect(BARO_OLED_Port);
  u8g2_BARO.setFontMode(0);
  u8g2_BARO.setDrawColor(0);


  u8g2_BARO.drawBox(0, 0, 128, 64);
  u8g2_BARO.sendBuffer();



  // full range with with U8G2_SSD1309_128X64_NONAME2_F_HW_I2C
  // u8g2_BARO.drawBox(0, 1, 80, 64); with U8G2_SSD1309_128X64_NONAME2_2_HW_I2C
  //  u8g2_BARO.drawStr(85,16, newValue);

  u8g2_BARO.setDrawColor(1);
  u8g2_BARO.setFontDirection(0);


  u8g2_BARO.drawStr(65, 16, newValue);
  u8g2_BARO.sendBuffer();
}

void buildBAROString() {

  if (oledsPowered) updateBARO(BaroThousands + BaroHundreds + BaroTens + BaroOnes);
  BaroUpdated = false;
}

// Renders "HH:MM" on the Clock OLED - same simple single-string-redraw
// approach as updateBARO() above, not the digit-drum approach
// UpdateAltimeterDigits() uses (a clock face doesn't need that). Font is
// u8g2_font_logisoso32_tf (double the original 16px size) - the same
// family/size as u8g2_ALT's u8g2_font_logisoso32_tn, already proven to
// fit this exact 128x32 hardware; "_tf" (full charset) instead of "_tn"
// (numbers-only) so the ':' separator glyph is available. No bundled
// 7-segment font in this U8g2 install is short enough to fit a 32px-tall
// display without clipping (the only one, 7Segments_26x42_mn, is 42px
// tall), so this is the largest clean-fitting alternative.
void updateClock(int hours, int minutes) {
  char clockBuffer[6];  // "HH:MM" + null terminator
  sprintf(clockBuffer, "%02d:%02d", hours, minutes);

  tcaselect(CLOCK_OLED_Port);
  u8g2_CLOCK.setFontMode(0);
  u8g2_CLOCK.setDrawColor(0);
  u8g2_CLOCK.drawBox(0, 0, 128, 64);
  u8g2_CLOCK.sendBuffer();

  u8g2_CLOCK.setDrawColor(1);
  u8g2_CLOCK.setFontDirection(0);
  int strWidthPx = u8g2_CLOCK.getStrWidth(clockBuffer);
  int centeredX = (128 - strWidthPx) / 2;
  u8g2_CLOCK.drawStr(centeredX, 32, clockBuffer);
  u8g2_CLOCK.sendBuffer();
}

// Gate-on-change + 300ms-throttle wrapper for updateClock() - same
// pattern as onAltMslFtChange()'s gating of UpdateAltimeterDigits().
// hhmm is HH*100+MM (e.g. 1430 for 14:30 Zulu) - the wire format the
// "ZULU" UDP code (below) uses.
// Draws the temperature string centred, in the same font as the Clock OLED
// (u8g2_font_logisoso32_tf, set in initOLEDs()). A string wider than the
// display is drawn from x=0 and clipped.
void updateTemp(String text) {
  tcaselect(TEMP_OLED_Port);
  u8g2_TEMP.setFontMode(0);
  u8g2_TEMP.setDrawColor(0);
  u8g2_TEMP.drawBox(0, 0, 128, 64);
  u8g2_TEMP.sendBuffer();

  u8g2_TEMP.setDrawColor(1);
  u8g2_TEMP.setFontDirection(0);
  int strWidthPx = u8g2_TEMP.getStrWidth(text.c_str());
  int centeredX = (128 - strWidthPx) / 2;
  if (centeredX < 0) centeredX = 0;
  u8g2_TEMP.drawStr(centeredX, 32, text.c_str());
  u8g2_TEMP.sendBuffer();
}

// UDP "TEMP:<text>" handler - the value is shown as a string exactly as
// received (e.g. "21C"), gated on change and throttled like the Clock.
void onTempChange(String text) {
  if (!oledsPowered) return;
  text.trim();
  if (text.length() == 0 || text.length() > 8) return;
  if (text != sLastTempText
      && (millis() - lastTempOledUpdateMillis) >= minTempOledUpdateIntervalMs) {
    updateTemp(text);
    sLastTempText = text;
    lastTempOledUpdateMillis = millis();
  }
}

void onZuluTimeChange(int hhmm) {
  if (!oledsPowered) return;
  if (hhmm != iLastZuluTimeValue
      && (millis() - lastClockOledUpdateMillis) >= minClockOledUpdateIntervalMs) {
    int hours = hhmm / 100;
    int minutes = hhmm % 100;
    updateClock(hours, minutes);
    iLastZuluTimeValue = hhmm;
    lastClockOledUpdateMillis = millis();
  }
}



#define hash_width 24
#define hash_height 32
static unsigned char hash_bits[] = {
  0x00,
  0xFE,
  0x01,
  0x01,
  0xFC,
  0x03,
  0x03,
  0xF8,
  0x07,
  0x07,
  0xF0,
  0x0F,
  0x0F,
  0xE0,
  0x1F,
  0x1F,
  0xC0,
  0x3F,
  0x3F,
  0x80,
  0x7F,
  0x7F,
  0x00,
  0xFE,
  0xFE,
  0x01,
  0xFC,
  0xFC,
  0x03,
  0xF8,
  0xF8,
  0x07,
  0xF0,
  0xF0,
  0x0F,
  0xE0,
  0xE0,
  0x1F,
  0xC0,
  0x00,
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
};

int lastHundredsValue = 0;
int lastThousandsValue = 0;
int lastTenThousandsValue = 0;
int lastThousandsCharacterOffset = 0;
int lastHundredsCharacterOffset = 0;

void updateALT(String strTenThousands, String strnewThousands) {

  const char* newTenThousandsValue = strTenThousands.c_str();
  const char* newThousandsValue = strnewThousands.c_str();
  int End_X_Pos = 46;
  int End_Y_Pos = 28;
  int Start_Y_Pos = 13;
  int Start_X_Pos = 27;
  int Box_Width = 20;
  tcaselect(ALT_OLED_Port);
  u8g2_ALT.setFontMode(0);
  u8g2_ALT.setDrawColor(0);
  u8g2_ALT.drawBox(0, 0, 128, 32);
  u8g2_ALT.setDrawColor(1);
  //u8g2_ALT.drawStr(5, 32, newValue);

  if (strTenThousands == "0") {
    u8g2_ALT.setDrawColor(1);

    u8g2_ALT.drawBox(Start_X_Pos, 13, Box_Width, 20);
    u8g2_ALT.setDrawColor(0);

    u8g2_ALT.drawLine(Start_X_Pos, Start_Y_Pos, End_X_Pos, 32);
    u8g2_ALT.drawLine(Start_X_Pos, Start_Y_Pos + 1, End_X_Pos - 1, 32);
    u8g2_ALT.drawLine(Start_X_Pos, Start_Y_Pos + 2, End_X_Pos - 2, 32);
    u8g2_ALT.drawLine(Start_X_Pos, Start_Y_Pos + 3, End_X_Pos - 3, 32);
    u8g2_ALT.drawLine(Start_X_Pos, Start_Y_Pos + 4, End_X_Pos - 4, 32);
    u8g2_ALT.drawLine(Start_X_Pos, Start_Y_Pos + 5, End_X_Pos - 5, 32);
    u8g2_ALT.drawLine(Start_X_Pos, Start_Y_Pos + 6, End_X_Pos - 6, 32);

    u8g2_ALT.drawLine(Start_X_Pos, Start_Y_Pos + 11, End_X_Pos - 11, 32);
    u8g2_ALT.drawLine(Start_X_Pos, Start_Y_Pos + 12, End_X_Pos - 12, 32);
    u8g2_ALT.drawLine(Start_X_Pos, Start_Y_Pos + 13, End_X_Pos - 13, 32);
    u8g2_ALT.drawLine(Start_X_Pos, Start_Y_Pos + 14, End_X_Pos - 14, 32);
    u8g2_ALT.drawLine(Start_X_Pos, Start_Y_Pos + 15, End_X_Pos - 15, 32);

    u8g2_ALT.drawLine(Start_X_Pos + 4, Start_Y_Pos, Start_X_Pos + Box_Width, End_Y_Pos + 1);
    u8g2_ALT.drawLine(Start_X_Pos + 5, Start_Y_Pos, Start_X_Pos + Box_Width, End_Y_Pos);
    u8g2_ALT.drawLine(Start_X_Pos + 6, Start_Y_Pos, Start_X_Pos + Box_Width, End_Y_Pos - 1);
    u8g2_ALT.drawLine(Start_X_Pos + 7, Start_Y_Pos, Start_X_Pos + Box_Width, End_Y_Pos - 2);
    u8g2_ALT.drawLine(Start_X_Pos + 8, Start_Y_Pos, Start_X_Pos + Box_Width, End_Y_Pos - 3);
    u8g2_ALT.drawLine(Start_X_Pos + 9, Start_Y_Pos, Start_X_Pos + Box_Width, End_Y_Pos - 4);
    u8g2_ALT.drawLine(Start_X_Pos + 10, Start_Y_Pos, Start_X_Pos + Box_Width, End_Y_Pos - 5);

    u8g2_ALT.drawLine(Start_X_Pos + 15, Start_Y_Pos, Start_X_Pos + Box_Width, End_Y_Pos - 10);
    u8g2_ALT.drawLine(Start_X_Pos + 16, Start_Y_Pos, Start_X_Pos + Box_Width, End_Y_Pos - 11);
    u8g2_ALT.drawLine(Start_X_Pos + 17, Start_Y_Pos, Start_X_Pos + Box_Width, End_Y_Pos - 12);
    u8g2_ALT.drawLine(Start_X_Pos + 18, Start_Y_Pos, Start_X_Pos + Box_Width, End_Y_Pos - 13);
    u8g2_ALT.drawLine(Start_X_Pos + 19, Start_Y_Pos, Start_X_Pos + Box_Width, End_Y_Pos - 14);

    u8g2_ALT.setDrawColor(1);


  } else {
    u8g2_ALT.drawStr(32, 32, newTenThousandsValue);
  }

  u8g2_ALT.drawStr(65, 32, newThousandsValue);
  u8g2_ALT.sendBuffer();

  AltCounterUpdated = false;
}


void UpdateAltimeterDigits(long height) {

  //
  //SendDebug("Aircraft Name : " + sAircraftName);
  //SendDebug("Raw Height : " + String(height));
  // Adjust for Baro offset

  // Currnelty ignoring Baro Offset
  // height = height + iAltitudeDelta;

  String strnewValue = String(height);


  // int itensAboveDigit = 0;
  // int itensBelowDigit = 0;

  int iHundredsAboveDigit = 0;
  int iHundredsBelowDigit = 0;
  int iHundredsValue = ((height % 1000) / 100);
  String sHundredsValue = String(iHundredsValue);
  //SendDebug("Hundreds Value : " + sHundredsValue);
  if (iHundredsValue == 9) {
    iHundredsAboveDigit = 0;
  } else {
    iHundredsAboveDigit = iHundredsValue + 1;
  }
  if (iHundredsValue == 0) {
    iHundredsBelowDigit = 9;
  } else {
    iHundredsBelowDigit = iHundredsValue - 1;
  }

  String sHundredsAboveDigit = String(iHundredsAboveDigit);
  String sHundredsBelowDigit = String(iHundredsBelowDigit);
  const char* cHundredsValue = sHundredsValue.c_str();
  const char* cHundredsaboveValue = sHundredsAboveDigit.c_str();
  const char* cHundredsbelowValue = sHundredsBelowDigit.c_str();



  int iThousandsAboveDigit = 0;
  int iThousandsBelowDigit = 0;
  int iThousandsValue = ((height % 10000) / 1000);
  String sThousandValue = String(iThousandsValue);
  //SendDebug(String(i) + " : " + sThousandValue);
  if (iThousandsValue == 9) {
    iThousandsAboveDigit = 0;
  } else {
    iThousandsAboveDigit = iThousandsValue + 1;
  }
  if (iThousandsValue == 0) {
    iThousandsBelowDigit = 9;
  } else {
    iThousandsBelowDigit = iThousandsValue - 1;
  }

  String sThousandsAboveDigit = String(iThousandsAboveDigit);
  String sThousandsBelowDigit = String(iThousandsBelowDigit);
  const char* cThousandsValue = sThousandValue.c_str();
  const char* cThousandsaboveValue = sThousandsAboveDigit.c_str();
  const char* cThousandsbelowValue = sThousandsBelowDigit.c_str();


  int iTenThousandsValue = (height / 10000);
  String sTenThousandsDigit = String(iTenThousandsValue);
  //SendDebug("TenThousandsDigit : " + sTenThousandsDigit);
  const char* cTenThousandsValue = sTenThousandsDigit.c_str();

  unsigned long TimeToProcess = millis();

  int CharacterHeightSpacer = 38;

  int iHundredsCharacterOffset = ((height % 100) / 3.2);
  //SendDebug("heigh calc :" + String(height % 100));
  int iThousandsCharacterOffset = ((height % 1000) / 32);
  //SendDebug("Character Offset : " + String(iHundredsCharacterOffset));

  // Only attempt to draw of something has changed that will impact display
  if ((iThousandsValue != lastThousandsValue) || (iTenThousandsValue != lastTenThousandsValue) || (iThousandsCharacterOffset != lastThousandsCharacterOffset)
      || (iHundredsValue != lastHundredsValue) || (iHundredsCharacterOffset != lastHundredsCharacterOffset)) {

    tcaselect(ALT_OLED_Port);

    lastHundredsValue = iHundredsValue;
    lastThousandsValue = iThousandsValue;
    lastTenThousandsValue = iTenThousandsValue;
    lastHundredsCharacterOffset = iHundredsCharacterOffset;
    lastThousandsCharacterOffset = iThousandsCharacterOffset;

    updateSteppers();

    u8g2_ALT.setFontMode(0);
    u8g2_ALT.setDrawColor(0);
    u8g2_ALT.drawBox(0, 0, 128, 32);
    u8g2_ALT.setDrawColor(1);

    updateSteppers();

    // If Ten Thousands value is a 0 draw the hash
    // Position was 10 and 0 moved 40 to the right
    if (sTenThousandsDigit != "0") {
      u8g2_ALT.drawStr(50, 30, cTenThousandsValue);
    } else {
      u8g2_ALT.drawXBM(40, 0, hash_width, hash_height, hash_bits);
    }

    updateSteppers();


    // Three digits for A10 Altimer as it is a primary instrument - only two for Hornet
    if (sAircraftName == "A-10C") {
      // u8g2_ALT.drawStr(40, -2 + 0, cThousandsaboveValue);
      // u8g2_ALT.drawStr(40, 30 + 0, cThousandsValue);
      // u8g2_ALT.drawStr(70, -2 + iHundredsCharacterOffset, cHundredsaboveValue);
      // u8g2_ALT.drawStr(70, 30 + iHundredsCharacterOffset, cHundredsValue);
      // X POs was 40 andd 70 - 30 pixels diff
      u8g2_ALT.drawStr(80, -2 + 0, cThousandsaboveValue);
      u8g2_ALT.drawStr(80, 30 + 0, cThousandsValue);
      u8g2_ALT.drawStr(110, 58 - iHundredsCharacterOffset, cHundredsaboveValue);
      u8g2_ALT.drawStr(110, 26 - iHundredsCharacterOffset, cHundredsValue);
    } else {
      u8g2_ALT.drawStr(80, -2 + iThousandsCharacterOffset, cThousandsaboveValue);
      u8g2_ALT.drawStr(80, 30 + iThousandsCharacterOffset, cThousandsValue);
    }
    updateSteppers();
    u8g2_ALT.sendBuffer();
    updateSteppers();
    ;
    TimeToProcess = millis() - TimeToProcess;
    //SendDebug("OLED Update time :" + String(TimeToProcess));
  }
}


// ############################## END OLED  #########################################



// Brings up I2C and the three OLEDs (Baro/Altimeter/Clock) behind the
// TCA9548A mux. Returns false (having touched nothing) if the mux doesn't
// answer within the 25ms bus timeout - callable more than once.
bool initOLEDs() {
  // Pulse the TCA9548A's active-low RESET pin (wired to Arduino pin 16)
  // low then high, so the mux starts from a known state and any wedged
  // I2C channel is cleared. Datasheet minimum low pulse is ~6ns; 10ms is
  // generous. Pin 16 is otherwise unused in this sketch (Mega TX2).
  pinMode(TCA_RESET_PIN, OUTPUT);
  digitalWrite(TCA_RESET_PIN, LOW);
  delay(10);
  digitalWrite(TCA_RESET_PIN, HIGH);
  delay(10);

  // Explicitly bring up the I2C bus before the first tcaselect()/scan.
  // Previously nothing called Wire.begin() until u8g2.begin() further down,
  // and the first tcaselect() only got away with it because the stepper
  // swings used to run first - with the OLED block now ahead of them, the
  // un-initialised TWI hung the very first Wire.endTransmission().
  Wire.begin();
  // 25ms bus timeout (reset-on-timeout) so a wedged/unpowered I2C bus can
  // never block setup() - the TWI code has no timeout by default and would
  // spin forever, which is what stopped the stepper swings from running.
  Wire.setWireTimeout(25000, true);

  // Probe the TCA9548A mux once; if it doesn't answer, skip all OLED init
  // (scan + the three displays) rather than burning 25ms per probe on a
  // dead bus, and carry on to the stepper swings.
  Wire.beginTransmission(TCAADDR);
  bool oledMuxPresent = (Wire.endTransmission() == 0) && !Wire.getWireTimeoutFlag();
  Wire.clearWireTimeoutFlag();
  SendDebug(oledMuxPresent ? "TCA mux found - initialising OLEDs" : "TCA mux NOT found - OLED init skipped");

  if (!oledMuxPresent) return false;
  {



#if OLED_I2C_SCAN
  // Diagnostic I2C scan of every mux channel, one summary line per channel
  // over the UDP debug stream, e.g. "I2C scan ch1: 0x3C" or
  // "I2C scan ch3: none". The mux's own address (TCAADDR) is skipped since
  // it answers on every channel. A channel that times out 3 probes in a row
  // is abandoned ("bus timeout") so one dead channel can't cost 128 x 25ms.
  SendDebug("I2C scan start");
  for (uint8_t t = 0; t < 8; t++) {
    tcaselect(t);
    String found = "";
    uint8_t consecutiveTimeouts = 0;
    bool abandoned = false;
    for (uint8_t addr = 1; addr <= 126; addr++) {
      if (addr == TCAADDR) continue;
      Wire.beginTransmission(addr);
      uint8_t rc = Wire.endTransmission();
      if (Wire.getWireTimeoutFlag()) {
        Wire.clearWireTimeoutFlag();
        if (++consecutiveTimeouts >= 3) {
          abandoned = true;
          break;
        }
        continue;
      }
      consecutiveTimeouts = 0;
      if (rc == 0) {
        found += (found.length() ? " 0x" : "0x");
        if (addr < 16) found += "0";
        found += String(addr, HEX);
      }
    }
    SendDebug("I2C scan ch" + String(t) + ": " + (abandoned ? String("bus timeout") : (found.length() ? found : String("none"))));
  }
  SendDebug("I2C scan complete");
#endif

  tcaselect(BARO_OLED_Port);

  SendDebug("Displaying Baro 2992");
  u8g2_BARO.begin();
  u8g2_BARO.clearBuffer();
  u8g2_BARO.setFont(u8g2_font_logisoso16_tf);
  u8g2_BARO.sendBuffer();
  tcaselect(BARO_OLED_Port);
  updateBARO("2992");

  SendDebug("Display Alt");
  tcaselect(ALT_OLED_Port);
  u8g2_ALT.begin();
  u8g2_ALT.clearBuffer();
  u8g2_ALT.setFont(u8g2_font_logisoso32_tn);
  u8g2_ALT.sendBuffer();
  tcaselect(ALT_OLED_Port);
  updateALT("0", "0");

  SendDebug("Display CLock");
  tcaselect(CLOCK_OLED_Port);
  u8g2_CLOCK.begin();
  u8g2_CLOCK.clearBuffer();
  u8g2_CLOCK.setFont(u8g2_font_logisoso32_tf);
  u8g2_CLOCK.sendBuffer();
  tcaselect(CLOCK_OLED_Port);
  updateClock(0, 0);

  tcaselect(TEMP_OLED_Port);
  u8g2_TEMP.begin();
  u8g2_TEMP.clearBuffer();
  u8g2_TEMP.setFont(u8g2_font_logisoso32_tf);
  u8g2_TEMP.sendBuffer();
  tcaselect(TEMP_OLED_Port);
  updateTemp(TEMP_DEFAULT_TEXT);
  sLastTempText = TEMP_DEFAULT_TEXT;

  SendDebug("Delaying to see OLED");
  delay(2000);

  }
  return oledMuxPresent;
}

// True once initOLEDs() has found the TCA mux and started the displays;
// oledTest() refuses to touch the OLEDs until then.
bool oledsInitialised = false;

// Brightness of the four SSD1306 OLEDs, "C,OLEDB:0-15" (0 = dimmest, 15 = full contrast), separate from the backlight level (C,B). -1 until a command
// has been received: the displays then keep the library's default contrast. Applied to each display through its multiplexer channel.
int oledContrastLevel = -1;

void applyOledContrast() {
  if (!oledsInitialised || oledContrastLevel < 0) return;
  uint8_t contrast = map(oledContrastLevel, 0, 15, 0, 255);
  tcaselect(BARO_OLED_Port);
  u8g2_BARO.setContrast(contrast);
  tcaselect(ALT_OLED_Port);
  u8g2_ALT.setContrast(contrast);
  tcaselect(CLOCK_OLED_Port);
  u8g2_CLOCK.setContrast(contrast);
  tcaselect(TEMP_OLED_Port);
  u8g2_TEMP.setContrast(contrast);
}

// OLED lamp test (UDP control command "C,OLEDTEST:1" on / "C,OLEDTEST:0" off):
// "on" fills the Baro, Altimeter and Clock displays solid white so they are
// obviously lit (used by the BenchTester app during the swing sequence);
// "off" redraws each display's default boot content and clears the
// last-value gates so live data repaints them on its next update.
void oledTest(bool on) {
  if (!oledsInitialised) {
    SendDebug("OLEDTEST ignored - OLEDs not initialised");
    return;
  }
  if (on) {
    tcaselect(BARO_OLED_Port);
    u8g2_BARO.setDrawColor(1);
    u8g2_BARO.drawBox(0, 0, 128, 64);
    u8g2_BARO.sendBuffer();

    tcaselect(ALT_OLED_Port);
    u8g2_ALT.setDrawColor(1);
    u8g2_ALT.drawBox(0, 0, 128, 64);
    u8g2_ALT.sendBuffer();

    tcaselect(CLOCK_OLED_Port);
    u8g2_CLOCK.setDrawColor(1);
    u8g2_CLOCK.drawBox(0, 0, 128, 64);
    u8g2_CLOCK.sendBuffer();

    tcaselect(TEMP_OLED_Port);
    u8g2_TEMP.setDrawColor(1);
    u8g2_TEMP.drawBox(0, 0, 128, 64);
    u8g2_TEMP.sendBuffer();
  } else {
    updateBARO("2992");
    updateALT("0", "0");
    updateClock(0, 0);
    updateTemp(TEMP_DEFAULT_TEXT);
    iLastAltitudeValue = -1;
    iLastZuluTimeValue = -1;
    sLastTempText = "";
    if (!oledsPowered) BlankAllOleds();
  }
}

// OLED power ("PWR:1" / "PWR:0" UDP code, sent by FSUIPCWinformsAutoCS: 0 while
// the main bus is below 24 V). Off blanks the Baro, Altimeter, Clock and
// Temperature displays and stops the draw paths. On clears every "last drawn"
// cache (including the altimeter's per-digit ones) so the next ALT / ZULU /
// TEMP packet repaints in full, and redraws the Baro setting straight away.
bool oledsPowerWanted = true;   // what PWR last asked for; the OLEDs stay on regardless until the start-up hold ends

// After the hold: the OLEDs follow PWR and the no-data timeout again.
void refreshAfterStartupHold() {
  setOledsPower(oledsPowerWanted);
  // No data or input has come in (no bridge running): the OLEDs go with the backlight now, instead of lingering until this board's own 30 second no-data timeout
  // (which counts from the end of its start-up) runs out, so expire that timeout here.
  if (!gaugesResetForNoData && (millis() - lastMSFSDataMillis) > 2000UL) lastMSFSDataMillis = millis() - noDataTimeoutMs;
  if (backlightNoData) BlankAllOleds();
}

void setOledsPower(bool on) {
  oledsPowerWanted = on;
  if (backlightStartupHold && !on) return;   // the OLEDs stay on until the start-up hold ends
  if (on == oledsPowered) return;
  oledsPowered = on;
  if (!oledsInitialised) return;
  SendDebug(on ? "OLEDs on (main bus OK)" : "OLEDs off (main bus below 24V)");
  if (on) {
    iLastAltitudeValue = -1;
    iLastZuluTimeValue = -1;
    sLastTempText = "";
    lastThousandsValue = -1;
    lastTenThousandsValue = -1;
    lastThousandsCharacterOffset = -1;
    lastHundredsValue = -1;
    lastHundredsCharacterOffset = -1;
    updateBARO(BaroThousands + BaroHundreds + BaroTens + BaroOnes);
  } else {
    BlankAllOleds();
  }
}

// ###################### Stepper boot swings (callable) ######################
// Engine Oil Pressure startup swing. Runs at boot when SwingEOP is true, and on demand
// (ungated) when the UDP control command "C,SWINGOILP:1" is received.
void swingEOP() {
  SendDebug("Start EOPstepper");
  EOPstepper.runToNewPosition(FULL4WIRE_HOMING_STEPS);
  EOPstepper.runToNewPosition(-FULL4WIRE_STEPS);
  EOPstepper.setCurrentPosition(0);

  for (int i = 1; i <= SwingLoops; i++) {
    SendDebug("Loop :" + String(i));
    SendDebug("Sending Engine Oil Pressure to Max");
    EOPstepper.runToNewPosition(FULL4WIRE_STEPS);
    delay(200);
    SendDebug("Returning Engine Oil Pressure to Zero");
    EOPstepper.runToNewPosition(EOPZeroOffset);
    delay(200);
  }
  SendDebug("End EOPstepper");
}

// Engine Oil Temp startup swing. Runs at boot when SwingEOT is true, and on demand
// (ungated) when the UDP control command "C,SWINGOILT:1" is received.
void swingEOT() {
  SendDebug("Start EOTstepper");
  EOTstepper.runToNewPosition(FULL4WIRE_HOMING_STEPS);
  EOTstepper.runToNewPosition(-FULL4WIRE_STEPS);
  EOTstepper.setCurrentPosition(0);

  for (int i = 1; i <= SwingLoops; i++) {
    SendDebug("Loop :" + String(i));
    SendDebug("Sending Engine Oil Temp to Max");
    EOTstepper.runToNewPosition(FULL4WIRE_STEPS);
    delay(200);
    SendDebug("Returning Engine Oil Temp to Zero");
    EOTstepper.runToNewPosition(EOTZeroOffset);
    delay(200);
  }
  SendDebug("End EOTstepper");
}

// Transmission Oil Pressure startup swing. Runs at boot when SwingXOP is true, and on demand
// (ungated) when the UDP control command "C,SWINGXMSNP:1" is received.
void swingXOP() {
  SendDebug("Start XOPstepper");
  XOPstepper.runToNewPosition(FULL4WIRE_HOMING_STEPS);
  XOPstepper.runToNewPosition(-FULL4WIRE_STEPS);
  XOPstepper.setCurrentPosition(0);

  for (int i = 1; i <= SwingLoops; i++) {
    SendDebug("Loop :" + String(i));
    SendDebug("Sending Transmission Oil Pressure to Max");
    XOPstepper.runToNewPosition(FULL4WIRE_STEPS);
    delay(200);
    SendDebug("Returning Transmission Oil Pressure to Zero");
    XOPstepper.runToNewPosition(XOPZeroOffset);
    delay(200);
  }
  SendDebug("End XOPstepper");
}

// Transmission Oil Temp startup swing. Runs at boot when SwingXOT is true, and on demand
// (ungated) when the UDP control command "C,SWINGXMSNT:1" is received.
void swingXOT() {
  SendDebug("Start XOTstepper");
  XOTstepper.runToNewPosition(FULL4WIRE_HOMING_STEPS);
  XOTstepper.runToNewPosition(-FULL4WIRE_STEPS);
  XOTstepper.setCurrentPosition(0);

  for (int i = 1; i <= SwingLoops; i++) {
    SendDebug("Loop :" + String(i));
    SendDebug("Sending Transmission Oil Temp to Max");
    XOTstepper.runToNewPosition(FULL4WIRE_STEPS);
    delay(200);
    SendDebug("Returning Transmission Oil Temp to Zero");
    XOTstepper.runToNewPosition(XOTZeroOffset);
    delay(200);
  }
  SendDebug("End XOTstepper");
}

// Electrical Load startup swing. Runs at boot when SwingELECTRICALLOAD is true, and on demand
// (ungated) when the UDP control command "C,SWINGELECTRICALLOAD:1" is received.
void swingElectricalLoad() {
  SendDebug("Start ElectricalLoadStepper");
  // Same homing as the engine/transmission oil swings (FULL4WIRE range): wind up,
  // then back past zero against the stop before marking it as zero.
  ElectricalLoadStepper.runToNewPosition(FULL4WIRE_HOMING_STEPS);
  ElectricalLoadStepper.runToNewPosition(-FULL4WIRE_STEPS);
  ElectricalLoadStepper.setCurrentPosition(0);

  for (int i = 1; i <= SwingLoops; i++) {
    SendDebug("Loop :" + String(i));
    SendDebug("Sending Electrical Load to Max");
    ElectricalLoadStepper.runToNewPosition(FULL4WIRE_STEPS);
    delay(200);
    // ELECTRICAL_LOAD_PCT_TABLE's 0% row is 22 steps, not raw 0 - target
    // the calibrated zero (+ trim), same as setElectricalLoad(0) lands on.
    SendDebug("Returning Electrical Load to Zero");
    ElectricalLoadStepper.runToNewPosition(electricalLoadPctToSteps(0) + ElectricalLoadZeroOffset);
    delay(200);
  }
  SendDebug("End ElectricalLoadStepper");
}

// Fuel Load startup swing. Runs at boot when SwingFUELLOAD is true, and on demand
// (ungated) when the UDP control command "C,SWINGFUELLOAD:1" is received.
void swingFuelLoad() {
  SendDebug("Start FuelLoadStepper");
  // Same homing as the engine/transmission oil swings (FULL4WIRE range): wind up,
  // then back past zero against the stop before marking it as zero.
  FuelLoadStepper.runToNewPosition(FULL4WIRE_HOMING_STEPS);
  FuelLoadStepper.runToNewPosition(-FULL4WIRE_STEPS);
  FuelLoadStepper.setCurrentPosition(0);

  for (int i = 1; i <= SwingLoops; i++) {
    SendDebug("Loop :" + String(i));
    SendDebug("Sending Fuel Load to Max");
    FuelLoadStepper.runToNewPosition(FULL4WIRE_STEPS);
    delay(200);
    SendDebug("Returning Fuel Load to Zero");
    FuelLoadStepper.runToNewPosition(FuelLoadZeroOffset);
    delay(200);
  }
  SendDebug("End FuelLoadStepper");
}

// Turbine Speed startup swing. Runs at boot when SwingRPM is true, and on demand
// (ungated) when the UDP control command "C,SWINGRPME:1" is received.
void swingTS() {
  SendDebug("Start TSstepper");
  TSstepper.runToNewPosition(X27_FULLWIRE_HOMING_STEPS);
  TSstepper.runToNewPosition(0);
  TSstepper.setCurrentPosition(0);

  for (int i = 1; i <= SwingLoops; i++) {
    SendDebug("Loop :" + String(i));
    SendDebug("Sending Turbine Speed to Max");
    TSstepper.runToNewPosition(X27_FULLWIRE_STEPS);
    delay(200);
    // Zero here means the calibrated 0% position (TS_PCT_TABLE's 0
    // step, same as setTS(0) would target), not the stepper's raw
    // internal 0 - TSoffset accounts for the fine-trim applied at
    // runtime by setTS()/tsPctToSteps(), so the swing ends exactly
    // where the gauge will actually rest at 0% RPME.
    SendDebug("Returning Turbine Speed to Zero (offset " + String(TSoffset) + ")");
    TSstepper.runToNewPosition(TSoffset);
    delay(200);
  }
  SendDebug("End TSstepper");
}

// Rotor Speed startup swing. Runs at boot when SwingRPM is true, and on demand
// (ungated) when the UDP control command "C,SWINGRPMR:1" is received.
void swingRS() {
  SendDebug("Start RSstepper");
  RSstepper.runToNewPosition(X27_FULLWIRE_HOMING_STEPS);
  RSstepper.runToNewPosition(0);
  RSstepper.setCurrentPosition(0);

  for (int i = 1; i <= SwingLoops; i++) {
    SendDebug("Loop :" + String(i));
    SendDebug("Sending Rotor Speed to Max");
    RSstepper.runToNewPosition(X27_FULLWIRE_STEPS);
    delay(200);
    // Same reasoning as TSstepper's swing above: zero here means the
    // calibrated 0% position (RS_PCT_TABLE's 0 step / setRS(0)'s
    // target), not the stepper's raw internal 0 - RSoffset accounts
    // for the fine-trim setRS()/rsPctToSteps() applies at runtime.
    SendDebug("Returning Rotor Speed to Zero (offset " + String(RSoffset) + ")");
    RSstepper.runToNewPosition(RSoffset);
    delay(200);
  }
  SendDebug("End RSstepper");
}

// ALT startup swing. Runs at boot when SwingALT is true, and on demand
// (ungated) when the UDP control command "C,SWINGALT:1" is received.
void swingALT() {
  SendDebug("Start ALT");
  for (int i = 1; i <= 1; i++) {
    SendDebug("Loop :" + String(i));
    ALTstepper.moveTo(-STEPS * 2);
    while (ALTstepper.distanceToGo() != 0) {
      if (digitalRead(ALTzeroSensePin) != true) {
        SendDebug("Found Alt Zero Position");
        ALTstepper.setCurrentPosition(-25);
        break;
      }
      ALTstepper.run();
    }
    delay(500);
    SendDebug("Send Alt Round " + String(SwingLoops) + " times");
    long SendAAltForATrip = Z27_360_FULLWIRE_STEPS * SwingLoops;
    //  720 steps per loop
    ALTstepper.runToNewPosition(SendAAltForATrip);
    delay(200);
    SendDebug("Return Alt to 0");
    ALTstepper.runToNewPosition(0);
  }
  // Move ALT to zero position - need to monitor zero sense



  SendDebug("End ALT");
}
// ###########################################################################

// The 5 V rail (the ADC's AVcc reference) in volts, measured against the internal 1.1 V band-gap, as text for the heartbeat: " V5:5.02". The
// JetRangerHealthMonitor matches heartbeats by their first word, so the voltage after it does not change which board it is, and the monitor shows the
// last reading from each board.
String vccHeartbeatText() {
  ADMUX = _BV(REFS0) | _BV(MUX4) | _BV(MUX3) | _BV(MUX2) | _BV(MUX1);
  ADCSRB &= ~_BV(MUX5);
  delay(2);  // let the band-gap settle after the reference change
  long sum = 0;
  for (int i = 0; i < 9; i++) {
    ADCSRA |= _BV(ADSC);
    while (bit_is_set(ADCSRA, ADSC)) {}
    if (i > 0) sum += ADC;  // first conversion thrown away
  }
  long reading = sum / 8;
  if (reading <= 0) return "";
  return " V5:" + String(1125.3f / reading, 2);
}

void setup() {

  pinMode(GREEN_STATUS_LED_PORT, OUTPUT);
  pinMode(RED_STATUS_LED_PORT, OUTPUT);
  digitalWrite(GREEN_STATUS_LED_PORT, true);
  digitalWrite(RED_STATUS_LED_PORT, true);
  delay(FLASH_TIME);
  digitalWrite(GREEN_STATUS_LED_PORT, false);
  digitalWrite(RED_STATUS_LED_PORT, false);
  delay(FLASH_TIME);

  if (Ethernet_In_Use == 1) {

    // Reset Ethernet Module
    pinMode(ES1_RESET_PIN, OUTPUT);
    digitalWrite(ES1_RESET_PIN, LOW);
    delay(2);
    digitalWrite(ES1_RESET_PIN, HIGH);

    Ethernet.begin(mac, ip);
    // W5500's own ARP/send retry timeout, not the boot-time wait below -
    // default is 200ms x 8 retries = up to 1600ms blocked inside
    // udp.beginPacket()/endPacket() any time a send fails to get an ARP
    // reply (e.g. destination host down). Cut to 10ms so a communications
    // failure can't stall updateSteppers()'s .run() servicing and make
    // the steppers stutter. Retry count left at its default (8), so worst
    // case is now ~80ms instead of ~1600ms.
    Ethernet.setRetransmissionTimeout(10);
    udp.begin(localport);
    MSFSudp.begin(MSFSport);
    aliveudp.begin(aliveport);
    startupSyncUdp.begin(STARTUP_SYNC_PORT);

    // As it takes a couple of seconds before the Ethernet Stack is operational
    // Flash leds until time period has completed
    ethernetStartTime = millis() + delayBeforeSendingPacket;
    while (millis() <= ethernetStartTime) {
      delay(FLASH_TIME);
      digitalWrite(Check_LED_G, false);
      delay(FLASH_TIME);
      digitalWrite(Check_LED_G, true);
    }
    SendDebug(BoardName + " Ethernet Started " + strMyIP + " " + sMac);
    SendDebug(firmwareText());
  }


  pinMode(BACK_LIGHTS, OUTPUT);
  // analogWrite(BACK_LIGHTS, 255);

  // delay(3000);

  // SendDebug("Dimming Leds");
  // for (int Local_Brightness = 255; Local_Brightness >= 0; Local_Brightness--) {
  //   analogWrite(BACK_LIGHTS, Local_Brightness);
  //   // SendDebug("Led Brightness " + String(Local_Brightness));
  //   delay(15);
  // }

#define BrightnessWhileRunningSetup STARTUP_BACKLIGHT_PWM   // 100 percent

  analogWrite(BACK_LIGHTS, BrightnessWhileRunningSetup);

  // OLEDs (Baro/Altimeter/Clock) are initialised BEFORE the stepper boot
  // swings below, so the displays are up (showing their zero/default
  // readings) while the needles swing rather than coming up afterwards.
  // ####################### Being OLED Setup ##########################

  oledsInitialised = initOLEDs();
  applyOledContrast();

  // ######################## End OLED Setup ###########################

  SendDebug("STEPPER INITIALISATION STARTED");


  pinMode(ALTzeroSensePin, INPUT);
  // CAUTION: pinMode(AllstepperEnablePin, OUTPUT) above is commented out,
  // but the digitalWrite(AllstepperEnablePin, false) below is NOT - an
  // Arduino digital pin defaults to INPUT at boot, and digitalWrite() on
  // an INPUT pin just toggles its internal pull-up resistor rather than
  // actually driving the pin LOW as a real output. If the stepper
  // drivers' enable line depends on this pin being actively driven, it
  // may not be enabling them the way this code implies. Worth confirming
  // pinMode was meant to stay commented (enable now tied elsewhere/always
  // on) or should be restored.

  ALTstepper.setMaxSpeed(ALT_STEPPER_MAX_SPEED);
  ALTstepper.setAcceleration(ALT_STEPPER_ACCELERATION);
  FuelLoadStepper.setMaxSpeed(STEPPER_MAX_SPEED);
  FuelLoadStepper.setAcceleration(STEPPER_ACCELERATION);
  EOTstepper.setMaxSpeed(STEPPER_MAX_SPEED);
  EOTstepper.setAcceleration(STEPPER_ACCELERATION);
  XOTstepper.setMaxSpeed(STEPPER_MAX_SPEED);
  XOTstepper.setAcceleration(STEPPER_ACCELERATION);
  XOPstepper.setMaxSpeed(STEPPER_MAX_SPEED);
  XOPstepper.setAcceleration(STEPPER_ACCELERATION);
  EGTstepper.setMaxSpeed(STEPPER_MAX_SPEED);
  EGTstepper.setAcceleration(STEPPER_ACCELERATION);
  TSstepper.setMaxSpeed(STEPPER_MAX_SPEED);
  TSstepper.setAcceleration(STEPPER_ACCELERATION);
  RSstepper.setMaxSpeed(STEPPER_MAX_SPEED);
  RSstepper.setAcceleration(STEPPER_ACCELERATION);
  FAstepper.setMaxSpeed(STEPPER_MAX_SPEED);
  FAstepper.setAcceleration(STEPPER_ACCELERATION);
  ElectricalLoadStepper.setMaxSpeed(STEPPER_MAX_SPEED);
  ElectricalLoadStepper.setAcceleration(STEPPER_ACCELERATION);
  //GPstepper.setMaxSpeed(STEPPER_MAX_SPEED);
  //GPstepper.setAcceleration(STEPPER_ACCELERATION);
  EOPstepper.setMaxSpeed(STEPPER_MAX_SPEED);
  EOPstepper.setAcceleration(STEPPER_ACCELERATION);


  digitalWrite(AllstepperEnablePin, false);

  // ################# Start Engine Oil Pressure Startup #########################
  // Same pattern as Engine Oil Temp below. EOPstepper now has a real
  // bench-measured table (EOP_PSI_TABLE, see "START ENGINE OIL PRESSURE"
  // below) whose max (150 PSI -> 220 steps) is well inside FULL4WIRE_STEPS
  // (315), so this swing uses the same FULL4WIRE_STEPS/
  // FULL4WIRE_HOMING_STEPS range rather than X27's, overshooting the real
  // calibrated range for a fuller self-test - same reasoning as EOT's
  // swing below. EOPstepper previously had no startup routine at all.
  // Direction sign is an unverified assumption, NOT bench-confirmed.
  // Returns to 0, same reasoning as EOT below (eopPsiToSteps(0) is
  // already 0).
  if (SwingEOP) swingEOP();
  // ################# End Engine Oil Pressure Startup #########################

  // ################# Start Engine Oil Temp Startup #########################
  // Same wind/zero/swing-loop pattern as Fuel Load/Electrical Load below,
  // but uses FULL4WIRE_STEPS/FULL4WIRE_HOMING_STEPS (315/316) instead of
  // the X27_FULLWIRE_STEPS/X27_FULLWIRE_HOMING_STEPS (630/631) those use.
  // EOTstepper now has a real bench-measured table (EOT_C_TABLE, see
  // "START ENGINE OIL TEMP" below) whose max (150C -> 231 steps) is well
  // inside FULL4WIRE_STEPS (315), so this swing overshoots the real
  // calibrated range for a fuller self-test, same as Fuel Load's swing
  // overshoots its own calibrated range. EOTstepper previously had no
  // startup routine at all. Direction sign is an unverified assumption
  // carried over from the other swings' X27-style homing, NOT
  // bench-confirmed for this specific gauge. Returns to EOTZeroOffset,
  // not raw 0 - eotCToSteps(0) is already 0, so the offset alone is the
  // correct calibrated-zero target (default 0, same as before).
  if (SwingEOT) swingEOT();
  // ################# End Engine Oil Temp Startup #########################

  // ################# Start Transmission Oil Pressure Startup #########################
  // Same pattern as Transmission Oil Temp below. XOPstepper now has a
  // real bench-measured table (XOP_PSI_TABLE, see "START TRANSMISSION OIL
  // PRESSURE" below) whose max (150 PSI -> 220 steps) is well inside
  // FULL4WIRE_STEPS (315), so this swing overshoots the real calibrated
  // range for a fuller self-test, same reasoning as the other graduated
  // gauges' swings above and below. XOPstepper previously had no startup routine at
  // all. Direction sign is an unverified assumption, NOT bench-confirmed.
  // Returns to 0 (xopPsiToSteps(0) is already 0).
  if (SwingXOP) swingXOP();
  // ################# End Transmission Oil Pressure Startup #########################

  // ################# Start Transmission Oil Temp Startup #########################
  // Same wind/zero/swing-loop pattern as Engine Oil Temp/Pressure above,
  // using FULL4WIRE_STEPS/FULL4WIRE_HOMING_STEPS (315/316). XOTstepper now
  // has a real bench-measured table (XOT_C_TABLE, see "START TRANSMISSION
  // OIL TEMP" below) whose max (150C -> 225 steps) is well inside
  // FULL4WIRE_STEPS (315), so this swing overshoots the real calibrated
  // range for a fuller self-test, same reasoning as EOT/EOP's swings
  // above and below. XOTstepper previously had no startup routine at all. Direction
  // sign is an unverified assumption, NOT bench-confirmed. Returns to
  // XOTZeroOffset (xotCToSteps(0) is already 0, so the offset alone is the
  // correct calibrated-zero target).
  if (SwingXOT) swingXOT();
  // ################# End Transmission Oil Temp Startup #########################

  // ################# Start Electrical Load Startup #########################
  // Same wind/zero/3-swing-loop pattern as the Fuel Load block below,
  // reusing the same X27_FULLWIRE_STEPS/X27_FULLWIRE_HOMING_STEPS
  // constants (note X27_FULLWIRE_HOMING_STEPS is unparenthesized -
  // the same "-X27_FULLWIRE_HOMING_STEPS expands to -630, not -640"
  // issue applies here too). This stepper (pins 36-39) drove Torque
  // ("TQ") on the single-board sketch this was forked from; this board
  // repurposes it as Electrical Load instead (see ElectricalLoadStepper
  // above), but the physical hardware and homing behaviour is unchanged.
  // Direction sign and step range are an unverified assumption carried
  // over from the single-board sketch's X27-style homing, NOT bench-confirmed
  // for this specific gauge. SwingELECTRICALLOAD was already #defined
  // above but had no matching startup block until now.
  if (SwingELECTRICALLOAD) swingElectricalLoad();
  // ################# End Electrical Load Startup #########################

  // ################# Start Fuel Load Startup #########################
  // Same wind/zero/3-swing-loop pattern as the Electrical Load block above, reusing
  // the same X27_FULLWIRE_STEPS/X27_FULLWIRE_HOMING_STEPS constants (note
  // X27_FULLWIRE_HOMING_STEPS is unparenthesized - the same
  // "-X27_FULLWIRE_HOMING_STEPS expands to -630, not -640" issue applies
  // here too). This stepper (pins 32-35) drove Radar Alt on the
  // single-board sketch this was forked from; this board repurposes it as
  // Fuel Load instead (see FuelLoadStepper above), but the physical
  // hardware and homing behaviour is unchanged. Direction sign and step
  // range are an unverified assumption carried over from the single-board sketch's
  // X27-style homing, NOT bench-confirmed for this specific gauge.
  // Wrapped in `if (false)` - present and compiled, but currently
  // DISABLED, matching the single-board sketch's own Radar Alt swing.


  if (SwingFUELLOAD) swingFuelLoad();
  // ################# End Fuel Load Startup #########################

  // ################# Start Turbine Speed Startup #########################
  // Same wind/zero/3-swing-loop pattern as the Fuel Load/Electrical Load blocks above, reusing the same X27_FULLWIRE_STEPS/X27_FULLWIRE_HOMING_STEPS
  // constants (note X27_FULLWIRE_HOMING_STEPS is unparenthesized -
  // the same "-X27_FULLWIRE_HOMING_STEPS expands to -630, not -640"
  // issue applies here too). TSstepper had no startup routine at all
  // before this - direction sign is an unverified assumption carried
  // over from the single-board sketch's X27-style homing, NOT bench-confirmed
  // for this specific gauge. UPDATE: TS_PCT_TABLE (below, this board's
  // own 4-point table) now gives this gauge's real "RPME" UDP path a max
  // of 600 steps at 110% - close to X27_FULLWIRE_STEPS (635), so this
  // swing's step range is a reasonable match rather than the ~2x
  // overshoot it was before that table existed. Not wrapped in `if
  // (false)` - runs every boot. Confirm on
  // the bench that it actually reaches the real end stop (and doesn't
  // stall against it from the wrong side) before trusting it unattended.
  if (SwingRPM) swingTS();
  // ################# End Turbine Speed Startup #########################

  // ################# Start Rotor Speed Startup #########################
  // Same wind/zero/3-swing-loop pattern as the Fuel Load/Electrical Load/Turbine Speed
  // blocks, reusing the same
  // X27_FULLWIRE_STEPS/X27_FULLWIRE_HOMING_STEPS constants (note
  // X27_FULLWIRE_HOMING_STEPS is unparenthesized - the same
  // "-X27_FULLWIRE_HOMING_STEPS expands to -630, not -640" issue applies
  // here too). RSstepper had no startup routine at all before this -
  // direction sign is an unverified assumption carried over from
  // the single-board sketch's/Turbine Speed's X27-style homing, NOT bench-confirmed
  // for this specific gauge. RS_PCT_TABLE (above, this board's own
  // 4-point table) gives this gauge's real "RPMR" UDP path a max of 600
  // steps at 110% - close to X27_FULLWIRE_STEPS (635), same as Turbine
  // Speed, so this swing's step range is a reasonable match rather than
  // a big overshoot. Not wrapped in `if
  // (false)` - runs every boot. Confirm on the bench that it actually
  // reaches the real end stop (and doesn't stall against it from the wrong
  // side) before trusting it unattended.
  if (SwingRPM) swingRS();
  // ################# End Rotor Speed Startup #########################

  // ################# Start ALT Startup #########################


  if (SwingALT) swingALT();
  // ################# End ALT Startup #########################

  SendDebug("STEPPER INITIALISATION COMPLETE");

  // The OLED mux wasn't answering before the swings (bench OLEDs/mux not
  // powered yet, or not fitted) - give it one more try now that the swings
  // have taken a while, so the displays still come up late rather than never.
  if (!oledsInitialised) oledsInitialised = initOLEDs();
  applyOledContrast();


  if (DCSBIOS_In_Use == 1) DcsBios::setup();

#define BrightnessPostSetup 65
  applyBacklight();   // BacklightDefaultPwm (65) unless a brightness command or the main bus says otherwise

  // Start the no-data timeout from the END of setup(), not from reset:
  // lastMSFSDataMillis starts at 0, so with the long boot swings the
  // watchdog would otherwise already be expired the moment loop() starts and
  // zero the gauges ~immediately.
  lastMSFSDataMillis = millis();
  gaugesResetForNoData = false;

  SendDebug(BoardName + " - " + strMyIP + " Setup Complete. " + String(millis()) + "mS since reset.");
}



void SendIPMessage(int ind, int state) {

  if (Ethernet_In_Use == 1) {

    String outString;
    outString = String(ind) + ":" + String(state);

    udp.beginPacket(reflectorIP, reflectorport);
    udp.print(outString);
    udp.endPacket();
    UpdateRedStatusLed();
  }
}

void SendMSFSMessage(int ind, int state) {

  String outString;
  outString = "D" + String(INPUT_MODULE_NUMBER) + "," + String(ind) + ":" + String(state);

  udp.beginPacket(MSFSIP, MSFSport);
  udp.print(outString);
  udp.endPacket();


  //  udp.beginPacket(targetIP, remoteport);
  //  udp.print(outString);
  //  udp.endPacket();
}

void SendIPString(String KeysToSend) {
  // Used to Send Desired Keystrokes to Due acting as Keyboard
  if (Ethernet_In_Use == 1) {
    udp.beginPacket(targetIP, keyboardport);
    udp.print(KeysToSend);
    udp.endPacket();
    UpdateRedStatusLed();
  }
}

void SendLedString(String LedCommandToSend) {

  if (Ethernet_In_Use == 1) {
    udp.beginPacket(targetIP, ledport);
    udp.print(LedCommandToSend);
    udp.endPacket();
    UpdateRedStatusLed();
  }
}


void UpdateRedStatusLed() {
  if ((RED_LED_STATE == false) && (millis() >= (timeSinceRedLedChanged + FLASH_TIME))) {
    digitalWrite(RED_STATUS_LED_PORT, true);
    RED_LED_STATE = true;
    timeSinceRedLedChanged = millis();
  }
}

// ################################ BEGIN TACAN ##############################


void sendToDcsBiosMessage(const char* msg, const char* arg) {


  if (Reflector_In_Use == 1) {
    udp.beginPacket(reflectorIP, reflectorport);
    udp.println("Right Input - " + String(msg) + ":" + String(arg));
    udp.endPacket();
  }

  sendDcsBiosMessage(msg, arg);
}

// ################################ BEGIN LIGHTING ##############################

void onIntFltInstLBrightChange(unsigned int newValue) {
  int outvalue = 0;
  outvalue = map(newValue, 0, 65534, 0, 255);
  SendDebug("Eng Inst Brightness=" + String(outvalue));
  if (!backlightStartupHold) analogWrite(BACK_LIGHTS, outvalue);   // the backlight stays at 100 percent during the start-up hold
}
DcsBios::IntegerBuffer intFltInstLBrightBuffer(A_10C_INT_FLT_INST_L_BRIGHT, onIntFltInstLBrightChange);



void onIntFloodLBrightChange(unsigned int newValue) {
  int floodoutvalue = 0;
  floodoutvalue = map(newValue, 0, 65534, 0, 255);
  SendDebug("Flood Brightness=" + String(floodoutvalue));
}
DcsBios::IntegerBuffer intFloodLBrightBuffer(A_10C_INT_FLOOD_L_BRIGHT, onIntFloodLBrightChange);

// ################################ END LIGHTING ##############################

// ################################ BEGIN STEPPERS ##############################



// // ################################### START FLAPS ##############################################
// #define FlapsMaxDegrees 200
// // DcsBios::Switch3Pos flapsSwitch("FLAPS_SWITCH", PIN_A, PIN_B);
// void setFlaps(unsigned int TargetDegrees) {

//   int signedTargetDegrees = TargetDegrees;
//   SendDebug("Flaps = " + String(signedTargetDegrees) + " Current = " + String(FlapsStepper.currentPosition()));
//   if (signedTargetDegrees >= FlapsMaxDegrees) signedTargetDegrees = FlapsMaxDegrees;
//   //
//   FlapsStepper.moveTo(-signedTargetDegrees);
// }
// void onFlapPosChange(unsigned int newValue) {
//   setFlaps((map(newValue, 0, 65535, 0, FlapsMaxDegrees * 0.7)));
// }
// DcsBios::IntegerBuffer flapPosBuffer(A_10C_FLAP_POS, onFlapPosChange);
// // ################################### END FLAPS ##############################################



// ################################### BEGIN ALT ##############################################


void onAltMslFtChange(unsigned int newValue) {
  // Max Value of feet is 65535
  // 720 Steps per 1000 feet
  // So 0.72 steps foot - need float as long doesn't do decimal
  float ALTtargetSteps = newValue;
  ALTtargetSteps = ALTtargetSteps * 0.72;
  long longAlttargetSteps = long(ALTtargetSteps);
  // SendDebug("Altimeter target steps is :" + String(longAlttargetSteps));
  ALTstepper.moveTo(longAlttargetSteps);
  // SendDebug("Altimeter steps to go :" + String(ALTstepper.distanceToGo()));

  // Only touch the OLED if the altitude actually changed since the last
  // callback - iLastAltitudeValue was declared for exactly this but never
  // used before. This is a coarser, cheaper check than the per-digit-group
  // comparison already inside UpdateAltimeterDigits() (which still only
  // redraws the digits/offsets that changed) - it skips calling that
  // function (and its digit-math work) entirely on repeat/no-op DCS-BIOS
  // callbacks. Also throttled to at most once every
  // minAltOledUpdateIntervalMs (300ms), independent of how often
  // onAltMslFtChange() itself fires - a changed value that arrives inside
  // the throttle window is simply deferred (iLastAltitudeValue isn't
  // advanced), so the next eligible callback still picks it up rather
  // than the update being silently dropped. ALTstepper still moves every
  // call, regardless of either gate.
  if (oledsPowered && (int)newValue != iLastAltitudeValue
      && (millis() - lastAltOledUpdateMillis) >= minAltOledUpdateIntervalMs) {
    UpdateAltimeterDigits(newValue);
    iLastAltitudeValue = (int)newValue;
    lastAltOledUpdateMillis = millis();
  }
}
DcsBios::IntegerBuffer altMslFtBuffer(CommonData_ALT_MSL_FT, onAltMslFtChange);

// ################################### END ALT ##############################################


// ################################### START EGT ##############################################

// EGT (Exhaust Gas Temp) real-value UDP handler - see the "ITT" case in
// HandleOutputValuePair() below (renamed from "EGT" to match
// JET_RANGER_SERVO_CONTROLLER.ino), which sends degrees C instead of a
// raw step target. Straight linear scale across the gauge's real-world
// 0-900C range onto FULL4WIRE_HOMING_STEPS - CAUTION: that constant was
// redefined from 315*2 (630) to 315+5 (320) elsewhere in this sketch
// (see the pin/stepper section above), which halves this gauge's
// effective step resolution without this comment (or EGTstepper's own
// homing) having been updated to match - EGTstepper still has no actual
// homing routine, so "FULL4WIRE_HOMING_STEPS" here is still a borrowed
// placeholder ceiling, not a bench-measured one. NOT a real per-point
// calibration table - revisit with real
// bench-measured points once EGTstepper's actual travel is known.
#define EGT_MIN_C 0
#define EGT_MAX_C 900

long egtCToSteps(long tempC) {
  if (tempC < EGT_MIN_C) tempC = EGT_MIN_C;
  if (tempC > EGT_MAX_C) tempC = EGT_MAX_C;
  return map(tempC, EGT_MIN_C, EGT_MAX_C, 0, FULL4WIRE_HOMING_STEPS);
}

void setEGT(long TargetC) {
  EGTstepper.moveTo(egtCToSteps(TargetC));
}

// ################################### END EGT ##############################################

// ################################### START EOT/EOP/XOT/XOP/TS/RS/GP/FA ##############################################

// Real-value UDP handlers for 5 more gauges, same linear-scale-onto-
// FULL4WIRE_HOMING_STEPS placeholder approach as setEGT()/egtCToSteps()
// above (see that section's comment for the full rationale) - none of
// these steppers have bench-measured calibration either. EOT/EOP/XOT/XOP
// graduated to real tables below (see START ENGINE OIL TEMP/PRESSURE,
// START TRANSMISSION OIL TEMP/PRESSURE).

// Turbine Speed (RPME) percent-to-step calibration table, hand-measured
// on the bench specifically for this board (diverges from
// JET_RANGER_STEPPER_CONTROLLER.ino's TS_PCT_TABLE, which still has its
// own separate 13-point 0-117% table - the two are no longer identical).
// "step" is the raw step target for TSstepper.moveTo(). The 0-point is
// assumed (not directly given) to match this stepper's homed zero, same
// convention as the other tables' assumed 0 rows - confirm on the bench
// that RPME actually reads 0 (not just clamped to the 55% row) at rest.
// Sorted ascending by pct - tsPctToSteps() below relies on that order.
// NOTE: this table's max (110% -> 600 steps) is close to
// X27_FULLWIRE_STEPS (635), same reasoning as before for why TSstepper's
// startup swing (above) isn't a large overshoot relative to this gauge's
// real full-scale range.
struct PctToStepEntry {
  long pct;
  long step;
};

const PctToStepEntry TS_PCT_TABLE[] = {
  { 0, 0 },
  { 55, 300 },
  { 100, 535 },
  { 110, 600 },
};
const int TS_PCT_TABLE_SIZE = sizeof(TS_PCT_TABLE) / sizeof(TS_PCT_TABLE[0]);

// Converts a requested turbine speed in percent into a step target by
// linear interpolation between the two nearest TS_PCT_TABLE rows (same
// pattern as the other *ToSteps() functions). A pct value outside the
// table's 0..110 range is clamped to whichever end is nearest rather
// than extrapolated. Takes a float (not long) so the one-decimal-place
// precision FSUIPCWinformsAutoCS now sends for RPME (e.g. "82.4", was a
// truncated "82") actually reaches the interpolation instead of being
// rounded away before it gets here.
long tsPctToSteps(float pct) {
  if (pct <= TS_PCT_TABLE[0].pct) return TS_PCT_TABLE[0].step;
  if (pct >= TS_PCT_TABLE[TS_PCT_TABLE_SIZE - 1].pct) return TS_PCT_TABLE[TS_PCT_TABLE_SIZE - 1].step;

  for (int i = 0; i < TS_PCT_TABLE_SIZE - 1; i++) {
    long pctLo = TS_PCT_TABLE[i].pct;
    long pctHi = TS_PCT_TABLE[i + 1].pct;
    if (pct >= pctLo && pct <= pctHi) {
      long stepLo = TS_PCT_TABLE[i].step;
      long stepHi = TS_PCT_TABLE[i + 1].step;
      return stepLo + (long)round((double)(pct - pctLo) * (stepHi - stepLo) / (double)(pctHi - pctLo));
    }
  }
  return 0;  // unreachable - every pct is covered by the clamps or the loop above
}

// TSoffset (fine-trim step offset for TS_PCT_TABLE's computed target) is
// defined near the other offsets above, not here - it has to come before setup()
// since the Turbine Speed startup swing (above) also uses it to return
// to the calibrated zero position, not just this function.

void setTS(float TargetPct) {
  TSstepper.moveTo(tsPctToSteps(TargetPct) + TSoffset);
}

// Rotor Speed (RPMR) percent-to-step calibration table, hand-measured on
// the bench specifically for this board - same values as this board's
// own TS_PCT_TABLE above (both gauges share the same physical
// stepper/dial hardware and percent range), but kept as its own
// table/function pair rather than reused, matching the per-gauge pattern
// used throughout this file. Diverges from
// JET_RANGER_STEPPER_CONTROLLER.ino's RS_PCT_TABLE, which still has its
// own separate 13-point 0-117% table. "step" is the raw step target for
// RSstepper.moveTo(). The 0-point is assumed (not directly given), same
// convention as TS_PCT_TABLE's above. Sorted ascending by pct -
// rsPctToSteps() below relies on that order.
const PctToStepEntry RS_PCT_TABLE[] = {
  { 0, 0 },
  { 55, 300 },
  { 100, 535 },
  { 110, 600 },
};
const int RS_PCT_TABLE_SIZE = sizeof(RS_PCT_TABLE) / sizeof(RS_PCT_TABLE[0]);

// Converts a requested rotor speed in percent into a step target by
// linear interpolation between the two nearest RS_PCT_TABLE rows (same
// pattern as tsPctToSteps() above). A pct value outside the table's
// 0..110 range is clamped to whichever end is nearest rather than
// extrapolated. Takes a float (not long) - same reasoning as
// tsPctToSteps()'s own float parameter above.
long rsPctToSteps(float pct) {
  if (pct <= RS_PCT_TABLE[0].pct) return RS_PCT_TABLE[0].step;
  if (pct >= RS_PCT_TABLE[RS_PCT_TABLE_SIZE - 1].pct) return RS_PCT_TABLE[RS_PCT_TABLE_SIZE - 1].step;

  for (int i = 0; i < RS_PCT_TABLE_SIZE - 1; i++) {
    long pctLo = RS_PCT_TABLE[i].pct;
    long pctHi = RS_PCT_TABLE[i + 1].pct;
    if (pct >= pctLo && pct <= pctHi) {
      long stepLo = RS_PCT_TABLE[i].step;
      long stepHi = RS_PCT_TABLE[i + 1].step;
      return stepLo + (long)round((double)(pct - pctLo) * (stepHi - stepLo) / (double)(pctHi - pctLo));
    }
  }
  return 0;  // unreachable - every pct is covered by the clamps or the loop above
}

// RSoffset (fine-trim step offset for RS_PCT_TABLE's computed target) is
// defined near the other offsets above, not here - same reasoning as TSoffset's
// relocation note in setTS() above.

void setRS(float TargetPct) {
  RSstepper.moveTo(rsPctToSteps(TargetPct) + RSoffset);
}

// #define GP_MIN_PCT 0
// #define GP_MAX_PCT 105
// long gpPctToSteps(long pct) {
//   if (pct < GP_MIN_PCT) pct = GP_MIN_PCT;
//   if (pct > GP_MAX_PCT) pct = GP_MAX_PCT;
//   return map(pct, GP_MIN_PCT, GP_MAX_PCT, 0, FULL4WIRE_HOMING_STEPS);
// }
// void setGP(long TargetPct) {
//   GPstepper.moveTo(gpPctToSteps(TargetPct));
// }

#define FA_MIN_GAL 0
#define FA_MAX_GAL 75
long faGalToSteps(long gal) {
  if (gal < FA_MIN_GAL) gal = FA_MIN_GAL;
  if (gal > FA_MAX_GAL) gal = FA_MAX_GAL;
  return map(gal, FA_MIN_GAL, FA_MAX_GAL, 0, FULL4WIRE_HOMING_STEPS);
}
void setFA(long TargetGal) {
  FAstepper.moveTo(faGalToSteps(TargetGal));
}

// ################################### END EOT/EOP/XOT/XOP/TS/RS/GP/FA ##############################################

// ################################### START FUEL LOAD ##############################################

// Fuel Load PSI-to-step calibration table, hand-measured on the bench
// (same pattern as TS_PCT_TABLE above). "step" is the raw
// step target for FuelLoadStepper.moveTo(). This stepper was Radar Alt -
// and had a real AGL_FT_TABLE - on the single-board sketch this was
// forked from; that table described radar altitude in feet, not PSI, so
// it was removed rather than reused/renamed. Only two points measured so
// far (0 and 30 PSI) - fuelLoadPsiToSteps()'s interpolation is exact
// between them but a straight-line guess above 30 PSI until a higher
// point is bench-measured. Sorted ascending by psi -
// fuelLoadPsiToSteps() below relies on that order.
struct PsiToStepEntry {
  long psi;
  long step;
};

const PsiToStepEntry FUEL_LOAD_PSI_TABLE[] = {
  { 0, 0 },
  { 30, 160 },
};
const int FUEL_LOAD_PSI_TABLE_SIZE = sizeof(FUEL_LOAD_PSI_TABLE) / sizeof(FUEL_LOAD_PSI_TABLE[0]);

// Converts a requested fuel load in PSI into a step target by linear
// interpolation between the two nearest FUEL_LOAD_PSI_TABLE rows (same
// pattern as tsPctToSteps()). A psi value outside the
// table's 0..30 range is clamped to whichever end is nearest rather than
// extrapolated.
long fuelLoadPsiToSteps(long psi) {
  if (psi <= FUEL_LOAD_PSI_TABLE[0].psi) return FUEL_LOAD_PSI_TABLE[0].step;
  if (psi >= FUEL_LOAD_PSI_TABLE[FUEL_LOAD_PSI_TABLE_SIZE - 1].psi) return FUEL_LOAD_PSI_TABLE[FUEL_LOAD_PSI_TABLE_SIZE - 1].step;

  for (int i = 0; i < FUEL_LOAD_PSI_TABLE_SIZE - 1; i++) {
    long psiLo = FUEL_LOAD_PSI_TABLE[i].psi;
    long psiHi = FUEL_LOAD_PSI_TABLE[i + 1].psi;
    if (psi >= psiLo && psi <= psiHi) {
      long stepLo = FUEL_LOAD_PSI_TABLE[i].step;
      long stepHi = FUEL_LOAD_PSI_TABLE[i + 1].step;
      return stepLo + (long)round((double)(psi - psiLo) * (stepHi - stepLo) / (double)(psiHi - psiLo));
    }
  }
  return 0;  // unreachable - every psi is covered by the clamps or the loop above
}

void setFuelLoad(long TargetPsi) {
  FuelLoadStepper.moveTo(fuelLoadPsiToSteps(TargetPsi) + FuelLoadZeroOffset);
}

// ################################### END FUEL LOAD ##############################################

// ################################### START ELECTRICAL LOAD ##############################################

// Electrical Load percent-to-step calibration table, hand-measured on the
// bench (reuses the PctToStepEntry struct TS_PCT_TABLE/RS_PCT_TABLE
// already declared above). "step" is the raw step target for
// ElectricalLoadStepper.moveTo(). This stepper (pins 36-39) was Torque
// (UDP code "TQ") on the single-board sketch this was forked from; this
// board repurposes it as Electrical Load instead. Unlike every other
// table in this sketch, the 0% row is NOT the stepper's raw zero - it's
// 22 steps, bench-measured same as the 100% row - so
// electricalLoadPctToSteps() interpolates between two real measured
// points instead of assuming a 0-real-unit/0-step origin. Sorted
// ascending by pct - electricalLoadPctToSteps() below relies on that
// order.
const PctToStepEntry ELECTRICAL_LOAD_PCT_TABLE[] = {
  { 0, 22 },
  { 100, 200 },
};
const int ELECTRICAL_LOAD_PCT_TABLE_SIZE = sizeof(ELECTRICAL_LOAD_PCT_TABLE) / sizeof(ELECTRICAL_LOAD_PCT_TABLE[0]);

// Converts a requested electrical load in percent into a step target by
// linear interpolation between the two nearest ELECTRICAL_LOAD_PCT_TABLE
// rows (same pattern as tsPctToSteps()/rsPctToSteps() above). A pct value
// outside the table's 0..100 range is clamped to whichever end is
// nearest rather than extrapolated.
long electricalLoadPctToSteps(long pct) {
  if (pct <= ELECTRICAL_LOAD_PCT_TABLE[0].pct) return ELECTRICAL_LOAD_PCT_TABLE[0].step;
  if (pct >= ELECTRICAL_LOAD_PCT_TABLE[ELECTRICAL_LOAD_PCT_TABLE_SIZE - 1].pct) return ELECTRICAL_LOAD_PCT_TABLE[ELECTRICAL_LOAD_PCT_TABLE_SIZE - 1].step;

  for (int i = 0; i < ELECTRICAL_LOAD_PCT_TABLE_SIZE - 1; i++) {
    long pctLo = ELECTRICAL_LOAD_PCT_TABLE[i].pct;
    long pctHi = ELECTRICAL_LOAD_PCT_TABLE[i + 1].pct;
    if (pct >= pctLo && pct <= pctHi) {
      long stepLo = ELECTRICAL_LOAD_PCT_TABLE[i].step;
      long stepHi = ELECTRICAL_LOAD_PCT_TABLE[i + 1].step;
      return stepLo + (long)round((double)(pct - pctLo) * (stepHi - stepLo) / (double)(pctHi - pctLo));
    }
  }
  return 0;  // unreachable - every pct is covered by the clamps or the loop above
}

void setElectricalLoad(long TargetPct) {
  ElectricalLoadStepper.moveTo(electricalLoadPctToSteps(TargetPct) + ElectricalLoadZeroOffset);
}

// ################################### END ELECTRICAL LOAD ##############################################

// ################################### START ENGINE OIL TEMP ##############################################

// Engine Oil Temp (OILT) degrees-C-to-step calibration table, hand-measured
// on the bench. "step" is the raw step target for EOTstepper.moveTo().
// Replaces the placeholder linear scale (0-150C mapped straight onto
// 0..FULL4WIRE_HOMING_STEPS) EOT shared with EGT/XOT/XOP/N1/FUEL until
// now - see the "EOT/EOP/XOT/XOP/TS/RS/GP/FA" section above for that
// placeholder's rationale, which still applies to the others. Sorted
// ascending by tempC - eotCToSteps() below relies on that order.
struct CToStepEntry {
  long tempC;
  long step;
};

const CToStepEntry EOT_C_TABLE[] = {
  { 0, 0 },
  { 50, 79 },
  { 100, 156 },
  { 150, 231 },
};
const int EOT_C_TABLE_SIZE = sizeof(EOT_C_TABLE) / sizeof(EOT_C_TABLE[0]);

// Converts a requested engine oil temperature in degrees C into a step
// target by linear interpolation between the two nearest EOT_C_TABLE rows
// (same pattern as tsPctToSteps()/fuelLoadPsiToSteps() above). A tempC
// value outside the table's 0..150 range is clamped to whichever end is
// nearest rather than extrapolated.
long eotCToSteps(long tempC) {
  if (tempC <= EOT_C_TABLE[0].tempC) return EOT_C_TABLE[0].step;
  if (tempC >= EOT_C_TABLE[EOT_C_TABLE_SIZE - 1].tempC) return EOT_C_TABLE[EOT_C_TABLE_SIZE - 1].step;

  for (int i = 0; i < EOT_C_TABLE_SIZE - 1; i++) {
    long cLo = EOT_C_TABLE[i].tempC;
    long cHi = EOT_C_TABLE[i + 1].tempC;
    if (tempC >= cLo && tempC <= cHi) {
      long stepLo = EOT_C_TABLE[i].step;
      long stepHi = EOT_C_TABLE[i + 1].step;
      return stepLo + (long)round((double)(tempC - cLo) * (stepHi - stepLo) / (double)(cHi - cLo));
    }
  }
  return 0;  // unreachable - every tempC is covered by the clamps or the loop above
}

void setEOT(long TargetC) {
  EOTstepper.moveTo(eotCToSteps(TargetC) + EOTZeroOffset);
}

// ################################### END ENGINE OIL TEMP ##############################################

// ################################### START ENGINE OIL PRESSURE ##############################################

// Engine Oil Pressure (OILP) PSI-to-step calibration table, hand-measured
// on the bench (reuses the PsiToStepEntry struct FUEL_LOAD_PSI_TABLE
// already declared above). "step" is the raw step target for
// EOPstepper.moveTo(). Replaces the placeholder linear scale (0-150 PSI
// mapped straight onto 0..FULL4WIRE_HOMING_STEPS) EOP shared with
// EGT/XOT/XOP/N1/FUEL until now. Sorted ascending by psi -
// eopPsiToSteps() below relies on that order.
const PsiToStepEntry EOP_PSI_TABLE[] = {
  { 0, 0 },
  { 50, 74 },
  { 100, 148 },
  { 150, 220 },
};
const int EOP_PSI_TABLE_SIZE = sizeof(EOP_PSI_TABLE) / sizeof(EOP_PSI_TABLE[0]);

// Converts a requested engine oil pressure in PSI into a step target by
// linear interpolation between the two nearest EOP_PSI_TABLE rows (same
// pattern as fuelLoadPsiToSteps()/eotCToSteps() above). A psi value
// outside the table's 0..150 range is clamped to whichever end is
// nearest rather than extrapolated.
long eopPsiToSteps(long psi) {
  if (psi <= EOP_PSI_TABLE[0].psi) return EOP_PSI_TABLE[0].step;
  if (psi >= EOP_PSI_TABLE[EOP_PSI_TABLE_SIZE - 1].psi) return EOP_PSI_TABLE[EOP_PSI_TABLE_SIZE - 1].step;

  for (int i = 0; i < EOP_PSI_TABLE_SIZE - 1; i++) {
    long psiLo = EOP_PSI_TABLE[i].psi;
    long psiHi = EOP_PSI_TABLE[i + 1].psi;
    if (psi >= psiLo && psi <= psiHi) {
      long stepLo = EOP_PSI_TABLE[i].step;
      long stepHi = EOP_PSI_TABLE[i + 1].step;
      return stepLo + (long)round((double)(psi - psiLo) * (stepHi - stepLo) / (double)(psiHi - psiLo));
    }
  }
  return 0;  // unreachable - every psi is covered by the clamps or the loop above
}

void setEOP(long TargetPsi) {
  EOPstepper.moveTo(eopPsiToSteps(TargetPsi) + EOPZeroOffset);
}

// ################################### END ENGINE OIL PRESSURE ##############################################

// ################################### START TRANSMISSION OIL TEMP ##############################################

// Transmission Oil Temp (XMSNT) degrees-C-to-step calibration table,
// hand-measured on the bench (reuses the CToStepEntry struct EOT_C_TABLE
// already declared above). "step" is the raw step target for
// XOTstepper.moveTo(). Replaces the placeholder linear scale (0-150C
// mapped straight onto 0..FULL4WIRE_HOMING_STEPS) XOT shared with
// XOP/EGT/N1/FUEL until now. Sorted ascending by tempC - xotCToSteps()
// below relies on that order.
const CToStepEntry XOT_C_TABLE[] = {
  { 0, 0 },
  { 50, 75 },
  { 100, 150 },
  { 150, 225 },
};
const int XOT_C_TABLE_SIZE = sizeof(XOT_C_TABLE) / sizeof(XOT_C_TABLE[0]);

// Converts a requested transmission oil temperature in degrees C into a
// step target by linear interpolation between the two nearest
// XOT_C_TABLE rows (same pattern as eotCToSteps()/eopPsiToSteps() above).
// A tempC value outside the table's 0..150 range is clamped to whichever
// end is nearest rather than extrapolated.
long xotCToSteps(long tempC) {
  if (tempC <= XOT_C_TABLE[0].tempC) return XOT_C_TABLE[0].step;
  if (tempC >= XOT_C_TABLE[XOT_C_TABLE_SIZE - 1].tempC) return XOT_C_TABLE[XOT_C_TABLE_SIZE - 1].step;

  for (int i = 0; i < XOT_C_TABLE_SIZE - 1; i++) {
    long cLo = XOT_C_TABLE[i].tempC;
    long cHi = XOT_C_TABLE[i + 1].tempC;
    if (tempC >= cLo && tempC <= cHi) {
      long stepLo = XOT_C_TABLE[i].step;
      long stepHi = XOT_C_TABLE[i + 1].step;
      return stepLo + (long)round((double)(tempC - cLo) * (stepHi - stepLo) / (double)(cHi - cLo));
    }
  }
  return 0;  // unreachable - every tempC is covered by the clamps or the loop above
}

void setXOT(long TargetC) {
  XOTstepper.moveTo(xotCToSteps(TargetC) + XOTZeroOffset);
}

// ################################### END TRANSMISSION OIL TEMP ##############################################

// ################################### START TRANSMISSION OIL PRESSURE ##############################################

// Transmission Oil Pressure (XMSNP) PSI-to-step calibration table,
// hand-measured on the bench (reuses the PsiToStepEntry struct
// FUEL_LOAD_PSI_TABLE/EOP_PSI_TABLE already declared above). "step" is
// the raw step target for XOPstepper.moveTo(). Replaces the placeholder
// linear scale (0-150 PSI mapped straight onto 0..FULL4WIRE_HOMING_STEPS)
// XOP shared with EGT/N1/FUEL until now. 5 points (one more than
// EOP_PSI_TABLE's 4) - sorted ascending by psi, xopPsiToSteps() below
// relies on that order.
const PsiToStepEntry XOP_PSI_TABLE[] = {
  { 0, 0 },
  { 50, 74 },
  { 70, 104 },
  { 100, 149 },
  { 150, 220 },
};
const int XOP_PSI_TABLE_SIZE = sizeof(XOP_PSI_TABLE) / sizeof(XOP_PSI_TABLE[0]);

// Converts a requested transmission oil pressure in PSI into a step
// target by linear interpolation between the two nearest XOP_PSI_TABLE
// rows (same pattern as eopPsiToSteps()/xotCToSteps() above). A psi value
// outside the table's 0..150 range is clamped to whichever end is
// nearest rather than extrapolated.
long xopPsiToSteps(long psi) {
  if (psi <= XOP_PSI_TABLE[0].psi) return XOP_PSI_TABLE[0].step;
  if (psi >= XOP_PSI_TABLE[XOP_PSI_TABLE_SIZE - 1].psi) return XOP_PSI_TABLE[XOP_PSI_TABLE_SIZE - 1].step;

  for (int i = 0; i < XOP_PSI_TABLE_SIZE - 1; i++) {
    long psiLo = XOP_PSI_TABLE[i].psi;
    long psiHi = XOP_PSI_TABLE[i + 1].psi;
    if (psi >= psiLo && psi <= psiHi) {
      long stepLo = XOP_PSI_TABLE[i].step;
      long stepHi = XOP_PSI_TABLE[i + 1].step;
      return stepLo + (long)round((double)(psi - psiLo) * (stepHi - stepLo) / (double)(psiHi - psiLo));
    }
  }
  return 0;  // unreachable - every psi is covered by the clamps or the loop above
}

void setXOP(long TargetPsi) {
  XOPstepper.moveTo(xopPsiToSteps(TargetPsi) + XOPZeroOffset);
}

// ################################### END TRANSMISSION OIL PRESSURE ##############################################


// SARI

long timeToDisable_SARI_ROLL = 0;
bool waitingToDisable_SARI_ROLL = false;
bool SARI_ROLL_ENABLED = false;
#define disable_SARI_ROLL_WaitTime 300  // mS delay after SARI ROll has founds its position \
                                        // Used to help hold the SARI in position

struct SARIStepperConfig {
  unsigned int SARImaxSteps;
  unsigned int SARIacceleration;
  unsigned int maxSpeed;
};
bool SARI_ROLL_INITIALISED = false;


//////SARI - TEST - BEN --------------------------------------------------------------------------------------------------------------
//----------ROLL SERVO----------
//DcsBios::ServoOutput saiPitch(0x74e4, 9, 2400, 544);
DcsBios::ServoOutput saiPitch(0x1028, 9, 2400, 544);

//----------ROLL STEPPER----------

const long zeroTimeout = 50000;
const int SARIenablePin = 56;


class Nema8Stepper : public DcsBios::Int16Buffer {
private:

  AccelStepper& stepper;
  SARIStepperConfig& SARIstepperConfig;
  inline bool SARIzeroDetected() {
    return digitalRead(SARIirDetectorPin) == 0;
  }
  unsigned int (*map_function)(unsigned int);
  unsigned char initState;
  long SARIcurrentStepperPosition;
  long SARIlastAccelStepperPosition;
  unsigned char SARIirDetectorPin;
  long SARIzeroOffset;
  bool SARImovingForward;
  bool SARIlastZeroDetectState;

  long SARIzeroPosSearchStartTime = 0;

  long SARInormalizeStepperPosition(long pos) {
    if (pos < 0) return pos + SARIstepperConfig.SARImaxSteps;
    if (pos >= SARIstepperConfig.SARImaxSteps) return pos - SARIstepperConfig.SARImaxSteps;
    return pos;
  }

  void updateSARIcurrentStepperPosition() {
    // adjust SARIcurrentStepperPosition to include the distance our stepper motor
    // was moved since we last updated it
    long SARImovementSinceLastUpdate = stepper.currentPosition() - SARIlastAccelStepperPosition;
    SARIcurrentStepperPosition = SARInormalizeStepperPosition(SARIcurrentStepperPosition + SARImovementSinceLastUpdate);
    SARIlastAccelStepperPosition = stepper.currentPosition();
  }


public:
  Nema8Stepper(unsigned int address, AccelStepper& stepper, SARIStepperConfig& SARIstepperConfig, unsigned char SARIirDetectorPin, long SARIzeroOffset, unsigned int (*map_function)(unsigned int))
    : Int16Buffer(address), stepper(stepper), SARIstepperConfig(SARIstepperConfig), SARIirDetectorPin(SARIirDetectorPin), SARIzeroOffset(SARIzeroOffset), map_function(map_function), initState(0), SARIcurrentStepperPosition(0), SARIlastAccelStepperPosition(0) {
  }


  virtual void loop() {
    if (initState == 0) {  // not initialized yet
      SendDebug("SARI initState: " + String(initState));
      pinMode(SARIirDetectorPin, INPUT);
      stepper.setMaxSpeed(SARIstepperConfig.maxSpeed);
      stepper.setAcceleration(SARIstepperConfig.SARIacceleration);

      stepper.setMaxSpeed(4000);
      stepper.setAcceleration(500);

      initState = 1;
      SendDebug("Do a quick loop");

      // Microstepping - 16 steps
      // 42HK40 1.8 degrees per step, so 200 steps per turn without microstepping
      // 3200 steps with microstepping
      stepper.moveTo(-1600 * 10);
      while (stepper.distanceToGo() != 0) {
        stepper.run();
      }
      SendDebug("Quick loop complete");
      delay(1000);

      SendDebug("SARI initState moving to State 1");
      SARIzeroPosSearchStartTime = millis();
    }

    if (initState == 1) {
      // move off zero if already there so we always get movement on reset
      // (to verify that the stepper is working)
      if (SARIzeroDetected()) {
        SendDebug("SARI moving off zero sense");
        stepper.move(-300);
        while (stepper.distanceToGo() != 0) {
          stepper.run();
        }

        stepper.runSpeed();
      } else {
        initState = 2;
        SendDebug("SARI initState moving to State 2");
        stepper.setMaxSpeed(SARIstepperConfig.maxSpeed);
        stepper.setAcceleration(SARIstepperConfig.SARIacceleration);
      }
    }

    if (initState == 2) {  // zeroing



      if (!SARIzeroDetected()) {

        if (millis() >= (zeroTimeout + SARIzeroPosSearchStartTime)) {
          SendDebug("SARI Roll - timeoutout finding zero, disabling driver pin");

          initState = 99;
        }

        //SendDebug("SARI Roll - looping - " + String(initState));
        stepper.moveTo(stepper.currentPosition() - 1);
        stepper.run();


      } else {
        stepper.setAcceleration(SARIstepperConfig.SARIacceleration);
        stepper.runToNewPosition(stepper.currentPosition());
        // tell the AccelStepper library that we are at position zero
        stepper.setCurrentPosition(SARIzeroOffset);
        SARIlastAccelStepperPosition = 0;
        // set stepper SARIacceleration in steps per second per second
        // (default is zero)
        stepper.setAcceleration(SARIstepperConfig.SARIacceleration);

        SARIlastZeroDetectState = true;
        initState = 3;
        SendDebug("SARI initState moving to State 3");
        SARI_ROLL_INITIALISED = true;

        ;
      }
    }


    if (initState == 99) {  // Timed out looking for zero do nothing
    }

    //    digitalWrite(enablePin, HIGH);
    if (initState == 3) {  // running normally

      // recalibrate when passing through zero position
      bool SARIcurrentZeroDetectState = SARIzeroDetected();
      if (!SARIlastZeroDetectState && SARIcurrentZeroDetectState && SARImovingForward) {
        // we have moved from left to right into the 'zero detect window'
        // and are now at position 0
        SARIlastAccelStepperPosition = stepper.currentPosition();
        SARIcurrentStepperPosition = SARInormalizeStepperPosition(SARIzeroOffset);
      } else if (SARIlastZeroDetectState && !SARIcurrentZeroDetectState && !SARImovingForward) {
        // we have moved from right to left out of the 'zero detect window'
        // and are now at position (SARImaxSteps-1)
        SARIlastAccelStepperPosition = stepper.currentPosition();
        SARIcurrentStepperPosition = SARInormalizeStepperPosition(SARIstepperConfig.SARImaxSteps + SARIzeroOffset);
      }
      SARIlastZeroDetectState = SARIcurrentZeroDetectState;


      if (hasUpdatedData()) {
        // convert data from DCS to a target position expressed as a number of steps
        long targetPosition = (long)map_function(getData());

        updateSARIcurrentStepperPosition();

        long delta = targetPosition - SARIcurrentStepperPosition;

        // if we would move more than 180 degree counterclockwise, move clockwise instead

        if (delta < -((long)(SARIstepperConfig.SARImaxSteps / 2))) delta += SARIstepperConfig.SARImaxSteps;  //2
        // if we would move more than 180 degree clockwise, move counterclockwise instead
        if (delta > (SARIstepperConfig.SARImaxSteps / 2)) delta -= (long)SARIstepperConfig.SARImaxSteps;  //2

        SARImovingForward = (delta >= 0);





        // tell AccelStepper to move relative to the current position
        stepper.move(delta);
      }
      stepper.run();
      if ((stepper.distanceToGo() == 0) && (waitingToDisable_SARI_ROLL == false) && (SARI_ROLL_ENABLED == true)) {
        // SendDebug("Starting Count down to disable SARI ROLL");
        waitingToDisable_SARI_ROLL = true;
        timeToDisable_SARI_ROLL = millis() + disable_SARI_ROLL_WaitTime;
      }
    }
  }
};

struct SARIStepperConfig SARIstepperConfig = {
  1600,   // SARImaxSteps //200 Native steps with 1/16 MICRO STEPPING
  90000,  // maxSpeed //3200
  60000   // SARIacceleration 3200
};
const int SARIstepPin = 30;
const int SARIdirectionPin = 32;

// define AccelStepper instance
AccelStepper SARIstepperRoll(AccelStepper::DRIVER, SARIstepPin, SARIdirectionPin);

// // Hornet Address - 0x74e6
// // A10 Address - 0x102a
// Nema8Stepper SARIRoll(0x102a,             // address of stepper data
//                       SARIstepperRoll,    // name of AccelStepper instance
//                       SARIstepperConfig,  // SARIStepperConfig struct instance
//                       55,                 // IR Detector Pin (must be LOW in zero position)
//                       800,                // zero offset (SET TO 50% of MaX Steps) 1650 was 800
//                                           // WIngs Level = 1/2 Max Steps -> "Zero" = 1/2 Turn
//                                           // SARI will be upsidedown after Setup, this will correct in Bios
//                       [](unsigned int newValue) -> unsigned int {
//                         newValue = newValue & 0xffff;
//                         return map(newValue, 0, 65535, 0, SARIstepperConfig.SARImaxSteps - 1);
//                       });





// ######################################  End SARI  ######################################



void updateSteppers() {
  ALTstepper.run();
  FuelLoadStepper.run();
  EOTstepper.run();
  XOTstepper.run();
  XOPstepper.run();
  EGTstepper.run();
  TSstepper.run();
  RSstepper.run();
  FAstepper.run();
  ElectricalLoadStepper.run();
  //GPstepper.run();
  EOPstepper.run();
}

void onIntConsoleLBrightChange(unsigned int newValue) {
  if (!backlightStartupHold) analogWrite(BACK_LIGHTS, map(newValue, 0, 65535, 0, 255));
}
DcsBios::IntegerBuffer intConsoleLBrightBuffer(A_10C_INT_CONSOLE_L_BRIGHT, onIntConsoleLBrightChange);



// ################################ END STEPPERS ##############################

// ########################################## BEGIN MSFS DATA RECEIVER ########################################
// Receives the same "D,CODE:value,CODE:value,..." UDP payload that
// JET_RANGER_SERVO_CONTROLLER parses. Only ALT (altitude) and the engine/
// transmission/load/RPM gauges are wired up; every other code is ignored.

void ProcessReceivedMSFSString() {

  char* ParameterNamePtr;
  const char* delim = ",";

  // Break the received packet into a series of tokens
  ParameterNamePtr = strtok(packetBuffer, delim);
  String ParameterNameString(ParameterNamePtr);

  if (ParameterNameString[0] == 'D') {
    // Handling a Data Packet
    ParameterNamePtr = strtok(NULL, delim);

    while (ParameterNamePtr != NULL) {
      String wrkstring = String(ParameterNamePtr);
      HandleOutputValuePair(wrkstring);
      ParameterNamePtr = strtok(NULL, delim);
    }
    return;
  } else if (ParameterNameString[0] == 'C') {
    // Handling a Control Packet
    ParameterNamePtr = strtok(NULL, delim);

    while (ParameterNamePtr != NULL) {
      String wrkstring = String(ParameterNamePtr);
      HandleControlString(wrkstring);
      ParameterNamePtr = strtok(NULL, delim);
    }
    return;
  }
  // Unknown Packet Type - ignore
}

void HandleOutputValuePair(String str) {

  int delimeterlocation = str.indexOf(':');
  if (delimeterlocation == 0) return;

  String ParameterName = getValue(str, ':', 0);
  String ParameterValue = getValue(str, ':', 1);
  ParameterValue.trim();

  if (ParameterName == "ALT") {
    // ALT is sent as raw feet, matching the units this sketch's own
    // DCS-BIOS altitude callback already expects, so its feet->steps
    // conversion can be reused directly.
    //SendDebug("Altitude is :" + String(ParameterValue.toInt()));
    onAltMslFtChange((unsigned int)ParameterValue.toInt());
  } else if (ParameterName == "ALTRAW") {
    // Distinct raw-step code, bypassing the feet*5.76 conversion above.
    ALTstepper.moveTo(ParameterValue.toInt());
  } else if (ParameterName == "BPWR") {
    // Backlight power from the bridge: 1 = main bus 20 V or more, 0 = off. See applyBacklight().
    bool powered = ParameterValue.toInt() != 0;
    if (powered != backlightPowered) {
      backlightPowered = powered;
      applyBacklight();
      SendDebug(powered ? "Backlight power on" : "Backlight power off");
    }
  } else if (ParameterName == "PWR") {
    // 1 = all four OLEDs on, 0 = blank them (main bus below 24 V).
    setOledsPower(ParameterValue.toInt() != 0);
  } else if (ParameterName == "TEMP") {
    // Temperature as a string (e.g. "21C") for the Temperature OLED on mux
    // channel 4 - shown exactly as received. See onTempChange()/updateTemp().
    onTempChange(ParameterValue);
  } else if (ParameterName == "ZULU") {
    // HHMM-encoded Zulu time (e.g. 1430 for 14:30) for the Clock OLED -
    // no DCS-BIOS callback for this one, FSUIPCWinformsAutoCS is the
    // only source. See onZuluTimeChange()/updateClock() above.
    onZuluTimeChange(ParameterValue.toInt());
  } else if (ParameterName == "FUELLOAD") {
    // Real PSI now (see setFuelLoad()/FUEL_LOAD_PSI_TABLE, "START FUEL
    // LOAD" above - only 0/30 PSI bench-measured so far). This stepper
    // (pins 32-35) was Radar Alt (UDP code "AGL", real AGL_FT_TABLE
    // calibration) on the single-board sketch this was forked from; this
    // board repurposes it as Fuel Load instead, so "AGL" no longer exists
    // here.
    setFuelLoad(ParameterValue.toInt());
  } else if (ParameterName == "FUELLOADRAW") {
    // Distinct raw-step code, bypassing fuelLoadPsiToSteps() above - same
    // pattern as every other calibrated gauge's "<CODE>RAW" sibling.
    FuelLoadStepper.moveTo(ParameterValue.toInt());
  } else if (ParameterName == "OILT") {
    // Real degrees C now (Engine Oil Temperature, 0-150) - see setEOT()/
    // eotCToSteps() above. Renamed from this sketch's original "EOT" to
    // match JET_RANGER_SERVO_CONTROLLER.ino's existing code for the same
    // real-world quantity, so both boards can be driven by the same UDP
    // payload instead of needing a separate send under a different name.
    setEOT(ParameterValue.toInt());
  } else if (ParameterName == "OILTRAW") {
    // Distinct raw-step code, bypassing eotCToSteps() above.
    EOTstepper.moveTo(ParameterValue.toInt());
  } else if (ParameterName == "XMSNT") {
    // Real degrees C now (Transmission Oil Temperature, 0-150). Renamed
    // from "XOT" to match JET_RANGER_SERVO_CONTROLLER.ino.
    setXOT(ParameterValue.toInt());
  } else if (ParameterName == "XMSNTRAW") {
    // Distinct raw-step code, bypassing xotCToSteps() above.
    XOTstepper.moveTo(ParameterValue.toInt());
  } else if (ParameterName == "XMSNP") {
    // Real PSI now (Transmission Oil Pressure, 0-150). Renamed from "XOP"
    // to match JET_RANGER_SERVO_CONTROLLER.ino.
    setXOP(ParameterValue.toInt());
  } else if (ParameterName == "XMSNPRAW") {
    // Distinct raw-step code, bypassing xopPsiToSteps() above.
    XOPstepper.moveTo(ParameterValue.toInt());
  } else if (ParameterName == "ITT") {
    // Real degrees C now (see setEGT()/egtCToSteps() above) - no longer a
    // raw step target like the other new-gauge codes below. Renamed from
    // "EGT" to match JET_RANGER_SERVO_CONTROLLER.ino's code for the same
    // real-world quantity (Bell 206 calls this ITT, not EGT).
    setEGT(ParameterValue.toInt());
  } else if (ParameterName == "ITTRAW") {
    // Distinct raw-step code, bypassing egtCToSteps() above.
    EGTstepper.moveTo(ParameterValue.toInt());
  } else if (ParameterName == "RPME") {
    // Real percent now (Turbine/Engine Speed, 0-110 - see this board's own
    // TS_PCT_TABLE above, which diverges from the single-board sketch's
    // table). Renamed from "TS" to match JET_RANGER_SERVO_CONTROLLER.ino's
    // "RPME" (Engine RPM) - same real-world quantity. toFloat() (not
    // toInt()) so FSUIPCWinformsAutoCS's one-decimal-place value (e.g.
    // "82.4") isn't truncated before reaching setTS()/tsPctToSteps().
    setTS(ParameterValue.toFloat());
  } else if (ParameterName == "RPMERAW") {
    // Distinct raw-step code, bypassing tsPctToSteps() above.
    TSstepper.moveTo(ParameterValue.toInt());
  } else if (ParameterName == "RPMR") {
    // Real percent now (Rotor Speed, 0-110 - see this board's own
    // RS_PCT_TABLE above, which diverges from the single-board sketch's
    // table). Renamed from "RS" to match JET_RANGER_SERVO_CONTROLLER.ino.
    // toFloat() - same reasoning as RPME's above.
    setRS(ParameterValue.toFloat());
  } else if (ParameterName == "RPMRRAW") {
    // Distinct raw-step code, bypassing rsPctToSteps() above.
    RSstepper.moveTo(ParameterValue.toInt());
  } else if (ParameterName == "FUEL") {
    // Real US gallons now (Fuel Available, 0-75). Renamed from "FA" to
    // match JET_RANGER_SERVO_CONTROLLER.ino.
    setFA(ParameterValue.toInt());
  } else if (ParameterName == "FUELRAW") {
    // Distinct raw-step code, bypassing faGalToSteps() above.
    FAstepper.moveTo(ParameterValue.toInt());
  } else if (ParameterName == "ELECTRICALLOAD") {
    // Real percent now (see setElectricalLoad()/ELECTRICAL_LOAD_PCT_TABLE,
    // "START ELECTRICAL LOAD" above). This stepper (pins 36-39) was Torque
    // (UDP code "TQ") on the single-board sketch this was forked from;
    // this board repurposes it as Electrical Load instead, so "TQ" no
    // longer exists here.
    setElectricalLoad(ParameterValue.toInt());
  } else if (ParameterName == "ELECTRICALLOADRAW") {
    // Distinct raw-step code, bypassing electricalLoadPctToSteps() above -
    // same pattern as every other calibrated gauge's "<CODE>RAW" sibling.
    ElectricalLoadStepper.moveTo(ParameterValue.toInt());
  } else if (ParameterName == "OILP") {
    // Real PSI now (Engine Oil Pressure, 0-150). Renamed from "EOP" to
    // match JET_RANGER_SERVO_CONTROLLER.ino.
    setEOP(ParameterValue.toInt());
  } else if (ParameterName == "OILPRAW") {
    // Distinct raw-step code, bypassing eopPsiToSteps() above.
    EOPstepper.moveTo(ParameterValue.toInt());
    // Every real-value gauge above (ALT/OILT/XMSNT/XMSNP/ITT/RPME/
    // RPMR/N1/OILP/FUEL) also has a distinct "<CODE>RAW" code for sending a
    // raw step target instead of a real-unit value, e.g. "ALTRAW" alongside
    // "ALT" - see each real-value case above for its matching *RAW sibling.
    // AGL/TQ/FLAPS/AOA/GFORCE/SPDMAX don't need one since they're already
    // raw-only. Every other code is currently parsed and silently ignored.
  }
}

// ###################### Remote reset over UDP ######################
// UDP control packet "C,RESET:1" reboots this board (value ignored). Done with
// the AVR watchdog, which resets the whole chip: debug message, a short delay so
// it can leave the network, then the watchdog is armed for 2s and the board
// waits for it. The 2s timeout is deliberately long: the Mega's bootloader may
// not switch the watchdog off, so a short timeout could reset it again before
// the sketch starts. The .init3 function below turns the watchdog off first
// thing after any reset (the standard avr-libc pattern) so the sketch never
// runs with it armed.
#include <avr/wdt.h>
void DisableWatchdogAtStartup() __attribute__((naked)) __attribute__((section(".init3"))) __attribute__((used));
void DisableWatchdogAtStartup() {
  MCUSR = 0;
  wdt_disable();
}

void RebootBoard() {
  SendDebug("RESET command received - rebooting in 2s");
  delay(100);
  wdt_enable(WDTO_2S);
  while (true) {
  }
}
// ###################################################################

void HandleControlString(String str) {
  // Control packet "C,<COMMAND>:<value>". Each SWING<CODE> command runs that
  // one gauge's boot startup swing on demand (ungated by the Swing flags;
  // the value is ignored). OLEDTEST:1/0 lights/restores the three OLEDs. RESET reboots the board. Commands: SWINGOILP, SWINGOILT, SWINGXMSNP, SWINGXMSNT, SWINGELECTRICALLOAD,
  // SWINGFUELLOAD, SWINGRPME, SWINGRPMR, SWINGALT.
  String name = getValue(str, ':', 0);
  name.trim();
  if (name == "SWINGOILP") {
    SendDebug("Swing command: " + name);
    swingEOP();
  } else if (name == "SWINGOILT") {
    SendDebug("Swing command: " + name);
    swingEOT();
  } else if (name == "SWINGXMSNP") {
    SendDebug("Swing command: " + name);
    swingXOP();
  } else if (name == "SWINGXMSNT") {
    SendDebug("Swing command: " + name);
    swingXOT();
  } else if (name == "SWINGELECTRICALLOAD") {
    SendDebug("Swing command: " + name);
    swingElectricalLoad();
  } else if (name == "SWINGFUELLOAD") {
    SendDebug("Swing command: " + name);
    swingFuelLoad();
  } else if (name == "SWINGRPME") {
    SendDebug("Swing command: " + name);
    swingTS();
  } else if (name == "SWINGRPMR") {
    SendDebug("Swing command: " + name);
    swingRS();
  } else if (name == "SWINGALT") {
    SendDebug("Swing command: " + name);
    swingALT();
  } else if (name == "OLEDTEST") {
    SendDebug("OLED test " + getValue(str, ':', 1));
    oledTest(getValue(str, ':', 1).toInt() != 0);
  } else if (name == "B") {
    // Panel brightness: C,B:0 .. C,B:15 (0 = off, 15 = full). Remembered, and applied now if the main bus is powered
    // (otherwise it is applied when power returns - see applyBacklight()).
    int level = constrain(getValue(str, ':', 1).toInt(), 0, 15);
    backlightCommandedPwm = map(level, 0, 15, 0, 255);
    applyBacklight();
    SendDebug("Brightness " + String(level) + " -> PWM " + String(backlightCommandedPwm) + (backlightPowered ? "" : " (main bus off, applied when power returns)"));
  } else if (name == "OLEDB") {
    // SSD1306 OLED brightness: C,OLEDB:0 .. C,OLEDB:15 (the four OLEDs only; the backlight has its own level, C,B)
    oledContrastLevel = constrain(getValue(str, ':', 1).toInt(), 0, 15);
    applyOledContrast();
    SendDebug(String(F("OLED brightness ")) + String(oledContrastLevel) + (oledsInitialised ? F("") : F(" (OLEDs not initialised, applied when they are)")));
  } else if (name == "VERSION") {
    SendDebug(firmwareText());
  } else if (name == "RESET") {
    RebootBoard();
  }
}

String getValue(String data, char separator, int index) {
  int found = 0;
  int strIndex[] = { 0, -1 };
  int maxIndex = data.length() - 1;

  for (int i = 0; i <= maxIndex && found <= index; i++) {
    if (data.charAt(i) == separator || i == maxIndex) {
      found++;
      strIndex[0] = strIndex[1] + 1;
      strIndex[1] = (i == maxIndex) ? i + 1 : i;
    }
  }
  return found > index ? data.substring(strIndex[0], strIndex[1]) : "";
}

// ########################################## END MSFS DATA RECEIVER ########################################

// Blanks all three OLEDs (clears each display's buffer and pushes it) -
// called alongside ResetGaugesToZero() below when the no-data watchdog
// fires, so the panel doesn't keep showing a stale/frozen reading (Baro
// setting, altitude digits, clock time) once the data feed behind it has
// gone quiet. Selects each mux channel first since all three share the
// same I2C bus through the TCA9548A.
void BlankAllOleds() {
  tcaselect(BARO_OLED_Port);
  u8g2_BARO.clearBuffer();
  u8g2_BARO.sendBuffer();

  tcaselect(ALT_OLED_Port);
  u8g2_ALT.clearBuffer();
  u8g2_ALT.sendBuffer();

  tcaselect(CLOCK_OLED_Port);
  u8g2_CLOCK.clearBuffer();
  u8g2_CLOCK.sendBuffer();

  tcaselect(TEMP_OLED_Port);
  u8g2_TEMP.clearBuffer();
  u8g2_TEMP.sendBuffer();
}

// No-data watchdog (see lastMSFSDataMillis/noDataTimeoutMs above) - drives
// every gauge on this board to its calibrated zero, the same target each
// gauge's own real-value setter would compute for a "CODE:0" packet
// (offset-aware for TS/RS). FuelLoadStepper/ElectricalLoadStepper now
// go through setFuelLoad(0)/setElectricalLoad(0) (FUEL_LOAD_PSI_TABLE's 0
// PSI row / ELECTRICAL_LOAD_PCT_TABLE's 0% row), same as every other
// calibrated gauge - note ELECTRICAL_LOAD_PCT_TABLE's 0% row is 22 steps,
// not the stepper's raw 0, so setElectricalLoad(0) lands there, not at
// .moveTo(0) like the old raw-only reset did.
// ALTstepper moves to its raw zero directly (not via onAltMslFtChange(),
// which would redraw the Altimeter OLED's digits to "0" - BlankAllOleds()
// below clears it instead). iLastAltitudeValue/iLastZuluTimeValue are
// reset to an impossible sentinel (-1) so that once real data resumes,
// the very next altitude/time update is guaranteed to redraw its OLED
// even if the resumed value happens to exactly match whatever was
// showing before the outage - otherwise onAltMslFtChange()'s/
// onZuluTimeChange()'s own change-gate would see "no change" and leave
// the display blank.
void ResetGaugesToZero() {
  // The backlight goes out too (applyBacklight() keeps it off while backlightNoData is set).
  backlightNoData = true;
  applyBacklight();
  setEGT(0);
  setEOT(0);
  setEOP(0);
  setXOT(0);
  setXOP(0);
  setTS(0);
  setRS(0);
  setFA(0);
  ALTstepper.moveTo(0);
  setFuelLoad(0);
  setElectricalLoad(0);
  if (!backlightStartupHold) BlankAllOleds();   // the OLEDs stay on until the start-up hold ends
  iLastAltitudeValue = -1;
  iLastZuluTimeValue = -1;
  sLastTempText = "";
}

// Listens for the Stepper controller's "STARTUPDONE" on UDP port 13138 and enforces the time-out of the start-up backlight hold.
void serviceStartupSync() {
  if (Ethernet_In_Use == 1 && startupSyncUdp.parsePacket() > 0) {
    char syncBuffer[24];
    int len = startupSyncUdp.read(syncBuffer, sizeof(syncBuffer) - 1);
    if (len < 0) len = 0;
    syncBuffer[len] = 0;
    if (strncmp(syncBuffer, "STARTUPDONE", 11) == 0) endBacklightStartupHold("start-up complete, announced by the Stepper controller");
  }
  if (backlightStartupHold && millis() >= STARTUP_BACKLIGHT_MAX_MS) endBacklightStartupHold("time-out");
}

void loop() {
  serviceStartupSync();

  if (millis() >= NEXT_STATUS_TOGGLE_TIMER) {
    RED_LED_STATE = !RED_LED_STATE;

    digitalWrite(Check_LED_G, RED_LED_STATE);
    digitalWrite(Check_LED_R, !RED_LED_STATE);
    NEXT_STATUS_TOGGLE_TIMER = millis() + FLASH_TIME;
  }

  //if (DCSBIOS_In_Use == 1) DcsBios::loop();
  updateSteppers();

  if (Ethernet_In_Use == 1) {
    if ((millis() - lastincomingpacketcheck) >= incomingcheckinterval) {
      MSFSpacketsize = MSFSudp.parsePacket();
      if (MSFSpacketsize > 0) {
        MSFSLen = MSFSudp.read(packetBuffer, 999);
        if (MSFSLen > 0) {
          packetBuffer[MSFSLen] = 0;
        }
        ProcessReceivedMSFSString();
        lastMSFSDataMillis = millis();
        gaugesResetForNoData = false;
        if (backlightNoData) {
          backlightNoData = false;
          applyBacklight();   // data is back: the backlight returns to the commanded (or default) level if the main bus is up
          SendDebug("Backlight restored - UDP data resumed");
        }
      }
      lastincomingpacketcheck = millis();
    }
  }

  if (!gaugesResetForNoData && (millis() - lastMSFSDataMillis) >= noDataTimeoutMs) {
    ResetGaugesToZero();
    gaugesResetForNoData = true;
    SendDebug(BoardName + " - no UDP data for " + String(noDataTimeoutMs / 1000) + "s, gauges reset to calibrated zero");
  }

  if ((millis() - lastalivesent) >= aliveinterval) {
    if (Ethernet_In_Use == 1) {
      aliveudp.beginPacket(reflectorIP, aliveport);
      aliveudp.print("DUAL_STEPPER");
      aliveudp.print(vccHeartbeatText());
      aliveudp.print(firmwareHeartbeatText());
      aliveudp.endPacket();
    }
    lastalivesent = millis();
  }

  currentMillis = millis();
}
