bnepethomas/bne-arduino-flight-simulator-interfaces/Hornet/Hornet Documentation/Fly Elise/4K 20230408 MSFS Separate Windows/MSFS 2020 Configuration Files/cameras.cfg

[VERSION]
major =1
minor =0

[VIEWS]
eyepoint = -3.95, -0.85, 1.9 ; (feet) longitudinal, lateral, vertical distance from reference datum

;===================== CAMERADEFINITION =====================

[CAMERADEFINITION.0]
Title ="Pilot"
Guid ="{195EAB58-9E4A-1E2A-A34C-A8D9D948F078}"
Description =""
Origin ="Virtual Cockpit"
MomentumEffect =1
SnapPbhAdjust ="Swivel"
SnapPbhReturn =0
PanPbhAdjust ="Swivel"
PanPbhReturn =0
Track ="None"
ShowAxis ="YES"
AllowZoom =1
;InitialZoom =0.57
InitialZoom =1.0
SmoothZoomTime =2
ZoomPanScalar =1
ShowWeather =1
XyzAdjust =1
ShowLensFlare =0
Category ="Cockpit"
SubCategory ="Pilot"
SubCategoryItem ="DefaultPilot"
PitchPanRate =20
HeadingPanRate =60
InitialXyz = 0.56, -0.08, 2.5
; These values are on reread on each flight either exit the Sim or 
InitialPbh = 5, 0, 0
;InitialPbh = -10, 0, 0
;InitialPbh = 10.8885, 0, -71.3708
;InitialPbh = 9.8967, 0, -66.0839
InitialZoom = 1.0
NodesToHide =""
ClipMode ="Normal"
BoundingBoxRadius =0.1
UITitle=""
TargetCategory="None"
CycleHidden=0
CycleHideRadius=0
ShowPanel=0
InstancedBased=0
NoSortTitle=0
Transition=0
PanAcceleratorTime=5
XYZRate=0.25
XYZAcceleratorTime=0

[CAMERADEFINITION.1]
Title ="ClosePilot"
Guid ="{0F13815E-479F-4320-A47C-1DC023DC6384}"
Description =""
Origin ="Virtual Cockpit"
MomentumEffect =1
SnapPbhAdjust ="Swivel"
SnapPbhReturn =0
PanPbhAdjust ="Swivel"
PanPbhReturn =0
Track ="None"
ShowAxis ="YES"
AllowZoom =1
InitialZoom =1
SmoothZoomTime =2
ZoomPanScalar =1
ShowWeather =1
XyzAdjust =1
ShowLensFlare =0
Category ="Cockpit"
SubCategory ="Pilot"
SubCategoryItem ="ClosePilot"
PitchPanRate =20
HeadingPanRate =60
InitialXyz = 0.55, -0.05, 3.1
InitialPbh = -5.5, 0, 0
NodesToHide =""
ClipMode ="Normal"
BoundingBoxRadius =0.1
UITitle=""
TargetCategory="None"
CycleHidden=0
CycleHideRadius=0
ShowPanel=0
InstancedBased=0
NoSortTitle=0
Transition=0
PanAcceleratorTime=5
XYZRate=0.25
XYZAcceleratorTime=0

[CAMERADEFINITION.2]
Title ="CoPilot"
Guid ="{28D56C4A-8B66-45EA-A233-F3829795DE89}"
Description =""
Origin ="Virtual Cockpit"
MomentumEffect =1
SnapPbhAdjust ="Swivel"
SnapPbhReturn =0
PanPbhAdjust ="Swivel"
PanPbhReturn =0
Track ="None"
ShowAxis ="YES"
AllowZoom =1
InitialZoom =0.57
SmoothZoomTime =2
ZoomPanScalar =1
ShowWeather =1
XyzAdjust =1
ShowLensFlare =0
Category ="Cockpit"
SubCategory ="Pilot"
SubCategoryItem ="CoPilot"
PitchPanRate =20
HeadingPanRate =60
InitialXyz = -0.048, -0.08, 2.5
InitialPbh = -5, 0, 0
NodesToHide =""
ClipMode ="Normal"
BoundingBoxRadius =0.1
UITitle=""
TargetCategory="None"
CycleHidden=0
CycleHideRadius=0
ShowPanel=0
InstancedBased=0
NoSortTitle=0
Transition=0
PanAcceleratorTime=5
XYZRate=0.25
XYZAcceleratorTime=0

[CAMERADEFINITION.3]
Title ="LandingPilot"
Guid ="{A03163C6-E2DF-4E59-BAC0-138CFC36BAC3}"
Description =""
Origin ="Virtual Cockpit"
MomentumEffect =1
SnapPbhAdjust ="Swivel"
SnapPbhReturn =0
PanPbhAdjust ="Swivel"
PanPbhReturn =0
Track ="None"
ShowAxis ="YES"
AllowZoom =1
InitialZoom =0.4
SmoothZoomTime =2
ZoomPanScalar =1
ShowWeather =1
XyzAdjust =1
ShowLensFlare =0
Category ="Cockpit"
SubCategory ="Pilot"
SubCategoryItem ="LandingPilot"
PitchPanRate =20
HeadingPanRate =60
InitialXyz = 1.5, 0, 0
InitialPbh = -15, 0, 0
NodesToHide =""
ClipMode ="Normal"
BoundingBoxRadius =0.1
UITitle=""
TargetCategory="None"
CycleHidden=0
CycleHideRadius=0
ShowPanel=0
InstancedBased=0
NoSortTitle=0
Transition=0
PanAcceleratorTime=5
XYZRate=0.25
XYZAcceleratorTime=0

[CAMERADEFINITION.4]
Title ="Main Panel"
Guid ="{AD83408E-4113-497B-A3D0-B19C94511CAA}"
Description =""
Origin ="Virtual Cockpit"
MomentumEffect =1
SnapPbhAdjust ="Swivel"
SnapPbhReturn =0
PanPbhAdjust ="Swivel"
PanPbhReturn =0
Track ="None"
ShowAxis ="YES"
AllowZoom =1
InitialZoom =0.25
SmoothZoomTime =2
ZoomPanScalar =1
ShowWeather =1
XyzAdjust =1
ShowLensFlare =0
Category ="Cockpit"
SubCategory ="Instrument"
SubCategoryItem ="None"
PitchPanRate =20
HeadingPanRate =60
InitialXyz = 0.3, -0.35, 2.6
InitialPbh = -12, 0, 0
NodesToHide ="yoke_pilot yoke_copilot yoke_pilot_cable Support_Yoke_Pilot yoke_coPilot_cable yoke_coPilot_support"
ClipMode ="Normal"
BoundingBoxRadius =0.1
UITitle=""
TargetCategory="None"
CycleHidden=0
CycleHideRadius=0
ShowPanel=0
InstancedBased=0
NoSortTitle=0
Transition=0
PanAcceleratorTime=5
XYZRate=0.25
XYZAcceleratorTime=0
VarToggle="yoke_pilot yoke_copilot yoke_pilot_cable Support_Yoke_Pilot yoke_coPilot_cable yoke_coPilot_support"

[CAMERADEFINITION.5]
Title ="Collective"
Guid ="{014D4F1D-35FD-4617-9CE8-8DD53A6B4407}"
Description =""
Origin ="Virtual Cockpit"
MomentumEffect =1
SnapPbhAdjust ="Swivel"
SnapPbhReturn =0
PanPbhAdjust ="Swivel"
PanPbhReturn =0
Track ="None"
ShowAxis ="YES"
AllowZoom =1
InitialZoom =0.45
SmoothZoomTime =2
ZoomPanScalar =1
ShowWeather =1
XyzAdjust =1
ShowLensFlare =0
Category ="Cockpit"
SubCategory ="Instrument"
SubCategoryItem ="None"
PitchPanRate =20
HeadingPanRate =60
InitialXyz = 0.3, -0.35, 2.6
InitialPbh = -65, 0, 0
NodesToHide ="yoke_pilot yoke_copilot yoke_pilot_cable Support_Yoke_Pilot yoke_coPilot_cable yoke_coPilot_support"
ClipMode ="Normal"
BoundingBoxRadius =0.1
UITitle=""
TargetCategory="None"
CycleHidden=0
CycleHideRadius=0
ShowPanel=0
InstancedBased=0
NoSortTitle=0
Transition=0
PanAcceleratorTime=5
XYZRate=0.25
XYZAcceleratorTime=0
VarToggle="yoke_pilot yoke_copilot yoke_pilot_cable Support_Yoke_Pilot yoke_coPilot_cable yoke_coPilot_support"

[CAMERADEFINITION.6]
Title ="Navigation"
Guid ="{803E2462-E795-4916-ABDC-7B23473026C9}"
Description =""
Origin ="Virtual Cockpit"
MomentumEffect =1
SnapPbhAdjust ="Swivel"
SnapPbhReturn =0
PanPbhAdjust ="Swivel"
PanPbhReturn =0
Track ="None"
ShowAxis ="YES"
AllowZoom =1
InitialZoom =0.25
SmoothZoomTime =2
ZoomPanScalar =1
ShowWeather =1
XyzAdjust =1
ShowLensFlare =0
Category ="Cockpit"
SubCategory ="Instrument"
SubCategoryItem ="None"
PitchPanRate =20
HeadingPanRate =60
InitialXyz = 0.25, -0.4, 2.9
InitialPbh = -55, 0, 0
NodesToHide ="yoke_pilot yoke_copilot yoke_pilot_cable Support_Yoke_Pilot yoke_coPilot_cable yoke_coPilot_support"
ClipMode ="Normal"
BoundingBoxRadius =0.1
UITitle=""
TargetCategory="None"
CycleHidden=0
CycleHideRadius=0
ShowPanel=0
InstancedBased=0
NoSortTitle=0
Transition=0
PanAcceleratorTime=5
XYZRate=0.25
XYZAcceleratorTime=0
VarToggle="yoke_pilot yoke_copilot yoke_pilot_cable Support_Yoke_Pilot yoke_coPilot_cable yoke_coPilot_support"

[CAMERADEFINITION.7]
Title ="Overhead"
Guid ="{C7FE7E21-203E-4799-8E53-7E67F363B7A6}"
Description =""
Origin ="Virtual Cockpit"
MomentumEffect =1
SnapPbhAdjust ="Swivel"
SnapPbhReturn =0
PanPbhAdjust ="Swivel"
PanPbhReturn =0
Track ="None"
ShowAxis ="YES"
AllowZoom =1
InitialZoom =0.55
SmoothZoomTime =2
ZoomPanScalar =1
ShowWeather =1
XyzAdjust =1
ShowLensFlare =0
Category ="Cockpit"
SubCategory ="Instrument"
SubCategoryItem ="None"
PitchPanRate =20
HeadingPanRate =60
InitialXyz = 0.2, -0.25, 2.6
InitialPbh = 65, 0, 0
NodesToHide ="yoke_pilot yoke_copilot yoke_pilot_cable Support_Yoke_Pilot yoke_coPilot_cable yoke_coPilot_support"
ClipMode ="Normal"
BoundingBoxRadius =0.1
UITitle=""
TargetCategory="None"
CycleHidden=0
CycleHideRadius=0
ShowPanel=0
InstancedBased=0
NoSortTitle=0
Transition=0
PanAcceleratorTime=5
XYZRate=0.25
XYZAcceleratorTime=0
VarToggle="yoke_pilot yoke_copilot yoke_pilot_cable Support_Yoke_Pilot yoke_coPilot_cable yoke_coPilot_support"

[CAMERADEFINITION.8]
Title ="Rotor Brake"
Guid ="{204CBA67-0A4B-2D3C-A34C-B7C0D148F099}"
Description =""
Origin ="Virtual Cockpit"
MomentumEffect =1
SnapPbhAdjust ="Swivel"
SnapPbhReturn =0
PanPbhAdjust ="Swivel"
PanPbhReturn =0
Track ="None"
ShowAxis ="YES"
AllowZoom =1
InitialZoom =0.57
SmoothZoomTime =2
ZoomPanScalar =1
ShowWeather =1
XyzAdjust =1
ShowLensFlare =0
Category ="Cockpit"
SubCategory ="Instrument"
SubCategoryItem ="None"
PitchPanRate =20
HeadingPanRate =60
InitialXyz = 0.56, -0.08, 2.5
InitialPbh = 20, 0, -90
NodesToHide =""
ClipMode ="Normal"
BoundingBoxRadius =0.1
UITitle=""
TargetCategory="None"
CycleHidden=0
CycleHideRadius=0
ShowPanel=0
InstancedBased=0
NoSortTitle=0
Transition=0
PanAcceleratorTime=5
XYZRate=0.25
XYZAcceleratorTime=0

[CAMERADEFINITION.9]
Title ="Cabin"
Guid ="{348E5CC3-3324-4E06-9DE8-81CF262560ED}"
Description =""
Origin ="Virtual Cockpit"
MomentumEffect =1
SnapPbhAdjust ="Swivel"
SnapPbhReturn =0
PanPbhAdjust ="Swivel"
PanPbhReturn =0
Track ="None"
ShowAxis ="YES"
AllowZoom =1
InitialZoom =0.35
SmoothZoomTime =2
ZoomPanScalar =1
ShowWeather =1
XyzAdjust =1
ShowLensFlare =0
Category ="Cockpit"
SubCategory ="Custom"
SubCategoryItem ="None"
PitchPanRate =20
HeadingPanRate =60
InitialXyz = 0, -0.4, 0
InitialPbh = -10, 0, 0
NodesToHide ="yoke_pilot yoke_copilot yoke_pilot_cable Support_Yoke_Pilot yoke_coPilot_cable yoke_coPilot_support"
ClipMode ="Normal"
BoundingBoxRadius =0.1
UITitle=""
TargetCategory="None"
CycleHidden=0
CycleHideRadius=0
ShowPanel=0
InstancedBased=0
NoSortTitle=0
Transition=0
PanAcceleratorTime=5
XYZRate=0.25
XYZAcceleratorTime=0
VarToggle="yoke_pilot yoke_copilot yoke_pilot_cable Support_Yoke_Pilot yoke_coPilot_cable yoke_coPilot_support"

[CAMERADEFINITION.10]
Title ="QuickView_L1"
Guid ="{FDE72267-EC98-428B-A352-4E3D2B8CED34}"
Description =""
Origin ="Virtual Cockpit"
MomentumEffect =1
SnapPbhAdjust ="Swivel"
SnapPbhReturn =0
PanPbhAdjust ="Swivel"
PanPbhReturn =0
Track ="None"
ShowAxis ="YES"
AllowZoom =1
InitialZoom =0.57
SmoothZoomTime =2
ZoomPanScalar =1
ShowWeather =1
XyzAdjust =1
ShowLensFlare =0
Category ="Cockpit"
SubCategory ="QuickView"
SubCategoryItem ="QuickView6"
PitchPanRate =20
HeadingPanRate =60
InitialXyz = 0.56, -0.08, 2.5
InitialPbh = -5, 0, -45
NodesToHide =""
ClipMode ="Normal"
BoundingBoxRadius =0.1
UITitle=""
TargetCategory="None"
CycleHidden=0
CycleHideRadius=0
ShowPanel=0
InstancedBased=0
NoSortTitle=0
Transition=0
PanAcceleratorTime=5
XYZRate=0.25
XYZAcceleratorTime=0

[CAMERADEFINITION.11]
Title ="QuickView_L2"
Guid ="{CC82D653-2EAF-4F7C-BADF-9909076EC157}"
Description =""
Origin ="Virtual Cockpit"
MomentumEffect =1
SnapPbhAdjust ="Swivel"
SnapPbhReturn =0
PanPbhAdjust ="Swivel"
PanPbhReturn =0
Track ="None"
ShowAxis ="YES"
AllowZoom =1
InitialZoom =0.57
SmoothZoomTime =2
ZoomPanScalar =1
ShowWeather =1
XyzAdjust =1
ShowLensFlare =0
Category ="Cockpit"
SubCategory ="QuickView"
SubCategoryItem ="QuickView4"
PitchPanRate =20
HeadingPanRate =60
InitialXyz = 0.56, -0.08, 2.5
InitialPbh = -10, 0, -85
NodesToHide =""
ClipMode ="Normal"
BoundingBoxRadius =0.1
UITitle=""
TargetCategory="None"
CycleHidden=0
CycleHideRadius=0
ShowPanel=0
InstancedBased=0
NoSortTitle=0
Transition=0
PanAcceleratorTime=5
XYZRate=0.25
XYZAcceleratorTime=0

[CAMERADEFINITION.12]
Title ="QuickView_L3"
Guid ="{D9F06692-3860-402A-B01F-4FC6CBA0E69A}"
Description =""
Origin ="Virtual Cockpit"
MomentumEffect =1
SnapPbhAdjust ="Swivel"
SnapPbhReturn =0
PanPbhAdjust ="Swivel"
PanPbhReturn =0
Track ="None"
ShowAxis ="YES"
AllowZoom =1
InitialZoom =0.57
SmoothZoomTime =2
ZoomPanScalar =1
ShowWeather =1
XyzAdjust =1
ShowLensFlare =0
Category ="Cockpit"
SubCategory ="QuickView"
SubCategoryItem ="QuickView5"
PitchPanRate =20
HeadingPanRate =60
InitialXyz = 0.56, -0.08, 2.5
InitialPbh = -12, 0, -132
NodesToHide =""
ClipMode ="Normal"
BoundingBoxRadius =0.1
UITitle=""
TargetCategory="None"
CycleHidden=0
CycleHideRadius=0
ShowPanel=0
InstancedBased=0
NoSortTitle=0
Transition=0
PanAcceleratorTime=5
XYZRate=0.25
XYZAcceleratorTime=0

[CAMERADEFINITION.13]
Title ="QuickView_R1"
Guid ="{390ABE2D-9F3F-4127-B994-D05C8725A34F}"
Description =""
Origin ="Virtual Cockpit"
MomentumEffect =1
SnapPbhAdjust ="Swivel"
SnapPbhReturn =0
PanPbhAdjust ="Swivel"
PanPbhReturn =0
Track ="None"
ShowAxis ="YES"
AllowZoom =1
InitialZoom =0.57
SmoothZoomTime =2
ZoomPanScalar =1
ShowWeather =1
XyzAdjust =1
ShowLensFlare =0
Category ="Cockpit"
SubCategory ="QuickView"
SubCategoryItem ="QuickView7"
PitchPanRate =20
HeadingPanRate =60
InitialXyz = 0.56, -0.08, 2.5
InitialPbh = -8, 0, 45
NodesToHide =""
ClipMode ="Normal"
BoundingBoxRadius =0.1
UITitle=""
TargetCategory="None"
CycleHidden=0
CycleHideRadius=0
ShowPanel=0
InstancedBased=0
NoSortTitle=0
Transition=0
PanAcceleratorTime=5
XYZRate=0.25
XYZAcceleratorTime=0

[CAMERADEFINITION.14]
Title ="QuickView_R2"
Guid ="{ACE31D9E-44F0-4A40-B1BC-648F71DDB348}"
Description =""
Origin ="Virtual Cockpit"
MomentumEffect =1
SnapPbhAdjust ="Swivel"
SnapPbhReturn =0
PanPbhAdjust ="Swivel"
PanPbhReturn =0
Track ="None"
ShowAxis ="YES"
AllowZoom =1
InitialZoom =0.57
SmoothZoomTime =2
ZoomPanScalar =1
ShowWeather =1
XyzAdjust =1
ShowLensFlare =0
Category ="Cockpit"
SubCategory ="QuickView"
SubCategoryItem ="QuickView3"
PitchPanRate =20
HeadingPanRate =60
InitialXyz = 0.56, -0.08, 2.5
InitialPbh = -12, 0, 100
NodesToHide =""
ClipMode ="Normal"
BoundingBoxRadius =0.1
UITitle=""
TargetCategory="None"
CycleHidden=0
CycleHideRadius=0
ShowPanel=0
InstancedBased=0
NoSortTitle=0
Transition=0
PanAcceleratorTime=5
XYZRate=0.25
XYZAcceleratorTime=0

[CAMERADEFINITION.15]
Title ="QuickView_R3"
Guid ="{885F9316-112F-4511-A813-C75C83142DFB}"
Description =""
Origin ="Virtual Cockpit"
MomentumEffect =1
SnapPbhAdjust ="Swivel"
SnapPbhReturn =0
PanPbhAdjust ="Swivel"
PanPbhReturn =0
Track ="None"
ShowAxis ="YES"
AllowZoom =1
InitialZoom =0.57
SmoothZoomTime =2
ZoomPanScalar =1
ShowWeather =1
XyzAdjust =1
ShowLensFlare =0
Category ="Cockpit"
SubCategory ="QuickView"
SubCategoryItem ="QuickView8"
PitchPanRate =20
HeadingPanRate =60
InitialXyz = 0.56, -0.08, 2.5
InitialPbh = -12, 0, 120
NodesToHide =""
ClipMode ="Normal"
BoundingBoxRadius =0.1
UITitle=""
TargetCategory="None"
CycleHidden=0
CycleHideRadius=0
ShowPanel=0
InstancedBased=0
NoSortTitle=0
Transition=0
PanAcceleratorTime=5
XYZRate=0.25
XYZAcceleratorTime=0

[CAMERADEFINITION.16]
Title ="QuickView_Back"
Guid ="{4CE951F8-4B1D-4658-AAE6-E4E4725E367B}"
Description =""
Origin ="Virtual Cockpit"
MomentumEffect =1
SnapPbhAdjust ="Swivel"
SnapPbhReturn =0
PanPbhAdjust ="Swivel"
PanPbhReturn =0
Track ="None"
ShowAxis ="YES"
AllowZoom =1
InitialZoom =0.57
SmoothZoomTime =2
ZoomPanScalar =1
ShowWeather =1
XyzAdjust =1
ShowLensFlare =0
Category ="Cockpit"
SubCategory ="QuickView"
SubCategoryItem ="QuickView2"
PitchPanRate =20
HeadingPanRate =60
InitialXyz = 0.56, -0.08, 2.5
InitialPbh = -12, 0, 170
NodesToHide =""
ClipMode ="Normal"
BoundingBoxRadius =0.1
UITitle=""
TargetCategory="None"
CycleHidden=0
CycleHideRadius=0
ShowPanel=0
InstancedBased=0
NoSortTitle=0
Transition=0
PanAcceleratorTime=5
XYZRate=0.25
XYZAcceleratorTime=0

[CAMERADEFINITION.17]
Title ="QuickView_Down"
Guid ="{B985D76B-314B-46CA-8512-F5478AE986CE}"
Description =""
Origin ="Virtual Cockpit"
MomentumEffect =1
SnapPbhAdjust ="Swivel"
SnapPbhReturn =0
PanPbhAdjust ="Swivel"
PanPbhReturn =0
Track ="None"
ShowAxis ="YES"
AllowZoom =1
InitialZoom =0.4
SmoothZoomTime =2
ZoomPanScalar =1
ShowWeather =1
XyzAdjust =1
ShowLensFlare =0
Category ="Cockpit"
SubCategory ="QuickView"
SubCategoryItem ="QuickView1"
PitchPanRate =20
HeadingPanRate =60
InitialXyz = 0.56, -0.08, 2.5
InitialPbh = -20, 0, 0
NodesToHide =""
ClipMode ="Normal"
BoundingBoxRadius =0.1
UITitle=""
TargetCategory="None"
CycleHidden=0
CycleHideRadius=0
ShowPanel=0
InstancedBased=0
NoSortTitle=0
Transition=0
PanAcceleratorTime=5
XYZRate=0.25
XYZAcceleratorTime=0

[CAMERADEFINITION.18]
Title ="FixedOnPlane_Tail"
Guid ="{8A6AA746-50B1-43BD-A51C-31A9FBBFCB94}"
Description =""
Origin ="Center"
MomentumEffect =1
SnapPbhAdjust ="Swivel"
SnapPbhReturn =0
PanPbhAdjust ="Swivel"
PanPbhReturn =0
Track ="None"
ShowAxis ="NO"
AllowZoom =1
InitialZoom =1.3
SmoothZoomTime =2
ZoomPanScalar =1
ShowWeather =1
XyzAdjust =1
ShowLensFlare =0
Category ="FixedOnPlane"
SubCategory ="FixedOnPlaneExtern"
SubCategoryItem ="None"
PitchPanRate =20
HeadingPanRate =60
InitialXyz = 0, 2.5, -5
InitialPbh = -20.0, 0, 0
NodesToHide =""
ClipMode ="Normal"
BoundingBoxRadius =0.1
UITitle=""
TargetCategory="None"
CycleHidden=0
CycleHideRadius=0
ShowPanel=0
InstancedBased=0
NoSortTitle=0
Transition=0
PanAcceleratorTime=5
XYZRate=0.25
XYZAcceleratorTime=0

[CAMERADEFINITION.19]
Title ="FixedOnPlane_LeftLookRight"
Guid ="{31DBC75E-3E7F-4BFD-A7B9-3275BCB4648F}"
Description =""
Origin ="Center"
MomentumEffect =1
SnapPbhAdjust ="Swivel"
SnapPbhReturn =0
PanPbhAdjust ="Swivel"
PanPbhReturn =0
Track ="None"
ShowAxis ="NO"
AllowZoom =1
InitialZoom =1.3
SmoothZoomTime =2
ZoomPanScalar =1
ShowWeather =1
XyzAdjust =1
ShowLensFlare =0
Category ="FixedOnPlane"
SubCategory ="FixedOnPlaneExtern"
SubCategoryItem ="None"
PitchPanRate =20
HeadingPanRate =60
InitialXyz = -5.159829, 0.535157, 1.5
InitialPbh = -16, 0, 85
NodesToHide =""
ClipMode ="Normal"
BoundingBoxRadius =0.1
UITitle=""
TargetCategory="None"
CycleHidden=0
CycleHideRadius=0
ShowPanel=0
InstancedBased=0
NoSortTitle=0
Transition=0
PanAcceleratorTime=5
XYZRate=0.25
XYZAcceleratorTime=0

[CAMERADEFINITION.20]
Title ="FixedOnPlane_RightLookLeft"
Guid ="{6EBE5596-01F1-4D20-88B8-493F651CDD83}"
Description =""
Origin ="Center"
MomentumEffect =1
SnapPbhAdjust ="Swivel"
SnapPbhReturn =0
PanPbhAdjust ="Swivel"
PanPbhReturn =0
Track ="None"
ShowAxis ="NO"
AllowZoom =1
InitialZoom =1.3
SmoothZoomTime =2
ZoomPanScalar =1
ShowWeather =1
XyzAdjust =1
ShowLensFlare =0
Category ="FixedOnPlane"
SubCategory ="FixedOnPlaneExtern"
SubCategoryItem ="None"
PitchPanRate =20
HeadingPanRate =60
InitialXyz = 5.159829, 0.535157, 1.5
InitialPbh = -9, 0, -83
NodesToHide =""
ClipMode ="Normal"
BoundingBoxRadius =0.1
UITitle=""
TargetCategory="None"
CycleHidden=0
CycleHideRadius=0
ShowPanel=0
InstancedBased=0
NoSortTitle=0
Transition=0
PanAcceleratorTime=5
XYZRate=0.25
XYZAcceleratorTime=0

[CAMERADEFINITION.21]
Title ="FixedOnPlane_Belly"
Guid ="{A961A61A-9CF7-49D3-9A4F-C1E240D121F8}"
Description =""
Origin ="Center"
MomentumEffect =1
SnapPbhAdjust ="Swivel"
SnapPbhReturn =0
PanPbhAdjust ="Swivel"
PanPbhReturn =0
Track ="None"
ShowAxis ="NO"
AllowZoom =1
InitialZoom =1.3
SmoothZoomTime =2
ZoomPanScalar =1
ShowWeather =1
XyzAdjust =1
ShowLensFlare =0
Category ="FixedOnPlane"
SubCategory ="FixedOnPlaneExtern"
SubCategoryItem ="None"
PitchPanRate =20
HeadingPanRate =60
InitialXyz = 0, -0.75, 1.5
InitialPbh = -15, 0, 0
NodesToHide =""
ClipMode ="Normal"
BoundingBoxRadius =0.1
UITitle=""
TargetCategory="None"
CycleHidden=0
CycleHideRadius=0
ShowPanel=0
InstancedBased=0
NoSortTitle=0
Transition=0
PanAcceleratorTime=5
XYZRate=0.25
XYZAcceleratorTime=0

[CAMERADEFINITION.22]
Title ="FixedOnPlane_LeftLookFwd"
Guid ="{AC8A97F6-9983-4BDE-8D39-FD05A3382299}"
Description =""
Origin ="Center"
MomentumEffect =1
SnapPbhAdjust ="Swivel"
SnapPbhReturn =0
PanPbhAdjust ="Swivel"
PanPbhReturn =0
Track ="None"
ShowAxis ="NO"
AllowZoom =1
InitialZoom =1.3
SmoothZoomTime =2
ZoomPanScalar =1
ShowWeather =1
XyzAdjust =1
ShowLensFlare =0
Category ="FixedOnPlane"
SubCategory ="FixedOnPlaneExtern"
SubCategoryItem ="None"
PitchPanRate =20
HeadingPanRate =60
InitialXyz = -0.632238, 1.287984, -4.571049
InitialPbh = -22.379181, -0.196855, 2.553999
NodesToHide =""
ClipMode ="Normal"
BoundingBoxRadius =0.1
UITitle=""
TargetCategory="None"
CycleHidden=0
CycleHideRadius=0
ShowPanel=0
InstancedBased=0
NoSortTitle=0
Transition=0
PanAcceleratorTime=5
XYZRate=0.25
XYZAcceleratorTime=0

[CAMERADEFINITION.23]
Title ="FixedOnPlane_RighTopLookFwd"
Guid ="{5E87E050-5C1C-48D8-8845-58BD8B147B0C}"
Description =""
Origin ="Center"
MomentumEffect =1
SnapPbhAdjust ="Swivel"
SnapPbhReturn =0
PanPbhAdjust ="Swivel"
PanPbhReturn =0
Track ="None"
ShowAxis ="NO"
AllowZoom =1
InitialZoom =1.3
SmoothZoomTime =2
ZoomPanScalar =1
ShowWeather =1
XyzAdjust =1
ShowLensFlare =0
Category ="FixedOnPlane"
SubCategory ="FixedOnPlaneExtern"
SubCategoryItem ="None"
PitchPanRate =20
HeadingPanRate =60
InitialXyz = 0.767099, 1.047202, -1.06521
InitialPbh = -32.515362, -3.57211, 36.081718
NodesToHide =""
ClipMode ="Normal"
BoundingBoxRadius =0.1
UITitle=""
TargetCategory="None"
CycleHidden=0
CycleHideRadius=0
ShowPanel=0
InstancedBased=0
NoSortTitle=0
Transition=0
PanAcceleratorTime=5
XYZRate=0.25
XYZAcceleratorTime=0

[CAMERADEFINITION.24]
Title ="FixedOnPlane_TailRotor"
Guid ="{ADAFC28F-097B-48C7-88FC-16D63301E93E}"
Description =""
Origin ="Center"
MomentumEffect =1
SnapPbhAdjust ="Swivel"
SnapPbhReturn =0
PanPbhAdjust ="Swivel"
PanPbhReturn =0
Track ="None"
ShowAxis ="NO"
AllowZoom =1
InitialZoom =1.3
SmoothZoomTime =2
ZoomPanScalar =1
ShowWeather =1
XyzAdjust =1
ShowLensFlare =0
Category ="FixedOnPlane"
SubCategory ="FixedOnPlaneExtern"
SubCategoryItem ="None"
PitchPanRate =20
HeadingPanRate =60
InitialXyz = -1.161352, 0.911314, -1.563577
InitialPbh = 165.988464, -178.049332, 21.393108
NodesToHide =""
ClipMode ="Normal"
BoundingBoxRadius =0.1
UITitle=""
TargetCategory="None"
CycleHidden=0
CycleHideRadius=0
ShowPanel=0
InstancedBased=0
NoSortTitle=0
Transition=0
PanAcceleratorTime=5
XYZRate=0.25
XYZAcceleratorTime=0

[CAMERADEFINITION.25]
Title ="FixedOnPlane_Tail"
Guid ="{C66154AC-2A16-41C2-8799-AB8A42DE14E2}"
Description =""
Origin ="Center"
MomentumEffect =1
SnapPbhAdjust ="Swivel"
SnapPbhReturn =0
PanPbhAdjust ="Swivel"
PanPbhReturn =0
Track ="None"
ShowAxis ="NO"
AllowZoom =1
InitialZoom =1.3
SmoothZoomTime =2
ZoomPanScalar =1
ShowWeather =1
XyzAdjust =1
ShowLensFlare =0
Category ="FixedOnPlane"
SubCategory ="FixedOnPlaneExtern"
SubCategoryItem ="None"
PitchPanRate =20
HeadingPanRate =60
InitialXyz = 4, 0.733668, -5.502
InitialPbh = 0.0, 0.0, -90
NodesToHide =""
ClipMode ="Normal"
BoundingBoxRadius =0.1
UITitle=""
TargetCategory="None"
CycleHidden=0
CycleHideRadius=0
ShowPanel=0
InstancedBased=0
NoSortTitle=0
Transition=0
PanAcceleratorTime=5
XYZRate=0.25
XYZAcceleratorTime=0

[CAMERADEFINITION.26]
Title ="FixedOnPlane_LandingGear"
Guid ="{CDA54C3E-2390-4A0C-B033-8C8D33B5C3DC}"
Description =""
Origin ="Center"
MomentumEffect =1
SnapPbhAdjust ="Swivel"
SnapPbhReturn =0
PanPbhAdjust ="Swivel"
PanPbhReturn =0
Track ="None"
ShowAxis ="NO"
AllowZoom =1
InitialZoom =1.3
SmoothZoomTime =2
ZoomPanScalar =1
ShowWeather =1
XyzAdjust =1
ShowLensFlare =0
Category ="FixedOnPlane"
SubCategory ="FixedOnPlaneExtern"
SubCategoryItem ="None"
PitchPanRate =20
HeadingPanRate =60
InitialXyz = -0.410155, -0.8, -1
InitialPbh = -8.164645, 0.0, -10
NodesToHide =""
ClipMode ="Normal"
BoundingBoxRadius =0.1
UITitle=""
TargetCategory="None"
CycleHidden=0
CycleHideRadius=0
ShowPanel=0
InstancedBased=0
NoSortTitle=0
Transition=0
PanAcceleratorTime=5
XYZRate=0.25
XYZAcceleratorTime=0

[CAMERADEFINITION.27]
Title ="FixedOnPlane_RightLookFwd"
Guid ="{26EB5E66-C93B-42D9-B7EA-584CF6CC5A68}"
Description =""
Origin ="Center"
MomentumEffect =1
SnapPbhAdjust ="Swivel"
SnapPbhReturn =0
PanPbhAdjust ="Swivel"
PanPbhReturn =0
Track ="None"
ShowAxis ="NO"
AllowZoom =1
InitialZoom =1.3
SmoothZoomTime =2
ZoomPanScalar =1
ShowWeather =1
XyzAdjust =1
ShowLensFlare =0
Category ="FixedOnPlane"
SubCategory ="FixedOnPlaneExtern"
SubCategoryItem ="None"
PitchPanRate =20
HeadingPanRate =60
InitialXyz = 2.0, 0.2, 0.0
InitialPbh = -13.1, 2.0, -15.0
NodesToHide =""
ClipMode ="Normal"
BoundingBoxRadius =0.1
UITitle=""
TargetCategory="None"
CycleHidden=0
CycleHideRadius=0
ShowPanel=0
InstancedBased=0
NoSortTitle=0
Transition=0
PanAcceleratorTime=5
XYZRate=0.25
XYZAcceleratorTime=0

[CAMERADEFINITION.28]
Title ="Yokes"
Guid ="{10824015-6949-4444-85D6-061C3BA1DEC2}"
Description =""
Origin ="Virtual Cockpit"
MomentumEffect =1
SnapPbhAdjust ="Swivel"
SnapPbhReturn =0
PanPbhAdjust ="Swivel"
PanPbhReturn =0
Track ="None"
ShowAxis ="YES"
AllowZoom =1
InitialZoom =0.57
SmoothZoomTime =2
ZoomPanScalar =1
ShowWeather =1
XyzAdjust =1
ShowLensFlare =0
Category ="Aircraft"
SubCategory ="None"
SubCategoryItem ="None"
PitchPanRate =20
HeadingPanRate =60
InitialXyz = 0.05, 0.22, 0.05
InitialPbh = -30.879999, -0.568, 13.85
NodesToHide =""
ClipMode ="Normal"
BoundingBoxRadius =0.1
UITitle=""
TargetCategory="None"
CycleHidden=0
CycleHideRadius=0
ShowPanel=0
InstancedBased=0
NoSortTitle=0
Transition=0
PanAcceleratorTime=5
XYZRate=0.25
XYZAcceleratorTime=0

[CAMERADEFINITION.29]
Title ="New Camera"
Guid ="{7B13A074-BAF3-4F85-A311-AB1C02BEC913}"
Description =""
Origin ="Virtual Cockpit"
MomentumEffect =0
SnapPbhAdjust ="Swivel"
SnapPbhReturn =1
PanPbhAdjust ="Swivel"
PanPbhReturn =0
Track ="None"
ShowAxis ="NO"
AllowZoom =1
InitialZoom =1
SmoothZoomTime =5
ZoomPanScalar =0
ShowWeather =1
XyzAdjust =1
ShowLensFlare =0
Category ="Cockpit"
SubCategory ="None"
SubCategoryItem ="None"
PitchPanRate =10
HeadingPanRate =30
InitialXyz = 0, 0, 0
InitialPbh = 0, 0, 0
NodesToHide =""
ClipMode ="Normal"
BoundingBoxRadius =0.1

UITitle=""
TargetCategory="None"
CycleHidden=0
CycleHideRadius=0
ShowPanel=0
InstancedBased=0
NoSortTitle=0
Transition=0
PanAcceleratorTime=5
XYZRate=0.25
XYZAcceleratorTime=0
