bnepethomas/bne-arduino-flight-simulator-interfaces/DevPlayArea/stepper1.py

#!/usr/bin/python
# Import required libraries
import sys
import time
import RPi.GPIO as GPIO
 
# Use BCM GPIO references
# instead of physical pin numbers
GPIO.setmode(GPIO.BCM)
 
# Define GPIO signals to use
# Physical pins 11,15,16,18
# GPIO17,GPIO22,GPIO23,GPIO24
StepPins = [17,22,23,24]
# Using different pins as 23 and 24 used by sPI interface in SSD1306 project
StepPins = [17,22,27,18]
 
# Set all pins as output
for pin in StepPins:
  print "Setup pins"
  GPIO.setup(pin,GPIO.OUT)
  GPIO.output(pin, False)
 
# Define advanced sequence
# as shown in manufacturers datasheet
Seq = [[1,0,0,1],
       [0,0,0,1],
       [0,1,1,1],
       [0,1,1,0],
       [1,1,1,0],
       [1,0,0,1],
       [1,0,0,0]]
        
StepCount = len(Seq)
StepDir = 1 # Set to 1 or 2 for clockwise
            # Set to -1 or -2 for anti-clockwise
 

WaitTime = 3/float(1000)
print("Wait time for return is " + str(WaitTime))
# Return to zero
StepDir = -1 # Set to 1 or 2 for clockwise
            # Set to -1 or -2 for anti-clockwise
# Initialise variables
StepCounter = 0
 
# Start return loop
print "Returning to 0"
for x in range(0, 1800):
  
  #print StepCounter,
  #print Seq[StepCounter]
 
  for pin in range(0,4):
    xpin=StepPins[pin]# Get GPIO
    if Seq[StepCounter][pin]!=0:
      #print " Enable GPIO %i" %(xpin)
      GPIO.output(xpin, True)
    else:
      GPIO.output(xpin, False)
 
  StepCounter += StepDir
 
  # If we reach the end of the sequence
  # start again
  if (StepCounter>=StepCount):
    StepCounter = 0
  if (StepCounter<0):
    StepCounter = StepCount+StepDir
 
  # Wait before moving on
  time.sleep(WaitTime)




WaitTime = 2.4/float(1000)
# 2.0, 2.2,2.3 unstable
# 2.5 stable
print("Wait time for main cycle is " + str(WaitTime))
for z in range(1,5):
  print z
  StepDir = 1 # Set to 1 or 2 for clockwise
            # Set to -1 or -2 for anti-clockwise
  # Initialise variables
  StepCounter = 0
   
  # Start main loop
  for x in range(0, 900):
   
    #print StepCounter,
    #print Seq[StepCounter]
   
    for pin in range(0,4):
      xpin=StepPins[pin]# Get GPIO
      if Seq[StepCounter][pin]!=0:
        #print " Enable GPIO %i" %(xpin)
        GPIO.output(xpin, True)
      else:
        GPIO.output(xpin, False)
   
    StepCounter += StepDir
   
    # If we reach the end of the sequence
    # start again
    if (StepCounter>=StepCount):
      StepCounter = 0
    if (StepCounter<0):
      StepCounter = StepCount+StepDir
   
    # Wait before moving on
    time.sleep(WaitTime)


  StepDir = -1 # Set to 1 or 2 for clockwise
              # Set to -1 or -2 for anti-clockwise
  # Initialise variables
  StepCounter = 0
   
  # Start return loop
  for x in range(0, 900):
    
    #print StepCounter,
    #print Seq[StepCounter]
   
    for pin in range(0,4):
      xpin=StepPins[pin]# Get GPIO
      if Seq[StepCounter][pin]!=0:
        #print " Enable GPIO %i" %(xpin)
        GPIO.output(xpin, True)
      else:
        GPIO.output(xpin, False)
   
    StepCounter += StepDir
   
    # If we reach the end of the sequence
    # start again
    if (StepCounter>=StepCount):
      StepCounter = 0
    if (StepCounter<0):
      StepCounter = StepCount+StepDir
   
    # Wait before moving on
    time.sleep(WaitTime)



for pin in range(0,4):
  xpin=StepPins[pin]# Get GPIO 
  GPIO.output(xpin, False)
