bnepethomas/bne-arduino-flight-simulator-interfaces/Hornet/Hornet DCS BIOS Sketches/Active/LIP_CONTROLLER/LIP_CONTROLLER.ino

////////////////////---||||||||||********||||||||||---\\\\\\\\\\\\\\\\\\\\
//||               FUNCTION = HORNET LOWER INSTRUMENT PANEL           ||\\
//||              LOCATION IN THE PIT = LIP.                          ||\\
//||            ARDUINO PROCESSOR TYPE = Arduino Mega 2560            ||\\
//||      ARDUINO CHIP SERIAL NUMBER = SN - 75834353230351013181      ||\\
//||                    CONNECTED COM PORT = COM 9                    ||\\
//||               ****ADD ASSIGNED COM PORT NUMBER****               ||\\
//||            ****DO CHECK S/N BEFORE UPLOAD NEW DATA****           ||\\
////////////////////---||||||||||********||||||||||---\\\\\\\\\\\\\\\\\\\\

/*
TO DO 
Add latching code for CTR, LI, LO, RI, RO
/*
*/
/*

  This Superceedes udp_input_controller
  Split from udp_input_controller_2 20200802

  Heavily based on
  https://github.com/calltherain/ArduinoUSBJoystick

  Interface for DCS BIOS

  Mega2560 R3,
  digital Pin 22~37 used as rows. 0-15, 16 Rows
  digital pin 38~48 used as columns. 0-10, 11 Columns

  20250518 For interim Controller v2 
  Digital Pins 22~34 as rows, 0-12
  Digital Pins 35~45 as columns, 0-10

  it's a 16 * 11  matrix, due to the loss of pins/Columns used by the Ethernet and SD Card Shield, Digital I/O 50 through 53 are not available.
  Pin 49 is available but isn't used. This gives a total number of usable Inputs as 176 (remember numbering starts at 0 - so 0-175)

  The code pulls down a row and reads values from the Columns.
  Row 0 - Col 0 = Digit 0
  Row 0 - Col 10 = Digit 10
  Row 15 - Col 0 = Digit 165
  Row 15 = Col 10 = Digit 175

  So - Digit = Row * 11 + Col

*/



int Ethernet_In_Use = 1;  // Check to see if jumper is present - if it is disable Ethernet calls. Used for Testing
int Reflector_In_Use = 1;
#define DCSBIOS_In_Use 1
#define MSFS_In_Use 0  // Used to interface into MSFS - set to 0 if not in use

// Used to Distinguish between the left, front, and right inputs
// Left=0, Front=1, Right=2
#define INPUT_MODULE_NUMBER 2

#define DCSBIOS_IRQ_SERIAL
#include <DcsBios.h>

#define SYNCH_BACKLIGHT_AT_START 1
#define STARTUP_BACKLIGHT_END 90000  //Keep Backlight on until all panels have completed testing
#define BACKLIGHT_END_LEVEL 32000        // Percentage Backlight Level at end of startup



// ********************************* Begin Ethernet ***************************************************
// Ethernet Related
#include <SPI.h>
#include <Ethernet.h>
#include <EthernetUdp.h>

#define EthernetStartupDelay 500
#define ES1_RESET_PIN 53

const unsigned long delayBeforeSendingPacket = 3000;
unsigned long ethernetStartTime = 0;
String BoardName = "Hornet LIP CONTROLLER: ";



// These local Mac and IP Address will be reassigned early in startup based on
// the device ID as set by address pins
byte mac[] = { 0xA8, 0x61, 0x0A, 0x9E, 0x83, 0x73 };
String sMac = "A8:61:0A:67:83:115";
IPAddress ip(172, 16, 1, 115);
String strMyIP = "172.16.1.115";

// Reflector
IPAddress reflectorIP(172, 16, 1, 10);
String strReflectorIP = "X.X.X.X";

// Arduino Due for Keystroke translation and Pixel Led driving
IPAddress targetIP(172, 16, 1, 110);
String strTargetIP = "X.X.X.X";

// Computer Running MSFS
IPAddress MSFSIP(172, 16, 1, 10);
String strMSFSIP = "X.X.X.X";

const unsigned int localport = 7788;
const unsigned int localdebugport = 7795;
const unsigned int keyboardport = 7788;
const unsigned int ledport = 7789;
const unsigned int remoteport = 7790;
const unsigned int reflectorport = 27000;
const unsigned int MSFSport = 7791;

int packetSize;
int debugLen;
EthernetUDP udp;
EthernetUDP debugUDP;
char packetBuffer[1000];     //buffer to store the incoming data
char outpacketBuffer[1000];  //buffer to store the outgoing data

const unsigned int aliveport = 13137;
EthernetUDP aliveudp;    // Sends keepalives to monitoring application
const unsigned long aliveinterval = 10000;
long lastalivesent = 0;

void SendDebug(String MessageToSend) {
  MessageToSend = BoardName + MessageToSend;
  if ((Reflector_In_Use == 1) && (Ethernet_In_Use == 1)) {
    udp.beginPacket(reflectorIP, reflectorport);
    udp.print(MessageToSend);
    udp.endPacket();
  }
}

// ********************************* End Ethernet ***************************************************


// ********************************* Begin Digital ***************************************************



// ********************************* End Digital ***************************************************

#define NUM_BUTTONS 256
#define BUTTONS_USED_ON_PCB 176
#define NUM_AXES 8  // 8 axes, X, Y, Z, etc
#define GREEN_STATUS_LED_PORT 14
#define RED_STATUS_LED_PORT 15  // RED LED is used for monitoring ethernet
#define FLASH_TIME 300

unsigned long NEXT_STATUS_TOGGLE_TIMER = 0;
bool RED_LED_STATE = false;
bool GREEN_LED_STATE = true;
unsigned long timeSinceRedLedChanged = 0;
//
struct joyReport_t {
  int button[NUM_BUTTONS];  // 1 Button per byte - was originally one bit per byte - but we have plenty of storage space
};



// Go through the man loop a number of times before sending data to the Sim
// This allows analog averages to be established and the DigitalButton array to be populated
// This has to more than simply the number of elements in the array as the array values are initialised
// to 0, so it actually takes more than 30 interations before the average it fully established
// Could enhance using weighted average
int LoopsBeforeSendingAllowed = 40;
bool SendingAllowed = false;


// Matrix reliability settings. Keep the original 80 us settle time used by this controller.
const byte MATRIX_ROWS = 16;
const byte MATRIX_COLS = 11;  // Actual usable columns only: pins 38-48.
const unsigned int ROW_SETTLE_US = 80;
const unsigned long MOMENTARY_STABLE_MS = 20;  // AMPCD, IFEI and Select Jett push buttons.
const unsigned long TOGGLE_STABLE_MS = 50;     // Maintained switches/toggles.
const bool SEND_INITIAL_STATES = false;        // Learn physical startup state; do not command DCS at boot.
const bool RESEND_CONFIRMED_TOGGLE_STATE = true;
const unsigned long TOGGLE_RESEND_MS = 100;

joyReport_t joyReport;
joyReport_t prevjoyReport;

unsigned long joyEndDebounce[NUM_BUTTONS];  // Retained for diagnostics/compatibility.
int candidateButton[NUM_BUTTONS];
unsigned long candidateChangedAt[NUM_BUTTONS];
bool resendPending[NUM_BUTTONS];
int resendState[NUM_BUTTONS];
unsigned long resendDueAt[NUM_BUTTONS];

// Suppresses only the duplicate debug line created by the DCS-only toggle resend.
// Normal IP/debug behaviour remains unchanged.
bool suppressMatrixResendDebug = false;

long prevLEDTransition = millis();
int cButtonID[16];
bool bFirstTime = true;


unsigned long currentMillis = 0;
unsigned long previousMillis = 0;





// Note Pin 4 and Pin 10 cannot be used for other purposes.
//Arduino communicates with both the W5500 and SD card using the SPI bus (through the ICSP header).
//This is on digital pins 10, 11, 12, and 13 on the Uno and pins 50, 51, and 52 on the Mega.
//On both boards, pin 10 is used to select the W5500 and pin 4 for the SD card. These pins cannot be used for general I/O.
//On the Mega, the hardware SS pin, 53, is not used to select either the W5500 or the SD card,
//but it must be kept as an output or the SPI interface won't work.


char stringind[5];
String outString;

// ################################### BEGIN STEPPERS ##################################

#include <Stepper.h>
#include <AccelStepper.h>
#define STEPS 720  // steps per revolution (limited to 315°)

#define STEPPER_MAX_SPEED 8300
#define STEPPER_ACCELERATION 2000

#define COILCA1 A12  // CA = CAB ALT
#define COILCA2 A13
#define COILCA3 A14
#define COILCA4 A15

int CAB_ALT;
int valCA = 0;
int CurCABALT = 0;
int posCA = 0;
AccelStepper stepperCA(AccelStepper::FULL4WIRE, COILCA1, COILCA2, COILCA3, COILCA4);  // CAB ALT
#define CabinAltMaxPoint 600

void onPressureAltChange(unsigned int newValueCA) {
  stepperCA.moveTo(map(newValueCA, 0, 65535, 0, CabinAltMaxPoint));
}
DcsBios::IntegerBuffer pressureAltBuffer(0x7514, 0xffff, 0, onPressureAltChange);


// ################################### END STEPPERS ##################################

// ################################### BEGIN LIGHTING ##################################

#define MAP_LIGHTS 2
#define BACKLIGHT_RWR_PWM 3
#define BACKLIGHT_CAB_ALT_PWM 4
#define BACKLIGHT_IEFI_PANEL_PWM 5
#define BACKLIGHT_IEFI_BUTTONS_PWM 6
#define BACKLIGHT_AMPCD_PWM 7
#define BACKLIGHT_AMPCD_BUT_PWM 8
#define BACKLIGHT_COMPASS_PWM 9
#define BACKLIGHT_ECM_JET_PWM 12




void turnOffAllBacklights() {
  digitalWrite(MAP_LIGHTS, LOW);
  digitalWrite(BACKLIGHT_RWR_PWM, LOW);
  digitalWrite(BACKLIGHT_CAB_ALT_PWM, LOW);
  digitalWrite(BACKLIGHT_IEFI_PANEL_PWM, LOW);
  digitalWrite(BACKLIGHT_IEFI_BUTTONS_PWM, LOW);
  digitalWrite(BACKLIGHT_AMPCD_PWM, LOW);
  digitalWrite(BACKLIGHT_AMPCD_BUT_PWM, LOW);
  digitalWrite(BACKLIGHT_COMPASS_PWM, LOW);
  digitalWrite(BACKLIGHT_ECM_JET_PWM, LOW);
}

void turnOnAllBacklights() {
  digitalWrite(MAP_LIGHTS, HIGH);
  digitalWrite(BACKLIGHT_RWR_PWM, HIGH);
  digitalWrite(BACKLIGHT_CAB_ALT_PWM, HIGH);
  digitalWrite(BACKLIGHT_IEFI_PANEL_PWM, HIGH);
  digitalWrite(BACKLIGHT_IEFI_BUTTONS_PWM, HIGH);
  digitalWrite(BACKLIGHT_AMPCD_PWM, HIGH);
  digitalWrite(BACKLIGHT_AMPCD_BUT_PWM, HIGH);
  digitalWrite(BACKLIGHT_COMPASS_PWM, HIGH);
  digitalWrite(BACKLIGHT_ECM_JET_PWM, HIGH);
}




void onConsoleIntLtChange(unsigned int newValue) {
  SendDebug("Console Lights : " + String(newValue));
  analogWrite(BACKLIGHT_RWR_PWM, map(newValue, 0, 65535, 0, 255));
  analogWrite(BACKLIGHT_CAB_ALT_PWM, map(newValue, 0, 65535, 0, 255));
  analogWrite(BACKLIGHT_IEFI_PANEL_PWM, map(newValue, 0, 65535, 0, 255));
  analogWrite(BACKLIGHT_IEFI_BUTTONS_PWM, map(newValue, 0, 65535, 0, 255));
  analogWrite(BACKLIGHT_AMPCD_PWM, map(newValue, 0, 65535, 0, 255));
  analogWrite(BACKLIGHT_AMPCD_BUT_PWM, map(newValue, 0, 65535, 0, 255));
  analogWrite(BACKLIGHT_COMPASS_PWM, map(newValue, 0, 65535, 0, 255)); 
  analogWrite(BACKLIGHT_ECM_JET_PWM, map(newValue, 0, 65535, 0, 255));
}
DcsBios::IntegerBuffer consoleIntLtBuffer(0x7558, 0xffff, 0, onConsoleIntLtChange);

void setConsoleLights(unsigned int newValue) {
  SendDebug("Console Lights : " + String(newValue));
  analogWrite(BACKLIGHT_RWR_PWM, map(newValue, 0, 65535, 0, 255));
  analogWrite(BACKLIGHT_CAB_ALT_PWM, map(newValue, 0, 65535, 0, 255));
  analogWrite(BACKLIGHT_IEFI_PANEL_PWM, map(newValue, 0, 65535, 0, 255));
  analogWrite(BACKLIGHT_IEFI_BUTTONS_PWM, map(newValue, 0, 65535, 0, 255));
  analogWrite(BACKLIGHT_AMPCD_PWM, map(newValue, 0, 65535, 0, 255));
  analogWrite(BACKLIGHT_AMPCD_BUT_PWM, map(newValue, 0, 65535, 0, 255));
  analogWrite(BACKLIGHT_COMPASS_PWM, map(newValue, 0, 65535, 0, 255)); 
  analogWrite(BACKLIGHT_ECM_JET_PWM, map(newValue, 0, 65535, 0, 255));
}

// ################################### END LIGHTING ##################################


// ######################## BEGIN MAX7219 ########################
#include "LedControl.h"
LedControl lc = LedControl(A11, A10, A9, 3);

void allMax7219On() {
  for (int displayunit = 0; displayunit < 3; displayunit++) {
    for (int row = 0; row < 8; row++) {
      for (int col = 0; col < 8; col++) {
        if (col != 9 && col != 9 && col != 9)
          lc.setLed(displayunit, row, col, true);
        SendDebug(String(displayunit) + ":" + String(row) + ":" + String(col));
      }
    }
  }
}

void debugAllMax7219On() {
  for (int displayunit = 0; displayunit < 3; displayunit++) {
    for (int row = 0; row < 8; row++) {
      for (int col = 0; col < 8; col++) {
        if (col != 9 && col != 9 && col != 9)
          SendDebug("LED " + String(row) + ":" + String(col));
        lc.setLed(displayunit, row, col, true);
        delay(3000);
        lc.setLed(displayunit, row, col, false);
      }
    }
  }
}

// Half 0:6
// Left 0:7

void allMax7219Off() {
  for (int displayunit = 0; displayunit < 3; displayunit++) {
    for (int row = 0; row < 8; row++) {
      for (int col = 0; col < 8; col++) {
        if (col != 9 && col != 9 && col != 9)
          lc.setLed(displayunit, row, col, false);
      }
    }
  }
}

// ######################## BEGIN RWR ########################

// Note Pots are currently inversed
DcsBios::PotentiometerEWMA<5, 512, 10> rwrDmrCtrl("RWR_DMR_CTRL", A1, 1023, 0);
DcsBios::PotentiometerEWMA<5, 512, 10> rwrAudioCtrl("RWR_AUDIO_CTRL", A0, 1023, 0);

//DcsBios::Potentiometer rwrDmrCtrl("RWR_DMR_CTRL", A0);
//DcsBios::Potentiometer rwrAudioCtrl("RWR_AUDIO_CTRL", A1);
//DcsBios::PotentiometerEWMA<5, 128, 5> suitTemp("SUIT_TEMP", 9);    //"YYY" = DCS_BIOS INPUT NAME and X = PIN


bool RWR_POWER_BUTTON_STATE = false;  // Used to latch the RWR Power Switch
void onRwrPowerBtnChange(unsigned int newValue) {
  if (newValue == 1) {
    RWR_POWER_BUTTON_STATE = true;
  } else {
    RWR_POWER_BUTTON_STATE = false;
  }
}
DcsBios::IntegerBuffer rwrPowerBtnBuffer(0x7488, 0x1000, 12, onRwrPowerBtnChange);

void setAllRWRLed(bool newValue) {
  setRWRPwrLed(newValue);
  setRWRLimitLed(newValue);
  setRWRDisplayLed(newValue);
  setRWRSpecialEnableLed(newValue);
  setRWRSpecialLed(newValue);
  setRWROffsetEnableLed(newValue);
  setRWROffsetLed(newValue);
  setRWRFailLed(newValue);
  setRWRTestLed(newValue);
}

void setRWRPwrLed(bool newValue) {
  lc.setLed(0, 0, 1, newValue);
}

void onRwrLowerLtChange(unsigned int newValue) {
  if (newValue == 1)
    setRWRPwrLed(true);
  else
    setRWRPwrLed(false);
}
DcsBios::IntegerBuffer rwrLowerLtBuffer(FA_18C_hornet_RWR_LOWER_LT, onRwrLowerLtChange);

void setRWRLimitLed(bool newValue) {
  lc.setLed(0, 0, 2, newValue);
}

void onRwrLimitLtChange(unsigned int newValue) {
  if (newValue == 1)
    setRWRLimitLed(true);
  else
    setRWRLimitLed(false);
}
DcsBios::IntegerBuffer rwrLimitLtBuffer(FA_18C_hornet_RWR_LIMIT_LT, onRwrLimitLtChange);

void setRWRDisplayLed(bool newValue) {
  lc.setLed(0, 0, 3, newValue);
}

void onRwrDisplayLtChange(unsigned int newValue) {
  if (newValue == 1)
    setRWRDisplayLed(true);
  else
    setRWRDisplayLed(false);
}
DcsBios::IntegerBuffer rwrDisplayLtBuffer(FA_18C_hornet_RWR_DISPLAY_LT, onRwrDisplayLtChange);

void setRWRSpecialEnableLed(bool newValue) {
  lc.setLed(0, 1, 1, newValue);
}

void onRwrSpecialEnLtChange(unsigned int newValue) {
  if (newValue == 1)
    setRWRSpecialEnableLed(true);
  else
    setRWRSpecialEnableLed(false);
}
DcsBios::IntegerBuffer rwrSpecialEnLtBuffer(FA_18C_hornet_RWR_SPECIAL_EN_LT, onRwrSpecialEnLtChange);

void setRWRSpecialLed(bool newValue) {
  lc.setLed(0, 1, 2, newValue);
}
void onRwrSpecialLtChange(unsigned int newValue) {
  if (newValue == 1)
    setRWRSpecialLed(true);
  else
    setRWRSpecialLed(false);
}
DcsBios::IntegerBuffer rwrSpecialLtBuffer(FA_18C_hornet_RWR_SPECIAL_LT, onRwrSpecialLtChange);

void setRWROffsetEnableLed(bool newValue) {
  lc.setLed(0, 1, 3, newValue);
}
void onRwrEnableLtChange(unsigned int newValue) {
  if (newValue == 1)
    setRWROffsetEnableLed(true);
  else
    setRWROffsetEnableLed(false);
}
DcsBios::IntegerBuffer rwrEnableLtBuffer(FA_18C_hornet_RWR_ENABLE_LT, onRwrEnableLtChange);

void setRWROffsetLed(bool newValue) {
  lc.setLed(0, 2, 1, newValue);
}
void onRwrOffsetLtChange(unsigned int newValue) {
  if (newValue == 1)
    setRWROffsetLed(true);
  else
    setRWROffsetLed(false);
}
DcsBios::IntegerBuffer rwrOffsetLtBuffer(FA_18C_hornet_RWR_OFFSET_LT, onRwrOffsetLtChange);

void setRWRFailLed(bool newValue) {
  lc.setLed(0, 2, 2, newValue);
}
void onRwrFailLtChange(unsigned int newValue) {
  if (newValue == 1)
    setRWRFailLed(true);
  else
    setRWRFailLed(false);
}
DcsBios::IntegerBuffer rwrFailLtBuffer(FA_18C_hornet_RWR_FAIL_LT, onRwrFailLtChange);


void setRWRTestLed(bool newValue) {
  lc.setLed(0, 2, 3, newValue);
}
void onRwrBitLtChange(unsigned int newValue) {
  if (newValue == 1)
    setRWRTestLed(true);
  else
    setRWRTestLed(false);
}
DcsBios::IntegerBuffer rwrBitLtBuffer(FA_18C_hornet_RWR_BIT_LT, onRwrBitLtChange);


// ######################## END RWR ########################


// ######################## BEGIN IFEI ########################
DcsBios::PotentiometerEWMA<5, 512, 10> ifei("IFEI", A3);

// ######################## END IFEI ########################


// ######################## BEGIN AMPCD ########################

DcsBios::PotentiometerEWMA<5, 512, 10> ampcdBrtCtl("AMPCD_BRT_CTL", 2);

// ######################## END AMPCD ########################

// ######################## END ECM ########################
#define ECM_SEL_LED 13

void setSelJetLed(bool newValue) {
  digitalWrite(ECM_SEL_LED, newValue);
}

void onCmsdJetSelLChange(unsigned int newValue) {
  if (newValue == 1) {
    setSelJetLed(true);
  } else {
    setSelJetLed(false);
  }
}
DcsBios::IntegerBuffer cmsdJetSelLBuffer(FA_18C_hornet_CMSD_JET_SEL_L, onCmsdJetSelLChange);
// ######################## END ECM ########################

// ######################## END SEL JET ########################


void setSelJetCTR(bool newValue) {
  lc.setLed(0, 4, 4, newValue);  // CTR
}
void onSjCtrLtChange(unsigned int newValue) {
  setSelJetCTR(newValue);
}
DcsBios::IntegerBuffer sjCtrLtBuffer(FA_18C_hornet_SJ_CTR_LT, onSjCtrLtChange);


void setSelJetLI(bool newValue) {
  lc.setLed(0, 5, 4, newValue);  // LI
}
void onSjLiLtChange(unsigned int newValue) {
  setSelJetLI(newValue);
}
DcsBios::IntegerBuffer sjLiLtBuffer(FA_18C_hornet_SJ_LI_LT, onSjLiLtChange);


void setSelJetRI(bool newValue) {
  lc.setLed(0, 6, 4, newValue);  // RI
}
void onSjRiLtChange(unsigned int newValue) {
  setSelJetRI(newValue);
}
DcsBios::IntegerBuffer sjRiLtBuffer(FA_18C_hornet_SJ_RI_LT, onSjRiLtChange);


void setSelJetLO(bool newValue) {
  lc.setLed(0, 4, 5, newValue);  // LO
}
void onSjLoLtChange(unsigned int newValue) {
  setSelJetLO(newValue);
}
DcsBios::IntegerBuffer sjLoLtBuffer(FA_18C_hornet_SJ_LO_LT, onSjLoLtChange);


void setSelJetRO(bool newValue) {
  lc.setLed(0, 5, 5, newValue);  // RO
}
void onSjRoLtChange(unsigned int newValue) {
  setSelJetRO(newValue);
}
DcsBios::IntegerBuffer sjRoLtBuffer(FA_18C_hornet_SJ_RO_LT, onSjRoLtChange);


void setNoseGear(bool newValue) {
  lc.setLed(0, 2, 7, newValue);  // Nose Gear - left
  lc.setLed(0, 1, 7, newValue);  // Nose Gear - right
}
void onFlpLgNoseGearLtChange(unsigned int newValue) {
  setNoseGear(newValue);
}
DcsBios::IntegerBuffer flpLgNoseGearLtBuffer(FA_18C_hornet_FLP_LG_NOSE_GEAR_LT, onFlpLgNoseGearLtChange);


void setLeftGear(bool newValue) {
  lc.setLed(0, 1, 6, newValue);  // Left Gear - left
  lc.setLed(0, 0, 6, newValue);  // Left Gear - right
}
void onFlpLgLeftGearLtChange(unsigned int newValue) {
  setLeftGear(newValue);
}
DcsBios::IntegerBuffer flpLgLeftGearLtBuffer(FA_18C_hornet_FLP_LG_LEFT_GEAR_LT, onFlpLgLeftGearLtChange);


void setRightGear(bool newValue) {
  lc.setLed(0, 2, 6, newValue);  // Right Gear - right
  lc.setLed(0, 3, 6, newValue);  // Right Gear - left
}
void onFlpLgRightGearLtChange(unsigned int newValue) {
  setRightGear(newValue);
}
DcsBios::IntegerBuffer flpLgRightGearLtBuffer(FA_18C_hornet_FLP_LG_RIGHT_GEAR_LT, onFlpLgRightGearLtChange);


void setFlapsHalf(bool newValue) {
  lc.setLed(0, 1, 5, newValue);  // Flaps Half - left
  lc.setLed(0, 0, 5, newValue);  // Flaps Half - right
}
void onFlpLgHalfFlapsLtChange(unsigned int newValue) {
  setFlapsHalf(newValue);
}
DcsBios::IntegerBuffer flpLgHalfFlapsLtBuffer(FA_18C_hornet_FLP_LG_HALF_FLAPS_LT, onFlpLgHalfFlapsLtChange);


void setFlapsFull(bool newValue) {
  lc.setLed(0, 1, 4, newValue);  // Flaps Full - right
  lc.setLed(0, 2, 4, newValue);  // Flaps Full - left
}
void onFlpLgFullFlapsLtChange(unsigned int newValue) {
  setFlapsFull(newValue);
}
DcsBios::IntegerBuffer flpLgFullFlapsLtBuffer(FA_18C_hornet_FLP_LG_FULL_FLAPS_LT, onFlpLgFullFlapsLtChange);


void setFlapsWarn(bool newValue) {
  lc.setLed(0, 3, 5, newValue);  // Flaps Warning - left
  lc.setLed(0, 2, 5, newValue);  // Flaps Warning - right
}
void onFlpLgFlapsLtChange(unsigned int newValue) {
  setFlapsWarn(newValue);
}
DcsBios::IntegerBuffer flpLgFlapsLtBuffer(FA_18C_hornet_FLP_LG_FLAPS_LT, onFlpLgFlapsLtChange);

// ######################## END SEL JET ########################

// ######################## SETUP ########################


void setup() {

  pinMode(GREEN_STATUS_LED_PORT, OUTPUT);
  pinMode(RED_STATUS_LED_PORT, OUTPUT);
  digitalWrite(GREEN_STATUS_LED_PORT, true);
  digitalWrite(RED_STATUS_LED_PORT, true);
  delay(FLASH_TIME);
  digitalWrite(GREEN_STATUS_LED_PORT, false);

  if (Ethernet_In_Use == 1) {

    // Using manual reset instead of tying to Arduino Reset
    pinMode(ES1_RESET_PIN, OUTPUT);
    digitalWrite(ES1_RESET_PIN, LOW);
    delay(2);
    digitalWrite(ES1_RESET_PIN, HIGH);

    Ethernet.begin(mac, ip);
    udp.begin(localport);

    ethernetStartTime = millis() + delayBeforeSendingPacket;
    while (millis() <= ethernetStartTime) {
      delay(FLASH_TIME);
      digitalWrite(GREEN_STATUS_LED_PORT, false);
      delay(FLASH_TIME);
      digitalWrite(GREEN_STATUS_LED_PORT, true);
    }


    SendDebug("Ethernet Started " + strMyIP + " " + sMac);

    aliveudp.begin(aliveport);
  }

  pinMode(MAP_LIGHTS, OUTPUT);
  pinMode(BACKLIGHT_RWR_PWM, OUTPUT);
  pinMode(BACKLIGHT_CAB_ALT_PWM, OUTPUT);
  pinMode(BACKLIGHT_IEFI_PANEL_PWM, OUTPUT);
  pinMode(BACKLIGHT_IEFI_BUTTONS_PWM, OUTPUT);
  pinMode(BACKLIGHT_AMPCD_PWM, OUTPUT);
  pinMode(BACKLIGHT_AMPCD_BUT_PWM, OUTPUT);
  pinMode(BACKLIGHT_COMPASS_PWM, OUTPUT);
  pinMode(BACKLIGHT_ECM_JET_PWM, OUTPUT);



  pinMode(ECM_SEL_LED, OUTPUT);

  turnOnAllBacklights();




  /*The MAX72XX is in power-saving mode on startup*/
  lc.shutdown(0, false);
  lc.shutdown(1, false);
  lc.shutdown(2, false);
  /* Set the brightness to a medium values */
  lc.setIntensity(0, 15);
  lc.setIntensity(1, 15);
  lc.setIntensity(2, 15);
  /* and clear the display */
  lc.clearDisplay(0);
  lc.clearDisplay(1);
  lc.clearDisplay(2);

  setAllRWRLed(true);
  setSelJetLed(true);
  setSelJetCTR(true);
  setSelJetLI(true);
  setSelJetRI(true);
  setSelJetLO(true);
  setSelJetRO(true);
  setNoseGear(true);
  setLeftGear(true);
  setRightGear(true);
  setFlapsHalf(true);
  setFlapsFull(true);
  setFlapsWarn(true);


  // Set the output ports to output
  for (int portId = 22; portId < 38; portId++) {
    pinMode(portId, OUTPUT);
  }
  // Set the input ports to input - port 50-53 used by Ethernet Shield
  // port 49 is used as rest pin on LIP Controller
  for (int portId = 38; portId < 50; portId++) {
    // Even though we've already got 10K external pullups
    pinMode(portId, INPUT_PULLUP);
  }





  // Initialise all arrays
  for (int ind = 0; ind < NUM_BUTTONS; ind++) {

    // Clear current and last values to 0 for button inputs
    joyReport.button[ind] = 0;
    prevjoyReport.button[ind] = 0;

    // Set the end
    joyEndDebounce[ind] = 0;
    candidateButton[ind] = 0;
    candidateChangedAt[ind] = millis();
    resendPending[ind] = false;
    resendState[ind] = 0;
    resendDueAt[ind] = 0;
  }


  /// CABIN ALT WORKING ======> SET CABIN ALT STEPPER TO 0 FEET
  SendDebug("Start Cycling Cabin Altimeter Stepper");
  stepperCA.setMaxSpeed(1000);
  stepperCA.setAcceleration(400);
  stepperCA.runToNewPosition(-720);
  stepperCA.setCurrentPosition(0);
  stepperCA.runToNewPosition(CabinAltMaxPoint);
  stepperCA.runToNewPosition(0);
  SendDebug("End Cycling Cabin Altimeter Stepper");
  /// CABIN ALT WORKING ======< SET CABIN ALT STEPPER TO 0 FEET



  SendDebug("Pausing until Synch is complete");


  if (SYNCH_BACKLIGHT_AT_START == 1) {
    while (millis() <= STARTUP_BACKLIGHT_END) {

    }
  }
  for (int i = 65000; i >= BACKLIGHT_END_LEVEL; i--) {
    setConsoleLights(i);
    // SendDebug("PWM Level :" + String(i));
    delay(20);
  }




  setAllRWRLed(false);
  setSelJetLed(false);
  setSelJetCTR(false);
  setSelJetLI(false);
  setSelJetRI(false);
  setSelJetLO(false);
  setSelJetRO(false);
  setNoseGear(false);
  setLeftGear(false);
  setRightGear(false);
  setFlapsHalf(false);
  setFlapsFull(false);
  setFlapsWarn(false);


  // Set Console lights to a mid level for start of game
  setConsoleLights(16000);



  if (DCSBIOS_In_Use == 1) DcsBios::setup();




  SendDebug("Setup Complete");
}


bool IsMomentaryInput(int ind) {
  switch (ind) {
    // Select Jett: retain the existing press/release mapping and latching behaviour.
    case 17:  // SJ_CTR
    case 28:  // SJ_LI
    case 39:  // SJ_RI
    case 50:  // SJ_RO
    case 61:  // SJ_LO

    // AMPCD push buttons PB 01-20.
    case 77:
    case 78:
    case 79:
    case 80:
    case 88:
    case 89:
    case 90:
    case 91:
    case 99:
    case 100:
    case 101:
    case 102:
    case 110:
    case 111:
    case 112:
    case 113:
    case 121:
    case 122:
    case 123:
    case 124:

    // IFEI push buttons.
    case 143:  // IFEI_MODE_BTN
    case 144:  // IFEI_DWN_BTN
    case 154:  // IFEI_QTY_BTN
    case 155:  // IFEI_ZONE_BTN
    case 165:  // IFEI_UP_BTN
    case 166:  // IFEI_ET_BTN
      return true;

    default:
      return false;
  }
}

void FindInputChanges() {
  unsigned long now = millis();

  // First completed matrix scan: learn every physical state without sending a
  // startup burst of DCS, MSFS, IP or debug messages.
  if (bFirstTime) {
    for (int ind = 0; ind < BUTTONS_USED_ON_PCB; ind++) {
      prevjoyReport.button[ind] = joyReport.button[ind];
      candidateButton[ind] = joyReport.button[ind];
      candidateChangedAt[ind] = now;
      resendPending[ind] = false;

      if (SEND_INITIAL_STATES) {
        if (DCSBIOS_In_Use == 1) CreateDcsBiosMessage(ind, joyReport.button[ind]);
        if (MSFS_In_Use == 1) SendMSFSMessage(ind, joyReport.button[ind]);
        SendDebug(String(ind) + ":" + String(joyReport.button[ind]));
      }
    }
    bFirstTime = false;
    return;
  }

  for (int ind = 0; ind < BUTTONS_USED_ON_PCB; ind++) {
    bool isMomentary = IsMomentaryInput(ind);
    unsigned long requiredStableMs = isMomentary ? MOMENTARY_STABLE_MS : TOGGLE_STABLE_MS;

    // A raw change only starts/restarts the stability timer.
    if (joyReport.button[ind] != candidateButton[ind]) {
      candidateButton[ind] = joyReport.button[ind];
      candidateChangedAt[ind] = now;
      resendPending[ind] = false;
      continue;
    }

    // Send only after the input has remained in the same new state long enough.
    if (candidateButton[ind] != prevjoyReport.button[ind] &&
        (now - candidateChangedAt[ind]) >= requiredStableMs) {
      int confirmedState = candidateButton[ind];
      prevjoyReport.button[ind] = confirmedState;
      joyEndDebounce[ind] = now + requiredStableMs;

      if (DCSBIOS_In_Use == 1) CreateDcsBiosMessage(ind, confirmedState);
      if (MSFS_In_Use == 1) SendMSFSMessage(ind, confirmedState);
      SendDebug(String(ind) + ":" + String(confirmedState));

      // Resend confirmed maintained-switch states once. Momentary push buttons,
      // including Select Jett, never get a resend.
      if (!isMomentary && RESEND_CONFIRMED_TOGGLE_STATE && DCSBIOS_In_Use == 1) {
        resendPending[ind] = true;
        resendState[ind] = confirmedState;
        resendDueAt[ind] = now + TOGGLE_RESEND_MS;
      }
    }

    // DCS-only resend: intentionally no MSFS/IP/debug duplicate packet/message.
    if (!isMomentary && resendPending[ind] &&
        now >= resendDueAt[ind] &&
        prevjoyReport.button[ind] == resendState[ind]) {
      suppressMatrixResendDebug = true;
      CreateDcsBiosMessage(ind, resendState[ind]);
      suppressMatrixResendDebug = false;
      resendPending[ind] = false;
    }
  }
}


void SendMSFSMessage(int ind, int state) {

  String outString;
  outString = "D" + String(INPUT_MODULE_NUMBER) + "," + String(ind) + ":" + String(state);

  udp.beginPacket(MSFSIP, MSFSport);
  udp.print(outString);
  udp.endPacket();


  //  udp.beginPacket(targetIP, remoteport);
  //  udp.print(outString);
  //  udp.endPacket();
}


void SendIPString(String KeysToSend) {
  // Used to Send Desired Keystrokes to Due acting as Keyboard

  // Begin While testing controller v2 disabled sending character
  return;
  // End While testing controller v2 disabled sending character

  if (Ethernet_In_Use == 1) {
    udp.beginPacket(targetIP, keyboardport);
    udp.print(KeysToSend);
    udp.endPacket();
  }
}


void SendLedString(String LedCommandToSend) {

  if (Ethernet_In_Use == 1) {
    udp.beginPacket(targetIP, ledport);
    udp.print(LedCommandToSend);
    udp.endPacket();
  }
}


void sendToDcsBiosMessage(const char *msg, const char *arg) {

  // Keep existing debug for every normal command. The one protected matrix resend
  // is deliberately DCS-only so it does not create duplicate debug/IP traffic.
  if (!suppressMatrixResendDebug) {
    SendDebug(String(msg) + ":" + String(arg));
  }

  sendDcsBiosMessage(msg, arg);
}


void CreateDcsBiosMessage(int ind, int state) {

  // sendToDcsBiosMessage("R_GEN_SW", "1");
  // SendIPString("LWIN F1");
  switch (state) {

    // RELEASE
    case 0:
      switch (ind) {

        case 0:
          break;
          // PRESS - OPEN
        case 1:
          break;
        case 2:
          break;
        case 3:
          break;
        case 4:
          break;
        case 5:
          break;
          // PRESS - OPEN
        case 6:
          break;
        case 7:
          break;
        case 8:
          break;
        case 9:
          sendToDcsBiosMessage("LEFT_DDI_CRS_SW", "1");
          break;
        case 10:
          sendToDcsBiosMessage("LEFT_DDI_HDG_SW", "1");
          break;
          // PRESS - OPEN
        case 11:
          break;
        case 12:
          break;
        case 13:
          break;
        case 14:
          break;
        case 15:
          break;
          // PRESS - OPEN
        case 16:
          break;
        case 17:
          sendToDcsBiosMessage("SJ_CTR", "0");
          break;
        case 18:
          break;
        case 19:
          break;
        case 20:
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
        case 146:
          sendToDcsBiosMessage("MODE_SELECTOR_SW", "2");
          break;
        case 147:
          sendToDcsBiosMessage("RWR_SPECIAL_BTN", "1");
          break;
        case 148:
          sendToDcsBiosMessage("RWR_DIS_TYPE_SW", "2");
          break;
        case 149:
          break;
        case 150:
          break;
          // PRESS - CLOSE
        case 151:
          break;
        case 152:
          break;
        case 153:
          break;
        case 154:
          sendToDcsBiosMessage("IFEI_QTY_BTN", "1");
          break;
        case 155:
          sendToDcsBiosMessage("IFEI_ZONE_BTN", "1");
          break;
          // PRESS - CLOSE
        case 156:
          sendToDcsBiosMessage("SELECT_HMD_LDDI_RDDI", "0");
          break;
        case 157:
          sendToDcsBiosMessage("MODE_SELECTOR_SW", "0");
          break;
        case 158:
          sendToDcsBiosMessage("RWR_OFFSET_BTN", "1");
          break;
        case 159:
          sendToDcsBiosMessage("RWR_DIS_TYPE_SW", "1");
          break;
        case 160:
          break;
          // PRESS - CLOSE
        case 161:
          break;
        case 162:
          break;
        case 163:
          break;
        case 164:
          break;
        case 165:
          sendToDcsBiosMessage("IFEI_UP_BTN", "1");
          break;
          // PRESS - CLOSE
        case 166:
          sendToDcsBiosMessage("IFEI_ET_BTN", "1");
          break;
        case 167:
          break;
        case 168:
          break;
        case 169:
          sendToDcsBiosMessage("RWR_BIT_BTN", "1");
          break;
        case 170:
          sendToDcsBiosMessage("RWR_DIS_TYPE_SW", "0");
          break;
          // PRESS - CLOSE
        case 171:
          break;
        case 172:
          break;
        case 173:
          break;
        case 174:
          break;
        case 175:
          break;
          // PRESS - CLOSE
        case 176:
          break;
        case 177:
          break;
        case 178:
          break;
        case 179:
          break;

        default:
          // PRESS - CLOSE
          break;
          break;
      }
  }
}



void loop() {


  if (millis() >= NEXT_STATUS_TOGGLE_TIMER) {

    GREEN_LED_STATE = !GREEN_LED_STATE;
    RED_LED_STATE = !GREEN_LED_STATE;

    digitalWrite(GREEN_STATUS_LED_PORT, GREEN_LED_STATE);
    digitalWrite(RED_STATUS_LED_PORT, RED_LED_STATE);


    NEXT_STATUS_TOGGLE_TIMER = millis() + FLASH_TIME;
  }

  if (Ethernet_In_Use == 1) {
    if ((millis() - lastalivesent) >= aliveinterval) {
      if (Ethernet_In_Use == 1) {
        aliveudp.beginPacket(reflectorIP, aliveport);
        aliveudp.print(BoardName);
        aliveudp.endPacket();
      }
      lastalivesent = millis();
    }
  }
  
  if (DCSBIOS_In_Use == 1) DcsBios::loop();

  // Matrix scan: 16 rows x 11 actual columns.
  // Explicitly release both row banks before selecting the next row.
  for (int rowid = 0; rowid < MATRIX_ROWS; rowid++) {
    PORTA = 0xFF;
    PORTC = 0xFF;

    if (rowid < 8) {
      PORTA = ~(0x1 << rowid);
    } else {
      PORTC = ~(0x1 << (15 - rowid));
    }

    delayMicroseconds(ROW_SETTLE_US);

    int colResult[MATRIX_COLS];
    // pin 38, PD7
    colResult[0] = (PIND & B10000000) == 0 ? 0 : 1;
    // pin 39, PG2
    colResult[1] = (PING & B00000100) == 0 ? 0 : 1;
    // pin 40, PG1
    colResult[2] = (PING & B00000010) == 0 ? 0 : 1;
    // pin 41, PG0
    colResult[3] = (PING & B00000001) == 0 ? 0 : 1;
    // pin 42, PL7
    colResult[4] = (PINL & B10000000) == 0 ? 0 : 1;
    // pin 43, PL6
    colResult[5] = (PINL & B01000000) == 0 ? 0 : 1;
    // pin 44, PL5
    colResult[6] = (PINL & B00100000) == 0 ? 0 : 1;
    // pin 45, PL4
    colResult[7] = (PINL & B00010000) == 0 ? 0 : 1;
    // pin 46, PL3
    colResult[8] = (PINL & B00001000) == 0 ? 0 : 1;
    // pin 47, PL2
    colResult[9] = (PINL & B00000100) == 0 ? 0 : 1;
    // pin 48, PL1
    colResult[10] = (PINL & B00000010) == 0 ? 0 : 1;

    for (int colid = 0; colid < MATRIX_COLS; colid++) {
      joyReport.button[(rowid * MATRIX_COLS) + colid] = (colResult[colid] == 0) ? 1 : 0;
    }
  }

  PORTA = 0xFF;
  PORTC = 0xFF;


  FindInputChanges();


  stepperCA.run();

  currentMillis = millis();
}


void CaseTemplate(int ind, int state) {

  // sendToDcsBiosMessage("R_GEN_SW", "1");
  // SendIPString("LWIN F1");
  switch (state) {

    // RELEASE
    case 0:
      switch (ind) {

        case 0:
          break;
          // PRESS - OPEN
        case 1:
          break;
        case 2:
          break;
        case 3:
          break;
        case 4:
          break;
        case 5:
          break;
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
        case 175:
          break;
          // PRESS - CLOSE
        case 176:
          break;
        case 177:
          break;
        case 178:
          break;
        case 179:
          break;

        default:
          // PRESS - CLOSE
          break;
          break;
      }
  }
}
