bnepethomas/bne-arduino-flight-simulator-interfaces/Jet Ranger/Jet Ranger Monitor Layout/Jet Ranger Monitor Layout.cfg

[Monitor0]
Name=\\.\DISPLAY1
MonitorID=MONITOR\WSX4843\{4d36e96e-e325-11ce-bfc1-08002be10318}\0011
SerialNumber=
BitsPerPixel=32
Width=1920
Height=1080
DisplayFlags=0
DisplayFrequency=60
DisplayOrientation=0
PositionX=1920
PositionY=0
[Monitor1]
Name=\\.\DISPLAY2
MonitorID=MONITOR\HEC0029\{4d36e96e-e325-11ce-bfc1-08002be10318}\0013
SerialNumber=
BitsPerPixel=32
Width=1920
Height=1080
DisplayFlags=0
DisplayFrequency=60
DisplayOrientation=0
PositionX=0
PositionY=0
[Monitor2]
Name=\\.\DISPLAY3
MonitorID=MONITOR\WSX4843\{4d36e96e-e325-11ce-bfc1-08002be10318}\0008
SerialNumber=
BitsPerPixel=32
Width=1920
Height=1080
DisplayFlags=0
DisplayFrequency=60
DisplayOrientation=0
PositionX=-1920
PositionY=0
[Monitor3]
Name=\\.\DISPLAY4
MonitorID=MONITOR\ACR0FA2\{4d36e96e-e325-11ce-bfc1-08002be10318}\0014
SerialNumber=5529052574239
BitsPerPixel=32
Width=1920
Height=1080
DisplayFlags=0
DisplayFrequency=60
DisplayOrientation=0
PositionX=0
PositionY=1080
