bnepethomas/bne-arduino-flight-simulator-interfaces/Hornet/Hornet Documentation/Monitor Configuration Files/202605161108 working.cfg

[Monitor0]
Name=\\.\DISPLAY1
MonitorID=MONITOR\ADVEF3D\{4d36e96e-e325-11ce-bfc1-08002be10318}\0010
SerialNumber=
BitsPerPixel=32
Width=11520
Height=2160
DisplayFlags=0
DisplayFrequency=59
DisplayOrientation=0
PositionX=0
PositionY=0
[Monitor1]
Name=\\.\DISPLAY2
MonitorID=MONITOR\HDM0000\{4d36e96e-e325-11ce-bfc1-08002be10318}\0017
SerialNumber=
BitsPerPixel=32
Width=1024
Height=600
DisplayFlags=0
DisplayFrequency=60
DisplayOrientation=0
PositionX=3480
PositionY=2160
[Monitor2]
Name=\\.\DISPLAY10
MonitorID=MONITOR\IPS2024\{4d36e96e-e325-11ce-bfc1-08002be10318}\0006
SerialNumber=LRX20240903
BitsPerPixel=32
Width=800
Height=800
DisplayFlags=0
DisplayFrequency=60
DisplayOrientation=0
PositionX=1559
PositionY=2160
[Monitor3]
Name=\\.\DISPLAY11
MonitorID=MONITOR\IPS2024\{4d36e96e-e325-11ce-bfc1-08002be10318}\0009
SerialNumber=LRX20240903
BitsPerPixel=32
Width=800
Height=800
DisplayFlags=0
DisplayFrequency=60
DisplayOrientation=2
PositionX=-41
PositionY=2160
[Monitor4]
Name=\\.\DISPLAY12
MonitorID=MONITOR\IPS2025\{4d36e96e-e325-11ce-bfc1-08002be10318}\0018
SerialNumber=LRX20251028
BitsPerPixel=32
Width=1080
Height=1080
DisplayFlags=0
DisplayFrequency=60
DisplayOrientation=0
PositionX=2359
PositionY=2160
[Monitor5]
Name=\\.\DISPLAY13
MonitorID=MONITOR\IPS2024\{4d36e96e-e325-11ce-bfc1-08002be10318}\0015
SerialNumber=LRX20240903
BitsPerPixel=32
Width=800
Height=800
DisplayFlags=0
DisplayFrequency=60
DisplayOrientation=2
PositionX=759
PositionY=2160
