bnepethomas/bne-arduino-flight-simulator-interfaces/Hornet/Hornet Documentation/Monitor Configuration Files/2026011 pre UIP Swap.cfg

[Monitor0]
Name=\\.\DISPLAY1
MonitorID=MONITOR\___3132\{4d36e96e-e325-11ce-bfc1-08002be10318}\0013
SerialNumber=
BitsPerPixel=32
Width=480
Height=480
DisplayFlags=0
DisplayFrequency=60
DisplayOrientation=0
PositionX=12544
PositionY=656
[Monitor1]
Name=\\.\DISPLAY5
MonitorID=MONITOR\DWE2100\{4d36e96e-e325-11ce-bfc1-08002be10318}\0003
SerialNumber=0
BitsPerPixel=32
Width=1024
Height=600
DisplayFlags=0
DisplayFrequency=60
DisplayOrientation=0
PositionX=12320
PositionY=0
[Monitor2]
Name=\\.\DISPLAY6
MonitorID=MONITOR\HDM0000\{4d36e96e-e325-11ce-bfc1-08002be10318}\0014
SerialNumber=
BitsPerPixel=32
Width=1024
Height=600
DisplayFlags=0
DisplayFrequency=60
DisplayOrientation=0
PositionX=11520
PositionY=1405
[Monitor3]
Name=\\.\DISPLAY7
MonitorID=MONITOR\DWE2100\{4d36e96e-e325-11ce-bfc1-08002be10318}\0004
SerialNumber=0
BitsPerPixel=32
Width=1024
Height=600
DisplayFlags=0
DisplayFrequency=60
DisplayOrientation=0
PositionX=11520
PositionY=805
[Monitor4]
Name=\\.\DISPLAY8
MonitorID=MONITOR\IPS2024\{4d36e96e-e325-11ce-bfc1-08002be10318}\0008
SerialNumber=LRX20240903
BitsPerPixel=32
Width=800
Height=800
DisplayFlags=0
DisplayFrequency=60
DisplayOrientation=0
PositionX=11520
PositionY=5
[Monitor5]
Name=\\.\DISPLAY9
MonitorID=MONITOR\ADVEF3D\{4d36e96e-e325-11ce-bfc1-08002be10318}\0010
SerialNumber=
BitsPerPixel=32
Width=11520
Height=2160
DisplayFlags=0
DisplayFrequency=59
DisplayOrientation=0
PositionX=0
PositionY=0
