bnepethomas/bne-arduino-flight-simulator-interfaces/A10/A10 DCS Configuration Files/Monitor Layout with 1080 Primary.cfg

[Monitor0]
Name=\\.\DISPLAY1
MonitorID=MONITOR\RTK4C54\{4d36e96e-e325-11ce-bfc1-08002be10318}\0014
SerialNumber=
BitsPerPixel=32
Width=1280
Height=720
DisplayFlags=0
DisplayFrequency=60
DisplayOrientation=0
PositionX=5
PositionY=1800
[Monitor1]
Name=\\.\DISPLAY2
MonitorID=MONITOR\GSM0001\{4d36e96e-e325-11ce-bfc1-08002be10318}\0018
SerialNumber=
BitsPerPixel=32
Width=1920
Height=1080
DisplayFlags=0
DisplayFrequency=60
DisplayOrientation=0
PositionX=0
PositionY=0
[Monitor2]
Name=\\.\DISPLAY3
MonitorID=MONITOR\DRS5008\{4d36e96e-e325-11ce-bfc1-08002be10318}\0022
SerialNumber=B3432845
BitsPerPixel=32
Width=480
Height=480
DisplayFlags=0
DisplayFrequency=60
DisplayOrientation=1
PositionX=1285
PositionY=1599
[Monitor3]
Name=\\.\DISPLAY4
MonitorID=MONITOR\SAM768B\{4d36e96e-e325-11ce-bfc1-08002be10318}\0013
SerialNumber=HNAX400346
BitsPerPixel=32
Width=3840
Height=2160
DisplayFlags=0
DisplayFrequency=60
DisplayOrientation=0
PositionX=1925
PositionY=10
[Monitor4]
Name=\\.\DISPLAY5
MonitorID=MONITOR\RTK4C54\{4d36e96e-e325-11ce-bfc1-08002be10318}\0019
SerialNumber=
BitsPerPixel=32
Width=1280
Height=720
DisplayFlags=0
DisplayFrequency=60
DisplayOrientation=0
PositionX=5
PositionY=1080
[Monitor5]
Name=\\.\DISPLAY6
MonitorID=MONITOR\HTR4628\{4d36e96e-e325-11ce-bfc1-08002be10318}\0021
SerialNumber=
BitsPerPixel=32
Width=640
Height=480
DisplayFlags=0
DisplayFrequency=60
DisplayOrientation=0
PositionX=1285
PositionY=1088
