bnepethomas/bne-arduino-flight-simulator-interfaces/Hornet/Hornet Documentation/Monitor Configuration Files/202304300850 WIP.cfg

[Monitor0]
Name=\\.\DISPLAY1
MonitorID=MONITOR\BNQ7F1C\{4d36e96e-e325-11ce-bfc1-08002be10318}\0018
SerialNumber=F8E02484SL0
BitsPerPixel=32
Width=1920
Height=1080
DisplayFlags=0
DisplayFrequency=60
DisplayOrientation=0
PositionX=11520
PositionY=0
[Monitor1]
Name=\\.\DISPLAY2
MonitorID=MONITOR\DWE2100\{4d36e96e-e325-11ce-bfc1-08002be10318}\0008
SerialNumber=0
BitsPerPixel=32
Width=1024
Height=600
DisplayFlags=0
DisplayFrequency=60
DisplayOrientation=2
PositionX=2632
PositionY=2764
[Monitor2]
Name=\\.\DISPLAY5
MonitorID=MONITOR\BNQ4202\{4d36e96e-e325-11ce-bfc1-08002be10318}\0023
SerialNumber=
BitsPerPixel=32
Width=1920
Height=1080
DisplayFlags=0
DisplayFrequency=59
DisplayOrientation=0
PositionX=0
PositionY=2160
[Monitor3]
Name=\\.\DISPLAY6
MonitorID=MONITOR\ADVEF3D\{4d36e96e-e325-11ce-bfc1-08002be10318}\0013
SerialNumber=
BitsPerPixel=32
Width=11520
Height=2160
DisplayFlags=0
DisplayFrequency=60
DisplayOrientation=0
PositionX=0
PositionY=0
[Monitor4]
Name=\\.\DISPLAY13
MonitorID=MONITOR\DWE2100\{4d36e96e-e325-11ce-bfc1-08002be10318}\0005
SerialNumber=0
BitsPerPixel=32
Width=600
Height=1024
DisplayFlags=0
DisplayFrequency=60
DisplayOrientation=1
PositionX=2032
PositionY=2764
[Monitor5]
Name=\\.\DISPLAY14
MonitorID=MONITOR\DWE2100\{4d36e96e-e325-11ce-bfc1-08002be10318}\0007
SerialNumber=0
BitsPerPixel=32
Width=1024
Height=600
DisplayFlags=0
DisplayFrequency=60
DisplayOrientation=0
PositionX=3063
PositionY=2160
[Monitor6]
Name=\\.\DISPLAY15
MonitorID=MONITOR\DWE2100\{4d36e96e-e325-11ce-bfc1-08002be10318}\0006
SerialNumber=0
BitsPerPixel=32
Width=1024
Height=600
DisplayFlags=0
DisplayFrequency=60
DisplayOrientation=0
PositionX=2039
PositionY=2164
