bnepethomas/bne-arduino-flight-simulator-interfaces/(commit log)

2015-02-28 Moved to separate code for Fuel Stepper to protect needles
2015-02-28 Working on General Stepper
2015-02-28 Progress on General Stepper updated DCS files
2016-07-11 Continue dev
    Adding relay pin and renumbered pins for Max7219
2016-07-15 all leds
2016-08-12 updated led test
2016-08-14 Added value to Led Table
2016-08-14 basic framework
    Modifying test routine for 7 Segment
2016-08-20 building file test framework
2016-08-21 Working on Arduino Strings
2016-08-22 Individual Leds done
2016-08-26 Added Relay Support
    R6=X
2016-08-26 Updated Arduino to handle relay
2016-08-27 need to fix 7 Seg justification
    [_737-Overhead-Arduino.ino]
2016-08-28 Seeing freezes on Arduino
2016-09-08 most things operational
    Including servos
2016-10-02 updated to neW IP addressing and removed debugs from Arduino
2016-12-30 Bug fix
    Removed processing of OLED string and increased servo start up delays
    to give it time to fully return switch
    [_737-Overhead-Arduino.ino]
2017-05-20 Update Timer
2017-05-21 Tuned indicator Leds for SOIC Export
2017-06-13 adding udp test and receive framework
2017-08-28 first cut
2017-09-10 Added Camera
2017-09-30 AOA FILTERS
2017-10-15 Power Dist
2017-10-28 close to final
    Acceptance testing to be done
    New mounting board
2017-10-29 Packing Labels
    [Hornet Connectors.xlsx]
2017-12-03 Altimeter
    Standing to assemble pieces together
2017-12-03 mounts for altimeter
2017-12-04 Added analog input
    for testing framework
2017-12-08 need to fix ethernet
    [Hornet_Altimeter.ino]
2017-12-10 Ethernet no longer causing freeze
    Changed SSD1306 SPI stack to use different pins
    [Hornet_Altimeter.ino]
2017-12-10 Reverted to traditional ethernet card
    [Hornet_Altimeter.ino]
2017-12-27 forking Alt OLED out
    Moving OLED workload to raspberry pi
2017-12-27 send packet from Arduino
2017-12-27 sending and ring altitude
    python script receiving correct values across the wire from arduino
    [Hornet_Altimeter.ino, PyUDPReceiver.py]
2017-12-28 warning about old arduino code
2017-12-29 Altimeter Assembles
2017-12-29 Altimeter 1st assembled test
2017-12-30 added new spacer
2017-12-30 need to slow stepper down - needle shaking
2017-12-31 sending pressure
2018-05-20 building dictionary
    [testinputdata.csv]
2018-05-25 Adjusted JSON export
    and added leading 00’s so sort is natural
2018-05-26 using py2 not 3
    unexplained error occurring
    [UDP_Reflector.py]
2018-05-27 removed wireshark send by default
    now need to specify IP address before packets are sent
2018-05-27 arduino module
2018-05-30 fixing up command recognition
    [PyHWLink_Arduno_Sender_Emulator.py, PyHWLink_Pri_Node_Input.py]
2018-05-30 fixed up open and close
    [PyHWLink_Pri_Node_Input.py]
2018-06-24 basic framework assembled
    Need to uncover why 65 is always on
2018-07-07 found missing value
    Was multiplying rowed by 8 instead of 16. When shield is attached
    loose the two columns before the last one (13 and 14 using 0 base)
    [udp_input_controller.ino]
2018-07-07 Sending data
    But receiving error on 3rd value
    [PyHWLink_Pri_Node_Input.py, udp_input_controller.ino]
2018-07-08 Able to crash when lots of transitions
    [udp_input_controller.ino]
2018-07-08 Framework is basically running
2019-01-21 Doc Updates
    [KeyboardCode.csv]
2019-01-26 all done aside from validating ctl shift etc
    [KeyboardCodetemp.ods]
2019-03-10 Radio Framework
2019-05-26 basic control working
    Now integrate with a blocking socket
2019-05-30 Working on large array of commands
    Brakes and parking breakes working
2019-05-31 most switches working
    next parameter passing
2019-06-02 Fixed up array values for Fuel Valve
2019-06-02 working through switches
2019-06-07 Led work
2019-06-18 Update General_Sim_7219.ino
    Tested Digital Outputs - next is servo pos
2019-07-06 Update General Sim indicators.ods
    [General Sim indicators.ods]
2019-07-10 Added PCBs
    [Max7219.sch, Switcih_interface.sch, pcb_combined.sch]
2019-08-31 PCB Testing Frame work
2019-10-05 doc build
    [Hornet Panels and Connectors.ods]
2019-10-05 Update CONVERT CAD IN PROGRESS.vsdx
2020-03-07 pcb work
    [Arduino_NW_Template.kicad_pcb]
2020-03-08 oled pcb
    [Arduino_NW_OLED.kicad_pcb, Arduino_NW_OLED.sch]
2020-03-21 Start of Framework for common code across zones
2020-03-22 Update ArduinoDevelopmentPlatform.ino
    Have got rolling averages sane for analog inputs - now on to debouncing digital inputs
2020-03-23 Removed Pins 4 and 10 from PCB
    [Arduino_NW_Template-B_Cu.gbr, Arduino_NW_Template-B_Mask.gbr, Arduino_NW_Template-B_Paste.gbr, Arduino_NW_Template-B_SilkS.gbr, Arduino_NW_Template-Edge_Cuts.gbr, Arduino_NW_Template-F_Cu.gbr, Arduino_NW_Template-F_Mask.gbr, Arduino_NW_Template-F_Paste.gbr]
2020-03-23 PCB Hacks may loose them
    [Arduino_NW_Template.dsn]
2020-03-23 Removed tracks
    [Arduino_NW_Template-B_Cu.gbr, Arduino_NW_Template-B_Mask.gbr, Arduino_NW_Template-B_Paste.gbr, Arduino_NW_Template-B_SilkS.gbr, Arduino_NW_Template-Edge_Cuts.gbr, Arduino_NW_Template-F_Cu.gbr, Arduino_NW_Template-F_Mask.gbr, Arduino_NW_Template-F_Paste.gbr]
2020-03-30 Working on CQ framework not complete
2020-04-04 Doc update
    [Arduino_NW_Template.kicad_pcb]
2020-04-13 Landing Gear Panel
2020-04-16 Landing gear
2020-04-16 mfd pcb
    [MFD.kicad_pcb, MFD.sch]
2020-04-19 Doc and Footprint
2020-04-21 Start of Led Downlight
    Need to add Led, horizontal resistor and connector to library
    [LED_Downlight.kicad_pcb, LED_Downlight.sch]
2020-04-23 Tactile Switch
    [LED_Downlight.kicad_pcb, LED_Downlight.sch]
2020-05-03 DDI work
    [Buttons_DDI.sch]
2020-06-07 Add new I2C PCB
    [Arduino_NW_I2C.kicad_pcb, Arduino_NW_I2C.sch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]
2020-06-08 MUX PCB
    [Arduino_NW_I2C.kicad_pcb, Arduino_NW_I2C.sch]
2020-06-09 I2C PCB
    [Arduino_NW_I2C.kicad_pcb, Arduino_NW_I2C.sch]
2020-06-10 Caution Lights
    [CAUTION_LIGHTS_PANEL_PCB_DEFINITION.SLDDRW, Caution_Light_Panel-BOM.csv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]
2020-06-10 Left Eyebrow
    [EWI-Right.step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]
2020-06-12 Jet select
    [JETT_SELECT_PCB_DEFINITION.SLDDRW, JETT_SELECT_Panel-BOM.csv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]
2020-06-14 LED Downlight
    [LED_Downlight.dsn, LED_Downlight.kicad_pcb, LED_Downlight.sch]
2020-06-15 AMCP finally routed completely
    [Buttons_AMPCD.dsn, Buttons_AMPCD.kicad_pcb, Buttons_AMPCD.sch]
2020-06-19 Power Distribution
    [PowerDistribution.dsn, PowerDistribution.kicad_pcb, PowerDistribution.sch]
2020-06-20 Cleaning up Kicad Projects
    [Max7219.sch, PowerDistribution.kicad_pcb, Switch_interface.sch, Switcih_interface.kicad_pcb, Switcih_interface.sch, Swithc_Interface.sch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]
2020-06-20 PCB Validation
    [Buttons_AMPCD.kicad_pcb, Buttons_AMPCD.sch, PowerDistribution.dsn, PowerDistribution.kicad_pcb, PowerDistribution.sch]
2020-06-21 PCB prior to Gerber
    [AP.kicad_pcb, Arduino_NW_I2C.dsn, Arduino_NW_I2C.kicad_pcb, Arduino_NW_I2C.sch, Arduino_NW_Template.dsn, Arduino_NW_Template.kicad_pcb, Arduino_NW_Template.sch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]
2020-06-22 PCB Ordered
    [LED_Down_Multi-B_Cu.gbr, LED_Down_Multi-B_Mask.gbr, LED_Down_Multi-B_Paste.gbr, LED_Down_Multi-B_SilkS.gbr, LED_Down_Multi-Edge_Cuts.gbr, LED_Down_Multi-F_Cu.gbr, LED_Down_Multi-F_Mask.gbr, LED_Down_Multi-F_Paste.gbr]
2020-07-05 Led Test and Allocation
    [Hornet_Led_Mappings.ods]
2020-08-01 UFC Led
    [Hornet_Led_Mappings.ods]
2020-08-01 LED work complete for major PCBs
    [Hornet_Led_Mappings.ods]
2020-08-07 switch mappings
    [Hornet_Led_Mappings.ods, Hornet_Switch_Led_Mappings.ods]
2020-08-26 OH UFC Modifications
    [OLED Support for UFC v1.f3d, UFC Finger Guard v2.f3z, UFC Inner Spacing Plate v15.f3z, UFC Inner Support v1.f3z, UFC Primary PCB Spacer v1.f3d, UFC Round Button v3.f3z, UFC Square Button v2.f3z, UFC Volumne Knob v3.f3z]
2020-08-29 Update Hornet_UFC.ino
    COM1 display basically functioning - not displaying characters - but displaying digis. PCB has been hack viwred to match new PCB
2020-09-05 Switch update
    [Hornet_Switch_Led_Mappings.ods]
2020-09-12 EWI 3d Export
    [EWI Left Light Channel v2.f3z, EWI Right Light Channel v2.f3z, EWI Warning Cover v1.f3d, Eyebrow Warning Buttons v9.f3d, Left EWI with Bumps v5.f3z, Right EWI with Bumps v6.f3z]
2020-09-13 AMPCD Export for fusion
    [Buttons_AMPCD-Edge_Cuts.dxf, Buttons_AMPCD-NPTH-drl_map.dxf, Buttons_AMPCD-PTH-drl_map.dxf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]
2020-09-15 Bens AP stuff
    [AP_Module_FWD_Body_v2.f3d, AP_Module_Mounting_Plate_v5.f3d]
2020-09-16 Create AMPCD Bezel v15.f3z
    [AMPCD Bezel v15.f3z]
2020-09-30 remove old stls
    [AP_Module_FWD_Body-Holderv6_v1.stl, AP_Module_Mounting_Plate_v6_v1.stl]
2020-09-30 Create HDG-CRS Set Spacer v9.f3z
    [HDG-CRS Set Spacer v9.f3z]
2020-10-06 Create Hud Box Led v5.f3d
    [Hud Box Led v5.f3d]
2020-10-10 hud box
    [Hud_Box_Breakout.kicad_pcb, Hud_Box_Breakout.sch, Left_AUX_Vent_Plug_v1.f3d, Lower_ECS_Vent_v2.f3d, Right_AUX_FAN_v1.f3d]
2020-10-15 PCB and Drawing Updates
    [RWR_Control_Panel.sch, UFC.sch]
2020-10-17 RWR PCB
    [Left_Lower_Instrument_Panel_Nextion_v4_v5.f3z, RWR_Control_Panel.sch]
2020-10-18 RWR work
    [RWR_Control_Panel.dsn, RWR_Control_Panel.sch]
2020-11-29 Start PCB work
    [OH - Left Console - 2 - Ground Power.kicad_pcb, OH - Left Console - 2 - Ground Power.sch, OH-Left Console.kicad_pcb, OH-Left Console.sch]
2020-11-29 Panel PCB
    [OH - Left Console - 2 - Ground Power.sch, OH - Left Console - 4 - Exterior Lights Panel.kicad_pcb, OH - Left Console - 4 - Exterior Lights Panel.sch]
2020-12-01 Panel PCBs
    [OH - Left Console - 6 - Flight Control Systems Panel .kicad_pcb, OH - Left Console - 6 - Flight Control Systems Panel .sch, OH - Left Console - 7 - Communication Panel.kicad_pcb, OH - Left Console - 7 - Communication Panel.sch, OH - Left Console - 8 - LOX Indicator.kicad_pcb, OH - Left Console - 8 - LOX Indicator.sch]
2021-01-10 mounting plates
    [Max7219-Edge_Cuts.dxf]
2021-01-11 resin printing
    [ddi ms21382-oxbx v1.stl, ufc comknob v1.f3z, ufc comknob v1.stl]
2021-02-06 Fuel Panel
    [OH - Left Console 5 - Fuel Panel-B_Cu.gbr, OH - Left Console 5 - Fuel Panel-B_Mask.gbr, OH - Left Console 5 - Fuel Panel-B_Paste.gbr, OH - Left Console 5 - Fuel Panel-B_SilkS.gbr, OH - Left Console 5 - Fuel Panel-Edge_Cuts.gbr, OH - Left Console 5 - Fuel Panel-F_Cu.gbr, OH - Left Console 5 - Fuel Panel-F_Mask.gbr, OH - Left Console 5 - Fuel Panel-F_Paste.gbr]
2021-02-06 panel work
    [OH - Left Console - 4 - Exterior Lights Panel-B_Cu.gbr, OH - Left Console - 4 - Exterior Lights Panel-B_Mask.gbr, OH - Left Console - 4 - Exterior Lights Panel-B_Paste.gbr, OH - Left Console - 4 - Exterior Lights Panel-B_SilkS.gbr, OH - Left Console - 4 - Exterior Lights Panel-Edge_Cuts.gbr, OH - Left Console - 4 - Exterior Lights Panel-F_Cu.gbr, OH - Left Console - 4 - Exterior Lights Panel-F_Ma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]
2021-02-06 ext lights
    [OH - Left Console - 4 - Exterior Lights Panel.kicad_pcb, OH - Left Console - 4 - Exterior Lights Panel.sch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]
2021-02-13 ground pins
2021-03-06 Create Left Sub-Console Rail v21.f3z
    [Left Sub-Console Rail v21.f3z]
2021-03-10 FCS PCB
    [OH - Left Console - 6 - Flight Control Systems Panel .dsn, OH - Left Console - 6 - Flight Control Systems Panel .kicad_pcb]
2021-03-23 switch testing
    [Hornet_Switch_Led_Mappings.ods]
2021-03-28 Doc and Test scripts
    [Hornet_Switch_Led_Mappings.ods]
2021-03-28 path fixup
    [OH - FRONT - 35 - Dispenser:EMC Panel.kicad_pcb, OH - FRONT - 35 - Dispenser:EMC Panel.sch]
2021-03-28 filename fixup
    [OH - FRONT - 35 - Dispenser - EMC Panel.kicad_pcb, OH - FRONT - 35 - Dispenser - EMC Panel.sch]
2021-03-28 file fix
    [OH - Left Console - 6 - Flight Control Systems Panel -B_Cu.gbr, OH - Left Console - 6 - Flight Control Systems Panel -B_Mask.gbr, OH - Left Console - 6 - Flight Control Systems Panel -B_Paste.gbr, OH - Left Console - 6 - Flight Control Systems Panel -B_SilkS.gbr, OH - Left Console - 6 - Flight Control Systems Panel -Edge_Cuts.gbr, OH - Left Console - 6 - Flight Control Systems Panel -F_Cu.gbr, OH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]
2021-03-31 Caution Panel 3d mods
    [Caution Lights Panel Chassis-bottom v1 v2.f3d, Caution Lights Panel Chassis-mid v1 v1.f3d, Caution Lights Panel Chassis-top v2 v2.f3d, Caution Lights Panel Top Light Channel v2.f3d]
2021-04-02 Right Console
    [OH - Right Console - 1 - Electrical Power.dsn, OH - Right Console - 1 - Electrical Power.kicad_pcb, OH - Right Console - 1 - Electrical Power.sch]
2021-04-02 Right Panels
    [Hornet_Switch_Led_Mappings.ods, OH - Right Console - 2- Environmental Control System Panel.kicad_pcb]
2021-04-03 RH Panels Interior Lights
    [Hornet_Switch_Led_Mappings.ods, OH - Right Console - 3 - Interior Lights Panel.dsn, OH - Right Console - 3 - Interior Lights Panel.sch]
2021-04-03 Sim Control Sensor
    [Hornet_Switch_Led_Mappings.ods, OH - Right Console - 12 - Canopy Switch Breakers.sch, OH - Right Console - 5 - Sensor Panel.dsn, OH - Right Console - 5 - Sensor Panel.sch, OH - Right Console - 6 - KY-58 Control.sch, OH - Right Console - A - Sim Control.dsn, OH - Right Console - A - Sim Control.kicad_pcb, OH - Right Console - A - Sim Control.sch]
2021-04-04 ess breakers
    [Hornet_Switch_Led_Mappings.ods, OH - Right Console - 12 - Canopy Switch Breakers.dsn, OH - Right Console - 12 - Canopy Switch Breakers.sch, OH - Right Console - 6 - KY-58 Control.dsn, OH - Right Console - 6 - KY-58 Control.sch, OH - Right Console - Forward Aux.kicad_pcb, OH - Right Console - Forward Aux.sch]
2021-04-04 RIGHT DIST
    [OH - Right Console - Input Distribution.dsn, OH - Right Console - Input Distribution.kicad_pcb, OH - Right Console - Input Distribution.sch]
2021-04-04 RH PCBs
    [Hornet_Switch_Led_Mappings.ods, OH - Right Console - Forward Aux.dsn, OH - Right Console - Forward Aux.sch]
2021-04-04 RH Dist PCB
    [Hornet_Switch_Led_Mappings.ods]
2021-04-05 Hopefully final touch ups for Right hand side and fixs for Left hand side
    [Hornet_Switch_Led_Mappings.ods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]
2021-04-05 Fix Sensor Panel Mag
    [OH - Right Console - 5 - Sensor Panel.dsn, OH - Right Console - 5 - Sensor Panel.kicad_pcb, OH - Right Console - 5 - Sensor Panel.sch]
2021-04-05 Hook Indicator
    [Hook Indicator Body v1.f3z, Hook Mount Plate v2.f3z]
2021-04-09 FCS Update
    [Hornet_Switch_Led_Mappings.ods, OH - Left Console - 6 - Flight Control Systems Panel .dsn, OH - Left Console - 6 - Flight Control Systems Panel .kicad_pcb, OH - Left Console - 6 - Flight Control Systems Panel .sch]
2021-04-10 Elect Power Done
    [OH - Right Console - 1 - Electrical Power-NPTH-drl_map.dxf, OH - Right Console - 1 - Electrical Power-PTH-drl_map.dxf, OH - Right Console - 1 - Electrical Power.dsn, OH - Right Console - 1 - Electrical Power.kicad_pcb]
2021-04-10 Work on RH
    [Hornet_Switch_Led_Mappings.ods, OH - Right Console - 2- Environmental Control System Panel-NPTH-drl_map.dxf, OH - Right Console - 2- Environmental Control System Panel-PTH-drl_map.dxf, OH - Right Console - 2- Environmental Control System Panel.dsn, OH - Right Console - 2- Environmental Control System Panel.kicad_pcb, OH - Right Console - 3 - Interior Lights Panel.dsn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]
2021-04-11 Panel refinement
    [OH - Both Console - Output Distribution.kicad_pcb, OH - Both Console - Output Distribution.sch, OH - Left Console - 32 - Selective Jettison.kicad_pcb, OH - Left Console - 32 - Selective Jettison.sch, OH - Right Console - 1 - Electrical Power.kicad_pcb, OH - Right Console - 1 - Electrical Power.sch, OH - Right Console - 12 - Canopy Switch Breakers-NPTH-drl_map.dxf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]
2021-04-11 output dist
    [OH - Both Console - Output Distribution.sch]
2021-04-17 Misc Lights
    [DownLights.sch, OH - Lock Shoot.dxf, OH - AOA.dxf, OH - Misc Lights.dsn, OH - Misc Lights.kicad_pcb, OH - Misc Lights.sch]
2021-05-10 ELECT PANEL FIX
    [Hornet_Switch_Led_Mappings.ods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]
2021-05-15 Create Head Rest Side Panel.dwg
    [Head Rest Side Panel.dwg]
2021-06-12 master arm
    [AG AA Recess v9.f3d, AG AA Recess v9.stl, FIRE EXT RECESS v5.f3d, FIRE EXT RECESS v5.stl, Fire Extinguish Button v3.f3z, Fire Extinguish Button v3.stl, Master Arm AA AG v11.f3d, Master Arm AA GG.stl]
2021-06-25 pcb correction
    [JETT_SELECT_Panel.kicad_pcb]
2021-07-31 mounting plate
2021-08-04 Lock shoot
    [Lock Shoot Front.stl, Lock Shoot Rear.stl, Lock Shoot v19.f3d]
2021-08-07 LIP Work
    [Lock Shoot v24.f3d, OH - Lower Instrument Panel.kicad_pcb, OH - Lower Instrument Panel.sch]
2021-08-28 mag switches
2021-08-28 Magnetic Switch APU and Left Starter
2021-09-15 Mirror Mounts
    [Mirror LCD v9.f3d, Mirror LCD v9.step]
2021-09-21 Outboard Spacer
    [G-H Outboard Spacer with Cable Hole.stl, G-H Outboard v2.f3z]
2021-09-22 Motorised Pedals
    [Microswitch Limit Mount v1.f3d, Microswitch Mount.stl, Motor Adapter.stl, Motor Mount v1.f3d, Motor Mount.stl, pedal mount v4.f3d]
2021-09-25 Mid Flood Lights
    [Flood Light Bracket Left v7.f3d, Flood Light Bracket Right v3.f3d]
2021-09-25 Create Petes Mid FloodLIght v1.f3d
    [Petes Mid FloodLIght v1.f3d]
2021-10-09 Create Exportts for flood lights and start UIP PCBs
    [Bulb Support - Cable Clamp.stl, Bulb Support Rear Mount.stl, Bulb Support for Circuit Breaker Light v9.f3d, Bulb Support for Circuit Breaker Light v9.step, Cable Clamp.stl, Component6.stl, Flood Light Bracket Left v7.f3d, Flood Light Bracket Left v7.step]
2021-10-10 LED DIST PCBS
    [Hornet_Switch_Led_Mappings.ods, OH - LIP - Led Distribution.dsn, OH - LIP - Led Distribution.kicad_pcb, OH - LIP - Led Distribution.sch, OH - UIP - Led Distribution.dsn]
2021-10-16 added Lukes RWR v1 so we have a single repo for Ben and Petes Pit
    [RWR Control Panel PCB V1 BOM.xlsx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]
2021-10-23 PCBS MID input shield
    [Hornet Forward Input Shield.kicad_pcb, Hornet Forward Input Shield.sch, Hornet_Switch_Led_Mappings.ods, OH - Backpanel Template.sch, OH-Left Console.kicad_pcb, OH-Left Console.sch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]
2021-10-24 EJECTION SEAT
    [Hornet Forward Input Shield.kicad_pcb, Hornet_Switch_Led_Mappings.ods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]
2021-10-24 ELECTRICAL POWER
    [Hornet_Switch_Led_Mappings.ods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]
2021-10-24 IFEI COMBINED INPUT ORDERED
    [Hornet_Switch_Led_Mappings.ods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]
2021-10-24 ALL ORDERED ASIDE FROM FORWARD INPUT
    [Hornet Forward Input Shield.kicad_pcb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]
2021-10-24 ALL PCBS ORDERED
    [Hornet Forward Input Shield-B_Cu.gbr, Hornet Forward Input Shield-B_Mask.gbr, Hornet Forward Input Shield-B_Paste.gbr, Hornet Forward Input Shield-B_SilkS.gbr, Hornet Forward Input Shield-Edge_Cuts.gbr, Hornet Forward Input Shield-F_Cu.gbr, Hornet Forward Input Shield-F_Mask.gbr, Hornet Forward Input Shield-F_Paste.gbr]
2021-11-21 pcbs and front test
    [Hornet_Switch_Led_Mappings.ods, OH - LEFT CONSOLE - OUTPUT DISTRIBUTION.kicad_pcb, OH - LEFT CONSOLE - OUTPUT DISTRIBUTION.sch, OH - Left Console - Output Distribution.dsn, OH - Right Console - Output Distribution.dsn, OH - Right Console - Output Distribution.kicad_pcb, OH - Right Console - Output Distribution.sch]
2021-11-27 PCB update
    [AP.dsn, AP.kicad_pcb, AP.sch, Hornet_Switch_Led_Mappings.ods, OH - UIP - Input Distribution.dsn, OH - UIP - Input Distribution.kicad_pcb, OH - UIP - Input Distribution.sch]
2021-11-27 test framework
    [Hornet_Switch_Led_Mappings.ods]
2021-11-27 FORWARD INPUT V2 READY FOR ORDER
    [Hornet Forward Input Shield-B_Cu.gbr, Hornet Forward Input Shield-B_Mask.gbr, Hornet Forward Input Shield-B_Paste.gbr, Hornet Forward Input Shield-B_SilkS.gbr, Hornet Forward Input Shield-Edge_Cuts.gbr, Hornet Forward Input Shield-F_Cu.gbr, Hornet Forward Input Shield-F_Mask.gbr, Hornet Forward Input Shield-F_Paste.gbr]
2021-11-27 AP and Forward Output
    [AP-B_SilkS.dxf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]
2021-11-27 Left and Right Console v3
    [OH - Left Console - Output Distribution-B_Cu.gbr, OH - Left Console - Output Distribution-B_Mask.gbr, OH - Left Console - Output Distribution-B_Paste.gbr, OH - Left Console - Output Distribution-B_SilkS.gbr, OH - Left Console - Output Distribution-Edge_Cuts.gbr, OH - Left Console - Output Distribution-F_Cu.gbr, OH - Left Console - Output Distribution-F_Mask.gbr, OH - Left Console - Output Distrib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]
2021-11-27 Jet Station Select v002
    [Hornet_Switch_Led_Mappings.ods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]
2021-11-27 Forward Input Distribution
    [Hornet_Switch_Led_Mappings.ods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]
2021-11-27 DDI V2
    [Buttons_DDI-B_Cu.dxf, Buttons_DDI-B_SilkS.dxf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]
2021-11-27 Upper Forward Mixed PCBs
    [Hornet_Switch_Led_Mappings.ods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]
2021-11-28 MISC PCBS
    [OH - General Purpose Small PCB-B_Cu.gbr, OH - General Purpose Small PCB-B_Mask.gbr, OH - General Purpose Small PCB-B_Paste.gbr, OH - General Purpose Small PCB-B_SilkS.gbr, OH - General Purpose Small PCB-Edge_Cuts.gbr, OH - General Purpose Small PCB-F_Cu.gbr, OH - General Purpose Small PCB-F_Mask.gbr, OH - General Purpose Small PCB-F_Paste.gbr]
2021-11-28 PCs all ordered
    [Hornet_Switch_Led_Mappings.ods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]
2021-11-29 Create Right Aux Panel.dxf
    [Right Aux Panel.dxf]
2022-01-03 Right Aux Support
    [Right_AUX_Support_Bracket_Lower_Outboard_v2 v3.f3d, Right_AUX_Support_Bracket_Lower_Outboard_v2 v3.step, Right_AUX_Support_Bracket_Lower_Outboard_v2 v3.stl, Right_AUX_Support_Bracket_Lower_Outboard_v2 v5.f3d, Right_AUX_Support_Bracket_Lower_Outboard_v2 v5.step, Right_AUX_Support_Bracket_Lower_Outboard_v2 v5.stl]
2022-02-04 SIM CNTL OPERATIONAL
    [Hornet_Switch_Led_Mappings.ods]
2022-02-13 Left Console output complete aside from Gear Lock Solenoid
2022-02-18 RWR Warning
    [RWR_Control_Panel.kicad_pcb]
2022-02-19 working on pixel led
2022-02-22 UIP PIXEL LEDS DONE
2022-02-24 led update
2022-02-27 fixed Spin Led turning green
2022-02-27 Trim Servo Tune up, refractoring and doc update
2022-02-28 UDP to Pixel led working
2022-03-29 Forward Upper PCB
    [Hornet Forward Output Shield.dsn, Hornet Forward Output Upper Shield.kicad_pcb, Hornet Forward Output Upper Shield.sch]
2022-03-30 Forward upper output PCB
    [Hornet Forward Output Upper Shield-B_Cu.gbr, Hornet Forward Output Upper Shield-B_Mask.gbr, Hornet Forward Output Upper Shield-B_Paste.gbr, Hornet Forward Output Upper Shield-B_SilkS.gbr, Hornet Forward Output Upper Shield-Edge_Cuts.gbr, Hornet Forward Output Upper Shield-F_Cu.gbr, Hornet Forward Output Upper Shield-F_Mask.gbr, Hornet Forward Output Upper Shield-F_Paste.gbr]
2022-03-31 mosfet update
    [Hornet Forward Output Upper Shield.dsn, Hornet Forward Output Upper Shield.kicad_pcb, Hornet Forward Output Upper Shield.sch]
2022-04-25 Monitors all working
    Now need to do final assembly test
    [All Monitors Laid Out.cfg]
2022-05-03 Nextion PCB
    [Nextion Keyboard Emulator.dsn, Nextion Keyboard Emulator.kicad_pcb, Nextion Keyboard Emulator.sch]
2022-05-03 keyboard Emulator
    [Nextion Keyboard Emulator.dsn, Nextion Keyboard Emulator.kicad_pcb, Nextion Keyboard Emulator.sch]
2022-05-20 Update All Monitors Laid Out with BENQ.cfg
    [All Monitors Laid Out with BENQ.cfg]
2022-05-22 park brake
2022-05-28 leds lighting but not correctly
    [UIP_MAX7219_NEXTRON_POWER_RELAY.ino, pyHWLink_SimConnect.py]
2022-05-29 leds working
2022-06-10 Canopy Bow Mounts
    [Canopy Bow Mount v4.f3d, Canopy Bow Mount v4.step]
2022-06-12 Cockpit Handheld Light
    [COCKPIT HANDHELD LIGHT BRACKET v3.f3d, COCKPIT HANDHELD LIGHT BRACKET v3.step]
2022-06-25 Start work on Compass addition to upper shield
    [Hornet Forward Output Upper Shield.kicad_pcb]
2022-06-27 Upper Output PCB and Compass start
    [Hornet Forward Output Shield.dsn, Hornet Forward Output Upper Shield.dsn, Hornet Forward Output Upper Shield.kicad_pcb, Hornet Forward Output Upper Shield.sch]
2022-06-28 Sim Control
    [OH - Sim Control.dsn, OH - Sim Control.kicad_pcb, OH - Sim Control.sch]
2022-07-01 Chart Light
    [Hornet Chart Light v3.f3d, Hornet Chart Light v3.step]
2022-07-02 stepper play
2022-09-17 Standy BM Good
    [Standby_BM.dsn, Standby_BM.kicad_pcb, Standby_BM.kicad_sch]
2022-09-17 Bens Standby
    [Standby_BM-B_Cu.gbr, Standby_BM-B_Mask.gbr, Standby_BM-B_Paste.gbr, Standby_BM-B_SilkS.gbr, Standby_BM-B_Silkscreen.gbr, Standby_BM-Edge_Cuts.gbr, Standby_BM-F_Cu.gbr, Standby_BM-F_Mask.gbr]
2022-09-19 PI GPS PCB
    [Pi GPS Serial-B_Cu.gbr, Pi GPS Serial-B_Mask.gbr, Pi GPS Serial-B_Silkscreen.gbr, Pi GPS Serial-Edge_Cuts.gbr, Pi GPS Serial-F_Cu.gbr, Pi GPS Serial-F_Mask.gbr, Pi GPS Serial-F_Paste.gbr, Pi GPS Serial-F_Silkscreen.gbr]
2022-09-20 build notes
    [3 Screen Base layout 1080p no surround no warp.cfg]
2022-10-01 relocate PCB files - duplicate UFC code
    [Hornet Forward Output Shield-NPTH-drl_map.dxf, Hornet Forward Output Shield-PTH-drl_map.dxf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]
2022-10-01 basic test framework functional
2022-12-31 Update Hornet Assembly and Disassembly.odt
2023-01-05 New Power UIP Power and Backlight Distribution
    [OH - Relay and Backlight Distribution.dsn, OH - Relay and Backlight Distribution.kicad_pcb, OH - Relay and Backlight Distribution.sch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]
2023-01-05 Relay PCB
    [OH - Relay and Backlight Distribution.sch]
2023-01-09 PCB Relay Backlight
    [OH - Relay and Backlight Distribution-B_Cu.gbr, OH - Relay and Backlight Distribution-B_Mask.gbr, OH - Relay and Backlight Distribution-B_Paste.gbr, OH - Relay and Backlight Distribution-B_SilkS.gbr, OH - Relay and Backlight Distribution-Edge_Cuts.gbr, OH - Relay and Backlight Distribution-F_Cu.gbr, OH - Relay and Backlight Distribution-F_Mask.gbr, OH - Relay and Backlight Distribution-F_Paste.gbr]
2023-01-22 Create PCB audit.xlsx
    [PCB audit.xlsx]
2023-02-12 large update
    [737_Drawings_045.dwg, 737_Stick_shaker.dwg, 737_Stick_shaker.dxf, A10C Joystick Layout v04c.xlsx, A10_SOIC_v1.xlsx, ArduinoUnoOledV001.dip, ArduinoUnoOutlineOLEDMuxv01.dip, ArduinoUnoOutlineOLEDMuxv01a.dip]
2023-04-05 add Bens Sari PCB project - WIP
    [NEW_STANDBY_SHEILD.kicad_pcb, NEW_STANDBY_SHEILD.kicad_sch, NEW_STEPPER_INTERFACE.kicad_pcb, NEW_STEPPER_INTERFACE.kicad_sch, SARI_PCB.kicad_pcb, SARI_PCB.kicad_sch, Standby_BM.dsn]
2023-04-24 views 20230423
    [cameras.cfg, model.CFG]
2023-04-27 standby pcb
    [NEW_STANDBY_SHEILD.kicad_pcb, NEW_STANDBY_SHEILD.kicad_sch, Standby_BM.dsn]
2023-04-29 Dual Serial
    [Arduino to Dual Serial.dsn, Arduino to Dual Serial.kicad_pcb, Arduino to Dual Serial.kicad_sch, Arduino to Dual Serial.sch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]
2023-04-29 DUAL SERIAL PCB
    [Arduino to Dual Serial.dsn, Arduino to Dual Serial.kicad_pcb, Arduino to Dual Serial.kicad_sch]
2023-05-06 doc pcb
    [F16 Input Shield with Ethernet-B_Cu.gbr, F16 Input Shield with Ethernet-B_Mask.gbr, F16 Input Shield with Ethernet-B_Paste.gbr, F16 Input Shield with Ethernet-B_SilkS.gbr, F16 Input Shield with Ethernet-Edge_Cuts.gbr, F16 Input Shield with Ethernet-F_Cu.gbr, F16 Input Shield with Ethernet-F_Mask.gbr, F16 Input Shield with Ethernet-F_Paste.gbr]
2023-06-24 update landging gear support
2023-07-09 doc and power relay
2023-07-16 Fixed Ethernet Power
    used 3V3 instead of 3.3v
    [ETHERNET_MOD.kicad_sch, SARI STANDBY_ETHERNET.dsn, SARI_STANDBY_ETHERNET.kicad_pcb, SARI_STANDBY_ETHERNET.kicad_sch]
2023-09-16 sari and f16 work
    [ETHERNET_MOD.kicad_sch, F16_Switch_Led_Mappings.ods, Hornet_Switch_Led_Mappings.ods, SARI STANDBY.dsn, SARI STANDBY_ETHERNET.dsn, SARI_STANDBY_ETHERNET.kicad_pcb, SARI_STANDBY_ETHERNET.kicad_sch, Standby_BM.dsn]
2023-09-24 PCB Fix
    [ETHERNET_MOD.kicad_sch, SARI STANDBY_ETHERNET.dsn, SARI_STANDBY_ETHERNET.kicad_pcb, SARI_STANDBY_ETHERNET.kicad_sch]
2023-10-07 Standby Offset Shim
    [Standby Instrument Lower Support v1.f3d, Standby Instrument Lower Support v1.stl]
2023-10-19 Ben fixes
    [ETHERNET_MOD.kicad_sch, SARI STANDBY_ETHERNET.dsn, SARI_STANDBY_ETHERNET.kicad_pcb, SARI_STANDBY_ETHERNET.kicad_sch]
2023-10-21 Update UIP_MAX7219_NEXTRON_POWER_RELAY.ino
    Adjusted PWM Max Brightness
2023-10-21 LARGE FOLDER REARRANGE
    [.55_SQ_INDICATOR_PCB_DEFINITION.SLDDRW, .55_SQ_Indicator_PCB.DXF, 202304300850 WIP.cfg, 20230527 DCS 4K Monitors Arranges - no rwr.cfg, 20230527 DCS 4K Monitors Arranges - rwr.cfg, 20230701 FS2020 No Roof.cfg, 20231015 DCS 4K Monitors Arranges - rwr.cfg, 20240425 9 Screens no eyefinity.cfg]
2023-10-22 A10 SWITCH
    [A10_Switch_Led_Mappings.ods, AAP.kicad_sch, ENVIRONMENT.kicad_sch, LIGHTS.kicad_sch, Right Console Overview.kicad_sch]
2023-10-25 Corrected Pin places on standby for backighting
    moved form Pin 1 to upper pins
    [ETHERNET_MOD.kicad_sch, Right Console Overview.kicad_sch, SARI STANDBY_ETHERNET.dsn, SARI_STANDBY_ETHERNET.kicad_pcb, SARI_STANDBY_ETHERNET.kicad_sch]
2023-10-26 A10 Right Console Input
    [ETHERNET_MOD.kicad_sch, Hornet Forward Output Shield-NPTH-drl_map.dxf, Hornet Forward Output Shield-PTH-drl_map.dxf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]
2023-10-28 A10 Hornet Backlight
    [BOM_BOTTOM-GAUGE_Analog Instruments.csv, BOM_TOP-GAUGE_Analog Instruments.csv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]
2023-10-28 A10 AND HORNET
    [ETHERNET_MOD.kicad_sch, GAUGE_Analog Instruments.dsn, GAUGE_Analog Instruments.kicad_pcb, GAUGE_Analog Instruments.kicad_sch, HYD ISO Panel PCB V2.dsn, HYD ISO Panel PCB V2.kicad_pcb, HYD ISO Panel PCB V2.kicad_sch, MAX7219A.kicad_sch]
2023-10-30 A10 AND HORNET PCB
    [BOM_BOTTOM-CONTROLLER_Radar Altimeter.csv, BOM_BOTTOM-GAUGE_Analog Instruments.csv, BOM_TOP-CONTROLLER_Radar Altimeter.csv, BOM_TOP-GAUGE_Analog Instruments.csv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]
2023-10-31 A10 FORWARD
    [AUDIO_KEYPAD.kicad_sch, AUX_LIGHT.kicad_sch, EAC.kicad_sch, FIRE HANDLES.kicad_sch, FUEL.kicad_sch, Forward Console Overview.kicad_pcb, Forward Console Overview.kicad_sch, HSI.kicad_sch]
2023-11-05 A10 and F16
    [A10_Switch_Led_Mappings.ods, AIR COND.kicad_sch, AUDIO_KEYPAD.kicad_sch, AUX_LIGHT.kicad_sch, CHANGE LOG.kicad_sch, EAC.kicad_sch, ETHERNET_MOD.kicad_sch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]
2023-11-05 CAUTION PANEL
    [Caution Panel-B_Cu.gbr, Caution Panel-B_Mask.gbr, Caution Panel-B_Paste.gbr, Caution Panel-B_Silkscreen.gbr, Caution Panel-Edge_Cuts.gbr, Caution Panel-F_Cu.gbr, Caution Panel-F_Mask.gbr, Caution Panel-F_Paste.gbr]
2023-11-11 Hyd Iso
    [HYD ISO Panel PCB V2-B_Adhesive.gbr, HYD ISO Panel PCB V2-B_Cu.gbr, HYD ISO Panel PCB V2-B_Mask.gbr, HYD ISO Panel PCB V2-B_Paste.gbr, HYD ISO Panel PCB V2-B_Silkscreen.gbr, HYD ISO Panel PCB V2-Edge_Cuts.gbr, HYD ISO Panel PCB V2-F_Adhesive.gbr, HYD ISO Panel PCB V2-F_Cu.gbr]
2023-11-15 a10 PC
    [CHANGE LOG.kicad_sch, ETHERNET_MOD.kicad_sch, Right Console Input.kicad_pcb, Right Console Input.kicad_sch, Right Console Output.dsn, Right Console Output.kicad_pcb]
2023-11-18 A10 ELEC PWR
    [Right Console Overview.kicad_sch]
2024-01-26 A10 12 Stepper
    [Datasheets.kicad_sch, ETHERNET_MOD.kicad_sch, Front Console 12 Stepper.kicad_sch, Stepper Driver.kicad_sch]
2024-02-05 Update Laser A10v33.vsdx
2024-02-09 Create Laser A10v33a.vsdx
2024-02-09 Update Laser A10v33a.vsdx
2024-02-26 mid pushing Baro tracking to Altimeter -currently NOT fully functional!
2024-03-24 Basic OSRAM framework working
2024-03-24 added compass
    [Compass Front Panel.dxf, FrontV2.stl, Standby Compass- Body.stl, Standby Compass- IR Mount.stl, Standby Compass- LED Mount.stl, Standby Compass- Motor Base.stl, Standby Compass- Rear.stl, Standby Compass- Wheelv2 top.stl]
2024-04-02 folder name correction
    [AIC Auxcomm.kicad_pcb, AIC Auxcomm.kicad_sch, AIC CMDS.kicad_pcb, AIC CMDS.kicad_sch]
2024-06-30 Motorised Pot Test Code
2024-07-13 moved to current hornet code
2024-07-29 Refreshed Front Console Steppers
    [ETHERNET_MOD.kicad_sch, Front Console Output.kicad_pcb, Front Console Output.kicad_sch]
2024-07-29 A10 Front Stepper
    [Front Console Output.kicad_pcb]
2024-07-29 A10 STEPPER DRIVER
    [Datasheets.kicad_sch, ETHERNET_MOD.kicad_sch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]
2024-07-30 A10 Steppers
2024-07-30 A10 Forward Stepper
    [FORWARD 7 STEPPER DRIVER.kicad_pcb]
2024-08-04 A10 LEFT CONSOLE VHF AM
    [VHF-AM-NPTH-drl_map.dxf, VHF-AM-PTH-drl_map.dxf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]
2024-08-09 A10 VHF and UHF
    [A10_Switch_Led_Mappings.ods, UHF-ROTARIES.kicad_pcb, UHF-ROTARIES.kicad_sch, VHF-AM-ROTARIES.kicad_sch]
2024-08-10 a10 pcb
    [VHF-AM-ROTARIES.kicad_pcb]
2024-08-10 A10 PCBS
    [ETHERNET_MOD.kicad_sch, Inputs-From-Panels.kicad_sch, Left Console Input and Output with Rotary.kicad_pcb, Left Console Input and Output with Rotary.kicad_sch, OLED.kicad_sch, UHF-ROTARIES.kicad_sch, VHF-AM-NPTH-drl_map.dxf, VHF-AM-PTH-drl_map.dxf]
2024-08-11 A10 PCB Order
    [Left Console Input and Output with Rotary-NPTH-drl_map.dxf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]
2024-08-11 A10 Left Console Rotary PCBs as ordered
    [Left Console Input-NPTH-drl_map.dxf, Left Console Input-PTH-drl_map.dxf, VHF-AM-NPTH-drl_map.dxf, VHF-AM-PTH-drl_map.dxf]
2024-08-14 A10 FORWARD INPUT PCB
    [CHANGE LOG.kicad_sch, ETHERNET_MOD.kicad_sch, Forward Console Input.kicad_pcb, Forward Console Input.kicad_sch, Indvidiual Inputs.kicad_sch]
2024-08-15 FORWARD CONSOLE INPUT
    [Forward Console Input.kicad_pcb, Indvidiual Inputs.kicad_sch]
2024-08-16 A10 FORWARD INPUT AND OUTPUT
    [COIL AND LAMP DRIVERS.kicad_sch, Forward Console General Output.kicad_sch, INDIVIDUAL OUTPUTS.kicad_sch]
2024-08-30 A10 Doc
    [A10_Switch_Led_Mappings.ods, AUDIO_KEYPAD.kicad_sch, AUX_LIGHT.kicad_sch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]
2024-09-15 Update A10_SARI_DEV_CLASSLESS_TMC_2208.ino
    not working - do not use
    [A10_SARI_DEV_CLASSLESS_TMC_2208.ino]
2024-09-27 Update LEFT_CONSOLE_COMPOSITE_INPUT_CONTROLLER.ino
    Before rotary switch assignment of FM radio
2024-10-13 Left controller corrections
    [CHANGE LOG.kicad_sch, LIGHTING.kicad_sch, Left Console Input and Output with Rotary.kicad_pcb]
2024-11-30 Update A10_RIGHT_CONSOLE_OUTPUTS.ino
    Fuel and Hyd steppers ok
2024-12-08 power distro add mounting holes
    [a10 Power Distro PCB v1.kicad_pcb]
2024-12-23 i2c testing
2025-01-09 HORNET BEGIN COMPASS
    [BATT-PCB.step, BRAKE-PRES-V01-NPTH-drl_map.dxf, BRAKE-PRES-V01-PTH-drl_map.dxf, Body3.stl, CHANGE LOG.kicad_sch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]
2025-01-19 Update LEFT_CONSOLE_INPUT_CONTROLLER_V2.ino
    Shorted parking brake behaviour out
    [LEFT_CONSOLE_INPUT_CONTROLLER_V2.ino]
2025-01-19 Hornet Doc
    [OH - Left Console - Input Distribution.dsn, OH - Left Console - Input Distribution.kicad_pcb, OH - Left Console - Input Distribution.sch]
2025-03-08 ADDED landing gear handle
    being driven off Left Input controller V2 not Max 7219
2025-03-09 Create 20250308a No RWR.cfg
    [20250308a No RWR.cfg]
2025-03-12 Upper mixed PCB
    [COPY OF PEDEAL OUTsch.kicad_sch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]
2025-03-25 cable tester
2025-04-12 Update GAUGES_INSTRUMENT_CONTROLLER.ino
    Radar Alt Flag not working and Ashes P-Channel no working - otherwise all good
    [GAUGES_INSTRUMENT_CONTROLLER.ino]
2025-04-12 moved to HW Test - leds only
2025-04-12 Cable breakout PCB
    [Cable Pass Through-B_Cu.gbr, Cable Pass Through-B_Mask.gbr, Cable Pass Through-B_Paste.gbr, Cable Pass Through-B_Silkscreen.gbr, Cable Pass Through-Edge_Cuts.gbr, Cable Pass Through-F_Cu.gbr, Cable Pass Through-F_Mask.gbr, Cable Pass Through-F_Paste.gbr]
2025-04-14 cable pass through
    [Cable Pass Through-B_Cu.gbr, Cable Pass Through-B_Mask.gbr, Cable Pass Through-B_Paste.gbr, Cable Pass Through-B_Silkscreen.gbr, Cable Pass Through-Edge_Cuts.gbr, Cable Pass Through-F_Cu.gbr, Cable Pass Through-F_Mask.gbr, Cable Pass Through-F_Paste.gbr]
2025-05-24 retire PCBs
    [.55_SQ_INDICATOR_PCB_DEFINITION.SLDDRW, .55_SQ_Indicator_PCB.DXF, 8mmDownlights.sch, AMPCD_PCB.DXF, AMPCD_PCB_DEFINITION.SLDDRW, ANT SEL.kicad_pcb, ANT SEL.kicad_sch, ANT SEL.step]
2025-07-14 arduino updates
2025-08-14 switch fix
2025-08-16 monitro config
    [20250816-all-screens.cfg]
2025-08-20 fixes -temporarilydisabled rudder trim motor
    [GAUGES_INSTRUMENT_CONTROLLER.ino, LEFT_CONSOLE_INPUT_CONTROLLER_V2.ino]
2025-10-02 Jet Ranger Test PCB
    [Jet Ranger Test.kicad_pcb, Jet Ranger Test.kicad_sch]
2025-10-04 JET RANGER
    [Jet Ranger Test.dsn, Jet Ranger Test.kicad_pcb, Jet Ranger Test.kicad_sch, freerouting.dsn]
2025-10-11 power control
2025-10-14 Create Possible Arduino GPSA Sender
2025-10-14 Update Possible Arduino GPSA Sender
2025-10-25 encoder testing
2025-10-25 Update EWI Inserts Oct 2025.vsdx
2025-10-26 stepper test
2025-11-29 Jet Ranger Directory Cleanup[
    [Bell_206_Switch_Mappingsv1d.xlsx, Jet Ranger Monitor Layout.cfg, Ruscool Bell 206 MIP - V8.DXF]
2026-01-11 Hornet Screen Info
    [2026011 pre UIP Swap.cfg]
2026-01-18 Hornet Monitor
    [20261181447.cfg, 20261181451.cfg]
2026-01-22 POWER DISTRIBUTION PCB
    [OZ-HORNET-POWER-DIST-B_Cu.gbr, OZ-HORNET-POWER-DIST-B_Mask.gbr, OZ-HORNET-POWER-DIST-B_Paste.gbr, OZ-HORNET-POWER-DIST-B_Silkscreen.gbr, OZ-HORNET-POWER-DIST-Edge_Cuts.gbr, OZ-HORNET-POWER-DIST-F_Cu.gbr, OZ-HORNET-POWER-DIST-F_Mask.gbr, OZ-HORNET-POWER-DIST-F_Paste.gbr]
2026-01-24 POWER MAIN
    [OZ-HORNET-POWER-MAIN-B_Cu.gbr, OZ-HORNET-POWER-MAIN-B_Mask.gbr, OZ-HORNET-POWER-MAIN-B_Paste.gbr, OZ-HORNET-POWER-MAIN-B_Silkscreen.gbr, OZ-HORNET-POWER-MAIN-Edge_Cuts.gbr, OZ-HORNET-POWER-MAIN-F_Cu.gbr, OZ-HORNET-POWER-MAIN-F_Mask.gbr, OZ-HORNET-POWER-MAIN-F_Paste.gbr]
2026-01-28 Due Prodcution Controller
    [Body1.stl, ETHERNET_MOD.kicad_sch, JET_RANGER_MATRIX.xlsx, Jet Ranger DUE Prod Radio Controller.kicad_pcb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]
2026-01-28 due pcb update
    [Jet Ranger DUE Prod Radio Controller-B_Cu.gbr, Jet Ranger DUE Prod Radio Controller-B_Mask.gbr, Jet Ranger DUE Prod Radio Controller-B_Paste.gbr, Jet Ranger DUE Prod Radio Controller-B_Silkscreen.gbr, Jet Ranger DUE Prod Radio Controller-Edge_Cuts.gbr, Jet Ranger DUE Prod Radio Controller-F_Cu.gbr, Jet Ranger DUE Prod Radio Controller-F_Mask.gbr, Jet Ranger DUE Prod Radio Controller-F_Paste.gbr]
2026-01-29 due controller
    [Jet Ranger DUE Prod Radio Controller.dsn, Jet Ranger DUE Prod Radio Controller.kicad_pcb, Jet Ranger DUE Prod Radio Controller.kicad_sch]
2026-01-29 DUE Prod
    [Jet Ranger DUE Prod Radio Controller-B_Cu.gbr, Jet Ranger DUE Prod Radio Controller-B_Mask.gbr, Jet Ranger DUE Prod Radio Controller-B_Paste.gbr, Jet Ranger DUE Prod Radio Controller-B_Silkscreen.gbr, Jet Ranger DUE Prod Radio Controller-Edge_Cuts.gbr, Jet Ranger DUE Prod Radio Controller-F_Cu.gbr, Jet Ranger DUE Prod Radio Controller-F_Mask.gbr, Jet Ranger DUE Prod Radio Controller-F_Paste.gbr]
2026-02-01 Arduin Now Sending COM1 Stand by to MSFS
    [assessment.csv]
2026-02-02 radio controller push button framework
2026-02-07 battery switch no longer working
2026-02-07 Battery Monitoring working bt Avionics isn't
    After tinkeirng with Event Var and perhaps a logic mistake in event handling
    [JET_RANGER_RADIO_CONTROLLER.ino]
2026-02-07 Voltages now nderstood
    To do Set Frequency using string
2026-02-08 comms workings frequency non-BCD
    Unable to set Garmin 1000 buttons - need to research if FSUIPC with WASM may be able to solve
2026-02-08 power pcbs with aliexpress connector
    [OZ-HORNET-POWER-DIST-B_Cu.gbr, OZ-HORNET-POWER-DIST-B_Mask.gbr, OZ-HORNET-POWER-DIST-B_Paste.gbr, OZ-HORNET-POWER-DIST-B_Silkscreen.gbr, OZ-HORNET-POWER-DIST-Edge_Cuts.gbr, OZ-HORNET-POWER-DIST-F_Cu.gbr, OZ-HORNET-POWER-DIST-F_Mask.gbr, OZ-HORNET-POWER-DIST-F_Paste.gbr]
2026-02-08 updating Servos
2026-02-10 servo range build out
2026-02-12 Servo
    Torque is jittering after attach
    [JET_RANGER_SERVO_CONTROLLER.ino]
2026-02-12 Update JET_RANGER_SERVO_CONTROLLER.ino
    Fixed Servo Jitter be checking for incoming packets every so many mS instead of everytime through the loop
    [JET_RANGER_SERVO_CONTROLLER.ino]
2026-02-13 Servo Test Framework
2026-02-14 Servo Tuner Operational
2026-02-14 Servo work
2026-02-14 framework may be working
2026-02-14 Torque is now operational
    Whoot
2026-02-15 Rotor and Engine RPM
2026-02-15 Working on Eng Oil Temp and Pressure gauges not moving
2026-02-16 Bank and Pitch to do
2026-02-16 Roll anbd Bank compelte
    to do
    build new PCB
    Elec load, Fuel Loan Gas Producer Radar Alt
2026-02-20 Fuel & Elec Load, Gas P start dev
    [Jet Ranger Front Panel Servo.kicad_pcb, Jet Ranger Front Panel Servo.kicad_sch]
2026-02-21 light test routine ok - now need to develop logic
    [Jet Ranger Front Panel Servo.kicad_sch]
2026-02-21 to fix pitch and roll
2026-02-21 Engine out and Rotor Low Warnings now ok
    Needed to compare string not numeric
2026-03-01 Update JET_RANGER_RADIO_CONTROLLER.ino
    Nav Minors need to fix rolling over 990
    [JET_RANGER_RADIO_CONTROLLER.ino]
2026-03-02 Update JET_RANGER_RADIO_CONTROLLER.ino
    Minor Encoders now rolling - todo SimConnect interface for Com2 and Nav
2026-04-26 CrossPlatform First cut
2026-05-10 Create insert for keepalive
2026-05-11 keepalive added to current boards
2026-05-17 Mostly working
    [Body1.stl, ETHERNET_MOD.kicad_sch, MATRIX.xlsx, MOUNT.dxf, MOUNT2.dxf, SHIELDBO.step, UIP CONTROLLER.dsn, UIP CONTROLLER.kicad_pcb]
2026-05-22 left and right lighting
    [ETHERNET_MOD.kicad_sch, INSTRUMENTS_CONTROLLER-NPTH-drl_map.dxf, INSTRUMENTS_CONTROLLER-PTH-drl_map.dxf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]
2026-06-27 737 Displays Configuration
    [MultiMonitorTool.cfg]
2026-07-12 All gauges aside from Pitch Roll
    Pitch roll needs a multiplier
    engine oil was jumping during shutdown
2026-07-17 fsuipc button
2026-07-20 upper pcb
    [Jet Ranger Upper Controller-B_Cu.gbr, Jet Ranger Upper Controller-B_Mask.gbr, Jet Ranger Upper Controller-B_Paste.gbr, Jet Ranger Upper Controller-B_Silkscreen.gbr, Jet Ranger Upper Controller-Edge_Cuts.gbr, Jet Ranger Upper Controller-F_Cu.gbr, Jet Ranger Upper Controller-F_Mask.gbr, Jet Ranger Upper Controller-F_Paste.gbr]
2026-07-22 large gauge
    [ER-OLEDM0.91-1W-I2C - OLED, 0.91in, WHT ON BLK, 128x32 v1.step, GAUGE_Analog Instruments.step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]
2026-07-26 Simkits Large gauge
    [Simkits Large Guage-NPTH-drl_map.dxf, Simkits Large Guage-PTH-drl_map.dxf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]
2026-07-28 Jet Ranger OLED and Stepper
2026-07-29 stepper test harness
2026-08-10 Jet Ranger Doc and Harness
    [Jet Ranger 13 Stepper.kicad_sch]
2026-08-18 OLEd Dual Stepper
    [Jet Ranger OLED Dual Stepper-B_Cu.gbr, Jet Ranger OLED Dual Stepper-B_Mask.gbr, Jet Ranger OLED Dual Stepper-B_Paste.gbr, Jet Ranger OLED Dual Stepper-B_Silkscreen.gbr, Jet Ranger OLED Dual Stepper-Edge_Cuts.gbr, Jet Ranger OLED Dual Stepper-F_Cu.gbr, Jet Ranger OLED Dual Stepper-F_Mask.gbr, Jet Ranger OLED Dual Stepper-F_Paste.gbr]
2026-08-21 Create Small Gauge Insert.dxf
    [Small Gauge Insert.dxf]
2026-10-10 Create OLED Front.dxf
    [OLED Front.dxf]
2026-10-11 Servo PCB
2026-10-17 Jet Ranger: radio/OLED power rules, IAS decimal, standard freq spacing, docs
    Radio controller
    - Pad COM/NAV frequencies to xxx.xxx so COM2 no longer slides behind the faceplate
    - Standard channel spacing: COM 25 kHz (118.000-136.975), NAV 50 kHz (108.00-117.95)
    - NAV display redraws with COM when the power state changes
    Dual stepper
    - New PWR:1/PWR:0 data code blanks the Baro, Altimeter, Clock and Temperature OLEDs
    FSUIPC bridge
    - IAS sent (and shown) to one decimal; Stepper sketch accepts fractional knots
    - NAVCOM1 follows avionics bus >= 24 V; PWR follows main bus >= 24 V
    - Labelled COM2/NAV1/NAV2 standby handling, real-unit per-board payloads
    Docs
    - Master document, User Guide (includi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
2026-10-17 Jet Ranger: add MSFSWinformsAutoCS, the SimConnect twin of the FSUIPC bridge
    - New WinForms project for MSFS 2020/2024 built on SimConnect: same window, 1 s
    connection timer, 100 ms main timer, port-27001 command listener and per-board
    real-unit packets (Servo, Stepper, Dual Stepper, OLED, Radio) as FSUIPCWinformsAutoCS
    - Payloads.cs builds the packets from a SimSnapshot with no SimConnect/UI dependency
    (IAS to one decimal, NAVCOM1 from avionics bus >= 24 V, PWR from main bus >= 24 V)
    - SDK managed and native SimConnect DLLs copied into lib/ so it builds standalone
    - Built and packet-tested with sample data; not yet run against MSFS
    - PROGRAM_SUMMARY.md for the project; listed in PROJE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
2026-10-17 Jet Ranger docs: add MSFSWinformsAutoCS to the master document and user guide
    - Master document: new "MSFSWinformsAutoCS - Program Summary" section (program flow,
    SimVars, per-board packets, network, known gaps) and updated overview lines
    - User Guide: MSFS bridge description and a "Running the MSFS bridge" section
    - Backups of the previous versions added
2026-10-17 MSFSWinformsAutoCS: FlyInside B206 estimates for torque, turbine temp, fuel and transmission
    The FlyInside B206 does not feed the standard SimVars its cockpit gauges use, so when its
    turbine L:var (Aircraft.Engine.1.Turbine.N2.Smooth) is present the bridge estimates values
    from cockpit-dial readings; other aircraft keep the standard SimVars.
    - Torque from the collective lever at normal rotor speed (21 % idle, 74 % at 73.6, 120 % at
    full lever, capped at 120), and from the turbine max-torque percent below that
    - Turbine out temperature rises with torque (about 600 C idle, 700 C at 115 % torque)
    - Fuel pressure scaled x10 to psi (the dial is a 0-3 scale marked x10)
    - Transmission oil pressu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
2026-10-17 Jet Ranger docs: MSFS bridge FlyInside estimates in the master document and user guide
    - Master document: new "FlyInside B206 estimates" section under MSFSWinformsAutoCS
    (L:vars, gas producer, torque from the collective, turbine temperature, fuel pressure,
    transmission oil, Radio main-bus fallback, electrical load percentage); corrected the
    "not yet run against MSFS" wording and the electrical-load units
    - User Guide: MSFS bridge notes on the aircraft-specific estimates and the full-collective
    over-torque; corrected the "not yet run" wording
    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
2026-10-17 MSFSWinformsAutoCS: CowaSim profile, TOPW/GENF lamps, load magnitude, aircraft title tracking
    - CowaSim Jet Ranger (title "206B3 ...") estimates from dial readings: torque as a smoothed
    0.42 x ENG TORQUE PERCENT (2.5 s), turbine out temperature as EGT - 200, electrical load
    scale 139 A, transmission oil 48 psi x rotor fraction and 0.92 x engine oil temperature
    - New warning lamps: transmission oil pressure below 40 psi (TOPW) and engine speed below
    10 % (GENF); the FlyInside B206 is also recognised by title so TOPW works with the engine off
    - Electrical load uses the magnitude of the total load amps (the sign flips when the battery
    supplies the bus)
    - The status bar follows the aircr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
2026-10-18 Backlight: UDP brightness and main bus power on Servo, Stepper and Dual Stepper
    - Servo, Stepper and Dual Stepper sketches: C,B:0-15 sets the backlight PWM on
    pin 5; D,BPWR:1/0 (main bus 20 V or more) switches it off and on. With no
    brightness command the default PWM 65 is used; once one has been received the
    last commanded level is restored whenever power returns.
    - FSUIPCWinformsAutoCS and MSFSWinformsAutoCS send BPWR in the Servo, Stepper and
    Dual Stepper packets.
    - SwingTester: brightness slider sending C,B:n to every board except the USB HID
    board, plus backlight power ON/OFF buttons (D,BPWR) for bench testing.
    - PROGRAM_SUMMARY.md files updated. Servo flashed on COM16, Steppe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
2026-10-18 Backlight: switch off with the no-data watchdog on Servo, Stepper and Dual Stepper
    When no UDP packet has arrived for 30 s (including after power-up with no PC
    feed) the watchdog now turns the backlight off along with the gauges; the next
    packet restores it to the last commanded brightness (or the default) if the main
    bus is up. Summaries updated. All three boards flashed (COM16, COM4, COM5).
2026-10-18 Docs: GPS interface, backlight, PCB revisions, colour codes and cabling
    Master document (69 pages) and User Guide (43 pages) regenerated:
    - Lowrance AirMap GPS interface and bench tester chapters; bridges send position
    and simulator time to the GPS.
    - Backlight: BPWR, C,B brightness and the 30 s no-data rule on the Servo, Stepper
    and Dual Stepper; SwingTester brightness controls.
    - PCB notes brought up to date: 18 Oct 2026 revisions (backlight MOSFET fix,
    IRF540N), backlight driver circuit, ADF controller and switch panels, pin and
    copper re-check.
    - New "Colour codes and cabling" chapter: diagram and program colour key, round
    power connector and PCB connector cable colours (colour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
2026-10-18 Jet Ranger MOSFET fix
2026-10-18 Track Release binaries of the Jet Ranger Windows programs
2026-10-18 ADF controller sketch: ADF knobs, aircraft ID keypad, panel brightness, 12 V and 5 V monitoring
2026-10-18 Jet Ranger PCB
2026-10-21 User Guide: backlight resistor values
2026-10-24 Auto Pilot and Audio panel LEDs: MAX7219 driver on the Radio, LED data from the FSUIPC and MSFS bridges, per-LED tests in SwingTester
    - Radio controller: drives the 19 panel LEDs through the MAX7219 (LED_xxx tokens), C,LEDTEST, and C,B sets the LED intensity
    - FSUIPC bridge: autopilot, flight director, audio switch and marker offsets sent as LED tokens in the radio packet
    - MSFS bridge: autopilot and audio SimVars in two separate requests, sent as LED tokens in the radio packet
    - SwingTester: panel LEDs group (one toggle per LED, All ON/OFF, Chase, board test)
    - Release binaries rebuilt
2026-10-24 Auto Pilot, Audio and ADF panel switches and knobs as joystick buttons and bridge commands; documentation
    - Radio controller: 4 x 5 matrix (adds COL4 on D48), Auto Pilot and Audio panel switches and the five Auto Pilot knobs sent as joystick buttons (Joystick 3: 64-81, Joystick 4: 96-103) and as simulator control names to the bridge on UDP 27001
    - ADF controller: gear, flaps, speed brake and brake switches (D29-D32) and the two ADF knobs sent as joystick buttons (Joystick 4: 104-111); switches also sent as GEAR_DOWN/UP, FLAPS_DOWN/UP, SPOILERS_ON/OFF, PARKING_BRAKES
    - FSUIPC and MSFS bridges: TryPanelCommand() turns the control names into FSUIPC controls and SimConnect events (optional :N re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
2026-10-24 Radio panel backlight and I2C scan
    - Radio controller: backlight on D5 (BPWR, C,B brightness, default PWM 65, off with the no-data timeout); I2C scan of the main bus and each TCA9548A channel sent to the debug monitor at start-up and on C,I2CSCAN:1
    - FSUIPC and MSFS bridges: BPWR in the radio packet
    - SwingTester: Backlight power buttons also go to the Radio
    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
2026-10-24 Documentation: PCB schematics and layouts for every board; Radio backlight, I2C scan, DME display and matrix debounce
    - Master document (Appendix C) and User Guide (new last chapter): the schematic and board layout of each of the 17 PCB projects with a layout, exported from KiCad
    - PCB revisions brought up to date (13 Stepper 1.6, Audio, Auto Pilot and ADF panels 1.1)
    - Radio controller documented: backlight on D5 with BPWR and C,B, I2C scan, DME display start-up text, integrator matrix debounce
    - Radio sketch: DME display text (10M / 0M) and integrator debounce for the matrix so a switch release is reported when it happens
    - build_docs.py: JPEG figures; export_pcb_images.py and pcb_to_jpg.p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
2026-10-24 ADF controller: key map, landing gear lamps, toggle switch positions; Auto Pilot display values from the bridges
    - ADF controller: keypad key labels corrected from the bench results; brightness pot switched off (USE_BRIGHTNESS_POT 0); landing gear lamps (D2-D4) driven by LDGN/LDGL/LDGR data packets; gear, flaps and speed brake toggle switches send their position (GEAR_SET, FLAPS_SET, SPOILERS_SET :1/:0) on every change and every 5 s
    - FSUIPC and MSFS bridges: autopilot heading, course, airspeed, vertical speed and altitude sent to the Radio for the Auto Pilot display (APHDG, APCRS, APIAS, APVS, APALT); the GEAR_SET, FLAPS_SET and SPOILERS_SET position commands
    - SwingTester: Auto Pilot displ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
2026-10-25 Health Monitor: ADF and voltage table; heartbeats carry the 5 V rail; documentation regenerated
    - Health Monitor: ADF indicator, Show Voltages table (last 5 V reading from each board, ADF also 12 V)
    - Servo, Upper, Stepper, Dual Stepper, Radio, USB HID and ADF sketches: 5 V rail measured against the 1.1 V band-gap and added to the heartbeat (ADF also 12 V); Radio and ADF sketch updates since the last commit
    - Master document and User Guide regenerated: ADF chapters rewritten, Radio Auto Pilot display and HID-missing behaviour, bridge Auto Pilot values and position commands, Health Monitor voltages, SwingTester groups, new screenshots and diagrams
    - PROGRAM_SUMMARY files updated
    Co-Authored-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
2026-10-25 ADF: anti-ice, hyd boost and caution dim switches; panel blanking and backlight rules; Upper backlight; COM ports window; documentation
    - ADF controller (PCB rev 1.5): switches on D34/D33/D35 as Joystick 4 buttons 112-114; anti-ice sends ANTI_ICE_SET:1/0 to the bridges (FSUIPC control / SimConnect event)
    - ADF display, lamps and backlight blank with the Radio (C,DISPLAY from the Radio), follow BPWR and C,B, and have a 30 s no-data timeout; both bridges send D,BPWR to the ADF and Upper boards
    - Upper controller: drives the D5 backlight with BPWR, C,B and the no-data timeout (compiled, not flashed)
    - Radio: DME display blanks with the other displays; Servo: fuel pump and aft fuel filter pins s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
2026-10-31 ADF PCB combined
2026-10-31 Docs: ADF and Upper merge, Huey firmware, Upper ADF Controller PCB
    - ADF and Upper controller chapter (master and guide): merged Upper matrix and
    keypad, combined-board pins (switches D31-D37, ADF keypad A7-A4/A3-A1 reversed,
    12 V monitor A8), UPPER_INPUT heartbeat, COM26, joystick indexes 0-95
    - Network, bridges, tools, appendices, PCB notes and troubleshooting updated; the
    old Upper board (.103) is documented as retired
    - Jet Ranger Upper ADF Controller rev 1.0 schematic and layout images replace the
    Upper Controller and ADF Controller boards
    - Radio: Huey Warning Panel switches and 20 LEDs documented as firmware only (the
    panel is hand wired, so its PCB is left out); Radio flash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
2026-10-31 DCS and X-Plane bridges, instrument map, documentation
    - DCSBiosBridge: gauge values (CommonData for any aircraft, UH-1H radar altitude and
    needle-position gauges with live calibration), profile merge with _common.json
    - XPlaneBridge: new UDP dataref bridge (no plugin), generic profile plus Robinson R22
    and Sikorsky S-76, Search datarefs, fake-X-Plane end-to-end test
    - Instrument map A3 and appendix; installation appendix
    - Master document and User Guide: new DCS and X-Plane bridge chapters with window
    screenshots, network ports, Huey LED sources, troubleshooting; To Do updated
2026-10-31 Start-up script and per-simulator start-up documentation
    - Start Jet Ranger.ps1/.bat: starts the reflector check, Health Monitor, Lowrance GPS
    interface, optional simulator and the one bridge for MSFS, P3D/FSX, DCS or X-Plane;
    -Stop, -DryRun, settings file sample
    - GPS, system overview, data pipeline and start-up diagrams now cover MSFS, P3D/FSX,
    DCS and X-Plane
    - User Guide chapter "Starting each simulator", master document start-up script chapter,
    GPS senders table; PROJECT_SUMMARY and To Do updated; documents rebuilt
2026-10-31 Panel emulators and a send-to-emulators option in all four bridges
    - JetRangerPanelEmulator: windows for the Radio, Servo, Stepper, Dual Stepper and ADF/Upper
    controllers that draw the gauges, lamps, LEDs and OLEDs from the board packets, listening on
    127.0.0.<board number>:13136; tests for the emulators and for the DCS and X-Plane bridges
    driving them
    - FSUIPC, MSFS, DCS and X-Plane bridges: BoardTargets class, Send to the emulators box,
    --emulators / --emulators-only / --emulator-net
    - Start Jet Ranger: -Emulators and -EmulatorsOnly
    - Master document and User Guide: panel emulators chapter and sections, bridge window
    screenshots retaken; PROGRAM_SUMMARY, PROJECT_SUMMARY and To Do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
2026-10-31 Firmware versions in every controller, shown in the Health Monitor; ADF power status off the reflector
    - Radio, Servo, Stepper, Dual Stepper, ADF and Upper and USB HID sketches: FIRMWARE_NAME /
    FIRMWARE_VERSION / FIRMWARE_BUILD, reported on the debug stream at start-up and on C,VERSION:1,
    and carried in the heartbeat as " FW:1.0.<build>" (builds: ADF and Upper 3, the others 2)
    - ADF and Upper: the 12 V / 5 V power status is no longer sent to the debug reflector (still on
    port 27003 and in the heartbeat)
    - Health Monitor: Firmware column in the voltage table
    - Panel emulator: Radio start-up frequencies match the sketch
    - Documentation: master document and User Guide (firmware versions,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
2026-10-31 Documentation: flashed firmware versions, Health Monitor Firmware column, instrument map at the start of the User Guide
    - Version tables show the flashed builds (all 1.0 build 2, ADF and Upper build 3); heartbeat FW token
    described; Health Monitor Firmware column and retaken screenshots
    - To Do: reflash done, low 5 V rails investigation added; PROJECT_SUMMARY and PROGRAM_SUMMARY updated
    - User Guide: landscape copy of the instrument map at the start of the Overview; documents rebuilt
2026-11-01 Packet monitor in all four bridges: show the payloads sent to each board, filtered by target board
    - FSUIPC, MSFS, DCS and X-Plane bridges: Show packets... button, --show-packets and
    --packet-board; BoardTargets raises PacketSent for every board and GPS send, and
    PacketMonitorForm lists them with time, target board, destination and payload, with a
    Target board filter, Pause and Clear
    - Master document, User Guide (new Packet monitor section and screenshots, retaken bridge
    windows), PROJECT_SUMMARY, PROGRAM_SUMMARY and To Do updated; documents rebuilt
2026-11-01 Cockpit systems diagrams (power, USB, CKAS platform, lighting, PC displays, sound) and documentation
    - New diagrams in DocBuild/diagrams_e.py: power_supply, usb_wiring, ckas_platform, lighting,
    pc_displays, sound_system (with icons for the PC, screens, projectors, amplifier, speakers,
    headsets, sound card and rotary switch)
    - User Guide and master document: new chapter "Cockpit systems wiring" with the six diagrams
    - PROJECT_SUMMARY and To Do updated; documents rebuilt
    - Stop tracking the .odt backup copies (ignored by *.odt.bak*; four had been re-added)
2026-11-01 Master document: cockpit systems diagrams moved to Appendix H
    The six diagrams (power supply, USB wiring, CKAS platform, lighting, PC displays, sound
    system) are now Appendix H of the master document instead of a main chapter; the User Guide
    keeps its chapter. PROJECT_SUMMARY updated; master document rebuilt.
2026-11-06 Start-up hold, firmware builds, Radio PCB 1.4 and third-page system diagrams in the documentation
    Firmware: every controller keeps its backlight, OLEDs and indicator lamps on from reset until the 13 Stepper controller announces STARTUPDONE on UDP 13138 (180 s failsafe); builds Radio 5, Servo 4, Stepper 3, Dual Stepper 5, ADF and Upper 6.
    Documentation: start-up hold and port 13138 in the master document and User Guide, current firmware builds, Radio Auto Pilot PCB revision 1.4 (Huey connectors J20 to J23) with regenerated pictures and PCB map, third-page versions of the six cockpit systems diagrams in the opening sections (new #hNN figure height option in build_docs.py), regenerated date 6 N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
2026-11-06 Health Monitor screenshots refreshed; USB hub powered directly in the power diagram
    User Guide: new Health Monitor screenshots (live window, current firmware builds). Power supply diagram, User Guide and master Appendix H: the USB hub has its own 5 V cable from the ATX supply PCB and is not fed through the power distribution PCB. Documents rebuilt, regenerated date 7 November 2026.
2026-11-06 Start-up announcement sent twice, DME stays on during the hold, MAX7219 and landing gear brightness
    Stepper (build 4): STARTUPDONE is sent twice, 2 seconds apart, instead of 18 times 10 seconds apart.
    Radio (builds 6 and 7): updateDme() uses radioPowered() so the DME display stays on during the start-up hold; new C,LEDB:0-15 sets the MAX7219 brightness on its own (C,B then sets only the backlight).
    ADF and Upper (build 7): new C,GEARB:0-15 dims the three landing gear lamps with PWM.
    SwingTester: Brightness sliders for the MAX7219 LEDs (C,LEDB) and the landing gear lamps (C,GEARB).
    To Do: MAX7219 indicators do not reset when only USB is pulled.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
2026-11-06 Start-up backlight 100 percent then 70 percent, SSD1306 OLED brightness, SwingTester renamed BenchTester
    Firmware (Radio 8, Servo 5, Stepper 5, Dual Stepper 7, ADF and Upper 8): the backlight is at 100 percent during the start-up hold; when the Stepper controller announces start-up complete the commanded level becomes 70 percent and the backlight goes off until BPWR:1. The Stepper and Dual Stepper setup level (was 128) and their DCS-BIOS A-10C lighting callbacks follow the hold. Dual Stepper: new C,OLEDB:0-15 sets the contrast of the four SSD1306 OLEDs.
    BenchTester (was SwingTester): project, folder, executable and window title renamed; new OLED brightness slider; the backlight slider no lon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
2026-11-06 Documentation for the start-up hold changes, the new brightness commands and the BenchTester rename; ADF build 9
    Master document and User Guide: start-up hold now 100 percent then 70 percent and off, the announcement sent twice 2 seconds apart, the DME display kept on; C,LEDB, C,GEARB and C,OLEDB; current builds; SwingTester renamed BenchTester throughout; backlight logic diagram; BenchTester screenshots recaptured. PROJECT_SUMMARY and To Do updated; documents rebuilt.
    BenchTester: wider default window for the extra slider, Release build rebuilt.
    ADF (build 9): comments now say BenchTester, no behaviour change.
2026-11-07 MAX7219 starts at maximum brightness (Radio build 9), BenchTester Release rebuilt, To Do items
    Radio (build 9): MAX7219_INTENSITY is 15, so the panel LEDs are at full intensity from power-up until a C,LEDB or C,B command.
    BenchTester: the Panel LEDs brightness slider starts at 15 to match; Release build files rebuilt.
    To Do: check why the back course LED does not light; install a 100 uF capacitor on the MAX7219; items confirmed done by the user.
2026-11-07 Servo and Radio: stop the per-packet debug lines (Servo build 6, Radio builds 10 and 11); To Do updates
    Servo (build 6): no more "Received a MSFS Packet" debug line.
    Radio (build 10): no more "Handling <token>" debug lines. Radio (build 11): no more "Received NAVCOM1" and "Received MAINBUS" debug lines.
    To Do: removed the finished and cleared items; added the Radio display decimal digits, the upper brightness pot cable and the Upper keypad simulator keystrokes.
2026-11-07 DME station identifier, 500 ms radio refresh, scroll bar, autopilot readout and CowanSim HeloSAS autopilot mapping
    Radio (build 14): the DME display shows the station identifier (DMEID), e.g. "DME IBN 12.3NM".
    MSFS bridge (build 7) and FSUIPC bridge (build 5): DMEID with the DME data; DME and autopilot/audio LED lines in the data out box; the radio packet at least every 500 ms; a scroll bar on the data out box that keeps its position while updating.
    MSFS bridge: the CowanSim 206B3 HeloSAS autopilot lights (L:CS_HeliSAS_Lights_Green bits) drive the AP ENGAGE, HDG, CRS, IAS and ALT LEDs, and the ALT, IAS and VS references captured at engagement go to the Auto Pilot display.
    BenchTester (build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
2026-11-08 Live NAV active frequencies, CowanSim and DodoSim SAS autopilot LEDs; DodoSim SAS documentation note
    Radio (build 15): N1A and N2A set the NAV displays' active frequencies (the standby ones stay local).
    MSFS bridge (build 8) and FSUIPC bridge (build 8): send N1A and N2A. MSFS: the CowanSim HeloSAS lights (L:CS_HeliSAS_Lights_Green) drive the AP ENGAGE, HDG, CRS, IAS and ALT LEDs. FSUIPC: the DodoSim 206 SAS LED variables (DodoSim_Sas...Led, green bit) drive the same LEDs; the data out box shows the raw values. Release files rebuilt.
    Documentation: note that the SAS in the DodoSim 206 must be enabled in the aircraft's systems before it is displayed, with a screenshot of the DodoSim 206 V2 Set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
2026-11-08 To do: install ATX PSU PCB
2026-11-08 Quick reference guide, Upper and Huey connections in the diagrams, rebuilt documents
    - New Jet Ranger Quick Reference (PDF and ODT) with the instrument map
    - System overview diagram: Upper panel (rows, columns, analog brightness) to the
    ADF controller and the Huey caution panel to the Radio controller
    - A3 instrument map: Upper panel, keypads and Huey switches drawn as inputs
    - Known issues: remove the NAV standby and I2C scan items
    - To do: re-grab all screenshots
    - User Guide and master document rebuilt
2026-11-09 Physical connections diagram for each controller; remove completed to dos
    - New diagrams_f.py: connectivity diagrams for the Radio, Servo, Stepper,
    Dual Stepper and ADF and Upper controllers
    - "Physical connections" section in each controller chapter of the User Guide
    and the master document, both rebuilt
    - To do: completed items removed
2026-11-09 Quick reference: connection diagrams before each PCB picture, COM port mapping
2026-11-13 Create Jet Ranger Physical Assembly and Disassembly.odt
2026-11-13 Update Jet Ranger Physical Assembly and Disassembly.odt
2026-11-14 Physical assembly document: logical order, linked prerequisites, new seat base steps, reassembly as the inverse of disassembly
2026-11-14 Physical assembly document: add flow charts for disassembly, reassembly and seat base
2026-11-14 Physical assembly document: pedestal first, cyclic between the seats, 1/4 inch bolts, flow charts updated
2026-11-14 Physical assembly document: branching flow charts with independent disassembly and reassembly tracks
2026-11-14 Physical assembly document: front panels as their own track, four-track flow charts
2026-11-14 Physical assembly document: front screen depends on chin screen, three-track flow charts
