bnepethomas/bne-arduino-flight-simulator-interfaces/(notices)

Notices in the files:
DevPlayArea/ir_play_2/PinDefinitionsAndMore.h:
Arduino-IRremote is free software: you can redistribute it and/or modify
it under the terms of the GNU General Public License as published by
the Free Software Foundation, either version 3 of the License, or
(at your option) any later version.
along with this program. If not, see <http://www.gnu.org/licenses/gpl.html>.
Hornet/Hornet PCBs/Active/AV COOL PANEL/AV COOL PANEL.kicad_sch:
License: CC BY-NC-SA
Jet Ranger/PCBs/Jet Ranger Due Controller as built 20250126/Jet Ranger Due Controller as built 20250126.kicad_pcb:
© OZ HORNET
parts and their libraries:
https://creativecommons.org/licenses/by-nc-sa/4.0
